ntakao2006-web/RaceCapture/circuit/logger_v2/output/prepared_parts_3D_20260921.png

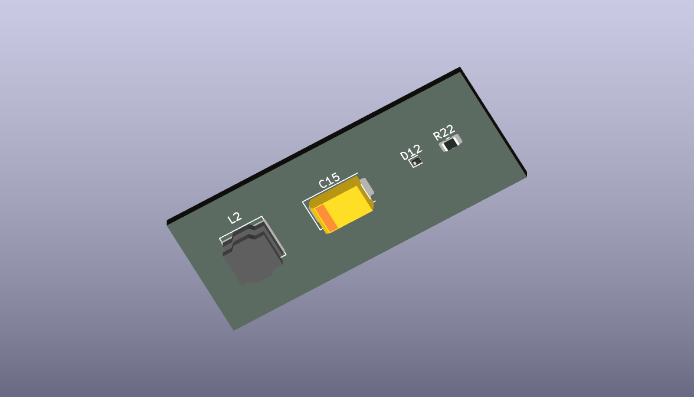
circuit/logger_v2/output/prepared_parts_3D_20260921.png
