ntakao2006-web/RaceCapture/circuit/logger_v2_ups/output/footprint_selection_20261007/footprint_preview.png

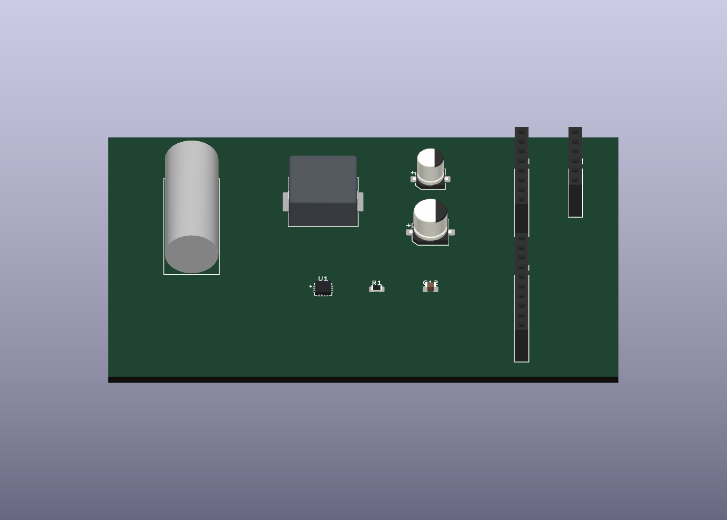
circuit/logger_v2_ups/output/footprint_selection_20261007/footprint_preview.png
