ntakao2006-web/RaceCapture/firmware/ecologger_v2/README.md

# EcoLogger V2 実測ファーム

2026-10-03 実機確認: CAN2の20MHz発振子に合わせたビットタイミング、SDの書込み待ち中のSPI解放、停止中のSD読出し競合を修正。125/250/500/1000kbpsの外部折返しと約100フレーム/秒の継続試験で計14,400フレームが一致。SDファイル切替を含む同時取得でも欠落0。試験送信は一時ファームのみ。通常ファームはCAN1がリッスンオンリー、CAN2がセンサーハブ受信とACKのための通常モードで、アプリケーション用CANフレームは送信しない（CAN2の通常モードを実機へ書き込んだのは2026-10-09。それまでの稼働版はCAN2も受信専用だった）。詳細は `outputs/hardware_check_20261003/RESULT.txt`。

`ecologger_v2.ino` → `logger_impl.h` と `sd_logger.h`。UNO Q STM32U585 / Arduino Zephyr core 0.52.0。

- BNO055: I2C2 0x28/29、400kHz、NDOF 100Hz、A5の高加速度割り込み。
- MAX-M10M: I2C 0x42、4衛星系統/10HzのRAM設定。OTPの再書き込みなし。
- CAN1: FDCAN1、D4/D5、リッスンオンリー。CAN2: MCP25625、D10 CS / A0 reset、センサーハブ受信（ACKあり、データ送信なし）。
- SD: A4 CS、SPI共有。FAT32にCRC付きELB2ブロックを保存。65,536Bの取得待ち行列と専用保存スレッドを使用。
- SDがいっぱいのとき（2026-11-07）：続いた1MiBの空きが無ければ、いちばん古い`EL*.BIN`を消して（ディレクトリの項目→FATの順）その場所に新しいファイルを作る。消すのは自分の`EL*.BIN`だけで、いちばん新しいものは消さない（消した本数は状態に出さない。RAMに収まらないため）。11/7に本体へ書き込み済み。PCの試験は`tests/test_sd_full.cpp`（WSLのg++）と`tests/test_sd_full_fat.py`
- SDの目次が1区画を超えるとき（2026-11-11修正）：ルートディレクトリに空きが無いと1区画足すが、前は先に取っておいた新しいファイルの1MiBの頭（FATにまだ印が無い）を選んでいた。目次と新しいファイルが同じ区画列になり、ファイルのデータが自分の項目を上書きし、以後の項目はそのファイルの中へ書かれていた（SUGOのカードで1022本目、32KB区画で約1021本ごとに必ず起きる）。今は取っておいた区画列を飛ばして空きを探す。PCの試験は`tests/test_sd_full.cpp`の`testRootDirectoryGrowsIntoItsOwnCluster`と、伸びたカードを`tests/test_sd_full_fat.py`の2枚目で読む。2026-11-11に本体へ書き込んだ（`~/ecologger_v2_sdfix_20261111.bin`、59,892B、静的集計130,349B。直す前の像は130,301B、修正で＋48B。起動を確かめた130,365Bより下）。実機でも、目次の空きを1つにしたカードで目次が2区画目へ伸び、どのファイルとも重ならないことを確かめた
- Bridge: 921600bps、取得処理とは別スレッドで登録。LinuxがいなくてもSD取得・記録を開始。
- ループ監視（2026-10-09）：取得メインループが30秒以上止まると、5秒周期の`k_timer`が`NVIC_SystemReset()`でMCUを再起動する（`sys_reboot`はスケッチ側へ公開されておらずリンクできない。スレッド方式はRAM枠を超えた）。SDフォーマット等の明示的な長時間コマンド中は監視を止める。
- ⚠️ Linuxとの通信中にSTM32内部からリセットすると、再起動後もSD記録は続くが、Linuxとの通信路は戻らない（原因未特定）。Linux側の`EcoCapture-Web/mcu-supervisor.py`が30秒以上の切断を検知し、NRSTリセット手順で復帰させる。
- `build.sh`はRouterBridgeの受信スレッドを`$/reset`完了前から動かすよう修正する。2026-10-13に、依頼が続く場合も優先度の低いSD保存スレッドへ実行機会を渡すため、更新ループ末尾を`k_msleep(1)`へ補強した。既知の元コード・前回修正・適用済みの形だけを受け入れ、未知の形ではビルドを止める。補強版の再ビルド・実機測定は未実施。SDが止まった際の正確な待機箇所は、インストール済みライブラリのソースとスレッド状態で確認する。
- 試験用ビルド：`logger_impl.h`の先頭に`#define LOGGER_STALL_TEST`を足すと、`logger.command`の`STALLTEST`（ループ停止）と`RESETNOW`（即リセット）が使える。本番イメージには入れない。
- RAM：静的集計130,365Bまでは起動、130,601Bはエラーを出さずに起動しなかった（ローダー追加領域ぶん、128KiBより手前が実際の限界）。
- LTE: A3/A2は初期状態LOW。UART IRQでRX4096/TX512バイト、GPIO RTS/CTS。LinuxのLTE専用操作が20秒途絶えたら電源OFF。設定とTCP/Podium処理はUNO Q内のEcoCapture-Webが担当。詳細は `EcoCapture-Web/LTE_PODIUM.md`。

LED: CAN=直近の受信、LTE=モデム電源ON（クラウド到達はWebで確認）、UNO Q=Linuxによる受信継続、TRM=OFF、GPS=測位時点灯/未測位受信時点滅、LOG=記録指示、ERR=I2C/SDエラー、SYS=稼働。

`sh build.sh` でビルド。64KiBを超える画像は書き込みません。更新と書き込みは `EcoCapture-Web/build-mcu.sh`、Windows側は `Update-UNOQ.ps1 -Firmware`。

ビルド時に `image-audit.json`（書き込みサイズとELF静的領域）と `source-manifest.json`（ソースのSHA256）を出力します。静的領域の集計にはコード・定数・BSSを含みますが、LLEXTローダーの追加領域や実行時ヒープの増加を含まないため、ロード成功の保証ではありません。更新時の停止・起動順は共通の `EcoCapture-Web/flash-mcu.sh` で管理します。

ソースを置き換える前にUNO Q側のコピーを確保し、`python compare_sources.py <保存したecologger_v2ディレクトリ>` で改行コードを除いた差分を確認します。比較結果だけで正しい版を自動選択しません。

Bridge RPC: `logger.status` / `logger.take` / `logger.command` / `logger.sdread`。`logger.take`は前回からのIMUの行（`rows`、`[seq,MCU時刻ms,"16進"]`）とCANの受信（`can`）を返して空にします。2026-11-09から、GNSSのNAV-PVTも受け取るたびに`rows`へ同じ形で入ります（16進が92バイトなら解、46バイト・0バイトならIMU。並びは届いた順、時刻は受け取った時刻）。10Hzの解を1つ残らず渡すためで、代わりに`logger.status`の`nav`・`gnss_at`はやめました（RAMの残りが足りないため）。IMUの行・CAN・解は`queueRow`で同じ形に足します。**`logger.status`に`nav`が無いファームは、それを読める`EcoCapture-Web/hardware.py`（2026-11-09以降）を先に入れてから書き込みます**（前の`hardware.py`は`status['nav']`で止まります）。コマンドはメイン処理で実行してcompleted番号で確認します。`LOG1/LOG0`、`C500000`等、停止中の`FILES`、`SD`、`R<sector>`、`H<offset>:<hex>`、`W<sector>`。`R<sector>`は読出し位置を設定して`sector ready`を返します。`logger.sdread`は512バイトを16進形式で返し、次のセクタへ進みます。各読出しで停止状態・パーティション境界を検査します。書き込みAPIは記録中に拒否します。外部へRPCを公開しません。

SDファイルは `EcoCapture-Web/sd_decode.py` でCRC・ブロック連番を確認しCSVへ変換できます。保存時刻はMCU経過時刻で、GNSSの元メッセージも保持します。
