ntakao2006-web/RaceCapture/hardware_interface_spec.md

# RaceCapture自作ロガー 入出力インターフェース仕様（電気系相談用）

作成日：2026-08-11
用途：電気・回路系担当の友人との認識合わせ資料

> **製作を依頼したい基板は「ロガー本体」1枚だけではありません。** モータースポーツ用ロガーとして
> 運用する上で必須になる周辺回路（CANハブ、センサーハブ、センサーのアンプ等）も含めて依頼したい
> ため、全体像は6章「製作を依頼したい基板一覧」を参照してください。

---

## 1. 外部インターフェース一覧

| # | インターフェース | 仕様 | 備考 |
|---|---|---|---|
| 1 | SDカードスロット | ロガー本体のデータ保存用 | ✅ **解決済み（2026-08-15）：Molex 47219-2001に決定**（`logger_v1.net`）。金属カバーが基板に押さえ込む構造で、押し込み式(push-push)より振動に強いと判断し採用。2枚差しミラーリング構成も検討したが不採用と判断した（経緯は下記「SDカードの冗長化を検討した経緯」参照） |
| 2 | 車載CAN（OBD2タップ） | 1系統 | 車両のOBD2端子から車速・回転数・水温等を取得。**終端抵抗は付けない**（車両側ECUで既に両端が120Ω×2で終端済みのため、ここに追加するとバスが過終端になる）。⚠️ **訂正（2026-09-21）**：~~終端抵抗の有無は基板上のハンダジャンパーで後から切り替え可能な方式に決定~~ は実回路と食い違っていた。正しくは**リファレンス番号は`R35`**で、**ハンダジャンパー切替は実装されておらず、車載CAN側は未実装（DNP）**。回路担当の確認済み（3章-1参照）。基板ごとの実装状態は区別すること。**配線・部品としては#3と同じ送受信フル対応（トランシーバのTXピンも通常通り結線）とする**。ロガー起動時のファームウェア既定値は**受信専用（listen-only）**運用（純正ECU側への影響を避けるため）だが、これはソフトウェア側のポリシー（TWAIのlisten-onlyモード設定）であってハードウェアの制約ではない。将来ファームウェア更新だけで送信運用へ切り替えられるようにするための意図的な配線方針 |
| 3 | 外部CAN（センサーハブ／アクセサリー用） | 1系統 | 追加センサー（油温・油圧・ブースト等）のハブに加え、シフトインジケーター等のCAN接続アクセサリーもぶら下げる自作CANバス。**ロガー本体が車載CAN（#2）とこのバスの間の「ゲートウェイ」を兼ねる**：#2から受信した値・ロガーが計算したチャンネル（ラップタイム等）をこのバスへ中継送信する（詳細は`ARCHITECTURE.md`のPhase 6参照）。ハブ・アクセサリーは複数台を「幹線1本＋スタブ分岐」でぶら下げる構成。終端抵抗120Ω×2箇所を**幹線の物理両端**に設置（配置ルールは#2と同様）。**電源ラインは5V**（CAN-H/CAN-L/5V/GNDの4線構成、2026-08-15更新：LED・ディスプレイ等のアクセサリー駆動を考慮し、当初予定の3.3Vから変更。専用の3.3V降圧回路新設は不要になったが、+5V系統全体の電流容量見積もりは要確認） |
| 4 | USB電源入力 | Type-C | ✅ **解決済み（2026-08-15）**：ロガー基板側はUSB QC（Quick Charge。PDではない）ネゴシエーション対応（LDR6321搭載）。12V-1.5A（18W）にネゴシエーションし、DCDCコンバータで5V→三端子レギュレータで3.3VへESP32電源として供給する2段降圧構成。外部CANの5V系統もこの経路から分岐するため、後付けアクセサリー類の電力にも余裕あり。**車両側の給電経路も確定**：ロードスターはシガーソケット充電器（100W級、Type-Cケーブル一体型）でモバイルバッテリーを充電し、モバイルバッテリーから毎回着脱で給電（クランキング対策を兼ねる）。エコマイレッジチャレンジ車両はシガーソケット充電器（USB-A+USB-C、100W級）から直接給電（モバイルバッテリー不要）。詳細は3章-11・`ARCHITECTURE.md`4章参照 |
| 5 | USB表示器出力 | Type-C（2026-08-15更新、旧Type-Bから変更） | ESP32-S3のネイティブUSBペリフェラル（TinyUSB CDC、RCP JSONプロトコル通信）をUSB OTG構成（CC線検出・VBUS制御付き）のType-Cコネクタへ変換。Raspberry Piまたはスマートフォンへ接続。電源入力(#4)と同一コネクタ形状に統一された |
| 6 | GNSSアンテナ | 外部アンテナ接続（SMA、`logger_v1.net`のJ7） | ⚠️ **GNSSモジュール変更（2026-08-16）**：Teseo-LIV3FLからu-blox MAX-M10M-00Bへ変更確定（2章・3章-15参照）。`logger_v1.net`時点の回路はTeseo-LIV3FL前提のフットプリント・ピン配置のため、友人による回路図修正が必要（未対応）。アンテナ電源出力ピンはTeseo-LIV3FLの`VCC_RF`(pin14)/`Ant_OFF`(pin13)からM10M-00Bの`VCC_RF`(pin14)/`LNA_EN`(pin13)へ読み替え。**アクティブ／パッシブ切り替え可能な回路にする方針自体は変更なし**（3章-14参照、ピン構成が同型のためほぼそのまま転用可能と判断） |
| 7 | ステータス表示LED | 電源LED×1＋ステータスLED×7の計8個（4個+4個の2列配置） | 純正RaceCapture/Pro MK3のLED構成に準拠する方針。詳細は下記「ステータス表示LEDの仕様検討メモ」参照 |

### SDカードの冗長化（2枚ミラーリング）を検討した経緯（2026-08、不採用と判断）
> 友人へ説明する際の要点整理も兼ねたメモ。

**検討した内容**：SDカードを2枚挿し、同じ内容を同時に書き込むミラーリング構成（片方が壊れてももう片方にデータが残る）を検討した。きっかけは、上記「押し込み式ソケットの振動リスク」への対策として冗長化できないか、というアイデアだった。

**調べて分かったこと**（レーシングロガー業界の実例を確認）：
- MoTeC C125を確認したところ、そもそもSDカードを使わず**基板直付けの内蔵メモリ（120MB）**を主記憶としており、リムーバブルストレージが欲しい場合はUSBメモリをオプション追加する構成だった。つまり「振動でコネクタが壊れる」という同じ悩みに対する業界の答えは、「カードを2枚にして冗長化する」ではなく「**抜き差し可能なコネクタへの依存自体を減らす**」方向だった
- レーシングデータロガー全般を見ても、2枚のSDカードへ同時ミラーリングする構成は主流製品には見当たらなかった（カメラ業界で見かける「2枚差し」も大半は容量合算・別ストリーム記録が目的で、今回想定した「同一内容の冗長化」とは違う）

**不採用と判断した3つの理由**：
1. **ハードウェアコスト増**：GPIOが最低4本（2枚目をSPIモードにした場合）〜6本（SDMMC 4bitのままもう1系統）追加で必要。ソケットも1つ増える
2. **ソフトウェアの複雑化**：スループット自体には余裕があるが、カード単位の故障管理・電源断耐性の検証（1-2フェーズで苦労して詰めた部分）をもう1系統分、しかも実績のないSPI経路でやり直す必要がある
3. **本来のリスクに効かない、むしろ逆効果の面もある**：①冗長化が守れるのは「カード単体の物理故障」だけで、ファームウェアのバグや電源断タイミングという、今まさに対策している種類の失敗には両方のカードが同時にやられるため無力。②振動に弱い押し込み式コネクタの個数がむしろ2つに増えるため、「どちらか一方に接触不良が起きる確率」はかえって上がる

**結論**：SDカードは1枚のまま、**ロック機構付き／固定機構ありのソケットを採用する**方針とした（3章項目7）。本来の懸念（振動によるコネクタ接触不良）に、冗長化ではなく正面から対応する形。

### USBポートに関する補足
- 電源入力(Type-C)とRCP通信出力(Type-B)は**別ポート・別役割**。ネイティブUSB側(Type-B)はこのポート自体からは給電しない構成のため、ESP-IDF側でVBUS検知を「セルフパワード」設定にしておく必要がある（未確認・要対応）。
- 給電経路（改造したシガーソケット充電器）が、SD書き込み・GPS・CANトランシーバ×2系統・IMU等の合計消費電流を安定して賄えるか要確認（目安1A以上）。

### CANコントローラ数の制約（2026-08 新規判明・要対応）
- メインマイコンESP32-S3の内蔵CANコントローラ（TWAI）は**1系統のみ**（ESP-IDF公式ドキュメントで確認）。上表#2（車載CAN）と#3（外部CAN）の2系統を同時に扱うには、**SPI接続の外付けCANコントローラを1つ追加する必要がある**（部品未選定・未調達）。
- 割り当ては「**車載CAN=内蔵TWAI、外部CAN=外付けSPIコントローラ**」を推奨。車載CANは500kbpsで流れる車両バスを全量受信する側なので取りこぼしリスクを最小化したい一方、外部CANは自作バスで通信量を自分たちで制御できるため。特に定番のMCP2515は受信バッファが2段しかなく、混雑したバスの全量受信では取りこぼしが起きやすい。
- 候補：MCP2515（定番・安価。ただし搭載水晶の周波数によって500kbps設定の可否・精度が変わる点に注意）、MCP2518FD（SPI接続・受信FIFOが深い後継。こちら推奨寄り）。いずれもコントローラのみでトランシーバは別途必要（外部CAN側のロガー用トランシーバも要選定。ハブ側と同じSN65HVD230等でよい想定）。
- **配線方針（拡張性）**：2チャンネルとも、コントローラ〜トランシーバ間はTX/RXとも通常通りフル結線しておく（=どちらも将来「送受信自由」にソフトウェアだけで切り替えられる状態にする）。標準的なCANトランシーバ回路はもともと双方向のため、この対応に追加コストは生じない。今回2系統(#2/#3)より多いCANバスが将来必要になった場合（例：ボディ系CAN(MS-CAN)への別アクセス等）は、3系統目以降は新たに物理コントローラ・トランシーバの追加が必要になる（＝ソフトだけでは対応不可）。もし可能なら、基板設計時にSPI CS/割り込み用のGPIOを1本分だけ予備として確保しておくと、将来3系統目を追加する際の手戻りが減る（必須ではなく余裕があれば程度の話）。

### ステータス表示LEDの仕様検討メモ（2026-08-16、MK3参照）
> 友人へ説明する際の要点整理も兼ねたメモ。公式ファームウェア`RaceCapture-Pro_firmware`のソース（本リポジトリ`reference/`配下に取得済み）と、RaceCapture/Pro MK3実機写真を突き合わせて判明した内容。

**結論：電源LED×1（ハードウェア直結・MCU制御なし）＋ステータスLED×7（MCU/GPIOで個別制御）の計8個。実機写真では4個+4個の2列配置。**

**ステータスLED7個の内訳（ファームウェアのenum定義、`include/LED/led.h`より）**：

| # | 論理名 | 用途（推定含む） |
|---|---|---|
| 1 | ERROR | エラー・警告表示 |
| 2 | LOGGER | SDカードへのロギング動作 |
| 3 | GPS | GPS Fix状態（未Fixは低速点滅、Fix後は高速点滅、という説明あり） |
| 4 | TELEMETRY | テレメトリ通信動作 |
| 5 | WIFI | WiFi通信動作 |
| 6 | BLUETOOTH | Bluetooth通信動作 |
| 7 | CAN | CAN(OBD2)バス通信動作 |

**GPIO本数の見積もり**：上記7個は各1本のデジタル出力（GPIO）で個別にON/OFF制御する想定（MK3実機もSTM32のGPIOで1LED=1ピンのシンプルなドライブ方式、PWM調光やマルチプレクスは使っていない）。**電源LEDはMCU制御対象に含めない**（後述）。よって、このステータスLED用に**GPIOを7本**確保してもらえればソフトウェア側は成立する。

**電源LEDについて（要確認）**：MK3のファームウェアソース一式（`reference/RaceCapture-Pro_firmware/platform/mk3/`配下）を検索したが、電源LEDをGPIOで制御しているコードは見当たらなかった。そのため、**電源ラインに抵抗を介して直結し、電源投入で常時点灯する回路（MCU制御不要）**という一般的な構成だと推測している。この想定で問題ないか、回路側で確認をお願いしたい。

**MK3実機の物理配置順（参考、`platform/mk3/hal/LED_stm32/led_device_stm32.c`のGPIO配列順）**：
```
ERROR → TELEMETRY → LOGGER → GPS → CAN → WIFI → BLUETOOTH
```
これは論理定義の並び（上表の#1〜#7）とは順序が異なる。実機写真の4+4のどちらの列に何が入るかまでは、このソースだけでは判別できていない。

**未確認・要相談事項**：
1. **各LEDの色**：ファームウェアのソースにはON/OFFの制御のみで色情報は含まれておらず、公式資料（Wiki・製品ブリーフ）にも色の記載は見つけられなかった。「各LEDは単色固定（RGB等の多色ではない）」という情報のみ確認済み。実機写真から判別できる範囲でよいので、色の割り当て案があれば相談したい
2. **シルクスクリーンの略称表記**：公式PCBでの正式な略称も見つけられなかった。基板独自に決めてよい項目だと考えているので、7〜8文字程度に収まる略称案（例：ERR/LOG/GPS/TEL/WIFI/BT/CAN/PWR）で相談したい
3. **4+4の列分け・実装順**：実機写真を見ながら、どちらの列に何を配置するか（電源LEDがどちらの列に含まれるか含め）相談したい
4. **点灯パターンの詳細ロジック**（パルスコード、Fix状態によるブリンク頻度切替等）はソフトウェア側の話でありMCU非依存の共通コード（`src/`配下）から移植予定。基板側にはON/OFF制御用のGPIOさえあれば影響しない

---

## 2. 内部主要部品（現状の想定・型番）

| 部品 | 現状の想定 | ステータス |
|---|---|---|
| メインマイコン | ESP32-S3-DevKitC-1 N16R8 | 型番確定・未発注 |
| GNSSモジュール | ~~STMicroelectronics Teseo-LIV3FL~~ → **u-blox MAX-M10M-00B**（単一GNSS構成で18〜25Hz対応、UART接続、要外部アクティブ/パッシブ切替回路）に変更確定 | ⚠️ 型番再確定（2026-08-16、Teseo-LIV3FLから変更。3章-15参照）。`logger_v1.net`はTeseo-LIV3FL前提のため回路図修正が未対応 |
| IMU | Bosch BNO055モジュール（9軸統合・センサーフュージョン内蔵、UART(HAL)モード接続） | ✅ 型番確定（2026-08-15、`logger_v1.net`）。従来の秋月AE-LSM6DSV16X（6軸）から変更。磁力計モジュール(AE-BM1422AGMV)の追加調達は不要 |
| 車載CAN用トランシーバ | MCP2562FD-E/P（**VDD=5V系が必要**（定格4.5〜5.5V）。ロジック側VIOピンは3.3Vへ接続する） | 調達済み |
| 外部CAN用SPIコントローラ（ロガー側） | MCP25625T-E/SS（SPIコントローラ+トランシーバ一体型） | ✅ 型番確定（2026-08-15、`logger_v1.net`）。トランシーバ内蔵のため下記「外部CAN用トランシーバ」の別調達は不要になった |
| CANハブ用マイコン | Seeed XIAO ESP32-C3 ×2〜3台 | 方式確定・未調達 |
| SDカードモジュール（本番基板） | Molex 47219-2001（金属カバー固定式） | ✅ 型番確定（2026-08-15、`logger_v1.net`）。秋月DIP化キット(K-5488)は検証用として保有継続 |

---

## 3. 未確定・要相談事項（優先度順）

1. ⚠️ **訂正（2026-09-21、回路担当の回答で確定）：終端抵抗の実装方針**：~~車載CAN側の終端抵抗(R41)は、基板上のハンダジャンパーで有無を後から切り替え可能な方式に決定~~ という2026-08-15時点の記述は**実回路と食い違っていた**。正しくは、**①リファレンス番号はR41ではなく`R35`**（`logger_v1.net`でJ5のCANH-CANL間に置かれている）、**②ハンダジャンパーによる切替方式は実装されていない**（ネットリスト上はジャンパ無しの直付けパターン）、**③回路担当が共有した実装状態では、車載CAN側の終端抵抗は未実装（＝DNP）**。回路担当から「ハンダジャンパー切替という仕様書の表現は、実回路に合わせて訂正する方向でよい。ただし**基板ごとの実装状態は区別すること**」との回答を得たため、本項を訂正する（`docs/share/hardware_ans_20260921.md`1章「前回の7項目」1、`docs/share/hardware_share_20260915.md`4-4）。**外部CAN＝幹線の物理両端のみに120Ω（R27）という方針は変更なし。** 車両バスは両端終端済み（合成60Ω）で、ここにR35が生きていると40Ωまで落ちるため、車載CAN側は未実装が正しい
2. **グラウンド設計（2026-08-16、経路を整理）**：ロガー・ROCK 5B・アクセサリー類はすべてUSB充電器（モバイルバッテリー経由）を起点とする閉じたグラウンド系統になっており、この内部では問題ない。懸念があるのは、この閉じた系統の唯一の外部接点である**車載CAN(OBD2)経由のグラウンド接続**。`logger_v1.net`確認の結果、J6(車載CAN)・J4(外部CAN)ともpin4が基板の共通GNDへ直結されている（＝車載CANのグラウンドは基板に落ちている）。CAN-GND自体を接続すること（GND無しでCAN-H/CAN-Lだけ配線する構成にしないこと）は業界標準の実務であり妥当だが、そのGND線を介して車両側とUSB電源系の間に電位差由来のループ電流が生じる可能性がある。対策の選択肢：①現状のまま直結（シンプルだがノイズ耐性は最低）、②CAN-GND線にフェライトビーズを挟み高周波ノイズだけ減衰させる（費用対効果のバランスが良さそう）、③CANトランシーバをガルバニック絶縁型にして車両側と完全分離（最も堅牢だがコスト・複雑性が上がる）。⏳ **経過観察（2026-08-16、友人確認）**：回路担当からは「（実害となる）問題はおそらく出ない」という見通しが得られており、現状は①直結のまま様子見する方針。正式な方針決定・対策実装は行っていない未解決事項のままだが、現時点では優先度を上げて追いかけるべき懸念とはしていない。実機・実車検証でノイズ起因の不具合（CANエラー頻発等）が見られた場合に②③を再検討する
3. ⚠️ **訂正（2026-08-16）：GNSSモジュールの型番・アンテナ接続規格**：本項目は2026-08-15時点でTeseo-LIV3FLに確定としていたが、その後u-blox MAX-M10M-00Bへ変更確定した。詳細・友人への相談事項は下記15番参照
4. ✅ **解決済み（2026-08-15）：9軸IMUの型番**：BNO055に確定（磁力計統合済み、AE-BM1422AGMVの追加購入は不要になった。2章参照）
5. **ネイティブUSB側のVBUS検知設定**：セルフパワード構成にする必要あり（2026-08-15：表示器出力(#5)はType-CのOTG構成に変更されたため、VBUS検知の扱いも合わせて要確認）
6. ✅ **解決済み（2026-08-15）：電源改造用コネクタの規格選定**：ケーブル一体型の既製品（ロードスター＝UGREEN製シガーソケット充電器＋巻き取り式Type-Cケーブル、エコランマシン＝アドテック製USB-A+USB-C出力カーチャージャー）を採用することで、コネクタ数が最小限になり接触不良リスクも下がるため、追加の改造は不要と判断（4章参照）
7. ✅ **解決済み（2026-08-15）：SDカードスロットの物理保持機構**：Molex 47219-2001（金属カバー固定式）に確定。押し込み式の振動リスクは解消と判断（2章参照）
8. ✅ **解決済み（2026-08-16）：ステータスLEDの参照元をRaceCapture/Pro MK3に決定**：公式`RaceCapture-Pro_firmware`の4世代（MK2/MK3/RCT/RCT MK2）を調査した結果、MK3のみがenum定義（ERROR/LOGGER/GPS/TELEMETRY/WIFI/BLUETOOTH/CANの7種）と物理LED(7個)が完全に1対1対応しており、最も網羅的なテンプレートと判断。点灯パターンのロジック自体（ERRORのパルスコード、GPSのFix状態に応じたブリンク頻度切替、LOGGERのサンプル同期トグル、通信LEDのワンショット点灯等）はMCU非依存の共通コード（`src/`配下）のため、どの世代でも移植コストは同じ。**実機写真では電源LED×1（MCU制御なし・直結と推定）を加えた計8個・4個+4個配置と判明（2026-08-16）**。GPIO所要本数はステータス用7本（詳細は1章「ステータス表示LEDの仕様検討メモ」参照）。色・シルクスクリーン表記・列分けは未確認で友人へ相談予定
9. ✅ **解決済み・方針変更（2026-08-15）：外部CAN（センサーハブ／アクセサリー用）バスの電源ライン**：3.3V専用降圧回路の新設案から、LED・ディスプレイ等のアクセサリー駆動を考慮した5V供給（CAN-H/CAN-L/5V/GND）へ変更。専用降圧回路の新設は不要になったが、+5V系統全体の電流容量見積もりは引き続き要確認
10. ✅ **解決済み（2026-08-15）：2系統目CANコントローラの選定**：MCP25625T-E/SS（SPIコントローラ+トランシーバ一体型）に確定（2章参照）
11. ✅ **解決済み（2026-08-15）：電源取り出し系統とクランキング対策**：**ロードスター**は、シガーソケット充電器（100W級、Type-Cケーブル一体型、UGREEN製想定）でモバイルバッテリー（65W級入力対応、候補：CIO SMARTCOBY TRIO SS／Xiaomi 67W Power Bank 10000）を充電し、モバイルバッテリーからロガー・ROCK5Bへ給電する構成に決定。モバイルバッテリーは**走行のたびに着脱する運用**とする（常設パススルー充電は、バッテリー劣化・車内耐候性の懸念から不採用）。クランキング時の電圧ドロップはモバイルバッテリーが緩衝材となって吸収される。**エコ マイレッジ チャレンジ車両**はエンジン駆動用バッテリーとロギングシステム用バッテリーが分離されているためモバイルバッテリーは不要で、シガーソケット充電器（USB-A+USB-C、100W級、アドテック製想定）から、USB-A→ロガー／USB-C→ROCK5Bで直接給電する構成に決定
12. **IMU・磁力計の実装方法（2026-08-16、論点を整理）**：IMUは車体へ剛結が基本だが、エンジン・路面振動がそのまま乗るため、サンプリングレート（現状10Hz、将来50〜100Hz化予定）に対するエイリアシング対策（チップ内蔵LPF設定と機械的防振の役割分担）を相談したい。
    - **基板実装方式が未決定**：`logger_v1.net`ではBNO055(U11)はメイン基板に直接実装されている。基板直付け（配線短くノイズに強い、コネクタ減で接触不良リスク減、ただし設置位置＝メイン基板の位置に制約される）か、ケーブルで切り離すモジュール化（車体重心付近など振動的に最適な位置を選べる、ただしUART配線が伸びる分ノイズ耐性は下がる）か、メイン基板の車載位置が決まってから判断する
    - **磁力計とアルミシールドの影響を整理**：ケーシングへのアルミテープ（非磁性導体）は地磁気のような静磁場への遮蔽効果はほとんどなく、磁力計の動作への悪影響は小さいと考えられる。むしろ懸念すべきは①ケース内の強磁性体（鉄ネジ等）による地磁気の歪み（BNO055のソフト鉄/ハード鉄キャリブレーションである程度補正可能）、②基板上のDCDCコンバータ・CANトランシーバ等の大電流配線が作る動的な磁気ノイズ（キャリブレーションでは補正しきれない可能性が高く、既存方針の「大電流配線から離す」が対策の本筋）
13. ✅ **解決済み・訂正（2026-08-15）：ロガー基板のネゴシエーション規格はUSB PDではなくQC（Quick Charge）**：12V-1.5A（18W）にネゴシエーションし、DCDCコンバータで5V→三端子レギュレータで3.3VへESP32電源として供給する構成に確定（2章参照）
14. ✅ **方針確定（2026-08-16）：GNSSアンテナはアクティブ／パッシブ切り替え可能な回路を目指す**：`logger_v1.net`時点の回路（Teseo-LIV3FLの`VCC_RF`未接続、バイアスT回路なし）はパッシブアンテナ仕様。友人との協議の結果、将来的にアクティブアンテナも使えるよう、両対応の切り替え可能な回路にする方針で合意。アクティブアンテナ用回路（バイアスT等）は複雑で設計コストが高く、PCB設計を1回で完全動作させる保証はないとのことで、まず両方動く回路を作り、1〜2回の修正を重ねて完成させていく前提。**PCB発注〜到着に1〜2週間かかるため試行回数（イテレーション）が制約される**点は、今後の基板改修スケジュールを見積もる上で踏まえておく必要がある
15. ⏳ **要相談（2026-08-16、新規）：GNSSモジュールをTeseo-LIV3FLからu-blox MAX-M10M-00Bへ変更**：更新レート（Teseo=ハード上限10Hz固定 vs M10M-00B=単一GNSS構成で18〜25Hz）を優先し、こちらの型番へ変更する方向で決定した。友人へ相談・確認したい点：
    - `logger_v1.net`のGNSS部フットプリント・ピン配置はTeseo-LIV3FL前提のため、回路図の修正が必要（アンテナ電源ピンはTeseo`VCC_RF`(pin14)/`Ant_OFF`(pin13) → M10M-00B`VCC_RF`(pin14)/`LNA_EN`(pin13)への読み替えで、アクティブ/パッシブ切替回路のトポロジー自体は上記14番の方針のまま転用できる想定）
    - ✅ **解決済み（2026-08-16）：設定の不揮発性保存機能（バックアップ電源）は非搭載と決定**：Teseo-LIV3FLは内蔵Flash（`$PSTMSAVEPAR`コマンド）でバッテリー不要のまま設定を保持できたが、M10M-00Bは同等のFlashを持たず、設定保持には`V_BCKP`ピンへのバックアップ電源（コイン電池等）が必要になる。検討の結果、**バックアップ電源は追加せず、電源ON/OFF（バッテリー着脱含む）自体を「ログの開始・終了」のトリガーとする運用方針のため不要と判断**した。「ログ開始し忘れ」のリスクを減らす狙い（電源を入れる＝ログを開始する、という単純な操作に統一）。GNSSの設定・ホット/ウォームスタート用データは電源ONのたびに揮発するため、ESP32ファームウェアから毎回コンフィグを再送信する初期化シーケンスを実装する（起動時間はコールドスタート相当になる点は許容）
    - 消費電力・パッケージサイズ等、上記以外の相違点による基板レイアウトへの影響有無

---

## 4. 車載12V電源の保護回路について（参考・確定事項）

✅ **解決済み・方針更新（2026-08-15）**：市販のシガーソケット用12V充電器を使用する方針で合意済み。当初は内部回路を活かして出力コネクタのみ改造する想定だったが、ケーブル一体型の既製品を採用することで、改造なしでコネクタ数を最小限に抑えられると判断した（3章-6・11参照）。
- **ロードスター**：シガーソケット充電器（100W級、Type-Cケーブル一体型）でモバイルバッテリーを充電し、モバイルバッテリーから毎回着脱でロガー・ROCK5Bへ給電。クランキング時の電圧ドロップはモバイルバッテリーが緩衝材として吸収する
- **エコ マイレッジ チャレンジ車両**：エンジン駆動用バッテリーとロギングシステム用バッテリーが分離されているためモバイルバッテリー不要。シガーソケット充電器（USB-A+USB-C出力）から、USB-A→ロガー／USB-C→ROCK5Bで直接給電

---

## 5. 外部CANバスに接続予定のアクセサリー一覧（追加で製作が必要なハードウェア）

外部CAN（センサーハブ／アクセサリー用、1章#3）バスへぶら下げる予定のノードを一覧化。**いずれもCAN-H/CAN-L/5V/GNDの共通4線コネクタ規格で接続する**想定（1章#3参照）。台数・種類がここに増えるほど3章項目9（5V電源の電流容量）の見積もりに直結するため、新しいアクセサリーを追加する際はこの一覧も更新する。

| アクセサリー | 用途 | 想定MCU | 想定トランシーバ | ステータス |
|---|---|---|---|---|
| センサーハブ ×2〜3台 | 油温・油圧・ブースト等のアナログセンサーをADCで受けてCAN化 | Seeed XIAO ESP32-C3 | SN65HVD230等 | 方式確定・未調達。ハブ1台あたりのセンサー割当数・CAN ID採番ルールは未確定（`ARCHITECTURE.md`4章参照） |
| シフトインジケーター | RPM等をタコメーター相当の応答速度で表示 | 未確定（軽量なXIAO ESP32-C3等で足りる見込み） | 未確定（センサーハブと同等でよい見込み） | 構想段階、ハードウェア未着手。**ベストラップリセットボタンをGPIO入力として統合する案が有力**（`task_phase5_breakdown.md`5-8-2参照。ボタン単体で専用ノードは作らず、このMCUに相乗りさせる方針） |
| 高輝度サブディスプレイ（デルタタイム表示等） | 走行中でも視認できる輝度で予測タイム(PredTime)等の計算チャンネルをリアルタイム表示 | 未確定 | 未確定 | 構想段階、ハードウェア未着手（`task_phase6_breakdown.md`背景説明参照）。ロガー本体側の計算チャンネルCANブロードキャスト実装（Phase 6-1〜6-3）が前提。ディスプレイの消費電流次第では5Vラインの配線線径・電流見積もりへの影響が大きい可能性があり、型番選定時に要確認 |

> 上記はいずれも「本Phaseはロガー本体側の実装まで」（`task_phase6_breakdown.md`）の方針通り、アクセサリー側MCUの実装・実機結合試験はハードウェア到着後に別Phaseとして分解する。友人への相談時は、まず台数・電流の当たりをつけるための参考リストとして共有する想定。

---

## 6. 製作を依頼したい基板一覧（全体像）

これまでの章はロガー本体を中心に書いてきたが、**モータースポーツ用ロガーとして実際に運用するには周辺基板が必須**であり、それらも含めて製作を依頼したい。現時点での全体像は以下の通り。

| 基板 | 個数目安 | 主な回路 | ステータス |
|---|---|---|---|
| メインロガー基板 | 1 | ESP32-S3、GPS、IMU、SDカード、車載CAN用トランシーバ(MCP2562FD)、外部CAN用SPIコントローラ+トランシーバ、車載12V電源保護回路、QC→5V→3.3V降圧回路（外部CANバスの5V系統もここから分岐、専用回路の新設は不要） | 設計中（1〜5章が対象） |
| **CANハブ／センサーハブ基板** ×2〜3 | 2〜3 | Seeed XIAO ESP32-C3、CANトランシーバ(SN65HVD230等)、ADC（内蔵または外付け、要検討）、**センサー信号調整回路（アンプ等）** | 方式確定・**未着手**（5章参照） |
| 外部CANアクセサリー基板（シフトインジケーター／サブディスプレイ等） | 台数分 | MCU未確定、CANトランシーバ、表示系（LED/ディスプレイ）、ボタン入力（統合する場合） | 構想段階・**未着手**（5章参照） |

**特に相談したい点**：
- **センサー信号調整回路（アンプ）の要否**：油温・油圧・ブースト圧センサーの型番自体が未確定（`ARCHITECTURE.md`4章）のため、選定候補が抵抗式／0-5V電圧出力式であればADC直結で足りる可能性がある一方、mV級出力のセンサー（歪みゲージ式圧力センサー等）を選ぶ場合は各チャンネルに計装アンプが必要になる。センサー型番の選定とアンプ要否をセットで相談したい
- **既設Defiメーター用センサーを分岐して読みたい（2026-08-23追加）**：ロードスターに既に付いているDefi製水温・油温・油圧センサー（純正メーターへ接続済み、水温・油温が2ピン、油圧が3ピンと推定）を、メーター側の配線・指示動作を変えずにセンサーハブ側でも読み取りたいという要望がある。センサー線を単純にY字分岐すると、RaceCapture側ADCの入力インピーダンスがメーター側の分圧回路に並列に入り込み、メーターの指示値がズレるリスクがある。対策として、**分岐点にボルテージフォロワ（オペアンプによるバッファ回路）を挟み、ハイインピーダンスで電圧を受けてローインピーダンスでセンサーハブのADCへ渡す**方式を想定。クワッドオペアンプ1個で3ch分をまかなえる見込みで、上記「センサー信号調整回路」の枠に含める形でセンサーハブ基板に実装したい。2ピン（サーミスタ抵抗式と推定）はセンサー抵抗の分圧電圧を、3ピン（電源+GND+出力と推定）は出力線をそのままバッファ経由で分岐する想定。Defiセンサー3つの正確な型番・出力特性（抵抗式か電圧式か、レンジ）は未確認のため、型番特定または実測（メーター側励起電圧・電流、センサー抵抗レンジ）とセットで相談したい
- **熱電対（K型）入力への対応（2026-08-30追加）**：エコマイレッジチャレンジ車両向けに、EGT（排気温度）とCHT（シリンダーヘッド温度）の測定要求が出た。熱電対はmV級出力かつ冷接点補償が必要で、上記「抵抗式／0-5V」前提のADC直結でも計装アンプでも受けられない。**MAX31855（K型専用・安価）またはMAX31856（多型式対応・高精度）等のSPI接続ICをセンサーハブ基板に追加する**案で問題ないか相談したい。熱電対線の延長には補償導線が必要な点、エンジン近傍からの引き回しになるためノイズ対策が要る点も併せて確認したい。なお同車両のCHTは、熱電対を避けてNTCサーミスタ型（スパークプラグ座金型）を選定する方針のため、熱電対が必須なのはEGTのみ
- **CANハブ／センサーハブ基板の内容がロガー本体と別基板として独立している点**：配線・実装イメージのすり合わせのため、幹線1本＋スタブ分岐というバス配置（1章#3参照）を踏まえた基板の物理配置（車両のどこに何枚置くか）も併せて相談したい
