ntakao2006-web/RaceCapture/logger_v2_channel_and_sensor_spec.md

# ロガーへの入力・出力チャンネル仕様（こちら側で言語化する宿題）

> **この文書が扱う宿題**：`docs/share/hardware_ans_20260921.md`6章の
> **6（外部CANチャンネルごとの「用途」を定義する）**、
> **7（油温・油圧センサーを選定する）**、
> **8（追加でログしたい車体信号を絞り込む）**。
>
> **3件とも「回路担当が判断するには、まずこちらが要求を言葉にしないと進まない」もの**なので、
> 1つにまとめた。回路設計そのものは引き続き回路担当に委ねる。
>
> ⚠️ **1章・3章には、ユーザー（＝設計方針の決定者）の確認が要る判断が含まれる。**
> 該当箇所に「**要確認**」と明記した。確認が取れたら次回の共有メモへ載せる。

---

## 1. 宿題8：追加でログしたい車体信号を絞り込む

### 1-1. 指摘されたこと

前回の共有で「**車体系はOBD2ポートからは取れない。別バスへのタップか、
専用のデジタル入力を回路側に持つかの方針判断がほしい**」と投げていたが、
回路担当から「**『取れない』と一括りにせず、NCECで実際に取れていない信号だけを挙げてほしい。
ブレーキペダル状態は取得済みのはず**」と指摘された。**その通りなので整理し直す。**

### 1-2. 事実の整理（`ncec_can_spec.md`4章の実測による）

**✅ すでに取れているもの（追加の入力は一切要らない）**

| 信号 | 取得元 | 周期 |
|---|---|---|
| エンジン回転数／車速 | `0x201` | 100 Hz |
| **4輪独立ホイールスピード**（FL/FR/RL/RR） | `0x4B0` | 100 Hz |
| 水温（2経路） | `0x240` / `0x420` | 10 Hz |
| スロットルバルブ開度 | `0x240` | 10 Hz |
| **アクセルペダル開度**（2経路） | `0x200` / `0x215` | 100 Hz |
| 🔴 **ブレーキペダル（踏み込みON/OFF）** | `0x200` byte6 bit0 | 100 Hz |
| クラッチ（踏み込みON/OFF） | `0x231` byte1 bit1 | 40 Hz |
| パーキングブレーキ | `0x39A` byte0 bit3 | 10 Hz |
| A/C要求 | `0x215` byte7 bit6 | 100 Hz |
| 吸気温／燃料レベル | `0x240` / `0x430` | 10 Hz |
| エンジン負荷・点火時期・MAF・O2・バッテリ電圧ほか | OBD2 mode 01（20 PID） | 実効8.6 Hz |
| ECU内部変数 | OBD2 mode 22（`0x09xx`系に12個） | 任意 |

**❌ この車両・この配線では取れないもの**

| 信号 | 理由 | 種類 |
|---|---|---|
| **油温・油圧** | 生CANにも標準OBD2 PIDにも無い（油温PID `5C`は非対応を再確認） | **センサーが存在しない** |
| ウィンカー・ハザード・ドア開・シートベルト・ヘッドライト・ワイパー | 停車中の12種の操作差分で**1ビットも動かなかった**。ボディCAN側にあるとみられる | **別バスにある** |
| 舵角`0x081`／ブレーキ圧`0x085`／車体加速度`0x090` | **DSC搭載車（2007年以降）限定。本車両はDSC非搭載**なので、そもそも車両が出していない | **車両に存在しない** |

> **3つ目の区別が重要**：舵角・ブレーキ圧・車体加速度は「別バスにあって届かない」のではなく、
> **DSC非搭載車なので車両のどこにも流れていない**。**ボディCANをタップしても出てこない。**

### 1-3. 🔴 結論案：**回路側にデジタル入力もボディCANタップも追加しない**

**「取れないもの」を、ロガーの用途（サーキット走行解析／エコマイレッジ）に照らして
欲しさで並べ直すと、追加の入力回路が要るものは残らない。**

| 取れないもの | 本当に欲しいか | どう手当てするか |
|---|---|---|
| **油温・油圧** | 🔴 **欲しい。最優先** | **追加センサー＋センサーハブ**（既定方針。→ 2章） |
| **ブレーキ圧（踏力）** | ⚠️ あると嬉しい（ブレーキング解析） | **ON/OFFは既に取れている。**圧が欲しければ**油圧センサーの追加**で対応でき、**これもセンサーハブの枠**に収まる。候補とつなぎ方は`brake_pressure_sensor_ncec.md`（2026-11-09） |
| **舵角** | ⚠️ あると嬉しい | 🔴 **E-2でESKFを採用したので、ヨーレート（IMU）＋車速で旋回曲率が出る。** 舵角そのものが無くてもコーナリング解析は成立する。専用センサーを足す価値は現時点では低い |
| **車体加速度・ヨーレート** | 🔴 欲しい | **IMU（BNO055）で取る。**もともと車両から取る設計ではない |
| **ギア段** | 🔴 欲しい | **回転数÷車速で算出できる**（`0x231`のクラッチ状態と組み合わせて断/接も判定可）。**追加ハード不要。計算チャンネル／Luaで実装する**（Phase 6の枠） |
| ウィンカー・ハザード・ドア・シートベルト・ヘッドライト | ❌ 要らない | 走行解析に使わない |
| ワイパー | △ 路面ウェット判定に使える程度 | **専用入力を作るほどの価値は無い**と判断 |

**→ 回路担当への回答：「別バスへのタップも、専用のデジタル入力も、どちらも不要」。**
**必要なものは①センサーハブ（油温・油圧・ブレーキ圧）②IMU③計算チャンネル（ギア段）で
すべてまかなえる。**

> **要確認（ユーザー判断）**：この結論でよいか。
> とくに**ワイパー／ヘッドライトを完全に捨てる**点と、**舵角センサーを足さない**点。
> 捨てる判断をすると、Ver.2基板にデジタル入力端子が載らないため、後から欲しくなっても
> 基板改版になる。

---

## 2. 宿題7：油温・油圧センサーの要求仕様

### 2-1. 指摘されたこと

「**測定範囲・取付ねじ・出力形式・供給電源**が決まらないと、入力回路とアンプ要否を決められない。
ここが現状のボトルネック」。

### 2-2. 取りうる道は2つある

`hardware_interface_spec.md`6章に、**既設のDefiメーター用センサーを分岐して読む案**が
既に書かれている。新規購入と合わせて2案ある。

| | **A案：既設Defiセンサーを分岐** | **B案：新規にセンサーを買う** |
|---|---|---|
| センサーの追加工事 | **不要**（既に付いている） | **必要**（オイルブロック等の取り付け） |
| Defiメーターの表示 | **そのまま残る** | 残る（別系統になる） |
| 回路側の追加 | **ボルテージフォロワ（バッファ）**。クワッドオペアンプ1個で3ch | ADC直結またはアンプ |
| 未確定なこと | 🔴 **Defiセンサーの型番・出力特性が未確認**（抵抗式か電圧式か、レンジ） | 型番を選べば確定する |
| リスク | 分岐でメーター指示値がズレる（バッファで回避する前提） | 取り付け位置・油路の加工 |

> **A案を本命としたい**（要確認）。センサーを増やさずに済み、機械加工も発生しないため。
> **ただしA案には「現車でDefiセンサーの型番を確認する」という実車作業が必要**で、
> これは`ncec_next_session_checklist.md`の枠に入れるべき項目。

### 2-3. 測定範囲（要求として確定させたいもの）

| 物理量 | 要求レンジ | 根拠 |
|---|---|---|
| **油温** | **0〜150 ℃** | サーキット走行で**140 ℃超を常用するかどうかが本番オイルの粘度判断の分岐点**になっている（ロードスター側のタスク#3）。**140 ℃を計測範囲の端に置かない**ため150 ℃までを要求する |
| **油圧** | **0〜1.0 MPa（0〜10 bar）** | 警告判定に使うのは低圧側（アイドル時の低下）だが、高回転時の上限を振り切らせないため1.0 MPaを確保する |
| （参考）水温 | 0〜130 ℃ | **CANから2経路で取れているので追加不要。**Defi分岐の対象にはしうる |

### 2-4. 出力形式・供給電源（回路側の負担を減らすための要求）

| 項目 | 要求 |
|---|---|
| **出力形式** | 🔴 **ADCで直接受けられるもの（0〜5 Vの電圧出力、または抵抗式）を優先する。** 歪みゲージ生出力のような**mV級は避けたい**（各チャンネルに計装アンプが必要になり、ハブ基板が重くなるため） |
| **供給電源** | **センサーハブから5Vを供給する前提でよい**（外部CANの4線に+5Vが含まれており、ハブ側で分配できる） |
| **取付ねじ** | 🔴 **未確定。現車確認が要る。** A案なら既設センサーの規格をそのまま引き継ぐので**この項目自体が消える** |
| 応答速度 | **5〜10 Hzで足りる**（油温・油圧とも物理量の変化が遅い。→ 3章のレート設計と整合） |

### 2-5. この宿題の現在地

**要求は言語化できた。残るのは「A案かB案か」の判断と、A案ならDefiセンサーの現車確認。**
**型番の確定＝B案を選んだ場合の作業**なので、**まずA/Bの判断が先**。

> **2026-09-24追記：A案で進めることになり、分岐回路を`sensorhub_defi_tap_design.md`として具体化した。**
> 回路は**Defiセンサーの型番に依存しない**作りにしたため（型番で変わるのはファームの換算係数だけ）、
> 現車確認を待たずに試作・基板化へ進められる。

---

## 3. 宿題6：外部CANチャンネルごとの用途とレート

### 3-1. 指摘されたこと

「**表示用途か異常検出用途かで必要周期が違う**ため、レートを決めるにはこちらが用途を言語化する必要がある」。

### 3-2. 用途の分類（これがレートを決める軸）

| 分類 | 何が要求を決めるか | 必要レートの考え方 |
|---|---|---|
| **① 表示（追従性が命）** | **人間が動きとして見るもの。**遅れると使いものにならない | **50〜100 Hz** |
| **② 表示（数値として読むもの）** | 読み取るのに時間がかかるので速くしても無駄 | **5〜10 Hz** |
| **③ 異常検出** | **閾値を跨いだことに気づければよい。**ただし気づくのは早いほどよい | **5〜10 Hz＋イベント即送** |
| **④ 記録のみ** | 外部CANへ出す必要が無い（ロガー内部で完結） | **送らない** |

### 3-3. ロガー → 外部CAN（アクセサリーへ送る側）

| チャンネル | 用途 | 分類 | **要求レート** |
|---|---|---|---|
| **エンジン回転数** | **シフトインジケーター** | ① | 🔴 **50〜100 Hz**。タコメーター相当の追従が要る。**ここが外部CANで最も速い要求** |
| 車速 | 表示 | ② | 10 Hz |
| **予測タイム（PredTime）／デルタタイム** | **高輝度サブディスプレイ** | ② | **5〜10 Hz**。**速くしても読めないので上げる意味が無い** |
| ラップタイム／ラップ数 | 表示 | ② | **ラップ確定時のイベント送信**（定期送信は不要） |
| 水温 | 表示＋異常検出 | ②③ | 5 Hz |
| **油温・油圧** | 表示＋**異常検出（最重要）** | ②③ | **5〜10 Hz。**加えて**閾値を跨いだ瞬間は即送**したい |
| 燃料レベル | 表示 | ② | 1 Hz |
| 前後G・横G／姿勢角 | 表示（あれば） | ② | 10 Hz |
| **警告フラグ**（油圧低下・水温超過等） | **異常検出** | ③ | **状態変化時に即送＋10 Hzで再送**（取りこぼし対策） |
| 生CANの中継（全チャンネル） | — | ④ | **送らない。**ロガー内部のSD記録で完結する |

### 3-4. センサーハブ → ロガー（受ける側）

| チャンネル | 用途 | **要求レート** |
|---|---|---|
| 油温・油圧・ブースト | 記録＋異常検出 | **10 Hz** |
| AFR（空燃比） | 記録（**過渡の解析に使う**） | **20 Hz**（他より速い。混合気の変化が速いため） |
| EGT（排気温） | 記録 | 5 Hz |
| CHT（ヘッド温） | 記録 | 5 Hz |

### 3-5. バス負荷の当たり（500 kbps前提）

標準フレーム＋8バイトデータで**約130ビット**（スタッフィング込みの概算）として：

| 内訳 | フレーム/秒 |
|---|---:|
| 回転数 100 Hz | 100 |
| その他の表示・異常検出チャンネル（約15ch × 平均8 Hz） | 120 |
| センサーハブ → ロガー（約8ch × 平均10 Hz） | 80 |
| **合計** | **約300** |

**300 fps × 130 bit = 約39 kbps ＝ 500 kbpsの約8%。** **帯域はまったく問題にならない。**
**→ 外部CANのビットレートは車載CANと同じ500 kbpsで揃えてよい**（部品・設定を共通化できる）。

### 3-6. ⚠️ 現行ファームウェアとのギャップ

**`firmware/logger_v1`のCANブロードキャストは、全チャンネルを共通の`broadcast_hz`で
均等に送る実装**になっている（`can.cpp`）。**チャンネルごとにレートを変える仕組みは無い。**

**→ 3-3のレート設計を実現するには、Phase 6-3-1（メッセージID採番・フォーマット設計）の
やり直しではなく、「チャンネル別レート」の実装追加が要る。**
`task_phase6_breakdown.md`へ反映する。

---

## 4. まとめ：3件の現在地

| 宿題 | 状態 | 次に要るもの |
|---|---|---|
| **8（車体信号の絞り込み）** | ✅ **整理完了。結論案は「デジタル入力もボディCANタップも不要」** | **ユーザー確認**（ワイパー等を捨てる判断・舵角センサーを足さない判断） |
| **7（油温・油圧の要求仕様）** | ⏳ **要求は言語化完了**（レンジ・出力形式・電源・応答速度） | **A案（Defi分岐）／B案（新規購入）の判断**。A案なら**現車でDefiセンサーの型番確認** |
| **6（外部CANの用途とレート）** | ✅ **用途分類とレート要求を定義。バス負荷も8%で問題なし** | ファーム側に**チャンネル別レート**の実装追加（Phase 6） |

---

## 5. 回路担当への申し送り（次回の共有に載せる）

1. **車体系のデジタル入力もボディCANタップも要らない**（1-3章）。
   **前回5-2の5は「どちらも不要」で回答とする。**
   舵角・ブレーキ圧・車体加速度は**DSC非搭載車なので車両のどこにも流れておらず、
   ボディCANをタップしても出てこない**点を補足する
2. **油温・油圧は「既設Defiセンサーを分岐する案」を本命にしたい**（2-2章）。
   **クワッドオペアンプによるバッファ方式で問題ないか**を確認したい。
   要求レンジは**油温0〜150 ℃／油圧0〜1.0 MPa**、**出力は0〜5 Vか抵抗式を優先、mV級は避けたい**
3. **外部CANのレート要求を提示できる**（3-3章）。
   **いちばん速いのはシフトインジケーター用の回転数で50〜100 Hz**、
   **油温・油圧は5〜10 Hz＋閾値越えの即送**。**バス負荷は500 kbpsの約8%で余裕がある**

---

## 6. 関連資料

| 資料 | 内容 |
|---|---|
| `docs/share/hardware_ans_20260921.md` | **この宿題の出どころ。**6章の6・7・8 |
| `ncec_can_spec.md` | **1-2章の事実の根拠。**4章＝デコード確定項目、5章＝OBD2 |
| `docs/share/hardware_share_20260915.md` | 2-2章＝取れないものの実測、2-5章＝外部CANの未確定事項 |
| `hardware_interface_spec.md` | 5章＝外部CANアクセサリー一覧、6章＝**Defiセンサー分岐案の原文** |
| `task_phase6_breakdown.md` | 6-3-1＝メッセージID・フォーマット設計（未着手） |
| `ncec_next_session_checklist.md` | **Defiセンサーの現車確認を足すならここ** |
