ntakao2006-web/RaceCapture/logger_v2_gnss_i2c_design.md

# Ver.2：GNSSのI²C（DDC）化と、IMUとのバス共用の設計メモ

> **この文書が扱う宿題**：`docs/share/hardware_ans_20260921.md`6章の
> **1（GNSSドライバをUART前提からI²C前提へ設計し直す）**と
> **2（GNSS＋IMUのI²C共用で必要なレートが出るかを見積もる）**。
> この2件は同じバスの話なので1つにまとめた。
>
> **経緯**：P-3の回答で「SIM7070GはSTM32のハードウェアUARTへ繋ぐ」と決まり、
> **そのUARTを空けるためGNSS（MAX-M10M）はUART→I²Cへ移り、BNO055とI²Cを共用する**ことになった。
> 回路担当も「I²C共用によるGNSS取得遅延は検証対象」としている。
>
> ⚠️ **Ver.2基板は未製作。この文書は着手前の見積もりと設計方針であって、実測ではない。**

---

## 0. 結論（先に）

1. **現行Ver.1と同じ「I²C 100 kHz」のままでは苦しい。**
   Ver.1のIMU読み出しだけで**バス占有率が約49%**あり、そこへGNSSを載せると
   10 Hzで**約58%**、25 Hzで**約73%**になる。
2. **ただしE-2（ESKF採用）の決定が、そのまま効いてくる。**
   ESKFではBNO055を**AMGモード（生の加速度・角速度・地磁気）**で使うため、
   融合済みの値を読む必要がなくなり、**IMUの読み出しが51バイト→約20バイトへ減る**。
   これだけで100 kHzでも**30〜45%**まで下がる。
3. **400 kHz（Fast-mode）にできれば余裕で足りる**（AMG＋GNSS 25 Hzで**約11%**）。
   **したがって焦点は帯域そのものではなく「BNO055を400 kHzで安定に回せるか」**になる。
   Ver.1はあえて100 kHzで動かしているので、ここは確かめる必要がある。
4. 🔴 **帯域より先に効くのはレイテンシ。**
   100 kHzだとGNSSの1回の読み出しが**約9.7 ms**かかり、**IMUの取得周期10 msをほぼ丸ごと食う**。
   帯域に余裕があっても、IMUのサンプル取得が1周期ぶん押し出されうる。
5. **ただしA-2（IMUのINT配線）が入るので、「いつ測ったか」は壊れない。**
   打刻は割り込み時刻で行うため、読み出しが遅れてもタイムスタンプは汚れない。
   壊れるのは**値の鮮度**の方で、ESKFにとってはこちらも効くので対策は要る。
6. **→ 先に卓上でできる検証がある**（3-4章）。**Ver.1の実機でI²Cを400 kHzへ上げ、
   BNO055の100 Hz読み出しが壊れないかを確かめる。** Ver.2の回路図が固まる前に
   答えが出せるので、これを最優先にする。

---

## 1. 宿題2：帯域の見積もり

### 1-1. 計算の前提

I²Cは1バイトあたり**8ビット＋ACK＝9ビット**を消費する。スタート/ストップ条件や
繰り返しスタートの時間はここでは無視する（数µsなので、下の桁には影響しない）。

| SCL周波数 | 1バイトあたりの時間 |
|---|---|
| 100 kHz（Ver.1の現行設定） | **90 µs** |
| 400 kHz（Fast-mode） | **22.5 µs** |

> Ver.1の設定は`firmware/logger_v1/src/sensors.cpp`の`cfg.master.clk_speed = 100000`。

### 1-2. IMU側（BNO055）が使う量

**Ver.1の現行実装**は、レジスタ`0x08`から**0x33＝51バイトを1回のバースト**で読み、
これを**100 Hz**で回している（`sensors.cpp`の`imuRead(0x08, bytes, 0x33)`）。
この51バイトには、生の加速度・地磁気・角速度に加えて、
**オイラー角・クォータニオン・線形加速度・重力ベクトルという「融合済みの値」が含まれている。**

バス上のバイト数は `アドレス(W) 1 + レジスタ 1 + アドレス(R) 1 + データ51 = 54バイト`。

| 読み方 | バス上のバイト数 | 1回の所要 @100 kHz | 1回の所要 @400 kHz | 100 Hz時の占有率 @100 kHz | @400 kHz |
|---|---:|---:|---:|---:|---:|
| **現行（融合値込み・51 B）** | 54 | **4.86 ms** | 1.22 ms | **48.6%** | 12.2% |
| **AMGモード（生値のみ・約20 B）** | 23 | **2.07 ms** | 0.52 ms | **20.7%** | 5.2% |

> **AMGモードの20バイト**＝加速度6＋地磁気6＋角速度6に、較正状態・温度ぶんを少し足した想定。
> **E-2でESKFを本命に決めた結果、融合済みの値は姿勢推定に使わない**ので、
> オイラー角・クォータニオン・線形加速度・重力ベクトルを読む必要がなくなる。
> **設計判断がそのままバス負荷の削減になっている。**

### 1-3. GNSS側（MAX-M10M、DDC）が使う量

u-bloxのI²Cは**DDC**と呼ばれ、次の手順で読む。

1. レジスタ`0xFD`/`0xFE`を読んで**受信バッファに何バイト溜まっているか**を得る（2バイト）
2. レジスタ`0xFF`（データストリーム）から**その分だけ読み出す**

**UBX-NAV-PVTは1フレーム100バイト**（ヘッダ6＋ペイロード92＋チェックサム2）。

| 手順 | バス上のバイト数 | @100 kHz | @400 kHz |
|---|---:|---:|---:|
| 残量の読み取り（`0xFD`） | 5 | 0.45 ms | 0.11 ms |
| NAV-PVT本体の読み出し（`0xFF`） | 103 | 9.27 ms | 2.32 ms |
| **合計（1エポックあたり）** | 108 | **9.72 ms** | **2.43 ms** |

| 更新レート | 占有率 @100 kHz | @400 kHz |
|---|---:|---:|
| 10 Hz（`four_10`＝4系統。現時点の基準候補） | **9.7%** | 2.4% |
| 25 Hz（単一系統・OTP書き込み済み個体） | **24.3%** | 6.1% |

> **NAV-SAT（衛星ごとの詳細）は別枠**で、衛星25〜30機なら約310〜370バイト＝
> **@100 kHzで約3.1〜3.7 ms**。ただしVer.1でも**1 Hz程度の診断用途**でしか読んでいないので、
> 占有率としては0.4%弱。無視できる。

### 1-4. 合算

| 構成 | @100 kHz | @400 kHz |
|---|---:|---:|
| 現行IMU読み（51 B）＋GNSS 10 Hz | **58.3%** | 14.6% |
| 現行IMU読み（51 B）＋GNSS 25 Hz | **72.9%** | 18.3% |
| **AMG（20 B）＋GNSS 10 Hz** | **30.4%** | 7.6% |
| **AMG（20 B）＋GNSS 25 Hz** | **45.0%** | **11.3%** |

**→ 帯域だけを見れば、AMG化すれば100 kHzでも通る。400 kHzなら問題にならない。**

### 1-5. 🔴 ただし本当の問題はレイテンシのほう

**占有率が50%を切っていても「余裕がある」とは言えない。** I²Cは1つの転送が始まると
終わるまで割り込めないため、**長い転送が他方を待たせる**。

| | 1回の転送長 | IMUの取得周期（10 ms）に対して |
|---|---:|---|
| GNSS読み出し @100 kHz | **9.72 ms** | 🔴 **ほぼ1周期まるごと。IMUサンプルが1回ぶん押し出されうる** |
| GNSS読み出し @400 kHz | 2.43 ms | ⚠️ 24%。許容できるが無視はできない |
| IMU読み出し（AMG）@100 kHz | 2.07 ms | GNSS側を最大2 ms待たせる |

**対策の候補（実装側で選べる）**

1. **400 kHzへ上げる**（いちばん効く。ただしBNO055が耐えるかが前提。→ 3-4章）
2. **GNSSの読み出しを分割する**。DDCは`0xFF`から任意長で読めるので、
   **32バイトずつ等に切って、間にIMUの取得を挟む**。1回あたり約2.9 ms（@100 kHz）に下がる
3. **I²Cを2系統に分ける**（GNSSとIMUを別バスへ）。**STM32U585は複数のI²Cを持つ**ので、
   ピンに余裕があれば根本的に解決する。→ **回路担当への申し送り事項**（下記5章）
4. IMUの取得周期を落とす。**ただしESKFはIMU 100 Hzが前提**なので、これは最後の手段

### 1-6. A-2（IMUのINT配線）がここで効く

**読み出しが遅れても、「そのサンプルがいつ測定されたか」は壊れない。**
A-2で引いてもらうINT信号の立ち上がり時刻をMCUのハードウェアタイマで打刻するため、
**I²Cの順番待ちはタイムスタンプに乗らない。**

ただし**値そのものが古くなること（レイテンシ）はESKFに効く**ので、
1-5の対策は必要。**「INTを引けば同期が完成する」わけではない**という
回路担当の指摘（`docs/share/hardware_ans_20260921.md`1章）はここにも当てはまる。

---

## 2. 宿題1：GNSSドライバをI²C（DDC）前提へ設計し直す

### 2-1. Ver.1の実装は何を前提にしているか

`firmware/logger_v1/src/sensors.cpp`のGNSS部は、**UARTであることに強く依存**している。

| # | Ver.1の実装 | I²Cでどうなるか |
|---|---|---|
| 1 | `uart_write_bytes(UART_NUM_1, ...)`でUBXを送信 | **書き換え必要**。DDCはレジスタ`0xFF`への書き込みで送る |
| 2 | `uart_read_bytes()`で受信し、1バイトずつ`UbxParser::feed()`へ流す | **パーサ自体はそのまま流用できる。** 供給元が変わるだけ |
| 3 | **オートボー**：9600〜460800の6通りを順に試して`MON-VER`が返る速度を探す | **丸ごと不要になる。** I²Cに通信速度の自動検出は要らない |
| 4 | `CFG-VALSET`で`0x40520001`（UART1ボーレート）を460800へ変更 | **不要。** 代わりに**DDC側の設定キー**を触る |
| 5 | 起動時に設定を毎回送り直す（V_BCKP非搭載のため） | **変わらない。**この方針は継続 |
| 6 | 受信は「垂れ流しを読む」モデル | 🔴 **「こちらから取りに行く」モデルへ変わる**。ここが最大の差 |

### 2-2. DDCの通信モデル（UARTとの決定的な違い）

**UARTは受信機が勝手に送ってくるが、DDCはマスタが読みに行かないと何も進まない。**
受信機側のバッファに溜まり続け、**読み出しが遅いと古いデータが積み上がる／溢れる。**

したがってドライバ側で必要になるのは：

- **定期ポーリング**：`0xFD`/`0xFE`で残量を見て、あれば`0xFF`から読む
- **溜まりすぎの検出**：残量が1エポックぶん（約100バイト）を大きく超えていたら、
  **読み出しが追いついていない**というサイン。**`gnss_health.h`の健全性指標へ足す**
- **空読みの扱い**：残量0のときに`0xFF`を読むと`0xFF`が返る仕様なので、
  **0xFFの連続はデータではなく「空」として捨てる**
- **上限つきの読み出し**：1回の転送を32〜64バイト程度に切り、IMUを待たせすぎない（1-5の②）

### 2-3. 移植の方針

**UbxParser・デコード（`decodePvt`等）・設定シーケンスはそのまま使える。
差し替えるのはトランスポート層だけ**なので、次の形にする。

```text
[ 変更しない ] UbxParser / decodePvt / decodeSatelliteHealth / decodeRadioHealth
                 ↑ 1バイトずつ供給されるだけ
[ 差し替える ] トランスポート層
                 Ver.1: uart_write_bytes / uart_read_bytes
                 Ver.2: ddcWrite(0xFF, ...) / ddcAvailable() + ddcRead(0xFF, ...)
[ 削除する   ] オートボー探索、UART1ボーレートのCFG-VALSET
[ 追加する   ] DDC残量の監視、空読みの除去、分割読み出し
```

**この形なら、Ver.1で積み上げた設定シーケンス（`gnss_config.h`）と
健全性監視（`gnss_health.h`）の資産をほぼ丸ごと引き継げる。**

### 2-4. 要確認（データシートで裏を取る）

**手元にMAX-M10M-00Bのデータシート／インテグレーションマニュアルが無いため、
以下は確認してから実装する。**

| # | 確認すること | なぜ要るか |
|---|---|---|
| 1 | **DDCのI²Cスレーブアドレス**（u-blox既定は`0x42`と理解しているが未確認） | 通信できるかどうかの前提 |
| 2 | 🔴 **DDCのSCL上限**（400 kHzで回せるか） | 1章の見積もりが400 kHz前提で成立している |
| 3 | **受信バッファの容量**と、溢れたときの挙動 | ポーリング周期の下限が決まる |
| 4 | **DDCを有効化／出力メッセージを割り当てる設定キー**（`CFG-MSGOUT-*_I2C`系） | 起動時シーケンスの書き換えに必要 |
| 5 | **TIMEPULSE（PPS）がI²C運用でもそのまま出るか** | A-1の前提。出ないと時刻規律が崩れる |

---

## 3. 🔴 先に卓上でできる検証（Ver.2基板を待たずに答えが出る）

**1章の結論は「400 kHzにできるかどうか」に集約される。
これはVer.1の実機で今すぐ確かめられる。**

### 3-1. なぜVer.1で確かめられるか

**Ver.1にもBNO055が同じI²Cバスに載っている**（`I2C_NUM_0`、GPIO17/18）。
GNSSは載っていないが、**知りたいのは「BNO055が400 kHzで安定か」**なので、
IMU単体で確認できる。

### 3-2. 手順

1. `firmware/logger_v1/src/sensors.cpp`の`cfg.master.clk_speed`を`100000`→`400000`に変更してビルド
2. 卓上で通電し、**30〜60分連続で100 Hz記録**を回す
3. 判定：`stats.imu_errors` / `imu_invalid` / `imu_recoveries`が**増えないこと**、
   SDのCSVで**IMU行が100 Hzを維持していること**（`VERIFICATION.md`と同じ見方）
4. **AMGモードでの読み出し（20バイト）も併せて試す**と、Ver.2の構成にそのまま近づく

### 3-3. 注意

- **BNO055はクロックストレッチを行う個体差がある**ことが知られており、
  400 kHzで不安定になる例が報告されている。**Ver.1が100 kHzを選んでいるのは
  安全側に倒した結果である可能性が高い**（明示的な理由は記録に残っていない）
- **だめだった場合でも詰みではない。** 1-5の②（分割読み出し）と③（I²C 2系統）が残る
- ⚠️ **この変更を車両接続中に試さないこと。** 卓上の隔離した構成で行う

### 3-4. この検証が回路設計へ返すもの

| 結果 | Ver.2の設計への意味 |
|---|---|
| ✅ 400 kHzで安定 | **I²C共用で問題ない。**回路担当へ「1系統でよい」と返せる |
| ❌ 400 kHzで不安定 | 🔴 **I²Cを2系統に分ける必要が出る。**回路図が固まる前に伝えないと手戻りになる |

**→ だからこそ、Ver.2の回路図作成中である今のうちに確かめる意味がある。**

---

## 4. まとめ：この宿題2件の現在地

| 宿題 | 状態 |
|---|---|
| **2（帯域の見積もり）** | ✅ **机上の見積もりは完了。** 帯域は400 kHzなら余裕、100 kHzでもAMG化すれば通る。**残る論点はレイテンシと、BNO055の400 kHz耐性** |
| **1（ドライバ設計）** | ⏳ **方針は確定**（トランスポート層だけ差し替え、パーサと設定シーケンスは流用）。**実装はVer.2基板の到着後**。先にデータシートで2-4章の5点を確認する |

---

## 5. 回路担当への申し送り（次回の共有に載せる）

1. **I²Cを2系統に分けられるか聞いておきたい。**
   GNSSとIMUを別バスにできれば、レイテンシ問題が根本的に消える。
   STM32U585は複数のI²Cを持つので、**ピンに余裕があるかどうかの話**。
   **A-2（IMUのINT）の接続先として`A5／PC0`が候補に挙がっている**が、
   I²Cを分ける場合はピン配分が変わるため、**併せて検討してほしい**
2. **BNO055を400 kHzで回す前提にしてよいかは、こちらで実測してから返す**（3章）
3. **MAX-M10MのDDC設定（アドレス・SCL上限・バッファ容量）**について、
   データシートの該当箇所を把握していれば教えてほしい（2-4章）

---

## 6. 関連資料

| 資料 | 内容 |
|---|---|
| `docs/share/hardware_ans_20260921.md` | **この宿題の出どころ。**1章＝P-3の回答（GNSSがI²Cへ移った経緯）、6章の1・2 |
| `LOGGER_V2_UNOQ_REPORT.md` | 2.5章＝なぜESKF（＝AMGモード）なのか、5.1章＝A-1/A-2の配線、7.1章＝E-2の決定 |
| `firmware/logger_v1/src/sensors.cpp` | **Ver.1の実装。**I²C設定は`initSensors`付近、GNSSのUART処理は`sendUbx`/`waitUbx`以降 |
| `firmware/logger_v1/GNSS_BALANCE.md` | 衛星系統×更新レートの比較（未決着。GNSS側の負荷を決める前提） |
| `firmware/logger_v1/VERIFICATION.md` | Ver.1の卓上試験の判定の仕方。3-2章の判定はこれに合わせる |
