ntakao2006-web/RaceCapture/sensorhub_defi_tap_design.md

# Defiセンサーハブ基板 設計書（油温＝中継・再現方式／油圧＝分岐方式）

> **この文書の位置づけ**：`logger_v2_channel_and_sensor_spec.md`2章の**A案（既設Defiセンサーを使う）**を、
> **JLCPCBへそのまま発注できる粒度**（ピン単位の接続表・LCSC品番つき部品表）まで具体化したもの。
> センサーハブ1台分（XIAO ESP32-C3＋外部CAN＋Defi入力）を**1枚の基板**として設計している。
>
> **改訂**：2026-10-04 全面改訂（v2）。回路図の入力・基板レイアウト・JLCPCB発注はユーザーが行う。
> 2026-09-24版（v1：1 MΩ分圧＋ゼロドリフトオペアンプで横から覗く方式）は**不採用**。v1の内容はgit履歴を参照。
>
> ⚠️ 方式は回路担当の提案に基づく。**部品・定数の最終判断は回路担当を優先する**（11章にレビュー観点）。

---

## 1. 方式（v1からの変更点）

| | v1（不採用） | **v2（本書）** |
|---|---|---|
| 油温 | Defiの分圧点を1 MΩで横から覗く | **サーミスタをDefiから切り離してハブが直接測り、Defiへはデジタルポテンショメータで「同じ抵抗値」を見せる** |
| 油圧 | 1 MΩ分圧＋オペアンプ | **100 kΩ分圧で横から覗くだけ**（センサーが電圧出力なので、Defiの表示に影響しない） |
| 電源断時 | もともと影響しない | **常時閉リレーでサーミスタをDefiへ直結に戻す**（ハブの電源が無ければDefiは素の状態） |
| オペアンプ・負電源 | OPA4333＋LM7705 | **不要** |
| ロガーへの出力 | 外部CAN | 外部CAN（変更なし。回路担当案の「PWMで電圧出力」は採らない。理由は1-1） |

### 1-1. ロガーへはPWMではなく外部CANで送る

ハブのMCUの中で油温は既に数値になっているので、**外部CANでそのまま送れば誤差が増えない**。
PWM→電圧に変換してロガーのADCで読み直すと、リップルとADC誤差がもう1回乗る。
外部CANでロガーへ送る構成は`hardware_interface_spec.md`1章#3・`docs/share/hardware_ans_20260921.md`5-2の2で既に確定している。

### 1-2. 動作モード

```
【バイパス】ハブ電源OFF・起動直後・異常時（リレー非通電）
  サーミスタ ──────────────────── Defi        ← 純正どおり直結。ハブは何もしない

【再現】通常動作（リレー通電）
  サーミスタ ── ハブが抵抗値を測る（1.2 kΩ基準・16 bit ADC）
                      │ 温度へ換算 → 外部CANでロガーへ（10 Hz）
                      └→ デジタルポテンショメータに同じ抵抗値をセット ── Defi
```

- MCUがリセットされるとGPIOが入力に戻り、ゲートのプルダウンで**リレーが自動的に落ちてバイパスになる**。
  ファームでウォッチドッグを有効にしておけば、フリーズ時も同じ経路でバイパスへ戻る
- 切り替えの瞬間（リレーの動作時間 約3 ms）はDefiから見てセンサーが一瞬「断線」になる。メーターの針はほぼ反応しない見込み

---

## 2. 使うサーミスタの特性

`datasheet/defi_temp_sensor_rt.csv`（−1〜97 ℃の表）。**25 ℃で9.68 kΩ、B定数3271（区間によらず一定）**。
Defi純正の温度センサーPDF00903Sの公称値（R25＝10 kΩ、B＝3380 K）にほぼ一致する。97 ℃より上はB定数モデルで外挿した値。

| 温度 | 抵抗値 | 1 ℃あたり |
|---|---:|---:|
| 0 ℃ | 26.4 kΩ | 1,158 Ω |
| 50 ℃ | 4,141 Ω | 130 Ω |
| 100 ℃ | 1,067 Ω | 25 Ω |
| 130 ℃ | 555 Ω | 11 Ω |
| 150 ℃ | 379 Ω | 6.9 Ω |

---

## 3. ブロック図

```
                    ┌──────────────────────── センサーハブ基板 ────────────────────────┐
 J2 Defi側 6極      │                                                                 │
  1 S+ (センサー側) ─┼─┬─ K1 極1 NC ─┐                                                │
  2 D+ (Defi側)    ─┼─┼─ K1 極1 COM ┘  K1 極1 NO ── U3 デジタルポテンショメータ (W)   │
                    │ └─ K1 極2 COM ── K1 極2 NO ── 測温ノードM ── R(1.2k) ── GPIO2  │
  3 SG (センサーGND)─┼──────────────── U3 (B) ／ ADC1 AIN1                          │
  4 PS (油圧信号)   ─┼── 100k/100k 分圧 ── ADC2 AIN0                                 │
  5 P5V (Defi 5V)   ─┼── 100k/100k 分圧 ── ADC2 AIN1                                 │
  6 シールド        ─┼── GND                                                         │
                    │                                                                 │
 J1 外部CAN 4極     │  U4 SN65HVD230 ── XIAO ESP32-C3 ── I²C ── ADC1/ADC2 (ADS1115×2)│
  1 +5V 2 CANH      │                     │ SPI ── U3 MCP41HV51                       │
  3 CANL 4 GND      │  U5 MT3608 (5V→11.4V) ── U3のV+                                 │
                    └─────────────────────────────────────────────────────────────────┘
```

- **K1はDPDT（2回路）リレー**。極1がDefiの行き先を「サーミスタ／デジタルポテンショメータ」で切り替え、
  極2がサーミスタを「切り離し／測温回路」で切り替える
- **SG（センサーGND線）は切らずに分岐で取る**。サーミスタのGND側とDefiのGND側は常につながったまま

---

## 4. 回路（ピン単位の接続表）

ネット名は回路図にそのまま使える表記にしてある。

### 4-1. 電源

| 部品 | ピン | 接続先 | 備考 |
|---|---|---|---|
| J1（Micro-Fit 4極） | 1 | **+5V_BUS** | ロガーから来る外部CANの5 V |
| J1 | 4 | GND | |
| D1 ショットキー B5819W | A | +5V_BUS | XIAOのUSB（VBUS）とバス5 Vがぶつからないようにする逆流防止 |
| D1 | K | **+5V_XIAO** | → XIAOの5Vピン |
| C1 22 µF＋C2 0.1 µF | | +5V_BUS–GND | J1の近く |
| XIAO | 3V3 | **+3V3** | XIAO内蔵レギュレータの出力をADC・CAN・U3のロジック電源に使う |

**昇圧（U3のアナログ電源用、+11.4 V）**：

| 部品 | ピン | 接続先 |
|---|---|---|
| U5 MT3608（SOT-23-6） | 5 IN | +5V_BUS |
| U5 | 4 EN | +5V_BUS（常時ON） |
| U5 | 2 GND | GND |
| U5 | 1 SW | L1 22 µHの片側、D2 SS14のアノード |
| L1 22 µH | | +5V_BUS – SW |
| D2 SS14 | K | **+11V_RAW** |
| U5 | 3 FB | R1 180 kΩ（+11V_RAW側）とR2 10 kΩ（GND側）の分圧点 → 0.6 V×19＝**11.4 V** |
| C3 10 µF/25 V | | +5V_BUS–GND（U5の入力） |
| C4 10 µF/25 V | | +11V_RAW–GND（U5の出力） |
| R3 10 kΩ | | +11V_RAW–GND（ダミー負荷。U3は数µAしか食わないので、無負荷で電圧が暴れないように1 mA流しておく） |
| R4 100 Ω＋C5 10 µF/25 V | | +11V_RAW →R4→ **+11V** →C5→ GND（スイッチングノイズのフィルタ） |

### 4-2. XIAO ESP32-C3 のピン割り当て

| XIAOピン | GPIO | 用途 | 備考 |
|---|---|---|---|
| D0 | GPIO2 | **EXC**：測温の励起（R5 1.2 kΩの上端） | ストラップピンだが、起動時はリレーが落ちていて負荷がぶら下がらないので問題ない |
| D1 | GPIO3 | **CAN_TX** → U4 D | |
| D2 | GPIO4 | **CAN_RX** ← U4 R | |
| D3 | GPIO5 | **POT_CS** → U3 CS | |
| D4 | GPIO6 | **SDA** | 4.7 kΩで+3V3へプルアップ |
| D5 | GPIO7 | **SCL** | 4.7 kΩで+3V3へプルアップ |
| D6 | GPIO21 | **LED**（1 kΩ経由で緑LED→GND） | 起動ログで一瞬点滅するが無害 |
| D7 | GPIO20 | **RELAY** → Q1ゲート | |
| D8 | GPIO8 | **POT_SCK** → U3 SCK | |
| D9 | GPIO9 | 未使用 | XIAO上のBOOTボタン。何もつながない |
| D10 | GPIO10 | **POT_SDI** → U3 SDI | |
| 5V | | +5V_XIAO | |
| GND | | GND | |
| 3V3 | | +3V3 | |

### 4-3. リレー（K1：HONGFA HFD4/5-SR、DPDT・5 Vコイル・金めっき接点）

| 部品 | ピン | 接続先 | 備考 |
|---|---|---|---|
| K1 コイル＋ | | +5V_BUS | ⚠️ **有極性コイル**。＋/−はデータシートのピン図に合わせる |
| K1 コイル− | | Q1 ドレイン | |
| D3 1N4148W | K→+5V_BUS、A→Q1ドレイン | | フライバックダイオード |
| Q1 AO3400A | G | R6 100 Ω経由でD7(GPIO20) | |
| Q1 | S | GND | |
| R7 100 kΩ | | Q1ゲート–GND | **電源断・リセット時にリレーを確実に落とす**（＝バイパスに戻す） |
| K1 極1 COM | | **D+**（J2-2） | |
| K1 極1 NC | | **S+**（J2-1） | 非通電時：Defi ↔ サーミスタ直結 |
| K1 極1 NO | | **POT_W**（U3 P0W） | 通電時：Defi ↔ デジタルポテンショメータ |
| K1 極2 COM | | **S+**（J2-1） | |
| K1 極2 NC | | 未接続 | 非通電時：サーミスタは測温回路から切り離される |
| K1 極2 NO | | **M**（測温ノード） | 通電時：サーミスタ ↔ 測温回路 |

コイル電流は約28 mA（5 V／178 Ω）。

### 4-4. デジタルポテンショメータ（U3：Microchip MCP41HV51-502E/ST、5 kΩ・256段・TSSOP-14）

| ピン | 名前 | 接続先 | 備考 |
|---|---|---|---|
| 1 | VL | +3V3 | ロジック電源。XIAOと同じ3.3 Vなのでレベル変換不要 |
| 2 | SCK | POT_SCK（GPIO8） | |
| 3 | CS | POT_CS（GPIO5） | 10 kΩで+3V3へプルアップ（起動中に誤って書き込まれないように） |
| 4 | SDI | POT_SDI（GPIO10） | |
| 5 | SDO | 未接続 | 書き込みしかしない |
| 6 | WLAT | GND | 受け取った値を即座に反映 |
| 7 | SHDN | +3V3 | Lでシャットダウンなので常時H |
| 8 | DGND | GND | |
| 9 | NC | GND | データシート推奨 |
| 10 | V− | GND | 単電源で使う（V−＝DGND） |
| 11 | P0B | **SG** | 可変抵抗の「下」をDefiのセンサーGNDへ |
| 12 | P0W | **POT_W**（K1極1 NO） | 可変抵抗の「上」をDefiの信号線へ |
| 13 | P0A | 未接続 | 可変抵抗（レオスタット）として使うので開放 |
| 14 | V+ | +11V | 0.1 µFをV+–GND間に直近で |
| | | | VL–GND間にも0.1 µF |

- **流せる電流は25 mA**（5 kΩ品）。150 ℃でDefi内部のプルアップが仮に0 Ωでも5 V／380 Ω＝13 mAなので、
  **Defi内部の抵抗値によらず壊れない**（Defiのプルアップを実測しなくて済むのはこのため）
- 電源断時はK1が落ちてU3はDefiから切り離されるので、U3の電源が無くても関係ない

### 4-5. 測温回路（サーミスタを直接測る）

| 部品 | 接続 | 備考 |
|---|---|---|
| R5 1.2 kΩ **0.1%・25 ppm 薄膜** | EXC（GPIO2）– M | 基準抵抗。50〜150 ℃の中央付近に感度が来る値 |
| D4 BAT54S | 1(A1)→GND、3(共通)→M、2(K2)→+3V3 | Mの保護。サーミスタ線に12 V等が触れてもGPIOを守る |
| R8 1 kΩ＋C6 10 nF C0G | M →R8→ **ADC1 AIN0**、C6はAIN0–GND | |
| R9 1 kΩ＋C7 10 nF C0G | SG →R9→ **ADC1 AIN1**、C7はAIN1–GND | |
| R10 1 kΩ＋C8 10 nF C0G | EXC →R10→ **ADC1 AIN2**、C8はAIN2–GND | 励起電圧そのものを測る（比で換算するため） |
| R11 1 kΩ | GND →R11→ **ADC1 AIN3** | 差動測定の0 V基準 |

**ADC1（U1：TI ADS1115IDGSR、VSSOP-10、I²Cアドレス0x48）**

| ピン | 名前 | 接続先 |
|---|---|---|
| 1 | ADDR | GND（→0x48） |
| 2 | ALERT/RDY | 未接続 |
| 3 | GND | GND |
| 4〜7 | AIN0〜3 | 上表のとおり |
| 8 | VDD | +3V3（0.1 µFを直近で） |
| 9 | SDA | SDA |
| 10 | SCL | SCL |

### 4-6. 油圧（横から覗くだけ）

| 部品 | 接続 | 備考 |
|---|---|---|
| R12 100 kΩ 0.1% | PS（J2-4）→ **PS_DIV** | |
| R13 100 kΩ 0.1% | PS_DIV → GND | |
| C9 0.1 µF | PS_DIV – GND | ADCの入力を安定させる |
| R14 100 kΩ 0.1% | P5V（J2-5）→ **P5_DIV** | |
| R15 100 kΩ 0.1% | P5_DIV → GND | |
| C10 0.1 µF | P5_DIV – GND | |

Defiから見た負荷は200 kΩ（約25 µA）。センサー出力・5 V供給とも能動回路なので、Defiの表示は変わらない。

**ADC2（U2：ADS1115IDGSR、I²Cアドレス0x49）**：ADDR→**+3V3**、AIN0←PS_DIV、AIN1←P5_DIV、
**AIN2・AIN3は予備としてJ3へ出す**（将来のブレーキ圧等）。その他のピンはADC1と同じ。

| J3（予備アナログ、2.54 mm 1×4） | 接続 |
|---|---|
| 1 | +3V3 |
| 2 | ADC2 AIN2（1 kΩ経由） |
| 3 | ADC2 AIN3（1 kΩ経由） |
| 4 | GND |

入力は0〜3.3 V。5 V系のセンサーをつなぐときは分圧を足す。

### 4-7. 外部CAN

| 部品 | ピン | 接続先 | 備考 |
|---|---|---|---|
| U4 SN65HVD230DR（SOIC-8） | 1 D | CAN_TX（GPIO3） | |
| U4 | 2 GND | GND | |
| U4 | 3 VCC | +3V3（0.1 µFを直近で） | 3.3 V動作品なのでXIAOと直結できる |
| U4 | 4 R | CAN_RX（GPIO4） | |
| U4 | 5 Vref | 未接続 | |
| U4 | 6 CANL | J1-3 | |
| U4 | 7 CANH | J1-2 | |
| U4 | 8 Rs | GND | 高速モード |
| D5 PEC3824C2A-AU | LINE1→CANH、LINE2→CANL、GND→GND | | ロガー本体（logger_v1 D2/D3）と同じTVS |
| R16 120 Ω＋JP1 はんだジャンパ | CANH –R16– JP1 – CANL | | **終端。既定は開放**。このハブが幹線の端に来るときだけJP1をはんだで閉じる |

J1のピン配置は**ロガー本体のJ4と同じ**（1＝+5V、2＝CANH、3＝CANL、4＝GND）。ケーブルはストレートで結べる。

### 4-8. コネクタ

| 記号 | 品名 | ピン |
|---|---|---|
| J1 | Molex Micro-Fit 3.0 **43045-0400**（2×2） | 1 +5V_BUS／2 CANH／3 CANL／4 GND |
| J2 | Molex Micro-Fit 3.0 **43045-0600**（2×3） | 1 S+／2 D+／3 SG／4 PS／5 P5V／6 シールド（GND） |
| J3 | ピンヘッダ 1×4 2.54 mm | 4-6章 |
| XIAO | 1×7ピンソケット×2（または表面実装で直付け） | XIAOは**JLCPCBでは実装されない**ので手はんだ |

J1とJ2は極数を変えて**挿し間違いを防いでいる**。

---

## 5. 部品表（JLCPCB実装用）

LCSC品番は2026-10-04にLCSCで在庫を確認したもの。「基本部品」はJLCPCBの基本部品ライブラリから同等品を選べばよい。

| 記号 | 品名 | 型番 | LCSC | 数 | 単価目安 |
|---|---|---|---|---:|---|
| U1, U2 | 16 bit ADC 4ch I²C | TI **ADS1115IDGSR** | **C37593** | 2 | $1.23 |
| U3 | デジタルポテンショメータ 5 kΩ 256段 | Microchip **MCP41HV51-502E/ST** | **C637063** | 1 | $3.33 ⚠️在庫23個 |
| U4 | CANトランシーバ 3.3 V | TI **SN65HVD230DR** | **C12084** | 1 | $0.64 |
| U5 | 昇圧DC/DC | XI'AN Aerosemi **MT3608** | **C84817** | 1 | $0.10 |
| K1 | 信号用リレー DPDT 5 V | HONGFA **HFD4/5-SR** | **C64399** | 1 | $1.46 |
| R5 | 抵抗 1.2 kΩ **0.1% 25 ppm 薄膜** 0603 | Panasonic **ERA3AEB122V** | **C445629** | 1 | $0.09 |
| R12〜R15 | 抵抗 100 kΩ **0.1% 25 ppm 薄膜** 0603 | YAGEO **RT0603BRD07100KL** | **C122538** | 4 | $0.03 |
| D1 | ショットキー 1 A | B5819W（SOD-123） | 基本部品 | 1 | |
| D2 | ショットキー 1 A 40 V | SS14（SMA） | 基本部品 | 1 | |
| D3 | 小信号ダイオード | 1N4148W（SOD-123） | 基本部品 | 1 | |
| D4 | ショットキー2連 | BAT54S（SOT-23） | 基本部品 | 1 | |
| D5 | CAN用TVS | PEC3824C2A-AU（SOT-23） | ロガー本体と同じ | 1 | |
| Q1 | Nch MOSFET | AO3400A（SOT-23） | 基本部品 | 1 | |
| L1 | インダクタ 22 µH（飽和電流0.5 A以上） | 4×4 mm級 | 基本部品から | 1 | |
| LED | 緑LED 0603 | | 基本部品 | 1 | |
| R1 | 180 kΩ 1% 0603 | | 基本部品 | 1 | |
| R2, R3, CSプルアップ | 10 kΩ 1% 0603 | | 基本部品 | 3 | |
| R4 | 100 Ω 0603 | | 基本部品 | 1 | |
| R6 | 100 Ω 0603 | | 基本部品 | 1 | |
| R7 | 100 kΩ 1% 0603 | | 基本部品 | 1 | |
| R8〜R11, J3直列×2, LED用 | 1 kΩ 1% 0603 | | 基本部品 | 7 | |
| I²Cプルアップ | 4.7 kΩ 1% 0603 | | 基本部品 | 2 | |
| R16 | 120 Ω 1% 0603 | | 基本部品 | 1 | |
| C6〜C8 | 10 nF **C0G** 0603 | | 基本部品 | 3 | |
| パスコン, C9, C10 | 0.1 µF X7R 0603 | | 基本部品 | 8前後 | |
| C1 | 22 µF 10 V 0805/1206 | | 基本部品 | 1 | |
| C3〜C5 | 10 µF **25 V** 0805/1206 | | 基本部品 | 3 | |
| J1 | Micro-Fit 3.0 4極 | Molex 43045-0400 | ロガー本体と同じ | 1 | |
| J2 | Micro-Fit 3.0 6極 | Molex 43045-0600 | 要確認 | 1 | |
| — | XIAO ESP32-C3 | Seeed | 手持ち | 1 | |

**ICとリレーの合計は1枚あたり約$9（1,300円程度）**。基板・実装費は別。

⚠️ **MCP41HV51-502E/STはLCSCに23個しか在庫が無い。** 発注を決めたら早めにJLCPCBの部品を確保するか、
RSで買う分（RS品番649-491、2個¥829）を手はんだで載せる。

---

## 6. 設計の根拠（数字）

### 6-1. ハブが測る油温（ロガーへ送る値）

1.2 kΩ基準・励起3.3 V・ADS1115（±4.096 Vレンジ、1 LSB＝125 µV）での見積もり：

| 温度 | サーミスタに流れる電流 | 感度 | 1 LSBあたり | 自己発熱（連続励起時） |
|---|---:|---:|---:|---:|
| 50 ℃ | 0.62 mA | 18.0 mV/℃ | 0.007 ℃ | 1.6 mW |
| 100 ℃ | 1.46 mA | 19.3 mV/℃ | 0.006 ℃ | 2.3 mW |
| 150 ℃ | 2.09 mA | 11.0 mV/℃ | 0.011 ℃ | 1.7 mW |

- v1で最悪1 mV/℃だった高温側の感度が**11 mV/℃に上がった**。基準抵抗をこちらで選べるようになったため
- 基準抵抗の誤差0.1%は150 ℃で約0.05 ℃。リレー接点・配線の抵抗（合わせて0.2 Ω程度）は約0.03 ℃
- **センサーGND（SG）とハブGNDの電位差は結果に入らない**（サーミスタの両端をAIN0−AIN1の差動で測るため）
- 自己発熱は、励起（GPIO2）を測定中だけHにすれば実質半分以下になる

### 6-2. Defiメーターに見せる油温

| 温度 | 1段（19.6 Ω）あたり |
|---|---:|
| 50 ℃ | 0.15 ℃ |
| 100 ℃ | 0.8 ℃ |
| 150 ℃ | 2.8 ℃ |

- MCP41HV51は**全抵抗の誤差±20%・ワイパー抵抗75〜170 Ω**。そのままだと高温側で10 ℃近くずれるので、
  **1個ごとに2点校正する**（9章）。校正後の誤差は、ワイパー抵抗の温度・電圧変化分で**高温側で数 ℃程度**の見込み
- 5 kΩ品の全抵抗は最小4.0 kΩなので、**およそ50 ℃より低い温度はDefi側では「50 ℃付近で頭打ち」**になる。
  ロガーへ送る値（6-1）は0 ℃でも正しく測れる

### 6-3. 油圧

- ADS1115の入力（分圧後0.29〜2.21 V）で**1 LSB＝約0.06 kPa**
- 油圧はDefi 5 Vとの比で換算するので、Defi 5 Vのばらつきは消える
- GND電位差は、ADC1で測ったSGの電位を差し引いて補正する（8-2章）

---

## 7. 車両側の配線

| 線 | 処理 | J2 |
|---|---|---|
| 油温センサーの信号線（GNDでない方） | **切断**して、センサー側をS+、Defi側をD+へ | 1, 2 |
| 油温センサーのGND線 | **切らずに分岐**（はんだ＋熱収縮） | 3 |
| 油圧センサーの信号線（白） | 分岐 | 4 |
| 油圧センサーの電源線（赤＝Defiの5 V） | 分岐 | 5 |
| シールド | ハブ側だけでGNDへ | 6 |

- ⚠️ **油温の信号線を切るので、ハブを外すときは信号線を元どおりつなぎ直す必要がある。**
  Defiの中継コネクタでY字ハーネスを作れれば、元に戻すのが楽になる（コネクタは現車確認後）
- ⚠️ **油温センサーのGND線と油圧センサーの黒が導通しているか**をテスターで確かめる（`ncec_next_session_checklist.md`項目G）。
  別系統だった場合、本書の「SGを1本で共用」が成り立たないので回路担当に相談する
- 色は現車で必ずテスターで確かめる。エレクトロタップは使わない（振動で接触不良になる）
- 分岐は車室内のDefiコントロールユニットの近くで行う

---

## 8. ファームウェア（センサーハブ）

### 8-1. 起動シーケンス

1. 起動直後は**リレーOFF（バイパス）のまま**。U3（MCP41HV51）の初期値は中点
2. U3へ校正値から計算した「暫定値」（前回終了時の温度、無ければ80 ℃相当）を書く
3. リレーON → 測温 → U3を実測値に合わせて更新（ここまで100 ms以内）
4. 以後、25 msごとに測温、100 msごとにU3更新と外部CAN送信（10 Hz）
5. **異常を検出したらリレーOFF（バイパス）に戻す**：サーミスタの断線・短縮、I²C／SPIの通信失敗
6. ウォッチドッグを有効にする（フリーズ→リセット→GPIOが入力に戻ってリレーOFF）

### 8-2. 換算式

**油温（ハブが測る値）**：

```
Vth = ADC1(AIN0 − AIN1)             … サーミスタ両端の電圧（差動）
Vr  = ADC1(AIN2 − AIN3) − ADC1(AIN0 − AIN3)   … 基準抵抗R5の両端の電圧
Rth = 1200 × Vth / Vr               [Ω]
1/T = 1/298.15 + ln(Rth / 9676) / 3271     … T[K]。datasheet/defi_temp_sensor_rt.csv のB定数モデル
```

実車でDefi表示と突き合わせて、ずれがあれば`9676`と`3271`を調整する。

**Defiへ見せる値**：

```
code = round( (Rth − RW_cal) / (RAB_cal / 255) )    … 0〜255に制限
```

`RW_cal`（ワイパー抵抗）と`RAB_cal`（全抵抗）は9章の校正値。

**油圧**：

```
Vsg = ADC1(AIN1 − AIN3)                  … SGの電位（ハブGND基準、負もあり得る）
r_P = (2 × ADC2(AIN0) − Vsg) / (2 × ADC2(AIN1) − Vsg)
P [kPa] = (5.0 × r_P − 0.58) × 251.4     … 0.58と251.4は初期値。ゼロ点はIG ON・エンジン停止で校正
```

### 8-3. 異常検出（外部CANで「無効」フラグを立てる）

| 条件 | 意味 | 動作 |
|---|---|---|
| Rth > 100 kΩ | 油温センサー断線 | リレーOFF（Defiも断線表示になるが、純正と同じ状態） |
| Rth < 100 Ω | 油温センサー短絡 | リレーOFF |
| 2 × ADC2(AIN1) が 4.6〜5.4 V の外 | Defi未通電、または5 V線が外れた | 油圧のみ無効 |

---

## 9. 校正（基板1枚ごとに1回、卓上で）

**デジタルポテンショメータの2点校正**：

1. J2にDefiをつながない状態で、ファームの校正モードからリレーON・U3をcode 0にする
2. **テスターでJ2の2番（D+）と3番（SG）の間の抵抗を測る** → `RW_cal`
3. code 255にして同じく測る → `RAB_cal = 測定値 − RW_cal`
4. 2つの値をファーム（NVS）へ書き込む

**卓上での動作確認**：

| 試験 | やり方 | 合格の目安 |
|---|---|---|
| 測温 | S+–SG間に**精密抵抗**（1 kΩ・4.7 kΩ等）をつなぐ | 測定値が0.2%以内 |
| 再現 | S+–SGに精密抵抗、D+–SGの抵抗をテスターで測る | 抵抗値が±1段（20 Ω）以内で一致 |
| バイパス | ハブの電源を切る | S+–D+が導通（数Ω以下）、D+–SGが精密抵抗の値 |
| 油圧 | PS・P5Vに可変電源 | 比が0.2%以内で一致 |

---

## 10. 基板レイアウトの注意

- **MT3608（昇圧）とL1はADS1115・測温回路から離す。** 昇圧のGNDループ（U5–C3–C4–D2）は小さく
- **R5（基準抵抗）〜M〜ADC1 AIN0／AIN1の配線は短く、GNDベタの上に**
- SG・PS・P5VのJ2からADCまでの配線は、昇圧回路の下を通さない
- K1のコイル側（+5V_BUS–Q1）と接点側（S+／D+／POT_W／M）は離す
- XIAOのアンテナ（基板端のチップアンテナ）の下にGNDベタを置かない（無線は使わないので優先度は低い）

---

## 11. 回路担当に見てほしいこと

1. **MCP41HV51の端子P0BをSG（DefiのGND）につないでいる。** U3のV−はハブのGNDなので、
   SGがハブGNDより低い（負）と端子電圧範囲（V−〜V+）を外れる。絶対最大は−0.3 Vなので数十mVなら壊れないが、
   **V−を少し負にする（例：チャージポンプで−1 V程度）べきか**
2. **昇圧（MT3608）を入れずに済む方法**があればそのほうが良い（MCP41HV51はV+−V−≧10 Vが必要）
3. **リレーの選定**（HFD4/5-SR、有極性コイル）。接点の微小負荷（数mA）での信頼性に問題が無いか
4. CANトランシーバを**SN65HVD230**にした（ロガー本体のATA6561はLCSCで在庫が無く、3.3 V品でXIAOと直結できるため）。
   ロガー本体と揃えるべきか
5. MCP41HV51の在庫が少ない件の代替（同等の5 kΩ・高電流品があれば）

---

## 12. 関連資料・出典

| 資料 | 内容 |
|---|---|
| `datasheet/defi_temp_sensor_rt.csv` | 使用するサーミスタの温度—抵抗表（−1〜97 ℃） |
| `logger_v2_channel_and_sensor_spec.md` | 2章＝A案/B案の比較と要求レンジ（油温0〜150 ℃、油圧0〜1.0 MPa、10 Hz） |
| `hardware_interface_spec.md` | 1章#3＝外部CAN（CANH/CANL/5V/GNDの4線）、6章＝Defi分岐の要望の原文 |
| `ncec_next_session_checklist.md` | 項目G＝Defiセンサーの現車確認 |
| `circuit/logger_v1/logger_v1.net` | ロガー本体側の外部CANコネクタ（J4）のピン配置・TVS |
| [MCP41HVX1 データシート（DS20005207B）](https://ww1.microchip.com/downloads/en/DeviceDoc/20005207B.pdf) | 端子電流25 mA（5 kΩ品）、ワイパー抵抗75〜170 Ω、RAB±20%、V+は10〜36 V |
| [市販メータセンサーの解析](https://kaele.com/~kashima/car/sensor/) | Defi温度センサーPDF00903S＝NTC、R25＝10 kΩ、B＝3380 K |
| [Defi Sensor Calibration Curves（Type-RA forum）](https://www.type-ra.com/subaru-forum/threads/defi-sensor-calibration-curves.48225/) | Defi油圧センサーの電圧—圧力表（0 psi＝0.580 V〜140 psi＝4.420 V） |
