ntakao2006-web/RaceCapture/ncec_can_spec.md

# NCロードスター（NCEC）CAN通信仕様

> **この文書の位置づけ**：NCECのCANバス上に実際に流れているものを、**仕様としてだけ**まとめたもの。
> 測定手順・回路の話・プロジェクトの経緯は含まない（それらは`ncec_field_procedure.md`・
> `vehicle_can_survey_summary.md`・`ARCHITECTURE.md`）。実装者がこの1枚だけ見れば
> デコーダを書ける状態を目指している。
>
> **確度は3段階で明示する**。推測を確定として書かない。
> **確定**＝実測で式まで検証済み／**示唆**＝相関はあるが式が確定しない／**未解明**＝意味不明
>
> **最終更新**：2026-09-06

---

## 0. 適用範囲と測定条件

| 項目 | 内容 |
|---|---|
| 対象車両 | マツダ ロードスター **NCEC 前期型（2005年式）**、MT、**DSC非搭載** |
| **重要：改造内容** | **後期型エンジンへ載せ替え済み＋ECUチューン（NOPRO MZ-TUNE+）**。レブリミット8,000rpm、スピードリミッター解除、メカフィーリングスロットルマップ、電動ファン作動温度変更などを含む |
| 測定日 | 2026-09-06 |
| 測定系 | XIAO ESP32C3（TWAI）＋ MCP2562FD-E/P、OBD2ポート直結 |
| 測定量 | 走行55分／**2,611,844フレーム**／791.5 frame/s。**取りこぼし0・バスエラー0** |
| 欠落ゼロの検証 | `0x211` byte7 のローリングカウンタ246,009件を全数照合し、増分が**100.0000%が+1（例外ゼロ）** |
| 解析範囲 | 本書の統計値・回帰は原則**走行フェーズ41分（1,966,217フレーム）**に基づく |

> **⚠️ ノーマルのNCECとは異なる可能性がある項目**には本文中で明記する。
> コミュニティのNC用CANデータベースはノーマルのNC1が前提のため、食い違う箇所がある。

---

## 1. バス諸元

| 項目 | 値 |
|---|---|
| プロトコル | **ISO 15765-4 CAN**、11bit標準ID |
| ビットレート | **500 kbps**（HS-CAN） |
| OBD2コネクタ | **6番＝CAN_H／14番＝CAN_L／5番＝Signal Ground** |
| 終端 | **車両バスは両端終端済み**。外部機器側に120Ωを付けない |
| 準拠 | JOBD（Japan OBD） |
| バス負荷 | **走行中 約692 frame/s**（外部機器が何も送信しない状態での実測） |
| 非診断ID数 | **16種**（下記） |

> **3番・11番ピンには触らないこと。** マツダ車ではここにMS-CAN(125kbps)が来ている場合があり、
> 6番/14番と導通させると2系統直結になって双方でエラーフレームが連発し、
> ノードがバスオフに陥る（車両側の警告灯・DTC・フェイルセーフを誘発する）。

---

## 2. 非診断ID 一覧

| CAN ID | 周期 | 件数(41分) | 内容 | 確度 |
|---|---|---|---|---|
| `0x200` | 100 Hz | 246,069 | **アクセルペダル開度**＋**ブレーキ**＋未解明の16bit×3 | **確定**＋一部未解明 |
| `0x201` | 100 Hz | 246,069 | **エンジン回転数・車速**・スロットル系 | **確定** |
| `0x215` | 100 Hz | 246,069 | **アクセルペダル開度**＋**A/C要求**＋未解明の16bit×2 | **確定**＋一部未解明 |
| `0x4B0` | 100 Hz | 246,009 | **4輪独立ホイールスピード** | **確定** |
| `0x211` | 100 Hz | 246,009 | **ローリングカウンタ**（byte7のみ可変） | **確定** |
| `0x21A` | 50 Hz | 123,005 | **全8バイトが常時ゼロ** | **未解明** |
| `0x231` | 40 Hz | 98,427 | **クラッチスイッチ**（byte1） | **確定** |
| `0x4EC` | 40 Hz | 98,427 | 未解明の16bit×2 | **未解明** |
| `0x240` | 10 Hz | 24,607 | **水温・スロットル・吸気温**＋負荷/点火時期 | **確定**＋一部示唆 |
| `0x420` | 10 Hz | 24,607 | **水温**（byte0）＋未解明 | **確定**＋一部未解明 |
| `0x4FF` | 10 Hz | 24,607 | **ASCII文字列の分割送信** | **確定** |
| `0x212` | 10 Hz | 24,601 | **全8バイトが常時固定値** | **未解明** |
| `0x430` | 10 Hz | 24,599 | **燃料レベル**（byte0） | **確定** |
| `0x39A` | 10 Hz | 24,599 | **パーキングブレーキ**（byte0 bit3） | **確定** |
| `0x4F0` | 1 Hz | 2,461 | 全8バイトが固定値 | **未解明** |
| `0x4F1` | 1 Hz | 2,461 | 全8バイトが固定値 | **未解明** |

診断用の `0x7E0`（要求）・`0x7E8`（応答）は5章。

---

## 3. ID別バイトマップ

**2バイト値はすべてビッグエンディアン**（上位バイトが先）。

### `0x201` — 回転数・車速（100 Hz）★最重要

| byte | 内容 | 式 | 実測 | 確度 |
|---|---|---|---|---|
| 0-1 | **エンジン回転数** | `raw / 4` [rpm] | slope=0.250041, intercept=-0.417, **R²=0.99978** | **確定** |
| 2-3 | 未解明 | — | 9,706〜59,217、値種9,380 | 未解明 |
| 4-5 | **車速** | `raw / 100 - 100` [km/h] | slope=0.0100005, intercept=-100.004, **R²=0.99991** | **確定** |
| 6 | スロットル／ペダル系 | 未確定 | 0x00〜0x39、OBD `0x11`に対しR²=0.79 | 示唆 |
| 7 | 固定 `0xFF` | — | — | — |

> **車速の`-100`オフセット**：停車時の生値は `0x2710`（=10000）。`10000/100-100 = 0 km/h`。

### `0x4B0` — 4輪独立ホイールスピード（100 Hz）

| byte | 車輪 | 式 | 確度 |
|---|---|---|---|
| 0-1 | **左前（FL）** | `raw / 100 - 100` [km/h] | **確定**（R²=0.99988） |
| 2-3 | **右前（FR）** | 同上 | **確定**（R²=0.99988） |
| 4-5 | **左後（RL）**（駆動輪） | 同上 | **確定**（R²=0.99989） |
| 6-7 | **右後（RR）**（駆動輪） | 同上 | **確定**（R²=0.99990） |

**＝ コミュニティ資料と同じ `[FL, FR, RL, RR]` の順**（2026-09-12に実測で確定）。

**前後軸の判定根拠**：NCECはFR（後輪駆動）。加速時は駆動輪が路面に対して先行し、4輪平均より
速く回る。各バイトペアの偏差と縦加速度の相関は byte0-1: **-0.320**／byte2-3: **-0.259**／
byte4-5: **+0.291**／byte6-7: **+0.325** と、符号が2対2で割れた。正の側が駆動輪＝後軸。

**左右の組み分けの根拠**：旋回時の左右差（ヨーレート×トレッド）は前軸と後軸に共通して現れる。
{byte0-1, byte2-3}と{byte4-5, byte6-7}を車軸とみなしたときの左右差どうしの相関は **+0.567**、
対角に切ると **+0.109** で消える。相関が**正**であることから、
**`byte0-1` と `byte4-5` が同じ側**、**`byte2-3` と `byte6-7` が同じ側**。

**左右の確定（2026-09-12、`ncec_lr2`）**：駐車場で**一定舵角のまま左旋回40秒・右旋回40秒**を
実施した（間に10秒の切り返しフェーズを挟み、解析時に破棄）。旋回では外輪が速く回る。

| フェーズ | byte0-1 | byte2-3 | byte4-5 | byte6-7 | 外輪は |
|---|---|---|---|---|---|
| `lr_left`（左旋回） | 8.071 | **10.938** | 6.335 | **9.673** | 右側 |
| `lr_right`（右旋回） | **13.291** | 9.842 | **11.800** | 7.885 | 左側 |

単位 km/h、各33秒・3,304サンプルの平均。**左右の旋回で大小がきれいに反転**しており
（前軸・後軸とも）、差は2.9〜3.9 km/h と明確。

→ `lr_right`（外輪＝左）で大きい **byte0-1・byte4-5 が左**、
　 `lr_left`（外輪＝右）で大きい **byte2-3・byte6-7 が右**。

これで `0x4B0` は**全4輪が確定**した。走行データからは原理的に決まらなかった最後の1項目。

### `0x240` — エンジン状態（10 Hz）

| byte | 内容 | 式 | 実測 | 確度 |
|---|---|---|---|---|
| 0 | エンジン負荷？ | 未確定 | 値種206、OBD `0x0B`吸気管圧にR²=0.64／`0x04`負荷にR²=0.62 | 示唆 |
| 1 | **水温** | `byte - 40` [℃] | slope=0.996848, intercept=-39.6194, **R²=0.99608** | **確定** |
| 2 | 点火時期？ | 未確定 | 値種118、OBD `0x0E`点火時期にR²=0.80 | 示唆 |
| 3 | **スロットル開度** | `byte × 100 / 255` [%] | slope=0.388674（≒0.3922）, intercept=0.137, **R²=0.98241** | **確定** |
| 4 | **吸気温** | `byte - 40` [℃] | slope=0.9406, intercept=-35.77, **R²=0.97610** | **確定** |
| 5-7 | 固定 `0x00` | — | — | — |

### `0x420` — 水温（冗長経路）（10 Hz）

| byte | 内容 | 式 | 実測 | 確度 |
|---|---|---|---|---|
| 0 | **水温** | `byte - 40` [℃] | slope=0.996824, intercept=-39.6149, **R²=0.99336** | **確定** |
| 1 | 未解明 | — | 値種255（0x00〜0xFE）。OBD全20PIDに対し最良R²=0.15＝該当なし | 未解明 |
| 2 | 固定 `0x00` | — | — | — |
| 3 | 未解明 | — | 値種203（0x00〜0xD6）。最良は`0x47`絶対スロットルBのR²=0.68 | 未解明 |
| 4 | 固定 `0x00` | — | — | — |
| 5 | フラグ？ | — | 41分中**3フレームだけ**`0x40`、残りは`0x00`（bit6） | 未解明 |
| 6 | フラグ？ | — | 同上 | 未解明 |
| 7 | 固定 `0x00` | — | — | — |

> **水温は `0x240` byte1 と `0x420` byte0 の2経路で取得できる**（両者は常に同値）。
> 文献では`0x420`を「カウンタ」とする説と「温度」とする説が矛盾していたが、**温度で決着**。
> 過去に観測された「byte0が緩やかに単調増加」は、暖機による水温上昇そのものだった。

### `0x231` — クラッチスイッチ（40 Hz）

| byte | 内容 | 確度 |
|---|---|---|
| 0 | 固定 `0xFF` | — |
| 1 | **bit1（`0x02`）＝クラッチ断（ペダル踏み込み）** | **確定** |
| 1 | bit2（`0x04`）＝未解明。**単独では一度も出現せず、必ずbit1と同時**に立つ | 未解明 |
| 2-3 | 固定 `0xFF` | — |
| 4-7 | 固定 `0x00` | — |

byte1が取った値は `0x00`（69.5%）・`0x02`（27.4%）・`0x06`（3.1%）の3種のみ。

**クラッチである根拠**：「回転数÷車速（＝ギア比）の集中度」で検証した。クラッチが繋がっていれば
ギア比は各段の値に強く集中し、切れていれば分散する。20 km/h以上のサンプルで集計すると、
**bit1=0 では上位3ビンが94%**（各ギア段に集中）、**bit1=1 では60%**（分散）。
**bit1が立っている間だけエンジン回転と車輪速の結びつきが失われる。**

**bit2の性質**：`0x06` のとき平均車速16.2 km/h、1秒後の速度変化 **-2.34 km/s**、70%が減速中。
低速で強く減速している場面に集中するが、ブレーキ単独踏みでも立つはずのブレーキスイッチとは
挙動が合わない（単独出現がゼロのため）。

### `0x430` — 燃料レベル（10 Hz）

| byte | 内容 | 式 | 確度 |
|---|---|---|---|
| 0 | **燃料レベル** | `byte / 2.55` [%] | **確定** |
| 1 | byte0と逆向きに動く別表現 | — | 未解明 |
| 2-7 | 固定 `0x00` | — | — |

**根拠（給油をまたいだ実測）**：IG OFFで375秒間バスが停止した前後で、byte0の中央値が
**35（13.7%）→ 237（92.9%）**へ +202 跳ね上がった。

> **満タンでも byte0 は 237（92.9%）で頭打ち**になり255には届かない。実用上の上限は約93%。
>
> **byte1 は byte0 の補数ではない**（低燃料時 `byte0+byte1`=187、満タン時=256で和が一定でない）。
> 走行中だけ見ると和が一定に見えるが、それは燃料レベルが狭い範囲にしか無かったための見かけ。
>
> **走行中は油面がGで揺れるため値が大きくばらつく**（標準偏差は低速域で24.4、停車時7.2）。
> ECU側の平滑化前の生センサー値に近いとみられる。ロガー側で移動平均をかけること。

### `0x211` — ローリングカウンタ（100 Hz）

| byte | 値 | 内容 |
|---|---|---|
| 0-1 | 固定 `0xFF FF` | — |
| 2 | 固定 `0x80` | — |
| 3 | 固定 `0x00` | — |
| 4 | 固定 `0x40` | — |
| 5-6 | 固定 `0x00 00` | — |
| 7 | **ローリングカウンタ** | 1フレームごとに+1、255で一周 |

**用途**：受信側が取りこぼし・送信元のフリーズを検出するための連番。値そのものに意味はない。
**キャプチャ品質の検証に使える**（増分が+1以外になったらフレームを落としている）。

### `0x4FF` — ASCII文字列の分割送信（10 Hz）

先頭バイトがインデックス、残り7バイトがASCII。5種類を巡回送信する。

| ペイロード | ASCII |
|---|---|
| `30 44 49 53 41 42 00 00` | `'0'` + `DISAB` |
| `31 4C 45 56 49 4E 43 00` | `'1'` + `LEVINC` |
| `32 4F 4D 50 41 52 45 00` | `'2'` + `OMPARE` |
| `11 00 00 00 00 00 00 00` | （非ASCII） |
| `10 14 24 12 FF 00 00 00` | （非ASCII） |

インデックス順に連結すると **`DISABLE VIN COMPARE`**。

> **走行データとしての価値は無い。ロガーでは無視してよい。**
> なお本車両はエンジン・ECU載せ替え車のため、**この設定が改造に伴うものである可能性がある**
> （ノーマル車で同IDが流れるかは未検証）。固定の文字列リテラルであり車台番号ではない。

### `0x200` / `0x215` — スロットル系＋未解明フィールド（100 Hz）

| ID | byte | 内容 | 実測 | 確度 |
|---|---|---|---|---|
| `0x200` | 0-1 | 未解明 | 9,958〜10,142（値種182）。82%は前フレームと同値、変化は±1 | 未解明 |
| `0x200` | 2-3 | 未解明 | 9,957〜10,165（値種180）。同上 | 未解明 |
| `0x200` | 4-5 | 未解明 | 9,965〜10,165（値種194）。同上 | 未解明 |
| `0x200` | **6** | **ブレーキペダル**（bit0） | `0x01`＝踏み込み。停車操作差分で確定（2026-09-12） | **確定** |
| `0x200` | **7** | **アクセルペダル開度** | `%` ＝ `raw × 0.2144 + 30.68`。**`0x215` byte6 と完全に同一値** | **確定** |
| `0x215` | 0-1 | 未解明 | 500〜681（値種182）。`0x200`と同じ挙動 | 未解明 |
| `0x215` | 2-3 | 未解明 | 500〜681（値種182）。0-1と同一分布 | 未解明 |
| `0x215` | 4 | 固定 `0x02` | — | — |
| `0x215` | 5 | 未解明 | `0x15`〜`0x2C`（値種20） | 未解明 |
| `0x215` | **6** | **アクセルペダル開度** | `0x200` byte7 と同一値・同一式 | **確定** |
| `0x215` | **7** | **A/C要求**（bit6＝`0x40`） | A/C ONで`0x40`、OFFで`0x00`。3往復で確定（2026-09-12） | **確定** |

**`0x200` byte7 / `0x215` byte6 は「スロットル」ではなく「アクセルペダル」だった**（2026-09-12に決着）。

以前は比較相手によって傾きが変わり決着しなかった。原因は刺激不足ではなく、
**走行中はペダルとバルブが一体で動くため経路を区別できなかったこと**にある
（OBD基準値どうしの相関は `0x11`と`0x49` で0.975）。

**エンジンを切りIG ONのままペダルだけを全域掃引**することで決着した。この状態では
`rpm=0`・`load=0`・`maf=0` となり、エンジン由来の交絡が消える。ペダル側基準（`0x49`）と
バルブ側基準（`0x11`）の両方で回帰し、**R²の大小関係で経路を判定**した。

| CANバイト | vs `0x49`（ペダル） | vs `0x11`（バルブ） | 判定 |
|---|---|---|---|
| `0x240` byte3 | 0.9598 | **0.9990** | **スロットルバルブ開度** |
| `0x200` byte7 | **0.9895** | 0.9856 | **アクセルペダル開度** |
| `0x215` byte6 | **0.9895** | 0.9856 | **アクセルペダル開度** |
| `0x201` byte6 | **0.9894** | 0.9857 | ペダル系（`0x200`とほぼ同一の傾き） |

**確定式**

- アクセルペダル開度［%］＝ `0x200` byte7 × **0.2144** ＋ **30.68**
- スロットルバルブ開度［%］＝ `0x240` byte3 × **0.3938** − **0.342**

> **⚠️ この車両はメカフィーリングスロットルマップでペダル開度とスロットル開度が意図的に
> ズラしてある。** 全域スイープ（`ncec_sweep`）で同定した結果は下記。
> 導出は `ncec_throttle_map.py`、経緯は `OBD2_SURVEY.md` の訂正節。
>
> | 項目 | 値 |
> |---|---|
> | ペダル `0x49` の実効レンジ | **31.37 〜 78.04 %** |
> | 実スロットル `0x11` の実効レンジ | **20.00 〜 89.80 %** |
> | 正規化後の伝達特性 | **`throttle = 1.3541 × pedal − 0.55`**（R² = 0.99912） |
> | 全開到達 | **ペダル 74.3 %**。以降は頭打ち |
> | ヒステリシス | 1.5 pt 以下（無視可） |
>
> **カーブではなく「ゲイン約1.35倍の直線＋上側の頭打ち」。** 全域で一律に鋭い。
> **ただしエンジン停止・IG ON での測定**であり、回転数・負荷依存は未確認。
> 2026-11-06（Ver.2の`Throttle`＝`0x240` byte3）：IG ONで足を離すと20%・踏み切って約90%（上の表と同じ）。
> **エンジンをかけたアイドリング（857rpm、水温77℃）では11.8%**（raw 30）で、IG ONの20%より閉じている。
> 20%はエンジン停止中の弁の待機位置で、全閉の目安はアイドリングの約12%と見る。
> | 65% | 87.5% | 96.7% |
> | 70%以上 | **89.8%（飽和）** | **100%（飽和）** |
>
> **ゲイン約1.93倍**（ペダル35ポイントに対しスロットル67.5ポイント）。
> `0x49` の実ストロークは31.4〜78.0%なので、**ペダルストロークの約8割で全開に達する**。
> 詳細は `OBD2_SURVEY.md`「NCEC 追補2」。**エンジン停止時の実測**であり、走行時も
> 同じ曲線かは未検証。

### `0x4EC` — 未解明（40 Hz）

| byte | 内容 |
|---|---|
| 0-3 | 固定 `0x00` |
| 4-5 | 4,047〜9,500（値種906）。OBD全20PIDに対し最良R²=0.60＝該当なし |
| 6-7 | 3,150〜30,125（値種16,992）。値の散らばりが大きく**CRC／チェックサム疑い** |

### `0x21A` / `0x212` — 常時固定（未解明）／ `0x39A` — パーキングブレーキ

| ID | 周期 | 41分間の走行での値 | 停車操作差分（2026-09-12）の結果 |
|---|---|---|---|
| `0x21A` | 50 Hz | 全8バイトが `0x00` | **12種すべての操作で不変**。依然として未解明 |
| `0x39A` | 10 Hz | 全8バイトが `0x00` | **byte0 bit3＝パーキングブレーキと確定** |
| `0x212` | 10 Hz | `80 00 20 40 00 00 00 00` で固定 | **12種すべての操作で不変**。依然として未解明 |

`0x39A` が走行中ずっとゼロだったのは、**走行中はサイドブレーキを下ろしているため**だった。
停車してサイドを引いた状態では byte0 が `0x08` になり、下ろすと `0x00` に落ちる。

**一方、ウィンカー左右・ハザード・ドア開・シートベルト・ヘッドライト・ワイパーは、
12種の操作差分で1ビットも動かなかった。** これらはOBD2ポートに来ているこのバス
（パワートレイン系CAN）には流れておらず、**別バス（ボディCAN）にあるとみられる。
この配線では原理的に取得できない。**
`0x212` は文献でABS/DSC off/トラクションコントロール/ブレーキ警告関連とされ、
上記の値が「異常なし」時のデフォルトとみられる（未確定）。

### `0x4F0` / `0x4F1` — 未解明（1 Hz）

| ID | 41分間の値 |
|---|---|
| `0x4F0` | `14 40 12 30 01 00 00 00` で固定 |
| `0x4F1` | `81 01 9A FF FF 00 59 59` で固定 |

**コミュニティ資料に記載が無いID。** 本車両が後期型エンジン＋チューンドECUであることに
由来する可能性がある（未確認）。

### 本車両で観測されなかったID

| CAN ID | 内容 | 理由 |
|---|---|---|
| `0x081` | ステアリング舵角 | **DSC搭載車（2007年以降）限定**。本車両はDSC非搭載 |
| `0x085` | ブレーキ圧 | 同上 |
| `0x090` | 加速度 | 同上 |

---

## 4. 実装向けサマリ（デコーダに入れてよい確定項目のみ）

| 物理量 | CAN ID | offset | 幅 | 式 | 周期 |
|---|---|---|---|---|---|
| エンジン回転数 [rpm] | `0x201` | 0 | 2 (BE) | `raw / 4` | 100 Hz |
| 車速 [km/h] | `0x201` | 4 | 2 (BE) | `raw / 100 - 100` | 100 Hz |
| ホイールスピード **左前** [km/h] | `0x4B0` | 0 | 2 (BE) | `raw / 100 - 100` | 100 Hz |
| ホイールスピード **右前** [km/h] | `0x4B0` | 2 | 2 (BE) | `raw / 100 - 100` | 100 Hz |
| ホイールスピード **左後** [km/h] | `0x4B0` | 4 | 2 (BE) | `raw / 100 - 100` | 100 Hz |
| ホイールスピード **右後** [km/h] | `0x4B0` | 6 | 2 (BE) | `raw / 100 - 100` | 100 Hz |
| 水温 [℃] | `0x240` | 1 | 1 | `raw - 40` | 10 Hz |
| 水温（冗長）[℃] | `0x420` | 0 | 1 | `raw - 40` | 10 Hz |
| スロットル開度 [%] | `0x240` | 3 | 1 | `raw × 0.3938 - 0.342`（≒`raw × 100/255`） | 10 Hz |
| 吸気温 [℃] | `0x240` | 4 | 1 | `raw - 40` | 10 Hz |
| 燃料レベル [%] | `0x430` | 0 | 1 | `raw / 2.55`（要平滑化） | 10 Hz |
| クラッチ断 | `0x231` | 1 | bit1 | `1`＝踏み込み | 40 Hz |
| **アクセルペダル開度 [%]** | `0x200` | 7 | 1 | `raw × 0.2144 + 30.68` | 100 Hz |
| **アクセルペダル開度（冗長）[%]** | `0x215` | 6 | 1 | 同上（`0x200` byte7 と同一値） | 100 Hz |
| **ブレーキペダル** | `0x200` | 6 | bit0 | `1`＝踏み込み | 100 Hz |
| **パーキングブレーキ** | `0x39A` | 0 | bit3 | `1`＝引いている | 10 Hz |
| **A/C要求** | `0x215` | 7 | bit6 | `1`＝A/C ON | 100 Hz |

**取得できないもの（実測で確認済み）**：**油温・油圧**。生CANにも標準OBD2 PIDにも存在しない。
追加センサーが必要。

---

## 5. OBD2（診断）仕様

| 項目 | 内容 |
|---|---|
| 要求ID | **`0x7E0`（物理アドレス）でそのまま応答する。`0x7DF`フォールバックは不要** |
| 応答ID | **`0x7E8` 単独**（レクサスUXのような複数ECU分担は無い） |
| 要求フォーマット | `02 01 <PID> 55 55 55 55 55`（パディング`0x55`で受理される） |
| 実測品質 | 55分で sent=165,543／resp=165,490／**timeout=53（0.032%）** |
| 実効レート | 20PIDを巡回して**1PIDあたり8.6 Hz**（`0C`/`0D`/`11`/`49`） |
| バス負荷 | 要求＋応答で**約107 frame/s** |

### 応答が確認できた mode 01 PID（20項目）

`04` 負荷 ／ `05` 水温 ／ `0B` 吸気管圧 ／ `0C` 回転数 ／ `0D` 車速 ／ `0E` 点火時期 ／
`0F` 吸気温 ／ `10` MAF ／ `11` スロットル ／ `1F` 始動後経過時間 ／ `33` 大気圧 ／
`34` O2広域AFR ／ `42` バッテリー電圧 ／ `43` 絶対負荷 ／ `44` 燃空比指令 ／
`45` 相対スロットル ／ `47` 絶対スロットルB ／ `49` アクセルペダルD ／
`4A` アクセルペダルE ／ `4C` 指令スロットル

**非対応**：**`5C`（エンジン油温）**。※レクサスUX（2022年式）では対応していたので車両差。

### 実測レンジ（55分）

車速 0〜110 km/h ／ 回転数 249〜3,439 rpm ／ 水温 77〜85℃ ／ 吸気温 22〜40℃ ／
バッテリー電圧 12.83〜13.93 V ／ 点火時期 -13.5〜48° ／ MAF 2.5〜39.5 g/s

> **`0x49` アクセルペダルDは、足を離した状態でも31.4%を下回らない**（ゼロ点にオフセットがある）。
> 走行41分で使われた範囲は 31.5〜40.0% の8.5ポイント分のみ。
> **2026-09-12のエンジン停止スイープで 31.4〜78.0%（46.6ポイント）まで拡張済み**。
> 床まで踏んでも78.0%で頭打ちになるため、`0x49` の実ストロークは 31.4〜78.0% と考えてよい。

---

### mode 22（ReadDataByIdentifier）— ECU内部変数（2026-09-12に到達）

**このECUは mode 22 に対応している。DID は mode 01 のPID番号そのもの**（`0x00xx`）。
`0xF4xx`（ISO 15031-5のミラー領域）は `7F 22 31`（requestOutOfRange）で拒否される。

| 項目 | 内容 |
|---|---|
| 要求フォーマット | `03 22 <DID_H> <DID_L> 55 55 55 55` |
| 肯定応答 | `62 <DID_H> <DID_L> <値…>` |
| 否定応答 | `7F 22 31`（DIDが存在しない） |
| 走査済み範囲 | `0x0000`-`0x0FFF`（4,096個）。**未走査：`0x1000`-`0xFFFF`** |
| 肯定応答したDID | **51個**（うち `0x0000`-`0x004C` は mode 01 PIDのミラー） |

**標準PIDに無い内部変数（`0x09xx`系）**

| DID | 内容 | 確度 |
|---|---|---|
| `0x096E` | **回転数**（`0x000C`とほぼ同値） | 確定 |
| `0x0967` | **A/C連動の離散フラグ**（bit2＝`0x0004`）。ON時4／OFF時0の2値 | 確定（ただし「ファン」か「A/C要求」かは未確定） |
| `0x0900`・`0x0914`・`0x0915`・`0x0917`・`0x0918`・`0x091A`・`0x097C` | 連続量。**回転数の交絡を受ける**ため単独では判定不可 | 未解明 |
| `0x093C`・`0x0968`・`0x098E`・`0x0200`・`0x0202` | 停車・A/C OFF時はゼロ | 未解明 |

> **⚠️ 運用上の注意**：mode 22 のポーリングはバス負荷とECU負荷を増やす。実用時は必要なDIDだけに絞る。
> **未知DIDの総当たりは停車時のみ**とし、走行中は行わない。
> 使うのは読み出し専用サービス（`0x22`）だけで、**書き込み系サービスは一切叩かないこと**。

ファーム`can_obd_logger`のランタイムキー：`d`＝DIDプローブ／`s`＝DIDスキャン／`w`＝DIDウォッチ。
`can_capture_logger.py`のフェーズアクション `probe`／`scan`／`watch` から送れる。

---

## 6. 未解明項目の一覧

| # | 対象 | 現状 | 解くために必要なこと |
|---|---|---|---|
| ~~1~~ | ~~`0x4B0` の左右~~ | **解決（2026-09-12）**：`[左前, 右前, 左後, 右後]` と確定 | — |
| ~~2~~ | ~~`0x200` byte7 ／ `0x215` byte6 の式~~ | **解決（2026-09-12）**：アクセルペダル開度＝`raw×0.2144+30.68` | — |
| 3 | `0x240` byte0（負荷?）・byte2（点火時期?） | **エンジン停止スイープでは固定値**（byte0=`0x00`／byte2=`0x94`）。`load=0`・`timing=10°固定`と整合し仮説は補強されたが未確定 | **エンジンをかけた状態**でのゆっくりスイープ（B-2） |
| ~~3b~~ | ~~`0x201` byte6~~ | **解決（2026-09-12）**：ペダル系（`0x200` byte7とほぼ同一） | — |
| 4 | `0x21A`・`0x212` | **停車12種の操作でも完全に不変**（2026-09-12） | このバスには無い可能性が高い。別バス（ボディCAN）の探索が必要 |
| ~~4b~~ | ~~`0x39A`~~ | **解決（2026-09-12）**：byte0 bit3＝パーキングブレーキ | — |
| 5 | `0x231` byte1 bit2 | **停車ニュートラルで単独ONを確認**（2026-09-12）。「駆動力遮断」フラグと解釈すると走行データとも整合 | クラッチに一切触れずブレーキのみを踏む区間を取り、bit1との独立性を確定させる |
| 6 | `0x420` byte1/byte3/byte5/byte6 ／ mode22 `0x0967` が「ファン」か「A/C要求」か | A/C ON/OFF 3往復では**WEAKどまり**（2026-09-12）。A/C要求自体は`0x215` byte7で確定したが、**電動ファン駆動のビットは未確定** | エアコンOFFで水温を上げ、**ファンが回り出す瞬間**を捉える |
| 7 | `0x4EC` byte4-5 | OBDの20PIDに該当なし | 外部基準（社外メーター等）との突合 |
| 8 | `0x200`/`0x215` の16bitフィールド群 | 10,050付近／590付近で微小変動 | 未着手 |
| 9 | `0x4F0`／`0x4F1` | 固定値 | ノーマル車との比較 |
| 10 | `0x201` の高回転域 | 実測は3,439 rpmまで | 8,000 rpmまで回した走行 |

---

## 7. 参考

- コミュニティ資料：[timurrrr/RaceChronoDiyBleDevice `can_db/mazda_mx5_nc.md`](https://github.com/timurrrr/RaceChronoDiyBleDevice/blob/master/can_db/mazda_mx5_nc.md)（`081`/`085`/`090`/`200`/`201`/`215`/`231`/`240`/`4B0` の9IDを収録）
- [Mazda CAN Bus – Madox.NET](http://www.madox.net/blog/projects/mazda-can-bus/)
- 本プロジェクト内：測定手順は`ncec_field_procedure.md`、解析の詳細と経緯は`OBD2_SURVEY.md`「NCEC 追補」、
  車両横断の対照は`vehicle_can_survey_summary.md`
