ntakao2006-web/RaceCapture/LOGGER_V2_UNOQ_REPORT.md

# Ver.2ロガー（Arduino UNO Q）：GNSS選定とセンサーフュージョン構想レポート

> 回路設計担当への共有用レポート。Ver.2ロガー（Arduino UNO Q + シールド構成）に向けた
> ①GNSSモジュール選定の結論と根拠、②GNSS+IMUセンサーフュージョンという新しい構想、
> ③その構想が成立するために回路側へお願いしたい配線、④UNO Q実機で確認してほしい事項、
> の4点をまとめている。
>
> Ver.1の構成・経緯は`ARCHITECTURE.md`、ダッシュカム側（ROCK 5B）の経緯は
> `DASHCAM_ROCK5B_REPORT.md`および`DASHCAM_ROCK5B_SOFTWARE_HURDLES.md`を参照。

作成日：2026-09-06

---

## 0. このレポートの要点（先に結論）

1. **GNSSは`u-blox NEO-M9N-00B`を推奨**。候補として挙げてもらったQuectel LC79H・
   現行のMAX-M10Mと比較した結果、「20Hz以上 × 4衛星系同時受信」という要求を
   満たすのはNEO-M9Nだけだった（価格は約$14.69でLC79Hとほぼ同額）。
   → 🔴 **2026-09-21 再訂正：NEO-M9Nは入手困難のため、当面はVer.1と同じ
   `MAX-M10M-00B`を継続使用する**（7.3章）。**この結果、5.2章のGNSS変更対応
   （フットプリント変更等）はすべて不要になり、Ver.2のGNSS部はVer.1のまま据え置きでよい。**
2. **新たに判明した問題：BNO055単体では、コーナリング中のロール角・ピッチ角、および
   前後G/横Gが構造的に誤る**（加速度センサーは重力と遠心加速度を原理的に区別できないため）。
   これは較正の問題ではなく、Bosch自身が認めているNDOFフュージョンの限界。詳細は2.5章。
3. **その解法は3通りあり、どれを選んでも回路側への依頼内容は同じ**（2.5章）。
   必要なのは**2本の追加配線だけ**（GNSSのPPS信号、BNO055の割り込み信号。詳細は5章）。
   アルゴリズムの選択は後処理で決められるため、いま決める必要はない。
   → 🔴 **2026-09-21追記：C方式（ESKF）を本命とすることに決定した**（7.1章）。
   **配線2本という依頼内容は変わらない**が、確定した前提として扱ってほしい。
4. **UNO Q実機で確認してほしいことがある**（6章）。これが通らない場合、
   UNO Qという選択自体を再検討する必要があるため、最優先で確認したい。

---

## 1. GNSS選定：3候補の比較と結論

> 🔴 **2026-09-21 再訂正：本章の結論（NEO-M9N推奨）は保留となった。**
> **NEO-M9Nが入手困難なため、当面はVer.1と同じMAX-M10M-00Bを継続使用する**（7.3章）。
> **比較そのものは有効**なので、将来入手性が回復した場合の判断材料として残す。
> 以下の1.4章・1.5章（NEO-M9Nの利点と弱点）も、その前提で読んでほしい。

候補として挙げてもらった2つ（Quectel LC79H、u-blox NEO-M9N）を、現行のMAX-M10Mと
並べて比較した。判断軸は「サンプリングレート20Hz以上」「4衛星系（GPS/GLONASS/
Galileo/BeiDou）の同時受信」という要求仕様。

| 項目 | MAX-M10M-00B（Ver.1現行） | Quectel LC79H (AL) | **NEO-M9N-00B（推奨）** |
|---|---|---|---|
| **4系統同時での更新レート** | 10 Hz | 10 Hz | **25 Hz** |
| 単一GNSSでの更新レート | 25 Hz（要OTP書き込み） | 10 Hz | 25 Hz |
| 受信バンド | L1 | **L1 + L5** | L1のみ |
| 消費電力（4系統・連続追尾） | **41 mW** | 59.4 mW | 108 mW（36mA@3.0V） |
| 電源電圧 | 1.8V / 3.0V | **1.75〜1.98Vのみ** | 2.7〜3.0〜3.6V |
| 追尾感度 | 約 -165 dBm | -166 dBm | **-167 dBm** |
| 水平精度(CEP) | 約 1.5 m | **1.0 m** | 2.0 m |
| プロトコル | UBX | NMEA + PQTM独自 | UBX |
| 外形 | 10.1×9.7 mm | 10.1×9.7 mm | 12.2×16.0 mm |
| 単価 | ¥1,480（秋月） | 約¥2,400 | 約¥2,200（$14.69） |

### 1.1 Quectel LC79Hを見送る理由

技術的には良いモジュールで、**L1+L5デュアルバンドを¥2,400で買えるのはu-bloxには無い
価格性能**（u-blox最安のL1+L5はNEO-F10Nで、それより安い）。L5は変調レートがL1の10倍
あるため、建物やガードレールの反射波を切り分ける能力が高く、マルチパス耐性に優れる。

ただし**データシートのPVT Update Rateが「GNSS: 1〜10 Hz」**（RTK版のELは1/2/5 Hz）で、
20Hz以上という要求を設定変更では満たせない。加えて、

- 電源が1.75〜1.98V専用でI/OもVCC追従 → UNO Q（3.3V系）と繋ぐには1.8V LDOと
  レベルシフタが必要
- プロトコルがNMEA+Quectel独自のPQTM系 → Ver.1で作ったUBXベースの実装が使えない
- L5を活かすにはL1/L5両対応アンテナが必須。L1専用アンテナだと利点が消える

以上3つの代償が同時に発生するため、今回は見送りたい。

### 1.2 「なぜ第9世代（古い方）なのか」

u-blox型番は「接頭辞＝パッケージ形状」「英字＝系統（M:標準精度L1 / F:高精度マルチバンド）」
「数字＝世代」の組み合わせ。念のため他の世代・系統も全部確認した。

| 世代 | 単一GNSS | 同時受信時 |
|---|---|---|
| M7（NEO-7） | 10 Hz | 同時受信不可（GPSかGLONASSの切替） |
| M8（NEO-M8N） | 18 Hz | 10 Hz |
| **M9（NEO-M9N）** | **25 Hz** | **25 Hz（構成による低下なし）** |
| M10（MAX-M10N） | 25 Hz | 2系統20Hz / **3系統以上10Hz** |
| F10（NEO-F10N） | – | 10 Hz |
| F11（2026年最新） | 25 Hz | **3系統以上10Hz** |

**M9だけが例外的に「4系統同時×25Hz」を出せる。** M9（2019年）を境にu-bloxは
マスマーケット向けを全部「超低消費電力」に振っており、M10もF10もF11もその延長線上に
ある（F11はLEAPモードで7mWを謳う）。**新しい世代を探すほど要求から遠ざかる**構造。

なお「F8」は存在しない。F系は2018年のF9から始まった別ラインで、英字は世代ではなく
系統を表すため。

### 1.3 予算を上げた場合の選択肢（参考）

| 型番 | 内容 | 単価 |
|---|---|---|
| Unicore UM980 | L1/L2/L5三帯・全系統・RTK・**50 Hz** | $130〜150 |
| u-blox ZED-F9P | L1/L2・RTK・25 Hz | $124〜127 |
| u-blox ZED-F9R | 上記＋**IMU内蔵センサフュージョンで30 Hz出力** | $200前後 |

用途だけで言えばZED-F9Rが「本来の正解」だが、価格が約15倍・消費電力も一桁違う。
**後述するセンサーフュージョンは、このZED-F9Rがやっていることを
NEO-M9N（¥2,200）＋BNO055＋UNO Qの計算資源で近似する試み**にあたる。

### 1.4 NEO-M9Nの実務上の利点（Ver.1からの改善点）

- **不可逆OTP書き込みが不要になる**。現行MAX-M10Mで25Hzを出すには高性能クロックOTPの
  焼き込みが必要だった（2026-08-31に1回実施済み）。M9Nは25Hzが標準スペックなので
  この工程が消える。**基板を複数枚作る場合、1枚ごとにOTPを焼く必要がなくなるのは大きい**
- **25Hzを保ったまま可視衛星数が増える**。現行は25Hzを取るためGPS+QZSSの単一系統に
  絞っている（可視10〜12機程度）。M9Nなら25HzのままGPS+GLONASS+Galileo+BeiDou+QZSS+SBAS
  で開空25〜30機規模になる
  - ⚠️ **2026-09-21訂正：この「現行は単一系統」という記述は、本レポート作成時点で既に古かった。**
    高性能クロックOTP書き込み後のMAX-M10Mは**衛星系統と更新レートのトレードオフを選べる**
    （`firmware/logger_v1/GNSS_BALANCE.md`）。実機の暫定設定は**4系統10 Hz（`four_10`）**で、
    3系統約15 Hz・2系統20 Hz・単一25 Hzも候補として定義済み。**どの組み合わせが最適かの
    実測比較は中断したまま未決着**である（7.3章で再浮上させた）
- **UBXプロトコルなのでVer.1のファームウェア資産がそのまま使える**
- **VCC 2.7〜3.6V（typ 3.0V）でUNO Qの3.3V系に直結できる**

### 1.5 NEO-M9Nの弱点（正直に）

- **消費電力が現行の約2.6倍**（41mW → 108mW）。しかもこの108mWはデータシート脚注で
  「1Hz時の測定値」とされているので、25Hz運用ではさらに増える。M9は2019年世代で、
  低消費電力に振ったのは次のM10世代のため、ここは世代差がそのまま出ている。
  ただしUNO Qが1.5〜4.5Wのボードなので、67mWの増分はシステム全体の数%に埋もれる想定
- **L5非対応**。LC79Hの利点は得られない。代わりに「衛星数を増やす」方向でマルチパスに
  対抗する
- 外形が12.2×16.0mm（MAX形状の約2倍の面積）。**フットプリント変更が必要**

---

## 2. 新構想：GNSS + IMU センサーフュージョン

### 2.1 なぜこれをやりたいか

GNSSは「25Hzで出力」していても、**25個の独立した測位をしているわけではない**。

受信機の内部では、擬似距離（＝位置の素）が帯域0.5〜2HzのDLL（Delay Lock Loop）を
通っている。帯域1Hzのフィルタ出力は1秒スケールでしか変化できないため、40ms後の値は
95%以上が同じもの。加えて電離層・対流圏遅延は数分間ほぼ一定のバイアスとして乗る。

つまり**位置の実質的な情報レートは1〜2Hz程度**しかない。
（速度はドップラ＝帯域10〜18HzのPLL由来なので、10〜18Hz分の実体がある）

一方でIMUは、低周波でドリフトするが高周波は実測できる。**両者は周波数帯で綺麗に
相補的**なので、カルマンフィルタでクロスオーバーさせると全帯域が埋まる。

| 周波数帯 | 情報源 |
|---|---|
| 0〜1 Hz（絶対位置） | GNSSのみ（IMUは無力） |
| 1〜10 Hz | GNSS速度 + IMU |
| 10〜50 Hz | **IMUのみ**（GNSSには情報が無い） |

### 2.2 得られるもの・得られないもの（過度な期待を避けるため明記）

**得られる**

1. 100Hz出力が「補間」ではなく実測に基づく推定になる
2. レイテンシ低減（GNSSは解が出るまで数十〜100msの遅延がある。IMUは即時）
3. **ロール角・ピッチ角が取れる**。GNSS単体では車両姿勢は原理的に分からない
   （進行方向しか出ない）。バンク角・ブレーキング時のピッチングはここで初めて手に入る
4. トンネル・橋の下など数秒のGNSS途絶に耐える
5. **マルチパスによる位置の飛びを物理的に棄却できる**（「その移動には2Gの横加速度が
   必要だが、IMUは0.3Gしか観測していない → この解は棄却」という判定ができる）

**得られない**

- **絶対位置精度の改善**。2.0m CEPは2.0mのまま。長時間ではGNSSに収束する
- 100Hzの独立した絶対位置（存在しない情報は作れない）

市販ロガー（VBOX等）が謳う「100Hz」も同じ仕組み。GNSSが100Hzで測位しているのではなく、
GNSS+IMUの融合出力を100Hzで出している。

### 2.3 実装方式と計算負荷

**疎結合ESKF（誤差状態カルマンフィルタ）／状態量15次元**
（位置誤差3・速度誤差3・姿勢誤差3・加速度計バイアス3・ジャイロバイアス3）

```
100 Hz（IMUごと）: ストラップダウン積分で伝搬、P = F·P·Fᵀ + Q
 25 Hz（GNSSごと）: z = [GNSS位置−予測 ; GNSS速度−予測]（6次元）で更新
```

計算量を実数で見積もると：

| 処理 | 演算量 | レート | 負荷 |
|---|---|---|---|
| 伝搬（15×15行列積×2） | 約15,000 flop | 100 Hz | 1.5 MFLOP/s |
| 更新 | 約10,000 flop | 25 Hz | 0.25 MFLOP/s |
| **合計** | | | **約2 MFLOP/s** |

- Cortex-A53 @2.0GHz（UNO QのLinux側）：スカラ倍精度でも500 MFLOP/s以上 → **1コアの0.4%**
- **Cortex-M33 @160MHz（STM32U585）：単精度FPU付きで約160 MFLOP/s → 約1%**

**つまりMCU側でも十分に回る。** そして後述の通り、MCU側で回すべき理由がある。

### 2.4 提案する処理の分担

```
┌─ STM32U585（MCU / ハードリアルタイム）──────────────┐
│  GNSS UART受信 / PPS割り込み / IMU / CAN            │
│  µs精度のタイムスタンプ付与                           │
│  ESKFフュージョン（負荷 約1%）                        │
│  → 融合済みPVTを100 HzでLinux側へ                   │
└────────────────────────────────────────────────┘
                      ↓ ブリッジ
┌─ QRB2210（Linux / ベストエフォート）─────────────────┐
│  ダッシュGUI描画（Adreno 702）                        │
│  映像キャプチャ・ハードウェアエンコード・保存           │
│  センサーキャリブレーションGUI / ネットワーク           │
└────────────────────────────────────────────────┘
```

MCU側で回す理由は計算量ではなく**時刻同期**。100km/h = 27.8m/sなので、
**タイムスタンプが10msずれると0.28mの位置誤差**になる。Linuxのシステムクロックで
打刻するとスケジューリング遅延で数ms〜数十ms揺れるため、MCUのハードウェアタイマで
打刻する必要がある。

### 2.5 【重要】車両姿勢の問題と、3つの解法

この節が本レポートで最も重要。**Ver.1の現状（GNSSとIMUを別々に記録）には、
構造的な誤りが含まれている**ことが分かったため。

#### 問題：加速度センサーは重力を測れない

加速度センサーが測るのは **specific force（比力）= 加速度 − 重力** であり、重力そのもの
ではない。両者を区別する情報は加速度センサーの中に原理的に存在しない。

静止時は「下向き1G＝重力」と決めつけられる。BNO055の内蔵フュージョン（BSX3.0）も
この仮定で動作している。**しかしコーナリング中はこの仮定が崩れる。**

```
        ↑ BNO055が「下」だと判断する方向（合成ベクトル）
         ＼
真の重力  │  ＼      横G 1.0G →
   1.0G   ↓    ＼
                 ＼  合成ベクトルは真下から45°傾く
```

横1.0Gのコーナーでは合成ベクトルが真下から45°傾き、BNO055は**車が傾いていると誤認する
方向へ引っ張られる**。ジャイロが抵抗するため即座に45°にはならないが、ロングコーナーや
高速スイーパーでは10〜30°規模の誤差になり得る。

**ロードスターの実際の車体ロールは3〜6°程度**なので、**誤差が信号より大きい**。

さらに、BNO055が出力する `linear acceleration`（重力除去済み加速度）も、誤った重力
ベクトルを引き算しているため同様に汚染される。**前後G・横Gの値そのものが影響を受ける。**

これは較正不良ではなく、Boschのデータシートにも記載のあるNDOFフュージョンの原理的限界
（「高速コーナリング中や長い制動中、デバイスはその大きな加速度を重力ベクトルと誤認する
ことがある」）。

#### 解法は3通りある

| | **A: GNSS微分方式** | **B: 固定較正方式** | **C: GNSS/IMU融合(ESKF)** |
|---|---|---|---|
| 横G・前後Gの算出 | GNSS速度から<br>`横G = v×方位変化率`<br>`前後G = dv/dt` | 生の比力を、較正で求めた<br>固定回転行列で車両座標へ変換 | ESKFで姿勢を推定し変換 |
| 横G・前後Gの精度 | ○ | **◎** | ◎ |
| 帯域 | 〜10 Hz | **〜30 Hz** | 〜30 Hz |
| **ロール角・ピッチ角** | ✗ 取得不可 | ✗ 取得不可 | **◎ 取得可能** |
| バンク・カント路面 | ○（真の水平加速度） | ✗ 重力が漏れ込む | ◎ |
| 較正の必要 | 不要 | **必要（GUI）** | 必要 |
| 実装コスト | 小 | 小 | 大 |
| 採用例 | **RaceChrono** | Harry's LapTimer等 | VBOX 3i、ZED-F9R |

**A方式**：スマホアプリのRaceChronoが採用している方式。開発者が公式フォーラムで
「Longitudinal/Lateral accelerationチャンネルはGPSデータから計算しており、"real"な
加速度センサー値ではない」と明言している。GNSS速度は地球固定座標系の量なので**重力が
最初から入らない**。較正不要でバイクにも使える代わりに、帯域がGNSS速度に制限され、
微分によりノイズが増幅する。

**B方式**：①静止状態で水平を取り重力方向を確定 → ②直線加速でGNSS進行方向と突き合わせ
前後軸を確定 → ③センサー座標系から車両座標系への回転行列を固定。以降フィルタが介在
しないので**コーナリング中も誤らない**。BNO055の問題は「毎瞬間どちらが下かを推定し
続けている」ことに起因するため、**推定をやめて固定すれば問題自体が消える**。
ただし「車は常に路面と平行」という仮定を置くので、車体ロール5°で `sin(5°)×1G = 0.087G`
（1Gに対し約9%）の誤差が乗り、バンク10°では `sin(10°)×1G = 0.17G` の偽の横Gが出る。

**C方式**：GNSS速度が「今どれだけ加速しているか」を外部から供給するため、比力から
加速度を引いて真の重力方向が求まる。学術的にはvelocity-aided attitude（速度支援姿勢推定）
として確立しており、「位置と速度の支援データがあればロール・ピッチ誤差はIMUのダイナミクス
に関わらず速やかに収束する」ことが知られている。**ロール角・ピッチ角を実際に測れるのは
この方式だけ。**

#### 回路設計上の結論

**A・B・Cの3方式は、すべて同じ生ログから後処理で選択・比較できる。**

必要なのは以下2つを**共通の正確な時刻基準で記録すること**のみ。

- GNSSの位置・速度（NEO-M9NからUBXで取得）
- IMUの**生の**加速度・角速度（BNO055をAMGモードで取得。融合済み値ではない）

> **したがって、どの方式を選んでも回路側への依頼内容は変わらない（5.1章の配線2本のみ）。
> アルゴリズムの選択は実走データを見てから決められるので、いま決定する必要はない。**

なお**B方式に必要な較正手順（静止水平取り＋直線加速）は、UNO Q側で作りたいと考えている
「センサーキャリブレーションGUI」の仕様そのもの**になる。GUIの目的がこれで明確になった。

---

## 3. IMU（BNO055）についての確認事項

Ver.1でBNO055に確定済みだが、フュージョンをやる場合に効いてくる性質が2つある。
**型番変更を提案するものではなく、ファームウェア側の方針に関わる情報共有**。

1. **BNO055は内部で既にセンサーフュージョンを済ませているセンサー**
   （Bosch BSX3.0が内蔵MCU上で動作）。ESKFに入力したいのは生の加速度・角速度なので、
   このままだとフュージョンが二重にかかる。**AMGモード（非融合モード）で生値を取る**
   運用が必要になる見込み。その場合、BNO055を選んだ理由だった「磁力計統合による
   絶対方位」は自前で処理することになる
2. **融合モード中は加速度計のLPF等の設定自由度が制限される**。これは
   `ARCHITECTURE.md`に残っている「エイリアシング対策」の宿題と直接ぶつかる

3. **上記2.5章の通り、内蔵フュージョンの姿勢出力はコーナリング中に誤る。**
   A/B/Cどの方式を採る場合でも、**BNO055からは生値（AMGモード, `OPR_MODE = 0x07`）を
   取得して記録する**のが前提になる

**エイリアシングについて（実測に基づく要対応事項）**

BNO055の出力は100Hzが上限なので、表現できるのは50Hzまで（ナイキスト）。しかし路面からの
振動は数百Hzまで実在するため、アンチエイリアス対策が要る。データシートのレジスタを
確認したところ、**デフォルト設定のままだと折り返しが起きる**ことが判明した。

| レジスタ | 選択肢 | デフォルト | 推奨 |
|---|---|---|---|
| `ACC_CONFIG` (0x08) 加速度計帯域 | 7.81 / 15.63 / 31.25 / **62.5** / 125 Hz | **62.5 Hz** | **31.25 Hz** |
| `GYR_CONFIG_0` (0x0A) ジャイロ帯域 | 12 / 23 / 32 / 47 / 64 / 116 / 230 / 523 Hz | – | **32 Hz** |

**加速度計のデフォルト62.5Hzは、100Hzサンプリングのナイキスト（50Hz）を超えている。**
このまま使うと62.5Hz付近の成分が `100 − 62.5 = 37.5Hz` の偽信号として折り返して混入し、
**後段では本物の37.5Hz信号と区別がつかないため絶対に除去できない**。
サスペンションのバネ下共振（10〜15Hz）や接地荷重変動（10〜20Hz）を見たい帯域に
直接かぶるため、実害がある。

上記の推奨値に設定した場合の**実効帯域は約30Hz**。車両運動（ステアリング入力0〜5Hz、
車体のロール・ピッチ0.5〜3Hz、バネ下共振10〜15Hz、接地荷重変動10〜20Hz）は
すべて20Hz以下に収まるため、30Hzあれば十分カバーできる。

なお**融合モード中はこの帯域設定ができない**ため、AMGモードで使う理由がここでも1つ増える。

電気的なLPF（上記レジスタ設定）と機械的な防振の役割分担は、筐体設計
（`case_shock_design.md`）と合わせて詰める必要がある。

---

## 4. 参考：UNO QとROCK 5Bの比較

Ver.2で「ROCK 5B相当のことを、より少ない消費電力で」を狙う場合の現実的な見積もり。

| | ROCK 5B（現行ダッシュカム） | **UNO Q** | 参考: rc-dash-4B |
|---|---|---|---|
| CPU | RK3588: 4×A76@2.4G + 4×A55@1.8G | **4×A53 @2.0GHz** | 4×A72@1.5GHz |
| GPU | Mali-G610 | Adreno 702 @845MHz | VideoCore VI |
| ハードエンコード | 8K | **1080p30 H.264/H.265** | 1080p |
| 同時処理上限 | 余裕大 | **1080p30デコード + 720p30エンコード** | – |
| 消費電力 | 5〜15 W | **0.6W idle / 1.5〜4.5W 負荷** | 3〜6 W |
| 電源入力 | USB PD | **VIN 7〜24V 直結可** | 5V |

**CPU性能はROCK 5Bの1/5〜1/8**（A76とA53でIPCが2.5〜3倍違う）。体感はPi 4Bと同等か
やや下。消費電力は**3〜4倍の改善**が見込める（10倍にはならない）。

**VIN 7〜24V直結**は車載では大きな利点で、ROCK 5BのUSB PD電源まわりの苦労が消える。

懸念は映像パイプライン側にある。エンコーダ上限が1080p30なので、
「カメラ1080p30 → ダッシュ合成 → 1080p30保存」でちょうど上限。
**保存と同時のRTMP配信や、2カメラ構成は成立しない見込み。**
Ver.2でどこまでの機能を残すかは別途相談したい。

---

## 5. 【依頼A】回路設計へのお願い

### 5.1 追加でお願いしたい配線（新規・重要）

センサーフュージョンの成否を決めるのは計算量ではなく時刻同期のため、
**割り込み信号を2本、MCUへ引いてほしい。**

| # | 信号 | 出力元 | 接続先 | 目的 |
|---|---|---|---|---|
| A-1 | **TIMEPULSE (1PPS)** | **MAX-M10M pin 4**（🔴 2026-09-21訂正。当初「NEO-M9N pin 3」と書いていたが、GNSSはMAX-M10M継続に変更） | STM32U585の外部割り込み対応ピン | GNSS時刻でMCUタイマを規律する |
| A-2 | **INT** | **BNO055モジュール pin 6** | STM32U585の外部割り込み対応ピン | IMUサンプル取得時刻を同一タイマで打刻する |

> 🔴 **2026-09-21追記：`logger_v1.net`を確認したところ、この2本のうち1本はVer.1に既にあった。**
> **本当に新規なのはA-2の1本だけである。**
>
> - **A-1（GNSS PPS）は`ecologger_v1`に配線済み**。U13(MAX-M10M) pin 4 TIMEPULSE →
>   ネット`/GNSS_PPS`として既に引かれている。**Ver.2では同じ配線を踏襲してほしい**という依頼になる
> - **A-2（IMU INT）はVer.1では未接続**（ネットリスト上`unconnected-(U12-INT-Pad6)`）。
>   **ここだけが新規の追加配線**
>
> **つまり回路担当への「新規配線の依頼」は実質1本**。依頼の重さが当初の説明より小さいので、
> そのつもりで見てほしい。

Ver.1にはなかった配線。UART/I2Cの読み出しタイミングだけでは、そのサンプルが
**いつ測定されたのか**が分からず、数ms〜数十msの不定遅延が乗る。100km/h走行時、
**タイムスタンプの10msのずれは0.28mの位置誤差**に相当し、「コーナー入口のどこで
何Gが出たか」を誤った位置に貼り付けてしまう。

**重要：この配線は2.5章のA・B・Cどの方式を選んでも必要になる。**
姿勢の算出方式が未定でも、GNSSとIMUを共通の時刻基準で記録するという要件は共通のため。
逆に言えば、**この2本さえ通しておけば、アルゴリズムの選択は実走データを見てから
後処理で自由に決められる**。

> 🔴 **2026-09-21追記：方式はC（ESKF）に決定した**（7.1章）。
> **この2本は「念のため」ではなく確定要求**として扱ってほしい。依頼内容自体は上表のまま変わらない。

### 5.2 GNSS変更に伴う対応

> 🔴 **2026-09-21：本節（B-1〜B-5）はすべて不要になった。**
> **NEO-M9Nが入手困難でMAX-M10M-00Bを継続使用するため、GNSS部はVer.1のまま据え置きでよい**
> （7.3章）。フットプリント変更・アンテナ給電回路の再確認・消費電力増の検討はいずれも発生しない。
> **回路担当にとってはVer.2の作業が1つ減る。** 以下は将来NEO-M9Nへ移る場合の備忘として残す。

| # | 内容 |
|---|---|
| B-1 | **フットプリント変更**：MAX形状(10.1×9.7mm) → NEO形状(12.2×16.0mm)。ピン配置も別物 |
| B-2 | **電源**：VCC 2.7〜3.0〜3.6V。3.3V系でそのまま動作（LC79Hのような1.8V専用ではない） |
| B-3 | **アンテナ給電**：`VCC_RF`はpin 9。Ver.1で合意したアクティブ／パッシブ切り替え回路の トポロジーがそのまま転用できるか確認をお願いしたい |
| B-4 | **V_BCKP**：Ver.1の方針（電源ON/OFF自体をログ開始/終了トリガーとする）を継続し、 バックアップ電源は非搭載のままとしたい |
| B-5 | **消費電力**：現行比+67mW（41→108mW、25Hz運用ではさらに増）。 UNO Qの電源設計に影響があるか確認したい |

### 5.3 確認をお願いしたい技術的な点

| # | 内容 |
|---|---|
| ~~C-1~~ ⚠️ **2026-09-21：不要**（MAX-M10M継続のため） | ~~NEO-M9Nで`CFG-VALSET`のflashレイヤー書き込みが使えるか（データシートに Flash搭載の記載はあるが設定永続化の明記はない）。**使えれば、Ver.1で失った 「バックアップ電池なしの設定永続化」が復活し、起動シーケンスが簡素化できる** |
| C-2 ⚠️ **2026-09-21：前提が変わった**。MAX-M10Mでは4系統同時は10 Hzが上限のため、確認すべきは「どの系統数・更新レートの組み合わせを採るか」（7.3章）へ置き換わる | ~~4系統同時25Hzが実機で本当に出るか（UART上限921,600bpsとの兼ね合い。 UBX-NAV-PVTのみなら25Hzで約25kbpsなので余裕はあるはず） |

---

## 6. 【依頼B】UNO Q実機で確認してほしいこと（最優先）

UNO Q（4GBモデル）をお持ちとのことなので、**以下を実機で確認していただきたい。**

### 6.1 なぜ最優先なのか

Ver.1のダッシュカムでROCK 5Bを使った際、公式`video-streamer`がIntel/AMDのVAAPI専用
だったため、Rockchip独自のRKMPPで同等機能を自作する方針になった経緯がある
（`DASHCAM_ROCK5B_REPORT.md` 3章）。

UNO Q（Qualcomm）では`venus`というV4L2 M2Mドライバを使う。APIがRaspberry Piと同じ
v4l2m2m系なのでRKMPP独自APIよりは移植性が高いが、**Arduinoが配布しているDebian
イメージでvenusが有効化されて出荷されているかが不明。**

**もしハードウェアエンコードが使えずCPUエンコードしかできない場合、
A53×4コアでは1080p30は絶対に回らない。** その時点でUNO Qという選択自体が破綻し、
GNSSを含む周辺部品の議論も前提から崩れるため、他のどの検討よりも先に潰しておきたい。

### 6.2 確認事項と、結果の記入欄

**すでに確認済みの項目があれば、コマンドを実行し直す必要はありません。**
分かっている範囲の結果だけ教えてください。別の方法で確認済みの場合も、
「何がどこまで動いたか」が分かれば十分です。

---

**D-1. ハードウェアエンコーダのデバイスが見えているか**

```bash
ls -l /dev/video* && v4l2-ctl --list-devices
```

- [ ] 未実施
- [ ] 実施済み → 結果：

---

**D-2. ffmpegがハードウェアエンコーダを認識しているか**

```bash
ffmpeg -hide_banner -encoders | grep -i v4l2
```

`h264_v4l2m2m` が一覧に出てくるかどうかを見たい。

- [ ] 未実施
- [ ] 実施済み → 結果：

---

**D-3. 1080p30のハードウェアエンコードが実時間で回るか（最重要）**

```bash
ffmpeg -f lavfi -i testsrc=size=1920x1080:rate=30 -t 30 -c:v h264_v4l2m2m -b:v 12M /tmp/enc_test.mp4
```

- **判定基準**：30秒の素材が**実時間（30秒前後）で完走**し、その間の**CPU使用率が低い**
  ならハードウェアエンコードが効いている
- CPUが張り付いて30秒より大幅に遅い場合はソフトエンコードに落ちている＝赤信号
- 別ターミナルで `top` か `htop` を併走させてCPU使用率も見ていただけると確実

- [ ] 未実施
- [ ] 実施済み → 所要時間：　　　秒 ／ CPU使用率：　　　%

---

**D-4. GPUのOpenGL ESが有効か（ダッシュGUI描画用）**

```bash
glxinfo -B 2>/dev/null | grep -Ei "renderer|opengl es"
```

`freedreno` および `Adreno 702` 相当の表示が出るかを見たい。
（ROCK 5BのMali-G610と違い、Adreno系はMesa/freedrenoの成熟度が高いため、
ここは通る見込みが高いと考えている）

- [ ] 未実施
- [ ] 実施済み → 結果：

---

**D-5. 参考情報として教えてほしいこと**

- [ ] UNO Qで映像まわりを既に何か試している場合、その内容と結果
- [ ] カメラ入力の予定（UNO Media CarrierのMIPI CSI／USB UVCカメラのどちらを想定しているか）
- [ ] 表示出力の予定（USB-C DisplayPort／MIPI DSIのどちらか）
- [ ] 実測の消費電力（測っていれば。アイドル時・負荷時）

---

## 7. 判断が必要な点（🔴 2026-09-21：3件とも決着した）

> **この章は「相談したいこと」から「決定事項」へ変わった。**
> E-1〜E-3はこちら側で判断を終えている。**回路側への依頼内容（5章）は3件とも変わらない**が、
> 「後で決める」ではなく確定した前提として設計を進めてほしい。

| # | 論点 | 結論 |
|---|---|---|
| **E-1** | GNSSをNEO-M9Nで確定してよいか | 🔴 **2026-09-21 再訂正。NEO-M9Nは入手困難のため見送り、Ver.1と同じMAX-M10M-00Bを継続使用する**。→ 7.3章。**5.2章・5.3章C-1の対応はすべて不要になった** |
| ~~E-2~~ | ~~姿勢・G算出をA/B/Cのどの方式にするか~~ | ✅ **決着。C方式（GNSS/IMU融合・ESKF）を本命に据える**。→ 7.1章 |
| ~~E-3~~ | ~~Ver.2ダッシュカムの機能範囲~~ | ✅ **決着。保存のみ・1080p30・1カメラ**。RTMP配信も2カメラも狙わない。→ 7.2章 |

### 7.1 E-2の決定：C方式（ESKF）を本命とする

**決定理由**：`ARCHITECTURE.md`3章のIMU要件は「車両の前後左右G、ロー・ピッチ・ローリング
角速度の取得」である。**角速度だけならBNO055の生ジャイロ＋B方式で満たせる**が、
荷重移動の解析まで視野に入れるとロール角・ピッチ角そのものが要る。
加えてバンク・カント路面で偽の横Gが出ないのもC方式だけである（2.5章の比較表）。

**回路側への影響：無い。** 依頼は5.1章の配線2本（A-1 PPS／A-2 IMU INT）のみで、
A・B・Cのどれを選んでも同じ。**ただし「方式未定だから念のため」ではなく、
ESKFを回す前提の確定要求として扱ってほしい。** この2本は基板を作り直さないと追加できない。

**こちら側（ファーム）の前提**：

- **BNO055はAMGモード（生の加速度・角速度）で使う。** 内蔵NDOFフュージョンの姿勢出力は
  2.5章の理由により姿勢推定には使わない
- **ESKFはSTM32U585側で回す**（2.4章の分担。負荷見積もりは約1%）。Linux側へは
  融合済みPVTを100 Hzで渡す
- **較正GUI（UNO Q側）は無駄にならない。** B方式のために設計していた較正手順
  （静止水平取り＋直線加速）は、C方式でも初期姿勢とセンサー取付角の拘束に使う

**段階導入は可**：3方式は同じ生ログから選べるため、実装順序はA→B→Cで構わない。
走り始めた初期はA/Bの値を見ながらCを仕上げればよい。**到達目標をCに置く**という意味の決定である。

### 7.2 E-3の決定：保存のみ・1080p30・1カメラ

**画質を最優先し、記録に専念する構成とする。** UNO Qのエンコーダ上限をそのまま使い切る。

**RTMP配信は狙わない。** 理由は2つある。

1. エンコーダが1本しかないため、保存と配信を両立させるには保存側を720p30へ落とす必要がある
2. **そもそもVer.2の内蔵LTEはCat-M1で、映像配信に使える帯域がない**
   （`LOGGER_V2_LTE_MODEM_REPORT.md`1.2章：テレメトリ10Hzで上り約22kbps、
   電波が悪くCE状態に入れば数kbpsまで落ちる）。
   **→ 内蔵LTEモデムはテレメトリ専用と確定してよい。映像は要求に含めない。**

**2カメラ構成も狙わない**（4章のとおり成立しない見込みのため）。

映像配信が必要になった場合は、別途USBのLTEドングル（未購入）を足して再検討する。
**基板設計の前提には入れない。**

**この決定により6章D-3の重要度が上がった**：Ver.2では
「カメラ1080p30 → ダッシュ合成 → 1080p30保存」がダッシュカムの全機能そのものになる。
**D-3（1080p30のハードウェアエンコードが実時間で回るか）が通らなければ、
ROCK 5Bを降ろせない＝車載機材が2箱のまま残る。** 引き続き最優先で確認をお願いしたい。

### 7.3 🔴 E-1の再訂正（2026-09-21）：MAX-M10M-00Bを継続使用する

**NEO-M9N-00Bが入手困難なため、当面はVer.1と同じ`u-blox MAX-M10M-00B`を使い続ける。**

#### 回路担当への影響：**作業が1つ減る**

**Ver.2のGNSS部はVer.1のまま据え置きでよい。** 具体的には以下がすべて不要になる。

- **5.2章 B-1〜B-5がまるごと不要**。フットプリント変更（MAX形状10.1×9.7mm → NEO形状12.2×16.0mm）、
  アンテナ給電回路（`VCC_RF`のピン番号違い）の再確認、消費電力+67mWの検討、いずれも発生しない
- **5.3章 C-1が不要**（NEO-M9NでのFlash設定永続化の可否）

**アートワークに入る前に伝わるべき情報なので、P-3と併せて最優先で共有したい。**

#### 代わりに諦めるもの（正直に）

1. **「4系統同時 × 20Hz以上」は得られない。** MAX-M10Mは高性能クロックOTP書き込み後でも
   **系統数と更新レートのトレードオフ**になる（`firmware/logger_v1/GNSS_BALANCE.md`）。
   4系統なら10 Hz、3系統で約15 Hz、2系統で20 Hz、単一系統で25 Hzが上限。
2. **25Hzを出すには個体ごとに不可逆のOTP書き込みが必要**。Ver.1の実機では2026-08-31に実施済みだが、
   **基板を複数枚作る場合は1枚ごとに焼く工程が残る**（1.4章でNEO-M9Nの利点として挙げていた
   「OTP工程が消える」は得られない）。
3. L5非対応・追尾感度・CEPの差は、もともとNEO-M9Nでも改善しない／わずかな項目なので実害は小さい。

#### E-2（C方式・ESKF）との関係：**更新レートの優先度は下がった**

**姿勢・G算出をC方式（GNSS/IMU融合・ESKF）に決めたことで、判断軸が変わった。**
ESKFではIMUが100 Hzで間を埋めるため、**GNSSに求めるのは高い更新レートよりも
測位の継続性・衛星数・速度解の素直さ**になる。この観点では
**4系統10 Hz（`four_10`）を基準に置くのが理にかなう**。

ただし`GNSS_BALANCE.md`の比較（`four_10` / `b1c_15` / `glo_15` / `dual_20` / `gps_25`）は
**途中で中断したまま未決着**である。**ESKF採用という新しい判断軸が加わったので、
ここを実測で決め直す**（こちら側の宿題。回路担当への依頼ではない）。

#### 他文書への波及

`LOGGER_V2_LTE_MODEM_REPORT.md`／`LOGGER_V2_LTE_MODEM_QUESTIONS.md`のP-5（GNSSとLTEの干渉）は
NEO-M9N前提で書かれている。**L1 = 1575.42 MHzは同じなので干渉の結論自体は変わらない**が、
**「内蔵SAWがあるのでマージンはある」という根拠は型番依存**のため、
MAX-M10M-00B側のフロントエンド構成（SAW/LNAの有無）は改めて確認が要る。

---

## 出典

- [NEO-M9N-00B Data sheet (u-blox, UBX-19014285 R08)](https://content.u-blox.com/sites/default/files/documents/NEO-M9N-00B_DataSheet_UBX-19014285.pdf)
- [NEO-M9N-00B 単価 $14.69 (DigiKey)](https://www.digikey.com/en/products/detail/u-blox/NEO-M9N-00B/12149174)
- [MAX-M10M Data sheet (u-blox)](https://www.mouser.com/datasheet/2/1025/MAX_M10M_DataSheet_UBX_22028884-3367762.pdf)
- [MAX-M10N-10B Data sheet (u-blox, 20Hz/10Hz の根拠)](https://content.u-blox.com/sites/default/files/documents/MAX-M10N-10B_DataSheet_UBXDOC-304424225-18248.pdf)
- [NEO-M8 series Data sheet (u-blox, 18Hz/10Hz の根拠)](https://content.u-blox.com/sites/default/files/NEO-M8-FW3_DataSheet_UBX-15031086.pdf)
- [u-blox F11 platform (25Hz単一 / 3系統以上10Hz)](https://www.cnx-software.com/2026/07/06/u-blox-f11-low-power-dual-band-gnss-chips-and-modules-consume-just-7mw-in-leap-mode/)
- [ZED-F9P-04B Data sheet / 単価 $127.42 (DigiKey)](https://www.digikey.com/en/products/detail/u-blox/ZED-F9P-04B/15761778)
- [ZED-F9R-03B Data sheet (IMU融合で30Hz出力)](https://content.u-blox.com/sites/default/files/documents/ZED-F9R-03B_DataSheet_UBX-22024085.pdf)
- [Unicore UM980 (50Hz・L1/L2/L5全系統)](https://en.unicore.com/products/um980/)
- [Quectel LC79H Series GNSS Module Specification V1.4](https://www.quectel.com/product/gnss-lc79h/)
- [BNO055 Data sheet (Bosch Sensortec 公式)](https://www.bosch-sensortec.com/media/boschsensortec/downloads/datasheets/bst-bno055-ds000.pdf)
- [BNO055 Data sheet (ACC_CONFIG / GYR_CONFIG_0 / OPR_MODE のレジスタ詳細)](https://cdn-shop.adafruit.com/datasheets/BST_BNO055_DS000_12.pdf)
- [RaceChrono forum: G force data（横G/前後GはGPSから算出との開発者説明）](https://racechrono.com/forum/discussion/1651/g-force-data)
- [RaceChrono forum: Accelerometer calibration（内蔵センサーは無較正・無回転の生値）](https://racechrono.com/forum/d/1924-1924)
- [RaceChrono forum: バイクでの横G算出はGPSベースが必須という議論](http://racechrono.com/forum/discussion/2404/lateral-acceleration-on-a-motorcycle-with-racebox-mini-fix)
- [timurrrr/arduino-RaceChrono（RaceChrono公式BLE APIのオープンソース実装）](https://github.com/timurrrr/arduino-RaceChrono)
- [IMU attitude errors during acceleration（比力と重力の分離問題）](https://industrialmonitordirect.com/blogs/knowledgebase/imu-attitude-errors-during-acceleration-compensation-methods)
- [Low-Cost Inertial Aiding for Tightly-Coupled GNSS（速度支援によるロール・ピッチ誤差の収束）](https://arxiv.org/pdf/2201.11776)
- [UNO Q | Arduino Documentation](https://docs.arduino.cc/hardware/uno-q)
- [UNO Q Power Specifications | Arduino Documentation](https://docs.arduino.cc/tutorials/uno-q/power-specification/)
- [UNO Media Carrier | Arduino Documentation](https://docs.arduino.cc/hardware/uno-media-carrier/)
- [Qualcomm QCS2290/QCM2290 Product Brief (1080p30 encode, Adreno 702)](https://www.qualcomm.com/content/dam/qcomm-martech/dm-assets/documents/qcs-qcm2290-soc-product-brief_87-28731-1.pdf)
- [Qualcomm Dragonwing QRB2210 Processor Product Brief](https://docs.qualcomm.com/doc/87-61720-1/87-61720-1_REV_C_Qualcomm_Dragonwing_QRB2210_Processor_Product_Brief.pdf)
