ntakao2006-web/RaceCapture/EcoCapture-Web/ncec_can_spec.md

# NCロードスター（NCEC）CAN通信仕様

> **この文書の位置づけ**：NCECのCANバス上に実際に流れているものを、**仕様としてだけ**まとめたもの。
> 測定手順・回路の話・プロジェクトの経緯は含まない（それらは`docs/manual/ncec_field_procedure.md`・
> `docs/research/vehicle_can_survey_summary.md`・`ARCHITECTURE.md`）。実装者がこの1枚だけ見れば
> デコーダを書ける状態を目指している。
>
> **確度は3段階で明示する**。推測を確定として書かない。
> **確定**＝実測で式まで検証済み／**示唆**＝相関はあるが式が確定しない／**未解明**＝意味不明
>
> **最終更新**：2026-09-06

---

## 0. 適用範囲と測定条件

| 項目 | 内容 |
|---|---|
| 対象車両 | マツダ ロードスター **NCEC 前期型（2005年式）**、MT、**DSC非搭載** |
| **重要：改造内容** | **後期型エンジンへ載せ替え済み＋ECUチューン（NOPRO MZ-TUNE+）**。レブリミット8,000rpm、スピードリミッター解除、メカフィーリングスロットルマップ、電動ファン作動温度変更などを含む |
| 測定日 | 2026-09-06 |
| 測定系 | XIAO ESP32C3（TWAI）＋ MCP2562FD-E/P、OBD2ポート直結 |
| 測定量 | 走行55分／**2,611,844フレーム**／791.5 frame/s。**取りこぼし0・バスエラー0** |
| 欠落ゼロの検証 | `0x211` byte7 のローリングカウンタ246,009件を全数照合し、増分が**100.0000%が+1（例外ゼロ）** |
| 解析範囲 | 本書の統計値・回帰は原則**走行フェーズ41分（1,966,217フレーム）**に基づく |

> **⚠️ ノーマルのNCECとは異なる可能性がある項目**には本文中で明記する。
> コミュニティのNC用CANデータベースはノーマルのNC1が前提のため、食い違う箇所がある。

---

## 1. バス諸元

| 項目 | 値 |
|---|---|
| プロトコル | **ISO 15765-4 CAN**、11bit標準ID |
| ビットレート | **500 kbps**（HS-CAN） |
| OBD2コネクタ | **6番＝CAN_H／14番＝CAN_L／5番＝Signal Ground** |
| 終端 | **車両バスは両端終端済み**。外部機器側に120Ωを付けない |
| 準拠 | JOBD（Japan OBD） |
| バス負荷 | **走行中 約692 frame/s**（外部機器が何も送信しない状態での実測） |
| 非診断ID数 | **16種**（下記） |

> **3番・11番ピンには触らないこと。** マツダ車ではここにMS-CAN(125kbps)が来ている場合があり、
> 6番/14番と導通させると2系統直結になって双方でエラーフレームが連発し、
> ノードがバスオフに陥る（車両側の警告灯・DTC・フェイルセーフを誘発する）。

---

## 2. 非診断ID 一覧

| CAN ID | 周期 | 件数(41分) | 内容 | 確度 |
|---|---|---|---|---|
| `0x200` | 100 Hz | 246,069 | スロットル系1バイト＋未解明の16bit×3 | 一部**示唆** |
| `0x201` | 100 Hz | 246,069 | **エンジン回転数・車速**・スロットル系 | **確定** |
| `0x215` | 100 Hz | 246,069 | スロットル系1バイト＋未解明の16bit×2 | 一部**示唆** |
| `0x4B0` | 100 Hz | 246,009 | **4輪独立ホイールスピード** | **確定** |
| `0x211` | 100 Hz | 246,009 | **ローリングカウンタ**（byte7のみ可変） | **確定** |
| `0x21A` | 50 Hz | 123,005 | **全8バイトが常時ゼロ** | **未解明** |
| `0x231` | 40 Hz | 98,427 | **クラッチスイッチ**（byte1） | **確定** |
| `0x4EC` | 40 Hz | 98,427 | 未解明の16bit×2 | **未解明** |
| `0x240` | 10 Hz | 24,607 | **水温・スロットル・吸気温**＋負荷/点火時期 | **確定**＋一部示唆 |
| `0x420` | 10 Hz | 24,607 | **水温**（byte0）＋未解明 | **確定**＋一部未解明 |
| `0x4FF` | 10 Hz | 24,607 | **ASCII文字列の分割送信** | **確定** |
| `0x212` | 10 Hz | 24,601 | **全8バイトが常時固定値** | **未解明** |
| `0x430` | 10 Hz | 24,599 | **燃料レベル**（byte0） | **確定** |
| `0x39A` | 10 Hz | 24,599 | **全8バイトが常時ゼロ** | **未解明** |
| `0x4F0` | 1 Hz | 2,461 | 全8バイトが固定値 | **未解明** |
| `0x4F1` | 1 Hz | 2,461 | 全8バイトが固定値 | **未解明** |

診断用の `0x7E0`（要求）・`0x7E8`（応答）は5章。

---

## 3. ID別バイトマップ

**2バイト値はすべてビッグエンディアン**（上位バイトが先）。

### `0x201` — 回転数・車速（100 Hz）★最重要

| byte | 内容 | 式 | 実測 | 確度 |
|---|---|---|---|---|
| 0-1 | **エンジン回転数** | `raw / 4` [rpm] | slope=0.250041, intercept=-0.417, **R²=0.99978** | **確定** |
| 2-3 | 未解明 | — | 9,706〜59,217、値種9,380 | 未解明 |
| 4-5 | **車速** | `raw / 100 - 100` [km/h] | slope=0.0100005, intercept=-100.004, **R²=0.99991** | **確定** |
| 6 | スロットル／ペダル系 | 未確定 | 0x00〜0x39、OBD `0x11`に対しR²=0.79 | 示唆 |
| 7 | 固定 `0xFF` | — | — | — |

> **車速の`-100`オフセット**：停車時の生値は `0x2710`（=10000）。`10000/100-100 = 0 km/h`。

### `0x4B0` — 4輪独立ホイールスピード（100 Hz）

| byte | 車輪 | 式 | 確度 |
|---|---|---|---|
| 0-1 | **前軸・A側** | `raw / 100 - 100` [km/h] | **確定**（R²=0.99988） |
| 2-3 | **前軸・B側** | 同上 | **確定**（R²=0.99988） |
| 4-5 | **後軸・A側**（駆動輪） | 同上 | **確定**（R²=0.99989） |
| 6-7 | **後軸・B側**（駆動輪） | 同上 | **確定**（R²=0.99990） |

**前後軸の判定根拠**：NCECはFR（後輪駆動）。加速時は駆動輪が路面に対して先行し、4輪平均より
速く回る。各バイトペアの偏差と縦加速度の相関は byte0-1: **-0.320**／byte2-3: **-0.259**／
byte4-5: **+0.291**／byte6-7: **+0.325** と、符号が2対2で割れた。正の側が駆動輪＝後軸。

**左右の組み分けの根拠**：旋回時の左右差（ヨーレート×トレッド）は前軸と後軸に共通して現れる。
{byte0-1, byte2-3}と{byte4-5, byte6-7}を車軸とみなしたときの左右差どうしの相関は **+0.567**、
対角に切ると **+0.109** で消える。相関が**正**であることから、
**`byte0-1` と `byte4-5` が同じ側**、**`byte2-3` と `byte6-7` が同じ側**。

> **⚠️ 「A側が左か右か」は未確定。** 横方向の基準が無いため走行データからは原理的に決まらない。
> コミュニティ資料は FL/FR/RL/RR の順としており、**構造はそれと一致している**。
> 確定させるには、一定舵角のまま左に1周する（左旋回では右側2輪が外輪＝速い）。

### `0x240` — エンジン状態（10 Hz）

| byte | 内容 | 式 | 実測 | 確度 |
|---|---|---|---|---|
| 0 | エンジン負荷？ | 未確定 | 値種206、OBD `0x0B`吸気管圧にR²=0.64／`0x04`負荷にR²=0.62 | 示唆 |
| 1 | **水温** | `byte - 40` [℃] | slope=0.996848, intercept=-39.6194, **R²=0.99608** | **確定** |
| 2 | 点火時期？ | 未確定 | 値種118、OBD `0x0E`点火時期にR²=0.80 | 示唆 |
| 3 | **スロットル開度** | `byte × 100 / 255` [%] | slope=0.388674（≒0.3922）, intercept=0.137, **R²=0.98241** | **確定** |
| 4 | **吸気温** | `byte - 40` [℃] | slope=0.9406, intercept=-35.77, **R²=0.97610** | **確定** |
| 5-7 | 固定 `0x00` | — | — | — |

### `0x420` — 水温（冗長経路）（10 Hz）

| byte | 内容 | 式 | 実測 | 確度 |
|---|---|---|---|---|
| 0 | **水温** | `byte - 40` [℃] | slope=0.996824, intercept=-39.6149, **R²=0.99336** | **確定** |
| 1 | 未解明 | — | 値種255（0x00〜0xFE）。OBD全20PIDに対し最良R²=0.15＝該当なし | 未解明 |
| 2 | 固定 `0x00` | — | — | — |
| 3 | 未解明 | — | 値種203（0x00〜0xD6）。最良は`0x47`絶対スロットルBのR²=0.68 | 未解明 |
| 4 | 固定 `0x00` | — | — | — |
| 5 | フラグ？ | — | 41分中**3フレームだけ**`0x40`、残りは`0x00`（bit6） | 未解明 |
| 6 | フラグ？ | — | 同上 | 未解明 |
| 7 | 固定 `0x00` | — | — | — |

> **水温は `0x240` byte1 と `0x420` byte0 の2経路で取得できる**（両者は常に同値）。
> 文献では`0x420`を「カウンタ」とする説と「温度」とする説が矛盾していたが、**温度で決着**。
> 過去に観測された「byte0が緩やかに単調増加」は、暖機による水温上昇そのものだった。

### `0x231` — クラッチスイッチ（40 Hz）

| byte | 内容 | 確度 |
|---|---|---|
| 0 | 固定 `0xFF` | — |
| 1 | **bit1（`0x02`）＝クラッチ断（ペダル踏み込み）** | **確定** |
| 1 | bit2（`0x04`）＝未解明。**単独では一度も出現せず、必ずbit1と同時**に立つ | 未解明 |
| 2-3 | 固定 `0xFF` | — |
| 4-7 | 固定 `0x00` | — |

byte1が取った値は `0x00`（69.5%）・`0x02`（27.4%）・`0x06`（3.1%）の3種のみ。

**クラッチである根拠**：「回転数÷車速（＝ギア比）の集中度」で検証した。クラッチが繋がっていれば
ギア比は各段の値に強く集中し、切れていれば分散する。20 km/h以上のサンプルで集計すると、
**bit1=0 では上位3ビンが94%**（各ギア段に集中）、**bit1=1 では60%**（分散）。
**bit1が立っている間だけエンジン回転と車輪速の結びつきが失われる。**

**bit2の性質**：`0x06` のとき平均車速16.2 km/h、1秒後の速度変化 **-2.34 km/s**、70%が減速中。
低速で強く減速している場面に集中するが、ブレーキ単独踏みでも立つはずのブレーキスイッチとは
挙動が合わない（単独出現がゼロのため）。

### `0x430` — 燃料レベル（10 Hz）

| byte | 内容 | 式 | 確度 |
|---|---|---|---|
| 0 | **燃料レベル** | `byte / 2.55` [%] | **確定** |
| 1 | byte0と逆向きに動く別表現 | — | 未解明 |
| 2-7 | 固定 `0x00` | — | — |

**根拠（給油をまたいだ実測）**：IG OFFで375秒間バスが停止した前後で、byte0の中央値が
**35（13.7%）→ 237（92.9%）**へ +202 跳ね上がった。

> **満タンでも byte0 は 237（92.9%）で頭打ち**になり255には届かない。実用上の上限は約93%。
>
> **byte1 は byte0 の補数ではない**（低燃料時 `byte0+byte1`=187、満タン時=256で和が一定でない）。
> 走行中だけ見ると和が一定に見えるが、それは燃料レベルが狭い範囲にしか無かったための見かけ。
>
> **走行中は油面がGで揺れるため値が大きくばらつく**（標準偏差は低速域で24.4、停車時7.2）。
> ECU側の平滑化前の生センサー値に近いとみられる。ロガー側で移動平均をかけること。

### `0x211` — ローリングカウンタ（100 Hz）

| byte | 値 | 内容 |
|---|---|---|
| 0-1 | 固定 `0xFF FF` | — |
| 2 | 固定 `0x80` | — |
| 3 | 固定 `0x00` | — |
| 4 | 固定 `0x40` | — |
| 5-6 | 固定 `0x00 00` | — |
| 7 | **ローリングカウンタ** | 1フレームごとに+1、255で一周 |

**用途**：受信側が取りこぼし・送信元のフリーズを検出するための連番。値そのものに意味はない。
**キャプチャ品質の検証に使える**（増分が+1以外になったらフレームを落としている）。

### `0x4FF` — ASCII文字列の分割送信（10 Hz）

先頭バイトがインデックス、残り7バイトがASCII。5種類を巡回送信する。

| ペイロード | ASCII |
|---|---|
| `30 44 49 53 41 42 00 00` | `'0'` + `DISAB` |
| `31 4C 45 56 49 4E 43 00` | `'1'` + `LEVINC` |
| `32 4F 4D 50 41 52 45 00` | `'2'` + `OMPARE` |
| `11 00 00 00 00 00 00 00` | （非ASCII） |
| `10 14 24 12 FF 00 00 00` | （非ASCII） |

インデックス順に連結すると **`DISABLE VIN COMPARE`**。

> **走行データとしての価値は無い。ロガーでは無視してよい。**
> なお本車両はエンジン・ECU載せ替え車のため、**この設定が改造に伴うものである可能性がある**
> （ノーマル車で同IDが流れるかは未検証）。固定の文字列リテラルであり車台番号ではない。

### `0x200` / `0x215` — スロットル系＋未解明フィールド（100 Hz）

| ID | byte | 内容 | 実測 | 確度 |
|---|---|---|---|---|
| `0x200` | 0-1 | 未解明 | 9,958〜10,142（値種182）。82%は前フレームと同値、変化は±1 | 未解明 |
| `0x200` | 2-3 | 未解明 | 9,957〜10,165（値種180）。同上 | 未解明 |
| `0x200` | 4-5 | 未解明 | 9,965〜10,165（値種194）。同上 | 未解明 |
| `0x200` | 6 | 未解明 | `0x00`／`0x01` の2値 | 未解明 |
| `0x200` | **7** | **スロットル系** | `0x00`〜`0x30`。**`0x215` byte6 と完全に同一値** | 示唆 |
| `0x215` | 0-1 | 未解明 | 500〜681（値種182）。`0x200`と同じ挙動 | 未解明 |
| `0x215` | 2-3 | 未解明 | 500〜681（値種182）。0-1と同一分布 | 未解明 |
| `0x215` | 4 | 固定 `0x02` | — | — |
| `0x215` | 5 | 未解明 | `0x15`〜`0x2C`（値種20） | 未解明 |
| `0x215` | **6** | **スロットル系** | `0x00`〜`0x30`。`0x200` byte7 と同一 | 示唆 |
| `0x215` | 7 | 未解明 | 値種6。文献では故障コード関連とされる | 未解明 |

**`0x200` byte7 / `0x215` byte6 の式が確定しない理由**：比較相手によって傾きが変わる。

| 比較相手（OBD） | slope | intercept | R² |
|---|---|---|---|
| `0x47` 絶対スロットルB | **0.3929**（≒`100/255`＝0.3922） | 11.62 | 0.804 |
| `0x45` 相対スロットル | 0.3999 | 2.51 | 0.799 |
| `0x11` スロットル | 0.4307 | 11.13 | **0.976** |

コミュニティ資料の式 `byte × 100/255` は `0x47` に対しては小数3桁まで一致するが、
`0x47` は1Hzでサンプルが少ない。8.6Hzの `0x11` に対しては 0.4307 になる。**現時点では決着しない。**

> **⚠️ この車両はメカフィーリングスロットルマップでペダル開度とスロットル開度が意図的に
> ズラしてある。** 実測では**ペダル8.5ポイントの変化に対しスロットルが16.1ポイント動く
> （ゲイン約1.9倍）**。ノーマル車とは異なる可能性が高い。

### `0x4EC` — 未解明（40 Hz）

| byte | 内容 |
|---|---|
| 0-3 | 固定 `0x00` |
| 4-5 | 4,047〜9,500（値種906）。OBD全20PIDに対し最良R²=0.60＝該当なし |
| 6-7 | 3,150〜30,125（値種16,992）。値の散らばりが大きく**CRC／チェックサム疑い** |

### `0x21A` / `0x39A` / `0x212` — 常時固定（未解明）

| ID | 周期 | 41分間の値 |
|---|---|---|
| `0x21A` | 50 Hz | **全8バイトが `0x00` のまま1ビットも変化せず** |
| `0x39A` | 10 Hz | **全8バイトが `0x00` のまま1ビットも変化せず** |
| `0x212` | 10 Hz | **`80 00 20 40 00 00 00 00` のまま変化せず** |

走行・加減速・停車のいずれでも動かない。**走行では原理的に変化しない量**
（ドア開閉・シートベルト・パーキングブレーキ・警告灯など）を運んでいる可能性が高い。
`0x212` は文献でABS/DSC off/トラクションコントロール/ブレーキ警告関連とされ、
上記の値が「異常なし」時のデフォルトとみられる（未確定）。

### `0x4F0` / `0x4F1` — 未解明（1 Hz）

| ID | 41分間の値 |
|---|---|
| `0x4F0` | `14 40 12 30 01 00 00 00` で固定 |
| `0x4F1` | `81 01 9A FF FF 00 59 59` で固定 |

**コミュニティ資料に記載が無いID。** 本車両が後期型エンジン＋チューンドECUであることに
由来する可能性がある（未確認）。

### 本車両で観測されなかったID

| CAN ID | 内容 | 理由 |
|---|---|---|
| `0x081` | ステアリング舵角 | **DSC搭載車（2007年以降）限定**。本車両はDSC非搭載 |
| `0x085` | ブレーキ圧 | 同上 |
| `0x090` | 加速度 | 同上 |

---

## 4. 実装向けサマリ（デコーダに入れてよい確定項目のみ）

| 物理量 | CAN ID | offset | 幅 | 式 | 周期 |
|---|---|---|---|---|---|
| エンジン回転数 [rpm] | `0x201` | 0 | 2 (BE) | `raw / 4` | 100 Hz |
| 車速 [km/h] | `0x201` | 4 | 2 (BE) | `raw / 100 - 100` | 100 Hz |
| ホイールスピード 前A [km/h] | `0x4B0` | 0 | 2 (BE) | `raw / 100 - 100` | 100 Hz |
| ホイールスピード 前B [km/h] | `0x4B0` | 2 | 2 (BE) | `raw / 100 - 100` | 100 Hz |
| ホイールスピード 後A [km/h] | `0x4B0` | 4 | 2 (BE) | `raw / 100 - 100` | 100 Hz |
| ホイールスピード 後B [km/h] | `0x4B0` | 6 | 2 (BE) | `raw / 100 - 100` | 100 Hz |
| 水温 [℃] | `0x240` | 1 | 1 | `raw - 40` | 10 Hz |
| 水温（冗長）[℃] | `0x420` | 0 | 1 | `raw - 40` | 10 Hz |
| スロットル開度 [%] | `0x240` | 3 | 1 | `raw × 100 / 255` | 10 Hz |
| 吸気温 [℃] | `0x240` | 4 | 1 | `raw - 40` | 10 Hz |
| 燃料レベル [%] | `0x430` | 0 | 1 | `raw / 2.55`（要平滑化） | 10 Hz |
| クラッチ断 | `0x231` | 1 | bit1 | `1`＝踏み込み | 40 Hz |

**取得できないもの（実測で確認済み）**：**油温・油圧**。生CANにも標準OBD2 PIDにも存在しない。
追加センサーが必要。

---

## 5. OBD2（診断）仕様

| 項目 | 内容 |
|---|---|
| 要求ID | **`0x7E0`（物理アドレス）でそのまま応答する。`0x7DF`フォールバックは不要** |
| 応答ID | **`0x7E8` 単独**（レクサスUXのような複数ECU分担は無い） |
| 要求フォーマット | `02 01 <PID> 55 55 55 55 55`（パディング`0x55`で受理される） |
| 実測品質 | 55分で sent=165,543／resp=165,490／**timeout=53（0.032%）** |
| 実効レート | 20PIDを巡回して**1PIDあたり8.6 Hz**（`0C`/`0D`/`11`/`49`） |
| バス負荷 | 要求＋応答で**約107 frame/s** |

### 応答が確認できた mode 01 PID（20項目）

`04` 負荷 ／ `05` 水温 ／ `0B` 吸気管圧 ／ `0C` 回転数 ／ `0D` 車速 ／ `0E` 点火時期 ／
`0F` 吸気温 ／ `10` MAF ／ `11` スロットル ／ `1F` 始動後経過時間 ／ `33` 大気圧 ／
`34` O2広域AFR ／ `42` バッテリー電圧 ／ `43` 絶対負荷 ／ `44` 燃空比指令 ／
`45` 相対スロットル ／ `47` 絶対スロットルB ／ `49` アクセルペダルD ／
`4A` アクセルペダルE ／ `4C` 指令スロットル

**非対応**：**`5C`（エンジン油温）**。※レクサスUX（2022年式）では対応していたので車両差。

### 実測レンジ（55分）

車速 0〜110 km/h ／ 回転数 249〜3,439 rpm ／ 水温 77〜85℃ ／ 吸気温 22〜40℃ ／
バッテリー電圧 12.83〜13.93 V ／ 点火時期 -13.5〜48° ／ MAF 2.5〜39.5 g/s

> **`0x49` アクセルペダルDは、足を離した状態でも31.4%を下回らない**（ゼロ点にオフセットがある）。
> 走行41分で使われた範囲は 31.5〜40.0% の8.5ポイント分のみ。

---

## 6. 未解明項目の一覧

| # | 対象 | 現状 | 解くために必要なこと |
|---|---|---|---|
| 1 | `0x4B0` の左右 | 構造は確定、A側が左か右かのみ不明 | 一定舵角のまま左に1周 |
| 2 | `0x200` byte7 ／ `0x215` byte6 の式 | 比較相手で傾きが変わる | IG ONでペダルのみを全域掃引し、ペダル系とバルブ系を分離する |
| 3 | `0x240` byte0（負荷?）・byte2（点火時期?）・`0x201` byte6 | R²=0.6〜0.8で頭打ち | 同上 |
| 4 | `0x21A`・`0x39A`・`0x212` | 走行中は完全に不変 | 停車して単一操作（ドア・シートベルト・サイドブレーキ・灯火類）をON/OFF |
| 5 | `0x231` byte1 bit2 | bit1と必ず同時、低速の強い減速時 | 同上（特にブレーキ単独踏み） |
| 6 | `0x420` byte1/byte3/byte5/byte6 | OBDの20PIDに該当なし | 停車操作差分、または電動ファン作動の瞬間 |
| 7 | `0x4EC` byte4-5 | OBDの20PIDに該当なし | 外部基準（社外メーター等）との突合 |
| 8 | `0x200`/`0x215` の16bitフィールド群 | 10,050付近／590付近で微小変動 | 未着手 |
| 9 | `0x4F0`／`0x4F1` | 固定値 | ノーマル車との比較 |
| 10 | `0x201` の高回転域 | 実測は3,439 rpmまで | 8,000 rpmまで回した走行 |

---

## 7. 参考

- コミュニティ資料：[timurrrr/RaceChronoDiyBleDevice `can_db/mazda_mx5_nc.md`](https://github.com/timurrrr/RaceChronoDiyBleDevice/blob/master/can_db/mazda_mx5_nc.md)（`081`/`085`/`090`/`200`/`201`/`215`/`231`/`240`/`4B0` の9IDを収録）
- [Mazda CAN Bus – Madox.NET](http://www.madox.net/blog/projects/mazda-can-bus/)
- 本プロジェクト内：測定手順は`docs/manual/ncec_field_procedure.md`、解析の詳細と経緯は`docs/research/OBD2_SURVEY.md`「NCEC 追補」、
  車両横断の対照は`docs/research/vehicle_can_survey_summary.md`
