ntakao2006-web/RaceCapture/docs/design/brake_pressure_sensor_ncec.md

# NCEC のブレーキ圧センサー（候補とロガー側のつなぎ方）

作成日: 2026-11-09

NCEC（本番車両）は DSC が無いので、**ブレーキ圧は CAN のどこにも流れていない**（`docs/design/ncec_can_spec.md`・
`docs/design/logger_v2_channel_and_sensor_spec.md` 1-3。ON/OFF だけは取れている）。圧が欲しければセンサーを足すしかない。

オーナーは、ブレーキホースをエンドレスのステンメッシュに替えるとき（整備計画の段階1）に、**同じ日に付けたい**としている。

> **担当の切り分け**
> - **このファイル**：センサーの選び方、電源と信号、ロガー・センサーハブへのつなぎ方
> - **車両リポジトリ（ncec-roadster）の `maintenance/reliability-plan.md` 2-2**：ブレーキの油圧のどこに付けるか、継手、締付トルク、エア抜き・漏れの確認
>
> ブレーキの油圧に継ぎ目を1つ増やす改造なので、**付ける場所と継手の話はこちらに書かない**。

---

## 1. 候補：AiM Brake Pressure Sensor（M10）

> **2026-11-10 更新：付ける場所がマスターの出口（Mazda Motorsports の NC 用アダプター、センサーの口は 1/8″ NPT）に決まったので、センサーは下の M10 版ではなく NPT 版の `X05PSA02000P18FW` になる。**仕様は 3-1。M10 版の表は比べた記録として残す。

AiMShop（英国）の製品ページで確認した（2026-11-09）。

| 項目 | 値 | 出典 |
|---|---|---|
| 品揃え | **0-100 bar** と **0-160 bar**（ほかに PSI 表記の版もある） | [0-100](https://www.aimshop.com/ja/products/aim-brake-pressure-sensor-m10-0-100-bar)・[0-160](https://www.aimshop.com/ja/products/aim-brake-pressure-sensor-m10-0-160-bar) |
| 価格 | どちらも **£190.00**（英国の VAT を抜いた額。英国内は VAT 込み £228.00）。送料は £100 以上で無料と書かれている。**日本への送料・関税・輸入消費税は未確認** | 同上 |
| ねじ | **M10** か **-3 JIC（3/8-24 UNF）** を選ぶ | 同上 |
| 接続 | **Terminated**（AiM の 4ピン 719 binder オス）か **Unterminated**（線だけ）。パッチリード（719-719／712-719）は +£40 | 同上 |
| 電源 | **8〜16 V** | 0-160 の Technical Specs |
| 出力 | **0.5〜4.5 V** | 同上 |
| 変換 | ページの記載は「500 mV／0 bar、4500 mV／100 bar」。**0-160 bar のページにも 100 bar と書かれている**ので、160 bar 版の正しい変換式は**データシートで要確認** | 同上 |
| 精度 | ±0.5% FS 未満（非直線性とヒステリシスの合計） | 同上 |
| 消費電流 | 10 mA 未満 | 同上 |
| **使用温度** | **−20〜135 ℃** | 同上 |
| その他 | IP66、316 ステンレス、30 g、ケーブル 400 mm。0-160 の型番 `X05PSA00160B10K` | 同上 |

**日本の代理店の円の価格は見つからなかった**（2026-11-09 の検索）。

### 1-1. 選ぶときに決めること（未決定）

- **0-100 bar か 0-160 bar か**：NC の純正マスターで、強いブレーキのときに何 bar まで上がるかは**測った値が無い**。
  - 100 bar を超えると振り切れる
  - 160 bar にすると、同じ電圧の幅で分解能が 100/160 に落ちる
  - **NC の最大の圧の目安を調べてから決める**
- **Unterminated（線だけ）にするのが扱いやすい**：自作のロガー・センサーハブにつなぐので、AiM の 719 コネクターは要らない。センサーハブ側のコネクター（JST PA 3ピン）に付け替える。

---

## 2. ロガー側のつなぎ方 — **電源が 5 V では足りない**

AiM のセンサーは**電源が 8〜16 V** で、5 V では動かない。こちらの基板が出すセンサー用電源と合わないので、ここが一番の注意点。

| つなぎ先 | 信号（0.5〜4.5 V） | 電源（8〜16 V） |
|---|---|---|
| **汎用センサーハブ**（`sensorhub_generic_spec.md` 3-3） | アナログ入力は **0〜5 V** なので、そのまま測れる | 各ポートの1番ピンは**センサー用 5 V**なので**使えない**。**別に 12 V（キーオンで入る系統）を引く**。GND はハブと共通にする |
| **Defi 傍受基板の予備 J3**（`docs/design/sensorhub_defi_tap_design.md`、ADC2 の AIN2・AIN3） | ADS1115 は **+3V3 で動いていて**、J3 の1番ピンも +3V3。**4.5 V をそのまま入れると電源電圧を超える** → **分圧して 3.3 V 未満に落とす**必要がある | J3 には +3V3 しか無いので、**同じく別に 12 V を引く** |

- どちらにつなぐにしても、**12 V の引き回しとヒューズ**が要る。回路・電源は Lintarohさんの担当なので、つなぎ先が決まったら共有メモに載せる。
- 出力は 0.5 V が 0 bar なので、**0.5 V を下回ったら断線・電源切れと判定できる**（ロガー側の判定に使える）。

---

## 3. 取り付けの部品（参考。決めるのは車両リポジトリ側）

- [AiM のダブルバンジョーのアダプター（M10×1.0）](https://www.aimshop.com/ja/products/brake-pressure-sensor-adaptor-with-double-banjo-bolt-m10)：**£45**。キャリパー側のバンジョーボルトを置き換える形。
  **NC のバンジョーボルトのねじが M10×1.0 かは要確認**。
- **センサーの使用温度の上限は 135 ℃**。キャリパーのすぐそばに付けると、サーキットでその熱を受けて上限を超えるおそれがある（一般論。キャリパー温度は未測定）。ばね下で振動も大きい。
  → 車両リポジトリでは「**車体側（マスターの出口か、鉄パイプとホースの継ぎ目）のほうが無難**」と記録している。
- エンドレスのブレーキラインに「センサー用のブロックが付く製品がある」というオーナーの記憶は、**製品ページ・適合表でも、2026-10-01 改定後の全品番表でも確認できなかった**（単品にも無い）。ブロックを別に用意するなら、PLOT「スウェッジライン」の 3WAY ブロック・AN3 アダプターが候補で、**AiM センサーは -3 JIC（AN3）ねじの版を選べば AN3 のポートに付く**。詳細は車両リポジトリ側。

---

### 3-1. センサーのねじ先と、マスター用の既製アダプター（2026-11-10 の調べ）

- **AiM の M10 版の先は平ら**で、六角（対辺 19 mm）の下の座面のつば＋銅ワッシャーで止める形（[データシート](https://www.aimtechnologies.com/aim-support/sensors/Datasheet_Pressure0-160Bar_M10_102_eng.pdf)、ねじ部 8.2 mm）。ブレーキ配管のフレアの座（PLOT の「メス凸」など）にはそのまま付かない
- **Mazda Motorsports が NC のマスターの出口用のアダプター（DSC なし `0000-03-5302`）を出していて、センサーの口は 1/8″ NPT**。これを使うなら M10 版ではなく **NPT 版のセンサー**になる。同社の指定は 0-2000 psi のセンサー `0000-10-9314`（AiM 向けのパッチハーネス `0000-10-9315`）。中身がどこのセンサーかは同社の資料に書かれていない
- **付ける場所はマスターの出口に決定（2026-11-10、オーナー）**。付け方は車両リポジトリ（ncec-roadster）の `maintenance/reliability-plan.md` 2-2 が正

**使うセンサー：AiM `X05PSA02000P18FW`（0-2000 psi、1/8″ NPT、線だけの版）**。AiM の 1/8″ NPT で 2000 psi はこれだけで、Mazda の `0000-10-9314` もおそらくこれ（推測）。AiM 719 コネクター付きは `X05PSA02000P18K`。

| 項目 | 値 | 出典 |
|---|---|---|
| 範囲 | **0〜2000 psi（＝0〜137.9 bar）** | [AiM データシート（Release 1.02）](https://aim-sportline.com/download/doc/eng/sensors/pressure/Datasheet_CarBike_PressureSensors_eng.pdf) |
| 電源 | **8〜16 V**（M10 版と同じ。2章のとおり 12 V を別に引く）、10 mA 未満 | 同上 |
| 出力 | 0 psi で 0.5 V、2000 psi で 4.5 V。直線とみなすと **P[psi] = (V − 0.5) × 500**、P[bar] ≒ (V − 0.5) × 34.47（式はこちらで出したもの。データシートには両端の値だけ。比例出力かは書かれていない） | 同上 |
| 精度・耐圧 | ±0.5% FS 未満、定格の3倍 | 同上 |
| 使用温度 | −20〜135 ℃（マスターの出口なので、キャリパーの熱の心配は無い） | 同上 |
| 配線 | 1＝信号（白）、2＝GND（黒）、3＝+Vb（赤）、4＝空き（719 の4ピン。線だけの版も色は同じとみられる） | 同上 |
| 価格 | $159.99〜165.99（米国の販売店、P18K） | [BimmerWorld](https://www.bimmerworld.com/Gauges-Data-Acquisition/Data_Gauge_Sensors/AiM-Data-Ka-0-2000Psi-Brake-Pressure-Sensor-1-8-Npt.html) ほか |

- **範囲の悩み（1-1）はこれで片付く**：AiM に 0-160 bar の NPT 版は無く、0-2000 psi（約138 bar）を使う。100 bar で振り切れる心配は減り、分解能は 0-160 bar 版より少し良い
- 古い型 `X05SNP13520`（0-2000 psi、M10、電源 10〜30 V・出力 1〜5 V）は別物なので取り違えない

---

## 4. 未確定・要確認

| # | 項目 | 状態 |
|---|---|---|
| 1 | 0-100 bar と 0-160 bar のどちらにするか（NC の最大の圧の目安） | 未調査 |
| 2 | 0-160 bar 版の正しい変換式（データシート） | 未確認 |
| 3 | 日本への送料・関税・輸入消費税、国内の代理店 | 未確認 |
| 4 | つなぎ先（汎用センサーハブか、Defi 傍受基板の J3 か）と、12 V の引き回し | 未決定。回路担当と相談 |
| 5 | 付ける場所と継手（車両リポジトリ側） | **場所は決定（2026-11-10）：フロントのホースと鉄パイプの継ぎ目（車体側）にブロックを挟む**。ばね上なのでキャリパーの熱・振動を避けられ、センサーの線もハンドル・サスペンションと一緒に動かない。継手の細部は車両リポジトリ側で要確認。**→ 同日に変更：継ぎ目に入れると継ぎ目が約5か所増え、M10 版のセンサーの口の変換も決まらないため、マスターの出口（NC 用アダプター、3-1）に決定** |
| 6 | NPT 版センサーの電源・出力・変換式 | **確認（2026-11-10）**：8〜16 V、0.5〜4.5 V＝0〜2000 psi（3-1）。1・2の行は NPT 版では「0-2000 psi に決まり」「両端の値は確認済み」 |
