ntakao2006-web/RaceCapture/docs/design/enclosure_ecorun_20261024.md

# エコラン大会（2026-10-24・25）用 筐体の設計メモ

> 2026-10-17起票（ER-9-7）。3Dプリントでちゃんと作る（ユーザー判断）。Ver.2（本命）と、できればVer.1（保険）も。
> 設計はユーザーが行う。このファイルは設計に入るための材料（寸法・入れる物・要件・未確定事項）を集めたもの。
> 耐衝撃の考え方は`docs/design/case_shock_design.md`（スポンジテープ＋基板側突起の位置決め方式、2026-08-18決定）を引き継ぐ。

## 1. 日程

| 日 | 内容 |
|---|---|
| 10/18 | LTE試験（ER-7-5）。筐体無しで行う。**この日にVer.2一式の実物を測る**（3章の要実測） |
| 10/19〜20 | 設計・1回目の印刷 |
| 10/21 | 組み込みと通しリハーサル（ER-4-1）。合わなければ直して再印刷 |
| 10/22 | 機能追加の締め切り（ソフト）。筐体もここで確定 |

印刷時間が長い場合は、Ver.2を先にして、Ver.1は間に合わなければ仮固定にする。

## 2. 入れる物

### Ver.2（本命）

| 物 | 寸法・ファイル | 備考 |
|---|---|---|
| UNO Q | `circuit/logger_v2/UNO Q simplified.stp` | 下段。USB-C 1口にドックがつながる |
| シールド（logger_v2） | 外形 70.5×53.4mm、板厚1.6mm。`circuit/logger_v2/logger_v2.step` | UNO Qの上に重ねる。**このSTEP（9/24）が実物と同じ版かは要確認**（Lintarohさん製） |
| USB-Cドック | 型番未記録 | PD給電パススルーで、UNO Qの電源もここから入る。USB-AにUSBオーディオ |
| USBオーディオ | 「USB Lavalier Mic Pro」 | ドライバーのイヤホン・マイクの線が出る |
| LTEアンテナ | FXUB63（貼り付け、SMA） | 箱の外に貼る。ケーブルの出口が要る |
| GNSSアンテナ | 型番未記録（SMA） | 空が見える位置。箱の上面か外 |
| SIM・microSD | シールド上（SIM：nanoSIMヒンジ式J8、SD：Molex 47219-2001 J12） | 大会中にSDを抜くので、**SDは蓋を開けずに抜けるのが望ましい** |

シールドの主な縁の部品（シールドの左上を原点、mm）：

| 部品 | 位置 | 向き・要る穴 |
|---|---|---|
| SMA×2（J7・J10） | 左端 y=35.4・44.4 | 横向き。左面に穴2つ |
| Micro-Fit 3.0×2（J6・J9） | 左端 y=15.3・27.3 | 横向き。外部CAN・車載CAN。大会で使う方だけ穴でもよい |
| microSD（J12） | 右端寄り x=62.8, y=22.2 | 差し込み口の向きはSTEPで確認 |
| LED×7 | 上端 y=2.0（x=3.1〜18.5） | 0805。見えるように窓かライトパイプ |
| BNO055（IMU） | x=42.8, y=7.6 | **箱の中で動かない・傾かないこと**（加速度の向きが変わる） |
| GNSSモジュール（MAX-M10M） | x=18.5, y=47.6 | アンテナは外付けなので、上を金属で覆わなければよい |

### Ver.1（保険）

| 物 | 寸法・ファイル | 備考 |
|---|---|---|
| logger_v1基板 | 外形 70.6×100.0mm、板厚1.6mm。`circuit/logger_v1/logger_v1.step`（8/19版） | 取付穴：M3×4（(5.6,5.0)・(65.6,5.0)・(5.6,82.5)・(65.6,95.0)）、M2×2（(13.1,5.0)・(13.1,82.5)）。**STEPが実物と同じ版かは要確認** |

縁の部品（左上原点、mm）：USB-C×2（J2電源・J6、左端 y=14.1・32.9）、Micro-Fit×2（J5車載・J4ハブ、左端 y=46.5・58.0）、SMA（J7 GNSS、左端 y=72.2）、
microSD（J3、x=49.5, y=17.3）、LED×8（下端 y=97.5、3mm砲弾型、x=4.6〜57.1）、BNO055（x=68.3, y=14.9）。

**大会での注意**：Ver.1は記録を終えるのにPCから`SD_Eject.cmd`が要る（ER-6-1で電源断だけで終われるか確認中）。SDの抜き差しが要るので、Ver.2と同じくSDに手が届く作りがよい。

## 3. 要件

1. **振動でコネクタが抜けない**：エコランの車両はサスペンションが無く、衝撃がそのまま来る（`docs/design/case_shock_design.md` 1章）。特に**UNO QのUSB-C（ドック）**、SMA、USBオーディオのプラグ。ケーブルは箱の出口で固定（結束バンドを掛ける爪など）して、コネクタに力が掛からないようにする
2. **熱**：UNO Q（Linux側）は動かしているとかなり温まる。日なたの車内はさらに熱くなる。**PLAは60℃前後から柔らかくなる**ので、手元にあれば**PETGかASA**の方が安心。通気穴を設け、ドックもUNO Qに密着させない
3. **アンテナ**：GNSSは空が見えること。LTEは貼り付け型なので箱の外。どちらも金属（車体・フレーム）で上を覆わない
4. **操作**：SDの抜き差し、電源の抜き差し、LEDの確認が、チームメンバーでも迷わずできる（ER-5-2の手順書と合わせる）
5. **IMUの向き**：BNO055が載った基板は箱の中でガタつかず、箱は車体に対して決まった向きで固定する。向きは記録して設定と合わせる
6. **車への固定**：どこにどう付けるか（4章の未確定）

## 4. 未確定（設計に入る前に決める・測る）

- [ ] **車のどこに付けるか**（置き場所の寸法、固定方法：ボルト・結束バンド・面ファスナー等）
- [ ] Ver.1とVer.2を**1つの箱に入れるか、別々にするか**
- [ ] 手元の3Dプリンターで使える材料（PLAだけか、PETG・ASAもあるか）と、印刷できる最大の大きさ
- [ ] **ドックの型番と実寸**、ドックとUNO Qのつなぎ方（ケーブル付きか、直挿しか）
- [ ] GNSSアンテナの型番と、箱に載せるか外に出すか
- [ ] シールドとVer.1基板が、リポジトリのSTEPと同じ版か（実物を測って確かめる）
- [ ] UNO Qとシールドを重ねた全体の高さ（ピンヘッダーの長さで変わるので実物を測る）
- [ ] 電源の入り方（シガーソケット充電器→ドック、Ver.1はUSB-A。`ARCHITECTURE.md`の車両側の給電構成を参照）と、ケーブルの取り回し
