ntakao2006-web/RaceCapture/docs/share/hardware_share_20260915.md

# 回路担当への共有（2026-09-15）— 前回共有以降に確定したこと

> **この文書の位置づけ**：回路担当と話した論点のうち、**その後の実測で仕様として決まった／明らかに
> なったこと**を1枚にまとめ、**根拠となる資料の場所**まで案内するためのもの。
>
> **基準点**：回路担当向けサマリ `docs/research/vehicle_can_survey_summary.md` の最終更新は **2026-09-06** で、
> そこには**NCEC 55分走行キャプチャまで**が反映されている。本書はそれ以降
> （**2026-09-10 の Ver.1基板まわり**、**2026-09-12 の NCEC 2回目実車**）に確定した内容の差分＋
> 「バス負荷」「どのCANに何が何Hzで載るか」の論点を、判断材料として1か所に集めたもの。
>
> **確度の書き分け**：**確定**＝実測で式・値まで検証済み／**示唆**＝相関はあるが確定していない／
> **未解明**＝意味不明。推測を確定として書かない。
>
> 回路の入出力仕様そのもの（コネクタ・電源・基板一覧）は `docs/design/hardware_interface_spec.md` が本体。
> 本書はそこへ**追記・訂正が必要な点**を4章に挙げている。

---

## 0. 先に3行

1. **車両バスの帯域は余っている。** NCECのHS-CANは走行中 **692 frame/s**、自作ロガーのOBD2
   ポーリングを足して **799 frame/s**。**500 kbps に対する占有は約18〜20%** で、残り約8割が空き。
   → 追加センサーのCANハブを同じバスへ載せる判断材料として、これが実測の出発点になる。
   （※前回サマリに書いた「実効約450 kbit/s相当の占有」は**過大で、訂正が必要**。4-5参照）
2. **どのIDに何が何Hzで載っているかは、16ID全部が実測で確定した。** 周期から逆算した合計が
   実測の692 frame/sと**ぴたり一致**する（1-2の内訳表）。ロガーが取り出せる確定チャンネルは17項目。
3. **`0x4B0` の4輪は定常円旋回で全て確定した**（`[左前, 右前, 左後, 右後]`）。走行データからは
   原理的に解けなかった最後の項目で、**駐車場で左右40秒ずつ回るだけ**で片付いた。

---

## 1. バス負荷（論点①）

### 1-1. 実測値

| 条件 | レート | 備考 |
|---|---|---|
| 走行中・外部機器が何も送信しない受動区間 | **692 frame/s** | 車両が出している分だけ |
| 走行中・自作ロガーがOBD2をポーリング中 | **799 frame/s** | 上に自分の往復が乗った状態 |
| 差分（＝自分で足した分） | **約107 frame/s** | `0x7E0`要求と`0x7E8`応答で各約53/s |
| IG ON・**エンジン停止**（2026-09-12） | **747 frame/s** | エンジンを切ってもCANは通常どおり流れる |

**全フレームがDLC=8**（キャプチャCSVの`dlc`列を全数集計して確認）。

**この条件で 55分・2,611,844フレームを取りこぼし0・buserr=0 で記録できている。**
さらに `0x211` byte7 のローリングカウンタ246,009件を全数照合し、増分が**100.0000%が+1**＝
**車両側ECUが発行した連番による外部検証**で欠落ゼロを裏付けてある（ロガーの自己申告ではない）。

### 1-2. 692 frame/s の内訳（周期から逆算したものと実測が一致する）

| 周期 | ID | 本数 | frame/s |
|---|---|---|---|
| 100 Hz | `0x200` `0x201` `0x215` `0x4B0` `0x211` | 5 | 500 |
| 50 Hz | `0x21A` | 1 | 50 |
| 40 Hz | `0x231` `0x4EC` | 2 | 80 |
| 10 Hz | `0x240` `0x420` `0x4FF` `0x212` `0x430` `0x39A` | 6 | 60 |
| 1 Hz | `0x4F0` `0x4F1` | 2 | 2 |
| | **合計** | **16** | **692** |

→ **観測できていない隠れIDは無い**と言い切ってよい。

### 1-3. ビット占有率（回路側の判断に必要なのはこちら）

クラシックCAN・11bit標準ID・8データバイトのフレームは**公称111ビット**（SOF〜IFS込み）。
ビットスタッフィングで最大+19ビット程度。

| 状態 | 計算 | 占有率（500 kbps） |
|---|---|---|
| 車両だけ（692 f/s） | 692 × 111 ≒ **76.8 kbit/s** | **約15%**（スタッフィング込みで約18%） |
| ＋自作ロガーのOBD（799 f/s） | 799 × 111 ≒ **88.7 kbit/s** | **約18%**（同 約20%） |

**空きは概算で 400 kbit/s 前後**。ただし実務上は、CANの調停特性から**占有率が上がるほど
低優先度IDの遅延ジッタが悪化する**ため、「空いている＝全部使ってよい」ではない。
**どこまで足すかの線引きは回路担当の判断を仰ぎたい**（5章）。

> **重要**：追加センサーのCANハブを**車載バス（OBD2側）へ載せる**のか、**外部CAN（自作バス）側へ
> 載せてロガーが中継する**のかで話がまったく変わる。現在の設計方針は後者（ロガーが車載CAN⇔
> 外部CANのゲートウェイを兼ねる）で、その場合**車両バスへ足すのはロガーのOBD要求だけ**になる。
> 上の余裕の話は「もし前者にするなら」という条件つきの数字。

### 1-4. 帯域を食う追加要素（2026-09-12に判明）

**このECUは mode 22（ReadDataByIdentifier）にも応答する。** 標準PIDに無いECU内部変数へ
到達できる経路が1つ増えた一方、**ポーリングはバス負荷とECU負荷を増やす**。
実用時は必要なDIDだけに絞る運用とする（詳細は2-4）。

> 参照：`docs/design/ncec_can_spec.md` 1章・5章 ／ `docs/research/vehicle_can_survey_summary.md` 5章 ／
> `docs/research/OBD2_SURVEY.md`「NCEC 追補」

---

## 2. どのCANに・どの情報が・何Hzで載るか（論点②）

論点が3層に分かれるので、層ごとに分けて書く。

### 2-1. 【車両側 HS-CAN】受信できる確定チャンネルと更新レート

**バス諸元**：ISO 15765-4 CAN、11bit標準ID、**500 kbps**、OBD2の**6番=CAN_H／14番=CAN_L／
5番=Signal Ground**。**車両バスは両端終端済みなので外部機器側に120Ωを付けない**。
**2バイト値はすべてビッグエンディアン。**

| 物理量 | CAN ID | offset | 幅 | 式 | **更新レート** |
|---|---|---|---|---|---|
| エンジン回転数 [rpm] | `0x201` | 0 | 2 (BE) | `raw / 4` | **100 Hz** |
| 車速 [km/h] | `0x201` | 4 | 2 (BE) | `raw / 100 - 100` | **100 Hz** |
| ホイールスピード **左前** [km/h] | `0x4B0` | 0 | 2 (BE) | `raw / 100 - 100` | **100 Hz** |
| ホイールスピード **右前** [km/h] | `0x4B0` | 2 | 2 (BE) | 同上 | **100 Hz** |
| ホイールスピード **左後**（駆動輪） | `0x4B0` | 4 | 2 (BE) | 同上 | **100 Hz** |
| ホイールスピード **右後**（駆動輪） | `0x4B0` | 6 | 2 (BE) | 同上 | **100 Hz** |
| アクセルペダル開度 [%] | `0x200` | 7 | 1 | `raw × 0.2144 + 30.68` | **100 Hz** |
| アクセルペダル開度（冗長） | `0x215` | 6 | 1 | 同上（`0x200` byte7と同一値） | **100 Hz** |
| ブレーキペダル | `0x200` | 6 | bit0 | `1`＝踏み込み | **100 Hz** |
| A/C要求 | `0x215` | 7 | bit6 | `1`＝A/C ON | **100 Hz** |
| クラッチ断 | `0x231` | 1 | bit1 | `1`＝踏み込み | **40 Hz** |
| 水温 [℃] | `0x240` | 1 | 1 | `raw - 40` | **10 Hz** |
| 水温（冗長経路）[℃] | `0x420` | 0 | 1 | `raw - 40` | **10 Hz** |
| スロットルバルブ開度 [%] | `0x240` | 3 | 1 | `raw × 0.3938 - 0.342` | **10 Hz** |
| 吸気温 [℃] | `0x240` | 4 | 1 | `raw - 40` | **10 Hz** |
| 燃料レベル [%] | `0x430` | 0 | 1 | `raw / 2.55`（要平滑化） | **10 Hz** |
| パーキングブレーキ | `0x39A` | 0 | bit3 | `1`＝引いている | **10 Hz** |

**読み方のポイント**

- **速度・回転数・ペダル系は100 Hz で来る**。ロガー側のログレートを100 Hzにしても、車両側が
  律速にならない（現行ファームのSD書き込みも100 Hz CSV）。
- **温度系は10 Hz**。ここを上げる手段は車両側には無い。
- **燃料レベルは走行中にGで油面が揺れて大きくばらつく**（標準偏差：低速域24.4 / 停車時7.2）。
  ECUの平滑化前の生値に近いとみられるので、**ロガー側で移動平均をかける前提**。
- **アクセルペダルとスロットルバルブは別物**（この車両はメカフィーリングスロットルマップで
  意図的にズラしてある。ゲイン約1.93倍、ペダルストロークの約8割で全開に達する）。

### 2-2. 【車両側 HS-CAN】この配線では**取れない**もの（設計判断に直結）

| 項目 | 状況 |
|---|---|
| **油温・油圧** | **生CANにも標準OBD2 PIDにも存在しない**（油温PID `5C` は非対応を再確認）。→ **追加センサー＋CANハブという既存方針の根拠が実測で固まった** |
| **ウィンカー・ハザード・ドア開・シートベルト・ヘッドライト・ワイパー** | 停車中に**12種の操作差分**を取ったが**1ビットも動かなかった**（2026-09-12）。OBD2ポートに来ているのはパワートレイン系CANで、車体系は**別バス（ボディCAN）**にあるとみられる。**この配線では原理的に取得できない** |
| 舵角 `0x081` ／ ブレーキ圧 `0x085` ／ 加速度 `0x090` | **DSC搭載車（2007年以降）限定**。本車両はDSC非搭載のため観測されず |

> ⚠️ **3番・11番ピンには触らないこと。** マツダ車ではここにMS-CAN(125 kbps)が来ている場合があり、
> 6番/14番と導通させると2系統直結になって双方でエラーフレームが連発し、ノードがバスオフに陥る
> （車両側の警告灯・DTC・フェイルセーフを誘発する）。別バスを見たい場合は**コネクタ内の圧着端子の
> 移設**で行う。

### 2-3. 【OBD2 診断】こちらから要求するレート（自分で決められる部分）

| 項目 | 内容 |
|---|---|
| 要求ID / 応答ID | **`0x7E0` でそのまま応答／`0x7E8` 単独**（`0x7DF`フォールバック不要） |
| 要求フォーマット | `02 01 <PID> 55 55 55 55 55`（パディング`0x55`で受理される） |
| 実測品質 | 55分で sent=165,543／resp=165,490／**timeout=53（0.032%）**／txerr=0 |
| バス負荷 | 要求＋応答で**約107 frame/s** |

**現行ファームの要求レート設計**（`firmware/can_obd_logger/src/main.cpp` の `PID_TABLE`）：

| 群 | PID | 要求周期 | 実効レート（実測） |
|---|---|---|---|
| 高レート | `0C`回転数 / `0D`車速 / `11`スロットル / `49`アクセルペダルD | 100 ms（10 Hz要求） | **各 8.6 Hz** |
| 〃 | `04` 負荷 | 200 ms | — |
| 低レート | `05`水温 / `0E`点火時期 / `0F`吸気温 / `0B`吸気管圧 / `10`MAF / `45`相対スロットル / `4A`ペダルE / `5C`油温 / `47`絶対スロットルB / `4C`指令スロットル / `43`絶対負荷 | 1000 ms | 約1 Hz |
| 〃 | `42`バッテリー電圧 / `44`燃空比指令 / `34`O2広域AFR | 2000 ms | 約0.5 Hz |
| 〃 | `33`大気圧 / `1F`始動後経過時間 | 5000 ms | 約0.2 Hz |

- **要求10 Hz に対して実効8.6 Hz**＝要求が詰まっているわけではなく、20 PIDを巡回する分の間引き。
- **応答しないPIDは自動バックオフ**（最大64倍まで間隔が伸びる）ので、非対応車で回しても
  高レート群のレートをほとんど食わない。
- **OBDで取れるものは、ほぼ生CANでも取れて、しかも生CANの方が速い**（回転数・車速は100 Hz）。
  **OBD2は基準値照合用**という位置づけでよい。

### 2-4. 【OBD2 mode 22】ECU内部変数（2026-09-12に到達、新規）

| 項目 | 内容 |
|---|---|
| 要求 / 応答 | `03 22 <DID_H> <DID_L> 55 55 55 55` → `62 <DID_H> <DID_L> <値…>` |
| DIDの体系 | **mode 01 のPID番号そのもの**（`0x00xx`）。`0xF4xx`は`7F 22 31`で拒否 |
| 走査済み | `0x0000`-`0x0FFF`（4,096個）→ **51個が肯定応答**。うち`0x0000`-`0x004C`は標準PIDのミラー |
| 収穫 | **標準PIDに無い内部変数が12個**（`0x09xx`系）。`0x096E`＝回転数の別表現、**`0x0967`＝A/C ON/OFFに完全連動する離散フラグ** |

> ⚠️ **運用ルール（安全側）**：ポーリングはバス負荷・ECU負荷を増やすので**実用時は必要なDIDだけ**。
> **未知DIDの総当たりは停車時のみ**、走行中は行わない。**読み出し専用サービス（`0x22`）だけを使い、
> 書き込み系サービスは一切叩かない。**

### 2-5. 【外部CAN（自作バス）】ここが**まだ決まっていない**

現在の方針は「**ロガー本体が車載CAN⇔外部CANのゲートウェイを兼ねる**」＝車載CANから受けた値と
ロガーが計算したチャンネル（ラップタイム等）を外部CANへ中継送信する構成。
バス構成は **CAN-H / CAN-L / 5V / GND の4線**、幹線1本＋スタブ分岐、終端120Ω×2は**幹線の物理両端**。

**未確定（＝今回いちばん相談したいところ）**

- **メッセージID の採番ルール**（ロガー送信分・センサーハブ分・アクセサリー分の割り当て）
- **1フレームに詰める値の数とスケーリング**
- **チャンネルごとの送信レート**（例：シフトインジケーター用の回転数はタコメーター相当の
  応答速度が要る＝50〜100 Hz級、油温・油圧は1〜10 Hzで足りる、など）
- **外部CANのビットレート**（車載CANと同じ500 kbpsにするか）

これはロガー側ではPhase 6-3-1（`task_phase6_breakdown.md`）として**未着手**のまま。
**センサーハブの台数・載せる量が決まらないとレート設計ができない**ので、5章の相談事項とセットで
決めたい。

> 参照：`docs/design/ncec_can_spec.md` 2章・4章・5章 ／ `docs/design/hardware_interface_spec.md` 1章#3・5章 ／
> `task_phase6_breakdown.md` 6-3

---

## 3. 定常円旋回による4輪ホイールスピードの特定（論点③）

### 3-1. 結論

**`0x4B0` ＝ `[左前(FL), 右前(FR), 左後(RL), 右後(RR)]`**（各2バイト・ビッグエンディアン、
式はいずれも `raw / 100 - 100` [km/h]、100 Hz）。**コミュニティ資料と同じ順序**だった。
2026-09-12に**実測で確定**。走行データからは原理的に決まらなかった最後の1項目。

### 3-2. どうやって決めたか（3段階）

**① 前後軸の判定（走行データから／2026-09-06）**
NCECはFR（後輪駆動）。加速時は駆動輪が路面に対して先行し、4輪平均より速く回る。
各バイトペアの偏差と縦加速度の相関は
byte0-1: **-0.320** ／ byte2-3: **-0.259** ／ byte4-5: **+0.291** ／ byte6-7: **+0.325**。
符号が2対2で割れ、**正の側が駆動輪＝後軸**。

**② 左右の「組」分け（走行データから）**
旋回時の左右差（ヨーレート×トレッド）は前軸と後軸に共通して現れる。
{byte0-1, byte2-3}と{byte4-5, byte6-7}を車軸とみなしたときの左右差どうしの相関は **+0.567**、
対角に切ると **+0.109** で消える。相関が正 ＝ **`byte0-1`と`byte4-5`が同じ側**、
**`byte2-3`と`byte6-7`が同じ側**。ただし**どちらが左でどちらが右かは、これでは決まらない**。

**③ 左右の確定（定常円旋回／2026-09-12、キャプチャ`ncec_lr2`）**
駐車場で**一定舵角のまま左旋回40秒 → 切り返し10秒 → 右旋回40秒**を実施。
切り返し区間は独立フェーズとして**解析時に破棄**した。旋回では外輪が速く回る。

| フェーズ | byte0-1 | byte2-3 | byte4-5 | byte6-7 | 外輪は |
|---|---|---|---|---|---|
| 左旋回 | 8.071 | **10.938** | 6.335 | **9.673** | 右側 |
| 右旋回 | **13.291** | 9.842 | **11.800** | 7.885 | 左側 |

単位km/h、各33秒・3,304サンプルの平均。**左右の旋回で大小がきれいに反転**し（前軸・後軸とも）、
差は **2.9〜3.9 km/h** と明確。→ **byte0-1・byte4-5が左、byte2-3・byte6-7が右**。

**所要時間は実質4分**（左右40秒ずつ＋切り返し）。**広い場所さえあれば安いテスト**なので、
別車両でも同じ手が使える。

### 3-3. 副産物：走行キャプチャで初めてUSB瞬断を経験した（回路・機構への申し送り）

- 1回目の試行は開始11秒で `serial lost`（`PermissionError(13)`）となり、**旋回区間が丸ごと欠落**した。
- **CAN側は正常**で、**振動によるUSB接続の瞬断**が原因とみられる。
- **再接続後も基板が無応答のまま**で、**USBとDC電源を両方落として再起動するまで復旧しなかった**。
- **`serial reconnected` と表示されてもデータが流れているとは限らない**（`status.log`が0バイトに
  なる状態がある）。

**以後の運用**：走行を伴うキャプチャでは①USBケーブルを確実に固定、②本番前に短い疎通確認を1本、
③`serial lost` が出たら即中断して基板を再起動する。
**→ 本番機の筐体・コネクタ設計では、USBコネクタの機械的固定（ストレインリリーフ）を
   要件として見てほしい。**

> 参照：`docs/design/ncec_can_spec.md` 3章「`0x4B0`」 ／ `ARCHITECTURE.md` 4章の2026-09-12追記 ／
> 生データ `ncec_lr2_p2_lr_left_nx.csv` / `ncec_lr2_p4_lr_right_nx.csv`

---

## 4. 回路側に直接効く確定事項・訂正（前回共有以降）

### 4-1. Ver.1基板 `ecologger_v1` が完成し、実車へ持ち込める状態になった（2026-09-10）

**PCB第1版がそのまま動作確認まで到達し、版の切り直しは発生していない。**
搭載構成：ESP32-S3-WROOM-1-N16R8 ／ GNSS=MAX-M10M-00B（高性能クロックOTP実施済み、**25 Hz実測**）／
IMU=BNO055（I2C GPIO17/18、100 Hz）／**車載CAN=ATA6561＋内蔵TWAI** ／
**外部CAN=MCP25625（SPI）** ／ microSD。

### 4-2. 部品の正は **ネットリスト `logger_v1.net`**（BOM csvは古い）

`circuit/logger_v1/logger_v1_bom.csv` は**基板製造前の古い版**で、リファレンス番号も部品も現物と
食い違っている。**以後、部品の正は `logger_v1.net` と `logger_v1.kicad_pcb`**（JLCPCBへ出した
`JLCPCB_20260819` と同じ設計）とする。
→ PPTCヒューズ(LVR200S)・1N5819・LM2940T-3.3・DF2S23P2CTC は**現物に載っていない**。
　 正しくは USB-C(J2)のVBUS → `TCKE800NL`(U5, eFuse) → `NJM2845DL1-05`(U1) / `BP5293-33`(U4)、
　 +5Vは `OKL-T/6-W12N-C`(U6)、CANラインのESDは `PEC3824C2A-AU`(D2/D3)、整流 `PMEG4010CEGWJ`(D1)。

### 4-3. CANコネクタは **Molex Micro-Fit 3.0（43045-0400、4回路）** ／ pin1は**+5V出力**

| コネクタ | 用途 | トランシーバ | 終端 |
|---|---|---|---|
| **J5** | **車載CAN（OBD2タップ）** | `ATA6561-GAQW-N`（U8、TWAI直結） | **R35** |
| **J4** | 外部CAN（センサーハブ用） | `MCP25625T-E/SS`（U7、SPI一体型） | R27 |

ピン配置は両者共通で **pin1=+5V ／ pin2=CANH ／ pin3=CANL ／ pin4=GND**。

> ⚠️ **pin1の+5Vは基板からの「出力」**（U6のVOUTがJ4.1・J5.1と両トランシーバのVCCへ供給）。
> **車両側ハーネスでpin1をOBD2の16番（常時12V）へ絶対に結線しない。** 車載CANで使うのは
> pin2/3/4の3本だけ。**挿し間違えると車両バスがMCP25625側へ行くので必ずJ5**。

### 4-4. ⚠️ **終端R35：仕様書と実回路が食い違っている（要判断）**

`docs/design/hardware_interface_spec.md` 3章-1 は「車載CAN側の終端抵抗(R41)は**ハンダジャンパーで切替可能**」
と書いてあるが、**ネットリスト上のR35はJ5のCANH-CANL間へジャンパ無しで直付け**されている
（実際は**未実装＝DNPで切り替える方式**とみられる）。リファレンス番号も R41→**R35** が正しい。

**効いてくる理由**：車両バスは両端終端済みで合成60Ω。R35が生きていると**40Ω**まで落ち、
CANの規格（最低45Ω程度）を外れる。

**現場での確認手順**（実車接続前に必ず実施する運用にした）：基板の電源を切り、テスタで
**J5の2番-3番間**を測る。**開放＝未実装＝そのまま接続可**／**約120Ω＝実装済み＝車両バスへ繋がない**。
（車両側はIG OFFでOBD2の6番-14番が約60Ωなら正常。）

→ **回路担当への確認事項**：R35はDNP前提で出図されているか、それとも実装されているか。
　 仕様書側の記述（ハンダジャンパー方式）は実回路に合わせて訂正してよいか。
　 なお **4-2（終端抵抗・ノイズフィルタの最適化）はロードマップ上も未完了のまま**にしてある。

### 4-5. ⚠️ 前回サマリの**バス占有率の記述が過大**（訂正提案）

`docs/research/vehicle_can_survey_summary.md` 5章・6-2章に「799 frame/s（8バイトフレームで**実効約450 kbit/s
相当のバス占有**）」とあるが、**公称111ビット/フレームで計算すると約88.7 kbit/s＝占有率約18%**
（スタッフィング込みでも約20%）。**450 kbit/s は過大**で、帯域の判断を誤らせる。
本書1-3の数字で差し替えたい。

### 4-6. 2台を同じCANバスへ並列にぶら下げるときの注意（解析基板＋`ecologger_v1`）

- **スタブは短く**：Y字に割る位置はOBDコネクタのすぐ近くにし、そこから**各30cm以内**で2台へ分ける。
- **終端は両方とも無効**（車両バスが既に両端終端済み。4-4の確認を両基板について行う）。
- **2台が同時にOBD要求を送らない**設定にする（`ecologger_v1`側は `obdEnabled=false`、
  送信するのは解析基板だけ）。**送信の衝突は再送・エラーフレームの原因になる。**

### 4-7. 現行ファームの制約（実装側の話だが、期待値のすり合わせとして）

`firmware/logger_v1` の NCEC専用プロファイル（`ncProfile`）は
**`!obd_enabled && !toyota_steering` のときだけ動く排他条件**になっており、
**生CANデコードとOBDポーリングを同時に使う運用は現行実装ではできない**
（機上で基準値照合をしたい場合は解析用の `firmware/can_obd_logger` を使う）。

> 参照：`ARCHITECTURE.md` 4章の2026-09-10追記・訂正 ／ `ncec_next_session_checklist.md` ／
> `docs/design/hardware_interface_spec.md` 3章

---

## 5. 判断・確認をお願いしたいこと

| # | 内容 | 判断材料 |
|---|---|---|
| 1 | **R35（車載CAN終端）はDNPか実装済みか。** 仕様書の「ハンダジャンパー方式」を実回路に合わせて訂正してよいか | 4-4 |
| 2 | **追加センサーのCANハブをどちらのバスへ載せるか**（車載CANへ直接 or 外部CANでロガー中継）。車載側へ載せる場合、占有率どこまでを上限とするか | 1-3、2-5 |
| 3 | **外部CANのID採番・フレームフォーマット・チャンネル別送信レート**。とくにシフトインジケーター用の回転数に必要な応答速度 | 2-5 |
| 4 | **油温・油圧センサーの型番選定とアンプ要否**（センサー側がmV級なら計装アンプが要る）。**取れないことは実測で確定済み**なので、ここがボトルネック | 2-2、`docs/design/hardware_interface_spec.md` 6章 |
| 5 | **車体系（ウィンカー・ブレーキランプ等）はOBD2ポートからは取れない**と確定した。これらをログしたい場合、**別バスへのタップか、専用のデジタル入力を回路側に持つか**の方針判断 | 2-2 |
| 6 | **USBコネクタの機械的固定（ストレインリリーフ）**を筐体・基板側の要件に入れたい | 3-3 |
| 7 | **本番機のマイコン**：実車実証はESP32-C3（解析基板）とESP32-S3（`ecologger_v1`）で実施済みだが、**S3での長時間走行キャプチャはまだ**。次回実車で並行記録して確認する予定 | — |

**前提として共有しておくこと**：本番車両NCECは**ノーマル車ではない**。前期型車体に後期型エンジンを
載せ替え、ECUは NOPRO MZ-TUNE+ 仕様（レブリミット8,000rpm、スピードリミッター解除、メカフィーリング
スロットルマップ、電動ファン作動温度変更など）。**CANの中身がコミュニティ資料と食い違う箇所があるのは
このため**で、回路側の設計に影響する話ではないが、データを見るときの前提として。

---

## 6. 資料の場所

### 6-1. 回路担当に直接渡せるもの（この順で読むのが早い）

| ファイル | 内容 | 最終更新 |
|---|---|---|
| **本書** `docs/share/hardware_share_20260915.md` | 前回共有以降の差分＋今回の3論点 | 2026-09-15 |
| [docs/design/hardware_interface_spec.md](../design/hardware_interface_spec.md) | **回路の入出力仕様の本体**（コネクタ・電源・基板一覧・相談事項）。**認識合わせはここが正** | 2026-08-30 ※4-4の訂正が未反映 |
| [docs/research/vehicle_can_survey_summary.md](../research/vehicle_can_survey_summary.md) | 3車両（NCEC / MAZDA2 / レクサスUX）の実車CAN調査サマリ。**前回共有した版** | 2026-09-06 ※4-5の訂正が未反映 |
| [docs/design/ncec_can_spec.md](../design/ncec_can_spec.md) | **NCECのCAN通信仕様だけを抜いた1枚**。ID一覧・周期・バイトマップ・デコード式・OBD2/mode22。**実装者はこれ1枚でデコーダが書ける** | 2026-09-12 |
| [docs/share/hardware_meeting_agenda.md](hardware_meeting_agenda.md) | ミーティングの進行順（`docs/design/hardware_interface_spec.md`各章への案内役） | — |

### 6-2. 根拠・一次資料

| ファイル | 内容 |
|---|---|
| [docs/research/OBD2_SURVEY.md](../research/OBD2_SURVEY.md) | ELM327調査〜実車解析の一次資料。「NCEC 追補」＝55分走行、「NCEC 追補2」＝停車・スイープ・mode22 |
| [ARCHITECTURE.md](../../ARCHITECTURE.md) | プロジェクト全体のマスター。4章「現状ステータス」に日付つきで確定事項が積んである |
| [docs/manual/ncec_field_procedure.md](../manual/ncec_field_procedure.md) | NCEC実車の現地手順 |
| [ncec_next_session_checklist.md](../../ncec_next_session_checklist.md) | **実車に繋ぐ前に必ず開く**チェックリスト（終端確認・スタブ・並列接続の注意を含む） |
| [docs/manual/lexus_ux_field_procedure.md](../manual/lexus_ux_field_procedure.md) / [docs/manual/mazda2_field_procedure.md](../manual/mazda2_field_procedure.md) | 他2車両の現地手順・切り分け記録 |
| [task_phase2_breakdown.md](../../task_phase2_breakdown.md) | Phase 2（CAN）のサブタスクと結果。2-4-8-x が今回の実車回 |
| [task_phase6_breakdown.md](../../task_phase6_breakdown.md) | 外部CANブロードキャスト（6-3）の設計タスク。**未着手** |

### 6-3. 回路・ファームウェアの実体

| 場所 | 内容 |
|---|---|
| `circuit/logger_v1/logger_v1.net` / `logger_v1.kicad_pcb` | **部品・結線の正**（BOM csvは古いので使わない） |
| `firmware/logger_v1/` | 本番ロガーのファームウェア。`HANDOFF.md` に残作業一覧 |
| `firmware/can_obd_logger/` | 解析用（生CAN受信＋OBD2ポーリング＋mode22）。`src/main.cpp` の `PID_TABLE` が2-3の要求レート |
| `firmware/can_logger/` | 受動キャプチャ専用（LISTEN_ONLY＋TXピン未配線＋GPIO固定の3重の安全策） |
| `firmware/can_selftest/` | **卓上専用。NO_ACKモードなので実車バスへ繋がない** |

### 6-4. 生キャプチャ（リポジトリには含めない方針。手元のみ）

`ncec_lr2_*.csv`（定常円旋回）／`ncec_sweep_*.csv`（ペダル全域スイープ）／
`ncec_ops_*.csv`（停車12種の操作差分）／`ncec_didscan.csv`・`ncec_didwatch.csv`（mode22）／
`ncec_run1*.csv`（55分走行）。解析スクリプトは `can_capture_logger.py` / `can_split_phases.py` /
`can_obd_extract.py` / `can_correlate.py`。

---

## 7. 共有時の注意

- **VIN（車台番号）は記録しない方針**。mode 09 PID 02 で取得可能だが値は残さない。
  `0x4FF` が流している `DISABLE VIN COMPARE` は**固定の文字列リテラルで車台番号ではない**。
- OBD2は**読み取りのみ**（mode 01 / mode 22）。DTC消去・アクチュエータ制御・書き込み系サービスは
  行わない。
