ntakao2006-web/RaceCapture/unoq_video_to_shield_sd_study.md

# 焼き込み映像をシールド側SDへ保存できるか（E-6の調査）

2026-10-09調査。UNO Q実機（USB/adb経由）・公式回路図ABX00162・Zephyrのボード定義・データシート・リポジトリ内のファーム／回路資料から分かることをまとめた。
**実際にLinux→STM32へ映像を流す試験はまだしていない**（理由は5章）。

---

## 1. 結論

- **焼き込み（GPU合成・HWエンコード）はLinux側（QRB2210）でしかできない。** STM32が担えるのは「Linuxが作ったH.264をシールドのSDへ書く」保存係だけ。
- **Linux→STM32の経路はある。** 未使用の内部SPI（Linux `spidev0.0` → STM32 SPI3）で、上限は約24Mbps。固定ビットレート（CBR）8Mbpsなら上限の約3分の1で収まる。
- **ボトルネックはSTM32→SDの側に移った。** シールドのSDはSDMMCではなく**SPIモード**で、**CAN2・LEDシフトレジスタとSPI2を共用**しており、しかも現行ファームは**GPIOを1ビットずつ叩くソフトウェアSPI**で書いている。映像（約1MB/s）を書くにはファームの作り直しが前提。
- **回路の変更は要らない見込み**（SPI2のピンはハードウェアSPI2として使える）。必要なのはファーム側の作業と実測。

---

## 2. Linux→STM32の経路

| 経路 | 速度 | 映像（CBR 8Mbps≒1MB/s）に対して |
|---|---|---|
| Bridge（arduino-router、UART `/dev/ttyHS1`） | 921600bps＝実効最大約90KB/s | **約11分の1で不可**。走行データの受け渡しにも使用中 |
| **内部SPI（未使用）** | **上限約24Mbps**（TXS0101で律速） | **計算上は通る（余裕約3倍）** |

内部SPIの配線（3つの資料で照合済み）：

| 信号 | Linux側（QRB2210） | STM32U585側 | 備考 |
|---|---|---|---|
| SCK | GPIO16 | PG9（SPI3_SCK） | |
| MISO | GPIO14 | PG10（SPI3_MISO） | |
| MOSI | GPIO15 | PB5（SPI3_MOSI） | **途中にTXS0101（1.8V→3.3V変換、プッシュプル最大24Mbps）** |
| CS | GPIO17 | PG12（SPI3_NSS） | |
| RDY | GPIO70 | PG13 | STM32 SPIの「RDY」機能（スレーブが受け取れる時だけ送らせる）用 |

- Linux側は`spidev0.0`（QUP5、GPI DMA対応）として既に見えている。ただし**root権限でしか開けない**。
- STM32側はArduinoのZephyrコアで`zephyr,spi-slave`として定義済み。**現行ファーム（`firmware/ecologger_v2`）は使っていない**。
- ポートGのピン（PG9/10/12/13）はSTM32の1.8V電源系（VDDIO2）なのでLinuxと直結、PB5（MOSI）だけが3.3V系なので変換ICが入っている、と読める（回路図の配置と整合）。
- STM32U585のSPI3は**機能限定版**：FIFOは8バイト、データ幅は8/16bit、**1回の転送は1024データまで**（DMAで区切って連続させる）。スレーブ時の最高クロックは手元の資料（製品概要版）に記載がなく未確認。
- **RDY線があるのが大きい**：STM32の受け取りが詰まったらLinux側が待つ設計にできる。Linux側はRAM・eMMCが潤沢なので、**SDの一時的な書き込み遅延を吸収するバッファはLinux側に持たせられる**。

## 3. エンコーダのビットレートと画質（実測）

UNO QのHWエンコーダで5秒（150フレーム）をエンコードし、元映像との一致度を測った。

| 素材 | 方式 | 設定 | 実測平均 | **1秒間の最大** | SSIM | PSNR |
|---|---|---|---|---|---|---|
| 実カメラ（スマホ動画・屋内） | CBR | 4M | 3.3M | 3.6M | 0.970 | 38.7dB |
| 〃 | CBR | 6M | 4.9M | 5.4M | 0.979 | 40.9dB |
| 〃 | CBR | **8M** | 6.6M | **7.5M** | **0.982** | **42.1dB** |
| 〃 | CBR | 12M | 9.9M | 11.0M | 0.987 | 43.7dB |
| 最悪条件（毎フレーム変わるノイズ） | VBR | 12M | 10.0M | **23.8M** | — | — |
| 〃 | CBR | 12M | 9.8M | 13.0M | — | — |
| 〃 | **CBR** | **8M** | 6.5M | **8.3M** | — | — |

- **SPIで運ぶなら固定ビットレート（CBR）が必須**。VBRは最悪条件で瞬間的に23.8Mbpsまで跳ね、SPIの上限（24Mbps）に並ぶ。CBRは設定値の約1.1〜1.35倍に収まる。
- 実カメラ素材は8Mbpsで十分な画質（SSIM 0.98以上）。ただし素材は屋内のスマホ動画で、**走行映像（路面・木々で情報量が多い）では同じビットレートでも画質が落ちる**。走行映像での確認が要る。
- 8Mbpsなら保存量は約3.6GB/時。
- 補足：エンコーダの初期値は1Mbps（VBR）。`unoq_video_check_procedure.md`5-4の`v4l2-ctl`直接試験は初期値のまま測っていた（速度の結論は焼き込み試験の12Mbpsで再確認済み）。

## 4. STM32→SDの側（ここが本当のボトルネック）

| 項目 | 現状 | 映像保存に必要なこと |
|---|---|---|
| SDの接続方式 | **SPIモード**（Molex 47219-2001、`circuit/logger_v2/実装方針.md`） | SDMMC（4bit）用のピン（PC8〜12・PD2）はシールド端子に出ていないので、SPIモードのまま進めるしかない |
| SPIバス | **SPI2（D11〜D13）をCAN2（MCP25625）・LEDシフトレジスタと共用** | 映像約1MB/s＋走行ログを、CAN2の受信処理と時分割で通す |
| 書き込み方式 | **GPIOを1ビットずつ叩くソフトウェアSPI**（`logger_impl.h`の`sp()`）、1セクタずつ書き込み | **ハードウェアSPI2＋DMA＋複数セクタ連続書き込み（CMD25）へ作り直し**が前提 |
| SPIクロック | ソフトウェアのため実測値なし | SDはSPIモード最大25MHz、MCP25625は最大10MHz。CSごとにクロックを切り替える |
| 計算上の余裕 | — | SD側20MHzで理論2.5MB/s、連続書き込みの実効を7割として約1.8MB/s → 映像約1MB/sに対し**余裕は2倍弱**（CAN2の処理時間を差し引く前） |

## 5. 今の環境でできなかったこと・その理由

| 試験 | できなかった理由 |
|---|---|
| Linux→STM32のSPI転送速度の実測 | ~~Linux側`/dev/spidev0.0`はroot専用~~ → **Linux側の送信は5-2章で実測済み（約2MB/s）**。STM32側が実際に受け取れるかは、受信用の試験ファームが要るので未実施 |
| ~~SDのハードウェアSPI書き込み速度の実測~~ → **5-3章で実測済み（2,221KB/s）** | STM32に試験用ファームを書く必要があり、**動いているロガーのファームを一時的に置き換える**。SDへ書き込む試験は**走行ログを壊す恐れ**があるので、空のSDカードで行う |
| STM32のRAM・Flashの余裕 | 調べられた範囲：ファームの書き込み領域は64KiB（現行ファームはコード約36.7KB）。RAMはファーム用に128KB程度の枠で、現行ファームが約93KBを使用（うち64KBが取得待ち行列）。**STM32側に大きなバッファは置けない**が、RDY線でLinux側に待たせれば小さくて済む |

## 5-2. Linux側の送信速度（2026-10-09実測）

ユーザーがsudoで`/dev/spidev0.0`を`gpiod`グループに開放し、spidevを`bufsiz=262144`で読み込み直した（どちらも再起動で元に戻る一時設定）。
試験プログラムは`tools/unoq_overlay_enc/spi_tx_test.c`。**STM32側は受け取っていない空送信**なので、Linux側が送り出せる速度だけを見ている。

| 1メッセージ | クロック | 速度 | CPU |
|---|---|---|---|
| 4096B（spidevの既定上限） | 20MHz | 0.64MB/s | 8% |
| 4096B | 50MHz（最高） | 4.5MB/s | 13% |
| **64KB** | **20MHz** | **2.0MB/s（16Mbps）** | 2% |
| 128〜256KB | 16MHz | 1.9MB/s（15Mbps） | 1% |
| 128〜256KB | 20MHz | 1.4MB/s（原因不明の低下、再現あり） | 1% |

- **50MHz未満では、メッセージ1回ごとに約5msの待ちが入る**（クロック値・語長・転送の分け方を変えても消えない。カーネルのSPIドライバ側の挙動と見られ、50MHz＝最高クロックの時だけ起きない）。spidevの既定上限4096Bではこの待ちが支配的になり、1MB/sに届かない。
- **50MHzはTXS0101（24Mbps）を超えるので使えない。** 実用は「64KB×20MHz」か「128KB×16MHz」で**約2MB/s＝必要量（CBR 8Mbps≒1MB/s）の約2倍**。
- **焼き込み（30fps）とSPI全速送信を同時に60秒**：焼き込みは1800/1800フレーム・30.0fps、SPIは2.06MB/s、システムCPU 32%（試験なし21%）。**互いに影響なし**。
- 本番では、spidevの開放と`bufsiz`をudevルール・modprobe設定で恒久化するか、spidevを使わない専用の送信処理にする必要がある（どちらもroot作業）。

## 5-3. STM32側の受信とSD書き込み（2026-10-09実測・試験ファーム）

ロガーのファームを一時的に試験ファーム（`tools/dev/unoq_spi_sd_test/`）へ置き換えて測った。試験後は書き込み前に読み出したロガーのファームへ戻し、ビット単位で一致・記録再開を確認済み。
SDは記録中のカードのまま使い、**FATで空きと確認したパーティション中央の512MBだけ**に生セクタで書いた（既存ファイル・FAT・ディレクトリには書いていない）。

**① Linux→STM32のSPI受信（SPI3スレーブ＋GPDMA、64KBリング、32bit連番で検査）**

| クロック | 送信 | 結果 |
|---|---|---|
| 20MHz | 32MB・1.97MB/s | **全33,554,432バイト受信、誤り0・受信溢れ0** |
| 24 / 30 / 40 / 50MHz | 各16MB・2.3〜5.8MB/s | 誤り0・溢れ0（50MHzはTXS0101の定格24Mbps超だが、短い1対1配線で通った。設計は定格内の20〜24MHzで考える） |

**② SDへの連続書き込み（ハードウェアSPI2・20MHz・CMD25）**：64MBを30.2秒＝**2,221KB/s**（理論2.5MB/sの約9割）、エラー0。
カードはSDHC・パーティション約31GB・クラスタ32KB。

**③ 通し（Linux→SPI→STM32→SD）**

| 目標レート | 時間 | 書き込み | 欠落 | SDの停止 |
|---|---|---|---|---|
| 1.0MB/s（8Mbps相当） | 60秒 | 1,003KB/s | 0（バッファ最大63KB/64KB＝紙一重） | 50ms以上12回 |
| 1.0MB/s | **5分** | 1,002KB/s | **3回・144KB（0.05%）** | 20〜50ms 75回、50ms以上36回（最長60ms） |
| 0.75MB/s（6Mbps相当） | 60秒 | 753KB/s | 0 | 停止なし（最長3ms） |
| 0.75MB/s | **5分** | 752KB/s | **2回・114KB** | 20〜50ms 49回、50ms以上25回 |

- **SDは数秒〜十数秒おきに50〜60ms止まる**（カード内部の処理）。STM32のバッファが64KBしかないため、停止が重なると送り手に追い越されて欠落する。**ビットレートを下げるだけでは防げない**。
- STM32側のRAMは約128KBの枠（`CONFIG_LLEXT_HEAP_SIZE`。このArduino環境ではコードもRAMに載る）。128KBのバッファを取るとファーム自体が読み込まれなかった。ロガー本体（RAM約93KB）と同居させるなら、STM32側に大きなバッファは置けない。
- **対策の候補**：
  1. **フロー制御**（本命）：STM32の空き容量をLinuxへ返し、Linuxは空きがある時だけ送る。Linux側はRAMもeMMCも潤沢なので、SDの停止中はLinuxが溜めておけばよい。返し方は、SPIのMISO（全二重なのでSTM32が空き容量を送り返せる）か、Bridge経由。回路図上の`MCU_SPI3_RDY`の線は、Arduinoのルーターが起動時にLinux側から`gpioset 70=1`で使っているので、そのままでは流用できない
  2. 書き込み単位をSDの消去単位（AU）にそろえる・事前消去（ACMD23）で停止を減らす
  3. 連続書き込み性能の高いカード（A2・V30等）に替える
- **結論：シールドSDへの映像保存は「フロー制御を入れれば成立する見込み」**。経路の速度（SPI 2MB/s・SD 2.2MB/s）は8Mbps映像に対して約2倍の余裕がある。残る課題はSDの不定期な停止の吸収だけ。

**③' フロー制御を入れた通し（2026-10-09）**

STM32が「SDへ書き終えたバイト数」をBridge（`spitest.rd`）で返し、Linuxは「送った量−書き終えた量＋次の塊 ≦ 64KB」のときだけ送るクレジット方式（`tools/dev/unoq_spi_sd_test/spi_fc.py`）。
Linux側は「エンコーダが一定レートで出す」状況を模擬し、送れない間に溜まった量を記録した。

| 目標レート | 時間 | 結果 | 欠落 | Linux側に溜まった最大量 | SDの停止（50ms以上） |
|---|---|---|---|---|---|
| **1.0MB/s（8Mbps相当）** | **5分** | **1,003KB/s・307,200KB全ブロック** | **0** | **409KB** | 35回（すべて吸収） |
| 1.5MB/s（12Mbps相当） | 2分半 | 1,197KB/sしか出ず（溜まる量が増え続けた） | 0 | 36MB（増加中） | 26回 |

- **8Mbpsの映像なら、欠落なくシールドSDへ保存できることを実測で確認した。** Linux側に必要な一時バッファは0.5MB未満。
- 今の作りの上限は約1.2MB/s（9.6Mbps）。受け皿64KBに対して塊2つしか送れず、塊ごとに問い合わせ（中央値3.5ms）とSPIの固定待ち（約5ms）が入るため。上げるなら、受け皿を広げる・送り側をC化する・空き容量をMISOで返して問い合わせを無くす。
- Bridgeの問い合わせは中央値3〜4ms・最大約15ms（STM32側のメイン処理とBridgeは同じ優先度5・20msの時分割なので、SD待ちの間に`k_yield()`で譲った）。

**④ 試験で分かった運用上の注意（ファーム更新の手順）**

- ルーター（arduino-router）が動いたままSTM32を止めて書き込むと、Linux側のUART（ttyHS1、RTS/CTS付き）が固まることがある。ルーターの停止が時間切れになり、以後どのファームでもBridgeがつながらなくなる。**復旧にはLinuxの再起動が要った**。
- 「Web停止 → ルーター停止 → 書き込み → ルーター起動 → STM32リセット → Web起動」の順にすると起きなかった（`tools/dev/unoq_spi_sd_test/flash.sh`）。BridgeはSTM32起動時の`$/reset`に返事が来ないと永久に待つため、最後のリセットが要る。
- `EcoCapture-Web/build-mcu.sh`は「ルーター再起動 → 書き込み」の順で、最後のリセットが無い。本番のファーム更新でも同じことが起き得る（Lintarohさんへ共有）。
- → 2026-10-09 Lintarohさんが対応：本番・試験とも共通の`EcoCapture-Web/flash-mcu.sh`（上の順番＋失敗時はその場で中断、ルーター停止を確認できなければSTM32に触らない）へ統一。PC上の模擬試験のみで、実機での書き込み・Bridge復帰の確認は次回接続時（`docs/share/lintaroh_answer_20261009.md`）。
- OpenOCDでの読み出し（`dump_image`）は、STM32を止めなくてもできる。止める（`halt`）と長時間になり、ロガーとの通信が切れる。

## 6. 次にやること（順番）

> 2026-10-09更新：下の1・2は5-3章の実測でおおむね済んだ。~~残りは「フロー制御を入れた通し試験（5分以上・欠落0）」~~ → **5-3章③'で達成（8Mbps相当×5分・欠落0）**。**残りはロガー本体（走行ログ・CAN2）との同居**。
> 同居の論点：SPI2をCAN2・LEDと共用する中で映像を書くこと、ロガーのRAM（約93KB）＋映像用バッファが約128KBの枠に収まるか、64KiBのファーム領域に映像処理を足せるか。
> 2026-10-09 Lintarohさんの集計で**RAMは「93KB＋64KB」より厳しい**と判明：10月3日の保存イメージは、RAMへ載る静的セクション（コード・定数・BSS）だけで124,597B、128KiB枠との差は6,475B。**現状のままでは8KBのリングすら入らない**ので、取得待ち行列（64KB）の一部を映像用へ回す再配分（例：取得32KiB・映像32KiB）が前提になる。ファーム領域の余りは7,448B。統合の段階（SPI2ハード化→SDを短い単位で譲る→バッファ再配分＋SPI3→フロー制御の本番化→FAT管理の一本化）と本番採用の判定条件は`docs/share/lintaroh_answer_20261009.md`。

1. **回路担当へ確認**：
   - TXS0101を挟んだMOSIで実際に何MHzまで通るか
   - STM32U585のSPI3スレーブの最高クロック
   - SPI2の共用（SD・CAN2・LED）を映像書き込みで長時間占有しても配線・信号品質上問題ないか
2. **実測（要準備）**：
   - UNO Qのsudoパスワード（spidevに触るため）
   - 空のmicroSD
   - STM32の試験ファーム（SPI3スレーブ受信のみ → SD書き込みの順に段階的に）
   
   ロガーのファームは試験後に`EcoCapture-Web/build-mcu.sh`で戻す。**ファームはLintarohさんの担当範囲なので事前に調整する**
3. 実測で「SPI3受信1MB/s」と「SD書き込み1MB/s＋走行ログ」が両立すれば、E-6を採用に進める。届かなければeMMC保存（E-5）で確定し、SDは走行データ専用のままにする

## 7. 出典

- [UNO Q 公式回路図 ABX00162](https://docs.arduino.cc/resources/schematics/ABX00162-schematics.pdf)（9ページ「SPI To MCU」、7ページ U1102 TXS0101、19ページ STM32側）
- [Zephyr ボード定義 arduino_uno_q-common.dtsi](https://github.com/zephyrproject-rtos/zephyr/blob/main/boards/arduino/uno_q/arduino_uno_q-common.dtsi)（SPI3 = PG9/PG10/PB5/PG12）
- [ArduinoCore-zephyr UNO Q overlay](https://github.com/arduino/ArduinoCore-zephyr/blob/main/variants/arduino_uno_q_stm32u585xx/arduino_uno_q_stm32u585xx.overlay)（SPI3 = spi-slave、PG13 = Internal SPI RDY）
- UNO Q実機のデバイスツリー：`spi@4a94000`の`pinctrl-0` → `qup-spi5-default-state` → `gpio14〜17`
- STM32U585 製品概要 DB3734 Table 23（SPI3は機能限定版）、[ST Community：SPI3の転送数上限](https://community.st.com/stm32-mcus-products-25/limitation-of-spi3-of-stm32u5-133589)
- [TI TXS0101](https://www.ti.com/product/TXS0101)（プッシュプル最大24Mbps）
