ntakao2006-web/RaceCapture/lintaroh_share_20261109_gnss10hz.md

# Lintarohさんへの共有メモ：GNSSの解を10Hzのまま記録へ入れるようにSTM32のファームを変えた（2026-11-09、未送）

Ver.2の記録（EcoCaptureの`LOG_….csv`）では、GNSSは10Hzで受けているのに、位置が変わるのは1秒に約6回だけでした。
原因はLinux側の読み方で、直すためにSTM32のファーム（`firmware/ecologger_v2/logger_impl.h`）とEcoCaptureの`hardware.py`を変え、**11/9に本体へ入れました**。
Lintarohさんの担当のところを触ったので、何を変えたか・どう確かめたか・戻し方をまとめます。**確認してほしいことは6章**です。

コミットは`6d6800d`（最初の形）→`9d125fd`（RAMに収めた今の形）→`6ee4d14`（本体へ入れた記録）です。経緯の詳細は`task_sugo_20261108_breakdown.md`のSG-5-3にあります。

---

## 1. 何が起きていたか

- 受信機→STM32は10Hzで全部届いています。シールドのSDにもNAV-PVTが全部残っています（10/25のSDで走っている間に1秒に10.01個）。
- STM32は最新の解を1つだけ`logger.status`の`nav`に入れていました。EcoCaptureの`collect`（`server.py`）は、状態を**前に読んでから0.1秒以上たったときだけ**読みます（10/4の`913f99f`から）。実際には0.13〜0.2秒ごとになるので、間の解が捨てられていました。
- 録画の有無に関係なく、10月から同じでした（繰り返しが1秒に20回だった10/21〜10/24でも、新しい解は1秒に6.4〜6.6回）。

## 2. 変えたこと

### STM32（`logger_impl.h`）

- `gnssPoll`が正しいNAV-PVTを受け取るたびに、**IMUの行と同じ形`[seq,受け取った時刻ms,"16進"]`で`rows`へ足します**。
  - 16進が92バイトなら解、46バイトか0バイトならIMUです。
  - IMUと同じループで足すので、`rows`の並びがそのまま届いた順になります。
  - `seq`はその時点のIMUの番号をそのまま入れているだけで、意味はありません。
- IMUの行・CAN・解を足す処理を`queueRow()`1つにまとめました（`imuPoll`・`frame`・`gnssPoll`から呼びます）。
- **`logger.status`から`nav`と`gnss_at`をなくしました**。`take`の解で足りるうえ、RAMの残りが足りなかったためです（3章）。
  - LED（GPS）と、SDへの記録（`sdRecord(2,…)`）は前と同じです。

### EcoCapture（`EcoCapture-Web/hardware.py`）

- `rows`の中の92バイトの行を解として読み、そのあとに続くIMUの行へ入れます。解の行は記録の行にはしません。
- 解が1秒より古くなった行は、測位なしにします。
- 状態に`nav`があれば（前のファーム）、前と同じ読み方をします。**新しい`hardware.py`は前のファームでも動きます。**
- **前の`hardware.py`は、新しいファームでは`status['nav']`が無くて止まります。** 入れる順番は「`hardware.py`が先、ファームが後」です。

## 3. RAM

本体で組み上げて、`image-audit.json`の静的領域を見ました。

| 版 | 静的領域 | |
|---|---|---|
| 11/7の版（変える前） | 130,337B | |
| 最初の形（解を`take`の別の列`nav`で渡す） | 130,417B | 起動を確かめてある130,365Bを超えたので使わなかった |
| 状態から`nav`を抜く | 130,381B | |
| 状態から`gnss_at`も抜く | 130,361B | 余裕が4Bしかない |
| **解を`rows`に混ぜる（今の版）** | **130,301B** | 11/7の版より36B少ない。像は59,844B |

組み上げ方は次のとおりです。
- 本体で動いている`~/ecologger_v2`には触らず、`~/navtest_20261109/`に写してから組み上げました（`build.sh`の後半と同じ手順で、ライブラリの手直しはもう入っているので飛ばしています）。
- 先に**変える前のソースを同じ手順で組み上げ、11/7の像と1バイトも違わない**ことを確かめてから、変えた版を組み上げました。

## 4. 確かめたこと

- 試験：`test_hardware.py`に4件足しました（解がその後の行へ入る・最後の行より後の解は次の回へ持ち越す・1秒で切れる・測位していない解は「測位待ち」）。
  - 本体のDockerで`deploy.sh`の試験を全部流し、変える前・変えた後とも全部通りました（`test_hardware`は17→21件）。
- 10/25のシールドのSDの解を、新しい読み方で流し直しました。記録に入る解は1秒に8.60個で、SDにある解の数（8.60個）と同じ＝全部入りました（前の読み方では5.65個）。
- 本体へ入れたあと（11/9 10:10〜10:20、屋内で未測位なので、GNSSの時刻`itow`が変わる回数で数えています）：

| | 変える前 | 変えた後 |
|---|---|---|
| 記録の中のGNSSの更新 | 1秒に6.58回 | **1秒に10.02回** |
| 記録の行 | 100.0行/秒 | 100.0行/秒 |
| 受信・bridgeのエラー | 100Hz・0 | 99〜100Hz・0 |
| `dropped` | （起動時の360のまま） | 書き込み直後の202から、1分たっても増えない（IMUの読み取り5,990回に対して行5,998行） |

- 屋外で測位した状態（できれば走行）での確認はまだです。

## 5. 本体に残した控えと戻し方

- 前の像：`~/ecologger_v2_sdfull_20261107.bin`（`a604767a…`、変える前に動いていたものと同じ）
- 前のソース：`~/ecologger_v2.before-gnss10hz-20261109-101007/`
- 前のEcoCapture：`~/EcoCapture-Web/.bak-gnss10hz-20261109-101007/`（`hardware.py`・`test_hardware.py`）と、イメージ`ecocapture-web:pre-gnss10hz-20261109-101007`
- 今の像：`~/ecologger_v2_gnss10hz_20261109.bin`（`e3501ec7…`）。`~/ecologger_v2/logger_impl.h`はこれを組み上げたソースに置き換えてあります。

戻すときは、前の像を`flash-mcu.sh`で書き込むだけで足ります。新しい`hardware.py`は前のファームでも動きます。

## 6. 確認してほしいこと

1. **`logger.status`から`nav`・`gnss_at`をなくしたこと**
   リポジトリの中で読んでいたのは`hardware.py`だけでした。ほかに、Lintarohさんの手元の道具や本体だけにあるスクリプトで読んでいるものがあれば教えてください。
2. **解を`rows`に混ぜる形でよいか**
   `take`の形を変えずに済み、RAMも減りますが、「`rows`の中身は16進の長さで見分ける」という決まりが1つ増えます。別の形がよければ相談させてください（別の列にするとRAMが上限を超えます）。
3. **`rows`の上限（5,500文字）を解と分け合うこと**
   1行の長さから計算すると、EcoCaptureが`take`を読みに来ない時間に耐えられる長さが、IMUだけのとき約0.48秒、解も入ると約0.41秒に縮みます。上限を上げるべきか、このままでよいか、意見をください（上げるのは実行時のヒープで、静的領域は増えません）。
4. **`flash-mcu.sh`のあと`arduino-router-serial`が止まったままになる件**
   このサービスは`Requires=arduino-router.service`なので、routerを止めると一緒に止まり、routerを起動し直しても戻りません。今回は手で起動し直しました（11/9の朝に本体を起動した直後にも、同じ止まり方をしてから約30秒後に何かが起動し直していました。本体の時計は合っておらず、ログ上は11/8 04:05です）。
   `flash-mcu.sh`のrouterを起動する所で一緒に起動するように直してよいですか？
