ntakao2006-web/RaceCapture/defi_sensor_curves_research.md

# Defiセンサーの特性（ネットで集めた情報と照合、2026-11-04）

SensorHubのPIC v8（0x580）でDefiの油温・水温・油圧を横から測るための、センサーの電圧特性の調べもの。
**Defiはセンサーの電気的な特性を公式には公開していない**（公式サイトのセンサー仕様ページ・取扱説明書7冊を確認）。
数値は、海外フォーラムの実測と日本の個人サイトの解析から取り、私たちの実測（2026-11-03〜04、NCEC）と突き合わせた。

## 1. 公式に分かること

| 項目 | 内容 | 出どころ |
|---|---|---|
| 温度センサー | PDF00903S（1/8PT）。油温・水温で共通の部品、違うのはハーネスだけ | [Defi センサー仕様](https://defi.nippon-seiki.co.jp/installation/sensor) |
| 圧力センサー | PDF00703S（1/8PT）。油圧・燃圧で共通。ADVANCE・Racer Gauge・DIN-Gauge・Defi-Linkで共通 | 同上 |
| DIN-Gaugeのコネクター | **温度1＝赤の2ピン（表示30〜150℃、水温）**、**温度2＝ピンクの2ピン（表示50〜150℃、油温）**、圧力＝黒の3ピン。故障診断の表に「TEMP1は水温、TEMP2は油温」 | [DIN-Gauge取扱説明書（英語）](https://www.defi-shop.com/wp-content/uploads/2025/04/din-manual_1307-1_e.pdf) |
| 油圧の目安 | 表示0〜1000 kPa。アイドリング100〜200 kPa、ワーニングの目安120 kPa。油温・水温100℃以上のアイドリングで100 kPa以下は危険。デモカー（10W-40、900 rpm、油温88℃）で80 kPa | [Defi 油圧編](https://defi.nippon-seiki.co.jp/defi/installation/knowledge/oilpress/) |
| 油圧センサーの範囲 | 瞬間的に3000 kPaに達すると「センサーセンシング範囲の3倍」とあるので、測定範囲は約1000 kPa（読み取り） | 同上 |

SensorHubの割り当て（2026-11-03に値の動きで決めたもの）は、この公式の割り当てと一致する：
TEMP1（赤黒っぽいカプラー）＝水温、TEMP2（ピンクのカプラー）＝油温。

## 2. 油圧センサー（PDF00703S、本体の刻印は DFS007001）

3本線：赤＝5 V（Defiから供給）、白＝出力、黒（灰）＝GND（kaele.com）。センサーは電源をもらって初めて出力するので、
**Defi側のハーネスがつながっていないと出力は0 V**（2026-11-04に基板だけ挿した状態でPRESSのADCがずっと0だったのと合う）。

### 2-1. 実測の表（Type-RA、rac、2007-02-04、手元のDFS007001、約140 psiまで）

[Defi Sensor Calibration Curves](https://www.type-ra.com/subaru-forum/threads/defi-sensor-calibration-curves.48225/)

| psi | V | psi | V | psi | V |
|---|---|---|---|---|---|
| 0 | 0.580 | 50 | 1.954 | 100 | 3.326 |
| 5 | 0.753 | 55 | 2.095 | 105 | 3.454 |
| 10 | 0.837 | 60 | 2.239 | 110 | 3.596 |
| 15 | 0.978 | 65 | 2.372 | 115 | 3.739 |
| 20 | 1.112 | 70 | 2.504 | 120 | 3.882 |
| 25 | 1.250 | 75 | 2.647 | 125 | 4.000 |
| 30 | 1.392 | 80 | 2.780 | 130 | 4.150 |
| 35 | 1.525 | 85 | 2.926 | 135 | 4.280 |
| 40 | 1.670 | 90 | 3.063 | 140 | 4.420 |
| 45 | 1.811 | 95 | 3.200 | | |

当てはめ（こちらで計算）：10 psi以上は **P[kPa] = 250.2 × (V − 0.570)** で、ずれは最大3.8 kPa（ほぼ完全な直線）。
0 psi・5 psiの2点だけ直線から外れる（5 psiは−11 kPa。転記の誤りか低圧側のくせかは不明）。

### 2-2. メーターの換算（kaele.com「市販メータセンサーの解析」、2015/05/28更新）

[市販メータセンサーの解析](https://kaele.com/~kashima/car/sensor/)：Defiのメーターへ既知の入力を与えて表示を読み、式に当てはめたもの。
**P[kPa] = 250 × (V − 0.48)**（メーター読み）。

### 2-3. 照合と使い方

- 傾きは2つの出どころで一致（250 kPa/V＝100 kPaあたり0.4 V）。**傾きは信用してよい**
- 0点（0 kPaの電圧）は0.57 Vと0.48 Vで食い違う（約22 kPa分）。センサーの個体差か、メーター側の扱いの違いかは分からない
- → **換算は P[kPa] = 250 × (V − V0)、V0はエンジン停止・Defi通電で読んだ電圧**にする（実車チェックリスト項目Gでも「白≒0.58 V」）。
  あとはアイドリングでDefiの油圧計と見比べて傾きを確かめる
- センサーの出力はDefiの5 Vに比例する。PICは自分の電源（約5 V）を基準に測るので、2つの5 Vが1%ずれると高圧側で約10 kPaずれる

## 3. 温度センサー（PDF00903S）

### 3-1. 出どころごとの特性

| 出どころ | 内容 | β |
|---|---|---|
| リポジトリの表（`datasheet/defi_temp_sensor_rt.csv`） | -1℃ 27.6 kΩ・97℃ 1.145 kΩの2点のβ式そのもの | 3271 K |
| kaele.com（メーターの換算） | NTC、R25＝10 kΩ、B＝3380 K | 3380 K |
| Type-RA（Dan Lewis、2007-09-09、油を200℃まで温めて25℃まで冷ます測定を2回して平均。ECU入力の電圧で、プルアップは不明） | 25〜200℃の36点 | 25〜150℃で当てはめ3388 K |

Type-RAの表（℃：V）：25:4.548 30:4.481 35:4.402 40:4.3115 45:4.212 50:4.1045 55:3.986 60:3.858 65:3.726 70:3.583
75:3.429 80:3.2785 85:3.119 90:2.9625 95:2.8105 100:2.6595 105:2.509 110:2.342 115:2.2025 120:2.0575 125:1.9205 130:1.775
135:1.657 140:1.542 145:1.435 150:1.329 155:1.2355 160:1.1565 165:1.0755 170:1.0045 175:0.942 180:0.8855 185:0.8515
190:0.814 195:0.795 200:0.776（5 V電源と仮定すると、R25＝10 kΩのとき相手側のプルアップは約0.9 kΩ相当）

Type-RAの表から出る局所的なβ：25〜50℃ 3030 K、50〜75℃ 3339 K、75〜100℃ 3392 K、100〜125℃ 3565 K、125〜150℃ 3665 K。
**温度が高いほどβが大きい**。25〜100℃だけで当てはめると3271 K（リポジトリの表と同じ）になる。

### 3-2. 私たちの実測との照合（2026-11-03〜04、Defiのメーターと並べて読んだ点）

点ごとにDefi内部の抵抗を逆算し、その値が温度によらず一定かで曲線の形が合っているかを見た（一定ほど良い）。

| 曲線 | 油温（72・85・86℃） | 水温（70.75・88℃） |
|---|---|---|
| リポジトリの表（β3271） | 1920〜2067 Ω、ばらつき7.3% | 1959〜2079 Ω、6.0% |
| kaele（R25 10 kΩ・B3380） | 1888〜2009 Ω、6.2% | 1928〜2017 Ω、4.5% |
| Type-RAの曲線の形 | ばらつき5.6% | 3.5% |

どの出どころも、**70〜130℃では今の設定のβ（3271 K）より大きい**ことを示す。今の換算（85〜90℃で合わせたβ3271）は、
110〜130℃でメーターより数℃**高め**に出る見込み（たとえば局所βが3565 Kなら、実際120℃で約+3.5℃）。警告は早めに鳴る側。
ただしメーターの読みの誤差（針で±1℃）と点の少なさから、どの曲線が正しいかはまだ決められない。
→ 3-3のとおり、このβのずれは見かけのものだった。

### 3-3. 冷えた点を足して分かったこと（2026-11-04 05:35、水温計36℃）

水温計36℃のときのTemp1は4.017 V（油温計は下限の50℃以下で、Temp2は4.070 V）。この点を足すと、どの曲線でも
「5 Vを内部の抵抗1本越しにかける」形では合わない：36℃と88℃の抵抗の比は、曲線では4.6〜4.8倍なのに、
電圧から逆算すると5.95倍になる。

かける電圧も自由にすると（PICの公称5 V換算で）6点がそろう：

| 曲線 | かける電圧 | 内部の抵抗 | 6点のずれ |
|---|---|---|---|
| リポジトリの表（β3271） | 5.612 V | 2492 Ω | 1.3℃以内（36℃で+1.3、ほか±1.1） |
| kaele（R25 10 kΩ・B3380） | 5.462 V | 2319 Ω | 1.0℃以内 |
| 前の設定（5 V・2060 Ω、表β3271） | 5.000 V | 2060 Ω | 36℃で−7.2、70.75℃で−1.8 |

PICのADCはPIC自身の電源が基準なので、PICの電源がDefiの5 Vより低い（たとえば約4.45 V）か、入力までの回路に倍率があれば、
5 Vより高い電圧に見える。3-2の「βが大きい」は、この電圧の違いをβで吸った見かけのもので、曲線はリポジトリの表のままでよい。
採ったのはリポジトリの表で合わせた値（5.612 V・2492 Ω）。高温側は旧設定より110℃で約1℃、130℃で約2℃低く出る。

反映後の確かめ（05:51）：水温計32.5℃のときTemp1 4.132 V、換算は34.2℃（+1.7℃）。この点を足した7点で合わせると5.544 V・2441 Ωで、
低温側は1℃以内になるが、110〜130℃での違いは0.3℃以下なので設定はそのままにした。

## 4. 読めなかった出どころ

- [Link ECU フォーラム](https://forums.linkecu.com/topic/17725-defi-sensors-to-link-ecu/)：403（検索の要約では「150 psiのDefiで0 psi 0.58 V、50 psi 1.954 V」とあり、Type-RAの表と同じ値）
- [Haltech フォーラム](https://forums.haltech.com/viewtopic.php?f=31&t=34091)：名前が引けず。検索の要約では「ECU側のプルアップをOFFにしないとDefiの圧力が142 psiと誤表示」
- [Syvecs フォーラム](https://www.syvecs.com/forum/viewtopic.php?t=621)：ログインが要る
- [iwsti](https://www.iwsti.com/threads/defi-oil-pressure-gauge-problem.74613/)：AI向けの課金サービスへ転送されるので読んでいない
- [YouTube：Defi Red Racer 圧力計のセンサー試験](https://www.youtube.com/watch?v=CVZGY2hqVl4)：動画は見られない
- Defi公式の取扱説明書（日本語版）は、PDFの文字の割り当てが崩れていて文字として読めなかった（英語版で確認）
