ntakao2006-web/RaceCapture/task_phase1_breakdown.md

# Phase 1 サブタスク分解（卓上動作検証）

> **2026-10-28 整理（ユーザー了承）**：もう進めない項目を閉じた。`[x]`でも完了ではなく、**【廃止】＝今後やらない**、**【凍結】＝止めておき、書いた条件がそろえば再開**。理由は各項目の印の中に書いた。

> ARCHITECTURE.md「5. 開発ロードマップ」のPhase 1（1-1〜1-5）は粒度が粗いため、
> 実作業はこのファイルの単位（1チャット=1タスク）で進める。
> 完了したタスクはこのファイル内でチェックし、Phase全体が終わったらARCHITECTURE.mdへ
> 結論だけ転記してarchive/へ移動する運用（8章のルールに準拠）。

---

## 買い物（最優先・すぐ発注可能）
- [x] P-1: 3.3V専用・SD信号8ピン全出し（DAT0-3/CMD/CLK/VDD/VSS）のmicroSDブレイクアウトモジュールを購入する（SPI/SDMMC両対応。C3試験用・S3本番用として同一型番を2台）※到着済み（秋月K-5488、`datasheet/K-5488_AE-MICRO-SD-DIP.pdf`）
- [x] P-2: 高耐久microSDカード（SanDisk High Endurance等、32GB程度）を購入する ※到着済み

---

## 1-1: タスク分離基盤（FreeRTOS雛形）※追加ハードウェア不要、今すぐ着手可
- [x] 1-1-1: `xTaskCreate()`で最小のタスクを1つ起動し、一定間隔でシリアルにログを出す（Hello Taskレベルの疎通確認）※実機（Seeed XIAO ESP32C3, COM5）書き込み・動作確認済み。シリアルログに`[helloTask] alive`が一定間隔で出力されることを確認
- [x] 1-1-2: タスク間通信用のキュー（`QueueHandle_t`）を1本作り、別タスクからPush/Popできることを確認する ※実機書き込み・動作確認済み。`[queuePushTask] pushed: N`→`[queuePopTask] popped: N`の対応を確認
- [x] 1-1-3: タスクA（受信役）の雛形を作る。中身はダミーのカウンタ値を生成し、一定間隔でキューにPushするだけ ※実機書き込み・動作確認済み。`[taskA] pushed dummy value: N`が継続出力されることを確認
- [x] 1-1-4: タスクC（USB/シリアル送信役）の雛形を作る。キューからPopした値をSerialへ出力するだけ ※実機書き込み・動作確認済み。`[taskC] sent to serial: N`が継続出力されることを確認
- [x] 1-1-5: タスクAとタスクCを同時起動し、A→キュー→Cの流れが途切れず動くことを確認する（タスク分離の最小形が完成） ※1-1-3/1-1-4の時点でapp_main内に両タスクが統合済みのためコード変更なし。実機書き込み・動作確認済み。taskA/taskCの値が一致し途切れず流れることを確認（"queue full, dropped"のようなキュー溢れログは未観測）
- [x] 1-1-6: ARCHITECTURE.md記載のタスク優先度（タスクB=最優先／タスクA=高優先／タスクC=低優先）を実コードに反映し、狙い通りの優先度で動いているか確認する ※タスクBはSDモジュール未調達のため優先度検証用のダミー処理（ビジーループ）で雛形実装。実機書き込み・動作確認済み。taskB/taskA/taskCが破綻なく並行動作することを確認。ただし意図的な高負荷時のプリエンプション厳密検証までは未実施

---

## 1-3: RCPプロトコルのESP32移植 ※追加ハードウェア不要、今すぐ着手可
- [x] 1-3-1: USB CDCシリアル経由で1行分のJSONを受信し、`\r`区切りで1メッセージとして切り出す受信パーサを実装する ※実機（Seeed XIAO ESP32C3, COM5）書き込み・動作確認済み。`firmware/src/main.cpp`に`rcpReceiveTask`として追加。1バイトずつ受信し`\r`区切りで切り出したメッセージを`printf`でログ出力する雛形（タスクA/B/Cとは独立。1-3-7でタスクCへ統合予定）。PCから直接`{"getVer":null}\r`を送信し、`[rcpReceiveTask] message: {"getVer":null}`が返ることを確認。なお手動テストがしやすいよう1-1の常時ログ出力タスク（helloTask/queuePushTask/queuePopTask/taskA/taskB/taskC）の起動は一時的にコメントアウト中（1-3-7で復活予定）。また`platformio.ini`に`monitor_eol = CR`/`monitor_echo = yes`を追加し、シリアルモニターでEnterを押した際に`\r`のみ送信・入力文字をエコー表示するようにした
- [x] 1-3-2: `getVer`受信時に`{"ver":{...}}`を返す最小実装を作り、PCのシリアルターミナルから手動送信して応答を確認する ※実機（Seeed XIAO ESP32C3, COM5）書き込み・動作確認済み。`rcpReceiveTask`にJSONパース(`rcpHandleMessage`)と応答送信(`rcpSendJsonLine`/`rcpSendVer`)を追加（`firmware/usb_otg_test/src/main.cpp`の実装を参考に、行末は`\r\n`で送信）。PCから`{"getVer":null}\r`を送信し、`{"ver":{"name":"RCPMK3","fname":"RaceCapture/Pro MK3 (esp32-c3 proto fw)","major":2,"minor":16,"bugfix":1,"serial":"C3PROTO01","git_info":"esp32-c3-proto-build","release_type":"release"}}`が返ることを確認
- [x] 1-3-3: 残り6つの接続必須コマンド（`getCapabilities`/`getLapCfg`/`getTrackCfg`/`getCanCfg`/`getObd2Cfg`/`getConnCfg`）に空応答を実装する ※実機（Seeed XIAO ESP32C3, COM5）書き込み・動作確認済み。`firmware/src/main.cpp`に`rcpSendCapabilities()`（HANDOFF.md記載の通り`flags`を空リスト、`channels.*`と`db.tracks/sectors`を全て0にして条件付き追加コマンドを回避）と`rcpSendEmptyObjectResponse()`（`lapCfg`/`trackCfg`/`canCfg`/`obd2Cfg`/`connCfg`共通の空オブジェクト応答）を追加し、`rcpHandleMessage`にディスパッチを追加。PCから6コマンドを順に送信し、`{"capabilities":{...}}`および各`{"xxxCfg":{}}`が期待通り返ることを確認
- [x] 1-3-4: 実機（XIAO ESP32C3）をPCに接続し、公式RaceCaptureアプリが実機を認識・接続完了するか確認する（Phase1-3の最重要マイルストーン）※`firmware/src/main.cpp`（1-3-1〜1-3-3実装済みのRCP受信タスク）をビルドし実機（COM5）へ書き込み・動作確認済み。PCの公式RaceCaptureアプリ(Windows版)を起動したところ、`Searching COM5`表示後に自動接続し、タイトルバーに実機の`getVer`応答由来のバージョン文字列（`RaceCapture/Pr...32-c3-proto-build`）が表示され、接続状態インジケーターが点灯。セットアップウィザードをスキップしてメイン画面（Dashboard/Analysis/Setup）まで到達し、SetupのFirmwareタブでReboot/Update Firmware/Factory Reset（いずれも実機接続時のみ有効化される操作）が有効表示されていることを確認し、実機との接続完了を確認した
- [x] 1-3-5: `getMeta`応答（ダミーチャンネル定義）を実装する ※実機（Seeed XIAO ESP32C3, COM5）書き込み・動作確認済み。`firmware/src/main.cpp`に`rcpSendMeta()`を追加し、`rcp_mock_device.py`のCHANNELSと同内容のダミーチャンネル定義(RPM/Speed/WaterTemp/OilPress/Lat/Lon)を`{"meta":[...]}`として返す実装（1-3-6でも同じ定義を流用予定）。PCから`{"getMeta":null}\r`を直接送信し、`{"meta":[{"nm":"RPM",...},...,{"nm":"Lon",...}]}`が正しく返ることを確認。**副産物として重要なバグを1件修正**：`usb_serial_jtag_write_bytes`は内部のTXリングバッファ(デフォルト256バイト)を超えるサイズを一度に渡すと、`portMAX_DELAY`で待っても入る余地がないため即座に失敗する(`getVer`/`getCapabilities`等256バイト未満の既存応答では顕在化していなかった)。`rcpSendJsonLine`を128バイトチャンク分割送信に修正して解消。既存コマンド(`getVer`/`getCapabilities`/`getLapCfg`/`getConnCfg`)への影響がないことも回帰確認済み。
- [x] 1-3-6: `s`コマンドへダミーテレメトリ値を返す実装をし、公式アプリのダッシュボードに数値が表示・変動することを確認する（Phase0のモックで確認できた内容を実機で再現） ※実機（Seeed XIAO ESP32C3, COM5）書き込み・動作確認済み。`firmware/src/main.cpp`に`rcpSendSample()`を追加し、`rcp_mock_device.py`の`sample_values()`と同じ考え方（sin波ベースの緩やかな変動）でkDummyChannels（RPM/Speed/WaterTemp/OilPress/Lat/Lon）6ch分のダミー値を`{"s":{"t":<tick>,"d":[...],}}`形式で生成し、`s`コマンド受信の都度返す実装（HANDOFF.md記載の通り、接続後アプリが`{"s":0}`を約1Hzでポーリングしてくる仕様に合わせ、自発的なストリーミング送信ではなく応答ベースで実装）。公式アプリ(Windows版)でダッシュボードに数値が表示され、変動することを確認した。
- [x] 1-3-7: 1-1で作ったタスク構成に、1-3のRCP応答処理をタスクC側へ統合する ※実機（Seeed XIAO ESP32C3, COM5）書き込み・動作確認済み。それまで独立タスク`rcpReceiveTask`として動いていたUSB CDC受信・RCP応答処理（`firmware/src/main.cpp`）を、1-1で作ったタスクC本体へ統合（`rcpReceiveTask`は削除）。統合後のタスクCは1ループ内で(1)タスクAのダミー値キューを非ブロッキングでPopしてログ出力、(2)USB CDC経由のRCPメッセージ受信・応答、の両方を行う。あわせてapp_mainで1-3-1時点でコメントアウトしていたhelloTask/queuePushTask/queuePopTask/taskA/taskB/taskCの起動を復活（1-1-6の優先度設計：タスクB=最優先／タスクA=高優先／タスクC=低優先のまま）。PCから直接`{"getVer":null}\r`を送信し、他タスクのデバッグログ（`[helloTask] alive`等）が混在する中でも`[taskC] rcp message: {"getVer":null}`のログと共に正しい`{"ver":{...}}`応答が返ることを確認。公式アプリでの見た目確認はユーザー側で実施し、他タスクのデバッグログ混在下でも正常に接続・動作することを確認済み。

---

## 1-2: SD保存の信頼性検証 ※P-1/P-2到着済み、配線着手可
> ユーザー判断により、C3のSPI暫定配線を経由せず、S3向けSDMMC配線を先行して進める方針に変更（ARCHITECTURE.md「SDカードインターフェースの設計方針」参照）。ピン割り当て案：CLK=GPIO12/CMD=GPIO11/D0=GPIO13/D1=GPIO14/D2=GPIO9/D3=GPIO10、CLK/CMD/D0-D3全ラインに10kΩプルアップ必須。
- [x] 1-2-1: SDモジュールを配線し、ESP-IDFのFATFSサンプルでマウント・簡単な書き込みテストができることを確認する ※実機（ESP32-S3-DevKitC-1 N16R8, COM7）で動作確認済み。`firmware/src/main.cpp`/`platformio.ini`が別チャットの1-4作業(S3 USB OTG移行)と競合するため、`firmware/usb_otg_test`と同じ考え方で`firmware/sd_card_test/`を独立したPlatformIOプロジェクトとして新規作成（ESP-IDF公式sdmmcサンプルを土台に、上記ピン割り当てをハードコードしたマウント→書き込み→読み込み→アンマウントの検証コード）。当初4bitモードで`sdmmc_read_sectors_dma: sdmmc_send_cmd returned 0x109`（ESP_ERR_INVALID_CRC）でマウント失敗したが、1bitモード(CLK/CMD/D0のみ)では成功したためD1/D2/D3のいずれかを疑い切り分け。ESP-IDF公式のピン診断ロジック(`sd_test_io`相当、C++に簡略移植)で全6本のプルアップ応答は正常と判明（断線ではない）。**最終的にGND配線を2本追加（4bit同時スイッチング時のリターン電流経路強化）したことでCRCエラーが解消**し、4bitモード・デフォルトクロック(20MHz)でマウント・ファイル書き込み・読み込み・アンマウントが正常動作することを確認した（`SSR: bus_width=4`、`Speed: 20.00 MHz`）。ブレッドボード配線でSDMMC 4bitを使う際はGNDのリターン電流経路（複数本での強化）が重要という知見を得た。プルアップ抵抗は10kΩ×3・4.7kΩ×3の混在構成で問題なし。検証用コードは`firmware/sd_card_test/`に残置（本開発`firmware/`側への統合は1-2-3以降で実施）
- [x] 1-2-2: リングバッファ（タスクA→タスクB間）のデータ型・サイズを設計する ※`firmware/src/main.cpp`に`SensorLogRecord`構造体（timestampMs／GPS: lat・lon・speedKph／IMU 6軸: accelX-Z・gyroX-Z／CAN・OBD2由来: rpm・waterTempC・oilPressKpa）を追加。SD保存CSVの1行に対応する想定で、GPS/IMU/CANいずれも実センサー未調達のため現時点は全フィールドをダミー値（sin波ベースの緩やかな変動）で埋める実装とした。リングバッファ本体は既存キュー(1-1-2/1-1-3)と実装方式を揃えFreeRTOSキュー(`taskAToTaskBQueueHandle`)とし、要素数は64（ログレート50Hz=20ms/レコード想定・SDカード書き込みのレイテンシスパイク(数百ms級)を吸収できるよう約1.28秒分を確保、1レコード約64バイト×64個で数KB程度とRAMに対して十分小さい）とした。taskA内で既存のダミーカウンタ生成に加えて`SensorLogRecord`のダミー値を生成しこのキューへPushする処理を追加（Pop側のタスクBは1-2-3で実装予定のため、それまではキューが満杯になり"dropped"ログが出続けるのは想定内）。C3/S3両環境でビルド成功を確認済み（実機書き込み・動作確認は1-2-3のタスクB実装と合わせて実施予定）。
- [x] 1-2-3: タスクB（SD書き込み役）の雛形を作り、ダミーデータをCSV形式でSDに書き込む ※実機（ESP32-S3-DevKitC-1 N16R8、COM7/COM8）書き込み・動作確認済み。`firmware/src/main.cpp`のtaskBを、1-2-1で確認済みのピン配置(CLK=GPIO12/CMD=GPIO11/D0=GPIO13/D1=GPIO14/D2=GPIO9/D3=GPIO10、SDMMC 4bit)でSDカードをマウントし、`taskAToTaskBQueueHandle`(1-2-2)からPopした`SensorLogRecord`をCSV形式(ヘッダー行`timestampMs,lat,lon,speedKph,accelX,accelY,accelZ,gyroX,gyroY,gyroZ,rpm,waterTempC,oilPressKpa`)で`/sdcard/log.csv`へ追記(都度flush)する実装に置き換えた。C3はSDMMCホストペリフェラル非搭載のためSD保存機能自体をスコープ外とし、`#if CONFIG_IDF_TARGET_ESP32S3`で分岐して1-1-6のダミー処理をそのまま残した(C3向けビルドへの影響なし、Flash 20.5%/RAM 3.4%で変更前と同等)。あわせて`firmware/src/CMakeLists.txt`のS3向けREQUIRESに`esp_driver_sdmmc`/`sdmmc`/`fatfs`/`driver`を追加(`firmware/sd_card_test/`の実装に倣う)、taskBのスタックサイズをS3限定で2048→4096へ拡大(FATFS処理のスタック消費を考慮)。実機（MAC e4:b0:63:b3:69:44）書き込み後、起動ログで`I (856) sd_log: SD mounted at /sdcard`(Type: SDHC, Size: 29820MB, SSR: bus_width=4, Speed: 20.00 MHz、1-2-1と同条件)を確認し、以降taskBが継続的に`[taskB] wrote record t=... to SD`を出力し続けクラッシュ・リブートなく安定動作することを確認した。flush頻度の最適化(何行毎/何ms毎か)は1-2-4で対応予定のため、1-2-3時点では都度flushの暫定実装とした。
  - ⚠️ **未検証事項**：上記の「書き込み成功」はあくまでシリアルログ（`[taskB] wrote record ...`というアプリ側の自己申告ログ）による間接確認であり、SDカードを実機から取り出してPC側で`/log.csv`を直接開き、CSVの中身（行数・列の値・文字化けの有無等）を目視確認したわけではない。1-2フェーズ完了時の申し送り事項として下記に記載。
- [x] 1-2-4: `flush()`のタイミング（何行毎/何ms毎）を決めて実装する ※実機（ESP32-S3-DevKitC-1 N16R8、COM7）書き込み・動作確認済み。1-2-3時点の「都度flush」は行数ベースでキューの詰まり具合に左右されるため、経過時間ベース（`esp_timer_get_time()`で計測、500ms間隔）に変更。500msという値は、taskAの生成間隔(100ms)基準で最大5レコード分をまとめて書き込みSDカードへの書き込み頻度を下げつつ、電源断時に失われうるデータを最大500ms分に収めるバランスで選定。`xQueueReceive`がタイムアウトした場合でも間隔の上限を守れるよう、Pop成否に関わらず毎ループで経過時間をチェックする実装にした。**実機検証で重要な問題を発見・修正**：`fflush()`のみの実装でSDカードを実機の通電中に抜いたところ、`log.csv`が0バイトのままだった。原因はESP-IDFの`vfs_fat_write()`実装（`components/fatfs/vfs/vfs_fat.c`）にあり、`fflush()`はCライブラリのバッファをFATFSの`f_write()`まで渡すだけで、ディレクトリエントリ（ファイルサイズ含む）の実ディスクへのコミットは`CONFIG_FATFS_IMMEDIATE_FSYNC`（既定無効）が有効でない限り行われない仕様と判明。`fflush()`に加えて`fsync(fileno(logFile))`（内部で`f_sync()`を呼ぶ）を明示的に呼ぶよう修正し、ボードの電源を正しく切った状態でSDカードを取り出してPC上で`log.csv`を直接確認したところ、32768バイト・346行のCSVデータ（ヘッダー行含む）が正しく記録されていることを確認した。**重要な知見**：ESP-IDFのFATFSで電源断保護を狙う場合、`fflush()`だけでは不十分で`fsync()`が必須。
- [x] 1-2-5: 通電中にUSBケーブルを強制的に抜く（擬似電源断）テストを複数回行い、直前まで書いたデータが壊れずファイルに残っているか確認する ※実機（ESP32-S3-DevKitC-1 N16R8、COM7/COM8）で電源断テストを複数回実施し、SDカードを取り出してPC上で`log.csv`の中身を直接確認した（行数・末尾内容の確認に加え、全行の列数チェックスクリプトで異常行を検出する方式で検証）。1-2-4までの実装（`fflush()`+`fsync()`、500ms間隔）により、どのタイミングで電源を切っても直前までのデータは一貫して保全されることを確認した（最悪でも電源断の瞬間に書き込み中だった最後の1行が途中で切れる程度で、それより前のデータが失われることはなかった）。
  - **実機テストで新たに2件の不具合を発見・修正**：
    1. 末尾行が改行(`\n`)なしのまま電源断した状態で再起動すると、単純な追記(`fopen(path,"a")`)では新しいレコードがその壊れた行の続きとして連結され、CSVの列数が合わない壊れた行になってしまう不具合を発見。
    2. 対策として、追記用ハンドル自体を`"a+"`(読み書き両対応)にして起動時に末尾1バイトを`fgetc()`で確認する実装を最初に試したが、ESP-IDFのFATFS VFS層はO_APPENDフラグが立ったハンドルの読み込み位置も常に末尾へ強制してしまうらしく、`fgetc()`が常にEOFを返し「改行で終わっていない」と誤判定、既に改行済みの正常な行の後にも毎回余計な空行を挿入してしまう二次的な不具合を実機テストで発見。
    3. 最終的に、末尾確認は読み込み専用(`"r"`)の別ハンドルで行い、書き込み用の追記ハンドル(`"a"`)とは完全に分離する実装(`firmware/src/main.cpp`のtaskB起動処理)に変更して解消。修正後、複数回の実機電源断テスト（意図的に書き込み中(`[taskB] wrote record ...`出力中)にケーブルを引き抜くケースを含む）で、余計な空行の挿入・行の連結のいずれも発生しないことを確認した。
  - これにより**1-2フェーズ（SD保存の信頼性検証）が全体完了**。

> **1-2フェーズ完了時の申し送り事項（解消済み）**：1-2-3時点でのSD書き込み動作確認はシリアルログ（ESP32側の自己申告）による間接確認のみだったが、1-2-4・1-2-5でSDカードを実機から取り外しPC上で`log.csv`の中身を直接確認する検証まで実施済み。1-2-5では複数回の電源断テストいずれも、SDカードを取り出してPC上で内容を目視・スクリプトで確認する直接検証を行った（詳細は上記1-2-5参照）。

> **2026-08レビューで新たにタスク化（未着手、実車運用前に要対応。ARCHITECTURE.md 7章参照）**：
- [x] 【廃止 2026-10-28：旧プロトタイプ`firmware/src/main.cpp`が前提。`firmware/logger_v1`の`storage.cpp`でセッションごとのファイル・推定UTC・満杯時の退避まで実装済みで、実機の確認はToDoボードのt050（SD異常系の試験）で行う】1-2-6: セッション区切りと絶対時刻（UTC）の設計・実装 ※現状は固定ファイル名`/sdcard/log.csv`への追記のみで、電源再投入のたびに同一ファイルへ連結され、タイムスタンプ（`timestampMs`＝起動からの経過ms）も0付近へ巻き戻る。①起動（または記録開始）ごとに新しいログファイルを作成するセッション分割、②GPSのUTC時刻取得後にログへ絶対時刻を記録する仕組み（GoPro動画同期のための必須要件）、③UTC取得前に書かれたレコードの扱い（後から補正するか、相対時刻のまま残すか）を設計・実装する。GPS UTC部分はGPSモジュール調達（1-5のGPS側）待ちだが、①のセッション分割は現時点で着手可能
- [x] 【廃止 2026-10-28：旧プロトタイプ`firmware/src/main.cpp`が前提。`firmware/logger_v1`の`storage.cpp`でセッションごとのファイル・推定UTC・満杯時の退避まで実装済みで、実機の確認はToDoボードのt050（SD異常系の試験）で行う】1-2-7: SDカード満杯・書き込み失敗時の挙動設計・実装 ※現状は`fprintf`等の戻り値を確認しておらず、満杯・カード異常で記録が止まっても検知・通知されない。①書き込み失敗の検知とリトライ／再マウント方針、②空き容量の監視と満杯時の方針（古いセッションファイルの自動削除か、記録停止＋警告か）、③異常をステータスLED・RCPステータス（`getStatus`応答）へ反映する仕組みを設計・実装する

---

## 1-4: ESP32-S3への切り替え ※ESP32-S3実機を調達済みのため分解。配線不要（1-4-1〜1-4-4はUSB接続のみ）
> 背景：1-6でESP32-C3のネイティブUSB(USB Serial/JTAG)がスマホ版公式アプリに拒否されることが判明し、S3移行が必須と結論済み（[1-6-5](#1-6-スマホ版racecaptureアプリとのusb-otg通信検証-追加ハードウェア不要--完了結論esp32-s3移行が必須)参照）。S3は本物のUSB OTGペリフェラルを持ち、TinyUSBでCDC専用ディスクリプタを構成できる見込み。
- [x] 1-4-1: `firmware/platformio.ini`にS3用環境（`env:esp32-s3`）を追加する ※PC上でのビルド確認のみ完了（実機書き込みは未実施）。公式ボード定義は`esp32-s3-devkitc-1`（N8/PSRAMなし版）が最も近く、手持ちのN16R8（16MB Flash/8MB Octal PSRAM）との差分は`board_build.esp-idf.custom_sdkconfig`（`CONFIG_ESPTOOLPY_FLASHSIZE_16MB`/`CONFIG_SPIRAM`/`CONFIG_SPIRAM_MODE_OCT`/`CONFIG_SPIRAM_SPEED_80M`）で上書きする方式にした。実機のFlash/PSRAM構成に対してこの設定が正しいかは1-4-3（実機書き込み）で要検証。既存`main.cpp`（1-1〜1-3・1-7実装済み）は無変更のままS3向けにビルド成功（Flash 22.0%/RAM 4.9%）。既存のC3環境(`esp32-c3-proto`)も回帰確認し、引き続きビルド成功することを確認済み。なお現状の`main.cpp`は`driver/usb_serial_jtag.h`（USB Serial/JTAGペリフェラル）をそのまま使っており、これはC3で問題になった「スマホ版公式アプリが接続を拒否する」件を解消しない実装のまま。ネイティブUSB OTG経由のTinyUSB CDCへの置き換えは1-4-2以降で対応する。 ※【1-4-2で判明した訂正】ここで使った`board_build.esp-idf.custom_sdkconfig`は、実際には使用中のespressif32プラットフォーム(7.0.1)で実装されておらず静かに無視されていたため、Flash 16MB/PSRAM設定はこの時点では実機に反映されていなかった。1-4-2で`firmware/sdkconfig.esp32-s3`を直接編集する方式に切り替えて解消済み（詳細は1-4-2参照）。
- [x] 1-4-2: 1-1〜1-3で実装済みの`main.cpp`がS3向けにビルドが通ることを確認する（C3固有のUSB Serial/JTAG API呼び出し箇所があればTinyUSB CDC APIへの差し替えが必要） ※PC上でのビルド確認のみ完了（実機書き込みは1-4-3で実施）。1-4-1時点でC3固有のUSB Serial/JTAG API呼び出し箇所（`usb_serial_jtag_read/write_bytes`等）が残っていたため、`firmware/src/main.cpp`のUSB送受信部分を`rcpUsbInit`/`rcpUsbWriteBytes`/`rcpUsbReadBytes`という共通インタフェースに抽象化し、`#if CONFIG_IDF_TARGET_ESP32S3`でC3(USB Serial/JTAGのまま)とS3(TinyUSB CDC ACM)に実装を分岐した。RCPメッセージ処理本体（`rcpHandleMessage`等）は無変更。TinyUSB本体(`espressif/tinyusb`)はESP-IDF Component Manager経由（`firmware/src/idf_component.yml`）で導入。TinyUSB本体のtargets制約（S2/S3/P4/H4のみ対応、C3非対応）により、依存に`rules: - if: "target in [esp32s3, esp32s2, esp32p4]"`を付けてC3ビルドで依存解決エラーにならないようにした。あわせて`firmware/src/CMakeLists.txt`もS3の時だけ`espressif__esp_tinyusb`を`REQUIRES`する条件分岐に変更。**副産物として重要な不具合を発見**：使用中のespressif32プラットフォーム(7.0.1)では`board_build.esp-idf.custom_sdkconfig`オプションが実装されておらず、`platformio.ini`に書いても静かに無視されていた（1-4-1で設定したFlash 16MB/PSRAM設定も実際には反映されていなかった）。対応として、自動生成される`firmware/sdkconfig.esp32-s3`ファイルを直接編集（Flash 16MB・Octal PSRAM・`CONFIG_TINYUSB_CDC_ENABLED=y`を有効化）し、リポジトリにコミットして管理する方式に変更した。また、TinyUSB CDCの送信API`tinyusb_cdcacm_write_queue()`はTX FIFOの空き容量を超える分を黙って切り捨てる仕様と判明したため、C3の`usb_serial_jtag_write_bytes`と同様に、キューできたバイト数を見ながらflushを挟んで全バイト書き切るまでループする実装にした。最終的に`esp32-s3`環境（Flash 25.1%/RAM 6.0%、TinyUSB CDC込み）・`esp32-c3-proto`環境（Flash 20.4%/RAM 3.4%、変更前とほぼ同サイズで影響なし）の両方でクリーンビルド成功を確認した。
- [x] 1-4-3: S3実機をPCへ接続し、公式RaceCaptureアプリ(Windows版)で接続できることを確認する（C3で確認済みの内容の回帰確認） ※実機（ESP32-S3-DevKitC-1 N16R8、MAC e4:b0:63:b3:69:44）書き込み・動作確認済み。ボードはUSBコネクタ1本でUART(CH343ブリッジ、書き込み用)とネイティブUSB(TinyUSB CDC、RCP通信用)の両方が別々のCOMポートとして列挙されるタイプで、`pio run -e esp32-s3 -t upload --upload-port <UARTポート>`でのシリアルブートローダー書き込みに成功。公式アプリ(Windows版)を起動したところ、ネイティブUSB側のCOMポートへ自動接続し、Setup画面のFirmwareタブでReboot/Update Firmware/Factory Reset（実機接続時のみ有効化される操作）が有効表示されることを確認。**副産物として重要な不具合を発見・修正**：`rcpSendVer()`の`fname`/`serial`/`git_info`がC3向け固定文字列（`esp32-c3 proto fw`/`C3PROTO01`/`esp32-c3-proto-build`）のままS3ビルドでもそのまま使われており、公式アプリのタイトルバーに実機はS3にも関わらず「ESP32-C3」の表示が出てC3実機との区別がつかない状態だった（ユーザー指摘により発覚）。1-4-2と同じ`#if CONFIG_IDF_TARGET_ESP32S3`分岐でS3用の文字列（`esp32-s3 proto fw`/`S3PROTO01`/`esp32-s3-proto-build`）を追加し、再書き込み・再接続してタイトルバーに`...32-s3-proto-build`が表示されることを確認した。
- [x] 1-4-4: S3実機をスマホへUSB OTG接続し、スマホ版公式RaceCaptureアプリで接続できるか確認する（1-6で断念した最重要ゴール。配線不要）※実機（ESP32-S3-DevKitC-1 N16R8、COM7=CH343書き込み/COM8=TinyUSB CDC RCP通信）＋スマホ（Pixel 9a）で達成。最初はEspressifデフォルトVID/PID(`0x303A`/`0x4001`)のまま試したが、公式RaceCaptureアプリは完全に無反応（エラー表示すらなし）だった。一方Android汎用の「Serial USB Terminal」アプリ（VID/PID非依存でCDC ACMとして汎用的に接続する実装と推定）では`{"getVer":null}`を送信するとJSON応答が返り、TinyUSB CDC側の実装自体は正常であることを確認できた。この差から、公式RaceCaptureアプリ(Android版)がUSBデバイスをVID/PIDでフィルタしている可能性を疑い、`reference/RaceCapture-Pro_firmware/platform/mk3/hal/usb_stm32/usbd_desc.c`で公式MK3ファームウェアのVID/PID(`0x16D0`/`0x07F1`)を確認。`firmware/sdkconfig.esp32-s3`の`CONFIG_TINYUSB_DESC_CUSTOM_VID`/`CONFIG_TINYUSB_DESC_CUSTOM_PID`をこの値に変更し再書き込みしたところ、公式RaceCaptureアプリが自動的にデバイスを認識・接続し、Podium Connect設定・LiveTelemetry表示まで動作することを確認した。**副産物として新たな不具合を発見**：1回目の接続後、USBケーブルを一度引き抜き（ESP32側は再起動された）、アプリも一度終了してから再接続したところ、2回目はLiveTelemetry画面がフリーズしたような挙動になった。Podium Connect設定自体は消えておらず、LiveTelemetry表示は接続中のみ更新される様子だったため、データ自体は更新されている可能性がある（表示側の問題の可能性）。原因未特定・再現条件の切り分けは未実施のため、7章「未解決事項」に記録して保留とする。**倫理面の注記**：VID/PID `0x16D0`/`0x07F1`は公式RaceCapture(Autosportlabs)がMK3ファームウェアで使用している値であり、個人のプライベートリポジトリでの検証目的として一時的に借用している。将来リポジトリを公開・配布する場合は`pid.codes`(VID `0x1209`)等で自分専用のPIDを取得することを検討する（GPLライセンスの扱いと同様、7章に記録）。
- [x] 1-4-5: SD接続をSPIからネイティブSDMMC（4bit）へ切り替える（要プルアップ抵抗の確認、ARCHITECTURE.md「7. 未解決事項」参照）※1-2のSPI実装完了後に着手 ※着手時点で、実際には1-2-1〜1-2-5がSPI実装を経由せず最初からSDMMC 4bitモードで実装・実機検証（電源断テスト含む）まで完了済みであったことが判明（`firmware/src/main.cpp`のtaskB実装はSPIコードを一度も持たず、`sdmmc_host.h`/`sdmmc_cmd.h`のみ使用）。念のため現行`main.cpp`を実機（ESP32-S3-DevKitC-1 N16R8、MAC e4:b0:63:b3:69:44、COM7）へ再書き込みし、RTSリセットパルスで起動ログから再確認したところ、`SD_HOST`初期化後`I (857) sd_log: SD mounted at /sdcard`・`SSR: bus_width=4`・`Speed: 20.00 MHz (limit: 20.00 MHz)`・`Type: SDHC`でSDMMC 4bitモードのマウント成功を確認し、以降`[taskB] wrote record t=... to SD`が継続的に出力され続けクラッシュなく安定動作することを確認した。プルアップ抵抗（10kΩ×3・4.7kΩ×3混在、1-2-1参照）も含め配線・実装とも追加対応不要、1-4-5は実質的に1-2-1〜1-2-5をもって完了済みだったことの確認のみで完結。
- [x] 1-4-6: スマホ版公式RaceCaptureアプリの2回目接続時の不安定動作（LiveTelemetry画面のフリーズ）の原因を調査する ※1-4-4で発見した不具合の追加調査。実機（ESP32-S3、COM7/COM8＋スマホPixel 9a）でユーザーに再現手順を実施してもらい、Wi-Fi経由のadb logcat（`adb pair`/`adb connect`でワイヤレスデバッグ接続）でアプリ側ログを採取・解析して原因を特定した。
  > **結論：原因は公式アプリ(Android/Kivy版、パッケージ`com.autosportlabs.racecapture`)側の実装バグと特定、自作ロガー側では対策不可**。logcatをスレッドID別に解析したところ、`{"s":null}`（サンプルデータ要求、10Hz相当）を送り続けていたワーカースレッドが、USBケーブルを引き抜いた瞬間（ESP32再起動）を最後に二度と書き込みを再開しないことを確認した。一方、USB接続自体（`getVer`等の初期化コマンド）は再接続後も正常に再確立されており（`CdcAcmSerialDriver`ログでインターフェースのclaim成功、RCPAPI層のエラーも再接続後は解消）、アプリの「クラウドへアップロード中」インジケーターも点灯し続ける。つまり**「USB接続」自体は復活しているのに、サンプルデータをポーリングする内部ワーカーだけが再起動されず死んだままになる**というアプリ内部の状態管理バグであり、ESP32ファームウェア側は再接続後も応答自体は正常に返せている。Windows版アプリの「COMポートハンドルリーク」バグ（4章既出）と同様、サードパーティ製アプリ（ソース非保有）側の問題のため対策不可と判断し、ARCHITECTURE.md「7. 未解決事項」の該当行に記録して完了とする。
  > **副産物1：ストリーミングキー毎回入力問題の原因を特定**。ユーザーが「Podium Connectのストリーミングキーが接続のたびに必要になる」と報告した件について、logcatで`[TelemetryManager] Got new streaming key`が手動入力のたびに発火していることを確認した。ファームウェア側の`getConnCfg`/`setConnCfg`(`main.cpp`1224-1235行目)が現状ダミー応答（空オブジェクト）のみで、Podium接続設定（ストリーミングキー等）を保存・返却する実装になっていないことが原因と判明。1-4-7として追加分解し対応する。
  > **副産物2：`getStatus`コマンド未実装を発見**。ファームウェアのコマンドディスパッチャ(`main.cpp`1212-1248行目)に`getStatus`の分岐が存在せず無視されており、アプリの`StatusPump`が接続直後（1回目・2回目を問わず恒常的）から6秒おきに「timed out waiting for status response」を出し続けていたことをlogcatで確認した。1-4-8として追加分解し対応する。
- [x] 1-4-7: `setConnCfg`/`getConnCfg`を実データ化する（Podium接続設定・ストリーミングキー等をNVSへ永続化） ※1-4-6副産物1への対応。公式ファームウェア(`reference/RaceCapture-Pro_firmware/src/logger/loggerApi.c`のapi_getConnectivityConfig/api_setConnectivityConfig)を確認し、応答はbtCfg/cellCfg/telCfgの3ブロック構成、ストリーミングキーは`telCfg.deviceId`に対応することを確認した。本プロジェクトはUSB接続のみでBluetooth/Cellularハードウェアを持たないため、bt/cellは常に無効固定とし、`telCfg.deviceId`のみを1-7-2(AnalogCfg)・5-2-2(TrackCfg)と同じ`nvs_set_blob`/`nvs_get_blob`パターンでNVS永続化する`ConnCfg`構造体・`connCfgLoadFromNvs`/`connCfgSaveToNvs`を`firmware/src/main.cpp`に実装した。`setConnCfg`受信時は、setTrackCfg(5-1-3)と同様に公式アプリが"connCfg"キーで一段ラップして送ってくる可能性を考慮し、ラップの有無どちらでも受理できるようにした。`esp32-c3-proto`/`esp32-s3`両環境でクリーンビルド成功を確認（実機での再接続後のストリーミングキー保持確認は未実施、次回実機検証時の課題として残す）。
- [x] 1-4-8: `getStatus`コマンドを実装する ※1-4-6副産物2への対応。公式ファームウェア(`reference/RaceCapture-Pro_firmware/src/logger/loggerApi.c`のapi_getStatus)の応答仕様（`status.system`/`GPS`/`cell`/`bt`/`logging`/`track`のブロック構成）を確認し、本プロジェクトにハードウェアが無いcell/bt/imu/wifiブロックは省略、system/GPS/logging/trackのみを応答する`rcpSendStatus()`を実装した。GPS位置は`rcpSendSample`と同じ`simTrackGetPosition()`のシミュレーション軌跡を使用、loggingは"記録を絶対に止めない"方針上常時稼働の前提で固定値、trackは`g_trackCfg`/`g_lapDetector`の実データを反映した。`esp32-c3-proto`/`esp32-s3`両環境でクリーンビルド成功を確認（実機での`StatusPump`タイムアウト解消確認は未実施、次回実機検証時の課題として残す）。

## 1-5: GPS・IMUモジュール調達後の実センサ値検証
GPSは未調達のため、GPS関連サブタスクは現時点では分解しない。IMU基板（秋月AE-LSM6DSV16X、LSM6DSV16Xチップ）は調達済み・チップも確定したため、IMU部分のみ配線前後で分解する。参考資料：`other/check_AE-LSM6DSV16X_extracted/check_AE-LSM6DSV16X/check_AE-LSM6DSV16X.ino`（秋月電子の動作確認用Arduinoサンプル。I2Cアドレス0x6A(GND)/0x6B(VCC)、レジスタマップ(WHO_AM_I=0x0F・CTRL1=0x10・CTRL2=0x11・CTRL6=0x15・CTRL8=0x17・OUTX_L_G=0x22)、初期化ビットパターン、スケール係数(ジャイロ0.07dps/LSB・加速度0.000244g/LSB)がすべて確認済みのため、データシート参照なしでもESP-IDF移植に必要な情報は揃っている）。

> **方針追記（1-5-2完了直後、ユーザー確認により1-5-4以降を追加分解）**：ユーザーはオーバーステア/アンダーステア検出のため姿勢推定（Roll/Pitch/Yaw角度算出、斜め取り付け時の重力方向補正込み）を望んでいる。`reference/RaceCapture-Pro_firmware`を確認したところ、公式ファームウェアにも姿勢推定ロジックは無く（`getMeta`の「Yaw/Pitch/Roll」はジャイロ角速度の生値、`imu_calibrate_zero()`も各軸独立のゼロ点補正のみ）、自作で設計する必要があると判明。方針確認の結果：①姿勢推定はソフトウェア相補フィルタ（加速度でRoll/Pitchのドリフト補正＋ジャイロ角速度積分）から着手し精度向上は後回し、②Yawはジャイロ積分のみだと長期ドリフトするため磁力計を追加予定（既存IMU用I2Cバスへの相乗りを想定。GPSのCOGでの補正はスリップアングル検出という目的自体を潰すため不採用）、③斜め取り付け補正は起動時自動キャリブレーション（静止区間からセンサー座標系→車体座標系への変換を算出）、④GPSのCOGとヨーの差分によるスリップアングル算出はGPS調達後の別タスクへ先送り、の4点で合意（詳細はARCHITECTURE.md「Phase1-5：IMU(LSM6DSV16X)ドライバ実装の進捗」の訂正項目参照）。

- [x] 1-5-1: LSM6DSV16XのI2Cドライバ(ESP-IDFネイティブ、`driver/i2c_master.h`等)を実装する ※配線不要・実機不要、ビルド確認のみで完結（実機確認は1-5-3）。`firmware/src/main.cpp`にArduinoサンプル(`other/check_AE-LSM6DSV16X_extracted/`)のレジスタマップ・初期化シーケンス(CTRL1=0b00001001/CTRL2=0b00001001/CTRL6=0b00000100/CTRL8=0b10000010)・スケール係数(ジャイロ0.07dps/LSB・加速度0.000244g/LSB)をそのまま踏襲し、ESP-IDF新I2Cマスタードライバ(`driver/i2c_master.h`)で`imuInit()`/`imuReadSensor()`を実装した。`imuInit()`はI2Cバス初期化→0x6A/0x6Bへの順次プローブ(`i2c_master_probe`)→WHO_AM_I読み取り(期待値0x70)確認→初期化レジスタ書き込みの順で行い、いずれかの段階で失敗すれば`false`を返す(配線が無い現状は必ずここで失敗する想定)。`imuReadSensor()`はOUTX_L_G(0x22)から12バイト一括読み取りし、ジャイロ3軸+加速度3軸(リトルエンディアン16bit)をスケール変換して返す。I2Cピン(SDA/SCL)は配線未確定のため、SDMMC使用中のGPIOと衝突しない値を暫定選定(S3: GPIO2/GPIO1、C3: GPIO6/GPIO7=XIAOのQwiicコネクタ標準ピン)しコメントで明記、1-5-3で必要なら変更する前提とした。`driver/i2c_master.h`はC3/S3共通(SDMMCと異なりC3でもI2Cは使えるため)でincludeし、`CMakeLists.txt`のREQUIRES変更なしでも`esp32-c3-proto`/`esp32-s3`両環境でクリーンビルド成功を確認した(C3でも既存の`driver/usb_serial_jtag.h`と同様、明示REQUIRESなしでdriverコンポーネントが解決されることを確認)。
- [x] 1-5-2: IMUデータをtaskAのSensorLogRecord・CSVログ・RCPプロトコル(getMeta/sコマンド)へ統合する ※配線不要・実機不要、ビルド確認のみで完結（実機確認は1-5-3）。`SensorLogRecord`のaccelX/Y/Z・gyroX/Y/Zフィールドは1-2-2で既に追加済みだったため、taskA内でこれらをsin波ダミー値から1-5-1の`imuReadSensor()`実読み取りへ置き換えた。taskC(RCPストリーム)からも同じ値を参照できるよう、最新IMU値をファイルスコープの`g_imuAccelX`等6変数へ保持する方式(既存の`g_trackCfg`等と同様、排他制御なし)にした。配線が無い/通信失敗の間は`g_imuAvailable`(`app_main`で`imuInit()`の戻り値を保持)がfalseのままとなり、taskAは実読み取りをスキップして直近値(未接続時の初期値はZ軸1Gのみの静止姿勢相当)を送り続けるフォールバックとした。CSV列は1-2-2時点で既にaccelX〜gyroZが定義済みのため変更不要。`kDummyChannels`/`kLapChannels`と同様の`kImuChannels`配列(AccelX/Y/Z・GyroX/Y/Zの6ch)を追加し、`rcpSendMeta()`/`rcpSendSample()`に統合した(ビットマスクを15ch→21ch分に拡大)。AccelXのnm/ut/min/max/prec/srは`reference/RaceCapture-Pro_firmware`の実機応答例(`getMeta_response.json`)に合わせたが、同ファームウェアはジャイロ生値ではなくYaw/Pitch/Roll(要姿勢推定)を送る仕様と判明。**（訂正：完了直後に「本プロジェクトは姿勢推定を実装しない方針」と記載していたが誤り。実際には姿勢推定を実装する方針であり、1-5-4以降で対応する。）** ここではまず生の角速度をGyroX/Y/Zとして送るチャンネル(min/max=±2000dpsはCTRL2設定のフルスケールに整合)を追加した。姿勢推定チャンネル(Roll/Pitch/Yaw、単位: 度)は1-5-4/1-5-8で別途追加する。`esp32-c3-proto`/`esp32-s3`両環境でクリーンビルド成功を確認した。
- [x] 1-5-3: IMUを実機へ配線し、動作確認する → 完了。実機（ESP32-S3-DevKitC-1 N16R8、COM7=CH343書き込み/COM9=TinyUSB CDC）で`LSM6DSV16X initialized (addr=0x6A, SDA=2, SCL=1)`の応答、静止水平置きでの起動時キャリブレーション`gravity=(-0.007,0.022,0.996)G`（Z軸≈1G、期待通り）を確認した。

  **配線・原因切り分けの経緯**：当初、配線・電源・プルアップ・アドレス選択(6A)は全て正常に見えるにも関わらず、IMUがI2Cバス上で一切応答しない（`WHO_AM_I`読み取り不可、0x08〜0x77全アドレススキャンでも無応答）事象が発生し、テスターでの電圧・導通確認と一時的な全アドレススキャンコードで切り分けを行った。最終的に2つの原因が判明した。
  1. **CSピンの向きの誤り**：基板上の「CS」ジャンパ（6A/6B/I2Cと同じ並び）は、当初「CSをGNDへはんだ付けするのがI2Cモード」と誤って案内していたが、データシート(`datasheet/lsm6dsv16x.pdf`11ページ目「Table 2. Pin description」)に「CS=1(High/VDD側)でI2C/I3C通信有効、CS=0(Low/GND)でSPI通信モードとなりI2C/I3C無効」と明記されており**逆だった**。最終的にIMU基板の12本の外部ピンヘッダーのうち「CS」ピン（PINOUTS_R、SDA/SCLの並び）から3.3Vレールへ直接ワイヤーを追加し、Highへ固定して解消した。基板上の小さい「CS」ジャンパ（J4）はGNDへ接続する用途（あえてSPIモードへ切り替えたい場合用）なので、I2C運用では**はんだ付けしない**のが正解。
  2. **I2Cプローブのタイムアウトが短すぎた**：ブレッドボード配線の浮遊容量の影響とみられ、30〜50msのタイムアウトだとACKを取りこぼしていた。`imuInit()`のプローブタイムアウトを200msへ延長し、あわせてESP32内部プルアップを無効化（外部10kΩプルアップのみに一本化）、バス生成直後に50ms待機を追加したことで安定して応答するようになった（`firmware/src/main.cpp`に反映済み）。
  - 診断用に追加していた0x08-0x77全アドレススキャンの一時コードは、原因判明後に削除済み。
  - 上記以外に確認済みだった内容（誤りではなかったもの）：6A/6Bのアドレス選択、SDX/SCXのGND固定、SDA/SCLの配線・電源・プルアップ電圧は全て問題なし。
  - **後片付けの注意**：診断のため`firmware/src/main.cpp`の`imuInit()`内に「TEMP DEBUG (1-5-3配線確認用、後で削除)」というコメント付きの0x08-0x77全スキャンコードを一時的に追加済み（`i2c.master`ログに大量の`probe device timeout`が出るのはこのため）。原因解消を確認できたら、このデバッグコードは削除してから1-5-3を完了とすること。
  - 上記以外の確認済み事項（誤りではなかったもの）：6A/6Bのアドレス選択、SDX/SCXのGND固定、SDA/SCLの配線・電源・プルアップは全て問題なし。
- [x] 1-5-4: 相補フィルタによるRoll/Pitch姿勢推定ロジックを実装する ※配線不要・実機不要、ロジック実装とビルド確認のみで完結（実機での妥当性確認は1-5-6で実施予定）。`firmware/src/main.cpp`に、加速度3軸(車体座標系)から`atan2f`で重力方向のRoll/Pitch角度(度)を求める`imuAccelToRollPitchDeg()`と、ジャイロ角速度の積分値をこの角度で緩やかに補正する相補フィルタ`attitudeComplementaryFilterUpdate()`(`angle = alpha*(angle+gyro*dt) + (1-alpha)*accelAngle`、alpha=0.96の仮値、実機チューニングは1-5-6/1-5-8の申し送り事項で対応)を実装した。taskA内で1-5-5のキャリブレーション完了後・毎周期(実測dt、esp_timer_get_time()の差分)呼び出す。結果は`g_attitudeRollDeg`/`g_attitudePitchDeg`に保持し、`kAttitudeChannels`(Roll/Pitch各deg)としてRCPストリーム(`getMeta`/`s`応答)へも追加した(ビットマスクを21ch→23chに拡張)。Yawはこの段階では対象外(1-5-8で磁力計統合)。Pythonでの再実装検算(`verify_attitude.py`、使い捨てスクリプト)で、静止水平置きでRoll/Pitchが0度付近に収束すること、90dps/2秒の回転に加速度基準値へ1度未満の誤差で追従できること、ジャイロバイアス誤差(+2dps)を60秒間与えてもピュア積分(120度ドリフト)に対し相補フィルタは4.8度程度に抑えられることを確認した。`esp32-c3-proto`(Flash 24.5%/RAM 14.1%)・`esp32-s3`(Flash 36.7%/RAM 16.7%)両環境でクリーンビルド成功。
- [x] 1-5-5: 起動時自動キャリブレーション（取り付け角度補正）を実装する ※配線不要・実機不要、ロジック実装とビルド確認のみで完結（実機での妥当性確認は1-5-6で実施予定）。`firmware/src/main.cpp`のtaskA内で、開始後30サンプル(100ms周期・約3秒)分の加速度を`imuCalibrationUpdate()`で収集して分散を判定し、静止とみなせる区間の平均加速度ベクトル(センサー座標系の重力方向)から、車体座標系の上方向(0,0,1)へ合わせる3x3回転行列をロドリゲスの回転公式(`mat3RotationBetweenVectors()`)で算出する実装にした(分散閾値0.01G²は仮値、規定サンプル数に達すれば分散超過でも警告ログを出しつつ確定させ、姿勢推定が永久に始まらない状態を避ける)。以降のIMU値は`g_bodyAccelX/Y/Z`・`g_bodyGyroX/Y/Z`(車体座標系、1-5-4の相補フィルタ入力用)として保持し、既存の`g_imuAccelX/Y/Z`・`g_imuGyroX/Y/Z`(センサー座標系の生値、SD/RCPログ用)とは分離したためログ出力の意味は変えていない。取り付け角度を変えた場合は再起動するだけで再キャリブレーションされる設計（ユーザー方針通り）。Pythonでの再実装検算(`verify_attitude.py`)で、恒等変換(水平置き)・90度/180度(反平行)/45度傾斜のいずれのケースでも、静止時の重力ベクトルが正しく車体座標系のZ軸(0,0,1)へ回転されることを確認した。両ビルド環境でクリーンビルド成功(詳細は1-5-4参照、同一コミットでの変更)。実機での妥当性確認(分散閾値の現物合わせ含む)は1-5-3完了後、1-5-6で対応する。
  - ✅ **追加対応：ジャイロ3軸のゼロ点オフセット除去を実装（1-5-3完了後、実機確認済み）**。1-5-8の申し送り事項として実測した「静止90分でgyroZが約8.22度/分ドリフトする（gyroZ平均バイアス0.137dps）」という結果を受け、`imuCalibrationUpdate()`の加速度と同じ静止ウィンドウ(30サンプル・約3秒)でジャイロ3軸の平均値も同時に集計し、`g_imuGyroBiasX/Y/Z`として保持、車体座標系への変換直前(`g_bodyGyro*`算出時)に差し引くよう変更した。ジャイロの生値(`g_imuGyroX/Y/Z`、SD/RCPログ用)はこれまで通りバイアス除去前の値のまま(ログの意味を変えない)。実機（ESP32-S3-DevKitC-1 N16R8、COM7）で再起動して確認したところ`gyro bias(dps): (-0.296,0.044,0.135)`と表示され、90分測定時の値(-0.293,0.058,0.137)とほぼ一致し、バイアスが電源投入のたびに安定して再現することを確認した。Yaw方向への統合(1-5-8、磁力計待ち)はまだ実装していないが、Roll/Pitch側の相補フィルタにも僅かながら精度改善効果があると見込まれる。
- [x] 【廃止 2026-10-28：LSM6DSV16X＋自作の相補フィルタが前提。IMUはBNO055（姿勢推定・磁力計・校正状態を内蔵）に替わり、`firmware/logger_v1`は水平の0点合わせと校正値の保存（ボードt060）で代わりにしている】1-5-6: 実機でRoll/Pitch姿勢推定・起動時キャリブレーションの妥当性を確認する ※実機・配線が必要(1-5-3完了後)。複数の取り付け角度(水平、傾けた状態)でボードを固定し、起動直後の自動キャリブレーション後にRoll/Pitch推定値が概ね0度付近に収束すること、意図的に傾けた際に推定値が追従することをシリアルログで確認する。
- [x] 【廃止 2026-10-28：LSM6DSV16X＋自作の相補フィルタが前提。IMUはBNO055（姿勢推定・磁力計・校正状態を内蔵）に替わり、`firmware/logger_v1`は水平の0点合わせと校正値の保存（ボードt060）で代わりにしている】1-5-7: 磁力計モジュールを選定・調達する ※型番候補の調査・取り付け位置検討まで完了、**購入操作はユーザー実施待ち**（決済を伴うため代行不可）。秋月電子のカテゴリページ・商品検索を確認したところ、候補に挙げていたLIS3MDL搭載モジュールは秋月では現在単体販売されておらず（スイッチサイエンス等サードパーティのみ）、秋月で調達可能なI2C接続の単体地磁気センサモジュールは**AE-BM1422AGMV**（ROHM製BM1422AGMVチップ、通販コードg129354、¥980税込、在庫あり）のみと判明したため、これを採用候補とする。スペック：I2C接続（レベルコンバーター・レギュレーター搭載で3.3V/5V両対応）、測定範囲±1200μT（地磁気は数十μT程度のため十分な余裕）、I2Cスレーブアドレスは`ADDR`ピンで0x0E(L)/0x0F(H)を選択可能（Web調査、データシート要最終確認）で既存IMU(LSM6DSV16X、0x6A/0x6B)と衝突しない。ピンヘッダーに加えSTEMMA/Qwiic互換JST SHコネクタも搭載。ROHM製評価ボード(BM1422AGMV-EVK-001)用のArduinoサンプルコード・ライブラリが流用可能（[メーカーサンプルソース](https://www.rohm.co.jp/sensor-shield-support/bm1422agmv)）で、1-5-1のLSM6DSV16X移植と同じ進め方（サンプルのレジスタマップ・初期化シーケンスをESP-IDFへ移植）が取れる見込み。商品ページ：https://akizukidenshi.com/catalog/g/g129354/ 。取り付け位置は、Phase4の筐体化がまだ未着手のため確定不要だが、方針として①IMU基板（既存I2Cバス共有のため同じ筐体内に置く想定）をバッテリー・オルタネーター本体・スターターケーブル等の大電流配線から30cm以上離す、②車体の金属パネルに密着させず絶縁体（ダッシュボード上のプラスチック部等）越しに設置する、③動的な磁気干渉（オルタネーター電流変動等）は1-5-8で適応ゲイン方式により別途緩和する設計のため、静的な位置決めは「明らかに悪い場所（大電流配線の真上等）を避ける」程度で十分、の3点を確認した。**次のアクション：ユーザーが上記商品ページから購入操作（決済）を実施** → 到着後、1-5-8着手時に実配線・アドレス確定を行う。
- [x] 【廃止 2026-10-28：LSM6DSV16X＋自作の相補フィルタが前提。IMUはBNO055（姿勢推定・磁力計・校正状態を内蔵）に替わり、`firmware/logger_v1`は水平の0点合わせと校正値の保存（ボードt060）で代わりにしている】1-5-8: 磁力計を使ったYaw(ヨー)ドリフト補正を実装する ※1-5-7調達後に着手。地磁気ベクトルから絶対方位を算出し、1-5-4の相補フィルタにYaw成分を追加する（ジャイロYaw積分を主、磁力計を弱め・緩やかな重みで長期ドリフトのみ補正する設計とし、車載環境での瞬間的な磁気干渉の影響を抑える）。`kImuChannels`または新規チャンネルとしてRoll/Pitch/Yaw(度)をRCPストリームへ追加する。
  - **動的磁気ノイズ対策**：オルタネーター・モーター電流等による時間変化する磁気干渉はハード/ソフトアイアン補正（静的な歪みの事前補正）では取り除けないため、磁場ベクトルの大きさ(ノルム)を毎サンプル監視し、キャリブレーション済みの期待値(その地点の地磁気の強さ)から一定以上ズレたサンプルは「汚染されている」とみなしてYaw補正への寄与を弱める適応ゲイン方式を実装する(Mahonyフィルタ等で使われる手法)。
  - **磁力計補正の時定数チューニング手順（現物合わせが必要な部分）**：`datasheet/lsm6dsv16x.pdf`のジャイロ仕様(`G_OffDr`: 温度ドリフト±0.006 dps/°C)から、走行中の温度変化を踏まえると数十秒スケールでの蓄積誤差が無視できなくなると推定されるが、恒温下での長期バイアス安定性(Allan varianceのbias instability相当)の直接スペックはデータシートに記載が無く実測が必要。手順：①IMUを静止させジャイロのみの積分でYawを計算し、時間経過に対するドリフト量(度/分)を実測する、②許容誤差(目安1〜2度)に達するまでの時間を求める、③その時間より十分短く、かつ実際の操舵(0.1〜2秒スケールの急峻な変化)を鈍らせない範囲でなるべく長い時定数(出発点の目安: 10〜30秒程度)を選ぶ。1-5-6の実機確認時に測定データを取得し、この手順で決定した時定数を記録する。
  - ✅ **①のジャイロ単体ドリフト実測完了（1-5-3後、実機ESP32-S3・水平静置90分間、`log.csv`解析）**：`gyroZ`（Yaw方向角速度）の平均値が0.137dps（本来静止中は0のはず）というバイアスを持っており、90.05分間の台形積分で合計739.92度、**ドリフト率換算で約8.22度/分**という結果になった。ノイズの蓄積というよりバイアスによるほぼ直線的なドリフトが支配的。許容誤差1〜2度への到達時間は約7〜15秒しかなく、想定（数十秒スケール）よりかなり速い。②③の時定数決定は磁力計調達(1-5-7)後に対応する。**バイアス除去自体は磁力計を待たずに1-5-5へ追加実装・実機確認済み**（`gyro bias(dps): (-0.296,0.044,0.135)`、90分測定値とほぼ一致し再現性を確認。詳細は1-5-5の追記部分参照）。時定数チューニングはこのバイアス除去後の残差ドリフトを踏まえて改めて検討する。参考：同じセッションでaccelX/Y/Zの標準偏差はいずれも0.004G以下、accelZ平均0.995G(≈1G)で、90分間ほぼ静止・水平を維持できていたことも確認できた（ただしRoll/Pitch自体は`log.csv`に未記録のため、この加速度の安定性を代理指標として使った。1-5-6でRoll/Pitchそのものの収束を確認する場合はCSVへの列追加または長時間シリアルキャプチャが別途必要）。
- [x] 【廃止 2026-10-28：LSM6DSV16X＋自作の相補フィルタが前提。IMUはBNO055（姿勢推定・磁力計・校正状態を内蔵）に替わり、`firmware/logger_v1`は水平の0点合わせと校正値の保存（ボードt060）で代わりにしている】1-5-9: IMU/磁力計キャリブレーション手順をマニュアル化する ※1-5-4〜1-5-8の実装完了後に着手。将来IMUチップの交換・車両やロガー本体の載せ替え（改良版製作）を行う際に同じ手順を再現できるよう、以下を1つのドキュメント(例: `IMU_CALIBRATION.md`)にまとめる：①起動時自動キャリブレーション(1-5-5、取り付け角度補正)の仕組みと必要な操作(車両を水平な場所に静止させて電源投入するだけ)、②磁力計のハード/ソフトアイアン補正(8の字キャリブレーション等)の実施手順、③1-5-8の時定数チューニング手順(ジャイロ単体でのYawドリフト実測→時定数決定)とその時点での実測値・決定値の記録、④「取り付け角度を変えたら再起動するだけでよい／磁力計を積み直したらハード・ソフトアイアン補正からやり直す」等、どのタイミングでどの手順の再実施が必要かのチェックリスト。
- [x] 【廃止 2026-10-28：LSM6DSV16X＋自作の相補フィルタが前提。IMUはBNO055（姿勢推定・磁力計・校正状態を内蔵）に替わり、`firmware/logger_v1`は水平の0点合わせと校正値の保存（ボードt060）で代わりにしている】1-5-10: 起動時キャリブレーションの品質フラグ化・非静止起動対策 ※2026-08レビューで発見（ARCHITECTURE.md 7章「起動時IMUキャリブレーションが『静止していない』場合も強行される」参照）。①分散閾値超過のまま確定した場合、その事実をシリアル警告だけでなくチャンネル値またはSDログへ出力し、走行後の解析時に「このセッションの姿勢推定・車体座標系G値は信頼できない」と判別できるようにする。②走行中の電源再投入（クランキング時のブラウンアウト・コネクタ瞬断等）で、加速中・旋回中のデータから重力方向・ジャイロバイアスを誤確定してセッション中ずっと狂ったままになるのを防ぐ対策（静止を検出できるまで確定を遅らせて再試行する等。「姿勢推定が永久に始まらない状態を避ける」という現行設計意図とのバランスを再検討）を実装する
- [ ] （保留）GPSのCOGとYawの差分によるスリップアングル算出 ※GPS未調達のため現時点では分解しない。GPS調達後、Phase1-5の追加タスクまたはPhase5関連タスクとして着手する。GPSのCOG(進行方向)をYaw推定の補正には使わない（オーバー/アンダーステア検出の対象であるスリップアングル自体を消してしまうため）方針を維持する。

---

## 1-6: スマホ版RaceCaptureアプリとのUSB OTG通信検証 ※追加ハードウェア不要 → 完了（結論：ESP32-S3移行が必須）
- [x] 1-6-1: RCPプロトコル応答ロジックを検証用ファームウェア(`firmware/usb_otg_test/`。Phase1本開発とは別のPlatformIOプロジェクトとして分離)としてESP32-C3のネイティブUSBへ移植する
- [x] 1-6-2: PCの公式RaceCaptureアプリ(Windows版)を実機ESP32C3へ接続し、プロトコル応答が正しいことを確認する
- [x] 1-6-3: 同じ書き込み済み実機をスマホ(Pixel 9a)へUSB OTG接続し、スマホ版RaceCaptureアプリで接続できるか検証する
- [x] 1-6-4: RaceCaptureアプリで接続できなかったため、Android汎用USBシリアルターミナルアプリ(Serial USB Terminal)で代替検証し、プロトコル応答自体はAndroid経由でも正しく動作することを確認する（Android OS自体はデバイスを正しく認識・列挙できていることも確認）
- [x] 1-6-5: RaceCaptureアプリが接続できない根本原因を特定する
  → 結論：ESP32-C3のネイティブUSB(USB Serial/JTAGコントローラ)は、シリアル通信とJTAGデバッグを1つの複合USBデバイスとして同居させる**固定機能ハードウェアペリフェラル**であり、ソフトウェア(TinyUSB等)でJTAGを持たないシンプルなCDC専用ディスクリプタに作り変えることができない。RaceCaptureアプリはこの想定と異なる複合ディスクリプタ構成のデバイスを「利用可能なUSBデバイスがない」として拒否する。
  → Bluetooth接続も代替案として検討したが、ESP32-C3はBLEのみ対応でClassic Bluetooth(SPP)非対応。RaceCaptureアプリのBluetooth実装はClassic Bluetooth(SPP)方式とみられ、C3では同様に実現困難と判断。
  → **結論：ESP32-S3への移行(Phase1-4)が必須。以後はS3実機での再検証に進む。**

※検証過程で、テスト用スマホ本体のAndroid OSレベルの不具合（無関係な第三者アプリの`device_filter.xml`不正記述によるUSBデバイス解決処理のクラッシュ）にも遭遇し、これが原因でRaceCapture以外のアプリも含めてUSBデバイスの権限付与が機能しない状態になっていた。該当アプリを無効化し端末を再起動することで解消したが、プロジェクトのコードとは無関係な当該スマホ固有の環境要因のため詳細は割愛する。

---

## 1-8: RCP接続信頼性の調査（Piダッシュボード実運用で発覚、2026-08-15）
> 背景：4-4-2（Piダッシュボード画面表示バグ）調査の途中で、ユーザーが実機画面のRaw Dataモードで
> 「チャンネルの枠は表示されるが数値が一切表示されない」ことに気づいたことがきっかけで着手。
> 表示バグとは無関係な、RCP接続・データフロー自体の問題と判明した。

- [x] 1-8-1: `getCanCfg`等の接続シーケンスコマンドがタイムアウトする現象を確認し、ファームウェア側の
  実装漏れ（`getCanCfg`未実装）を疑ったが、`firmware/src/main.cpp`のソース自体は正しく実装済みと判明。
  実機へ再書き込みしても症状は変わらず、この仮説は否定された。
- [x] 1-8-2: **不具合1（修正済み）：`taskB`（1-1-6優先度検証用プレースホルダー、C3では未使用のダミー
  busy-loop）が最優先(+3)でCPUを占有し続け、RCP処理タスク`taskC`(+1、全タスク中最低優先度)を
  飢餓状態にしていた可能性を発見・修正。** ビジーループを`vTaskDelay`のみに変更（実機書き込み確認済み）。
- [x] 1-8-3: **不具合2（修正済み・予防的措置）：`CONFIG_ESP_CONSOLE_SECONDARY_USB_SERIAL_JTAG`が有効な
  ままだったため、`printf`/`ESP_LOG`によるデバッグ出力がRCPプロトコルと同じUSB
  Serial/JTAGチャンネルへ混入しうる状態だった。** `sdkconfig.esp32-c3-proto`で
  `CONFIG_ESP_CONSOLE_SECONDARY_NONE=y`に変更し、コンソール出力をUART0のみに分離（実機書き込み確認済み）。
  ただし単独では後述の本質的な原因を解消しなかった。
- [x] 1-8-4: **本質的な原因を特定：ESP32の物理的な再起動直後（USBケーブル抜き差し等）は接続シーケンスが
  頻繁にタイムアウトするが、一度確立された接続に対する`_restart_comms()`によるウォーム再接続では
  `getVer`〜`getConnCfg`まで一貫して数十ms〜300ms程度で完全に成功することを、稼働中プロセスへの
  ライブパッチ（`SerialConnection.read_line`/`write`をラップし生バイト＋タイムスタンプをログする手法）で
  実証した。** つまりRCP通信自体・ファームウェアの応答ロジックは正常であり、初期の失敗は
  ESP32のファームウェア起動シーケンス（I2C IMUスキャン等を含む）とアプリ側の接続試行タイミングが
  競合する、電源投入直後特有のレースコンディションだったと判明した。1-8-2/1-8-3の修正はこの
  競合ウィンドウを狭める効果はあるが、根本的な解消策ではない（起動直後は本質的にファームウェアが
  即座に応答できる保証がないため）。
- [x] 1-8-5: **より深刻な別バグを発見：接続シーケンスが成功してもRaw Dataの数値が表示されない件を追跡し、
  公式RaceCaptureアプリ自身（`racecapture/databus/databus.pyc`）の`DataBusPump._start_polling_telemetry()`に
  `if self._sample_thread: return`という、Threadオブジェクトの生存確認ではなく単なる存在チェックに
  なっているバグを発見した。** `sample_worker`スレッドが（起動直後のレースコンディション等で）一度でも
  終了すると、`_sample_thread`は死んだThreadオブジェクトを保持し続けるため、このガード文が永久に
  `True`のままとなり、以後アプリのプロセス生涯を通じて二度とサンプル要求(`{"s":0}`)が送信されなくなる。
  稼働中プロセスへ`pump._sample_thread = None`してから`_start_polling_telemetry()`を再実行したところ、
  即座に`{"s":0}`の送受信が再開し、`DataBus.getData('RPM')`等が実際の数値（RPM=3505.0等）を返すことを
  確認した。**これが「Raw Dataの枠は出るが数値が出ない」というユーザー報告の直接の原因であり、
  当プロジェクトのファームウェアではなく公式アプリ自体のバグと確定した。**
- [x] 1-8-6: 恒久対応として、`Clock.schedule_interval`で5秒おきに`pump._sample_thread.is_alive()`を
  監視し、死んでいれば`_sample_thread = None`＋`_start_polling_telemetry()`を呼び直すウォッチドッグを
  稼働中プロセスへライブ注入し、動作確認した（GPU描画バグの"救済"とは異なりGL/canvasに一切触れない
  純粋なPythonスレッド監視のため、4-4-2で判明した「アプリ生涯で一度きり」という制約は適用されず、
  繰り返し安定して機能する）。**この注入は現在のプロセスにのみ有効で、再起動すると失われる。**
  次回セッションで`run_racecapture_rpi.sh`への`LD_PRELOAD`常駐化（4-4-2で検討中の恒久適用経路と
  同じ仕組み）によりこのウォッチドッグを永続化するか、ユーザーと相談の上で決定する。

## 1-7: センサーキャリブレーション設定コマンドのESP32実装 ※追加ハードウェア不要（ダミー値で検証）、Phase0の0-8完了後に着手推奨
> 背景：`HANDOFF_claudeai_chat_gap.md`由来の議論より、公式アプリでの較正操作にはロガー側での`getAnalogCfg`/`setAnalogCfg`（5点マップ`map.raw`/`map.scal`＋線形式`scaling`/`offset`/`cal`等）の実データ読み書きが必要と判明。現状（1-3-3時点）は接続確立に必要な範囲のみ空応答で済ませており、この系統のコマンドは未実装。仕様は`reference/RaceCapture-Pro_firmware`（`test/json_api_files/setAnalogCfg*.json`等）を参照し、実際の確定はPCでの実機観測（Wireshark／シリアルログ）を優先する（`reference/RaceCapture_App_fork_ryandoherty`はバージョン不一致の可能性がある参考情報として扱う）。

- [x] 1-7-1: 0-8で確定したJSON形式に基づき、`setAnalogCfg`受信時にチャンネル定義・較正値をESP32側のメモリ上（まずはRAM、永続化は1-7-2）に保存する実装を追加する ※実機（Seeed XIAO ESP32C3, COM5）書き込み・動作確認済み。`firmware/src/main.cpp`に`AnalogChannelCfg`構造体（0-8の`rcp_mock_device.py`と同じフィールド構成：nm/ut/min/max/sr/prec/scalMod/scaling/offset/alpha/cal/map.raw[5]/map.scal[5]）とRAM上のグローバル配列`g_analogCfg[kAnalogChannelCount]`（`kAnalogChannelCount=1`、疎通確認用ダミー1ch）を追加。`rcpSendCapabilities()`の`channels.analog`を0-8と同様に`kAnalogChannelCount`へ変更し、公式アプリから`getAnalogCfg`/`setAnalogCfg`が要求されるようにした。`setAnalogCfg`受信時は送られてきたフィールドのみ既存設定へ部分マージする（`analogCfgApplyFields`）。あわせて`flashCfg`応答（`API_SUCCESS=1`固定、0-8で確認済みの通りこれがないと公式アプリがWriteをタイムアウトエラー扱いにする）も実装。PCからシリアル経由で`setAnalogCfg`→`flashCfg`→`getAnalogCfg`を送信し、変更した値（`scaling:2.5, scalMod:1`）が正しく読み返されることを確認した。
- [x] 1-7-2: 保存した較正値をNVS（不揮発領域）へ書き込み、再起動後も保持されることを確認する ※実機（Seeed XIAO ESP32C3, COM5）書き込み・動作確認済み。`firmware/src/main.cpp`に`analogCfgSaveToNvs()`/`analogCfgLoadFromNvs()`を追加し、`nvs_set_blob`/`nvs_get_blob`で`AnalogChannelCfg`構造体（POD、ポインタなし）をそのままblobとして`analogcfg`namespaceの`ch<index>`キーへ保存・復元する方式にした。保存タイミングは`flashCfg`受信時（Writeボタン相当、1-7-1のコメント通りNVSコミット相当のタイミング）。`app_main`冒頭で`nvs_flash_init()`（`ESP_ERR_NVS_NO_FREE_PAGES`/`ESP_ERR_NVS_NEW_VERSION_FOUND`時は`nvs_flash_erase()`して再初期化するESP-IDF定型パターン）を追加し、`analogCfgInitAll()`はデフォルト値セット後にNVSがあれば上書きするよう変更。PCから`setAnalogCfg`(`scaling:3.75, offset:0.5, scalMod:1`)→`flashCfg`で書き込み後、pyserialでDTR/RTSリセットパルスを送り実機を再起動、`getAnalogCfg`で同じ値が正しく読み返されることを確認した。
- [x] 1-7-3: `getAnalogCfg`受信時に保存済みの値を正しく返す実装を追加する ※1-7-1と同時に実装・実機確認済み（`rcpSendGetAnalogCfg()`。`getAnalogCfg:null`で全ch、整数指定で単一chに対応）。詳細は1-7-1参照。
- [x] 1-7-4: 実機（ESP32）でダミーチャンネルに対し、公式アプリの較正UIから値を設定→保存→再読み込みという一連の流れが正しく動作することを確認する ※実機（Seeed XIAO ESP32C3, COM5）・公式RaceCaptureアプリ(Windows版)で確認済み。**副産物として重要な不具合を1件修正**：Analog SensorsタブのWrite操作は、開いているタブに関わらず`setLapCfg`等の他カテゴリのset系コマンドも一括で送信するため、未実装のままだと`Timeout waiting for 'setLapCfg'`でWrite全体がエラーになった。既に空応答を返している`getLapCfg`/`getTrackCfg`/`getCanCfg`/`getObd2Cfg`/`getConnCfg`と対になる`setLapCfg`/`setTrackCfg`/`setCanCfg`/`setObd2Cfg`/`setConnCfg`を`{"<cmd>":{"rc":1}}`を返すだけのスタブとして追加し解消（`rcpSendSetCfgAck()`）。修正後、公式アプリでAnalog0の較正値（`scaling:3.5, offset:0.3, scalMod:2`、5点マップも変更）をUIから設定・Write・画面遷移後の再読み込みで正しく表示されることをユーザー確認。念のためPCから直接`getAnalogCfg`を送信し、同じ値がNVS経由で正しく保持されていることも確認した。
