ntakao2006-web/RaceCapture/lintaroh_answer_20261013_2.md

# UNO Qの内部リセットと監視役についての回答

2026年10月13日。`lintaroh_share_20261009_2.md`への返答です。

**監視役はWebの外のsystemdサービスとして維持するのがよいです。** 更新と復旧を共通の排他制御・停止確認付き手順へ揃え、Bridgeの更新ループも低い優先度の処理へ実行時間を渡す形に補強しました。今回の作業はPC上の変更とテストまでで、機器への配置、ファームの再ビルド・書き込みは行っていません。

内部リセット後のUART停止は、GENIの受信DMAとRTS/CTSの両方を疑う材料がありますが、原因は未確定です。下記の診断情報と信号の観測で切り分ける必要があります。

## 前回回答の更新

ソース再ビルドで稼働イメージとバイト一致したこと、共通の書き込み手順を実機で通せたことを確認報告として受け取りました。CAN2のACKと`k_timer`による監視への変更も、今回のリポジトリに反映されています。

前回の6,475Bは、手元にあった10月3日14時03分版の保存イメージを集計した値でした。稼働していた19時13分版は1,191B、その後の本番版は967Bという今回の報告に更新します。**967Bは128KiBとの差で、使用可能な余裕の保証ではありません。** 最新本番版のバイナリは今回の手元にはなく、この値の再集計は行っていません。

## 内部リセット後にUARTが戻らない理由

最も具体的な候補は、Linux側の受信DMAが再設定されない状態です。参考に確認したLinux v6.12のGENIドライバでは、受信DMAを解除して`rx_dma_addr`を0にした後、受信長が0なら関数を終了し、次のDMA準備へ進まない分岐があります。報告された「RXカウンタが増えなくなる」症状と整合します。ただし、**実機のカーネルが同じ実装か、その分岐を通ったかは未確認**です。[Linux v6.12のGENIドライバ](https://github.com/torvalds/linux/blob/v6.12/drivers/tty/serial/qcom_geni_serial.c#L796)

RTS/CTSも候補です。STM32の起動中、UARTのピン設定とRTS/CTS有効化の前後にLinuxから送信が続くと、フロー制御による待ちとDMAの状態が重なる可能性があります。反対方向では、Linux側のRTS状態によりSTM32の送信が止まっている可能性もあります。TX/RXカウンタだけでは、送信していないのか、信号は来ているがLinuxが取り込めないのかを区別できません。

NRSTだけが成功した結果は重要ですが、内部リセット方式と断定する前に、リセット幅・タイミング・Linux側の送信状況を揃えた反復試験が必要です。NRSTとSYSRESETREQの差を、リセット方式だけで説明したことにはしません。`loggerBridgeSerialInit()`のピン設定やフロー制御を推測で変更することも避けました。

次回は以下を順に確認するのがよいです。

1. 通常状態と失敗直後に、カーネル版、TTYカウンタ、GENI関連のカーネルログ、ルーターの状態とjournalを保存する。`serial engine reports 0 RX bytes in!`の有無を特に確認する。
2. オシロスコープまたはロジックアナライザで、リセット前後のSTM32 TX/RXとRTS/CTSを観測する。`gpioget`で線の方向を変える方法は使わない。
3. Web通信あり・なしについて、NRST、SYSRESETREQ、`NVIC_SystemReset()`、IWDGを同条件で反復し、Bridge復帰だけでなくSDの増加量と欠落カウンタを確認する。各条件をまず10回、問題がない条件を20回以上へ増やす。
4. UART信号が届いているのにRXカウンタが止まる場合は、実機カーネルの受信DMA処理を優先して調べる。STM32から送信自体が出ない場合はCTSと起動時のUART設定を優先する。

採取用に `EcoCapture-Web/mcu_diagnostics.py` を追加しました。機器上で、例えば以下のように失敗前後を別ファイルへ保存できます。この道具はttyHS1を開かず、GPIO変更、MCU停止、リセット、ドライバの再接続を行いません。

```sh
python3 /home/arduino/EcoCapture-Web/mcu_diagnostics.py --output /home/arduino/mcu-before.json
python3 /home/arduino/EcoCapture-Web/mcu_diagnostics.py --output /home/arduino/mcu-failed.json
```

今回、カーネル変更、UARTドライバのunbind/rebind、GPIO70の流用は実施していません。

## RouterBridgeの修正

`$/reset`完了前から更新処理を動かす方向は、起動中に残った問い合わせを処理し、応答を先へ進めるために合理的です。公式0.3.0では、受信スレッドを作る前にclientとserverが構築されています。起動中に未登録メソッドのエラーを返すことも、呼び出し側で再接続・再試行できるなら許容できます。[RouterBridge 0.3.0の実装](https://github.com/arduino-libraries/Arduino_RouterBridge/blob/0.3.0/src/bridge.h)

ただし停止箇所の説明には補足があります。公式0.3.0の`begin()`は`bridge_mutex`を保持して返事を待ち、`if (Bridge)`の`is_started()`も同じmutexを取ります。したがって、インストール済み版によっては`k_yield()`の空回りだけでなく、このmutex待ちも確認対象です。SD停止の改善という実測結果は受け入れますが、正確な待機箇所は機器側ソースとスレッド状態を照合してください。

現行の無条件`Bridge.update()`は、依頼がない場合には内部で休みますが、依頼が続く場合は末尾の`k_yield()`だけになります。Zephyrのyieldは同じか高い優先度のスレッドへ譲る処理で、低い優先度のSD保存処理への実行機会を作るにはsleepが必要です。そこで更新ループ末尾を`k_msleep(1)`に変更しました。[Zephyrのスケジューリング仕様](https://docs.zephyrproject.org/latest/kernel/services/scheduling/index.html)

適用処理は `bridge_patch.py` へ切り出し、既知の元コード、前回の修正、補強済みの3形態を扱います。更新ループ以外は置き換えず、未知の形ではビルドを止めます。公式0.3.0の実ファイルでも適用・再適用を確認しました。**補強版の通信速度、100Hz取得、SD記録、イメージサイズ、起動は実機未検証**です。

## 監視役の置き場所と修正

systemdサービスを維持します。監視役はWeb自身を停止・再開し、ルーターとNRSTを操作するため、Webのプロセス内へ置くとWeb停止時に復旧処理も止まってしまいます。ハードを操作する権限も、Webアプリへ持たせる必要はありません。

今回、以下を修正しました。

- **共通ロック**：更新と復旧は同じ`/run/lock/ecocapture-mcu.lock`を`flock`で取得する。プロセス名の確認直後に書き込みが始まる競合も防ぐ。競合時は終了コード75で何も操作せず延期する。
- **復旧手順の共通化**：監視役は`flash-mcu.sh --recover`を呼ぶ。Web停止→ルーター停止とMainPID 0の確認→ルーター起動・ソケット待ち→NRSTリセット→Web起動の順序に揃える。復旧モードではファームを書き込まない。
- **監視不能と切断を区別**：`connected`が明示的な真偽値でない応答は監視不能として扱い、リセットしない。Webが届かない場合や書き込み中に触らない方針は維持する。
- **延期と失敗を区別**：ロック競合は復旧失敗回数に加えない。手順の終了後は「生データの受信待ち」とし、コマンド成功だけで通信復帰と判断しない。受信が戻らないまま3回復旧を試みた場合の10分間隔への移行も維持する。
- **古い監視プロセスを残さない**：Windows更新では、既に動いている監視サービスをファイル転送後に再起動してから更新する。停止中のサービスは勝手に起動・有効化しない。

Webを止めた後に復旧手順が失敗した場合は、自動でWebを再開しません。APIも届かなくなるため、journalを確認して手動復旧する必要があります。UART停止を検知しただけでLinux全体を自動再起動する変更は入れていません。48秒の復帰は10月9日の旧版の実測として残し、今回の補強版でも同じ時間で戻るとは保証しません。

## E-6とメモリの再配分

10月12日の最新方針は、映像をeMMCへ保存して走行ごとにPCへ吸い出す運用です。**今回、E-6を本番へ組み込むための待ち行列削減はしません。** 当面はSDの走行ログを維持し、E-6は将来の検討とします。

将来再開するなら、前回の「取得32KiB＋映像32KiB」では合計が同じ64KiBで、追加コード、DMA管理、スタックの余裕が生まれません。最初の比較案は **取得32KiB＋映像16KiB** のように合計48KiBとし、16KiBを追加処理に残す形が考えられます。これは検討案で、採用・実装済みではありません。

取得待ち行列を32KiBにした場合、IMU 100Hz、GNSS 10Hz、CAN合計100フレーム/秒を仮定すると、今の記録形式では約8.3KB/秒で約4秒分です。これは平均的な例で、CANが3,000フレーム/秒なら約0.47秒まで減ります。高負荷やSDの管理領域更新時の停止を含む実測で決める必要があります。

映像16KiBリングは、1MB/秒の約16ms分しかありません。SDの50〜60ms停止はLinux側の一時保持とフロー制御で吸収します。転送の塊も小さくなるので、SPIの固定待ちやBridge問い合わせによる速度低下を再測定し、8Mbpsを保証する前提にはしません。

さらに、試験の`pollWr()`はDMAの書き込み位置を周期的に読む方式です。小さなリングではSD待ち中に一周して同じ位置へ戻ると、進みを見落とす可能性があります。再配分する際はDMA完了の割り込み等で通算受信量を数える方式、起動セッションの識別、32bitカウンタの周回処理まで合わせて設計します。リング定数を変えるだけで済むとは考えません。

現在の本番版の静的領域130,105Bと、起動成功が報告された130,365Bとの差は260Bです。この差も安全な追加容量の保証ではなく、967Bへそのまま新しい処理を足す方針は取りません。

## 今回の確認と次回の実機確認

PCのテスト25件が成功しました。更新・復旧の順序、共通ロックの競合、失敗時の中断、監視判断と再試行間隔、診断採取の非破壊性、Bridge修正の適用・再適用、ソース比較と容量集計を確認しています。シェル4ファイルとWindows更新スクリプトの構文、Windows PowerShell 5.1向けのUTF-8 BOMも確認しました。

次回は、更新済みの監視役と共通手順を先に配置して監視サービスを再起動し、バックアップを保持してから補強版をビルドします。サイズ・静的領域を確認し、NRST復旧、内部リセット、100Hz取得、SDのCRCと連番、CAN1/2の欠落を再検証してください。今回は機器を操作していないため、UART停止の解消、本番ファームの起動、復旧時間は未確認です。

今回の検証記録は `outputs/unoq_share_response_20261013/`。回路図とPCBは変更していません。
