ntakao2006-web/RaceCapture/lintaroh_share_20261013_oiltemp.md

# Lintarohさんへの共有メモ：ユニバーサル基板版センサーハブで大会の油温を読む（2026-10-13）

エコラン大会（**10/24・25**）に、ユニバーサル基板でセンサーハブを作ってもらえると聞きました。ありがとうございます。
ロガー（UNO Q）側は、**仕様書（`sensorhub_generic_spec.md`）4-2のフレーム案のとおりに届けば、そのまま油温を記録し、ピットのPodiumにも出せる状態**にしてあります。
そのため、下の表の内容だけ確認させてください。**案と違う作り方にした場合は、ロガー側を合わせるので教えてもらえれば大丈夫です**（設定画面で変えられます）。

## 1. ロガー側が想定している内容

| 項目 | 想定（仕様書の案） | 確認したいこと |
|---|---|---|
| つなぐ先 | UNO QシールドのCAN2（外部CAN、Micro-Fit 1=+5V／2=CANH／3=CANL／4=GND）、500 kbps、標準ID | ハブ側の終端120 Ωを入れてもらえるか（ハブがバスの末端になるため） |
| ID | ハブ番号0・アナログch1 → **0x500** | 違うIDにした場合はそのIDを教えてほしい |
| データ | 6バイト：0–1＝電圧mV、**2–3＝センサー用5Vに対する比率（0〜65535）**、4＝カウンタ、5＝フラグ | **バイト順（リトル／ビッグエンディアン）**。ロガーは今リトルエンディアンで読む設定 |
| 換算に使う値 | **2–3バイト目の比率**（5Vの変動に影響されないため） | 比率の基準が、プルアップをつないでいる5Vと同じ電源か |
| プルアップ | ユニバーサル基板版は**常時ON（固定）でよい**。設定の書き込み（0xE）は無くてよい | **プルアップ抵抗の値**（案は2.2 kΩ）。換算式に入れるので実際の値を教えてほしい |
| 周期 | 10 Hz | 変えた場合は教えてほしい |
| 状態フレーム（0x50C） | 無くてもよい（大会版では使わない） | ― |

## 2. 温度への換算はロガー側で行う

ハブは換算せず、比率を送るだけで大丈夫です。ロガー側で次のように換算します。

- 抵抗値 R ＝ プルアップ抵抗 × 比率 ÷ (1 − 比率)
- R と温度の対応は、**こちらで熱湯と温度計を使って実測した校正値**を入れる。純正油温センサーは型番不明のNTCサーミスタ

比率が0（短絡）または最大（断線）のときは、温度ではなく「値なし」として扱います。

## 3. 大会に間に合わせるための段取り

1. ハブが出来たら、UNO QのCAN2につないで**0x500が届くか**を確かめる（ロガーの設定画面「センサーハブの油温」ボタンで受信設定が入る）
2. 室温と熱湯で読みが動くことを確かめる
3. 校正値を入れて、Podiumに油温が出ることを確かめる
