ntakao2006-web/RaceCapture/lintaroh_share_20261009.md

# Lintarohさんへの共有メモ（2026-10-09）

UNO Q（LoggerV2）で映像まわりの確認と、シールドSDへの映像保存（E-6）の試験をしました。
その過程で **UNO Q本体とSTM32のファームに一時的に手を入れた**ので、何をしたか・何が分かったか・お願いしたいことをまとめます。
詳細はリポジトリの各資料にあります（末尾の「資料」）。

---

## 1. 🔴 先に見てほしいこと：ファーム書き込み手順でLinux側のシリアルが固まる

**ルーター（arduino-router）が動いたままSTM32を止めて書き込むと、Linux側のUART（`/dev/ttyHS1`、RTS/CTS付き）が固まることがありました。**

- 症状：ルーターの停止が時間切れになり、SIGKILLでもプロセスが残る。以後、どのファームを書いてもBridgeがつながらない（`method ... not available`）。STM32を何度リセットしても戻らない
- 復旧：**Linuxの再起動が必要でした**
- 推定原因：STM32を止めた（書き込み・`halt`）瞬間にLinux側の送りかけのデータが残り、フロー制御で送れないままドライバが固まる。`build.sh`のコメントにあるGENI UARTの不具合と同系統かもしれません
- **回避できた順番**：Web停止 → **ルーター停止** → 書き込み → ルーター起動 → **STM32をリセット** → Web起動
  - 最後のリセットが要る理由：Bridgeは起動時の`$/reset`に返事が来ないと**時間切れ無しで永久に待つ**（`bridge.h`の`RpcResult::result()`）。ルーターが待ち受けてから送り直させる必要がある
  - この順番で7回書き込んで（試験ファーム5回・元に戻す2回）、7回とも問題なし。スクリプトは`tools/unoq_spi_sd_test/flash.sh`

**`EcoCapture-Web/build-mcu.sh`は「ルーター再起動 → 書き込み」の順で、最後のリセットがありません。** 本番のファーム更新でも同じことが起き得るので、手順の見直しを検討してほしいです。

## 2. UNO Q上でしたこと（驚かせないために）

| やったこと | 今の状態 |
|---|---|
| STM32のファームを試験ファームへ一時的に置き換え（数回） | **元のロガーのファームへ戻し済み**。書き換え前に読み出したものとビット単位で一致、記録再開を確認 |
| 書き換え前にSTM32のフラッシュを読み出して保存 | UNO Q `~/fw_backup/`（スケッチ領域64KBと全体2MB）、PC側にも退避 |
| Linuxを1回再起動、ルーターを数回再起動 | 正常稼働中（100Hz受信・SD記録中） |
| spidevを一般ユーザーへ開放・`bufsiz=262144`で読み込み直し | **再起動で元に戻る一時設定**のまま |
| シールドのSDへ試験データを書き込み | **FAT上で空きと確認したパーティション中央の領域だけ**に生セクタで約0.9GB。既存ファイル・FAT・ディレクトリには書いていない |
| ffmpegを`~/ffmpeg-local`に展開（システムには入れていない） | `apt-get download`＋`dpkg -x`。不要なら消してOK |
| 置いたファイル | `~/enc_test`・`~/ffmpeg-local`・`~/unoq_spi_sd_test`・`~/spi_sd_test_build`・`~/fw_backup`・`~/spi_stream`。どれも消して構いません（`~/fw_backup`は念のため残しておくと安心） |
| 作業経路 | 学校のWi-Fiで`uno-q.local`が引けなかったので、USBのadb経由。root作業は`build-mcu.sh`と同じDocker経由 |

再起動・リセットのたびにSDのログファイルが新しく切り替わったので、`EL000334`〜`EL000355`あたりは机上の短いログです。

## 3. 確認してほしいこと（食い違い）

1. **ファームのソースがリポジトリとUNO Q上で違います。** `firmware/ecologger_v2/`の`logger_impl.h`・`lte_uart.h`・`sd_logger.h`の3つが、UNO Qの`~/ecologger_v2/`と一致しません（改行コードを揃えて比較）。動いているファームはUNO Q上の10/3ビルド（`logger_compact.elf-zsk.bin`）と一致しました。**どちらが正か**教えてください
2. **Bridgeの速度の記述**：`firmware/ecologger_v2/README.md`と`EcoCapture-Web/README.md`は460800bpsですが、コード（`Bridge.begin(921600)`）とルーターの設定は921600bpsでした

## 4. 分かったこと（ファーム・Linux側の参考情報）

- **STM32スケッチのRAMは約128KBの枠**（`CONFIG_LLEXT_HEAP_SIZE`）。このArduino環境ではコードもRAMに載ります。128KBのバッファを取ったらスケッチ自体が読み込まれませんでした（`arduino-cli`が表示する「最大512KB」は実際の上限ではない）
- **回路図の`MCU_SPI3_RDY`（Linux GPIO70 ↔ STM32 PG13）は、ルーターの起動設定が`gpioset 70=1`で使っています**。SPIのRDY（フロー制御）用途には流用できません。なお`gpioget`でchip1の37/38/70を読むと出力線を入力に切り替えてしまうので注意
- OpenOCDの`dump_image`はSTM32を止めずに読めます。`halt`で長く止めるとロガーとの通信が切れます
- 映像：HWエンコーダは1080p30を実時間で回せる。**ffmpeg（Debian 7.1.5）の`h264_v4l2m2m`は落ちる**ので、EGL＋V4L2の自前実装（GPU→エンコーダをdmabufで直結）で焼き込みが30fps・5分完走（`unoq_video_check_procedure.md` 5章）

## 5. E-6（シールドSDへの映像保存）：結果と相談

**フロー制御つきで、8Mbps相当の映像データを5分間・欠落0でシールドSDへ書けました。** 経路は次のとおりです。

`Linux spidev0.0（GPIO14〜17）→ 内部SPI（20MHz）→ STM32 SPI3スレーブ＋GPDMA（64KBリング）→ ハードウェアSPI2（20MHz・CMD25連続書き込み）→ シールドSD`

| 項目 | 実測 |
|---|---|
| SPI受信 | 20MHzで32MB誤り0（50MHzまで誤り0） |
| SD連続書き込み | 2,221KB/s |
| 通し・フロー制御なし | 5分で0.05%欠落（SDが数秒おきに50〜60ms止まり、64KBリングを追い越される） |
| **通し・フロー制御あり** | **1MB/s×5分で欠落0**。STM32が「書き終えたバイト数」をBridgeで返し、Linuxは空きがある時だけ送る。Linux側の一時バッファは最大409KB |
| 今の作りの上限 | 約1.2MB/s（9.6Mbps） |

**ロガー本体に入れるには、ファームの変更が要ります。** ここが相談したいところです。

1. **SDの書き込みをハードウェアSPI2へ**：今はGPIOを1ビットずつ叩くソフトウェアSPI・1セクタずつ書き込み。映像を書くには、ハードウェアSPI2＋DMA＋複数セクタ連続書き込み（CMD25）が前提。SPI2はCAN2・LEDと共用なので、CSごとにクロックを切り替える（SDは20MHz、MCP25625は10MHz以下）
2. **SPI3スレーブ受信（GPDMA）とBridgeでの書き込み量の報告**：試験ファームの`spi3Start()`・`pollWr()`・`spitest.rd`がそのまま使える
3. **RAM**：ロガー本体が約93KB使っているので、64KBのリングを足すと約128KBの枠を超える。リングを小さくすると速度が落ちる。取得待ち行列（64KB）との共用や、リングの縮小で収まるかの検討が必要
4. **ファーム領域64KiB**：試験ファームは約43KB（Bridge込み）。ロガー本体（約59KB）に足して収まるかは要確認
5. 走行ログ（ELB2）と映像を同じSDにどう置くか（ファイル形式・FATの扱い）

**進めてよいか、進めるならどこを担当してもらえるか**、意見をください。
ファームの書き込み手順（1章）は、この話と関係なく見直したほうがよいと思います。

## 6. 資料

| 内容 | 場所 |
|---|---|
| E-6の調査と実測の全体 | `unoq_video_to_shield_sd_study.md`（5-3章が試験結果） |
| 映像確認V-1〜V-3・焼き込み試験 | `unoq_video_check_procedure.md`（5-4〜5-6章） |
| 試験ファームと手順一式 | `tools/unoq_spi_sd_test/`（`flash.sh`・`build_test.sh`・`spi_fc.py`・`spitest.py`ほか） |
| 焼き込み・SPI送信の試験プログラム | `tools/unoq_overlay_enc/` |
| 経緯の要約 | `ARCHITECTURE.md` 4章 2026-10-09追記 |
