ntakao2006-web/RaceCapture/vehicle_can_survey_summary.md

# 実車CAN/OBD2 調査サマリ（回路担当への共有用）

> **この文書の位置づけ**：これまでに実車で測った事実だけを1枚にまとめたもの。
> 「どの車で・どこに繋いで・何が取れたか」「電気的に何が確認済みか」を回路設計の判断材料として渡す。
> 推測と実測を分けて書き、推測には必ず「未確定」と明記している。
>
> 詳細な生データ・解析過程は各車両の節末尾の参照先にある。回路の入出力仕様そのものは
> `hardware_interface_spec.md`（こちらが回路担当との認識合わせの本体）を参照。
>
> **最終更新**：2026-09-06（**NCEC本番車両の55分直結キャプチャの結果を反映**）

---

## 1. 結論（先に3行）

1. **自作CAN基板は実車で完動する**。MAZDA2（74秒）・レクサスUX（61分）に続き、**NCECで55分・
   791.5 frame/s・2,611,844フレームを取りこぼしゼロ／buserr=0で記録**（2026-09-06）。
   UXの5.7倍のレートでも1フレームも落ちない。回路・ハーネス・USB経路は実車で完全に通用する。
2. **本番車両のNCロードスター（NCEC）は、OBD2ポートから生CANが読める**。標準OBD2で32PID、
   さらに車両独自ID 15種以上を観測済みで、うち6IDはデコード式まで判明・実測検証済み。
3. **油温・油圧はOBD2標準PIDでは取れない**（NCECは油温PID非対応）。
   **追加センサー＋CANハブという既存方針は、実測に基づいて正しい**。
4. **新しい車ではOBD2ポートから生CANが取れない**。2022年式レクサスUXを61分キャプチャした結果、
   非診断フレームは2種類・**いずれも完全な固定値**だった（セキュリティゲートウェイによる隔離とみられる）。
   一方2005年式のNCECには生CANが流れている。**年式によって設計の前提が変わる**という実測知見。

---

## 2. 計測系（3車両で共通）

| 項目 | 内容 |
|---|---|
| マイコン | Seeed Studio XIAO ESP32C3（TWAIコントローラ内蔵。外付CANコントローラ不要） |
| トランシーバ | MCP2562FD-E/P（8pin DIP。CAN-FD対応品をクラシックCANで使用） |
| 結線 | TWAI TX=GPIO21(D6)→TXD(1)、RX=GPIO20(D7)→RXD(4)、VDD(3)=5V、**VIO(5)=3.3V**、VSS(2)/STBY(8)=GND |
| バス側 | CANH(7)→OBD 6番、CANL(6)→OBD 14番、GND→OBD 4/5番 |
| ビットレート | 500 kbps（3車両とも共通。ISO 15765-4） |
| 比較用の既製品 | ELM327ミニ（Bluetooth SPP、38400bps）。自作側の答え合わせに使用 |

> **VIO を 5V にすると 3.3V 非トレラントの ESP32-C3 が壊れる**。ここは要注意点として明記しておく。

### ファームウェア（用途別に3種）

| プロジェクト | 送信 | 用途 |
|---|---|---|
| `firmware/can_selftest/` | する（卓上専用） | TWAI自己受信テスト。**実車バスへ繋がない**（NO_ACKのため他ノードを妨害しうる） |
| `firmware/can_logger/` | **物理的にしない** | 受動キャプチャ専用。LISTEN_ONLY＋TXピン未配線＋GPIO固定の3重の安全策 |
| `firmware/can_obd_logger/` | する | 生CAN受信＋OBD2 mode 01（読み取りのみ）のポーリング。実車調査の主力 |

---

## 3. 車両別サマリ

| | **NCロードスター（NCEC）** | **MAZDA2（DJ型）** | **レクサスUX** |
|---|---|---|---|
| 年式・位置づけ | 2005年式・**本番投入車両** | 2019年〜・レンタカー（検証用） | 2022年式・参考／生CAN逆解析用 |
| プロトコル | ISO 15765-4 CAN 11bit 500k | 同左 | 同左 |
| OBD準拠 | JOBD (Japan) | — | OBD/OBD-II・EOBD両方を観測 |
| 標準PID対応数 | 32項目 | 応答あり（詳細は`obd2_survey_mazda2.json`） | 31項目 |
| **油温(PID 5C)** | **非対応** | 非対応 | **対応**（実測81℃） |
| 油圧 | OBD2標準PIDに存在しない（全車共通） | 同左 | 同左 |
| DLCへの生CAN | **流れる**（独自ID 15種以上） | **流れない**（診断応答のみのスタブ構成） | **実質流れない**（2種のみ・完全固定値。ゲートウェイ隔離とみられる） |
| 自作基板での直結 | **実施・完動**（55分、791.5 frame/s、取りこぼし0・buserr=0） | **実施・完動**（74秒） | **実施・完動**（61分、取りこぼし0・buserr=0） |
| OBD応答ECU | `7E8` 単独（`0x7E0`で応答、フォールバック不要） | `7E8` | `7E8`/`7EA`/`7EE` の3系統（`0x7DF`が必要） |

---

## 4. 車両別の詳細

### 4-1. NCロードスター（NCEC、2005年式）— 本番車両

調査日 2026-08-01（ELM327経由）、**2026-09-06に自作基板で55分の直結キャプチャを実施**。

**2026-09-06の直結キャプチャ（回路担当への一番の報告）**

| 指標 | 実測 |
|---|---|
| 総フレーム数 | **2,611,844**（55分、**791.5 frame/s**） |
| 取りこぼし | drop_rb=0 / rx_missed=0 / rx_overrun=0 |
| バスエラー | **buserr=0**、TEC=REC=0 |
| USB切断・ESP32リセット | 0回 |
| OBD要求／応答 | sent=165,543 / resp=165,490 / timeout=53（**0.032%**）/ txerr=0 |

→ **UX（140 frame/s）の5.7倍のレートで1フレームも落としていない。** ケーブルの細さやUSB経路の
懸念に対する実測回答として、これが現時点で最も厳しい条件でのデータになる。
**受動フェーズ692 frame/s に対しポーリング中799 frame/s**で、差の107 frame/sは自分のOBD往復そのもの
＝ポーリングによる帯域圧迫は無い。

**さらに、この「欠落ゼロ」は車両側のデータで独立に裏付けられた。**
`0x211` の byte7 は**ローリングカウンタ**（1フレームごとに必ず+1され255で一周する連番）で、
1件でも取りこぼせば増分が+2以上になる。走行41分の246,009フレームを全数集計した結果：

| 増分 | 件数 | 割合 |
|---|---|---|
| **+1** | 246,008 | **100.0000%（例外ゼロ）** |

`drop_rb=0` はロガー自身の自己申告だが、**こちらは車両ECUが発行した連番による外部検証**である。
**「41分間1フレームも欠落していない」は主張ではなく実証。**

**デコード式が実測で確定**（走行41分・約197万フレームの回帰）：車速＝`0x201`offset4/2byte/big
（R²=0.99991）と`0x4B0`の4バイトペア、回転数＝`0x201`offset0/2byte/big（R²=0.99978、slope=0.25）、
水温＝`0x240`byte1（R²=0.996）**および`0x420`byte0**（R²=0.993、文献間の矛盾を決着）、
スロットル＝`0x240`byte3、吸気温＝`0x240`byte4。
`0x4FF`はASCII文字列`DISABLE VIN COMPARE`の分割送信と判明、`0x231`byte1 bit1＝クラッチスイッチを
「ギア比の集中度」で物理的に裏付け。**油温`5C`は非対応を再確認**（追加センサー方針の根拠が固まった）。

以下は2026-08-01のELM327調査時点の記録。

- 標準OBD2で取れるもの：回転数・車速・水温・スロットル開度・エンジン負荷・吸気圧・吸気温度・
  MAF・点火時期・バッテリー電圧など実質32項目。**全項目で実際に数値取得を確認済み**。
- **取れないもの：油温・油圧**。油温PID(`5C`)は非対応、油圧はそもそもOBD2標準PIDに無い。
  → 追加センサー＋CANハブ方式が必要という設計判断の根拠はここ。
- 生CANとして車両独自ID 15種以上を観測。コミュニティ資料（RaceChrono DIY用のNC専用CAN DB）と
  突合し、**実測で検証できたもの**：

  | CAN ID | 内容 | 検証状況 |
  |---|---|---|
  | `0x201` | 回転数・車速・アクセルペダル位置 | 車速62.0km/hを`0x4B0`の4輪速度と相互検証、一致 |
  | `0x4B0` | 4輪独立ホイールスピード（各2バイト） | 停止時`0x2710`=0km/h（100km/hオフセット）を確認 |
  | `0x240` | エンジン負荷・水温・点火時期・スロットル・吸気温 | スロットル13.3% vs 同時刻のOBD2実測12.9%で一致 |
  | `0x200`/`0x215` | スロットル開度 | 式どおり |
  | `0x231` | クラッチスイッチ（MT） | 式どおり |

- **未解明のまま**：`21A`、`39A`、`420`、`4EC`、`4FF`。`211`/`212`は警告灯関連との情報があるが未確定。
- DSC搭載車（2007年以降）にある`081`(舵角)/`085`(ブレーキ圧)/`090`(加速度)は**本車両では観測されず**。
  DSC非搭載という車両仕様と整合する（未確定、断定はしない）。
- ELM327の限界（UART 38400bpsがCAN 500kbpsに追いつかず`BUFFER FULL`頻発、タイムスタンプ無し）から、
  **本格的な逆解析には自作基板での直結が必要**というのが当時の結論。この結論は今も有効。

> 詳細：`OBD2_SURVEY.md`（対応PID一覧・実測値・生CAN解析・コミュニティ資料との突合）

### 4-2. MAZDA2（DJ型、レンタカー）— 自作基板の実車実証

実車1回目 2026-09-01、2回目 2026-09-02。

- **1回目**：受動キャプチャで frames=0（完全無音）。当初は自作側を疑ったが、
  自己受信テスト20/20 PASS・ハーネス3本のΩ実測0Ω・IG ON確認済みで、自作側は全て白と切り分け。
- **2回目**：ELM327で `0100` に肯定応答・`ATDPN=A6` を確認しつつ、`ATMA` 20秒での自発フレームは
  `3FF`/`7FF` 各1件（中身は否定応答 7F 01 78）のみ。続けて自作基板を直結して74秒連続で回した結果：

  | 指標 | 実測 |
  |---|---|
  | OBD2要求／応答 | sent=3514 / resp=3514（**欠落ゼロ**） |
  | バスエラー | buserr=0 |
  | エラーカウンタ | TEC=0 / REC=0 |
  | 取りこぼし | drop_rb=0 / rx_missed=0 / rx_overrun=0 |
  | 取得値 | rpm≈750、水温88℃、スロットル10〜13%、車速0 |

- キャプチャした全5794フレームが `0x7E0`（自分の要求）と `0x7E8`（応答）のみ。
  → **MAZDA2のDLCは診断要求にしか応答しないスタブ構成**と確定。この車両で生CANの逆解析はできない。
- **回路担当への含意**：この74秒は「自作回路が実車バス上で1件も落とさず、エラーも出さずに動いた」
  という実測データそのもの。**回路・ハーネス・終端の扱いは実車で通用する**と考えてよい。

> 詳細：`mazda2_field_procedure.md`、生ログ `mazda2_b1_obd_idle.csv` / `.status.log`

### 4-3. レクサスUX（2022年式）— 61分の直結キャプチャ実施済み

ELM327による予備調査（2026-08-06）に続き、**2026-09-05に自作基板で61分連続キャプチャを実施**。

**キャプチャ品質（回路担当への一番の報告）**：

| 指標 | 実測 |
|---|---|
| 総フレーム数 | 511,256（61分、139.7 frame/s） |
| 取りこぼし | drop_rb=0 / rx_missed=0 / rx_overrun=0 |
| バスエラー | **buserr=0**、TEC=REC=0 |
| USB切断・ESP32リセット | 0回 |

→ **61分間、1フレームも落とさず、エラーも1件も出していない。**
MAZDA2の74秒に続き、**自作回路・ハーネス・USB経路が長時間の実車運用に耐えることが実証された**。
ケーブルの細さを気にしていた件についても、この61分が「現状の構成で問題ない」という実測回答になる。

**生CANは実質流れていない**：61分で観測できた非診断IDは`45A`・`4E0`の2種のみ、
しかも**両方とも61分間ずっと同じ値**（`45A`=`5A 04 00...`、`4E0`=`24 00 00...`）。
IG ON・エンジン始動・走行（最高119km/h）・停車のどのフェーズでも変化しない。
→ **この車両で生CANの逆解析はできない。** 2022年式トヨタ/レクサスのセキュリティゲートウェイに
よる隔離とみるのが自然。

**OBD2ポーリングは良好**：`0x7DF`（機能アドレス）で3ECU（`7E8`/`7EA`/`7EE`）が応答し、
**1ECUあたり実効9.1Hz**でrpm・車速・スロットル・アクセル開度を取得できた（油温は1.0Hz）。
注目すべきは**ECUごとに担当PIDが違う**点で、アクセルペダル位置Dは`7EA`だけ、油温は`7E8`だけが返す。
`0x7E0`固定では油温しか取れなかった可能性があり、**ブロードキャスト要求へのフォールバックが
結果的に効いた**。

**ハイブリッド確定**：`rpm=0`かつ`speed>0`（エンジン停止のまま走行）が走行サンプルの42.8%。

> 詳細：`OBD2_SURVEY.md`の「レクサスUX 追補」、現地手順は `lexus_ux_field_procedure.md`

---

## 5. 電気・回路面で確定している事実

| 項目 | 実測・確定内容 |
|---|---|
| 信号レベル | レセッシブでCANH/CANL両線 ≈2.5V、ドミナントでCANH ≈4.1V / CANL ≈1.2V（Arduino Nanoでライブ観測） |
| 終端 | **車両バスは両端終端済み。実車では卓上の120Ωを必ず外す**（付けたままだと三重終端） |
| 卓上での挙動 | CAN相手がいない卓上ではACKが返らず、送信するファームでは`txerr`が増え続ける（2026-09-05実測で約20〜30/秒）。**これは正常**で、実車では0になる |
| ハーネス | OBD 6↔CANH / 14↔CANL / 4・5↔GND の導通と、6↔14非導通をテスタで確認済み |
| GND | **5番(Signal Ground)単独で正しい**（4番はChassis Ground） |
| 電源 | 車載Raspberry Pi側は室内ヒューズボックスからのタップ方式を採用（OBD2直結にしない） |
| USB | ESP32-C3はUSB Serial/JTAG直結。ホスト→デバイスの1バイトコマンドを使う場合、ファーム側で`usb_serial_jtag_driver_install()`が必要（無いとホストの書き込みが永久にブロックする。2026-09-05に実測・修正済み） |
| **実測バス負荷** | **NCECのHS-CANは走行中 約692 frame/s**（自分の送信を止めた受動区間での実測）。自作ロガーのOBD2ポーリングは**約107 frame/s**（`0x7E0`要求と`0x7E8`応答で各約53/s）を上乗せする。合計799 frame/sで**取りこぼし0・buserr=0**。CANハブ側の設計はこの帯域を前提にしてよい |
| **処理系の余裕** | 799 frame/s（8バイトフレームで実効約450kbit/s相当のバス占有）でも、ESP32-C3のTWAI受信→48KBリングバッファ→USB出力の経路は`drop_rb=0`。**現状の構成に処理能力の余裕がある** |

### 絶対にやってはいけないこと

- **OBD 3番と6番、11番と14番を導通させない**。MS-CAN(125k)とHS-CAN(500k)の直結になり、
  双方でエラーフレームが連続発生してノードがバスオフに陥る。車両側の警告灯・DTC・
  フェイルセーフを引き起こす。別バスを見たい場合は**コネクタ内の圧着端子の移設**で行う。
- `can_selftest`（NO_ACKモード）のビルドを実車バスへ繋がない。ACKを返さないため他ノードの通信を妨害しうる。
- OBD2はmode 01（読み取り）のみを使う。DTC消去・アクチュエータ制御は行わない。
- VIN（mode 09 PID 02）は取得可能だが**値を記録しない方針**（個人特定情報のため）。

---

## 6. 回路担当への報告と、判断してほしいこと

### 6-1. 報告：ハードウェア側の懸念は現時点で全て解消している

**3車両・累計約2時間の実車運用で、回路・ハーネス・USB経路に起因する不具合は1件も出ていない。**

| 車両 | 時間 | レート | 結果 |
|---|---|---|---|
| MAZDA2 | 74秒 | 診断のみ | 要求3,514件に対し欠落ゼロ、buserr=0、TEC=REC=0 |
| レクサスUX | 61分 | 140 frame/s | 511,256フレーム、drop=0、buserr=0、USB切断0回 |
| **NCEC** | **55分** | **791 frame/s** | **2,611,844フレーム、drop=0、buserr=0、USB切断0回。さらに車両側の連番で欠落ゼロを独立検証** |

**とくにケーブルの細さについて懸念をいただいていた件**は、NCECの791 frame/s・55分・欠落ゼロが
実測の回答になる。UXの5.7倍のレートでも取りこぼしが1件も無く、**現状の構成のままでよい**と考えている。

### 6-2. 判断してほしいこと

1. **油温・油圧の追加センサー**：NCECでも**油温PID(`5C`)が非対応であることを再確認**した
   （レクサスUXは対応していたので、車両差であることも確定）。油圧はそもそもOBD2標準PIDに存在しない。
   **追加センサー＋CANハブという既存方針の根拠が実測で固まった**。センサー選定・CANハブ側の設計は
   引き続き回路担当の判断を優先する。
2. **CANハブ側の帯域設計**：NCECの車両バスは**走行中 約692 frame/s** が既に流れている（5章参照）。
   自作ロガーのポーリングが約107 frame/s を上乗せして合計799 frame/s。
   **追加センサーのCANハブが同じバスへ載る場合、この上にどれだけ足せるかの判断をお願いしたい**
   （現状は500kbpsで実効約450kbit/s相当の占有）。
3. **本番機のマイコン**：現在の実車実証はすべて ESP32-C3（XIAO）。本番想定の ESP32-S3 では
   TWAIペリフェラル・ESP-IDF APIは共通だが、**実車での再確認は未実施**。
4. **参考情報（解析側の前提）**：本番車両NCECは**ノーマル車ではない**。前期型車体に後期型エンジンを
   載せ替え、ECUは NOPRO MZ-TUNE+ 仕様（レブリミット8,000rpm、スピードリミッター解除、
   メカフィーリングスロットルマップ、電動ファン作動温度変更など）。**CANの中身がコミュニティ資料と
   食い違う箇所があるのはこのため**で、回路側の設計に影響する話ではないが、
   データを見るときの前提として共有しておく。

---

## 7. 参照先

| ファイル | 内容 |
|---|---|
| `hardware_interface_spec.md` | 回路の入出力インターフェース仕様（認識合わせの本体） |
| `OBD2_SURVEY.md` | NCEC・レクサスUXのELM327調査の一次資料 |
| `mazda2_field_procedure.md` | MAZDA2実車の現地手順と切り分け記録 |
| `lexus_ux_field_procedure.md` | レクサスUXの現地手順（60分・無人運用） |
| `ncec_field_procedure.md` | NCEC（本番車両）の現地手順（60分。OBD疎通確認＋走行中の相関検証） |
| **`ncec_can_spec.md`** | **NCECのCAN通信仕様だけを抜き出したもの**（ID一覧・バイトマップ・デコード式・OBD2仕様・未解明項目）。実装者はこの1枚でデコーダが書ける |
| `ARCHITECTURE.md` | プロジェクト全体のマスタードキュメント |
| `mazda2_b1_obd_idle.csv` / `.status.log` | MAZDA2実車の生ログ（自作基板が完動した74秒） |
