ntakao2006-web/RaceCapture/firmware/logger_v1/HANDOFF.md

# logger_v1 ファームウェア引継ぎ

更新日: 2026-09-10（JST）

## 2026-09-10: NCEC実車回に向けた書込み・設定投入・卓上検証（実施済み）

**実機イメージの出所が確定した。** クリーンな作業ツリーからビルドしたイメージを書き込み、
以後この個体はリポジトリの版と対応が取れている。

- **書込み済みイメージ**：`firmware.bin` SHA-256 `cdcb4dba5b38410927180c67484906768c27f1f20e5589a7bc7081a029795ce8`
  （623,216バイト）。アプリ記述子は git `0d95e7c`／ビルド `Sep 10 2026 04:59:45`。
  ブートローダーのコンパイル時刻 `Sep 10 2026 05:02:29` を再起動ログで確認済み。
  `0d95e7c`以降のコミットは文書のみで、`src/`・`components/`・`platformio.ini`・`partitions.csv`・
  `sdkconfig.defaults`は無変更（`git diff 0d95e7c..HEAD`で確認）。
- **経路**：`ecologger_v1`にはUSB-シリアル変換が載っていないため、書込みも診断も外付けの書込み機を使う。
  J1（5ピン、`pin1=RxD／pin2=TxD／pin3=EN／pin4=IO0／pin5=GND`）がESP32の**UART0**に繋がっており、
  **RCPはこのUART経由でも喋れる**（今回はCH9102＝COM15で全作業を実施）。ネイティブUSB（J6）は不要だった。
  なお基板の電源はJ2のUSB-Cからのみ入る（J6側のVBUSは`TPS2041B`による出力）。

### 実施順と結果

1. `sd_control.py stop` でSDセッションを安全にクローズ（6,301行／drops 0／errors 0）。
2. `platformio run -t upload --upload-port COM15` で書込み（`Hash of data verified.`、45.75秒）。
3. `provision_ncec.py --port COM15` → **PASS**。
   ⚠️ **書込み前の設定はレクサスUX試験のまま残っていた**（`obdEnabled=true`／`toyotaSteering=true`／
   `ncProfile=false`）。この状態でNCECへ繋いでも`ncProfile`の排他条件によりデコードは1つも動かない。
   投入後は `ncProfile=true`／`obdEnabled=false`／`toyotaSteering=false`。
4. RTSによるハードリセット（`rst:0x1 (POWERON)`をログで確認）後に再読出しし、**設定がNVSへ永続化されて
   いることを確認**（`ncProfile=true`のまま）。
5. `verify_board.py --seconds 20` → **12項目中10項目PASS**。
   PASS：`sd_100hz`／`no_drops`／`imu_100hz`／`imu_data_valid`／`sd_imu_no_false_missing`／`gps_updates`／
   `gnss_max_normal_cadence`／`no_sd_errors`／`vehicle_listen_only`／`no_dummy_rpm`。
   IMU 4,989サンプル・エラー0・recoveries 0。SDの閉じたログの読戻しも成功。
   **NG 2件は`gnss_fix`と`gps_utc_fraction_preserved`で、いずれも屋内で測位できないことが原因**
   （`init=3`＝モジュールは正常初期化、`sats=0`／`qual=0`／`utcValid=false`）。**屋外で再確認すること。**

### この時点で分かっている制限

- **GNSSは`four_10`（GPS+Galileo+BeiDou B1C+GLONASS、10 Hz）で起動する**。実測`hz≒9.9`。
  25 Hzではない（9月1日のi版以降、4系統10 Hzが既定）。ラップ・予測タイムを使わない用途では影響しない。
- `mappings`は0件。NCECは`ncProfile`のハードコード経路で読むため、汎用マッピングは未使用。
- 屋外でのGNSS測位確認、実車CANの受信、実走でのSD記録は未実施。

## 2026-09-10: 実装基板`ecologger_v1`が完成し、現物がユーザーの手元にある

PCB第1版がそのまま動作確認まで到達し、版の切り直しは発生していません。本書の対象基板はこれです。
以降のファームウェア作業は実機で試験できます。**センサーハブ基板は未完成**のため、
下記残作業3のうちアナログ系（油温・油圧・AFR・熱電対）は着手できませんが、
**車載CAN側は本番車両NCECのデコード式が実測で確定しているため先行して進められます**
（`docs/design/ncec_can_spec.md`／`docs/research/OBD2_SURVEY.md`「NCEC 追補」参照）。
NCEC実車へは数日以内に接続できる見込みで、残作業1（IMUの車体方向）・5（ラップ／実走）は
その機会に合わせます。`ncec_next_session_checklist.md`も併せて開いてください。

## 最新：i版・4系統10 Hz、RaceCaptureの定期配信に対応（9月1日03時台）

現在の実機は `logger-v1-gnss-stream-20260901i`、609,200 bytesです。
`artifacts/release_20260901_gnss_stream_i/firmware.bin`、SHA-256
`3feb8af0c4383d2b8f6c7e3c1384d1b3ecc637a97ceb2c5fc1d1d224c1cb077a`。
GNSSは暫定のfour_10を電源投入時に設定します。約15 Hzとの比較は未完了です。

h版のGNSS/SDは正常でしたが、Windowsアプリが50 Hzでサンプルを要求すると設定応答が遅れ、lapCfg/canCfgのタイムアウトと取得停止を再現しました。
i版は `telemstream` と `setTelemetry` に対応し、PCへの定期配信を最大10 Hzへ制限します。
50 Hz要求時も適用値10 Hzを応答します。これはPC表示の制限であり、SD・IMUの100 Hz記録は維持します。
アプリの設定読込み完了と、31秒間のSQLiteサンプルID連続増加（1,524,904→1,525,194）を確認しました。
その区間ではGNSS 3D・17〜20衛星、SDエラー/欠落・USB欠落0、IMUエラー0でした。
通常のRaceCaptureを起動したまま、自動復帰ヘルパーを接続済みです。i版のUSB物理抜挿・長時間運転は未検証です。
詳細と保存先は [GNSS_CHECK_20260901.md](GNSS_CHECK_20260901.md) を参照してください。

## 履歴：h版を書込み、4系統・10 Hzを検証

現在は `logger-v1-gnss-compare-20260901h`、608,000 bytesです。
`artifacts/release_20260901_gnss_compare_h/firmware.bin`、SHA-256
`53fc843799e09c6abfb5482707e49a40c231a1c6c78dffe6ff671b9d36ccb70f`。
比較用g版は実機のgetStatusで通信タスクのスタック不足・再起動が発生したため使用禁止です。
h版でUSB/UARTのスタックを12→24 KiBに増やし、最小空き容量をgetStatusに追加しました。
USB/UART合計50回の状態・サンプル・GNSS診断試験で再起動なし、両経路とも空き約12 KiBを確認しています。
g版の不具合中に作成した一部ログは異常終了です。書込み前の既存94ファイルはサイズ一致で保全確認しました。
OTP再設定・NVS消去・SD削除はしていません。four_10/b1c_15/glo_15の比較は、最初のfour_10測定中にユーザーによるツール待機中断でPCプロセスが終了しました。
基板のSD記録は継続しています。現在four_10で3D測位・13衛星、GNSS/SDエラー増加なしを確認しました。
最初の測定中のSDセグメントを閉じて `recovered_four_10/` に回収しました。別プロファイルとの比較完了とは扱いません。
222.04秒のSD原本で新鮮な位置100%、2,221測位、使用衛星中央値12、IMU/SD100 Hzを確認しました。
GNSS間隔は100 msが2,218回、99/101 msが各1回で平均100 ms、測位間隔の欠落はありません。
当初の厳密な100 ms一致チェックはfalseでしたが、既存の時刻整列許容±1 msによる確認は通過しています。
取得座標は位置情報保護のためリポジトリへ記載しません。既知地点との整合確認は未完了です。
起動初期のIMU通信エラー1件を除き、検証区間でIMUエラー増加はありません。最終設定はまだ未確定です。

## 最新：固定10 Hzではなく、衛星構成と周期を比較するg版を準備（未書込み）

ユーザーの希望により、10 Hzを採用済みとはせず、3系統・約15 Hzと4系統・10 Hzを中心に比較します。
g版 `logger-v1-gnss-compare-20260901g` はRAMだけで候補を選択でき、設定読戻しとSDメタデータで識別します。
ビルドとC++/PC試験は成功しましたが、A105/ロガーUSBが未接続で実機への書込み・比較は未実施です。
最後に確認した書込みはe版25 Hzのままです。g版の起動時four_10は暫定値で、最適値ではありません。
手順・候補・判断基準は [GNSS_BALANCE.md](GNSS_BALANCE.md) を参照してください。
OTP再設定・SD消去・NVS消去は行いません。下記f版の10 Hz案は比較候補の履歴です。

## 最新：10 Hz・複数GNSS対応のf版を準備（実機への書込みは未実施）

ソースは `logger-v1-multignss10-20260831f` です。最後に確認できた実機書込みは下記のe版です。
9月1日00:55にビルド成功を確認し、`artifacts/release_20260831_multignss10_f/` にイメージを凍結しました。
PCがA105とロガーUSBを認識していないため、f版の実機試験・書込みは未実施です。
高性能クロック設定済みの個体ではGPS＋Galileo＋BeiDou B1C＋GLONASSを10 Hzで利用します。
クロックを確認できない場合はGPS＋Galileo・10 Hzへ切り替えます。QZSS/SBASも有効です。
OTPは読取りだけで、周期と信号設定はRAMへ書き、読戻し一致を検証します。
IMUとSDは100 Hzを維持し、既存SDログ・NVSは削除しません。
不可逆なのは内部クロックのOTP設定であって、25 Hzという測位周期ではありません。
詳細と再開手順は [MULTIGNSS_10HZ.md](MULTIGNSS_10HZ.md) を参照してください。

## 最新：GNSS監視・RF診断を追加して書込み済み（8月31日22時、e版）

現在の書込み版は `logger-v1-gnss-health-20260831e`、603,280 bytesです。
イメージは `artifacts/release_20260831_gnss_health_e/firmware.bin`、SHA-256は
`469cf96826fbf68fe1a38034aece56ec458e0c4d9d8ab89cdfeb2aaa9235d47f`。
GNSSの時刻が3秒進まない場合に再設定し、未測位でも時刻が進む間は探索を継続します。
受信強度・RF指標・再試行回数をCSVへ追加し、GNSS UARTを460800へ変更しました。
SD読戻し9,121行で100Hz、GNSS 2,281測位はすべて40ms間隔、全行3D測位・UTC有効・IMU100Hz。
試験中のGNSS/IMU/SDエラー・欠落0、書込み前の56ファイルはサイズも維持しました。
今回SD消去やOTP設定は行っていません。詳細と制約は [GNSS_HEALTH.md](GNSS_HEALTH.md) を参照してください。
以下のd/c/b版の「現在」や未測位・UTC未確定の記述は、それぞれの時点の履歴です。

## 最新追記：屋外GNSS再確認（8月31日21:47、書込みなし）

屋外の未測位報告に対し、設定変更なしで衛星0から3D測位へ移行することを確認しました。
最終観測は衛星6～7・約25Hz、RaceCaptureにも位置を表示し、IMU・SD記録も継続しています。
UTC絶対時刻は未確定です。詳細は [GNSS_OUTDOOR_CHECK.md](GNSS_OUTDOOR_CHECK.md) を参照してください。
書込み済み版は引き続きd版です。追加RF診断やSD消去は行っていません。

## 最新追記：IMU内部異常からの復旧（8月31日21時台、d版）

現在の書込み版は `logger-v1-imu-recovery-20260831d`、600,064 bytesです。
イメージは `artifacts/release_20260831_imu_recovery_d/firmware.bin`、SHA-256は
`2bb155b13dccb8b1e701757c65dc4d27e3e1b4f0ea979d01af41b041b26ad6c0`。
SD原本で、起動後約1.5～640秒にIMU内部エラー5が継続したことを確認しました。
I2C読取り成功時の内部異常も検出してIMUだけを再初期化し、IMUHzは有効サンプルの頻度に修正しました。
実機で融合停止からの復旧を3回確認。SD記録・GNSS受信処理は継続し、既存ログを維持しています。
詳細は [IMU_RECOVERY.md](IMU_RECOVERY.md) を参照してください。
RaceCaptureのIMU表示も確認しました。最終観測時のGPSは未測位です。
以下のc版・b版の記述は履歴です。今回、SD全消去は実行していません。

## 最新追記：散歩前のSD全消去（8月31日夜、c版）

ユーザーの明示指示「SDカードの中身はぜんぶけして」により、既存SD内容を削除しました。
記録停止・クローズ後にSDルートを検査して消去し、再記録試験でできたファイルも再消去しました。
最後は空の `logs` ディレクトリーだけにしてアンマウントします。次の電源投入で自動記録が始まります。
PC上の既存検証データ、NVS設定、GNSS OTP、回路は変更していません。

現在の書込み版は `logger-v1-sd-session-20260831c`、598,144 bytesです。
イメージは `artifacts/release_20260831_sd_session_c/firmware.bin`、SHA-256は
`a551b65ad799f2db89ab95759e7a454b7843d3042dc51bd6b6107b0b9e4e6a27`。
直下の `clear_verification.json` に全消去・再記録・最終空状態の実機結果を保存しています。
削除は通常起動や満杯時には実行しません。停止・正常クローズ済みのSDに対するUART保守操作のみです。
以下のb版・既存ログ維持の記述は、今回の消去指示より前の履歴です。

## 最新追記：SD単体運用と屋外GNSS・USB復帰（8月31日夜）

現在の版は `logger-v1-sd-session-20260831b` です。以前の25 Hz版から更新・書込み済みです。
SDを正式な記録、RaceCaptureを表示用として扱う方針です。
推定起動日時のJSTファイル名、列・単位・版・再起動理由の説明ファイル、正常終了記録、
待機データを保存してからのSD取り外し準備、PC用CSV閲覧HTML、Windowsアプリの自動復帰補助を追加しました。
起動時のGNSSメタデータ更新だけで待機中のSD行を捨てる処理も修正しました。
操作は [SD_LOGGING.md](SD_LOGGING.md)、試験は [VERIFICATION.md](VERIFICATION.md) の夜の追記を参照してください。

屋外のJCA002アクティブアンテナで3D測位し、取得位置を既知地点と照合しました。
RaceCapture内のデータ保存とGPS/IMUダッシュボードの数値表示も確認しています。
USB単独切断後にアプリの取得が止まる症状を再現し、正常終了・再起動による復帰補助を用意しました。
ケーブルや電源の瞬断を直すものではありません。試験中の意図しない本体再起動1件の原因は未確定です。

この追記に対応する変更はまだGitコミット・pushしていません。以下の `f328834` は夜の変更前の保存点です。
既存の回路・配線・GNSS OTP・NVS設定・SDログは削除/変更せず維持しました。

## 今回の到達点と完了範囲

ユーザーの合意により、**実装基板用ファームウェアの作成・書込み、GNSS 25 Hz化、
卓上での基本機能確認、残作業の引継ぎまでを今回の目標達成**とします。
以下の残作業は次回以降の対象です。実走・全負荷・全設定機能まで完成したという意味ではありません。
本書を作成した区切りでは、追加の書込み・設定変更・破壊試験はしていません。

既存のルート [HANDOFF.md](../../HANDOFF.md) は過去のRCP解析資料です。
本書は現在書込み済みの実装基板用ファームウェアの再開入口です。
全体方針は [ARCHITECTURE.md](../../ARCHITECTURE.md)、現在の実装仕様は
[README.md](README.md)、試験範囲・証拠は [VERIFICATION.md](VERIFICATION.md) を参照してください。
全体資料には追記方式で古い構成・未完了記述も残るため、日付と対象ファームウェアを区別してください。

## 対象・書込み済み版

- 作業ルート: `C:\Users\lintaroh\Documents\RaceCapture`
- 本番用ソース: `firmware/logger_v1/`。対象回路: `circuit/logger_v1/`。
- 基準要求のGit: `cf1c71155542d447cccf9c22a6d30a1baac117cf`。
  これは要求取得時の基準であり、今回の新規ファームウェアを収録したコミットではありません。
- ESP32-S3-WROOM-1-N16R8、BNO055、MAX-M10M-00B、ATA6561、MCP25625。
- 現行イメージ: `artifacts/release_20260831_sd_session_b/firmware.bin`（本フォルダ基準）、595,392 bytes。
- SHA-256: `b57b49c391bbf0f076315a5c4bcd98f75f9519b21a6723c6b17239e7531c6dd0`。
- RCP上の表示名: `logger_v1 real-sensor SD logger`、互換バージョン2.16.1。
  `git_info` は `logger-v1-sd-session-20260831b`。
  この表示だけではビルドを特定できないため、上記ハッシュも使ってください。
- 旧DevKit/旧IMU用 `firmware/src/main.cpp` と診断用 `v1_test/` は別物です。
  旧IMU対応を今回の未完了項目として復活させないでください。

## 現在の動作・確定方針

- 電源投入でSD記録開始。全チャンネルCSVは100 Hz、生CANは別CSVに保存。
  PCやアプリを切り離しても記録継続。500 msごとに同期しますが、電源断時の最大損失保証ではありません。
  既存ログの自動削除・自動フォーマット・満杯時の上書きは行いません。
- GNSSはGPS+QZSS+SBAS、UART 115200、UBX-NAV-PVT、40 ms周期（25 Hz）。
- BNO055はI2C GPIO17/18、100 Hz。重力込み加速度と推定重力、重力除去後のG値を別々に記録。
  X/Yの約−0.3 m/s²は静止時の推定重力と整合し、傾きの影響と考えられました。
  根拠なく一律+0.3を足す補正は実装していません。
- 車載CANはATA6561（CAN1/J5）、500 kbps、通常はlisten-onlyで送信もACKもしません。
- センサーハブはMCP25625（CAN2/J4）、500 kbps。
  GPIO・パルス・外部アナログ入力はCANハブ経由です。ロガー直結GPIOの追加実装は不要です。
- 汎用CAN変換設定は空、NC車種プロファイル無効、ハブ向け定期送信無効。
  CAN受信・生ログ保存と、RPM/温度等への変換設定の完了は別です。
  OBD応答の受信デコードはありますが、ロガー自身からのOBD要求送信は未実装です。
- LEDはナイトライダーではなく状態表示です。SYS/ERR/LOG/GPS/TLM/WIFI/BT/CANの意味はREADME参照。
  現物の光学的確認は未完了です。

## 最終確認済みの内容

25 Hz版の60秒卓上試験で、全13項目に合格しました。

- SD読戻し6,063行、平均100.000325 Hz、間隔中央値9.999 ms、最大16.270 ms。
- GNSS 1,517更新、1,516間隔すべて40 ms。3D測位・UTC有効、試験区間内の測位抜けなし。
- IMU 100 Hz・全行有効、SD/CANキュー欠落0、SD/IMU/GNSS通信エラー0、採取遅延カウンター0。
- MCP内部ループとCAN2→CAN1物理ループに合格。生CAN 4行を保存し、CAN1はlisten-onlyへ復帰。
- Windows RaceCaptureアプリがCOM10へ再接続し、設定読込み・受信・セッション記録を開始。
  アプリ接続中にもSD記録が継続していました。
- 統合版では別途、Luaの追加チャンネル・期限超過停止、設定保存・再起動復元などを確認済み。

最終試験時にはアプリ接続・SD記録を継続した状態で引き渡しました。
次回再開時の電源・接続状態は改めて確認してください。

## 残作業（優先順）

### 1. IMUの車体方向と校正

- [ ] 実際の取付け方向を確認し、車体の前後・左右・上下に対応する軸と符号を確定する。
- [ ] 任意の取付け方向に対応する軸変換・設定保存機能を実装する。現行版に変更用設定はありません。
- [ ] 完全校正状態255で補正値を保存し、再起動後の復元・値の妥当性を実機確認する。
  保存/復元コードは実装済みですが、完全校正済み個体での確認は残っています。
- [ ] 実走振動・車体周辺の磁気・温度変化で姿勢/G値が妥当か確認し、必要ならフィルタを調整する。

完了条件: 既知方向に傾けたときの軸・符号が一致し、再起動後も校正値を復元できること。

### 2. SD記録・通信の異常系と長時間試験

- [ ] 実運用時間をカバーする連続記録を行い、欠落・エラー・メモリ・ファイル切替を確認する。
- [ ] 両CANの想定最大負荷とUSB受信を同時に与え、25 Hz GNSS/100 Hz IMU・SDへの影響を測る。
- [ ] SD満杯・抜去・再挿入、電源断・再投入、USB切断・再接続を個別に試験する。
- [ ] SD未挿入のまま起動し、後からカードを挿すだけで新しいログの記録が自動的に始まることを確認する。
  起動時未挿入と、記録中の抜去後に再挿入する場合を分けて試験し、いずれもファイル作成・行数増加まで確認する。
- [ ] SD未挿入、正常記録中、満杯、記録中の抜去、再挿入後の各状態で、PCを接続せずLOG LEDだけから
  「現在実際に記録中か」を判別できることを確認する。LED表示と実ファイルの増加を同時に照合する。
- [ ] 異常時の通知、既存ログ保全、再開条件を確認し、不足する処理を修正する。

完了条件: 許容するデータ損失と復旧動作を定義し、未挿入起動後および抜去後の再挿入で記録が再開し、
LOG LEDが実際の記録状態と一致することを、閉じたログの全体読戻しとPCなしの目視で確認すること。
電源断・満杯等の試験は、既存データを退避した試験用SDと隔離した卓上構成で行ってください。
今回の合格結果を長期・全負荷・断電耐性の合格として扱わないでください。

### 3. 車載CAN／センサーハブの実データ統合

- [ ] 対象車両とハブのCAN ID、ビット位置、符号、単位、換算式、更新周期を確定する。
- [ ] `setLoggerCfg` の `mappings` 等へ設定し、実センサーの基準値と照合する。
- [ ] RPM・油温・油圧・AFR等の必要チャンネルと、CAN経由GPIO/パルス入力の欠測・期限切れを確認する。
- [ ] ハブ向け定期送信を使う場合は、ID衝突と帯域を確認してから有効化し、相手側受信まで検証する。
- [ ] OBD要求送信が必要な車両については、受信専用運用と分けて仕様・送信許可・実装を検討する。

完了条件: 実値とSD・アプリ表示が一致し、断線や更新停止を正常値として保持し続けないこと。
CAN IDや車種固有の換算は推測で埋めないでください。ハブ側ファームウェアは別の成果物です。

### 4. アプリからの設定操作

- [ ] IMU軸設定・フィルタ・センサー校正を、どの画面/APIから操作するか決めて実装する。
- [ ] 設定変更→保存→再起動→再読出しを公式アプリで通して確認する。
- [ ] 必要な場合、Android側のUSB検出と再接続を現行版で対応・検証する。
- [ ] LuaとCAN送信を利用する場合、アプリのScript画面から相手側受信までの一連の操作を確認する。

Windowsでの受信確認は、純正の全設定API互換やAndroid対応の完了を意味しません。
Wi-Fi/Bluetooth/携帯回線は現行版では未使用です。必要性が確定した場合に別途扱ってください。

### 5. ラップ・予測タイム・動画同期

- [ ] 実コースを設定し、ラップ境界・方向・最小時間・コース変更時のベスト管理を実走確認する。
- [ ] 予測タイムを実走記録と照合する。現行版のコースは未設定です。
- [ ] SDのUTCとGoPro動画を照合し、同期精度・起動直後のUTC未確定区間の扱いを確認する。
- [ ] セクター計測は未実装。実走検証後に必要性と区間定義を決める。
- [x] 状態LEDの物理的な対応・異常時表示を目視確認する。LOG LEDについては残作業2の各SD状態で
  実際の記録状態と照合し、現場でPCなしでも点灯状態を判別できることを確認する。
  → 2026-10-06：回路担当が全項目の正常動作を確認済み（ユーザー経由の伝聞。確認記録は未受領）。

### 6. 確定版のGit保存・共有

- [x] 新規 `firmware/logger_v1/` のソース・文書をレビューしてコミットし、チームへ共有する。
- [x] 現行イメージのハッシュとソース保存コミットを紐付ける（下記）。
- [x] 8月31日夜のSDセッションb版の変更をレビュー・コミットし、新しいハッシュと対応付ける（未push）。
      → **解消済み（2026-09-10確認）**。b版のソース変更は後続版（c〜i版、および9月のEcoCapture対応・UX250h対応）へ吸収され、
      `f328834`以降の`c646bfc`／`c1472a8`／`d70bae2`／`b5c2aaa`／`ea1a5c9`で`firmware/logger_v1/`ごとコミット・push済み。
      作業ツリーはクリーンで`origin/master`との差分もない。ソース上の現行版は`src/log_format.h`の
      `logger-v1-ux250h-obd-20260905a`で、b版よりはるかに先へ進んでいる。本チェックボックスは更新漏れだった。
      ただし**「実機に書き込まれているイメージ」と現行ソースの対応付けは未確認**であり、これは下の残課題として残す。
- [x] 実機の書込み済みイメージが現行ソース（`logger-v1-ux250h-obd-20260905a`）と一致しているかを確認し、
      一致しない場合は再ビルド・再書込みして版を揃える。本書冒頭の「現在の実機」表記は9月1日のi版のままである。
      → **2026-09-10に解消**。クリーンツリー（git `0d95e7c`）からのビルドを書き込み、SHA-256とブートローダーの
      コンパイル時刻で同一性を確認した。詳細は冒頭の「2026-09-10」節を参照。
- [x] 別PC・クリーンな取得先でも再ビルド手順を確認する。ビルド環境を含むバイナリ完全再現は未検証。
      → **2026-09-10、作業PC（Windows）で`python -m platformio run`が成功**（274秒、RAM 16.7%、Flash 7.4%、
      `.pio/build/logger-v1/firmware.bin` 623,216バイト）。リポジトリのソースだけから再ビルドできる。
      **バイナリ完全再現は不成立**：既存の`artifacts/logger-v1-ux250h-20260905a.zip`内の`firmware.bin`は
      623,168バイトで、48バイト小さくSHA-256も異なる。
- [ ] ⚠️ **ビルドタグが版の識別子として機能していない問題への対処**（2026-09-10発見）。
      上記2つのバイナリは**どちらも`LOGGER_BUILD`が`logger-v1-ux250h-obd-20260905a`で同一**だが、
      ESP-IDFのアプリ記述子を読むと出所が違う。
      - リリース同梱物：git `647098e-dirty`／`Sep  4 2026 23:23:22`ビルド
      - 現行ソースからの再ビルド：git `0d95e7c`（クリーン）／`Sep 10 2026`ビルド
      `647098e`は本リポジトリに存在するコミットだが、**作業ツリーが汚れた状態でビルドされている**ため、
      同梱バイナリと一致するソースはリポジトリのどこにも保存されていない。その後`ea1a5c9`等で
      UX250h対応が入っており、48バイトの差はこの差分と考えるのが自然。
      **したがって`getVer`の`git_info`（＝`LOGGER_BUILD`）だけでは実機イメージの出所を判定できない。**
      同一性の判定にはSHA-256、または`getVer`へアプリ記述子のgitハッシュ・ビルド日時を含める改修が要る。
      当面の運用：**実車へ持ち込む版は、クリーンなツリーからの再ビルドを書き込んだものに統一する**。

初版作成時はGit未登録でしたが、2026-08-31のユーザー指示によりWSLのGitから登録・push済みです。
ソース保存コミットは `f328834c5024b5118a32c8f9bb288567c9fa4a60`（`origin/master` 到達確認済み）。
このコミットは夜のSDセッション改良前の25 Hz版の保存点です。
冒頭の現行SHA-256はその後に書き込んだSDセッションb版を識別しますが、夜のソース変更は未コミットです。
**（2026-09-10訂正）この「未コミット」は解消済みです。**上記のとおり後続コミットで`firmware/logger_v1/`は
すべてpush済みで、以降のソースはこのリポジトリの`master`が正となります。
当時の登録前のホスト単体テストは全件合格。そのGit登録作業では改行規則・文書のみ整え、実機への再書込みはしていません。
後続の夜の改良・再書込み・試験は冒頭の追記が最新です。
既存の3Dモデル等の無関係な変更を巻き込まず、位置情報・個体ID・Flashバックアップ等を公開しないでください。

リポジトリはGit LFSを使用するため、WSLからのpushにも `git-lfs` が必要です。
今回はUbuntu配布パッケージをGit除外の `artifacts/tools/git-lfs-wsl/runtime/` に展開し、
その `usr/bin` を実行時のPATHへ追加して使用しました。システム全体へのインストールや
既存LFSフックの削除・無効化はしていません。別環境では通常の方法でGit LFSを用意してください。

## 再開時の注意・手順

1. 本書、README、VERIFICATIONと `ARCHITECTURE.md` の新しい追記を読む。
2. Git差分と接続先を確認する。COM番号は現在のPCでCOM8=書込み/診断UART、COM10=ネイティブUSB。
   ポート番号は環境により変わります。アプリが使用中のCOM10を別ツールで同時に開かないでください。
3. 診断は既存の `tools/rcp_client.py` を使用する。COM8のDTR/RTSはリセット線です。
   書込みが必要な場合はRaceCaptureを閉じ、正しい対象とイメージを確認してから行ってください。
4. GNSS 25 Hz、IMU 100 Hz、SD行数増加、欠落/エラー、設定状態を読取り確認する。
   完全な電源再投入後は、3D測位成立よりUTC確定が遅れる場合があります。
5. 次の対象を残作業から選び、確認済みの動作を回帰試験で維持する。

**GNSS高性能クロックのOTPは、この個体には既に一度書込み済みです。再実行しないでください。**
メーカー指定値のリセット後読戻しまで確認済みで、通常ファームウェアは読取り・自動検出のみ行います。
`tools/provision_gnss25.py` と `tools/gnss_maintenance_main.cpp` は記録として残した保守用です。
高性能クロックは不可逆ですが、通常の測位周期設定とは別です。

**車両接続中に `testCanLoop` または `verify_board.py --desk-can-loop` を実行しないでください。**
卓上試験はCAN1/CAN2を物理ループ接続し、車両から切り離した場合だけ使用します。

SD書込みタスクは優先度4、IMU/GNSS/採取は5です。SDを6にしていた版では
採取が遅れてGNSSの1更新をCSVへ残せない区間があり、変更後の試験で解消しました。
負荷対策で優先度を変更する際には、この回帰を再確認してください。

## ビルドと証拠ファイル

作業ルートからのビルドは `python -m platformio run -d firmware/logger_v1`。
このPCでは `v1_test/.tools` にPlatformIO/PySerialがあります。環境の詳細はREADME参照。
依存版はPlatformIO 6.1.19、espressif32 7.0.1、ESP-IDF 6.0.1で確認しています。
単体テストは `tests/core_test.cpp`（C++17、ASan/UBSan）、実機試験は `tools/verify_board.py` です。

以下は `firmware/logger_v1/` 基準のローカル保存先です。`artifacts/` はGit除外です。
別PCへ引き継ぐ場合は、必要な証拠・バックアップを非公開の方法で別途受け渡してください。

- 書込み済み版: `artifacts/release_20260831_gnss25/`
- 25 Hz版合格結果とSD読戻し: `artifacts/gnss25/acceptance_final/`
- アプリ接続証拠: `artifacts/gnss25/racecapture_app.log`、`with_racecapture_app.json`
- OTP実施・読戻し証拠: `artifacts/gnss25/provision_result.json`、`readback_independent.json`
- 元の16 MiB Flash: `artifacts/before_logger_v1_full_16MB.bin`（ハッシュはREADME参照）

元のFlashへ戻しても、GNSSモジュール内の恒久OTP設定は元に戻りません。
既存SDログ・既存NVS・回路/配線・他の作業者の変更は保護してください。
