ntakao2006-web/RaceCapture/circuit/logger_v2/AP63301置換_20260922.md

# LTE電源ICの置換（2026-09-22）

TPS62130RGTRを **AP63301WU-7** に交換した。対象は `logger_v2_lte_sd.kicad_sch` の旧TPS62130シンボル。配置座標・既存配線・他系統・メイン回路図・PCBは維持。

## 選定と調達

- [DigiKey購入先](https://www.digikey.jp/ja/products/detail/diodes-incorporated/AP63301WU-7/10491607)：確認時37,215個、カットテープ1個160円（税別）。注文時に再確認する。
- TSOT26、外部リード6本、0.95mmピッチ、露出放熱パッドなし。旧0.5mmピッチQFNより手はんだの接合部を確認しやすい。小型SMDである点は変わらない。
- 秋月優先は継続するが、今回の5V入力・3A級・裸SMD・実装容易性を満たす秋月品を確認できなかったため、このICはDigiKey調達とする。
- 入力3.8～32V、出力3A定格、500kHz固定PWM。出力設定は0.8×(1+374k/100k)=3.792V。軽負荷時にもPWMを続けるため、PFM品に比べ待機時効率は不利。

## ピンと周辺部品

|ピン|名称|今後の接続先|
|---|---|---|
|1|FB|R21/R22分圧点|
|2|EN|MCU電源制御、R23 100kΩでGNDへプルダウン|
|3|VIN|5V、C16/C17/C21の入力バイパス|
|4|GND|GND。FB下側は静かな帰路へ|
|5|SW|L2入力、C29の片側|
|6|BST|C29のもう片側|

- **C29：10nF → 100nF**、秋月114559／GRM188R72A104KA35Dへ交換。BST–SW間用。旧SS/TR–GND接続は使用しない。AP63301は約4msのソフトスタートを内蔵。
- C21はAVIN用からVIN–GNDの100nFバイパスへ用途を更新。L2、C16/C17、R23は用途名、R22はGND名だけ更新。
- L2は2.2µH（SRN6045TA-2R2Y）のまま。5V→3.792V、500kHzで電流リップル約0.83App。5.25V・450kHz・L許容差−30%を仮定しても約1.52App、3A負荷時ピーク約3.76AでIC最小ピーク制限4.1A未満。12V入力用の4.7～6.8µH推奨例をそのまま当てはめず、この基板は5V入力に限定する。
- R21/R22と既存出力容量は維持。データシートのFB上側フィードフォワード容量10～220pFは任意であり、今回は追加しない。330µFバルクを含む実装で起動・負荷ステップ・安定性を確認し、必要なら容量を調整する。
- この作業では配線していない。3A定格はUNO Qの5V供給能力や実基板の連続出力保証ではない。送信ピーク時の電圧降下と温度上昇は実装後に確認する。

## ライブラリと検証

- 専用シンボル `logger_v2_expansion:AP63301WU-7`：メーカー資料の1～6番を照合。
- フットプリント `logger_v2_expansion:Diodes_TSOT26`：メーカー推奨ランド1.0×0.7mm、ピッチ0.95mm、両列外端3.199mm。露出パッドなし。
- 3DはKiCadの公称TSOT-23-6 STEPをプロジェクト内に保存して相対参照。メーカー固有モデルではないが、公称本体1.6×2.9mmのパッケージ形状を表す。
- 全97部品の座標、既存配線、メイン回路図・PCB・プロジェクト設定の保持を比較確認。シンボル交換前は `logger_v2-backups/before_AP63301_20260922` に保存。
- 現在の部品一覧：`output/現在部品一覧_20260922.csv`。20260921の部品表は変更前の履歴。
- KiCadで再描画し、シンボル表示・6ランドの番号一致・3Dのリード位置を確認。確認画像：`output/AP63301_symbol.png`、`output/AP63301_3D.png`。
- メインERCは従来のSTATUS_LATCH未接続ラベル1件のまま。追加回路図は未配線のため171件の未接続ピンが残る。追加ファイルを単独でCLI検査するとプロジェクトのライブラリ表が読まれず、シンボル38件・フットプリント38件のライブラリ未登録警告も出る。ERC合格・回路完成とはしていない。

根拠：[Diodes DS42002 Rev.3-2](https://www.diodes.com/assets/Datasheets/AP63300-AP63301.pdf)、同PDFの配布コピー `output/AP63300_AP63301.pdf`（LCSC配布）。ピンp3、定格p5–6、周辺部品p17–18、パッケージp21を確認。
