ntakao2006-web/RaceCapture/circuit/logger_v2/実装方針.md

# logger_v2 実装方針 — UNO Qシールド、GNSS・LTE・SD

2026-09-22 受動部品の最新指定：[受動部品フットプリント更新](受動部品フットプリント_20260922.md)をC/Lの型番・フットプリントについて優先する。現物は再採番されているため以下の旧番号表と異なる。330uはPanasonic 6SVPC330M（DigiKey）のSMD導電性高分子アルミ電解、10uはMLCC、今後100uを使う場合もDigiKeyのSMD導電性高分子アルミ電解とする。現在のV2に100uはない。L1（現在番号）はユーザー指定によりDFE252012P-2R2M=P2、専用2520フットプリントへ更新済み。回路図・PCBの位置と配線は保持し、大型化したL1周辺はPCB配置調整が必要。

更新日：2026-09-22（現行ファイル照合・端子接続仕様を追記）

採番反映：2026-09-22に第10節の指定番号をメイン回路図と別配置ファイルへ反映済み。U6=SIM7070G、U7=TXU0204、U8=AP63301、U9=SIM保護、U10=SD保護、J8～J11・Q1も指定どおり。以下の「未採番」「現状番号」と第16節は文書作成時の履歴で、現在の番号は第10節の完成形番号に一致する。この採番作業では部品番号のみ変更し、配線・配置・定数・PCBを変更していない。

## 1. 採用する構成と今回の到達点

UNO Qの標準シールド端子を使用し、CAN×2、MAX-M10M GNSS、BNO055 IMU、SIM7070G LTE、microSD、既存LED表示を共存させる。既存のピン割り当ては変更可能とする。

**LTEをハードウェアUARTへ直結し、GNSSをIMUと共通のI²Cへ移す。SPI–UART変換は採用しない。V1と同じSDスロットには独立した挿入検出接点がないため、標準ヘッダーの信号21本を使用し、A5の1本が予備となる。**

本書の目的は、採用品・端子番号・定数・接続ネット・未使用端子処理を固定し、データシートと合わせて同じ電気的回路を再作成できるようにすること。**完成形は第10～15節を規範とする。現在の画面そのものを再現する場合は第16節の現状記録を使う。** 配線の折れ曲がりや文字位置まで一致させるための原図は `.kicad_sch` であり、本書はピン単位の電気的同一性を規定する。

2026-09-22の実ファイルは、メイン回路図69部品（従来59部品＋LTE/SD主要10部品）、別ファイル `logger_v2_lte_sd.kicad_sch` に主要10部品の別配置が残る。メインから別ファイルへの階層シート接続はない。**完成形ではメイン側の10部品を使用し、別ファイルの10部品を二重実装しない。** C15～C29・R21～R31・L2・D12の28部品は現在配置されておらず、第12節に従い追加する。完成形の物理部品数は97（うちDNP 3個）、実装数94。

主要10部品は未採番で、配線途中である。最終照合時にU6相当のSIM7070Gの全GND端子接続を確認した。第10節の番号は今後の採番指定で、現在のファイルに付与した番号ではない。本更新では文書のみ変更し、回路図・配置・配線・PCBには変更を加えない。完成形への変更点を第11節に限定して示す。

過去の部品選定・部品配置更新・AP63301置換記録と20260921/22の旧CSVは、その時点の作業記録。現在配置されているかどうかは本書第16節と現物を優先する。ユーザー指定はUNO Qシールド、秋月優先、裸SMD優先（IMU例外）、MAX-M10M、JCA002、TE 2452796-1、V1同一SDスロット。具体的な追加採番・ネット名・OE固定接続・サービス端子順序は本書で定める設計上の選択であり、メーカーの唯一の指定回路という意味ではない。

## 2. UNO Qのピン割り当て

方向はUNO QのSTM32側を基準とする。D20/D21は専用SDA/SCL端子で、UNO QではA4/A5と別の信号として利用する。全信号は3.3V系を基本とする。

|UNO Q端子|STM32端子|機能・接続先|
|---|---|---|
|D0|PB7|USART1_RX ← LTE UART1_TXD（9番）|
|D1|PB6|USART1_TX → LTE UART1_RXD（10番）|
|D2|PB3|USART1_RTS → LTE UART1_RTS（8番、モジュール入力）|
|D8|PB4|USART1_CTS ← LTE UART1_CTS（7番、モジュール出力）|
|D4|PA12|FDCAN1_TX → CAN1トランシーバーTXD|
|D5|PA11|FDCAN1_RX ← CAN1トランシーバーRXD|
|D11|PB15|SPI2_MOSI：CAN2・SD・LEDシフトレジスター共用|
|D12|PB14|SPI2_MISO：CAN2・SD共用|
|D13|PB13|SPI2_SCK：CAN2・SD・LEDシフトレジスター共用|
|D10|PB9|CAN2_CS_N|
|D9|PB8|CAN2_INT_N|
|A0|PA4|CAN2_RESET_N（従来D8から移動）|
|D20/SDA|PB11|I2C2_SDA：MAX-M10M・BNO055共用|
|D21/SCL|PB10|I2C2_SCL：MAX-M10M・BNO055共用|
|D6|PB1|GNSS_PPS入力|
|D3|PB0|GNSS_RESET_N|
|D7|PB2|LED STATUS_LATCH|
|A1|PA5|IMU_RESET_N（従来D2から移動）|
|A2|PA6|LTE_PWRKEY制御、2N7002でオープンドレイン駆動|
|A3|PA7|LTE_PWR_EN、LTE降圧電源のEN制御|
|A4|PC1|SD_CS_N|
|A5|PC0|予備GPIO（SDスロットに独立した検出接点なし）|

必要信号数は、LTE 6本、CAN1 2本、共用SPI 3本、CAN2個別制御3本、共用I²C 2本、GNSS個別制御2本、LEDラッチ1本、IMUリセット1本、SD個別制御1本の合計21本。22本中1本が予備となる。

LTEのRI・STATUS・DTR、SIMカード検出入力のうち1機能は予備A5へ追加できるが、すべてを接続する余裕はない。必要になれば低速制御用I²C GPIOエキスパンダーを追加する。UNO Q内部のLPUART1/RouterBridgeは維持する。

## 3. LTE：SIM7070G、UART直結

- USART1を2,000,000 baud、8N1、RTS/CTSフロー制御で使用する。SIM7070G側も対応設定を行い、電源投入直後の通信速度から確実に移行できる起動手順を用意する。
- TXU0204PWRでMCUの3.3VとモジュールUARTの1.8Vを変換する。3.3VをSIM7070Gの信号端子へ直結しない。
- VCCA=3.3V、VCCB=SIM7070G VDD_EXT（1.8V）。A1→B1YをMCU TX→LTE RX、A2→B2YをMCU RTS→LTE RTS、B3→A3YをLTE TX→MCU RX、B4→A4YをLTE CTS→MCU CTSに使用する。SIMComのRTS/CTS名称は入出力方向も併記して照合する。
- OE（U7.8）はVCCBと同じLTE_VDD_EXTへ接続する。VDD_EXTはU6.15からの出力で、外部電源を接続しない。TXU0204の電源断時出力遮断機能を使用する。
- UART受信はDMAまたは割り込み＋十分なリングバッファで連続受信する。SD書き込み中も受信を継続し、バッファの空きに応じてフロー制御する。
- ArduinoCore-zephyrのUNO Q設定はUSART1をコンソールにも使用しているため、起動ログを含むコンソール出力を無効化または別出力先へ移す。PB3/PB4のUSART1 RTS/CTSをpinctrlとドライバーで有効にする。通常のSerial初期化だけで実現済みとは扱わない。
- PWRKEYは規定の時間だけLowにする。通常の電源断はATコマンド等で終了処理してからVBATを切る。電源ENは異常復帰にも使用する。
- 基本構成ではDTRによるスリープ制御を使用せず、AT+CSCLK=0を前提にする。未使用端子はハードウェア設計書に従って処理し、必要に応じてテストパッドを設ける。

2 Mbps/8N1では理論上200 kB/s、データビット換算1.6 Mbpsを搬送できる。約1 Mbpsの上り目標に対してUARTには余裕があるが、ATコマンド・ネットワーク処理・バッファリングの余裕は実測する。SIM7070GのCat-M公称値は上り1119 kbps、下り589 kbpsであり、**上下とも1 Mbps、または常時1 Mbpsを保証する要求には適合しない**。下り1 Mbpsが必須ならモジュール選定を変更する。

## 4. GNSS・IMU：共用I²C

- MAX-M10M-00Bを維持し、SDA/SCLをBNO055と同じI2C2へ接続する。GNSSのUART配線を外し、D0/D1をLTEへ割り当てる。
- GNSSの7ビットアドレスは0x42、BNO055はADR設定により0x28/0x29で、アドレスは競合しない。
- 400 kHzを設計目標とする。MAX-M10Mは最大20 msのクロックストレッチを行うため、MCU側タイムアウトとIMU取得周期への影響を確認する。PPSは独立GPIOで時刻を取得する。
- GNSS出力メッセージを必要分に制限し、FIFO取りこぼしとIMU取得の遅延を評価する。必要な周期を満たせない場合は別I²Cバスへ分離し、増える制御線をGPIOエキスパンダーで補う案を再評価する。
- IMU用プルアップは実装部品とする。DNPに戻さない。GNSS側に重複したプルアップを漫然と追加せず、合成抵抗と配線容量で立ち上がり時間を確認する。
- GNSS PPS、GNSSリセット、IMUリセットを維持する。JCA002アンテナは外部3.3V→27Ω/1W→27nH→SMAから給電し、抵抗後に10nFをGNDへ接続する。LNA_ENの10kΩは必須ではなく、R10は従来どおりDNP。VCC_RFは未接続。短絡・開放の検出機能やアンテナ電源の自動遮断は持たない。具体的な定格・RF部品・V1比較は部品選定文書を参照する。

## 5. CAN・SD・LED

- CAN1はSTM32内蔵FDCAN＋既存トランシーバー。将来の配線変更時に、現在のTXD固定Highを解除してD4へ接続する。車両での初期運用は受信専用設定とする。
- CAN2とmicroSDはSPI2を共有し、個別CSを設ける。CSは起動中も非選択となるようプルアップし、非選択時のMISO解放を確認する。
- microSDはLoggerV1と同じMolex 47219-2001を使用し、3.3V電源、デカップリング、ESD対策を用意する。1～8番はSD接点、9番はシールド共通端子。DAT3/CDの名称は独立した機械式カード検出端子を意味せず、SPIではCSとして使用する。A5は予備とし、カード有無は初期化・通信結果で判定する。安全な取り外し処理を実装するまで通電中の抜き差しに対応済みとは扱わない。
- 74HC595系LEDはSPIのMOSI/SCKを共用する。CAN/SD通信中も内部シフト内容は変わるため、LED更新時だけ全ビットを書き直してからラッチする。全デバイスの転送を同じバス排他制御下で行う。
- SD書き込みを分割・バッファリングし、CAN2割り込みから読み出しまでの最悪遅延とCAN受信FIFOの余裕を測定する。

## 6. SIMカードスロットとライブラリ

ユーザー指定の **TE Connectivity 2452796-1**（RS品番286-8822）、ヒンジ式nanoSIMスロットを使用する。旧NSIM-2-Cから置き換えた。TE図面C-2452796 Rev Cの端子番号を採用し、SIM接点番号C1～C7とは区別する。

|項目|配置・ファイル|
|---|---|
|回路図|メイン `logger_v2.kicad_sch` に配置済み、未採番・未配線。別ファイルにも複製あり|
|シンボル|`logger_v2_expansion:TE_2452796-1`|
|フットプリント|`logger_v2_expansion:nanoSIM_TE_2452796-1_Hinge`|
|シンボルライブラリ|`logger_v2_expansion.kicad_sym`|
|フットプリントファイル|`logger_v2_expansion.pretty/nanoSIM_TE_2452796-1_Hinge.kicad_mod`|
|3Dモデル|`${KIPRJMOD}/3dmodels/TE_2452796-1.step`、メーカーSTEPを基板座標へ変換|

|部品端子番号|名称／SIM接点|将来の接続|
|---|---|---|
|1|VCC／C1|SIM7070G SIM_VDD（30番）|
|2|RST／C2|SIM_RST（33番）から22Ω直列|
|3|CLK／C3|SIM_CLK（32番）から22Ω直列|
|6|I/O／C7|SIM_DATA（31番）と22Ω直列で接続|
|4|GND／C5|GND、カード検出接点の共通側|
|5|VPP/NC／C6|未接続|
|7|SW|挿入時に4番（C5/GND）へ閉じる。基本構成ではMCU接続なし|
|8、9、10|SHIELD|各固定パッドをGNDへ接続|

SIM7070GのUART/VDD_EXT、SIMインターフェースはいずれも1.8V系。SIM_VDDはモジュールの専用出力で、VDD_EXTとは別ネットにする。Hardware Design V1.03 §3.6に従い1.8V対応SIMを使用し、3V専用SIMと活線挿抜は対象外。SIM_VDDを外部の3.3VやVDD_EXTへ接続しない。スロット近傍に100 nFと適切な低容量ESD保護を設ける。DATAにはモジュール内蔵プルアップがあるため外付けプルアップを追加しない。VDD、RST、CLK、DATAを保護し、配線は短くする。検出接点の共通側はC5/GND（部品4番）。

シンボル・フットプリントはともに1～10番を使用する。信号パッド0.8×1.0 mm、固定・検出パッド1.3×1.8 mmとし、メーカー指定の6か所の配線・ビア禁止領域を設ける。3Dはメーカー提供モデル（CVM Rev A、外形約12.2×14.1×1.4 mm）を使用する。部品の発注・基板化前には開閉スペースと周辺部品との干渉を再確認する。

## 7. 電源・実装規則

- シールドの基本電源は5Vと3.3V。LTEのVBATだけ5Vから約3.8Vへ降圧する。3.3V端子やVDD_EXTからLTE本体を給電しない。
- LTE降圧電源はAP63301WU-7（TSOT26、3A、DigiKey調達）を使用する。入手性と手実装性を優先し、2026-09-22にTPS62130から交換した。C29は100nFのBST–SW用へ変更。詳細は[置換記録](AP63301置換_20260922.md)。2G動作を含む最悪条件では約2Aのピークを見込み、5V供給源・コネクター・配線抵抗・インダクター・バルク容量を含めて設計する。UNO Qの5V端子から必要な余剰電力を得られるかは別途確認し、未確認のまま給電能力を保証しない。
- GNSS、IMU、SD、CAN、LEDを含む3.3V電源の合計負荷を集計する。SD書き込みとLTE送信が重なった条件で電源降下・リセット・GNSS受信への影響を確認する。
- 基本はローカルラベルで配線し、文字サイズは1.27 mmの標準値。別シート間はローカルラベルだけでは接続されないため、階層ラベルとシートピンを使用する。
- 将来の配線変更も必要箇所に限定し、既存の必要部品を削除・移動しない。不要な旧案部品は配線実装時に明示して整理する。
- 今後追加する部品にもフットプリントと3Dモデルを割り当てる。最終部品表確定後は、基板上で全体の配置・向き・干渉を確認する。
- SIM7070G・SIM/SDスロット以外は可能な限り秋月で調達し、裸SMD部品を優先する。DIP化基板は採用せず、IMUのみ例外とする。シールド端子・既存ケーブル用コネクターは機械的理由でスルーホールを維持する。RF保護・UARTレベル変換・LTE電源等の例外と品番は部品選定文書に明示する。
- 完成形97部品の型番・フットプリント・3D参照は第14節に固定する。現在のメインには69部品がある。3Dにはメーカー品のほか、公称形状モデル・汎用モデルを含み、厳密なメーカー形状や実装実績を意味しない。

## 8. 実装・検証の順序

1. 上表に従って回路図を変更し、LTE電源・SIM・SDの周辺部品を確定する。採番、未使用端子処理、電源ネット、階層接続を確認しERCを実施する。
2. UNO QのUSART1をLTE専用にし、2 Mbps・RTS/CTS・連続受信を確認する。起動ログの混入、相手電源断、受信バッファ飽和からの復帰も確認する。
3. GNSS＋IMUを共用I²Cで動かし、クロックストレッチ時のIMU取得遅延、GNSS欠落、PPS時刻精度を測定する。
4. CAN×2受信、GNSS、IMU、LTE送信、SD保存、LED更新を同時に実行し、欠落数・最大バッファ使用量・SD最大停止時間・実効LTE速度を記録する。
5. 回路図確定後にPCBへ反映し、フットプリント・3D・電源/RF配置を確認してDRCを実施する。製造データはその時点で再生成する。

UARTの理論容量やGPIO数の成立と、同時動作の実機検証完了を混同しない。現時点では配線変更・ファームウェア変更・実機同時動作試験は未実施。

## 9. 根拠資料

- [Arduino UNO Q 公式ピンアウト](https://docs.arduino.cc/resources/pinouts/ABX00162-full-pinout.pdf)
- [ArduinoCore-zephyr UNO Q設定](https://github.com/arduino/ArduinoCore-zephyr/blob/main/variants/arduino_uno_q_stm32u585xx/arduino_uno_q_stm32u585xx.overlay)
- [STM32U585 データシート](https://www.st.com/resource/en/datasheet/stm32u585ri.pdf)／[Zephyr STM32U585ピン定義](https://github.com/zephyrproject-rtos/hal_stm32/blob/main/dts/st/u5/stm32u585zitx-pinctrl.dtsi)
- [MAX-M10M-00B データシート](https://content.u-blox.com/sites/default/files/documents/MAX-M10M-00B_DataSheet_UBX-22028884.pdf)
- [SIM7070G公式仕様](https://en.simcom.com/product/SIM7070G.html)、SIMCom Hardware Design（ローカル保存：`refs/SIM7070_hardware.pdf`）
- [TE 2452796-1メーカー資料・3Dモデル](https://www.te.com/en/product-2452796-1.html)（図面：`refs/TE_2452796_RevC.pdf`、メーカーSTEP原本：`refs/TE_2452796-1_original.step`）
- [ユーザー指定のRS商品ページ](https://jp.rs-online.com/web/p/memory-card-connectors/2868822)
- [TXU0204 データシート](https://www.ti.com/lit/ds/symlink/txu0204.pdf)

ローカルの参照PDFと取得済みUNO Q定義は `refs/` に保存。SIMスロットの置換・端子整合・3D確認は2026-09-20時点の作業ファイルを対象とする。

## 10. 再作成時の採番・作図規則

メインシート1枚に完成形を描く。既存U1～U5、J1～J7、C1～C14、R1～R20、D1～D11、L1、Y1は番号・定数・必要な配置を維持する。未採番10部品は次表に従って採番する。別ファイルの複製は完成品BOMに加算しない。既存に番号が付いている場合はUUID・型番・用途で対応を照合し、既存番号との衝突を避ける。

|完成形番号|現状番号|部品|識別用途|メイン座標x,y,角度(mm,°)|
|---|---|---|---|---|
|J8|J?|2452796-1|1.8V nanoSIM; hinged socket with detect|191.77, 193.04, 0|
|J10|J?|LTE service 1x06|USB VBUS/DP/DM/GND + BOOT_CFG/VDD_EXT service header|137.16, 218.44, 0|
|J11|J?|U.FL-R-SMT-1(10)|LTE antenna, 50 ohm RF path|157.48, 219.71, 0|
|U8|U?|AP63301WU-7|5V to 3.8V LTE buck; MCU-controlled EN|142.24, 246.38, 0|
|U6|U?|SIM7070G|LTE Cat-M/NB; VBAT 3.8V, UART/SIM 1.8V|77.47, 217.17, 0|
|Q1|Q?|2N7002|Open-drain PWRKEY; do not drive PWRKEY high|262.89, 185.42, 0|
|J9|J?|47219-2001|3.3V microSD SPI; card detect|320.04, 195.58, 0|
|U7|U?|TXU0204PWR|TX/RX/RTS/CTS 3.3V to 1.8V|143.51, 194.31, 0|
|U10|U?|USBLC6-4SC6|microSD ESD: CLK/CS/MOSI/MISO|278.13, 219.71, 0|
|U9|U?|USBLC6-4SC6|SIM ESD: VDD/CLK/RST/DATA|181.61, 245.11, 0|

- 同一名のローカルラベルは**この1枚のシート内**で接続する。`+5V`・`+3V3`・`GND`は電源シンボルを使用可。他の電源名はローカルラベルとして扱う。別シート化するときは明示した階層ピンが別途必要。
- ラベル・参照番号・値の標準文字サイズは1.27mm。信号名は第13節の綴りで固定。`U6.9`はU6の物理9番ピンを表す。
- 点のある交差だけを接続し、意図したT字接続には接続点を付ける。ラベルはピンまたは配線端点へスナップする。ラベルを近くに置くだけでは接続にならない。
- 未配線作業中のピンに一律No Connectを付けない。完成後、第13節のNC表の端子だけにNo Connectを付ける。
- R10、R13、R14はシンボルと配線を残してDNP。R15、R16は実装する。DNP抵抗の両端を短絡してはならない。
- 追加部品28個は用途ブロックの空き領域に置き、必要な既存部品を動かして場所を作らない。電気的再現は第13節、現在の配置再現は第16節を使用する。

## 11. 現状から完成形へ変更する箇所

|対象|現在|完成形|
|---|---|---|
|D0/D1：J5.8/J5.7|GNSS UART|U7経由でLTE UARTへ。U2.2/U2.3はNC|
|D2：J5.6|IMU_RESET_N|LTE_RTS_3V3。IMUリセットはA1/J4.2へ|
|D8：J2.10|CAN2_RESET_N|LTE_CTS_3V3。CAN2リセットはA0/J4.1へ|
|D4：J5.4、U4.1|D4未接続、CAN1 TXDは+3V3固定|両端をCAN1_TXDで接続。U4.1の+3V3固定を外す|
|U2.16/U2.17|未接続|I2C_SDA/I2C_SCL。既存IMUバスもこの名前へ統一|
|STATUS_LATCH|J5.1側ラベルとU1.12側が未接続|J5.1/U1.12/R20.1を同じネットへ|
|A2/A3/A4|未接続|LTE_PWRKEY_CTL/LTE_PWR_EN/SD_CS_N|
|A5|未接続|予備。現時点ではNCのまま|
|LTE/SIM/SD主要10個|未採番・配線途中（SIM7070GのGND接続あり）|第10節で採番、第12～13節で接続|
|周辺28個|現在のファイルにはない|第12・14節の部品を追加|

他の既存ネットは第13節の表どおり保持する。GND・電源にまとめられた端子を信号へ付け替える際は、元の電源線も確実に切り離す。特にU4.1に+3V3とMCU出力を同時接続しない。

## 12. ブロックごとの確定接続

### 12.1 UNO Qヘッダー

|コネクター|物理ピンとUNO Q端子の対応|
|---|---|
|J2 1×10|1=SCL/D21、2=SDA/D20、3=AREF（NC）、4=GND、5=D13、6=D12、7=D11、8=D10、9=D9、10=D8|
|J5 1×8|1=D7、2=D6、3=D5、4=D4、5=D3、6=D2、7=D1、8=D0|
|J4 1×6|1=A0、2=A1、3=A2、4=A3、5=A4、6=A5（NC）|
|J3 1×8|1=予約（NC）、2=IOREF（NC）、3=RESET（NC）、4=3.3V、5=5V、6/7=GND、8=VIN（NC）|

ヘッダーの物理的向きはプロジェクトの既存フットプリントとUNO Q公式ピンアウトを合わせる。上表の番号はArduinoのD番号そのものではない。基板を裏返した視点で番号を逆転させない。

### 12.2 LTE電源：AP63301WU-7

U8.3(VIN)=+5V、U8.4=GND、U8.2(EN)=LTE_PWR_EN。ENにはR23=100kΩをGNDへ接続。MCU起動時はENをLowとする。

|部品|値|端子1|端子2|配置上の役割|
|---|---|---|---|---|
|L2|2.2µH、SRN6045TA-2R2Y|LTE_SW|LTE_VBAT|U8.5と出力の間|
|C16/C17|各10µF|+5V|GND|U8入力、並列20µF公称|
|C21|100nF|+5V|GND|U8.3直近|
|C18/C19/C20|各10µF|LTE_VBAT|GND|出力、並列30µF公称|
|C15|330µF/6.3V低ESRポリマー|LTE_VBAT（＋）|GND（−）|SIM7070G近傍|
|C22/C23|100nF/1µF|LTE_VBAT|GND|SIM7070GのVBAT直近|
|D12|PESDHC2FD4V5B、双方向TVS|LTE_VBAT|GND|VBAT過渡保護|
|R21|374kΩ 1%|LTE_VBAT|LTE_FB|分圧上側|
|R22|100kΩ 0.1%|LTE_FB|GND|分圧下側|
|R23|100kΩ|LTE_PWR_EN|GND|電源起動時OFF|
|C29|100nF|LTE_BST|LTE_SW|U8.6(BST)–U8.5(SW)間|

U8.1=LTE_FB。Vout公称3.792V。C29はGNDへつながない。AP63301はソフトスタート内蔵であり、TPS62130用SS/TR配線・旧10nFは引き継がない。L2の値は5V入力用。12Vをこの電源入力へ供給する設計には変更しない。出力コンデンサーの実効容量、330µFを含む起動・負荷変動応答、熱設計は実装後評価項目。基本構成に任意のFB補償コンデンサーは追加しない。

### 12.3 LTE本体・UART・電源操作

U6.55/56/57をすべてLTE_VBATへ、GND端子2/17/18/29/39/45/46/54/58/59/61/62/63/64/65をすべてGNDへ接続。U6.15のLTE_VDD_EXTはモジュールが出す1.8V、最大50mA。UART変換用として使い、他電源と合流させない。

|経路|3.3V側|TXU0204 U7|1.8V側|
|---|---|---|---|
|MCU→LTE送信|D1/J5.7|2(A1)→13(B1Y)|U6.10 RXD|
|MCU→LTE RTS|D2/J5.6|3(A2)→12(B2Y)|U6.8 RTS（入力）|
|LTE→MCU受信|D0/J5.8|4(A3Y)←11(B3)|U6.9 TXD|
|LTE→MCU CTS|D8/J2.10|5(A4Y)←10(B4)|U6.7 CTS（出力）|

U7.1(VCCA)=+3V3、U7.14(VCCB)=LTE_VDD_EXT、U7.7=GND、U7.8(OE)=LTE_VDD_EXT、U7.6/9=NC。C27=100nFをU7.1–GND、C28=100nFをU7.14–GNDへ配置。OEは空中配線や未接続にしない。両電源成立時に有効化し、電源断時はICのIoff/VCC isolation機能を利用する。

Q1=2N7002は1=G、2=S、3=D。A2/J4.3→R25 1kΩ→Q1.1、Q1.1→R24 100kΩ→GND、Q1.2=GND、Q1.3=U6.1(PWRKEY)。A2 HighでPWRKEYをLowにする反転動作。PWRKEYへ3.3Vを直接印加しない。VBAT安定後、起動パルスは1秒以上かつ12.6秒未満（実装目標1.5秒）として解放する。通常停止はAT+CPOWD=1完了後に電源ENを落とす。MCU起動時はA2/A3をLowに保つ。

### 12.4 nanoSIM・USBLC6-4SC6

R28=22ΩはU6.32→J8.3、R29=22ΩはU6.33→J8.2、R30=22ΩはU6.31↔J8.6の直列部品。各抵抗の1番をモジュール側、2番をスロット側に統一。C24=100nFはSIM_VDD–GND。SIM_DATAに外付けプルアップは加えない。

U9=USBLC6-4SC6の接続を以下に固定する。これは保護部品の端子を信号へ枝接続する構成で、信号経路にICを直列挿入する構成ではない。

|U9端子|名称|接続|
|---|---|---|
|1|I/O1|SIM_VDD（J8.1）|
|2|GND|GND|
|3|I/O2|SIM_CLK、R28のスロット側|
|4|I/O3|SIM_RST、R29のスロット側|
|5|VBUS|SIM_VDD。+5Vではない|
|6|I/O4|SIM_DATA、R30のスロット側|

J8.4/8/9/10=GND、J8.5=NC、J8.7=NC。検出スイッチは搭載されるが、今回のGPIO構成では使用しない。保護IC・C24はスロット近傍へ置き、GNDへの帰路と枝線を短くする。USBLC6の電源名VBUSを理由に5Vへ接続しない。内蔵TVSは1.8Vの精密クランプではないため、SIMComの保護容量条件だけでシステムのESD耐性が保証されるとは扱わず、完成基板で確認する。

### 12.5 microSD・USBLC6-4SC6

|J9端子|接続|
|---|---|
|1 DAT2|NC|
|2 DAT3/CD|SD_CS_N、R26 47kΩで+3V3へプルアップ|
|3 CMD|SPI2_MOSI|
|4 VDD|+3V3|
|5 CLK|SPI2_SCK|
|6 VSS|GND|
|7 DAT0|SPI2_MISO、R27 47kΩで+3V3へプルアップ|
|8 DAT1|NC|
|9 SHIELD|GND（同番号の固定パッドすべて）|

C25=10µF、C26=100nFを+3V3–GND、スロット近傍へ置く。U10=USBLC6-4SC6は1=SPI2_SCK、3=SD_CS_N、4=SPI2_MOSI、6=SPI2_MISO、5=+3V3、2=GND。C26を保護ICのVBUSバイパスとしても近接配置する。独立CDスイッチは存在しない。DAT3/CDを機械式検出入力として別GPIOへ配線しない。

### 12.6 LTEアンテナ・サービス端子

U6.60→R31 0Ω→J11.1、J11.2=GND。R31の1番がモジュール側。経路は50Ω伝送線として配置設計する。LTE_RF/LTE_RF_MODEMのラベルは接続識別用で、基板上に長い枝線を設けない。SIM7070G内蔵GNSSは使用せずU6.53はNC。

J10は次の順序に固定：1=LTE_USB_VBUS(U6.24)、2=LTE_USB_DP(U6.27)、3=LTE_USB_DM(U6.28)、4=GND、5=LTE_BOOT_CFG(U6.6)、6=LTE_VDD_EXT(U6.15)。USB_VBUSは外部USBホストの検出電圧入力であり、基板+5Vと常時短絡しない。BOOT_CFGは通常開放し、通常起動時にはプルアップしない。VDD_EXT端子は出力参照で、電源入力ではない。USBは保守用ヘッダーの予約であり、筐体外の常用USBポートとしての保護・信号品質保証は含めない。

U6の未使用UART補助、GPIO、PCM、ADC、I²C、NETLIGHT、STATUS、NC端子は第13節NC表どおり開放。GPIO1を起動前にプルアップしない。DTR開放・AT+CSCLK=0を基本とする。

### 12.7 GNSS・IMU・アンテナ給電

U2の6/7/8=+3V3、1/10/12=GND、16=I2C_SDA、17=I2C_SCL、4=GNSS_PPS、9=GNSS_RESET_N。R5=10kΩはRESET_Nの+3V3プルアップ。2/3/5/14/15/18はNC。特に15(VIO_SEL)は3.3V動作では開放し、GNDへ落とさない。SAFEBOOT_Nは開放し、TIMEPULSEを起動時にLow固定しない。

アンテナ経路は +3V3→R7 27Ω/1W→GNSS_ANT_BIAS→L1 27nH→GNSS_RF。C1 10nFをGNSS_ANT_BIAS–GNDへ。GNSS_RFはU2.11/J1.1/D11.2/L1.1が共通、J1.2/D11.1=GND。RF用D11は選定済みPESD5V0F1BL-Q。外部アンテナは秋月112223のJCA002。U2.14(VCC_RF)からは給電しない。LNA_EN(U2.13)→R10 10kΩ→GNDは回路上に残すがR10はDNP。この構成は常時アンテナ給電で、LNA_ENによる電源制御を行わない。

R7は短絡時3.3²/27≒0.40Wを抵抗で受ける設計なので1W品。これはV1の抵抗が必ず誤りだったという意味ではなく、電源経路・短絡保護の設計条件が異なる。アンテナ正常時の消費電流による電圧降下も確認する。

U3はAE-BNO055-BOモジュール。1=+3V3、2/7=GND、3=I2C_SDA、4=I2C_SCL、5=IMU_RESET_N、6/8=NC。出荷時I²C・アドレス0x28のジャンパ設定を使用する（モジュール上J4/J5接続、J1開放。これらはシールドのJ番号とは別）。R15=4.7kΩでSCLを、R16=4.7kΩでSDAを+3V3へプルアップし、両方実装する。GNSS専用の同じプルアップを追加しない。

### 12.8 CAN・LED・既存電源部品

U4 ATA6561は1=CAN1_TXD、4=CAN1_RXD、3=+5V、5=+3V3、2/8=GND、7=CAN1_H、6=CAN1_L。J7.2=CAN1_H、J7.3=CAN1_L、J7.4=GND、J7.1=NC。D10の1/2をCAN1_H/L、3をGNDへ。R14=120ΩはCAN1_H–CAN1_L間、DNPを維持。

U5 MCP25625は1/19=+3V3、27=+5V、5/10/26=GND、14=SPI2_SCK、15=SPI2_MOSI、16=SPI2_MISO、17=CAN2_CS_N、13=CAN2_INT_N、18=CAN2_RESET_N。R12=10kΩはCS、R17=10kΩはRESETの+3V3プルアップ。U5.20↔24、U5.21↔28をそれぞれ結ぶ。U5.9/Y1.3/C2.1、U5.8/Y1.1/C3.1を接続。Y1=20MHz CL10pF、C2/C3=15pF、Y1.2/4とC2.2/C3.2=GND。

U5.4=CAN2_H、U5.3=CAN2_L。J6.1=+5V、2=CAN2_H、3=CAN2_L、4=GND。D9の1/2をCAN2_H/L、3をGNDへ。R13=120ΩはCAN2_H–CAN2_L間、DNP。CAN終端は外部バスの既存終端を前提にする。RTS/BF等未使用端子はNC表を適用し、MCP25625初期化時に未使用RTSの送信要求機能を有効にしない。

U1は16/10=+3V3、8/13=GND、14=SPI2_MOSI、11=SPI2_SCK、12=STATUS_LATCH、9=NC。R18/R19/R20は47kΩでMOSI/SCK/LATCHをGNDへ。QA～QHは順にR1/R2/R3/R4/R6/R8/R9/R11（各1kΩ）→D1～D8アノードへ。全LEDカソード=GND。LEDの出力対応は第13節で固定する。

C4/C6/C7/C8/C10/C12（各100nF）、C11（1µF）、C13/C14（各10µF）は+3V3–GND。C5/C9（各100nF）は+5V–GND。この既存並列接続を維持する。回路図で電源部品をまとめて表示していても、基板では各IC電源ピンとGNDのバイパス経路を短くする。最終配置のパスコン割当・電源インピーダンスはPCBレビューで確認する。

## 13. 完成形の全ネットと未使用端子

**この節が接続の規範表。表中の同一行に記載した端子はすべて同一ネットへ接続し、別の行同士は接続しない。** 抵抗・コイル・コンデンサーの両端も個別に記載している。`Net-(...)`は既存の無名ネットを区別するための名称で、そのままローカルラベルにしても、列挙端子を直接配線してもよい。電源フラグ等は物理部品97個に含めず、ERCで実際の給電元を表すため必要なネットだけに設定する。

|ネット名|同一ネットに接続する全端子（部品番号.物理ピン番号）|
|---|---|
|+3V3|C4.1, C6.1, C7.1, C8.1, C10.1, C11.1, C12.1, C13.1, C14.1, C25.1, C26.1, C27.1, J3.4, J9.4, R5.1, R7.1, R12.1, R15.2, R16.2, R17.1, R26.2, R27.2, U1.10, U1.16, U2.6, U2.7, U2.8, U3.1, U4.5, U5.1, U5.19, U7.1, U10.5|
|+5V|C5.1, C9.1, C16.1, C17.1, C21.1, J3.5, J6.1, U4.3, U5.27, U8.3|
|CAN1_H|D10.1, J7.2, R14.2, U4.7|
|CAN1_L|D10.2, J7.3, R14.1, U4.6|
|CAN1_RXD|J5.3, U4.4|
|CAN1_TXD|J5.4, U4.1|
|CAN2_CS_N|J2.8, R12.2, U5.17|
|CAN2_H|D9.1, J6.2, R13.2, U5.4|
|CAN2_INT_N|J2.9, U5.13|
|CAN2_L|D9.2, J6.3, R13.1, U5.3|
|CAN2_OSC1|C2.1, U5.9, Y1.3|
|CAN2_OSC2|C3.1, U5.8, Y1.1|
|CAN2_RESET_N|J4.1, R17.2, U5.18|
|CAN2_RX_LOOP|U5.21, U5.28|
|CAN2_TX_LOOP|U5.20, U5.24|
|GND|C1.2, C2.2, C3.2, C4.2, C5.2, C6.2, C7.2, C8.2, C9.2, C10.2, C11.2, C12.2, C13.2, C14.2, C15.2, C16.2, C17.2, C18.2, C19.2, C20.2, C21.2, C22.2, C23.2, C24.2, C25.2, C26.2, C27.2, C28.2, D1.1, D2.1, D3.1, D4.1, D5.1, D6.1, D7.1, D8.1, D9.3, D10.3, D11.1, D12.2, J1.2, J2.4, J3.6, J3.7, J6.4, J7.4, J8.4, J8.8, J8.9, J8.10, J9.6, J9.9, J10.4, J11.2, Q1.2, R10.2, R18.2, R19.2, R20.2, R22.2, R23.2, R24.2, U1.8, U1.13, U2.1, U2.10, U2.12, U3.2, U3.7, U4.2, U4.8, U5.5, U5.10, U5.26, U6.2, U6.17, U6.18, U6.29, U6.39, U6.45, U6.46, U6.54, U6.58, U6.59, U6.61, U6.62, U6.63, U6.64, U6.65, U7.7, U8.4, U9.2, U10.2, Y1.2, Y1.4|
|GNSS_ANT_BIAS|C1.1, L1.2, R7.2|
|GNSS_LNA_EN|R10.1, U2.13|
|GNSS_PPS|J5.2, U2.4|
|GNSS_RESET_N|J5.5, R5.2, U2.9|
|GNSS_RF|D11.2, J1.1, L1.1, U2.11|
|I2C_SCL|J2.1, R15.1, U2.17, U3.4|
|I2C_SDA|J2.2, R16.1, U2.16, U3.3|
|IMU_RESET_N|J4.2, U3.5|
|LTE_BOOT_CFG|J10.5, U6.6|
|LTE_BST|C29.1, U8.6|
|LTE_CTS_1V8|U6.7, U7.10|
|LTE_CTS_3V3|J2.10, U7.5|
|LTE_FB|R21.2, R22.1, U8.1|
|LTE_PWRKEY_CTL|J4.3, R25.1|
|LTE_PWRKEY_GATE|Q1.1, R24.1, R25.2|
|LTE_PWRKEY_N|Q1.3, U6.1|
|LTE_PWR_EN|J4.4, R23.1, U8.2|
|LTE_RF|J11.1, R31.2|
|LTE_RF_MODEM|R31.1, U6.60|
|LTE_RTS_1V8|U6.8, U7.12|
|LTE_RTS_3V3|J5.6, U7.3|
|LTE_RX_1V8|U6.10, U7.13|
|LTE_RX_3V3|J5.8, U7.4|
|LTE_SW|C29.2, L2.1, U8.5|
|LTE_TX_1V8|U6.9, U7.11|
|LTE_TX_3V3|J5.7, U7.2|
|LTE_USB_DM|J10.3, U6.28|
|LTE_USB_DP|J10.2, U6.27|
|LTE_USB_VBUS|J10.1, U6.24|
|LTE_VBAT|C15.1, C18.1, C19.1, C20.1, C22.1, C23.1, D12.1, L2.2, R21.1, U6.55, U6.56, U6.57|
|LTE_VDD_EXT|C28.1, J10.6, U6.15, U7.8, U7.14|
|Net-(D1-A)|D1.2, R1.2|
|Net-(D2-A)|D2.2, R2.2|
|Net-(D3-A)|D3.2, R3.2|
|Net-(D4-A)|D4.2, R4.2|
|Net-(D5-A)|D5.2, R6.2|
|Net-(D6-A)|D6.2, R8.2|
|Net-(D7-A)|D7.2, R9.2|
|Net-(D8-A)|D8.2, R11.2|
|Net-(U1-QA)|R1.1, U1.15|
|Net-(U1-QB)|R2.1, U1.1|
|Net-(U1-QC)|R3.1, U1.2|
|Net-(U1-QD)|R4.1, U1.3|
|Net-(U1-QE)|R6.1, U1.4|
|Net-(U1-QF)|R8.1, U1.5|
|Net-(U1-QG)|R9.1, U1.6|
|Net-(U1-QH)|R11.1, U1.7|
|SD_CS_N|J4.5, J9.2, R26.1, U10.3|
|SIM_CLK|J8.3, R28.2, U9.3|
|SIM_CLK_MODEM|R28.1, U6.32|
|SIM_DATA|J8.6, R30.2, U9.6|
|SIM_DATA_MODEM|R30.1, U6.31|
|SIM_RST|J8.2, R29.2, U9.4|
|SIM_RST_MODEM|R29.1, U6.33|
|SIM_VDD|C24.1, J8.1, U6.30, U9.1, U9.5|
|SPI2_MISO|J2.6, J9.7, R27.1, U5.16, U10.6|
|SPI2_MOSI|J2.7, J9.3, R18.1, U1.14, U5.15, U10.4|
|SPI2_SCK|J2.5, J9.5, R19.1, U1.11, U5.14, U10.1|
|STATUS_LATCH|J5.1, R20.1, U1.12|

次の端子だけを未使用とし、完成図でNo Connectを付ける。DNPはこの表とは別概念で、R10/R13/R14の配線を消さない。SAFEBOOT_NやVIO_SELなどメーカー指定の開放端子に抵抗や電源を推測で追加しない。

|部品|配線しない端子（番号と名称）|
|---|---|
|J2|3 (Pin_3)|
|J3|1 (Pin_1), 2 (Pin_2), 3 (Pin_3), 8 (Pin_8)|
|J4|6 (Pin_6)|
|J7|1 (Pin_1)|
|J8|5 (VPP/NC), 7 (SW)|
|J9|1 (DAT2), 8 (DAT1)|
|U1|9 (QH')|
|U2|2 (TXD), 3 (RXD), 5 (EXTINT), 14 (VCC_RF), 15 (VIO_SEL), 18 (SAFEBOOT_N)|
|U3|6 (INT), 8 (V_{OUT})|
|U5|2 (NC), 6 (~{Tx1RTS}), 7 (~{Tx2RTS}), 11 (~{Rx1BF}), 12 (~{Rx0BF}), 22 (CLKOUT), 23 (~{Tx0RTS}), 25 (NC)|
|U6|3 (UART1_DTR), 4 (UART1_RI), 5 (UART1_DCD), 11 (PCM_CLK), 12 (PCM_SYNC), 13 (PCM_DIN), 14 (PCM_DOUT), 16 (NC), 19 (GPIO1), 20 (GPIO2), 21 (GPIO3), 22 (DEBUG_RXD), 23 (DEBUG_TXD), 25 (ADC), 26 (NC), 34 (GPIO4), 35 (NC), 36 (NC), 37 (I2C_SDA), 38 (I2C_SCL), 40 (NC), 41 (NC), 42 (NC), 43 (NC), 44 (NC), 47 (NC), 48 (GPIO5), 49 (UART3_RXD), 50 (UART3_TXD), 51 (NC), 52 (NETLIGHT), 53 (GNSS_ANT), 66 (STATUS), 67 (GPIO6), 68 (GPIO7)|
|U7|6 (NC), 9 (NC)|

全97部品の全端子をネットまたはNCに一度ずつ割り当てた検査用CSVも保存する：`output/完成形ピン接続仕様_20260922.csv`。これは完成形仕様であり、現在の回路図からそのまま抽出したネットリストではない。

## 14. 完成形BOM・フットプリント・3D

型番を変更するときはピン配置・電圧・許容差・定格・パッケージまで再照合する。MPN空欄を別品へ自由置換する意味にしない。購入先は選定履歴であり、今回すべての販売在庫を再確認した表ではない。

|番号|値|MPN|現在の状態|実装区分|調達先・商品番号|資料|
|---|---|---|---|---|---|---|
|C1|10nF|GRM188B11H103KA01|配置済み|実装|秋月電子通商 113387|[資料/購入先](https://akizukidenshi.com/catalog/g/g113387/)|
|C2|15pF|CC0603N150J500|配置済み|実装|秋月電子通商 113312|[資料/購入先](https://akizukidenshi.com/catalog/g/g113312/)|
|C3|15pF|CC0603N150J500|配置済み|実装|秋月電子通商 113312|[資料/購入先](https://akizukidenshi.com/catalog/g/g113312/)|
|C4|100nF|GRM188R72A104KA35D|配置済み|実装|秋月電子通商 114559|[資料/購入先](https://akizukidenshi.com/catalog/g/g114559/)|
|C5|100nF|GRM188R72A104KA35D|配置済み|実装|秋月電子通商 114559|[資料/購入先](https://akizukidenshi.com/catalog/g/g114559/)|
|C6|100nF|GRM188R72A104KA35D|配置済み|実装|秋月電子通商 114559|[資料/購入先](https://akizukidenshi.com/catalog/g/g114559/)|
|C7|100nF|GRM188R72A104KA35D|配置済み|実装|秋月電子通商 114559|[資料/購入先](https://akizukidenshi.com/catalog/g/g114559/)|
|C8|100nF|GRM188R72A104KA35D|配置済み|実装|秋月電子通商 114559|[資料/購入先](https://akizukidenshi.com/catalog/g/g114559/)|
|C9|100nF|GRM188R72A104KA35D|配置済み|実装|秋月電子通商 114559|[資料/購入先](https://akizukidenshi.com/catalog/g/g114559/)|
|C10|100nF|GRM188R72A104KA35D|配置済み|実装|秋月電子通商 114559|[資料/購入先](https://akizukidenshi.com/catalog/g/g114559/)|
|C11|1uF|GRM188B31H105KAAL|配置済み|実装|秋月電子通商 116994|[資料/購入先](https://akizukidenshi.com/catalog/g/g116994/)|
|C12|100nF|GRM188R72A104KA35D|配置済み|実装|秋月電子通商 114559|[資料/購入先](https://akizukidenshi.com/catalog/g/g114559/)|
|C13|10uF|GRM21BR71A106KE51|配置済み|実装|秋月電子通商 117593|[資料/購入先](https://akizukidenshi.com/catalog/g/g117593/)|
|C14|10uF|GRM21BR71A106KE51|配置済み|実装|秋月電子通商 117593|[資料/購入先](https://akizukidenshi.com/catalog/g/g117593/)|
|C15|330uF 6.3V|T520D337M006ATE015|要追加|実装|他社調達 |[資料/購入先](https://docs.rs-online.com/d8c4/0900766b81710abb.pdf)|
|C16|10uF|GRM21BR71A106KE51|要追加|実装|秋月電子通商 117593|[資料/購入先](https://akizukidenshi.com/catalog/g/g117593/)|
|C17|10uF|GRM21BR71A106KE51|要追加|実装|秋月電子通商 117593|[資料/購入先](https://akizukidenshi.com/catalog/g/g117593/)|
|C18|10uF|GRM21BR71A106KE51|要追加|実装|秋月電子通商 117593|[資料/購入先](https://akizukidenshi.com/catalog/g/g117593/)|
|C19|10uF|GRM21BR71A106KE51|要追加|実装|秋月電子通商 117593|[資料/購入先](https://akizukidenshi.com/catalog/g/g117593/)|
|C20|10uF|GRM21BR71A106KE51|要追加|実装|秋月電子通商 117593|[資料/購入先](https://akizukidenshi.com/catalog/g/g117593/)|
|C21|100nF|GRM188R72A104KA35D|要追加|実装|秋月電子通商 114559|[資料/購入先](https://akizukidenshi.com/catalog/g/g114559/)|
|C22|100nF|GRM188R72A104KA35D|要追加|実装|秋月電子通商 114559|[資料/購入先](https://akizukidenshi.com/catalog/g/g114559/)|
|C23|1uF|GRM188B31H105KAAL|要追加|実装|秋月電子通商 116994|[資料/購入先](https://akizukidenshi.com/catalog/g/g116994/)|
|C24|100nF|GRM188R72A104KA35D|要追加|実装|秋月電子通商 114559|[資料/購入先](https://akizukidenshi.com/catalog/g/g114559/)|
|C25|10uF|GRM21BR71A106KE51|要追加|実装|秋月電子通商 117593|[資料/購入先](https://akizukidenshi.com/catalog/g/g117593/)|
|C26|100nF|GRM188R72A104KA35D|要追加|実装|秋月電子通商 114559|[資料/購入先](https://akizukidenshi.com/catalog/g/g114559/)|
|C27|100nF|GRM188R72A104KA35D|要追加|実装|秋月電子通商 114559|[資料/購入先](https://akizukidenshi.com/catalog/g/g114559/)|
|C28|100nF|GRM188R72A104KA35D|要追加|実装|秋月電子通商 114559|[資料/購入先](https://akizukidenshi.com/catalog/g/g114559/)|
|C29|100nF|GRM188R72A104KA35D|要追加|実装|秋月電子通商 114559|[資料/購入先](https://akizukidenshi.com/catalog/g/g114559/)|
|D1|GREEN 0805|OSG80805C1C|配置済み|実装|秋月電子通商 106421|[資料/購入先](https://akizukidenshi.com/catalog/g/g106421/)|
|D2|GREEN 0805|OSG80805C1C|配置済み|実装|秋月電子通商 106421|[資料/購入先](https://akizukidenshi.com/catalog/g/g106421/)|
|D3|GREEN 0805|OSG80805C1C|配置済み|実装|秋月電子通商 106421|[資料/購入先](https://akizukidenshi.com/catalog/g/g106421/)|
|D4|GREEN 0805|OSG80805C1C|配置済み|実装|秋月電子通商 106421|[資料/購入先](https://akizukidenshi.com/catalog/g/g106421/)|
|D5|GREEN 0805|OSG80805C1C|配置済み|実装|秋月電子通商 106421|[資料/購入先](https://akizukidenshi.com/catalog/g/g106421/)|
|D6|GREEN 0805|OSG80805C1C|配置済み|実装|秋月電子通商 106421|[資料/購入先](https://akizukidenshi.com/catalog/g/g106421/)|
|D7|GREEN 0805|OSG80805C1C|配置済み|実装|秋月電子通商 106421|[資料/購入先](https://akizukidenshi.com/catalog/g/g106421/)|
|D8|GREEN 0805|OSG80805C1C|配置済み|実装|秋月電子通商 106421|[資料/購入先](https://akizukidenshi.com/catalog/g/g106421/)|
|D9|PEC3824C2A-AU|PEC3824C2A-AU_R1_000A1|配置済み|実装|秋月電子通商 129497|[資料/購入先](https://akizukidenshi.com/catalog/g/g129497/)|
|D10|PEC3824C2A-AU|PEC3824C2A-AU_R1_000A1|配置済み|実装|秋月電子通商 129497|[資料/購入先](https://akizukidenshi.com/catalog/g/g129497/)|
|D11|RF ESD|PESD5V0F1BL-Q|配置済み|実装|他社調達 |[資料/購入先](https://www.nexperia.com/product/PESD5V0F1BL-Q)|
|D12|4.5V TVS|PESDHC2FD4V5B|要追加|実装|他社調達 |[資料/購入先](https://cdn.semikey.com/upload/pdfs/59/58/5958b6a05c58e8fad55bac421952aaf3.pdf)|
|J1|S-037-TGG|S-037-TGG|配置済み|実装|秋月電子通商 102569|[資料/購入先](https://akizukidenshi.com/catalog/g/g102569/)|
|J2|Digital/PWM|FH105-1x10SG|配置済み|実装|秋月電子通商 107199|[資料/購入先](https://akizukidenshi.com/catalog/g/g107199/)|
|J3|Power|FH105-1x8SG/RH|配置済み|実装|秋月電子通商 104046|[資料/購入先](https://akizukidenshi.com/catalog/g/g104046/)|
|J4|Analog|FH105-1x6SG/RH|配置済み|実装|秋月電子通商 104045|[資料/購入先](https://akizukidenshi.com/catalog/g/g104045/)|
|J5|Digital/PWM|FH105-1x8SG/RH|配置済み|実装|秋月電子通商 104046|[資料/購入先](https://akizukidenshi.com/catalog/g/g104046/)|
|J6|43045-0400|43045-0400|配置済み|実装|他社調達 |[資料/購入先](https://www.molex.com/en-us/products/part-detail/430450400)|
|J7|43045-0400|43045-0400|配置済み|実装|他社調達 |[資料/購入先](https://www.molex.com/en-us/products/part-detail/430450400)|
|J8|2452796-1|2452796-1|配置済み|実装|他社調達 |[資料/購入先](https://jp.rs-online.com/web/p/memory-card-connectors/2868822)|
|J9|47219-2001|47219-2001|配置済み|実装|他社調達 |[資料/購入先](https://www.molex.com/en-us/products/part-detail/472192001)|
|J10|LTE service 1x06|PH-1x6SG/RH|配置済み|実装|秋月電子通商 101669|[資料/購入先](https://akizukidenshi.com/catalog/g/g101669/)|
|J11|U.FL-R-SMT-1(10)|U.FL-R-SMT-1(10)|配置済み|実装|秋月電子通商 115417|[資料/購入先](https://akizukidenshi.com/catalog/g/g115417/)|
|L1|27nH|LQG15HS27NJ02D|配置済み|実装|他社調達 |[資料/購入先](https://www.murata.com/en-global/products/productdetail?partno=LQG15HS27NJ02%23)|
|L2|2.2uH|SRN6045TA-2R2Y|要追加|実装|他社調達 |[資料/購入先](https://www.bourns.com/docs/product-datasheets/srn6045ta.pdf)|
|Q1|2N7002|2N7002|配置済み|実装|秋月電子通商 103919|[資料/購入先](https://akizukidenshi.com/catalog/g/g103919/)|
|R1|1k|RK73B1JTTD102J|配置済み|実装|秋月電子通商 130351|[資料/購入先](https://akizukidenshi.com/catalog/g/g130351/)|
|R2|1k|RK73B1JTTD102J|配置済み|実装|秋月電子通商 130351|[資料/購入先](https://akizukidenshi.com/catalog/g/g130351/)|
|R3|1k|RK73B1JTTD102J|配置済み|実装|秋月電子通商 130351|[資料/購入先](https://akizukidenshi.com/catalog/g/g130351/)|
|R4|1k|RK73B1JTTD102J|配置済み|実装|秋月電子通商 130351|[資料/購入先](https://akizukidenshi.com/catalog/g/g130351/)|
|R5|10k|RK73B1JTTD103J|配置済み|実装|秋月電子通商 130355|[資料/購入先](https://akizukidenshi.com/catalog/g/g130355/)|
|R6|1k|RK73B1JTTD102J|配置済み|実装|秋月電子通商 130351|[資料/購入先](https://akizukidenshi.com/catalog/g/g130351/)|
|R7|27R 1W|CRCW251227R0JNEG|配置済み|実装|他社調達 |[資料/購入先](https://www.vishay.com/docs/20035/dcrcwe3.pdf)|
|R8|1k|RK73B1JTTD102J|配置済み|実装|秋月電子通商 130351|[資料/購入先](https://akizukidenshi.com/catalog/g/g130351/)|
|R9|1k|RK73B1JTTD102J|配置済み|実装|秋月電子通商 130351|[資料/購入先](https://akizukidenshi.com/catalog/g/g130351/)|
|R10|10k|RK73B1JTTD103J|配置済み|DNP|秋月電子通商 130355|[資料/購入先](https://akizukidenshi.com/catalog/g/g130355/)|
|R11|1k|RK73B1JTTD102J|配置済み|実装|秋月電子通商 130351|[資料/購入先](https://akizukidenshi.com/catalog/g/g130351/)|
|R12|10k|RK73B1JTTD103J|配置済み|実装|秋月電子通商 130355|[資料/購入先](https://akizukidenshi.com/catalog/g/g130355/)|
|R13|120|RC0603J120R|配置済み|DNP|秋月電子通商 130332|[資料/購入先](https://akizukidenshi.com/catalog/g/g130332/)|
|R14|120|RC0603J120R|配置済み|DNP|秋月電子通商 130332|[資料/購入先](https://akizukidenshi.com/catalog/g/g130332/)|
|R15|4.7k|RK73B1JTTD472J|配置済み|実装|秋月電子通商 130353|[資料/購入先](https://akizukidenshi.com/catalog/g/g130353/)|
|R16|4.7k|RK73B1JTTD472J|配置済み|実装|秋月電子通商 130353|[資料/購入先](https://akizukidenshi.com/catalog/g/g130353/)|
|R17|10k|RK73B1JTTD103J|配置済み|実装|秋月電子通商 130355|[資料/購入先](https://akizukidenshi.com/catalog/g/g130355/)|
|R18|47k|RC0603J47K|配置済み|実装|秋月電子通商 129458|[資料/購入先](https://akizukidenshi.com/catalog/g/g129458/)|
|R19|47k|RC0603J47K|配置済み|実装|秋月電子通商 129458|[資料/購入先](https://akizukidenshi.com/catalog/g/g129458/)|
|R20|47k|RC0603J47K|配置済み|実装|秋月電子通商 129458|[資料/購入先](https://akizukidenshi.com/catalog/g/g129458/)|
|R21|374k 1%|RC0603FR-07374KL|要追加|実装|他社調達 |[資料/購入先](https://www.yageo.com/upload/media/product/productsearch/datasheet/rchip/pyu-rc-group_51_rohs_l.pdf)|
|R22|100k 0.1%|RG2012N-104-B-T5|要追加|実装|秋月電子通商 111798|[資料/購入先](https://akizukidenshi.com/catalog/g/g111798/)|
|R23|100k|RK73B1JTTD104J|要追加|実装|秋月電子通商 130357|[資料/購入先](https://akizukidenshi.com/catalog/g/g130357/)|
|R24|100k|RK73B1JTTD104J|要追加|実装|秋月電子通商 130357|[資料/購入先](https://akizukidenshi.com/catalog/g/g130357/)|
|R25|1k|RK73B1JTTD102J|要追加|実装|秋月電子通商 130351|[資料/購入先](https://akizukidenshi.com/catalog/g/g130351/)|
|R26|47k|RC0603J47K|要追加|実装|秋月電子通商 129458|[資料/購入先](https://akizukidenshi.com/catalog/g/g129458/)|
|R27|47k|RC0603J47K|要追加|実装|秋月電子通商 129458|[資料/購入先](https://akizukidenshi.com/catalog/g/g129458/)|
|R28|22R|RK73B1JTTD220J|要追加|実装|秋月電子通商 130343|[資料/購入先](https://akizukidenshi.com/catalog/g/g130343/)|
|R29|22R|RK73B1JTTD220J|要追加|実装|秋月電子通商 130343|[資料/購入先](https://akizukidenshi.com/catalog/g/g130343/)|
|R30|22R|RK73B1JTTD220J|要追加|実装|秋月電子通商 130343|[資料/購入先](https://akizukidenshi.com/catalog/g/g130343/)|
|R31|0R|RK73Z1JTTD|要追加|実装|秋月電子通商 111619|[資料/購入先](https://akizukidenshi.com/catalog/g/g111619/)|
|U1|TC74HC595AF|TC74HC595AF|配置済み|実装|秋月電子通商 110077|[資料/購入先](https://akizukidenshi.com/catalog/g/g110077/)|
|U2|MAX-M10M-00B|MAX-M10M-00B|配置済み|実装|秋月電子通商 131778|[資料/購入先](https://akizukidenshi.com/catalog/g/g131778/)|
|U3|BNO055_module|AE-BNO055-BO|配置済み|実装|秋月電子通商 116996|[資料/購入先](https://akizukidenshi.com/catalog/g/g116996/)|
|U4|ATA6561-GAQW|ATA6561-GAQW-N|配置済み|実装|秋月電子通商 130008|[資料/購入先](https://akizukidenshi.com/catalog/g/g130008/)|
|U5|MCP25625-E/SS|MCP25625T-E/SS|配置済み|実装|秋月電子通商 112663|[資料/購入先](https://akizukidenshi.com/catalog/g/g112663/)|
|U6|SIM7070G|SIM7070G|配置済み|実装|他社調達 |[資料/購入先](https://en.simcom.com/product/SIM7070G.html)|
|U7|TXU0204PWR|TXU0204PWR|配置済み|実装|他社調達 |[資料/購入先](https://www.ti.com/product/TXU0204)|
|U8|AP63301WU-7|AP63301WU-7|配置済み|実装|DigiKey 31-AP63301WU-7CT-ND|[資料/購入先](https://www.digikey.jp/ja/products/detail/diodes-incorporated/AP63301WU-7/10491607)|
|U9|USBLC6-4SC6|USBLC6-4SC6|配置済み|実装|他社調達 |[資料/購入先](https://www.st.com/en/protection-devices/usblc6-4.html)|
|U10|USBLC6-4SC6|USBLC6-4SC6|配置済み|実装|他社調達 |[資料/購入先](https://www.st.com/en/protection-devices/usblc6-4.html)|
|Y1|20MHz CL10pF|20M10PB/XT324-10/80|配置済み|実装|秋月電子通商 130244|[資料/購入先](https://akizukidenshi.com/catalog/g/g130244/)|

以下はプロジェクト同梱ライブラリを使う指定。`${KIPRJMOD}`は `logger_v2` フォルダー。`sym-lib-table`・`fp-lib-table`と各 `.kicad_sym`・`.pretty`・`3dmodels`をセットで引き継ぐ。部品型番だけから汎用フットプリントを再選択すると、ピン番号・ランド・3Dが同じになる保証はない。TEスロットはメーカーSTEP、AP63301は汎用TSOT公称モデルなど、モデルの精度区分は既存選定記録に従う。

|番号|シンボルID|フットプリントID|3Dモデル|
|---|---|---|---|
|C1|Device:C_Small|logger_v2_custom:C_0603_1608Metric|${KIPRJMOD}/3dmodels/C_0603_1608Metric.step|
|C2|Device:C_Small|logger_v2_custom:C_0603_1608Metric|${KIPRJMOD}/3dmodels/C_0603_1608Metric.step|
|C3|Device:C_Small|logger_v2_custom:C_0603_1608Metric|${KIPRJMOD}/3dmodels/C_0603_1608Metric.step|
|C4|Device:C_Small|logger_v2_custom:C_0603_1608Metric|${KIPRJMOD}/3dmodels/C_0603_1608Metric.step|
|C5|Device:C_Small|logger_v2_custom:C_0603_1608Metric|${KIPRJMOD}/3dmodels/C_0603_1608Metric.step|
|C6|Device:C_Small|logger_v2_custom:C_0603_1608Metric|${KIPRJMOD}/3dmodels/C_0603_1608Metric.step|
|C7|Device:C_Small|logger_v2_custom:C_0603_1608Metric|${KIPRJMOD}/3dmodels/C_0603_1608Metric.step|
|C8|Device:C_Small|logger_v2_custom:C_0603_1608Metric|${KIPRJMOD}/3dmodels/C_0603_1608Metric.step|
|C9|Device:C_Small|logger_v2_custom:C_0603_1608Metric|${KIPRJMOD}/3dmodels/C_0603_1608Metric.step|
|C10|Device:C_Small|logger_v2_custom:C_0603_1608Metric|${KIPRJMOD}/3dmodels/C_0603_1608Metric.step|
|C11|Device:C_Small|logger_v2_custom:C_0603_1608Metric|${KIPRJMOD}/3dmodels/C_0603_1608Metric.step|
|C12|Device:C_Small|logger_v2_custom:C_0603_1608Metric|${KIPRJMOD}/3dmodels/C_0603_1608Metric.step|
|C13|Device:C_Small|logger_v2_custom:C_0805_2012Metric|${KIPRJMOD}/3dmodels/C_0805_2012Metric.step|
|C14|Device:C_Small|logger_v2_custom:C_0805_2012Metric|${KIPRJMOD}/3dmodels/C_0805_2012Metric.step|
|C15|logger_v2_expansion:T520D337M006ATE015|logger_v2_expansion:CP_EIA-7343-31_Kemet-D|${KIPRJMOD}/3dmodels/CP_EIA-7343-31_Kemet-D.step|
|C16|logger_v2_expansion:GRM21BR71A106KE51|logger_v2_expansion:C_0805_2012Metric|${KIPRJMOD}/3dmodels/C_0805_2012Metric.step|
|C17|logger_v2_expansion:GRM21BR71A106KE51|logger_v2_expansion:C_0805_2012Metric|${KIPRJMOD}/3dmodels/C_0805_2012Metric.step|
|C18|logger_v2_expansion:GRM21BR71A106KE51|logger_v2_expansion:C_0805_2012Metric|${KIPRJMOD}/3dmodels/C_0805_2012Metric.step|
|C19|logger_v2_expansion:GRM21BR71A106KE51|logger_v2_expansion:C_0805_2012Metric|${KIPRJMOD}/3dmodels/C_0805_2012Metric.step|
|C20|logger_v2_expansion:GRM21BR71A106KE51|logger_v2_expansion:C_0805_2012Metric|${KIPRJMOD}/3dmodels/C_0805_2012Metric.step|
|C21|logger_v2_expansion:GRM188R72A104KA35D|logger_v2_expansion:C_0603_1608Metric|${KIPRJMOD}/3dmodels/C_0603_1608Metric.step|
|C22|logger_v2_expansion:GRM188R72A104KA35D|logger_v2_expansion:C_0603_1608Metric|${KIPRJMOD}/3dmodels/C_0603_1608Metric.step|
|C23|logger_v2_expansion:GRM188B31H105KAAL|logger_v2_expansion:C_0603_1608Metric|${KIPRJMOD}/3dmodels/C_0603_1608Metric.step|
|C24|logger_v2_expansion:GRM188R72A104KA35D|logger_v2_expansion:C_0603_1608Metric|${KIPRJMOD}/3dmodels/C_0603_1608Metric.step|
|C25|logger_v2_expansion:GRM21BR71A106KE51|logger_v2_expansion:C_0805_2012Metric|${KIPRJMOD}/3dmodels/C_0805_2012Metric.step|
|C26|logger_v2_expansion:GRM188R72A104KA35D|logger_v2_expansion:C_0603_1608Metric|${KIPRJMOD}/3dmodels/C_0603_1608Metric.step|
|C27|logger_v2_expansion:GRM188R72A104KA35D|logger_v2_expansion:C_0603_1608Metric|${KIPRJMOD}/3dmodels/C_0603_1608Metric.step|
|C28|logger_v2_expansion:GRM188R72A104KA35D|logger_v2_expansion:C_0603_1608Metric|${KIPRJMOD}/3dmodels/C_0603_1608Metric.step|
|C29|logger_v2_expansion:GRM188R72A104KA35D|logger_v2_expansion:C_0603_1608Metric|${KIPRJMOD}/3dmodels/C_0603_1608Metric.step|
|D1|Device:LED_Small_Filled|logger_v2_custom:LED_0805_2012Metric_ShieldSilk|${KIPRJMOD}/3dmodels/LED_0805_2012Metric.step|
|D2|Device:LED_Small_Filled|logger_v2_custom:LED_0805_2012Metric_ShieldSilk|${KIPRJMOD}/3dmodels/LED_0805_2012Metric.step|
|D3|Device:LED_Small_Filled|logger_v2_custom:LED_0805_2012Metric_ShieldSilk|${KIPRJMOD}/3dmodels/LED_0805_2012Metric.step|
|D4|Device:LED_Small_Filled|logger_v2_custom:LED_0805_2012Metric_ShieldSilk|${KIPRJMOD}/3dmodels/LED_0805_2012Metric.step|
|D5|Device:LED_Small_Filled|logger_v2_custom:LED_0805_2012Metric_ShieldSilk|${KIPRJMOD}/3dmodels/LED_0805_2012Metric.step|
|D6|Device:LED_Small_Filled|logger_v2_custom:LED_0805_2012Metric_ShieldSilk|${KIPRJMOD}/3dmodels/LED_0805_2012Metric.step|
|D7|Device:LED_Small_Filled|logger_v2_custom:LED_0805_2012Metric_ShieldSilk|${KIPRJMOD}/3dmodels/LED_0805_2012Metric.step|
|D8|Device:LED_Small_Filled|logger_v2_custom:LED_0805_2012Metric_ShieldSilk|${KIPRJMOD}/3dmodels/LED_0805_2012Metric.step|
|D9|logger_v1_custom:PEC3824C2A-AU|logger_v2_custom:SOT-23|${KIPRJMOD}/3dmodels/SOT-23.step|
|D10|logger_v1_custom:PEC3824C2A-AU|logger_v2_custom:SOT-23|${KIPRJMOD}/3dmodels/SOT-23.step|
|D11|Device:D_TVS_Small|logger_v2_custom:D_SOD-882|${KIPRJMOD}/3dmodels/D_SOD-882.step|
|D12|logger_v2_expansion:PESDHC2FD4V5B|logger_v2_expansion:Prisemi_DFN1006_2L|${KIPRJMOD}/3dmodels/D_SOD-882.step|
|J1|Connector:Conn_Coaxial|logger_v2_custom:SMA_S-037-TGG_Horizontal|${KIPRJMOD}/3dmodels/COSMTEC_S-037-TGG_mechanical.step|
|J2|Connector_Generic:Conn_01x10|logger_v2_custom:PinSocket_1x10_P2.54mm_Vertical|${KIPRJMOD}/3dmodels/PinSocket_1x10_P2.54mm_Vertical.step|
|J3|Connector_Generic:Conn_01x08|logger_v2_custom:PinSocket_1x08_P2.54mm_Vertical|${KIPRJMOD}/3dmodels/PinSocket_1x08_P2.54mm_Vertical.step|
|J4|Connector_Generic:Conn_01x06|logger_v2_custom:PinSocket_1x06_P2.54mm_Vertical|${KIPRJMOD}/3dmodels/PinSocket_1x06_P2.54mm_Vertical.step|
|J5|Connector_Generic:Conn_01x08|logger_v2_custom:PinSocket_1x08_P2.54mm_Vertical_ShieldSilk|${KIPRJMOD}/3dmodels/PinSocket_1x08_P2.54mm_Vertical.step|
|J6|Connector_Generic:Conn_01x04|logger_v2_custom:Molex_Micro-Fit_3.0_43045-0400_2x02_P3.00mm_Horizontal|${KIPRJMOD}/3dmodels/Molex_43045-0402_same_geometry_as_0400.step|
|J7|Connector_Generic:Conn_01x04|logger_v2_custom:Molex_Micro-Fit_3.0_43045-0400_2x02_P3.00mm_Horizontal|${KIPRJMOD}/3dmodels/Molex_43045-0402_same_geometry_as_0400.step|
|J8|logger_v2_expansion:TE_2452796-1|logger_v2_expansion:nanoSIM_TE_2452796-1_Hinge|${KIPRJMOD}/3dmodels/TE_2452796-1.step|
|J9|logger_v2_expansion:Micro_SD_Card_Molex_47219-2001|logger_v2_expansion:Molex_47219-2001|${KIPRJMOD}/3dmodels/Molex_47219-2001.step|
|J10|logger_v2_expansion:Conn_01x06|logger_v2_expansion:PinHeader_1x06_P2.54mm_Vertical|${KIPRJMOD}/3dmodels/PinHeader_1x06_P2.54mm_Vertical.step|
|J11|logger_v2_expansion:Conn_Coaxial|logger_v2_expansion:U.FL_Hirose_U.FL-R-SMT-1_Vertical|${KIPRJMOD}/3dmodels/U.FL_Hirose_U.FL-R-SMT-1_Vertical.step|
|L1|Device:L_Small|logger_v2_custom:L_0402_1005Metric|${KIPRJMOD}/3dmodels/L_0402_1005Metric.step|
|L2|logger_v2_expansion:SRN6045TA-2R2Y|logger_v2_expansion:L_Bourns_SRN6045TA|${KIPRJMOD}/3dmodels/L_Bourns_SRN6045TA.step|
|Q1|logger_v2_expansion:2N7002|logger_v2_expansion:SOT-23|${KIPRJMOD}/3dmodels/SOT-23.step|
|R1|Device:R_Small_US|logger_v2_custom:R_0603_1608Metric|${KIPRJMOD}/3dmodels/R_0603_1608Metric.step|
|R2|Device:R_Small_US|logger_v2_custom:R_0603_1608Metric|${KIPRJMOD}/3dmodels/R_0603_1608Metric.step|
|R3|Device:R_Small_US|logger_v2_custom:R_0603_1608Metric|${KIPRJMOD}/3dmodels/R_0603_1608Metric.step|
|R4|Device:R_Small_US|logger_v2_custom:R_0603_1608Metric|${KIPRJMOD}/3dmodels/R_0603_1608Metric.step|
|R5|Device:R_Small_US|logger_v2_custom:R_0603_1608Metric|${KIPRJMOD}/3dmodels/R_0603_1608Metric.step|
|R6|Device:R_Small_US|logger_v2_custom:R_0603_1608Metric|${KIPRJMOD}/3dmodels/R_0603_1608Metric.step|
|R7|Device:R_Small_US|logger_v2_custom:R_2512_6332Metric|${KIPRJMOD}/3dmodels/R_2512_6332Metric.step|
|R8|Device:R_Small_US|logger_v2_custom:R_0603_1608Metric|${KIPRJMOD}/3dmodels/R_0603_1608Metric.step|
|R9|Device:R_Small_US|logger_v2_custom:R_0603_1608Metric|${KIPRJMOD}/3dmodels/R_0603_1608Metric.step|
|R10|Device:R_Small_US|logger_v2_custom:R_0603_1608Metric|${KIPRJMOD}/3dmodels/R_0603_1608Metric.step|
|R11|Device:R_Small_US|logger_v2_custom:R_0603_1608Metric|${KIPRJMOD}/3dmodels/R_0603_1608Metric.step|
|R12|Device:R_Small_US|logger_v2_custom:R_0603_1608Metric|${KIPRJMOD}/3dmodels/R_0603_1608Metric.step|
|R13|Device:R_Small_US|logger_v2_custom:R_0603_1608Metric|${KIPRJMOD}/3dmodels/R_0603_1608Metric.step|
|R14|Device:R_Small_US|logger_v2_custom:R_0603_1608Metric|${KIPRJMOD}/3dmodels/R_0603_1608Metric.step|
|R15|Device:R_Small_US|logger_v2_custom:R_0603_1608Metric|${KIPRJMOD}/3dmodels/R_0603_1608Metric.step|
|R16|Device:R_Small_US|logger_v2_custom:R_0603_1608Metric|${KIPRJMOD}/3dmodels/R_0603_1608Metric.step|
|R17|Device:R_Small_US|logger_v2_custom:R_0603_1608Metric|${KIPRJMOD}/3dmodels/R_0603_1608Metric.step|
|R18|Device:R_Small_US|logger_v2_custom:R_0603_1608Metric|${KIPRJMOD}/3dmodels/R_0603_1608Metric.step|
|R19|Device:R_Small_US|logger_v2_custom:R_0603_1608Metric|${KIPRJMOD}/3dmodels/R_0603_1608Metric.step|
|R20|Device:R_Small_US|logger_v2_custom:R_0603_1608Metric|${KIPRJMOD}/3dmodels/R_0603_1608Metric.step|
|R21|logger_v2_expansion:RC0603FR-07374KL|logger_v2_expansion:R_0603_1608Metric|${KIPRJMOD}/3dmodels/R_0603_1608Metric.step|
|R22|logger_v2_expansion:RG2012N-104-B-T5|logger_v2_expansion:R_0805_2012Metric|${KIPRJMOD}/3dmodels/R_0805_2012Metric.step|
|R23|logger_v2_expansion:RK73B1JTTD104J|logger_v2_expansion:R_0603_1608Metric|${KIPRJMOD}/3dmodels/R_0603_1608Metric.step|
|R24|logger_v2_expansion:RK73B1JTTD104J|logger_v2_expansion:R_0603_1608Metric|${KIPRJMOD}/3dmodels/R_0603_1608Metric.step|
|R25|logger_v2_expansion:RK73B1JTTD102J|logger_v2_expansion:R_0603_1608Metric|${KIPRJMOD}/3dmodels/R_0603_1608Metric.step|
|R26|logger_v2_expansion:RC0603J47K|logger_v2_expansion:R_0603_1608Metric|${KIPRJMOD}/3dmodels/R_0603_1608Metric.step|
|R27|logger_v2_expansion:RC0603J47K|logger_v2_expansion:R_0603_1608Metric|${KIPRJMOD}/3dmodels/R_0603_1608Metric.step|
|R28|logger_v2_expansion:RK73B1JTTD220J|logger_v2_expansion:R_0603_1608Metric|${KIPRJMOD}/3dmodels/R_0603_1608Metric.step|
|R29|logger_v2_expansion:RK73B1JTTD220J|logger_v2_expansion:R_0603_1608Metric|${KIPRJMOD}/3dmodels/R_0603_1608Metric.step|
|R30|logger_v2_expansion:RK73B1JTTD220J|logger_v2_expansion:R_0603_1608Metric|${KIPRJMOD}/3dmodels/R_0603_1608Metric.step|
|R31|logger_v2_expansion:RK73Z1JTTD|logger_v2_expansion:R_0603_1608Metric|${KIPRJMOD}/3dmodels/R_0603_1608Metric.step|
|U1|logger_v2_custom:TC74HC595AF|logger_v2_custom:Toshiba_SOP16_P300_1.27A|${KIPRJMOD}/3dmodels/TC74HC595AF_nominal.step|
|U2|logger_v2_custom:MAX-M10M-00B|logger_v2_custom:MAX_M10M_00B_LCC18|${KIPRJMOD}/3dmodels/u-blox_MAX-M10M-00B.step|
|U3|mimi88_symbols:BNO055_module|logger_v2_custom:AE_BNO055_BO_ShieldSilk|${KIPRJMOD}/3dmodels/Akizuki_AE-BNO055-BO_mechanical.step|
|U4|logger_v1_custom:ATA6561-GAQW-N|logger_v2_custom:SOIC-8_3.9x4.9mm_P1.27mm|${KIPRJMOD}/3dmodels/SOIC-8_3.9x4.9mm_P1.27mm.step|
|U5|Interface_CAN_LIN:MCP25625x-x-SS|logger_v2_custom:SSOP-28_5.3x10.2mm_P0.65mm|${KIPRJMOD}/3dmodels/SSOP-28_5.3x10.2mm_P0.65mm.step|
|U6|logger_v2_expansion:SIM7070G|logger_v2_expansion:SIMCom_SIM7070G_LCC68_24x24mm_P1mm|${KIPRJMOD}/3dmodels/SIMCom_SIM7070G_mechanical.step|
|U7|logger_v2_expansion:TXU0204PWR|logger_v2_expansion:TSSOP-14_4.4x5mm_P0.65mm|${KIPRJMOD}/3dmodels/TSSOP-14_4.4x5mm_P0.65mm.step|
|U8|logger_v2_expansion:AP63301WU-7|logger_v2_expansion:Diodes_TSOT26|${KIPRJMOD}/3dmodels/TSOT-23-6.step|
|U9|logger_v2_expansion:USBLC6-4SC6|logger_v2_expansion:SOT-23-6|${KIPRJMOD}/3dmodels/SOT-23-6.step|
|U10|logger_v2_expansion:USBLC6-4SC6|logger_v2_expansion:SOT-23-6|${KIPRJMOD}/3dmodels/SOT-23-6.step|
|Y1|Device:Crystal_GND24|logger_v2_custom:Crystal_SMD_3225-4Pin_3.2x2.5mm|${KIPRJMOD}/3dmodels/Crystal_SMD_3225-4Pin_3.2x2.5mm.step|

## 15. 再作成時の照合手順と一次資料

1. 第14節の97個を配置し、既存59個と主要10個は現在のメインから維持する。追加28個を補い、U?/J?/Q?を第10節で採番する。R10/R13/R14の3個のみDNPとする。
2. 第11節の旧接続を外し、第13節の全ネットを接続。別ファイルの主要10個は実装対象へ二重に持ち込まない。
3. 各部品について全ピンが第13節の1ネットまたはNCに一致すること、シンボル番号とフットプリント番号が一致することを確認する。3D表示で向き・ピン1・モデル欠落を確認する。
4. ERCでは重複番号、未配線、STATUS_LATCH切断、未登録ライブラリを解消する。電源フラグやNo Connectで誤配線を隠さない。電源出力への逆給電、UART両方向、SPI共有時のCSとMISOを確認する。
5. PCB更新・配線・電源応答測定・通信同時動作は別工程。現在のPCBはこの完成形を反映したものではない。

|資料|参照箇所・本書との関係|
|---|---|
|[AP63300/AP63301 DS42002 Rev3-2](https://www.diodes.com/assets/Datasheets/AP63300-AP63301.pdf)、保存 `output/AP63300_AP63301.pdf`|p3ピン、p6定格、p17–18外付け部品、p21パッケージ。U8/C29/L2/R21/R22|
|`refs/SIM7070_hardware.pdf`、SIM7070 Series Hardware Design V1.03|p12–17端子、p21–25電源・起動停止、p26 UART、p30–32 SIM。U6・SIM信号・未使用端子|
|[TXU0204](https://www.ti.com/lit/ds/symlink/txu0204.pdf)、保存 `refs/TXU0204.pdf` SCES936A|p4 PW14ピン、p20–21 OEと電源断機能。U7はPW/TSSOP14であり12ピン品の番号を使わない|
|[USBLC6-4](https://www.st.com/resource/en/datasheet/usblc6-4.pdf)、DocID11068 Rev7|p1内部結線・ピン、p2定格、p4–7レール接続とバイパス・ESD帰路。U9/U10|
|`refs/MAX-M10M-00B.pdf` UBX-22028884 R04、`refs/MAX-M10M_IntegrationManual.pdf`|データシートp9端子・p10状態・p11–12電源。Integration Manualのアンテナ給電例。U2、R7/L1/C1/D11|
|`refs/JCA002.pdf`、[秋月112223](https://akizukidenshi.com/catalog/g/g112223/)|指定アンテナの電圧・電流条件|
|`refs/AE-BNO055-BO.pdf` Ver.2022-4-13|p1端子・回路、p2ジャンパ。裸BNO055のピン番号ではなく8ピンモジュール側番号を使用|
|`refs/TE_2452796_RevC.pdf`、[TE 2452796-1](https://www.te.com/en/product-2452796-1.html)|接点番号とカード検出・固定ランド。接点C番号と部品ピン番号を混同しない|
|[Molex 47219-2001](https://www.molex.com/en-us/products/part-detail/472192001)|V1から移植済みの8接点＋シールド。独立した検出接点を仮定しない|
|`refs/UNO_Q_pinout.pdf`、`refs/UNO_Q_overlay.txt`、`refs/UNO_Q_pinmux.dtsi`|シールド物理端子とSTM32機能の対応。第2・12節|
|[MCP25625](https://www.microchip.com/en-us/product/MCP25625)、[ATA6561](https://www.microchip.com/en-us/product/ATA6561)|U5のSSOP28、U4のSOIC8端子、電源、スタンバイ、未使用RTS設定|
|`refs/TC74HC595AP_datasheet_ja_20140301.pdf`|U1はAFパッケージの寸法図と同じ論理ピン表を使用。LEDは8出力|

SIMCom資料p15の汎用ピン説明にはカード種別による電圧との記載があるが、具体的なSIM仕様である§3.6/p31は1.8V SIMのみ・3V SIM非対応と明記している。本設計は後者に従い1.8V対応SIMを使用する。SIM_VDDとVDD_EXTは同じ公称電圧でも別出力なので短絡しない。

## 16. 更新時点の現状記録（完成形と混同しない）

この節は2026-09-22にディスク上のファイルを読んだ記録。メイン69部品、別ファイル10部品。未採番部品はネットリスト出力で省略されるため、配置・用途をUUIDで記録した。28周辺部品は現在存在しないので、この節の配置表には含めない。現在の状態を再現する場合、未採番主要部品はSIM7070GのGND端子（2/17/18/29/39/45/46/54/58/59/61/62/63/64/65）のGND接続のみ反映し、GNSS UARTなど次表の旧接続を保持する。完成形を描く場合は第13節を使う。

### 16.1 メインシートの現在位置と識別

座標はKiCadのmm、角度は度。完成形番号は文書上の対応で、元ファイルの採番を変更していない。

|現状番号|完成形番号|値|現在座標x,y,角度|UUID|
|---|---|---|---|---|
|J3|J3|Power|39.37, 39.37, 0|00000000-0000-0000-0000-000056d71773|
|J2|J2|Digital/PWM|57.15, 36.83, 0|00000000-0000-0000-0000-000056d72368|
|J4|J4|Analog|39.37, 64.77, 0|00000000-0000-0000-0000-000056d72f1c|
|J5|J5|Digital/PWM|57.15, 67.31, 0|00000000-0000-0000-0000-000056d734d0|
|C5|C5|100nF|373.38, 41.91, 0|08946aef-bfd4-4942-9913-12158968a225|
|R1|R1|1k|248.92, 27.94, 90|0a0c1fc8-031a-4ce1-b767-9bb91542d41d|
|R20|R20|47k|218.44, 45.72, 0|0cdedeb4-35a5-4b0c-a354-90530e6da296|
|D3|D3|GREEN 0805|254, 33.02, 0|1422c59e-5c24-4877-8a70-361c29ed9010|
|U5|U5|MCP25625-E/SS|114.3, 127, 0|142b6551-1f8d-42ac-af89-2b8e3e594b4d|
|J7|J7|43045-0400|196.85, 69.85, 0|1dfdcb4f-36c3-41f6-abed-6b0b360da062|
|R10|R10|10k|142.24, 45.72, 0|1fdb5414-cb36-4969-8c4a-df3e2c60f952|
|R9|R9|1k|248.92, 43.18, 90|204544c5-fe3c-4357-9b7a-ee44c5c4a852|
|L1|L1|27nH|156.21, 35.56, 0|2354b397-0633-437e-976d-984f50a20650|
|U3|U3|BNO055_module|35.56, 101.6, 0|23a3722c-f554-4e89-8e95-ac824bf55857|
|D1|D1|GREEN 0805|254, 27.94, 0|276f0ae8-89dc-4c97-a155-3c8ecc7d7a2c|
|D2|D2|GREEN 0805|254, 30.48, 0|2c7ee370-6a8f-4b0c-bca0-d3eb89e1bc00|
|R11|R11|1k|248.92, 45.72, 90|2cc477df-8d60-435a-8edf-c7b006f94738|
|J?|J8|2452796-1|191.77, 193.04, 0|2fc22c57-8968-4772-879d-3f5c1a758ce8|
|J1|J1|S-037-TGG|177.8, 33.02, 0|305a4727-c3a1-44f0-bd1b-20b98ee32d69|
|U2|U2|MAX-M10M-00B|121.92, 38.1, 0|333ae50b-b2b7-43c8-8956-5a75da24889b|
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
|C13|C13|10uF|300.99, 41.91, 0|f3afdbb8-6581-4874-be6e-77af6da6f756|
|C9|C9|100nF|382.27, 41.91, 0|f76b56bc-d5f0-4e5e-9358-2b7b207f3ebc|

### 16.2 現在の配線済み部分のネット

`unconnected-...`は現状の未接続を表す。第13節のNC指定とは異なる。STATUS_LATCHはヘッダーだけで、U1.12へは現在つながっていない。電源シンボル自体の参照番号は省略。

|現在のネット名（未接続も含む）|現在の端子|
|---|---|
|+3V3|C10.1, C11.1, C12.1, C13.1, C14.1, C4.1, C6.1, C7.1, C8.1, J3.4, R12.1, R15.2, R16.2, R17.1, R5.1, R7.1, U1.10, U1.16, U2.6, U2.7, U2.8, U3.1, U4.1, U4.5, U5.1, U5.19|
|+5V|C5.1, C9.1, J3.5, J6.1, U4.3, U5.27|
|/CAN1_RXD|J5.3, U4.4|
|/CAN2_CS_N|J2.8, R12.2, U5.17|
|/CAN2_INT_N|J2.9, U5.13|
|/CAN2_RESET_N|J2.10, R17.2, U5.18|
|/GNSS_PPS|J5.2, U2.4|
|/GNSS_RESET_N|J5.5, R5.2, U2.9|
|/GNSS_RXD|J5.7, U2.3|
|/GNSS_TXD|J5.8, U2.2|
|/IMU_RESET_N|J5.6, U3.5|
|/IMU_SCL|J2.1, R15.1, U3.4|
|/IMU_SDA|J2.2, R16.1, U3.3|
|/SPI2_MISO|J2.6, U5.16|
|/SPI2_MOSI|J2.7, R18.1, U1.14, U5.15|
|/SPI2_SCK|J2.5, R19.1, U1.11, U5.14|
|/STATUS_LATCH|J5.1|
|GND|C1.2, C10.2, C11.2, C12.2, C13.2, C14.2, C2.2, C3.2, C4.2, C5.2, C6.2, C7.2, C8.2, C9.2, D1.1, D10.3, D11.1, D2.1, D3.1, D4.1, D5.1, D6.1, D7.1, D8.1, D9.3, J1.2, J2.4, J3.6, J3.7, J6.4, J7.4, R10.2, R18.2, R19.2, R20.2, U1.13, U1.8, U2.1, U2.10, U2.12, U3.2, U3.7, U4.2, U4.8, U5.10, U5.26, U5.5, Y1.2, Y1.4|
|Net-(C1-Pad1)|C1.1, L1.2, R7.2|
|Net-(D1-A)|D1.2, R1.2|
|Net-(D2-A)|D2.2, R2.2|
|Net-(D3-A)|D3.2, R3.2|
|Net-(D4-A)|D4.2, R4.2|
|Net-(D5-A)|D5.2, R6.2|
|Net-(D6-A)|D6.2, R8.2|
|Net-(D7-A)|D7.2, R9.2|
|Net-(D8-A)|D8.2, R11.2|
|Net-(D9-LINE1)|D9.1, J6.2, R13.2, U5.4|
|Net-(D9-LINE2)|D9.2, J6.3, R13.1, U5.3|
|Net-(D10-LINE1)|D10.1, J7.2, R14.2, U4.7|
|Net-(D10-LINE2)|D10.2, J7.3, R14.1, U4.6|
|Net-(D11-A2)|D11.2, J1.1, L1.1, U2.11|
|Net-(U1-QA)|R1.1, U1.15|
|Net-(U1-QB)|R2.1, U1.1|
|Net-(U1-QC)|R3.1, U1.2|
|Net-(U1-QD)|R4.1, U1.3|
|Net-(U1-QE)|R6.1, U1.4|
|Net-(U1-QF)|R8.1, U1.5|
|Net-(U1-QG)|R9.1, U1.6|
|Net-(U1-QH)|R11.1, U1.7|
|Net-(U1-RCLK)|R20.1, U1.12|
|Net-(U2-LNA_EN)|R10.1, U2.13|
|Net-(U5-OSC1)|C2.1, U5.9, Y1.3|
|Net-(U5-OSC2)|C3.1, U5.8, Y1.1|
|Net-(U5-R_{XD})|U5.21, U5.28|
|Net-(U5-T_{XD})|U5.20, U5.24|
|unconnected-(J2-Pin_3-Pad3)|J2.3|
|unconnected-(J3-Pin_1-Pad1)|J3.1|
|unconnected-(J3-Pin_2-Pad2)|J3.2|
|unconnected-(J3-Pin_3-Pad3)|J3.3|
|unconnected-(J3-Pin_8-Pad8)|J3.8|
|unconnected-(J4-Pin_1-Pad1)|J4.1|
|unconnected-(J4-Pin_2-Pad2)|J4.2|
|unconnected-(J4-Pin_3-Pad3)|J4.3|
|unconnected-(J4-Pin_4-Pad4)|J4.4|
|unconnected-(J4-Pin_5-Pad5)|J4.5|
|unconnected-(J4-Pin_6-Pad6)|J4.6|
|unconnected-(J5-Pin_4-Pad4)|J5.4|
|unconnected-(J7-Pin_1-Pad1)|J7.1|
|unconnected-(U1-QH'-Pad9)|U1.9|
|unconnected-(U2-EXTINT-Pad5)|U2.5|
|unconnected-(U2-SAFEBOOT_N-Pad18)|U2.18|
|unconnected-(U2-SCL-Pad17)|U2.17|
|unconnected-(U2-SDA-Pad16)|U2.16|
|unconnected-(U2-VCC_RF-Pad14)|U2.14|
|unconnected-(U2-VIO_SEL-Pad15)|U2.15|
|unconnected-(U3-INT-Pad6)|U3.6|
|unconnected-(U3-V_{OUT}-Pad8)|U3.8|
|unconnected-(U5-CLKOUT-Pad22)|U5.22|
|unconnected-(U5-NC-Pad2)|U5.2|
|unconnected-(U5-NC-Pad25)|U5.25|
|unconnected-(U5-~{Rx0BF}-Pad12)|U5.12|
|unconnected-(U5-~{Rx1BF}-Pad11)|U5.11|
|unconnected-(U5-~{Tx0RTS}-Pad23)|U5.23|
|unconnected-(U5-~{Tx1RTS}-Pad6)|U5.6|
|unconnected-(U5-~{Tx2RTS}-Pad7)|U5.7|

### 16.3 別ファイルに残る主要部品の別配置

これらはすべて未配線。メインにある同用途部品の代わりに重複配置しない。元ファイルは今回削除していない。

|現状番号|値|用途|座標x,y,角度|UUID|
|---|---|---|---|---|
|J?|47219-2001|3.3V microSD SPI; card detect|355.6, 130.81, 0|0e35c2d6-d10f-434f-92cd-72474bfda1cd|
|J?|2452796-1|1.8V nanoSIM; hinged socket with detect|176.53, 55.88, 0|2fc22c57-8968-4772-879d-3f5c1a758ce8|
|J?|LTE service 1x06|USB VBUS/DP/DM/GND + BOOT_CFG/VDD_EXT service header|121.92, 81.28, 0|3fd075d4-3a45-48fe-a58f-76f2e2a3a0dd|
|J?|U.FL-R-SMT-1(10)|LTE antenna, 50 ohm RF path|142.24, 82.55, 0|525e23fb-25ed-4df9-b946-1a68aa56f007|
|U?|AP63301WU-7|5V to 3.8V LTE buck; MCU-controlled EN|127, 109.22, 0|60947d0b-8f2b-426b-abcb-976d6c3b6b9c|
|U?|SIM7070G|LTE Cat-M/NB; VBAT 3.8V, UART/SIM 1.8V|62.23, 80.01, 0|7bb0d9e1-0077-47fd-b2c0-8724033dbbb1|
|Q?|2N7002|Open-drain PWRKEY; do not drive PWRKEY high|274.32, 125.73, 0|9e7a35ca-3c06-4e3f-8b41-4190369bb614|
|U?|TXU0204PWR|TX/RX/RTS/CTS 3.3V to 1.8V|128.27, 57.15, 0|c726da66-9276-46d7-9ead-4a35f1f5c53c|
|U?|USBLC6-4SC6|SIM ESD: VDD/CLK/RST/DATA|166.37, 107.95, 0|e5e0e810-868d-4a54-8284-4d45649aff0b|
|U?|USBLC6-4SC6|microSD ESD: CLK/CS/MOSI/MISO|381, 175.26, 0|f8b41319-4526-4d88-9d0f-eb4ed101c4ca|

文書検証結果は `output/実装方針_検証_20260922.json`。本作業からCADファイルへの書き込みは行っていない。作業中にメイン回路図が外部で保存され、SIM7070Gの全GND接続が加わったため、この節へ反映した。PCB・別回路図・ライブラリは開始時ハッシュと一致。現状記録の基準は最終照合時点（2026-09-22 02:42のメイン保存分）とする。
