ntakao2006-web/RaceCapture/firmware/logger_v1/GNSS_CHECK_20260901.md

# 9月1日のGNSS設定変更・実機確認

## 現在の設定

ESP32-S3へ `logger-v1-gnss-stream-20260901i` を書き込みました。
GPS中心の25 Hzから、GPS＋Galileo＋BeiDou B1C＋GLONASSを有効にした10 Hzへ変更しています。
QZSS/SBASも有効です。モジュールRAMの設定読戻し一致を確認しました。
高性能クロックのOTP設定は読取りだけで、新たなOTP書込みはしていません。

この10 Hz設定は暫定です。約15 Hzなどとの比較は、最初の10 Hz区間の測定中にPC側の処理が中断されたため未完了です。
「最適値が10 Hzと分かった」という結果ではありません。

## 回収したSDログの結果（同じGNSS設定のh版）

| 項目 | 結果 |
|---|---:|
| 対象時間 | 222.04秒 |
| 新鮮な有効位置を記録できた割合 | 100% |
| 測位数 | 2,221 |
| 測位間隔 | 平均100 ms |
| 間隔の内訳 | 100 ms ×2,218、99 ms ×1、101 ms ×1 |
| 使用衛星数の中央値 | 12機 |
| 使用衛星数の下位10% | 11機 |
| SD採取 | 約100.00005 Hz、最大行間隔11.134 ms |
| IMU | 全区間有効、約100 Hz |
| ファイル終了 | 正常終了確認済み |
| 書込み前の既存94ファイル | 全ファイルのサイズ一致で維持確認 |

99/101 msは対になっており、既存検証と同じ時刻整列の±1 ms許容で測位周期を確認しました。
厳密な「全間隔が100 ms」だけの最初のチェックはfalseなので、その結果もJSONに残しています。
200 ms以上の測位間隔はありません。

衛星を4系統有効にしたことと、4系統すべてを測位に使えたことは異なります。
観測途中ではGPS 5機、Galileo 3機、GLONASS 5機、BeiDou 0機でした。継続中の観測で使用総数は15機にも増えています。
この条件では、GLONASSを残して約15 Hzにする設定が次の比較候補です。まだ優位性は実測していません。

取得座標は位置情報保護のためリポジトリへ記載しません。既知地点との整合確認は別途行います。
`GPSHAcc` の95%値は0.87 mですが、受信機の内部推定であり、真の絶対位置誤差を測った値ではありません。
アンテナの固定状態も未確認のため、この区間から静止位置精度の結論は出しません。

## 比較用ファームの不具合修正

準備していたg版では、実機で `getStatus` を受けると通信タスクのスタック不足で再起動しました。
原因をUARTログで確認し、h版でUSB/UART双方のスタックを12 KiBから24 KiBへ増やしました。
最小空き容量を状態応答へ追加し、両経路で50回の状態・サンプル・診断問い合わせを実施しました。
再起動なし、空き約12 KiB、SD/IMUの記録継続を確認しました。g版は使用しないでください。
この不具合の再起動で作られた一部の試験ログは正常終了していません。既存94ファイルは影響を受けていません。

h版起動初期にIMU通信エラーが1回あり、その後の検証中は増加していません。
GNSSの通信エラー・再設定回数、SDエラー・欠落は検証中0です。
電源瞬断耐性や実走時の最適設定を確認した試験ではありません。

## RaceCaptureの取得停止への対策（i版）

h版では基板へのUSB単独問い合わせと設定45回の連続読取りは通りましたが、RaceCapture起動時に
設定読込みのlapCfg/canCfgタイムアウトとPC取得停止を再現しました。アプリは定期配信非対応と判断して50 Hzでサンプルを要求し、応答の遅延が蓄積していました。
i版で既存の定期配信を標準の `telemstream` / `setTelemetry` に対応させ、PC配信を最大10 Hzに制限しました。
SD・IMUの100 Hz、GNSSの10 Hzとは独立した制限です。PC記録はSDより低い頻度になります。
50 Hz要求→10 Hz適用、1 Hz、0 Hz停止、不正な負値拒否を実機で確認しました。
最大10 Hzは上限であり、実測のPC配信は約9.4〜9.7 Hzです。

通常起動したRaceCaptureで設定の読込み完了を確認しました。03:44:27〜03:44:58の連続監視では
SQLiteサンプルIDが1,524,904→1,525,194と全観測点で増え、GNSS 3D・17〜20衛星、
SDの欠落/エラー0、USB欠落0、IMUエラー0でした。GNSS通信エラーは起動時1件から増えていません。
起動直後にcapabilitiesの読込み待ちが1回ありますが、その後設定読込みは完了しました。
通常のアプリを開き、自動復帰ヘルパーを接続した状態で返しています。
USB物理抜挿後の復帰、長時間運転、約15 Hzとの比較は今回のi版では未検証です。

## 保存先

最終版 `artifacts/release_20260901_gnss_stream_i/`:

- `firmware.bin`: 609,200 bytes、SHA-256 `3feb8af0c4383d2b8f6c7e3c1384d1b3ecc637a97ceb2c5fc1d1d224c1cb077a`。
- `upload.log`: 0x10000のアプリ領域のみ書込み・照合成功。
- `stream_verification.json`: 配信開始・頻度上限・停止・GNSS/SD/IMU状態。
- `racecapture_acquisition.json`、`racecapture.png`: 通常起動アプリの継続取得と表示。
- `manifest.json`: 最終版と既存ログ保全の確認。

`artifacts/release_20260901_gnss_compare_h/`:

- `firmware.bin`: 608,000 bytes、SHA-256 `53fc843799e09c6abfb5482707e49a40c231a1c6c78dffe6ff671b9d36ccb70f`。
- `upload.log`: 0x10000のアプリ領域だけを書込み、照合成功。
- `communication_stress.json`: USB/UART繰返し試験。
- `recovered_four_10/`: CSV原本、列・設定メタデータ、正常終了記録、集計結果。
- `interrupted_status.json`: PC測定処理が中断した後も基板の記録が続いていたことの確認。
- `racecapture_acquisition.json`、`racecapture.png`: h版で取得停止を再現した記録。成功証拠ではありません。

SD削除・全Flash消去・NVS消去・OTP書込み・CAN送信・回路変更は実施していません。
