ntakao2006-web/RaceCapture/circuit/logger_v2/output/実装方針_詳細化前_20260922.md

# logger_v2 実装方針 — UNO Qシールド、GNSS・LTE・SD

更新日：2026-09-21

## 1. 採用する構成と今回の到達点

UNO Qの標準シールド端子を使用し、CAN×2、MAX-M10M GNSS、BNO055 IMU、SIM7070G LTE、microSD、既存LED表示を共存させる。既存のピン割り当ては変更可能とする。

**LTEをハードウェアUARTへ直結し、GNSSをIMUと共通のI²Cへ移す。SPI–UART変換は採用しない。V1と同じSDスロットには独立した挿入検出接点がないため、標準ヘッダーの信号21本を使用し、A5の1本が予備となる。**

この文書は今後の配線・ファームウェア実装方針であり、配線済みの証明ではない。2026-09-20にユーザー指定のTE 2452796-1へSIMスロットのシンボル・フットプリント・3Dモデルを変更した。2026-09-21にはSC16IS750・その水晶・補助信号用TXU0204を削除し、必要な周辺部品28個を未配線で追加した。必要な既存部品の位置と配線は維持。PCB・製造データは更新していない。詳細は [部品配置更新](部品配置更新_20260921.md) を参照。

以前の `LTE_SD_GNSS_UPDATE_20260919.md` は作業当時の記録。将来の設計方針は本書を優先する。ユーザー指定事項と以下の設計提案・検証条件を区別し、以前に受領した実装方針の未採用部分を自動的に追加しない。

2026-09-20追記：秋月の裸SMD部品を優先して品番を選定し、回路図の部品属性・一部定数を更新した。SDスロットをV1と同一のMolex 47219-2001へ変更し、フットプリントと実体のあるSTEPを移植した。GNSSは指定アンテナJCA002を前提に外部3.3V給電を維持する。詳細と調達先は [部品選定・GNSS回路検証](部品選定_GNSS検証_20260920.md)。今回も配線・部品位置・PCBは変更していない。

## 2. UNO Qのピン割り当て

方向はUNO QのSTM32側を基準とする。D20/D21は専用SDA/SCL端子で、UNO QではA4/A5と別の信号として利用する。全信号は3.3V系を基本とする。

|UNO Q端子|STM32端子|機能・接続先|
|---|---|---|
|D0|PB7|USART1_RX ← LTE UART1_TXD（9番）|
|D1|PB6|USART1_TX → LTE UART1_RXD（10番）|
|D2|PB3|USART1_RTS → LTE UART1_RTS（8番、モジュール入力）|
|D8|PB4|USART1_CTS ← LTE UART1_CTS（7番、モジュール出力）|
|D4|PA12|FDCAN1_TX → CAN1トランシーバーTXD|
|D5|PA11|FDCAN1_RX ← CAN1トランシーバーRXD|
|D11|PB15|SPI2_MOSI：CAN2・SD・LEDシフトレジスター共用|
|D12|PB14|SPI2_MISO：CAN2・SD共用|
|D13|PB13|SPI2_SCK：CAN2・SD・LEDシフトレジスター共用|
|D10|PB9|CAN2_CS_N|
|D9|PB8|CAN2_INT_N|
|A0|PA4|CAN2_RESET_N（従来D8から移動）|
|D20/SDA|PB11|I2C2_SDA：MAX-M10M・BNO055共用|
|D21/SCL|PB10|I2C2_SCL：MAX-M10M・BNO055共用|
|D6|PB1|GNSS_PPS入力|
|D3|PB0|GNSS_RESET_N|
|D7|PB2|LED STATUS_LATCH|
|A1|PA5|IMU_RESET_N（従来D2から移動）|
|A2|PA6|LTE_PWRKEY制御、2N7002でオープンドレイン駆動|
|A3|PA7|LTE_PWR_EN、LTE降圧電源のEN制御|
|A4|PC1|SD_CS_N|
|A5|PC0|予備GPIO（SDスロットに独立した検出接点なし）|

必要信号数は、LTE 6本、CAN1 2本、共用SPI 3本、CAN2個別制御3本、共用I²C 2本、GNSS個別制御2本、LEDラッチ1本、IMUリセット1本、SD個別制御1本の合計21本。22本中1本が予備となる。

LTEのRI・STATUS・DTR、SIMカード検出入力のうち1機能は予備A5へ追加できるが、すべてを接続する余裕はない。必要になれば低速制御用I²C GPIOエキスパンダーを追加する。UNO Q内部のLPUART1/RouterBridgeは維持する。

## 3. LTE：SIM7070G、UART直結

- USART1を2,000,000 baud、8N1、RTS/CTSフロー制御で使用する。SIM7070G側も対応設定を行い、電源投入直後の通信速度から確実に移行できる起動手順を用意する。
- TXU0204PWRでMCUの3.3VとモジュールUARTの1.8Vを変換する。3.3VをSIM7070Gの信号端子へ直結しない。
- VCCA=3.3V、VCCB=SIM7070G VDD_EXT（1.8V）。A1→B1YをMCU TX→LTE RX、A2→B2YをMCU RTS→LTE RTS、B3→A3YをLTE TX→MCU RX、B4→A4YをLTE CTS→MCU CTSに使用する。SIMComのRTS/CTS名称は入出力方向も併記して照合する。
- OEは両側電源の立ち上がりを考慮して制御・固定する。電源断時の逆給電を防ぎ、VDD_EXTを外部から駆動しない。
- UART受信はDMAまたは割り込み＋十分なリングバッファで連続受信する。SD書き込み中も受信を継続し、バッファの空きに応じてフロー制御する。
- ArduinoCore-zephyrのUNO Q設定はUSART1をコンソールにも使用しているため、起動ログを含むコンソール出力を無効化または別出力先へ移す。PB3/PB4のUSART1 RTS/CTSをpinctrlとドライバーで有効にする。通常のSerial初期化だけで実現済みとは扱わない。
- PWRKEYは規定の時間だけLowにする。通常の電源断はATコマンド等で終了処理してからVBATを切る。電源ENは異常復帰にも使用する。
- 基本構成ではDTRによるスリープ制御を使用せず、AT+CSCLK=0を前提にする。未使用端子はハードウェア設計書に従って処理し、必要に応じてテストパッドを設ける。

2 Mbps/8N1では理論上200 kB/s、データビット換算1.6 Mbpsを搬送できる。約1 Mbpsの上り目標に対してUARTには余裕があるが、ATコマンド・ネットワーク処理・バッファリングの余裕は実測する。SIM7070GのCat-M公称値は上り1119 kbps、下り589 kbpsであり、**上下とも1 Mbps、または常時1 Mbpsを保証する要求には適合しない**。下り1 Mbpsが必須ならモジュール選定を変更する。

## 4. GNSS・IMU：共用I²C

- MAX-M10M-00Bを維持し、SDA/SCLをBNO055と同じI2C2へ接続する。GNSSのUART配線を外し、D0/D1をLTEへ割り当てる。
- GNSSの7ビットアドレスは0x42、BNO055はADR設定により0x28/0x29で、アドレスは競合しない。
- 400 kHzを設計目標とする。MAX-M10Mは最大20 msのクロックストレッチを行うため、MCU側タイムアウトとIMU取得周期への影響を確認する。PPSは独立GPIOで時刻を取得する。
- GNSS出力メッセージを必要分に制限し、FIFO取りこぼしとIMU取得の遅延を評価する。必要な周期を満たせない場合は別I²Cバスへ分離し、増える制御線をGPIOエキスパンダーで補う案を再評価する。
- IMU用プルアップは実装部品とする。DNPに戻さない。GNSS側に重複したプルアップを漫然と追加せず、合成抵抗と配線容量で立ち上がり時間を確認する。
- GNSS PPS、GNSSリセット、IMUリセットを維持する。JCA002アンテナは外部3.3V→27Ω/1W→27nH→SMAから給電し、抵抗後に10nFをGNDへ接続する。LNA_ENの10kΩは必須ではなく、R10は従来どおりDNP。VCC_RFは未接続。短絡・開放の検出機能やアンテナ電源の自動遮断は持たない。具体的な定格・RF部品・V1比較は部品選定文書を参照する。

## 5. CAN・SD・LED

- CAN1はSTM32内蔵FDCAN＋既存トランシーバー。将来の配線変更時に、現在のTXD固定Highを解除してD4へ接続する。車両での初期運用は受信専用設定とする。
- CAN2とmicroSDはSPI2を共有し、個別CSを設ける。CSは起動中も非選択となるようプルアップし、非選択時のMISO解放を確認する。
- microSDはLoggerV1と同じMolex 47219-2001を使用し、3.3V電源、デカップリング、ESD対策を用意する。1～8番はSD接点、9番はシールド共通端子。DAT3/CDの名称は独立した機械式カード検出端子を意味せず、SPIではCSとして使用する。A5は予備とし、カード有無は初期化・通信結果で判定する。安全な取り外し処理を実装するまで通電中の抜き差しに対応済みとは扱わない。
- 74HC595系LEDはSPIのMOSI/SCKを共用する。CAN/SD通信中も内部シフト内容は変わるため、LED更新時だけ全ビットを書き直してからラッチする。全デバイスの転送を同じバス排他制御下で行う。
- SD書き込みを分割・バッファリングし、CAN2割り込みから読み出しまでの最悪遅延とCAN受信FIFOの余裕を測定する。

## 6. SIMカードスロットとライブラリ

ユーザー指定の **TE Connectivity 2452796-1**（RS品番286-8822）、ヒンジ式nanoSIMスロットを使用する。旧NSIM-2-Cから置き換えた。TE図面C-2452796 Rev Cの端子番号を採用し、SIM接点番号C1～C7とは区別する。

|項目|配置・ファイル|
|---|---|
|回路図|`logger_v2_lte_sd.kicad_sch` に配置済み、現在は未採番・未配線|
|シンボル|`logger_v2_expansion:TE_2452796-1`|
|フットプリント|`logger_v2_expansion:nanoSIM_TE_2452796-1_Hinge`|
|シンボルライブラリ|`logger_v2_expansion.kicad_sym`|
|フットプリントファイル|`logger_v2_expansion.pretty/nanoSIM_TE_2452796-1_Hinge.kicad_mod`|
|3Dモデル|`${KIPRJMOD}/3dmodels/TE_2452796-1.step`、メーカーSTEPを基板座標へ変換|

|部品端子番号|名称／SIM接点|将来の接続|
|---|---|---|
|1|VCC／C1|SIM7070G SIM_VDD（30番）|
|2|RST／C2|SIM_RST（33番）から22Ω直列|
|3|CLK／C3|SIM_CLK（32番）から22Ω直列|
|6|I/O／C7|SIM_DATA（31番）と22Ω直列で接続|
|4|GND／C5|GND、カード検出接点の共通側|
|5|VPP/NC／C6|未接続|
|7|SW|挿入時に4番（C5/GND）へ閉じる。基本構成ではMCU接続なし|
|8、9、10|SHIELD|各固定パッドをGNDへ接続|

SIM7070GのSIMインターフェースは1.8V系で使用する。SIM_VDDはモジュールから供給し、3.3Vへ接続しない。スロット近傍に100 nFと適切な低容量ESD保護を設ける。DATAにはモジュール内蔵プルアップがあるため外付けプルアップを追加しない。VDD、RST、CLK、DATAを保護し、配線は短くする。検出接点の共通側はC5/GND（部品4番）。

シンボル・フットプリントはともに1～10番を使用する。信号パッド0.8×1.0 mm、固定・検出パッド1.3×1.8 mmとし、メーカー指定の6か所の配線・ビア禁止領域を設ける。3Dはメーカー提供モデル（CVM Rev A、外形約12.2×14.1×1.4 mm）を使用する。部品の発注・基板化前には開閉スペースと周辺部品との干渉を再確認する。

## 7. 電源・実装規則

- シールドの基本電源は5Vと3.3V。LTEのVBATだけ5Vから約3.8Vへ降圧する。3.3V端子やVDD_EXTからLTE本体を給電しない。
- LTE降圧電源はAP63301WU-7（TSOT26、3A、DigiKey調達）を使用する。入手性と手実装性を優先し、2026-09-22にTPS62130から交換した。C29は100nFのBST–SW用へ変更。詳細は[置換記録](AP63301置換_20260922.md)。2G動作を含む最悪条件では約2Aのピークを見込み、5V供給源・コネクター・配線抵抗・インダクター・バルク容量を含めて設計する。UNO Qの5V端子から必要な余剰電力を得られるかは別途確認し、未確認のまま給電能力を保証しない。
- GNSS、IMU、SD、CAN、LEDを含む3.3V電源の合計負荷を集計する。SD書き込みとLTE送信が重なった条件で電源降下・リセット・GNSS受信への影響を確認する。
- 基本はローカルラベルで配線し、文字サイズは1.27 mmの標準値。別シート間はローカルラベルだけでは接続されないため、階層ラベルとシートピンを使用する。
- 将来の配線変更も必要箇所に限定し、既存の必要部品を削除・移動しない。不要な旧案部品は配線実装時に明示して整理する。
- 今後追加する部品にもフットプリントと3Dモデルを割り当てる。最終部品表確定後は、基板上で全体の配置・向き・干渉を確認する。
- SIM7070G・SIM/SDスロット以外は可能な限り秋月で調達し、裸SMD部品を優先する。DIP化基板は採用せず、IMUのみ例外とする。シールド端子・既存ケーブル用コネクターは機械的理由でスルーホールを維持する。RF保護・UARTレベル変換・LTE電源等の例外と品番は部品選定文書に明示する。
- 現在配置されている97個の部品はフットプリントと実体STEPの参照を確認済み。全モデルがメーカー厳密形状という意味ではなく、TC74HC595AFはデータシート公称寸法による簡易モデル、ヘッダー等は既存汎用モデルを含む。2026-09-21にLTE電源のL/C、SIM/SD/UARTの必要な周辺部品を追加した。追加28個中24個は秋月品。電源応答・実効容量・RF定数は配線と実装の段階で評価する。

## 8. 実装・検証の順序

1. 上表に従って回路図を変更し、LTE電源・SIM・SDの周辺部品を確定する。採番、未使用端子処理、電源ネット、階層接続を確認しERCを実施する。
2. UNO QのUSART1をLTE専用にし、2 Mbps・RTS/CTS・連続受信を確認する。起動ログの混入、相手電源断、受信バッファ飽和からの復帰も確認する。
3. GNSS＋IMUを共用I²Cで動かし、クロックストレッチ時のIMU取得遅延、GNSS欠落、PPS時刻精度を測定する。
4. CAN×2受信、GNSS、IMU、LTE送信、SD保存、LED更新を同時に実行し、欠落数・最大バッファ使用量・SD最大停止時間・実効LTE速度を記録する。
5. 回路図確定後にPCBへ反映し、フットプリント・3D・電源/RF配置を確認してDRCを実施する。製造データはその時点で再生成する。

UARTの理論容量やGPIO数の成立と、同時動作の実機検証完了を混同しない。現時点では配線変更・ファームウェア変更・実機同時動作試験は未実施。

## 9. 根拠資料

- [Arduino UNO Q 公式ピンアウト](https://docs.arduino.cc/resources/pinouts/ABX00162-full-pinout.pdf)
- [ArduinoCore-zephyr UNO Q設定](https://github.com/arduino/ArduinoCore-zephyr/blob/main/variants/arduino_uno_q_stm32u585xx/arduino_uno_q_stm32u585xx.overlay)
- [STM32U585 データシート](https://www.st.com/resource/en/datasheet/stm32u585ri.pdf)／[Zephyr STM32U585ピン定義](https://github.com/zephyrproject-rtos/hal_stm32/blob/main/dts/st/u5/stm32u585zitx-pinctrl.dtsi)
- [MAX-M10M-00B データシート](https://content.u-blox.com/sites/default/files/documents/MAX-M10M-00B_DataSheet_UBX-22028884.pdf)
- [SIM7070G公式仕様](https://en.simcom.com/product/SIM7070G.html)、SIMCom Hardware Design（ローカル保存：`refs/SIM7070_hardware.pdf`）
- [TE 2452796-1メーカー資料・3Dモデル](https://www.te.com/en/product-2452796-1.html)（図面：`refs/TE_2452796_RevC.pdf`、メーカーSTEP原本：`refs/TE_2452796-1_original.step`）
- [ユーザー指定のRS商品ページ](https://jp.rs-online.com/web/p/memory-card-connectors/2868822)
- [TXU0204 データシート](https://www.ti.com/lit/ds/symlink/txu0204.pdf)

ローカルの参照PDFと取得済みUNO Q定義は `refs/` に保存。SIMスロットの置換・端子整合・3D確認は2026-09-20時点の作業ファイルを対象とする。
