ntakao2006-web/RaceCapture/v2_hardware_overview.html

ロードスター（NCEC）・SUGO 120分耐久（2026-11-08）を走った形

# EcoLogger Ver.2 構成図

Ver.2ロガーが、車のどこから電気と信号をもらい、何を記録して、どうやってピットの画面まで届けているかをまとめた図です。図の上下は実物の積み重ねの順に合わせています。後半は、それを動かしているソフトウェアの図です。

## 車の中のつながり

ロガー本体は3枚の基板の積み重ねです。一番下がArduino UNO Q、その上にUPSモジュール、一番上にシールド（logger_v2）が載ります。アンテナ2本はシールドにつながります。

- UNO Qの電気は、充電器のC1 → ドックのPD給電口 → Type-C延長 → UNO QのUSB-C、の順に来ます。UPSモジュールはUNO QのUSB-Cから入った電気を受け、ためておきます。
- ドック1本で、UNO Qへの給電・HDMIの映像と音・カメラのUSBをまとめています。モニターの電源だけは充電器のC2からPDトリガーで9Vにして別にもらいます。
- 車両CANはOBD2のタップから受信だけで読みます（ロガーから車へは送りません）。Defiの油圧・油温・水温は、既設のセンサーの電圧をPICのセンサーハブが分けて読み、CAN2で送ります（ID 0x580）。ハブの電源も同じ4本の線（+5V・CAN-H・CAN-L・GND）でシールドからもらいます。
- 記録は2か所に残ります。UNO Qの本体（eMMC）と、シールドのmicroSD（控え。いっぱいになると古い順に消して続けます）です。

## LTEでピットの画面に出るまで

ピットの画面に出る値は、シールドのLTEモジュールから携帯の回線とインターネットを通って自宅のサーバーに届き、そこでグラフと地図になります。ピットではスマホやPCのブラウザでそのページを開いて見ます。

- LinuxとLTEモジュールは直接はつながっていません。Linuxがまとめた値をSTM32へ渡し、STM32がシールドのUART（2Mbps）でSIM7070Gへ送ります。
- 回線はSORACOMのSIM（planX3）で、その場で一番よい携帯会社の基地局につながります。SUGOではドコモのLTEにつながっていました。
- 自宅のサーバーの入口は1つで、ロガーの受け口・Grafana・地図をまとめて出しています（アドレスはここには書きません）。

## 外から本体へつなぐ3つの道

PCやスマホから本体へは、USBのadb・テザリング・LTEの3つの道でつなぎます。いちばん大きな違いは、USBとテザリングはLinuxの中まで入れるので何でもできるのに対して、LTEは値を受け取るのと、決まった5つの命令を送ることしかできないところです。そのかわりLTEだけは走っている最中もつながります。

したいこと | ① USBのadb | ② テザリング | ③ LTE
走っている最中につながる | × 車を止めてケーブルをつなぐ | △ 電波の届く間だけ | ○ どこでも
画面・録画を動かしたまま | × ドックを外すので止まる。戻すには電源を入れ直す | ○ | ○
ネットの無い所で使う | ○ | ○ テザリングの電波だけでよい | × 回線と自宅のサーバーが要る
走行中の値を見る | ○ 設定・ログの画面 | ○ 予備の車載画面・コースウォーク画面 | ○ Grafana・地図・周回表
本体の状態を見る（記録・測位・SD・録画） | ○ 操作メニュー | ○ 操作メニュー | △ 「状態」の命令で要点だけ
ラップのリセット・周回数の直し・ラップや記録の開始 | ○ | ○ | ○ 署名付きの命令で
コースのラインを登録する | △ 車をラインに置けば | ○ スマホのコースウォーク画面 | ×
走行記録（CSV）の回収 | ○ | ○ 小さいので間に合う | ×
走行映像の回収（10分で約770MB） | ○ 10分ぶん約20秒 | △ 10分ぶん約9分。短い所だけ | ×
焼き込みの設定（HUD・レンズ・露出）を送る | ○ | ○ | ×
車載画面のDASH⇔RaceCaptureの切り替え | ○ | ○ | ×
設定の変更（CANの信号・LTE・Wi-Fi） | ○ 設定・ログの画面 | △ 画面はUSB用。sshで手で | ×
ソフトの更新・STM32の書き込み | ○ 更新の道具がある | △ 同じ手順をsshで手で | ×

- 走っている間は③LTEだけ。ピットで値を見て、困ったときは周回数の直しや記録の開始を命令で送ります。LTEの命令は「状態・ラップのリセット・周回数・ラップの開始・記録の開始」の5つだけで、設定を変えたりファイルを取ったりはできません（なりすまし対策で署名も要ります）。
- 走行の合間・ピットでは②テザリング。画面と録画を止めずに、状態の確認・ラップのリセット・焼き込みの設定・小さい記録の回収ができます。
- 大会の後・家では①USBのadb。動画の回収とソフトの更新はこれで行います。ドックを外すので、終わったらドックをつなぎ直してから電源を入れ直します（動いたまま差し替えるとドックを認識しない）。
- どの道でつなぐかは、PCの側が自分で探します（2026-11-13から。USB → テザリングの順。つながらないときは、道ごとの理由と直し方を出す）。スマホからの操作は、ピットの表紙から③LTEで送ります（合言葉は、PCのアプリが出すQRで渡す）。
- シールドのmicroSD（控えの記録）はどの道でも取らず、本体の電源を切ってカードを抜き、PCのカードリーダーで回収します。

## ロガー本体の中のソフト

UNO Qの中には頭脳が2つあります。STM32（マイコン）が測定と記録の土台で、Linuxがその値を使って記録・画面・録画・LTE送信をします。STM32はLinuxが止まっても測定とmicroSDへの記録を続けます。

- 値の流れ：STM32が100Hzで取った値は、microSDへ書くのと同時にArduino Routerを通ってLinuxのEcoCaptureへ渡ります。EcoCaptureが本体への記録・ラップ・LTE送信をまとめ、車載画面（DASH）と焼き込み録画はEcoCaptureから値を読みます（録画は約25Hzで読み、映像の時刻に合わせて補間）。
- LTEで送る道：送るデータを作るのはLinuxのEcoCaptureですが、モデムをつないでいるのはSTM32です。なので、Linux → Router → STM32 → UART → SIM7070G の順に出ていきます。
- 止まっても続ける仕組み：STM32はLinuxがいなくても記録を始め、ループが30秒止まると自分で再起動します。STM32が再起動したあとLinuxとの通信が戻らないことがあるので、Linuxの「通信の見張り」が30秒以上の切断を見つけて元に戻します。「障害の記録」は、突然電源が切れたときの直前の様子を残します。
- EcoCaptureはDockerのコンテナの中で動き、PCからはUSBのadbでその設定・ログの画面を開きます。コースウォーク画面だけは車の中のWi-Fiに出していて、スマホから合言葉付きで開きます（ライン登録と、予備の車載画面への値だけ）。
- 公式のRaceCaptureアプリは入ったままです。SUGOからは車載画面をDASHに切り替えていて、切り替えで戻せます。
- PICセンサーハブのファームは回路担当が作ったもの、それ以外の本体のソフトは基本こちらで作っています。

## 本体の外のソフト

ロガーから出た値は自宅のサーバーでグラフと地図になります。PCの道具は、本体の操作・回収・設定と、大会後の解析に使います。

- 受け口のecorun-logger-serverはチーム（Maruo.Sさん）が作ったサーバーで、Dockerで動かしています。届いた値を部屋（車）ごとのファイルに書き、live_bridge.pyがそれを追いかけて、保存（VictoriaMetrics）と、地図・周回表へのなめらかな配信をします。
- PCからの命令（周回数の直し・記録の開始など）は、自宅のサーバーを通って同じLTEの道でロガーへ届きます。命令には合言葉の署名を付け、ロガーは決まった命令しか受け付けません。
- 回収・設定の道具はデスクトップの「EcoLogger Ver.2」（操作メニュー）からボタンで開けます。本体へはUSBのadbか、スマホのテザリング経由のsshでつなぎます。

## ソフトの一覧

動く場所 | ソフト | すること | リポジトリの置き場所
PICセンサーハブ | PICのファーム v8 | Defiの油圧・油温・水温のセンサーの電圧を読み、CAN2で送る（ID 0x580） | 回路担当が管理（仕様はlintaroh_answer_20261101_defi_volt.md）
UNO QのSTM32 | ecologger_v2 | CAN1・CAN2・GNSS・IMUを100Hzで取り、microSDへ記録。値をLinuxへ渡し、LTEモデムを動かす | firmware/ecologger_v2/
UNO QのLinux | Arduino Router | STM32とLinuxの間の通り道（UNO Qにもとから入っているもの） | —
UNO QのLinux | EcoCapture | 本体へのCSV記録・ラップ計測・LTE送信・ピットからの命令・設定とログの画面・コースウォーク画面 | EcoCapture-Web/
UNO QのLinux | EcoCapture DASH | 車載画面（今の周・ベスト比・警告）と警告音をHDMIへ | RaceCapture-UNOQ/ecocapture_dash.py
UNO QのLinux | 焼き込み録画 | カメラの映像にメーター・コース図・Gを描いて、音と一緒に保存。10分ごとに区切り、空きが減ると古い順に消す | tools/unoq_overlay_enc/
UNO QのLinux | 見守り役3つ | STM32との通信を戻す・突然の電源断の記録・Wi-Fiなどの設定をする小さな係 | EcoCapture-Web/・RaceCapture-UNOQ/
UNO QのLinux | RaceCapture公式アプリ（控え。外す予定） | もとのRaceCaptureの画面。値はrcp_bridge.pyが渡す。2026-11-13に外すと決めた（本体から取り除くのは、展示のあと） | RaceCapture-UNOQ/
自宅のサーバー | ecorun-logger-server | ロガーからの値を受けて保存する（チームのサーバー） | チームのリポジトリ
自宅のサーバー | ブリッジ・VictoriaMetrics・Grafana | 値の保存と、ピット用の表紙（スマホで開く入口。いまの要点・行き先・LTEの命令）・グラフ・地図・周回表・時計 | tools/home_telemetry/
PC | EcoLoggerアプリ（新しい入口。2026-11-13から、作りかけ） | 「いまの様子」（記録・測位・SD・録画・LTEを○×と直し方で出す。ロガーが無くても開き、つなぐと自分で切り替わる）・操作（ラップのリセット、LTEの命令、合言葉の準備とスマホへ渡すQR）・回収 | tools/video_collect/EcoLogger-App.cmd
PC | 操作メニューと道具（今までの入口。新しいアプリへ順に移す） | 本体の状態を見る・回収・焼き込みの設定・大会の準備・LTEで命令。車とコースの設定のファイルはtools/setups/ | tools/の下
PC | 解析・1周の動画 | 周・セクター・油温油圧・タイヤの滑りなどのレポート、風切りを下げた1周の動画 | tools/race_analysis/・tools/lap_video/
スマホ | EcoLoggerアプリ | 予備の車載画面（DASHが映らないとき用） | android-logger/

## 部品の一覧

部品 | 型番など | 役目 | つなぎ先
Arduino UNO Q | — | Linux（EcoCapture・車載画面DASH・焼き込み録画）とSTM32（センサーとLTEを動かす）の2つの頭。本体の記録はeMMC | 積み重ねの一番下。USB-Cでドックへ
UPSモジュール | 回路担当の自作 | 入力が一瞬切れても、UNO Qとシールドを動かし続ける | 積み重ねの真ん中。UNO QのUSB-Cの電気を受ける
シールド | logger_v2 | CAN×2・GNSS・IMU・LTE・microSDをまとめた自作の基板 | 積み重ねの一番上
GNSS | MAX-M10M | 位置・速度・時刻 | I²C（IMUと共用）・アンテナ JCA002
IMU | BNO055 | 前後・左右のG、角速度、姿勢 | I²C
LTE | SIM7070G | ピットへ値を送る（LTE-M）。SIMはSORACOM planX3 | UART 2Mbps・アンテナ FXUB63
CAN1 | STM32内蔵 ＋ ATA6561 | 車のCANを受信だけで読む | OBD2タップ
CAN2 | MCP25625 | 外部のセンサーハブとのCAN | PICセンサーハブ（+5V・H・L・GNDの4本）
microSD | — | 控えの記録（いっぱいになると古い順に消す） | シールドのスロット
PICセンサーハブ | ファーム v8 | Defiの油圧・油温・水温の電圧を読み、ID 0x580で送る | CAN2・既設のDefiのセンサー
USB-Cドック | — | UNO Qへの給電、HDMI（映像と音）、カメラのUSB | Type-C延長 2mでUNO Qへ。給電は充電器のC1
モニター | HD7H | 車載画面DASH、油温・油圧の警告音 | ドックのHDMI。電源はPDトリガーの9V
カメラ | ELP（USB） | 値を焼き込んだ走行映像と音 | ドックのUSB
PDトリガー | WITRN | 充電器のUSB-Cから9Vを取り出す | 充電器のC2 → モニターの電源
充電器 | USB-C 2口の車用 | 12Vから各機器の電気を作る | 増設シガーソケット
電源の元 | ヒューズ電源・手元スイッチ | 室内ヒューズボックスの常時電源。スイッチを入れると記録が始まり、切ると終わる | 増設シガーソケット

## 部品代

いま車に載っている1台分で、約6.6〜7.4万円です。買ったときの値段（税込）で、幅があるのはシールドの細かい部品とGNSSアンテナの値段が記録に無く、目安で入れているためです。

部品 | 値段 | 出どころ
Arduino UNO Q | ¥13,400 | 買った値段
モニター（HD7H） | ¥12,640 | 買った値段
カメラ一式（ELPの基板・ケース・レンズ） | ¥12,000 | 買った値段
シールドの主な部品（GNSS・IMU・CANの部品・降圧IC） | ¥4,900 | 秋月の値段
シールドの残り（LTEモジュール・スロット・抵抗やコンデンサ・4層基板の製作） | ¥8,000〜15,000 | 目安
USB-C 2口の充電器 | ¥3,000 | 買った値段
SORACOMのSIM（月額は別） | 約¥2,300 | 14.90 USD
UPSモジュール | ¥2,000 | 部品代
Type-C延長 2m | ¥1,760 | 買った値段
PDトリガー（WITRN 9V） | ¥1,680 | 買った値段
LTEアンテナ（FXUB63） | ¥1,276 | 買った値段
ヒューズ電源＋増設ソケット | 約¥1,150 | 候補の値段
GNSSアンテナ（JCA002） | ¥1,000〜2,000 | 目安
手元スイッチ（カバー付き） | ¥699 | 買った値段
PICセンサーハブ | ¥200〜500 | 部品代
USB-Cドック | ¥0 | 手持ち
合計 | 約¥66,000〜74,000

実際に出ていったお金は、これより約1.6万円多くなっています。UNO Qを一度買い替えていること（もう1枚分）と、Type-C延長を比べるために2本買ったこと（使っていない方が¥2,780）の分です。Defiのセンサーはもとから車に付いていたので入れていません。

## 分かっている弱点・これから

- 電源が一瞬切れると、UPSの外にあるドックだけがリセットされ、モニターとカメラが次にLinuxを起動し直すまで戻りません。記録とLTEの送信は止まりません。ドックをUPSの内側に入れる案を相談中です。
- ブレーキ圧センサー（AiM、0.5〜4.5V出力）を足す予定です。電源が8〜16Vなので、シールドの5Vではなく12Vを別に引きます。

2026-11-10時点の形。設計の詳しい資料はリポジトリの ARCHITECTURE.md と circuit/logger_v2/実装方針.md。
