ntakao2006-web/RaceCapture/ARCHITECTURE.md

# RaceCapture互換 車載データロガー & リアルタイムダッシュボード — 統合ロードマップ

> **ひとことで言うと**：RaceCaptureのロギングシステムのうち、**ロガー端末部分だけを自作ハードウェアに置き換える**プロジェクト。表示アプリ・通信プロトコル・エコシステムは無料で公開されている純正RaceCaptureのものをそのまま活用し、自作するのはロガー本体のみに絞る。中身としては、オープンソースで公開されている（過去の）ロガーのロジックを自作基板（ESP32）へ移植する作業に相当する。**ソフトウェア（ファームウェアのロジック）は9割方完成しておりハードルは低い。一方でハードウェア・回路側（センサー値のCAN化、センサーアンプの自作等）にはほとんど手を付けておらず、ここが最大の残作業。プロジェクト全体の進捗としてはまだ2〜3割程度という認識。**
>
> このファイルはプロジェクト全体の「地図」です。詳細な試行錯誤ログは載せず、確定事項と現在地・次の1手だけを追跡します。
> 運用ルールは末尾「8. Claude運用ガイド」を参照。
>
> **2026-11-13追記**：下の1〜3章はVer.1（ESP32-S3＋純正RaceCaptureアプリ）を考えたときの構想。いまの本番機（Ver.2）が「誰に・どの場面で・何をできるようにするか」は [`SPEC.md`](SPEC.md)（下書き）が正。このファイルは現在地（4章）とロードマップ（5章）を持つ。

> **この文書の読み方（2026-11-13）**
>
> | 章 | 中身 | いまの扱い |
> |---|---|---|
> | 1〜3 | 目的・全体の構成・部品の選び方 | **Ver.1の構想**。いまの本番機（Ver.2）の姿は4章の頭「いまの姿」と`SPEC.md`・`v2_hardware_overview.html` |
> | 4 | 現状ステータス | 頭に「いまの姿」の要約。その下は確定した事実の追記で、**追記だけ・書き換えない**（古いファイルの場所の書き方もそのまま。読み替えは「いまの姿」の表） |
> | 5 | ロードマップ | 冒頭「タスクの置き場所」が、系統と分解ファイルの一覧 |
> | 6・7 | 回路の相談ポイント・未解決事項 | Ver.1の頃の一覧。いまの依頼と回答は`docs/share/` |
> | 8 | Claude運用ガイド | 更新の決まり。ファイルの置き場所の決まりもここ |

---

## 1. プロジェクトの目的とコンセプト（Ver.1の構想）

市販のモータースポーツ用データロガー「RaceCapture」の表示・解析系エコシステム（純正アプリのUI・ライブテレメトリ機能）を活用しつつ、「高信頼性・低ノイズ・拡張性」を兼ね備えた自作ハードウェアロガーを構築する。

**メインゴール**
- 走行中の車載液晶（Raspberry Pi / Android）へのリアルタイムデータ表示
- GoPro等の走行動画とミリ秒単位で完全自動同期できる高精度なGPS・車載データの記録

**基本方針**
「画面表示が落ちても、ログ保存は絶対に止めない」信頼性優先の設計。

### 市販品を採用しない理由
- **コスト**：国内で同等構成の市販システムを揃えると約30万〜100万円かかる。比較的安価な「RaceCapture」本体のみでも約10万円（海外直輸入のため技適未対応・購入時の不安あり）し、周辺センサー類は別途自前で用意する必要がある。自作なら10万円を切る予算で構築でき、費用対効果が極めて高いと判断。
- **技術的資産の内製化**：RaceCaptureは日本国内でのユーザーが少なく、導入しても実質的に自分たちが人柱になるリスクがある。同等以下のコストで内製すれば、そのノウハウを自チーム（後述「省エネカー研究部」）の技術資産として蓄積できる。
- **RaceCaptureフレームワークの活用**：RaceCapture自体のフレームワークや、ライブテレメトリー配信による車両状態のリアルタイム監視機能は魅力的。記録側のデータ形式をRaceCaptureに合わせることで、この優れたアプリ・エコシステムをそのまま活かしつつ安価に同等機能を実現することを狙う。
- ※ノイズ耐性については市販品の方が圧倒的に優れているため、上記「市販品を採用しない理由」には含めない（ノイズ対策自体は次項「アーキテクチャ発案の経緯」で、過去の自作機との比較として扱う）。

### アーキテクチャ発案の経緯
これまで自作してきたロガーは、記録・表示・センサー入力といったほぼ全ての処理を1枚の基板に詰め込んでいたためノイズに弱いという課題があった。そこで実際のモータースポーツ用レーシングロガー（RaceCapture等）に近い構成として、「記録を取る部分（ロガー本体）」「表示する部分」「センサーの入力を受ける部分（センサーハブ）」を物理的に別ユニットへ分割し、ユニット間をCAN通信で結ぶことでノイズ耐性を高める設計とした（2章の全体アーキテクチャ図に対応）。過去の自作ロガーが抱えていた問題を全面的に解決するプロダクトを目指している。

### 実戦投入ターゲットと開発体制
最初の実戦投入ターゲットは**Honda エコ マイレッジ チャレンジ参戦車両**。これまでの自作ロガーの経験（ノイズが原因でSDカードへの書き込みができない等の問題が過去に多発）から、ゼロベースでいきなりチーム開発を始めるのはハードルが高いと判断し、以下の2段階で進める方針とする。
1. 発案者個人の自己資金による先行開発・検証（自身のロードスターでのサーキット走行解析用途を兼ねる）
2. 個人開発の段階で「確実に動作し、実現可能である」という明確な見通し（実証データ）が立った段階で、エコ マイレッジ チャレンジ参戦チーム「省エネカー研究部」へ合流し、部としての開発リソースを借りる

### 解析対象車両（NCEC）の仕様 — **CAN解析の結果を読むときの前提**

先行開発に使っているロードスターは**ノーマル車ではない**。CANの中身がコミュニティ資料と
食い違う箇所があるため、解析結果を解釈する際の前提としてここに明記する。

> **車両仕様のマスターは別リポジトリにある**：[ntakao2006-web/ncec-roadster](https://github.com/ntakao2006-web/ncec-roadster)
> （`VEHICLE.md`）。整備履歴・熱管理・サーキット走行記録もそちら。
> ここに残すのは **CAN解析を読むための最小限の前提**だけ（意図的な重複）。
> **車両仕様が変わったら、まず向こうを更新してからこの表を追随させる。**

| 項目 | 内容 |
|---|---|
| 車体 | NCロードスター **NCEC 前期型（2005年式）**、MT、**DSC非搭載** |
| エンジン | **後期型の新品エンジンへ載せ替え済み**（ノガミプロジェクトにて施工） |
| ECU | **NOPRO MZ-TUNE+ 仕様のチューン**（同社施工） |

**NOPRO MZ-TUNE+ の内容（ユーザー申告）**
- 低中回転＋中高回転域の点火・燃調の最適化、燃費改善
- **レブリミット 8,000rpm**、スピードリミッター解除
- 全体的なトルクアップ・パワーアップ
- イグニッションブーストマップ
- **メカフィーリングスロットルマップ**
- **電動ファンの作動温度変更**

**CAN解析への影響（実測で確認済み・推定を含む）**
- **`0x200`/`0x215`/`0x201`byte6 のスロットル系がコミュニティ資料の `byte×100/255` に乗らない**
  （実測 `slope=0.4307, intercept=11.13`）。**メカフィーリングスロットルマップにより
  ペダル開度とスロットル開度が意図的にズラしてある**ため（**2026-09-21 に実測で確定**）。
  全域スイープで同定した伝達特性は、実効ストロークで正規化すると
  **`throttle = 1.3541 × pedal − 0.55`（R² = 0.99912）、ペダル 74.3% で全開到達**。
  カーブではなく**ゲイン約1.35倍の直線＋頭打ち**。導出は `ncec_throttle_map.py`、
  詳細と経緯は `docs/design/ncec_can_spec.md` / `docs/research/OBD2_SURVEY.md`。
  なお従来記していた「ゲイン約1.9倍」は**正規化していない生%ポイント比で、過大評価だった**。
- **`0x4FF` がASCII文字列 `DISABLE VIN COMPARE` を分割送信している**。エンジン・ECU載せ替えでは
  PCMと車体側（イモビライザ／メーター）が持つ車台番号が一致しなくなるため、
  **VIN照合を無効化した設定である可能性が高い**（推定、未確認）。ノーマル車で同IDが流れるかは未検証。
- **今回初観測の `0x4F0`/`0x4F1`** は、NC1（前期）向けのコミュニティ資料に記載が無い。
  後期型PCM由来の可能性がある（推定）。
- レブリミット8,000rpmに対し、`0x201` の回転数は `raw/4` で16,383rpmまで表現できるため
  エンコード上の問題は無い。ただし**実測は3,439rpmまでしか確認していない**（高回転域の線形性は未検証）。
- 電動ファンの作動温度変更は、`0x420` byte1/byte3 や `0x212` の未解明ビットを特定する
  **手がかりとして使える**（アイドリングでファンが回り出す瞬間の差分を採る）。

> **運用方針**：コミュニティのNC用CANデータベースは**ノーマルのNC1**が前提のため、今後も食い違いが出る。
> 我々が作るのはこの車のためのロガーなので、**実測を一次情報とし、資料は参考の位置づけとする**。

---

## 2. システム全体アーキテクチャ（Ver.1の構想）

車載ノイズに弱いアナログ入力を排し、車内通信をCANバスに一本化。さらにロガー（マイコン）と表示部（Linux PC）を物理分離する。

```
【センサ・車両側】               【ロガー本体 (堅牢・即時起動)】             【車載ディスプレイ】

 [車両CAN / OBD2] ──┐
                    ├──(CAN-H/L)──> [ ESP32-S3 ] ───(USB/Serial)───> [ Raspberry Pi ]
 [追加センサー] ────┘               │ (ロガー処理/0.1秒起動)             (RaceCapture App)
 (油温/油圧/ブースト)               │
                                    ├──(I2C)───> [ 6軸IMU ]               ※画面がフリーズ・
 [10Hz+ GPS] ───(UART)──────────────┤            (Gフォース/角速度)        熱落ちしてもロガー
 (UTCタイムスタンプ)                │                                      処理は100%継続
                                    └──(SPI)───> [ SDカードモジュール ]
                                                 (スタンドアロン保存)
```

### 詳細データフロー

```
 +-----------------------------------------------------------------------+
 |                            車両・各部センサー                         |
 +-----------------------+-----------------------+-----------------------+
                         |                       |
                 (CAN-H / CAN-L)             (GPS / IMU)
                         |                       |
                         v                       v
 +-----------------------------------------------------------------------+
 |                    【ESP32-S3 メインロガーユニット】                  |
 |                                                                       |
 |   [ FreeRTOS タスク分離 ]                                             |
 |    ├─ タスクA (高優先): CAN/GPS/IMUデータ受信 & リングバッファ書き込み |
 |    ├─ タスクB (最優先): SDカードへの定期 flush() 書き込み (CSV保存)   |
 |    └─ タスクC (低優先): USB/シリアル経由のデータストリーミング出力    |
 +-----------------------------------+-----------------------------------+
                                     |
                          (USB OTG シリアル有線接続)
                                     |
                                     v
 +-----------------------------------------------------------------------+
 |                  【Raspberry Pi 車載ダッシュボード】                  |
 |                                                                       |
 |   ・Linux版 RaceCapture App 起動 (7インチ等のタッチパネル表示)       |
 |   ・ゲージ表示 / RCPストリームで受信した値の表示のみ                  |
 |     （ラップタイム・予測タイムもロガー側で計算された値を受信・表示。 |
 |      アプリ自体がラップ判定/予測計算を行う機能は持たない）            |
 +-----------------------------------------------------------------------+
```

> **訂正（エコシステム調査、`HANDOFF_ecosystem_research_gap.md`より反映）**：公式RaceCaptureエコシステムでは、ラップタイム・予測タイム・シフトライト制御はすべて**ロガー本体（ファームウェア）側で計算・実行**され、RaceCaptureアプリ（Raspberry Pi側含む）はその結果をJSON API経由で受信して表示するだけの「表示・設定クライアント」である。以前の図の「ラップタイマー計算」がRaspberry Pi側の機能であるという記載は誤りだったため、上記の通り訂正した。

---

## 3. 構成要素と技術選定（Ver.1の構想）

| 構成要素 | 採用・選定技術 | 選定理由・技術的メリット |
|---|---|---|
| メインマイコン（本番基板） | ESP32-S3-WROOM-1-N16R8モジュールを基板へ直接実装するフルカスタム設計（logger_v1.net、4章参照）。開発・検証はESP32-S3-DevKitC-1ボードを継続使用 | ピン数に余裕があり、TWAI(CAN)、SPI、UART、USB Serialの同時処理が可能。**USB OTGネイティブ対応が必須要件。** |
| 車両データ入力 | 車両CAN / OBD2 (SN65HVD230等) | エンジン回転数・車速・水温等をデジタル取得。ノイズの影響を受けにくい。 |
| 追加センサー | CANモジュール経由 | 油圧・油温などのアナログ入力を直接ESP32に入れず、CAN化して集約（ESP32のADCノイズ問題回避）。 |
| 挙動計測 | 9軸IMU Bosch BNO055モジュール（UART接続、型番確定。4章参照） | 車両の前後左右G、ロー・ピッチ・ローリング角速度の取得。センサーフュージョン内蔵で磁力計統合済み。 |
| 位置・時刻 | 10Hz以上 GPS (u-blox等) | ラップタイム計測、およびUTCタイムスタンプによるGoPro動画との完全自動同期。 |
| データ保存 | microSD（本番ESP32-S3はネイティブSDMMC 4bitモード、C3試験段階はSPIモード） | 電源ONで即時ロギング。通信状態に関わらずログを確実に残す。SDMMCはSPIより数倍高速で、「記録を絶対に止めない」方針上の最優先事項と判断。C3はSDMMCホスト非搭載のためSPIのみ対応。 |
| 表示ユニット | Raspberry Pi + タッチパネル、またはスマートフォン（両対応の設計とする） | RaceCapture App (Linux版／Android版) を動かし、グラフィカルな車載ダッシュボードとして利用。Raspberry Pi専用機構成は公式RaceCaptureでもサポート済みで、全員がイコールコンディションの専用機として使えるため再現性・信頼性が高い（ライブテレメトリー配信にはセルラー回線契約が別途必要）。スマートフォン活用構成はライブテレメトリー配信時も追加ドングルが不要でコスト面で有利だが、個人端末依存となり環境の統一・信頼性は一歩劣る。いずれの構成でもUSB接続の物理的な固定（ネジ止め式端子等）が接触不良対策として必須。 |
| アプリ間通信プロトコル | RCP JSON API（RaceCapture純正） | 純正アプリをそのまま流用するため、独自プロトコルではなく既存エコシステムに準拠。 |

---

## 4. 現状ステータス（進捗サマリ）
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
