ntakao2006-web/RaceCapture/SPEC.md

# EcoLogger Ver.2 仕様書（2026-11-13）

> 既存の資料と、2026-11-08にSUGOを走った形から起こし、2026-11-13にユーザーが決めたこと（9章）を入れました。
> 4章の「いま」の列は、同じ日にソースと本体の控え（11/10）で確かめ直しました（SP-1）。**実機と画面を動かしては見ていません。** 「ソースからの判断」「疑い」と書いた所は、作り直すときに実物で確かめます。

## 0. この文書の役目

- **書いてあること**：このロガーが「誰に・どの場面で・何をできるようにするか」（要求）。
- **書いていないこと**：いまの進み具合と作業の順番（`ARCHITECTURE.md` 4章・5章）、回路やソフトの中身（`v2_hardware_overview.html`、各フォルダーの`README.md`）。
- **使い方**：道具や画面を足す・直す・やめるときは、まずここの要求に当てはめる。当てはまる要求が無ければ、道具より先に要求を足すかどうかを決める。
- `ARCHITECTURE.md` の1〜3章は Ver.1（ESP32-S3＋純正RaceCaptureアプリ）を考えたときの構想で、いまの本番機（Ver.2）の要求はこの文書が正。

## 1. 目的と範囲

**目的**：走っている車の様子を、止めずに記録し、ドライバーとピットへその場で見せ、走り終えたら誰でも持ち帰って見返せるようにする。

**対象**

| もの | 中身 |
|---|---|
| ロガー本体 | Ver.2（Arduino UNO Q＋UPS＋シールド logger_v2） |
| 車 | ロードスター NCEC（サーキット）、エコランの車両。車を替えるのは「設定を選ぶ」で済ませる |
| 車の中（サーキット） | 車載画面（DASH）、カメラ（計器を焼き込んだ録画）、予備の車載画面（スマホ） |
| 車の中（エコラン） | スマホの画面だけ（モニターとカメラは載せない。10/24と同じ形） |
| ピット | LTEで届いた値のグラフ・地図・周回表（自宅のサーバー） |
| PC | 本体の状態を見る・回収・設定・解析・動画の切り出し |

**範囲外**（10章）：Ver.1、カート用ロガー、ダッシュカム、ピットとの通話。
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
