ntakao2006-web/RaceCapture/circuit/logger_v1K/verification/mcu_pinout.png

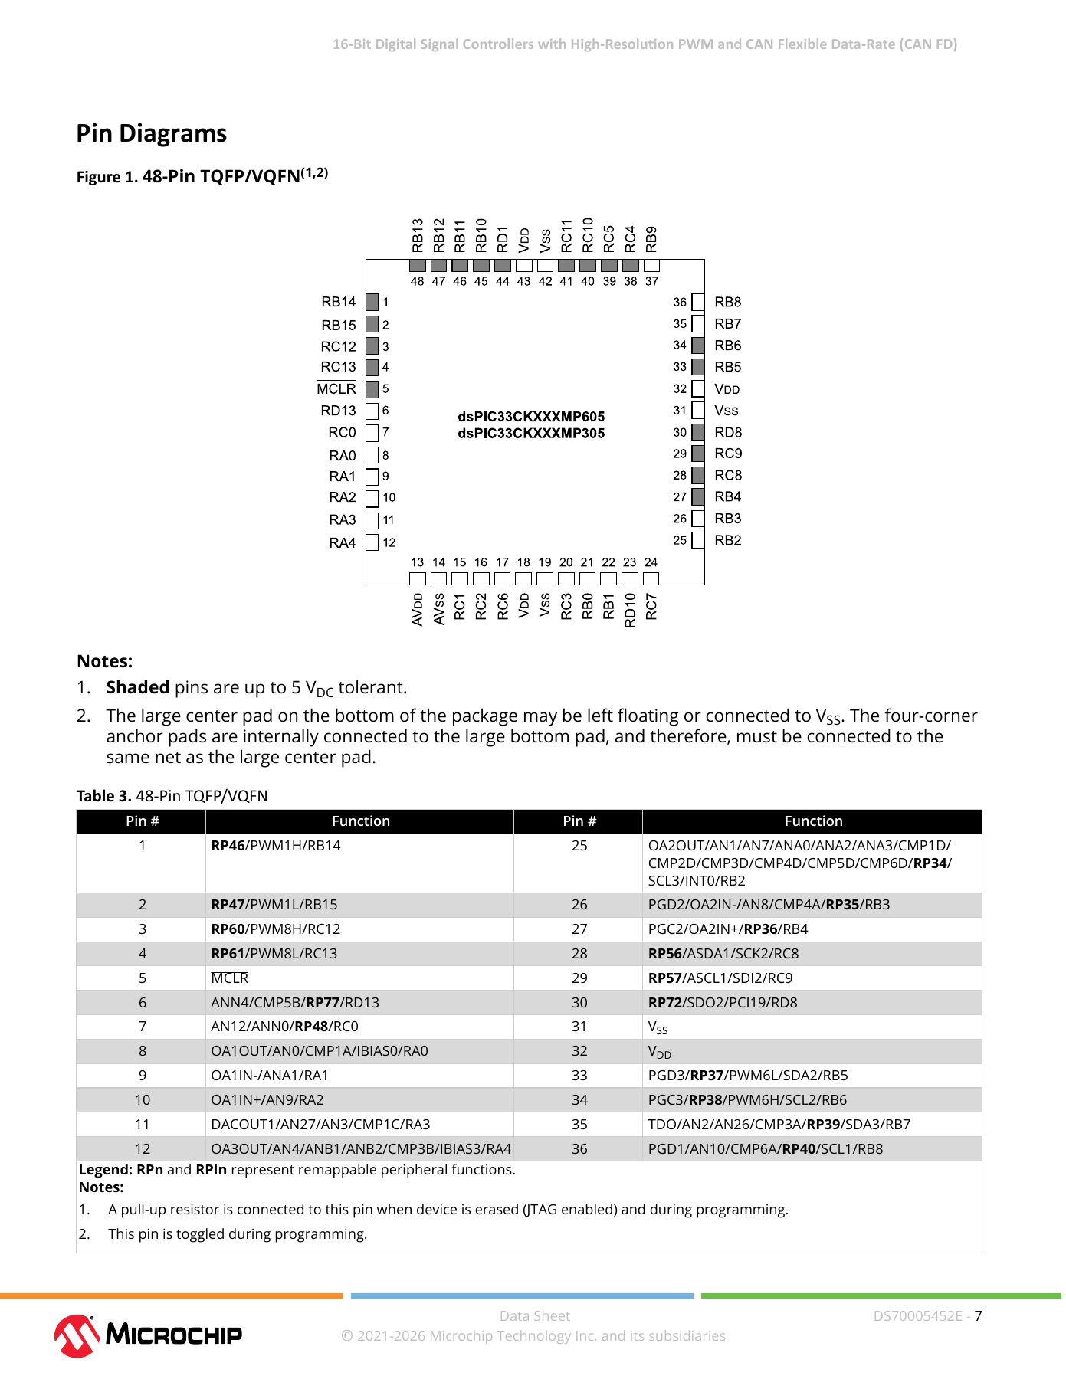
circuit/logger_v1K/verification/mcu_pinout.png
