ntakao2006-web/RaceCapture/circuit/logger_v2/output/aluminum_polymer_review.png

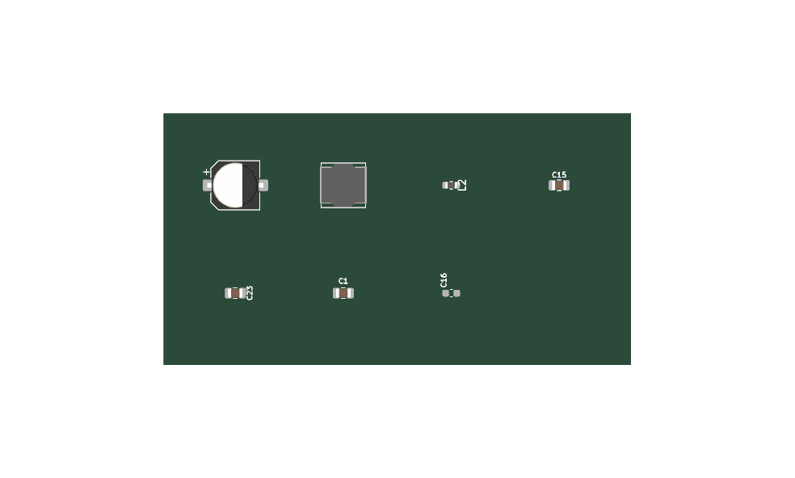
circuit/logger_v2/output/aluminum_polymer_review.png
