ntakao2006-web/RaceCapture/circuit/logger_v2/output/AP63301_3D.png

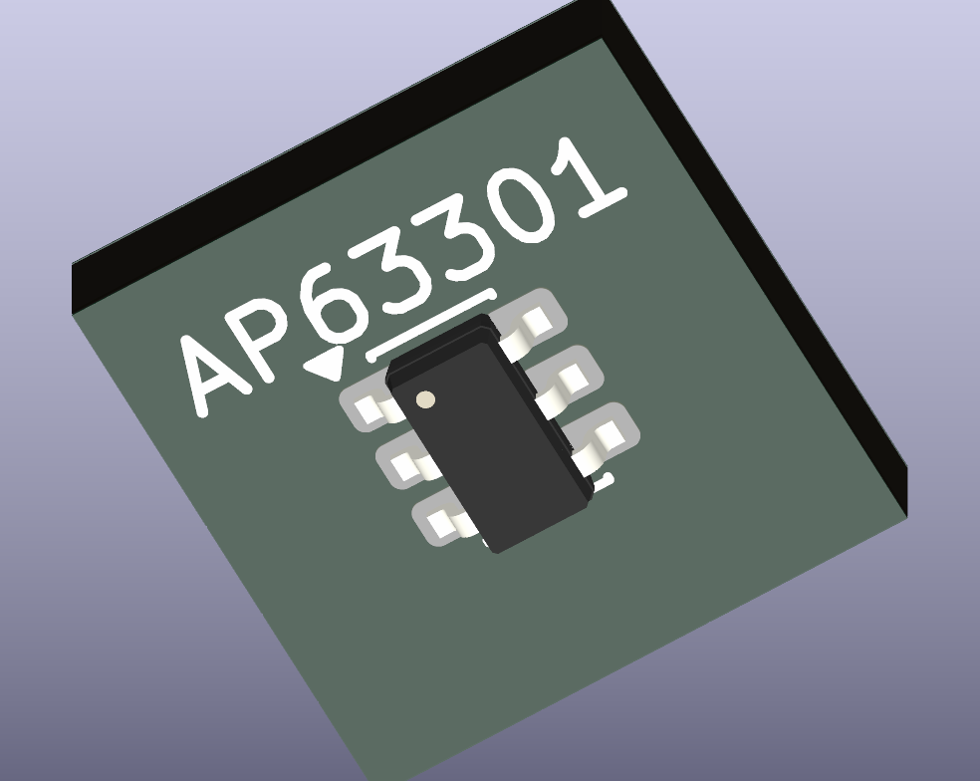
circuit/logger_v2/output/AP63301_3D.png
