ntakao2006-web/RaceCapture/circuit/logger_v2/output/AP63301_symbol.png

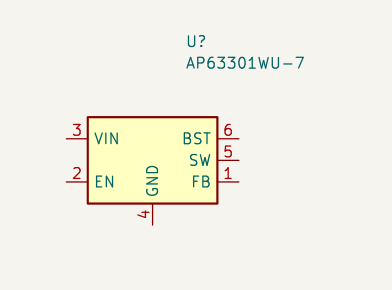
circuit/logger_v2/output/AP63301_symbol.png
