ntakao2006-web/RaceCapture/circuit/logger_v2/output/before_lte_sd_20260919.png

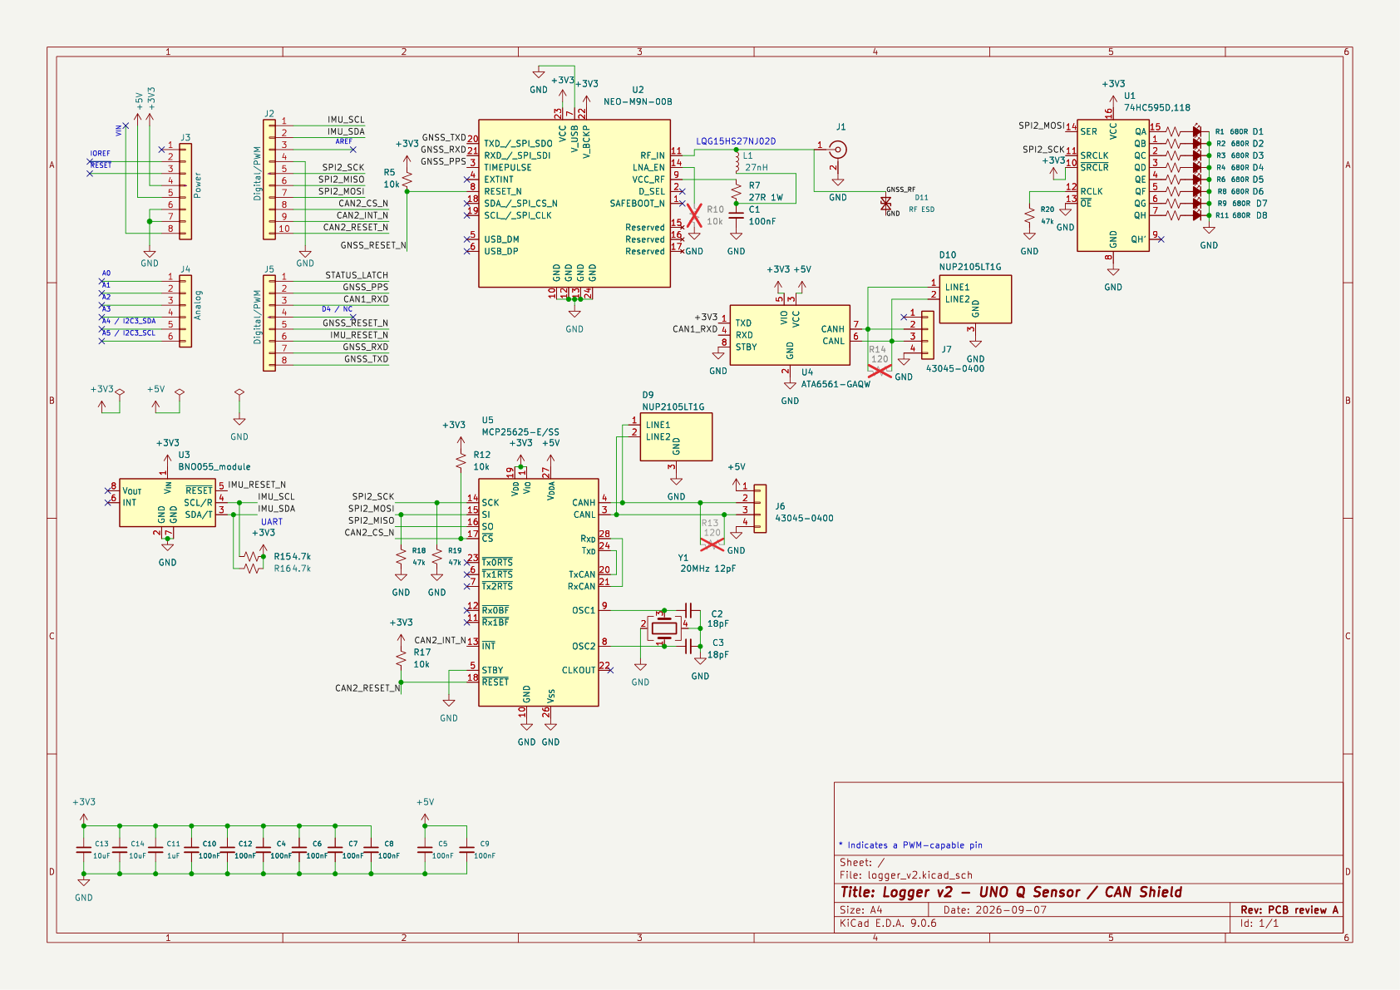
circuit/logger_v2/output/before_lte_sd_20260919.png
