ntakao2006-web/RaceCapture/circuit/logger_v2/output/can.png

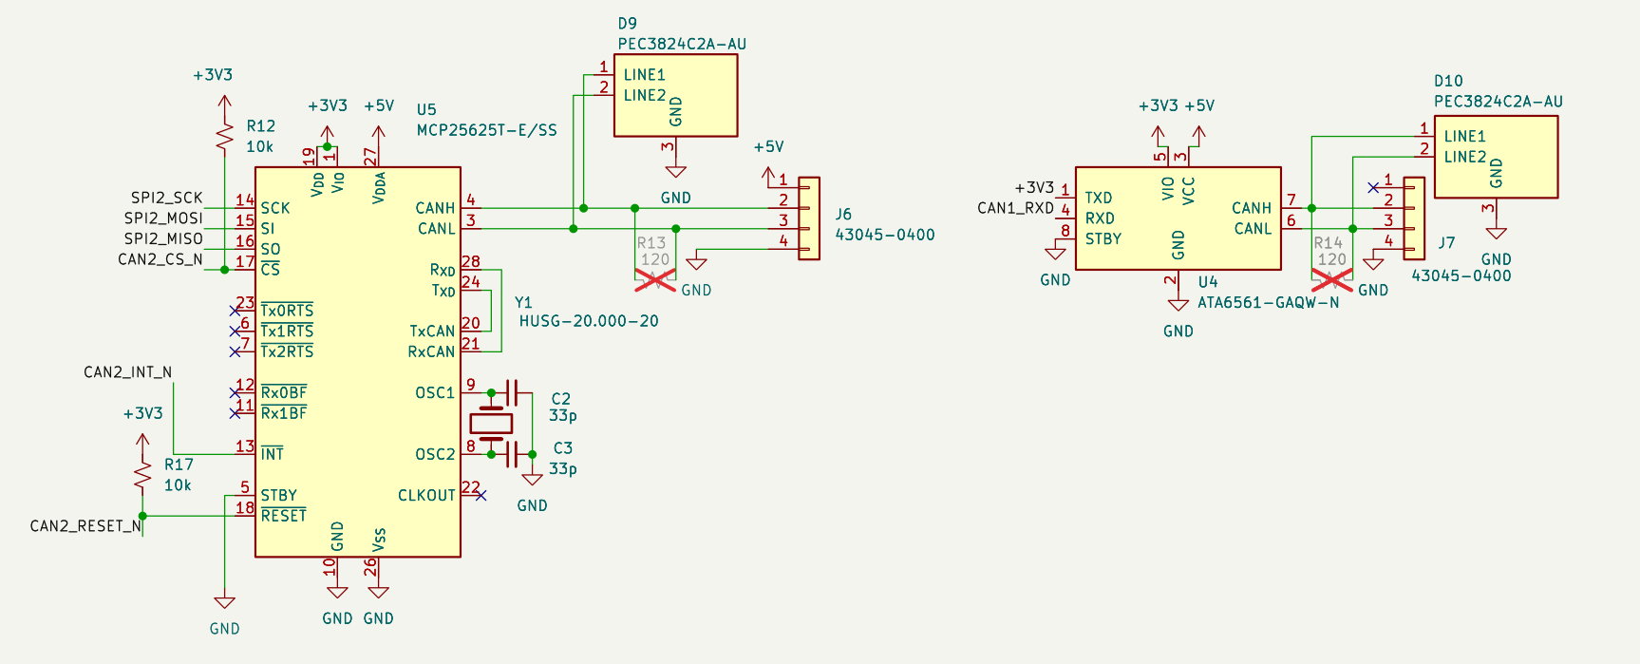
circuit/logger_v2/output/can.png
