ntakao2006-web/RaceCapture/circuit/logger_v2/output/design_review_20260907/BNO055_i2c_reference.png

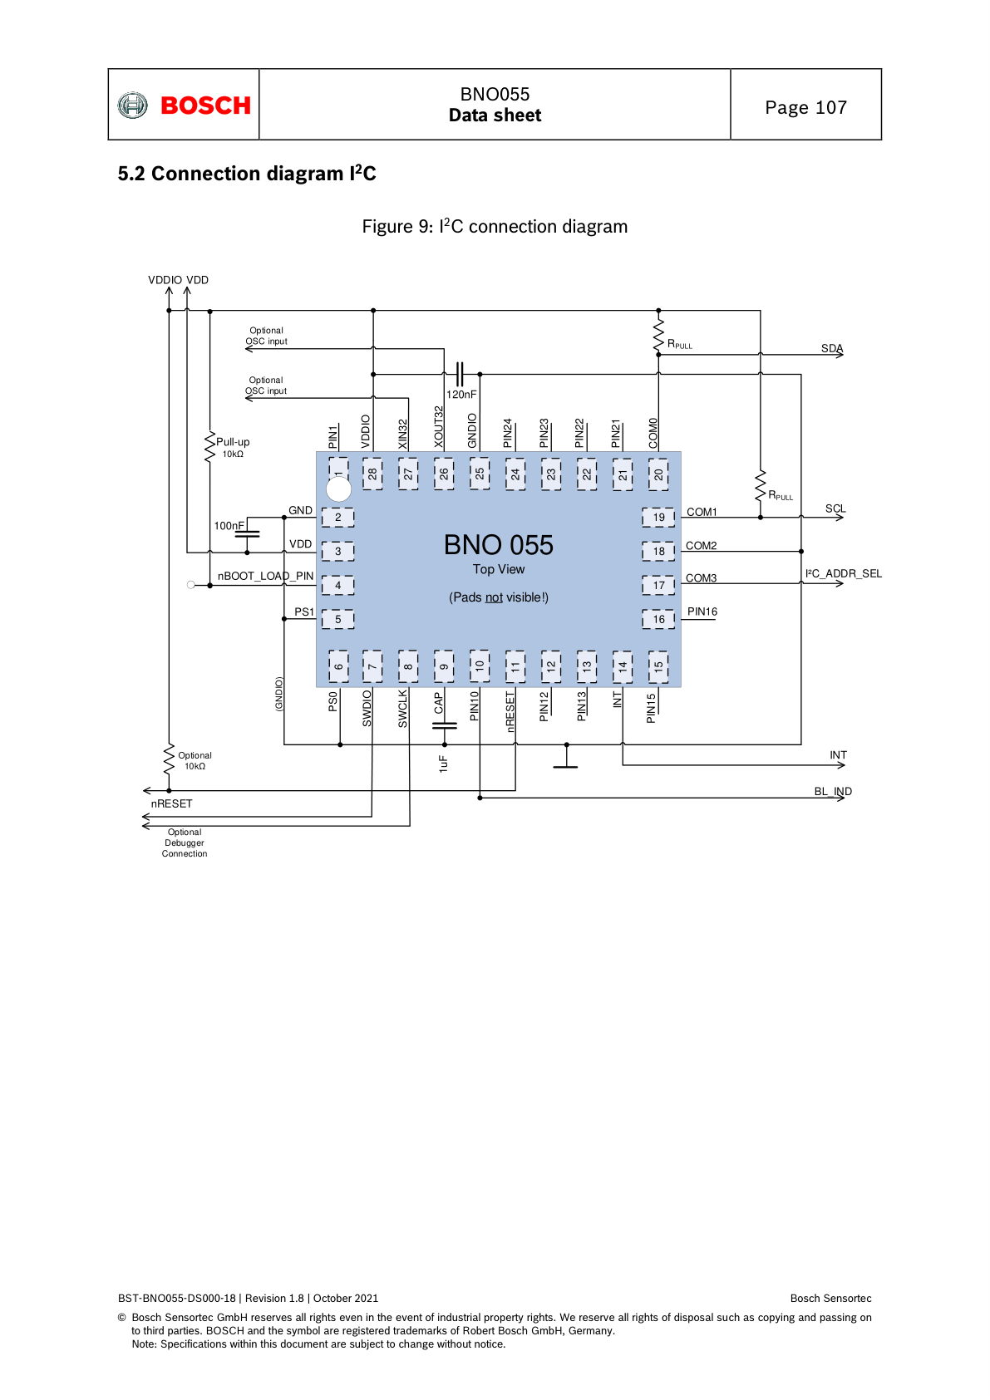
circuit/logger_v2/output/design_review_20260907/BNO055_i2c_reference.png
