ntakao2006-web/RaceCapture/circuit/logger_v2/output/design_review_20260907/placement_top.png

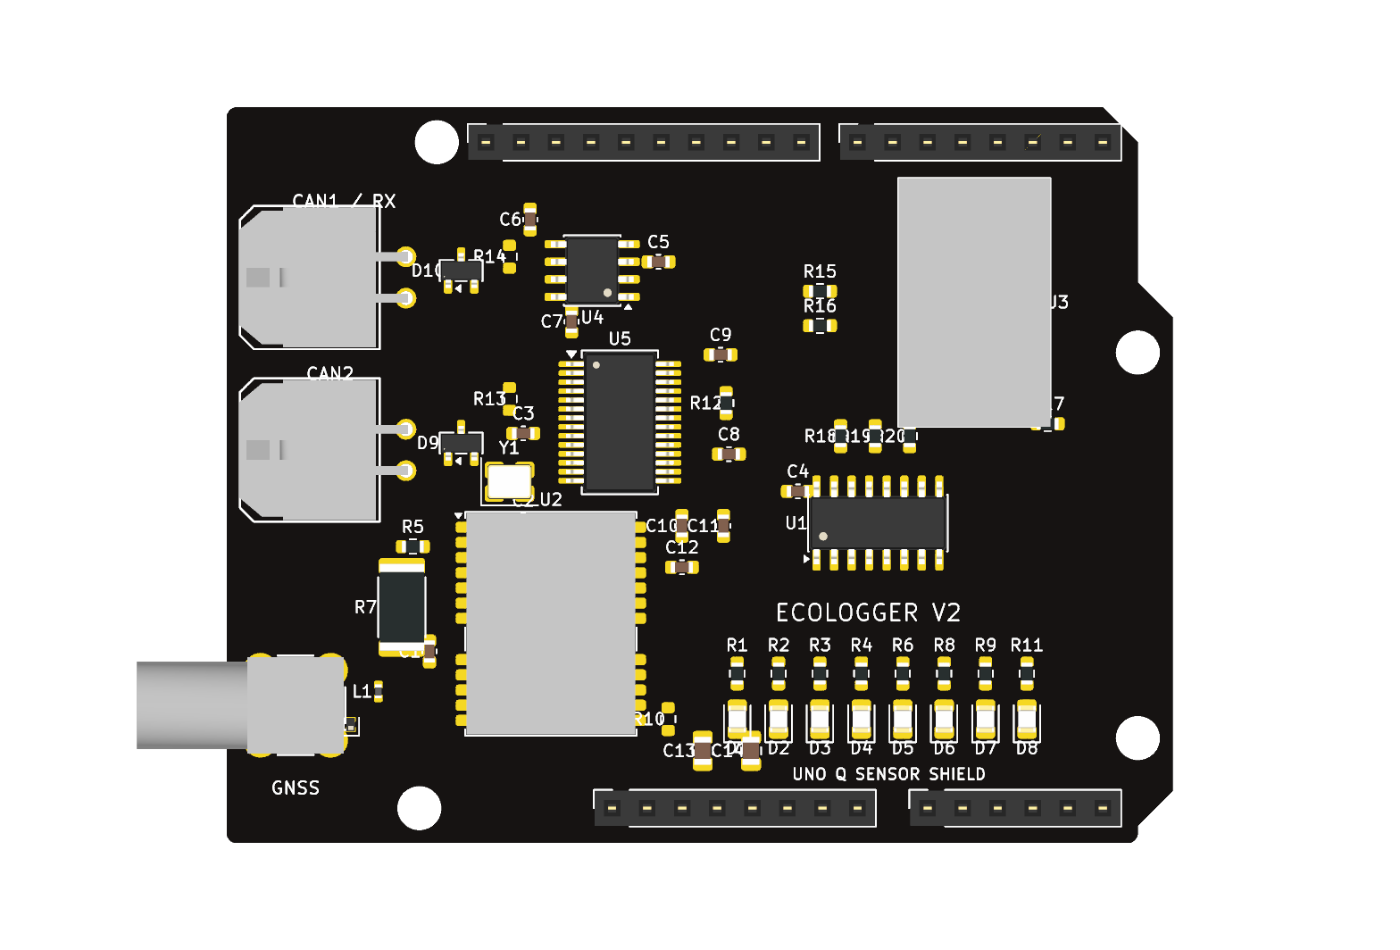
circuit/logger_v2/output/design_review_20260907/placement_top.png
