ntakao2006-web/RaceCapture/circuit/logger_v2/output/design_review_20260907/Y1_XC2EL89COO_datasheet.png

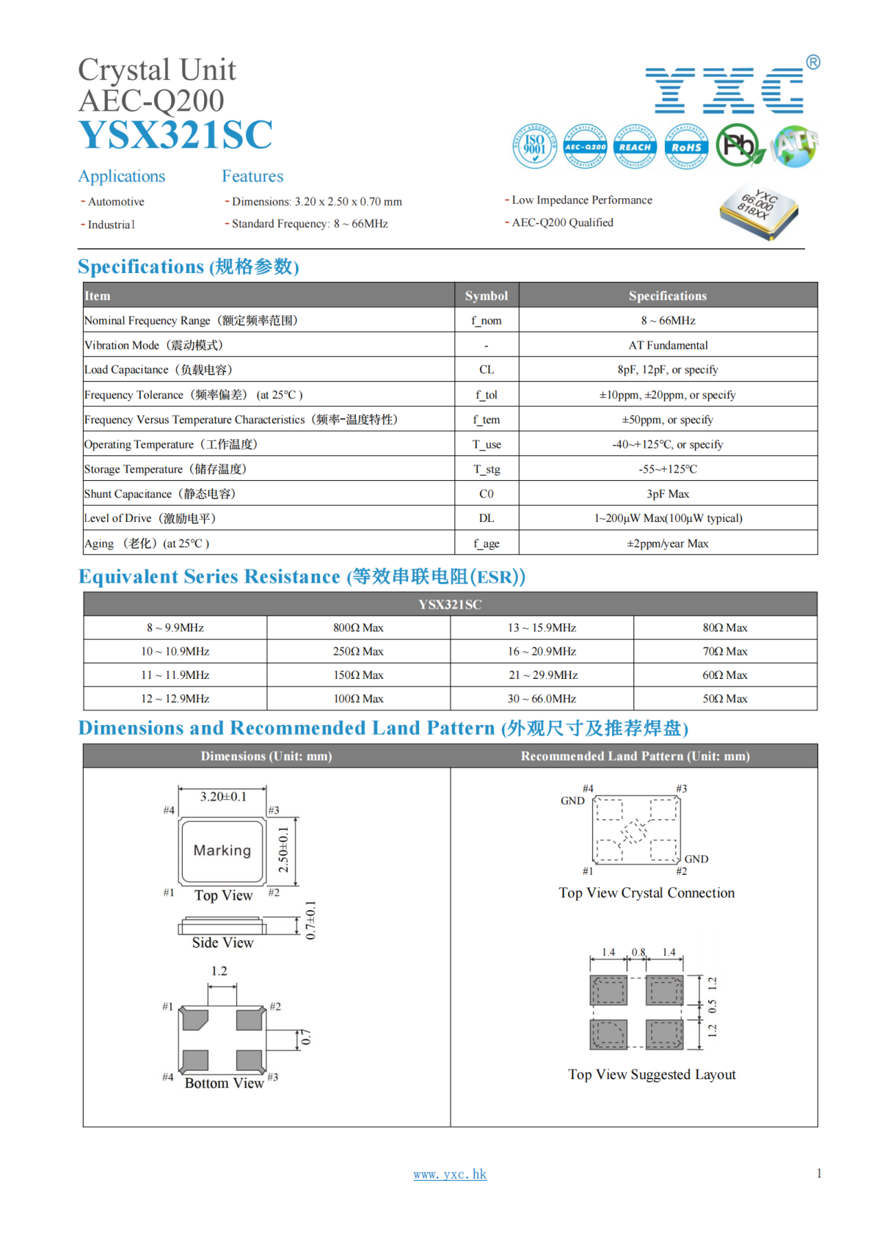
circuit/logger_v2/output/design_review_20260907/Y1_XC2EL89COO_datasheet.png
