ntakao2006-web/RaceCapture/circuit/logger_v2/output/DFE252012P_datasheet.png

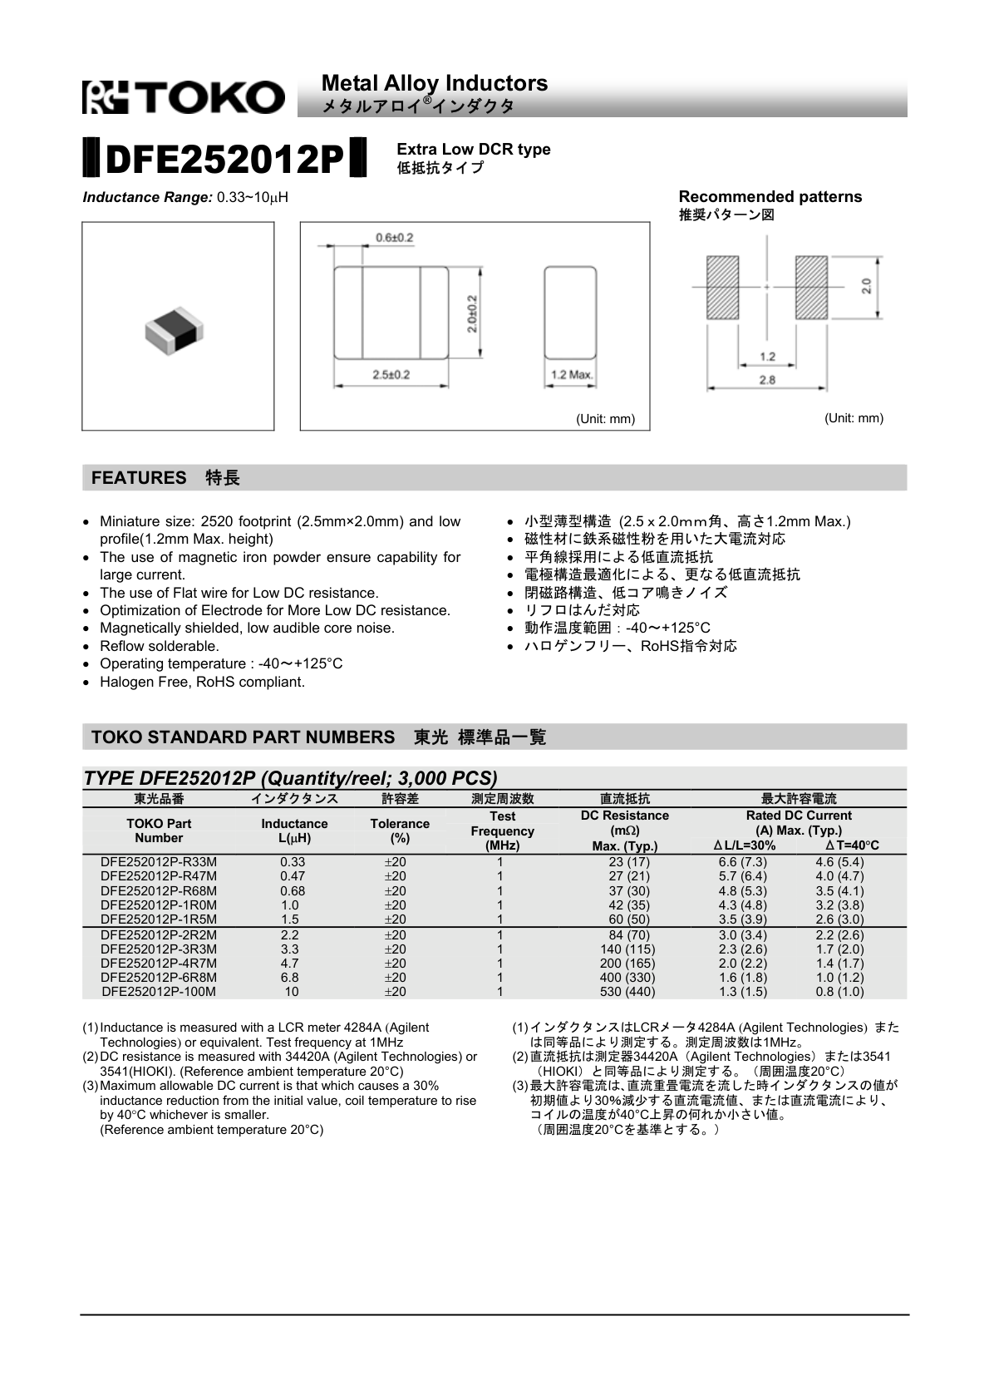
circuit/logger_v2/output/DFE252012P_datasheet.png
