ntakao2006-web/RaceCapture/circuit/logger_v2/output/gnss.png

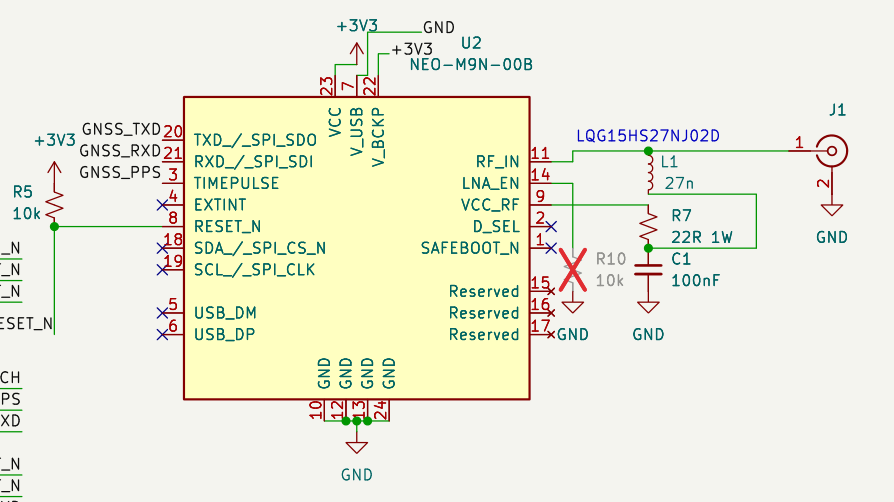
circuit/logger_v2/output/gnss.png
