ntakao2006-web/RaceCapture/circuit/logger_v2/output/headers.png

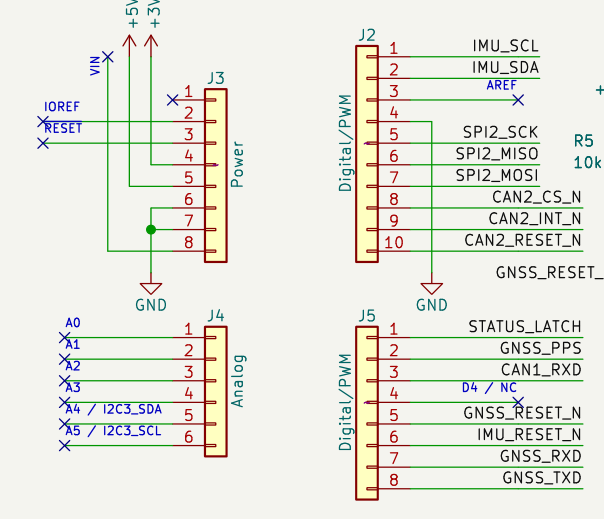
circuit/logger_v2/output/headers.png
