ntakao2006-web/RaceCapture/circuit/logger_v2/output/logger_v2.png

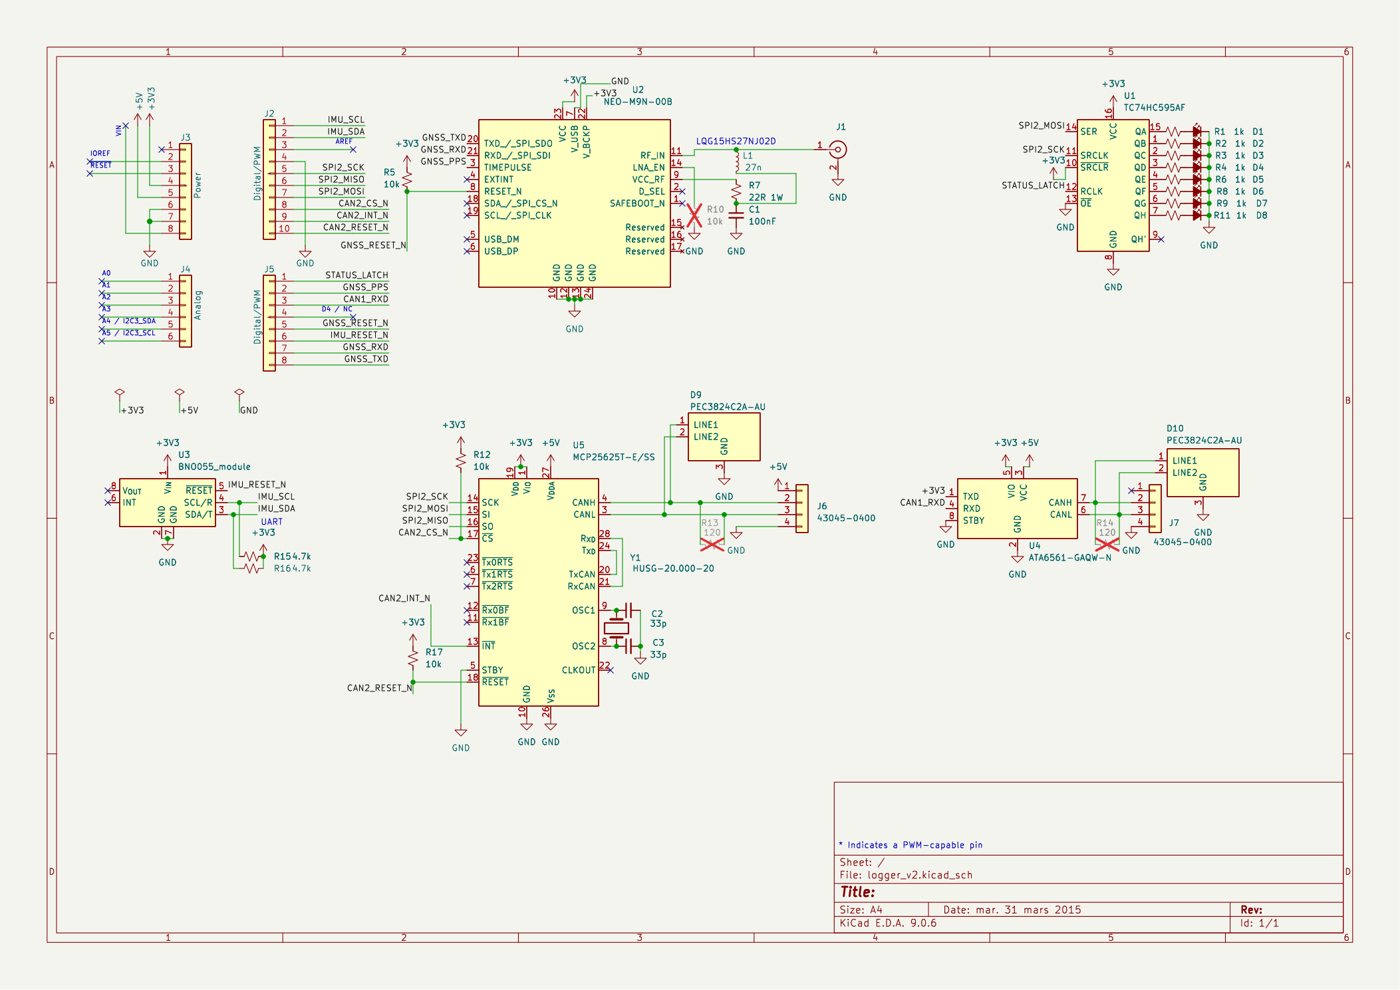
circuit/logger_v2/output/logger_v2.png
