ntakao2006-web/RaceCapture/circuit/logger_v2/output/logger_v2_lte_sd_selection.png

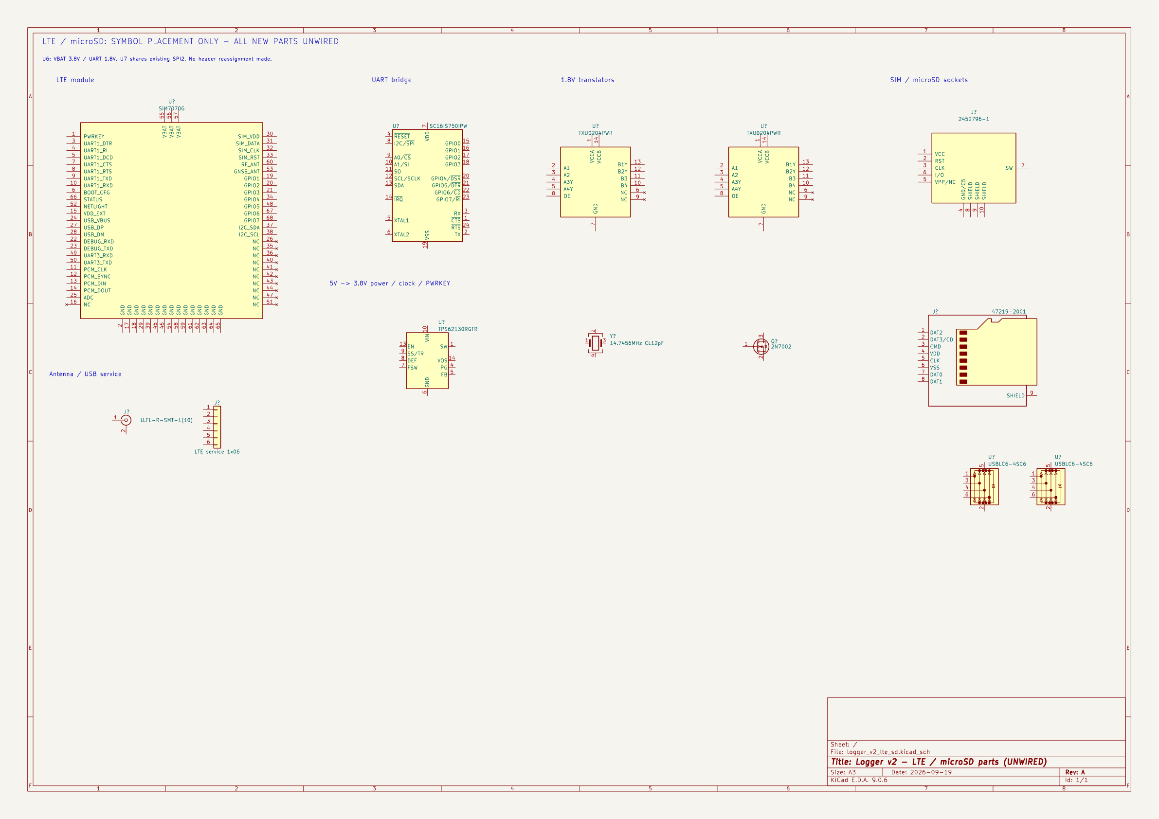
circuit/logger_v2/output/logger_v2_lte_sd_selection.png
