ntakao2006-web/RaceCapture/circuit/logger_v2/output/lte_sd_models.png

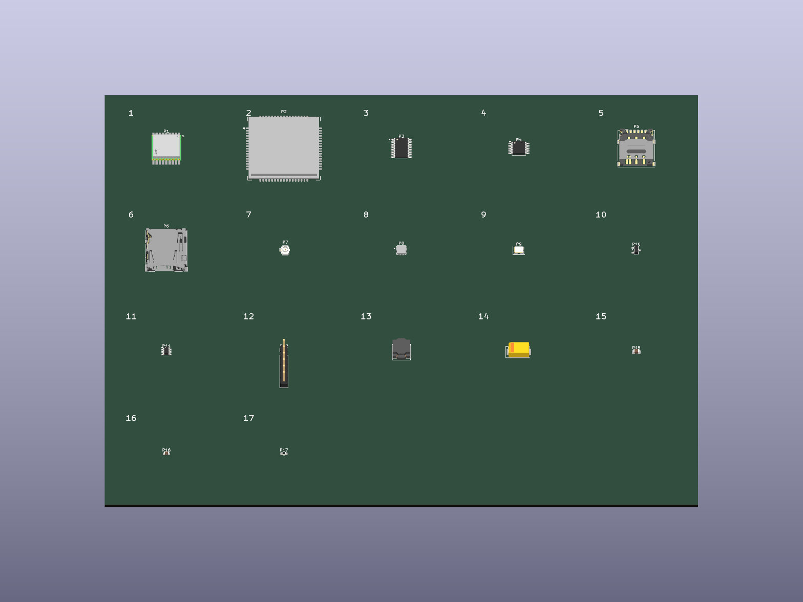
circuit/logger_v2/output/lte_sd_models.png
