ntakao2006-web/RaceCapture/circuit/logger_v2/output/lte_sd_sheet_2.png

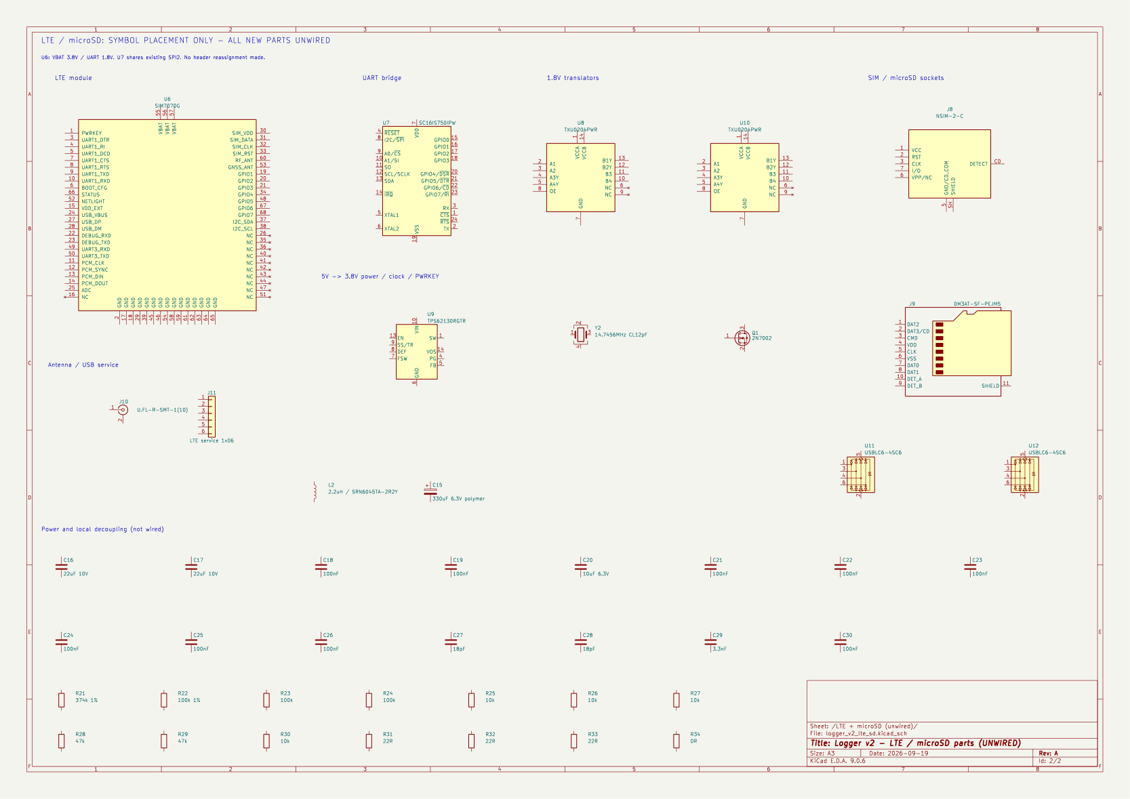
circuit/logger_v2/output/lte_sd_sheet_2.png
