ntakao2006-web/RaceCapture/circuit/logger_v2/output/model_catalog.png

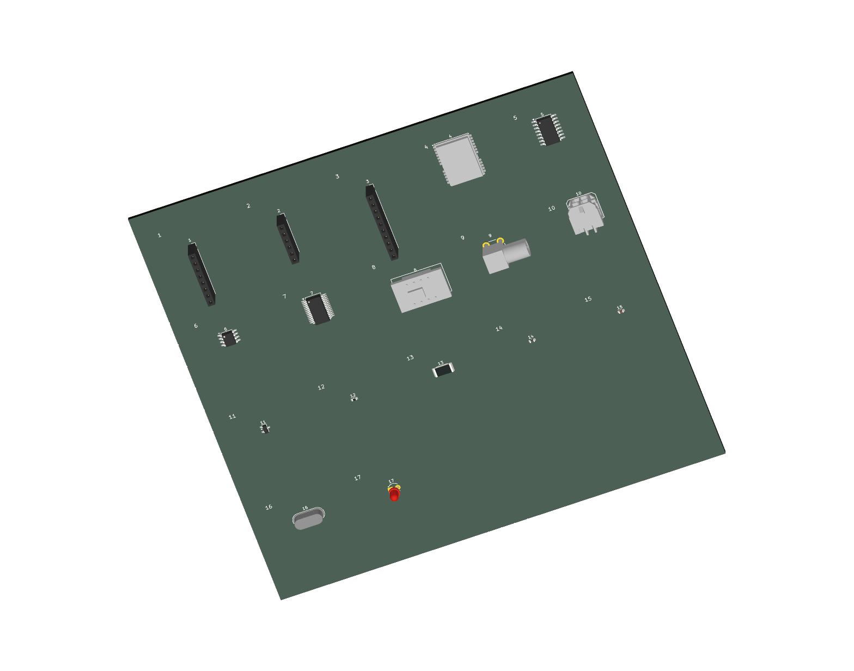
circuit/logger_v2/output/model_catalog.png
