ntakao2006-web/RaceCapture/circuit/logger_v2/output/model_colors_board_20260922.png

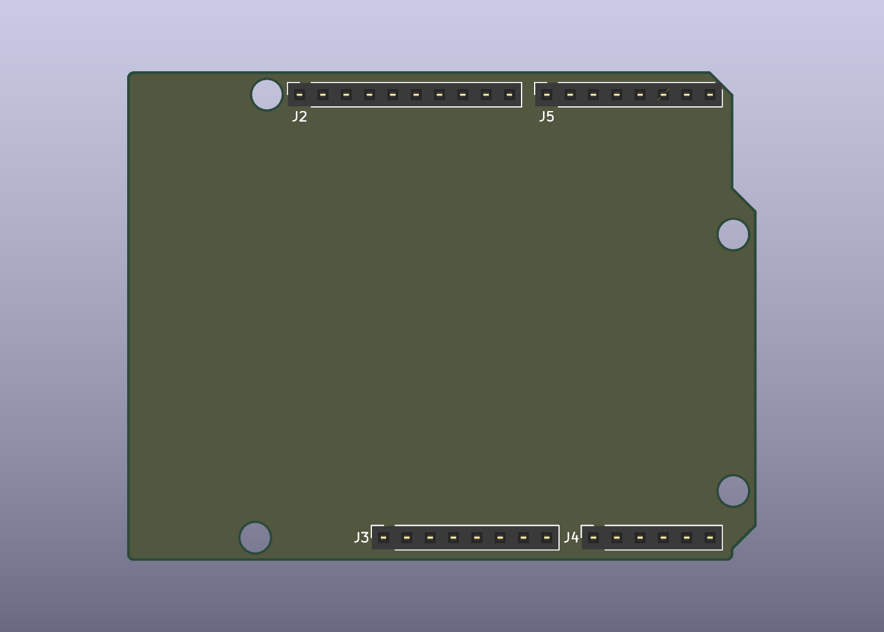
circuit/logger_v2/output/model_colors_board_20260922.png
