ntakao2006-web/RaceCapture/circuit/logger_v2/output/original_layout.png

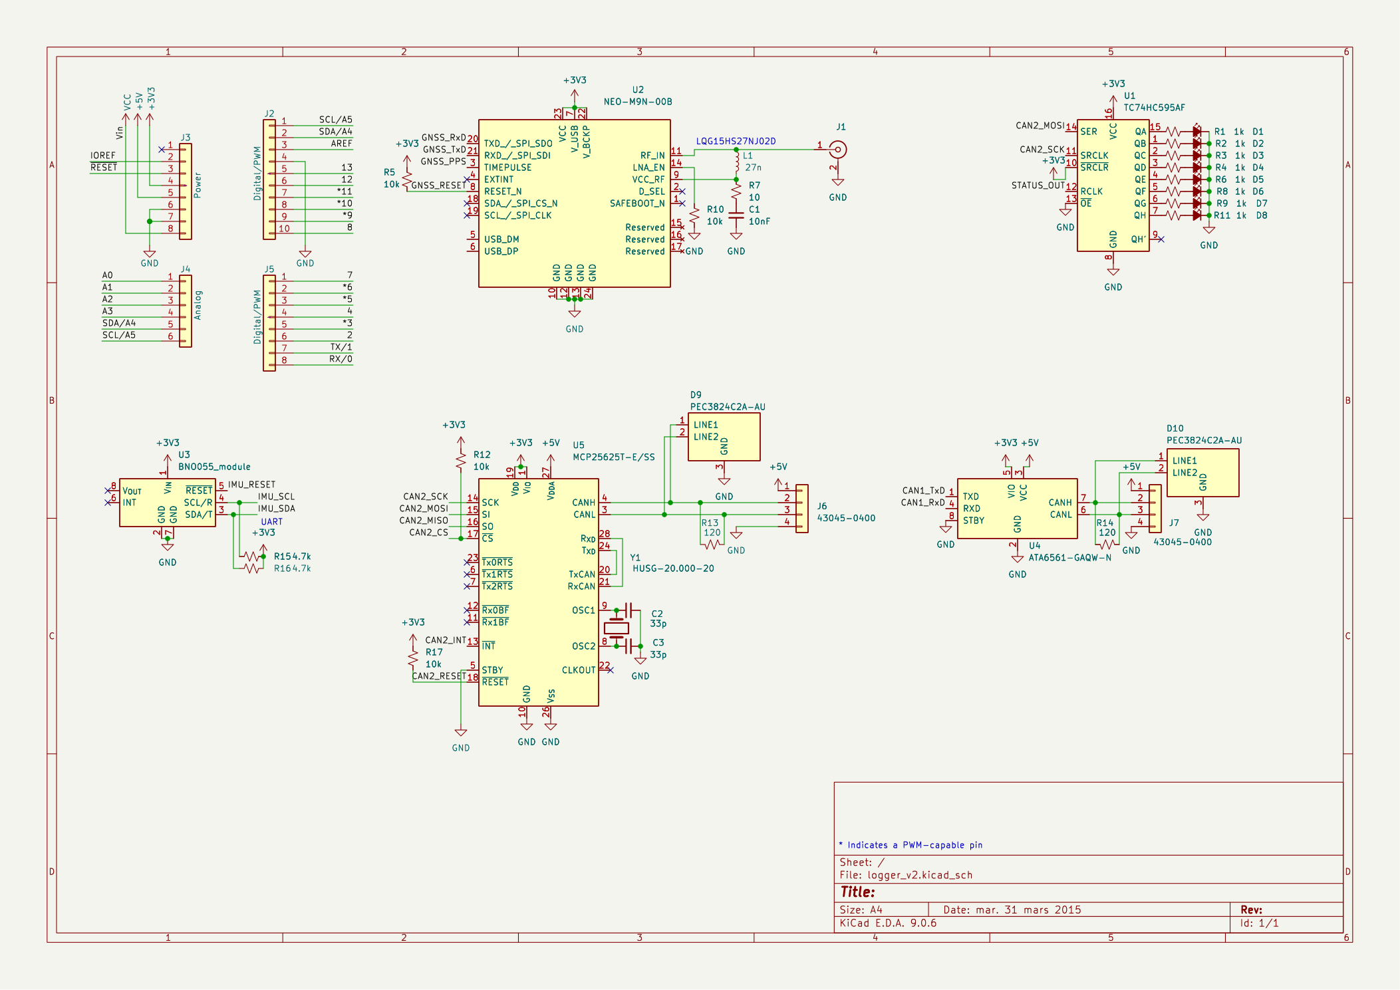
circuit/logger_v2/output/original_layout.png
