ntakao2006-web/RaceCapture/circuit/logger_v2/output/selected_footprints_3D.png

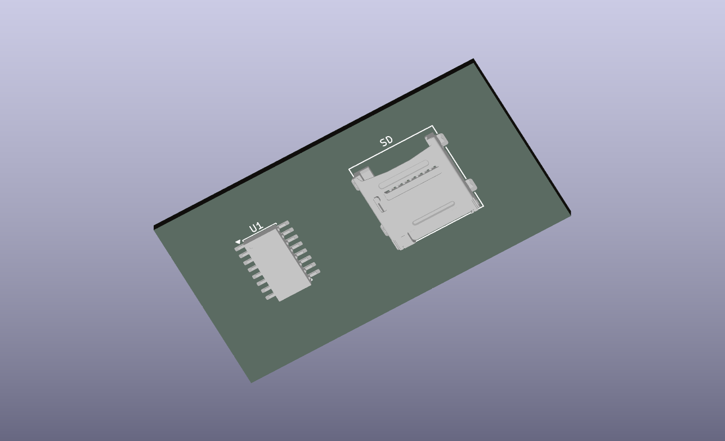
circuit/logger_v2/output/selected_footprints_3D.png
