ntakao2006-web/RaceCapture/circuit/logger_v2/output/selection_led.png

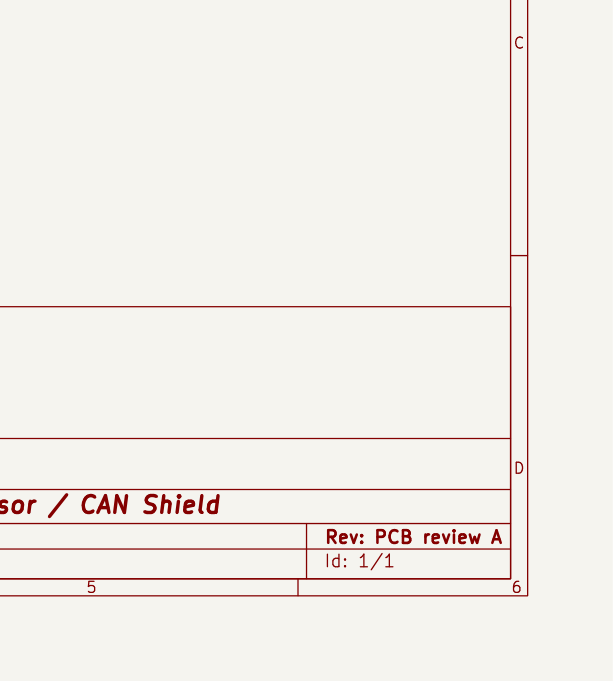
circuit/logger_v2/output/selection_led.png
