ntakao2006-web/RaceCapture/circuit/logger_v2/output/sim_supply_review.png

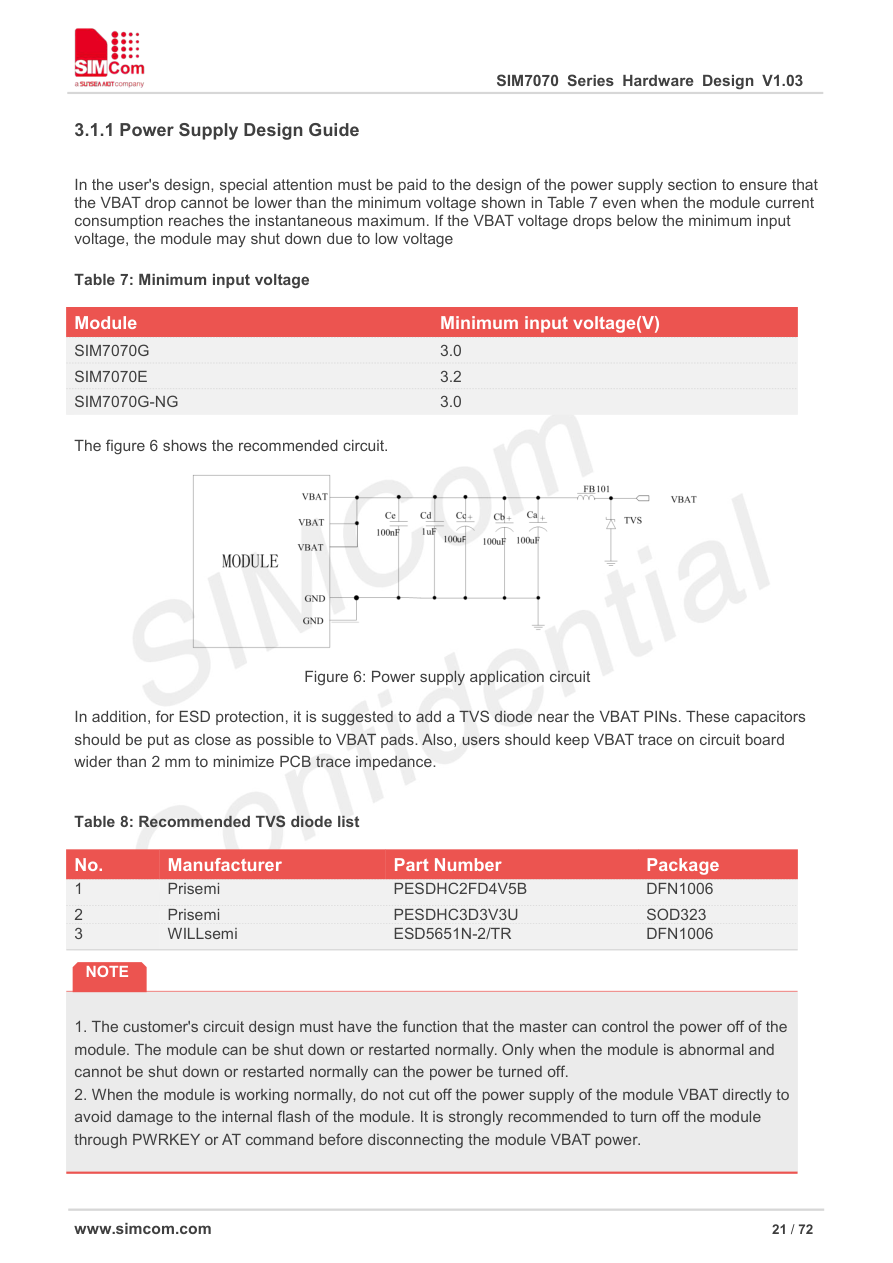
circuit/logger_v2/output/sim_supply_review.png
