ntakao2006-web/RaceCapture/circuit/logger_v2/output/status.png

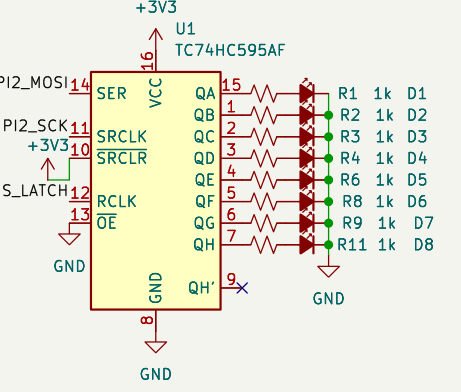
circuit/logger_v2/output/status.png
