ntakao2006-web/RaceCapture/circuit/logger_v2/output/TE_2452796-1_symbol.png

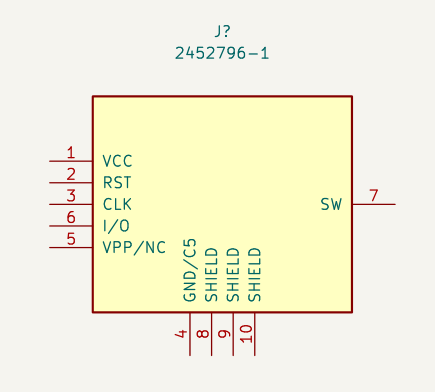
circuit/logger_v2/output/TE_2452796-1_symbol.png
