ntakao2006-web/RaceCapture/circuit/logger_v2/output/TE_land_detail2.png

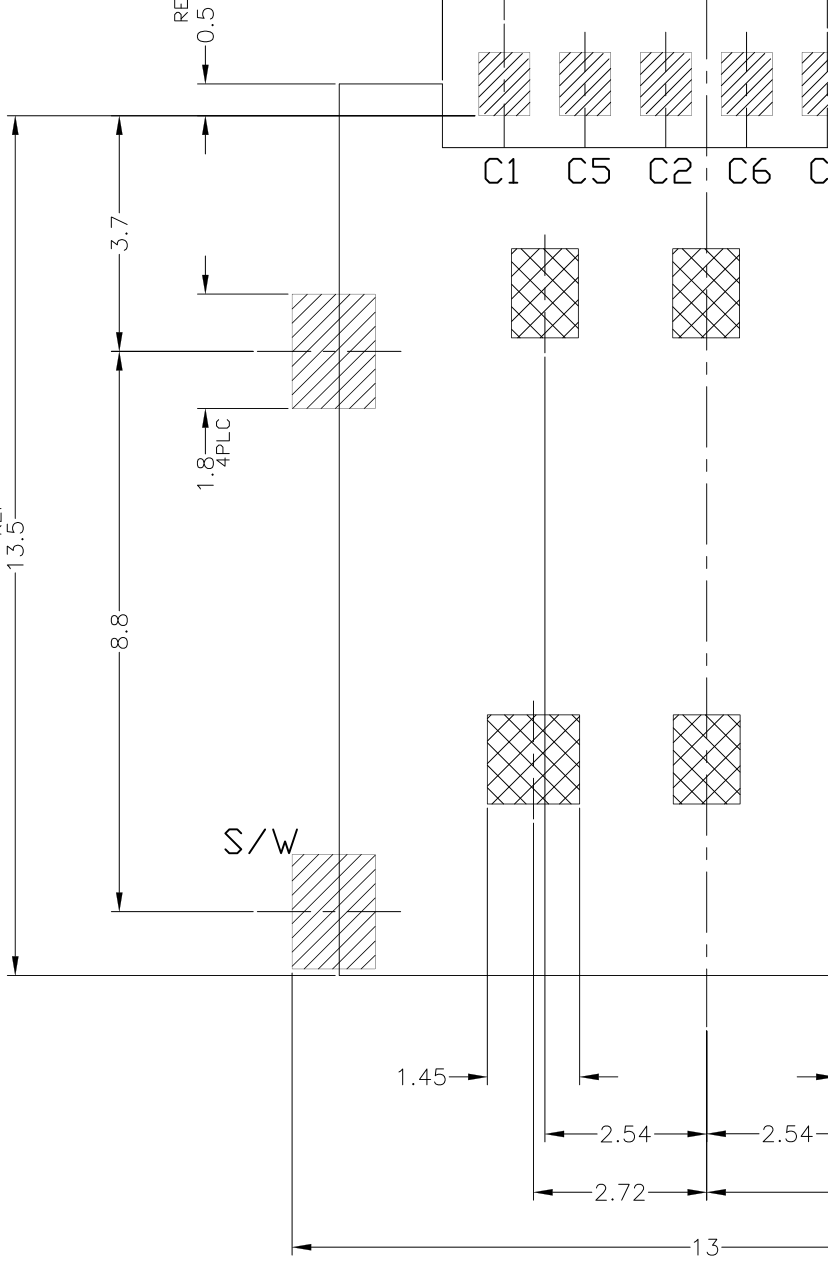
circuit/logger_v2/output/TE_land_detail2.png
