ntakao2006-web/RaceCapture/circuit/logger_v2/output/text_normalized_20260922/logger_v2.png

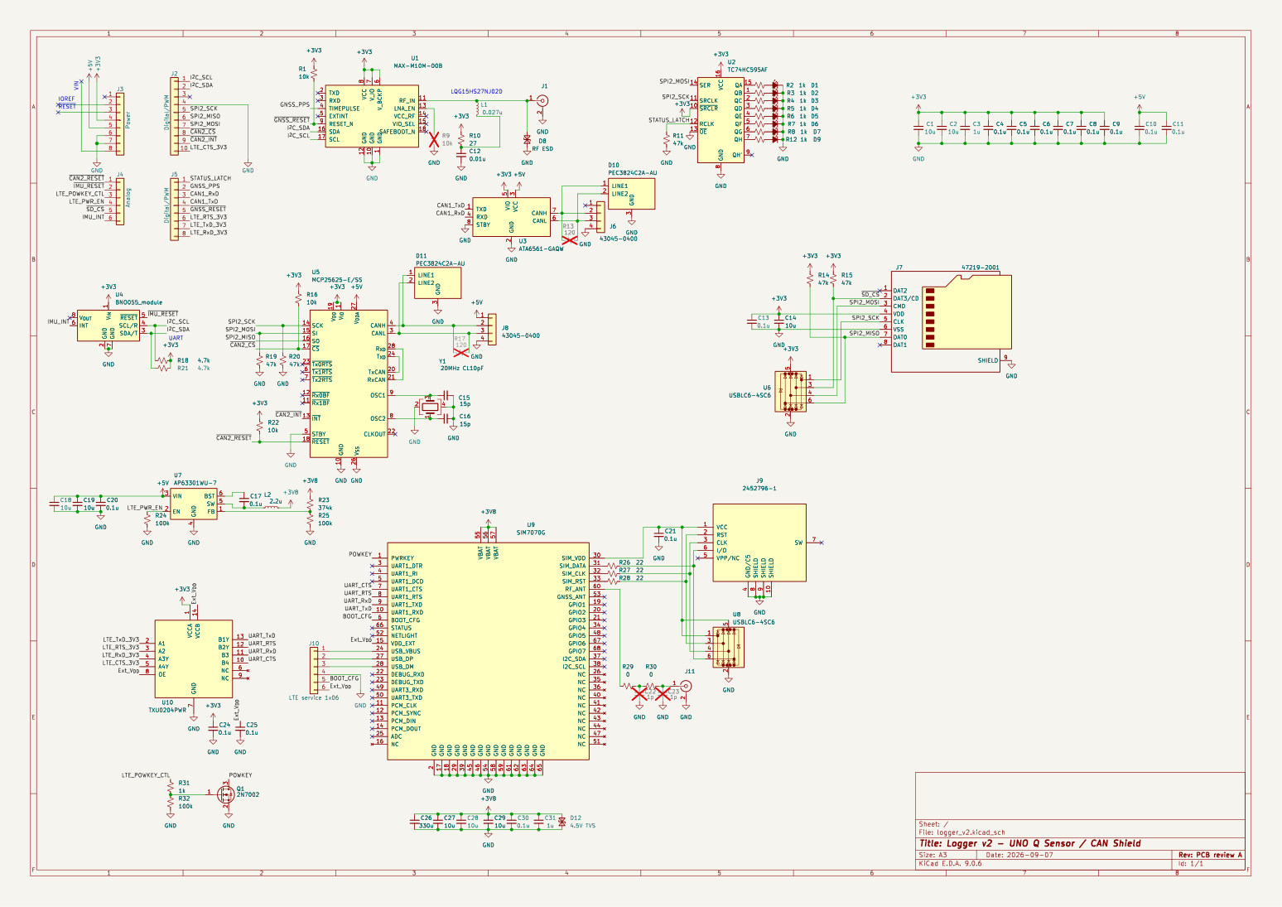
circuit/logger_v2/output/text_normalized_20260922/logger_v2.png
