ntakao2006-web/RaceCapture/circuit/logger_v2/refs/AE-BNO055-BO.png

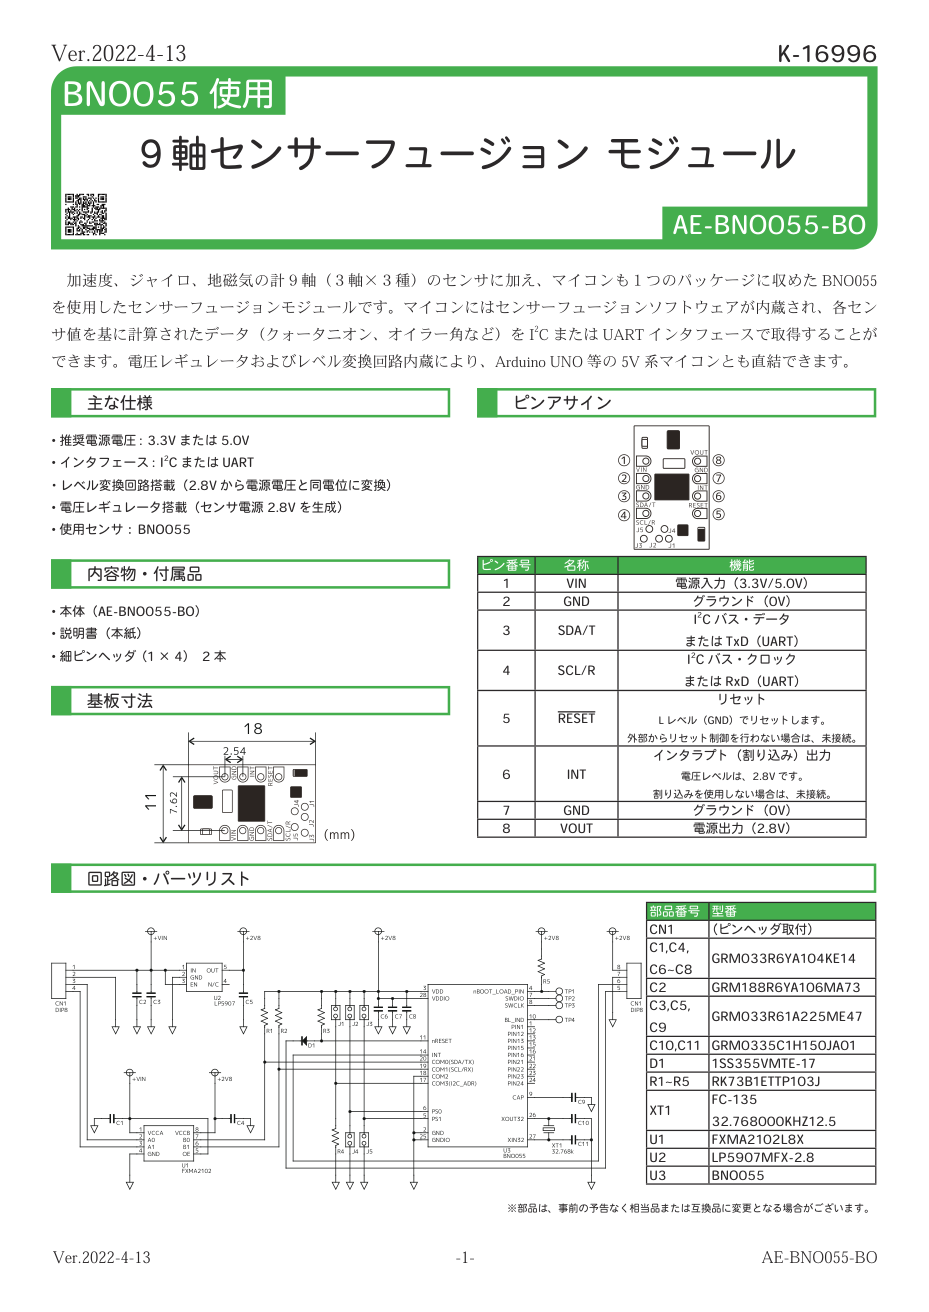
circuit/logger_v2/refs/AE-BNO055-BO.png
