ntakao2006-web/RaceCapture/circuit/logger_v2/refs/MAX_M10_typical85.png

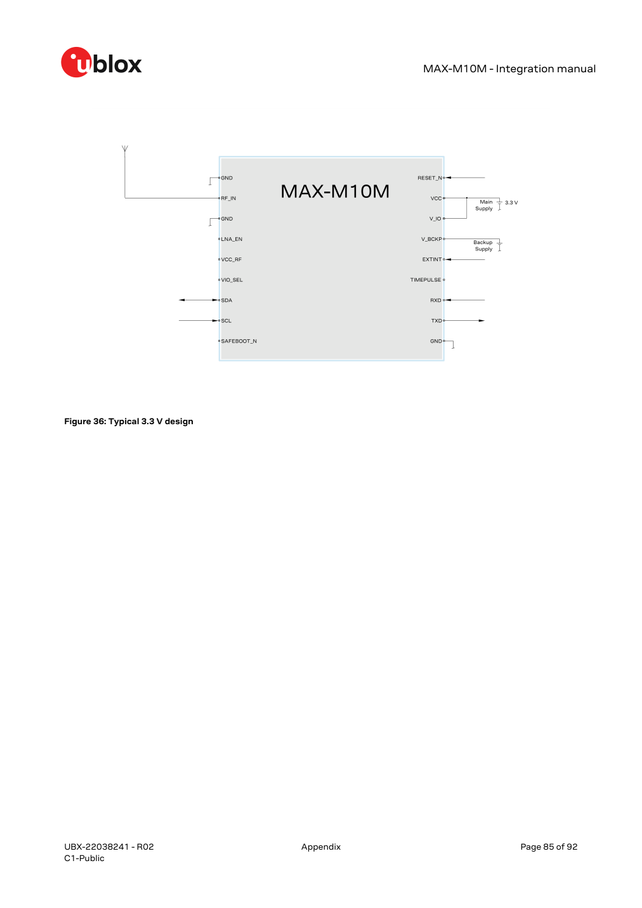
circuit/logger_v2/refs/MAX_M10_typical85.png
