ntakao2006-web/RaceCapture/circuit/logger_v2/refs/NEO-M9N.png

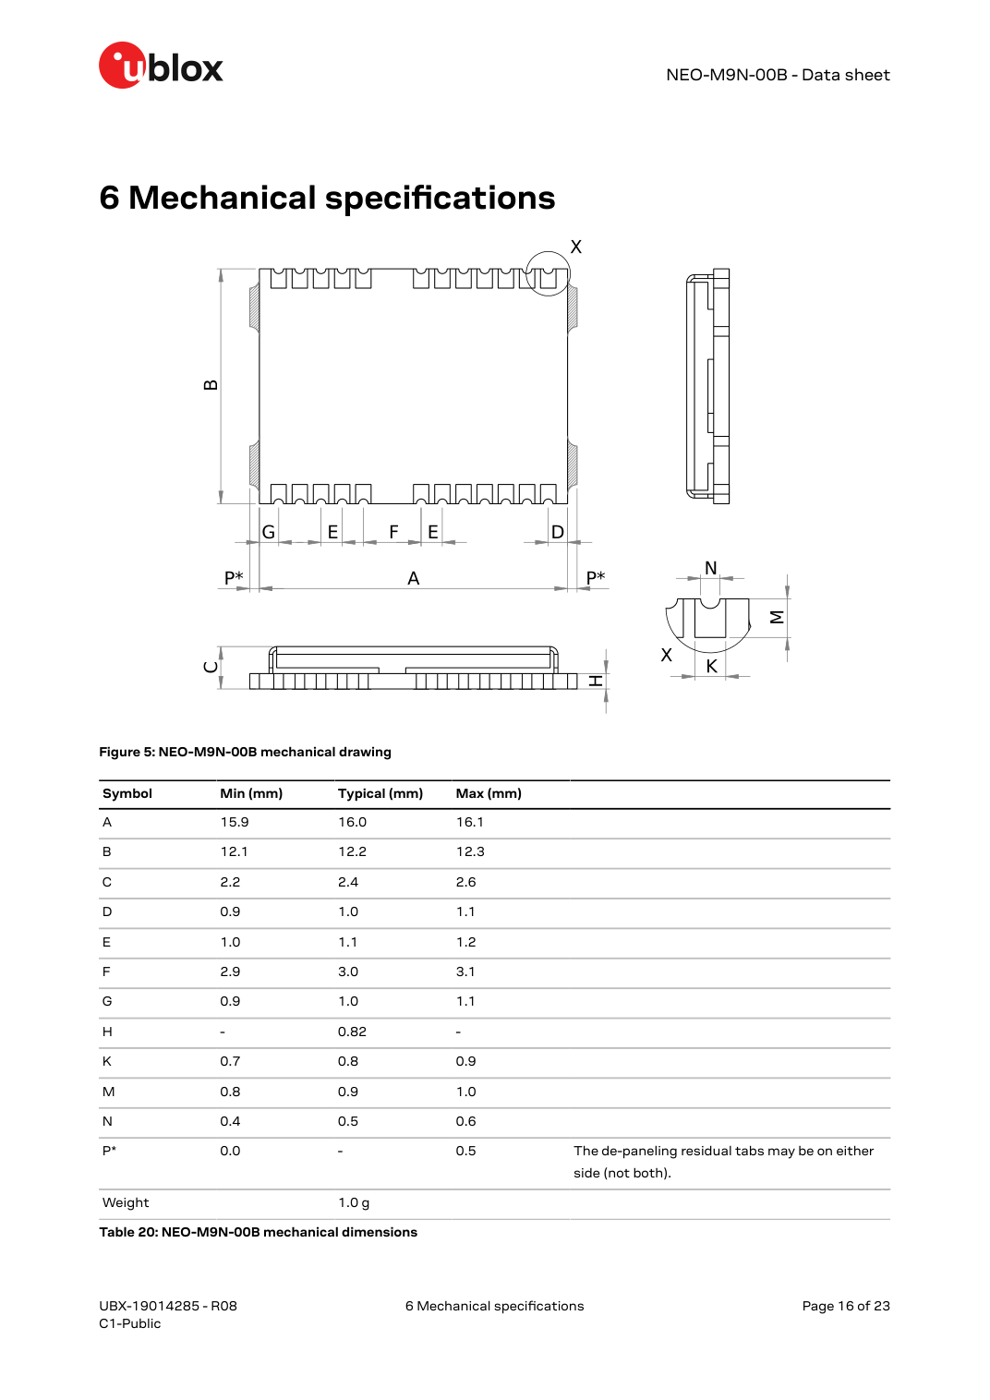
circuit/logger_v2/refs/NEO-M9N.png
