ntakao2006-web/RaceCapture/circuit/logger_v2/refs/NSIM_2.png

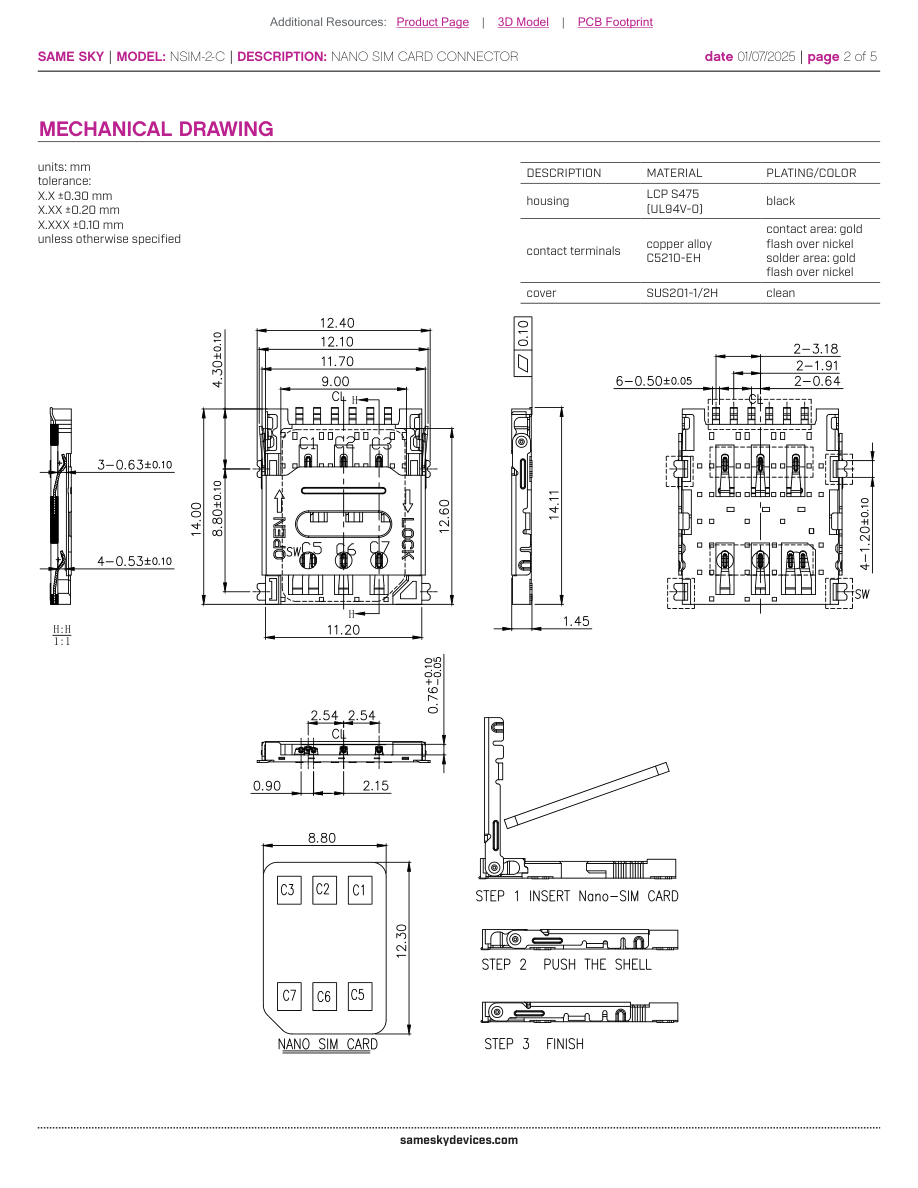
circuit/logger_v2/refs/NSIM_2.png
