ntakao2006-web/RaceCapture/circuit/logger_v2/refs/PEC3824_p1.png

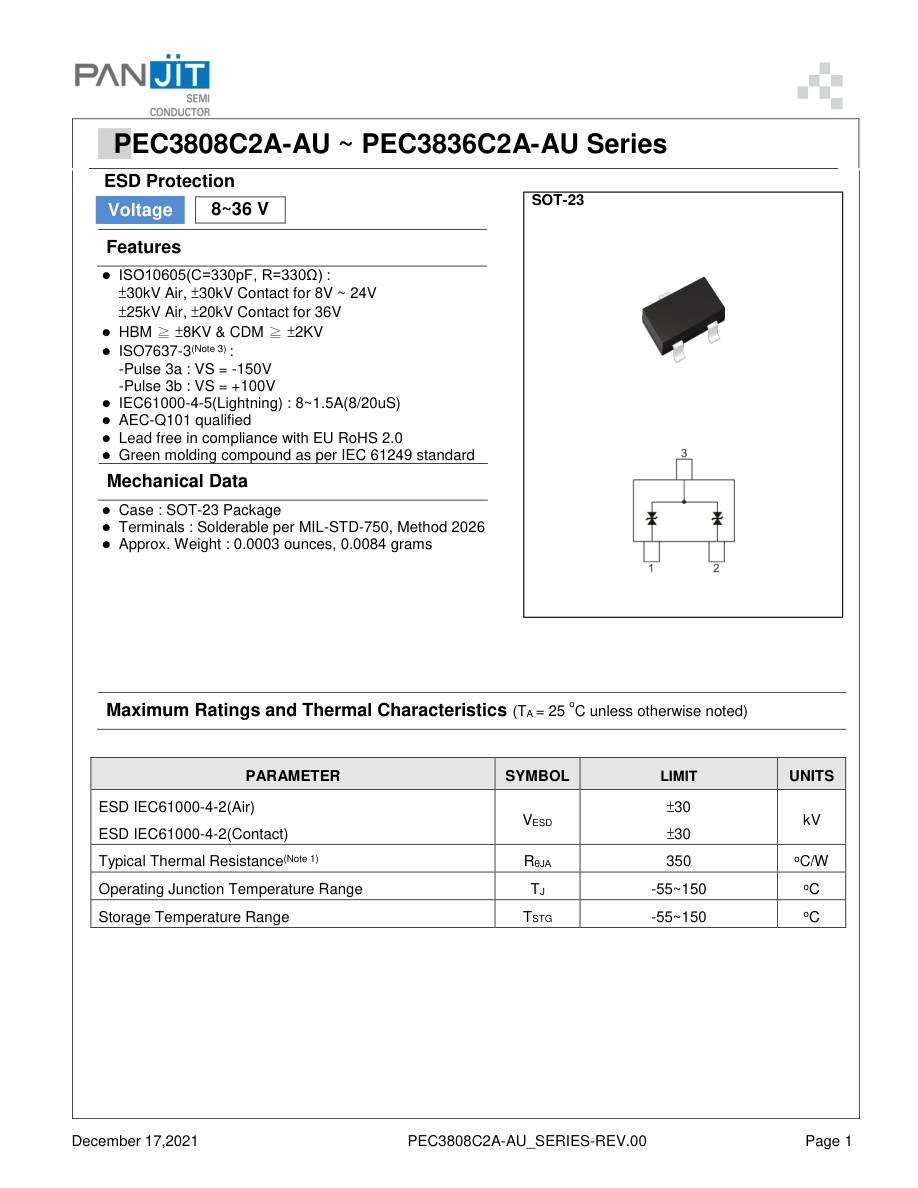
circuit/logger_v2/refs/PEC3824_p1.png
