ntakao2006-web/RaceCapture/circuit/logger_v2/refs/PESDHC2FD4V5B_land.png

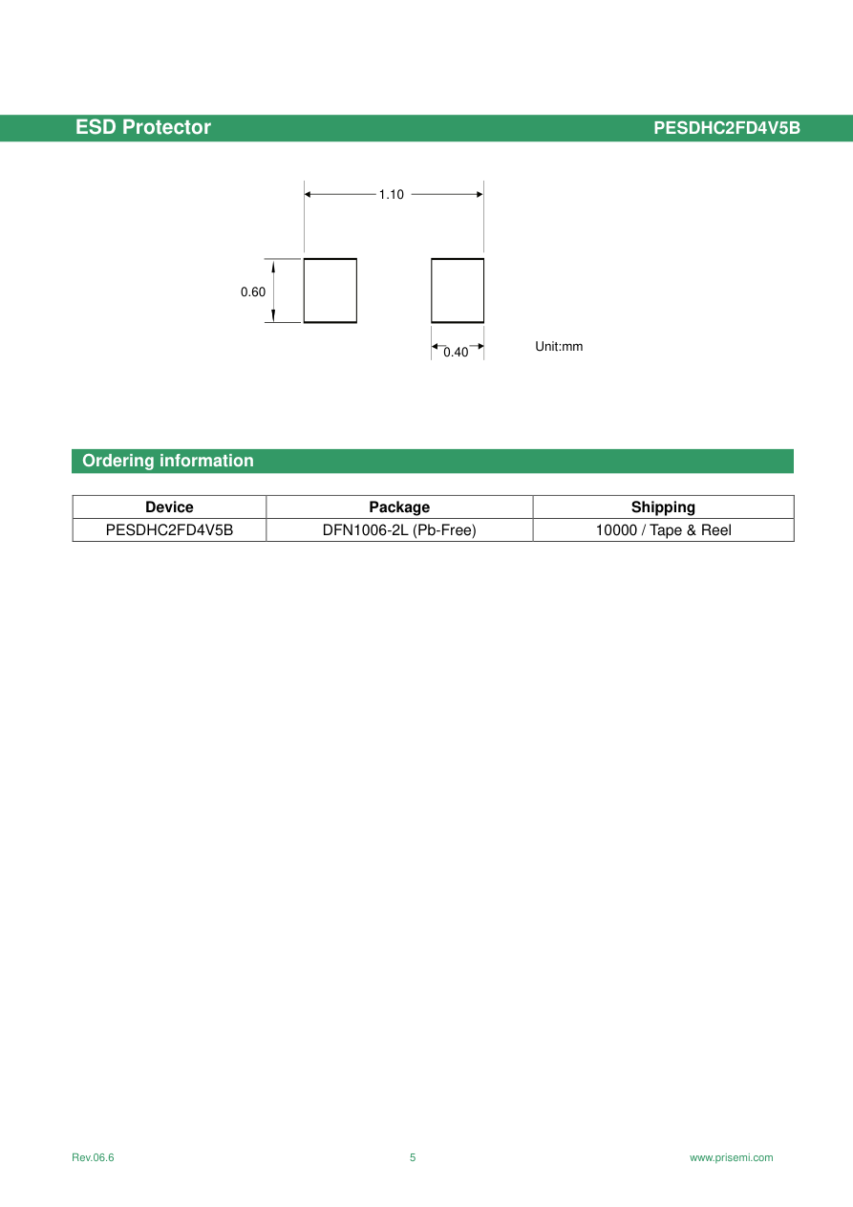
circuit/logger_v2/refs/PESDHC2FD4V5B_land.png
