ntakao2006-web/RaceCapture/circuit/logger_v2/refs/PESDHC2FD4V5B_package.png

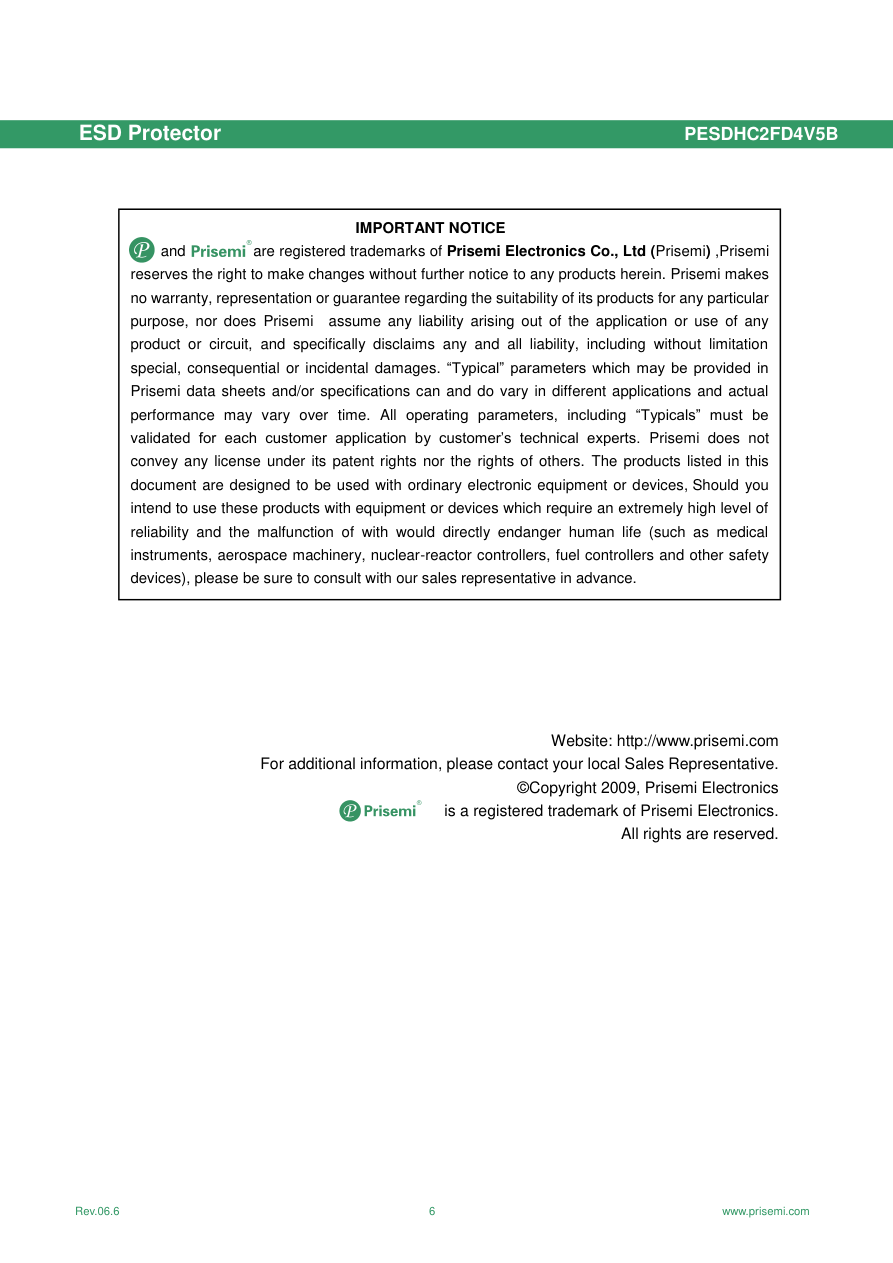
circuit/logger_v2/refs/PESDHC2FD4V5B_package.png
