ntakao2006-web/RaceCapture/circuit/logger_v2/refs/S-037-TGG.png

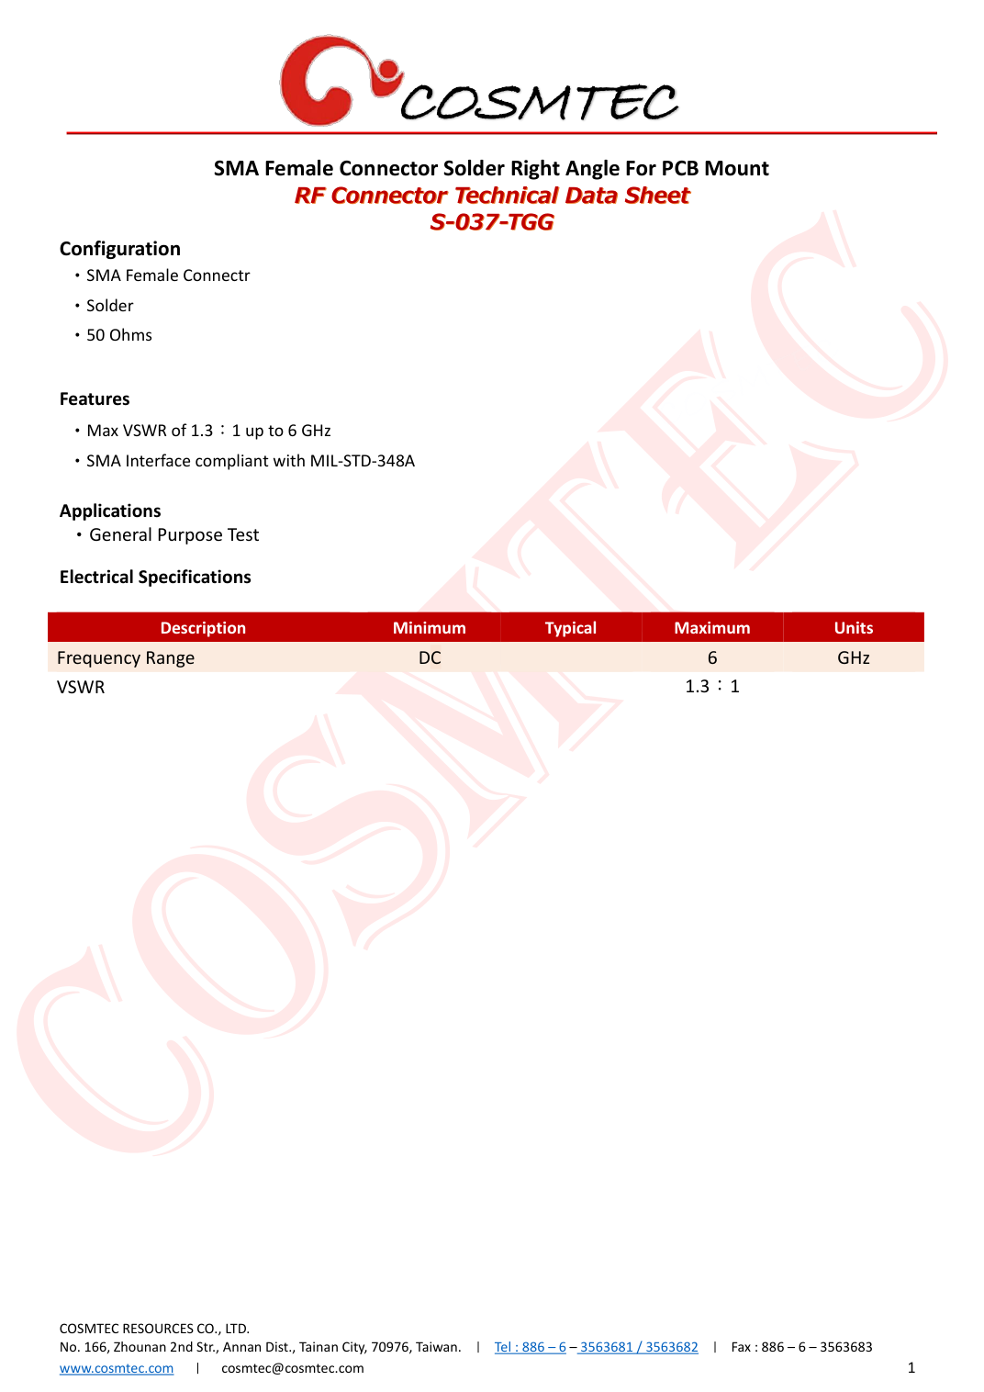
circuit/logger_v2/refs/S-037-TGG.png
