ntakao2006-web/RaceCapture/circuit/logger_v2/refs/SIM7070_15.png

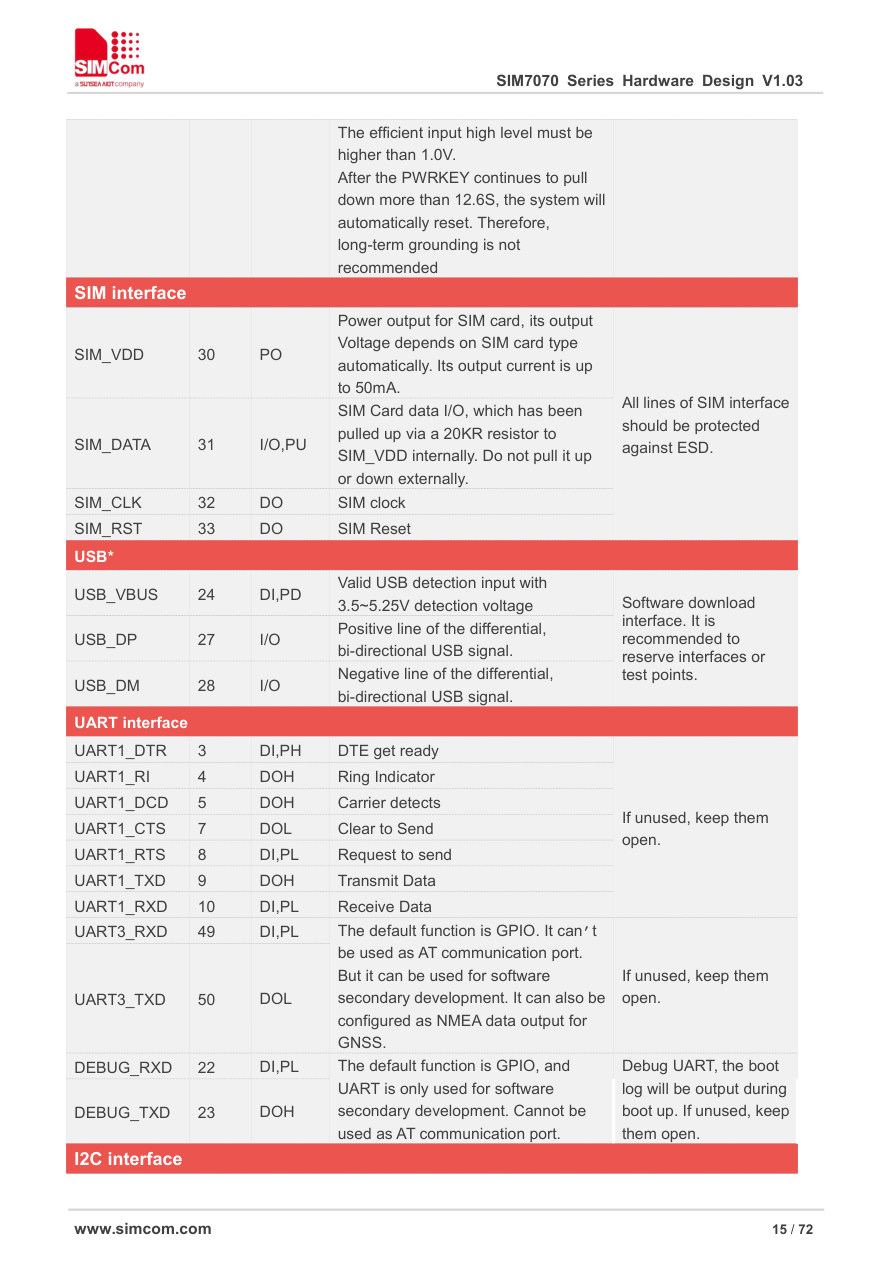
circuit/logger_v2/refs/SIM7070_15.png
