ntakao2006-web/RaceCapture/circuit/logger_v2/refs/SIM7070_19.png

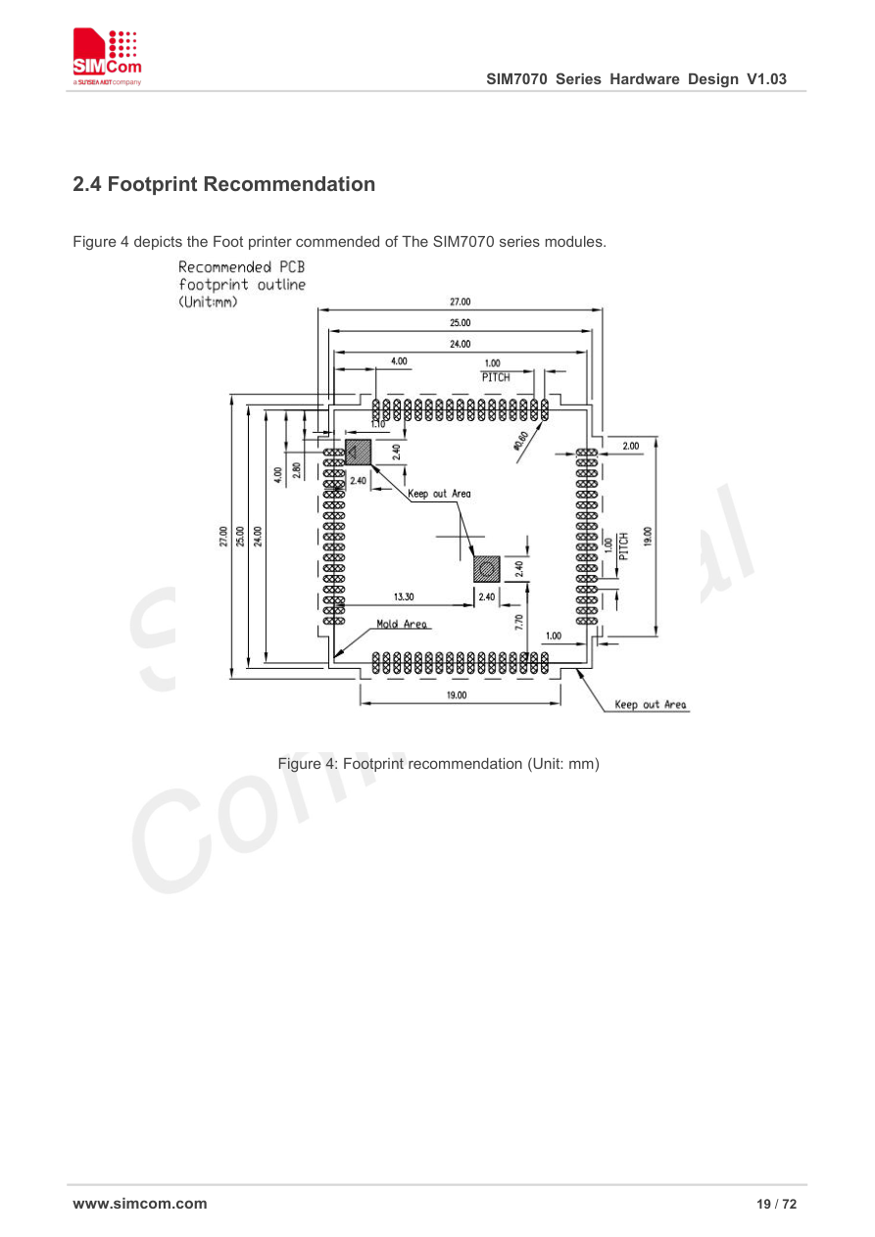
circuit/logger_v2/refs/SIM7070_19.png
