ntakao2006-web/RaceCapture/circuit/logger_v2/refs/SIM7070_land_detail.png

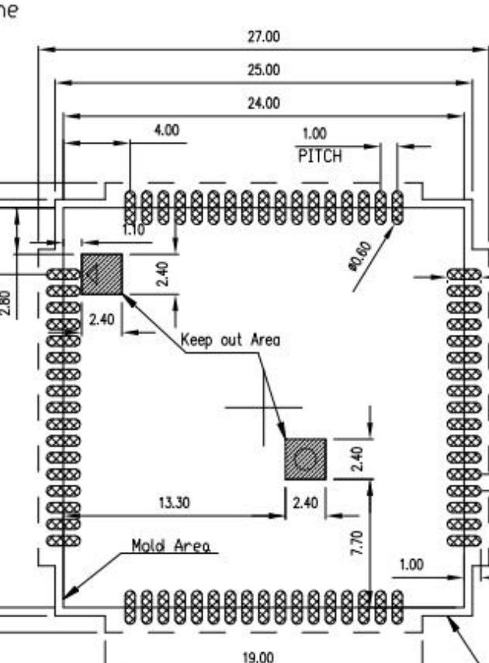
circuit/logger_v2/refs/SIM7070_land_detail.png
