ntakao2006-web/RaceCapture/circuit/logger_v2/refs/SIMcompat_4.png

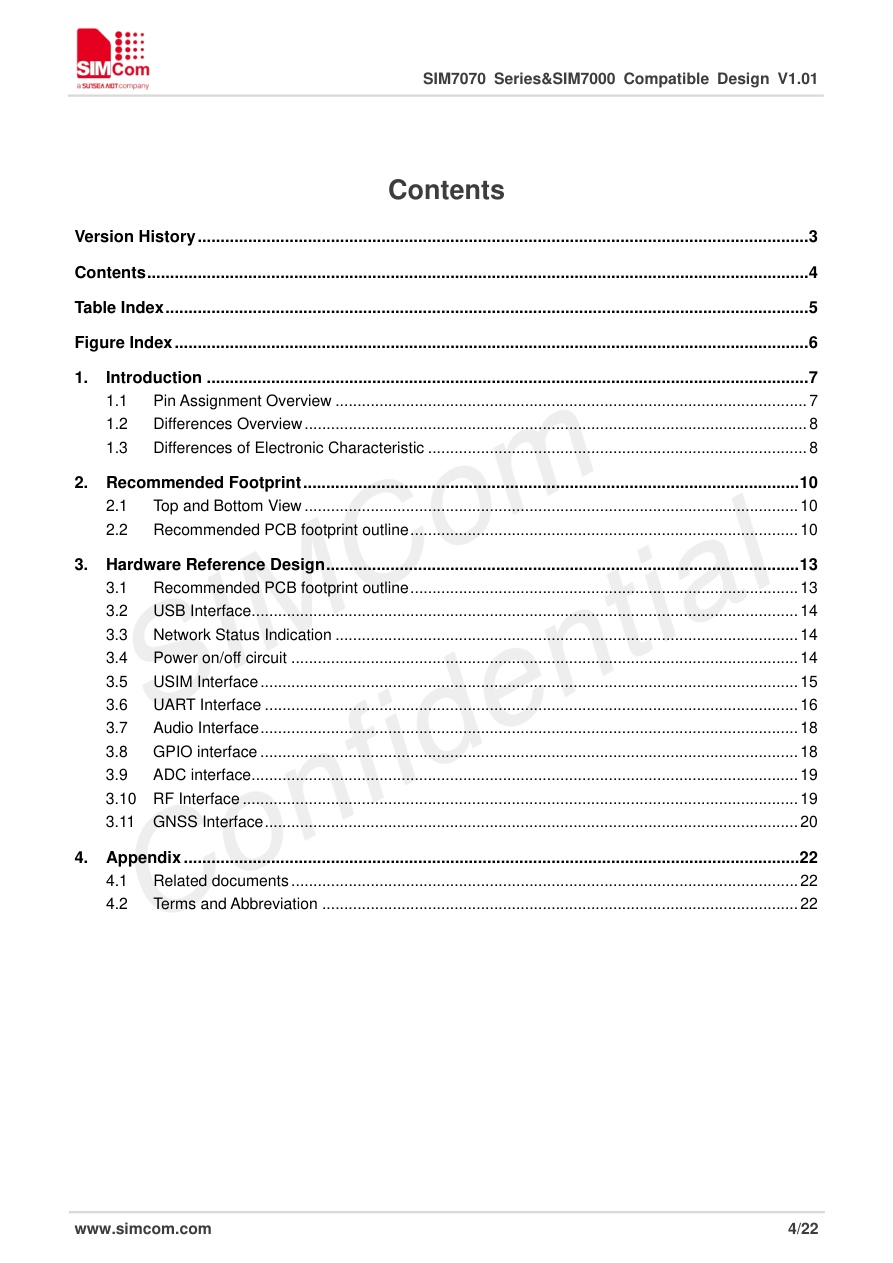
circuit/logger_v2/refs/SIMcompat_4.png
