ntakao2006-web/RaceCapture/circuit/logger_v2/refs/SIMcompat_7.png

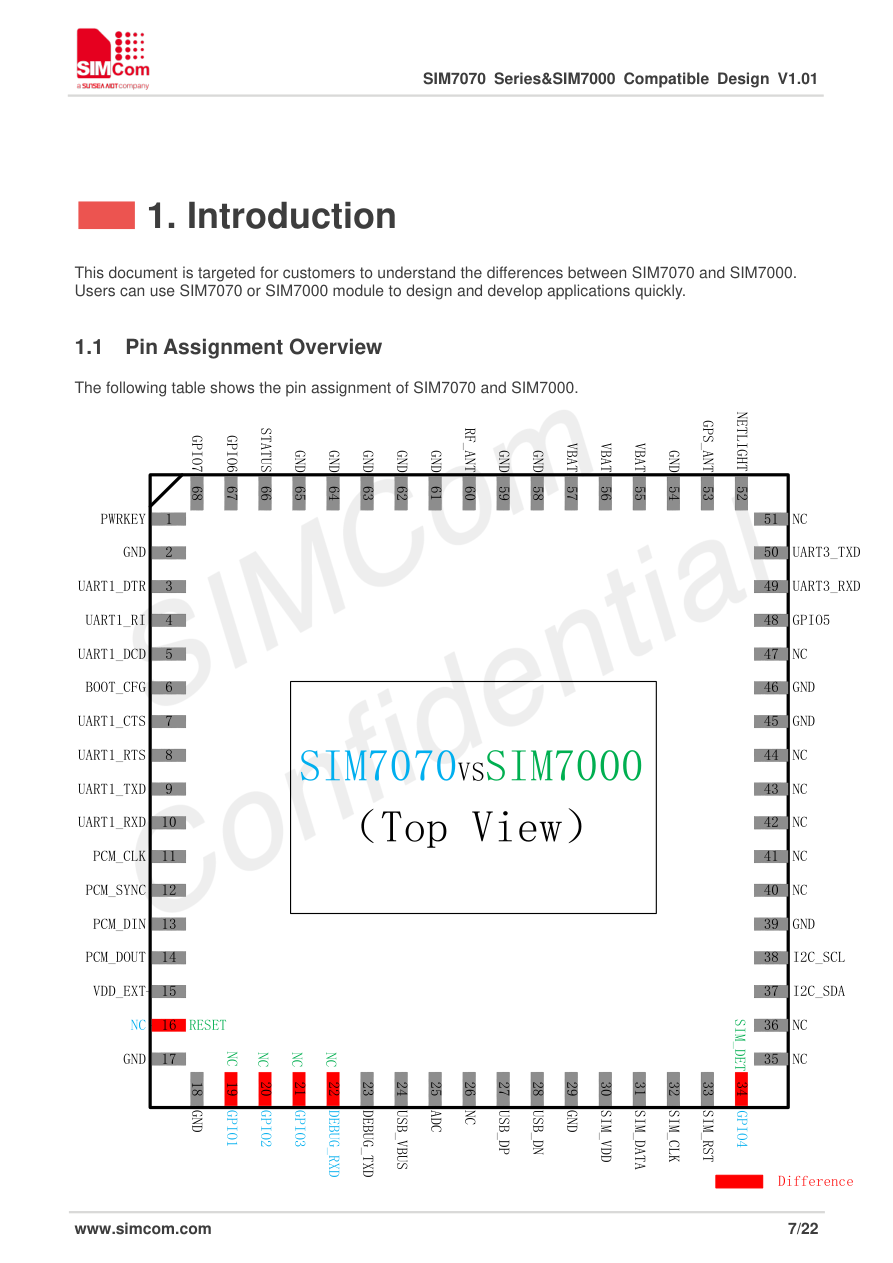
circuit/logger_v2/refs/SIMcompat_7.png
