ntakao2006-web/RaceCapture/circuit/logger_v2/refs/SIMcompat_10.png

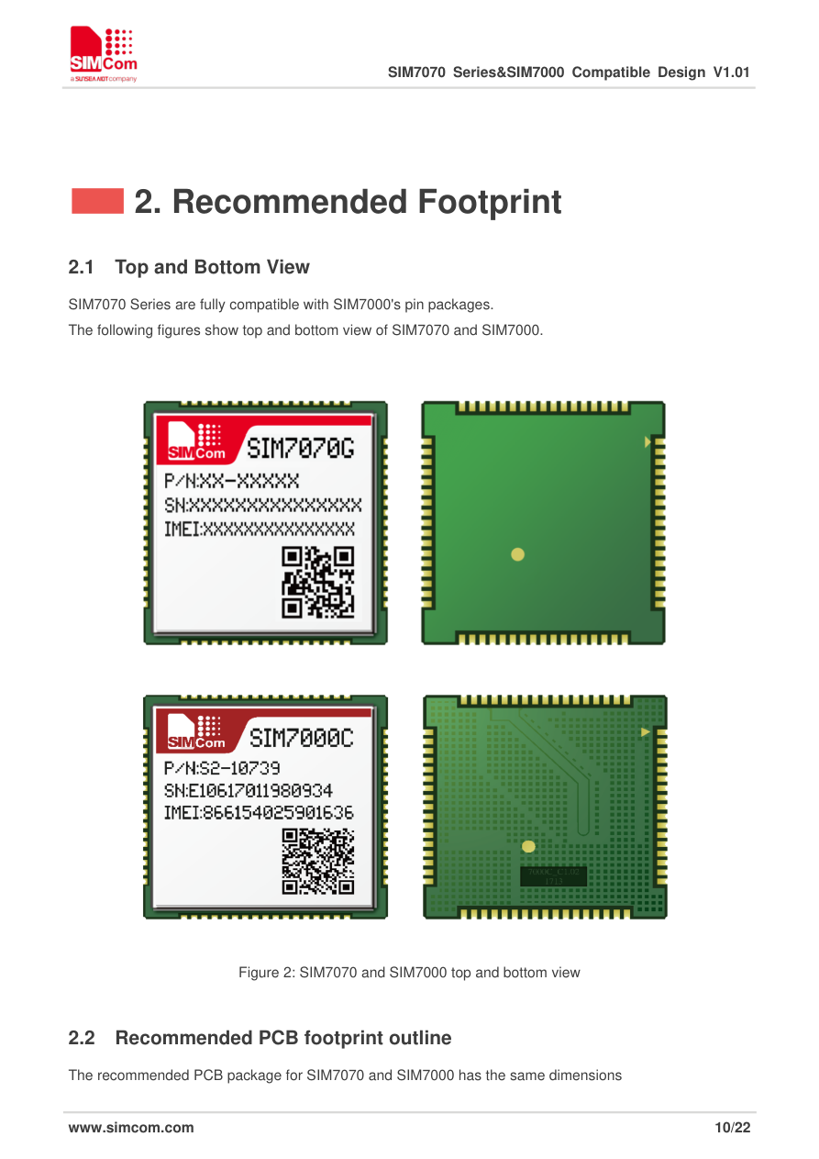
circuit/logger_v2/refs/SIMcompat_10.png
