ntakao2006-web/RaceCapture/circuit/logger_v2/refs/SIMcompat_12full.png

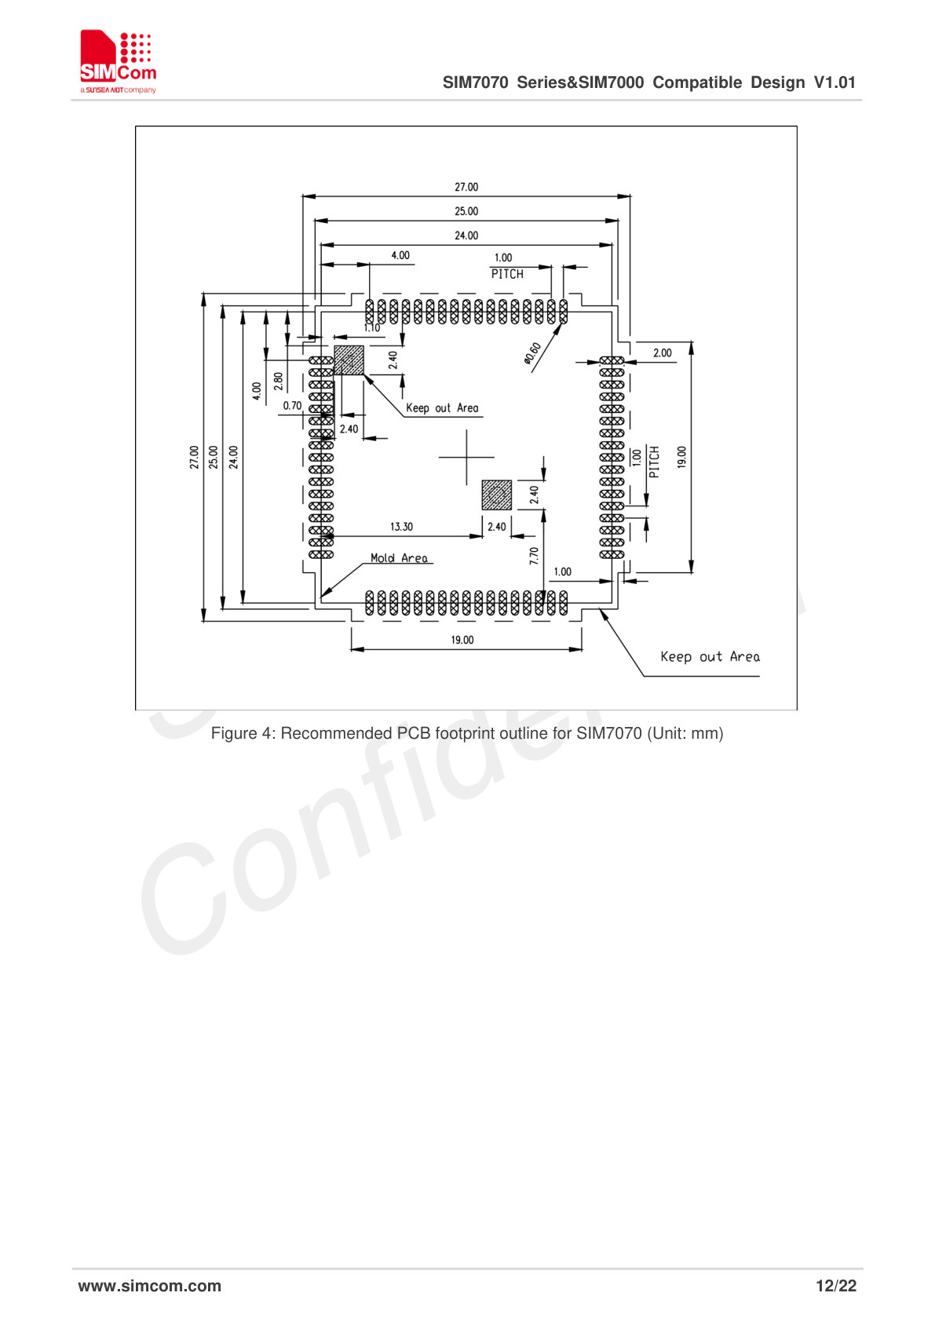
circuit/logger_v2/refs/SIMcompat_12full.png
