ntakao2006-web/RaceCapture/circuit/logger_v2/refs/SMA_dimensions.png

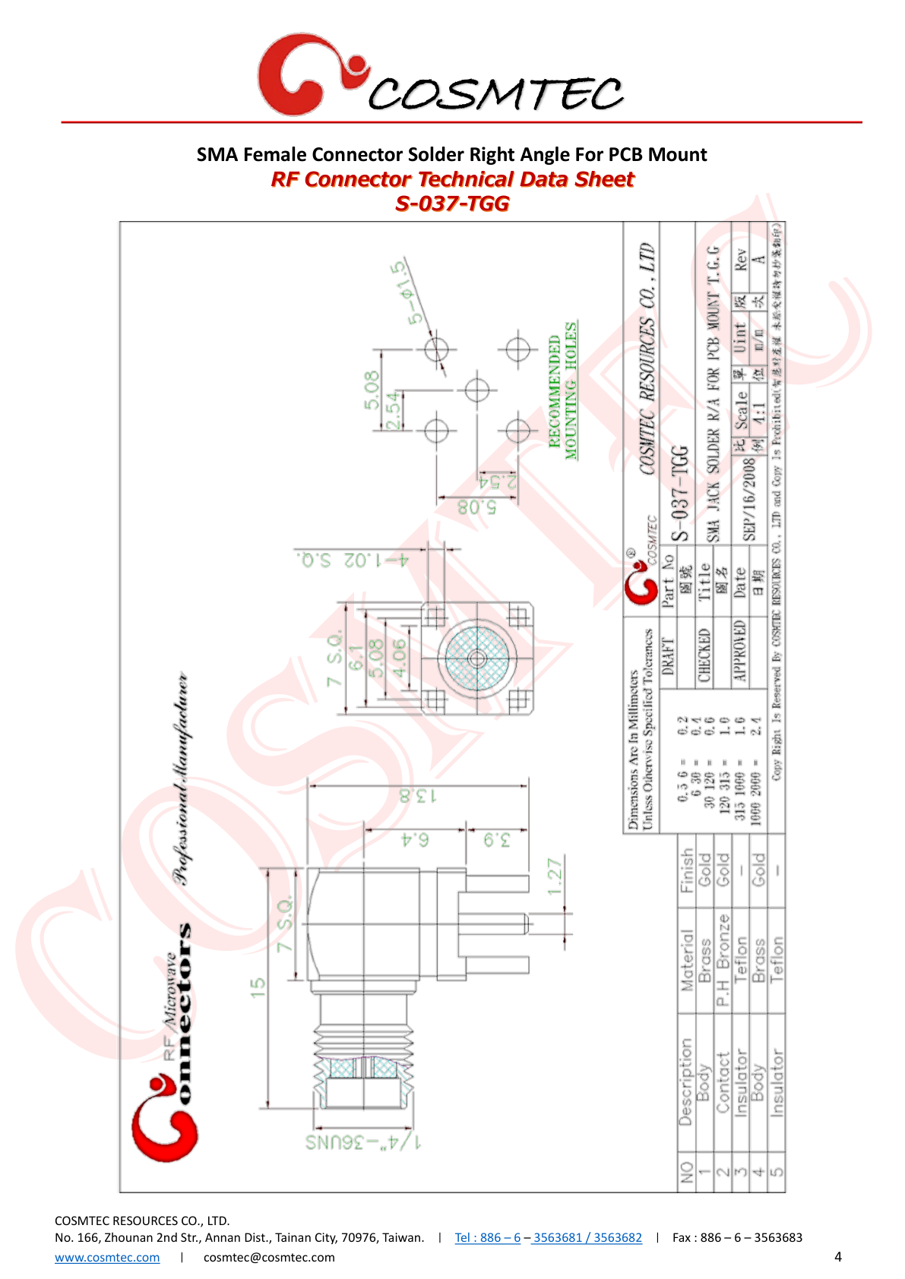
circuit/logger_v2/refs/SMA_dimensions.png
