ntakao2006-web/RaceCapture/circuit/logger_v2/refs/SMA_drawing.png

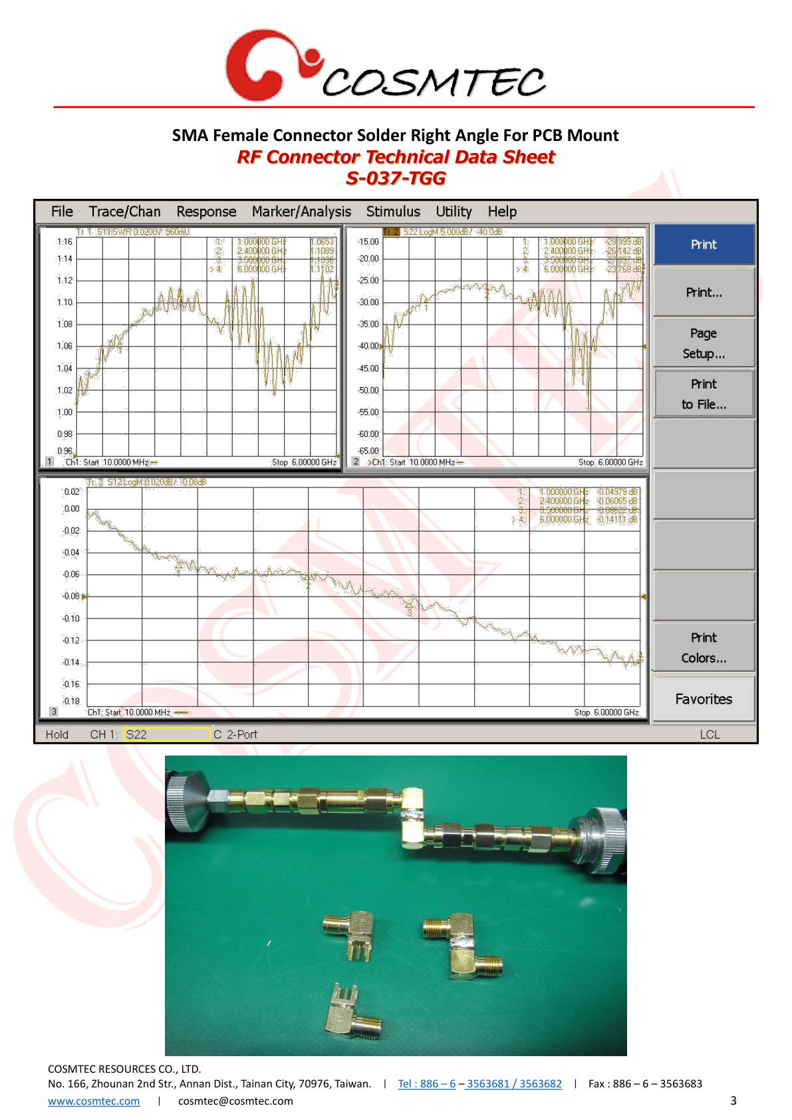
circuit/logger_v2/refs/SMA_drawing.png
