ntakao2006-web/RaceCapture/circuit/logger_v2/refs/TC595_1.png

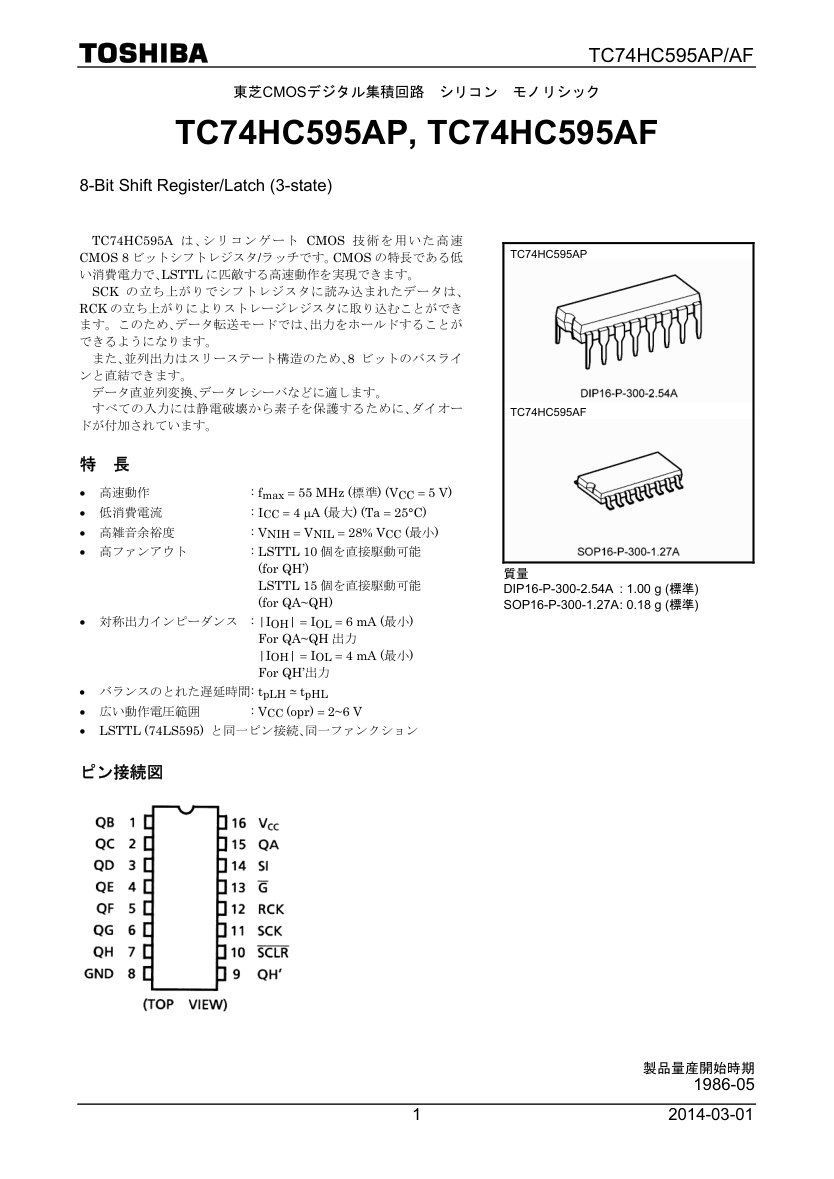
circuit/logger_v2/refs/TC595_1.png
