ntakao2006-web/RaceCapture/circuit/logger_v2/refs/TC595_package.png

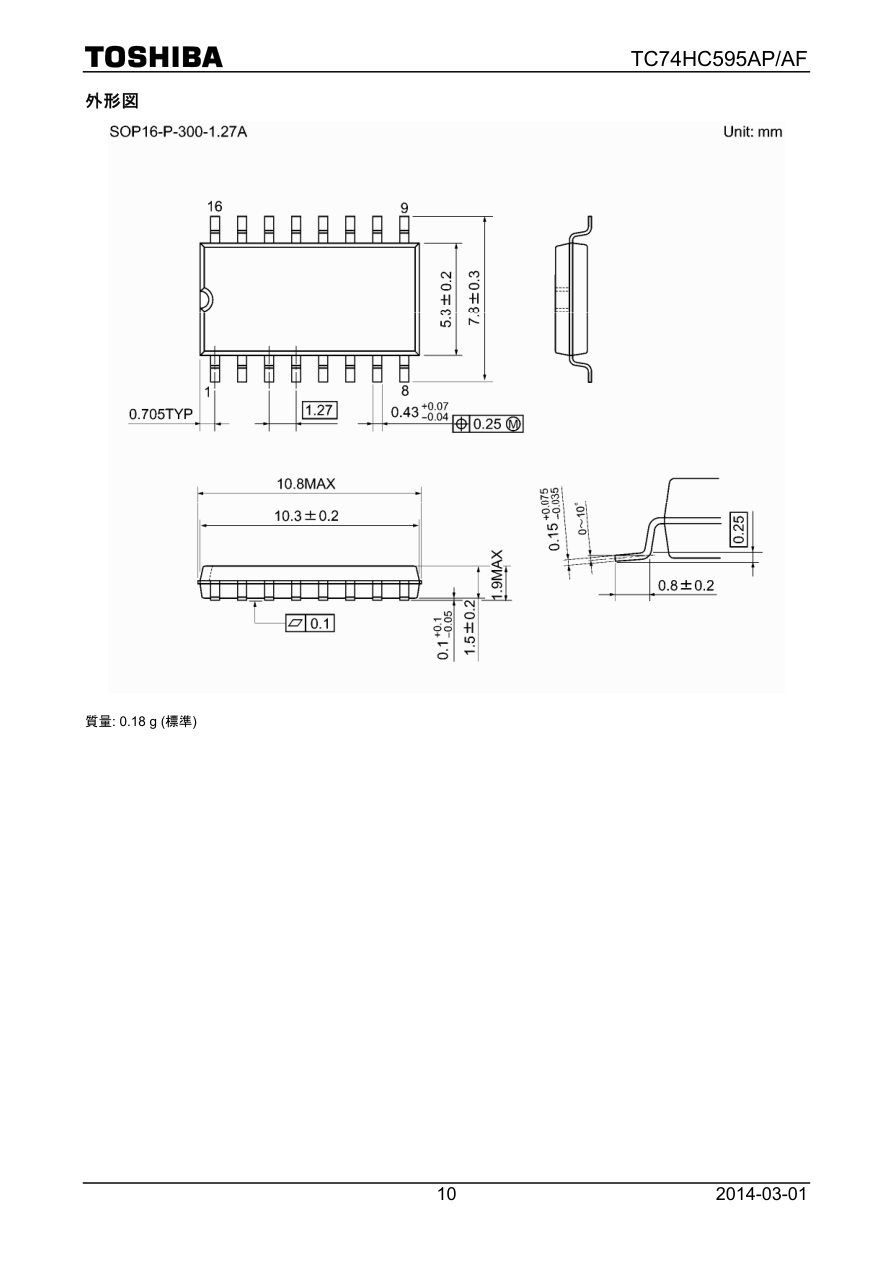
circuit/logger_v2/refs/TC595_package.png
