ntakao2006-web/RaceCapture/circuit/logger_v2/refs/TE_2452796_page2.png

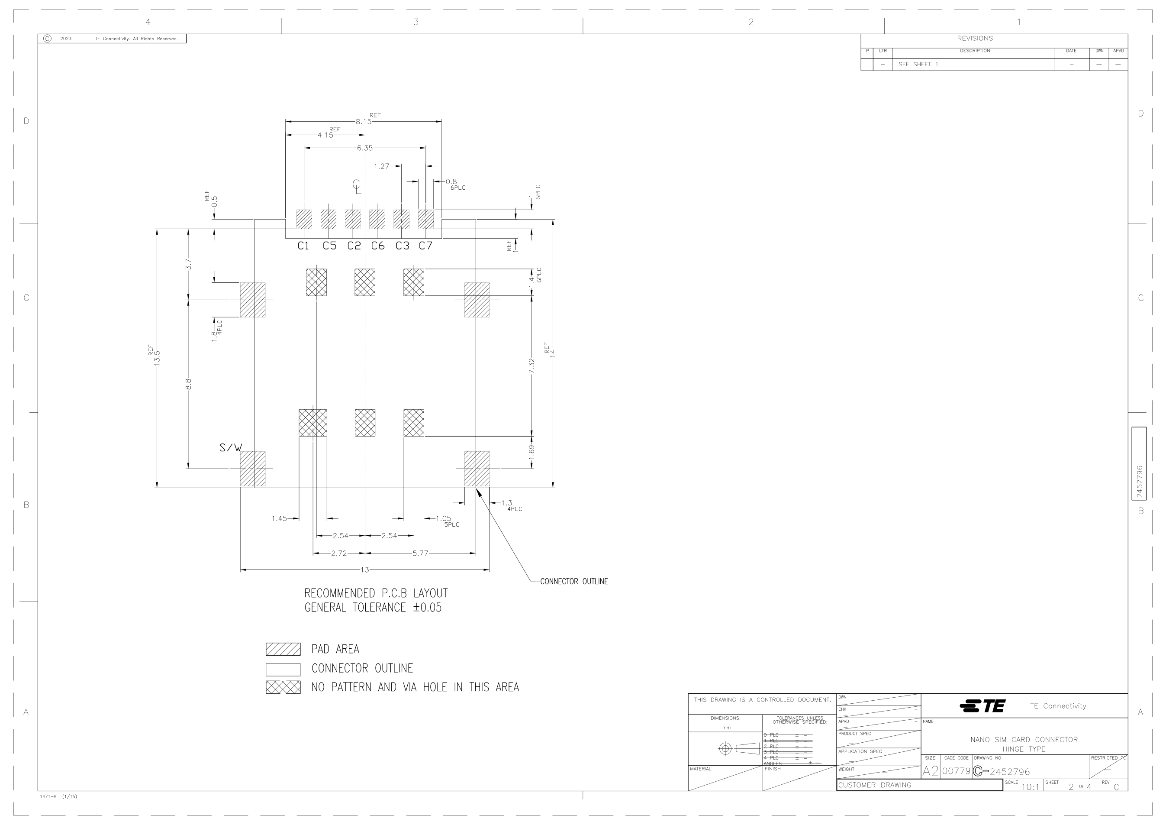
circuit/logger_v2/refs/TE_2452796_page2.png
