ntakao2006-web/RaceCapture/circuit/logger_v2/refs/UNO_Q_pinout.png

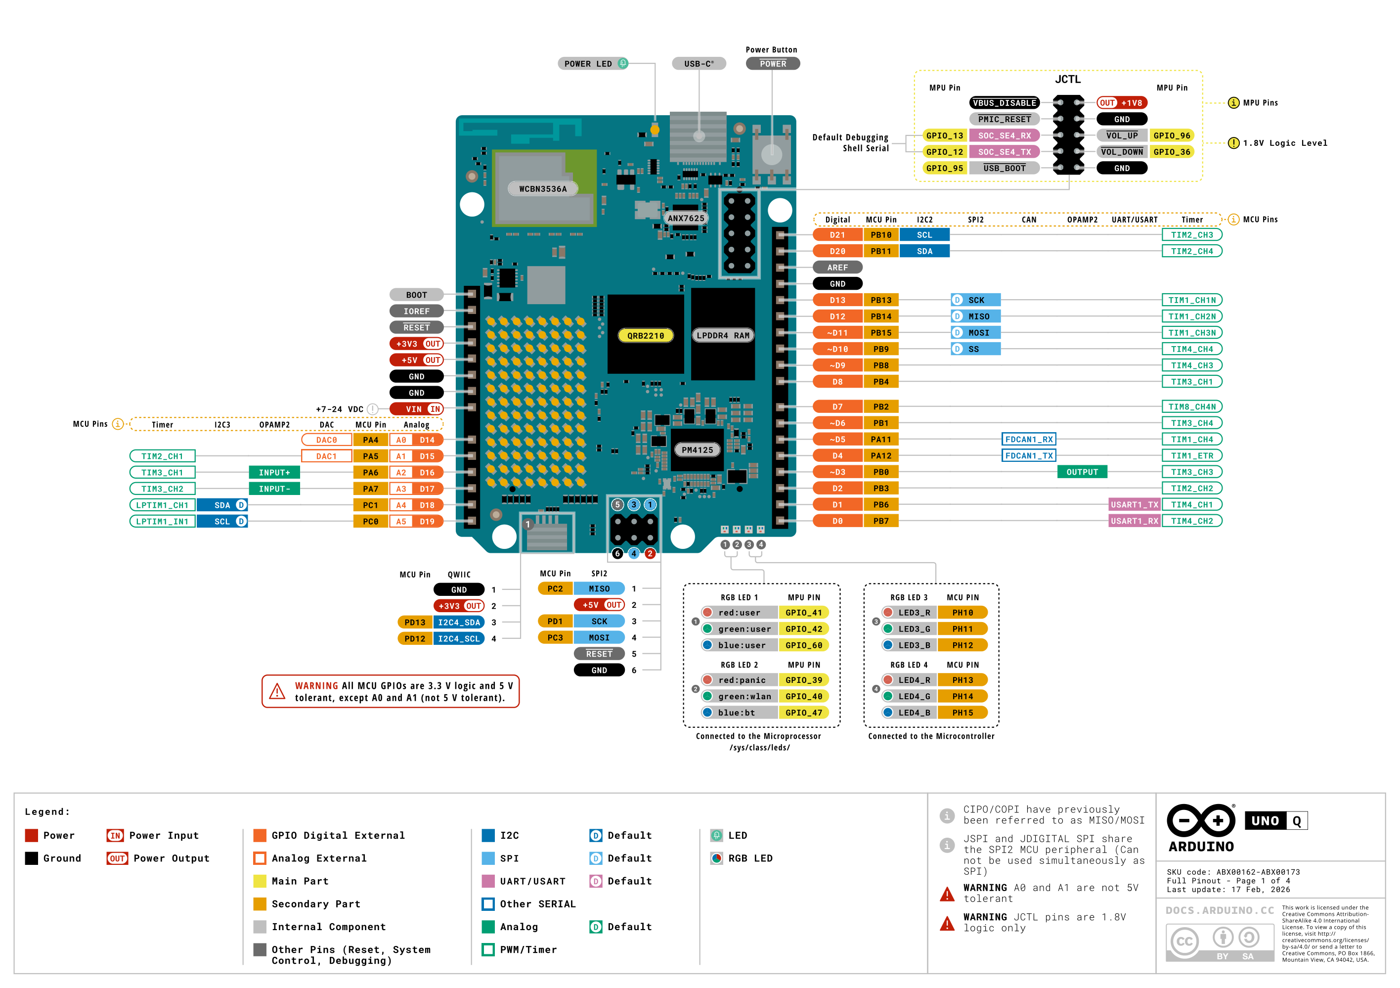
circuit/logger_v2/refs/UNO_Q_pinout.png
