ntakao2006-web/RaceCapture/outputs/circuit_check_20261104/idle.png

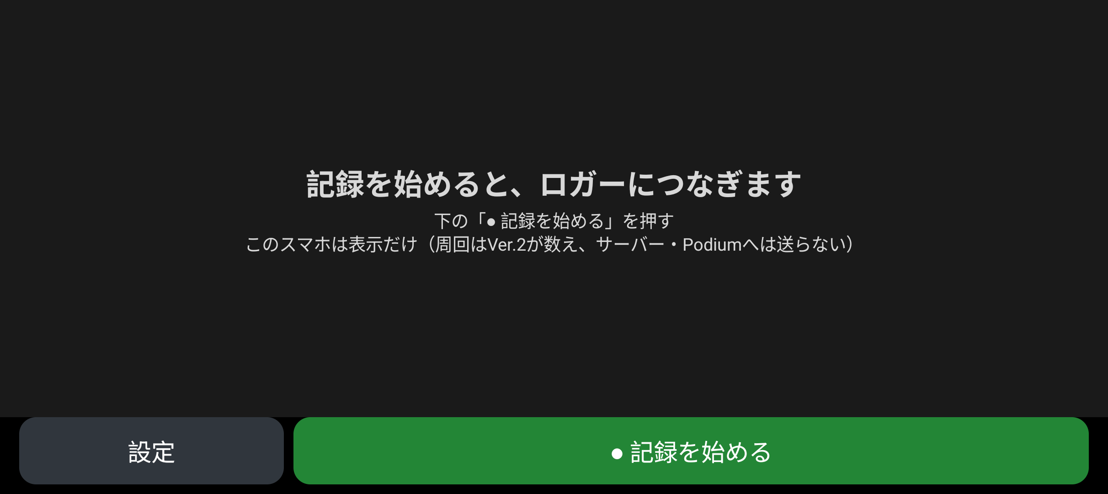
outputs/circuit_check_20261104/idle.png
