ntakao2006-web/RaceCapture/outputs/circuit_check_20261104/logger_lost.png

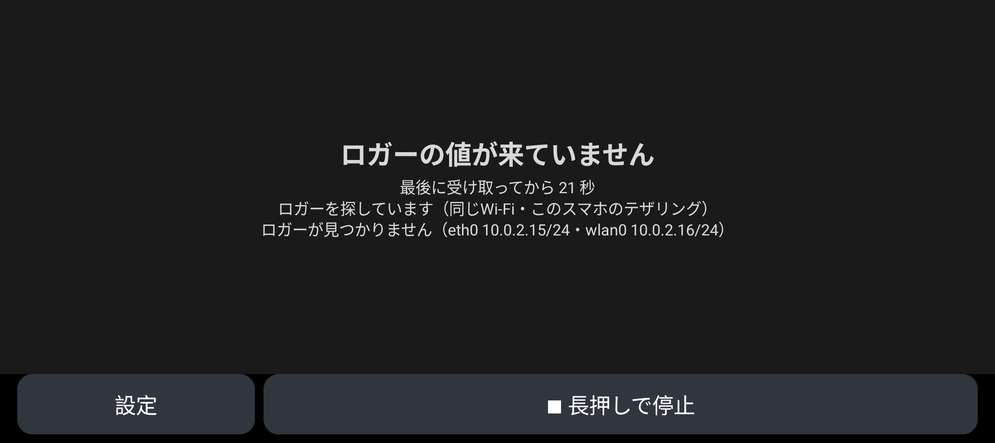
outputs/circuit_check_20261104/logger_lost.png
