ntakao2006-web/RaceCapture/outputs/circuit_check_20261104/press_cleared.png

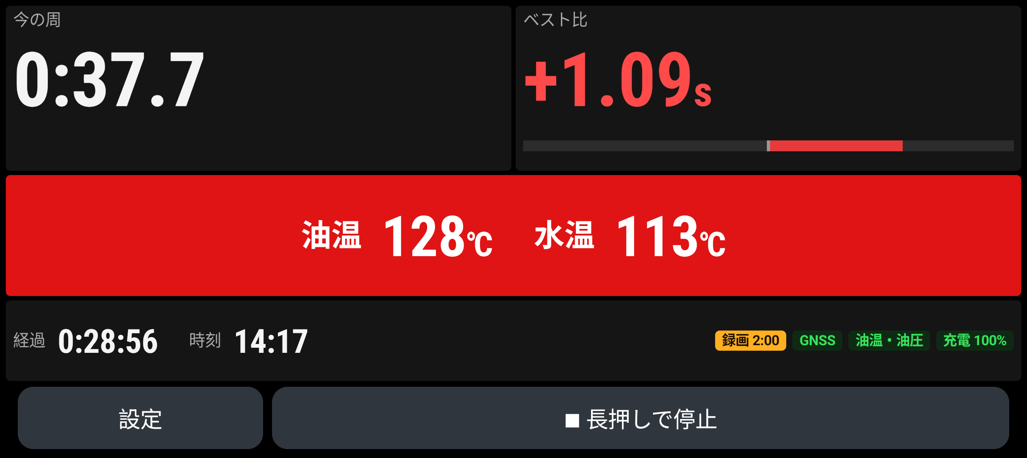
outputs/circuit_check_20261104/press_cleared.png
