ntakao2006-web/RaceCapture/outputs/circuit_check_20261104/press_sensor_lost.png

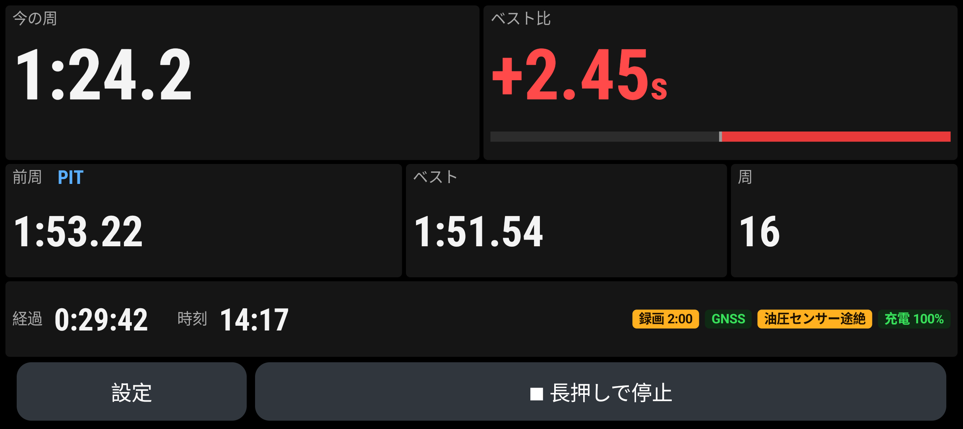
outputs/circuit_check_20261104/press_sensor_lost.png
