ntakao2006-web/RaceCapture/outputs/circuit_check_20261104/settings_reset.png

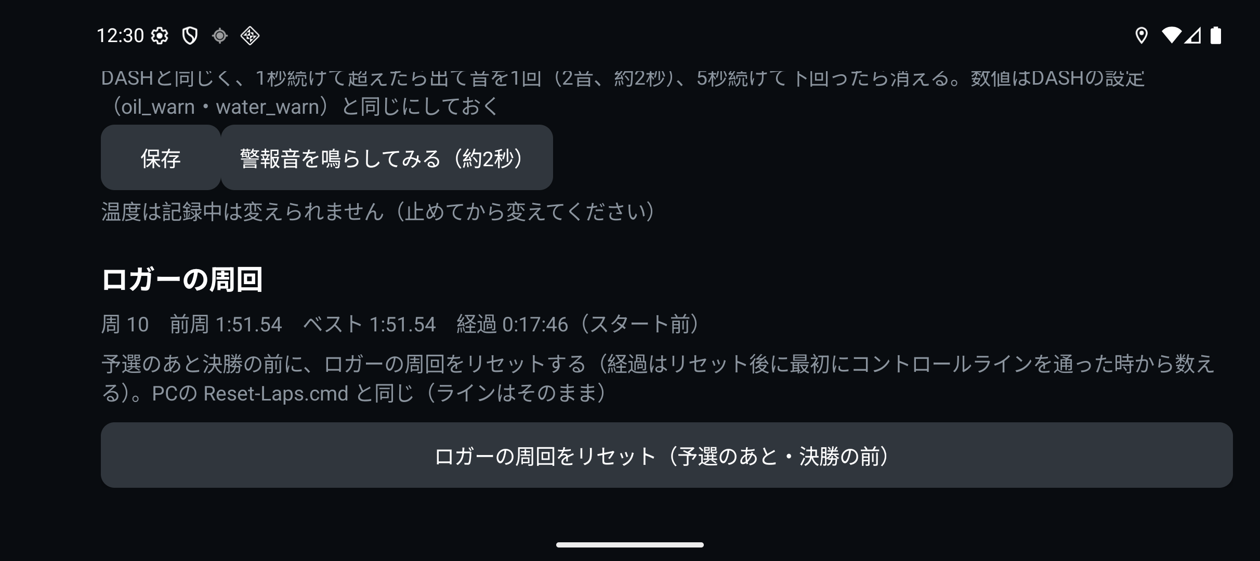
outputs/circuit_check_20261104/settings_reset.png
