ntakao2006-web/RaceCapture/outputs/circuit_check_20261104/warn3.png

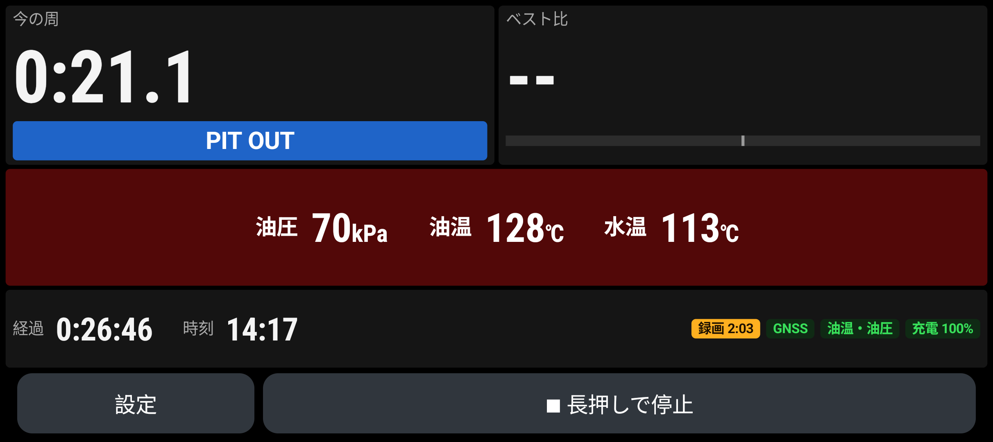
outputs/circuit_check_20261104/warn3.png
