ntakao2006-web/RaceCapture/outputs/dash_check_20261104_0551/warn130.png

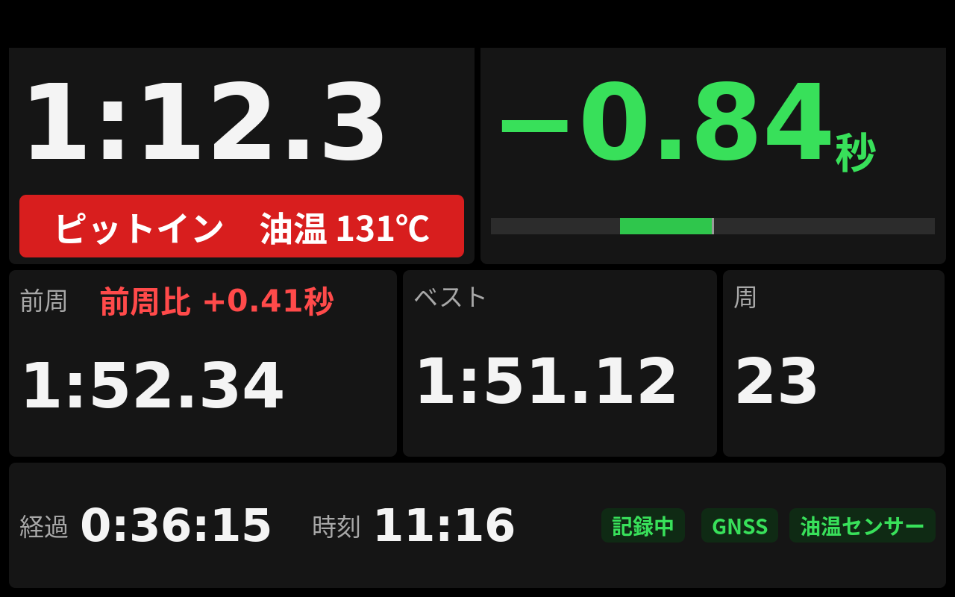
outputs/dash_check_20261104_0551/warn130.png
