ntakao2006-web/RaceCapture/outputs/dash_check_20261105_1815/lost.png

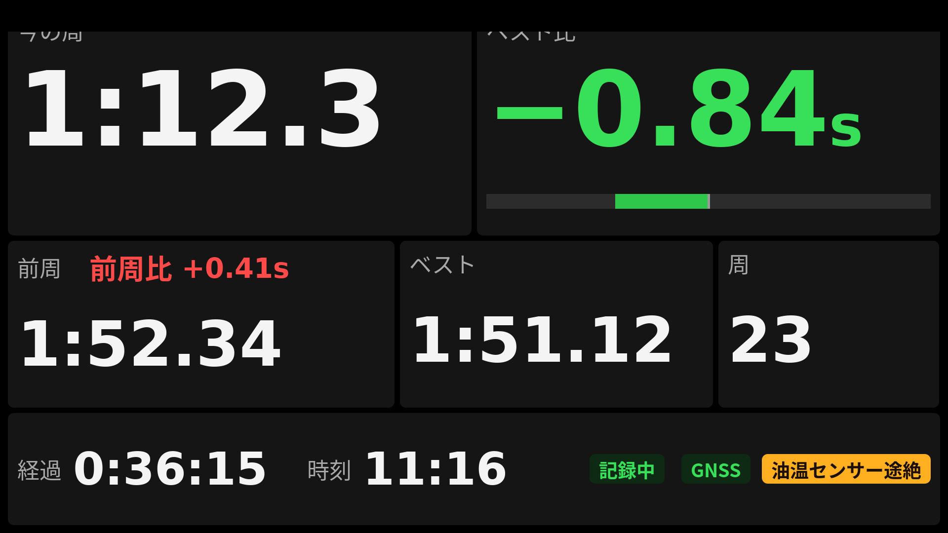
outputs/dash_check_20261105_1815/lost.png
