ntakao2006-web/RaceCapture/outputs/dash_check_20261105_1815/pit.png

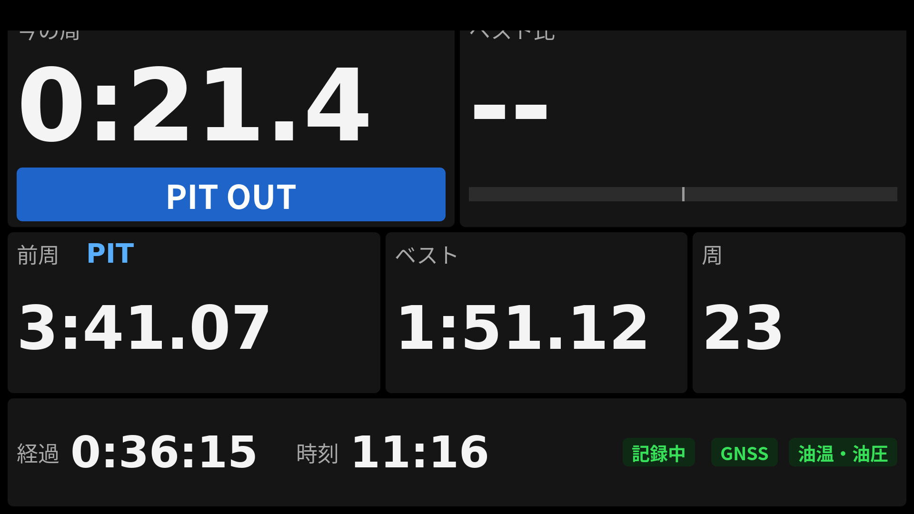
outputs/dash_check_20261105_1815/pit.png
