ntakao2006-web/RaceCapture/outputs/dash_check_20261105_1815/warn2.png

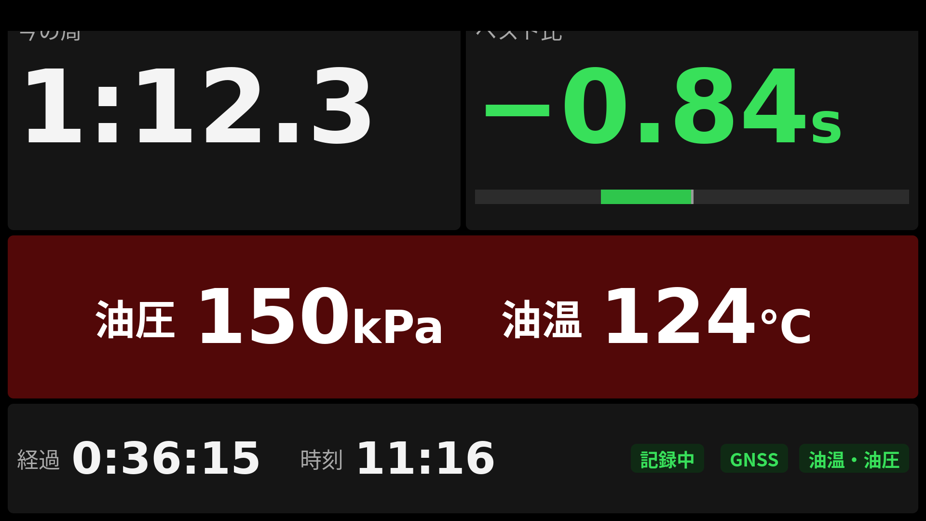
outputs/dash_check_20261105_1815/warn2.png
