ntakao2006-web/RaceCapture/outputs/dash_check_20261106_1413/warn2.png

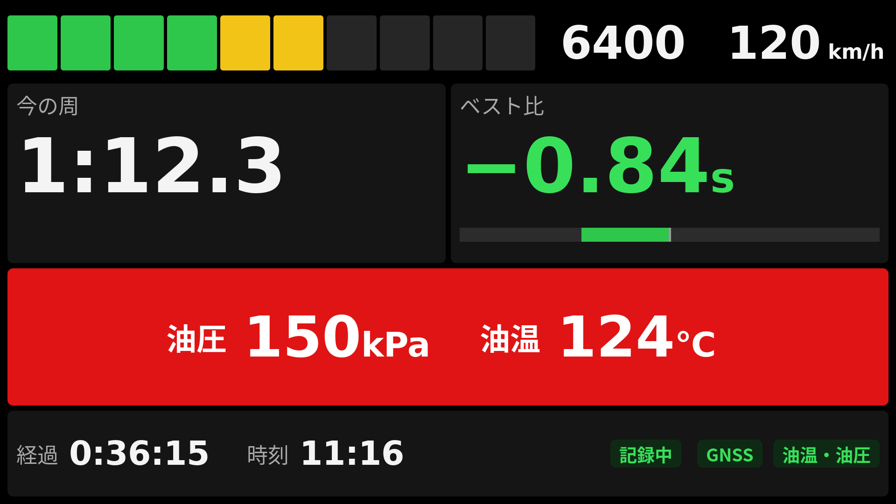
outputs/dash_check_20261106_1413/warn2.png
