ntakao2006-web/RaceCapture/outputs/dash_check_20261106_2350/dash_now.png

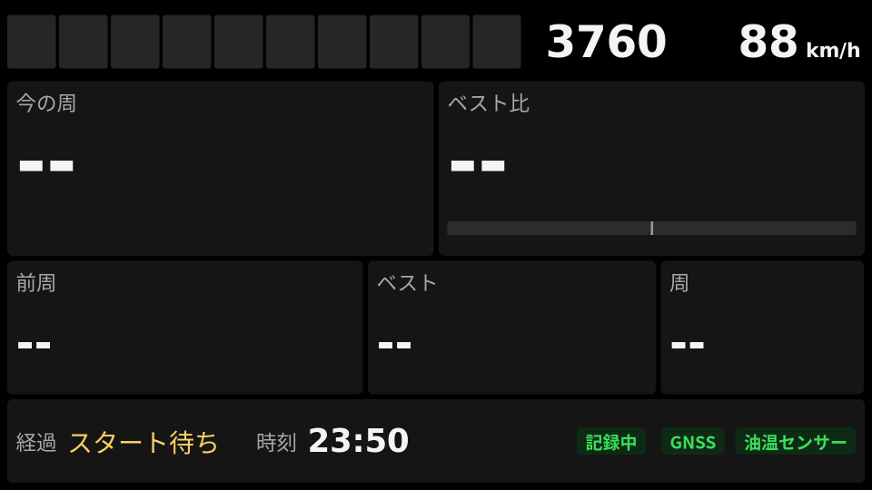
outputs/dash_check_20261106_2350/dash_now.png
