ntakao2006-web/RaceCapture/outputs/dash_check_20261108_0647/limit.png

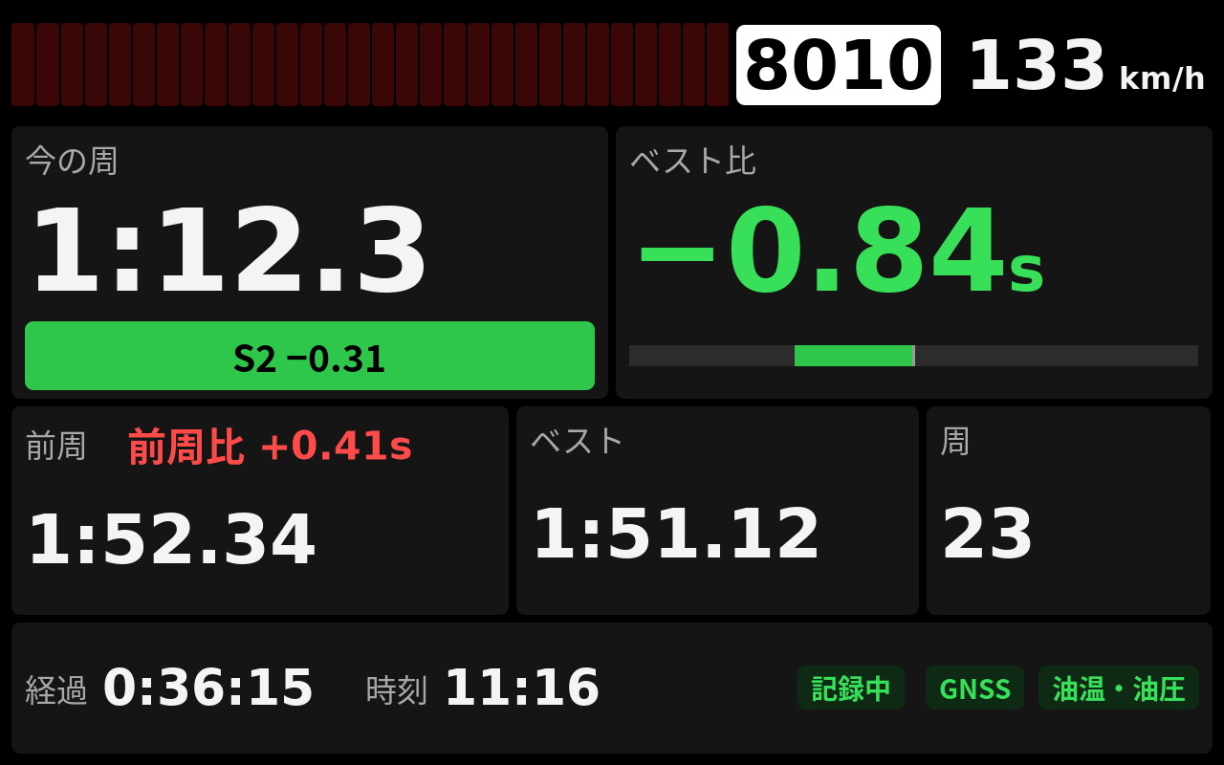
outputs/dash_check_20261108_0647/limit.png
