ntakao2006-web/RaceCapture/outputs/dash_check_20261108_0647/lost.png

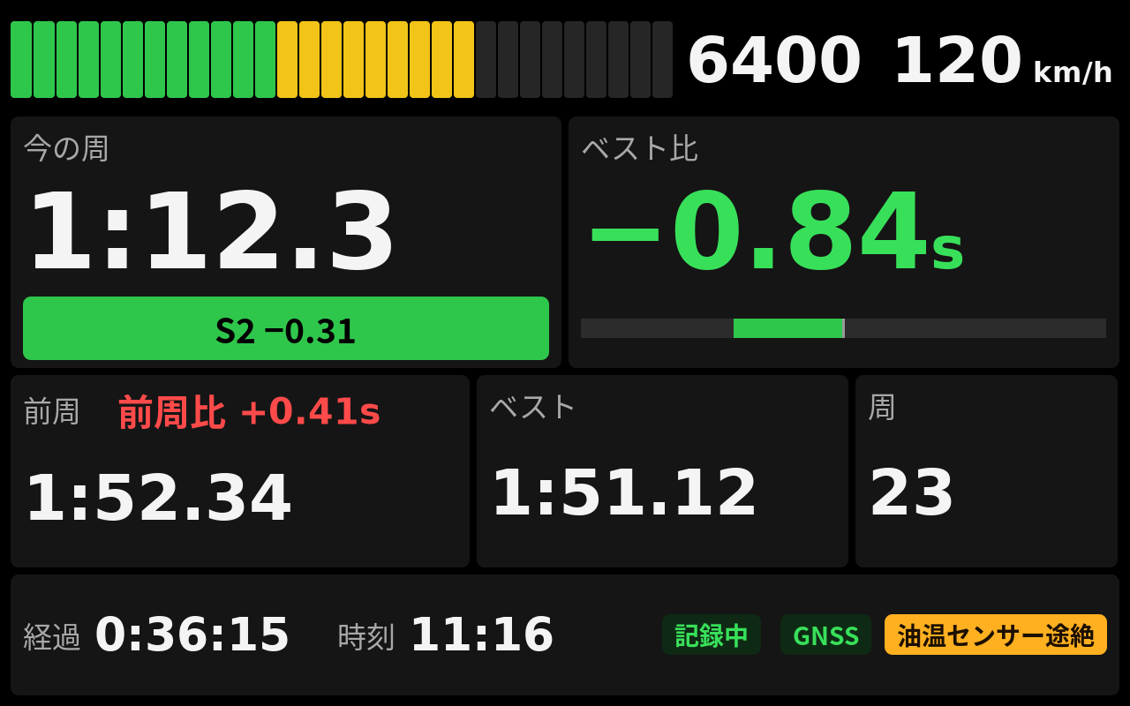
outputs/dash_check_20261108_0647/lost.png
