ntakao2006-web/RaceCapture/outputs/dash_check_20261108_0647/warn2.png

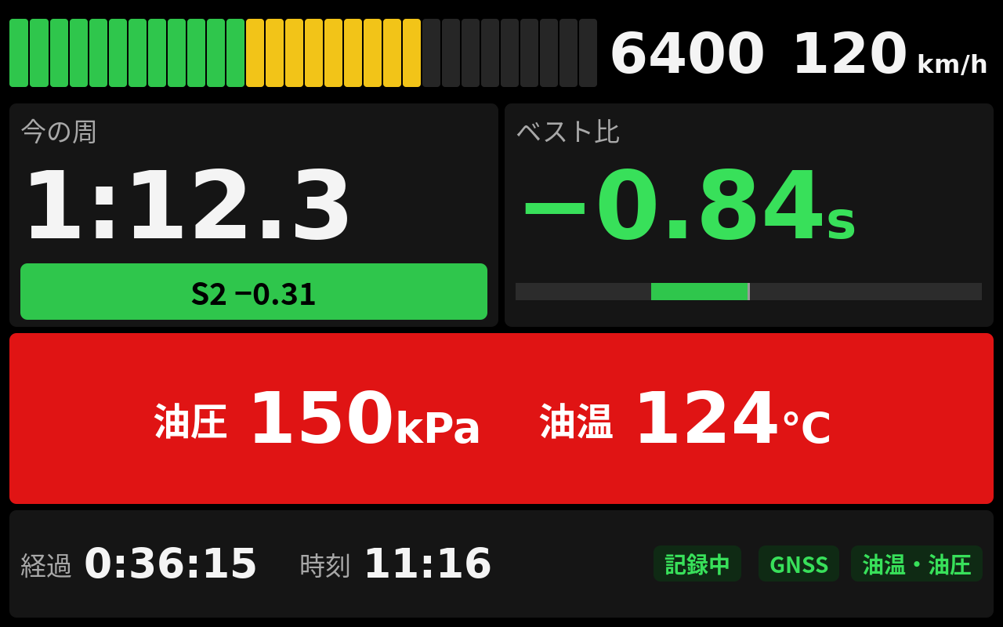
outputs/dash_check_20261108_0647/warn2.png
