ntakao2006-web/RaceCapture/outputs/dash_segments_20261107/compare_10_20_30.png

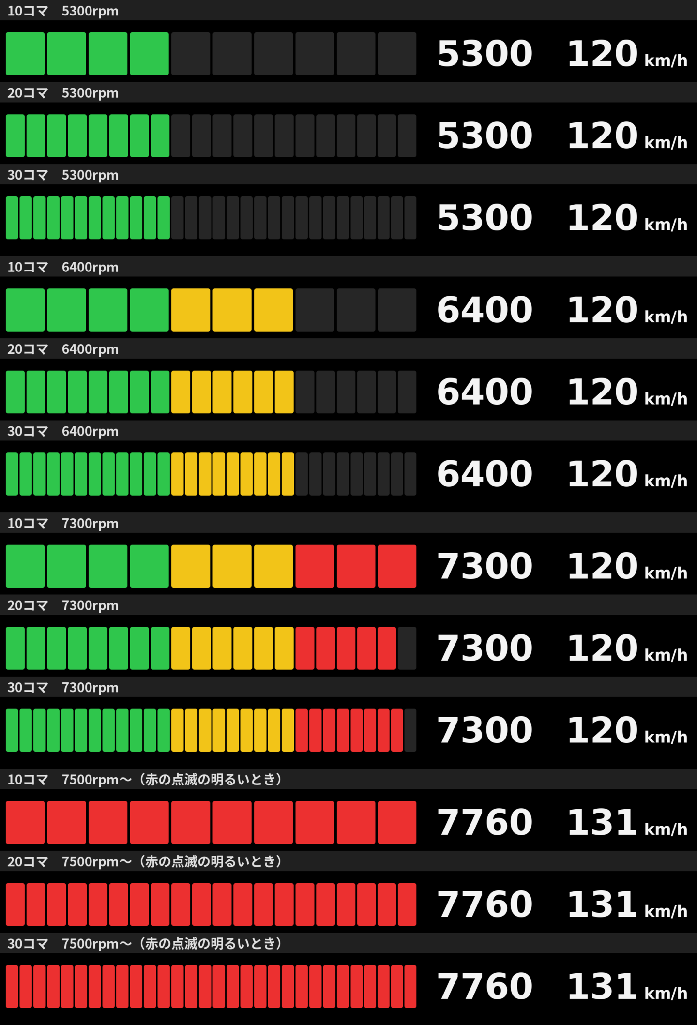
outputs/dash_segments_20261107/compare_10_20_30.png
