ntakao2006-web/RaceCapture/outputs/dash_segments_20261107/seg10_6400.png

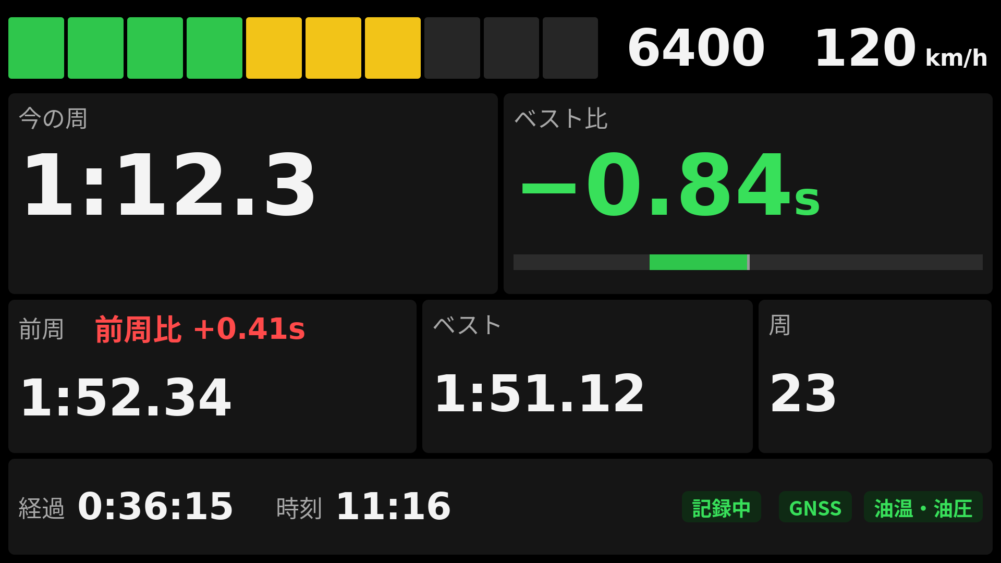
outputs/dash_segments_20261107/seg10_6400.png
