ntakao2006-web/RaceCapture/outputs/dash_segments_20261107/seg20_5300.png

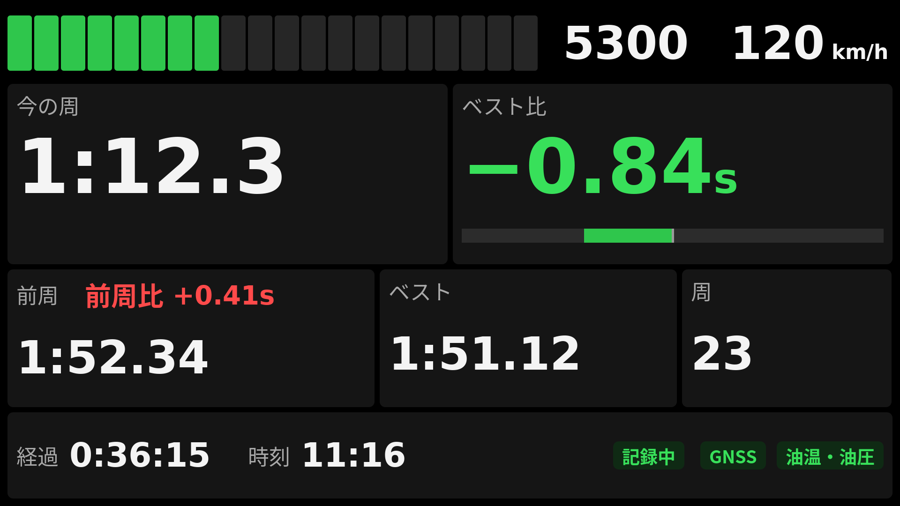
outputs/dash_segments_20261107/seg20_5300.png
