ntakao2006-web/RaceCapture/outputs/g_filter_20261106/g_filter_before_after.png

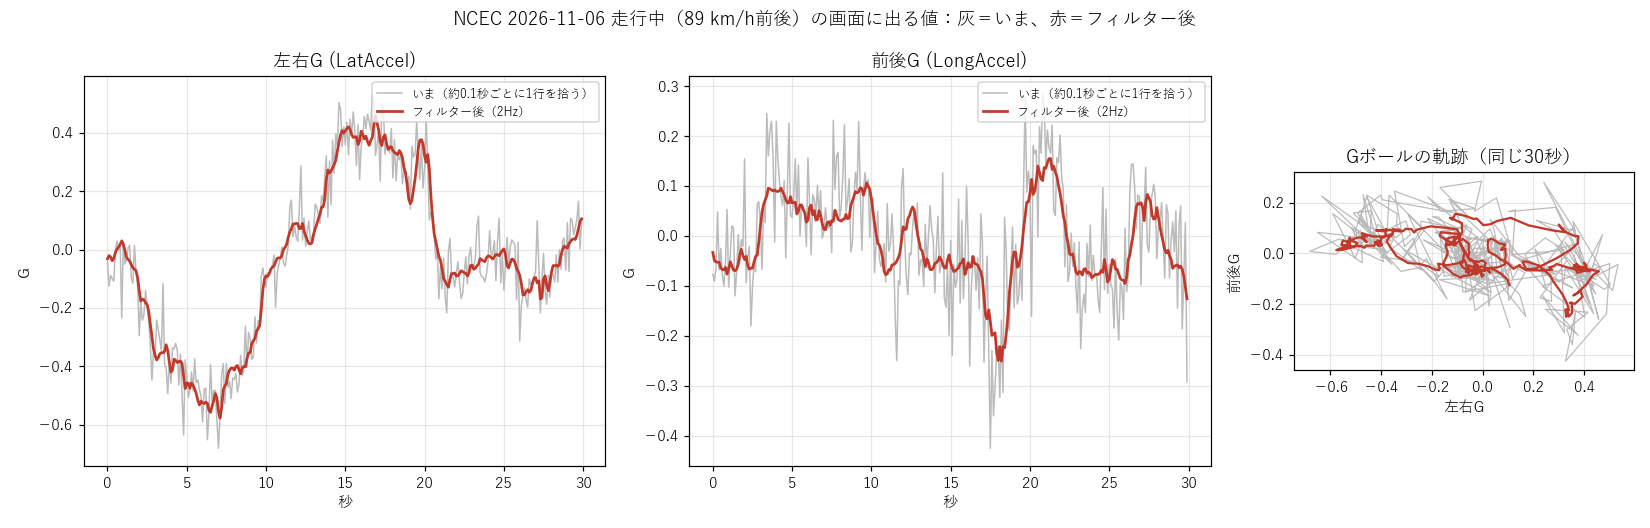
outputs/g_filter_20261106/g_filter_before_after.png
