ntakao2006-web/RaceCapture/outputs/hud_rpm_20261107/compare_rpm.png

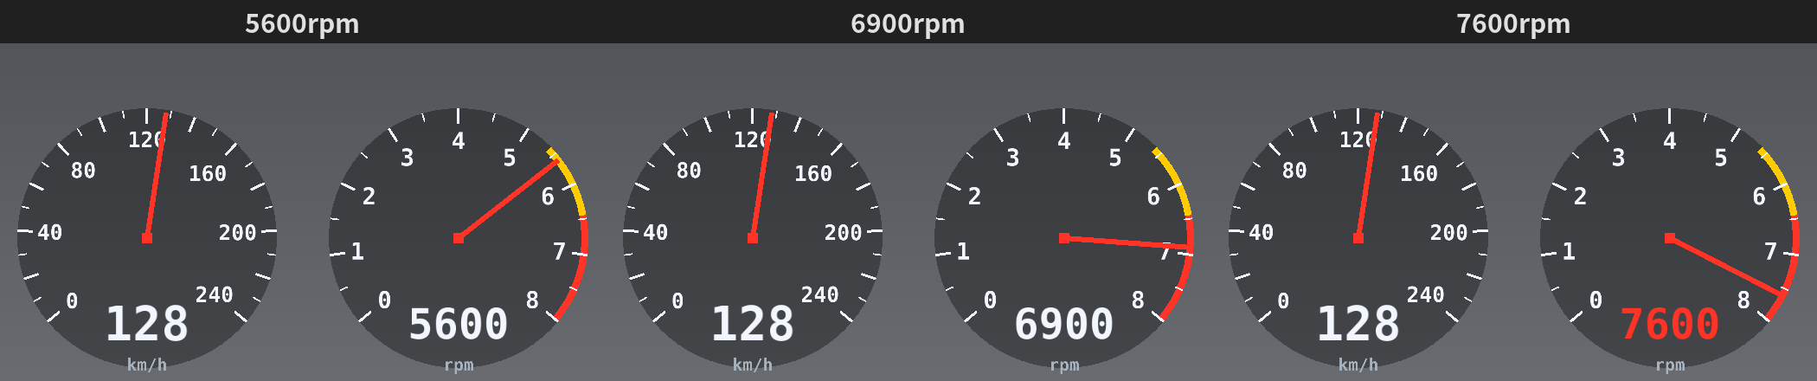
outputs/hud_rpm_20261107/compare_rpm.png
