ntakao2006-web/RaceCapture/outputs/hud_rpm_20261107/hud_5600.png

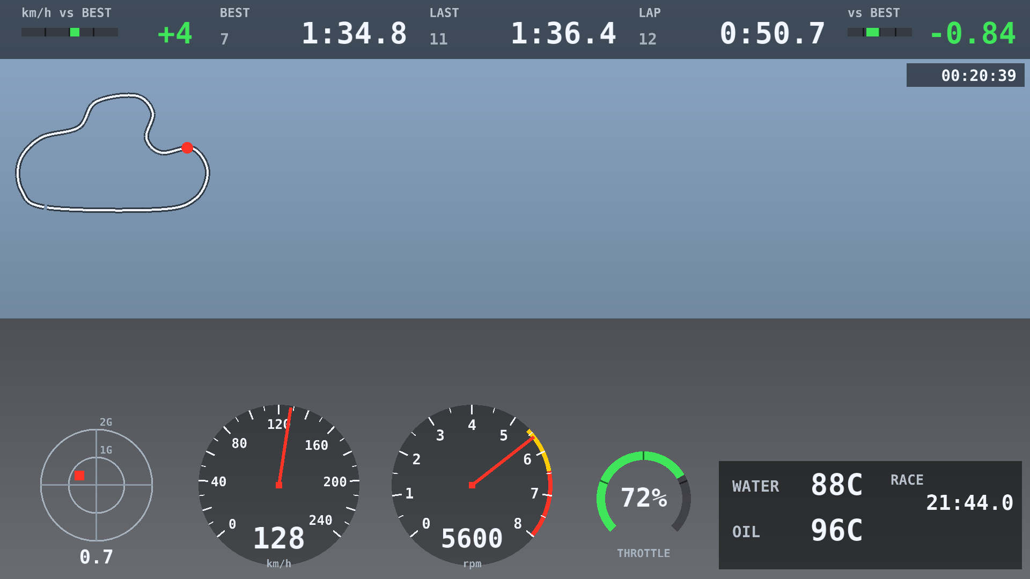
outputs/hud_rpm_20261107/hud_5600.png
