ntakao2006-web/RaceCapture/outputs/imu_gravity_review_20261104/v2_longaccel_drift.png

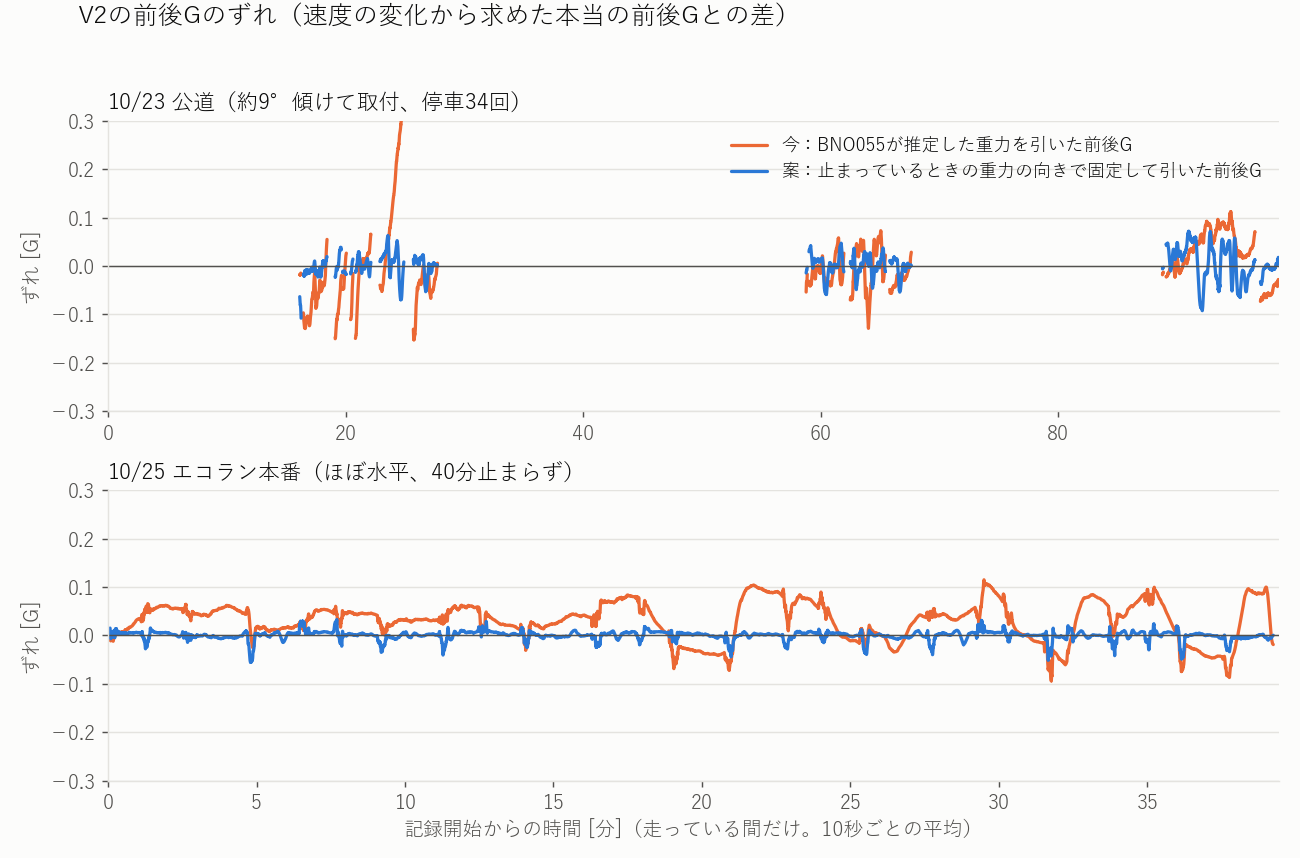
outputs/imu_gravity_review_20261104/v2_longaccel_drift.png
