ntakao2006-web/RaceCapture/outputs/logger_v2_bench_20261001/production/web_final_dashboard.png

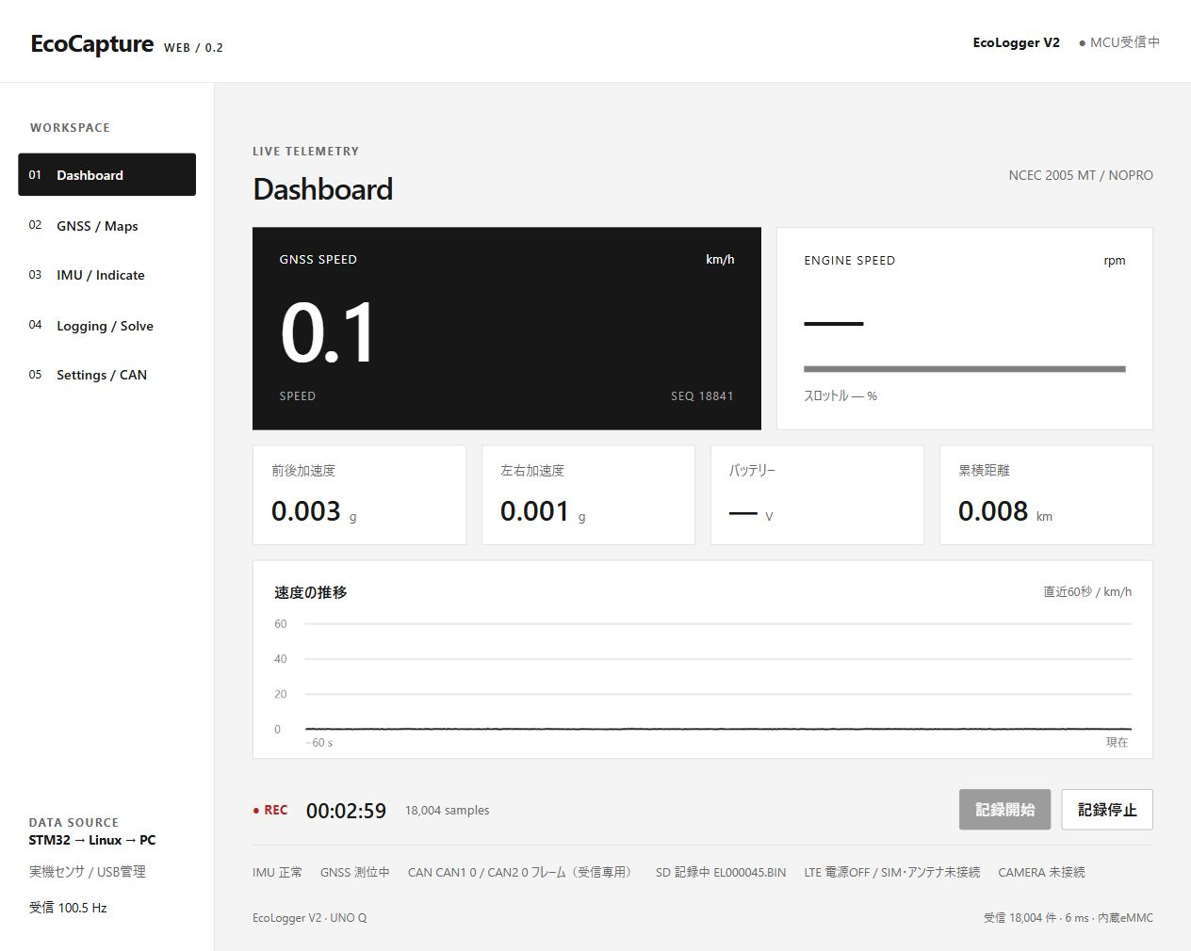
outputs/logger_v2_bench_20261001/production/web_final_dashboard.png
