ntakao2006-web/RaceCapture/outputs/lte_podium_20261002/web_lte_settings.png

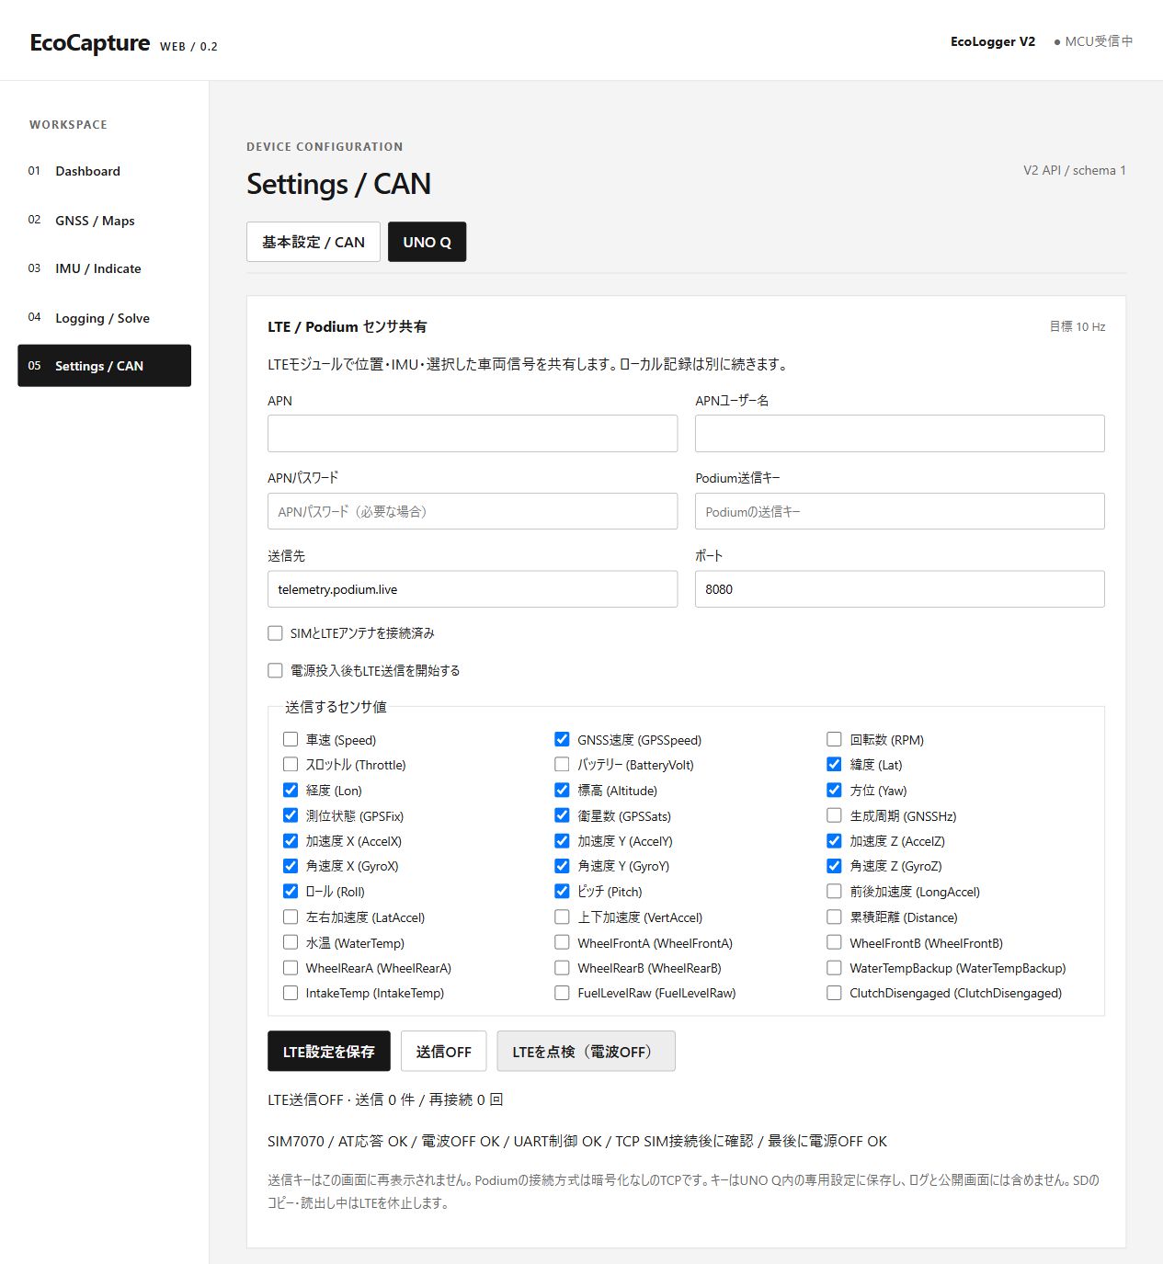
outputs/lte_podium_20261002/web_lte_settings.png
