ntakao2006-web/RaceCapture/outputs/needle_smooth_20261107/needle_rpm_compare.png

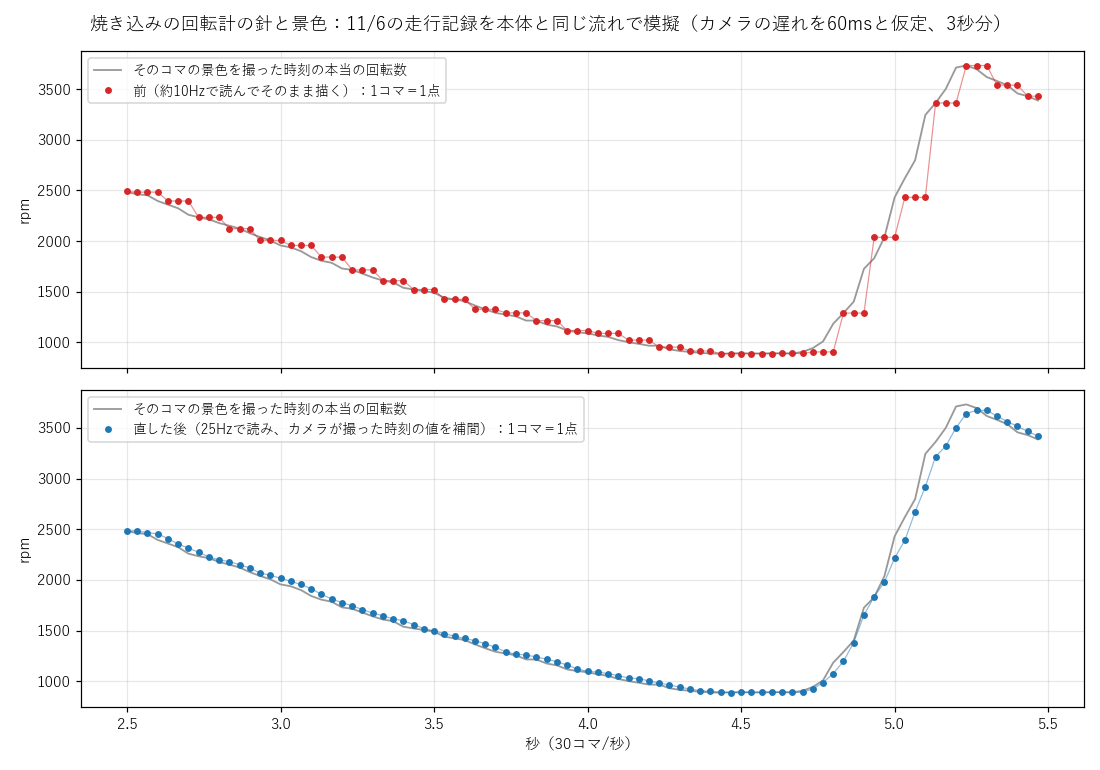
outputs/needle_smooth_20261107/needle_rpm_compare.png
