ntakao2006-web/RaceCapture/outputs/sensorhub_20261019/oiltemp_status/ecocapture-oiltemp-open.png

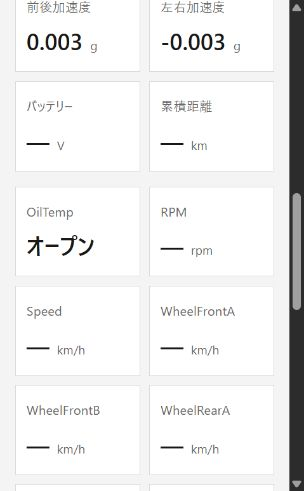
outputs/sensorhub_20261019/oiltemp_status/ecocapture-oiltemp-open.png
