ntakao2006-web/RaceCapture/outputs/sensorhub_20261019/oiltemp_status/pps-360.png

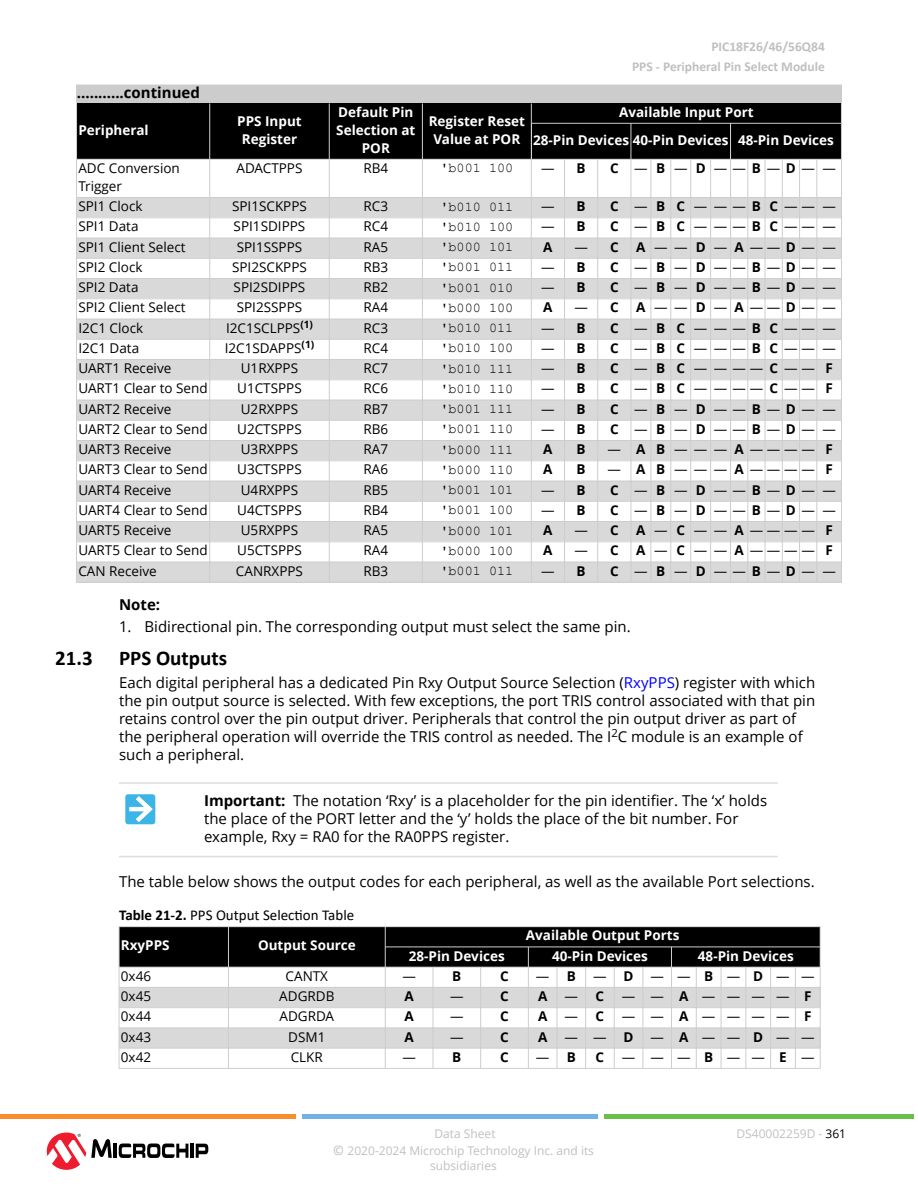
outputs/sensorhub_20261019/oiltemp_status/pps-360.png
