ntakao2006-web/RaceCapture/outputs/sensorhub_20261019/oiltemp_status/pps-366.png

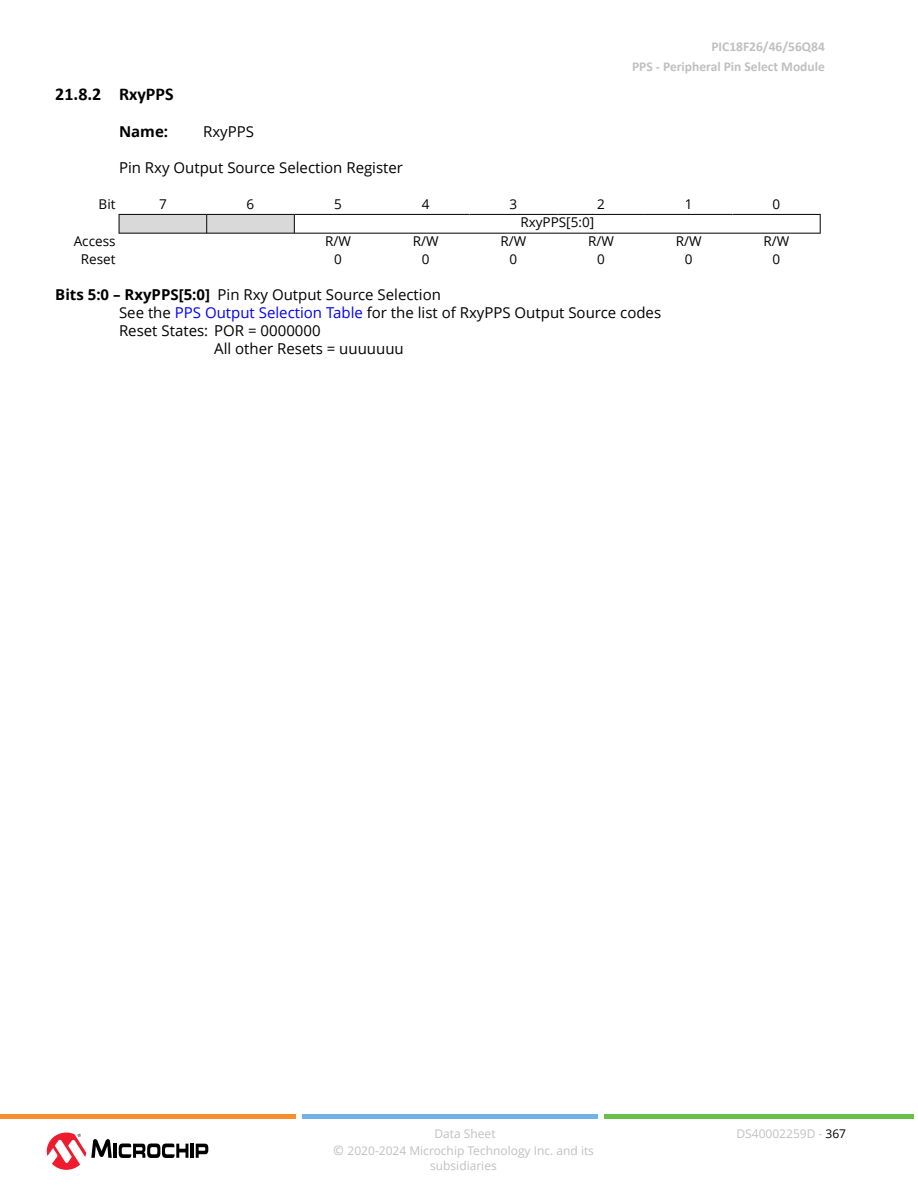
outputs/sensorhub_20261019/oiltemp_status/pps-366.png
