ntakao2006-web/RaceCapture/outputs/sensorhub_20261019/oiltemp_status/racecapture-oiltemp.png

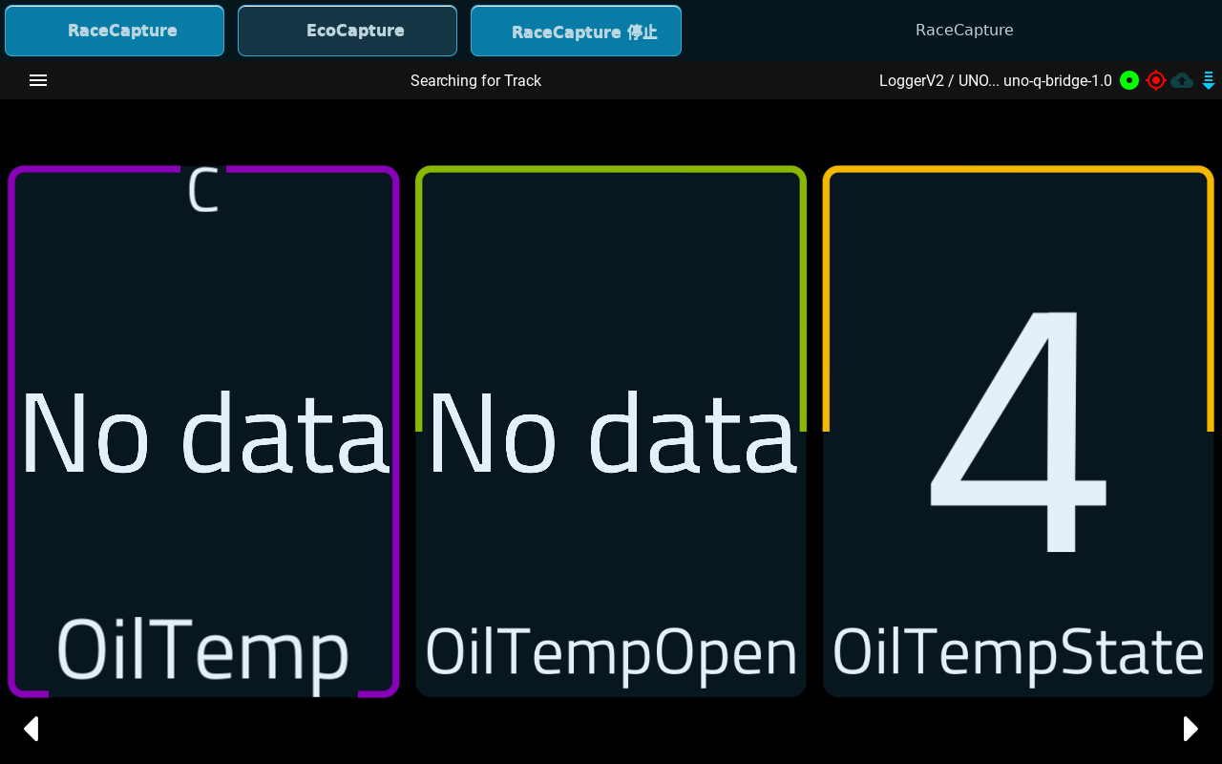
outputs/sensorhub_20261019/oiltemp_status/racecapture-oiltemp.png
