ntakao2006-web/RaceCapture/outputs/sensorhub_schematic_20261020/after.png

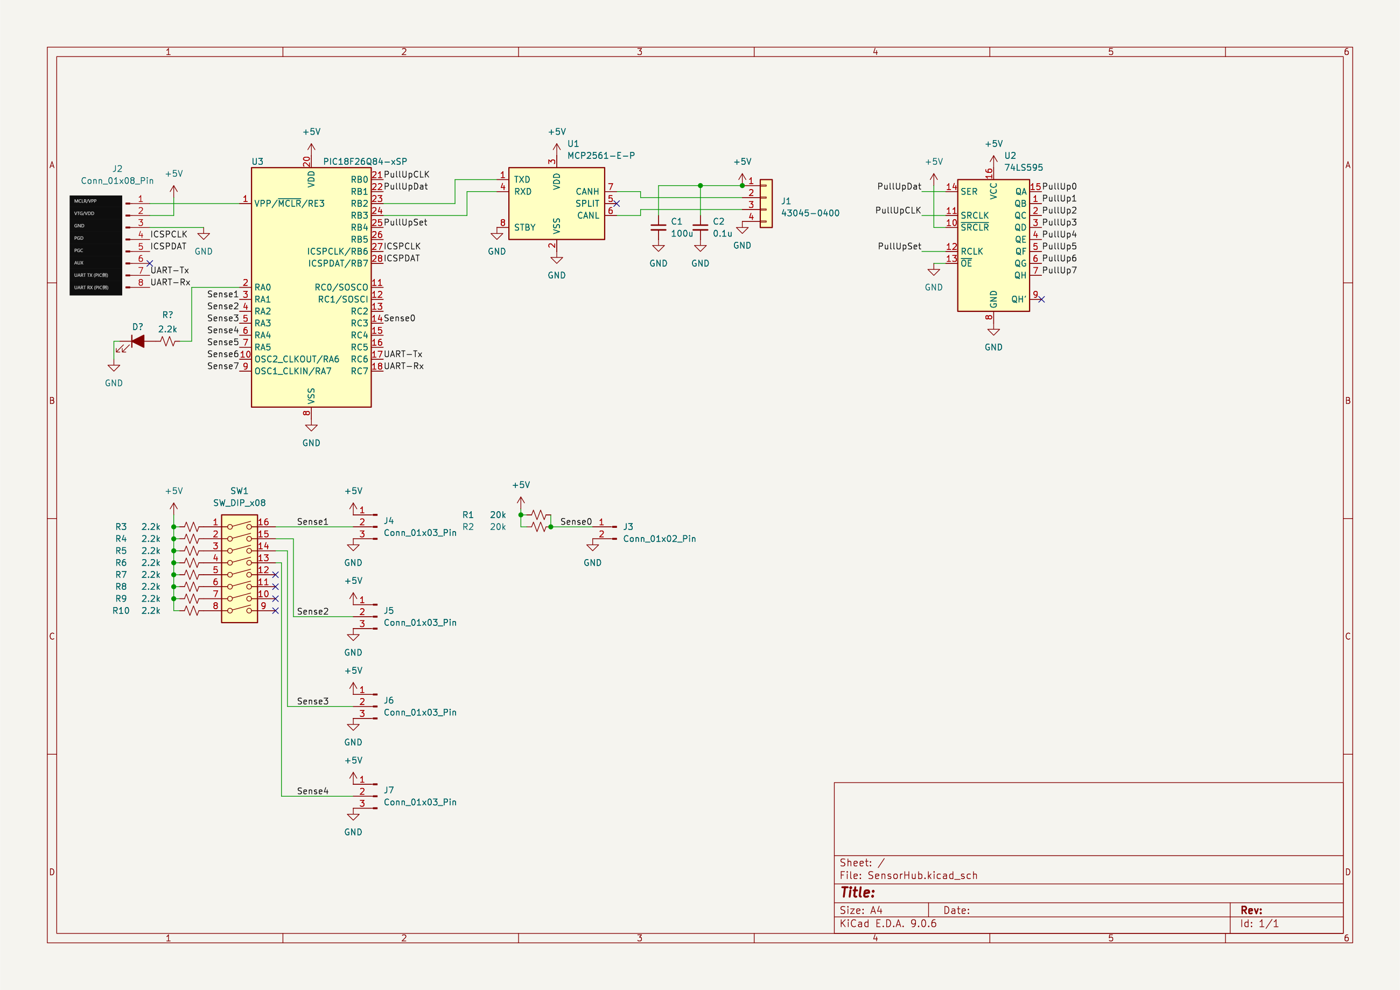
outputs/sensorhub_schematic_20261020/after.png
