ntakao2006-web/RaceCapture/outputs/ups_1set_6000_20261017/ak_substitutions.png

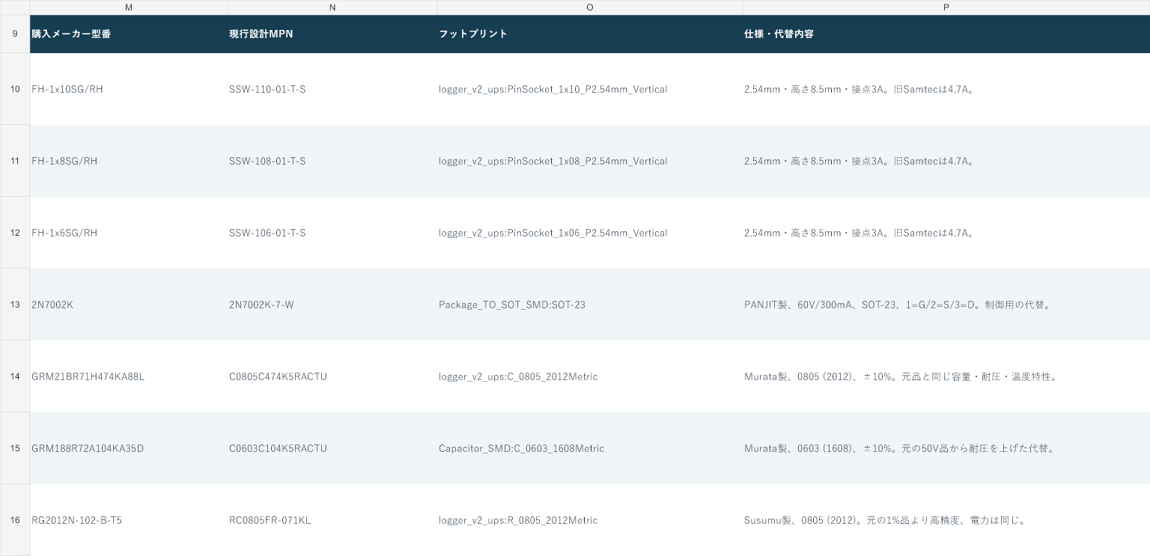
outputs/ups_1set_6000_20261017/ak_substitutions.png
