ntakao2006-web/RaceCapture/outputs/ups_1set_6000_20261017/akizuki.png

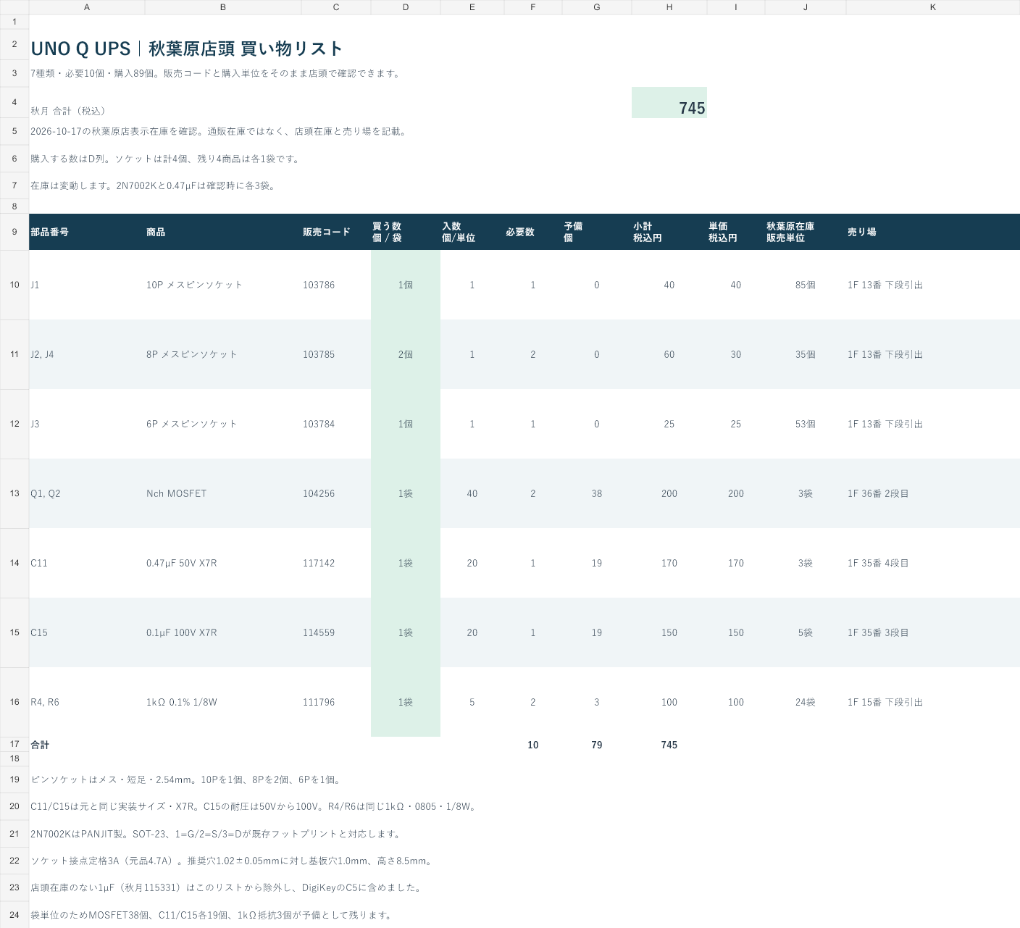
outputs/ups_1set_6000_20261017/akizuki.png
