ntakao2006-web/RaceCapture/outputs/ups_1set_6000_20261017/digikey_bottom.png

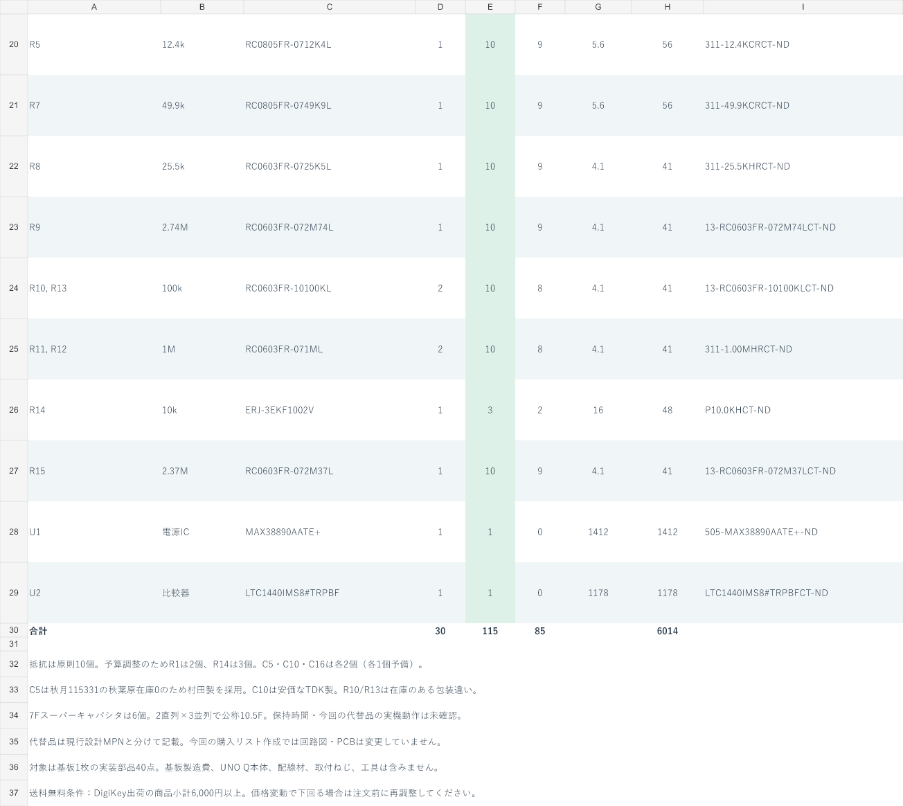
outputs/ups_1set_6000_20261017/digikey_bottom.png
