ntakao2006-web/RaceCapture/outputs/ups_1set_6000_20261017/dk_substitutions.png

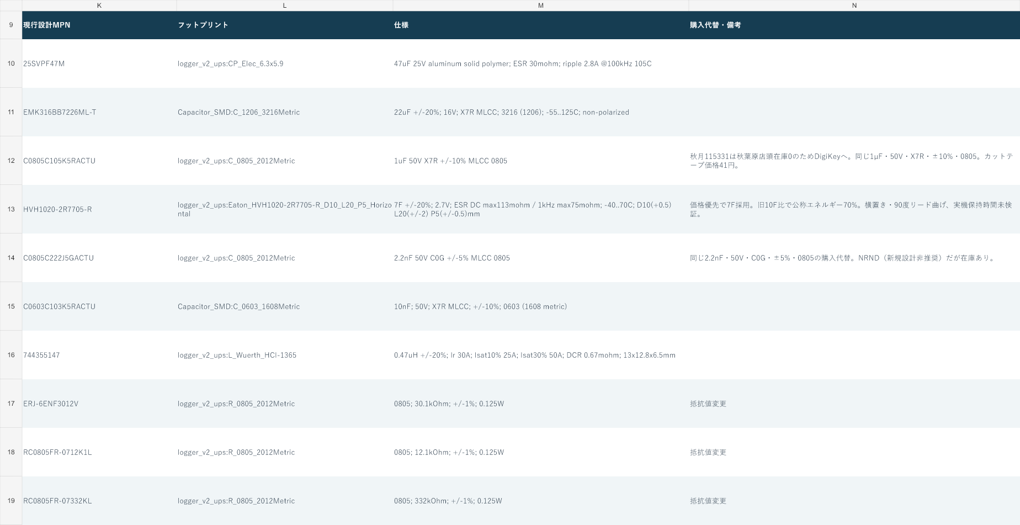
outputs/ups_1set_6000_20261017/dk_substitutions.png
