ntakao2006-web/RaceCapture/outputs/ups_bench_20261022/investigation/uno-q-22.png

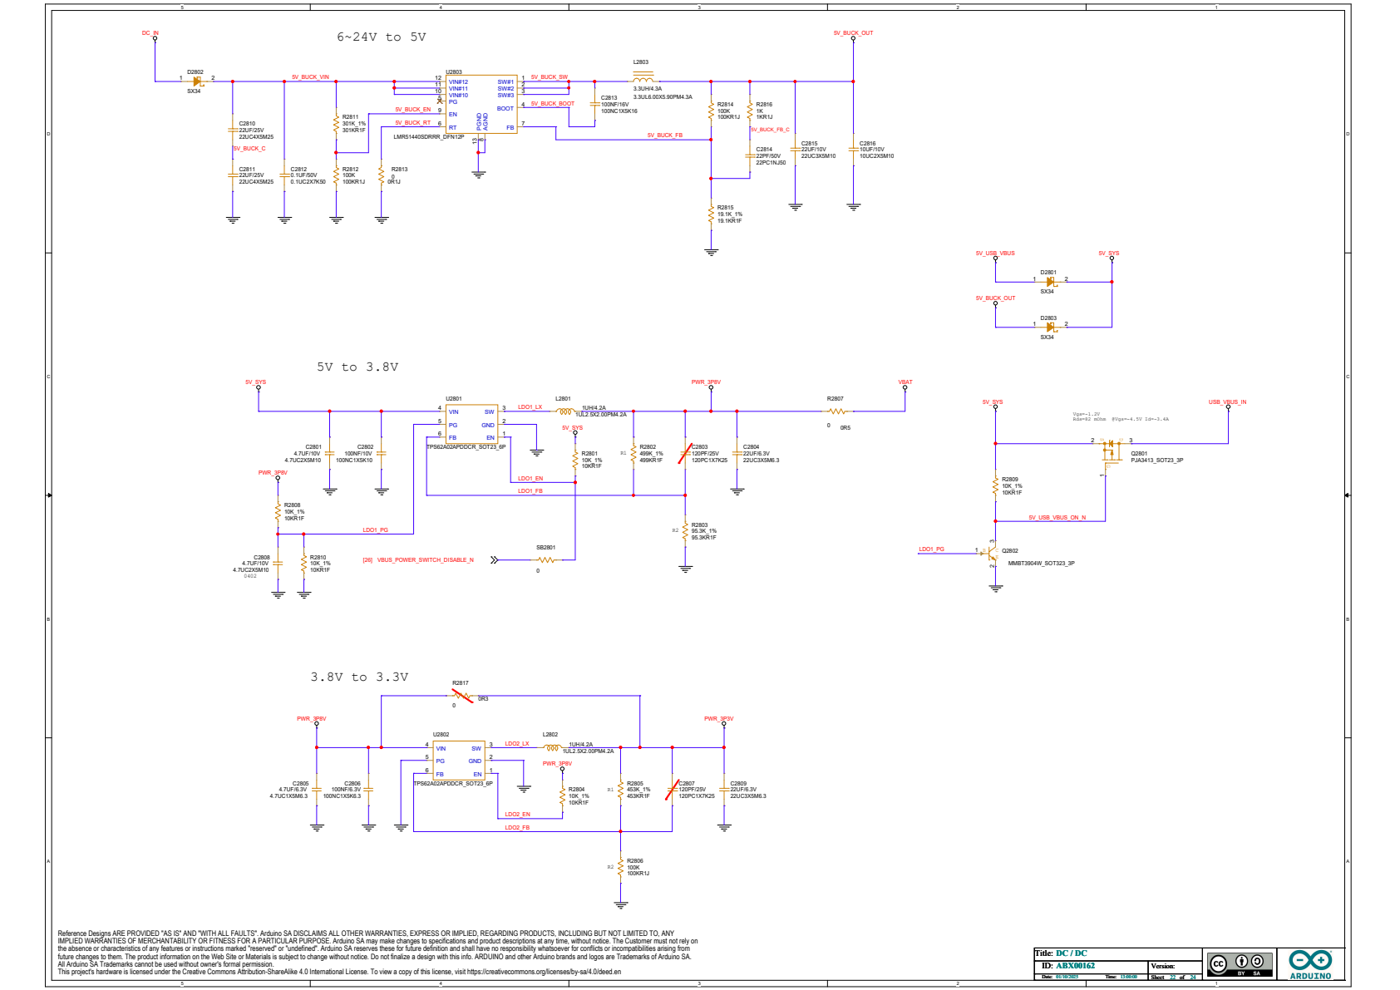
outputs/ups_bench_20261022/investigation/uno-q-22.png
