ntakao2006-web/RaceCapture/outputs/ups_digikey_2sets_20261016/10pcs_top.png

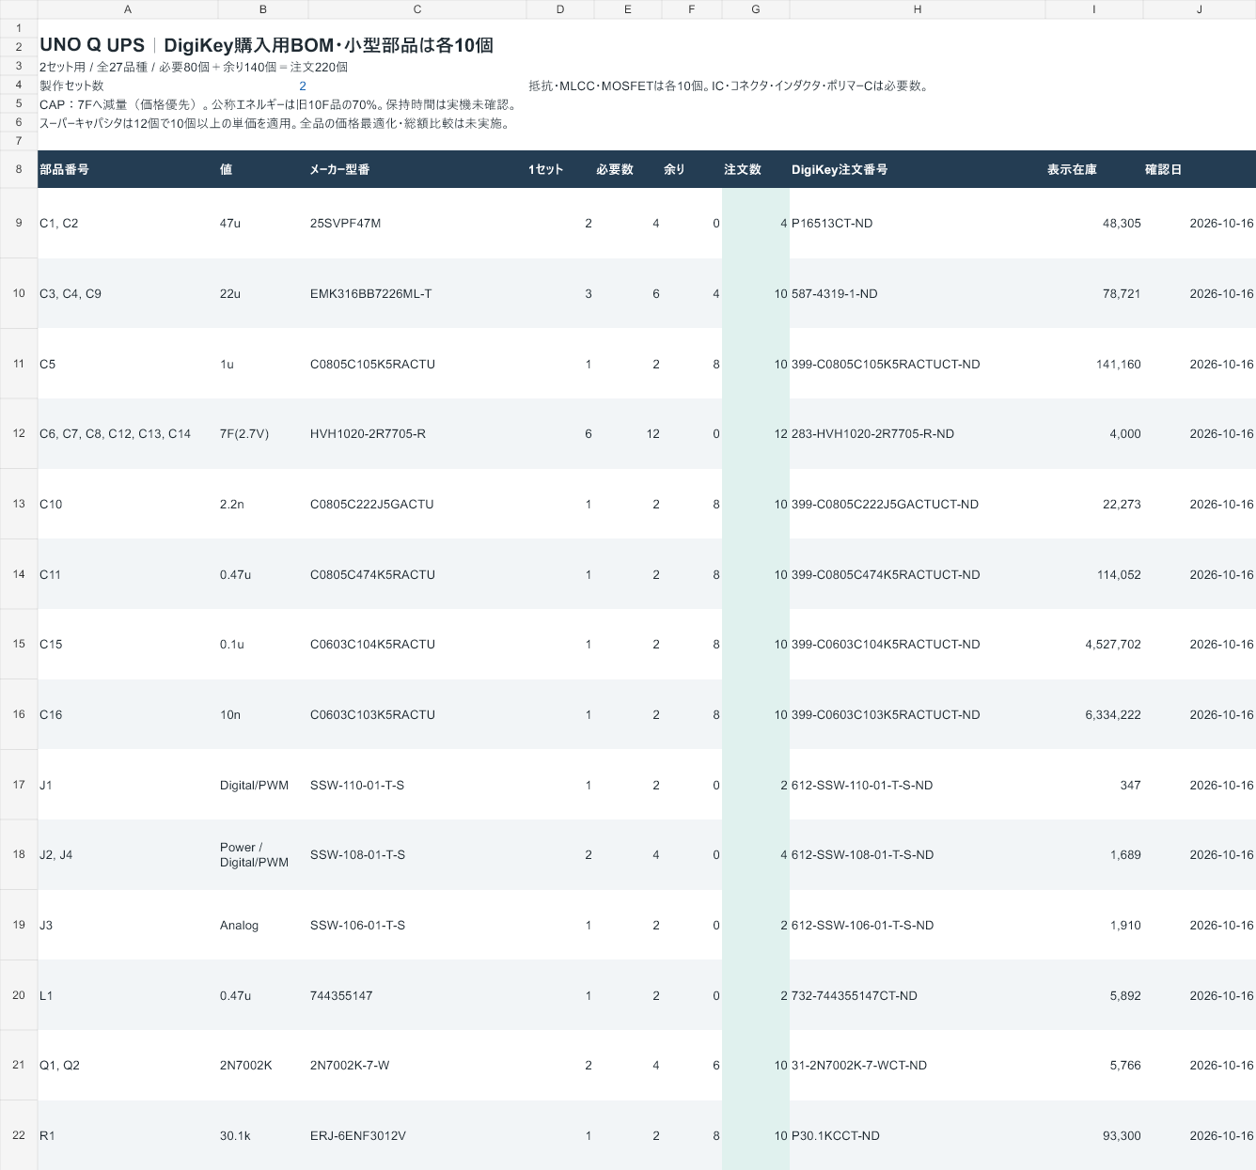
outputs/ups_digikey_2sets_20261016/10pcs_top.png
