ntakao2006-web/RaceCapture/outputs/ups_digikey_2sets_20261016/details_bottom.png

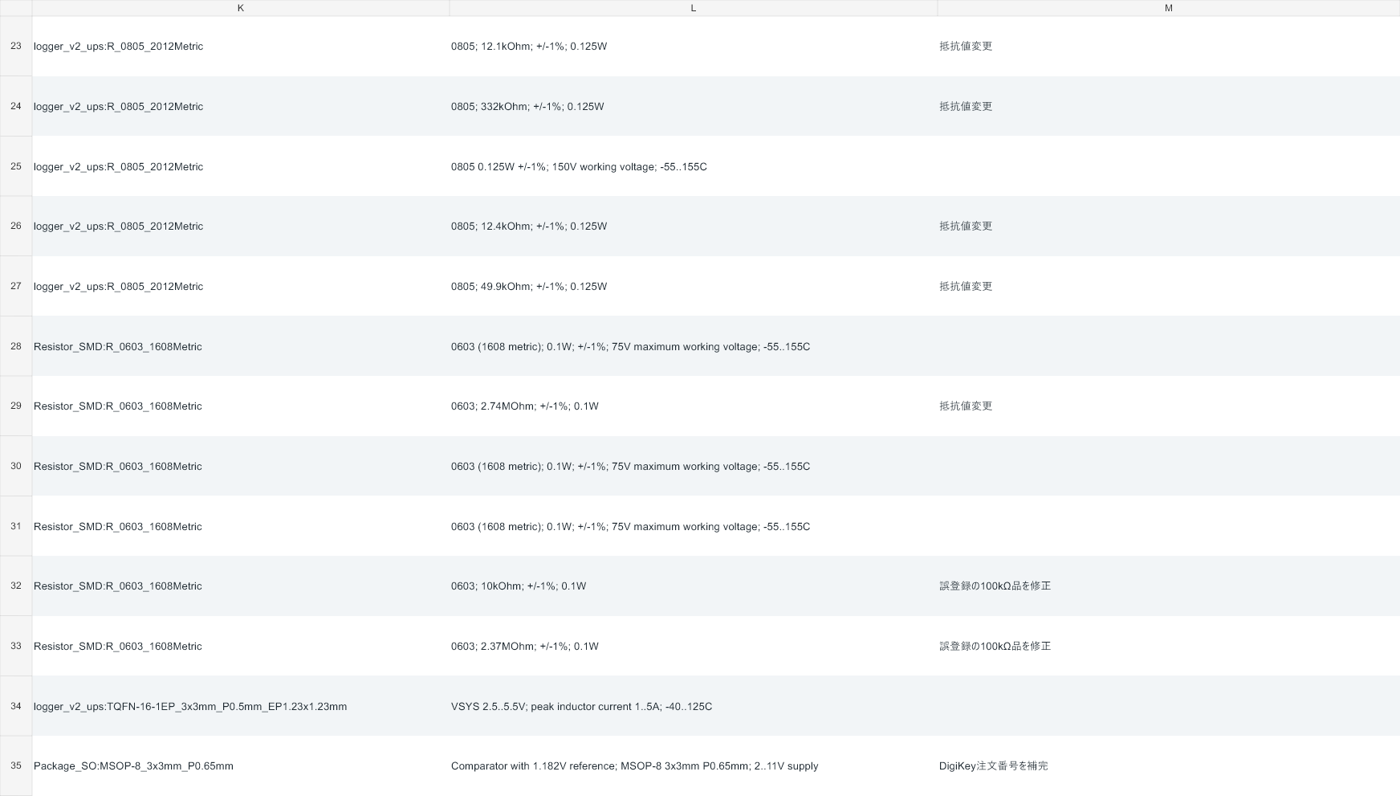
outputs/ups_digikey_2sets_20261016/details_bottom.png
