ntakao2006-web/RaceCapture/outputs/ups_digikey_2sets_20261016/schematic.png

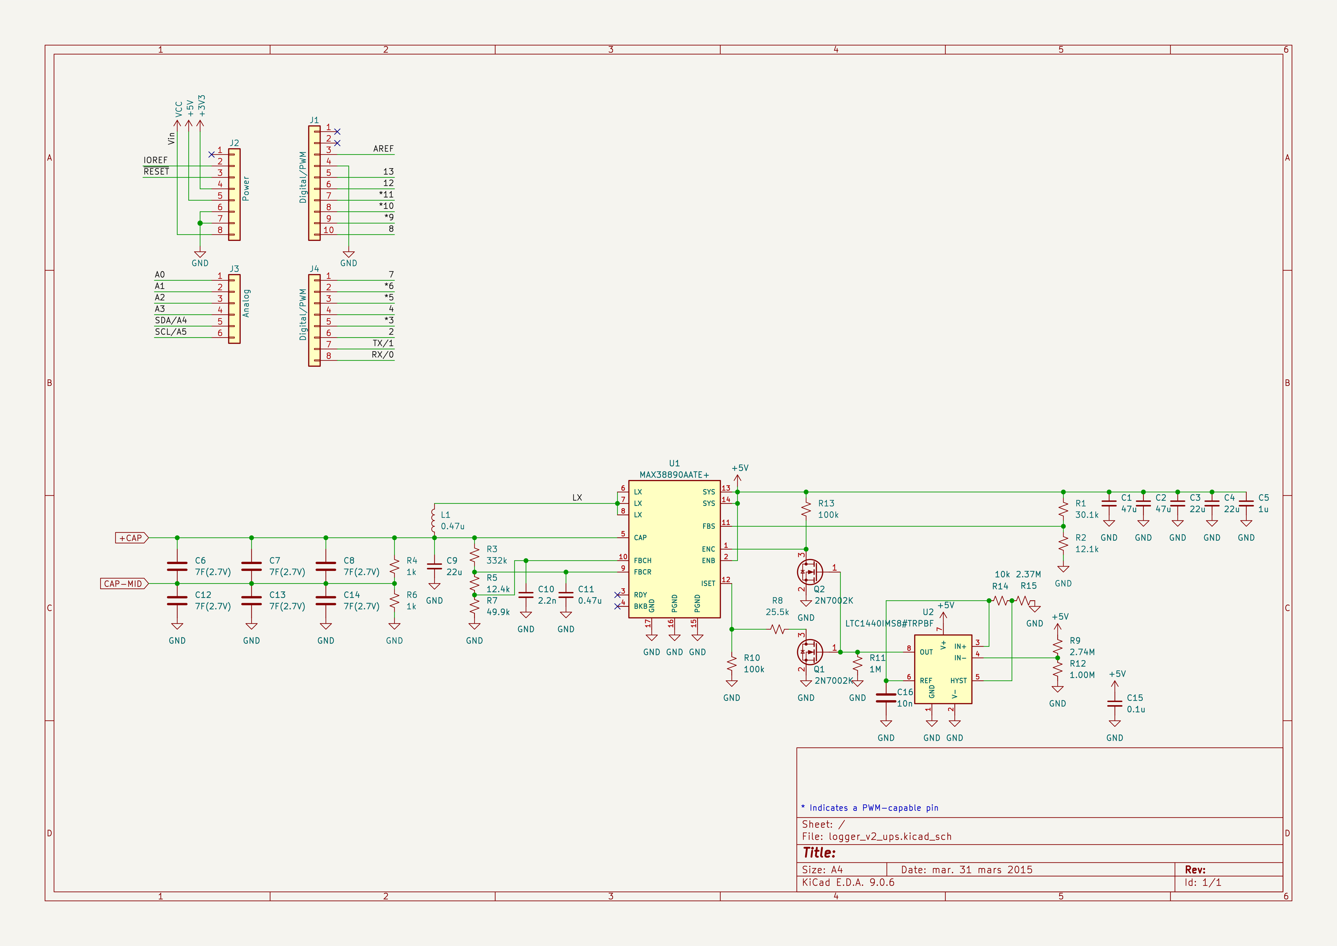
outputs/ups_digikey_2sets_20261016/schematic.png
