ntakao2006-web/RaceCapture/outputs/ups_revision_20261016/two_sets_bottom.png

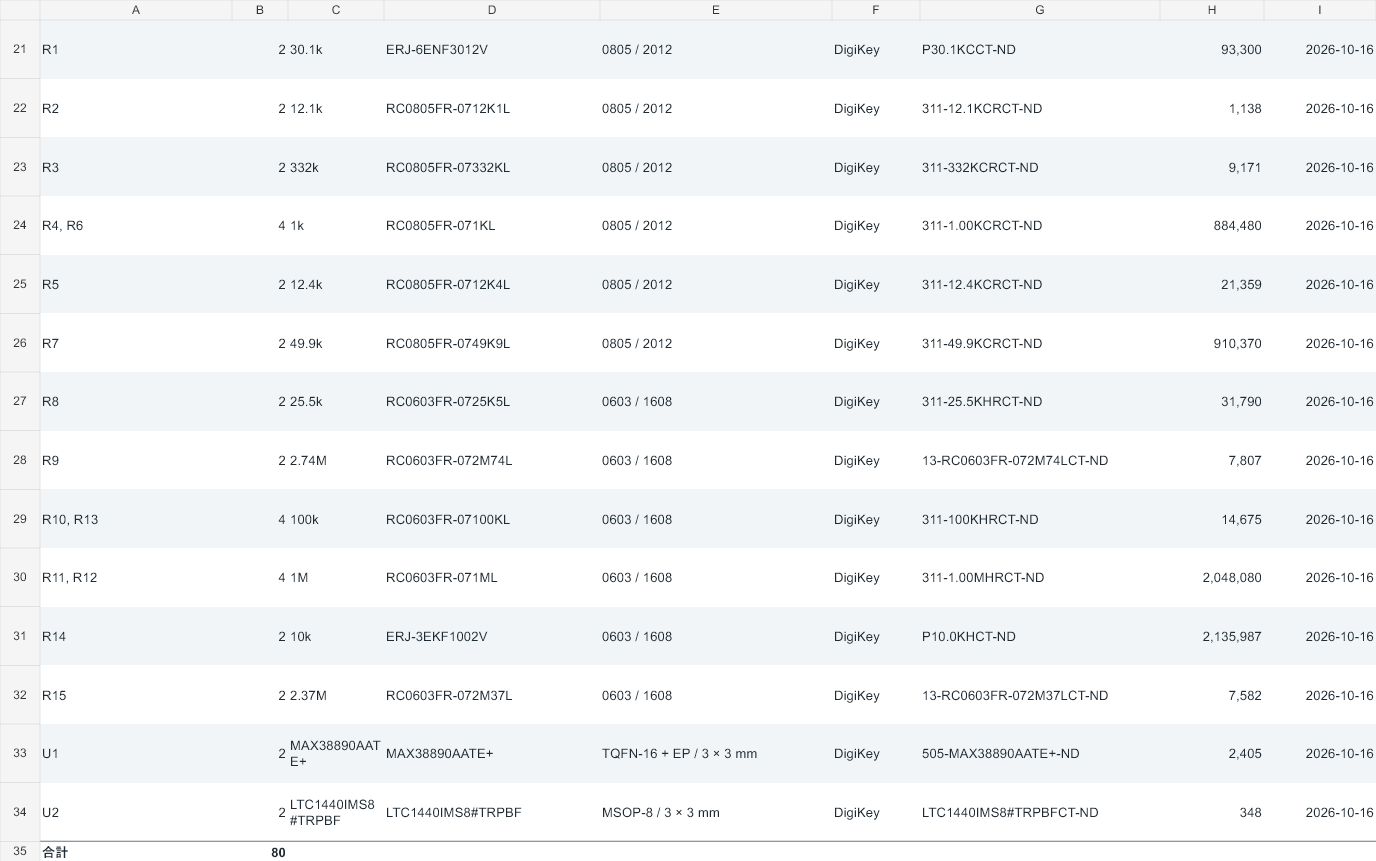
outputs/ups_revision_20261016/two_sets_bottom.png
