ntakao2006-web/RaceCapture/outputs/ups_split_2sets_20261016/akizuki.png

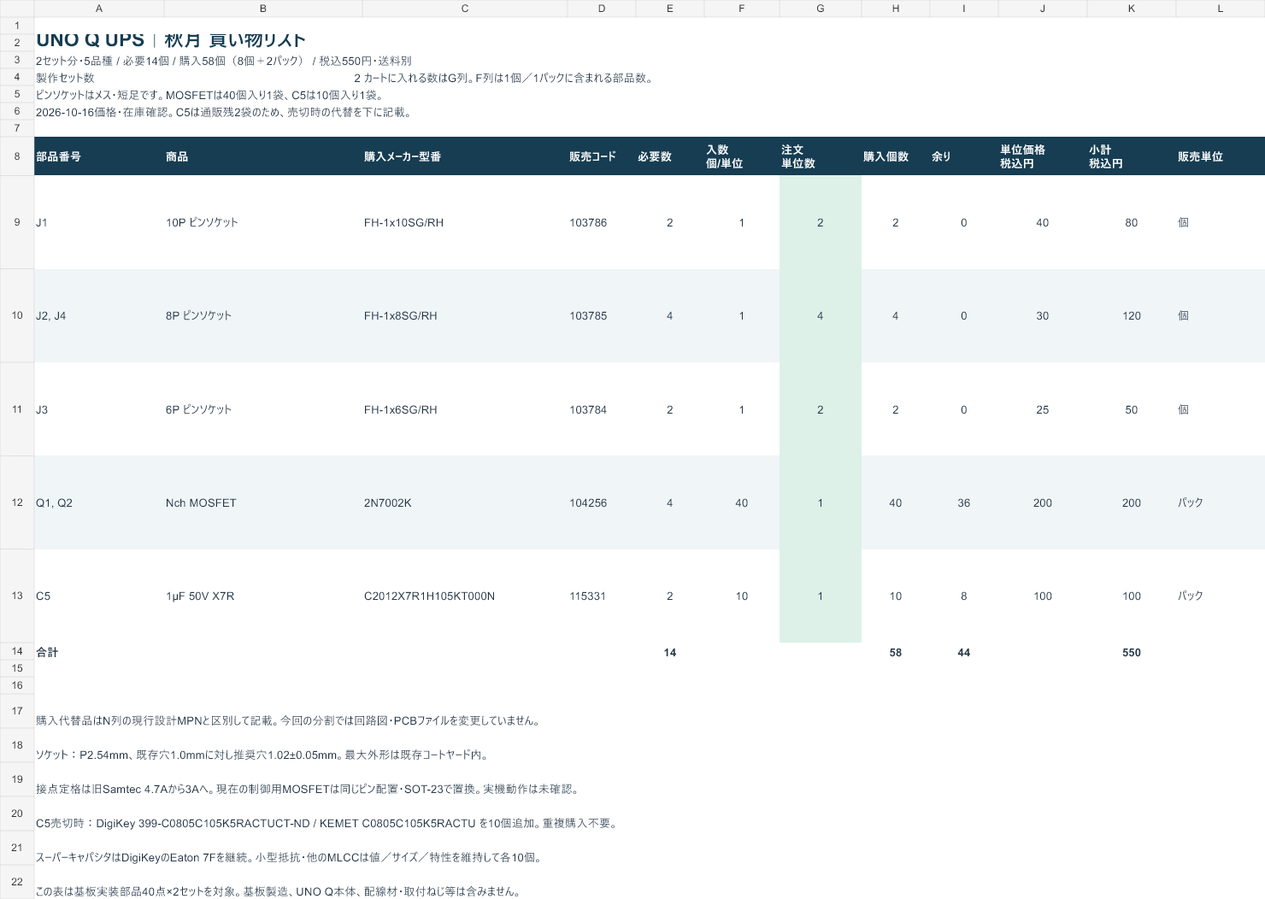
outputs/ups_split_2sets_20261016/akizuki.png
