ntakao2006-web/RaceCapture/er12_mpp_soc_harness_bom.md

# ER-12 MPP充電器→CAN解析基板 測定用ハーネス 部品表（2026-10-19）

`task_ecorun_20261024_breakdown.md` ER-12-2 で作るハーネスの部品表。秋月版と千石版を並べる。
価格は税込・2026-10-19に各社の通販ページで確認した値（送料別）。

## 構成

```
MPP充電器 背面 CAN計測コネクタ（DIN 41524 5ピン メス）
   └ DINプラグ（オス 5P 180°）
       └ 120Ω CANケーブル（手持ち、1m以内）
           └ Micro-Fit 3.0 レセプタクルハウジング 43025-0400 ＋ メス端子 43030（手持ち）
               ＝ Micro-Fit 3.0 プラグハウジング 43020-0400 ＋ オス端子 43031（基板側の短い引き出し線）
                   └ CAN解析基板（XIAO ESP32-C3＋MCP2562FD）、ファームは can_logger の env esp32-c3-mpp-soc
```

- 受信機は**CAN解析基板**（2026-10-19ユーザー判断）。Ver.1（ecologger_v1）の J4/J5 は終端120Ω（R27/R35、0603）が直付けで外せないので**つながない**。
- Micro-Fit側のピン割り当ては Ver.1 の J4/J5 と同じにする（1=+5V／2=CANH／3=CANL／4=GND）。
  **ハーネスの1番は端子を入れず空けておく**（Ver.1 の1番は+5V出力。挿し間違えても充電器へ電圧が行かないように）。

## 結線表

| DIN（充電器側） | 信号 | Micro-Fit（43025、ハーネス側） | 基板側（43020→MCP2562FD） |
|---|---|---|---|
| 1 | CAN Hi | 2 | CANH（pin7） |
| 2 | CAN Low | 3 | CANL（pin6） |
| 3 | GND | 4 | GND |
| 4・5 | 未使用 | — | — |
| — | （Ver.1では+5V） | 1：**空き（端子を入れない）** | 空き |

- DINのピン番号は並び順どおりではない（外周の並びは 1-4-2-5-3）。プラグの刻印と主催者資料5ページの写真で確認してからはんだ付けする。
- CAN Hi/Low はケーブルのより対線に割り当てる。GNDには3本目の芯線（無ければドレイン線）を使う。
- **基板の卓上終端120Ωを外す**（資料の指定。充電器側のバスはすでに終端されている）。

## 秋月電子版

| # | 品名 | 型番 | 販売コード | 単価 | 数量 | 小計 | 用途 |
|---|---|---|---|---|---|---|---|
| 1 | DINプラグ(オス) 5P 180° | DIN-PA-5A | 109386 | ¥150 | 2 | ¥300 | 充電器側。1個は予備（はんだ付けで樹脂を溶かしたとき用） |
| 2 | 熱収縮チューブ スミチューブC 黒 Φ1.5×1m | SUMITUBE-C-1.5x0.2x1m-BLK | 106788 | ¥40 | 1 | ¥40 | DINのはんだカップを1本ずつ絶縁 |
| 3 | 熱収縮チューブ スミチューブC 黒 Φ6×1m | SUMITUBE-C-6x0.25x1m-BLK | 106790 | ¥60 | 1 | ¥60 | ケーブル両端の外被の割れ目・引っ張り対策 |
| | | | | | | **¥400** | |

- **秋月は Micro-Fit 3.0 を扱っていない**。基板側のプラグハウジング 43020-0400・オス端子 43031-0007 が手持ちに無ければ、そこだけ千石版の#4・#5を買う（¥405）。

## 千石電商版

| # | 品名 | 型番 | 管理コード | 単価 | 数量 | 小計 | 用途 |
|---|---|---|---|---|---|---|---|
| 1 | DINプラグ ストレート 5P(180°) | マル信無線電機 MP-132-1 | 3AJT-NJLK | ¥210 | 2 | ¥420 | 充電器側。1個は予備。**240°の MP-133-1 と取り違えない** |
| 2 | スミチューブA 1.5 黒 Φ1.5×1m | — | 76MI-4GFV | ¥200 | 1 | ¥200 | DINのはんだカップの絶縁 |
| 3 | スミチューブA 6.0 黒 Φ6×1m | — | 76SI-5GFD | ¥200 | 1 | ¥200 | ケーブル両端の外被 |
| 4 | 3.0mmピッチ プラグハウジング4P | Molex 43020-0400 | EEHD-6HAC | ¥105 | 1 | ¥105 | 基板側の引き出し線（手持ちに無ければ） |
| 5 | プラグハウジング用コンタクトピン（10個入） | Molex 43031-0007 | EEHD-6NFH | ¥300 | 1 | ¥300 | 同上 |
| | | | | | | **¥820**（#4・#5込みで¥1,225） | |

- 在庫は、DINプラグが秋葉原2号店2階・大阪、Micro-Fitが秋葉原本店地下1階・大阪、熱収縮チューブが秋葉原本店2階・大阪（2026-10-19時点）。
- L型のDINプラグ（MP-132L-1、¥263）なら、充電器の背面でケーブルを横へ逃がせる。

## 手持ちで使うもの（買わない）

- 120Ω CANケーブル（1m以内に切る）
- Micro-Fit 3.0 レセプタクルハウジング 43025-0400、メス端子 43030-0007
- Micro-Fit 3.0 プラグハウジング 43020-0400、オス端子 43031-0007（基板側。2026-10-19に手持ちと確認したので、上の表の「手持ちに無ければ」の分は買わない）
- テスター（導通・短絡の確認）、はんだごて、Micro-Fit用の圧着工具、結束バンド

## 買う前に確認すること

- **Micro-Fitの端子に適合する電線は AWG20〜24・被覆外径1.85mm以下**（千石の商品ページに記載の仕様）。→ 手持ちのCANケーブルは太さに問題なし（2026-10-19ユーザー確認）。
- 手持ちのCANケーブルが2芯（より対線1組）だけの場合、GNDはドレイン線かシールドを使う（資料ではGNDは「推奨」）。
