ntakao2006-web/RaceCapture/outputs/logger_v2_order_20260923/手元部品チェックリスト.md

# logger_v2・基板1台分 手元部品チェックリスト

照合元：最新の `bom_data.json` / `DigiKey_upload.csv` と、ユーザーの `2026-09-23T081630.csv`。
数量は予備を含まない実装必要数です。チェック欄は、実物の数量・型番・サイズを確認してから記入してください。CSVから消えたこと自体は、実物の在庫確認を意味しません。

## 今回のCSVから削除された部品

- [ ] **100nF（0.1µF）コンデンサ：14個** — 0603インチ／1608メートル、X7R、±10%。BOM選定品は100VのGRM188R72A104KA35D。手持ちの耐圧・温度特性が異なる場合は別途適合を確認。実装位置：C3、C4、C5、C6、C14、C17、C19、C21、C22、C23、C24、C25、C26、C27。
- [ ] **PEC3824C2A-AU：2個** — SOT-23、24V双方向2線TVS。実装位置：D1、D4。ユーザー指定の手持ち品で、購入BOMのESDCAN24-2BLYを置き換える。手持ち申告済み、数量を確認。
- [ ] **MCP25625T-E/SS または同一デバイスの/SS品：1個** — SSOP-28、ボディ幅5.3mm、ピッチ0.65mm。実装位置：U4。末尾Tはリール梱包。別パッケージやMCP2515とは異なる。
- [ ] **TC74HC595AF：1個** — SOP-16、ボディ幅5.3mm、ピッチ1.27mm。実装位置：U8。購入BOMはTC74HC595AF(EL,F)。一般的な幅3.9mm SOIC-16の74HC595は、そのままの代替として扱わない。

| 削除されたDigiKey品番 | 元の購入数（予備込み） | 手元に必要な実装数 |
|---|---:|---:|
| 490-3285-1-ND | 25 | 14 |
| 497-13262-1-ND | 4 | 2（PEC3824C2A-AUを使用） |
| MCP25625T-E/SSCT-ND | 1 | 1 |
| 264-TC74HC595AF(EL,F)CT-ND | 2 | 1 |

## 最初からBOMの購入対象外にしていた手持ち品

- [ ] **4.7kΩ抵抗：2個** — 0603インチ／1608メートル、0.1W以上。R2、R3。
- [ ] **10kΩ抵抗：3個** — 0603インチ／1608メートル、0.1W以上。R7、R9、R12。R13は未実装なので含めない。
- [ ] **BNO055モジュール：1個** — 基板フットプリントは秋月AE-BNO055-BO用。U1。BNO055単体ICではない。
- [ ] **GNSS MAX-M10M-00B：1個** — LCC-18のモジュール本体。U5。別の変換基板ではない。
- [ ] **microSDスロット 47219-2001：1個** — 現在の専用フットプリントに合うもの。J12。nanoSIMソケットJ11とは別。
- [ ] **SMAコネクタ S-037-TGG：2個** — 横向き、現行フットプリントと同じ取付形状。J7、J10。
- [ ] **2.54mmピッチ・1×8ピンヘッダ：2本** — J1、J4。
- [ ] **2.54mmピッチ・1×6ピンヘッダ：1本** — J2。
- [ ] **2.54mmピッチ・1×10ピンヘッダ：1本** — J3。
- [ ] **2.54mmピッチ・1×2ピンヘッダ：2本** — J5、J8。

ピンヘッダは基板上の割り当てを記載しています。相手基板との嵌合に合うピン長も実物で確認してください。

## 数量だけ減った部品（手持ちでの補充は不要）

| 実装位置 | 部品 | 元の購入数 → CSV数量 | 実装必要数 | CSV数量から残る予備 |
|---|---|---:|---:|---:|
| C7 | 6SVPC330M、330µF・6.3Vポリマー | 2 → 1 | 1 | 0 |
| J11 | 2452796-1、nanoSIMソケット | 2 → 1 | 1 | 0 |
| R15 | RMCF2512JT27R0、27Ω・1W・2512 | 3 → 2 | 1 | 1 |
| U9、U10 | USBLC6-4SC6Y | 4 → 3 | 2 | 1 |

## 照合結果

- 元の購入BOM：31品目、189個（予備込み）。
- 今回のCSV：27品目、153個（予備込み）。新規追加・未照合の品番はなし。
- 完全削除：4品目、購入予定32個分。基板上の実装数では18個分。
- 数量削減：4品目、合計4個。すべて実装必要数以上。
- 手元で用意するもの：今回18個分＋従来16個分＝**34個分**。
- 部品数の照合：CSVで購入する実装61個＋手持ち34個＋未実装3個＝基板上98部品。
- **C16、C18、R13はDNP（未実装）なので準備不要。**

元のBOM・KiCadファイルは、この照合作業では変更していません。D1・D4の手持ちPEC品との対応は、このチェックリストに記録しています。
