ntakao2006-web/RaceCapture/circuit/logger_v2/受動部品フットプリント_20260922.md

# 受動部品フットプリント更新（2026-09-22）

対象は現在の logger_v2.kicad_sch / logger_v2.kicad_pcb。参照番号は旧実装方針の表ではなく現物に従う。比較元はLoggerV1の本回路図とPCB。

|部品|表示値|採用品・フットプリント|対応|
|---|---|---|---|
|C15,C23|1u|TDK C2012X7R1H105KT000N、logger_v2_custom:C_0805_2012Metric|V1と同じ2012。秋月115331。V1に型番指定はないため同一型番とは断定しない|
|L2|0.027u|Murata LQW18AN27NJ00D、logger_v2_custom:L_0603_1608Metric|V1 L1と同じ型番・1608サイズ|
|L1|2.2u|Murata DFE252012P-2R2M=P2、logger_v2_expansion:L_Murata_DFE252012P|V1に対応品なし。電源用部品へ修正|
|C7|330u|Panasonic 6SVPC330M、logger_v2_expansion:CP_Elec_6.3x5.9|DigiKey P16611CT-ND。6.3V、ESR17mΩ、SMD導電性高分子アルミ固体電解（OS-CON）|
|C1,C2,C8,C12,C13,C20,C21,C22|10u|GRM21BR71A106KE51、logger_v2_custom:C_0805_2012Metric|秋月117593の積層セラミックを維持（8個）|
|C16,C18|1p|YAGEO CC0603CRNPO9BN1R0、logger_v2_custom:C_0603_1608Metric|定数とフットプリントを維持。コピー元の100nF購入情報を1pF C0Gへ訂正|
|その他の小容量C|0.1u,0.01u,15p|logger_v2_custom:C_0603_1608Metric|V1と同じ1608系を維持|

100uは現在のV2には存在せず、追加していない。今後使う場合はV1のスルーホール品を踏襲せず、使用電圧・ESR・リップル電流に適合するDigiKey取扱いの導電性高分子アルミ電解SMDを選定する。

## 根拠・購入先

- [1uF 50V X7R 2012／秋月115331](https://akizukidenshi.com/catalog/g/g115331/)
- [10uF MLCC／秋月117593](https://akizukidenshi.com/catalog/g/g117593/)
- [330uF DigiKey購入先](https://www.digikey.jp/ja/products/detail/panasonic-industry/6SVPC330M/4204943)、[メーカー仕様](https://industrial.panasonic.com/jp/products/pt/os-con/models/6SVPC330M)：直径6.3mm、高さ公称5.9mm（最大6.0mm）。確認時DigiKeyの在庫表示あり。
- [Bourns仕様](https://www.bourns.com/docs/product-datasheets/srn6045ta.pdf)、[DigiKey購入先](https://www.digikey.com/en/products/detail/bourns-inc/SRN6045TA-2R2Y/6155102)
- [Murata仕様](https://pim.murata.com/asset/pim4/inductor/JELF243A-0024_PDF_INDUCTOR)
- [1pFメーカー仕様](https://www.yageogroup.com/download/specsheet/CC0603CRNPO9BN1R0)、[DigiKey購入先](https://www.digikey.jp/ja/products/detail/yageo/CC0603CRNPO9BN1R0/302783)

## 反映・検証範囲

- 回路図とPCBで5部品のフットプリントを変更し、上記7部品の購入情報を同期。既存のローカルライブラリと3Dモデルを使用。
- 値、配線、ネット、部品位置・角度、PCB配線2本とゾーン、その他の部品は変更前後の構造比較で保持。IMUのランド・穴とIMU/GNSSのシルク変更も保持。
- C7はパッド1=+3V8、パッド2=GND。シンボル形状は変更していない。実装時はフットプリントの正極表示に従う。
- KiCadによる回路図ネットリスト出力、PCB読込、対象部品の3Dプレビューを確認。
- **PCBは配置調整が必要**：大型化したL1は現在位置でU2・D4・C6・R11等と重なり、パッド短絡7件をDRCで検出。L2とD2も外形領域が重なる。部品位置を保持したため未修正。未配線も残っており製造可能状態ではない。
- 記録：output/passive_footprints_20260922.json、表示：output/passive_review_20260922.png、DRC：output/passive_drc_after.json。
- 他の部品の古いFunctionや購入補助フィールドは今回の全体BOM監査対象外。旧参照番号表を現在のBOMとして扱わない。

追記：330uはユーザー指定により高分子アルミ電解へ変更済み。3Dは寸法対応のKiCad汎用円筒モデル。変更記録はoutput/aluminum_polymer_20260922.json。位置・配線・極性は保持。

## L1の2520化（ユーザー指定）

L1はDFE252012P-2R2M=P2に更新。2.5×2.0×1.2mm、2.2uH、温度上昇40℃基準2.2A、L低下30%基準3.0A、DCR最大84mΩ。フットプリントはメーカー推奨ランド0.8×2.0mmを中心±1.0mmに配置（内側間隔1.2mm、外側幅2.8mm）。3Dは同寸法APV ANR252012のKiCadモデルを寸法参考モデルとして使用し、メーカー正式モデルではない。起動・過負荷・温度条件は未実測、電源ICの3A全出力には対応保証しない。

[メーカー仕様](https://www.murata.com/~/media/webrenewal/products/inductor/chip/tokoproducts/wirewoundmetalalloychiptype/m_dfe252012p.ashx)、[DigiKey](https://www.digikey.com/en/products/detail/murata-electronics/DFE252012P-2R2M-P2/5272072)。配線・配置・値を保持し、L1以外の部品も保持。旧大型L1の重なり記述は変更前の履歴。最新DRCはoutput/L1_2520_drc.json。
