ntakao2006-web/RaceCapture/circuit/logger_v2/部品選定_GNSS検証_20260920.md

# logger_v2 部品選定・GNSSアンテナ回路の確認

更新：2026-09-20。対象は現時点の `logger_v2.kicad_sch` と `logger_v2_lte_sd.kicad_sch`。

2026-09-21追記：本書の旧案部品を残す方針は、ユーザーの整理指示により更新した。旧案3個を削除し、必要な28個を未配線で追加済み。最新の配置・調達一覧は [部品配置更新_20260921.md](部品配置更新_20260921.md) を参照。本書の72個という集計とCSVは9月20日時点の記録。

## 採用内容

ユーザー指定のアンテナは **JCA002（秋月112223）**。GNSSはMAX-M10M-00Bを維持し、V2の外部3.3Vから抵抗・RFチョークを通す給電方式を採用する。V1のVCC_RF給電も通常動作としては成立するが、V1の10Ω抵抗はアンテナ給電に直列ではなく、短絡電流を制限する抵抗にはなっていない。

SDはV1と同じ **Molex 47219-2001** へ置換。シンボル、フットプリント、STEPをプロジェクト内に用意した。TE 2452796-1 SIMスロットは維持する。独立したSD挿入検出端子がなくなるため、将来のUNO Qピン割り当ては **21本使用・A5の1本が予備**。DAT3/CDはSPIのCSであり、機械式カード検出端子ではない。

ユーザー指定の「可能な限り秋月」「裸SMD優先」「DIP化基板を使わない、IMUのみ例外」を適用した。現在配置された72部品すべてに選定品番・調達先・備考を付与し、そのうち57部品の調達先を秋月とした。この数はDNPと旧案の未配線部品を含む配置数で、購入数ではない。LTE電源のL/Cなど今後設計する未配置部品を含む完成BOMではない。

個別属性は回路図の非表示フィールド `MPN / Supplier / SupplierCode / SupplierURL / SelectionNote` に保存。機械処理・照合用の一覧は [部品選定CSV](output/部品選定_20260920.csv)。未採番の追加部品はシート名とUUIDで識別する。

## 1. 秋月で調達する主要部品

商品ページは2026-09-20に確認。販売単位・在庫は購入時に再確認する。抵抗・LED・コンデンサーも変換基板を介さず直接実装する。

|対象|選定品番|秋月|実装・変更点|
|---|---|---|---|
|U2 GNSS|MAX-M10M-00B|[131778](https://akizukidenshi.com/catalog/g/g131778/)|LCC18、維持|
|U3 IMU|AE-BNO055-BO|[116996](https://akizukidenshi.com/catalog/g/g116996/)|既存IMUモジュール、ユーザー指定の例外|
|U4 CAN1|ATA6561-GAQW-N|[130008](https://akizukidenshi.com/catalog/g/g130008/)|SOIC8、末尾Nは調達品番に記録|
|U5 CAN2|MCP25625T-E/SS|[112663](https://akizukidenshi.com/catalog/g/g112663/)|SSOP28、Tは包装指定|
|U1 LED出力|TC74HC595AF|[110077](https://akizukidenshi.com/catalog/g/g110077/)|SOP16、旧3.9mm幅SOICから5.3mm幅用へ変更|
|D9/D10 CAN保護|PEC3824C2A-AU_R1_000A1|[129497](https://akizukidenshi.com/catalog/g/g129497/)|SOT23、24V双方向、1/2=信号・3=GND|
|Y1 CAN2水晶|20M10PB/XT324-10/80|[130244](https://akizukidenshi.com/catalog/g/g130244/)|3225、20MHz、CL=10pF|
|D1～D8 LED|OSG80805C1C|[106421](https://akizukidenshi.com/catalog/g/g106421/)|2012、黄緑570nm|
|Q? LTE PWRKEY|2N7002（Diodes）|[103919](https://akizukidenshi.com/catalog/g/g103919/)|SOT23、維持|
|J1 GNSS SMA|S-037-TGG|[102569](https://akizukidenshi.com/catalog/g/g102569/)|既存の機械形状を維持|
|J? LTEアンテナ端子|U.FL-R-SMT-1(10)|[115417](https://akizukidenshi.com/catalog/g/g115417/)|基板直付けSMD、維持|
|J2/J3/J4/J5 シールド端子|FH105-1x10SG / FH105-1x8SG/RH / FH105-1x6SG/RH|[10極](https://akizukidenshi.com/catalog/g/g107199/)・[8極](https://akizukidenshi.com/catalog/g/g104046/)・[6極](https://akizukidenshi.com/catalog/g/g104045/)|10mm長ピン。既存2.54mmピッチを維持|
|J? サービス端子|PH-1x6SG/RH|[101669](https://akizukidenshi.com/catalog/g/g101669/)|スルーホール、維持|
|外付けGNSSアンテナ|JCA002|[112223](https://akizukidenshi.com/catalog/g/g112223/)|ユーザー指定、2.2～5V・5～15mA・SMA-P|

SMA・UNOヘッダー・既存ケーブル端子は、嵌合・機械保持を優先してスルーホールを維持する。IMU以外のDIP化基板は採用していない。

## 2. 抵抗・コンデンサー

|対象|値・品番|秋月|反映・条件|
|---|---|---|---|
|R1～R4、R6、R8、R9、R11|1kΩ RK73B1JTTD102J|[130351](https://akizukidenshi.com/catalog/g/g130351/)|LED用680Ω→1kΩ。VF=2Vなら約1.3mA、8灯合計約10.4mA。明るさは実物確認|
|R5/R10/R12/R17|10kΩ RK73B1JTTD103J|[130355](https://akizukidenshi.com/catalog/g/g130355/)|1608。R10のDNPは維持|
|R15/R16|4.7kΩ RK73B1JTTD472J|[130353](https://akizukidenshi.com/catalog/g/g130353/)|IMUプルアップ。必須実装、DNPではない|
|R18～R20|47kΩ RC0603J47K|[129458](https://akizukidenshi.com/catalog/g/g129458/)|1608、リール販売|
|R13/R14|120Ω RC0603J120R|[130332](https://akizukidenshi.com/catalog/g/g130332/)|1608、リール販売、既存DNP維持。終端を実装する場合は信号電圧・異常時の電力も確認|
|C2/C3|15pF CC0603N150J500|[113312](https://akizukidenshi.com/catalog/g/g113312/)|1608、NP0、50V、5%。18pFから変更|
|C4～C10/C12|100nF GRM188R72A104KA35D|[114559](https://akizukidenshi.com/catalog/g/g114559/)|1608、X7R、100V、10%|
|C11|1µF GRM188B31H105KAAL|[116994](https://akizukidenshi.com/catalog/g/g116994/)|1608、B特性、50V、10%、−25～85℃|
|C13/C14|10µF GRM21BR71A106KE51|[117593](https://akizukidenshi.com/catalog/g/g117593/)|2012、X7R、10V、10%、DCバイアスによる実効容量に注意|
|C1 RF給電|10nF GRM188B11H103KA01|[113387](https://akizukidenshi.com/catalog/g/g113387/)|1608、B特性、50V、10%、−25～85℃。100nFから変更|

水晶の負荷は `CL ≈ C2×C3/(C2+C3)+Cstray`。C2=C3=15pF、基板・ピン等の寄生容量Cstray=2.5pFを仮定して10pFとなる。寄生容量の実測・発振開始・周波数・ドライブレベルの確認前なので、C2/C3は初期設計値。水晶のESR上限50Ω、ドライブ10µW標準/100µW最大に照らして実機で確認する。

u-blox推奨C14は10nF/10%/16V/X7R。今回のC1は同容量・同許容差で耐圧を満たす秋月品だが、温度特性はB、使用範囲は−25～85℃で、X7Rと同じ温度保証ではない。C11も同じ制約がある。−40℃を含む使用条件が必要なときは両品をX7Rの適合品へ変更する。今回の選定を車載温度・信頼性の認定済みとは扱わない。

## 3. 秋月以外を許容する部品

秋月の適合する裸SMD品を確認できなかったものは、仕様を落とす変換基板や代用品へ変更せず、以下を維持・指定する。

|対象|品番|理由・一次資料|
|---|---|---|
|LTE|SIM7070G|ユーザー指定の除外対象。[SIMCom](https://en.simcom.com/product/SIM7070G.html)|
|SIMスロット|TE 2452796-1|ユーザー指定。[TEメーカー図面・モデル](https://www.te.com/en/product-2452796-1.html)、[RS 2868822](https://jp.rs-online.com/web/p/memory-card-connectors/2868822)|
|SDスロット|Molex 47219-2001|V1と同品。[Molex](https://www.molex.com/en-us/products/part-detail/472192001)|
|LTE電源|TPS62130RGTR|5V→3.8V、送信ピークに備えた3A級。小電流の秋月ICへ単純置換しない。[TI](https://www.ti.com/product/TPS62130)|
|LTE UART変換|TXU0204PWR|1.8V↔3.3V、2Mbpsの方向固定プッシュプルUART用。[TIデータシート](https://www.ti.com/lit/ds/symlink/txu0204.pdf)|
|SIM/SD ESD|USBLC6-4SC6|4信号用の低容量保護。[ST](https://www.st.com/en/protection-devices/usblc6-4.html)|
|L1 RFチョーク|LQG15HS27NJ02D|u-blox推奨のLQG15H系、27nH/5%、1005。[Murata](https://www.murata.com/en-global/products/productdetail?partno=LQG15HS27NJ02%23)、保存資料 `refs/LQG15HS_02.pdf`|
|D11 RF ESD|PESD5V0F1BL-Q|5.5V双方向、SOD882、接合容量0.4pF標準/0.55pF最大。[Nexperia](https://www.nexperia.com/product/PESD5V0F1BL-Q)|
|R7 アンテナ給電|CRCW251227R0JNEG|27Ω/5%/1W、2512。短絡時の電力から選定。[Vishay](https://www.vishay.com/docs/20035/dcrcwe3.pdf)|
|J6/J7 CANコネクター|Molex 43045-0400|既存ケーブルとの嵌合を維持。[Molex](https://www.molex.com/en-us/products/part-detail/430450400)|

秋月のFXMA2102L8XはI²C向け400kHzの変換器であり、2Mbps UARTのTXU0204代替には採用しない。L1も「同じ27nH」だけでは代替せず、GNSS帯域のインピーダンス・自己共振・定格電流を確認する。購入時は表のメーカー品番を指定する。R7など他社調達品の即納在庫を保証するものではない。

追加シートに残るSC16IS750、水晶14.7456MHz、2個目のTXU0204は旧SPI–UART案の部品。現在の直結UART案では購入対象から除くが、今回シンボルを削除・移動せずDNP設定も変更していない。CSVをそのまま発注数量に使用しない。

## 4. GNSS：V1とV2の違いと採用根拠

比較は実回路図から出力したネットリスト `output/v1_compare_20260920.xml` と `output/v2_compare_20260920.xml` に基づく。見た目ではなく端子の接続を確認した。

|項目|V1|今回のV2|
|---|---|---|
|アンテナ電源|MAX-M10MのVCC_RF、14番|外部3.3V。VCC_RFは未接続|
|DC経路|VCC_RF→27nH→SMA/RF_IN|3.3V→R7 27Ω→L1 27nH→SMA/RF_IN|
|容量・抵抗|VCC_RFからR47 10Ω→C34 10nF→GND|R7後の給電ノードからC1 10nF→GND|
|短絡電流|R47はバイパス枝なのでアンテナ電流を制限しない|R7がアンテナ給電に直列で電流を制限|
|LNA_EN|R49 10kΩでGNDへ|R10 10kΩをDNP、実質未接続|
|RF保護|該当RFネットに外付けTVSなし|D11低容量双方向TVSをSMA/RF_INからGNDへ|

**V1が通常受信できる構成であることと、短絡時まで適切に保護されることは別。今回はV2の外部給電＋直列抵抗を採用する。** u-bloxはVCC_RFまたは外部の低雑音電源からのアンテナ給電を認めている。VCC_RFの動作時最大供給電流は50mAで、JCA002の15mAは範囲内。データシートの絶対最大250mAを通常動作の設計値として使わない。

### 採用回路と計算

```
+3V3 ─ R7 27Ω/1W ─┬─ L1 27nH ─┬─ SMA中心端子 → JCA002
                   │            ├─ MAX-M10M RF_IN（11）
                 C1 10nF      D11 低容量TVS
                   │            │
                  GND          GND
```

- JCA002仕様：2.2～5V、5～15mA。根拠は [アンテナのメーカー仕様書](https://akizukidenshi.com/goodsaffix/JCA002_a.pdf)。
- L1はMurataの保存カタログで27nH、定格300mA、DCR最大0.46Ω、自己共振周波数最小1.7GHzを確認。ここでは300mAを保守的な検討値に使う。推奨シリーズ採用であり、異なるシリーズに対する「GNSS帯域で500Ω超」の条件を27nHの理想リアクタンスだけで判定したものではない。
- 最大負荷15mA時：`3.3 − 0.015×(27+0.46) ≈ 2.888V`。3.3V電源−5%、抵抗+5%を仮定しても約2.703Vで、2.2V下限を満たす。電源公差±5%は設計上の仮定で、UNO Qの実測値ではない。
- SMA短絡時：公称約122mA。電源+5%・抵抗−5%では `3.465/25.65 ≈ 135mA`、抵抗損失約0.468W。L1の300mA検討値を下回る。R7は70℃定格1W品とし、高温時のディレーティングとPCBの放熱を確認する。
- 通常15mA時のR7損失は約6mW。短絡時の連続約0.47Wは無視できないため、周囲部品・基板温度も確認する。これは受動的な電流制限で、短絡検出・自動遮断・故障通知ではない。
- RF_INには内部DCブロックがある。許容RF_IN DC電圧の範囲内でこの給電方式を用いるため、外付けの直列DCカットコンデンサーは必須ではない。RF_INの許容範囲は−5.5～+5.5V。ESD保護はDC耐圧の代わりではない。
- LNA_ENは出力。外部LNAや電源スイッチを制御しないこの回路では未接続でよく、10kΩのプルダウンは必須ではない。V1のR49があることを理由にV2のR10を実装しない。アンテナ本体をLNA_ENから直接給電しない。
- 外部3.3Vは低雑音であることが条件。LTE送信・SD書込み時の3.3V変動とGNSS受信感度を確認する。現構成ではGNSSの省電力状態でもアンテナは給電されたままで、開放/短絡を判別するアンテナスーパーバイザー機能も未実装。

一次資料は [MAX-M10M Integration Manual UBX-22038241 R02](refs/MAX-M10M_IntegrationManual.pdf) の3.3節、Appendix B/C（pp.28–30、84–89）、[MAX-M10M-00B Data Sheet UBX-22028884 R04](refs/MAX-M10M-00B.pdf) の端子・電気仕様（pp.9–12）。RF推奨値に従う回路検討であり、実基板での受信性能・ESD耐性を測定済みという意味ではない。

## 5. フットプリント・3D・検証

- SD：`logger_v2_expansion:Micro_SD_Card_Molex_47219-2001` と `logger_v2_expansion:Molex_47219-2001`。V1のフットプリントをそのまま移植。1～8番は信号接点、4か所の保持パッドは共通9番。
- V1のSDモデルはGit LFSの参照ファイルだったため、保存済みオブジェクトのSHA-256を照合して実体STEPを取り出した。V1自体は変更していない。V2に約2.8MBの `3dmodels/Molex_47219-2001.step` を収め、V1のオフセット・回転設定を維持して3D表示を確認した。
- U1：`logger_v2_custom:TC74HC595AF`、`Toshiba_SOP16_P300_1.27A`。本体5.3×10.3mm、端子外幅7.8mm、ピッチ1.27mmを東芝資料と照合。端子位置が同じシンボルへ差し替え、実装ランドはKiCadの幅広SOIC16の形状を基にした。3Dは公称寸法の簡易STEPで、メーカー提供品やリード曲面の厳密再現ではない。
- TC74HC595AFとSDを確認用基板に配置し、[3D表示](output/selected_footprints_3D.png) を確認。実プロジェクトのPCBへは転送していない。
- 全72配置部品について、シンボルの端子番号とフットプリントのパッド番号の一致、モデルの参照解決・STEP実体を確認。使用するSTEP 28種類はFreeCADで全て読込み・形状有効性を確認した（`output/selection_step_geometry.json`）。汎用モデルを含み、特にシールドヘッダーの長ピンとスタック高さは実物との照合が必要。
- 元回路図と比較し、配線・ラベル・接続点・未接続マーク・部品位置・UUID・DNP・採番状態が不変であることを確認。ルート回路図のネット接続も全件不変。IMUプルアップは実装、LNA_ENプルダウンはDNPを維持。
- ERCは変更前後ともルートの既存 `STATUS_LATCH` ラベル未接続1件。今回追加したERC違反はない。LTE/SDファイルは現在のルートに接続されていない独立した未配線回路図で、全機能の電気接続確認は未完了。
- [ルート図面](output/logger_v2_selection.png) と [LTE/SD図面](output/logger_v2_lte_sd_selection.png) を新規出力して確認した。[構造検証結果](output/selection_final_verification.json) に検証範囲を記録。

今回変更したのは品番・定数・対象シンボル/ライブラリと文書。PCB配線・製造データの更新、LTE/SD周辺回路の完成、実機同時動作試験は実施していない。バックアップは `logger_v2-backups/before_akizuki_selection_20260920/`。
