ntakao2006-web/RaceCapture/circuit/logger_v2/部品配置更新_20260921.md

# 実装方針に合わせた部品整理・追加

2026-09-21。ユーザー指示に基づき、`実装方針.md` と `部品選定_GNSS検証_20260920.md` の採用案を部品構成へ反映した。今回はシンボルの削除・作成・配置まで。回路の配線は行っていない。

## 削除した部品

`logger_v2_lte_sd.kicad_sch` から次の3個を削除した。

|部品|元の用途|削除理由|
|---|---|---|
|SC16IS750IPW|SPI–UART変換|UNO QのハードウェアUARTへ直結する方針のため不要|
|14.7456MHz CL12pF水晶|上記変換ICの発振子|変換ICとともに不要|
|TXU0204PWRの補助信号用1個（元の右側）|DTR/RI/STATUS|基本構成では使用しない|

TX/RX/RTS/CTS用のTXU0204PWRは残した。GNSSのR10は実装方針に記載されたDNP、CAN終端R13/R14も既存DNPとして維持。IMUのR15/R16は必須実装のまま維持した。DNPであることだけを理由に既存部品を削除していない。

## 追加した28個

全て未配線。表の「用途」は将来の接続先を示す。回路図の非表示フィールド `Role` にも同じ用途を保存した。

|部品|値|用途|
|---|---|---|
|L2|2.2µH|TPS62130のSWからLTE電源へ接続する電源用コイル|
|C15|330µF / 6.3V、低ESRポリマー|SIM7070GのVBAT近傍のバルク容量|
|D12|4.5V TVS|SIMCom推奨のVBAT過渡保護、GNDへ接続|
|C16/C17|各10µF|降圧回路の入力で並列、合計20µF|
|C18/C19/C20|各10µF|降圧回路の出力で並列、合計30µF|
|C21|100nF|TPS62130 AVINの局所バイパス|
|C22/C23|100nF / 1µF|SIM7070G VBATの局所バイパス|
|C24|100nF|SIM_VDD、SIMスロット近傍|
|C25/C26|10µF / 100nF|SDの3.3V電源|
|C27/C28|各100nF|TXU0204 VCCA=3.3V / VCCB=1.8V|
|C29|10nF|TPS62130 SS/TRのソフトスタート、GNDへ接続|
|R21/R22|374kΩ 1% / 100kΩ 0.1%|降圧回路の帰還分圧、上側/下側|
|R23|100kΩ|降圧回路ENのプルダウン|
|R24|100kΩ|PWRKEY制御用2N7002ゲートのプルダウン|
|R25|1kΩ|MCUから2N7002ゲートへの直列抵抗|
|R26/R27|各47kΩ|SDのCS / MISOを3.3Vへプルアップ|
|R28/R29/R30|各22Ω|SIM CLK / RST / DATAの直列抵抗|
|R31|0Ω|LTEアンテナの直列調整用。初期値0Ω、50Ω配線を前提|

## 秋月調達を優先した選定

**追加28個のうち24個は秋月の商品を指定した。** IMU以外のDIP化基板は追加していない。電源用MLCCは既に選定済みの秋月10µF品を並列で使用し、特殊な22µF品を増やさない構成とした。MLCCの実効容量はDCバイアスで減るため、これは公称容量の合計である。

|用途・対象|品番|秋月商品|
|---|---|---|
|10µF：C16～C20/C25|GRM21BR71A106KE51、2012、10V X7R|[117593](https://akizukidenshi.com/catalog/g/g117593/)|
|100nF：C21/C22/C24/C26～C28|GRM188R72A104KA35D、1608、100V X7R|[114559](https://akizukidenshi.com/catalog/g/g114559/)|
|1µF：C23|GRM188B31H105KAAL、1608、50V B|[116994](https://akizukidenshi.com/catalog/g/g116994/)|
|10nF：C29|GRM188B11H103KA01、1608、50V B|[113387](https://akizukidenshi.com/catalog/g/g113387/)|
|100kΩ 0.1%：R22|RG2012N-104-B-T5、2012|[111798](https://akizukidenshi.com/catalog/g/g111798/)|
|100kΩ：R23/R24|RK73B1JTTD104J、1608|[130357](https://akizukidenshi.com/catalog/g/g130357/)|
|1kΩ：R25|RK73B1JTTD102J、1608|[130351](https://akizukidenshi.com/catalog/g/g130351/)|
|47kΩ：R26/R27|RC0603J47K、1608|[129458](https://akizukidenshi.com/catalog/g/g129458/)、リール販売|
|22Ω：R28～R30|RK73B1JTTD220J、1608|[130343](https://akizukidenshi.com/catalog/g/g130343/)|
|0Ω：R31|RK73Z1JTTD、1608|[111619](https://akizukidenshi.com/catalog/g/g111619/)|

B特性コンデンサーC23/C29は−25～85℃の制約を引き継ぐ。車載温度保証を意味しない。商品確認日は2026-09-20～21、在庫や販売単位は発注時に確認する。

他社調達とした追加部品は次の4個。秋月の該当する裸SMD品を確認できなかったため、必要な定格を優先した。

|部品|選定品|理由|
|---|---|---|
|L2|Bourns SRN6045TA-2R2Y|2.2µH、Irms 6A、Isat 9.5A標準の電源用。既存の専用フットプリントとSTEPを使用|
|C15|KEMET T520D337M006ATE015|330µF/6.3V、ESR 15mΩ、SMDポリマー。秋月16SVP82Mは商品ページで販売終了を確認し、採用しなかった|
|R21|Yageo RC0603FR-07374KL|374kΩ、1%、1608。約3.8Vを設定するための精度を確保|
|D12|Prisemi PESDHC2FD4V5B|SIMCom Hardware Design Table 8の推奨電源保護品、DFN1006-2L|

帰還抵抗による設定値は `0.8×(1+374/100)=3.792V`。R22は秋月の0.1%品を使うため、1608ではなく2012用のフットプリントを割り当てた。D12は過渡保護で、電源の持続的な過電圧を遮断する回路ではない。

## ライブラリと確認範囲

- 新たな品番のシンボルを `logger_v2_expansion.kicad_sym` に作成し、追加部品全てにフットプリント・3Dモデルを割り当てた。標準のR/C/L記号を基にし、品番・定数・パッケージ・用途を保持する。
- D12はメーカー図面に合わせて `Prisemi_DFN1006_2L` を作成。ランド0.4×0.6mm、外端間1.1mm。3Dは寸法の近い既存SOD882汎用モデルを使用する。C15等も汎用パッケージモデルで、メーカー刻印・厳密な外観の再現ではない。
- 残した既存シンボルは属性も含めて維持。既存配線・ラベル・接続点・未接続マークは不変。ルート回路図・PCB・プロジェクト設定はバイト単位で不変。
- 現在の部品数はルート59個、LTE/SDファイル38個、合計97個。全てのシンボル端子とフットプリントのパッド番号を照合した。
- 回路図を新規描画して部品・文字の重なりを確認。[図面プレビュー](output/parts_preparation_20260921.png)。追加パッケージを確認用基板で[3D表示](output/prepared_parts_3D_20260921.png)した。使用するSTEP全30種類は形状読込みを確認した。
- ルートERCは既存STATUS_LATCH未接続1件のまま。追加ファイルは独立した未配線の回路図であり、ERC合格した完成回路ではない。

今回のバックアップ：`logger_v2-backups/before_direct_uart_parts_20260921/`。
最新の [全97部品一覧](output/現在部品一覧_20260921.csv) と [追加28部品一覧](output/追加部品_20260921.csv) を出力した。旧20260920のCSVには今回削除した旧案部品が含まれるため、現在の配置確認には最新一覧を用いる。

## 次の配線時に守る事項

- TPS62130のDEFは通常出力設定、FSWは採用インダクターに合わせて設定し、PG未使用なら開放する。ENにはR23を接続し、MCU起動中はLTE電源OFFとする。SS/TRのC29はソフトスタートを長くする初期値。330µFの充電を含む起動・電源応答を実測する。
- C15を含む出力容量と2.2µHの組合せについて、帰還ループの安定性と2A負荷変動時のVBAT最低電圧を確認する。今回のシンボル配置は電源の実機動作を保証するものではない。
- TXU0204のOEを浮かせず、基本案ではVCCA側のHighに固定する。電源断時の分離機能を利用し、VDD_EXTへ逆給電しない。補助信号RI/STATUS/DTRは基本構成では接続しない。
- SIM DATAの内蔵プルアップを利用し、外付けプルアップを重複追加しない。カード検出用抵抗やSPI–UART用の発振・リセット部品は追加しない。
- R31の0ΩはRF配線の調整箇所であり、接続するアンテナを含めたRF評価後に定数を確定する。GNSSの27Ω/1W給電抵抗は今回変更していない。

根拠： [TI TPS62130](https://www.ti.com/lit/ds/symlink/tps62130.pdf) §9、[TXU0204](https://www.ti.com/lit/ds/symlink/txu0204.pdf)、[SIMCom Hardware Design](refs/SIM7070_hardware.pdf) pp.20–21/31–32、[Bourns SRN6045TA](https://www.bourns.com/docs/product-datasheets/srn6045ta.pdf)、[KEMET個別仕様](https://docs.rs-online.com/d8c4/0900766b81710abb.pdf)、[Prisemiメーカー仕様書](refs/PESDHC2FD4V5B.pdf)。
