ntakao2006-web/RaceCapture/outputs/logger_v2_order_20260923/BOM_full.csv

状態 | 実装位置 | 品目 | サイズ | メーカー品番 | 販売店 | 販売店品番 | 必要数 | 予備候補数 | 購入推奨数 | 選定根拠 | 製品URL
在庫表示あり | C1 C2 C8 C12 C13 C20 C28 | 10µF ±10% X7R 10V | 0805 / 2012 | CL21B106KPQNFNE | DigiKey | 1276-2934-1-ND | 7 | 3 | 10 | 旧445-6857-1-NDが注文画面で入荷待ちのため差替え。Samsung製10µF±10%・10V・X7R、2.00×1.25mm、高さ最大1.40mm。同じ0805ランドに実装可能。DigiKey製品ページの直販在庫65,218個、CT10個284円（税別）表示を2026-09-23確認。実装7＋予備3。C20は現行Value=10u。 | https://www.digikey.jp/en/products/detail/samsung-electro-mechanics/CL21B106KPQNFNE/3891020
在庫表示あり | C3 C4 C5 C6 C14 C17 C19 C21 C22 C23 C24 C25 C26 C27 | 100nF ±10% X7R 100V | 0603 / 1608 | GRM188R72A104KA35D | DigiKey | 490-3285-1-ND | 14 | 11 | 25 | 現行MPNを維持。C21～C27も現行Value=0.1u。 | https://www.digikey.jp/en/products/detail/murata-electronics/GRM188R72A104KA35D/702826
在庫表示あり | C7 | 330µF 6.3V ポリマー | φ6.3 × H5.9mm | 6SVPC330M | DigiKey | P16611CT-ND | 1 | 1 | 2 | 指定品維持。ESR17mΩ、極性あり。 | https://www.digikey.jp/en/products/detail/panasonic-industry/6SVPC330M/4204943
在庫表示あり | C9 C10 | 15pF ±5% C0G 50V | 0603 / 1608 | CC0603JRNPO9BN150 | DigiKey | 311-1060-1-ND | 2 | 8 | 10 | Value=15pを採用。古いSpecificationの18pF/CL12pFは不採用。 少量価格の段差も考慮して10個。 | https://www.digikey.jp/en/products/detail/yageo/CC0603JRNPO9BN150/302794
在庫表示あり | C11 | 10nF ±10% X7R 100V | 0603 / 1608 | GRM188R72A103KA01D | DigiKey | 490-GRM188R72A103KA01DCT-ND | 1 | 9 | 10 | 現行Value=0.01u。耐圧は元の50V以上。 少量価格の段差も考慮して10個。 | https://www.digikey.jp/en/products/detail/murata-electronics/GRM188R72A103KA01D/3845635
在庫表示あり | C15 | 1µF ±10% X7R 50V | 0805 / 2012 | C2012X7R1H105K085AC | DigiKey | 445-14539-1-ND | 1 | 2 | 3 | 同サイズ・同容量・同耐圧。高さ最大1.0mm。新規設計非推奨品だが在庫表示あり。 | https://www.digikey.jp/en/products/detail/tdk-corporation/C2012X7R1H105K085AC/3951775
在庫表示あり | D1 D4 | CAN用 双方向2線 TVS 24V | SOT-23-3 | ESDCAN24-2BLY | DigiKey | 497-13262-1-ND | 2 | 2 | 4 | PEC3824C2A-AUの代替。1/2=CAN、3=GND。24V、Vbr最低27V、容量最大30pF。クランプ特性は元品と完全同一ではない。 | https://www.digikey.jp/en/products/detail/stmicroelectronics/ESDCAN24-2BLY/3661760
在庫表示あり | D5 D6 D7 D8 D9 D10 D11 D12 | 緑LED 571nm / Vf約2V | 0805 / 2012 | LTST-C170KGKT | DigiKey | 160-1414-1-ND | 8 | 4 | 12 | 同0805、1=カソード、2=アノード。元品と発光色・明るさに差あり。 | https://www.digikey.jp/en/products/detail/liteon/LTST-C170KGKT/386776
在庫表示あり | J6 J9 | Micro-Fit 3.0 基板側4極 | 2×2 / 3.0mm 横向きTHT | 43045-0400 | DigiKey | WM1814-ND | 2 | 0 | 2 | 43045-0400と同じ品番の表記違い。指定どおり2個だけ。ケーブル側・圧着端子は含めない。 | https://www.digikey.jp/en/products/detail/molex/0430450400/252527
在庫表示あり | J11 | nanoSIM ヒンジ式ソケット | TE専用フットプリント | 2452796-1 | DigiKey | 343-2452796-1CT-ND | 1 | 1 | 2 | SDとは別部品。現行指定品維持。マーケットプレイス品ではなくDigiKey直販CTを指定。 | https://www.digikey.jp/en/products/detail/te-connectivity-linx/2452796-1/21284797
在庫表示あり | L1 | 2.2µH ±20% 電源インダクタ | 2.5×2.0×1.2mm | DFE252012F-2R2M=P2 | DigiKey | 490-13055-1-ND | 1 | 2 | 3 | 旧490-10649-1-NDがユーザーのカートで規制表示のためFシリーズへ差替え。2.2µH±20%、外形・高さ・推奨ランド（内側1.2/外側2.8/幅2.0mm）は元品と一致。Irms2.3A / Isat3.3A / DCR82mΩ最大（元2.2A/3.0A/84mΩ）。DigiKey直販190,191個、1個税別42円の表示を2026-09-23確認。3個＝実装1＋予備2。ユーザーカートでの規制解除は未確認。 | https://www.digikey.jp/en/products/detail/murata-electronics/DFE252012F-2R2M-P2/5812591
在庫表示あり | L2 | 27nH RF巻線インダクタ | 0603 / 1608 | LQW18AN27NJ00D | DigiKey | 490-1174-1-ND | 1 | 2 | 3 | 指定品維持。440mA、SRF3.7GHz以上。一般電源用インダクタには置換しない。 | https://www.digikey.jp/en/products/detail/murata-electronics/LQW18AN27NJ00D/584382
在庫表示あり | Q1 | Nch MOSFET 60V | SOT-23 | 2N7002ET1G | DigiKey | 2N7002ET1GOSCT-ND | 1 | 2 | 3 | 2N7002相当。1=G、2=S、3=Dで基板と一致。 | https://www.digikey.jp/en/products/detail/onsemi/2N7002ET1G/1792136
在庫表示あり | R1 R5 R11 | 100kΩ ±0.1% 0.1W | 0603 / 1608 | CRT0603-BY-1003ELF | DigiKey | CRT0603-BY-1003ELFCT-ND | 3 | 7 | 10 | 0603・100kΩ・0.1%・0.1W。R11の帰還精度を優先し同一品へ統一。 | https://www.digikey.jp/en/products/detail/bourns-inc/CRT0603-BY-1003ELF/1775045
在庫表示あり | R4 R23 R24 R25 R26 R27 R28 R29 R30 | 1kΩ ±1% 0.1W | 0603 / 1608 | RC0603FR-071KL | DigiKey | 311-1.00KHRCT-ND | 9 | 6 | 15 | Value基準。古いMPNに10kΩ表記が残る箇所あり。 | https://www.digikey.jp/en/products/detail/yageo/RC0603FR-071KL/729790
在庫表示あり | R6 R8 R22 R31 R32 | 47kΩ ±1% 0.1W | 0603 / 1608 | RC0603FR-0747KL | DigiKey | 311-47.0KHRCT-ND | 5 | 5 | 10 | 同サイズの1%品。 | https://www.digikey.jp/en/products/detail/yageo/RC0603FR-0747KL/727253
在庫表示あり | R10 | 374kΩ ±1% 0.1W | 0603 / 1608 | RC0603FR-07374KL | DigiKey | 311-374KHRCT-ND | 1 | 9 | 10 | 電源帰還上側。Value=374kを採用。 少量価格の段差も考慮して10個。 | https://www.digikey.jp/en/products/detail/yageo/RC0603FR-07374KL/727189
在庫表示あり | R14 R16 | 120Ω ±1% 0.1W | 0603 / 1608 | RC0603FR-07120RL | DigiKey | 311-120HRCT-ND | 2 | 8 | 10 | 現行DNP=noのため含む。接続するCANバスの終端配置に従って実装する。 少量価格の段差も考慮して10個。 | https://www.digikey.jp/en/products/detail/yageo/RC0603FR-07120RL/726920
在庫表示あり | R17 R18 R19 | 22Ω ±1% 0.1W | 0603 / 1608 | CRCW060322R0FKEA | DigiKey | 541-22.0HCT-ND | 3 | 7 | 10 | 0603・22Ω・1%・0.1Wを維持。在庫表示のあるVishay品。 | https://www.digikey.jp/en/products/detail/vishay-dale/CRCW060322R0FKEA/1179617
在庫表示あり | R20 R21 | 0Ω ジャンパ 0.1W | 0603 / 1608 | RC0603JR-070RL | DigiKey | 311-0.0GRCT-ND | 2 | 8 | 10 | 現行Value=0Ω。 少量価格の段差も考慮して10個。 | https://www.digikey.jp/en/products/detail/yageo/RC0603JR-070RL/726675
在庫表示あり | R15 | 27Ω ±5% 1W | 2512 / 6332 | RMCF2512JT27R0 | DigiKey | RMCF2512JT27R0CT-ND | 1 | 2 | 3 | 2512・27Ω・5%・1Wを維持。同サイズのStackpole品へ置換。 | https://www.digikey.jp/en/products/detail/stackpole-electronics-inc/RMCF2512JT27R0/4425469
在庫表示あり | U2 | 3A 降圧DC/DC | TSOT26 | AP63301WU-7 | DigiKey | 31-AP63301WU-7CT-ND | 1 | 1 | 2 | 指定品維持。AP63300/固定電圧版と混同しない。 | https://www.digikey.jp/en/products/detail/diodes-incorporated/AP63301WU-7/10491607
在庫表示あり | U3 | 4bit レベル変換 | TSSOP-14 / P0.65 | TXU0204PWR | DigiKey | 296-TXU0204PWRCT-ND | 1 | 1 | 2 | 指定品維持。PWパッケージ。 | https://www.digikey.jp/en/products/detail/texas-instruments/TXU0204PWR/14641512
在庫表示あり | U4 | CANコントローラ＋トランシーバ | SSOP-28 / 幅5.3mm | MCP25625T-E/SS | DigiKey | MCP25625T-E/SSCT-ND | 1 | 0 | 1 | 指定品維持。/SSパッケージ。高価なため予備なし。 | https://www.digikey.jp/en/products/detail/microchip-technology/MCP25625T-E-SS/4860100
在庫表示あり | U6 | LTE Cat-M/NB-IoTモジュール | LCC-68 / 24×24mm | SIM7070G | DigiKey | 3781-SIM7070G-ND | 1 | 0 | 1 | 指定の裸モジュール。開発ボードではない。高価なため予備なし。 | https://www.digikey.jp/en/products/detail/simcom-wireless-solutions-limited/SIM7070G/15841451
在庫表示あり | U7 | CANトランシーバ | SOIC-8 / 幅3.9mm | ATA6561-GAQW-N | DigiKey | ATA6561-GAQW-NCT-ND | 1 | 1 | 2 | 指定品維持。VDFN版を選ばない。 | https://www.digikey.jp/en/products/detail/microchip-technology/ATA6561-GAQW-N/9453105
在庫表示あり | U8 | 8bit シフトレジスタ | SOP-16 / 幅5.3mm | TC74HC595AF(EL,F) | DigiKey | 264-TC74HC595AF(EL,F)CT-ND | 1 | 1 | 2 | 指定AFのSOP16を維持。一般的な幅3.9mm SOICの74HC595は合わない。 | https://www.digikey.jp/en/products/detail/toshiba-semiconductor-and-storage/TC74HC595AF-EL-F/6679568
在庫表示あり | U9 U10 | 4線ESD保護 | SOT-23-6 | USBLC6-4SC6Y | DigiKey | 497-11883-1-ND | 2 | 2 | 4 | USBLC6-4SC6の車載グレード品。同じ4線・SOT23-6・ピン配置。2=GND、5=VBUS、1/3/4/6=I/O。 | https://www.digikey.jp/en/products/detail/stmicroelectronics/USBLC6-4SC6Y/2756524
在庫表示あり | Y1 | 水晶 20MHz / CL10pF | 3225 / 4端子 | ABM8-20.000MHZ-10-B1U-T | DigiKey | 535-14973-1-ND | 1 | 1 | 2 | 同寸法3.2×2.5mm、CL10pF。1/3=水晶、2/4=GND。発振余裕は実機で確認。 | https://www.digikey.jp/en/products/detail/abracon-llc/ABM8-20-000MHZ-10-B1U-T/9997881
在庫表示あり：機能代替 | D2 | RF用 双方向TVS 5.3V / 0.35pF | SOD882 / 1.0×0.6mm | AQ3045-01ETG | DigiKey | F9321CT-ND | 1 | 2 | 3 | GNSSアンテナESD用の機能代替。SOD882・端子ピッチ0.65mm、現PCBの0.4×0.7mmパッドに端子が重なる。容量typ0.35/max0.5pF（元0.4/0.55）、双方向。VRWM5.3V（元5.5）、Vc最大12V@1A（元11V@1A）で全特性同一ではない。3A・ESD±30kV。DigiKey直販82,168個表示。RF/ESD実機試験未実施。 | https://www.digikey.jp/en/products/detail/littelfuse-inc/AQ3045-01ETG/6347831
在庫表示あり：機能代替 | D3 | LTE電源 双方向TVS 4.5V | CSP1006-2 / 1.0×0.6mm | CSPSBHC4V5LB-TP | DigiKey | 353-CSPSBHC4V5LB-TPCT-ND | 1 | 2 | 3 | 3.8V電源ESD用の機能代替。4.5V双方向、端子ピッチ0.65mm・長さ0.20～0.30/幅0.45～0.55mmで現PCBの0.4×0.6mmパッドに実装可能。Vc最大8.5V@50A/10.5V@100A（元12V@25A）、100A/900W。容量最大300pF、Tj上限125℃。元品のVhold最低4.6Vに対し本品は保証値記載なし、1Aクランプも保証値なし。全特性同一ではなく、実機サージ後復帰は未検証。DigiKey地域ページに10,002個表示。 | https://www.digikey.jp/en/products/detail/mcc-micro-commercial-components/CSPSBHC4V5LB-TP/22557216
