ntakao2006-web/RaceCapture/outputs/logger_v2_order_20260923/logger_v2_DigiKey_BOM.xlsx

Sheet: 発注BOM
logger_v2 | DigiKey 発注BOM | 基板1台分 | logger_v2 | DigiKey 発注BOM | 基板1台分 | logger_v2 | DigiKey 発注BOM | 基板1台分 | logger_v2 | DigiKey 発注BOM | 基板1台分 | logger_v2 | DigiKey 発注BOM | 基板1台分 | logger_v2 | DigiKey 発注BOM | 基板1台分 | logger_v2 | DigiKey 発注BOM | 基板1台分 | logger_v2 | DigiKey 発注BOM | 基板1台分
2026-09-23調査 ／ 31品目・実装79個＋予備110個＝189個。D2・D3も同じ基板に実装可能な機能代替品を割り当て、全品DigiKeyに統一。 | 2026-09-23調査 ／ 31品目・実装79個＋予備110個＝189個。D2・D3も同じ基板に実装可能な機能代替品を割り当て、全品DigiKeyに統一。 | 2026-09-23調査 ／ 31品目・実装79個＋予備110個＝189個。D2・D3も同じ基板に実装可能な機能代替品を割り当て、全品DigiKeyに統一。 | 2026-09-23調査 ／ 31品目・実装79個＋予備110個＝189個。D2・D3も同じ基板に実装可能な機能代替品を割り当て、全品DigiKeyに統一。 | 2026-09-23調査 ／ 31品目・実装79個＋予備110個＝189個。D2・D3も同じ基板に実装可能な機能代替品を割り当て、全品DigiKeyに統一。 | 2026-09-23調査 ／ 31品目・実装79個＋予備110個＝189個。D2・D3も同じ基板に実装可能な機能代替品を割り当て、全品DigiKeyに統一。 | 2026-09-23調査 ／ 31品目・実装79個＋予備110個＝189個。D2・D3も同じ基板に実装可能な機能代替品を割り当て、全品DigiKeyに統一。 | 2026-09-23調査 ／ 31品目・実装79個＋予備110個＝189個。D2・D3も同じ基板に実装可能な機能代替品を割り当て、全品DigiKeyに統一。
手持ち：SD、IMU、GNSS、SMA、ピンヘッダ、4.7kΩ・10kΩ抵抗。Molexは基板側を合計2個だけ。 | 手持ち：SD、IMU、GNSS、SMA、ピンヘッダ、4.7kΩ・10kΩ抵抗。Molexは基板側を合計2個だけ。 | 手持ち：SD、IMU、GNSS、SMA、ピンヘッダ、4.7kΩ・10kΩ抵抗。Molexは基板側を合計2個だけ。 | 手持ち：SD、IMU、GNSS、SMA、ピンヘッダ、4.7kΩ・10kΩ抵抗。Molexは基板側を合計2個だけ。 | 手持ち：SD、IMU、GNSS、SMA、ピンヘッダ、4.7kΩ・10kΩ抵抗。Molexは基板側を合計2個だけ。 | 手持ち：SD、IMU、GNSS、SMA、ピンヘッダ、4.7kΩ・10kΩ抵抗。Molexは基板側を合計2個だけ。 | 手持ち：SD、IMU、GNSS、SMA、ピンヘッダ、4.7kΩ・10kΩ抵抗。Molexは基板側を合計2個だけ。 | 手持ち：SD、IMU、GNSS、SMA、ピンヘッダ、4.7kΩ・10kΩ抵抗。Molexは基板側を合計2個だけ。
DigiKey直販の少量梱包を選択。在庫は取得ページの表示であり、確保済みではありません。注文時に在庫・単価を確認。 | DigiKey直販の少量梱包を選択。在庫は取得ページの表示であり、確保済みではありません。注文時に在庫・単価を確認。 | DigiKey直販の少量梱包を選択。在庫は取得ページの表示であり、確保済みではありません。注文時に在庫・単価を確認。 | DigiKey直販の少量梱包を選択。在庫は取得ページの表示であり、確保済みではありません。注文時に在庫・単価を確認。 | DigiKey直販の少量梱包を選択。在庫は取得ページの表示であり、確保済みではありません。注文時に在庫・単価を確認。 | DigiKey直販の少量梱包を選択。在庫は取得ページの表示であり、確保済みではありません。注文時に在庫・単価を確認。 | DigiKey直販の少量梱包を選択。在庫は取得ページの表示であり、確保済みではありません。注文時に在庫・単価を確認。 | DigiKey直販の少量梱包を選択。在庫は取得ページの表示であり、確保済みではありません。注文時に在庫・単価を確認。
実装位置 | 品目・定格 | サイズ | メーカー品番 | DigiKey品番 | 実装数 | 予備数 | 発注数
C1, C2, C8, C12, C13, C20, C28 | 10µF ±10% X7R 10V | 0805 / 2012 | CL21B106KPQNFNE | 1276-2934-1-ND | 7 | 3 | 10
C3, C4, C5, C6, C14, C17, C19, C21, C22, C23, C24, C25, C26, C27 | 100nF ±10% X7R 100V | 0603 / 1608 | GRM188R72A104KA35D | 490-3285-1-ND | 14 | 11 | 25
C7 | 330µF 6.3V ポリマー | φ6.3 × H5.9mm | 6SVPC330M | P16611CT-ND | 1 | 1 | 2
C9, C10 | 15pF ±5% C0G 50V | 0603 / 1608 | CC0603JRNPO9BN150 | 311-1060-1-ND | 2 | 8 | 10
C11 | 10nF ±10% X7R 100V | 0603 / 1608 | GRM188R72A103KA01D | 490-GRM188R72A103KA01DCT-ND | 1 | 9 | 10
C15 | 1µF ±10% X7R 50V | 0805 / 2012 | C2012X7R1H105K085AC | 445-14539-1-ND | 1 | 2 | 3
D1, D4 | CAN用 双方向2線 TVS 24V | SOT-23-3 | ESDCAN24-2BLY | 497-13262-1-ND | 2 | 2 | 4
D5, D6, D7, D8, D9, D10, D11, D12 | 緑LED 571nm / Vf約2V | 0805 / 2012 | LTST-C170KGKT | 160-1414-1-ND | 8 | 4 | 12
J6, J9 | Micro-Fit 3.0 基板側4極 | 2×2 / 3.0mm 横向きTHT | 43045-0400 | WM1814-ND | 2 | 0 | 2
J11 | nanoSIM ヒンジ式ソケット | TE専用フットプリント | 2452796-1 | 343-2452796-1CT-ND | 1 | 1 | 2
L1 | 2.2µH ±20% 電源インダクタ | 2.5×2.0×1.2mm | DFE252012F-2R2M=P2 | 490-13055-1-ND | 1 | 2 | 3
L2 | 27nH RF巻線インダクタ | 0603 / 1608 | LQW18AN27NJ00D | 490-1174-1-ND | 1 | 2 | 3
Q1 | Nch MOSFET 60V | SOT-23 | 2N7002ET1G | 2N7002ET1GOSCT-ND | 1 | 2 | 3
R1, R5, R11 | 100kΩ ±0.1% 0.1W | 0603 / 1608 | CRT0603-BY-1003ELF | CRT0603-BY-1003ELFCT-ND | 3 | 7 | 10
R4, R23, R24, R25, R26, R27, R28, R29, R30 | 1kΩ ±1% 0.1W | 0603 / 1608 | RC0603FR-071KL | 311-1.00KHRCT-ND | 9 | 6 | 15
R6, R8, R22, R31, R32 | 47kΩ ±1% 0.1W | 0603 / 1608 | RC0603FR-0747KL | 311-47.0KHRCT-ND | 5 | 5 | 10
R10 | 374kΩ ±1% 0.1W | 0603 / 1608 | RC0603FR-07374KL | 311-374KHRCT-ND | 1 | 9 | 10
R14, R16 | 120Ω ±1% 0.1W | 0603 / 1608 | RC0603FR-07120RL | 311-120HRCT-ND | 2 | 8 | 10
R17, R18, R19 | 22Ω ±1% 0.1W | 0603 / 1608 | CRCW060322R0FKEA | 541-22.0HCT-ND | 3 | 7 | 10
R20, R21 | 0Ω ジャンパ 0.1W | 0603 / 1608 | RC0603JR-070RL | 311-0.0GRCT-ND | 2 | 8 | 10
R15 | 27Ω ±5% 1W | 2512 / 6332 | RMCF2512JT27R0 | RMCF2512JT27R0CT-ND | 1 | 2 | 3
U2 | 3A 降圧DC/DC | TSOT26 | AP63301WU-7 | 31-AP63301WU-7CT-ND | 1 | 1 | 2
U3 | 4bit レベル変換 | TSSOP-14 / P0.65 | TXU0204PWR | 296-TXU0204PWRCT-ND | 1 | 1 | 2
U4 | CANコントローラ＋トランシーバ | SSOP-28 / 幅5.3mm | MCP25625T-E/SS | MCP25625T-E/SSCT-ND | 1 | 0 | 1
U6 | LTE Cat-M/NB-IoTモジュール | LCC-68 / 24×24mm | SIM7070G | 3781-SIM7070G-ND | 1 | 0 | 1
U7 | CANトランシーバ | SOIC-8 / 幅3.9mm | ATA6561-GAQW-N | ATA6561-GAQW-NCT-ND | 1 | 1 | 2
U8 | 8bit シフトレジスタ | SOP-16 / 幅5.3mm | TC74HC595AF(EL,F) | 264-TC74HC595AF(EL,F)CT-ND | 1 | 1 | 2
U9, U10 | 4線ESD保護 | SOT-23-6 | USBLC6-4SC6Y | 497-11883-1-ND | 2 | 2 | 4
Y1 | 水晶 20MHz / CL10pF | 3225 / 4端子 | ABM8-20.000MHZ-10-B1U-T | 535-14973-1-ND | 1 | 1 | 2
D2 | RF用 双方向TVS 5.3V / 0.35pF | SOD882 / 1.0×0.6mm | AQ3045-01ETG | F9321CT-ND | 1 | 2 | 3
D3 | LTE電源 双方向TVS 4.5V | CSP1006-2 / 1.0×0.6mm | CSPSBHC4V5LB-TP | 353-CSPSBHC4V5LB-TPCT-ND | 1 | 2 | 3
合計（保留品を除く） |  |  |  |  | 79 | 110 | 189
予備数は変更可能です。CSVは作成時点の固定値なので、Excelで数量を変えた場合はCSV側も変更してください。 | 予備数は変更可能です。CSVは作成時点の固定値なので、Excelで数量を変えた場合はCSV側も変更してください。 | 予備数は変更可能です。CSVは作成時点の固定値なので、Excelで数量を変えた場合はCSV側も変更してください。 | 予備数は変更可能です。CSVは作成時点の固定値なので、Excelで数量を変えた場合はCSV側も変更してください。 | 予備数は変更可能です。CSVは作成時点の固定値なので、Excelで数量を変えた場合はCSV側も変更してください。 | 予備数は変更可能です。CSVは作成時点の固定値なので、Excelで数量を変えた場合はCSV側も変更してください。 | 予備数は変更可能です。CSVは作成時点の固定値なので、Excelで数量を変えた場合はCSV側も変更してください。 | 予備数は変更可能です。CSVは作成時点の固定値なので、Excelで数量を変えた場合はCSV側も変更してください。

Sheet: 代替・手持ち・DNP
保護ダイオードの代替と購入対象外 | 保護ダイオードの代替と購入対象外 | 保護ダイオードの代替と購入対象外 | 保護ダイオードの代替と購入対象外 | 保護ダイオードの代替と購入対象外
98部品 ＝ DigiKey79個 ＋ 手持ち16個 ＋ 未実装3個。全リファレンスを重複なく照合。別調達・発注保留はありません。 | 98部品 ＝ DigiKey79個 ＋ 手持ち16個 ＋ 未実装3個。全リファレンスを重複なく照合。別調達・発注保留はありません。 | 98部品 ＝ DigiKey79個 ＋ 手持ち16個 ＋ 未実装3個。全リファレンスを重複なく照合。別調達・発注保留はありません。 | 98部品 ＝ DigiKey79個 ＋ 手持ち16個 ＋ 未実装3個。全リファレンスを重複なく照合。別調達・発注保留はありません。 | 98部品 ＝ DigiKey79個 ＋ 手持ち16個 ＋ 未実装3個。全リファレンスを重複なく照合。別調達・発注保留はありません。
D2・D3は機能代替として採用。全定格が同一の品ではありません。下記の差分を明記し、発注BOMに各3個を含めています。 | D2・D3は機能代替として採用。全定格が同一の品ではありません。下記の差分を明記し、発注BOMに各3個を含めています。 | D2・D3は機能代替として採用。全定格が同一の品ではありません。下記の差分を明記し、発注BOMに各3個を含めています。 | D2・D3は機能代替として採用。全定格が同一の品ではありません。下記の差分を明記し、発注BOMに各3個を含めています。 | D2・D3は機能代替として採用。全定格が同一の品ではありません。下記の差分を明記し、発注BOMに各3個を含めています。
位置 | 必要部品 | 実装数 | 購入先・品番 | 適合根拠・仕様差分
D2 | RF用 双方向TVS 5.3V / 0.35pF | 1 | DigiKey / AQ3045-01ETG F9321CT-ND | GNSSアンテナESD用の機能代替。SOD882・端子ピッチ0.65mm、現PCBの0.4×0.7mmパッドに端子が重なる。容量typ0.35/max0.5pF（元0.4/0.55）、双方向。VRWM5.3V（元5.5）、Vc最大12V@1A（元11V@1A）で全特性同一ではない。3A・ESD±30kV。DigiKey直販82,168個表示。RF/ESD実機試験未実施。
D3 | LTE電源 双方向TVS 4.5V | 1 | DigiKey / CSPSBHC4V5LB-TP 353-CSPSBHC4V5LB-TPCT-ND | 3.8V電源ESD用の機能代替。4.5V双方向、端子ピッチ0.65mm・長さ0.20～0.30/幅0.45～0.55mmで現PCBの0.4×0.6mmパッドに実装可能。Vc最大8.5V@50A/10.5V@100A（元12V@25A）、100A/900W。容量最大300pF、Tj上限125℃。元品のVhold最低4.6Vに対し本品は保証値記載なし、1Aクランプも保証値なし。全特性同一ではなく、実機サージ後復帰は未検証。DigiKey地域ページに10,002個表示。
購入不要 ／ 手持ち品は基板上の対応部品を示しています。実物の型番・サイズは未確認です。 | 購入不要 ／ 手持ち品は基板上の対応部品を示しています。実物の型番・サイズは未確認です。 | 購入不要 ／ 手持ち品は基板上の対応部品を示しています。実物の型番・サイズは未確認です。 | 購入不要 ／ 手持ち品は基板上の対応部品を示しています。実物の型番・サイズは未確認です。 | 購入不要 ／ 手持ち品は基板上の対応部品を示しています。実物の型番・サイズは未確認です。
位置 | 値・部品 | 数量 | 扱い | サイズ・注意
C16 | 1p | 1 | 未実装（DNP） | logger_v2_custom:C_0603_1608Metric
C18 | 1p | 1 | 未実装（DNP） | logger_v2_custom:C_0603_1608Metric
J1 | Power | 1 | 手持ち品 | Connector_PinHeader_2.54mm:PinHeader_1x08_P2.54mm_Vertical
J2 | Analog | 1 | 手持ち品 | Connector_PinHeader_2.54mm:PinHeader_1x06_P2.54mm_Vertical
J3 | Digital/PWM | 1 | 手持ち品 | Connector_PinHeader_2.54mm:PinHeader_1x10_P2.54mm_Vertical
J4 | Digital/PWM | 1 | 手持ち品 | Connector_PinHeader_2.54mm:PinHeader_1x08_P2.54mm_Vertical
J5 | Conn_01x02_Pin | 1 | 手持ち品 | Connector_PinHeader_2.54mm:PinHeader_1x02_P2.54mm_Vertical
J7 | S-037-TGG | 1 | 手持ち品 | logger_v2_custom:SMA_S-037-TGG_Horizontal
J8 | Conn_01x02_Pin | 1 | 手持ち品 | Connector_PinHeader_2.54mm:PinHeader_1x02_P2.54mm_Vertical
J10 | S-037-TGG | 1 | 手持ち品 | logger_v2_custom:SMA_S-037-TGG_Horizontal
J12 | 47219-2001 | 1 | 手持ち品 | logger_v2_expansion:Molex_47219-2001
R2 | 4.7k | 1 | 手持ち品 | logger_v2_custom:R_0603_1608Metric 0603（1608）・0.1W以上。抵抗値だけでなく実物サイズを確認。
R3 | 4.7k | 1 | 手持ち品 | logger_v2_custom:R_0603_1608Metric 0603（1608）・0.1W以上。抵抗値だけでなく実物サイズを確認。
R7 | 10k | 1 | 手持ち品 | logger_v2_custom:R_0603_1608Metric 0603（1608）・0.1W以上。抵抗値だけでなく実物サイズを確認。
R9 | 10k | 1 | 手持ち品 | logger_v2_custom:R_0603_1608Metric 0603（1608）・0.1W以上。抵抗値だけでなく実物サイズを確認。
R12 | 10k | 1 | 手持ち品 | logger_v2_custom:R_0603_1608Metric 0603（1608）・0.1W以上。抵抗値だけでなく実物サイズを確認。
R13 | 10k | 1 | 未実装（DNP） | logger_v2_custom:R_0603_1608Metric
U1 | BNO055_module | 1 | 手持ち品 | logger_v2_custom:AE_BNO055_BO_ShieldSilk
U5 | MAX-M10M-00B | 1 | 手持ち品 | logger_v2_custom:MAX_M10M_00B_LCC18

Sheet: 選定根拠
選定根拠・購入リンク | 選定根拠・購入リンク | 選定根拠・購入リンク | 選定根拠・購入リンク | 選定根拠・購入リンク
基板に載るサイズとピン配置を優先。現行回路図とPCBの98部品について、値・フットプリントの一致を照合。 | 基板に載るサイズとピン配置を優先。現行回路図とPCBの98部品について、値・フットプリントの一致を照合。 | 基板に載るサイズとピン配置を優先。現行回路図とPCBの98部品について、値・フットプリントの一致を照合。 | 基板に載るサイズとピン配置を優先。現行回路図とPCBの98部品について、値・フットプリントの一致を照合。 | 基板に載るサイズとピン配置を優先。現行回路図とPCBの98部品について、値・フットプリントの一致を照合。
旧BOMは集計に使用せず、現行ValueとDNPを採用。抵抗やC20などで古いMPN/Specificationと不一致があるため、元品番も併記。 | 旧BOMは集計に使用せず、現行ValueとDNPを採用。抵抗やC20などで古いMPN/Specificationと不一致があるため、元品番も併記。 | 旧BOMは集計に使用せず、現行ValueとDNPを採用。抵抗やC20などで古いMPN/Specificationと不一致があるため、元品番も併記。 | 旧BOMは集計に使用せず、現行ValueとDNPを採用。抵抗やC20などで古いMPN/Specificationと不一致があるため、元品番も併記。 | 旧BOMは集計に使用せず、現行ValueとDNPを採用。抵抗やC20などで古いMPN/Specificationと不一致があるため、元品番も併記。
在庫表示にはキャッシュや地域ページ差があります。価格・納期の確約は含みません。実機動作・製造適合試験は未実施。 | 在庫表示にはキャッシュや地域ページ差があります。価格・納期の確約は含みません。実機動作・製造適合試験は未実施。 | 在庫表示にはキャッシュや地域ページ差があります。価格・納期の確約は含みません。実機動作・製造適合試験は未実施。 | 在庫表示にはキャッシュや地域ページ差があります。価格・納期の確約は含みません。実機動作・製造適合試験は未実施。 | 在庫表示にはキャッシュや地域ページ差があります。価格・納期の確約は含みません。実機動作・製造適合試験は未実施。
位置 | 選定メーカー品番 | 基板フットプリント／元MPN | 選定理由・注意 | 販売店製品ページ
C1, C2, C8, C12, C13, C20, C28 | CL21B106KPQNFNE | logger_v2_custom:C_0805_2012Metric 元MPN: C2012X7R1H105KT000N; GRM21BR71A106KE51 | 旧445-6857-1-NDが注文画面で入荷待ちのため差替え。Samsung製10µF±10%・10V・X7R、2.00×1.25mm、高さ最大1.40mm。同じ0805ランドに実装可能。DigiKey製品ページの直販在庫65,218個、CT10個284円（税別）表示を2026-09-23確認。実装7＋予備3。C20は現行Value=10u。 | https://www.digikey.jp/en/products/detail/samsung-electro-mechanics/CL21B106KPQNFNE/3891020
C3, C4, C5, C6, C14, C17, C19, C21, C22, C23, C24, C25, C26, C27 | GRM188R72A104KA35D | logger_v2_custom:C_0603_1608Metric 元MPN: GRM188R72A104KA35D | 現行MPNを維持。C21～C27も現行Value=0.1u。 | https://www.digikey.jp/en/products/detail/murata-electronics/GRM188R72A104KA35D/702826
C7 | 6SVPC330M | logger_v2_expansion:CP_Elec_6.3x5.9 元MPN: 6SVPC330M | 指定品維持。ESR17mΩ、極性あり。 | https://www.digikey.jp/en/products/detail/panasonic-industry/6SVPC330M/4204943
C9, C10 | CC0603JRNPO9BN150 | logger_v2_custom:C_0603_1608Metric 元MPN: CC0603N150J500 | Value=15pを採用。古いSpecificationの18pF/CL12pFは不採用。 少量価格の段差も考慮して10個。 | https://www.digikey.jp/en/products/detail/yageo/CC0603JRNPO9BN150/302794
C11 | GRM188R72A103KA01D | logger_v2_custom:C_0603_1608Metric 元MPN: GRM188B11H103KA01 | 現行Value=0.01u。耐圧は元の50V以上。 少量価格の段差も考慮して10個。 | https://www.digikey.jp/en/products/detail/murata-electronics/GRM188R72A103KA01D/3845635
C15 | C2012X7R1H105K085AC | logger_v2_custom:C_0805_2012Metric 元MPN: C2012X7R1H105KT000N | 同サイズ・同容量・同耐圧。高さ最大1.0mm。新規設計非推奨品だが在庫表示あり。 | https://www.digikey.jp/en/products/detail/tdk-corporation/C2012X7R1H105K085AC/3951775
D1, D4 | ESDCAN24-2BLY | logger_v2_custom:SOT-23 元MPN: PEC3824C2A-AU_R1_000A1 | PEC3824C2A-AUの代替。1/2=CAN、3=GND。24V、Vbr最低27V、容量最大30pF。クランプ特性は元品と完全同一ではない。 | https://www.digikey.jp/en/products/detail/stmicroelectronics/ESDCAN24-2BLY/3661760
D5, D6, D7, D8, D9, D10, D11, D12 | LTST-C170KGKT | logger_v2_custom:LED_0805_2012Metric_ShieldSilk 元MPN: OSG80805C1C | 同0805、1=カソード、2=アノード。元品と発光色・明るさに差あり。 | https://www.digikey.jp/en/products/detail/liteon/LTST-C170KGKT/386776
J6, J9 | 43045-0400 | logger_v2_custom:Molex_Micro-Fit_3.0_43045-0400_2x02_P3.00mm_Horizontal 元MPN: 43045-0400 | 43045-0400と同じ品番の表記違い。指定どおり2個だけ。ケーブル側・圧着端子は含めない。 | https://www.digikey.jp/en/products/detail/molex/0430450400/252527
J11 | 2452796-1 | logger_v2_expansion:nanoSIM_TE_2452796-1_Hinge 元MPN: 2452796-1 | SDとは別部品。現行指定品維持。マーケットプレイス品ではなくDigiKey直販CTを指定。 | https://www.digikey.jp/en/products/detail/te-connectivity-linx/2452796-1/21284797
L1 | DFE252012F-2R2M=P2 | logger_v2_expansion:L_Murata_DFE252012P 元MPN: DFE252012P-2R2M=P2 | 旧490-10649-1-NDがユーザーのカートで規制表示のためFシリーズへ差替え。2.2µH±20%、外形・高さ・推奨ランド（内側1.2/外側2.8/幅2.0mm）は元品と一致。Irms2.3A / Isat3.3A / DCR82mΩ最大（元2.2A/3.0A/84mΩ）。DigiKey直販190,191個、1個税別42円の表示を2026-09-23確認。3個＝実装1＋予備2。ユーザーカートでの規制解除は未確認。 | https://www.digikey.jp/en/products/detail/murata-electronics/DFE252012F-2R2M-P2/5812591
L2 | LQW18AN27NJ00D | logger_v2_custom:L_0603_1608Metric 元MPN: LQW18AN27NJ00D | 指定品維持。440mA、SRF3.7GHz以上。一般電源用インダクタには置換しない。 | https://www.digikey.jp/en/products/detail/murata-electronics/LQW18AN27NJ00D/584382
Q1 | 2N7002ET1G | logger_v2_expansion:SOT-23 元MPN: 2N7002 | 2N7002相当。1=G、2=S、3=Dで基板と一致。 | https://www.digikey.jp/en/products/detail/onsemi/2N7002ET1G/1792136
R1, R5, R11 | CRT0603-BY-1003ELF | logger_v2_custom:R_0603_1608Metric 元MPN: RK73B1JTTD103J | 0603・100kΩ・0.1%・0.1W。R11の帰還精度を優先し同一品へ統一。 | https://www.digikey.jp/en/products/detail/bourns-inc/CRT0603-BY-1003ELF/1775045
R4, R23, R24, R25, R26, R27, R28, R29, R30 | RC0603FR-071KL | logger_v2_custom:R_0603_1608Metric 元MPN: RK73B1JTTD102J; RK73B1JTTD103J | Value基準。古いMPNに10kΩ表記が残る箇所あり。 | https://www.digikey.jp/en/products/detail/yageo/RC0603FR-071KL/729790
R6, R8, R22, R31, R32 | RC0603FR-0747KL | logger_v2_custom:R_0603_1608Metric 元MPN: RC0603J47K; RK73B1JTTD103J | 同サイズの1%品。 | https://www.digikey.jp/en/products/detail/yageo/RC0603FR-0747KL/727253
R10 | RC0603FR-07374KL | logger_v2_custom:R_0603_1608Metric 元MPN: RK73B1JTTD103J | 電源帰還上側。Value=374kを採用。 少量価格の段差も考慮して10個。 | https://www.digikey.jp/en/products/detail/yageo/RC0603FR-07374KL/727189
R14, R16 | RC0603FR-07120RL | logger_v2_custom:R_0603_1608Metric 元MPN: RC0603J120R | 現行DNP=noのため含む。接続するCANバスの終端配置に従って実装する。 少量価格の段差も考慮して10個。 | https://www.digikey.jp/en/products/detail/yageo/RC0603FR-07120RL/726920
R17, R18, R19 | CRCW060322R0FKEA | logger_v2_custom:R_0603_1608Metric 元MPN: RK73B1JTTD103J | 0603・22Ω・1%・0.1Wを維持。在庫表示のあるVishay品。 | https://www.digikey.jp/en/products/detail/vishay-dale/CRCW060322R0FKEA/1179617
R20, R21 | RC0603JR-070RL | logger_v2_custom:R_0603_1608Metric 元MPN: RK73B1JTTD103J | 現行Value=0Ω。 少量価格の段差も考慮して10個。 | https://www.digikey.jp/en/products/detail/yageo/RC0603JR-070RL/726675
R15 | RMCF2512JT27R0 | logger_v2_custom:R_2512_6332Metric 元MPN: CRCW251227R0JNEG | 2512・27Ω・5%・1Wを維持。同サイズのStackpole品へ置換。 | https://www.digikey.jp/en/products/detail/stackpole-electronics-inc/RMCF2512JT27R0/4425469
U2 | AP63301WU-7 | logger_v2_expansion:Diodes_TSOT26 元MPN: AP63301WU-7 | 指定品維持。AP63300/固定電圧版と混同しない。 | https://www.digikey.jp/en/products/detail/diodes-incorporated/AP63301WU-7/10491607
U3 | TXU0204PWR | logger_v2_expansion:TSSOP-14_4.4x5mm_P0.65mm 元MPN: TXU0204PWR | 指定品維持。PWパッケージ。 | https://www.digikey.jp/en/products/detail/texas-instruments/TXU0204PWR/14641512
U4 | MCP25625T-E/SS | logger_v2_custom:SSOP-28_5.3x10.2mm_P0.65mm 元MPN: MCP25625T-E/SS | 指定品維持。/SSパッケージ。高価なため予備なし。 | https://www.digikey.jp/en/products/detail/microchip-technology/MCP25625T-E-SS/4860100
U6 | SIM7070G | logger_v2_expansion:SIMCom_SIM7070G_LCC68_24x24mm_P1mm 元MPN: SIM7070G | 指定の裸モジュール。開発ボードではない。高価なため予備なし。 | https://www.digikey.jp/en/products/detail/simcom-wireless-solutions-limited/SIM7070G/15841451
U7 | ATA6561-GAQW-N | logger_v2_custom:SOIC-8_3.9x4.9mm_P1.27mm 元MPN: ATA6561-GAQW-N | 指定品維持。VDFN版を選ばない。 | https://www.digikey.jp/en/products/detail/microchip-technology/ATA6561-GAQW-N/9453105
U8 | TC74HC595AF(EL,F) | logger_v2_custom:Toshiba_SOP16_P300_1.27A 元MPN: TC74HC595AF | 指定AFのSOP16を維持。一般的な幅3.9mm SOICの74HC595は合わない。 | https://www.digikey.jp/en/products/detail/toshiba-semiconductor-and-storage/TC74HC595AF-EL-F/6679568
U9, U10 | USBLC6-4SC6Y | logger_v2_expansion:SOT-23-6 元MPN: USBLC6-4SC6 | USBLC6-4SC6の車載グレード品。同じ4線・SOT23-6・ピン配置。2=GND、5=VBUS、1/3/4/6=I/O。 | https://www.digikey.jp/en/products/detail/stmicroelectronics/USBLC6-4SC6Y/2756524
Y1 | ABM8-20.000MHZ-10-B1U-T | logger_v2_custom:Crystal_SMD_3225-4Pin_3.2x2.5mm 元MPN: 20M10PB/XT324-10/80 | 同寸法3.2×2.5mm、CL10pF。1/3=水晶、2/4=GND。発振余裕は実機で確認。 | https://www.digikey.jp/en/products/detail/abracon-llc/ABM8-20-000MHZ-10-B1U-T/9997881
D2 | AQ3045-01ETG | logger_v2_custom:D_SOD-882 元MPN: PESD5V0F1BL-Q | GNSSアンテナESD用の機能代替。SOD882・端子ピッチ0.65mm、現PCBの0.4×0.7mmパッドに端子が重なる。容量typ0.35/max0.5pF（元0.4/0.55）、双方向。VRWM5.3V（元5.5）、Vc最大12V@1A（元11V@1A）で全特性同一ではない。3A・ESD±30kV。DigiKey直販82,168個表示。RF/ESD実機試験未実施。 | https://www.digikey.jp/en/products/detail/littelfuse-inc/AQ3045-01ETG/6347831
D3 | CSPSBHC4V5LB-TP | logger_v2_expansion:Prisemi_DFN1006_2L 元MPN: (空欄) | 3.8V電源ESD用の機能代替。4.5V双方向、端子ピッチ0.65mm・長さ0.20～0.30/幅0.45～0.55mmで現PCBの0.4×0.6mmパッドに実装可能。Vc最大8.5V@50A/10.5V@100A（元12V@25A）、100A/900W。容量最大300pF、Tj上限125℃。元品のVhold最低4.6Vに対し本品は保証値記載なし、1Aクランプも保証値なし。全特性同一ではなく、実機サージ後復帰は未検証。DigiKey地域ページに10,002個表示。 | https://www.digikey.jp/en/products/detail/mcc-micro-commercial-components/CSPSBHC4V5LB-TP/22557216
