ntakao2006-web/RaceCapture/outputs/ups_digikey_2sets_20261016/BOM_full_2sets_10pcs.csv

References | Quantity | Value | Manufacturer | MPN | Footprint | Supplier | Supplier_Part_Number | Rating | Stock | Stock_Checked | URL | Stock_Source | Notes | Required_2sets | Spare | Order_Quantity
C1, C2 | 2 | 47u | Panasonic Industry | 25SVPF47M | logger_v2_ups:CP_Elec_6.3x5.9 | DigiKey | P16513CT-ND | 47uF 25V aluminum solid polymer; ESR 30mohm; ripple 2.8A @100kHz 105C | 48305 | 2026-10-16 | https://www.digikey.jp/en/products/detail/panasonic-industry/25SVPF47M/4204320 | https://www.digikey.jp/en/products/detail/panasonic-industry/25SVPF47M/4204320 |  | 4 | 0 | 4
C3, C4, C9 | 3 | 22u | Taiyo Yuden | EMK316BB7226ML-T | Capacitor_SMD:C_1206_3216Metric | DigiKey | 587-4319-1-ND | 22uF +/-20%; 16V; X7R MLCC; 3216 (1206); -55..125C; non-polarized | 78721 | 2026-10-16 | https://www.digikey.jp/en/products/detail/taiyo-yuden/EMK316BB7226ML-T/5361263 | https://www.digikey.jp/en/products/detail/taiyo-yuden/EMK316BB7226ML-T/5361263 |  | 6 | 4 | 10
C5 | 1 | 1u | KEMET | C0805C105K5RACTU | logger_v2_ups:C_0805_2012Metric | DigiKey | 399-C0805C105K5RACTUCT-ND | 1uF 50V X7R +/-10% MLCC 0805 | 141160 | 2026-10-16 | https://www.digikey.jp/en/products/detail/kemet/C0805C105K5RACTU/3317443 | https://www.digikey.jp/en/products/detail/kemet/C0805C105K5RACTU/3317443 |  | 2 | 8 | 10
C6, C7, C8, C12, C13, C14 | 6 | 7F(2.7V) | Eaton - Electronics Division | HVH1020-2R7705-R | logger_v2_ups:Eaton_HVH1020-2R7705-R_D10_L20_P5_Horizontal | DigiKey | 283-HVH1020-2R7705-R-ND | 7F +/-20%; 2.7V; ESR DC max113mohm / 1kHz max75mohm; -40..70C; D10(+0.5) L20(+/-2) P5(+/-0.5)mm | 4000 | 2026-10-16 | https://www.digikey.jp/ja/products/detail/eaton-electronics-division/HVH1020-2R7705-R/28140394 | https://www.digikey.jp/ja/products/detail/eaton-electronics-division/HVH1020-2R7705-R/28140394 | 価格優先で7F採用。旧10F比で公称エネルギー70%。横置き・90度リード曲げ、実機保持時間未検証。 | 12 | 0 | 12
C10 | 1 | 2.2n | KEMET | C0805C222J5GACTU | logger_v2_ups:C_0805_2012Metric | DigiKey | 399-C0805C222J5GACTUCT-ND | 2.2nF 50V C0G +/-5% MLCC 0805 | 22273 | 2026-10-16 | https://www.digikey.jp/en/products/detail/kemet/C0805C222J5GACTU/2212256 | https://www.digikey.com/en/products/detail/kemet/C0805C222J5GACTU/2212256 |  | 2 | 8 | 10
C11 | 1 | 0.47u | KEMET | C0805C474K5RACTU | logger_v2_ups:C_0805_2012Metric | DigiKey | 399-C0805C474K5RACTUCT-ND | 0.47uF 50V X7R +/-10% MLCC 0805 | 114052 | 2026-10-16 | https://www.digikey.jp/en/products/detail/kemet/C0805C474K5RACTU/2212887 | https://www.digikey.com/en/products/detail/kemet/C0805C474K5RACTU/2212887 |  | 2 | 8 | 10
C15 | 1 | 0.1u | KEMET | C0603C104K5RACTU | Capacitor_SMD:C_0603_1608Metric | DigiKey | 399-C0603C104K5RACTUCT-ND | 0.1uF; 50V; X7R MLCC; +/-10%; 0603 (1608 metric) | 4527702 | 2026-10-16 | https://www.digikey.jp/en/products/detail/kemet/C0603C104K5RACTU/1465623 | https://www.digikey.jp/en/products/detail/kemet/C0603C104K5RACTU/1465623 |  | 2 | 8 | 10
C16 | 1 | 10n | KEMET | C0603C103K5RACTU | Capacitor_SMD:C_0603_1608Metric | DigiKey | 399-C0603C103K5RACTUCT-ND | 10nF; 50V; X7R MLCC; +/-10%; 0603 (1608 metric) | 6334222 | 2026-10-16 | https://www.digikey.jp/en/products/detail/kemet/C0603C103K5RACTU/411090 | https://www.digikey.jp/en/products/detail/kemet/C0603C103K5RACTU/411090 |  | 2 | 8 | 10
J1 | 1 | Digital/PWM | Samtec | SSW-110-01-T-S | logger_v2_ups:PinSocket_1x10_P2.54mm_Vertical | DigiKey | 612-SSW-110-01-T-S-ND | 2.54mm THT female socket; 4.7A per contact; -55..105C | 347 | 2026-10-16 | https://www.digikey.jp/en/products/detail/samtec-inc/SSW-110-01-T-S/1112295 | https://www.digikey.com/en/products/detail/samtec-inc/SSW-110-01-T-S/1112295 |  | 2 | 0 | 2
J2, J4 | 2 | Power / Digital/PWM | Samtec | SSW-108-01-T-S | logger_v2_ups:PinSocket_1x08_P2.54mm_Vertical | DigiKey | 612-SSW-108-01-T-S-ND | 2.54mm THT female socket; 4.7A per contact; -55..105C | 1689 | 2026-10-16 | https://www.digikey.jp/en/products/detail/samtec-inc/SSW-108-01-T-S/1112297 | https://www.digikey.jp/en/products/detail/samtec-inc/SSW-108-01-T-S/1112297 |  | 4 | 0 | 4
J3 | 1 | Analog | Samtec | SSW-106-01-T-S | logger_v2_ups:PinSocket_1x06_P2.54mm_Vertical | DigiKey | 612-SSW-106-01-T-S-ND | 2.54mm THT female socket; 4.7A per contact; -55..105C | 1910 | 2026-10-16 | https://www.digikey.jp/en/products/detail/samtec-inc/SSW-106-01-T-S/1112299 | https://www.digikey.com/en/products/detail/samtec-inc/SSW-106-01-T-S/1112299 |  | 2 | 0 | 2
L1 | 1 | 0.47u | Wurth Elektronik | 744355147 | logger_v2_ups:L_Wuerth_HCI-1365 | DigiKey | 732-744355147CT-ND | 0.47uH +/-20%; Ir 30A; Isat10% 25A; Isat30% 50A; DCR 0.67mohm; 13x12.8x6.5mm | 5892 | 2026-10-16 | https://www.digikey.jp/en/products/detail/w%C3%BCrth-elektronik/744355147/1638527 | https://www.digikey.jp/en/products/detail/w%C3%BCrth-elektronik/744355147/1638527 |  | 2 | 0 | 2
Q1, Q2 | 2 | 2N7002K | Diodes Incorporated | 2N7002K-7-W | Package_TO_SOT_SMD:SOT-23 | DigiKey | 31-2N7002K-7-WCT-ND | N-channel MOSFET; 60V VDS; 380mA at VGS=10V; SOT-23 | 5766 | 2026-10-16 | https://www.digikey.jp/en/products/detail/diodes-incorporated/2N7002K-7-W/27803631 | https://www.digikey.jp/en/products/detail/diodes-incorporated/2N7002K-7-W/27803631 |  | 4 | 6 | 10
R1 | 1 | 30.1k | Panasonic Industry | ERJ-6ENF3012V | logger_v2_ups:R_0805_2012Metric | DigiKey | P30.1KCCT-ND | 0805; 30.1kOhm; +/-1%; 0.125W | 93300 | 2026-10-16 | https://www.digikey.jp/en/products/detail/panasonic-industry/ERJ-6ENF3012V/111568 | https://www.digikey.com/en/products/detail/panasonic-industry/ERJ-6ENF3012V/111568 | 抵抗値変更 | 2 | 8 | 10
R2 | 1 | 12.1k | YAGEO | RC0805FR-0712K1L | logger_v2_ups:R_0805_2012Metric | DigiKey | 311-12.1KCRCT-ND | 0805; 12.1kOhm; +/-1%; 0.125W | 1138 | 2026-10-16 | https://www.digikey.jp/en/products/detail/yageo/RC0805FR-0712K1L/730517 | https://www.digikey.jp/en/products/detail/yageo/RC0805FR-0712K1L/730517 | 抵抗値変更 | 2 | 8 | 10
R3 | 1 | 332k | YAGEO | RC0805FR-07332KL | logger_v2_ups:R_0805_2012Metric | DigiKey | 311-332KCRCT-ND | 0805; 332kOhm; +/-1%; 0.125W | 9171 | 2026-10-16 | https://www.digikey.jp/en/products/detail/yageo/RC0805FR-07332KL/727869 | https://www.digikey.jp/en/products/detail/yageo/RC0805FR-07332KL/727869 | 抵抗値変更 | 2 | 8 | 10
R4, R6 | 2 | 1k | YAGEO | RC0805FR-071KL | logger_v2_ups:R_0805_2012Metric | DigiKey | 311-1.00KCRCT-ND | 0805 0.125W +/-1%; 150V working voltage; -55..155C | 884480 | 2026-10-16 | https://www.digikey.jp/en/products/detail/yageo/RC0805FR-071KL/727444 | https://www.digikey.jp/en/products/detail/yageo/RC0805FR-071KL/727444 |  | 4 | 6 | 10
R5 | 1 | 12.4k | YAGEO | RC0805FR-0712K4L | logger_v2_ups:R_0805_2012Metric | DigiKey | 311-12.4KCRCT-ND | 0805; 12.4kOhm; +/-1%; 0.125W | 21359 | 2026-10-16 | https://www.digikey.jp/en/products/detail/yageo/RC0805FR-0712K4L/727572 | https://www.digikey.com/en/products/detail/yageo/RC0805FR-0712K4L/727572 | 抵抗値変更 | 2 | 8 | 10
R7 | 1 | 49.9k | YAGEO | RC0805FR-0749K9L | logger_v2_ups:R_0805_2012Metric | DigiKey | 311-49.9KCRCT-ND | 0805; 49.9kOhm; +/-1%; 0.125W | 910370 | 2026-10-16 | https://www.digikey.jp/en/products/detail/yageo/RC0805FR-0749K9L/730932 | https://www.digikey.com/en/products/detail/yageo/RC0805FR-0749K9L/730932 | 抵抗値変更 | 2 | 8 | 10
R8 | 1 | 25.5k | YAGEO | RC0603FR-0725K5L | Resistor_SMD:R_0603_1608Metric | DigiKey | 311-25.5KHRCT-ND | 0603 (1608 metric); 0.1W; +/-1%; 75V maximum working voltage; -55..155C | 31790 | 2026-10-16 | https://www.digikey.jp/en/products/detail/yageo/RC0603FR-0725K5L/727088 | https://www.digikey.jp/en/products/detail/yageo/RC0603FR-0725K5L/727088 |  | 2 | 8 | 10
R9 | 1 | 2.74M | YAGEO | RC0603FR-072M74L | Resistor_SMD:R_0603_1608Metric | DigiKey | 13-RC0603FR-072M74LCT-ND | 0603; 2.74MOhm; +/-1%; 0.1W | 7807 | 2026-10-16 | https://www.digikey.jp/en/products/detail/yageo/RC0603FR-072M74L/12707882 | https://www.digikey.com/en/products/detail/yageo/RC0603FR-072M74L/12707882 | 抵抗値変更 | 2 | 8 | 10
R10, R13 | 2 | 100k | YAGEO | RC0603FR-07100KL | Resistor_SMD:R_0603_1608Metric | DigiKey | 311-100KHRCT-ND | 0603 (1608 metric); 0.1W; +/-1%; 75V maximum working voltage; -55..155C | 14675 | 2026-10-16 | https://www.digikey.jp/en/products/detail/yageo/RC0603FR-07100KL/726889 | https://www.digikey.jp/en/products/detail/yageo/RC0603FR-07100KL/726889 |  | 4 | 6 | 10
R11, R12 | 2 | 1M | YAGEO | RC0603FR-071ML | Resistor_SMD:R_0603_1608Metric | DigiKey | 311-1.00MHRCT-ND | 0603 (1608 metric); 0.1W; +/-1%; 75V maximum working voltage; -55..155C | 2048080 | 2026-10-16 | https://www.digikey.jp/en/products/detail/yageo/RC0603FR-071ML/726844 | https://www.digikey.jp/en/products/detail/yageo/RC0603FR-071ML/726844 |  | 4 | 6 | 10
R14 | 1 | 10k | Panasonic Industry | ERJ-3EKF1002V | Resistor_SMD:R_0603_1608Metric | DigiKey | P10.0KHCT-ND | 0603; 10kOhm; +/-1%; 0.1W | 2135987 | 2026-10-16 | https://www.digikey.jp/en/products/detail/panasonic-industry/ERJ-3EKF1002V/198102 | https://www.digikey.jp/en/products/detail/panasonic-industry/ERJ-3EKF1002V/198102 | 誤登録の100kΩ品を修正 | 2 | 8 | 10
R15 | 1 | 2.37M | YAGEO | RC0603FR-072M37L | Resistor_SMD:R_0603_1608Metric | DigiKey | 13-RC0603FR-072M37LCT-ND | 0603; 2.37MOhm; +/-1%; 0.1W | 7582 | 2026-10-16 | https://www.digikey.jp/en/products/detail/yageo/RC0603FR-072M37L/5918308 | https://www.digikey.com/en/products/detail/yageo/RC0603FR-072M37L/5918308 | 誤登録の100kΩ品を修正 | 2 | 8 | 10
U1 | 1 | MAX38890AATE+ | Analog Devices / Maxim Integrated | MAX38890AATE+ | logger_v2_ups:TQFN-16-1EP_3x3mm_P0.5mm_EP1.23x1.23mm | DigiKey | 505-MAX38890AATE+-ND | VSYS 2.5..5.5V; peak inductor current 1..5A; -40..125C | 2405 | 2026-10-16 | https://www.digikey.jp/ja/products/detail/analog-devices-inc-maxim-integrated/MAX38890AATE/18693138 | https://www.digikey.jp/ja/products/detail/analog-devices-inc-maxim-integrated/MAX38890AATE/18693138 |  | 2 | 0 | 2
U2 | 1 | LTC1440IMS8#TRPBF | Analog Devices | LTC1440IMS8#TRPBF | Package_SO:MSOP-8_3x3mm_P0.65mm | DigiKey | LTC1440IMS8#TRPBFCT-ND | Comparator with 1.182V reference; MSOP-8 3x3mm P0.65mm; 2..11V supply | 348 | 2026-10-16 | https://www.digikey.jp/en/products/detail/analog-devices-inc/LTC1440IMS8-TRPBF/1621572 | https://www.digikey.com/en/products/detail/analog-devices-inc/LTC1440IMS8-TRPBF/1621572 | DigiKey注文番号を補完 | 2 | 0 | 2
