ntakao2006-web/RaceCapture/outputs/ups_revision_20261016/UNO_Q_UPS_BOM.xlsx

UNO Q UPS 部品表
1基板分・予備なし / 2026-10-16 / 40個・27品種
DigiKey 34個、秋月 6個。数量は必要実装数。在庫は参照ページの表示値で、予約ではありません。
試作設定：SYS 約4.19V、CAP 約3.95V。UNO Qの5V接続先・瞬停保持は実機未検証。
部品番号 | 数量 | 値 | メーカー型番 | パッケージ | 購入先 | 注文番号 | 表示在庫 | 確認日 | 定格・仕様 | フットプリント | 購入ページ | 在庫確認元 | 備考
C1, C2 | 2 | 47u | 25SVPF47M | CP_Elec_6.3x5.9 | DigiKey | P16513CT-ND | 48305 | 2026-10-16T00:00:00.000Z | 47uF 25V aluminum solid polymer; ESR 30mohm; ripple 2.8A @100kHz 105C | logger_v2_ups:CP_Elec_6.3x5.9 | https://www.digikey.jp/en/products/detail/panasonic-industry/25SVPF47M/4204320 | https://www.digikey.jp/en/products/detail/panasonic-industry/25SVPF47M/4204320
C3, C4, C9 | 3 | 22u | EMK316BB7226ML-T | 1206 / 3216 | DigiKey | 587-4319-1-ND | 78721 | 2026-10-16T00:00:00.000Z | 22uF +/-20%; 16V; X7R MLCC; 3216 (1206); -55..125C; non-polarized | Capacitor_SMD:C_1206_3216Metric | https://www.digikey.jp/en/products/detail/taiyo-yuden/EMK316BB7226ML-T/5361263 | https://www.digikey.jp/en/products/detail/taiyo-yuden/EMK316BB7226ML-T/5361263
C5 | 1 | 1u | C0805C105K5RACTU | 0805 / 2012 | DigiKey | 399-C0805C105K5RACTUCT-ND | 141160 | 2026-10-16T00:00:00.000Z | 1uF 50V X7R +/-10% MLCC 0805 | logger_v2_ups:C_0805_2012Metric | https://www.digikey.jp/en/products/detail/kemet/C0805C105K5RACTU/3317443 | https://www.digikey.jp/en/products/detail/kemet/C0805C105K5RACTU/3317443
C6, C7, C8, C12, C13, C14 | 6 | 10F(2.7V) | HP-2R7-J106UY LR | D10 × L25 mm / P5 mm 横置き | Akizuki | 104251 | 未確認 | 未確認 | 10F 2.7V; horizontal D10xL25mm P5mm; pin1 positive | logger_v2_ups:HP-2R7-J106UY_LR_D10_L25_P5_Horizontal | https://akizukidenshi.com/catalog/g/g104251/ | https://akizukidenshi.com/catalog/g/g104251/ | 引継ぎ指定品を維持。秋月で別途調達。在庫未確認。リードを90度曲げて実装。
C10 | 1 | 2.2n | C0805C222J5GACTU | 0805 / 2012 | DigiKey | 399-C0805C222J5GACTUCT-ND | 22273 | 2026-10-16T00:00:00.000Z | 2.2nF 50V C0G +/-5% MLCC 0805 | logger_v2_ups:C_0805_2012Metric | https://www.digikey.jp/en/products/detail/kemet/C0805C222J5GACTU/2212256 | https://www.digikey.com/en/products/detail/kemet/C0805C222J5GACTU/2212256
C11 | 1 | 0.47u | C0805C474K5RACTU | 0805 / 2012 | DigiKey | 399-C0805C474K5RACTUCT-ND | 114052 | 2026-10-16T00:00:00.000Z | 0.47uF 50V X7R +/-10% MLCC 0805 | logger_v2_ups:C_0805_2012Metric | https://www.digikey.jp/en/products/detail/kemet/C0805C474K5RACTU/2212887 | https://www.digikey.com/en/products/detail/kemet/C0805C474K5RACTU/2212887
C15 | 1 | 0.1u | C0603C104K5RACTU | 0603 / 1608 | DigiKey | 399-C0603C104K5RACTUCT-ND | 4527702 | 2026-10-16T00:00:00.000Z | 0.1uF; 50V; X7R MLCC; +/-10%; 0603 (1608 metric) | Capacitor_SMD:C_0603_1608Metric | https://www.digikey.jp/en/products/detail/kemet/C0603C104K5RACTU/1465623 | https://www.digikey.jp/en/products/detail/kemet/C0603C104K5RACTU/1465623
C16 | 1 | 10n | C0603C103K5RACTU | 0603 / 1608 | DigiKey | 399-C0603C103K5RACTUCT-ND | 6334222 | 2026-10-16T00:00:00.000Z | 10nF; 50V; X7R MLCC; +/-10%; 0603 (1608 metric) | Capacitor_SMD:C_0603_1608Metric | https://www.digikey.jp/en/products/detail/kemet/C0603C103K5RACTU/411090 | https://www.digikey.jp/en/products/detail/kemet/C0603C103K5RACTU/411090
J1 | 1 | Digital/PWM | SSW-110-01-T-S | 1x10 / P2.54 mm ソケット | DigiKey | 612-SSW-110-01-T-S-ND | 347 | 2026-10-16T00:00:00.000Z | 2.54mm THT female socket; 4.7A per contact; -55..105C | logger_v2_ups:PinSocket_1x10_P2.54mm_Vertical | https://www.digikey.jp/en/products/detail/samtec-inc/SSW-110-01-T-S/1112295 | https://www.digikey.com/en/products/detail/samtec-inc/SSW-110-01-T-S/1112295
J2, J4 | 2 | Power / Digital/PWM | SSW-108-01-T-S | 1x08 / P2.54 mm ソケット | DigiKey | 612-SSW-108-01-T-S-ND | 1689 | 2026-10-16T00:00:00.000Z | 2.54mm THT female socket; 4.7A per contact; -55..105C | logger_v2_ups:PinSocket_1x08_P2.54mm_Vertical | https://www.digikey.jp/en/products/detail/samtec-inc/SSW-108-01-T-S/1112297 | https://www.digikey.jp/en/products/detail/samtec-inc/SSW-108-01-T-S/1112297
J3 | 1 | Analog | SSW-106-01-T-S | 1x06 / P2.54 mm ソケット | DigiKey | 612-SSW-106-01-T-S-ND | 1910 | 2026-10-16T00:00:00.000Z | 2.54mm THT female socket; 4.7A per contact; -55..105C | logger_v2_ups:PinSocket_1x06_P2.54mm_Vertical | https://www.digikey.jp/en/products/detail/samtec-inc/SSW-106-01-T-S/1112299 | https://www.digikey.com/en/products/detail/samtec-inc/SSW-106-01-T-S/1112299
L1 | 1 | 0.47u | 744355147 | L_Wuerth_HCI-1365 | DigiKey | 732-744355147CT-ND | 5892 | 2026-10-16T00:00:00.000Z | 0.47uH +/-20%; Ir 30A; Isat10% 25A; Isat30% 50A; DCR 0.67mohm; 13x12.8x6.5mm | logger_v2_ups:L_Wuerth_HCI-1365 | https://www.digikey.jp/en/products/detail/w%C3%BCrth-elektronik/744355147/1638527 | https://www.digikey.jp/en/products/detail/w%C3%BCrth-elektronik/744355147/1638527
Q1, Q2 | 2 | 2N7002K | 2N7002K-7-W | SOT-23 | DigiKey | 31-2N7002K-7-WCT-ND | 5766 | 2026-10-16T00:00:00.000Z | N-channel MOSFET; 60V VDS; 380mA at VGS=10V; SOT-23 | Package_TO_SOT_SMD:SOT-23 | https://www.digikey.jp/en/products/detail/diodes-incorporated/2N7002K-7-W/27803631 | https://www.digikey.jp/en/products/detail/diodes-incorporated/2N7002K-7-W/27803631
R1 | 1 | 30.1k | ERJ-6ENF3012V | 0805 / 2012 | DigiKey | P30.1KCCT-ND | 93300 | 2026-10-16T00:00:00.000Z | 0805; 30.1kOhm; +/-1%; 0.125W | logger_v2_ups:R_0805_2012Metric | https://www.digikey.jp/en/products/detail/panasonic-industry/ERJ-6ENF3012V/111568 | https://www.digikey.com/en/products/detail/panasonic-industry/ERJ-6ENF3012V/111568 | 抵抗値変更
R2 | 1 | 12.1k | RC0805FR-0712K1L | 0805 / 2012 | DigiKey | 311-12.1KCRCT-ND | 1138 | 2026-10-16T00:00:00.000Z | 0805; 12.1kOhm; +/-1%; 0.125W | logger_v2_ups:R_0805_2012Metric | https://www.digikey.jp/en/products/detail/yageo/RC0805FR-0712K1L/730517 | https://www.digikey.jp/en/products/detail/yageo/RC0805FR-0712K1L/730517 | 抵抗値変更
R3 | 1 | 332k | RC0805FR-07332KL | 0805 / 2012 | DigiKey | 311-332KCRCT-ND | 9171 | 2026-10-16T00:00:00.000Z | 0805; 332kOhm; +/-1%; 0.125W | logger_v2_ups:R_0805_2012Metric | https://www.digikey.jp/en/products/detail/yageo/RC0805FR-07332KL/727869 | https://www.digikey.jp/en/products/detail/yageo/RC0805FR-07332KL/727869 | 抵抗値変更
R4, R6 | 2 | 1k | RC0805FR-071KL | 0805 / 2012 | DigiKey | 311-1.00KCRCT-ND | 884480 | 2026-10-16T00:00:00.000Z | 0805 0.125W +/-1%; 150V working voltage; -55..155C | logger_v2_ups:R_0805_2012Metric | https://www.digikey.jp/en/products/detail/yageo/RC0805FR-071KL/727444 | https://www.digikey.jp/en/products/detail/yageo/RC0805FR-071KL/727444
R5 | 1 | 12.4k | RC0805FR-0712K4L | 0805 / 2012 | DigiKey | 311-12.4KCRCT-ND | 21359 | 2026-10-16T00:00:00.000Z | 0805; 12.4kOhm; +/-1%; 0.125W | logger_v2_ups:R_0805_2012Metric | https://www.digikey.jp/en/products/detail/yageo/RC0805FR-0712K4L/727572 | https://www.digikey.com/en/products/detail/yageo/RC0805FR-0712K4L/727572 | 抵抗値変更
R7 | 1 | 49.9k | RC0805FR-0749K9L | 0805 / 2012 | DigiKey | 311-49.9KCRCT-ND | 910370 | 2026-10-16T00:00:00.000Z | 0805; 49.9kOhm; +/-1%; 0.125W | logger_v2_ups:R_0805_2012Metric | https://www.digikey.jp/en/products/detail/yageo/RC0805FR-0749K9L/730932 | https://www.digikey.com/en/products/detail/yageo/RC0805FR-0749K9L/730932 | 抵抗値変更
R8 | 1 | 25.5k | RC0603FR-0725K5L | 0603 / 1608 | DigiKey | 311-25.5KHRCT-ND | 31790 | 2026-10-16T00:00:00.000Z | 0603 (1608 metric); 0.1W; +/-1%; 75V maximum working voltage; -55..155C | Resistor_SMD:R_0603_1608Metric | https://www.digikey.jp/en/products/detail/yageo/RC0603FR-0725K5L/727088 | https://www.digikey.jp/en/products/detail/yageo/RC0603FR-0725K5L/727088
R9 | 1 | 2.74M | RC0603FR-072M74L | 0603 / 1608 | DigiKey | 13-RC0603FR-072M74LCT-ND | 7807 | 2026-10-16T00:00:00.000Z | 0603; 2.74MOhm; +/-1%; 0.1W | Resistor_SMD:R_0603_1608Metric | https://www.digikey.jp/en/products/detail/yageo/RC0603FR-072M74L/12707882 | https://www.digikey.com/en/products/detail/yageo/RC0603FR-072M74L/12707882 | 抵抗値変更
R10, R13 | 2 | 100k | RC0603FR-07100KL | 0603 / 1608 | DigiKey | 311-100KHRCT-ND | 14675 | 2026-10-16T00:00:00.000Z | 0603 (1608 metric); 0.1W; +/-1%; 75V maximum working voltage; -55..155C | Resistor_SMD:R_0603_1608Metric | https://www.digikey.jp/en/products/detail/yageo/RC0603FR-07100KL/726889 | https://www.digikey.jp/en/products/detail/yageo/RC0603FR-07100KL/726889
R11, R12 | 2 | 1M | RC0603FR-071ML | 0603 / 1608 | DigiKey | 311-1.00MHRCT-ND | 2048080 | 2026-10-16T00:00:00.000Z | 0603 (1608 metric); 0.1W; +/-1%; 75V maximum working voltage; -55..155C | Resistor_SMD:R_0603_1608Metric | https://www.digikey.jp/en/products/detail/yageo/RC0603FR-071ML/726844 | https://www.digikey.jp/en/products/detail/yageo/RC0603FR-071ML/726844
R14 | 1 | 10k | ERJ-3EKF1002V | 0603 / 1608 | DigiKey | P10.0KHCT-ND | 2135987 | 2026-10-16T00:00:00.000Z | 0603; 10kOhm; +/-1%; 0.1W | Resistor_SMD:R_0603_1608Metric | https://www.digikey.jp/en/products/detail/panasonic-industry/ERJ-3EKF1002V/198102 | https://www.digikey.jp/en/products/detail/panasonic-industry/ERJ-3EKF1002V/198102 | 誤登録の100kΩ品を修正
R15 | 1 | 2.37M | RC0603FR-072M37L | 0603 / 1608 | DigiKey | 13-RC0603FR-072M37LCT-ND | 7582 | 2026-10-16T00:00:00.000Z | 0603; 2.37MOhm; +/-1%; 0.1W | Resistor_SMD:R_0603_1608Metric | https://www.digikey.jp/en/products/detail/yageo/RC0603FR-072M37L/5918308 | https://www.digikey.com/en/products/detail/yageo/RC0603FR-072M37L/5918308 | 誤登録の100kΩ品を修正
U1 | 1 | MAX38890AATE+ | MAX38890AATE+ | TQFN-16 + EP / 3 × 3 mm | DigiKey | 505-MAX38890AATE+-ND | 2405 | 2026-10-16T00:00:00.000Z | VSYS 2.5..5.5V; peak inductor current 1..5A; -40..125C | logger_v2_ups:TQFN-16-1EP_3x3mm_P0.5mm_EP1.23x1.23mm | https://www.digikey.jp/ja/products/detail/analog-devices-inc-maxim-integrated/MAX38890AATE/18693138 | https://www.digikey.jp/ja/products/detail/analog-devices-inc-maxim-integrated/MAX38890AATE/18693138
U2 | 1 | LTC1440IMS8#TRPBF | LTC1440IMS8#TRPBF | MSOP-8 / 3 × 3 mm | DigiKey | LTC1440IMS8#TRPBFCT-ND | 348 | 2026-10-16T00:00:00.000Z | Comparator with 1.182V reference; MSOP-8 3x3mm P0.65mm; 2..11V supply | Package_SO:MSOP-8_3x3mm_P0.65mm | https://www.digikey.jp/en/products/detail/analog-devices-inc/LTC1440IMS8-TRPBF/1621572 | https://www.digikey.com/en/products/detail/analog-devices-inc/LTC1440IMS8-TRPBF/1621572 | DigiKey注文番号を補完
合計 | 40
