ntakao2006-web/RaceCapture/outputs/ups_split_2sets_20261016/Akizuki_shopping_2sets.csv

販売コード | 商品 | 購入型番 | 注文数量 | 注文単位 | 入数 | 購入個数 | 2セット必要数 | 余り | 税込単価円 | 税込小計円 | 部品番号 | URL | 備考
103786 | 10P ピンソケット | FH-1x10SG/RH | 2 | 個 | 1 | 2 | 2 | 0 | 40 | 80 | J1 | https://akizukidenshi.com/catalog/g/g103786 | 2.54mm、メス、短足。3A/接点。高さ8.5mm。
103785 | 8P ピンソケット | FH-1x8SG/RH | 4 | 個 | 1 | 4 | 4 | 0 | 30 | 120 | J2, J4 | https://akizukidenshi.com/catalog/g/g103785 | 2.54mm、メス、短足。3A/接点。高さ8.5mm。
103784 | 6P ピンソケット | FH-1x6SG/RH | 2 | 個 | 1 | 2 | 2 | 0 | 25 | 50 | J3 | https://akizukidenshi.com/catalog/g/g103784 | 2.54mm、メス、短足。3A/接点。高さ8.5mm。
104256 | Nch MOSFET | 2N7002K | 1 | パック | 40 | 40 | 4 | 36 | 200 | 200 | Q1, Q2 | https://akizukidenshi.com/catalog/g/g104256 | SOT-23、1=G/2=S/3=D。60V/300mA。制御用の置換品。
115331 | 1µF 50V X7R | C2012X7R1H105KT000N | 1 | パック | 10 | 10 | 2 | 8 | 100 | 100 | C5 | https://akizukidenshi.com/catalog/g/g115331 | 0805(2012)、±10%。在庫限り・通販残2パック（確認時）。
