ntakao2006-web/RaceCapture/circuit/logger_v2/output/parts_and_models.csv

Reference | Value | DNP | Footprint | Model | Pin_count | Pad_numbers
C1 | 100nF | no | logger_v2_custom:C_0603_1608Metric | C_0603_1608Metric.step | 2 | 1,2
C2 | 33p | no | logger_v2_custom:C_0603_1608Metric | C_0603_1608Metric.step | 2 | 1,2
C3 | 33p | no | logger_v2_custom:C_0603_1608Metric | C_0603_1608Metric.step | 2 | 1,2
D1 | LED_Small_Filled | no | logger_v2_custom:LED_D3.0mm_JLCPCB | LED_D3.0mm.step | 2 | 1,2
D2 | LED_Small_Filled | no | logger_v2_custom:LED_D3.0mm_JLCPCB | LED_D3.0mm.step | 2 | 1,2
D3 | LED_Small_Filled | no | logger_v2_custom:LED_D3.0mm_JLCPCB | LED_D3.0mm.step | 2 | 1,2
D4 | LED_Small_Filled | no | logger_v2_custom:LED_D3.0mm_JLCPCB | LED_D3.0mm.step | 2 | 1,2
D5 | LED_Small_Filled | no | logger_v2_custom:LED_D3.0mm_JLCPCB | LED_D3.0mm.step | 2 | 1,2
D6 | LED_Small_Filled | no | logger_v2_custom:LED_D3.0mm_JLCPCB | LED_D3.0mm.step | 2 | 1,2
D7 | LED_Small_Filled | no | logger_v2_custom:LED_D3.0mm_JLCPCB | LED_D3.0mm.step | 2 | 1,2
D8 | LED_Small_Filled | no | logger_v2_custom:LED_D3.0mm_JLCPCB | LED_D3.0mm.step | 2 | 1,2
D9 | PEC3824C2A-AU | no | logger_v2_custom:SOT-23 | SOT-23.step | 3 | 1,2,3
D10 | PEC3824C2A-AU | no | logger_v2_custom:SOT-23 | SOT-23.step | 3 | 1,2,3
J1 | S-037-TGG | no | logger_v2_custom:SMA_S-037-TGG_Horizontal | COSMTEC_S-037-TGG_mechanical.step | 2 | 1,2
J2 | Digital/PWM | no | logger_v2_custom:PinSocket_1x10_P2.54mm_Vertical | PinSocket_1x10_P2.54mm_Vertical.step | 10 | 1,2,3,4,5,6,7,8,9,10
J3 | Power | no | logger_v2_custom:PinSocket_1x08_P2.54mm_Vertical | PinSocket_1x08_P2.54mm_Vertical.step | 8 | 1,2,3,4,5,6,7,8
J4 | Analog | no | logger_v2_custom:PinSocket_1x06_P2.54mm_Vertical | PinSocket_1x06_P2.54mm_Vertical.step | 6 | 1,2,3,4,5,6
J5 | Digital/PWM | no | logger_v2_custom:PinSocket_1x08_P2.54mm_Vertical | PinSocket_1x08_P2.54mm_Vertical.step | 8 | 1,2,3,4,5,6,7,8
J6 | 43045-0400 | no | logger_v2_custom:Molex_Micro-Fit_3.0_43045-0400_2x02_P3.00mm_Horizontal | Molex_43045-0402_same_geometry_as_0400.step | 4 | 1,2,3,4
J7 | 43045-0400 | no | logger_v2_custom:Molex_Micro-Fit_3.0_43045-0400_2x02_P3.00mm_Horizontal | Molex_43045-0402_same_geometry_as_0400.step | 4 | 1,2,3,4
L1 | 27n | no | logger_v2_custom:L_0603_1608Metric | L_0603_1608Metric.step | 2 | 1,2
R1 | 1k | no | logger_v2_custom:R_0603_1608Metric | R_0603_1608Metric.step | 2 | 1,2
R2 | 1k | no | logger_v2_custom:R_0603_1608Metric | R_0603_1608Metric.step | 2 | 1,2
R3 | 1k | no | logger_v2_custom:R_0603_1608Metric | R_0603_1608Metric.step | 2 | 1,2
R4 | 1k | no | logger_v2_custom:R_0603_1608Metric | R_0603_1608Metric.step | 2 | 1,2
R5 | 10k | no | logger_v2_custom:R_0603_1608Metric | R_0603_1608Metric.step | 2 | 1,2
R6 | 1k | no | logger_v2_custom:R_0603_1608Metric | R_0603_1608Metric.step | 2 | 1,2
R7 | 22R 1W | no | logger_v2_custom:R_2512_6332Metric | R_2512_6332Metric.step | 2 | 1,2
R8 | 1k | no | logger_v2_custom:R_0603_1608Metric | R_0603_1608Metric.step | 2 | 1,2
R9 | 1k | no | logger_v2_custom:R_0603_1608Metric | R_0603_1608Metric.step | 2 | 1,2
R10 | 10k | yes | logger_v2_custom:R_0603_1608Metric | R_0603_1608Metric.step | 2 | 1,2
R11 | 1k | no | logger_v2_custom:R_0603_1608Metric | R_0603_1608Metric.step | 2 | 1,2
R12 | 10k | no | logger_v2_custom:R_0603_1608Metric | R_0603_1608Metric.step | 2 | 1,2
R13 | 120 | yes | logger_v2_custom:R_0603_1608Metric | R_0603_1608Metric.step | 2 | 1,2
R14 | 120 | yes | logger_v2_custom:R_0603_1608Metric | R_0603_1608Metric.step | 2 | 1,2
R15 | 4.7k | no | logger_v2_custom:R_0603_1608Metric | R_0603_1608Metric.step | 2 | 1,2
R16 | 4.7k | no | logger_v2_custom:R_0603_1608Metric | R_0603_1608Metric.step | 2 | 1,2
R17 | 10k | no | logger_v2_custom:R_0603_1608Metric | R_0603_1608Metric.step | 2 | 1,2
U1 | TC74HC595AF | no | logger_v2_custom:SOIC-16W_5.3x10.2mm_P1.27mm | SOIC-16W_5.3x10.2mm_P1.27mm.step | 16 | 1,2,3,4,5,6,7,8,9,10,11,12,13,14,15,16
U2 | NEO-M9N-00B | no | logger_v2_custom:ublox_NEO | u-blox_NEO-M9N-00B_mechanical.step | 24 | 1,2,3,4,5,6,7,8,9,10,11,12,13,14,15,16,17,18,19,20,21,22,23,24
U3 | BNO055_module | no | logger_v2_custom:AE_BNO055_BO | Akizuki_AE-BNO055-BO_mechanical.step | 8 | 1,2,3,4,5,6,7,8
U4 | ATA6561-GAQW-N | no | logger_v2_custom:SOIC-8_3.9x4.9mm_P1.27mm | SOIC-8_3.9x4.9mm_P1.27mm.step | 8 | 1,2,3,4,5,6,7,8
U5 | MCP25625T-E/SS | no | logger_v2_custom:SSOP-28_5.3x10.2mm_P0.65mm | SSOP-28_5.3x10.2mm_P0.65mm.step | 28 | 1,2,3,4,5,6,7,8,9,10,11,12,13,14,15,16,17,18,19,20,21,22,23,24,25,26,27,28
Y1 | HUSG-20.000-20 | no | logger_v2_custom:Crystal_HC49-4H_Vertical | Crystal_HC49-4H_Vertical.step | 2 | 1,2
