ntakao2006-web/RaceCapture/circuit/logger_v2/output/design_review_20260907/parts_sourcing.csv

Reference | Existing_part | Proposed_part | Manufacturer | LCSC | JLC_library | JLC_assembly | Package | Stock_reported | Stock_evidence | Checked_JST | Status | URL | Notes
U1 | TC74HC595AF | 74HC595D,118 | Nexperia | C5947 | Basic | Economic and Standard | SOIC-16 3.9mm | 302263 | JLC indexed page snapshot | 2026-09-07 | Selected final design | https://jlcpcb.com/partdetail/Nexperia-74HC595D118/C5947 | Change footprint from 5.3mm SOP; same logic pinout
U2 | NEO-M9N-00B | NEO-M9N-00B | u-blox | C5119087 | Extended | Standard Only | SMD-24P | 500 | JLC indexed page snapshot; current page confirms Standard Only | 2026-09-07 | Selected final design | https://jlcpcb.com/partdetail/UBLOX-NEO_M9N00B/C5119087 | LCSC separately showed 322; do not confuse supplier stock with allocated PCBA stock
U3 | AE-BNO055-BO | AE-BNO055-BO | Akizuki |  | Unconfirmed | Excluded from SMT BOM/CPL; post-assembly | 18x11mm module | TBD | No exact JLC registration verified | 2026-09-07 | Selected post-assembly | https://akizukidenshi.com/catalog/g/g116996/ | Use module-specific BOM; never assign bare BNO055 C93216 to this footprint
U3 alternative | AE-BNO055-BO | BNO055 | Bosch Sensortec | C93216 | Extended | Standard Only | LGA-28 5.2x3.8mm | 8957 | JLC category indexed stock snapshot | 2026-09-07 | Alternative only | https://jlcpcb.com/partdetail/BoschSensortec-BNO055/C93216 | Requires full circuit redesign around same sensor IC and axis validation
U4 | ATA6561-GAQW-N | ATA6561-GAQW | Microchip | C2929602 | Extended | SMT listed; service class not displayed | SOIC-8 | 1117 | LCSC stock only; JLC quantity not displayed | 2026-09-07 | Selected final design | https://jlcpcb.com/partdetail/MicrochipTech-ATA6561GAQW/C2929602 | AEC-Q100 version instead of industrial -N; confirm ordering allocation
U5 | MCP25625T-E/SS | MCP25625-E/SS | Microchip | C184944 | Extended | Economic and Standard | SSOP-28 5.3mm | 86 | JLC indexed page snapshot; indexed 10 months ago | 2026-09-07 | Selected final design | https://jlcpcb.com/partdetail/MicrochipTech-MCP25625_ESS/C184944 | T suffix changes reel packaging; same IC and SSOP; stock must be refreshed at order
D1-D8 | 3mm THT LED | KT-0805G | Hubei KENTO | C2297 | Basic | Economic and Standard | 0805 | 1845064 | JLC category page indexed today | 2026-09-07 | Selected final design | https://jlcpcb.com/partdetail/KT-0805G/C2297 | Green Vf2.6-3.1V at5mA; selected680ohm resistors; verify actual low-current brightness
D9-D10 | PEC3824C2A-AU | NUP2105LT1G | onsemi | C14486 | Extended | SMT listed | SOT-23 | 190745 | JLC indexed page snapshot | 2026-09-07 | Selected final design | https://jlcpcb.com/partdetail/NUP2105LT1G/C14486 | Pin1/2 line pin3 common; 24V 30pF max; standard part is not SZ automotive-qualified variant
D11 | new RF ESD | PESD5V0F1BL,315 | Nexperia | C45961 | Extended | Economic and Standard | SOD882 DFN1006-2 | 18223 | JLC indexed page snapshot | 2026-09-07 | Selected final design | https://jlcpcb.com/partdetail/Nexperia-PESD5V0F1BL315/C45961 | 0.4pF typ bidirectional RF ESD; mount at SMA
L1 | 27nH unspecified | LQG15HS27NJ02D | Murata | C12669 | Extended | Economic and Standard | 0402 | InStock quantity unverified | Current JLC structured availability; no quantity displayed | 2026-09-07 | Selected final design | https://jlcpcb.com/partdetail/LQG15HS27NJ02D/C12669 | 27nH 350mA DCR0.46ohm SRF1.7GHz; footprint changes from0603
L1 alternate | 27nH unspecified | LQG15HZ27NH02D | Murata | C237452 | Extended | Economic and Standard | 0402 | 1096 | JLC indexed page snapshot | 2026-09-07 | Alternative if allocation unavailable | https://jlcpcb.com/partdetail/MurataElectronics-LQG15HZ27NH02D/C237452 | 27nH 3percent AEC-Q200; confirm RF curve for final selected choke
Y1 | HUSG-20.000-20 | XC2EL89COO-114YLC-20M | YXC | C18213008 | Extended | Economic and Standard | SMD3225-4P | 4098 | JLC indexed page snapshot | 2026-09-07 | Selected final design | https://jlcpcb.com/partdetail/19387115-XC2EL89COO_114YLC20M/C18213008 | 20MHz CL12pF ESR70ohm -40to125C; C2/C3 must match12pF load
Y1 alternate | HUSG-20.000-20 | ABM8G-20.000MHZ-18-D2Y-T | Abracon | C1985763 | Extended | Economic and Standard | SMD3225-4P | 13 | JLC indexed page snapshot; available order qty10 | 2026-09-07 | CL18pF alternative limited stock | https://jlcpcb.com/partdetail/AbraconLLC-ABM8G_20_000MHZ_18_D2YT/C1985763 | 20MHz CL18pF ESR80ohm -40to85C
J1 | S-037-TGG | S-037-TGG | COSMTEC |  | Unconfirmed | Excluded from SMT BOM/CPL; post-assembly | Horizontal THT SMA | TBD | No exact JLC registration verified | 2026-09-07 | Selected post-assembly; orientation fixed | https://akizukidenshi.com/goodsaffix/S-037-TGG_20220729.pdf | Do not substitute generic SMA without comparing manufacturer dimensions and RF launch
J2-J5 | UNO shield headers | UNO shield stacking headers | TBD |  | Unconfirmed | Excluded from SMT BOM/CPL; post-assembly | 2.54mm long-tail stacking headers | TBD | Exact manufacturer and part not specified | 2026-09-07 | Selected post-assembly; orientation fixed | https://docs.arduino.cc/hardware/uno-q/ | Sockets alone may not provide required male shield tails; verify stand-off and UNO Q clearance
J6-J7 | 43045-0400 | 43045-0400 | Molex |  | Unconfirmed | Excluded from SMT BOM/CPL; post-assembly | Micro-Fit3.0 2x2 horizontal | TBD | No exact JLC registration verified | 2026-09-07 | Selected post-assembly; orientation fixed | https://www.molex.com/en-us/products/part-detail/430450400 | Check exact suffix and board retention features before matching procurement alternates
R7 rejected original value | 22R 1W | 25121WJ0220T4E | UNI-ROYAL | C27258 | Extended | Unconfirmed | 2512 | InStock quantity hidden | Current JLC HTML structured availability; separate LCSC indexed stock86200 | 2026-09-07 | Not selected; insufficient tolerance margin | https://jlcpcb.com/partdetail/28007-25121WJ0220T4E/C27258 | 22ohm5%1W; 22R nominal does not prove below150mA including tolerances
R7 | 22R 1W | 25121WJ0270T4E | UNI-ROYAL | C25478 | Extended | Unconfirmed | 2512 | InStock quantity hidden | Current JLC HTML structured availability | 2026-09-07 | Selected final design | https://jlcpcb.com/partdetail/C25478 | 27ohm5%1W; below141mA at3.6V ignoring other resistance but antenna voltage lower by0.10V at20mA
C1/C4/C5/C6/C7/C8/C9/C10/C12 | 100nF or new | CC0603KRX7R9BB104 | YAGEO | C14663 | Basic | Economic and Standard | 0603 | 65537578 | JLC indexed today; available order51319038 | 2026-09-07 | Selected final design | https://jlcpcb.com/partdetail/Yageo-CC0603KRX7R9BB104/C14663 | 100nF X7R50V10%; C1 RF bias capacitor may share this part
C11 | new1uF | CL10A105KB8NNNC | Samsung Electro-Mechanics | C15849 | Basic | Economic and Standard | 0603 | 9147549 | JLC indexed today; available order6454019 | 2026-09-07 | Selected final design | https://jlcpcb.com/partdetail/C15849 | 1uF X5R50V10%; maximum rated temperature85C
C13/C14 | new10uF | CL21A106KAYNNNE | Samsung Electro-Mechanics | C15850 | Basic | Economic and Standard | 0805 | 7852178 | JLC indexed today; available order6491601 | 2026-09-07 | Selected final design | https://jlcpcb.com/partdetail/CL21A106KAYNNNE/C15850 | 10uF X5R25V10%; account for DC bias; maximum rated temperature85C
R18/R19/R20 | new47k | 0603WAF4702T5E | UNI-ROYAL | C25819 | Basic | Economic and Standard | 0603 | InStock quantity hidden | Current JLC HTML structured availability | 2026-09-07 | Selected final design | https://jlcpcb.com/partdetail/C25819 | 47k1%100mW
R1/R2/R3/R4/R6/R8/R9/R11 | 1k | 0603WAF6800T5E | UNI-ROYAL | C23228 | Basic | Economic and Standard | 0603 | InStock quantity hidden | Current JLC HTML structured availability | 2026-09-07 | Selected final design | https://jlcpcb.com/partdetail/0603WAF6800T5E/C23228 | 680ohm1%100mW; verify actual LED brightness
C2/C3 | 33pF | CL10C180JB8NNNC | Samsung Electro-Mechanics | C1647 | Basic | Unconfirmed | 0603 | InStock quantity hidden | Current JLC HTML structured availability | 2026-09-07 | Selected final design | https://jlcpcb.com/partdetail/1999-CL10C180JB8NNNC/C1647 | 18pF C0G50V5%; for CL12pF crystal and estimated3pF stray
