ntakao2006-web/RaceCapture/circuit/logger_v2/output/parts_preparation_detail_20260921.png

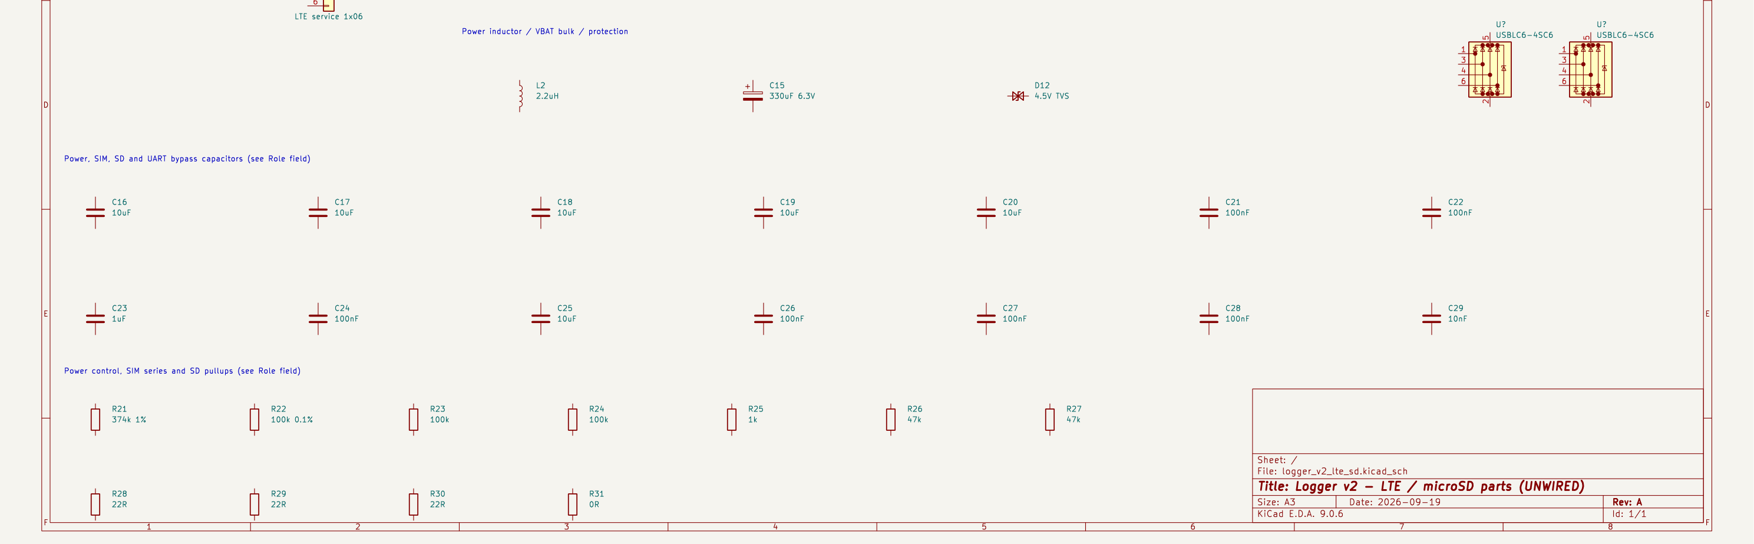
circuit/logger_v2/output/parts_preparation_detail_20260921.png
