ntakao2006-web/RaceCapture/outputs/logger_v2_order_20260923/basis_top.png

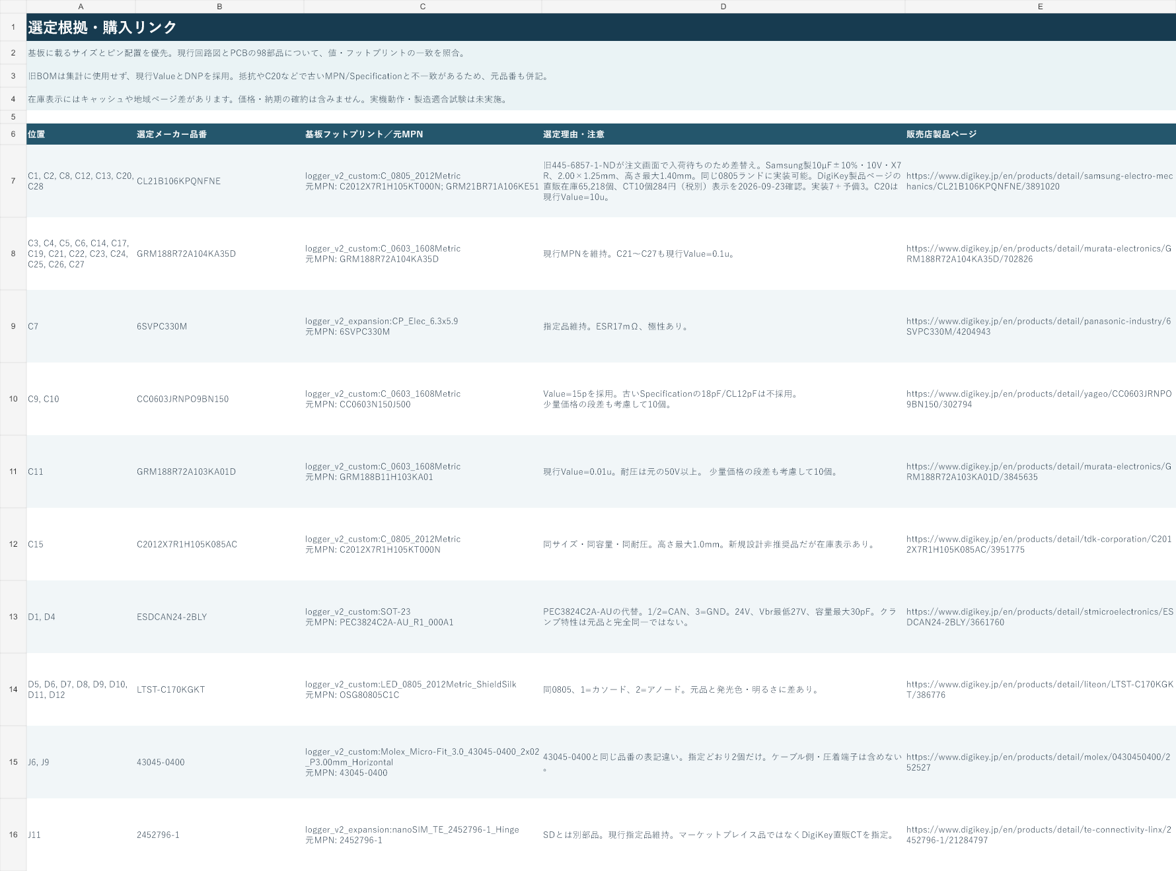
outputs/logger_v2_order_20260923/basis_top.png
