ntakao2006-web/RaceCapture/outputs/logger_v2_order_20260923/DFE252012F.png

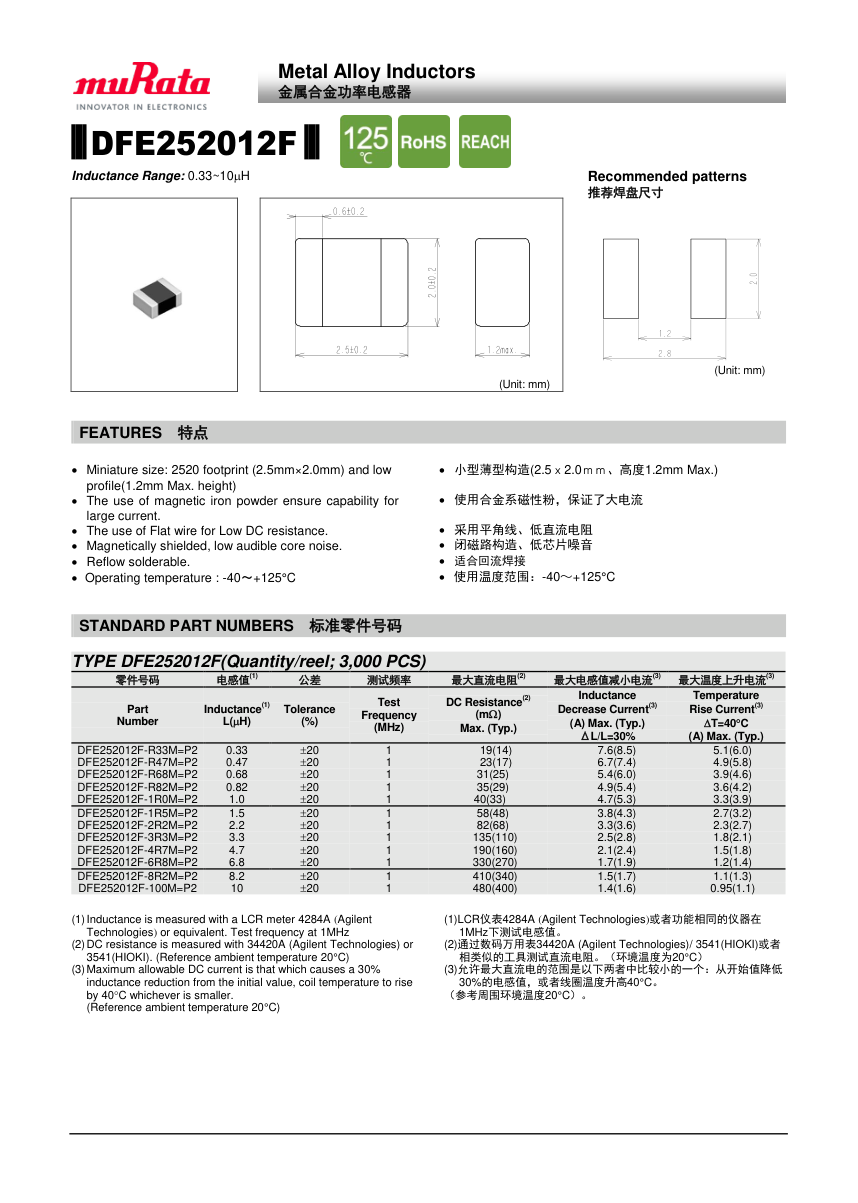
outputs/logger_v2_order_20260923/DFE252012F.png
