ntakao2006-web/RaceCapture/outputs/logger_v2_order_20260923/excluded_bottom.png

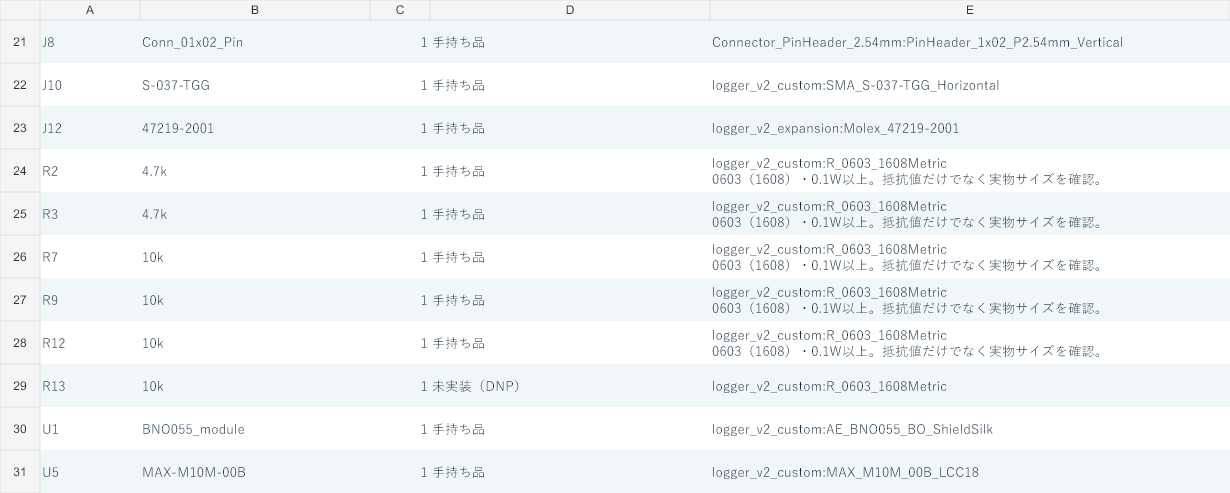
outputs/logger_v2_order_20260923/excluded_bottom.png
