ntakao2006-web/RaceCapture/outputs/logger_v2_order_20260923/mcc_outline.png

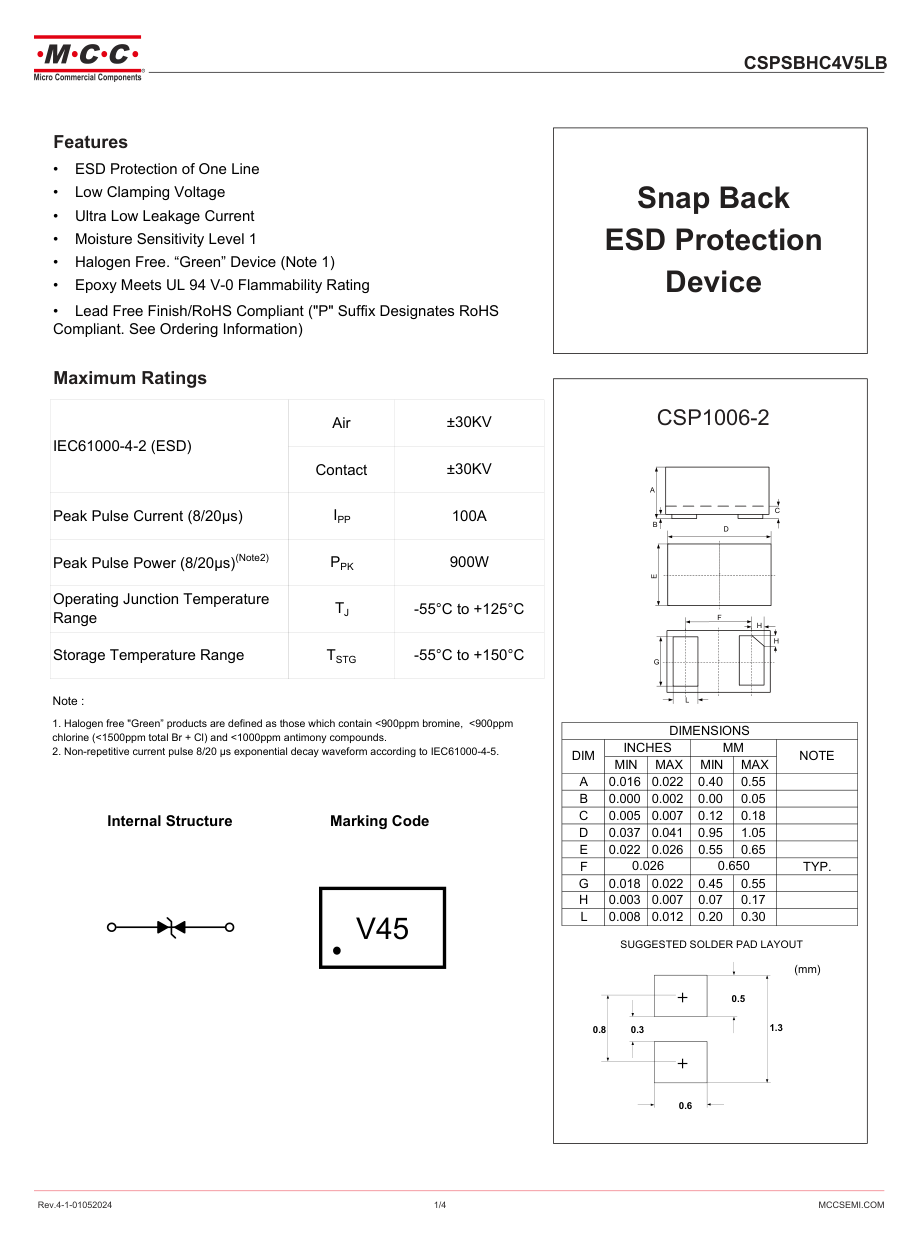
outputs/logger_v2_order_20260923/mcc_outline.png
