ntakao2006-web/RaceCapture/(list of files, cad)

Other CAD files:
circuit/logger_v2/3dmodels/TE_2452796-1.step
circuit/logger_v2/refs/TE_2452796-1_original.step
circuit/logger_v2/UNO Q simplified.stp
circuit/logger_v2_ups/logger_v2_ups.step
circuit/logger_v2/3dmodels/L_DFE252012P_nominal.step
circuit/logger_v2/logger_v2.step
circuit/logger_v2/3dmodels/PinHeader_1x06_P2.54mm_Vertical.step
circuit/logger_v2/3dmodels/L_Bourns_SRN6045TA.step
circuit/logger_v2/3dmodels/COSMTEC_S-037-TGG_mechanical.step
circuit/logger_v2/3dmodels/D_SOD-882.step
circuit/logger_v2/3dmodels/U.FL_Hirose_U.FL-R-SMT-1_Vertical.step
circuit/logger_v2/3dmodels/Crystal_HC49-4H_Vertical.step
circuit/logger_v2/3dmodels/u-blox_MAX-M10M-00B.step
circuit/logger_v2/3dmodels/SIMCom_SIM7070G_mechanical.step
circuit/logger_v2/3dmodels/u-blox_NEO-M9N-00B_mechanical.step
circuit/logger_v2/3dmodels/LED_D3.0mm.step
circuit/logger_v2/3dmodels/TSOT-23-6.step
circuit/logger_v2/3dmodels/Molex_43045-0402_same_geometry_as_0400.step
circuit/logger_v2/3dmodels/Molex_47219-2001.step
circuit/logger_v2/3dmodels/TI_TPS62130_RGT16_mechanical.step
circuit/logger_v2/3dmodels/L_0402_1005Metric.step
circuit/logger_v2/3dmodels/SOIC-16_3.9x9.9mm_P1.27mm.step
circuit/logger_v2/3dmodels/nanoSIM_Hinged_CUI_NSIM-2-C.step
circuit/logger_v2/3dmodels/TSSOP-24_4.4x7.8mm_P0.65mm.step
circuit/logger_v2/3dmodels/CP_EIA-7343-31_Kemet-D.step
circuit/logger_v2/3dmodels/microSD_HC_Hirose_DM3AT-SF-PEJM5.step
circuit/logger_v2/3dmodels/SOIC-16W_5.3x10.2mm_P1.27mm.step
circuit/logger_v2/3dmodels/PinSocket_1x10_P2.54mm_Vertical.step
circuit/logger_v2/3dmodels/SSOP-28_5.3x10.2mm_P0.65mm.step
circuit/logger_v2/3dmodels/Akizuki_AE-BNO055-BO_mechanical.step
circuit/logger_v2/3dmodels/R_2512_6332Metric.step
circuit/logger_v2/3dmodels/SOIC-8_3.9x4.9mm_P1.27mm.step
circuit/logger_v2/3dmodels/TC74HC595AF_nominal.step
circuit/logger_v1/3dmodels/Molex_43045-0402.step
circuit/logger_v1/3dmodels/Molex_47219-2001.step
circuit/logger_v1/3dmodels/Murata_OKL-T6-W12.step
circuit/logger_v1/3dmodels/S-037-TGG_mechanical_proxy_WE60311002114501.step
circuit/logger_v1/3dmodels/TI_TUSB320IRWBR.step
circuit/logger_v1/3dmodels/Toshiba_WSON10B.step
circuit/logger_v1/3dmodels/d36v50fx.step
circuit/logger_v1/3dmodels/u-blox_MAX-M10M-00B.step
circuit/logger_v1/logger_v1.step
circuit/logger_v1/output/3d/logger_v1_20260819.step
circuit/logger_v2/UNO Q simplified.3dm
circuit/logger_v2/logger_v2.3dm
