ntakao2006-web/RaceCapture/task_spec_rebuild_breakdown.md

# 仕様書に合わせた作り直し（誰でも使える形にする）の分解

> 2026-11-13起票。要求は`SPEC.md`が正で、ここでは作業と順番だけを扱う（SP-x）。
> 各項目の末尾の（P-1）などは、満たす`SPEC.md` 4章の要求の番号。

## 前提（2026-11-13 ユーザー決定、`SPEC.md` 9-1）

- 「誰でも」は、取付・確認・回収に加えて解析（レポート・1周の動画）まで
- 車・コースの切り替えは現地で係もする。USB・テザリングに加えてLTEでもできるようにする（見本を見て改めた）
- 入口は手元の機器に置き、ロガーとつながっていなくても開く。スマホは自宅のサーバーのページ（LTE）、PCはEcoLoggerアプリ（ブラウザ）。本体が出すページは入口にしない
- LTEで送れる命令は今の5つに「車・コースを選ぶ」を1つ足す（本体に入れてある設定の名前を選ぶだけ。中身は送らない）
- 動画は走行ごとに1か所へそろえる
- 車載画面の隅に「記録・測位・送信」の印を常に出す
- 公式のRaceCaptureアプリ・RCP・公式のPodiumへの送信は外す。RaceCaptureの名前も順に外す。系譜は記録として残す
- エコランはVer.2＋スマホの画面

## 線引き

| 区分 | 中身 | いつ |
|---|---|---|
| **PC・リポジトリだけで進むもの** | SP-1〜SP-5、SP-8 | すぐ始められる |
| **自宅のサーバーに入れるもの** | SP-6 | PCで作って確かめ、ユーザーの了承を取ってから入れる |
| **本体（UNO Q）に入れるもの** | SP-7、SP-4-3 | **展示用のファームから元へ戻したあと**（`v2_firmware_backup_20261110.md`）。それまではPCで作って試験まで |

- カート（`KT-x`、11/29）の作業と重なるときはカートを先にする。
- 動きを変える前に、いまの道具がしていることを試験で押さえる（道具ごとの`test_*.py`を通したまま移す）。
- 1つの項目が終わるたびに、古い入口を残したまま新しい入口を足し、ユーザーが新しい方で1回使ってから古い方を外す。

## 作業

- [x] SP-0 仕様書と分解
  - [x] SP-0-1 仕様書の下書き`SPEC.md`（2026-11-13）
  - [x] SP-0-2 この分解（2026-11-13）

- [x] SP-1 **いまを確かめる**（読むだけ。何も変えない）（2026-11-13済み。ソースと本体の控えで確かめた。実機と画面は動かしていない）
  - [x] SP-1-1 `SPEC.md` 4章の「いま」を、PCの道具のソースで確かめ直して列を直した。×になったもの：P-3（いまの車・コースを見る所が無い）、C-3（動画と走行記録に共通の名前が無く、フォルダーの日付が回収した日）、S-6（入れるものの一覧も手順も無い）。見つけた不具合の疑い2つはSP-3-2・SP-3-4に書いた
  - [x] SP-1-2 ピットのページ：周回表と時計は10秒で「N秒前のまま」と出すが、地図とG-Gは最後の値が残る。入口の1枚は無い。LTEの命令をブラウザから送る仕組みは無い
  - [x] SP-1-3 スマホのアプリ：エコランの画面はロガーの記録もLTEも出さず、温度の警告と音が無い。ロガーへは「記録を始める」を押すまでつなぎに行かない。設定は手入力で、入れ方はadb
  - [x] SP-1-4 本体で有効なサービスの一覧を控えの目録から作った（`docs/design/unoq_software_inventory.md` 4章）。公式アプリ用の3つと古い試作1つが有効のまま
  - [x] SP-1-5 `SPEC.md`の「下書き」を外し、確かめた範囲を冒頭に書いた

- [ ] SP-2 **片付け**（動きは変えない。置き場所と案内だけ）
  - [x] SP-2-1 リポジトリの表紙`README.md`を、いまの姿（Ver.2）と、使う人・チーム・開発者それぞれの資料への案内に直す（2026-11-13済み）
  - [x] SP-2-2 開発・調べもの用の道具（`race_replay`・`podium_replay`・`unoq_spi_sd_test`・`can1_loss`・`lte_antenna`）を`tools/dev/`へ移す。参照している資料・操作メニュー・`CLAUDE.md`のパスも直す（2026-11-13済み。5つを`tools/dev/`へ`git mv`、操作メニューの電波の2つのボタンと`radio_walk_pc.py`のリポジトリの位置を合わせ、操作メニューの試験10件は通った）
  - [x] SP-2-3 通話の道具（`voice_gate`・`discord_bridge`）と、エコランの記録表（`record_sheet`）の置き場所を分ける（`archive/`か別フォルダーかはこの項目で決める）（2026-11-13済み。通話は`archive/voice/`（`voice_gate`・`discord_bridge`・`handoff_20261020_voice_field_test.md`）、記録表は`ecorun/record_sheet/`（`build_sheet.py`と`ecorun_record_sheet_20261024.xlsx`）。録音を外す`.gitignore`の行も新しい場所に合わせた）
  - [x] SP-2-4 `RaceCapture-UNOQ/`の中身を「いま動いているもの／公式アプリ用／試験／古い候補」に仕分けた一覧を作る（動かすのはSP-7-3のあと）（2026-11-13済み。`docs/design/unoq_software_inventory.md`。`EcoCapture-Web/`の分も入れた。リポジトリの中だけを根拠にしたので、本体で有効かどうかの「要確認」はSP-1-4で見る）
  - [ ] SP-2-5 録画のソフト`tools/unoq_overlay_enc/`を本体のソフトの並びへ移すかを決める（本体への入れ方のスクリプトがパスを見ているので、移すなら本体に触れるときに合わせる）　→ 2026-11-13：今回の片付けでは動かさない（ユーザー指定）。移すかどうかは本体に触れるSP-7で決める
  - [x] SP-2-6 直下の資料を種類ごとのフォルダーへ移す（2026-11-13済み、ユーザー依頼）。人に渡したメモと回答は`docs/share/`、仕様・設計は`docs/design/`、手順書は`docs/manual/`、調査は`docs/research/`、閉じたダッシュカムの資料は`archive/dashcam/`。分解ファイルと、ソフトのコメントから名指しされている資料は直下のまま。直下のスクリプト・`.json`・`.log`（Ver.1のCAN調査など）は範囲の外で触っていない

- [ ] SP-3 **PCのアプリを1つにする**（母体は回収アプリ`tools/video_collect/`）
  - [ ] SP-3-1 画面の案を作ってユーザーに見せる：段は「いまの様子・回収・走行を見る・設定」、上の段に「ロガーを待っています → つながりました」。動かない見本でよい　→ 2026-11-13：見本を作って見せた（`docs/design/ecologger_app_mock.html`。Claudeのページにも載せてある。同じファイルを出し直すと更新）。場面を5つ切り替えられる（まだ無い・USB・テザリング・LTEだけ・直す所がある）。数字と走行は例。感想を2回もらって直した（LTEでの車・コース選び、周の動画を見る、解析ソフトへの書き出し、消すボタンとバー、ラインの図と引き直しの画面、走行中の拒否、周の表から温度を外す）。**まだ感想を受け付け中**（落ち着いたらチェックを付ける）
  - [x] SP-3-2 つなぎ方の部品を1つにする（2026-11-13済み。下に結果）：USB → テザリング → LTE を自分で探し、つながらない理由と直し方を返す（6章）。土台は`video_collect.find_link`（操作メニューも使っている）。別々に残っているもの：`--adb`の有無で決めるだけの`runner`が4つ（`sugo_setup`・`hud_apply`・`dash_check`・`lens_preview_remote`）、古い`collect_logs.reach_uno_q`、メニューの`usb_appeared`。まとめて試験を付ける。`dash_check.Device.get`がscpに接続先の指定を付けていない疑いもここで見る
    - **2026-11-13 作った**：`tools/collect_logs/unoq_link.py`。USB → テザリングの順に自分で探し（速いほうでつながったら遅いほうは試さない）、つながらなければ道ごとの理由と直し方を返す（adbが無い／機器が見えない／許可されていない／つながっているのはロガーでない（スマホ）／sshが返事をしない／鍵が合わない／鍵が違う機械）。LTEは本体でコマンドを動かす道ではないので、「決まった命令だけ送れる」と案内し、実際に答えるかは`lte_answers()`（状態を聞く）で確かめる形にした（画面で使うのはSP-3-3）。回収アプリの中にあった`Link`・`find_link`はここへ移し、回収アプリからは同じ名前で使える
    - 切り替えた道具：`sugo_setup`（`defi_*`・`podium_channels_setup`も同じ`runner`）・`hud_apply`（`exposure_apply`・`lens_apply`も）・`dash_check`（`install_sectors`も）・`lens_preview_remote`・操作メニューのUSBの見張り。**`--adb`を付けなくてもUSBがあればUSBでつなぐ**ようになった（`--adb`は「USBだけ」の意味で残した。操作メニューは今までどおり付ける）。`dash_check`がテザリングでファイルを取るとき、見つけたつなぎ先（IP）を付けていなかったのは本当で、部品に寄せて直った。操作メニューで、道具が理由つきで止まる（`SystemExit`）と画面に何も出ない件（SP-3-4に書いた疑い）は、受ける所を直した（動かしては未確認）
    - 確かめ：部品の試験12件を足した（順番・理由の文・`--adb`はUSBだけ・取る／送るの両方につなぎ先が付く・LTEの5通り・道具が部品を使うこと）。変える前から通っていた試験（回収19・SUGO 27・計器30・露出4・メニュー10・命令12）は変えたあとも通る。このPCで実際に探させ、本体が無いとき（スマホだけadbに見えている）に理由と直し方が出ることを見た。**本体をつないでの確かめはまだ**（USB・テザリングそれぞれで、道具を1つずつ開く）
    - 残したもの：`collect_logs.reach_uno_q`は古いコマンドの口（`collect_logs.py`を直接動かすとき）だけが使う。回収アプリは部品を使っているので、古い口をしまうとき（SP-3-9）に一緒に外す
  - [x] SP-3-3 「いまの様子」の段（2026-11-13済み。下に結果）：記録・測位・SD・録画・LTEを合否で出す（P-4・T-4）。ロガーが無くても開き、来たら自分で切り替わる。操作の決まり（`SPEC.md` 7-5：バー・読み直し・押せない理由）は、この段を作るときに共通の部品にする
    - **2026-11-13 作った**：回収アプリ（`tools/video_collect/`）を母体に、上に「つながり」の帯と段の切り替え（いまの様子・回収）を足した。題は「EcoLogger」。新しい入口は`tools/video_collect/EcoLogger-App.cmd`（操作メニューの「設定・調べもの」→「EcoLoggerアプリを開く」）。今までの`Collect-Video.cmd`は「回収」の段で開く（古い入口は残してある）
    - 動き：アプリは本体を探す前にすぐ開く（前は探し終わるまで開かなかった）。裏の見張り（`now_status.py`の`Watcher`）がUSB → テザリングを探し続け、つながると自分で読み始める。つながらない間は道ごとの理由と直し方を出し、「LTEで状態を聞く」を押せばLTEで聞いた値を同じ形で出す（自動では送らない）。つながっている間は8秒ごとに読み、記録・測位・SDカード・録画・LTEを○／×／？で出し、×には直し方を付ける。30秒読めないと薄くして「○秒前のまま」。回収などの作業の間は読まない。テザリングの間にUSBが見えたらUSBへ替える。ドックをつないだまま起動してUSBでつなげない本体は、その案内を出す
    - 合否の決め方（`now_status.checks`）：記録＝基板から届いている・記録中・80 Hz以上／測位＝「測位中」／SD＝本体の警告が無い／録画＝録画中で残り30分以上／LTE＝送信ONで送信中か測位待ち。本体が答えないときは「？」にして良いとは言わない
    - 確かめ：試験10件（合否9通り・答えないとき・LTEの返事・読み取り・見張りの切り替え4通り・LTEで聞く3通り）。回収アプリの前からの試験19件も通る（2つ目を開いたときに開くアドレスに段が付くので、その1件の期待だけ合わせた）。ブラウザでは、本体なしで見る道具`tools/video_collect/dev_app.py`（場面はフォルダーに`usb`・`tether`・`bad`・`hang`を置いて変える）で、待っています → USBでつながった（すべて良好）→ テザリングで直す所が3つ → 読めなくなって44秒前のまま、と自分で切り替わること、段の切り替え、LTEのボタンを見た。本物のアプリも別の口で起動し、本体なしで0.5秒で開いて理由が出ることを見た。**本体をつないでの確かめはまだ**
    - 残り：操作の決まりの共通の部品（`SPEC.md` 7-5のバー・読み直し・押せない理由）は、操作を載せるSP-3-4で作る（この段は読むだけで、LTEで聞くときのバーだけ入れた）。いまの車・コースの表示はSP-4-4。つながりの名前に「遅いので短い区間だけ」と回収向けの言い回しが出る
  - [x] SP-3-4（2026-11-13済み。下に結果）「いまの様子」へラップのリセットと、LTEの命令のふだんの2つを載せる（T-3）。最初の合言葉の準備（いまは`remote_command_pc.py setup`をコマンドで）も画面からできるようにする。合言葉が無いと操作メニューに何も出ない不具合の疑い（`send()`が`SystemExit`を投げ、メニューの`except Exception`をすり抜ける。動かしては確かめていない）もここで直す
    - **2026-11-13 作った**：`tools/video_collect/app_ops.py`と、「いまの様子」の段の「操作」の欄。ラップを0周に戻す（つながっていれば本体へ直接、いなければLTE）、LTEで状態を聞く。「ほかの操作・合言葉」の中に、周回数を直す・いまから計測を始める・記録を始める（LTE）、合言葉の準備・作り直し（本体がつながっているときだけ。いまつながっている道をそのまま使う）、スマホへ合言葉を渡すQR（SP-6-3の残りだった分。QRの絵だけを画面へ渡し、合言葉とアドレスは渡さない。2分で消える）
    - 操作の決まりの共通の部品（`SPEC.md` 7-5）をここで作った：どの操作も同じバー（何を・どの道で・何秒／最大何秒）、変えたあとは本体から読み直した値を結果に出す（直接なら周回数を読み直す、LTEなら返事の状態を「LTEで聞いた様子」にも出す）、使えないボタンは押せなくせず、押すと理由と「どうすれば使えるか」を出す（合言葉が無い → 準備をする／準備は本体をつないでから／ほかの操作の返事待ち／回収の途中）。送る前の確認は画面の中に出し、**LTEで変える操作は4桁を入れてから送る**（PCからはロガーが走っているか分からないので、LTEのときは必ず入れる。本体へ直接のときは確認だけ）
    - 不具合の疑い（合言葉が無いと操作メニューに何も出ない）：操作メニューの側はSP-3-2で受ける所を直してあり、新しいアプリでは「合言葉がありません → 準備を」と出る。合言葉の準備が理由つきで止まったとき（本体に中継のURLが無いなど）も結果に出る
    - 確かめ：試験8件（直接とLTEの出し分け・読み直し・返事なし・断る理由5通り・1つずつ・準備がつながっている道を使う・理由つきで止まったとき・QRの絵に合言葉とアドレスが入らないことと期限）。ブラウザでは作りものの本体（`dev_app.py`。操作も作りもので、LTEへは送らない）で、合言葉なしの3通りの理由 → USBでつないで準備 → ラップのリセット（読み直した0周が合否の下の札にも出る）→ QR → ロガーなしでLTEの周回数直し（数字なし・4桁違い・正しい4桁・読み直し）を見た。回収アプリの前からの試験も通る。**本体をつないで・本物のLTEでの確かめはまだ**
    - 残り：QRの窓（`phone_key.py`）と操作メニューのLTEのボタンは、古い入口として残してある（SP-3-9でしまう）
  - [x] SP-3-5（2026-11-13済み。下に結果）回収の段：回収のあと本体の動画は消さない前提にする（回収済みから本体が自動で入れ替えることを、結果のそばに分かる言葉で出す。まだ回収していないものが入れ替わりで消えそうなときは知らせる）。「回収済みを本体から消す」のボタンは残す。終わったあとに「取れたもの・取れなかったもの・次にすること」を結果に合わせて出す（C-2。いまは次にすることが決まった文だけで、0本でも緑の「回収しました」、記録中で取らなかった分は畳んだ記録にしか出ない）。USBへ差し替える手順の案内（C-5。ドックをつないだまま起動したときの確認`/sys/class/udc`は操作メニューにしか無いので回収にも入れる）
    - **2026-11-13 作った**：「回収する」の結果を、取れたもの・取れなかったもの（何が・なぜ）・次にすること、に分けて出す（`video_collect.summarize_result`）。何も取るものが無かったときは緑の「回収しました」ではなく「新しく取るものはありませんでした」。取れなかったものに入るのは、本体がつながっていない／テザリングなので動画は取っていない（残っている本数つき）／録画・記録の途中の1本／失敗した段。次にすることは結果に合わせて変わる（USBへ差し替える手順、電源を入れ直すと途中の分が取れる、SDカードの控え、失敗したものは取り直さずにもう一度）
    - 入れ替わりの知らせ（`evict_risk`）：本体は回収済みを先に入れ替え、尽きると回収していない古いものを消す。回収していないものが残っていて、あと120分録るまでに消え始める見積もりのとき、回収の段の上と結果に「あと約○分で古い順に消え始めます」と出す（30分を切ると赤）。録画中・保護したものは数えない
    - USBの案内（C-5）：テザリングでつないだ本体がUSBでつなげない状態（ドックをつないだまま起動。`/sys/class/udc`が空）かを回収の段でも確かめ、つながりの行と「次にすること」に出す
    - 言い回し：「回収しても、本体からは消しません。本体は空きが要るときに、回収済みから自分で入れ替えます（ドライブレコーダーと同じ）」。「回収済みを本体から消す」のボタンは残してある
    - 確かめ：試験4件を足し、前からの2件に結果の中身の確かめを足した（回収アプリの試験は41件とも通る）。結果の見え方は作りものの値でブラウザで見た。**本体をつないでの確かめはまだ**
  - [x] SP-3-6（2026-11-13済み。**ファイルは動かさず、索引で結ぶ形にした**。下に結果）動画を走行ごとのフォルダーへそろえる（C-3）：新しい置き方を決め、回収・`lap_video`・`race_analysis`・SDの索引を合わせる。いまは走行記録のフォルダーの日付が**回収した日**で、動画と走行記録に共通の名前・索引が無い（時刻での照らし合わせは`lap_video`の中だけ）。走った日でまとめ、走行ごとの索引を1つ持つ
    - **2026-11-13 決めたことと作ったもの**：`tools/video_collect/run_index.py`。走行記録1本（本体の電源ONから切るまで）を「走行」とし、**走った日（日本時間）**・始まりと終わりの時刻・この走行で増えた周回数・コース（最後に測位した場所がコースの設定の線から3 km以内）・同じ時刻に重なる動画の章・動画が「あり（9割以上）／一部／なし」と無い区間、を1つの索引（`drive_logs/runs_index.json`）にまとめる。**回収したファイルの場所は変えない**（走行記録は今までどおり回収した日のフォルダー、動画は録画の回のフォルダー）。理由：置き場を変えると、回収・1周の動画・解析・SDの索引・NASの控えの全部の参照先が変わり、移す途中で壊れたときの戻しが重い。索引なら、今ある76本がそのまま走った日で並ぶ。走行記録は大きい（1本で1 GBを超えるものがある）ので頭と末尾だけを読み、2回目からは変わったファイルだけ読む
    - 確かめ：試験7件（走った日と回収した日の違い・動画の結び方・一部と無い区間・同じ記録を2回回収・コースが分からない・変わった所だけ読む・値の中にカンマのある列）。実物の保存先を読むだけで動かし（索引は書かせていない）、76本・9日ぶんが0.7秒で並び、SUGO決勝は161分・38周・動画ありと出た。周回数は本体が電源を切っても覚えているので、走り始めの値を引いている
    - **2026-11-13 同日に直した不具合：本体の時計のずれ**。本体は時計用の電池が無く、測位や回線で合うまで時計がずれている。実物で数えると、測位のある52本のうち19本でずれていた（数分〜十数時間）。はじめの版は本体の時計をそのまま使っていたので、走った日が違う日になる・動画と結ばれない・時計が途中で合った走行が長く見える（SUGO決勝が161分。正しくは147分）、が起きていた。直し方：終わりの時刻は末尾の行の「本体の時計と測位の時計の差」で直し、始まりは基板の時計で測った長さを引いて出す（`lap_video.py`と同じ考え方）。周の表の周ごとの時刻も同じに直した。測位していない走行は直せないので、画面に「時刻は本体の時計」と出す。試験5件を足した
    - 残り：回収の道具・`lap_video`・`race_analysis`がこの索引を読む形にするのは、それぞれを直すときに。SDカードの控え（`EL*.BIN`）は時刻で結んでいない（中を読まないと時刻が分からないため）。動画が「一部／なし」の理由（録画していない・まだ回収していない・本体で消えた）の見分けは出していない
  - [ ] SP-3-7 （2026-11-13：SP-3-6を「索引で結ぶ」形にしたので、ファイルを移す道具は当面いらない。フォルダーを走行ごとに作り直したくなったら、この項目で）回収済みのものを新しい置き方へ移す道具（確かめるだけ→移す。移す前後でSHA-256を比べる。NASの控えは別に扱う）
  - [ ] SP-3-8 （**2026-11-14：PCで作って試験まで済み。本体をつないでは未確認**。アプリに「設定」の段。**見る**：計器の配置・レンズ・露出・音・針の補間の、本体のいまの中身を1画面に出す（読むのは段を開いたときと「読み直す」。つながっていなければPCの`hud.ini`・`lens.json`を見られる）。**変える**：今の道具の関数（`hud_apply`・`lens_apply`・`exposure_apply`）をアプリから呼ぶ。重すぎる・誤りのある配置は送らない。音（`audio.ini`）と針の補間（`smooth_ms`・`telemetry_hz`）は新しく作った（値の範囲を確かめ、変えた項目だけ書く。**効くのは次に録画が始まったとき＝電源を入れ直したときから**、と画面に出す）。**前へ戻す（1世代）**：送る前の値を本体の`/home/arduino/ecologger-video/prev/`に控え、「前の値へ戻す」で入れ替える（今までの道具は控えを取っていなかった）。PCで絵を見る道具・本体のモニターでレンズを決める道具は「開く」ボタン（Pillow・opencvが無ければ理由と入れ方を出す）。`settings_ops.py`・`settings.js`、試験33件（アプリ全体129件）。作りものの本体でブラウザで操作して確かめた。作らなかったもの：録画の入れ直し（rootの作業で、アプリから確かにできる道が分からない）、「まだ効いていない」の判定、音を録らない設定を変えるボタン。音・針の補間の値の上限（低い音を切る周波数1000 Hz・音量+20 dB・補間300ミリ秒）は置いた値。本体で見る所：読めるか・テザリングで何秒か、控えの持ち主、送って約1秒で絵が変わるか、音が電源を入れ直したあと効くか）「設定」の段：焼き込み（計器・レンズ・露出・音）を1画面で見る・変える・前へ戻す（S-1）。いまの`.cmd` 6本の中身を呼ぶ形から始める。足りないもの：本体のいまの中身を読む、送る前の値を1世代残して戻す、音（`audio.ini`）と針の補間（`smooth_ms`・`telemetry_hz`）の道具（いまは本体のファイルを手で書く）
  - [ ] SP-3-9 操作メニューの窓をやめる：デスクトップのショートカットを新しいアプリへ差し替え、`tools/ecologger_menu/`をしまう
  - [ ] SP-3-10 （**2026-11-13：一覧と入れ方の案まで済み**。`docs/design/pc_app_requirements.md`・`tools/requirements.txt`。外のパッケージが要るのは解析・1周の動画・計器とレンズをPCで見る道具の4か所だけ（numpy・pandas・scipy・opencv・Pillow）で、**新しいアプリ（いまの様子・回収）は標準の部品だけで動く**。Python以外はadb（USB）・ssh（テザリング）・ffmpeg（1周の動画だけ）。Pythonは3.9以上（書き方から読んだ下限。動かして確かめたのはこのPCの版だけ）。入れ方は3案を比べ、案は「フォルダー1つ＋初回に決まった版のPythonとadbを公式の配布元から取ってくる`Setup.cmd`」。**入れ方・渡す範囲・データの置き場・配るPythonの版はユーザーが決める**。まっさらなPCでの確かめはSP-3-11）ほかの人のPCへ1回の操作で入る形にする（S-6）：Python・adb・ffmpegを手で入れさせない。入れ方はこの項目で比べて決める（インストーラー1つ／フォルダーごと持ち運ぶ）。いま前提にしているもの：Python 3.9以上（tkinter）、numpy・pandas・scipy・opencv・Pillow、adb、sshの`Host unoq`の設定と鍵、ffmpeg。一覧（requirements）も無いので、まず一覧を作る
  - [ ] SP-3-11 ユーザー以外の人に、手順書だけで回収までしてもらって確かめる

- [ ] SP-4 **車・コースを選ぶ**（P-1〜P-3）
  - [x] SP-4-1（2026-11-13済み。下に結果）`tools/sugo_setup/`の道具がしていることを棚卸しし、「車の設定（読む信号・換算・警告の値）」と「コースの設定（ライン・セクター・画面のページ）」のファイルの形を決める
  - [x] SP-4-2（2026-11-13済み。下に結果）NCECとSUGOを新しい形のファイルへ書き出し、いまの本体の設定（控え）と同じになることを試験で確かめる
    - **2026-11-13 形を決めて書き出した**：置き場は`tools/setups/`。`vehicles/<名前>.json`（車で決まるもの）と`courses/<名前>.json`（コースで決まるもの）の2種類で、名前は英小文字・数字の短いもの（LTEで「名前だけ」送るため）
      - 車：`logger`（本体が読む信号と換算。本体の`config.json`と同じ形）・`send`（LTEでピットへ送る項目と、中継の部屋の名前）・`dash`（車載画面の警告としきい値：油温・水温・油圧・シフトの回転数）・`analysis`（トレッド）
      - コース：`line`（コントロールライン・スタート・ゴール・セクター。本体の`lap.json`の`line`と同じ形）・`dash`（ピットレーンの制限速度）・`confirm.racing_speed_kmh`（線を変えるときに確認を増やす速さ。SUGOは100）
      - 棚卸し：`sugo_setup.py`＝線（コース）／`defi_volt_setup.py`・`defi_temp_setup.py`＝信号（車）／`podium_channels_setup.py`＝送る項目と部屋（車）／`install_sectors.py`・`dash_check.py`＝ソフトそのものを入れる道具（設定ではないので対象外）。車載画面のしきい値は`dash_model.py`の`DEFAULTS`に車の分とコースの分が混ざっていたので、設定では分けた
    - 道具`tools/setups/setups.py`：`list`、`check`（ファイルの形を確かめる。控えの`config.json`・`lap.json`、またはつないだ本体のいまの設定（読むだけ）と比べる）。おかしい所は「どの信号の何が」まで言う
    - 確かめ：NCEC（信号17個）とSUGO（線とセクター3本）を書き出し、**11/10の本体の控えの`config.json`・`lap.json`と比べて違いなし**。試験16件：設定ファイルが、いまの道具とコードの値（`ncec.py`の12信号・Defiの5信号・`SUGO_LINE`・送る9項目・`DEFAULTS`・解析の設定）と同じであること（道具をしまうまでの食い違いの見張り）、形のおかしさ14通りの言い当て、違いの出し方。**本体のいまの設定（展示用にしたあと）とは比べていない**。LTEで送る項目が本体でこの9項目になっているかも未確認（控えに入れていない所にあるため）
    - 残り：本体へ入れる道具（SP-4-3、展示のあと）。車載画面・ピットのページがしきい値をここから読む形にする（SP-7-1の後半）。`tools/sugo_setup/`の道具は、SP-4-3ができるまでそのまま使う
  - [ ] SP-4-3 （**2026-11-13：道具はPCで作って試験まで済み。本体では未実行（展示のあと）。本体に「いまの車・コースの名前」を持たせる所はまだ**。`tools/setups/setups_apply.py --vehicle ncec --course sugo`（既定は確かめるだけ、`--apply`で違う所だけ入れる）。コース（記録を止めない）：PCのコースの設定を本体の`<データ>/setups/courses/`へ置く（LTEで名前だけ送って選ぶための元）、線が違えば`lap.json.bak-<日時>`へ控えてから入れて読み直す。ラップの記録は消さない。車：信号が違えば、本体とPC（`%USERPROFILE%\.ecologger\config-backups\`）へ控え、記録中なら止めて入れて再開する（走行記録のファイルが分かれる）。LTEで送る項目と中継の部屋も合わせる（送り先のサーバーの名前は表示しない。送信のON/OFFは変えない）。車載画面のしきい値は入れない。同じなら何もしない（記録も止めない）。試験7件（作りものの本体で、確かめるだけ・コース・車・部屋・断る場面）。名前を持たせる所：いまは中身を比べて「どの設定と同じか」を出している（PCのアプリ・LTEの返事）ので、当面はそれで足りる）選んだ設定を本体へ入れる道具（既定は確かめるだけ）。本体に「いまの車・コースの名前」を持たせ、状態で返す（P-3）。**本体に入れるのは展示のあと**
  - [ ] SP-4-4 （**2026-11-13：表示まで済み。車の切り替えはまだ**。PCのアプリの「コースと線」の段の上に、いまの車（本体が読んでいる信号が車の設定と同じか。違えば違う所）と、いまのコース（本体の線がどのコースの設定と同じか・設定に無い線・線が無い）を出す。コースは、設定の線をそのまま本体へ入れられる（SP-4-10）。本体は車・コースの名前を持っていないので、中身を比べて出している）PCのアプリ「いまの様子」に、いまの車・コースの表示と「選ぶ」を載せる
  - [ ] SP-4-8 （**2026-11-13：コースを選ぶ・線を入れるの2つを、PCで作って試験まで済み。本体へは未導入（展示のあと）。車を選ぶ命令は作っていない（SP-4-11）**。`course_select {"name": "sugo"}`＝本体の`<データ>/setups/courses/<名前>.json`の線を丸ごと入れる（名前は英小文字・数字だけ。無い名前は断って、入っている名前の一覧を返す）／`line_set {線}`＝送られた線を入れる。どちらも署名・使い回し防止・時刻の確かめは今の命令と同じ道。走っていても断らず、記録は止めない。線が実際に変わるときだけ、変える前の`lap.json`を`lap.json.bak-remote`に1世代控え、入れたあと**本体から読み直した線**（設定の名前・場所・向き・幅・セクターの本数）を返事に入れる。**走っている途中で線を変えたとき**：今までの作り（本体の画面から変えたとき）は、走っていた周をそのまま続けるので、古い線から新しい線までが1周として数えられベストにもなりえた。LTEの2つの命令では、走っていた周を捨て、新しい線を次に通った所から数え直す（`lap.py`の`restart_lap`。周回数・記録済みの周・ベストは残る。捨てた周の分、周回数は1つ少なくなる。本体の画面・USBから変えたときは元の動きのままで、同じ食い違いが残っている）。1通の大きさはSUGOの線まるごとで631バイト、返事453バイト。PC側は`remote_command_pc.py course-select <名前>`・`line-set <名前かファイル>`。試験は本体側35件（もと13）・PC側18件（もと12）。**PCのアプリの画面とスマホの表紙からは、まだ送れない**（4桁の確認の手順＝SP-4-11と一緒に載せる）。本体へ入れるときは、コースの設定のファイルを本体へ置く道具（SP-4-3）が先に要る。実物の本体・LTEでは未確認）LTEで車・コースを選ぶ命令を足す（`remote_command.py`の6つ目。本体に入れてある設定の名前だけを受け、走っている間・記録の途中で信号が変わる場面は断る。署名とやり直し防止は今の命令と同じ）。PCで作って試験まで、本体へ入れるのは展示のあと。**線を入れる命令も足す**（7つ目。2026-11-13：LTEだから断るのではなく、送る前に変わる所を見せて4桁を入れてもらう確認の手順で通す。走っている間も断らない。本体は入れる前の線を控え、返事で読み直した値を返す）
  - [ ] SP-4-9 コントロールラインを見せる・そろえる（T-5）：本体がいまのラインとセクターの位置をピットへ知らせ（LTEで送る値に、変わったときと定期に載せる）、ピットの地図に線を描く。PCのアプリ「いまの様子」にも同じ線を出す。ラインを持つ所を本体の1か所にし、画面の側に写しを持たない。自宅のサーバーに入れる分は了承のあと、本体に入れる分は展示のあと
  - [ ] SP-4-10 （**2026-11-13：PCのアプリに実物を作った（PCで試験まで。本体をつないでは未確認）**。「コースと線」の段。国土地理院の航空写真（出典を表示）の上に、本体の線かPCのコースの設定の線を、本当の幅と向きで重ねる（全体と線ごとの拡大、表）。エディターは見本のJSをそのまま移した（足す・消す、役目、つまむ、北南東西へ1 cm・10 cm・1 m、数字、寄り引き、写真の移動、線に合わせる、車のいまの位置と向きを使う）。入れる道：USB・テザリングは本体の線のAPIへ（入れる前に本体の中で`lap.json.bak-<日時>`へ控え、入れたあと読み直して送った線と比べる）、つながっていなければLTEの`line_set`（下書きがPCの設定と同じ線なら、名前だけ送る`course_select`も選べる）。形のおかしい線は、どの線の何がおかしいかを出して送らない。**両方向で数える仕組みは本体に無い**と確かめたので、「数える向き」の欄は画面から外した（要るなら本体に足す所から）。見本と変えた所：止まっていて直接のときも確認（変わる所）を1回はさむ、幅・向きは数字の欄を正にした（見本は300と打っても黙って200になっていた）。`course_lines.py`・`course_lines.js`、試験27件。作りものの本体でブラウザで操作して確かめた（航空写真の上の図、つまむ・寄り引き・足す・役目、入れて読み直す、走行中の4桁、LTEだけの場面）。未確認：写真が読めないときの方眼、2本指、スマホの幅、実物の本体・LTE。残り：引き直した線をPCのコースの設定として保存する（いまは本体にしか残らない。公開リポジトリなので位置の置き場を決めてから）、スマホの表紙からの線の引き直し、ピットの地図に線を出す（SP-4-9））ラインを引き直す画面（T-5）：場所（線の真ん中の座標）・幅・進む向きを、地図の上で置く／数字で入れる／車のいまの位置と向きを使う、の3通りで決める。図に線（長さ＝幅）と数える向きの矢印を出す。RaceChronoのラインの編集を実物で見てから作る。入れる前のラインは本体に1つ控え、入れたあと本体から読み直して画面に出す。セクターの線も同じ画面で扱う。**表示は航空写真の上に、コントロールラインとセクターの線を全部、本当の幅と向きで重ねる**（全体と、線ごとの拡大）。写真は既存の画面と同じ出どころを使う（ピットの地図はEsri、本体の設定の画面は国土地理院。どちらにそろえるかはここで決め、出典を表示する）。ネットの無い所では写真なしで同じ縮尺の図にする。**エディターの機能（2026-11-13追加、見本にあり）**：線を足す・消す（1本目を引ける）、役目（コントロールライン＝周を数える線／スタート／ゴール／セクターの終わり）、数える向き（一方向／両方向）、つまんで動かす（真ん中＝場所、端＝向きと幅）、北南東西へ1 cm・10 cm・1 mずつ動かす。線のそろい方（コントロールラインが1本。スタートとゴールは、あれば1本ずつ）を入れる前に確かめる。本体はコントロールラインに加えてスタートとゴールの線を別に持つ形（`lap.py`の`control`・`start`・`goal`）。**両方向で数える仕組みが本体にあるかは未確認**で、無ければ本体側に足す（展示のあと）。**写真の寄り引きと移動**（2026-11-13追加、見本にあり）：＋・−（PCはホイールも）で寄り引き、何も無い所をつまむと写真が動く、「線に合わせる」で線の幅に合った寄り方へ戻す。写真の横幅が何mかを出す。写真は18までしか無いので、それより寄るときは引き伸ばす。2本指でつまむ寄り引きも入れた（見本にあり。実物の指では未確認）
  - [ ] SP-4-12 地図の写真の位置の正しさを測る：国土地理院とEsri（ほか使えるもの）の写真に、SUGO 11/8の走った跡（SDの10Hz、62周）を重ね、舗装とのずれを周の平均で見る。使ってよい条件（出典の表示・売るときの扱い）も調べ、どれを使うかを決める。東北は地震のあとの地面の動きで、地図の座標とGNSSの今の位置が1 m前後ずれることがある点も確かめる
    - 2026-11-13 1回目（SUGOだけ）：道具は`tools/dev/imagery_check/imagery_check.py`。決勝の走った跡（60 km/h以上の4.4万点）を国土地理院とEsriの写真（ズーム18、1画素0.47 m）に重ね、跡をずらして「舗装の色の上に乗る割合」が最大になるずらし方を見た。国土地理院は東西に約2 m、Esriは東西に約4〜5 m。ホームストレートを目で見ても、国土地理院は跡が舗装の中に収まり、Esriは北側の芝へ2〜3 mはみ出す。**SUGOでは国土地理院のほうが合っている**。ただし舗装を色で見分ける粗い方法で、南北のずれは数え方で0〜2 mとばらつき、1か所・1日だけの結果。結果の画像と表は`drive_logs/20261108/analysis_sd/imagery/`（位置を含むのでリポジトリの外）
    - 残り：ほかのコースでも見る、使ってよい条件（出典の表示・売るときの扱い）を調べる、地面の動きの分を確かめる
  - [ ] SP-4-13 よく使うコースの線をはじめから入れておけるか調べる（ユーザーの案、2026-11-13）：ほかのアプリや公開の一覧にあるコントロールラインの座標を探し、こちらのSUGOの線との差を見る。公式のRaceCaptureアプリが昔使っていたコースの一覧の取り寄せ先（`podium.live/api/v1/venues`）は、いまは無くなっていた（2026-11-13に確かめた）。ほかの出どころ（RaceChrono・OpenStreetMapなど）と、写して配ってよいかの条件はこれから調べる
    - 2026-11-13 調べた結果：SUGOのコントロールラインの座標が見つかったのは1系統だけ（AiMのRace Studio 3のコースのデータを有志が変換してGitHubに置いたもの、2つのリポジトリで同じ数字）。車用は北緯38.1423573・東経140.7777002で、こちらの線（38.1423181, 140.7779443、向き97.5°）と比べると**進む向きに21.8 m手前、横に1.5 m**。150 km/hで約0.5秒ぶんの位置の差（ラップタイムは変わらず、周の区切りとセクター1・最後のセクターのタイムがその分ずれる）。どちらが公式の計測の線に近いかは未確認
    - 出どころの条件：線の座標を、配ってよいと読める形で公開している所は見つからなかった。OpenStreetMap（ODbL）は配れるがSUGOにはスタート／フィニッシュの印が無くコースの形だけ。AiM由来のデータは国内の主要コースがほぼそろうが、元はAiMの独自のデータで条件は未確認。RaceChronoは規約で写して配ることを禁じている。RaceCapture（Podium）のコースの一覧は、いまは外から取れない。どの出どころも線は中心の1点だけで、幅・向き・セクターは持たない
    - **方針（2026-11-13 ユーザー決定）**：はじめから入れておく線は、自分たちで引いたもの（写真と走った跡で決めたもの）にする。ほかの一覧は照合と場所の目安にとどめ、写して入れない。残り：入れておくコースの順番を決める（走ったことのあるコースから）
  - [ ] SP-4-11 （**2026-11-13：線の分は済み（PCのアプリ）。車の切り替えはまだ**。4桁の確認：LTEで送るときは必ず。USB・テザリングのときは、送る直前に本体から読み直した車速（車の信号の速度とGNSSの速度の大きいほう）が、コースの設定のレーシングスピード以上のとき。車速が分からないときは止まっているものとして扱い、その旨を出す。画面を通さずに送っても、アプリの側が理由つきで断る。**食い違いが1つ残っている**：USB・テザリングで線を変えたとき、いまの本体は走っている周を捨てない（LTEの命令だけが捨てて数え直す）。確認の画面には事実のとおり「この1周だけ、古い線から新しい線までのタイムになります」と出している。本体に触れるときに、本体の線のAPIでも走っている周を捨てるようにし、文を仕様書どおりに戻す）線の変更と車・コースの切り替えの確認の手順（`SPEC.md` 7-5）：どれも断らない。LTEのときと車が動いているとき（線はコースの設定に持つレーシングスピード以上、車・コースは5 km/h以上）は、変わる所を見せて4桁を入れてもらう。コースの切り替えは記録を止めずに行う。車の切り替え（読む信号の入れ替え）は走行記録のファイルが分かれるので、途切れを短くする作り（いまは記録を止めて入れ直している）と、SDカードの控えが止まらないことの確かめをここで行う。PCで作って試験まで、本体へ入れるのは展示のあと
    - 2026-11-14 上の食い違いを本体の側で直した（**PCで試験まで。本体へは未導入（展示のあと）**）：線を変えたら走っている周を捨てる動きを、LTEの命令の中から、線を入れる所そのもの（`EcoCapture-Web/lap.py`の`LapTimer.configure`）へ移した。USB・テザリング（PCのアプリ）・スマホ・本体の設定の画面・LTEのどこから線（コントロールライン・スタート・ゴール・セクター）を動かしても同じになる。周回数・これまでのラップ・レースの時計は残り、規定周回数などレースの決めごとだけを変えたときは走っている周を続ける。本体は`/api/lap`の返事に`line_change_restarts`の印を付け、PCのアプリはそれを見て確認の文を出し分ける（印があれば「走っている周は数えず、次に通った所から数え直します」、無ければ今までどおり「本体のソフトが古く…この1周だけ古い線から新しい線までのタイム」）。試験：本体の側1件・アプリの側は既存の1件を広げた
  - [x] SP-4-5（2026-11-13済み。解析の設定に`"course": "sugo"`・`"vehicle": "ncec"`と書けば、線とトレッドを`tools/setups/`から読む（`setups.fill_analysis`、`race_analysis.py`と`lap_survey.py`）。じかに書いてある今の設定はそのまま動く。今の2つの設定がコース・車の設定と同じ値であることは試験で見張っている。走行データを使った解析の通しの実行はしていない）解析の設定（`tools/race_analysis/*.json`）がコースの設定から同じ値を読むようにする
  - [ ] SP-4-6 エコランの車の設定を用意する（次のエコランの分解を起こすときに`ER-`の持ち越しと合わせる）
  - [ ] SP-4-7 本体の設定をまるごと控えて別の本体へ同じに入れる（S-4）。予備の本体を用意するときに着手

- [ ] SP-5 **走行を見る**（A-1〜A-3）
  - [x] SP-5-1 （**2026-11-13：済み（一覧と周の表）**。周の表：走行の「周を見る」を押すと、周・タイム・ベストとの差・セクター・最高速・警告の印（油温・水温が車の設定のしきい値以上を5秒続けた周。温度の数字は出さない）・動画（あり／一部／なし）が出る（`run_laps.py`。走行記録を全部読むので初めては数十秒、結果は`drive_logs/runs_cache/`に覚える）。試験7件。実物のSUGO決勝の記録は14秒で読め、38周・ベストは31周目の1分50秒095と、前に作った1周の動画の名前と合った。タイムはロガーが数えたもので、公式の計測ではない。以下は一覧の分：アプリに「走行を見る」の段を足した。走った日ごとに、時刻・長さ・コース・周回・動画（あり／一部／なし。一部のときは無い時間帯）と、走行記録・動画のフォルダーを開くボタン。3分より短いものは隠せる。作りものの走行でブラウザで見た。周ごとの表（タイム・ベストとの差・セクター・最高速・警告の印）は、走行記録を全部読む所から作るので次に）回収した走行の一覧（日付・コース・長さ・周の数・動画の有無）をPCのアプリに出す。周の表はタイム・ベストとの差・セクター・最高速・警告の印・動画の有無（油温・水温の数字は出さない。`SPEC.md` 7-5）
  - [ ] SP-5-2 走行を選んでレポートを出す：大会ごとに手で書いている決めごと（決勝の周・スティント・ピット）のうち、自動で出せるものと人が入れるものを分け、人が入れる分は画面で入れられるようにする
    - 2026-11-14 仕分けと、自動で出す分の下書きまで（**PCで試験まで。アプリの画面にはまだ載せていない**）。解析の設定（例`tools/race_analysis/sugo_20261108.json`）の項目を分けた：
      - **もう1か所から読めるもの**：線・トレッド（`"course"`・`"vehicle"`、SP-4-5）。走行記録の場所・走った日・出力の置き場（走行の索引で選べば決まる）
      - **走行記録から案を出せるもの**（`tools/video_collect/report_draft.py`の`draft`）：決勝の周の範囲、ピットに入った周・出た周、スティントの区切り、遅い周の候補、時刻の範囲。ピットの周は「その周のうち5 km/h未満だった秒が10秒以上」で見分ける（周の表に`stop_s`を足した。`run_laps.py`、覚えた表は作り直しになる）。走行の最初の周で止まっていたら、スタート前の待ちとみて決勝から外す
      - **人が入れるもの**：大会の名前、決勝の周の範囲の直し（フォーメーションラップ・チェッカーのあと）、どの走行が予選か、スティントごとのドライバー、遅い周の理由（黄旗・コースアウト・渋滞・ピット前のペースダウン）、覚え書き
    - 実物での確かめ（SUGO 11/8 決勝の記録、読むだけ）：案は 決勝9〜45周・ピット25と38・出た周26と39・スティント[9–25][26–38][39–45]・時刻10:18〜12:34 で、人が書いた設定（9〜45、25・38、26・39、同じスティント、10:20〜12:35）と合った。遅い周の候補は22〜24・35〜37・41・45で、人が書いた出来事の周（22・35・41）と全体に遅い周（23–24・36–37）を全部含み、45周目（最後の周）だけ多い。止まっていた秒は、ピットの2周が約1400秒、ほかの周は最大9秒。1大会だけの結果
    - 2026-11-14 案を見て直して保存する画面を作った（**PCで試験と見本の画面まで。実物の走行では画面を開いていない**）。「走行を見る」の走行の行に「レポートの下書き」のボタン。押すと、走行記録から出した案が欄に入って出る（大会の名前・決勝の周・ピットに入った周・スティントとドライバー・時刻の範囲・予選の走行・遅い周と理由・覚え書き）。スティントは決勝の周とピットの周から決まるので入れさせず、直すとその場で変わる。遅い周は1周ずつ理由を選ぶ（一か所で遅れた／全体に遅い／ピットの前にペースを落とした／遅い周に入れない）。候補に無い周も足せる。保存の前に形を確かめ、おかしい所は全部並べて出して保存しない。保存したものは次に開くと欄に戻り、「走行記録の案に戻す」もできる
      - 保存先は`drive_logs/reports/<走行のid>.json`（人の名前・覚え書きが入るのでリポジトリの外）。項目の名前は解析の設定と同じ（`race_laps`・`stints`・`pit_laps`・`pit_out_laps`・`incident_laps`・`slow_all_laps`・`pre_pit_slow`・`window`・`notes`）にそろえ、ドライバー・遅い周の覚え書き・予選の走行を足してある
      - 部品：`tools/video_collect/report_ops.py`（見せる・確かめて保存する）、`report.js`（画面）、口は`/api/report?id=`と`/api/report_save`。試験5件（アプリ全体141件）。確かめは、作りものの走行2本を置いた見本のアプリで、案が出る → 理由を選ばずに保存すると止める → 周を足す → 決勝の外のピットは断る → 保存 → 開き直すと戻る、を通した
      - （この残りは、下の「解析を流す所まで作った」で済み）
    - 2026-11-14 保存した決めごとで解析を流す所まで作った（**PCで試験まで。アプリのボタンから実物の走行で流すのは未確認**）：
      - 解析（`tools/race_analysis/race_analysis.py`）を、予選の走行（`quali_csv`・`quali_laps`）とLTEの記録（`lte_dir`）が無くても流せるように直した。無いときは、予選の周・予選のベスト・LTEの届き方の項目が出ないだけ。直す前後で、元の設定（`sugo_20261108.json`）の出力11個がバイト単位で同じことを確かめた
      - アプリ：下書きの下に「保存した決めごとで解析を流す」。裏で流し、進み具合と結果（表の数・置き場を開く）を出す。流せない理由（保存していない・コースが分からない走行・部品が無い）は、流す前に出す。途中で止まったら、解析が出した最後の文を出す。設定は`drive_logs/reports/<走行のid>.analysis.json`、出力は`drive_logs/reports/<走行のid>/`。線とトレッドは車・コースの設定から読む（`"course"`・`"vehicle"`）。人の名前は解析の設定へ写さない
      - 遅い周の「ピットの前にペースを落とした」は、理由とは別の印（チェック）に直した。人が書いたSUGOの設定で、同じ周（22〜24・35〜37）が理由とピット前の両方に入っていたため
      - 実物での確かめ（SUGO 11/8 決勝。作業用フォルダーの中で、部品を直接呼んで）：下書き → 理由を選んで保存 → 解析、が通り、表11個・数字178個が19秒でできた（走行記録を読んだ控えがあるとき。初めては走行記録を読むぶん長い）。予選なし・LTEなしで人の設定を流した結果と比べ、違ったのはピット前のペースダウンの6個だけ（そのときは印を付けずに流したため）。ベスト（31周目 1:50.095）・周の数は同じ
      - 残り：できるのは表（CSV）まで。グラフ付きのレポートのページ（`report_page.html`）はClaudeのダッシュボードで、PCのアプリの中では開けない（アプリの中で見られる形にするか、チームへ渡す形＝SP-5-4と合わせて決める）。解析はNCEC・SUGOの記録で作ったもので、信号やセクターの数（4つ決め打ち）が違う車・コースでは途中で止まる見込み
    - 2026-11-14 解析の結果を、アプリの中で数字とグラフで見られるようにした（**PCで試験と見本の画面まで**）：下書きの下の「結果を見る」（解析ができた直後の結果にも同じボタン）。出すのは、主な数字（決勝のベスト・予選のベスト・セクターのベストの和・走った周・油温の最高）、周ごとのタイムの図（種類で色分け。枠より遅い周は上に三角とタイム）、周の一覧（セクターのベストは緑）、油温と水温、コースと速度（ベストの周。色が速度、コーナーの名前）、ベストの周との差と速度（道のりごと）、解析が出した数字すべての一覧（言葉で絞り込める）
      - 大会ごとの文章つきのページ（`tools/race_analysis/report_page.html`）は、文がSUGO 11/8 の出来事で書いてあり（22・35・41周目、スティント3つ、C7など）、ほかの走行には使えないので、アプリには載せなかった。アプリの画面は数字とグラフだけで、読み解きの文は無い
      - 外のライブラリは使わず、グラフは自前のSVG（`tools/video_collect/analysis_view.js`）。ネットにつながっていなくても見られる。表は`/api/report_data?id=`で読む（`report_ops.results`。画面が出す6つの表だけ送る）。表の形が違って出せない部分は、その部分だけ「出せませんでした」と出す
      - 確かめ：SUGO 11/8 の解析結果の写しを見本のアプリに置き、全部の図と表が出ること、数字の絞り込みが効くことを画面で見た。試験2件追加（アプリ全体147件）。実物のアプリ（実物の`drive_logs`）では開いていない
      - 残り：油圧・G-G・タイヤの滑り・ロガーの採点の図は載せていない（数字は一覧に出る）。チームへ渡す形（SP-5-4）は未定
    - 残り：アプリの「走行を見る」に、案を見て直す画面と、解析（`race_analysis.py`。pandas・scipyが要る）を流すボタンを載せる。遅い周を「一か所だけ遅い／全体に遅い」に分けるのは、位置を使う`lap_survey.py`の仕事で、下書きには入れていない。レポートのページを誰がどこで開くか（SP-5-4）は未定
  - [x] SP-5-3 （**2026-11-13：済み（見る・残す・公開用）**。残す：動画の下の「この周の動画を残す」で、`drive_logs/v2_video/laps/`へ`<走った日>_<周>周目_<タイム>.mp4`の名前で置く（`lap_video.py clip`と同じ名前）。「公開用も作る」で、風切りを下げた音の`_公開用.mp4`も作る（走行記録の回転数を読むので3〜4分。裏で作り、進み具合と結果を出す。numpy・scipyが要る）。実物の31周目で、残す（アプリの画面から）と公開用（部品を直接呼んで198秒）を確かめた。出来たものは作業用のフォルダーへ出し、実物の置き場には書かせていない。残り：見るための写し（`runs_cache/clips/`、1周約150 MB）がたまったときの片付け。以下は「見る」の分：先に確かめたこと：録画の`.ts`（映像H.264・音MP2）はブラウザではそのまま再生できない。そこで、周の表の「見る」を押すと、その周のぶん（始まりの3秒前〜終わりの2秒後）だけを録画から抜き出し、映像は作り直さず音だけAACに直したMP4を作って、アプリの中で再生する（`tools/video_collect/lap_clip.py`。切り出しの部品は`tools/lap_video/lap_video.py`のものを使う。置き場は`drive_logs/runs_cache/clips/`＝見るための一時の写しで、消してよい。元の録画は変えない）。動画が周の一部しか無いときは、ある所だけを出して知らせる。無い周は理由を出す。ffmpegが無いときはその旨を出す。早送り・巻き戻しに応える出口（`/media/`、Range）も作った。試験7件（動画なし・一部・作りかけを残さない・ffmpegなし・流す出口が周の動画以外を出さない）。**実物で確かめた**：SUGO決勝の31周目（ベスト）が約8秒で用意でき（147 MB、1920×1080）、アプリの画面で再生された。確かめは、作業用のフォルダーに同じファイルを指す入口を作って行い、実物の保存先には何も書かせていない。残り：切り出して残す（名前・置き場`v2_video/laps/`）と公開用（風切り下げ）をアプリから呼ぶ、見るための写しがたまったときの片付け）周を選んで、その周の動画をその場で見る・1周だけ切り出す（A-2）。見るだけのときは切り出さず、その周の頭から再生する。録画の`.ts`（映像H.264・音MP2）をブラウザでそのまま再生できるかを最初に確かめ、だめならPCのアプリが再生用に変えて流す。動画が途中で無い周は、周の表に「あり／一部／なし」を出し、無い区間と理由（録画していない・まだ回収していない・本体で入れ替わって消えた）を出す
    - 2026-11-14 見るための写しの片付けを足した：`lap_clip.prune`。写しを作るたびに合計を見て、5 GB（約30周ぶん。置いた値）を超えていたら、長く見ていないものから消す（もう一度見ると「見た時刻」が新しくなる）。いま作ったもの・作っている途中のものは消さない。残した動画（`v2_video/laps/`）と元の録画には触れない。試験1件追加
  - [ ] SP-5-5 （**2026-11-13：調査まで済み**。`docs/research/analysis_export_formats_20261113.md`。`.ld`は仕様が非公開だが有志の実装があり自前で書けそう（ラップは隣の`.ldx`、GPSは64ビットで書く所を自前で足す）。i2のCSV取り込みは有料。`.vbo`は仕様が公式に公開のテキストで、無料のCircuit Toolsほか開けるソフトが多い。案は「先に`.vbo`、次に`.ld`」。i2の使用条件（自作ロガーのデータを見てよいか）は未確認。実際にソフトで開く確かめはしていない。**形式と順番はユーザーが決める**（資料の8章））解析ソフトへの書き出し（A-5）：先に調べる（MoTeC i2 が読む`.ld`を自前で書けるか・i2のどの版で開けるか、ほかに`.vbo`など開けるソフトの多い形式）。調べた結果をユーザーに見せて形式を決めてから作る
    - 2026-11-14 調べ直しと試しの結果（**形式の案は取り下げ。解析はSP-10の自前のアプリへ**）：MoTeC i2は、MoTeCの機器か許諾された第三者ソフトのデータでしか使えない（自作の`.ld`は使用条件に触れる。正規の道は有料）。RacelogicのCircuit Tools 3（無料）をこのPCに入れ、動画の位置を埋めた`.vbo`とMP4を作って開いた：1周なら動画が合う（焼き込みの数字と3か所で一致、急ブレーキの所で0.05秒以内）が、**2周目を比べに足すと「not a genuine Racelogic VBOX file」で止まり、アプリが閉じる**。比べはRacelogicの機器のファイルだけ。そのほかの癖：行を20Hzにすると距離を約1.5倍に数える（10Hzなら正しい）。最大速度で切るセクターの区切りが壊れることがある。試しのファイルは`drive_logs/ct_test_20261108/`。ほかの候補の比べは調査の報告（リポジトリ未収録の下書き）
    - 書き出しで分かったこと（SP-10-2へ引き継ぐ）：測位の点は、記録に届いた時刻（`host_utc`）でなく測位そのものの時刻（`gnss_itow_ms`からUTCへ直す）に置き、点のあいだを補うと、コース図の線がなめらかになる。届く時刻は測位の時刻に対して±50ms揺れる
    - 2026-11-14 夜の追試（2つ上の「調べ直しと試しの結果」の行を直す）：Circuit Tools 3は`.vbo`の衛星数が32の行を使わない。31までに抑えて書くと、自作の`.vbo`でもDelta-T・セクター・コース図が正しく出る（32のままだと同じ周どうしのDelta-Tがノコギリ形、セクターが数秒ずれ、コーナーが直線になる。「セクターの区切りが壊れる」はこれ）。止まってアプリが閉じるのは2周目以降の**動画**を開くときだけで、動画の無い`.vbo`なら3周を重ねて比べられる。RaceChrono Pro 10.3.0の書き出し（`[laptiming]`の線は「経度・緯度」の順）にも32が出て、同じ崩れが少し出る。結論は`ARCHITECTURE.md` 4章の2026-11-14の行
  - [ ] SP-5-4 レポートと動画をチームへ渡す形を決める（位置を含むので公開リポジトリには入れない）

- [ ] SP-6 **スマホの入口**（自宅のサーバーのページ。作るのはPC、入れるのは了承のあと）
  - [ ] SP-6-1 入口のページを1つにまとめる案：値・地図・周回表への行き先と、「ロガーを待っています／最後に届いてから○秒」（T-1・T-2）。いまは入口が無く（ブリッジの`/`は404）、Grafanaの上の帯のリンクだけ　→ 2026-11-13：見本を作って見せた（`docs/design/ecologger_phone_mock.html`。Claudeのページにも載せてある）。上から、つながり（待っています／届いています／○秒前のまま）→ この周・周回・前の周・ベスト・速度・油温・水温 → ロガーの様子の印 → 地図・周回表・G-G・グラフへの行き先 → 操作（合言葉を入れた人だけ）。値が届かなくなると数字が薄くなる。操作はラップを0周に戻す・状態を聞く・周回数を直す・計測を始める・記録を始める・車とコースを選ぶ。車が動いているときと、車・コースの切り替えは4桁の確認つき。**線の引き直しもスマホに載せた**（ユーザー決定。指でつまむ、北南東西へ1 cm・10 cm・1 m、向き±0.5°・±5°、幅±1・±5 m、足す・消す・役目・両方向。送る前に変わる所と4桁の確認）。**合言葉の画面も作り込んだ**（QRを読む／手で入れる、見せる・隠す、短すぎ・違う・確かめられないときの出し方、確かめてから覚える、消す。`SPEC.md` 7-5）。PCのアプリの見本には「スマホへ合言葉を渡す（QR）」「合言葉を作り直す」を足した。感想待ち。**棲み分け（`SPEC.md` 7-6）**：表紙は「いま」と操作と入口、周回表は周ごとの記録、グラフ（Grafana）は時間の流れと大きい画面用。いまのGrafanaの画面が周回表と地図を埋め込んでいる形は、大きい画面用としてそのまま残す。表紙を作るときに、周回表の上の段（今の周・油温など）と重なる所を表紙へ寄せるかを決める
    - **2026-11-13 実物を作った（PCの中で確かめるところまで。自宅のサーバーには入れていない）**：`tools/home_telemetry/home.html`（表紙）、`live_bridge.py`に表紙用の出口（`/ws?kind=home`＝時計の値から周の通過を除き、速度と衛星の数を足したもの。ページは`/home`と`/`）。つながり（待っています／届いています／○秒前のまま）、この周・周回・レース経過・前の周・ベスト・速度・油温・水温、ロガーの様子の印、地図・周回表・G-Gへの行き先。値が10秒届かないと数字を薄くして時計を止める。試験4件を足し、ブリッジの試験は18件とも通った
    - PCの中で確かめる道具：`tools/home_telemetry/dev_home.py`（作りものの車がサーバーと同じ形のファイルを書き、作りものの中継が本体と同じ確かめ方`RemoteCommands`で命令に返事をする。場面はフォルダーに`pause`・`stop`・`hot`・`deaf`を置いて変える）。ブラウザで、値の表示・油温の警告の色・止まっているとき・値が届かないとき・返事が来ないとき（30秒）を確かめた
    - **2026-11-13 16:27 自宅のサーバーへ入れた（ユーザー了承「サーバーへ入れて」）**：入れる前に、サーバーの`live_bridge.py`がリポジトリの前の版と同じであること（食い違い無し）を確かめ、今のページに触れない別の口（:3012）で新しい版を試した。前の版は`~/home_telemetry/live_bridge.py.20261113-before-home`に控え、`live_bridge.py`と`home.html`を置いて`ecorun-vm-bridge`を立ち上げ直した。地図・周回表・時計・G-Gは変わらず200で、時計と周回表の値もこれまでどおり届く。公開のアドレスで`/live/home?room=<ルーム>`（`/live/`でも同じ）を開き、学園祭デモの部屋の値で表紙が動くことを見た。中継の行き先は同じホストの`/ws/audio/<ルーム>`で合っている。公開の道（tailscale serve）には触っていない
    - 残り：**本物のロガーとLTEで、合言葉と命令を試す**（ロガーが動いているときに、ユーザーのスマホで）。周回表の上の段との重なりの整理
    - **2026-11-13 ラップを0周に戻したあとも「前の周」が残る件を直した（PCで試験まで。同日21:44に自宅のサーバーへ入れた。SP-6-2の記録を参照）**：ブリッジが、ロガーのリセットのあとの行（周回数が0で、その前が1周以上、ラップタイム・ベスト・レース経過がどれも無い）を見たら、前の周・ベスト・通過の記録・スタートの時刻を捨てる（本体の`lap.py`のリセットがベストも消すのに合わせた）。行の欠け・再起動で値が無い間・周回数を手で直したとき・1周目の前では消さないことを試験で押さえた（6件）。スマホのアプリ（エコラン）がリセットのあとに送る行の形は未確認
  - [ ] SP-6-2 （**2026-11-13：PCで作って試験まで済み**。**2026-11-13 21:44 自宅のサーバーへ入れた（ユーザー了承「サーバーへ入れて」）**：入れる前に、サーバーの4つのファイル（`live_bridge.py`・`map.html`・`gg.html`・`laps.html`）がリポジトリの前の版と同じ中身であることを確かめ（`laps.html`は改行の形だけ違った）、値の保存先へ書かせない形で別の口（:3012）で試した。前の版は`~/home_telemetry/*.20261113-before-feed`。ブリッジを立ち上げ直し、表紙・周回表・地図・G-G・時計は200。公開のアドレスで、デモの部屋の地図・G-G・周回表は今までどおり動き、値の無いNCECの部屋の地図に「ロガーを待っています」が出るのを見た。公開の道には触っていない。**本物のロガーが止まったとき・リセットしたときの見え方は未確認**。中身：ブリッジが地図とG-Gへ、1秒ごとに「最新の値が届いた時刻」と「いまの時刻」を配る（`feed`）。地図・G-Gは10秒届かないと「値が届いていません（○秒前のまま）」の札を出して車の印・点を薄くし、届き直すと自分で戻る。1回も届いていないときは「ロガーを待っています」。周回表の上の段の温度は、値がまったく届かないと古い値が「いまの値」のように残ることを確かめ、ページの側で薄くして「（○秒前の値）」と付け、古い値での赤い枠と警告音を止めるようにした。試験4件、ブラウザで地図・G-Gの札を見た。入れるときはブリッジの立ち上げ直しが要る（ページは置くだけ。順番はどちらが先でも壊れない）。グラフ（Grafana）の側は手を付けていない）値が届かなくなったときの見え方を、地図・G-G・グラフにも入れる（T-2）。周回表と時計にはもうある（10秒）。地図とG-Gへは、ブリッジが「最後に届いた時刻」を配っていないので配る所から。周回表の温度が全く届かないと残る件も確かめて直す
  - [ ] SP-6-3 ページからLTEの命令を送る（T-3）：合言葉を入れた人だけ、命令は今の5つ。いまは合言葉がPCと本体にだけあり、中継は中身を見ずに渡すだけ。ブラウザで署名する形（合言葉はそのスマホの中にだけ持つ）にできるかをこの項目で決める。サーバーには置かない。**2026-11-13追加**：合言葉の入れ方・確かめ方・消し方は`SPEC.md` 7-5のとおり（見本あり）。PCからスマホへ渡すQRの中身と期限、合言葉を作り直す手順（本体・PC・渡したスマホの入れ直し）をここで決める。線の引き直し・車とコースの切り替えもスマホから送る
    - **2026-11-13 今ある5つの命令まで作った（`home.html`の中。PCの中で確かめた）**：合言葉を入れる→ロガーに「状態を聞く」を送って確かめてから機器に覚える（違う合言葉は「合言葉が違います」、形が違うものは送る前に断る、返事が無ければ確かめずに覚えることを選べる）、消す。命令は状態を聞く・ラップを0周に戻す・周回数を直す・いまから計測を始める・記録を始める。署名はブラウザの中で作り（本体の`remote_command.py`と同じHMAC-SHA256）、作りものの中継の側で本体と同じコードが確かめて通った。車が5 km/h以上で走っているときは4桁の確認を足す。返事はPCの道具と同じ言い回しで出し、返事が来なければ「届いたか分かりません」。合言葉はURLの`#k=`でも渡せる（サーバーへは送られない。読んだら消す）
    - **2026-11-13 PCからスマホへ合言葉を渡すQRを作った**（`tools/remote_command/phone_key.py`・`Phone-Key.cmd`、操作メニューの「設定・調べもの」→「スマホへ合言葉を渡す（QR）」）。決めたこと：QRの中身は「表紙のアドレス＋`#k=<合言葉>`」（`#`のあとはサーバーへ送られない。表紙が読んですぐアドレスから消し、確かめてから覚える）。表紙のアドレスはPCが覚えている中継のURLから作る（違う場所は`remote_command.json`の`home_url`）。**期限は無い**（合言葉そのものなので付けられない）ので、窓は2分で閉じ、合言葉・アドレスは文字で出さない。**作り直す手順**：本体をつないで`remote_command_pc.py setup --new`（PCと本体が入れ替わる）→ 渡したスマホはQRを読み直す（表紙は、前に覚えたものと違う合言葉が来たら確かめてから入れ替え、合わなければ前のものを消さない）。QRは自前の`qr.py`で描く（合言葉を外の部品・サービスへ渡さない、PCへ入れるものを増やさない）。確かめ：`qr.py`の絵は別の作り手（qrcode）と全マスクで同じ、読み手（pyzbar）で読み戻せた（試験9件）。表紙の受け取りは、PCの中の作りものの車・中継を相手にブラウザで5通り（初めて・同じ・違って合わない・開き直し・違って合う）。**まだ：実物のスマホのカメラで読むこと、本物のロガーとLTE。**。表紙の「違う合言葉への入れ替え」は同日に自宅のサーバーへ入れた（ユーザー了承。`home.html`だけ、前の版は`~/home_telemetry/home.html.20261113-before-qr`。ブリッジはページを開くたびに読むので止めていない。公開のアドレスで新しい版が出ることを見た）
    - 残り：（QRをPCの新しいアプリへ載せるのは、SP-3-4で済んだ。）車とコースを選ぶ・線を入れる（本体に命令を足してから。表紙には押すと理由が出るボタンを置いてある）。httpsでないと署名の仕組みが使えないので、公開のURL（https）で開く
    - 2026-11-14 表紙からコースを選べるようにした（**PCで作って試験まで。自宅のサーバー・本体へは未導入**）：「ほかの操作」の「コースを選ぶ…」を押すと、LTEでロガーに入っているコースの一覧といまの線を聞き（新しい命令`course_list`。何も変えない）、選ぶと確かめの画面（変わること・走っている周は数えないこと・控えること）が出て、**走っていなくても4桁を入れてから**送る（`SPEC.md` 7-5）。返事には、ロガーから読み直した線（コースの名前・セクターの本数・線の番号）を出す。いまの線と同じコースは押せない。ロガーにコースの設定が無いとき・ロガーのソフトが古いとき（`unknown op`）は、その理由を読める言葉で出す。「線を引き直す・足す」は、スマホでは地図の画面が要るのでPCのアプリへ案内する文に直した（車を選ぶ命令はまだ無いので、ボタンの名前から「車」を外した）
    - 同じ日に見つけて直した食い違い：線を変えて走っている周を捨てると、ロガーは「レース経過だけ進み、いまの周の時計は無い」値を送る。ブリッジ（`live_bridge.py`）はこれを「ゴールした」と読んでいた（表紙に「ゴールしました」と出て、レース経過が止まる）。レース経過が止まっているとき（同じ値が続く）だけをゴールとし、進んでいるときは「次に線を通った所から数え始めます」と出すようにした。本物のゴールは1行ぶん（1秒以内）遅れて「ゴール」になる。試験1件（ブリッジ全体29件、もてぎの実記録の再生も通る）
    - 確かめ：`dev_home.py`を、本体と同じ線の部品（`lap.py`）で作りもののコース2つを切り替えられるようにし、ブラウザ（スマホの幅）で、一覧 → 選ぶ → 4桁（違う数字は断る）→ 届く → 読み直した線 → もう一度聞くと「いまの線」、を通した。本物のLTE・実物のスマホでは未確認
    - 入れる順番：表紙とブリッジは自宅のサーバーへ（了承のあと）、`course_list`は本体へ（展示のあと）。表紙だけ先に入れても、本体が古い間は「ロガーのソフトがまだ対応していません」と出るだけで害は無い
  - [x] SP-6-4（2026-11-13済み。`docs/manual/pit_cover_phone.md`：開く・ホーム画面に置く（Android・iPhone）・合言葉をQRで入れる・操作を送る・うまくいかないとき。アドレスは書いていない。実物のスマホでは未確認。iPhoneでホーム画面のアイコンから開くと、Safariで覚えた合言葉が見えないことがありうる点を注意に書いた）スマホのホーム画面に置く手順を手順書へ入れる

- [ ] SP-7 **車載画面と本体**（PCで作って試験まで。本体に入れるのは展示のあと）
  - [ ] SP-7-1 （**2026-11-13：印を足す所はPCで作って試験まで済み。本体へは未導入（展示のあと）。しきい値を1か所から読む所はまだ**。`dash_model.send_light`：送信中で最後に送ってから5秒以内＝緑「送信中」／送信ONだが送れていない（つなぎ中・測位待ち・5秒より古い）＝黄「未送信」／送信OFF＝灰「送信OFF」／読めない＝灰「送信 --」。赤にはせず音も出さない（記録は本体に残るため）。5秒は設定`send_stale_s`で変えられる。印は「記録・GNSS・送信・油温油圧」の4つ。試験4件を足し33件、WSLで全部の状態を描いて見た。**下の段は印が4つになり、不具合が3つ重なると右端の文字が省略される**（経過・時刻は欠けない）。本体の画面・本物のLTEの切れ方では未確認。しきい値のずれの調べ：120℃／110℃の線はどこも同じだが、注意（110／100）とピットイン（130／120）の段はピットの側にしか無く、数字が6か所（DASH・スマホ・周回表・表紙・Grafana・動画の計器）に別々に書いてある）DASHに「送信」の印を足す（M-2）。記録・GNSSの印はもうあるので、足すのはLTEだけ（本体のAPIの`podium.state`・`last_sent_age_ms`を読む）。`dash_model.py`の試験とPCの見本で確かめる。あわせて、DASHとピットのページで油温・水温のしきい値がずれているのを、車の設定（SP-4-1）の1か所から読む形にそろえる
    - 2026-11-14 しきい値を突き合わせる試験を足した（`tools/setups/test_thresholds.py`、4件）：車の設定（`vehicles/ncec.json`の油温120℃・水温110℃）と、数字を別々に持っている6か所（車載画面`dash_model.py`・スマホ`Circuit.kt`・周回表`laps.html`・表紙`home.html`・Grafana`build_sugo_dashboard.py`・動画の計器`hud_default.ini`）が同じか、ピットの側の注意・ピットインの段が警告の10℃下・10℃上かを見る。いまは全部そろっている。**1か所から読む形にはまだしていない**（本体・スマホ・サーバーと動く場所が別々で、同じファイルを読みに行けないため）。当面は「車の設定を変えたらこの試験が落ち、落ちた所をそろえる」で食い違いを防ぐ
  - [ ] SP-7-2 （**2026-11-13：PCで作って試験まで済み。本体・スマホへは未導入。画面の見た目は一度も見ていない**。本体がスマホへ出す値（`field.py`の`live_frame`）に`send`を1語足した（`ok`・`warn`・`off`・分からないときは無し。1通が約15バイト増える。決め方としきい値5秒は車載画面DASHと同じで、同じ結果になることを試験で総当たりして見張っている）。スマホは、上の札の段のすぐ下に細い1段「ロガー本体：記録中／測位OK／送信中」を出す（スマホ自身の札と読み違えないよう、頭に「ロガー本体」と書き、塗りではなく枠だけの箱にした）。つないでいない・値が2秒届かない・本体が古い、のときは「--」にして、良いとは見せない。記録停止・測位なしは赤、未送信は黄、送信OFFは灰。ロガーの設定が無いスマホには段を出さない。本体とスマホはどちらを先に入れても壊れない。試験：本体側3件を足し10件、スマホの単体試験6件を足し82件。**代償：下の数字の場所が画面の高さの約7%ぶん減る。走行中に読めるかは実機で見る**。「記録を始める」を押すまではロガーにつながないので、それまでは「--」のまま（つなぐ前から見せるのはSP-7-6））スマホのアプリのエコランの画面に、ロガーの「記録・測位・送信」の印を出す。記録（`rec`）はもう届いているが使っていない。送信は本体がスマホへ出す値（`field.py`の`live_frame`）に項目を足す所から（本体に入れるのは展示のあと）。スマホ自身の「記録」「送信」の札と読み違えない見せ方にする
  - [ ] SP-7-5 エコランの画面に温度の警告と音を出すかを決める（いまはサーキットの画面にしか無い）。次のエコランの分解を起こすときにユーザーへ聞く
  - [ ] SP-7-6 （**2026-11-13：設定の書き出し・読み込みと、説明の古い所は済み（PCで試験まで。実機では未確認）。「記録を始める」を押す前からつなぐ所はまだ（決めることがある）**。設定の画面に「設定を別のスマホへ写す」の段（書き出す＝共有・コピー／読み込む＝貼り付け・QR）。入れるもの：使い方・車の名前・サーバーのURL（主・予備）・ロガーへのつなぎ方・クラスと余裕・規定周回など・最短ラップ・警告のしきい値と音量・画面のスイッチ。入れないもの：線（専用のQRがある）、スマホごとの校正、周回の記録。**秘密（ロガーのWi-Fiのパスワード・コースウォークの合言葉）は既定では入れない**（選んだときだけ入れ、注意を出す）。読み込む前に「何が変わるか」の一覧を見せ、押すまで何も書かない。記録中は読み込めない。形は`ELCFG1|キー=値|…|id=`（線のQRと同じ流儀。終わりの`id`で切れ・書き換わりを断る）、300文字ほどでQRに入る。**アプリはQRを読めるが、描けない**（描く部品が無く、ライブラリを足していない）ので、書き出しは文字列の共有・コピー。PCでQRにするなら`tools/remote_command/qr.py`が使える。試験19件を足し、スマホの単体試験は101件。説明（README）：警報音の長さ（1.5秒を6回、約10秒）・油圧の警告を、コードと突き合わせて直した。**決めること**：サーバーのURL（部屋の名前入り）を秘密の側へ移すか／押す前からつなぐとき、Wi-Fiへ直接つなぐ方式ではOSの確認のダイアログが繰り返し出うるのを許すか・記録の前は読むだけにするか）スマホのアプリの入れ方と設定を楽にする：合言葉・Wi-Fiの設定をQRで読む、設定の書き出し・読み込み、「記録を始める」を押す前からロガーにつなぐ。READMEの古い所（警報音の長さ・油圧の警告）も直す
  - [ ] SP-7-3 公式のRaceCaptureアプリと切り替えの仕組み、RCPに変える部品を本体から外す。先に控えを取り、戻し方を書いてから。**RCPは残さない**（2026-11-13 ユーザー決定）
  - [ ] SP-7-4 つなぐ順番の間違い（M-3）：ドックを後からつないだときに直せるか調べる。直せなければ、車載画面かPCのアプリに直し方を出す
  - [ ] SP-7-7 スマホ（測位1Hz）の周のタイムを正しくする（2026-11-14 ユーザー了承）：スマホのアプリ（`android-logger`の`LapTimer.kt`）もロガーと同じく線の手前と先の2点で線を越えた瞬間を補っている。1Hzでは補う計算の誤差は約10ms（150km/hで0.3Gの加速中）と小さいが、スマホの位置の誤差（進む向きに数m）がエコランの30km/hでは0.25〜0.6秒になる。手当ての案：線の前後数秒の測位をまとめて直線に当てはめてから線の位置を出す、止まった所からのスタートは線を補わず動き出した瞬間（加速度センサー）を使う。まず手元の記録で、いまの数え方と案のずれを測ってから決める

- [ ] SP-8 **資料**
  - [x] SP-8-1（2026-11-13済み。`docs/manual/day_manual_template.html`。SUGO版の章立てを下敷きに、新しい入口（PCのEcoLoggerアプリ・ピットの表紙）と今の動き（録画はドラレコ式、回収の結果の読み方）に合わせた。大会ごとに書き換えるのは【 】の所だけ。次の大会の手順書をここから作って、足りない所を直す）当日手順書のひな形を1つ作る（大会ごとに変えるのは時刻・しきい値・コースだけ）。SUGO版・エコラン版から共通の所を抜く（P-5）
  - [x] SP-8-2（2026-11-13済み。冒頭に「まず見る所」＝PCのEcoLoggerアプリの「いまの様子」とスマホのピットの表紙、を足し、回収で取れないときの行を、アプリの結果の「取れなかったもの・次にすること」に合わせた。本体の中へ入って調べる手順はそのまま）困ったときの表を、新しい入口の名前に合わせる（`docs/manual/ecologger_troubleshooting.html`）
  - [x] SP-8-3（2026-11-13済み。ソフトの一覧にPCのEcoLoggerアプリとピットの表紙を足し、公式アプリは「外す予定」と書き、つなぐ3つの道に「PCの側が自分で探す・スマホの操作は表紙からLTE」を足した。図（SVG）は変えていない。公式アプリを本体から外したら、もう一度直す）構成図`v2_hardware_overview.html`の「つなぐ3つの道」「ソフトの一覧」を新しい入口に合わせる

- [ ] SP-9 **RaceCaptureから離れる**（2026-11-13 ユーザー決定。`SPEC.md` 9-1の9）
  - [x] SP-9-1（2026-11-13済み。`docs/design/lineage_racecapture.md` 1章）系譜の記録を1本書く：RaceCaptureの何を使って始め（純正アプリ・RCP・Podium・公式ファームを参考にしたVer.1）、いつ何を自前に置き換えたか。`ARCHITECTURE.md` 1〜3章はその記録として残す
  - [x] SP-9-2（2026-11-13済み。同じ資料の2章。**Ver.2のソフトの中に、公式ファーム・公式アプリ・Ver.1のファームからの写しは見つからなかった**（行の突き合わせで、公式ファームと一致0行、公式アプリと1行＝決まり文句、Ver.1と35行＝一般的な書き方）。残っているつながりは、通信の形を合わせた部分と公式アプリを動かす部品で、どちらもSP-9-4〜9-6で外す所。写しがあったのはVer.1の側（公式ファームのフォルダーから持ってきたLua 56本。Lua自体はMIT）と確かめの記録（`outputs/`の公式アプリの設定ファイルの控え）。法的な結論は書いていない）Ver.2のソフト（`EcoCapture-Web/`・`RaceCapture-UNOQ/`のDASH・`firmware/ecologger_v2/`・`tools/`・`android-logger/`）に、公式ファーム（GPL v3）やVer.1のファームから持ってきたコードが無いかを突き合わせる。結果を系譜の記録に書く
  - [ ] SP-9-3 （2026-11-13：案と根拠は`docs/design/lineage_racecapture.md` 3章に書いた。案A＝同じリポジトリに置きフォルダーごとに扱いを書く／案B＝Ver.1と`reference/`を別のリポジトリへ分ける。**決めるのはユーザー**）Ver.1のファーム（`firmware/`、コメントに公式ファームの参照が多い）と`reference/`のサブモジュールの扱いを決める：GPL v3として置く／別のリポジトリへ分ける。あわせて、このリポジトリにライセンスのファイルを置く（いまは無い）。**決めるのはユーザー**。案と根拠を出す
  - [ ] SP-9-4 （**2026-11-13：PCで作って試験まで済み。本体・スマホへは未導入（本体は展示のあと）**。外したもの：本体のソフト（`podium.py`）の直接の道（送り先の初期値`telemetry.podium.live`・送信キー・公式アプリを名乗る値・認証・「中継がだめなら直接へ」）、設定の画面のその欄、スマホのアプリの`PodiumDirect`と設定の欄。残したもの：中継サーバーへ送る道（行の形・チャンネルの名前・中継とのやり取りは変えていない）、LTEのモデム、音声、ピットからの命令。**古い設定ファイルの読み方**（試験6件）：中継の設定だったファイルは、直接の項目が入っていてもそのまま読めて送信が続く。直接へ送る設定だったファイルは、落ちずに読めて送信OFFになり、理由が状態の文言に出る（黙って公式へも中継へも送らない）。保存し直すと直接の項目とキーがファイルから消える。前の版のソフトでも、新しい版が保存したファイルを読める。試験：`test_podium` 55件（失敗1件は変更前からで、Windowsでファイルの権限が付かないため）、本体のほかの試験106件、スマホの単体試験76件（`gradlew testDebugUnitTest`）。**入れる前に、本体の設定の送り先が中継（`destination: server`）であることを見る**。スマホは更新後、サーバーが答えないときの保険（直接へ）が無くなり、保存してあったPodiumのキーは初回起動で消える（**2026-11-13 ユーザー了承：自動で消す作りのままでよい**）。残り：`RaceCapture-UNOQ/ecocapture_native.cpp`（公式アプリの頃の本体の設定画面。SP-7-3で外す側）にキーの欄が残る、直下の`podium_test_sender.py`（Ver.1の頃の道具）、資料の古くなった所（`EcoCapture-Web/LTE_PODIUM.md`・`EcoCapture-Web/README.md`・`android-logger/README.md`・`docs/design/lineage_racecapture.md`の行番号）は、本体へ入れるときに合わせて直す。設定の画面はブラウザで開いて見ていない）公式のPodiumへ直接送る道を外す：`EcoCapture-Web/podium.py`の直接の道と送り先の初期値（`telemetry.podium.live`）、設定の画面、スマホのアプリの`PodiumDirect`。PCで作って試験まで。本体へ入れるのは展示のあと
  - [ ] SP-9-5 ロガーから自宅のサーバーへ送る値の形（いまはPodiumの行の形）を自前の形にするかを決める。受け側はチームの`ecorun-logger-server`なので、Maruo.Sさんへの相談が要る。先に、自宅のサーバーが受けた値を公式のPodiumへ転送する設定になっていないかを確かめる（読むだけ）
  - [ ] SP-9-6 公式アプリとRCPを本体から外す＝SP-7-3（RCPは残さないと決まった。止める・取り除くものは`docs/design/unoq_software_inventory.md` 4章の6つ）
  - [ ] SP-9-7 名前を外す（リポジトリの中）：`RaceCapture-UNOQ/`のフォルダー名、`racecapture-display`などのサービス名、`rcp_mock_device.py`など直下のVer.1の道具、資料の題。本体のサービス名は本体に触れるときに合わせる。4章の過去の記述は書き換えない
  - [x] SP-9-8 GitHubのリポジトリ名を変える（2026-11-13済み、ユーザー決定）：`ntakao2006-web/RaceCapture` → `ntakao2006-web/EcoLogger`。古いURLは新しい方へ転送される（同じ名前のリポジトリを作り直さない限り）。このPCのリモートのURLと、引き継ぎ資料`server_deploy_grafana_x86.md`の取り寄せ方を直した。過去のメモ・`ARCHITECTURE.md` 4章にある古いURLは記録なのでそのまま。リポジトリを渡してある人への連絡はユーザーから
  - [x] SP-9-9 このPCのフォルダー名を`ClaudeCode/RaceCapture`から`ClaudeCode/EcoLogger`へ変えた（2026-11-13済み、実行はユーザー）。手順と結果は`docs/manual/rename_local_folder.md`。古い名前は通り道として残してある。記憶46件は新しい置き場へ写し、ショートカットは新しいパス、作業用の写しの登録も直した。**残り：通り道を外す（数週間使って困らなければ。手順書7章）**、`emc-engine-crankcase/ARCHITECTURE.md`の記述を直す（そのリポジトリの会話で）
  - [ ] SP-9-10 Lintarohさんへの連絡：`docs/share/lintaroh_share_20261113_repo.md`（リモートのURL、移した資料の場所、Codex向けの`AGENTS.md`、RaceCaptureから離れる方針、返事がほしい3点）。2026-11-13作成、未送。回路図・基板のデータの公開とライセンスの希望はSP-9-3の材料にする

- [x] SP-10 **解析アプリ**（2026-11-14 ユーザー決定。別のリポジトリ・MITライセンス・pywebviewの専用アプリ。A-1〜A-3・A-5の先）
  - 2026-11-15：SP-10-1〜10-8 がすべて済んだ（どれもPCで試験と画面まで。実際の走行のあとにユーザーが使って直す所は、新しい項目として起こす）
  - 決めたこと：
    - 解析アプリはロガーと別のリポジトリに分け、MITライセンスで公開する。まずpywebview（Windowsに入っているWebView2で自分の窓を出す。画面はHTML/JS、裏はPython）で作る。画面とPythonのあいだはローカルのHTTPのまま保ち、あとでElectronやTauriへ移せる形にする
    - **ロガー側（本体のソフト・ファーム・PCの道具）にGPLのコードを持ち込まない**。将来ロガーを閉じた製品にする可能性があるため。解析アプリにも当面GPLのコードを入れない（依存はMIT・BSD・Apacheだけ）。GPLのソフトのソースが特に優れていてGPL-3.0にする大きな利点が見つかったら、そのとき改めて決める
    - ロガーと解析アプリの境目はファイルの形式1つにする。解析アプリが知るのは「列・単位・時刻・周・動画の秒と時刻の対応表・コースの線」まで。車ごとのCANの読み方・周の計測の作り方・LTEのやり方はロガー側に置き、解析アプリには物理量だけを渡す
    - 機能の考え方は既製品（Circuit Tools・MoTeC i2・AiM）と同じでよいが、コード・画面のデザインや文言・Racelogicのコースのデータ（`.cir`）は写さない。逆コンパイルはしない
    - 欲しい機能（ユーザー、2026-11-14）：距離でそろえた周の重ね合わせ（動画も距離でそろえて重ねる）、計算チャンネル、時間と距離の両方での比べ（動画も同じ）、グラフのカーソルに動画が合う。動画の合わせの手間をなくすのが一番
  - [x] SP-10-1 リポジトリの土台（手元）：`LICENSE`（MIT）、`README.md`、フォルダーの形、pywebviewで窓を出して閉じるまで、試験の土台、依存とライセンスの一覧。**GitHubへ公開するのは、名前と著作権の表記をユーザーが決めてから**
    - 2026-11-14：手元までできた（`Documents\ClaudeCode\EcoLogger-Analysis`、ローカルにコミット1件）。pywebview 6.2.1で窓が開き「準備できました」が出て、閉じるとプロセスも終わる。試験7件、依存8個はすべてMIT・BSD・PSF。窓の作業場所は`~/.ecologger-analysis/webview`に固定（一時フォルダーだと消しそこねて溜まる）。同日、ユーザーの了承で公開リポジトリ `ntakao2006-web/ecologger-analysis` として公開（著作権の表記は`ntakao2006-web`、既定のブランチは`main`）
  - [x] SP-10-2 境目のファイル形式を決めて書く（解析アプリのリポジトリに置く）と、EcoLogger側の書き出し（走行1回ぶん：物理量の表・周・動画の対応表・コースの線）。測位の点は測位の時刻で置いて補う（SP-5-5の記録）
    - 2026-11-14：形式「ecorun」版1を決め、解析アプリのリポジトリの`docs/format.md`に書いた（走行1回ぶんを`.ecorun`のフォルダー1つに：`session.json`・`channels.csv.gz`・`gnss.csv.gz`・`video/*.mp4`。時刻は全部 `t0_utc` からの秒）。EcoLogger側の書き出しは`tools/analysis_export/export_session.py`（試験9件）、解析アプリ側の読み込みと確かめは`ecoanalysis/session.py`（試験7件）。SUGO 11/8 決勝で確かめた：31〜33周（SDの測位・動画つき）は17,353行×28チャンネル・測位3,471点（0.1秒ごとに抜けなし）・動画1本（映像H.264・音AAC、映像は0秒から）で、セクターを足すと周のタイムに一致。決勝の全部（動画なし）は443,495行・測位88,470点・周38で8.6MB、書き出し59秒。ある周の`end`と次の周の`start`は数十msずれることがある（`end`は本体が周を数えた時刻、タイムは本体が線の所を補った値のため。形式の文書に書いた）。**解析アプリで全部を開くのに10.4秒かかる**（CSVを1つずつ数に直している）ので、SP-10-3で速くする
    - 2026-11-14 周の境目の直し（ユーザーの指摘）：書き出しの周の始まり・終わりは「LapCountが増えた行の時刻」だったため、線を越えた時刻より周ごとに −16〜+185ms（平均66ms）遅れ、隣の周と食い違っていた。本体（`EcoCapture-Web/lap.py`）は線を越えた瞬間を補って出し、前の周の終わりと次の周の始まりを同じ時刻にしているので、正しいのは本体の側。書き出しで、測位の点からコースの線を越えた時刻を`lap.py`と同じ計算で出し直して境目に置くようにした（`line_crossings`・`snap_laps`）。出し直したタイムが本体のタイムと20ms以上違う周は元のまま残し、`notes`に書く。本体が使った線は記録に残らないので、コースの設定（`tools/setups/courses/`）の線で出し直し、タイムが合うことで同じ線だと確かめる形。SUGO 11/8 決勝の38周は、出し直したタイムが本体と最大1.4ms・平均0.4msで合った。形式の文書の5章を「続いた周は境目が同じ時刻」に書き換えた。試験2件追加（11件）
  - [x] SP-10-3 読み込みと周の一覧：走行を開く、周の表（タイム・ベストとの差・セクター）、別の日の走行も並べて開ける。**周をアプリの側で切り直せるようにする**（2026-11-14 ユーザー了承）：コントロールラインがロガーと解析の側で違うことがあり、別の日・別の機器の周を比べるには同じ線で切る必要があるため。書き出しの`laps`は「ロガーの数え」として横に並べ、ふだんはコースの資料の線で測位から周を切る（本体と同じ計算。SUGOで本体のタイムと最大1.4msで合うことは確かめ済み）。**コースの資料の正はEcoLoggerの`tools/setups/courses/`（SP-4。はじめから入れておく線は自分たちで引いたもの、SP-4-13）で、解析アプリに別の一覧を作らない**。アプリの地図で動かした線は、その場限りにせず名前つきの別の版として残す（置き場はそのとき決める）。ほかの機器（スマホ等）の記録を開くときにコースをどう引き当てるかも、そのとき決める
    - 2026-11-14 できた（PCで試験と画面まで。専用の窓でのフォルダー選びは手で試していない）：解析アプリに、走行を開く（フォルダーを選ぶ・最近開いたもの）・閉じる・別の日の走行を並べて開く、を足した。周の表は、周・タイム・ベストとの差・セクター・印（測位の抜け、ロガーに無い周、ロガーと5ms以上違う周）で、ベストの周とセクターのベストに色を付け、選んだ周を覚える（重ね合わせはSP-10-4）。ベストとの差は、同じコースの開いている走行どうしで比べ、測位の抜けた周は除く。**周はふだん、コースの線で測位から切り直したもの**（`ecoanalysis/laps.py`。線を越えた時刻＝線の手前と先の2点から補った値、向きと幅を見る、1秒より離れた点のあいだでは見ない、越えたあと幅より離れるまで次を数えない）。ロガーの数えに切り替えられ、ロガーの周と終わりが0.5秒以内なら同じ周として番号をそろえる。SUGO 11/8 決勝の38周（SDの10Hz・本体の記録の約6Hzの両方）で、切り直した周とセクターがロガーと全部1ms以内で合った。読み込みはnumpyの`loadtxt`に変え、読んだ表を`~/.ecologger-analysis/cache/`に覚える：決勝の全部が初回6〜8秒（前は10.4秒）、2回目から0.2秒。初回をこれより縮めるにはnumpyの読み取りが1本ずつしか動かず、スレッドに分けても速くならなかった（縮めるなら形式に表の別の書き方を足すか、pandasを入れる）。ほかのWebページから裏の処理を呼べないよう、`/api/`は決まった見出しと宛先（127.0.0.1・localhost）の呼び出しだけを受ける。試験：アプリ全体24件（周の切り直し7件・サーバー9件を含む）。**線を地図で動かして名前つきの版として残すのは、コース図（SP-10-5）で作る**
  - [x] SP-10-4 重ね合わせ：横軸を時間・距離で切り替え、選んだ周を重ねる、基準の周とのタイムの差（位置で合わせる）
    - 2026-11-14 できた（PCで試験と画面まで）：周の表で選んだ周（8周まで。線の色の数）を、グラフに重ねて出す。上から「基準の周とのタイムの差」（2周以上のとき）と、選んだチャンネル（ふだん車速・アクセル・回転数。選び直しは覚える）を1段ずつ。横軸は距離と時間を切り替えられ、全段で共通。基準はふだん一番速い周で、選び直せる。**距離は基準の周の走った線に沿った距離で、ほかの周は測位の点を基準の線へ投影して合わせる**（`ecoanalysis/overlay.py`。走る線が少し違っても同じ場所どうしが並ぶ）。タイムの差は2m刻みで「同じ場所に何秒遅れて着いたか」。周の始まりは0m、終わりは基準の周の長さにそろえる。別の日・別の書き出しの周も混ぜて重ねられる。グラフは自前のcanvas（`web/chart.js`）で、ホイールで拡大・ドラッグで移動・ダブルクリックで全体、マウスの位置の値を各段の見出しに出す。SUGO 11/8 決勝の4周（31・42・44・21周）で、タイムの差の最後の値が周のタイムの差と1ms以内で合った（SUGOの1周は基準の周で3,549m、計算0.5秒）。試験：アプリ全体29件（重ね合わせ4件・サーバー1件を含む）。明るい画面の色は見ていない（暗い画面で確かめた）
  - [x] SP-10-5 コース図：周の線とカーソル、図を押すとグラフ・動画もその位置へ
    - 2026-11-14 できた（PCで試験と画面まで。動画の側はSP-10-6）：コース図（自前のcanvas、`web/map.js`）に、選んだ周の走った線（色はグラフと同じ）と、コントロールライン・セクターの線（進む向きの矢印つき）を描く。グラフのカーソルの位置に各周の点が出て、図を押すと基準の周のいちばん近い所へグラフのカーソルが動いて留まる（グラフを押しても留まる）。ホイールで拡大・ドラッグで移動・ダブルクリックで全体。背景の地図の写真は無い（ネットが要るため。要るならSP-4-10の国土地理院の写真を使う）。**線の版**：「線を直す」で、コントロールライン・セクターの線を図の上で置き直し（向きは基準の周の走る向き、幅は数で）、セクターの線を足す・消すもでき、名前をつけて残す。置き場は`~/.ecologger-analysis/lines.json`で、コースごとにどの版を使うかも覚える（`ecoanalysis/lines.py`）。版を使うと、同じコースの開いている走行は全部その線で周を切り直し、書き出しの線（ロガーと同じ。正はEcoLoggerのコースの設定）へはいつでも戻せる。版を使っている間は、ロガーと線が違うのでロガーのタイムとは比べない。周の番号は、終わりが周のタイムの半分以内のロガーの周から取るように直した（線を動かしても番号が変わらない。ロガーと比べるのは今までどおり0.5秒以内で合う周だけ）。SUGO 11/8 決勝で、コントロールラインを100m手前へ動かした版を残すと38周が切り直され（31周は1:50.094→1:50.151）、番号は8〜45周のまま、版を消すと元に戻ることを画面で確かめた。試験：アプリ全体34件（線の版5件を含む）
  - [x] SP-10-6 動画：カーソルに合わせて動画が動く、2周の動画を同じ距離（または同じ時間）で並べる。動画の位置は対応表から出し、手で合わせない
    - 2026-11-14 できた（PCで試験と画面まで）：動画の欄に、選んだ周のうち動画のある周を2つ上下に並べる（上はふだん基準の周、下はほかの周。欄の頭で選び直せる。音は上だけ）。各周の動画の秒は、書き出しの`videos[].sync`（動画の秒と時刻の組）を周の頭からの秒に直して補う（裏の`lap_videos`が周に重なる動画と、その周の範囲の組だけを返す）。**止まっているとき**はグラフ・コース図のカーソルに合わせて2本ともその所へ動き、**再生すると**上の動画の秒からカーソルを動かし、下の動画は同じ所（距離の横軸なら同じ地点、時間なら同じ秒）を、ずれが0.3秒より大きければ飛ばし、小さければ速さを少し変えて追う。周の終わりで止まる。速さは1・0.5・0.25倍。動画は裏の`/media/<走行>/<番号>`から、開いている走行の動画だけを途中から読める形（Range）で渡す。**終わりを書かない頼み（`bytes=N-`）に残り全部を流し続けると、Chromiumがつながりを握ったまま読まなくなり、早送り・巻き戻しが止まった**ので、一度に返すのは8MBまでにした。SUGO 11/8 31〜33周の動画で、31周と32周を1,407m地点に合わせると、2本の焼き込みの速さ（125・113km/h）がグラフ（126・114km/h）と、焼き込みのタイムの差（+0.27）がグラフ（+0.291）と合い、同じ場所が映ることを画面で確かめた。再生中、下の動画は約1.06倍で上に付いていった（32周がこの区間で遅いため）。試験：アプリ全体36件（動画の対応・Range・閉じた走行の動画を出さない、を含む）
  - [x] SP-10-7 計算チャンネル：式を入れて新しいチャンネルを作る（四則・比較・If・関数・積分・変化率など）。式はPythonの`eval`に渡さず、自前の小さな読み取りで安全に計算する
    - 2026-11-14 できた（PCで試験と画面まで）：グラフの「チャンネル」の一覧から「＋ 計算チャンネルを作る」で、名前・単位・式を入れて残す（`~/.ecologger-analysis/channels.json`。走行に関係なく使える）。式は四則（`+ - * / % ^`）・比較（成り立てば1）・`and or not`・`if`・`abs sqrt min max clamp round sin cos atan2 deg rad`など・`integ`（時間で積分）・`deriv`（1秒あたりの変化率）・`smooth`（前後の平均）・定数`pi g0 time`。記号や空白のある名前は`[名前]`。計算チャンネルどうしも使える（ぐるりと互いを使う式は断る。使われているものは名前を変えられず、消せない）。**式は`ecoanalysis/formula.py`が自前で字句に分けて決まった文法の木にし、木を自前で計算する。Pythonの`eval`は使わず、名前はチャンネルか表の関数・定数だけ。長さ500文字・木300・深さ40まで**。入れている間に、読めるか（読めなければ何文字目か）と、開いている走行の全体で試しに計算した値の幅を出す。重ね合わせでは周の行だけで計算するので、`integ`は周の頭で0から始まる。値の無い所・0で割った所は値無しにする。その走行に無いチャンネルを使う式は、その周だけ出さず凡例に理由を出す。SUGO 11/8 決勝で`integ(Speed / 3.6)`（周の距離）を作ると、31周で3,596m・32周で3,605mになり、測位の線の長さ（3,549m）より1.3%長かった（車速の値がやや高めに出ている）。計算チャンネルを使う式（`周の距離 / 1000`）、無いチャンネルを使う式、元のチャンネルと同じ名前を断ることも画面で確かめた。試験：アプリ全体47件（式の計算・文法の外を断る・残す決まり・窓口を含む）
  - [x] SP-10-8 配る形：PyInstallerで`.exe`、WebView2が無い機器への備え、EcoLoggerアプリの走行の行から開く入口
    - 2026-11-15 できた（PCで試験と画面まで）：**exe**は`tools/build_exe.py`（PyInstaller 6.22、フォルダーの形を zip で配る。exe のフォルダー63MB・zip 27MB、作るのに約1分、起動まで1〜2秒）。PyInstallerは exe を作るときだけの`.venv-build`に入れ、ふだんの部品の決まり（MIT・BSD・Apache など）は変えない（PyInstallerはGPLだが、exe に入る起動の部分には「どんなライセンスで配ってもよい」例外が付き、自身のコードは入らない。`THIRD_PARTY.md`に exe に入るものを並べた）。**WebView2が無い機器**：pywebviewは無いと黙って古いIEの表示に落ちるので、同じ調べ方（レジストリ）で先に見て、無ければいつものブラウザで開く（画面の上に理由を出し、タブを閉じて45秒たつと終わる）。**1つだけ開く**：開いている間は`~/.ecologger-analysis/running.json`に番号を置き、2つ目の起動は走行を開いている窓へ渡して（`/api/handover`）前に出し、自分は終わる。画面は3秒ごとに様子を聞き、走行が増えたら一覧を読み直す。書き出し直された走行は同じ番号のまま読み直す。**入口**：EcoLoggerアプリの「走行を見る」の行に「解析で開く」と、動画がある走行には「＋動画（約○GB）」（`tools/video_collect/analysis_open.py`）。`drive_logs/sessions/<走行のid>[_video].ecorun/`へ書き出し（走行記録より新しい書き出しがあれば飛ばす）、解析アプリを起こして渡す。解析アプリは、環境変数→`~/.ecologger/analysis_app.txt`→`~/.ecologger/EcoLogger-Analysis/`（配る zip を広げた所）→リポジトリの隣の開発の手元、の順に探し、無ければ置き場所を案内する。測位のSDは、その走行のフォルダーのもの・その日以後に回収したものを順に書き出しの道具へ渡し、道具が時間の合うSD（本体の記録の半分以上の点）を選ぶ（`export_session.py --sd`を何度でも書けるようにした）。動画つきは1GBを超えると先に聞き、PCの空きが足りなければ断る。SUGO 11/8 決勝（2時間27分・38周）を画面から開くと、11/11 に回収したSDの10Hz（88,470点）で書き出して61秒で開き、38周がロガーの数えと全部1ms以内で合った。2回目は書き出さずに0.0秒で開いている窓へ渡り、別の走行を続けて開くと2本並んだ。exe を2つ目に起こしたときに開いている窓へ渡ること、窓を閉じたら印が消えることも確かめた。試験：解析アプリ54件、EcoLoggerアプリ側155件、書き出し12件

## 順番の目安

1. SP-1（確かめる）と SP-2-1（表紙）
2. SP-3-1（画面の案）→ ユーザーに見せて直す
3. SP-3-2〜3-5（つなぎ方・いまの様子・回収の案内）→ SP-3-9（窓をやめる）
4. SP-4-1・4-2（車・コースの設定の形）→ SP-4-4
5. SP-3-6・3-7（動画の置き方）→ SP-5（走行を見る）
6. SP-6（スマホの入口）、SP-3-10（ほかのPCへ入れる）。**2026-11-13：ちょっとした操作はLTE経由（スマホ）が主な道になる見込みなので、SP-6-1・SP-6-3は前倒しを考える**（自宅のサーバーに入れるのは了承のあと、本体に命令を足す分は展示のあと）
7. 展示のあと：SP-7、SP-4-3
8. SP-8（資料）は、対応する入口ができるたびに
9. SP-9（RaceCaptureから離れる）：SP-9-1・9-2・9-3（記録・突き合わせ・ライセンス）は早めに。SP-9-8（リポジトリ名）は名前が決まりしだい。本体に入れる分は展示のあと
10. SP-10（解析アプリ）：SP-10-1・10-2を先に。そのあと10-3〜10-6（比べと動画）、10-7（計算チャンネル）、10-8（配る形）。カートの作業（`KT-x`）と重なるときはカートを先にする
