ntakao2006-web/RaceCapture/docs/share/maruo_share_20261022_server_setup.md

# Maruo.Sさんへの返信：大会用サーバーの設定の確認（2026-10-22、下書き）

先輩（ChatGPTのPM）からの確認事項（10/22受領）への返信。【要記入】は送る前に埋める。

---

お疲れ様です！まとめていただきありがとうございます。分かるところから答えます。

## ① 車両・ロガー

3台の内訳は次のとおりです。

| 車両 | 積むもの | room名（案） |
|---|---|---|
| 新車（今年新しく作った車両） | Ver.2ロガー（UNO Q）＋LTE | お任せ |
| スーパーカブ | Androidスマホのロガーアプリ | お任せ |
| EM1 e:（ホンダのEV） | Androidスマホのロガーアプリ | お任せ |

- **roomは車ごとに分けてください**（Podiumキー・地図・ロガー向けの音声ミックスが車ごとになるため）
- room名はお任せします。決まったら教えてください。ロガー・アプリ側の設定に入れます（英小文字・数字だけだと助かります）
- どれも`/ws/audio/<room>`へ`role:"logger"`で`podium.meta`・`podium.samples`を送る、同じ形式です（Androidアプリも Ver.2に合わせてあります）

## ② Podium

- キーはまだ発行していないので、**今日（10/22）の18時ごろ**にDMで送ります
- 対応表もDMに一緒に書きます（車名 ⇔ キー）
- **3台同時に配信する想定で合っています。** キーは車ごとに別なので、重なりはありません
- 注意点が1つあります：Ver.2ロガーは、サーバーが主・予備とも全部つながらないときだけ**Podiumへ直接送る保険**を持っていて、同じキーをロガー側にも入れています。サーバーにつながっている間は直接送りません

## ③ Discord音声連携

大会でもBotを使います。

- **Botを使うのは新車（Ver.2）の1台だけです。** スーパーカブとEM1 e:はスマホなので、ドライバーがふつうにDiscordへ入ります。なのでBotは1体で、新車のroomにだけつなぎます
- Botは**こちらの自宅サーバー（ROCK 5B）で動かします**。先輩のサーバーで動かす必要はありません
- Botは`/ws/audio/<room>`に「ミックスを受ける参加者」としてつなぐだけなので、**サーバー本体の変更は要りません**。先輩のサーバーのroomのURL（`wss://…/ws/audio/<room>`）さえ分かればつなげます
- 1つ気になっている点：主サーバーが落ちてロガーが予備（自宅）へ移ったとき、Botは主サーバーのroomにつながったままなので声が届かなくなります。分散構成で自動で切り替わる仕組みに、Botのような参加者も乗れるか教えてください
- チームのDiscordサーバーへBotを招待してよいかも確認させてください
- ソースはこちらのリポジトリ（`archive/voice/discord_bridge/`、Node 22）にあります。見たい場合はチームの`ecorun-logger-server`に別ブランチでpushします

## ④ 3台同時の接続テスト

- できれば**明日（10/23）**に、3台（Ver.2＋スマホ2台）を同時に先輩のサーバーへつなぐテストをさせてください。屋内のWi-Fiで十分です
- 予備（自宅のサーバー）へ切り替わるかも、そのとき一緒に見たいです

## そのほか（こちらから）

- 主サーバーは先輩のラックサーバー、予備はこちらの自宅（ROCK 5B）でお願いします（10/18に決めたとおり）。主サーバーのURLが決まったら教えてください。ロガーの主URLに入れます
- **PR#5を出しました。明日のテストの前に、先輩のサーバーへ入れてもらえると助かります。**
  https://github.com/TMCIT-Ecorun/ecorun-logger-server/pull/5
  LTEのロガーは声を0.5秒分まとめて送るのですが、サーバーの送り待ちの列が3パケットしかなく、あふれた分が捨てられて、**ドライバーの声がピットに約3割しか届いていませんでした**（10/19の屋外テスト）。60msに1つずつ流し直すように直したもので、自宅のサーバーでは10/19から動かしていて、ピット側に全部届くことを確認済みです。通信の形式は変わりません

よろしくお願いします！
