ntakao2006-web/RaceCapture/docs/manual/ncec_field_procedure.md

# NCロードスター（NCEC）実車CAN/OBD解析 現地手順書（1時間・走行のみ）

> # ⚠️ このファイルを開く前に `ncec_next_session_checklist.md` を読むこと
> 実車が無いと**絶対に解けない**未解決項目が5つ残っている（4輪速の左右確定、
> ペダルのゆっくり全開スイープ、停車スイッチ操作12種、電動ファン作動の瞬間、高回転走行）。
> **1回逃すと次にNCECへ繋げるまで丸ごと持ち越し**になる（前回は5週間空いた）。
> 走行キャプチャだけして帰らないこと。

> **目的**：自作CANトランシーバ回路（XIAO ESP32C3 + MCP2562FD）をNCECのOBD2ポートへ直結し、
> **①OBD2の疎通を先に確定させ、②走行中の生CANとOBD2応答を同一タイムスタンプで取り切る**。
> 帰宅後に `can_correlate.py` へかけて「どのCAN IDのどのバイトが車速・回転数か」を特定する。
>
> **対象車両**：NCロードスター（NCEC、2005年式初期型、MT、DSC非搭載）＝**本プロジェクトの本番投入車両**。
>
> **運用方針（2026-09-06にユーザー確定）**：**停車しての操作（ウィンカー等を1つずつ入れる差分採取）は行わない。**
> 走行のみを前提とし、運転者は運転に専念する。画面を見るのは**発進前の1回だけ**。
>
> **なぜこの車が本命か**：MAZDA2はDLCがスタブ構成（診断応答のみ）、レクサスUXはゲートウェイ隔離で
> 非診断IDが固定値2種のみ。**3車両のうち生CANが実際に流れているのはNCECだけ**であることが
> 実測で確定している（`docs/research/vehicle_can_survey_summary.md`）。生CAN逆解析ができる唯一の車両。
>
> **記録先**：`ncec_` プレフィックスの新規ファイルに限定する。既存の
> `obd2_survey_nc_roadster*`・`mazda2_*`・`lexus_ux_*` は**一切上書きしない**。

---

## 0. この1時間で何を取りに行くのか

| 優先度 | 目的 | 対応するタスク | 判定 |
|---|---|---|---|
| **1（必達）** | **OBD2の疎通**：自作基板がNCECのECUから応答を得られること、`0x7E0`で通るか`0x7DF`が要るか | 2-2-1の「保留（実車必須）」 | 発進前の**プリチェック60秒**で確定する |
| **2（本命）** | **走行中の生CANとOBD2の同時取得**、`0x201`/`0x4B0`/`0x240`のデコード式の実測裏取り | 2-4-5 | 帰宅後の`can_correlate.py`でR²>0.95 |
| 3（副産物） | 停車↔走行の差分で動くバイトの洗い出し（未解明ID `21A`/`39A`/`420`/`4EC`/`4FF`） | 2-4-3／2-4-4の一部 | `can_diff.py`（操作差分ではなく**状態差分**として使う） |

**自作側の未検証項目はもう無い**。MAZDA2（74秒、欠落0）とレクサスUX（61分、drop=0・buserr=0）で
回路・ハーネス・ファーム・USB経路・`--phase-plan`の自動進行はすべて実車実証済み。
今回は**繋いで回すだけ**であり、切り分け作業は残っていない。

> **今回できないこと（明示）**：`211`/`212`（警告灯系）や`21A`/`39A`（低頻度イベント系フラグの疑い）の
> ビット割当特定は、停車中の単一操作差分が前提なので**今回は対象外**。走行ログからでも
> 「ウィンカーの点滅周期（約0.7〜0.8秒）でトグルするビット」を探す余地はあるが、確度は落ちる（4-5参照）。

---

## 1. 家でやっておくこと（15分）

### 1-1. いま書き込まれているファームを起動メッセージで確かめる（5分）

この基板は用途ごとに別のファームを書き込んで使っている。**前回どれを書いたかの記憶や記録に頼らず、毎回実機の起動メッセージで確かめる**。
（例：2026-10-19にEV二輪のMPP充電器向けのSOC表示版をビルドしており、書き込んだならNCECでは使えない状態になっている）

**手順**

1. 基板をPCへUSBでつなぐ（CANはつながなくてよい）
2. シリアルモニタを開く
   ```bash
   python -m platformio device monitor -p COM5 -b 115200
   ```
3. XIAOの **Rボタン（リセット）を1回押す**。起動メッセージは電源投入から約0.3秒で1回しか出ないので、モニタを開いただけでは見逃す
4. 最初に出る `#` 行（または `=====` の行）を下の表と照らし合わせる
5. Ctrl+C でモニタを閉じる（閉じないと次の書き込みや`can_capture_logger.py`がCOM5を開けない）

**各ファームの起動メッセージ**

| 起動メッセージの1行目 | 見分けるための次の行 | ファーム（ビルドのenv） | NCECで使えるか |
|---|---|---|---|
| `# ===== CAN raw logger + OBD2 poller (TWAI_MODE_NORMAL) =====` | `# *** WARNING: THIS FIRMWARE TRANSMITS ON THE CAN BUS ***`、`# polling 21 PIDs: ...` | `can_obd_logger`（`esp32-c3-can-obd-logger`） | **○ これを使う**（ただし下の注意を参照） |
| 同上 | `# polling 4 PIDs: ...` | `can_obd_logger` のPIDを4項目に絞った特別ビルド（チェックリストのB専用） | B以外では× 通常のPIDテーブルに戻して書き直す |
| `# ===== CAN read-only logger (LISTEN_ONLY / no bus injection) =====` | `# line format: t_us,...`、`# bitrate=500k` | `can_logger`（`esp32-c3-can-logger`） | × 送信しないのでOBD2の応答が取れない |
| 同上 | `# bitrate=250k` または `# bitrate=125k` | `can_logger`（`-250k` / `-125k`） | × 速度も違う |
| 同上 | `# MPP SOC mode: shows CAN ID 0x402 ...` | `can_logger` のSOC表示版（`esp32-c3-mpp-soc`、ER-12） | × 0x402以外は何も表示・記録しない |
| `==================================================` に続けて ` MCP2562FD wiring self-test (TWAI self-reception)` | `[OK]`/`[NG]` の行や `---- batch result: PASS=...` | `can_selftest`（卓上の配線テスト） | × **実車禁止** |
| 何も出ない | — | 不明（`logger_v1`等の別プロジェクト、またはポート違い） | × 書き込む |

起動メッセージを見逃しても、毎秒のステータス行で区別できる。

- `# obd req=0x7E0 poll=on sent=...` が出る → `can_obd_logger`
- `# stat t=... total=... rate=.../s` だけが出る → `can_logger`（通常版）
- `# stat frames=... soc=... buserr=...` が5秒ごとに出る → `can_logger` のSOC表示版

**判定**

- `can_obd_logger`（`polling 21 PIDs`）以外なら、次で書き込む。
- `can_obd_logger` と出ても、**卓上専用の`-bench`ビルドは起動メッセージが通常版と同じで見分けられない**。また、mode 22（`d`/`s`/`w`キー）が入ったのは2026-09-12で、それより前の版も起動メッセージは同じ。**少しでも迷ったら書き込む**（1分で終わり、何度書いても害はない）。

```bash
cd firmware/can_obd_logger && python -m platformio run -e esp32-c3-can-obd-logger -t upload --upload-port COM5
```

書き込んだあとは、もう一度手順2〜4で `# ===== CAN raw logger + OBD2 poller` と `# polling 21 PIDs` が出ることを確かめる。

> **`-e esp32-c3-can-obd-logger-bench` を焼かないこと**（`TWAI_MODE_NO_ACK`の卓上専用ビルド。実車禁止）。
> 送信するのは **OBD2 mode 01（読み取り）とACKだけ**。DTC消去・アクチュエータ制御は含まない。
>
> PIDテーブルはUX調査時に拡張済みで、NCECが対応しない `5C`（油温）等は
> 自動バックオフで間隔が最大64倍まで伸びるため、対応PIDのレートを食わない。**NCEC向けの改造は不要**。

### 1-2. 卓上リハーサル（CAN未接続でよい・2分）

> **2026-09-06に実施済み・合格**。基板はCOM5（Espressif USB Serial/JTAG、`VID_303A`/`PID_1001`）で認識され、
> ファームは`can_obd_logger`のまま（`# obd req=...`行が出ることで確認）。
> 実測：`r`→`RESUMED`が約209ms、`p`→`PAUSED`が約213ms、`drop_rb`/`rx_missed`/`rx_overrun`はすべて0。
> **ポーリング停止中は`txerr`が7712で固定され、再開で再び増加**＝キーがバス動作へ実際に反映されている。
> **基板を触っていなければ、このステップはもう不要。** ただし1-1で書き込み直した場合はやり直す。

```bash
python can_capture_logger.py --port COM5 --out rehearsal --limit-seconds 25 --phase-plan "0:poll:t_poll,10:passive:t_passive,20:poll:t_resume"
```

`rehearsal.status.log` を開いて次の3つを確認する。

1. `# obd req=0x7E0 poll=on sent=... resp=0 ...` の行が毎秒出ている
   → **現地のプリチェック（2-1）はこの行を読む**ので、出ることをここで確かめておく
2. `# host: phase ... action=passive key=p label=t_passive` の直後に
   `# obd polling PAUSED (passive; ACK is still sent)`
3. 20秒後に `# obd polling RESUMED`

通らない場合はまず `--port` を疑う（ポート番号違いでも「接続待ち」で静かに待つだけなので気づきにくい）。

> 卓上では `txerr`・`buserr` が増え続けるが**これは正常**（ACKを返す相手がいないだけ）。実車では0になる。
> 卓上の `resp=0` も正常（応答する相手がいない）。`tec=128`・`alerts=0x200`（エラーパッシブ）も
> 相手がいない卓上では想定どおりで、`state=RUNNING` が保たれていれば問題ない。
>
> **卓上では `sent=6` から増えない**のも正常。ACKが返らないフレームがTXキューに居座り、以降の
> `twai_transmit()` が失敗して `txerr` だけが増えるため。実車ではACKが返るので流れる
> （MAZDA2実車で `sent=3514`／`resp=3514`、欠落ゼロを実証済み）。
> なお `0x7E0`→`0x7DF` の自動フォールバックは「連続30回の応答失敗」で発動するが、卓上では
> そもそも6回しか送信できていないため発動しない。実車では毎秒10回前後投げるので数秒で判定が付く。

### 1-3. 持ち物・設定チェックリスト

- [ ] ESP32-C3基板 + OBD2ハーネス（6=CANH / 14=CANL / 5=GND）
- [ ] **卓上検証用の120Ω終端を外したこと**（車両バスは両端終端済み。付けたままだと三重終端）
- [ ] ノートPC（残量50%以上）＋ USBケーブル（**運転中に抜けないよう養生テープで固定**）
- [ ] **PCのスリープ無効化**（「電源とスリープ」を「なし」、蓋を閉じる動作も「何もしない」）
- [ ] **空き容量2GB以上**。NCECは生CANが本当に流れるため、レクサスUX（61分で37MB）より**大きくなる**。
      300〜600 frame/s なら1時間で**100〜200MB**程度の見込み
- [ ] 基板・ケーブルを**ペダル周り／ステアリング下に垂らさない**
- [ ] この手順書の2章（打つコマンド2つ）をスマホで開けるようにしておく

---

## 2. 現地手順（合計約60分）

### 2-1. プリチェック：OBD疎通確認（停車のまま、約2分）

**乗車 → OBDへ接続 → IG ON → エンジン始動**まで済ませたら、停車したまま次を実行する。

```bash
python can_capture_logger.py --port COM5 --out ncec_precheck --limit-seconds 60
```

60秒で自動停止する。終わったらこれを打つ。

```bash
grep "# obd" ncec_precheck.status.log | tail -3
```

**判定表**

| 出力 | 意味 | 次の行動 |
|---|---|---|
| `req=0x7E0 ... resp=` が伸びていて `rpm=` `coolant=` に**それらしい数値** | **合格。OBD疎通OK** | 2-2へ進む |
| `req=0x7DF` になっている（自動切替が働いた） | `0x7E0`では応答せず、機能アドレスで通った。**これも合格** | 2-2へ進む（記録として覚えておく） |
| `resp=0` のまま／`# obd no response on ...` が繰り返される | 疎通していない | **配線を確認**：6=CANH / 14=CANL / 5=GND、**120Ωを外したか**、USBが挿さっているか。直したらもう一度2-1 |
| そもそもコマンドが「接続待ち」から進まない | COMポート番号が違う | デバイスマネージャでポート番号を確認して`--port`を直す |

同時に、60秒キャプチャの**終了時サマリ**（画面に出る）で**生CANが流れているかも分かる**。

| サマリのID一覧 | 意味 |
|---|---|
| `0x201` `0x4B0` `0x240` 等が並んでいる | **期待どおり。生CANが流れている**（本命の解析が成立する） |
| `0x7E0` と `0x7E8` しか無い | NCECもスタブ構成だった（MAZDA2と同じ）。この場合でも2-2はそのまま実施し、**OBDログとして完結させる** |

### 2-2. 本番キャプチャ（55分・走行のみ・完全放置）

プリチェックが通ったら、**発進する直前**にこの1行を実行して、**あとは画面を見ない**。

```bash
python can_capture_logger.py --port COM5 --out ncec_run1 --limit-seconds 3300 --phase-plan "0:poll:idle_start,60:poll:drive,2520:passive:drive_passive,2760:poll:drive2,3180:poll:stop_idle"
```

| 経過 | ラベル | ロガー | 運転者の行動 | 得るもの |
|---|---|---|---|---|
| 0:00 – 1:00 | `idle_start` | OBDポーリング | **停車・アイドルのまま待つ**（60秒） | 車速0の基準状態。走行との状態差分に使う |
| 1:00 – 42:00 | `drive` | OBDポーリング | **走行**（PCに一切触らない） | **本命**。車速・回転数の変化と生CANの相関 |
| 42:00 – 46:00 | `drive_passive` | 受動 | 走行を続ける | 自分の送信を止めた**純粋な生CANレート**と取りこぼし量の実測 |
| 46:00 – 53:00 | `drive2` | OBDポーリング | 走行を続ける | 受動区間の前後で条件を揃えた比較用 |
| 53:00 – 55:00 | `stop_idle` | OBDポーリング | 停車・アイドル | 終端の基準状態（`idle_start`との比較で時間変動を切り分ける） |
| 55:00 | 自動停止 | — | **Ctrl+Cは押さなくてよい** | — |

走行の中身は普段どおりでよいが、**発進・停止・高めの速度域が一度ずつ入る**と相関の精度が上がる。
渋滞だけ・信号待ちだけ、という55分にならなければ十分。回転数も、低回転で流すだけでなく
**普通に上まで回す場面が何度かある**と`0x201`の回転数バイトの当たりが良くなる。

**走行中にやってはいけないこと**：キーボード操作、コネクタの抜き差し、Ctrl+Cでの停止。

**USBが抜けた場合**：`[!] シリアルが切断されました` が繰り返し出るが、**安全な場所に停車するまで放置**でよい。
挿し直せばキャプチャは自動再開し、受動フェーズ中なら `p` を送り直して状態も復旧する。

### 2-3. 時間が足りない場合

`--limit-seconds` と最後の2フェーズの秒数を縮めるより、**そのまま回して途中でCtrl+Cする方が安全で確実**
（それまでのデータは全て保存済み。`--phase-plan`の途中までのフェーズ区切りも残る）。
停車してから落ち着いてCtrl+Cすること。

---

## 3. 帰宅後の解析手順

### 3-1. フェーズごとに切り分ける（まずこれ）

```bash
python can_split_phases.py --capture ncec_run1
```

フェーズ別のフレーム数・ID数・レートが一覧で出る。**この一覧が今回の一次成果**。
出力は `ncec_run1_p1_idle_start.csv` / `p2_drive` / `p3_drive_passive` / `p4_drive2` / `p5_stop_idle`。

| `p2_drive` のID一覧 | 意味 | 次にやること |
|---|---|---|
| `201`/`4B0`/`240`等の非診断IDが多数 | **生CANが取れている（期待どおり）** | 3-2以降へ |
| `7E0`/`7E8` のみ | NCECもスタブ構成だった | 生CAN逆解析は断念し、OBDログとして評価（3-2までで完結） |

### 3-2. OBD2応答を基準値の時系列へ変換する

```bash
python can_obd_extract.py --can ncec_run1.csv --list
```

```bash
python can_obd_extract.py --can ncec_run1.csv --out ncec_run1_ref
```

`ncec_run1_ref_0D_speed.csv` / `..._0C_rpm.csv` / `..._11_throttle.csv` / `..._05_coolant.csv` などが出る。
NCECは油温PID `5C` 非対応なので、`5C` のファイルは出ない（想定どおり）。

### 3-3. 生CANと基準値の相関（本命・2-4-5）

同一基板・同一 `esp_timer` のタイムスタンプなので **`--time-offset` / `--auto-lag` は不要**。

```bash
python can_correlate.py --can ncec_run1_p2_drive.csv --ref ncec_run1_ref_0D_speed.csv --ref-name speed_kmh --ref-time-unit us --top 20
```

```bash
python can_correlate.py --can ncec_run1_p2_drive.csv --ref ncec_run1_ref_0C_rpm.csv --ref-name rpm --ref-time-unit us --top 20
```

```bash
python can_correlate.py --can ncec_run1_p2_drive.csv --ref ncec_run1_ref_11_throttle.csv --ref-name throttle --ref-time-unit us --top 20
```

```bash
python can_correlate.py --can ncec_run1_p2_drive.csv --ref ncec_run1_ref_05_coolant.csv --ref-name coolant --ref-time-unit us --top 20
```

**期待する答え**（ここまでは既知。合っていれば手法とデータの妥当性が確認できる）

| 基準値 | 出るはずの候補 | 期待する式 |
|---|---|---|
| 車速 | `0x201` offset4/width2/big、`0x4B0` の4つの2バイト | `slope≈0.01, intercept≈-100`（100km/hオフセット） |
| 回転数 | `0x201` offset0/width2/big | `slope≈0.25`（`raw/4`） |
| スロットル | `0x200` offset7 / `0x215` offset6 / `0x240` offset3 | `slope≈100/255≈0.392` |
| 水温 | `0x240` offset1 | `slope≈1, intercept≈-40` |

R²が0.95を超えれば特定できたと見てよい。**既知の6IDが期待どおり出たあと、
上位に残った未知IDのバイト**（`21A`/`39A`/`420`/`4EC`/`4FF`）が今回の新規成果になる。

`0x7E8` 自身も上位に並ぶが基準値の出所なので自明な自己一致。無視するか `--candidate-id` で絞る。

### 3-4. 停車↔走行の状態差分（操作差分の代わり）

単一操作の差分は採れないが、**「停車・アイドル」と「走行」という2つの状態の差分**は採れる。
`can_diff.py` はこの用途にもそのまま使える。

```bash
python can_split_phases.py --capture ncec_run1 --exclude-ids 7E0,7E8 --skip-head 5 --suffix _nx
```

```bash
python can_diff.py --base ncec_run1_p1_idle_start_nx.csv --test ncec_run1_p2_drive_nx.csv
```

走行では多くのバイトが動くので所見は大量に出る。**読み方は「走行で動いたバイト」を見るのではなく、
逆に「走行しても一切動かなかったID」を見る**方が有益（`21A`/`39A`が今回もゼロ固定なら、
やはり低頻度イベント系＝走行では出ないフラグ、という消去法の裏取りになる）。

時間変動の切り分けとして、停車状態同士も比較しておく。ここに出る所見は
「走行と無関係に時間で変わるもの（水温上昇・カウンタ等）」なので、上の結果から差し引いて読む。

```bash
python can_diff.py --base ncec_run1_p1_idle_start_nx.csv --test ncec_run1_p5_stop_idle_nx.csv
```

### 3-5. 取りこぼしと生CANレートの評価

```bash
grep "drop_rb" ncec_run1.status.log | tail -5
```

`p3_drive_passive`（自分の送信を止めた4分間）のレートが `p2_drive` / `p4_drive2` より明確に高ければ、
**OBDポーリングがUSB帯域を圧迫していた**ということ。次回は受動主体の構成に変える判断材料になる。

### 3-6. 余力があれば：ウィンカー周期でのビット探索（確度低）

停車中の操作差分が採れないぶんの代替案。ウィンカーは**約0.7〜0.8秒周期で点滅**するので、
走行ログの中に「その周期で0/1をトグルしているビット」があれば`211`/`212`等の候補になる。
専用ツールは無く、その場しのぎのスクリプトを書く必要がある。**本命の3-3が終わってからにする。**

---

## 4. 安全・禁止事項

- **走行中にPCを操作しない。** そのために `--phase-plan` を使っている。
- **OBDの3番・11番ピンには触らない。** NCECはHS-CANが6/14。
  **6番と3番、14番と11番を導通させない**（MS-CANとの2系統直結はバスオフを招き、車両側の警告灯・DTC・
  フェイルセーフを引き起こす）。
- **卓上の120Ω終端を外したことを、繋ぐ前にもう一度確認する。**
- `can_selftest`（NO_ACKモード）と `-bench` ビルドを実車バスへ繋がない。
- OBD2は **mode 01（読み取り）のみ**。DTC消去・アクチュエータ制御は行わない。
- **VIN（mode 09 PID 02）は取得しない**（PIDテーブルにも入れていない）。
- ログをコミットする前に、車台番号等の個人特定情報が含まれていないことを確認する。

> **補足：受動フェーズでもACKは返る。** `passive`（`p`キー）はOBD2ポーリングを止めるだけで、
> ハードウェアとしてはACKを返し続ける（`TWAI_MODE_NORMAL`のため）。
> 「バスに一切影響しない」わけではない点は明記しておく（MAZDA2・レクサスUXで実車実証済みの構成）。

---

## 5. 記録するファイル

| ファイル | 内容 |
|---|---|
| `ncec_precheck.csv` / `.status.log` | 発進前の疎通確認60秒。**`# obd` 行が今回の必達成果の証跡** |
| `ncec_run1.csv` | 生CAN＋OBD応答の全フレーム（`host_iso,t_us,can_id,ext,rtr,dlc,data_hex`） |
| `ncec_run1.status.log` | ステータス行とフェーズ区切り（`# host: phase ...`） |
| `ncec_run1_p*_*.csv` | フェーズ別に切り分けたもの |
| `ncec_run1_ref_*.csv` | OBD2応答から起こした基準値の時系列 |

> 生ログ本体（`.csv`／`.jsonl`）は**リポジトリに含めない**方針（`.gitignore`済み）。
> リポジトリへ入れるのは解析結果とサマリ、および `status.log` まで。
