ntakao2006-web/RaceCapture/docs/manual/ecorun_flow_20261024.html

# エコラン全国大会 全体の流れ（出発前〜帰宅後）

2026-10-24（土）・25（日） ／ ロガーの操作は「当日手順書」、困ったら「困ったときの手順集」

迷ったときの優先順位（下のものが上のものを危うくするなら、下を切る）

① 記録が残る② ピットで見える③ ラップが正しい④ 音声⑤ 油温

ソフトは出発前に固める。土日に変えてよいのは設定だけ（ラインの登録・周回数・音声のON/OFF）。現地でソフトは直さない。

## 役割（当日までに名前を入れる）

役割 | やること | 担当
ロガー担当 | Ver.2の起動・設定・コースウォークでのライン登録・電波の記録・回収
ピット画面 | 走行中にピットの画面（地図・Grafana）を見る。止まったら予備の画面へ
周回のリセット | グリッドで、Ver.2とスマホ2台の周回数をリセットする
回収 | 走行ごとにCollect-Logs.cmdでログを集め、USBメモリにも保存
記録表 | 紙の記録表に周回・時間を書く（ロガーの周回がおかしいときの正）

## 出発前（10/23）

1. 試験：本番の設定・電源・機材で、電源ON→記録（3回）、SD無しで起動、記録中の電源断→回収、3台同時にサーバーへ、予備サーバーへの切替、音声、ラインのQR、振動、長時間運転。通らなかったものは、決めておいた代わり（下の表）で行く。
2. 本番の設定を入れる：送信は「LTEだけ」、送信先は中継サーバー（主・予備）＋保険のPodium、規定周回数、最短ラップ10秒、もてぎのおおよその3本のライン。設定の控えをPCへ。
3. 手順書を印刷：当日手順書を3部（ピット・車両担当・予備）、この紙、記録表。
4. 持ち物：Ver.2一式（UNO Q・ドック・アンテナ・ケース・バッテリー2個）、予備のSD・ケーブル、PC（回収用）・カードリーダー・USBメモリ、スマホ組2台、テザリング用スマホ、固定具（面ファスナー・結束バンド・テープ）。
5. 自宅サーバーが動いていることを確かめ、留守中は触らない。全バッテリーを満充電。

試験が通らなかったら | 当日の扱い
音声 | 「受ける」「送る」の両方をOFF（記録・ピット画面は変わらない）
予備サーバーへの切替 | 予備を外し、主だけにする
油温（センサーハブ） | 今回は使わない
スマホの画面オフ送信 | 画面を点けたままにする

## 10/24（土）前日

時刻 | やること | 確かめること
5:45 | Ver.2を手持ちの電源で起動し、テザリングにつなぐ（測位まで数分） | コースウォーク画面で「測位OK」
6:00〜7:45 | コースウォーク（会場に入れるのはここだけ）：スタート・コントロール・ゴールの真上で止まって登録、規定周回数を押す。電波の記録も同時に取る | 3本とも登録され、事前のおおよその位置から数十mもずれていない
直後 | スマホ2台にラインのQRを読ませる（二輪は規定周回数3） | 3台の「基準」の番号がそろう。番号を書く：
走行があれば | 本番と同じ取り付け・操作で1回通す（電源ON→REC→ピット画面→走行→止める→回収） | 周回数が実際と合う。ピット画面が止まらない。回収したCSVが開ける
走行が無ければ | パドックで車に付け、止まったまま同じことを通す | 同上（周回以外）
夕方 | ログを2か所に保存（PCとUSBメモリ）。全バッテリーを充電。役割の確認 | —
夜 | 日曜の「行く／切る」を決める（音声・Ver.1・スマホの画面オフ）。以後は設定を変えない | —

ラインを登録し直したら、スマホにもQRを読ませ直す（基準の番号が変わる）。

## 10/25（日）本番

いつ | やること | 確かめること
出走30分前 | 満充電のバッテリーでVer.2・スマホ組を起動 | 「● REC」、3D測位、ピット画面に3台
グリッド | 周回数をリセット（Ver.2のコースウォーク画面・スマホのアプリ） | 周回0、規定周回数（7／3）、基準の番号が土曜と同じ
走行中 | ピットは画面を見るだけ。ロガーには触らない | 止まったら予備の画面へ。記録は本体に残っている
ゴール後 | 触ってよくなってから「記録停止」→電源OFF（Ver.1はSD_Eject.cmd） | —
すぐ | 回収（Collect-Logs.cmd）→USBメモリにも保存 | 「新しいログ○件を回収しました」。周回数・時間を公式結果と照らしてメモ
片付け前 | SDを戻す（消去・フォーマットしない）。本体の記録も帰るまで消さない | —

## 現地で困ったら（線引き）

- 記録が始まらない：電源を入れ直す（1回）→ SDを抜いて起動（本体だけに記録）→ それでもだめならVer.1とスマホ組に任せる。
- ピット画面に出ない：予備の画面を見る。出なくても記録は残るので走行を優先。
- 音声が聞こえない・雑音：「受ける」「送る」をOFF。テレメトリには影響しない。
- 周回がおかしい：その場で直さない。紙の記録表を正にし、走行後にCSVの軌跡から数え直す。

## 帰ってから

1. ログをdrive_logs\とUSBメモリの2か所に残したまま、SD・本体の記録はしばらく消さない。
2. コースウォークの電波の記録（drive_logs\日付\radio_walk\）を地図で見て、コース上の弱い場所を確かめる。
3. うまくいかなかったこと・その場で決めたことを、ロガー担当へ伝える（次の大会の手順に入れる）。
