ntakao2006-web/RaceCapture/circuit/logger_v2/manufacturing_20260907/PCB_bottom.png

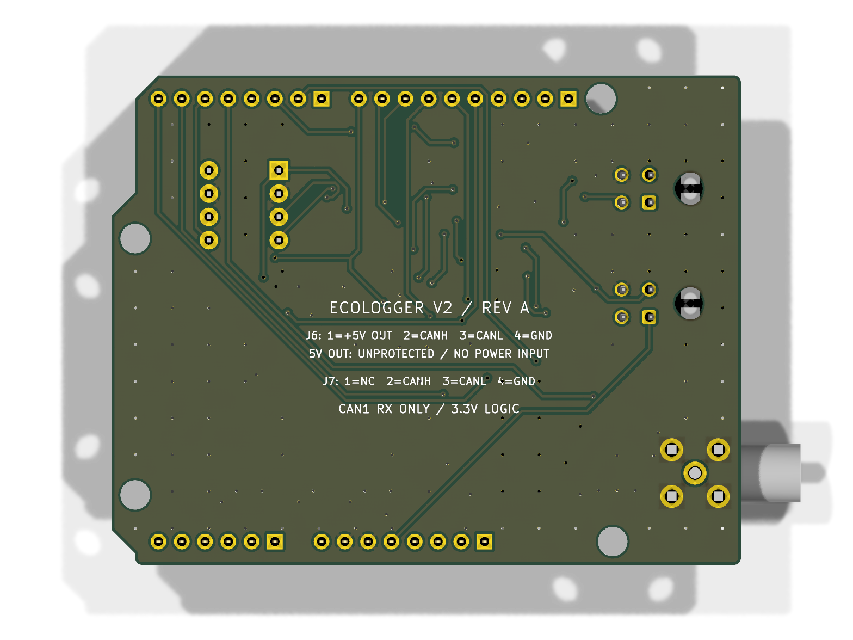
circuit/logger_v2/manufacturing_20260907/PCB_bottom.png
