ntakao2006-web/RaceCapture/circuit/logger_v2/output/gnss_wiring_detail.png

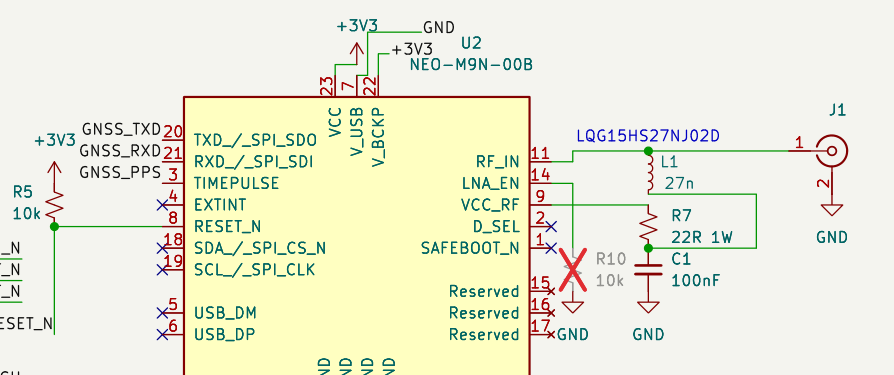
circuit/logger_v2/output/gnss_wiring_detail.png
