ntakao2006-web/RaceCapture/circuit/logger_v2/refs/MAX-M10M_IntegrationManual_84.png

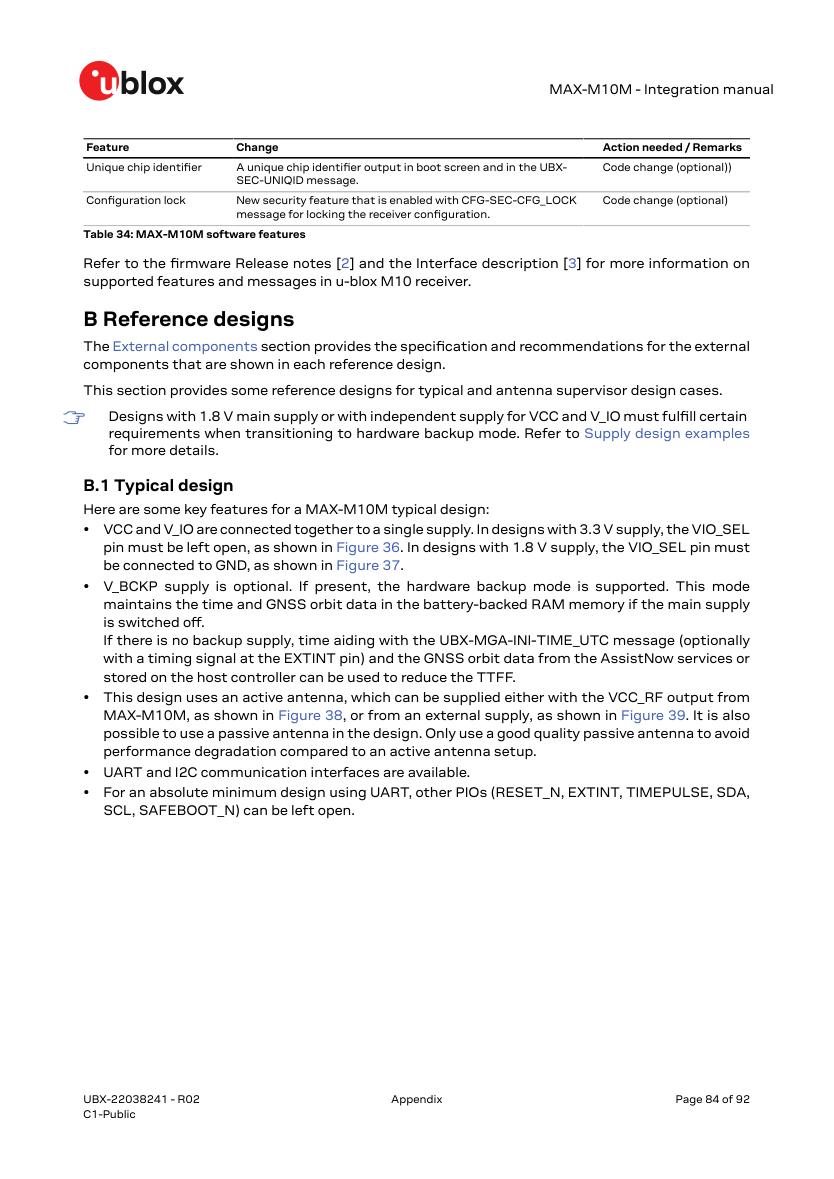
circuit/logger_v2/refs/MAX-M10M_IntegrationManual_84.png
