ntakao2006-web/RaceCapture/firmware/logger_v1/VERIFICATION.md

# 実機検証記録（2026-08-31）

## 2026-09-04 UX250h向けソフトウェア検証（未書込み）

- `logger-v1-ux250h-obd-20260904a` / ESP-IDF 6.0.1のビルド成功。
- C++17 + ASan/UBSanのcore / log_format / gnss_config / gnss_health / vehicle_obd、計5本合格。
- OBD模擬ECUでPID対応ビット、11-bit物理/機能アドレス、ECU固定、250 ms応答待ち、最大10要求/秒、無応答間引き、NRC、遅延応答拒否、0 rpm、Toyota舵角の符号・fraction・不正値を検証。
- Python 17試験合格。firmwareとデモの82チャンネルの名前/順序の一致を検証。既存ログviewer回帰も合格。
- 並列16ビルド時にESP-IDFのesp_lcdでコンパイラ内部エラーが一度発生。並列2で再構築・再リンクに成功。ソースを回避変更せず、最終ビルド成功を確認。
- 新規NVSではOBD要求OFF。開始は明示操作、本体保存、再起動後は保存値へ従う。既存Config blobとIMU校正の形式は変更なし。
- **基板不在のため、書込み、実機応答、バス異常時の実機停止、SD耐久は未検証。** 過去のループバック合格とは別。
- 配布/手順：`artifacts/logger-v1-ux250h-20260904a.zip` / [UX250H_TEST.md](../../EcoCapture/UX250H_TEST.md)。以下は旧実機検証履歴。

最新追記：21時台にIMU内部異常からの復旧を実装し、d版を書込みました。
停止時CSVの全行集計、実機復旧3回、SD記録の継続、RaceCapture表示、約46秒の復帰後観測の
結果と制限は [IMU_RECOVERY.md](IMU_RECOVERY.md) を参照してください。以下は以前の検証履歴です。

## SYS LED常時点灯（2026-09-02）

- SYS LEDを500 ms周期の点滅から、起動後のsampling task動作中は常時点灯へ変更。
- ERR、LOG、GPS、TLM、CANの表示条件は変更していない。
- ビルド表示は `logger-v1-ecocapture-20260902a`。通常ファームをA105のCOM8から書込み、bootloader・partition・applicationのFlashハッシュ照合に成功。
- 書込み前にSDを同期・安全クローズ。再起動後は自動的に記録を再開し、32秒時点で3,233行、SD欠落・SDエラー・IMUエラー0、CANはlisten-onlyを維持。
- 保存先は `artifacts/release_20260902_sys_solid/firmware.bin`。615,056 bytes、SHA-256 `2252311e266c0f97b74a72b3675d4a7ca9314939ae7d8f3176a09132554dea4d`。
- C++17のASan/UBSan付きホスト試験4本とPlatformIO実機ビルドに合格。SYS LEDが点滅せず点灯を維持することの最終確認は基板の目視による。

対象: `circuit/logger_v1` 実装基板、要求基準Git `cf1c711`。
この記録は卓上試験の範囲を示します。実車・全機能の量産品質保証ではありません。

## 書込み（通常ファームウェア）

現在の25 Hz用イメージは末尾の「現行イメージ」を参照してください。以下は最初の統合版です。

- ESP32-S3 revision 0.2、16 MiB Flash、内蔵8 MiB PSRAM。
- COM8、115200 bps。bootloader/partition/applicationを書込み、各領域のハッシュ照合成功。
- 最終application: 580,960 bytes、SHA-256
  `a161974bc0c1a137a1c4311e3ad84bd0a8c798b7c2d66d3be151c3e914d194ab`。
- 保存先: `artifacts/release_20260831/`。既存全FlashのバックアップはREADME参照。
- 既存NVS、回路、配線、`v1_test`、旧DevKit版は変更なし。
- 初回統合作業ではGNSSのOTPを変更していません。その後に承認された25 Hz化は末尾参照。
  SDフォーマット、既存SDログ削除は実施していません。

## 確認済みの内容

- C++17ホスト試験（ASan/UBSan）: CAN抽出、UBX、時刻、IMUデコード、AFRマスク、ラップ計算。
- COM10 USBとCOM8 UARTの改行JSON応答、64チャンネルの有効ビット。
- Windows RaceCaptureアプリを再起動してCOM10へ再接続。
  Config 2.16.1読込み、sample_worker開始、SessionRecorder開始、記録/commit backlog 0を確認。
  アプリを接続したままCOM8からSD記録継続（16,552行、欠落/SDエラー0）を確認。
  アプリは起動・接続した状態で引き渡します。
- BNO055初期化・100 Hz読出し。通信エラー0。
  X/Y生加速度約−0.3 m/s²に対し推定重力も約−0.3 m/s²、線形加速度X/Yはほぼ0 G。
  約2度の傾きの影響と整合し、根拠のない一律+0.3補正は不採用です。
- MAX-M10M: 3D fix、PPS、UTC、NAV-PVTの56 ms周期（17.857 Hz）。
  メーカー通常クロック上限の18 Hz相当。高性能OTPは未設定・未書込み。
- MCP内部ループとMCP→ATA6561の物理ループで各1フレームを受信。
  raw CSVに2 TX_REQ + 2 RXを記録、試験後に車載CAN listen-only復帰を確認。
- 100 Hz CSVと生CANのSD保存、区切り、USB経由の閉じたファイル全体読戻し。
- PCポートを閉じてもSD行数が約100行/秒で増加。
  記録停止/再開、停止後のファイル読出しを確認。
- Luaページ転送、65番目の追加チャンネル、onTick実行、無限ループの期限停止。
  異常スクリプトでもSD/IMUは継続し、空スクリプトへ戻すと正常復帰。
  試験スクリプトは復元済みで、再起動後は空・基本64チャンネルです。
- 専用NVSへの設定保存と再起動後の読出し。

生の検証結果は位置情報を含むためGit除外の `artifacts/` に置いています。
`board_v2_controls.json` が操作/異常Lua試験、`final_closed_read.json` が停止後読出しです。
`racecapture_app_acceptance.log` と `with_racecapture_app.json` がアプリ接続後の証拠です。
最終合格試験は `board_acceptance/verification.json` と対応するCSVを参照してください。
30秒区間で3,057行、平均99.780 Hz、間隔中央値10.000 ms・最大45.348 ms、
SD/CANキュー欠落0、SD/IMU/GNSS通信エラー0、IMUの欠測誤判定0でした。
ソフトウェア周期にはジッタがあり、全行が厳密に10 ms間隔であることは保証しません。
GNSSのiTOW評価は56 msを中心とする±1 msを許容し、平均周期も確認します。
先行40秒区間では725間隔中723が56 ms、55/57 ms各1件で、平均は56.000 msでした。
これは時刻の小さな揺れを許容する判定で、112 msなどの測位抜けは合格にしません。
先行試験の失敗記録も削除せず残しています。

## 未検証・保留

- 最大25 Hzへの恒久OTP設定は、この後のユーザー承認を受け実施済み（末尾参照）。
- BNO055完全校正（校正状態255の保存/復元）、車体軸の取付け方向、実走振動/温度特性。
- LEDの光学的確認（状態ビットは実装、現物の見え方はユーザー確認待ち）。特にPCなしで、
  SD未挿入・正常記録・満杯・抜去・再挿入後をLOG LEDだけで判別できるかは未確認です。
- 車両/センサーハブの確定CAN ID・スケール、全負荷時のCAN欠落、実車OBD。
  初期マッピングは空、NC車種プロファイルとハブ送信は無効です。
- 実コース走行のラップ/予測精度、セクター（未実装）。
- 電源瞬断/SD抜去/満杯での耐障害試験、およびSD未挿入起動後の挿入で自動的に記録開始するかの試験。
  500 ms同期は最大損失の保証ではありません。
- RaceCapture純正の全設定変更API、Android固有USB検出、Wi-Fi/BT/携帯回線。

卓上CAN試験を車両接続中に実行しないでください。

## GNSS 25 Hz化（2026-08-31 追加作業）

- ユーザーの「25Hzにしても安全なら書き込んでほしい」を受け、メーカー規定モードとして実施。
  絶対に故障しないことや断電耐性を保証したものではありません。
- 根拠: MAX-M10M-00B Integration Manual UBX-22038241 R03、2.1.7節・表8。
  通常電源で実施する公式手順で、消費電力が少し増え、クロック設定は元に戻せません。
  実回路のVCC/V_IO=3.3 V、VIO_SEL開放は規定範囲内です。電源電圧のDMM実測はしていません。
- 実機MON-VER: MAX-M10M、ROM SPG 5.10 (7b202e)、PROTVER 34.10。
  個体ID・既存ROMパッチ情報を取得し、書込み前の読取り結果を保存しました。
- 表8の2フレームを各一度だけ送信し、対応するACKを2件確認。
  CFG-RSTによるGNSSハードウェアリセット後、4つの設定値がメーカー指定の
  192/192/192/96 MHzと完全一致しました。独立した再読出しでも同じ値を確認しました。
- 書込み開始前に排他的に作成・同期した `artifacts/gnss25/otp_attempt_once.jsonl` に経過を記録。
  不明な結果に対する自動再試行は行いません。OTP消費量はメーカー記載で18 bytesです。
- 保守用イメージは外し、上記SHA-256の通常ファームウェアへ復帰・書込み照合済み。
  通常ソース/CMakeも元の構成です。OTP書込み機能は通常イメージに含まれません。
  その後の25 Hz読戻し試験で、採取間隔46 msの区間にGPS 1点の抜けが見つかったため、
  SD書込みタスクを採取タスクより低優先度に変更しました。下記の最終イメージが現行版です。
- 証拠: `artifacts/gnss25/provision_result.json`、`readback_independent.json`、
  `normal_firmware_boot.json`。生記録には個体ID・位置情報があるためGit除外です。
- リセット直後は測位とUTC確定を別々に評価しました。位置は3D測位へ復帰。
  UTCは衛星の時刻補正情報を得るまで無効として扱い、未確定時刻を正しい値として記録しません。
  メーカー資料3.7.2〜3.7.5節では、GPSのUTC変換情報は12.5分周期で、
  fullyResolvedが立つまで数分かかる場合があるとされています。
  今回は通常版起動から約6分後、3D測位・UTC有効・GNSS約25 Hzへ復帰しました。
  その時点でSD 36,735行、SD/CANキュー欠落0、SD/IMU/GNSS通信エラー0を確認しました。

保守用 `tools/gnss_maintenance_main.cpp` と `tools/provision_gnss25.py` は再実行を促すものではありません。
この個体へのOTP再書込みは不要です。通常の測位周期は今後もRAM設定で変更できますが、
高性能クロック自体を以前の設定へ戻すことはできません。

### 現行イメージ

保存先: `artifacts/release_20260831_gnss25/firmware.bin`、580,960 bytes。
SHA-256: `08fc4138112d2d6ff77085b2ff22817dd4883ec2630e9df2ee0ed41efd7d6bcb`。
ビルド、COM8経由の書込み、フラッシュ照合を確認しています。
コード変更はSD書込み処理の優先度を6から4へ下げた点です。IMU/GNSS/100 Hz採取は優先度5です。
常用イメージにOTP書込み処理は含めず、起動時には高性能設定の読取りだけを行います。
回路・配線・SD上の既存記録・既存NVSは維持しています。

### 最終実機試験（25 Hz版）

- 60秒の採取と卓上CAN試験を実施し、SDから閉じたCSV全体をCOM10経由で読戻しました。
  全13項目に合格。記録6,063行、平均100.000325 Hz、間隔中央値9.999 ms、最大16.270 ms。
- GNSSは1,517更新、隣接する1,516間隔すべて40 ms（25.000 Hz）。測位の抜けはありませんでした。
  3D測位・UTC有効、IMU 100 Hz・全行有効、SD/CANキュー欠落0、SD/IMU/GNSS通信エラー0、
  sampleLate=0でした。この試験区間の結果であり、実走や全負荷・長期動作の保証ではありません。
- CAN内部/物理ループに合格、生CAN 4行をSDに保存。終了後は車載CAN listen-onlyへ復帰済みです。
- RaceCaptureアプリを再起動し、COM10自動接続、設定2.16.1読込み、サンプル受信・セッション記録開始、
  待ち行列0をアプリログで確認しました。接続したまま引き渡します。
  同時にCOM8から確認した起動172秒時点でGNSS 25 Hz・3D・UTC有効、SD 17,208行、各欠落/エラー0でした。
- 証拠: `artifacts/gnss25/acceptance_final/verification.json`、同フォルダの
  `LEC62AD91_0002.csv` / `LEC62AD91_0002_can.csv`、
  `artifacts/gnss25/racecapture_app.log`、`artifacts/gnss25/with_racecapture_app.json`。
   GNSS取得・UTC待機・優先度調整前の失敗記録も比較用に保存しています。

## 2026-08-31夜：屋外GNSS・SDセッション・USB復帰

この節が現行版です。版は `logger-v1-sd-session-20260831b`、
`artifacts/release_20260831_sd_session_b/firmware.bin`、595,392 bytes。
SHA-256: `b57b49c391bbf0f076315a5c4bcd98f75f9519b21a6723c6b17239e7531c6dd0`。
アプリケーション領域0x10000のみCOM8から書込み・ハッシュ照合しました。
書込み前に記録停止・ファイルクローズ・既存ファイルの読み戻しを確認しました。
ブートローダー・パーティション・NVS・GNSS OTP・回路は書き換えていません。

### 位置と表示

- 屋外に置いたJCA002アクティブアンテナから3D測位。試験中は衛星数5～9、UTCも確定。
- 実測座標を既知地点と照合。具体的な座標や地名は位置情報保護のためリポジトリへ記載しません。
  実座標・位置を含むCSV・アプリDBの抜粋・画像はGit除外の `artifacts/outdoor_20260831/` 内です。
- Windows RaceCaptureのデータベースに緯度・経度が保存され、追加した `Logger GPS / IMU`
  ダッシュボード上にも数値表示されることをウィンドウ画像で確認しました。
  `Searching for Track` はコース未設定/検索であり、測位そのものの失敗ではありません。
- IMU取付軸は未確定、完全校正と実走精度は未検証です。静止アンテナの位置変動を走行軌跡の精度証明には使いません。

### 最終版のSD・採取試験

- `final_b_acquisition/verification.json`: 3,087行、平均100.001996 Hz、最大行間隔14.088 ms。
  GPSは772更新・771間隔すべて40 ms。測位・UTC有効、IMU約100 Hz。
  12判定すべて合格。起動からSD欠落0・SD/IMU/GNSSエラー0、採取遅延カウンター0。
- `final_b_sd/verification.json`: 12判定すべて合格。
  3,371行のCSVと説明ファイルの列順・単位の対応、終了記録の行数一致、JST名と推定起動日時の一致、
  保存終了・同期・論理アンマウント、終了操作の再送、新規ファイルでの再開、既存ファイルの保全を確認。
- SD取り外し待機中もGPS/IMU取得は継続し、SD行数は増えないことを確認。
  SDカードは実際には抜かず、論理アンマウント/再マウントを検証しました。
- USB COMポートを5回閉じて開き直しても、SD記録継続・測位・IMU取得・欠落/エラー増加なし。
- ファイル終了前の切替は固定の待ち時間で推定せず、実際のパス変更を待つよう試験ツールも修正。
  初回の旧版UART読戻し試験は、切替前の大きいファイルを選んだため中断し、native USBで取り直しました。

### USB障害と対策の範囲

- 既存アプリログに、USB通信例外、`cannot join current thread`、再接続後にサンプル取得処理が
  起動しない順序を確認。実行ファイルの改変ではなく、正常終了・再起動を行う外部補助にしました。
- `racecapture_guard.py` はシリアルポートを占有せず、アプリの実記録の進行をSQLiteの読取りだけで確認します。
  25秒停止・USB復帰確認後に正常終了を要求。強制終了せず、10分に3回までです。
- 初回の改良版採取中（20:46ごろ）に本体再起動を伴うUSB切断が1件ありました。原因は未確定です。
  再試験では再現せず、未確定の原因をUSBケーブルだけやソフト不具合と断定していません。
  最終版では再起動理由をSD説明ファイルと状態APIに追加しました。
- UART限定のUSB単独切断診断は、実際にホスト側のUSB接続を外して戻します。
  MCUを再起動せず、SD/GPS/IMUを継続する試験です。機械的な接触不良や電源瞬断の試験ではありません。
  実施結果は `app_reconnect_verification.json` と `artifacts/racecapture_guard.jsonl` に記録しました。
- 最終版でUSBだけを1秒切断し、アプリの取得停止を再現。20:54:59に補助が停止を検出し、
  正常終了後の20:55:02に自動再起動。GPS値の受信・アプリ内記録が再開しました。7判定すべて合格。
  MCUは再起動せず同じSDファイルへ記録を継続し、SD欠落・エラーは0のままでした。
  ユーザーへの引渡し時も補助とRaceCaptureを起動したままにしています。

### PCツールと残る確認

- C++17のASan/UBSan付きcore試験とJST名・日付境界・起動IDの試験、Pythonの復帰判定5試験が合格。
- オフラインHTMLは旧版実CSV6,063行、欠測・不正行、9万行の間引き、描画座標の有限性を自動試験。
  Browserスキルのfile URL制約により実ブラウザーの画面操作による確認は未実施。制約の迂回はしていません。
- アプリ設定は事前バックアップを作り、既存ダッシュボードを残してGPS/IMU用を追加。
  PCツール・アプリとも位置のクラウド送信は追加していません。
- 長時間/全CAN負荷、SD満杯、実際のSD抜去/再挿入、電源断耐性、PCなしの保存終了ボタン、
  IMU完全校正/車体軸、実走の位置精度は残作業です。

## 2026-08-31 22時：GNSS監視・診断のe版

`logger-v1-gnss-health-20260831e`（603,280 bytes）をA105/COM8でアプリ領域だけ書込み、ハッシュ照合済みです。
GNSS UART460800、測位時刻停止の検出、NAV-SAT/MON-RF診断を追加しました。
不可逆なOTP、NVS、SD既存ログ、回路は変更していません。

- ホスト：GNSS監視・メッセージ解析試験、既存core/IMU回帰試験をASan/UBSan付きで合格。
- 実機：90秒の連続観測と前後の区切りを含むCSV9,121行を読戻し。100.00009Hz、最大採取間隔16.711ms。
- 測位：2,281時刻、全て40ms間隔、25Hz。全CSV行で3D位置・UTC有効、問合せ衛星7～10。
- IMU：全行有効100Hz。GNSS/IMU/SDエラー・欠落0。診断11列を全行に保存。
- 保持：書込み前に正常クローズしたSDの56ファイルを、書込み後も同名・同サイズで確認。
- RaceCapture：自動復帰付きで再起動し、e版・更新する緯度経度・GNSS25Hz・UTCValid1・IMU100Hzを実画面で確認。
- 最終確認：起動後252秒、SD累計25,190行、GNSS再設定・破損フレーム・IMU異常・SD欠落/エラー0、記録継続中。

証拠は `artifacts/release_20260831_gnss_health_e/` 内の `upload.log`、`acceptance/verification.json`、
読戻しCSV、`final.json`、`racecapture.png`、`racecapture_after.png`。
受信機の通信停止を実機へ故意に発生させる復旧試験と長時間試験は未実施です。
RF環境の問題を解消したと断定せず、制約は [GNSS_HEALTH.md](GNSS_HEALTH.md) に記録しました。

## 2026-09-05 Lexus UX250h MZAH10 OBD実車

- 実機版 `logger-v1-ux250h-obd-20260905a`。A105/COM8書込み成功、起動後の版読戻し成功。
- 機能アドレス `0x7DF` を維持してECU `0x7E8` からMode 01の8対象PIDすべてを取得。
- 最終統計は要求1935、応答1932、タイムアウト3、TXエラー0、faultなし。CAN/SD drop 0、SD error 0。
- RPMは0 rpmから作動時976～1329 rpm、停止時258→114→0 rpmまで連続取得。水温、油温、車速、スロットル、負荷、吸気温、ECU電圧も実値取得。
- SMA接続後は3D測位・最大24衛星。位置情報はリポジトリへ記載しない。
- OBD側で舵角 `0x025` は未観測。USB-OTG COM10の実データ経路は確認済みだが、この環境ではネイティブ画面画像の自動取得は未実施。

## 2026-09-15 NCEC 17項目対応（書き込み前検証）

- 9月12日の提供実測定義を受信専用デコーダへ反映。既存82chを維持し13ch追加、全95ch。
- `tests/test_ncec.cpp`：ASan/UBSanで換算、左右順、スイッチbit、短いDLC、燃料平均、時刻巻戻り・受信復帰を検証。今回のSD抜粋1,641フレームの再生も合格。
- 既存C++ core / log_format / gnss_config / gnss_health / vehicle_obdの5試験、Python 17試験に合格。
- EcoCapture 0.3.8：102チェック、Windows/ARM64配布、Windows配布版16画面の目視検査に合格。
- 旧実機版では約71秒のCAN受信約694fps、SD約100Hz、GPS約10Hz、IMU約100Hzを確認。エラー・dropは0、sampleLateは4増加。これは新ファームの実機検証ではない。
- 証拠：`artifacts/roadster_20260915/`、`EcoCapture/artifacts/smoke-038-final/`、`EcoCapture/artifacts/package-audit.json`。
- 新版の書き込み、再接続後の追加17項目・SD内容照合、ペダルの操作照合、長時間耐久は未確認。

### 2026-09-15 実機書き込み後

- 車載CAN切り離し・SD安全停止後に書き込み、フラッシュハッシュ照合と版読戻し成功。
- 保存設定（NC/OBD/外部CAN/水平補正）一致、schema97 / 95ch確認。
- CAN再接続後61秒：692.02fps、SD99.97Hz。SD欠落・CANエラー・USB欠落の増加0。
- 起動時SD欠落213、再接続前後CANエラー30は累計に残る。原因未確定であり、起動から完全無欠落と扱わない。
- Windows配布版COM10：17項目＋燃料平均を受信、試験中56追加サンプル、不正フレーム0。画面を目視確認。
- SD読戻し：97列、末尾55行の全18項目値を確認。水温/ペダル冗長値一致、未確定EngineLoad空欄、正常クローズ。
- ブレーキ・クラッチはユーザーの踏み込み/解放と対応する0→1→0を確認。サイドブレーキ1を保持。
- 通常のEcoCaptureを0.3.8へ切替済み。スタートメニュー起動先も更新。
- 証拠：roadster_20260915/{upload.log,after_flash.json,settings_readback.json,live_new_firmware.json,new_sd_verification.json,switch_check.json}、EcoCapture/artifacts/ncec-live-20260915/。
