ntakao2006-web/RaceCapture/test_drive_20261024_night.md

# 10/24夜の試験走行（ピット画面の修正の確認）

> 2026-10-24夜。もてぎで起きた「ピットのラップが約30秒遅れる」「二輪の残り周回が1つ多い」「余裕が見えない」の修正（ER-8-10、5Bへ反映済み）を、実際に走って確かめる。
> 後でドライバーのアプリを変えたとき（ER-11-21）も、同じ手順で試す（4章）。

## 0. 準備

| もの | 使い方 |
|---|---|
| **Pixel 9a**（試験用。部屋`android-test`、送り先は5B） | 走る側。**10/25 0時に最新のAPK（二輪の2台と同じもの、規定時間・余裕を送る版）を入れた**。設定・ラップ・IMU校正は入れる前とバイト単位で同じ。主の送り先は5Bの`android-test`（5Bが受け付けることも確認）、予備はわざと不通のアドレス |
| ピット役のスマホ（**ドコモ回線**。手元にソフトバンク本体の回線は無い） | Grafanaで部屋`android-test`を開く。もてぎではY!mobileがとても弱く、ソフトバンクの人は大丈夫だった（Y!mobileは混雑時に後回しにされやすい）。明日の朝、もてぎでドコモとY!mobileの両方で「この画面のデータ」を見て、速い方をピットに使う |
| ストップウォッチ | ラインを通った瞬間に押す（ピット画面に出るまでの遅れを測る） |

- **本番の3台（A54・S10・Pixel 9 Pro XL）は使わない**。ラインはもてぎの基準0115のまま、明日まで触らない
- **試験中はmajestaのVer.2の電源を切っておく**。Pixel 9aにはVer.2のWi-Fi名（EcoLogger-majesta）が入ったままで、近くでVer.2が動いているとアプリがつながり、「ラップをリセット」でVer.2の周回もリセットし、試験用の規定周回数・規定時間をVer.2に書き込んでしまう
- **Ver.2（majesta）も今夜はつながない**。今夜変えたのはサーバー側だけで、Ver.2の周回の数え方は変えていない（今日の練習走行の7周を正しく数え、その実データを新しいピット画面に流して確認済み）。Ver.2で試すにはラインを変える必要があり、戻し忘れると本番で周回を数えられない
- コースは自宅の近くで、1周1〜3分で回れる道（ブロックを回るなど）。ラインは停車してから登録する
- **Pixel 9aには道の駅もてぎ周辺の3本がすでに入っている**（10/25 0時に端末から読んで確認）：Ver.2から読み込んだ基準**75CB**（10/24 2:14、前夜の試走でVer.2が3周を数えたもの）、ロック済み、クラスCN二輪（3周・16:27.36・余裕30秒）、周回0・スタート前。3本とも道の駅もてぎから約250m以内（スタートは「道の駅もてぎ」の信号の近く、コントロールは道の駅の約240m西、ゴールは道の駅の敷地の南端）。間隔はスタート→コントロール約120m、コントロール→ゴール約190m。**その周辺で走るなら、ラインを登録し直さず、このまま試験B（3本）から始めてよい**（合格の目安の規定時間は「規定 16:27.4　余裕 30秒」になる）

## 1. 試験A：コントロールラインだけ（最初の簡易試験）

1. 停車中にアプリの設定を開く
   - クラス「手入力」、規定周回数**3**、規定時間**10:00**、余裕**30秒**にして、大会の設定をロックする
   - ラインは**コントロールラインだけ**を、その位置で「現在地にする」。スタート・ゴールは入れない（最初のコントロール通過でスタートし、3周後のコントロールでゴールになる）
2. 「ラップをリセット」→ 記録開始 → ピット役のスマホでGrafanaの部屋`android-test`を開く
3. 3周走る。ラインを通るたびにストップウォッチを押す

| 見るところ（ピット画面の「周回・時間」） | 合格 |
|---|---|
| 周回 | 1周目に「**1 / 3**」、通過ごとに「2 / 3」「3 / 3」 |
| 規定・余裕 | 「**規定 10:00.0　余裕 30秒**」が出る（オレンジの「まだ届いていません」が出ない） |
| 通過の表・前の周 | 通過から**5秒以内**に行が増え、ラップがアプリの表示と0.1秒単位で合う |
| この周・経過 | 秒が止まらずに進む。アプリの表示との差が2秒以内 |
| 平均 | この周・スタートからの平均が、実際の速さと大きく違わない（0や極端な値が出ない） |
| この画面のデータ | 10秒以内 |
| ゴール | 3周目の通過で「ゴール」「3 / 3」になり、経過が止まる。アプリの競技時間と合う |

4. 1周の途中で、ピット役のスマホを**30秒だけ機内モード**にして戻す
   - 合格：その間も経過・この周が進み続ける。戻ると「この画面のデータ」が10秒以内に戻る。通過の表に抜けが無い

## 2. 試験B：3本のライン（本番と同じ形）

試験Aが通ったら、ラインを3本にする（ラップをリセットしてから）。

- スタート：コントロールの50〜100m手前。コントロール：毎周通る位置。ゴール：コントロールの50〜100m先
- 規定周回数3・規定時間10:00・余裕30秒のまま、同じように3周
- 合格：試験Aの表と同じ。加えて、通過の表に「スタート」「コントロール」×2「ゴール」が並び、ゴールで止まる

## 2a. 結果（10/25 0:48〜0:53、Pixel 9a・道の駅もてぎの3本・CN二輪）

- 周回の表示（1 / 3）・規定時間と余裕の表示：問題なし（ユーザー）
- 通過からピットの表に出るまで：だいたい5秒以内（ユーザーの体感）。5Bのブリッジが通過を出したのは、通過時刻からスタート6.0秒・コントロール2.3秒・0.6秒・ゴール3.5秒後（これに毎秒の配信とピットの回線の分が足される）
- ラップ：1周目86.8秒、2周目134.6秒、3周目14.5秒。3周目が短いのは、このコースではゴールラインがコントロールの約190m先にあり、2回目のコントロールの直後にゴールを通ったため（ゴールは規定周回数−1回のコントロールの後に有効になる。もてぎのゴールはピットレーン側なので、本番では1周分走ってから通る）。不具合ではない
- 5Bに届いたデータ：0.1秒ごとの行に抜けなし、2秒以上同じ位置で止まった区間もなし。スマホ→サーバーの遅れは中央値0.35秒・最大3.2秒
- **地図の位置が十数秒止まってから飛んだ**：サーバーにはデータが途切れずに届いていたので、詰まったのは**サーバー→ピットのスマホ**の間か、**ピットのスマホのブラウザが画面を止めた**（画面が暗くなる・別のアプリやタブに切り替えると止まる）のどちらか。地図は届いた時刻に合わせて動かす作りなので、まとめて届くと一気に飛ぶ。次は止まったときに「周回・時間」の一番下の「回線」を見る：赤なら回線、0〜1秒のままなら地図のページの問題
- 機内モードの試験はまだ

## 2a-2. 通話をつなぎ、離れて試した結果（10/25 1:10〜1:14、Pixel 9a）

- 概ねうまくいった（ユーザー）。サーバーには、スタート1:10:22、1周目1:45.8、2周目1:40.0、ゴールまで抜けなく残っていた
- **機内モード**：Grafanaが「オフライン」になり、「周回・時間」の枠もオフラインの表示になって数字が全部消えた。通信を戻すと、タイムは正確に出た
- 仕組み（Claudeが確認）：
  - 正しい状態はサーバー（5Bのブリッジ）が持っている。スタート時刻・各通過・規定時間は、ロガーのGNSS時刻から作ったもの。ピットのページは表示するだけで、自分では数えていない
  - ページは、サーバーとの接続が切れると2秒ごとにつなぎ直す。つながった瞬間にサーバーが状態を丸ごと送り、ページは「スタート時刻から今まで」を自分の時計（サーバーの時刻で補正）で計算し直す。切れていた間の分が溜まってずれることはない
  - Grafanaの5秒ごとの更新では、ページは読み込み直されない（20秒以上、同じページのままだった）
  - 5Bのブリッジを11秒止めて試したところ、ページは開いたまま、止まった間も数字は残り、戻ると自動でつなぎ直した（「回線 0.0秒」に戻る）
  - 「オフライン」で数字が消えたのは、このページの動きではない（このページは切れても数字を消さない）。ブラウザかGrafanaが、枠の中をブラウザの「オフライン」の画面に差し替えたと考えられる。ブラウザは通信が戻るとその画面を自動で読み込み直すので、ページが新しく開き、サーバーから状態を丸ごと受け取って正しいタイムに戻った。どちらが差し替えたのかは確かめていない
- **弱点**：5Bのブリッジ自体が走行中に再起動すると、再起動より前の通過の行が消え、平均も「—」になる（周回・経過・規定までは、次のデータが届けば戻る）

## 2b. Ver.2での試験（ラインを入れ替えて、走った後に元へ戻す）

Ver.2のラップの設定（3本のライン・向き・規定周回数・規定時間・余裕）は、UNO Qの`lap.json`1つにまとまっている。

1. **スマホをVer.2につながせない**：Pixel 9aとA54はWi-Fiを切るか車から離す（A54は走行前ならロガーのラインに自動で追従してしまう。Pixel 9aはロガーに試験の設定を書き込んでしまう）
2. Ver.2を起動し、PCとつなぐ（USBのadbかテザリングのssh）。**Claudeが`/api/lap`を読んで控えを取り**（PCの`drive_logs/`に保存。位置を含むのでリポジトリには入れない）、今の基準番号が**0115**であることを確かめる
3. Claudeが`/api/lap`へ道の駅もてぎの3本（Pixel 9aの基準75CBと同じ座標、幅30m、向きは走って覚えさせる）と、規定周回数3・規定時間16:27.36・余裕30秒を書き込み、周回をリセットする
4. PCから外して走る（3周）。ピット画面は部屋`majesta`（Ver.2の送り先のまま。試験の周回は明日グリッドでリセットすれば消える）
   - 見るところは試験Aの表と同じ。加えて、地図が止まったら「回線」の値を見る
5. 戻ったら再びPCとつなぎ、**送り先も主＝先輩のサーバー・予備＝5Bへ戻し**、**Claudeが控えの設定をそのまま`/api/lap`へ書き戻し、周回をリセットする**。**基準番号が0115に戻ったこと**と、規定周回数7・規定時間39:20.11・余裕30秒・3本の固定の向きが控えと同じことを確かめる
6. 明日の朝、A54をVer.2につないで「ラインがロガーと違います」が出ないことを確かめる（出たら手順書のとおりQRを読み直す）

- **10/25 1:42、2〜3まで実施**（USBのadb）：
  - 入れ替える前のVer.2：もてぎの3本（基準**0115**、向きはスタート151.5°・コントロール154.2°・ゴール151.0°）、7周・39:20.11・余裕30秒、練習走行の7周が残った状態
  - 控えは3か所（中身は同じ`64704b81…`）：UNO Qの`/home/arduino/lap-motegi-backup-20261025.json`、PCの`drive_logs/lap_backup_20261025/lap.json`（`/api/lap`の答えは`api_lap.json`）、Claudeの作業フォルダ
  - 書き戻し用：UNO Qの`/home/arduino/lap-motegi-restore-20261025.json`（PCは`drive_logs/lap_backup_20261025/lap_restore_motegi.json`）
  - 書き込んだもの：道の駅もてぎの3本（向きなし）・3周・16:27.36・余裕30秒、周回をリセット → **基準75CB**（Pixel 9aと同じ）、0 / 3・スタート前
  - 書き戻すときのコマンド（UNO Qの中で。`X-EcoCapture: 1`は管理画面の操作に必要な目印）：
    `curl -X POST -H 'Content-Type: application/json' -H 'X-EcoCapture: 1' --data @/home/arduino/lap-motegi-restore-20261025.json http://127.0.0.1:8080/api/lap` → `curl -X POST -H 'X-EcoCapture: 1' http://127.0.0.1:8080/api/lap/reset` → `/api/lap/code`の`id`が**0115**であることを確かめる
- **10/25 2:53、Ver.2の送り先も入れ替えた**（ユーザー判断、今夜の試験だけ）：先輩のサーバー→5Bの複製が流れず、Ver.2がLTEの瞬断で主の先輩のサーバーへ戻るとピットに出なくなるため。主＝5B（`wss://rock-5b.tail5a9705.ts.net/ws/audio/majesta`）、予備＝先輩のサーバー（`wss://ecorun.marusoftware.net/ws/audio/majesta`）。`/api/podium`へ送り先の2項目だけを保存し、ほかの設定（送信ON・LTE・Podiumへ直接はOFF）は変えていない。約20秒で5Bへ送信を始め、5Bの地図に位置が出ることを確認（約2.4秒遅れ）
  - 入れ替える前の設定の控え：PCの`drive_logs/lap_backup_20261025/podium_before_5b.json`
  - 戻すとき（UNO Qの中で）：`curl -X POST -H 'Content-Type: application/json' -H 'X-EcoCapture: 1' --data @/home/arduino/podium-restore-senpai-20261025.json http://127.0.0.1:8080/api/podium` → `/api/podium`の`server_url`が先輩のサーバー、`backup_server_urls`が5Bであることを確かめる
- **10/25 3:31、本番の設定へ戻した**（ユーザー依頼、USBのadb）：控え3つの中身が取ったときと同じことを確かめてから、①ラインを`lap-motegi-restore-20261025.json`で書き戻し → **基準0115**、3本の座標・向き（154.2°・151.5°・151.0°）・幅30m・7周・39:20.11・余裕30秒が1:42の控えと同じ（違うのは「ラインを変えた時刻」`set_at`だけで、10/24 7:42→10/25 3:31。A54は基準番号だけを見比べるので警告は出ない）②送り先を主＝先輩のサーバー・予備＝5Bへ（設定の全項目が2:53の控えと同じ）③周回をリセット（0 / 7・スタート前）。戻した直後に先輩のサーバーへ送信中（1番目）。戻す前は、試験中に5Bとの通信が途切れたらしく予備の先輩のサーバーへ送っていた。戻す前後の状態はPCの`drive_logs/lap_backup_20261025/`
- **10/25 8:59、大会2日目はVer.2の主の送り先を5Bにした**（ユーザー判断、USBのadb）：ピットの画面（Grafana・地図・ブリッジ）が5Bにあり、先輩のサーバー→5Bの複製に頼らないため。主＝5B、予備＝先輩のサーバー（`/home/arduino/podium-5b-primary-20261025.json`を`/api/podium`へ。送り先の2項目だけで、ほかの設定は変えていない）。書き込む直前は先輩のサーバーへ送信中（1番目）。8:59:25に5Bへ直接つながり、9:00:22の行が約1秒後に5Bのファイルにあることを確認。変える前の状態の控え：PCの`drive_logs/lap_backup_20261025/podium_before_5b_0859.json`。戻すときは3:31と同じく`podium-restore-senpai-20261025.json`を`/api/podium`へ。複製が届いているかは`tools/home_telemetry/compare_replication.py`で数えられる（8:43時点では両方向とも100%、昨夜2:20〜3:30は大きく欠けたまま）
- **10/25 10:27、5Bのサーバーを先輩のPR#13のイメージへ入れ替えた**（ユーザー依頼、試し。`ghcr.io/tmcit-ecorun/ecorun-logger-server:sha-72ed244d85400584e887465b9dd203cf90edf0ec`、`397facf`＋`cluster.rs`の無通信監視だけ）。戻すときは5Bで`cd /opt/ecorun-logger && sudo cp compose.yaml.bak-20261025-latest compose.yaml && sudo docker compose up -d`（元は`:latest`＝`sha256:cdb1a391…`、`397facf`）。起動直後の3分で複製の接続が4回切られた（昨夜の再起動と同じ形、`peer websocket closed`）。Ver.2は30秒後（10:27:49）に5Bへ戻り、約1秒遅れで届いている
  - **つなぎ直しで、先輩のサーバーの履歴（昨夜の試験走行の行）が今のmajestaのファイルへ混ざって書かれ、5Bのブリッジがそれを今の走行として周回を数えた**（10:29、7周・3周の偽の通過）。ブリッジに「その部屋で取り込んだ最新の行より古い行は捨てる」処理（`Bridge.only_new`）を足して10:33に再起動し、majestaは0周（ロガーの`LapCount` 0・残り7と一致）に戻った。元のブリッジは5Bの`/home/ntakao/home_telemetry/live_bridge.py.bak-20261025-1035`。偽の通過はVictoriaMetricsの`ecorun_lap_at`（Grafanaの「通過記録（24時間分）」）に、レース欄が01:02・03:13・03:20の行として残っている（消していない）
- 注意：USBを抜き差ししたときにVer.2が丸ごと再起動したことがある（10/24 11:45）。試験では構わないが、つなぐのは電源を入れてから1回、外すのも1回にする

## 3. 走った後

- 走り始め・ゴールの時刻と、気になったこと（何周目の何が変だったか）をClaudeに伝える。5Bの記録とアプリのCSVを突き合わせて確かめる
- 試験用の部屋`android-test`のデータは残しておいてよい（本番の部屋には混ざらない）

## 4. ドライバーのアプリを変えたときの試験（ER-11-21、内容が決まってから）

アプリを変えたら、**本番の3台に入れる前に**Pixel 9aで次を通す。

1. 試験A（コントロールだけ）を**四輪のクラス**で通す：新しい画面の表示に加え、周回・通過・ゴールの判定が変わっていないこと
2. 試験B（3本）を**二輪のクラス**で通す：二輪の画面が今と同じであること（同じAPKで画面だけが変わる作りのため）
3. 通ったら本番の3台へ同じAPKを入れ、**入れる前後で設定とラップの保存が同じ**ことを確かめてから、ラインを基準0115のまま使う
