ntakao2006-web/RaceCapture/android-logger/app/src/test/resources/supercub_20261025_speed.csv

t_s | speed_kmh
0 | 14.98
1 | 16.49
2 | 13.14
3 | 16.45
4 | 19.69
5 | 22.72
6 | 25.24
7 | 27.32
8 | 32.22
9 | 34.96
10 | 36.11
11 | 37.76
12 | 39.28
13 | 40.82
14 | 40.57
15 | 42.37
16 | 43.02
17 | 41.08
18 | 38.02
19 | 39.35
20 | 37.22
21 | 34.42
22 | 33.95
23 | 32.18
24 | 30.31
25 | 29.59
26 | 28.19
27 | 27.61
28 | 27.58
29 | 26.5
30 | 25.96
31 | 26.21
32 | 26.39
33 | 26.53
34 | 26.82
35 | 26.78
36 | 26.1
37 | 25.45
38 | 24.8
39 | 23.98
40 | 23.18
41 | 24.01
42 | 23.62
43 | 24.88
44 | 26.06
45 | 26.68
46 | 27
47 | 27.11
48 | 26.78
49 | 26.64
50 | 27.18
51 | 27.72
52 | 27.76
53 | 28.15
54 | 28.37
55 | 28.26
56 | 28.44
57 | 28.26
58 | 27.76
59 | 27.76
60 | 25.88
61 | 25.06
62 | 24.7
63 | 23.08
64 | 22.46
65 | 20.63
66 | 21.24
67 | 22.46
68 | 22.79
69 | 23.83
70 | 23.83
71 | 26.42
72 | 30.46
73 | 29.38
74 | 26.03
75 | 27.47
76 | 29.45
77 | 29.34
78 | 29.23
79 | 28.58
80 | 28.73
81 | 27.86
82 | 26.93
83 | 27
84 | 25.24
85 | 22.97
86 | 22.03
87 | 20.95
88 | 22.1
89 | 22.18
90 | 21.28
91 | 19.98
92 | 19.51
93 | 18.29
94 | 17.46
95 | 17.71
96 | 17.42
97 | 17.24
98 | 16.52
99 | 17.68
100 | 18.22
101 | 18.58
102 | 18.22
103 | 18.4
104 | 18.18
105 | 18.11
106 | 18.22
107 | 19.04
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
