ntakao2006-web/RaceCapture/outputs/racecapture_unoq_20261002/gpu_display_verified.png

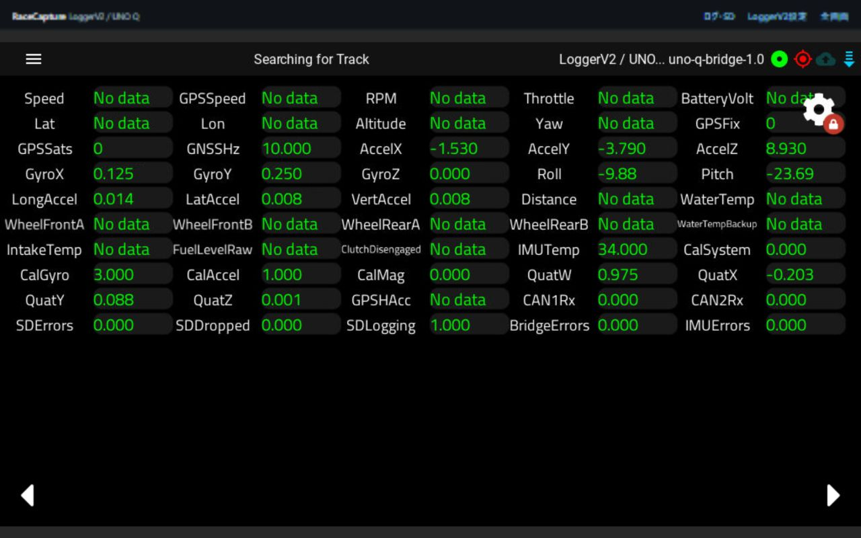
outputs/racecapture_unoq_20261002/gpu_display_verified.png
