ntakao2006-web/RaceCapture/ogata_share_20261024_issues_reply.md

# 「既存の不具合と注意点」への返信（2026-10-25 0時）

緒方さんへ。`existing-issues.md`（RaceCapture `c5fb064`・サーバー `397facf` 時点）を、こちらのコードと記録で確かめました。大筋はすべて合っていて、明らかな間違いはありませんでした。
そのあと、同じ夜にこちらで直したものがあるので、今の状態（RaceCapture `15ef880` 以降、5Bへ反映済み）と合わせて返します。

## まとめ

| 項目 | 結論 | 今の状態 |
|---|---|---|
| A1 行の形の食い違い | **実際に起きている**（推測ではない） | 未対応（先輩のサーバー側の話） |
| A2 ピットの経過が約30秒遅れ | 合っている | **対応済み**（5Bへ反映） |
| A3・A4 | 矛盾なし | ― |
| A5 時計ページの見かけの遅れ | **分析は正しい** | **対応済み**（5Bへ反映） |
| B1・B4・B6 | 合っている | B4はG-Gを画面から外したので解消 |
| B2 | 中身は合っている（見出しと本文が食い違い） | ― |
| B3 前半（予備への切り替え） | 合っている | 未確認のまま |
| B3 後半（同期分がファイルに書かれるか） | **確認済み**だった | こちらの資料の「未確認」を直した |
| B5 後半（numpy・音声サービス） | ― | **対応済み** |
| C | 矛盾なし | 「決勝」のフォルダ名の件、こちらの記録も練習走行に直した |

## A. 今回の調査で見つけたもの

**A1**：正しく、しかも実際に起きています。
- 先輩のサーバーのログに「skipping Podium sample …」がほぼ1行ごと（約5件/秒）に出ています。33項目に対して、1行が30要素しかありません。
- 原因は`TimeLimit`・`Margin`の間引きだけではありません。GNSSが無い行・周回の項目・油温などで、もともと欠けていました。
- 影響は先輩のサーバーの地図とテレメトリ表示だけです。ピットのGrafana・地図はブリッジ経由なので影響しません。
- ツールの読み口を「生の行とメタ情報を自分で読む」か「ブリッジ経由」にする方針は、そのとおりでよいと思います。

**A2**：対応済みです（5Bへ反映済み）。
- 時計に加えて、**周回・ラインの通過・ラップ・規定時間・余裕・平均速度**も、ブリッジから毎秒押し出す形にしました。
  - 経過時間だけでなく、ラップの欄も問い合わせ方式で約30秒遅れていました。その遅れたラップを信じた指示で、規定時間ぎりぎりのゴールになっています。
- 周回の表示は「1 / 3」の形に変えました。ロガー・アプリとも`LapsLeft`を「規定周回数−完了周回数」で送っていて、1周目に「残り3」と出ていたためです。

**A5**：分析どおりでした。直して5Bへ反映済みです（`15ef880`）。
- 時計のずれを測る時間幅を、60秒から10分に広げました。
- 端末の時計が設定し直されたときや、スリープから戻ったときは測り直します。
- 一番下に「回線 n秒」（サーバー→この画面の今の遅れ）を出し、5秒を超えたら赤にしました。
- **残る弱点**：ページを開いた時からずっと遅い回線だと、時計のずれと見分けられず、遅れは小さく出ます。直すには、ブリッジとの往復時間を測る仕組みが要ります。

## B. チームの資料に記録されているもの

- **B2**：見出しは「Podiumに値は届くが画面に出ない」ですが、本文は「Podiumをやめた」ことだけです。中身はこちらの判断と同じです。
- **B3 前半**：合っています。10/24までに試せたのは、送り先を存在しないアドレスにして、Podiumへ直接送るほうへ移るところまでです。
- **B3 後半**：**確認済み**でした。10/24 10:29に送り先を先輩のサーバーへ切り替えたあとも、5Bは複製されたデータを新しいファイルに書き続け、5BのGrafanaもそのまま更新されました。サーバーのコードでも、複製は`telemetry.append`を通ります。資料に「未確認」が残っていたのはこちらの直し忘れで、`server_deploy_grafana_x86.md`・`maruo_share_20261024_grafana.md`を直しました。
- **B4**：ピット画面からG-Gを外したので解消しました（エコランでは要らないという判断）。
- **B5 後半**：numpyと音声の常駐サービスは、そのあと入れてあります。

## C. データの注意

- 矛盾はありません。
- ラインのずれの向きは、こちらは「登録した位置が既定値より手前（北）」と書いていて、同じことを逆の向きから書いています。
- majestaの「決勝」フォルダが練習走行である件は、こちらの記録で「決勝」と書いていた箇所を直しました。

## 走行戦略ツールの読み口に使えるもの（今夜追加）

ブリッジ（5B）のWebSocketから、次の2つが取れます。どちらもログイン不要で、ピット画面と同じ経路です。

**1. 時計とラップ（毎秒1回、約0.8KB）**
- 接続先：`wss://rock-5b.tail5a9705.ts.net/live/ws?room=majesta&kind=clock`
- `{"clock": {...}, "now": <サーバー時刻ms>}`の形で届きます。`clock`の中身は次のとおりです。

| 項目 | 中身 |
|---|---|
| `start`・`end` | スタート・ゴールの時刻（ms、GNSS時刻から） |
| `limit`・`margin` | 規定時間・余裕（秒） |
| `lap` | 走行中の周 |
| `count` | 完了周回数 |
| `total` | 規定周回数 |
| `lap_start` | この周の始まり（ms） |
| `last_lap` | 前の周（秒） |
| `passes` | 各ラインの通過`[{n: 周, k: start/control/goal, t: 時刻ms, s: ラップ秒, v: 周の平均km/h}]` |
| `lap_avg`・`race_avg` | この周の平均・スタートからの平均（km/h） |
| `data_t` | 最新データの時刻（ms） |

**2. 10Hzの値**
- 接続先：`wss://rock-5b.tail5a9705.ts.net/live/ws?room=majesta&fields=Speed,Latitude,Longitude`
- `fields=`に要る項目だけを書けば、その項目だけが届きます。

**注意**
- **平均速度**：ブリッジが速度を時間で積算しています（ロガーは距離を送らないため）。
  - データが途切れた区間は、5秒超〜15分まで、前後の速度の平均でつなぎます。今夜までは数えていなかったので、カブの走行で19.9km/h（実際25.6）と低く出ていました。
  - 周の途中から数え始めた平均（ブリッジの再起動など）は出しません。
  - 今日のmajestaの7周の平均は24.1・22.9・22.9・27.8・28.8・28.3・22.5km/hです。全体は25.1km/hで、規定距離÷競技時間の25.07と合います。
- **遅れ**：ブリッジは表示を滑らかにするため、10Hzの値を少し待ってから流し直します（A1の「ブリッジの待ち時間」のとおり）。時計とラップ（`kind=clock`）は待たずに毎秒送ります。
- **「ゴール」の判定**：`RaceTime`だけが届き、`ElapsedTime`が来なくなったときに「ゴール」とみなします。
