ntakao2006-web/RaceCapture/queuelogs/debugtool.txt

1 1788032965014 GEN4_CONNECT_DIAGNOSTICS:MPLABCommTool is NOT null
1 1788032965015 GEN4_CONNECT_DIAGNOSTICS:AttachedToolPID = 9018, AttachedToolVID = 4d8
1 1788032965015 GEN4_CONNECT_DIAGNOSTICS:transport type = USB
1 1788032965015 GEN4_CONNECT_DIAGNOSTICS:AttachedToolPID = 9018, AttachedToolVID = 4d8
1 1788032965096 com.microchip.mplab.mdbcore.RealICETool.RIDbgToolCom
1 1788032965096 GEN4_CONNECT_DIAGNOSTICS:Before MPLABCommTool.Connect()
1 1788032965098 GEN4_CONNECT_DIAGNOSTICS:After MPLABCommTool.Connect()
1 1788032965117 GEN4_CONNECT_DIAGNOSTICS:Adding new plug and play observer com.microchip.mplab.mdbcore.RI4Tool.RI4ToolBase$RI4PlugNPlayObserver@13579834
1 1788032965117 GEN4_CONNECT_DIAGNOSTICS:Begin PlugNPlayObservers list dump:
1 1788032965117 GEN4_CONNECT_DIAGNOSTICS:com.microchip.mplab.mdbcore.RI4Tool.RI4ToolBase$RI4PlugNPlayObserver@13579834
1 1788032965117 GEN4_CONNECT_DIAGNOSTICS:End PlugNPlayObservers list dump:
1 1788032965118 GEN4_CONNECT_DIAGNOSTICS:Registering for alternate PNP notifications. CommPnPCriteria.cPIDList = [9019, 901c, 2180], CommPnPCriteria.cSerialNumber = 021038102ryn014624

1 1788032965667 GEN4_TO_CONTROLLER_LOG:GEN4_INIT_INT_LOG_PIC18F26Q84 Pre:init
1 1788032965667 GEN4_TO_CONTROLLER_LOG:GEN4_INIT_INT_LOG_PIC18F26Q84 Payload
1 1788032965668 GEN4_TO_CONTROLLER_LOG:GEN4_INIT_INT_LOG_PIC18F26Q84 DeviceInfo: Values:
1 1788032965669 GEN4_TO_CONTROLLER_LOG:GEN4_INIT_INT_LOG_PIC18F26Q84 DeviceInfo: pcAddress = 000004f9, Vpp = 9.00, useRowEraseIfVoltageIsLow = true, voltageBelowWhichUseRowErase = 2.10, deviceName = PIC18F26Q84, programmerType = PIC18ENH_V2
1 1788032965669 GEN4_TO_CONTROLLER_LOG:GEN4_INIT_INT_LOG_PIC18F26Q84 DeviceInfo: MemInfo values:
1 1788032965669 GEN4_TO_CONTROLLER_LOG:GEN4_INIT_INT_LOG_PIC18F26Q84 DeviceInfo: mask = ffff, exists = true, startAddr = 00000000, endAddr = 0000ffff, rowSize = 0080, rowEraseSize = 0080, addrInc = 0002, widthProgram = 0002
1 1788032965669 GEN4_TO_CONTROLLER_LOG:GEN4_INIT_INT_LOG_PIC18F26Q84 DeviceInfo: mask = 00ff, exists = true, startAddr = 00300000, endAddr = 00300023, rowSize = 0001, rowEraseSize = 0000, addrInc = 0001, widthProgram = 0001
1 1788032965669 GEN4_TO_CONTROLLER_LOG:GEN4_INIT_INT_LOG_PIC18F26Q84 DeviceInfo: mask = 0000, exists = false, startAddr = 00000000, endAddr = 00000000, rowSize = 0000, rowEraseSize = 0080, addrInc = 0000, widthProgram = 0000
1 1788032965669 GEN4_TO_CONTROLLER_LOG:GEN4_INIT_INT_LOG_PIC18F26Q84 DeviceInfo: mask = 00ff, exists = true, startAddr = 00380000, endAddr = 003803ff, rowSize = 0001, rowEraseSize = 0000, addrInc = 0001, widthProgram = 0001
1 1788032965669 GEN4_TO_CONTROLLER_LOG:GEN4_INIT_INT_LOG_PIC18F26Q84 DeviceInfo: mask = ffff, exists = true, startAddr = 00200000, endAddr = 0020003f, rowSize = 0001, rowEraseSize = 0000, addrInc = 0002, widthProgram = 0002
1 1788032965669 GEN4_TO_CONTROLLER_LOG:GEN4_INIT_INT_LOG_PIC18F26Q84 DeviceInfo: mask = ffff, exists = true, startAddr = 00200000, endAddr = 002403ff, rowSize = 0080, rowEraseSize = 0080, addrInc = 0002, widthProgram = 0002
1 1788032965669 GEN4_TO_CONTROLLER_LOG:GEN4_INIT_INT_LOG_PIC18F26Q84 DeviceInfo: mask = 0000, exists = false, startAddr = 00000000, endAddr = 00000000, rowSize = 0000, rowEraseSize = 0000, addrInc = 0001, widthProgram = 0001
1 1788032965669 GEN4_TO_CONTROLLER_LOG:GEN4_INIT_INT_LOG_PIC18F26Q84 DeviceInfo: mask = 0000, exists = false, startAddr = 00000000, endAddr = 00000000, rowSize = 0000, rowEraseSize = 0000, addrInc = 0000, widthProgram = 0000
1 1788032965669 GEN4_TO_CONTROLLER_LOG:GEN4_INIT_INT_LOG_PIC18F26Q84 DeviceInfo: mask = 0000, exists = false, startAddr = 00000000, endAddr = 00000000, rowSize = 0000, rowEraseSize = 0000, addrInc = 0000, widthProgram = 0000
1 1788032965669 GEN4_TO_CONTROLLER_LOG:GEN4_INIT_INT_LOG_PIC18F26Q84 DeviceInfo: mask = 0000, exists = false, startAddr = 00000000, endAddr = 00000000, rowSize = 0000, rowEraseSize = 0000, addrInc = 0000, widthProgram = 0000
1 1788032965669 GEN4_TO_CONTROLLER_LOG:GEN4_INIT_INT_LOG_PIC18F26Q84 DeviceInfo: mask = 0000, exists = false, startAddr = 00000000, endAddr = 00000000, rowSize = 0000, rowEraseSize = 0000, addrInc = 0001, widthProgram = 0001
1 1788032965669 GEN4_TO_CONTROLLER_LOG:GEN4_INIT_INT_LOG_PIC18F26Q84 DeviceInfo: mask = 0000, exists = false, startAddr = 00000000, endAddr = 00000000, rowSize = 0000, rowEraseSize = 0000, addrInc = 0001, widthProgram = 0001
1 1788032965669 GEN4_TO_CONTROLLER_LOG:GEN4_INIT_INT_LOG_PIC18F26Q84 DeviceInfo: mask = 0000, exists = false, startAddr = 00000000, endAddr = 00000000, rowSize = 0000, rowEraseSize = 0000, addrInc = 0000, widthProgram = 0000
1 1788032965669 GEN4_TO_CONTROLLER_LOG:GEN4_INIT_INT_LOG_PIC18F26Q84 DeviceInfo: mask = 0000, exists = false, startAddr = 00000000, endAddr = 00000000, rowSize = 0000, rowEraseSize = 0000, addrInc = 0000, widthProgram = 0000
1 1788032965669 GEN4_TO_CONTROLLER_LOG:GEN4_INIT_INT_LOG_PIC18F26Q84 DeviceInfo: mask = 0000, exists = false, startAddr = 00000000, endAddr = 00000000, rowSize = 0000, rowEraseSize = 0000, addrInc = 0000, widthProgram = 0000
1 1788032965670 GEN4_TO_CONTROLLER_LOG:GEN4_INIT_INT_LOG_PIC18F26Q84 DeviceInfo: mask = 0000, exists = false, startAddr = 00000000, endAddr = 00000000, rowSize = 0000, rowEraseSize = 0000, addrInc = 0000, widthProgram = 0000
1 1788032965670 GEN4_TO_CONTROLLER_LOG:GEN4_INIT_INT_LOG_PIC18F26Q84 DeviceInfo: mask = 7fffffff, exists = true, startAddr = 003ffffe, endAddr = 003fffff, rowSize = 0001, rowEraseSize = 0000, addrInc = 0001, widthProgram = 0001
1 1788032965670 GEN4_TO_CONTROLLER_LOG:GEN4_INIT_INT_LOG_PIC18F26Q84 DeviceInfo: mask = 0000, exists = false, startAddr = 00000000, endAddr = 00000000, rowSize = 0000, rowEraseSize = 0000, addrInc = 0000, widthProgram = 0000
1 1788032965670 GEN4_TO_CONTROLLER_LOG:GEN4_INIT_INT_LOG_PIC18F26Q84 DeviceInfo: mask = ffff, exists = true, startAddr = 003c0000, endAddr = 003c000f, rowSize = 0080, rowEraseSize = 0000, addrInc = 0002, widthProgram = 0002
1 1788032965670 GEN4_TO_CONTROLLER_LOG:GEN4_INIT_INT_LOG_PIC18F26Q84 DeviceInfo: mask = ffff, exists = true, startAddr = 002c0000, endAddr = 002c003f, rowSize = 0080, rowEraseSize = 0000, addrInc = 0002, widthProgram = 0002
1 1788032965670 GEN4_TO_CONTROLLER_LOG:GEN4_INIT_INT_LOG_PIC18F26Q84 DeviceInfo: mask = 0000, exists = false, startAddr = 00000000, endAddr = 00000000, rowSize = 0000, rowEraseSize = 0000, addrInc = 0000, widthProgram = 0000
1 1788032965670 GEN4_TO_CONTROLLER_LOG:GEN4_INIT_INT_LOG_PIC18F26Q84 DeviceInfo: mask = 0000, exists = false, startAddr = 00000000, endAddr = 00000000, rowSize = 0000, rowEraseSize = 0000, addrInc = 0000, widthProgram = 0000
1 1788032965670 GEN4_TO_CONTROLLER_LOG:GEN4_INIT_INT_LOG_PIC18F26Q84 DeviceInfo: mask = 0000, exists = false, startAddr = 00000000, endAddr = 00000000, rowSize = 0000, rowEraseSize = 0000, addrInc = 0000, widthProgram = 0000
1 1788032965670 GEN4_TO_CONTROLLER_LOG:GEN4_INIT_INT_LOG_PIC18F26Q84 DeviceInfo: mask = 0000, exists = false, startAddr = 00000000, endAddr = 00000000, rowSize = 0000, rowEraseSize = 0000, addrInc = 0000, widthProgram = 0000
1 1788032965670 GEN4_TO_CONTROLLER_LOG:GEN4_INIT_INT_LOG_PIC18F26Q84 CfgRequiredBitsMask Values:
1 1788032965670 GEN4_TO_CONTROLLER_LOG:GEN4_INIT_INT_LOG_PIC18F26Q84 Address = 00300000, Mask = 00000077
1 1788032965670 GEN4_TO_CONTROLLER_LOG:GEN4_INIT_INT_LOG_PIC18F26Q84 Address = 00300001, Mask = 0000002b
1 1788032965670 GEN4_TO_CONTROLLER_LOG:GEN4_INIT_INT_LOG_PIC18F26Q84 Address = 00300002, Mask = 000000ff
1 1788032965670 GEN4_TO_CONTROLLER_LOG:GEN4_INIT_INT_LOG_PIC18F26Q84 Address = 00300003, Mask = 000000bf
1 1788032965670 GEN4_TO_CONTROLLER_LOG:GEN4_INIT_INT_LOG_PIC18F26Q84 Address = 00300004, Mask = 0000007f
1 1788032965670 GEN4_TO_CONTROLLER_LOG:GEN4_INIT_INT_LOG_PIC18F26Q84 Address = 00300005, Mask = 0000003f
1 1788032965670 GEN4_TO_CONTROLLER_LOG:GEN4_INIT_INT_LOG_PIC18F26Q84 Address = 00300006, Mask = 0000001f
1 1788032965670 GEN4_TO_CONTROLLER_LOG:GEN4_INIT_INT_LOG_PIC18F26Q84 Address = 00300007, Mask = 0000008f
1 1788032965670 GEN4_TO_CONTROLLER_LOG:GEN4_INIT_INT_LOG_PIC18F26Q84 Address = 00300008, Mask = 00000033
1 1788032965670 GEN4_TO_CONTROLLER_LOG:GEN4_INIT_INT_LOG_PIC18F26Q84 Address = 00300009, Mask = 00000001
1 1788032965670 GEN4_TO_CONTROLLER_LOG:GEN4_INIT_INT_LOG_PIC18F26Q84 Address = 0030000a, Mask = 000000ff
1 1788032965670 GEN4_TO_CONTROLLER_LOG:GEN4_INIT_INT_LOG_PIC18F26Q84 Address = 0030000b, Mask = 000000ff
1 1788032965670 GEN4_TO_CONTROLLER_LOG:GEN4_INIT_INT_LOG_PIC18F26Q84 Address = 0030000c, Mask = 000000ff
1 1788032965670 GEN4_TO_CONTROLLER_LOG:GEN4_INIT_INT_LOG_PIC18F26Q84 Address = 0030000d, Mask = 000000ff
1 1788032965670 GEN4_TO_CONTROLLER_LOG:GEN4_INIT_INT_LOG_PIC18F26Q84 Address = 0030000e, Mask = 000000ff
1 1788032965670 GEN4_TO_CONTROLLER_LOG:GEN4_INIT_INT_LOG_PIC18F26Q84 Address = 0030000f, Mask = 000000ff
1 1788032965670 GEN4_TO_CONTROLLER_LOG:GEN4_INIT_INT_LOG_PIC18F26Q84 Address = 00300010, Mask = 000000ff
1 1788032965670 GEN4_TO_CONTROLLER_LOG:GEN4_INIT_INT_LOG_PIC18F26Q84 Address = 00300011, Mask = 000000ff
1 1788032965670 GEN4_TO_CONTROLLER_LOG:GEN4_INIT_INT_LOG_PIC18F26Q84 Address = 00300012, Mask = 000000ff
1 1788032965671 GEN4_TO_CONTROLLER_LOG:GEN4_INIT_INT_LOG_PIC18F26Q84 Address = 00300013, Mask = 000000ff
1 1788032965671 GEN4_TO_CONTROLLER_LOG:GEN4_INIT_INT_LOG_PIC18F26Q84 Address = 00300014, Mask = 000000ff
1 1788032965671 GEN4_TO_CONTROLLER_LOG:GEN4_INIT_INT_LOG_PIC18F26Q84 Address = 00300015, Mask = 000000ff
1 1788032965671 GEN4_TO_CONTROLLER_LOG:GEN4_INIT_INT_LOG_PIC18F26Q84 Address = 00300016, Mask = 000000ff
1 1788032965671 GEN4_TO_CONTROLLER_LOG:GEN4_INIT_INT_LOG_PIC18F26Q84 Address = 00300017, Mask = 000000ff
1 1788032965671 GEN4_TO_CONTROLLER_LOG:GEN4_INIT_INT_LOG_PIC18F26Q84 Address = 00300018, Mask = 000000ff
1 1788032965671 GEN4_TO_CONTROLLER_LOG:GEN4_INIT_INT_LOG_PIC18F26Q84 Address = 00300019, Mask = 000000ff
1 1788032965671 GEN4_TO_CONTROLLER_LOG:GEN4_INIT_INT_LOG_PIC18F26Q84 Address = 0030001a, Mask = 000000ff
1 1788032965671 GEN4_TO_CONTROLLER_LOG:GEN4_INIT_INT_LOG_PIC18F26Q84 Address = 0030001b, Mask = 000000ff
1 1788032965671 GEN4_TO_CONTROLLER_LOG:GEN4_INIT_INT_LOG_PIC18F26Q84 Address = 0030001c, Mask = 000000ff
1 1788032965671 GEN4_TO_CONTROLLER_LOG:GEN4_INIT_INT_LOG_PIC18F26Q84 Address = 0030001d, Mask = 000000ff
1 1788032965671 GEN4_TO_CONTROLLER_LOG:GEN4_INIT_INT_LOG_PIC18F26Q84 Address = 0030001e, Mask = 000000ff
1 1788032965671 GEN4_TO_CONTROLLER_LOG:GEN4_INIT_INT_LOG_PIC18F26Q84 Address = 0030001f, Mask = 000000ff
1 1788032965671 GEN4_TO_CONTROLLER_LOG:GEN4_INIT_INT_LOG_PIC18F26Q84 Address = 00300020, Mask = 000000ff
1 1788032965671 GEN4_TO_CONTROLLER_LOG:GEN4_INIT_INT_LOG_PIC18F26Q84 Address = 00300021, Mask = 000000ff
1 1788032965671 GEN4_TO_CONTROLLER_LOG:GEN4_INIT_INT_LOG_PIC18F26Q84 Address = 00300022, Mask = 000000ff
1 1788032965671 GEN4_TO_CONTROLLER_LOG:GEN4_INIT_INT_LOG_PIC18F26Q84 BasicInfo: Values:
1 1788032965671 GEN4_TO_CONTROLLER_LOG:GEN4_INIT_INT_LOG_PIC18F26Q84 Payload End
1 1788032966225 GEN4_TO_CONTROLLER_LOG:GEN4_INIT_INT_LOG_PIC18F26Q84 Post:init
1 1788032966225 GEN4_TO_CONTROLLER_LOG:GEN4_INIT_INT_LOG_PIC18F26Q84 Return Value
1 1788032966225 GEN4_TO_CONTROLLER_LOG:GEN4_INIT_INT_LOG_PIC18F26Q84 none
1 1788032966225 GEN4_TO_CONTROLLER_LOG:GEN4_INIT_INT_LOG_PIC18F26Q84 Return End

1 1788032966225 GEN4_TO_CONTROLLER_LOG:GEN4_INIT_INT_LOG_PIC18F26Q84 Pre:GetInterfaceProvider
1 1788032966225 GEN4_TO_CONTROLLER_LOG:GEN4_INIT_INT_LOG_PIC18F26Q84 Payload
1 1788032966225 GEN4_TO_CONTROLLER_LOG:GEN4_INIT_INT_LOG_PIC18F26Q84 RI4DebugInterface
1 1788032966225 GEN4_TO_CONTROLLER_LOG:GEN4_INIT_INT_LOG_PIC18F26Q84 Payload End
1 1788032966225 GEN4_TO_CONTROLLER_LOG:GEN4_INIT_INT_LOG_PIC18F26Q84 Post:GetInterfaceProvider
1 1788032966225 GEN4_TO_CONTROLLER_LOG:GEN4_INIT_INT_LOG_PIC18F26Q84 Return Value
1 1788032966225 GEN4_TO_CONTROLLER_LOG:GEN4_INIT_INT_LOG_PIC18F26Q84 com.microchip.mplab.libs.RI4ToolsController.implementations.RI4DebugInterfaceImpl@18e8473e
1 1788032966225 GEN4_TO_CONTROLLER_LOG:GEN4_INIT_INT_LOG_PIC18F26Q84 Return End

1 1788032967182 GEN4_TO_CONTROLLER_LOG:GEN4_INIT_INT_LOG_PIC18F26Q84 Pre:GetInterfaceProvider
1 1788032967182 GEN4_TO_CONTROLLER_LOG:GEN4_INIT_INT_LOG_PIC18F26Q84 Payload
1 1788032967182 GEN4_TO_CONTROLLER_LOG:GEN4_INIT_INT_LOG_PIC18F26Q84 RI4ProgramInterface
1 1788032967182 GEN4_TO_CONTROLLER_LOG:GEN4_INIT_INT_LOG_PIC18F26Q84 Payload End
1 1788032967182 GEN4_TO_CONTROLLER_LOG:GEN4_INIT_INT_LOG_PIC18F26Q84 Post:GetInterfaceProvider
1 1788032967182 GEN4_TO_CONTROLLER_LOG:GEN4_INIT_INT_LOG_PIC18F26Q84 Return Value
1 1788032967182 GEN4_TO_CONTROLLER_LOG:GEN4_INIT_INT_LOG_PIC18F26Q84 com.microchip.mplab.libs.RI4ToolsController.implementations.RI4ProgramInterfaceImpl@64711bf2
1 1788032967182 GEN4_TO_CONTROLLER_LOG:GEN4_INIT_INT_LOG_PIC18F26Q84 Return End

1 1788032967222 GEN4_TO_CONTROLLER_LOG:GEN4_INIT_INT_LOG_PIC18F26Q84 Pre:GetInterfaceProvider
1 1788032967222 GEN4_TO_CONTROLLER_LOG:GEN4_INIT_INT_LOG_PIC18F26Q84 Payload
1 1788032967222 GEN4_TO_CONTROLLER_LOG:GEN4_INIT_INT_LOG_PIC18F26Q84 RI4ConnectInterface
1 1788032967222 GEN4_TO_CONTROLLER_LOG:GEN4_INIT_INT_LOG_PIC18F26Q84 Payload End
1 1788032967224 GEN4_TO_CONTROLLER_LOG:GEN4_INIT_INT_LOG_PIC18F26Q84 Post:GetInterfaceProvider
1 1788032967224 GEN4_TO_CONTROLLER_LOG:GEN4_INIT_INT_LOG_PIC18F26Q84 Return Value
1 1788032967224 GEN4_TO_CONTROLLER_LOG:GEN4_INIT_INT_LOG_PIC18F26Q84 com.microchip.mplab.libs.PK4ToolsController.PK4ConnectInterfaceImpl@4a951911
1 1788032967224 GEN4_TO_CONTROLLER_LOG:GEN4_INIT_INT_LOG_PIC18F26Q84 Return End
1 1788032967238 GEN4_CONNECT_DIAGNOSTICS:acceptablePIDs = [9018, 9019, 901c]
1 1788032967239 GEN4_CONNECT_DIAGNOSTICS:otherPIDs = [2180]
1 1788032967239 GEN4_CONNECT_DIAGNOSTICS:Setting selected tool type to pk4
1 1788032967240 GEN4_CONNECT_DIAGNOSTICS:otherPIDs = [2180]
1 1788032967240 GEN4_CONNECT_DIAGNOSTICS:acceptablePIDs = [9018, 9019, 901c]

1 1788032967246 GEN4_TO_CONTROLLER_LOG:GEN4_CONNECT_INT_LOG_PIC18F26Q84 Pre:selectCore
1 1788032967246 GEN4_TO_CONTROLLER_LOG:GEN4_CONNECT_INT_LOG_PIC18F26Q84 Payload
1 1788032967246 GEN4_TO_CONTROLLER_LOG:GEN4_CONNECT_INT_LOG_PIC18F26Q84 PIC18F26Q84
1 1788032967246 GEN4_TO_CONTROLLER_LOG:GEN4_CONNECT_INT_LOG_PIC18F26Q84 Payload End
1 1788032967246 GEN4_TO_CONTROLLER_LOG:GEN4_CONNECT_INT_LOG_PIC18F26Q84 Post:selectCore
1 1788032967246 GEN4_TO_CONTROLLER_LOG:GEN4_CONNECT_INT_LOG_PIC18F26Q84 Return Value
1 1788032967246 GEN4_TO_CONTROLLER_LOG:GEN4_CONNECT_INT_LOG_PIC18F26Q84 none
1 1788032967246 GEN4_TO_CONTROLLER_LOG:GEN4_CONNECT_INT_LOG_PIC18F26Q84 Return End

1 1788032967246 GEN4_TO_CONTROLLER_LOG:GEN4_INIT_INT_LOG_PIC18F26Q84 Pre:GetInterfaceProvider
1 1788032967246 GEN4_TO_CONTROLLER_LOG:GEN4_INIT_INT_LOG_PIC18F26Q84 Payload
1 1788032967246 GEN4_TO_CONTROLLER_LOG:GEN4_INIT_INT_LOG_PIC18F26Q84 RI4ControllerDiagnosticsInterface
1 1788032967246 GEN4_TO_CONTROLLER_LOG:GEN4_INIT_INT_LOG_PIC18F26Q84 Payload End
1 1788032967246 GEN4_TO_CONTROLLER_LOG:GEN4_INIT_INT_LOG_PIC18F26Q84 Post:GetInterfaceProvider
1 1788032967246 GEN4_TO_CONTROLLER_LOG:GEN4_INIT_INT_LOG_PIC18F26Q84 Return Value
1 1788032967246 GEN4_TO_CONTROLLER_LOG:GEN4_INIT_INT_LOG_PIC18F26Q84 com.microchip.mplab.libs.RI4ToolsController.implementations.RI4ControllerDiagnosticsInterfaceImpl@31be6b49
1 1788032967246 GEN4_TO_CONTROLLER_LOG:GEN4_INIT_INT_LOG_PIC18F26Q84 Return End

1 1788032967246 GEN4_TO_CONTROLLER_LOG:GEN4_INIT_INT_LOG_PIC18F26Q84 Pre:GetInterfaceProvider
1 1788032967246 GEN4_TO_CONTROLLER_LOG:GEN4_INIT_INT_LOG_PIC18F26Q84 Payload
1 1788032967246 GEN4_TO_CONTROLLER_LOG:GEN4_INIT_INT_LOG_PIC18F26Q84 ProgrammerToGo
1 1788032967246 GEN4_TO_CONTROLLER_LOG:GEN4_INIT_INT_LOG_PIC18F26Q84 Payload End
1 1788032967246 GEN4_TO_CONTROLLER_LOG:GEN4_INIT_INT_LOG_PIC18F26Q84 Post:GetInterfaceProvider
1 1788032967246 GEN4_TO_CONTROLLER_LOG:GEN4_INIT_INT_LOG_PIC18F26Q84 Return Value
1 1788032967246 GEN4_TO_CONTROLLER_LOG:GEN4_INIT_INT_LOG_PIC18F26Q84 com.microchip.mplab.libs.RI4ToolsController.implementations.ProgrammerToGoImpl@2e16b08d
1 1788032967246 GEN4_TO_CONTROLLER_LOG:GEN4_INIT_INT_LOG_PIC18F26Q84 Return End

1 1788032967251 GEN4_TO_CONTROLLER_LOG:GEN4_INIT_INT_LOG_PIC18F26Q84 Pre:GetInterfaceProvider
1 1788032967251 GEN4_TO_CONTROLLER_LOG:GEN4_INIT_INT_LOG_PIC18F26Q84 Payload
1 1788032967251 GEN4_TO_CONTROLLER_LOG:GEN4_INIT_INT_LOG_PIC18F26Q84 Status
1 1788032967251 GEN4_TO_CONTROLLER_LOG:GEN4_INIT_INT_LOG_PIC18F26Q84 Payload End
1 1788032967251 GEN4_TO_CONTROLLER_LOG:GEN4_INIT_INT_LOG_PIC18F26Q84 Post:GetInterfaceProvider
1 1788032967251 GEN4_TO_CONTROLLER_LOG:GEN4_INIT_INT_LOG_PIC18F26Q84 Return Value
1 1788032967251 GEN4_TO_CONTROLLER_LOG:GEN4_INIT_INT_LOG_PIC18F26Q84 null
1 1788032967251 GEN4_TO_CONTROLLER_LOG:GEN4_INIT_INT_LOG_PIC18F26Q84 Return End

1 1788032967291 GEN4_TO_CONTROLLER_LOG:GEN4_PROGRAM_INT_LOG_PIC18F26Q84 Pre:SetDebugExec
1 1788032967291 GEN4_TO_CONTROLLER_LOG:GEN4_PROGRAM_INT_LOG_PIC18F26Q84 Payload
1 1788032967293 GEN4_TO_CONTROLLER_LOG:GEN4_PROGRAM_INT_LOG_PIC18F26Q84 Test
1 1788032967293 GEN4_TO_CONTROLLER_LOG:GEN4_PROGRAM_INT_LOG_PIC18F26Q84 240000
1 1788032967293 GEN4_TO_CONTROLLER_LOG:GEN4_PROGRAM_INT_LOG_PIC18F26Q84 Length = 924
1 1788032967293 GEN4_TO_CONTROLLER_LOG:GEN4_PROGRAM_INT_LOG_PIC18F26Q84 Payload End
1 1788032967296 GEN4_TO_CONTROLLER_LOG:GEN4_PROGRAM_INT_LOG_PIC18F26Q84 Post:SetDebugExec
1 1788032967296 GEN4_TO_CONTROLLER_LOG:GEN4_PROGRAM_INT_LOG_PIC18F26Q84 Return Value
1 1788032967296 GEN4_TO_CONTROLLER_LOG:GEN4_PROGRAM_INT_LOG_PIC18F26Q84 true
1 1788032967296 GEN4_TO_CONTROLLER_LOG:GEN4_PROGRAM_INT_LOG_PIC18F26Q84 Return End
1 1788032967296 GEN4_CONNECT_DIAGNOSTICS:ENTERING: com.microchip.mplab.mdbcore.RI4Tool.ConnectionHandler.CheckForFWUpdates()
1 1788032967299 GEN4_CONNECT_DIAGNOSTICS:Created FirmwareUpdateHandler com.microchip.mplab.mdbcore.pk4hybrid.pk4hybridFirmwareUpdateHandler@71154f21
1 1788032967299 GEN4_CONNECT_DIAGNOSTICS:ENTERING: com.microchip.mplab.mdbcore.pk4hybrid.pk4hybridFirmwareUpdateHandler.UpdateFirmware(FirmwareInfo, UpdateMessage)
1 1788032967302 GEN4_CONNECT_DIAGNOSTICS:areWeInBoot returned false
1 1788032967302 GEN4_CONNECT_DIAGNOSTICS:inBoot = false
1 1788032967302 GEN4_CONNECT_DIAGNOSTICS:uMode = checkingVersions
1 1788032967302 GEN4_CONNECT_DIAGNOSTICS:selectedTool = pk4
1 1788032967302 GEN4_CONNECT_DIAGNOSTICS:current toolType = pk4
1 1788032967302 GEN4_CONNECT_DIAGNOSTICS:current tool mode = pk4
1 1788032967302 GEN4_CONNECT_DIAGNOSTICS:ENTERING: com.microchip.mplab.mdbcore.pk4hybrid.pk4hybridFirmwareUpdateHandler.GetUpdateInfo()
1 1788032967304 GEN4_CONNECT_DIAGNOSTICS:Parsing file  for firmware updates
1 1788032967304 GEN4_CONNECT_DIAGNOSTICS:ENTERING: com.microchip.mplab.mdbcore.pk4hybrid.pk4hybridFirmwareUpdateHandler.ParseSelectedVersionsFromJamFile()
1 1788032967304 GEN4_CONNECT_DIAGNOSTICS:Jame file line = snap_boot.hex,010155
1 1788032967304 GEN4_CONNECT_DIAGNOSTICS:Jame file line = scripts.xml,001090
1 1788032967304 GEN4_CONNECT_DIAGNOSTICS:Jame file line = snap_app1 020456, 0040C000
1 1788032967304 GEN4_CONNECT_DIAGNOSTICS:Jame file line = snap_app2 1.11.20, 00500000
1 1788032967304 GEN4_CONNECT_DIAGNOSTICS:Jame file line = snap_app3 000000, FFFFFFFF
1 1788032967304 GEN4_CONNECT_DIAGNOSTICS:Jame file line = snap_app4 000000, FFFFFFFF
1 1788032967304 GEN4_CONNECT_DIAGNOSTICS:Jame file line = snap_app5 000000, FFFFFFFF
1 1788032967304 GEN4_CONNECT_DIAGNOSTICS:Jame file line = snap_app6 000000, FFFFFFFF
1 1788032967304 GEN4_CONNECT_DIAGNOSTICS:Jame file line = snap_app7 000000, FFFFFFFF
1 1788032967304 GEN4_CONNECT_DIAGNOSTICS:Jame file line = snap_app8 000000, FFFFFFFF
1 1788032967304 GEN4_CONNECT_DIAGNOSTICS:EXITING: com.microchip.mplab.mdbcore.pk4hybrid.pk4hybridFirmwareUpdateHandler.ri4ParseSelectedVersionsFromJamFile()
1 1788032967304 GEN4_CONNECT_DIAGNOSTICS:EXITING: com.microchip.mplab.mdbcore.pk4hybrid.pk4hybridFirmwareUpdateHandler.GetUpdateInfo()
1 1788032967304 GEN4_CONNECT_DIAGNOSTICS:current toolType = pk4

1 1788032967304 GEN4_TO_CONTROLLER_LOG:GEN4_CONNECT_INT_LOG_PIC18F26Q84 Pre:EstablishCommunincations
1 1788032967304 GEN4_TO_CONTROLLER_LOG:GEN4_CONNECT_INT_LOG_PIC18F26Q84 Payload
1 1788032967304 GEN4_TO_CONTROLLER_LOG:GEN4_CONNECT_INT_LOG_PIC18F26Q84 com.microchip.mplab.mdbcore.PK4Tool.PK4Com@b93aad
1 1788032967304 GEN4_TO_CONTROLLER_LOG:GEN4_CONNECT_INT_LOG_PIC18F26Q84 Payload End
1 1788032967312 GEN4_TO_CONTROLLER_LOG:GEN4_CONNECT_INT_LOG_PIC18F26Q84 Post:EstablishCommunincations
1 1788032967312 GEN4_TO_CONTROLLER_LOG:GEN4_CONNECT_INT_LOG_PIC18F26Q84 Return Value
1 1788032967312 GEN4_TO_CONTROLLER_LOG:GEN4_CONNECT_INT_LOG_PIC18F26Q84 true
1 1788032967312 GEN4_TO_CONTROLLER_LOG:GEN4_CONNECT_INT_LOG_PIC18F26Q84 Return End

1 1788032967312 GEN4_TO_CONTROLLER_LOG:GEN4_CONNECT_INT_LOG_PIC18F26Q84 Pre:GetFirmwareInfo
1 1788032967312 GEN4_TO_CONTROLLER_LOG:GEN4_CONNECT_INT_LOG_PIC18F26Q84 Payload
1 1788032967312 GEN4_TO_CONTROLLER_LOG:GEN4_CONNECT_INT_LOG_PIC18F26Q84 null
1 1788032967312 GEN4_TO_CONTROLLER_LOG:GEN4_CONNECT_INT_LOG_PIC18F26Q84 Payload End
1 1788032967317 XXXX 1788032967317, Thread 1: com.Send returned false 
1 1788032967319 XXXX 1788032967319, Thread 1: execCommand: exception after writeSideChanel null
