ntakao2006-web/RaceCapture/circuit/logger_v2/output/design_review_20260907/reviewed_schematic.pdf

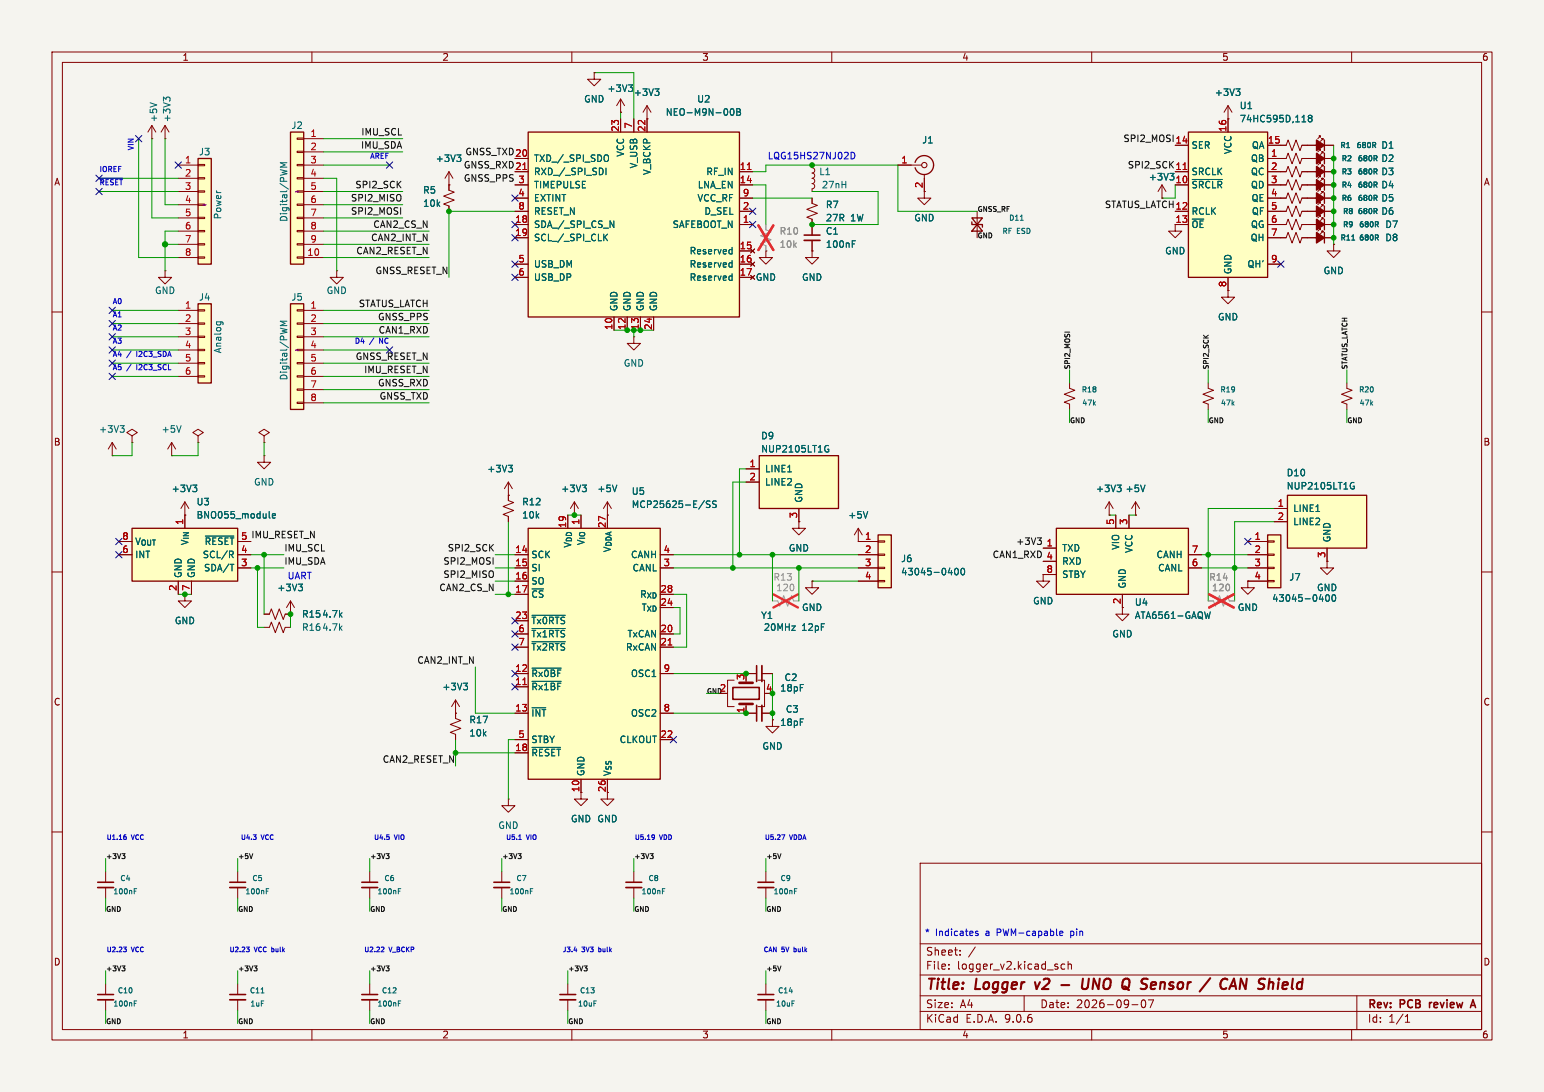
[picture p162: page 1]

LNA_EN 14 VCC_RF 9 D_SEL 2 SAFEBOOT_N 1 Reserved 15 Reserved 16 Reserved 17 +3V3 +3V3 GND

8 QA 15 QB 1 QC 2 QD 3 QE 4 QF 5 QG 6 QH 7 QH' 9 +3V3 GND

7 ~{RESET}5 SCL/R 4 SDA/T 3 U3BNO055_module SCK 14 SI 15 SO 16 ~{CS} 17 ~{Tx0RTS} 23 ~{Tx1RTS} 6 ~{Tx2RTS} 7 ~{Rx0BF} 12 ~{Rx1BF} 11 ~{INT} 13 STBY 5 ~{RESET} 18 V_{DD} 19 V_{IO}1 GND 10 V_{DDA} 27 V_{SS} 26 CANH 4 CANL 3 R_{XD} 28 T_{XD} 24 TxCAN 20 RxCAN 21 OSC1 9 OSC2 8 CLKOUT 22 U5 MCP25625-E/SS R17
U2.22 V_BCKP UART

7 ~{RESET}5 SCL/R 4 SDA/T 3 +3V3 R15 4.7k GND GND GND

File: logger_v2.kicad_sch Sheet: /
Id: 1/1 Title: Logger v2 - UNO Q Sensor / CAN Shield
