ntakao2006-web/RaceCapture/circuit/logger_v2/logger_v2.pdf

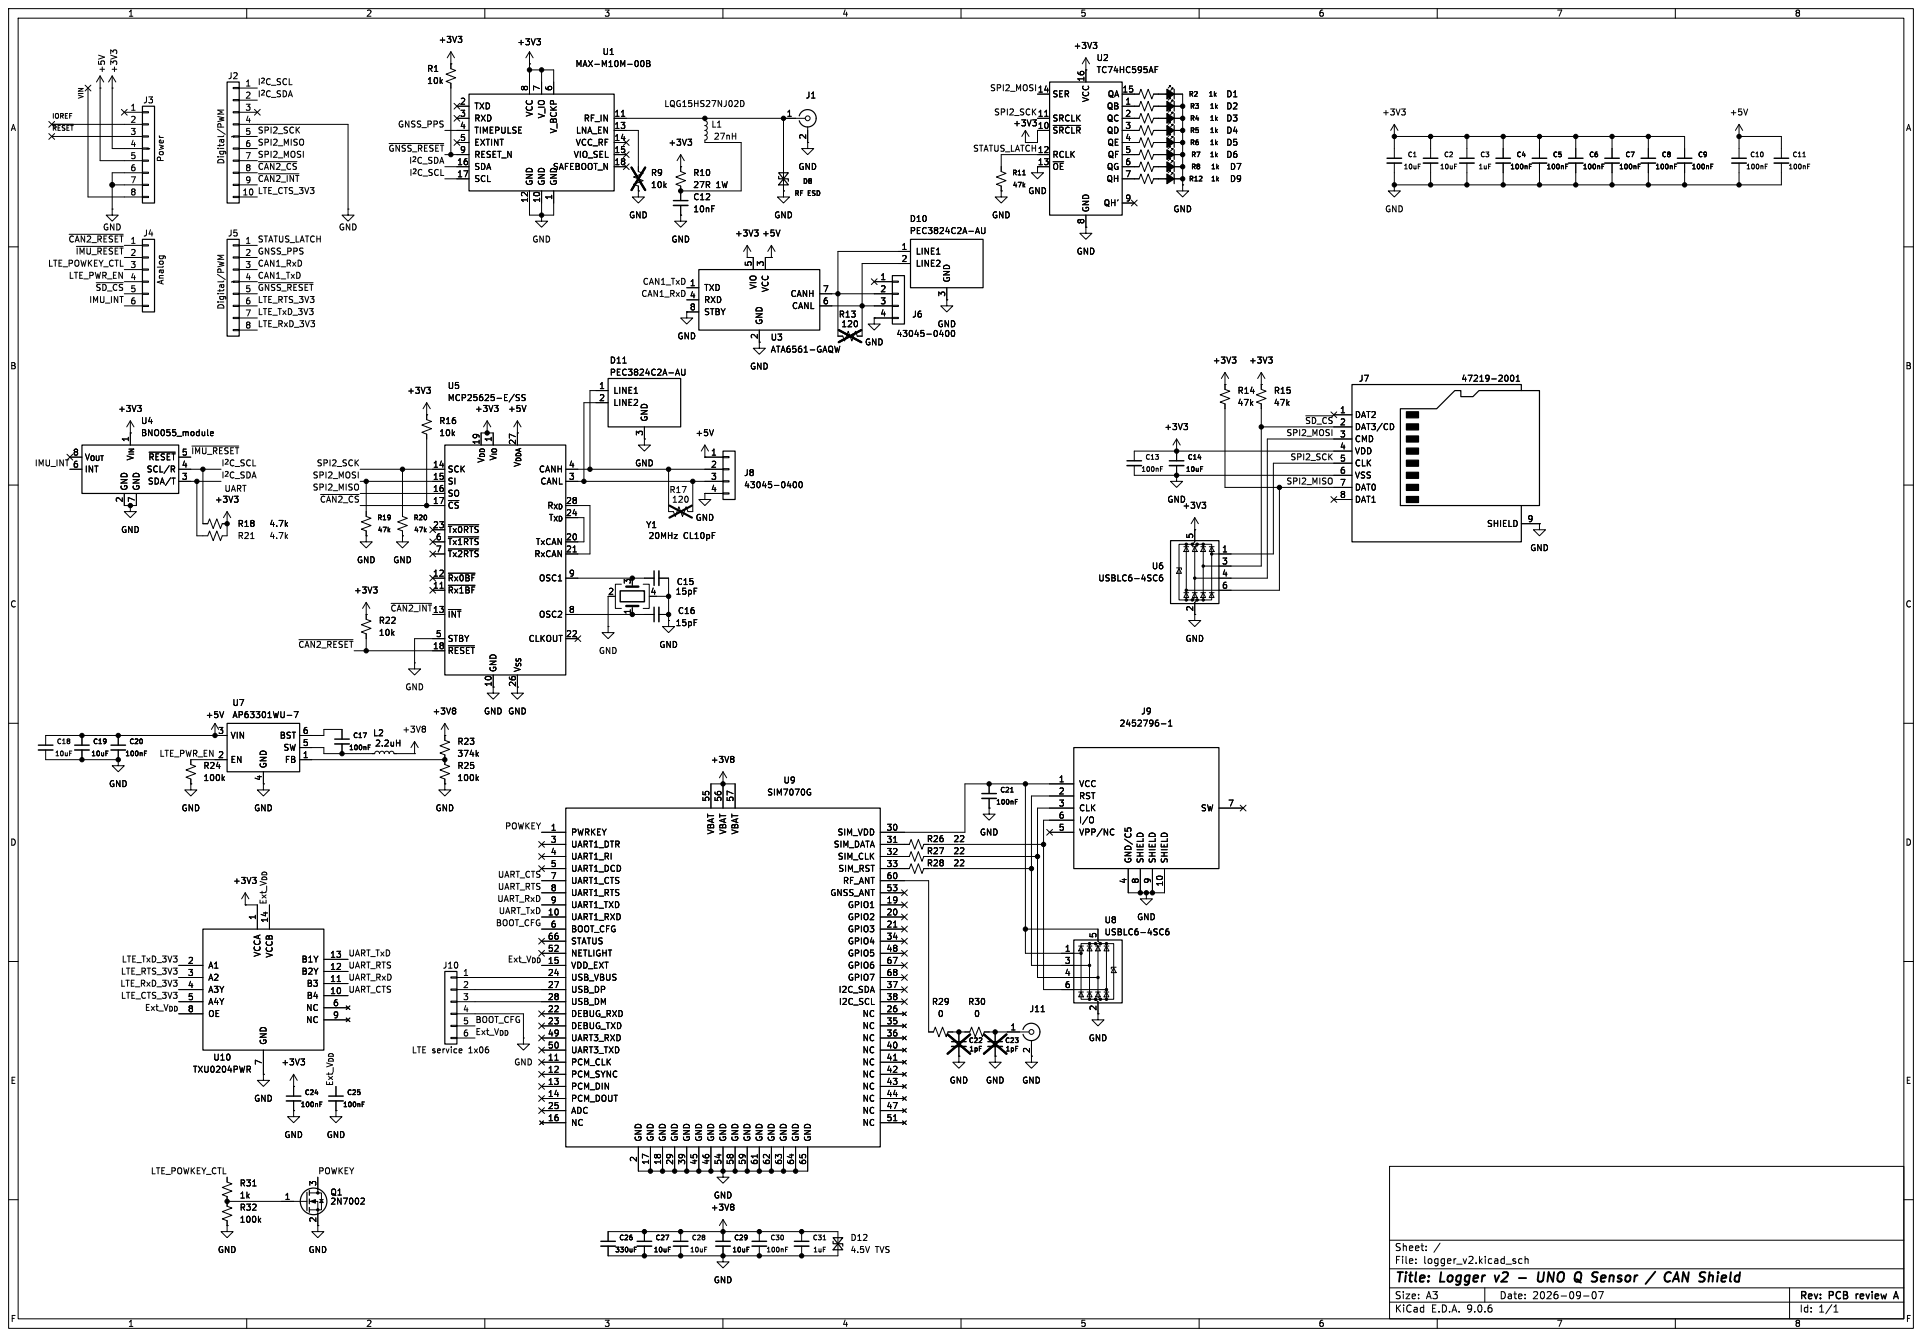
[picture p163: page 1]

8 QA 15 QB 1 QC 2 QD 3 QE 4 QF 5 QG 6 QH 7 QH' 9 R6 1k D5D7 R7 1k D6 R8 1k R12 1k D9 D3 D2 D1 D4 D10 PEC3824C2A-AU

7 ~{RESET}5 SCL/R 4 SDA/T 3 U4BNO055_module +3V3 DAT2 1 DAT3/CD 2 CMD 3 VDD 4 CLK 5 VSS 6 DAT0 7 DAT1 8 SHIELD 9

4 BST 6 SW 5 FB 1 U7AP63301WU-7+3V3 +3V3 A1 2 A2 3 A3Y 4 A4Y 5 OE 8 VCCA

2 GND 17 GND 18 GND 29 GND 39 GND 45 VBAT 55 GND 46 VBAT 56 GND 54 VBAT 57 GND 58 GND 59 GND 61 GND 62 GND 63 GND 64 GND 65 SIM_VDD 30 SIM_DATA 31 SIM_CLK 32 SIM_RST 33 RF_ANT 60 GNSS_ANT 53 GPIO1 19 GPIO2 20 GPIO3 21 GPIO4 34 GPIO5 48 GPIO6 67 GPIO7 68

9 SHIELD 10 SW 7 GND GND

File: logger_v2.kicad_sch Sheet: /
Id: 1/1 Title: Logger v2 - UNO Q Sensor / CAN Shield
