ntakao2006-web/RaceCapture/circuit/logger_v2/output/before_lte_sd_20260919.pdf

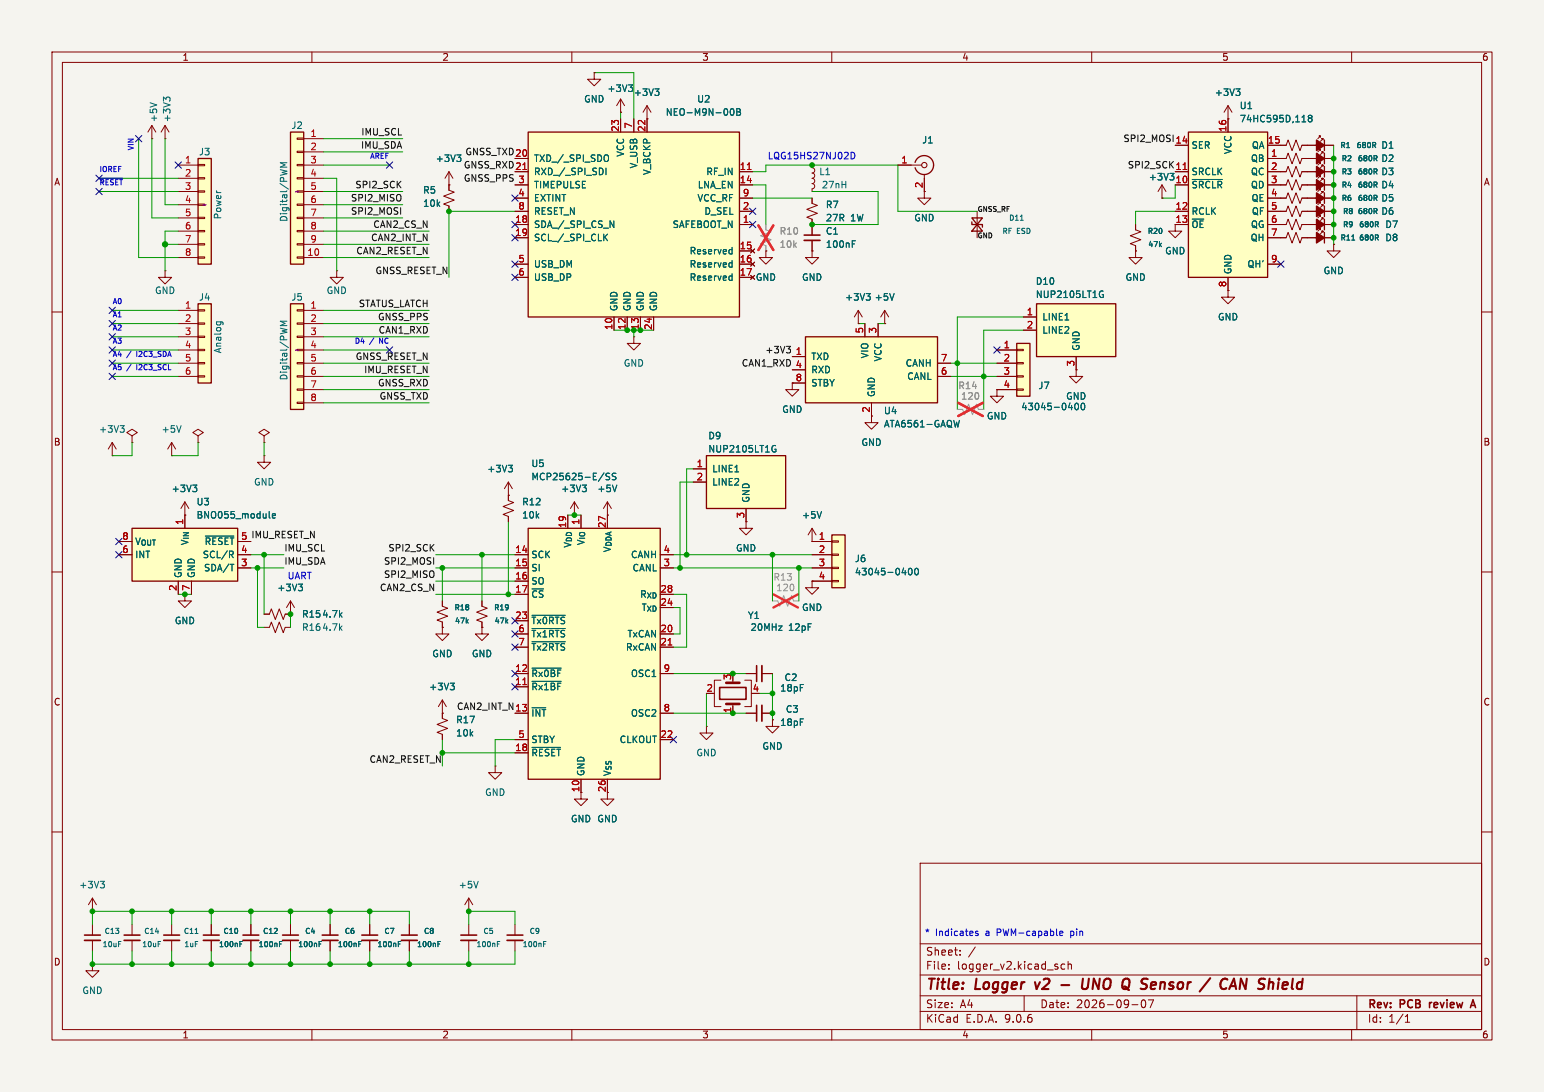
[picture p164: page 1]

+3V3 GND
LNA_EN 14 VCC_RF 9 D_SEL 2 SAFEBOOT_N 1 Reserved 15 Reserved 16 Reserved 17 U2 NEO-M9N-00B

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

7 ~{RESET}5 SCL/R 4 SDA/T 3 U3BNO055_module GND

7 ~{RESET}5 SCL/R 4 SDA/T 3 GND

Id: 1/1 Title: Logger v2 - UNO Q Sensor / CAN Shield
