ntakao2006-web/RaceCapture/circuit/logger_v2/output/logger_v2.pdf

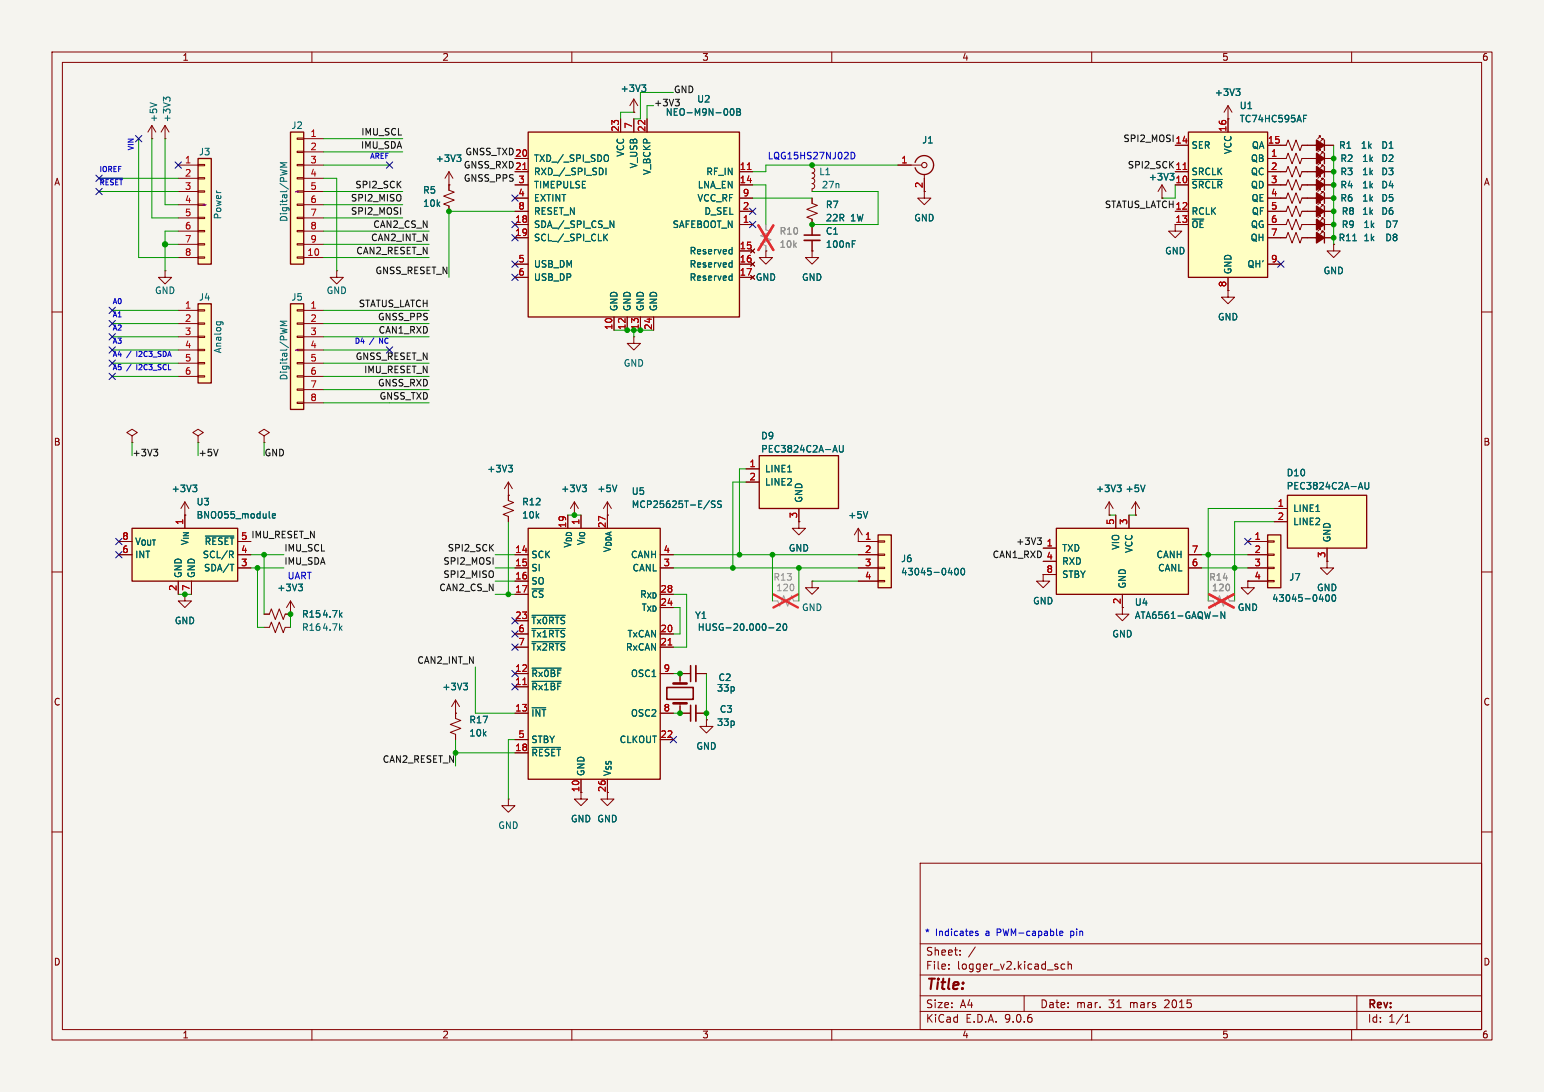
[picture p165: page 1]

8 QA 15 QB 1 QC 2 QD 3 QE 4 QF 5 QG 6 QH 7 QH' 9 U1 TC74HC595AF GND

8 QA 15 QB 1 QC 2 QD 3 QE 4 QF 5 QG 6 QH 7 QH' 9 D5D8 D7 D6 GND GND

7 ~{RESET}5 SCL/R 4 SDA/T 3 U3BNO055_module GND

3 CANH 7 CANL 6 U4ATA6561-GAQW-N GND

7 ~{RESET}5 SCL/R 4 SDA/T 3 GND
