ntakao2006-web/RaceCapture/circuit/logger_v2/output/logger_v2_lte_sd_20260919.pdf

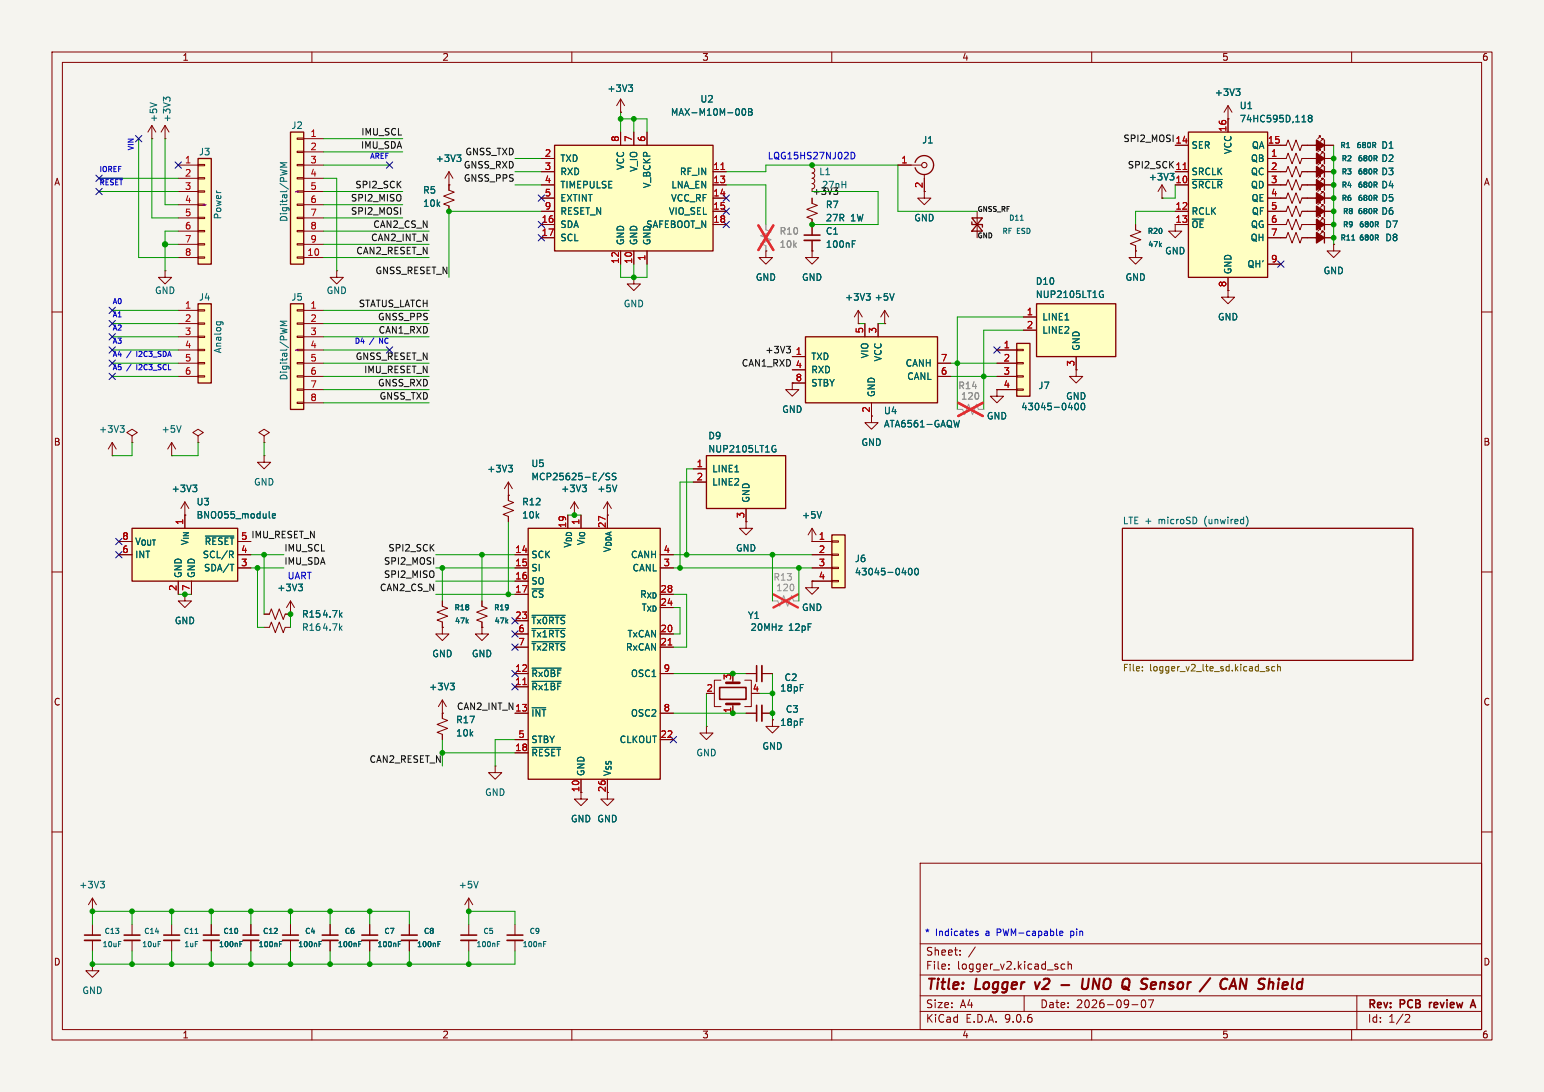
[picture p166: page 1]

3 CANH 7 CANL 6 GND GND

7 ~{RESET}5 SCL/R 4 SDA/T 3 U3BNO055_module +3V3 GND GND

File: logger_v2.kicad_sch Sheet: /
Id: 1/2 Title: Logger v2 - UNO Q Sensor / CAN Shield

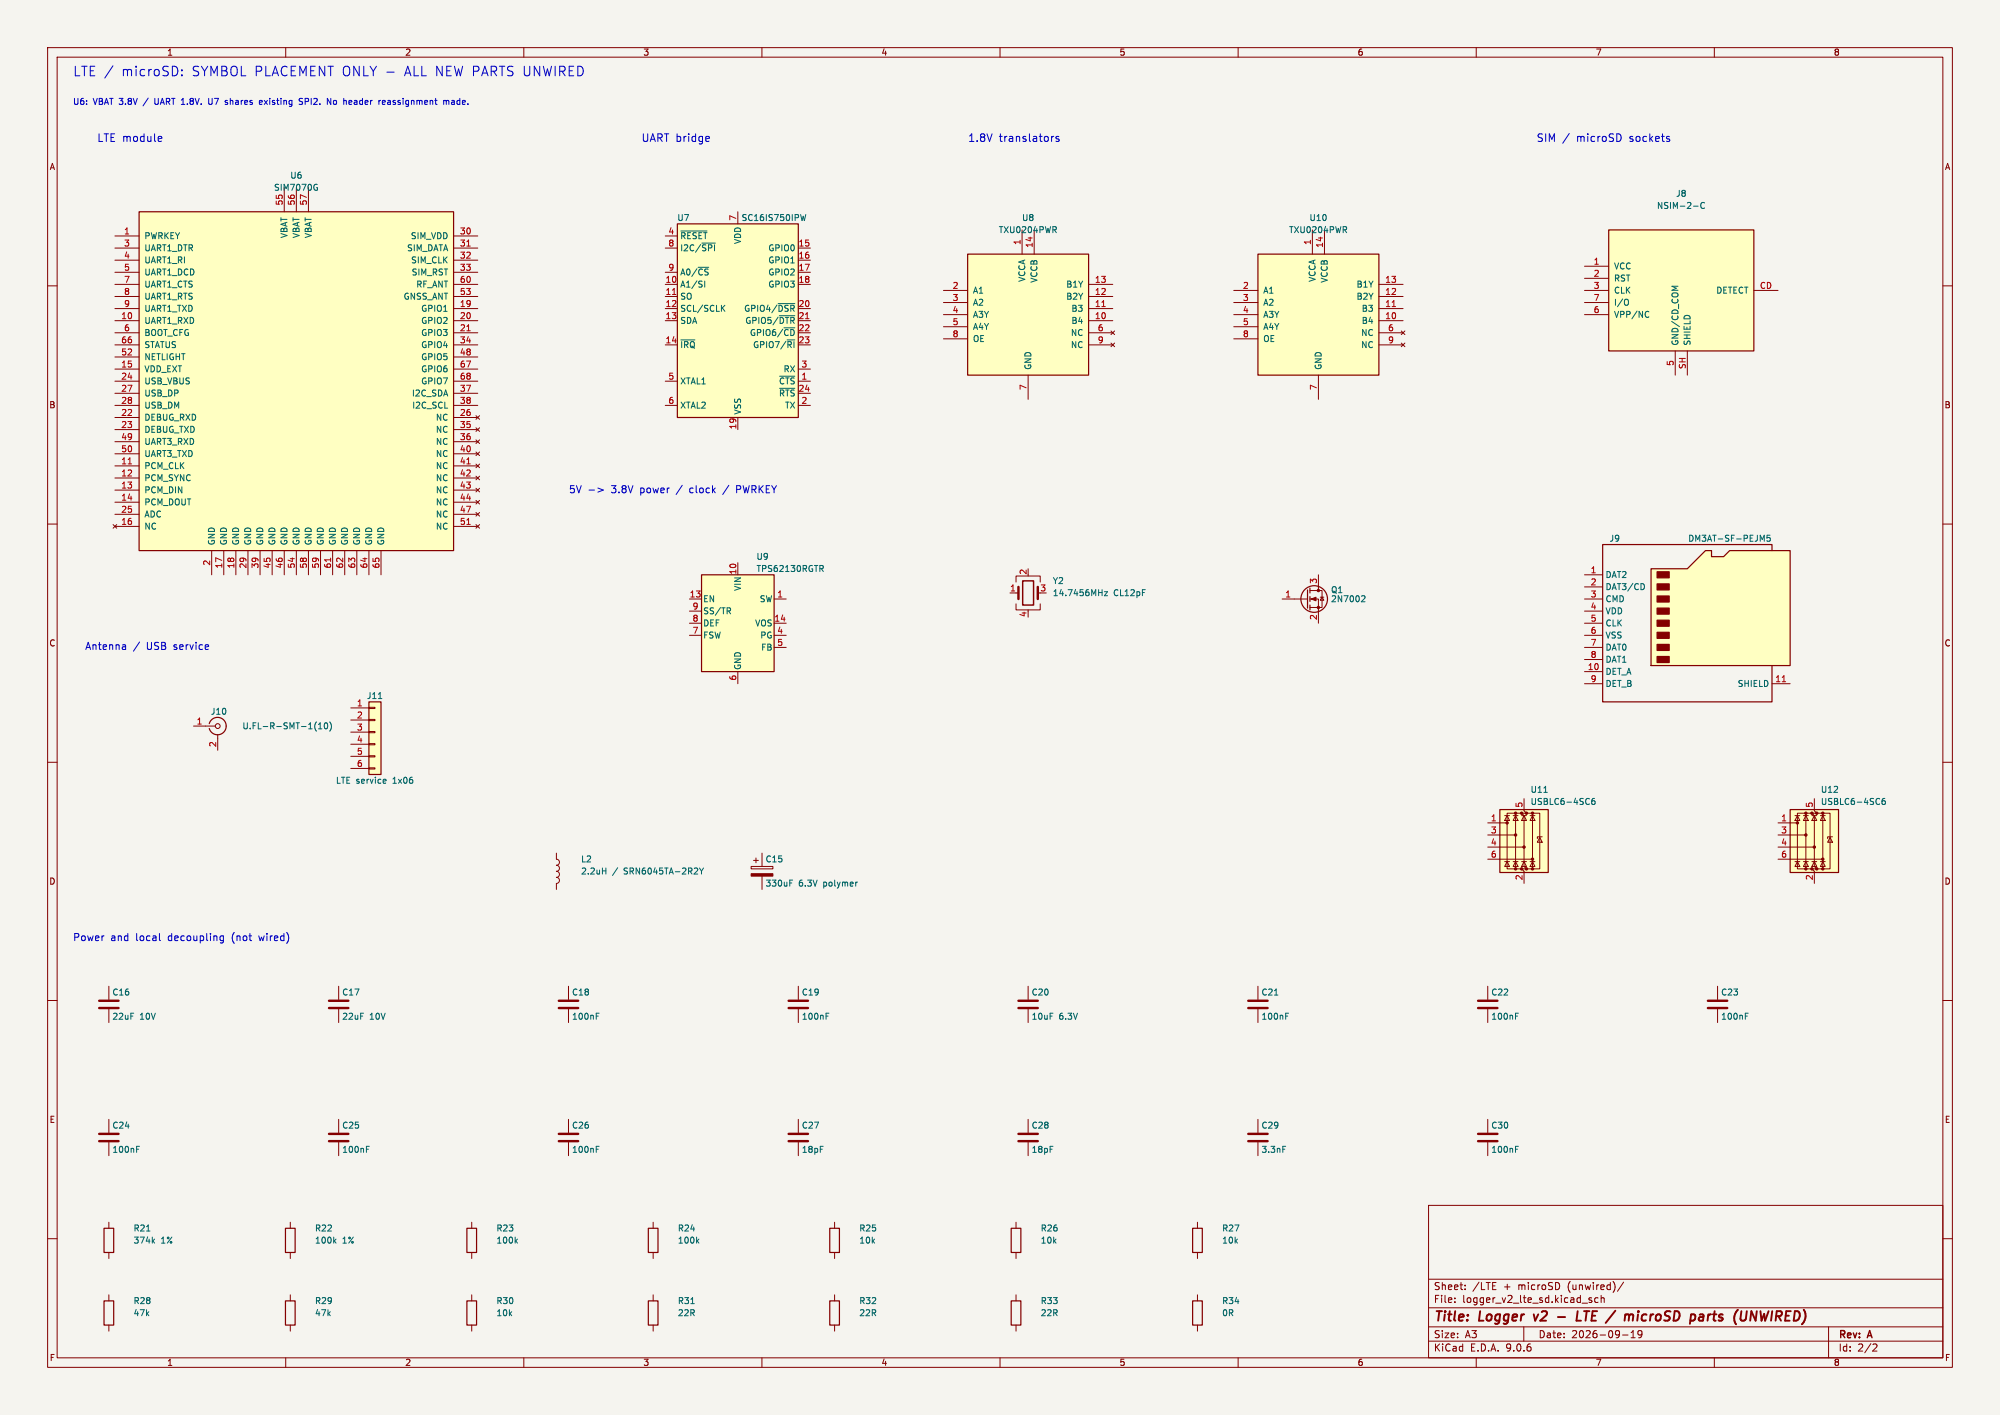
[picture p167: page 2]

LTE / microSD: SYMBOL PLACEMENT ONLY - ALL NEW PARTS UNWIRED

2 GND 17 GND 18 GND 29 GND 39 GND 45 VBAT 55 GND 46 VBAT 56 GND 54 VBAT 57 GND 58 GND 59 GND 61 GND 62 GND 63 GND 64 GND 65 SIM_VDD 30 SIM_DATA 31 SIM_CLK 32 SIM_RST 33 RF_ANT 60 GNSS_ANT 53 GPIO1 19 GPIO2 20 GPIO3 21 GPIO4 34 GPIO5 48 GPIO6 67 GPIO7 68

7 VSS 19 GPIO0 15 GPIO1 16 GPIO2 17 GPIO3 18 GPIO4/~{DSR}20 GPIO5/~{DTR}21 GPIO6/~{CD}22 GPIO7/~{RI}23 RX 3 ~{CTS}1 ~{RTS} 24 TX 2 U7 SC16IS750IPW
~{RESET} 4

6 SW 1 VOS 14 PG 4 FB 5 U9 TPS62130RGTR
