ntakao2006-web/RaceCapture/circuit/logger_v2/output/original_layout.pdf

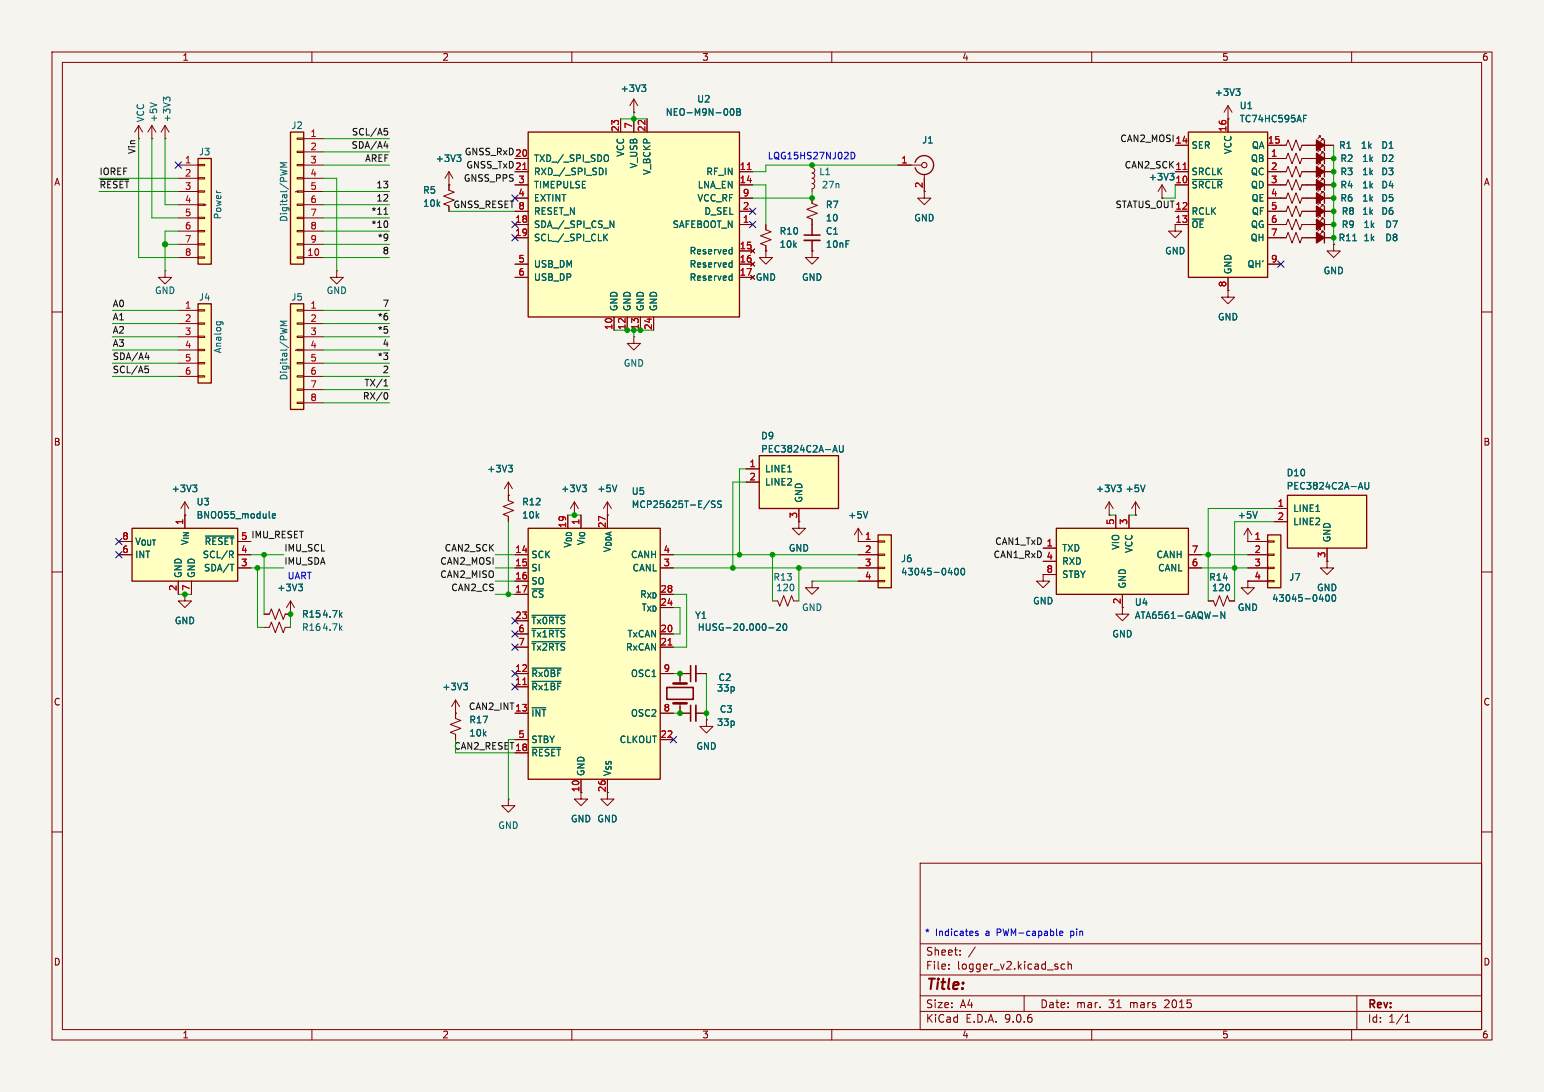
[picture p168: page 1]
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

8 QA 15 QB 1 QC 2 QD 3 QE 4 QF 5 QG 6 QH 7 QH' 9 GND GND

3 CANH 7 CANL 6 U4ATA6561-GAQW-N GND GND

7 ~{RESET}5 SCL/R 4 SDA/T 3 U3BNO055_module TXD 1 RXD 4 STBY 8 VIO

3 CANH 7 CANL 6 GND GND

7 ~{RESET}5 SCL/R 4 SDA/T 3 GND
