ntakao2006-web/RaceCapture/circuit/logger_v2/manufacturing_20260907/gerbers/logger_v2.pdf

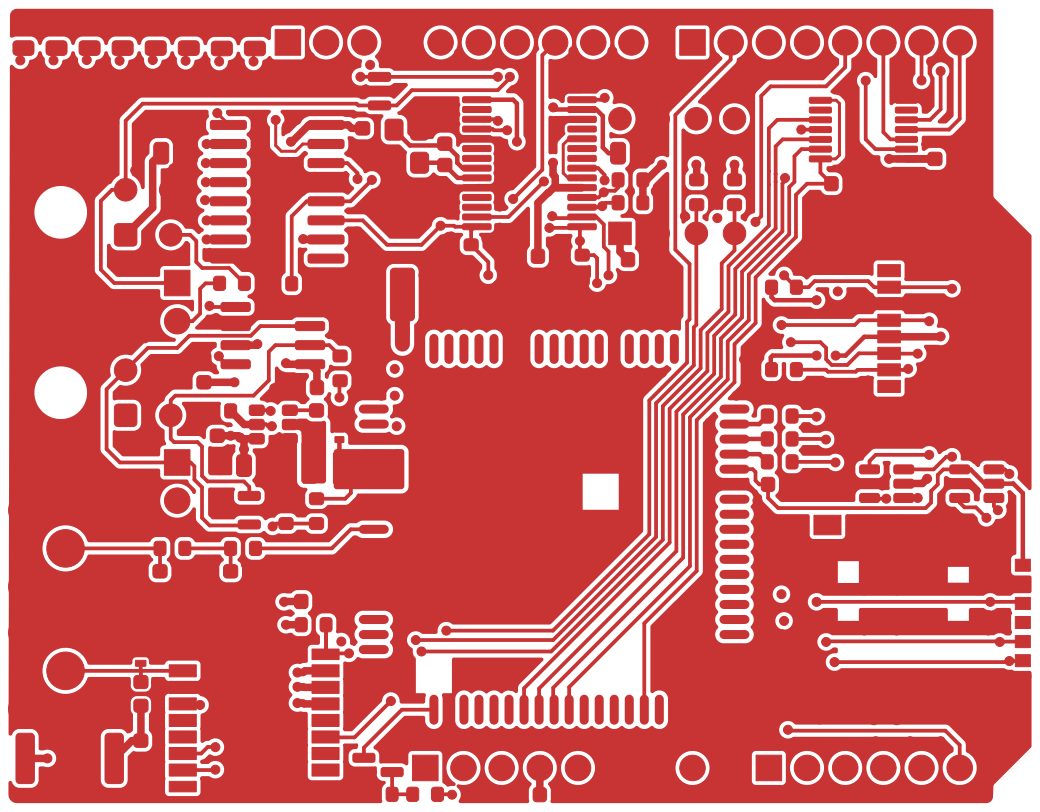
[picture p169: page 1]

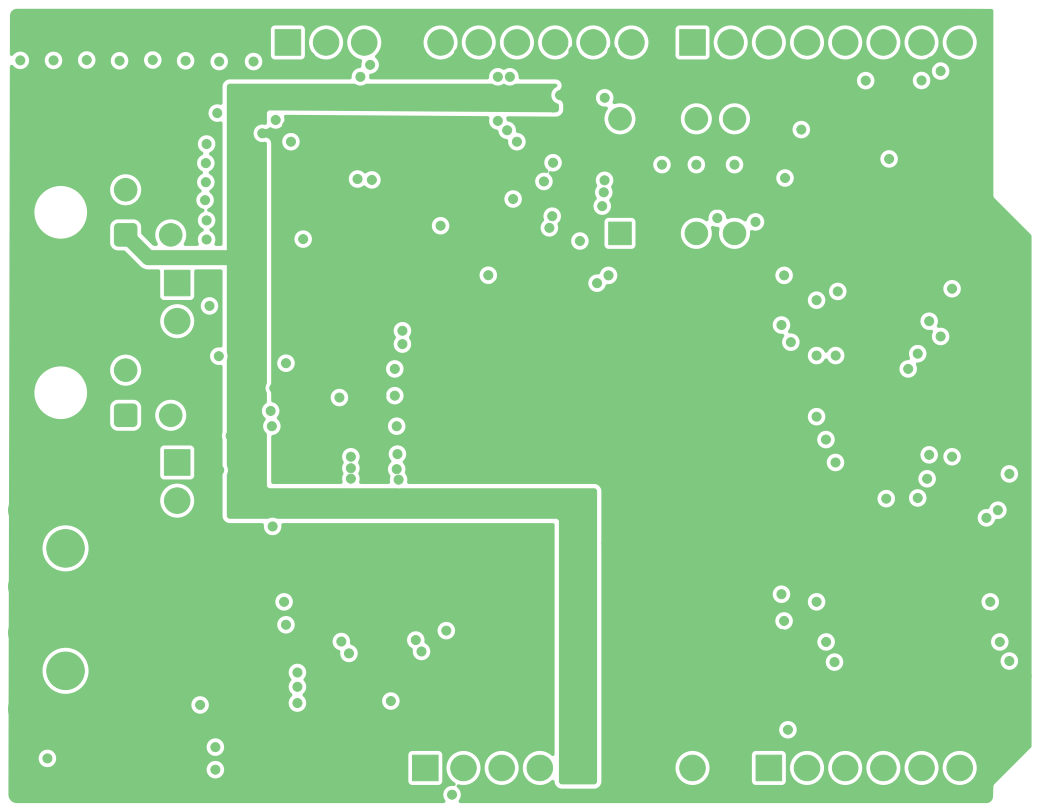
[picture p170: page 2]

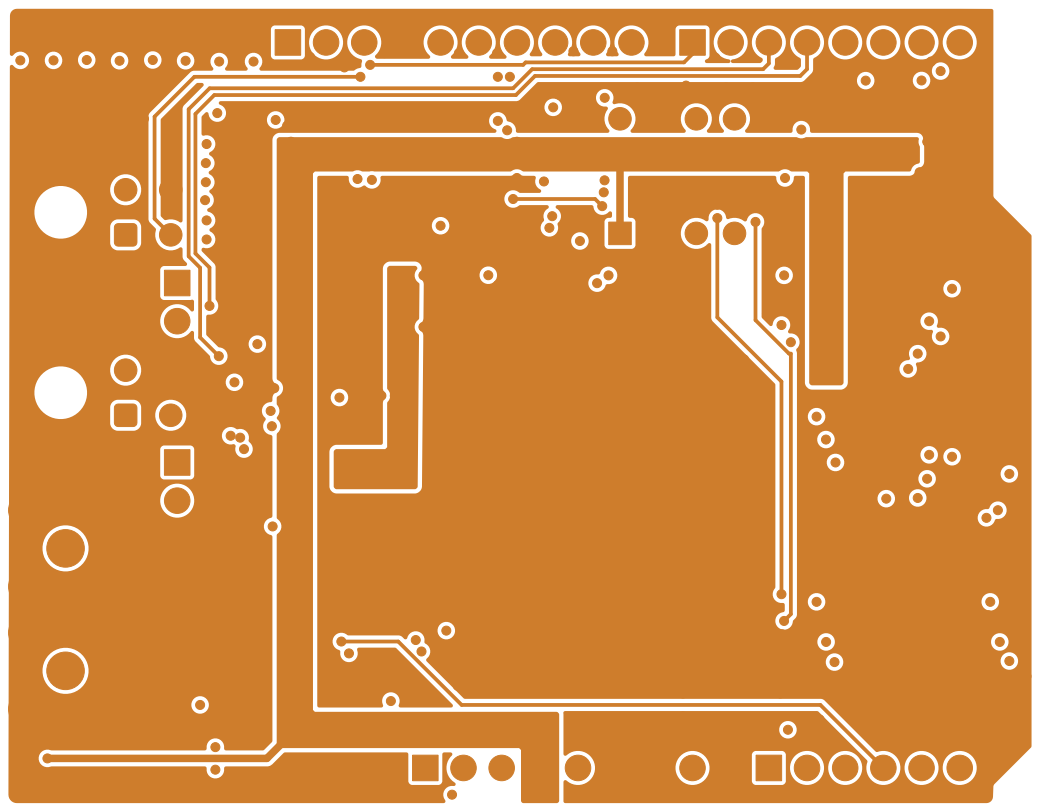
[picture p171: page 3]

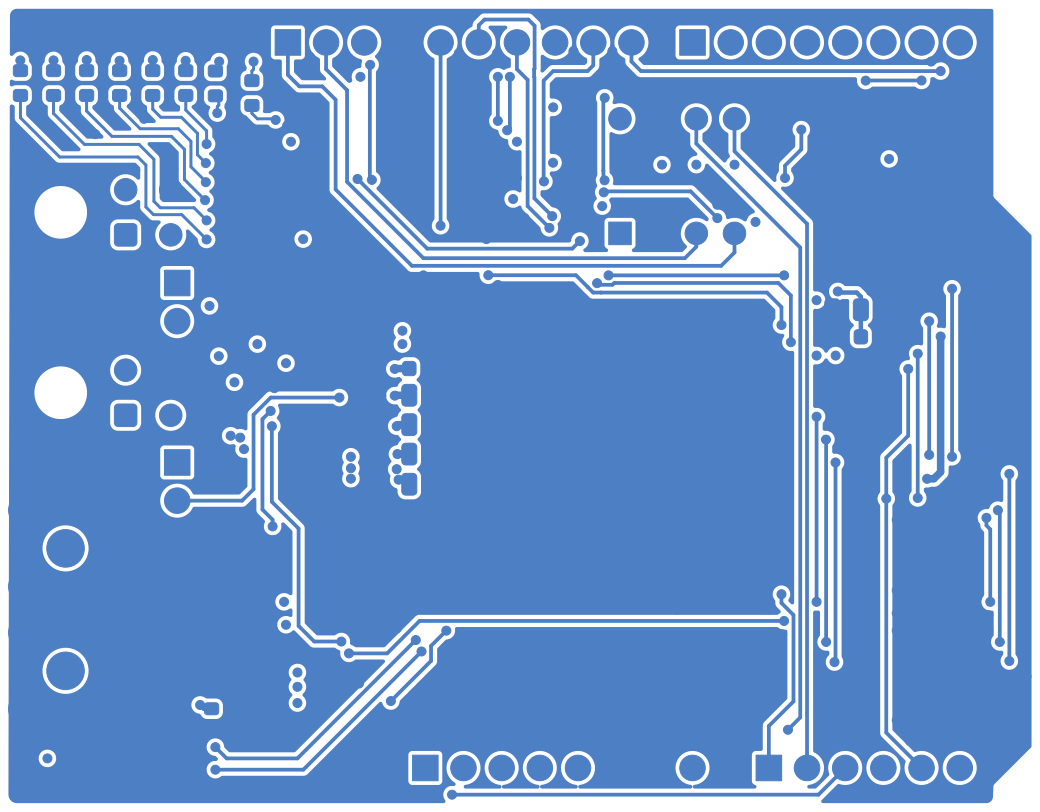
[picture p172: page 4]

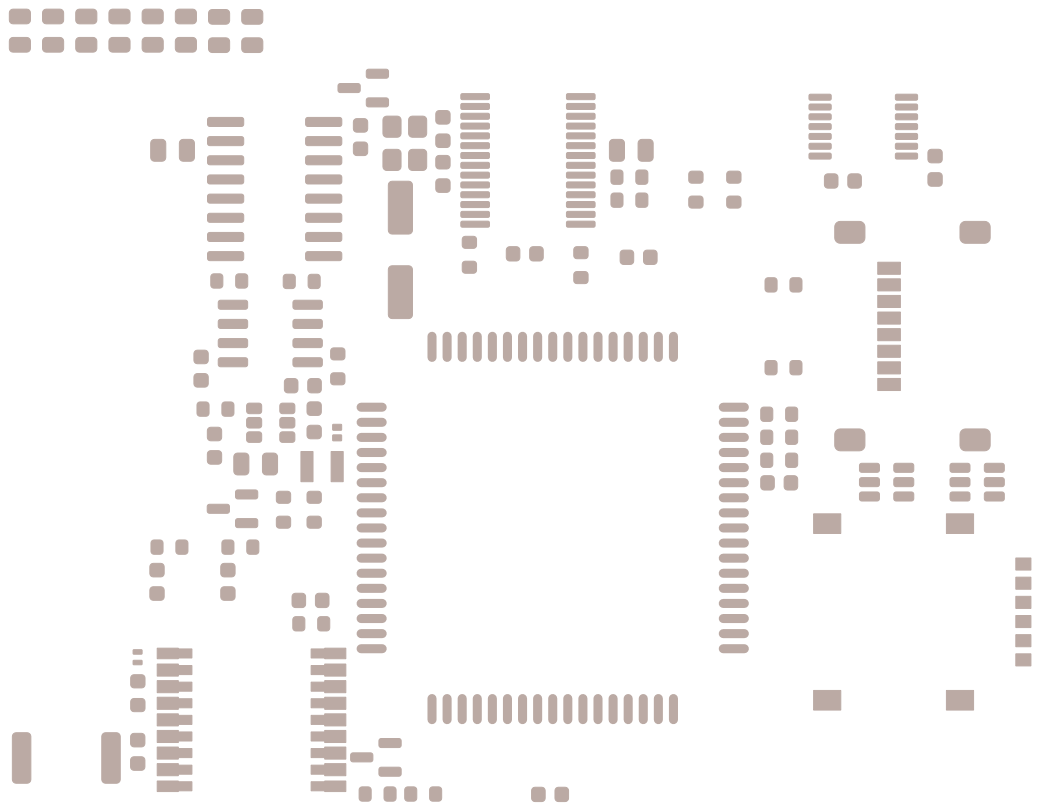
[picture p173: page 7]

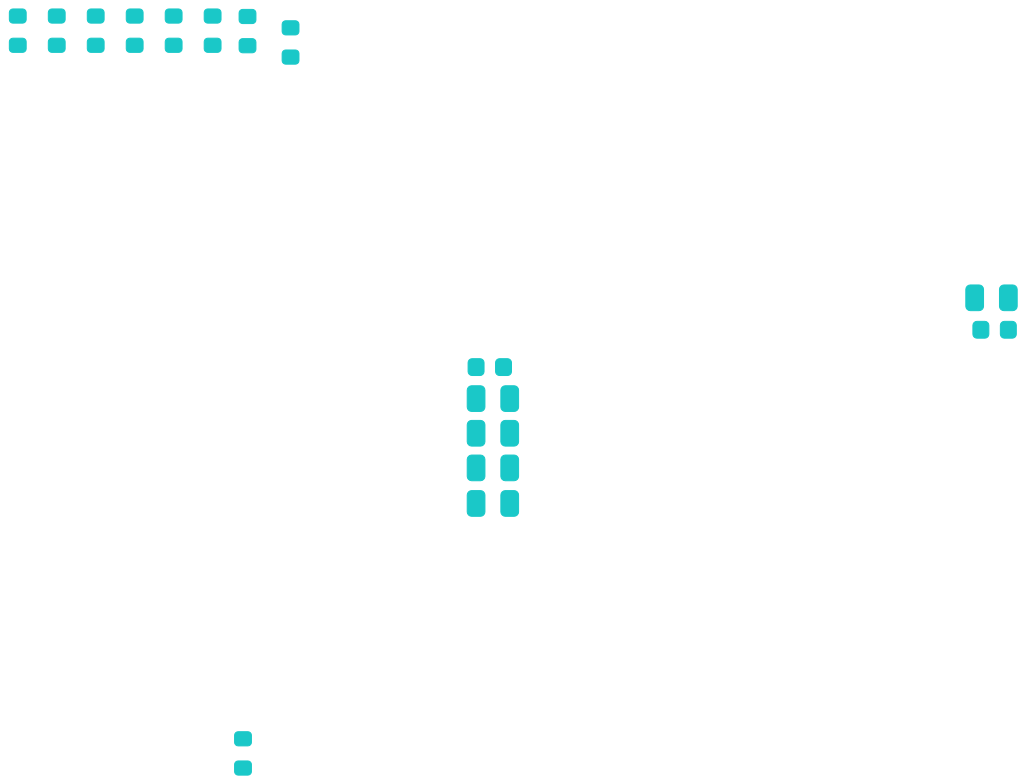
[picture p174: page 8]

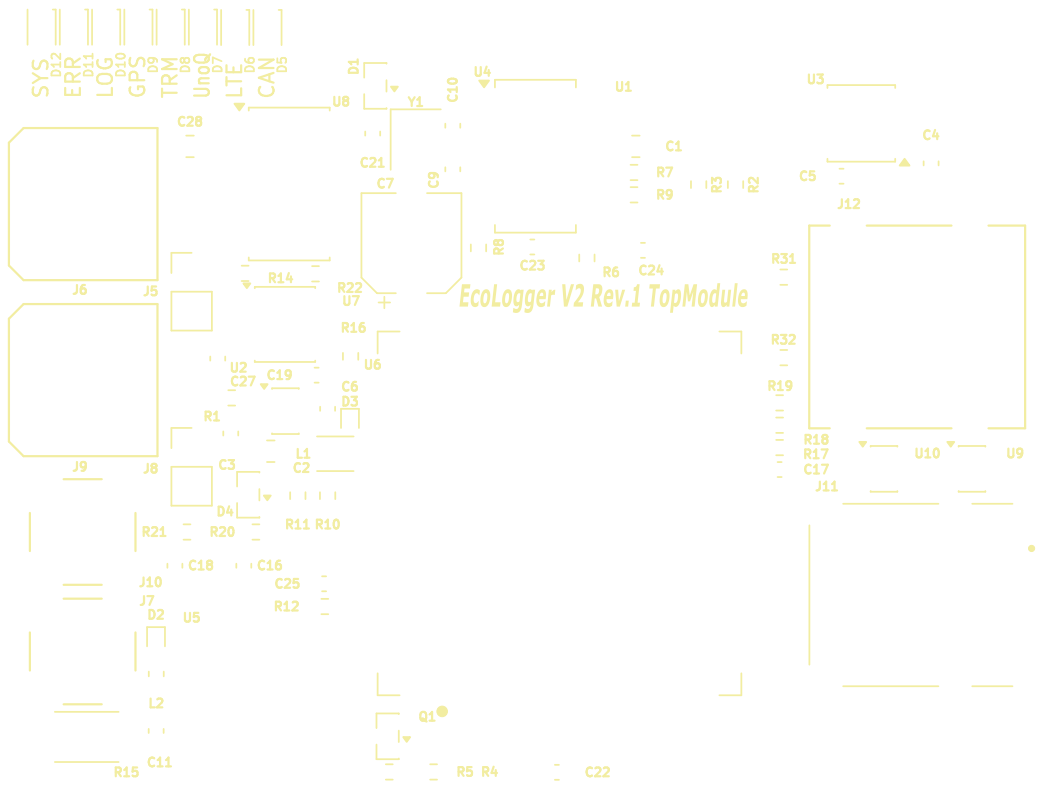
[picture p175: page 9]

SYS ERR LOG GPS TRM UnoQ LTE CAN

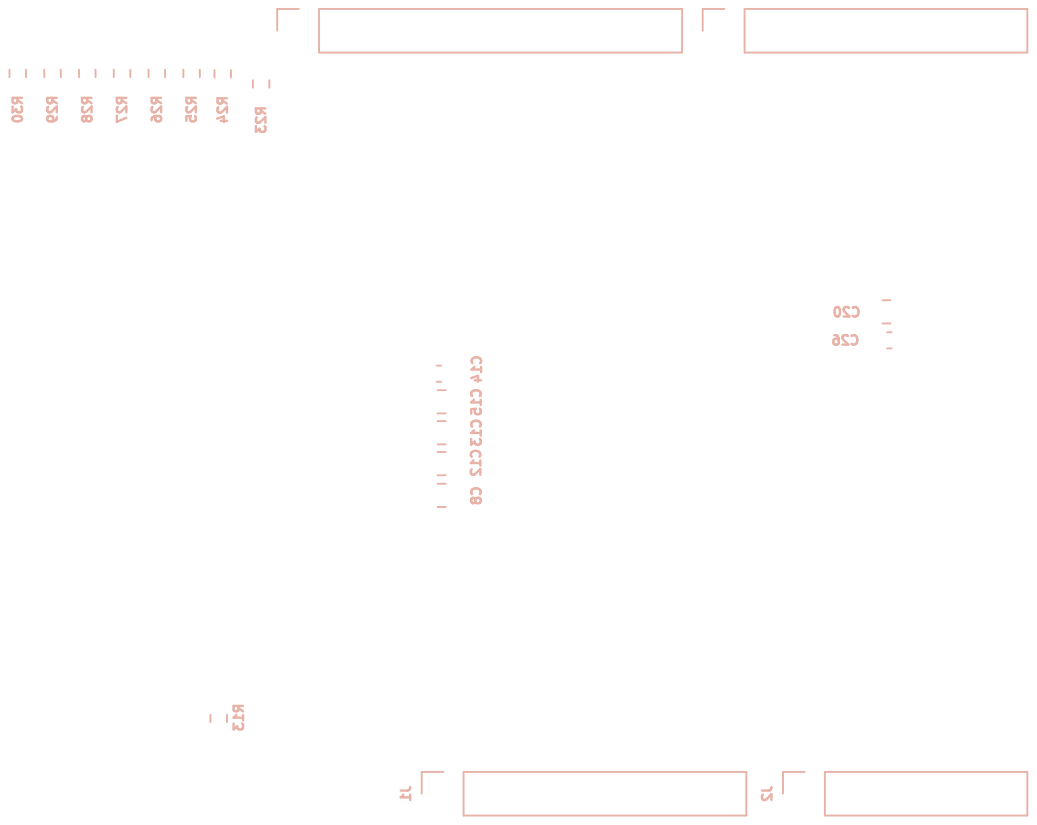
[picture p176: page 10]

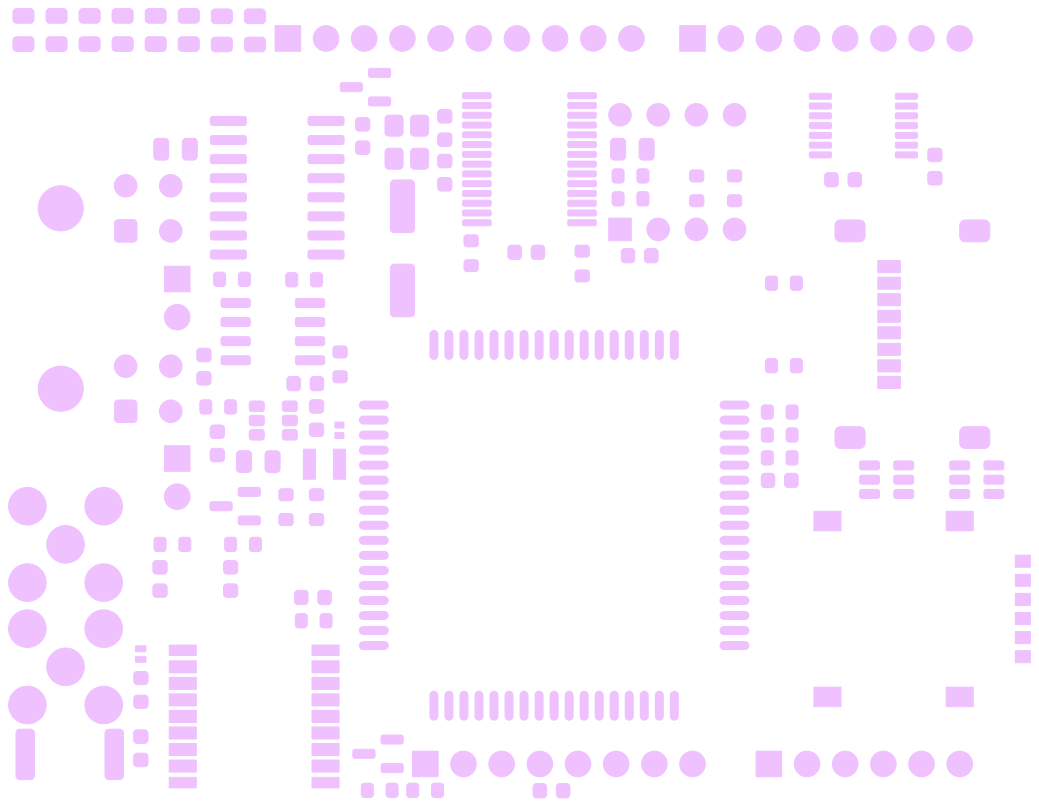
[picture p177: page 11]

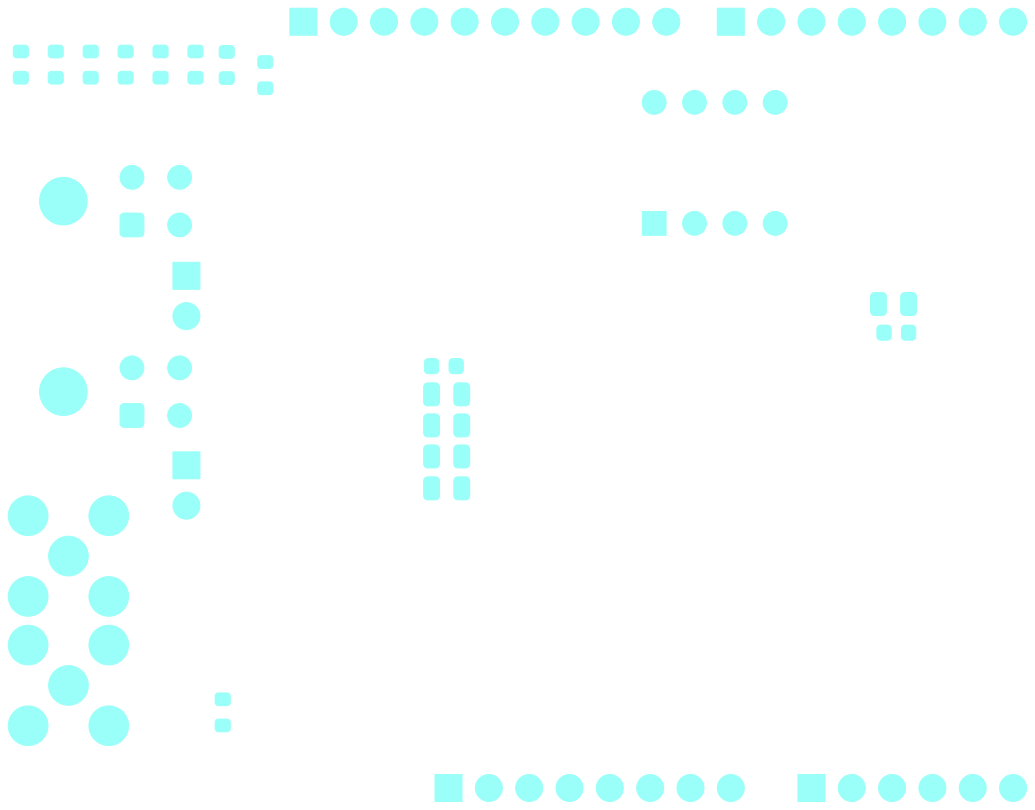
[picture p178: page 12]

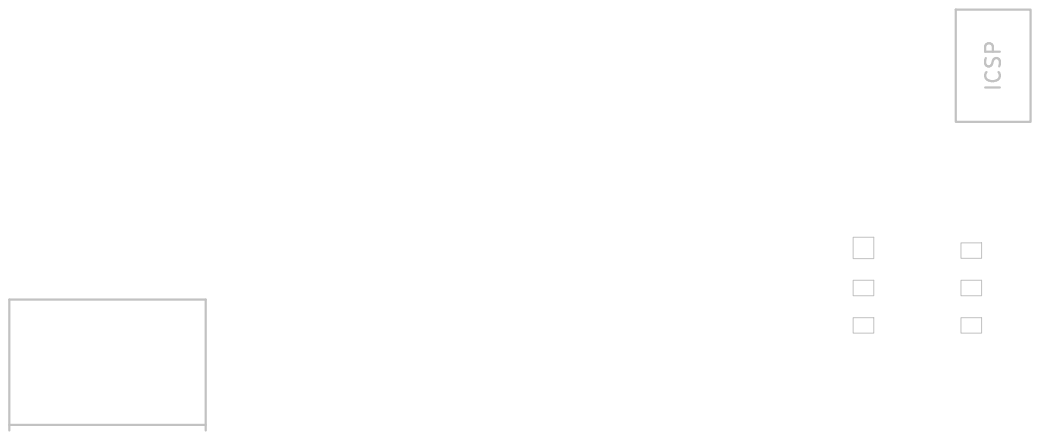
[picture p179: page 13]

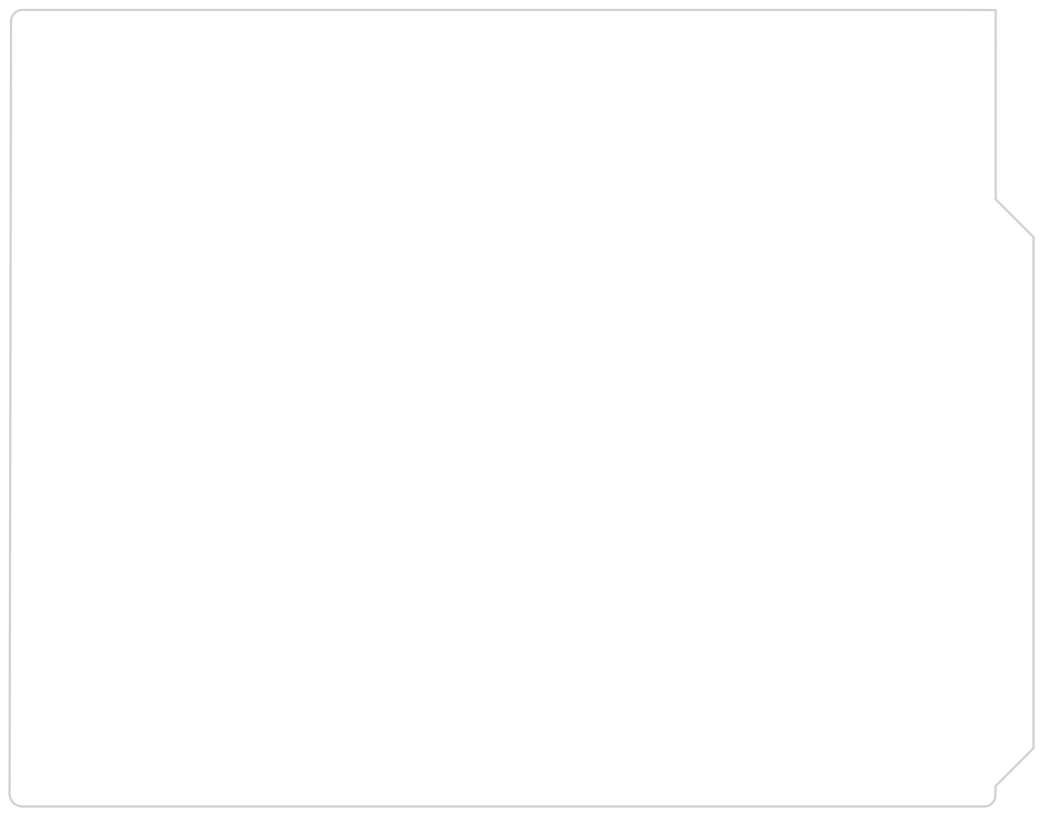
[picture p180: page 17]

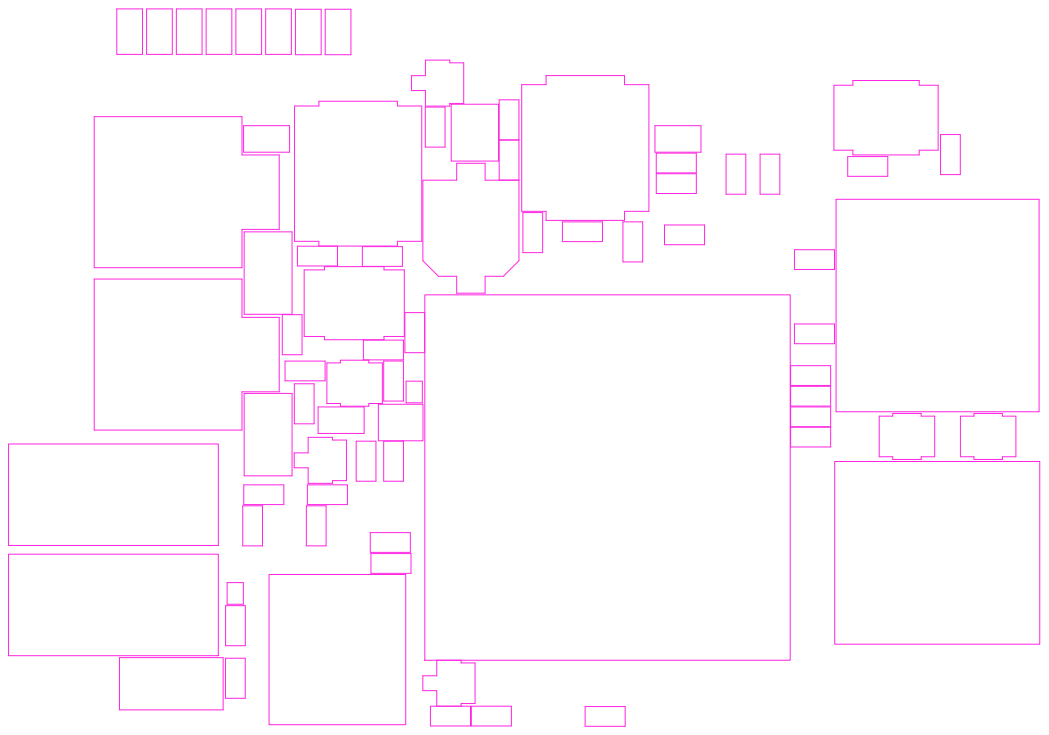
[picture p181: page 19]

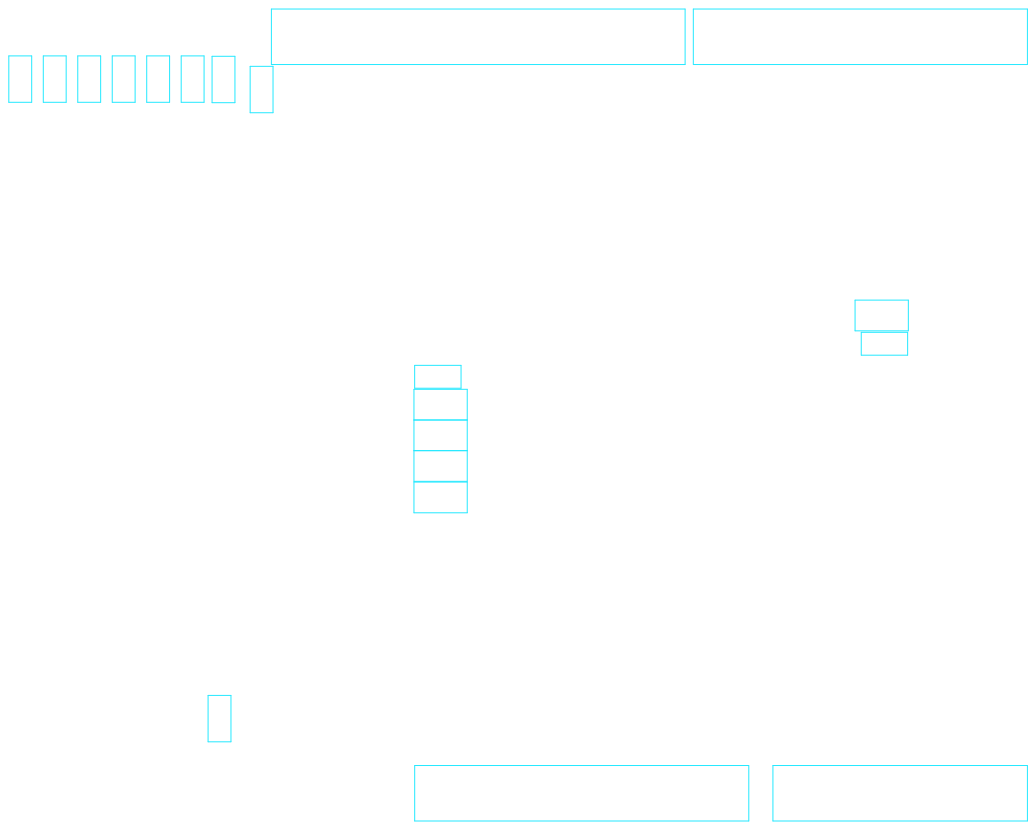
[picture p182: page 20]

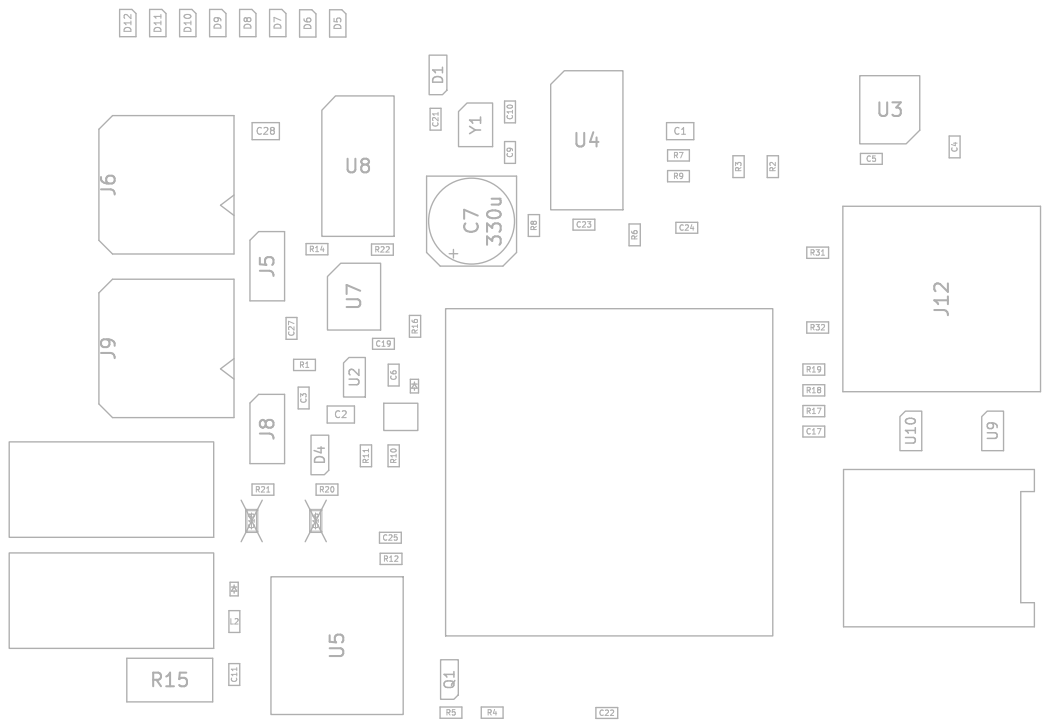
[picture p183: page 21]

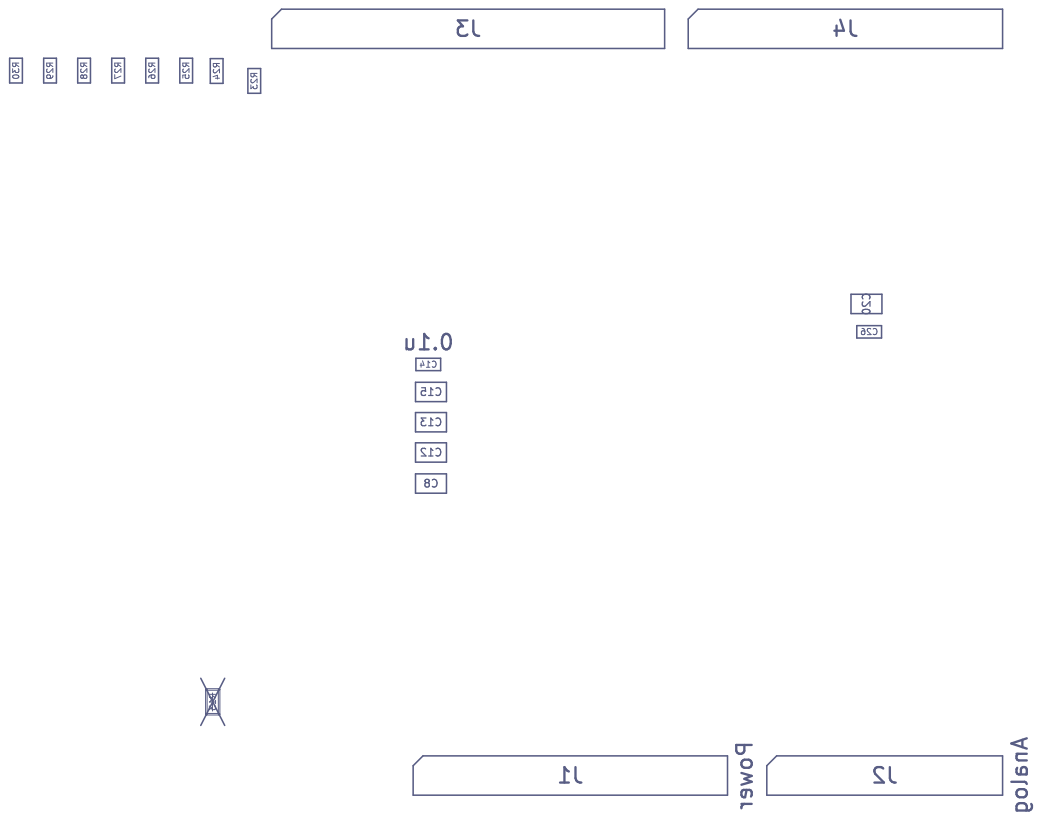
[picture p184: page 22]
