ntakao2006-web/RaceCapture/circuit/logger_v2/refs/TE_2452796_RevC.pdf

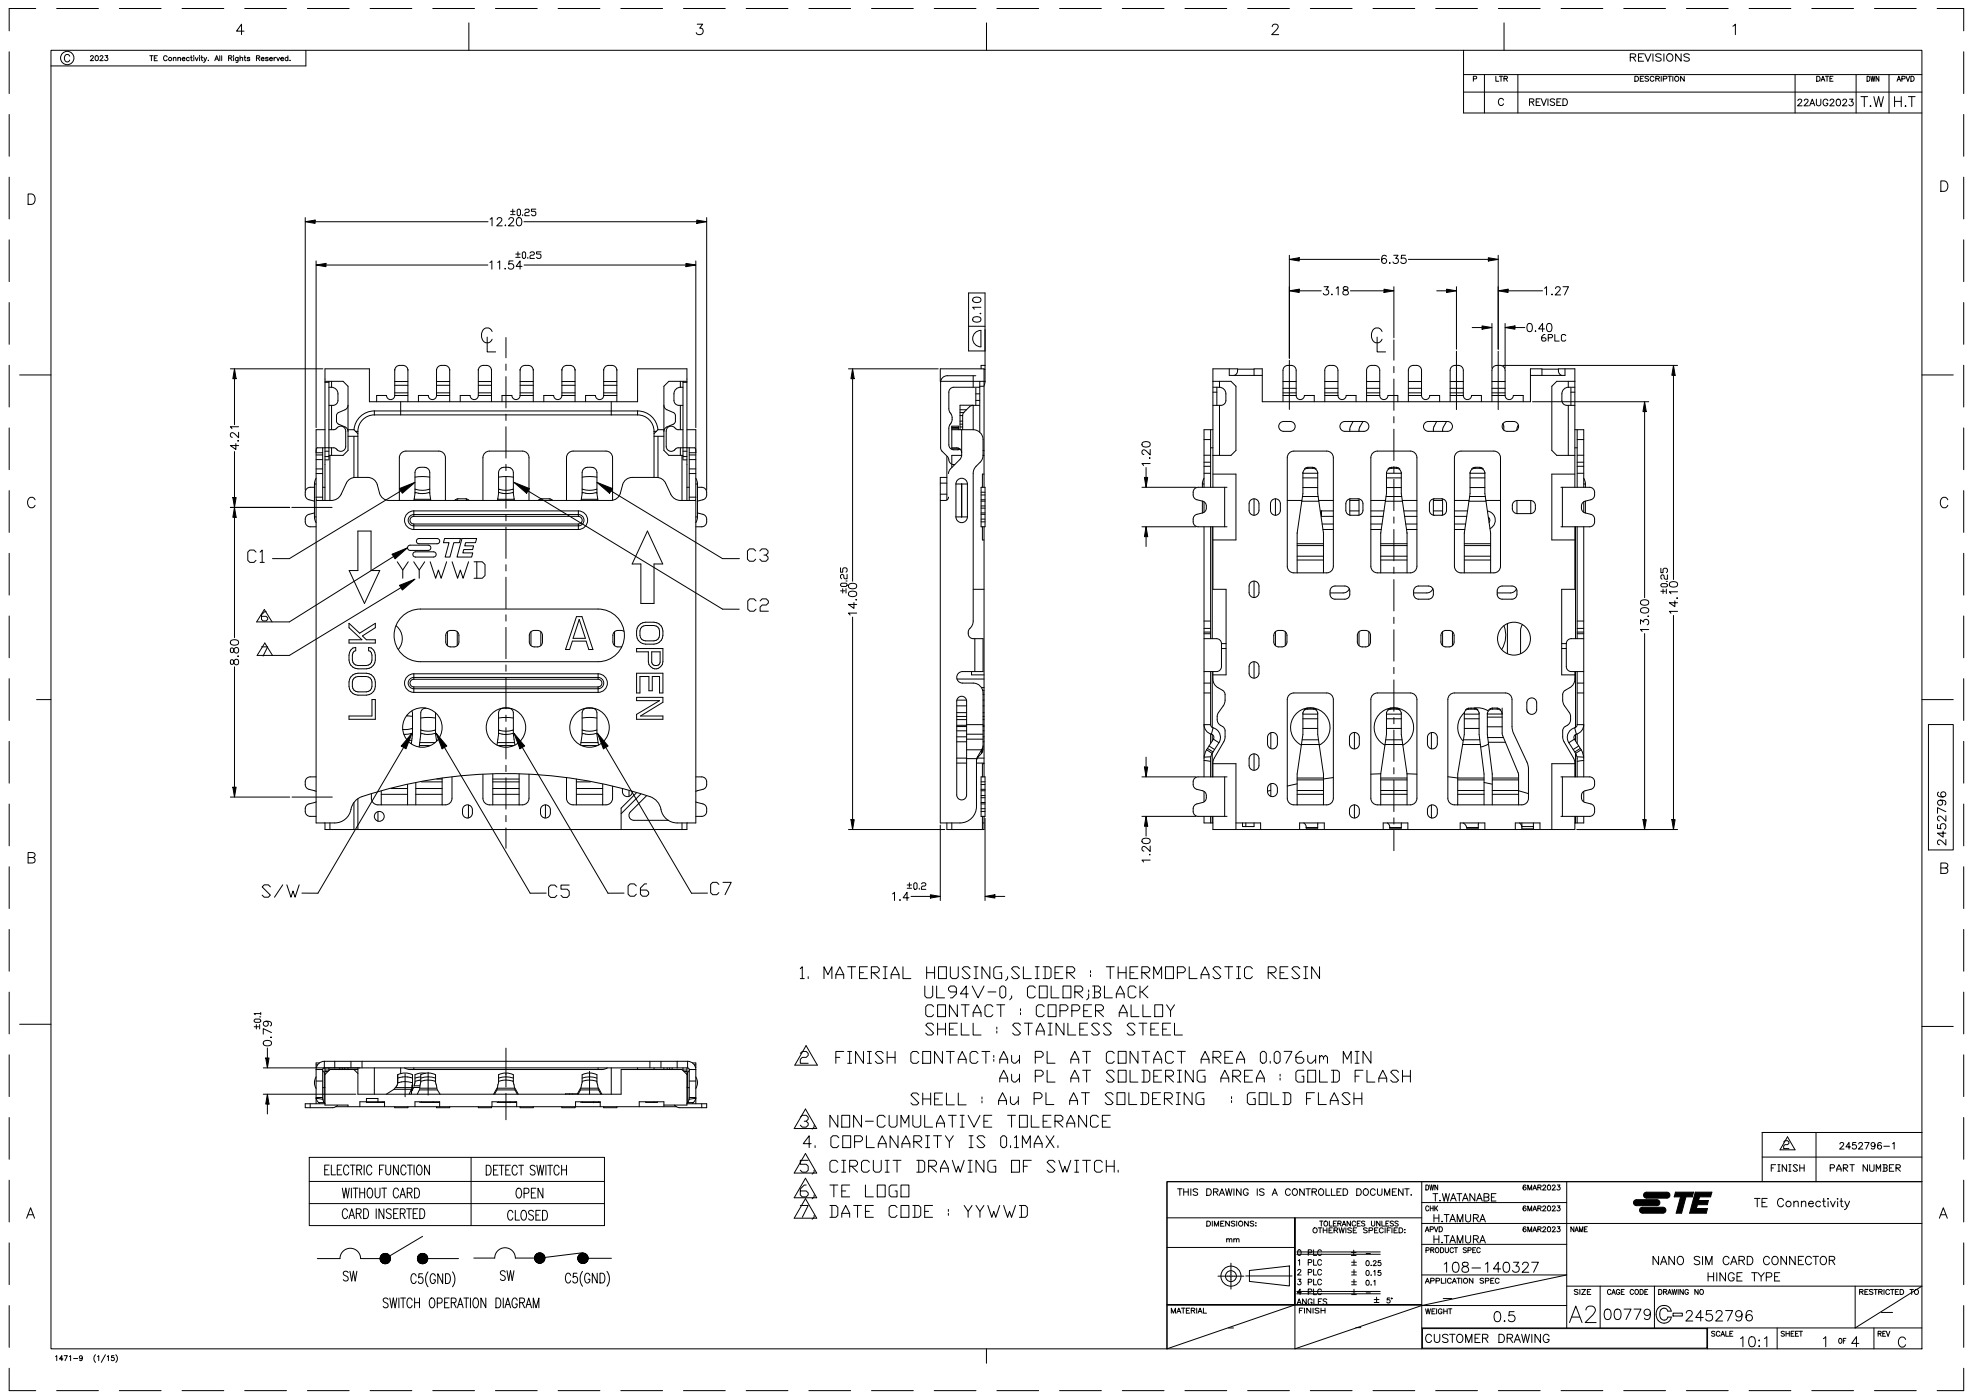
[picture p185: page 1]

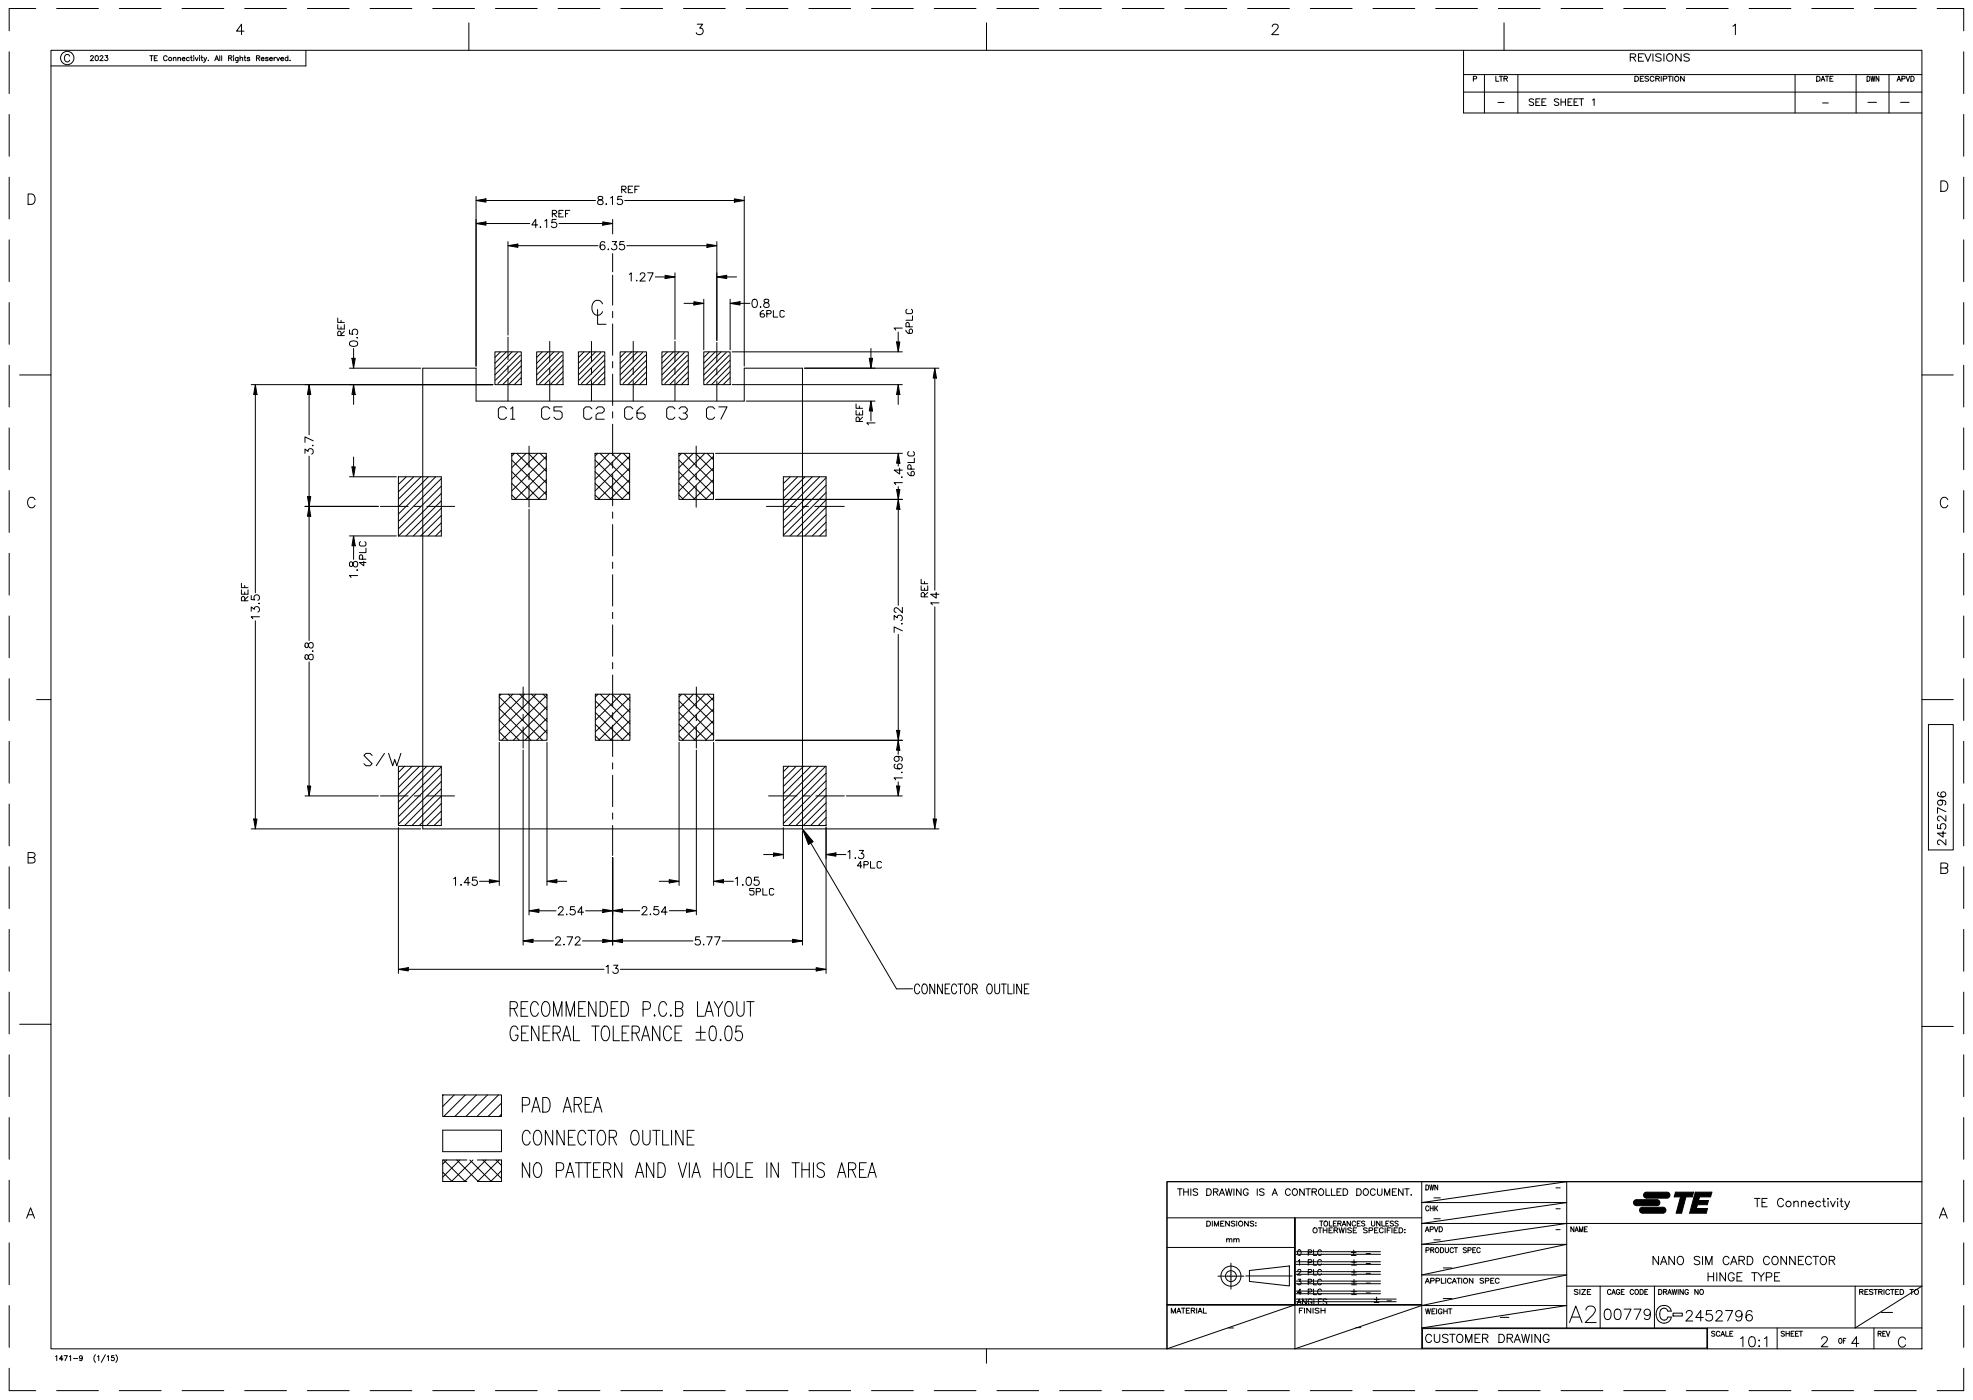
[picture p186: page 2]

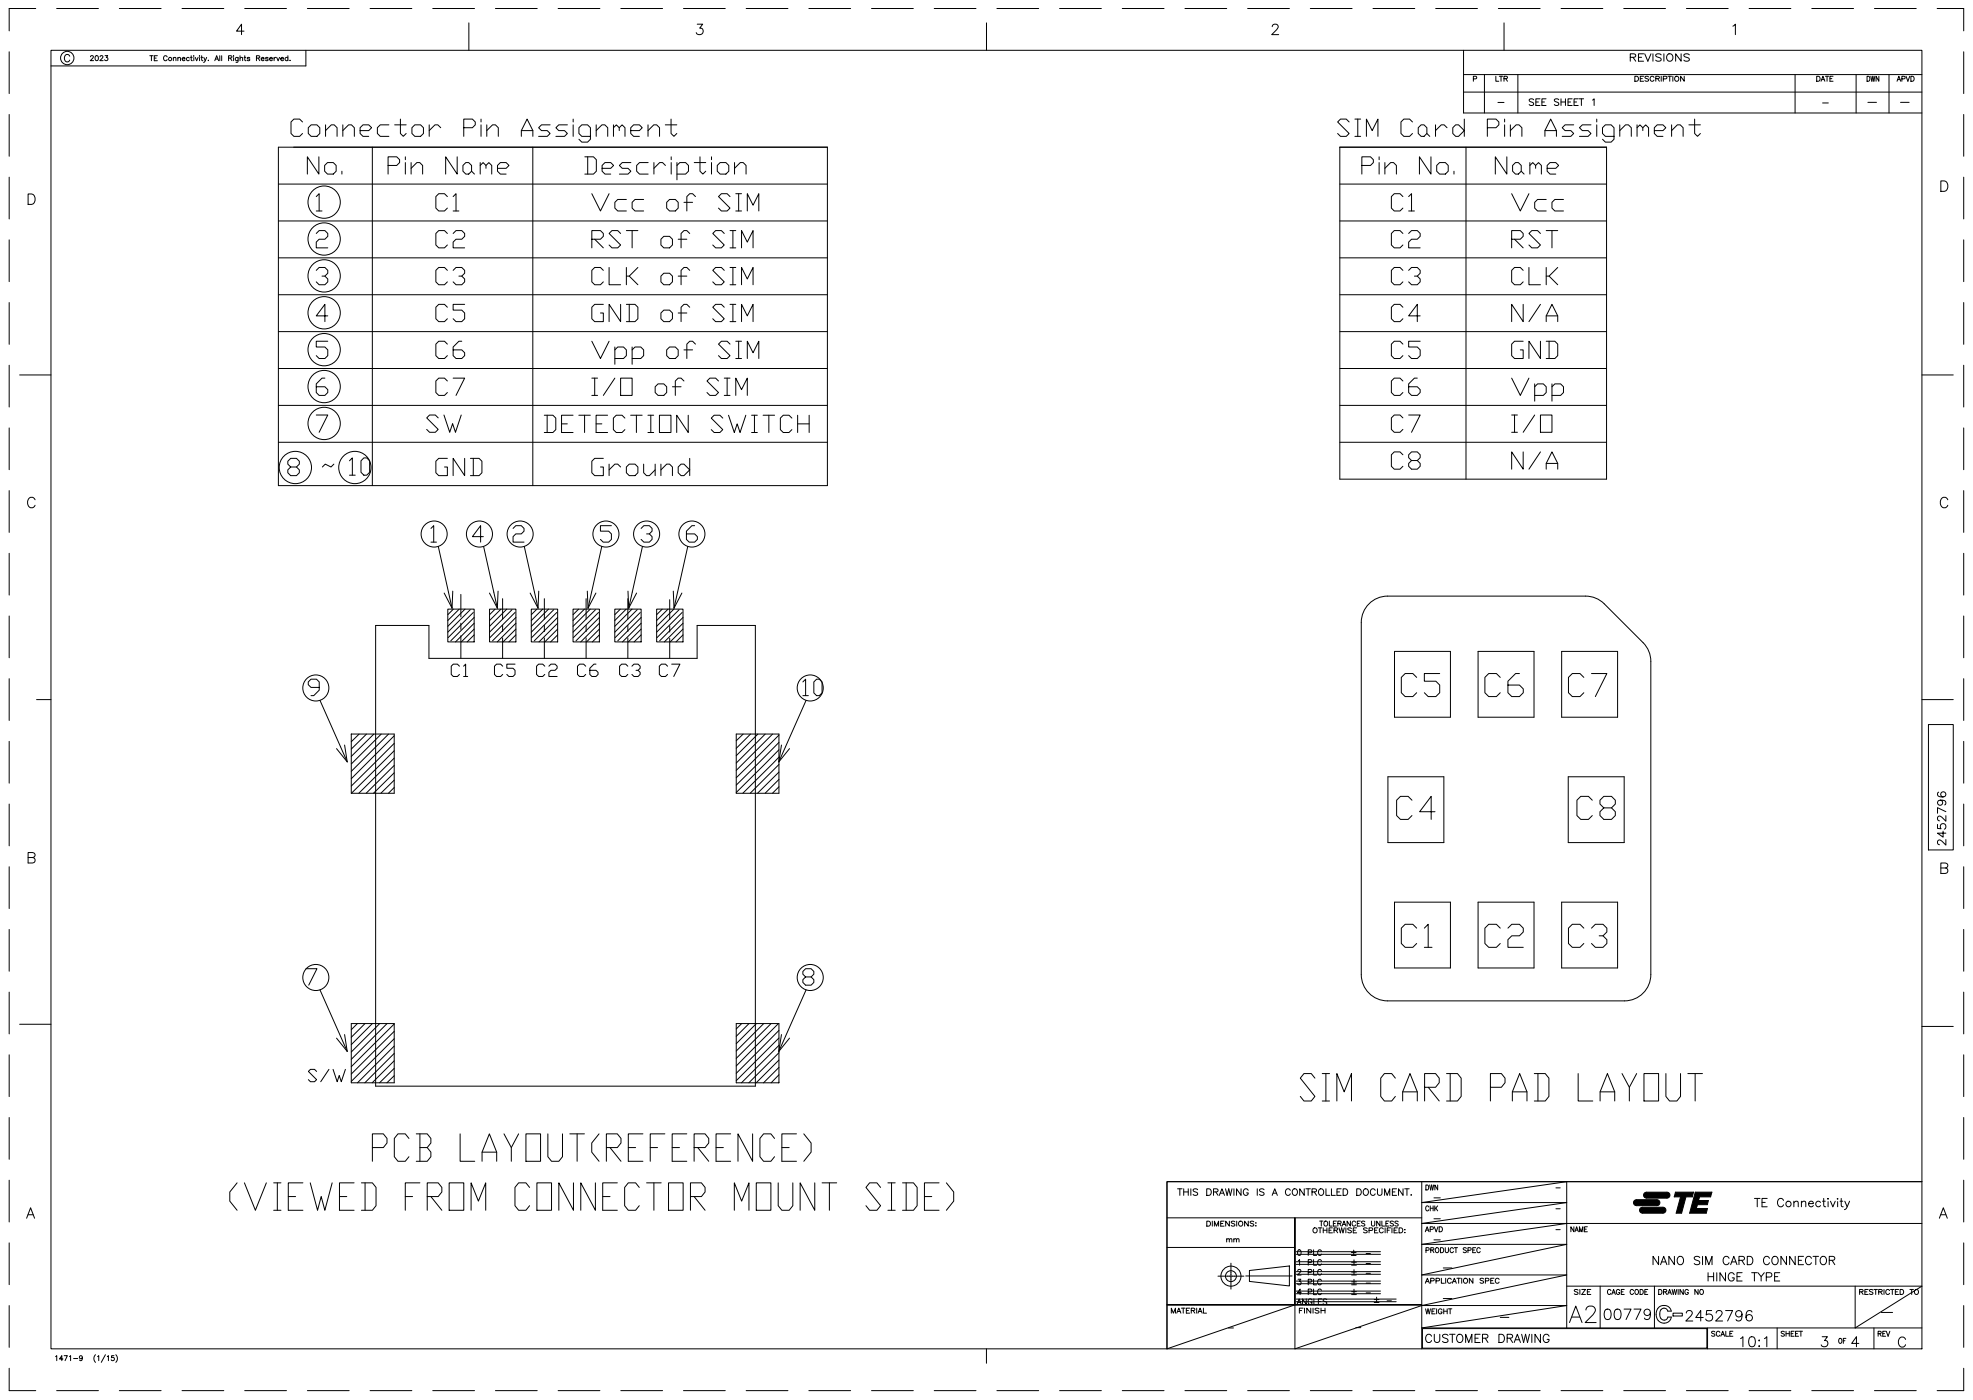
[picture p187: page 3]

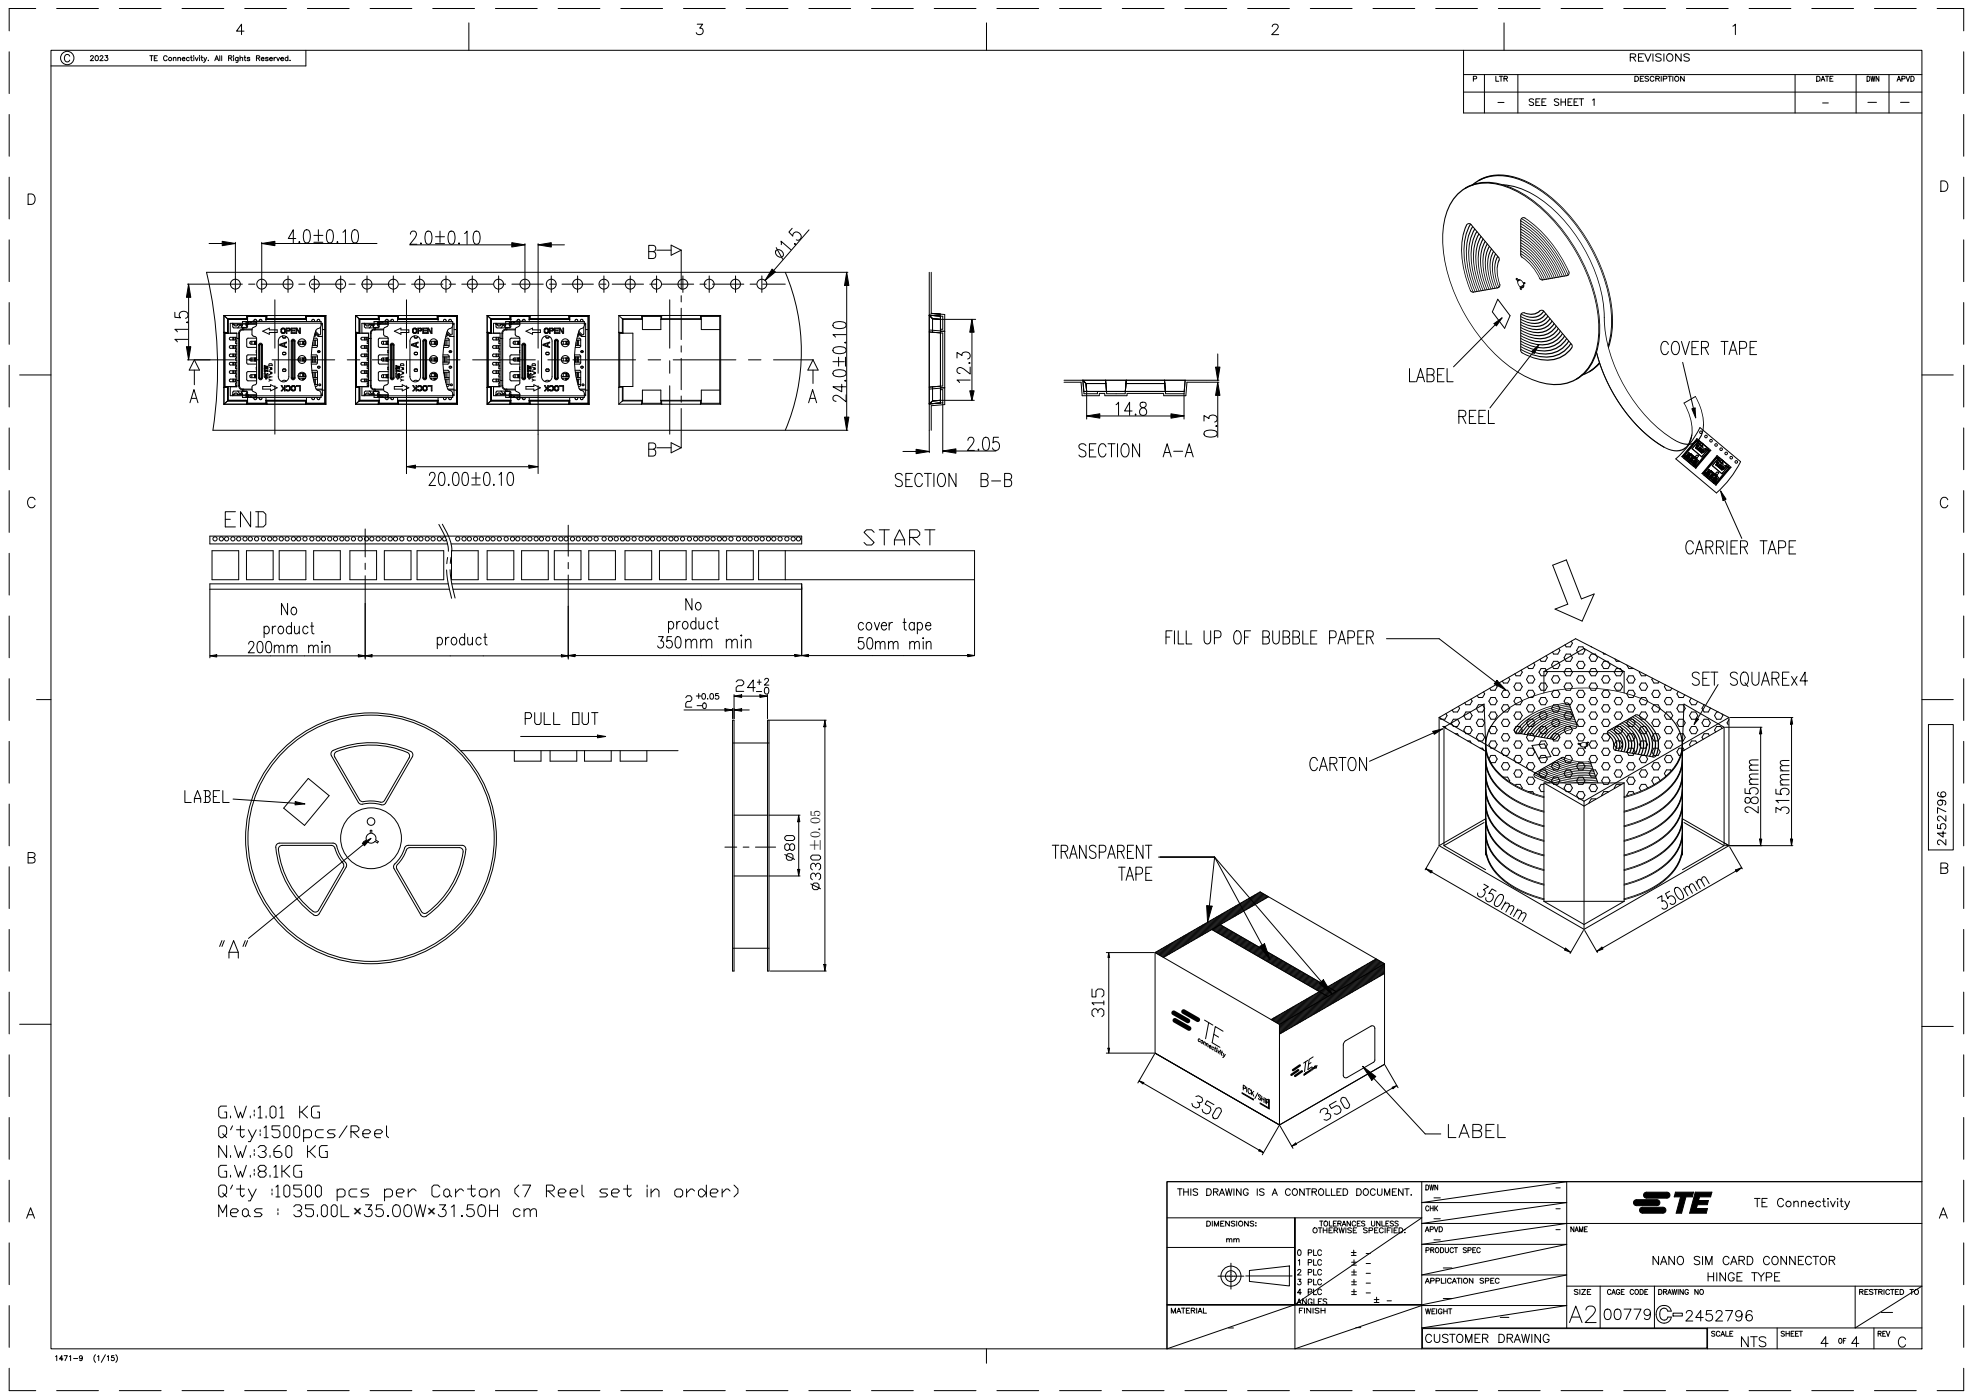
[picture p188: page 4]
