ntakao2006-web/RaceCapture/circuit/logger_v1/logger_v1_review.pdf

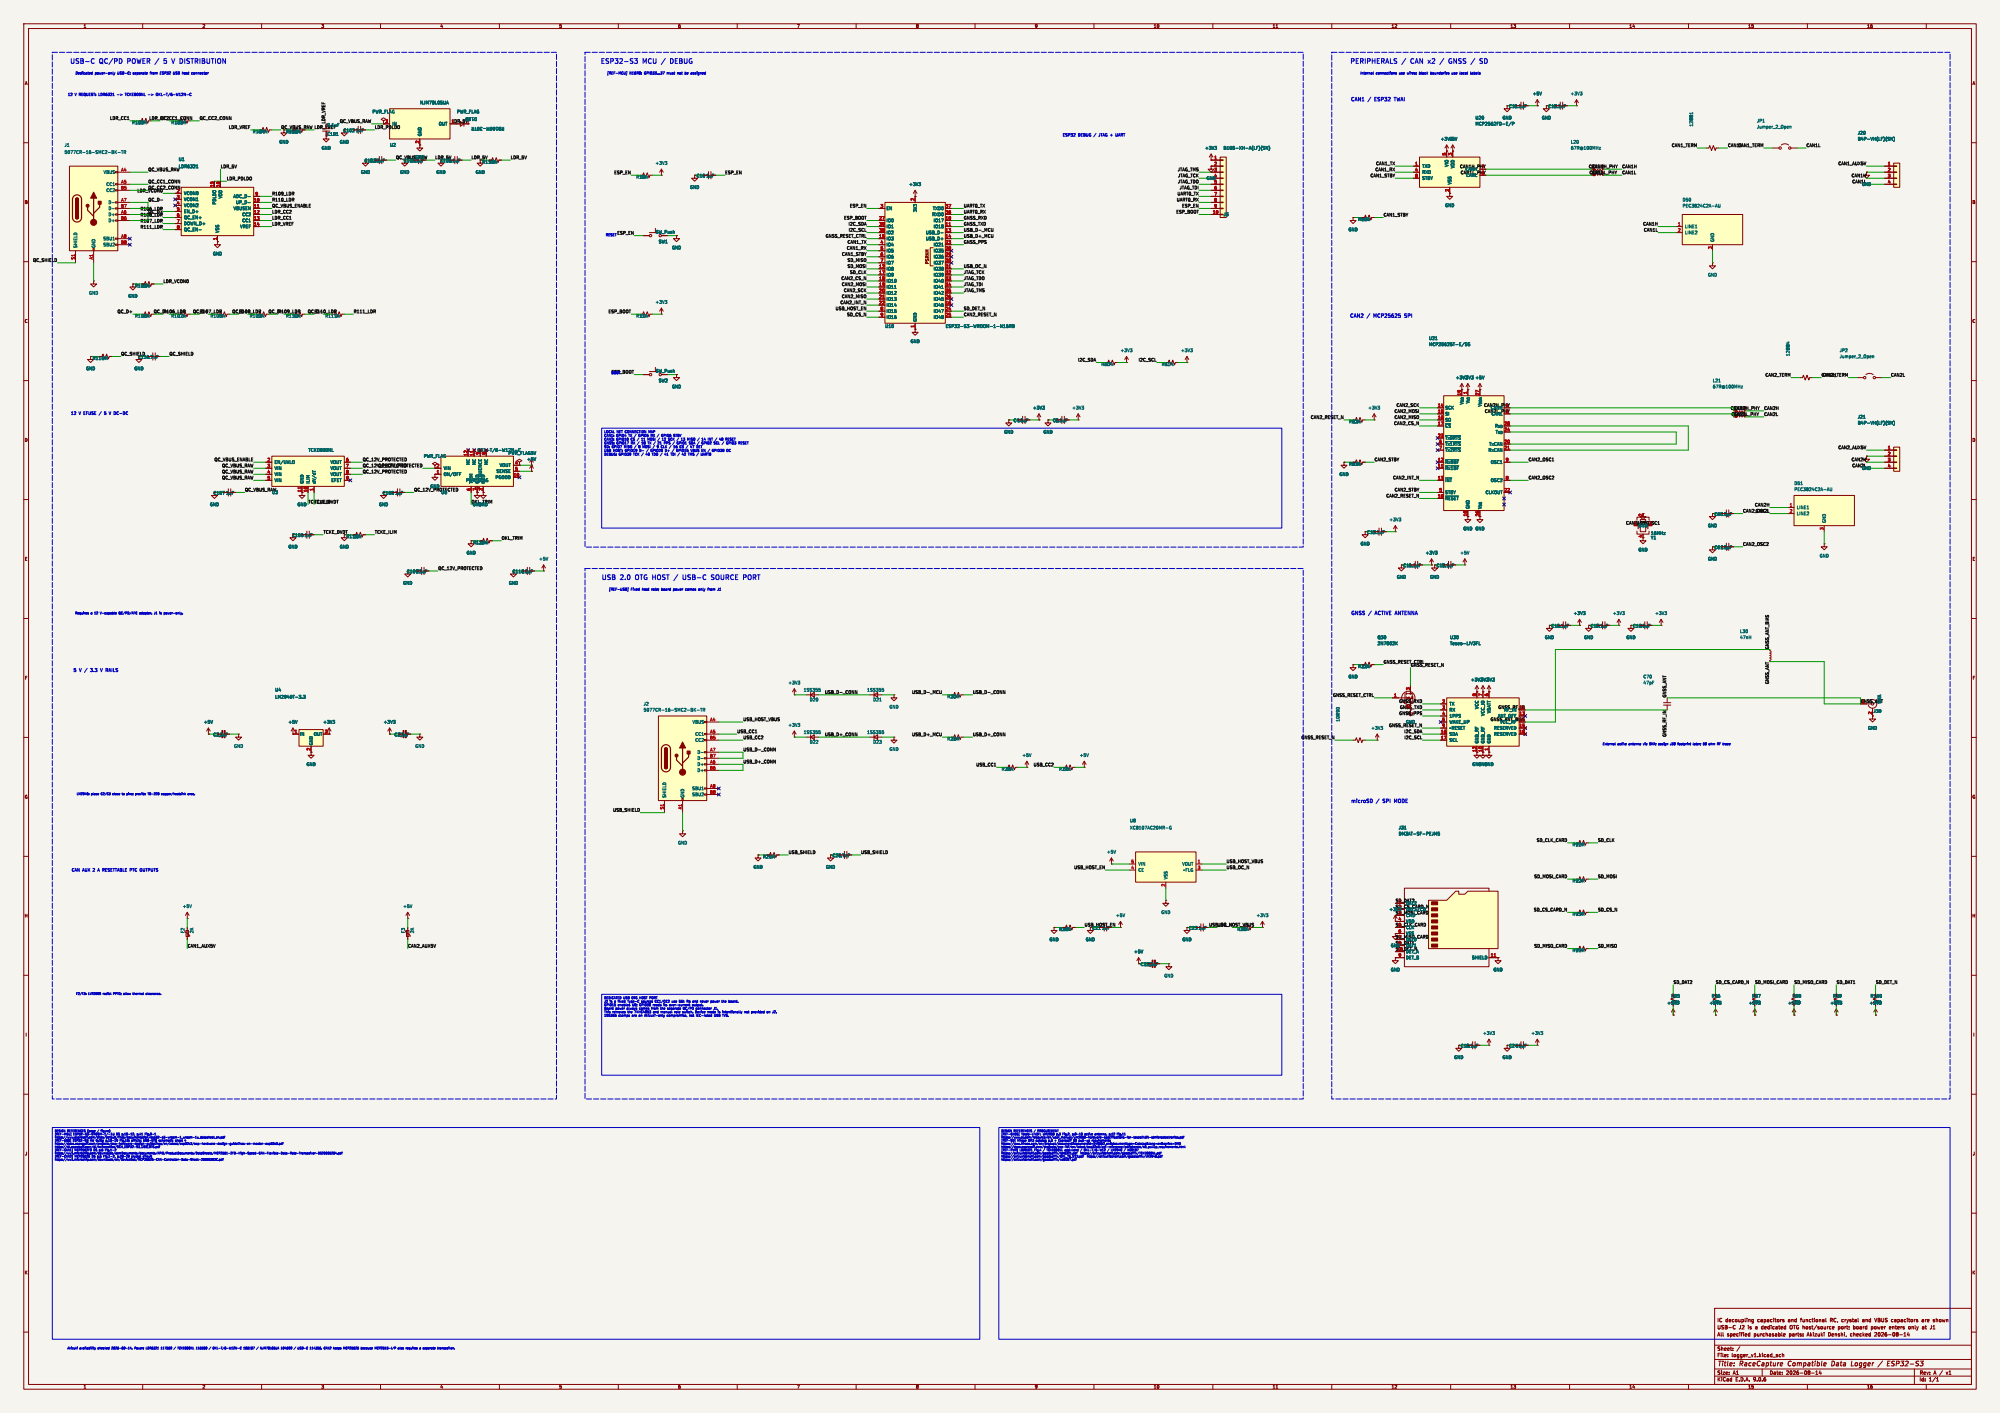
[picture p189: page 1]

PERIPHERALS / CAN x2 / GNSS / SD

J3B10B-XH-A(LF)(SN) C10 1uF GND GND

J21 B4P-VH(LF)(SN) GND

LOCAL NET CONNECTION MAP CAN1: GPIO4 TX / GPIO5 RX / GPIO6 STBY CAN2: GPIO10 CS / 11 MOSI / 12 SCK / 13 MISO / 14 INT / 48 RESET GNSS: GPIO17 RX / 18 TX / 21 PPS / GPIO1 SDA / GPIO2 SCL / GPIO3 RESET SD: GPIO7 MISO / 8 MOSI / 9 CLK / 16 CS / 47 DET USB HOST: GPIO19 D- / GPIO20 D+ / GPIO15 VBUS EN / GPIO38 OC

8 VOUT 4 SENSE 5 PGOOD 10 U3 TCKE800NL EN/UVLO 2 VIN 3 VIN 4 VIN 5 GND 11 ILIM 10 dV/dT

1 VOUT 6 VOUT 7 VOUT 8 EFET 9 U3 TCKE800NL VIN 2 ON/OFF 1 NC 12 TRIM

8 VOUT 4 SENSE 5 PGOOD 10 U5 OKL-T/6-W12N-C
C11010uF PWR_FLAG+5V

1 VOUT 6 VOUT 7 VOUT 8 EFET 9 GND

DEBUG: GPIO39 TCK / 40 TDO / 41 TDI / 42 TMS / UART0

3 D51 PEC3824C2A-AU GND GNDGND GND

GNSS / ACTIVE ANTENNA microSD / SPI MODE

CAN AUX 2 A RESETTABLE PTC OUTPUTS

DEDICATED USB OTG HOST PORT

https://www.espressif.com/sites/default/files/documentation/esp32-s3-wroom-1_wroom-1u_datasheet_en.pdf
https://docs.espressif.com/projects/esp-hardware-design-guidelines/en/latest/esp32s3/esp-hardware-design-guidelines-en-master-esp32s3.pdf https://dl.espressif.com/dl/schematics/SCH_ESP32-S3_USB_OTG.pdf
https://ww1.microchip.com/downloads/aemDocuments/documents/APID/ProductDocuments/DataSheets/MCP2561-2FD-High-Speed-CAN-Flexible-Data-Rate-Transceiver-DS20005284.pdf

DESIGN REFERENCES / PROCUREMENT
https://www.st.com/resource/en/user_manual/um2980-hardware-specifications-for-teseoliv3fl-stmicroelectronics.pdf

Id: 1/1 Title: RaceCapture Compatible Data Logger / ESP32-S3
