ntakao2006-web/RaceCapture/circuit/logger_v1/logger_v1.pdf

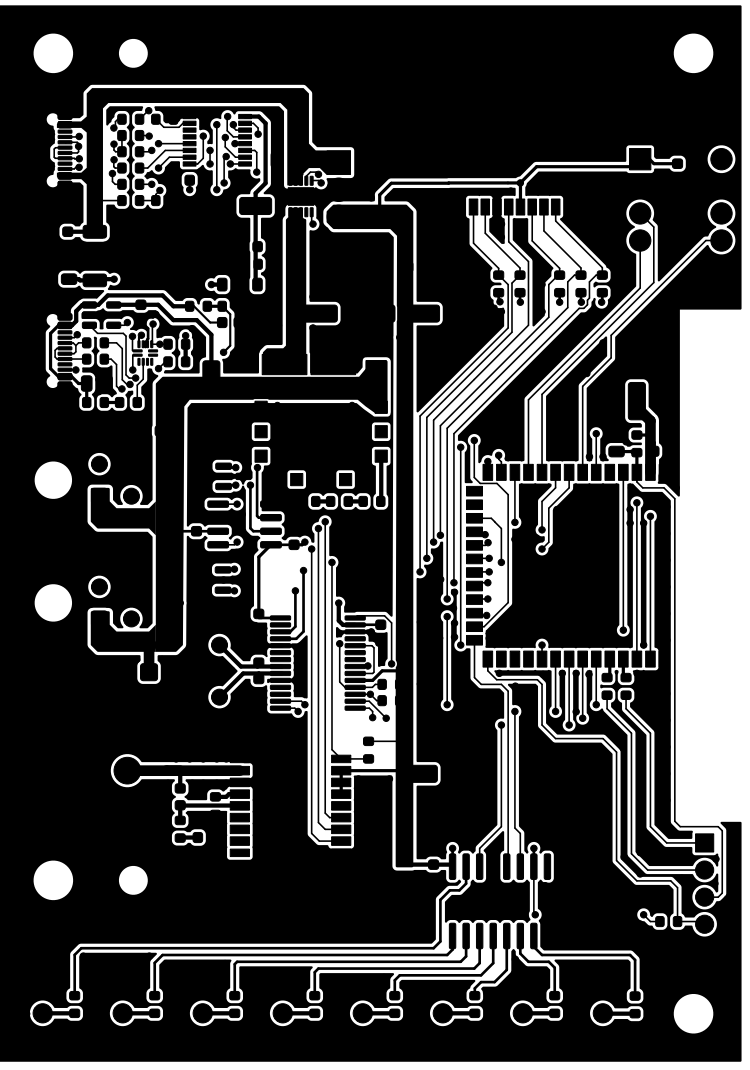
[picture p190: page 1]

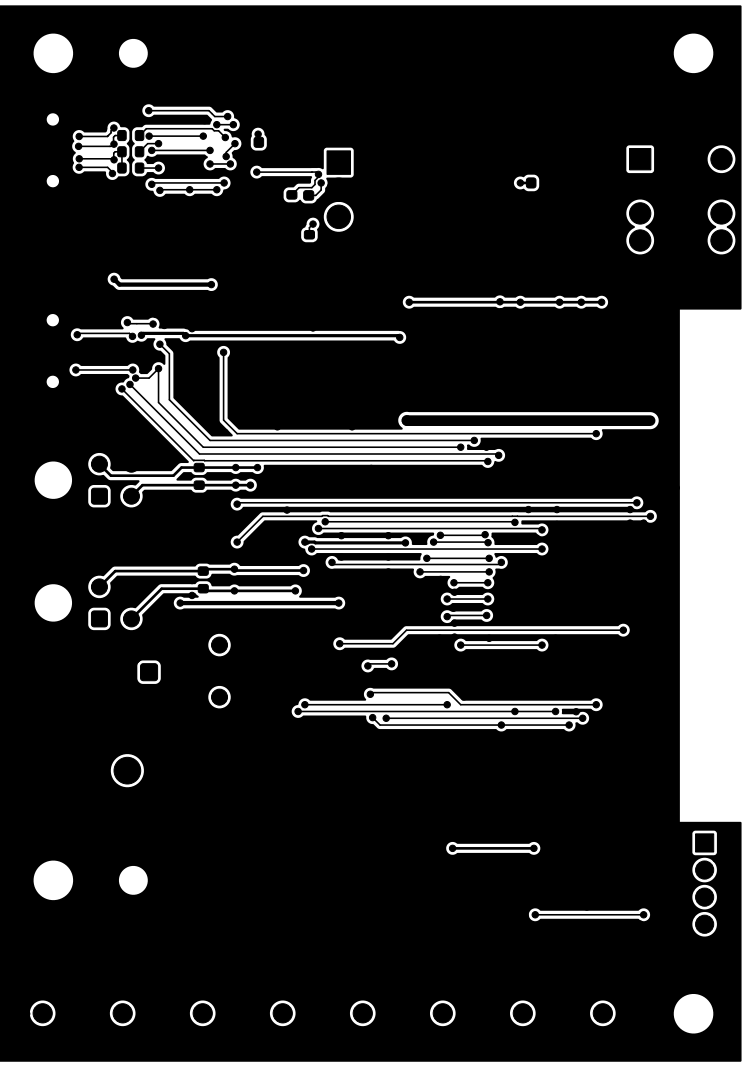
[picture p191: page 2]

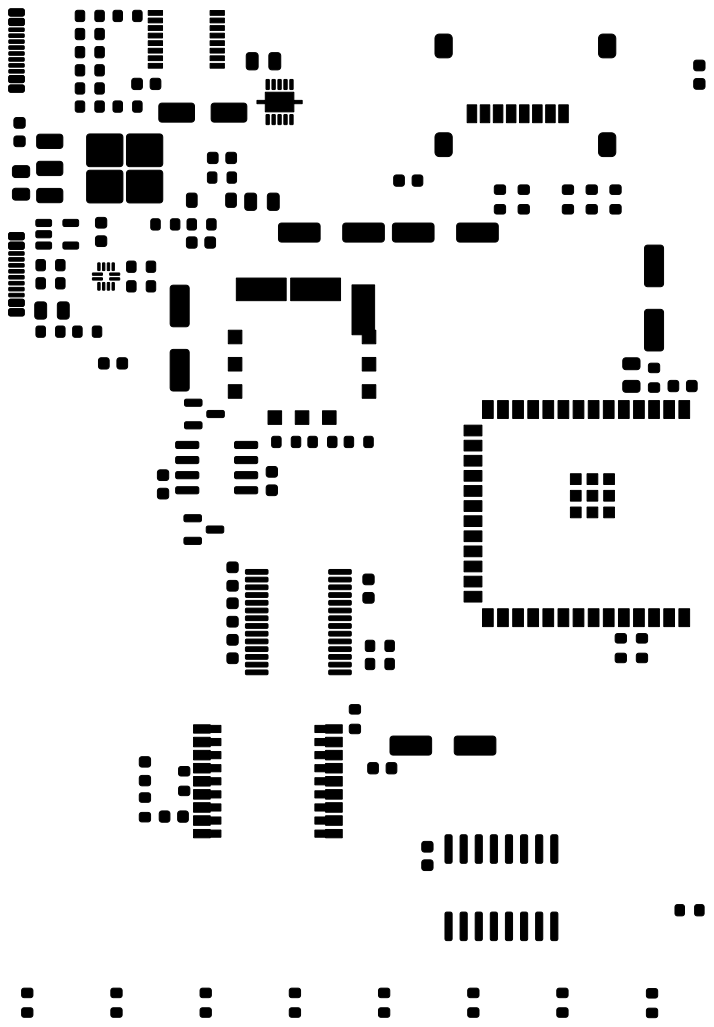
[picture p192: page 3]

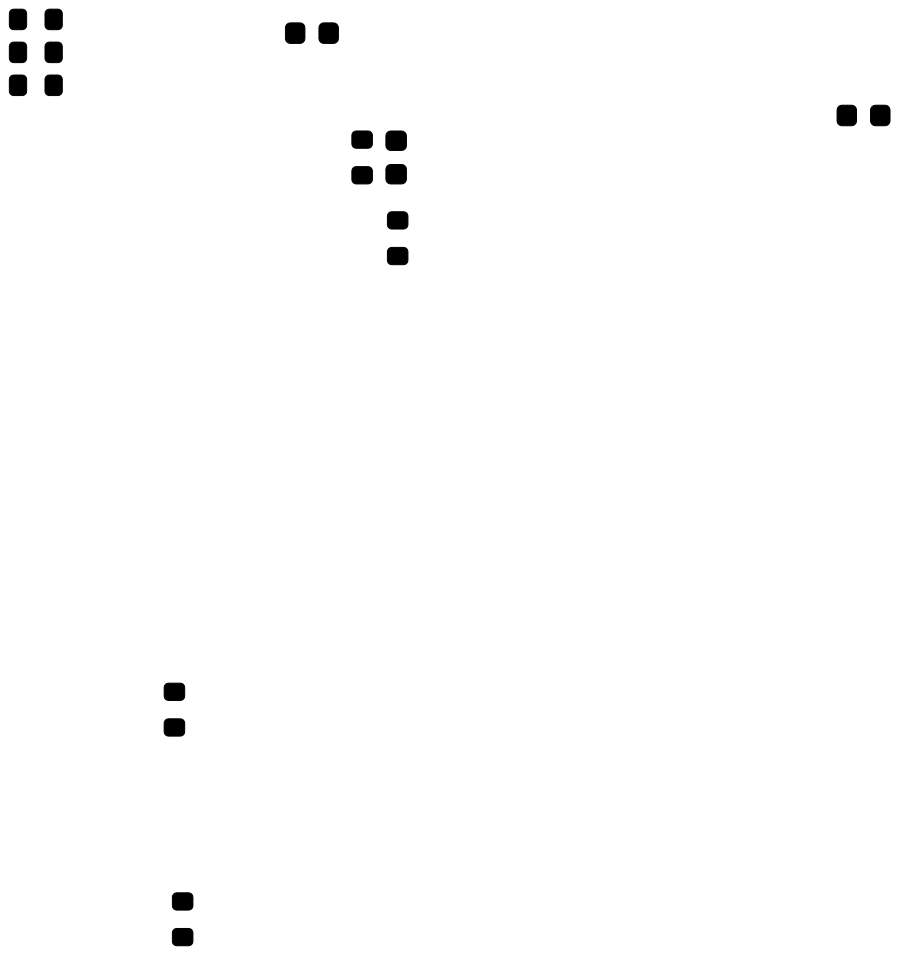
[picture p193: page 4]

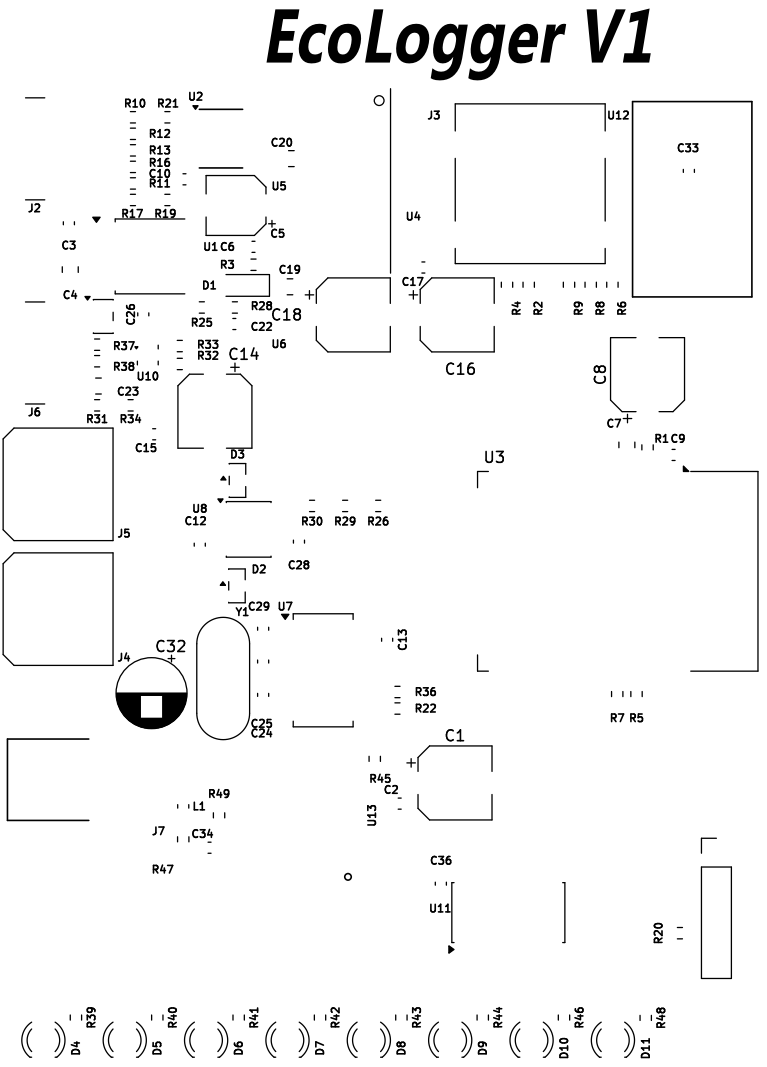
[picture p194: page 5]

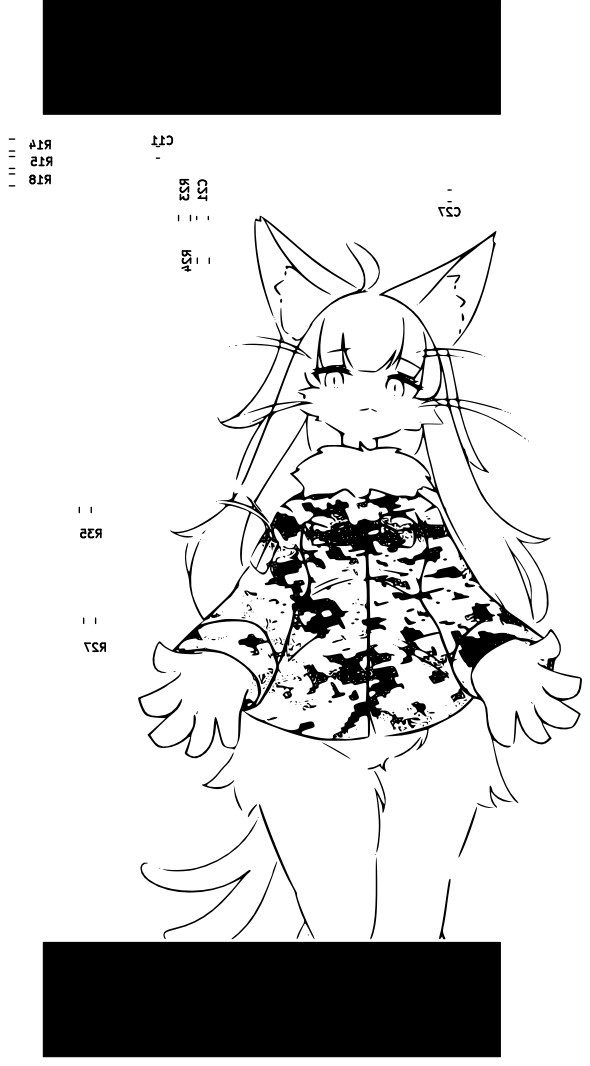
[picture p195: page 6]

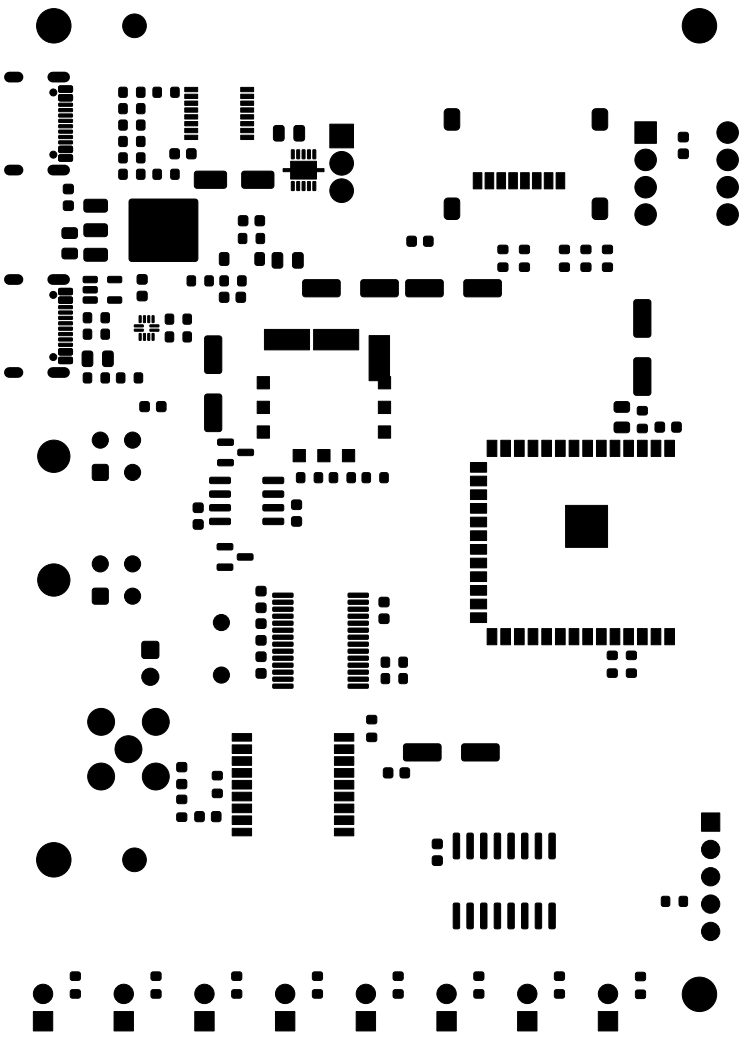
[picture p196: page 7]

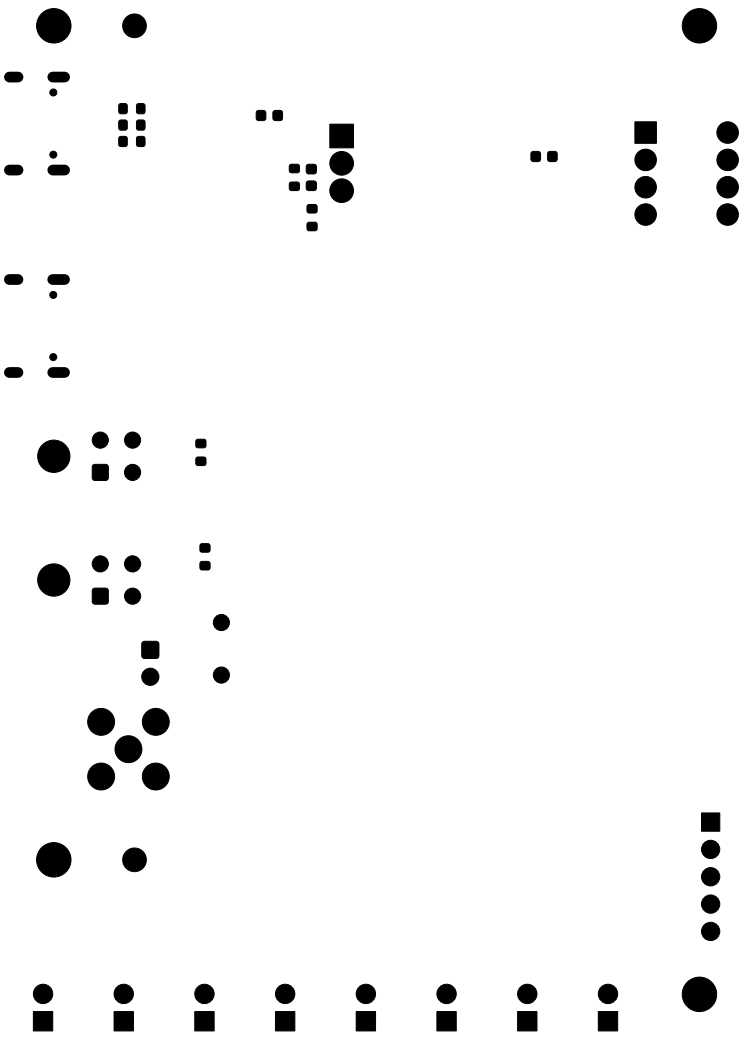
[picture p197: page 8]
