ntakao2006-web/RaceCapture/circuit/logger_v1/tmp/3557-15.pdf

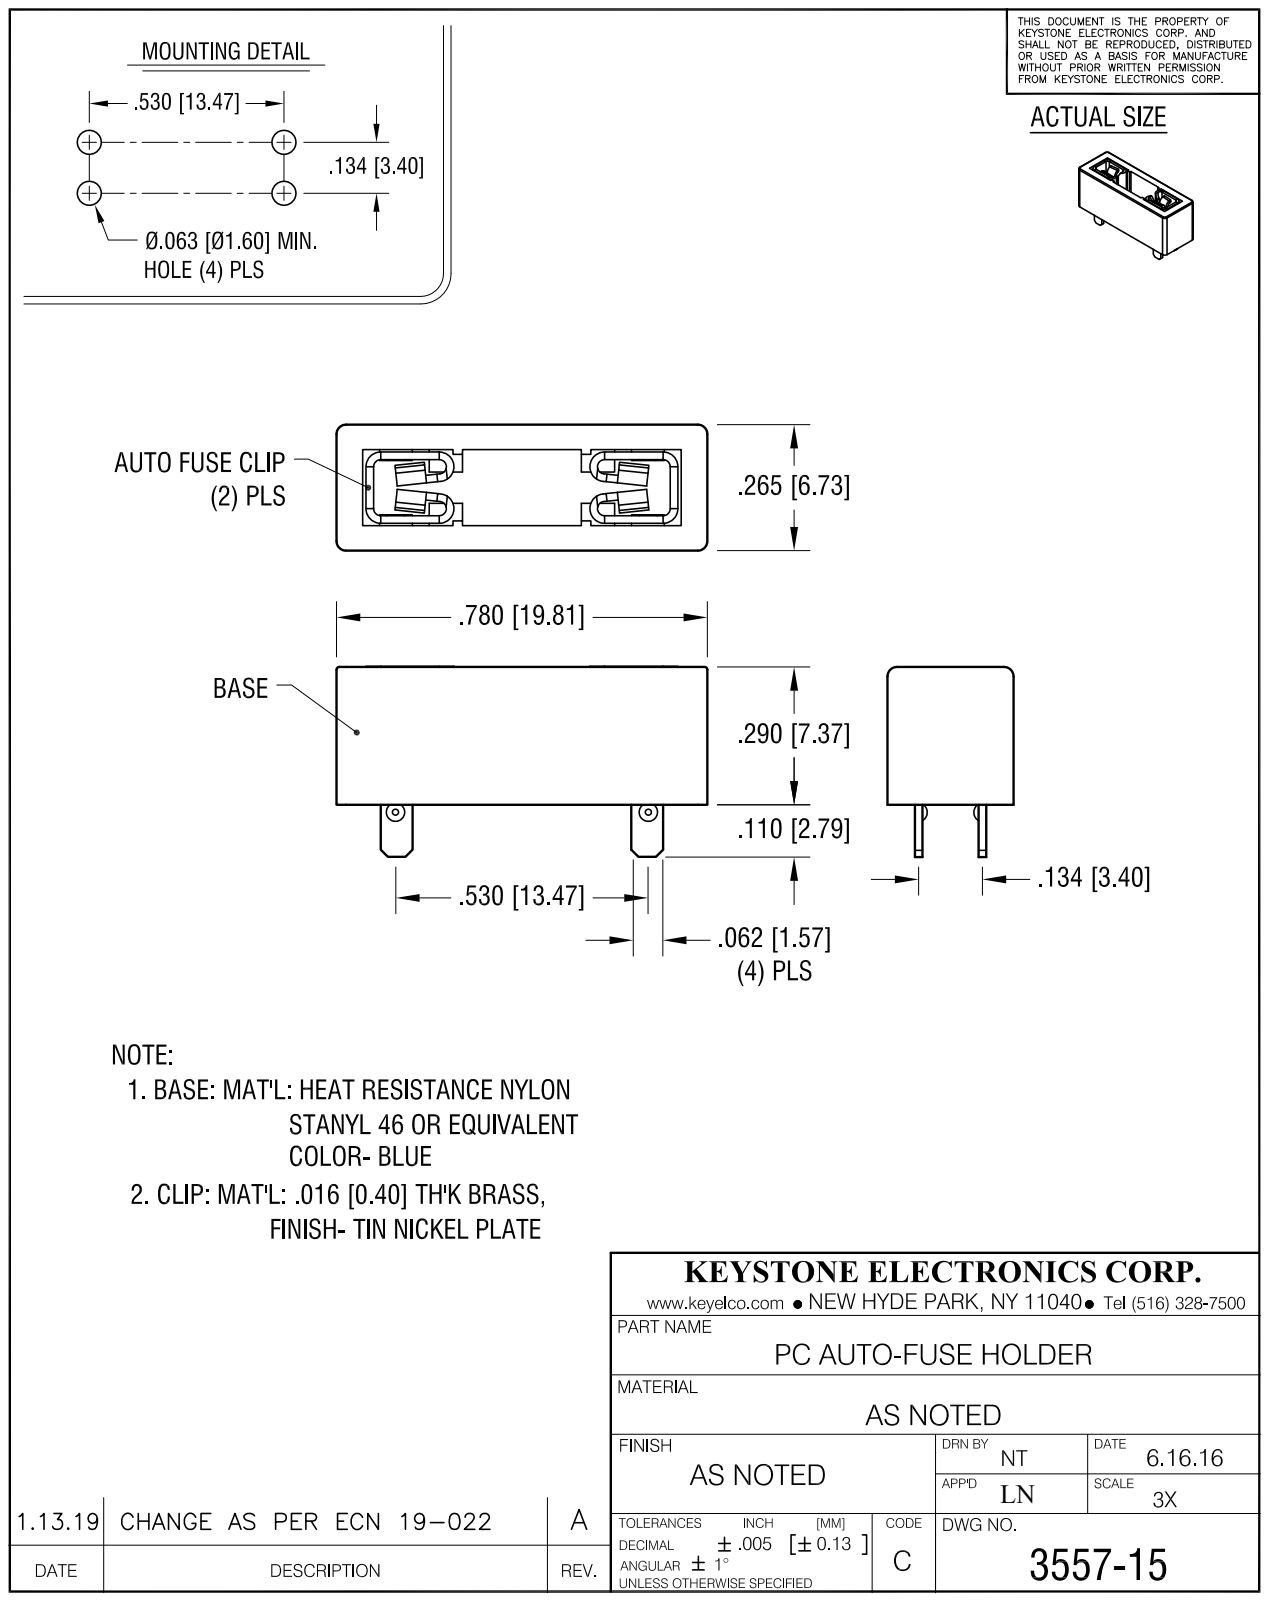
[picture p198: page 1]
