ntakao2006-web/RaceCapture/(list of files, drawings)

Other design files:
circuit/logger_v2/output/design_review_20260907/schematic_connectivity_validation.json
circuit/logger_v2_ups/output/mlcc_22u_20261009/pcb_fix_verification.json
