ntakao2006-web/RaceCapture/outputs/logger_v2_order_20260923/kicad_metadata_backup_20260923_215408/logger_v2.kicad_pcb

## KiCad design outputs/logger_v2_order_20260923/kicad_metadata_backup_20260923_215408/logger_v2.kicad_pcb (2026-10-22)

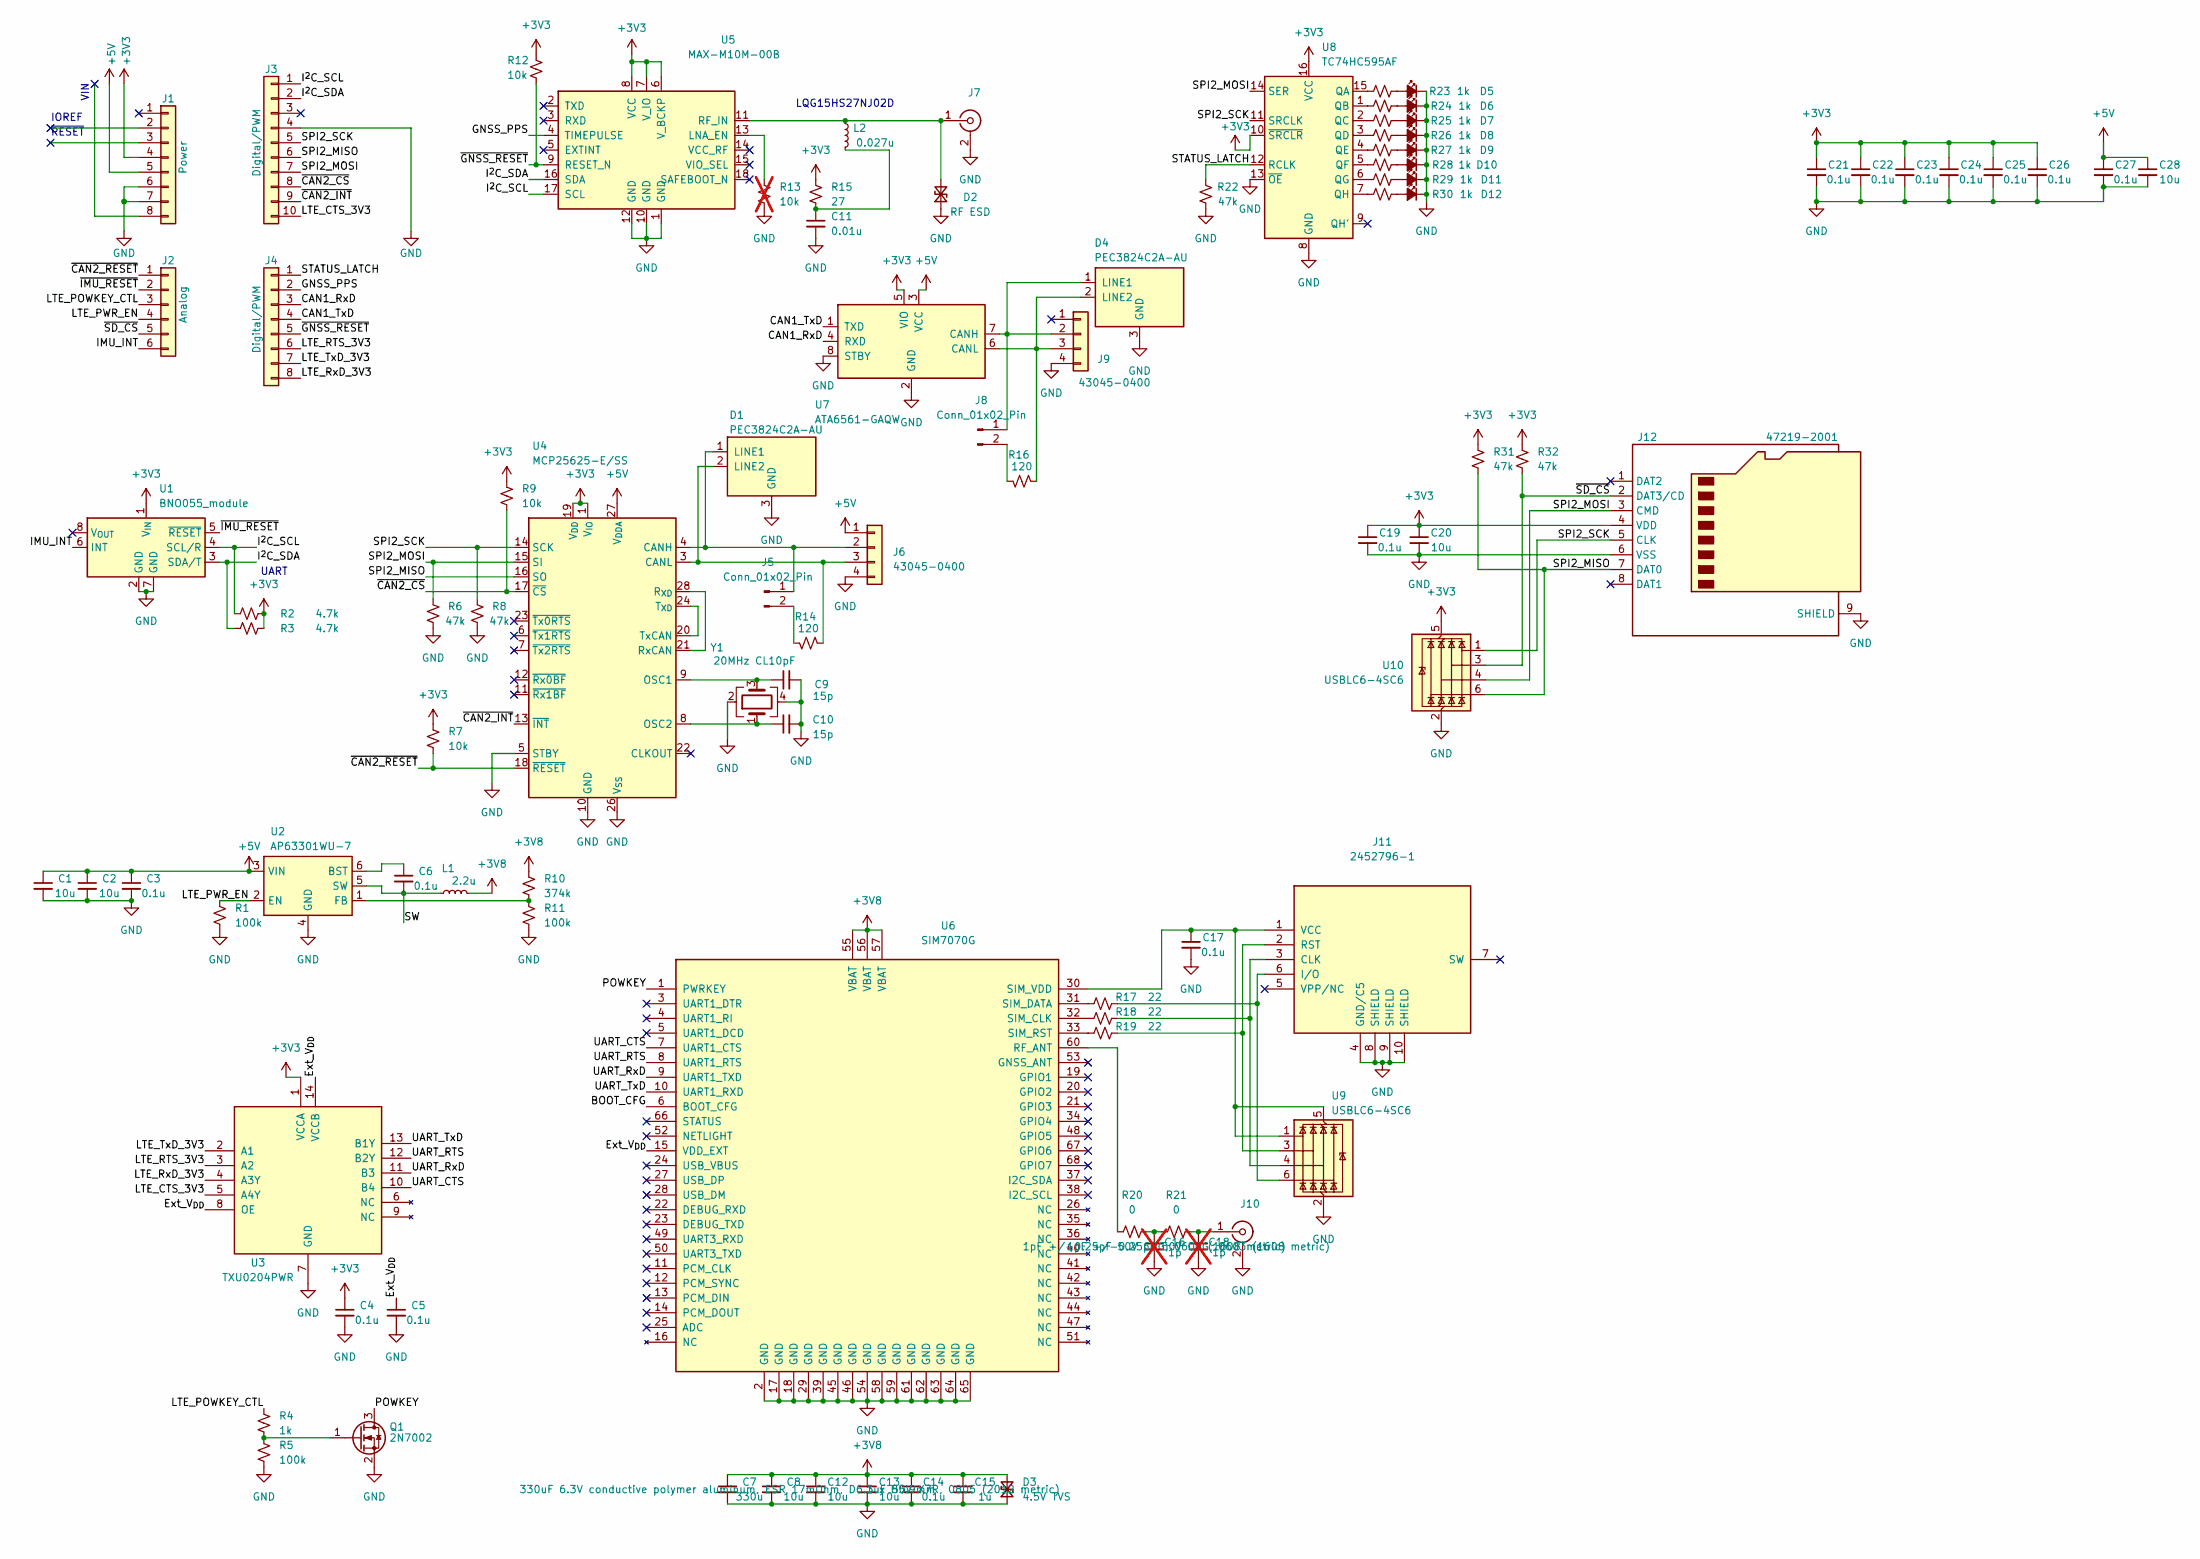
[picture p199: schematic logger_v2.kicad_sch, Logger v2 - UNO Q Sensor / CAN Shield]

Parts:
C1, C2, C8, C12, C13, C28: 10u; C_0805_2012Metric; MPN GRM21BR71A106KE51; LCSC C15850
C3, C4, C5, C6, C14, C17, C19, C21, C22, C23, C24, C25, C26, C27: 0.1u; C_0603_1608Metric; MPN GRM188R72A104KA35D; LCSC C14663
C7: 330u; CP_Elec_6.3x5.9; MPN 6SVPC330M
C9, C10: 15p; C_0603_1608Metric; MPN CC0603N150J500; LCSC C1647
C11: 0.01u; C_0603_1608Metric; MPN GRM188B11H103KA01; LCSC C14663
C15: 1u; C_0805_2012Metric; MPN C2012X7R1H105KT000N
C16, C18: 1p; C_0603_1608Metric; MPN CC0603CRNPO9BN1R0; not fitted
C20: 10u; C_0805_2012Metric; MPN C2012X7R1H105KT000N
D1, D4: PEC3824C2A-AU; SOT-23; MPN PEC3824C2A-AU_R1_000A1; LCSC C14486
D2: RF ESD; D_SOD-882; MPN PESD5V0F1BL-Q; LCSC C45961
D3: 4.5V TVS; Prisemi_DFN1006_2L
D5, D6, D7, D8, D9, D10, D11, D12: GREEN 0805; LED_0805_2012Metric_ShieldSilk; MPN OSG80805C1C; LCSC C2297
J1: Power; PinHeader_1x08_P2.54mm_Vertical; MPN FH105-1x8SG/RH
J2: Analog; PinHeader_1x06_P2.54mm_Vertical; MPN FH105-1x6SG/RH
J3: Digital/PWM; PinHeader_1x10_P2.54mm_Vertical; MPN FH105-1x10SG
J4: Digital/PWM; PinHeader_1x08_P2.54mm_Vertical; MPN FH105-1x8SG/RH
J5, J8: Conn_01x02_Pin; PinHeader_1x02_P2.54mm_Vertical
J6, J9: 43045-0400; Molex_Micro-Fit_3.0_43045-0400_2x02_P3.00mm_Horizontal; MPN 43045-0400
J7, J10: S-037-TGG; SMA_S-037-TGG_Horizontal; MPN S-037-TGG
J11: 2452796-1; nanoSIM_TE_2452796-1_Hinge; MPN 2452796-1
J12: 47219-2001; Molex_47219-2001; MPN 47219-2001
L1: 2.2u; L_Murata_DFE252012P; MPN DFE252012P-2R2M=P2
L2: 0.027u; L_0603_1608Metric; MPN LQW18AN27NJ00D
Q1: 2N7002; SOT-23; MPN 2N7002
R1, R5, R11: 100k; R_0603_1608Metric; MPN RK73B1JTTD103J; LCSC C25804
R2, R3: 4.7k; R_0603_1608Metric; MPN RK73B1JTTD472J; LCSC C23162
R4: 1k; R_0603_1608Metric; MPN RK73B1JTTD103J; LCSC C25804
R6, R8, R22: 47k; R_0603_1608Metric; MPN RC0603J47K; LCSC C25819
R7, R9, R12: 10k; R_0603_1608Metric; MPN RK73B1JTTD103J; LCSC C25804
R10: 374k; R_0603_1608Metric; MPN RK73B1JTTD103J; LCSC C25804
R13: 10k; R_0603_1608Metric; MPN RK73B1JTTD103J; LCSC C25804; not fitted
R14, R16: 120; R_0603_1608Metric; MPN RC0603J120R; LCSC C22787
R15: 27; R_2512_6332Metric; MPN CRCW251227R0JNEG; LCSC C25478
R17, R18, R19: 22; R_0603_1608Metric; MPN RK73B1JTTD103J; LCSC C25804
R20, R21: 0; R_0603_1608Metric; MPN RK73B1JTTD103J; LCSC C25804
R23, R24, R25, R26, R27, R28, R29, R30: 1k; R_0603_1608Metric; MPN RK73B1JTTD102J; LCSC C23228
R31, R32: 47k; R_0603_1608Metric; MPN RK73B1JTTD103J; LCSC C25804
U1: BNO055_module; AE_BNO055_BO_ShieldSilk; MPN AE-BNO055-BO
U2: AP63301WU-7; Diodes_TSOT26; MPN AP63301WU-7
U3: TXU0204PWR; TSSOP-14_4.4x5mm_P0.65mm; MPN TXU0204PWR
U4: MCP25625-E/SS; SSOP-28_5.3x10.2mm_P0.65mm; MPN MCP25625T-E/SS; LCSC C184944
U5: MAX-M10M-00B; MAX_M10M_00B_LCC18; MPN MAX-M10M-00B; LCSC C5119087
U6: SIM7070G; SIMCom_SIM7070G_LCC68_24x24mm_P1mm; MPN SIM7070G
U7: ATA6561-GAQW; SOIC-8_3.9x4.9mm_P1.27mm; MPN ATA6561-GAQW-N; LCSC C2929602
U8: TC74HC595AF; Toshiba_SOP16_P300_1.27A; MPN TC74HC595AF; LCSC C5947
U9, U10: USBLC6-4SC6; SOT-23-6; MPN USBLC6-4SC6
Y1: 20MHz CL10pF; Crystal_SMD_3225-4Pin_3.2x2.5mm; MPN 20M10PB/XT324-10/80; LCSC C18213008

Connections:
+3V3: C4.1, C19.1, C20.1, C21.1, C22.1, C23.1, C24.1, C25.1, C26.1, J1.4, J12.4 (VDD), R2.2, R3.2, R7.1, R9.1, R12.1, R15.1, R31.1, R32.1, U1.1 (V_{IN}), U3.1 (VCCA), U4.1 (V_{IO}), U4.19 (V_{DD}), U5.6 (V_BCKP), U5.7 (V_IO), U5.8 (VCC), U7.5 (VIO), U8.10 (~SRCLR), U8.16 (VCC), U10.5 (VBUS)
+3V8: C7.1, C8.1, C12.1, C13.1, C14.1, C15.1, D3.2 (A2), L1.2, R10.1, U6.55 (VBAT), U6.56 (VBAT), U6.57 (VBAT)
+5V: C1.1, C2.1, C3.1, C27.1, C28.1, J1.5, J6.1, U2.3 (VIN), U4.27 (V_{DDA}), U7.3 (VCC)
/BOOT_CFG: U6.6 (BOOT_CFG)
/CAN1_RxD: J4.3, U7.4 (RXD)
/CAN1_TxD: J4.4, U7.1 (TXD)
/Ext_V_{DD}: C5.1, U3.8 (OE), U3.14 (VCCB), U6.15 (VDD_EXT)
/GNSS_PPS: J4.2, U5.4 (TIMEPULSE)
/IMU_INT: J2.6, U1.6 (INT)
/I^{2}C_SCL: J3.1, R2.1, U1.4 (SCL/R), U5.17 (SCL)
/I^{2}C_SDA: J3.2, R3.1, U1.3 (SDA/T), U5.16 (SDA)
/LTE_CTS_3V3: J3.10, U3.5 (A4Y)
/LTE_POWKEY_CTL: J2.3, R4.1
/LTE_PWR_EN: J2.4, R1.1, U2.2 (EN)
/LTE_RTS_3V3: J4.6, U3.3 (A2)
/LTE_RxD_3V3: J4.8, U3.4 (A3Y)
/LTE_TxD_3V3: J4.7, U3.2 (A1)
/POWKEY: Q1.3 (D), U6.1 (PWRKEY)
/SPI2_MISO: J3.6, J12.7 (DAT0), R31.2, U4.16 (SO), U10.6 (I/O4)
/SPI2_MOSI: J3.7, J12.3 (CMD), R6.1, U4.15 (SI), U8.14 (SER), U10.4 (I/O3)
/SPI2_SCK: J3.5, J12.5 (CLK), R8.1, U4.14 (SCK), U8.11 (SRCLK), U10.1 (I/O1)
/STATUS_LATCH: J4.1, R22.1, U8.12 (RCLK)
/SW: C6.2, L1.1, U2.5 (SW)
/UART_CTS: U3.10 (B4), U6.7 (UART1_CTS)
/UART_RTS: U3.12 (B2Y), U6.8 (UART1_RTS)
/UART_RxD: U3.11 (B3), U6.9 (UART1_TXD)
/UART_TxD: U3.13 (B1Y), U6.10 (UART1_RXD)
/~CAN2_CS: J3.8, R9.2, U4.17 (~CS)
/~CAN2_INT: J3.9, U4.13 (~INT)
/~CAN2_RESET: J2.1, R7.2, U4.18 (~RESET)
/~GNSS_RESET: J4.5, R12.2, U5.9 (RESET_N)
/~IMU_RESET: J2.2, U1.5 (~RESET)
/~SD_CS: J2.5, J12.2 (DAT3/CD), R32.2, U10.3 (I/O2)
GND: C1.2, C2.2, C3.2, C4.2, C5.2, C7.2, C8.2, C9.2, C10.2, C11.2, C12.2, C13.2, C14.2, C15.2, C16.2, C17.2, C18.2, C19.2, C20.2, C21.2, C22.2, C23.2, C24.2, C25.2, C26.2, C27.2, C28.2, D1.3 (GND), D2.1 (A1), D3.1 (A1), D4.3 (GND), D5.1 (K), D6.1 (K), D7.1 (K), D8.1 (K), D9.1 (K), D10.1 (K), D11.1 (K), D12.1 (K), J1.6, J1.7, J3.4, J6.4, J7.2 (Ext), J9.4, J10.2 (Ext), J11.4 (GND/C5), J11.8 (SHIELD), J11.9 (SHIELD), J11.10 (SHIELD), J12.6 (VSS), J12.9 (SHIELD), Q1.2 (S), R1.2, R5.2, R6.2, R8.2, R11.2, R13.2, R22.2, U1.2 (GND), U1.7 (GND), U2.4 (GND), U3.7 (GND), U4.5 (STBY), U4.10 (GND), U4.26 (V_{SS}), U5.1 (GND), U5.10 (GND), U5.12 (GND), U6.2 (GND), U6.17 (GND), U6.18 (GND), U6.29 (GND), U6.39 (GND), U6.45 (GND), U6.46 (GND), U6.54 (GND), U6.58 (GND), U6.59 (GND), U6.61 (GND), U6.62 (GND), U6.63 (GND), U6.64 (GND), U6.65 (GND), U7.2 (GND), U7.8 (STBY), U8.8 (GND), U8.13 (~OE), U9.2 (GND), U10.2 (GND), Y1.2, Y1.4
unnamed: C11.1, L2.2, R15.2
unnamed: C16.1, R20.2, R21.1
unnamed: D1.1 (LINE1), J5.1, J6.2, U4.4 (CANH)
unnamed: D1.2 (LINE2), J6.3, R14.1, U4.3 (CANL)
unnamed: D2.2 (A2), J7.1 (In), L2.1, U5.11 (RF_IN)
unnamed: D4.1 (LINE1), J8.1, J9.2, U7.7 (CANH)
unnamed: D4.2 (LINE2), J9.3, R16.1, U7.6 (CANL)
unnamed: D5.2 (A), R23.2
unnamed: D6.2 (A), R24.2
unnamed: D7.2 (A), R25.2
unnamed: D8.2 (A), R26.2
unnamed: D9.2 (A), R27.2
unnamed: D10.2 (A), R28.2
unnamed: D11.2 (A), R29.2
unnamed: D12.2 (A), R30.2
unnamed: J5.2, R14.2
unnamed: J8.2, R16.2
unnamed: C18.1, J10.1 (In), R21.2
unnamed: J11.3 (CLK), R18.2, U9.4 (I/O3)
unnamed: J11.6 (I/O), R17.2, U9.6 (I/O4)
unnamed: J11.2 (RST), R19.2, U9.3 (I/O2)
unnamed: C17.1, J11.1 (VCC), U6.30 (SIM_VDD), U9.1 (I/O1), U9.5 (VBUS)
unnamed: Q1.1 (G), R4.2, R5.1
unnamed: C6.1, U2.6 (BST)
unnamed: R10.2, R11.1, U2.1 (FB)
unnamed: C9.1, U4.9 (OSC1), Y1.3
unnamed: C10.1, U4.8 (OSC2), Y1.1
unnamed: U4.21 (RxCAN), U4.28 (R_{XD})
unnamed: U4.20 (TxCAN), U4.24 (T_{XD})
unnamed: R13.1, U5.13 (LNA_EN)
unnamed: R20.1, U6.60 (RF_ANT)
unnamed: R18.1, U6.32 (SIM_CLK)
unnamed: R17.1, U6.31 (SIM_DATA)
unnamed: R19.1, U6.33 (SIM_RST)
unnamed: R23.1, U8.15 (QA)
unnamed: R24.1, U8.1 (QB)
unnamed: R25.1, U8.2 (QC)
unnamed: R26.1, U8.3 (QD)
unnamed: R27.1, U8.4 (QE)
unnamed: R28.1, U8.5 (QF)
unnamed: R29.1, U8.6 (QG)
unnamed: R30.1, U8.7 (QH)

Notes on the sheet:
UART
~{RESET}
LQG15HS27NJ02D
VIN
IOREF

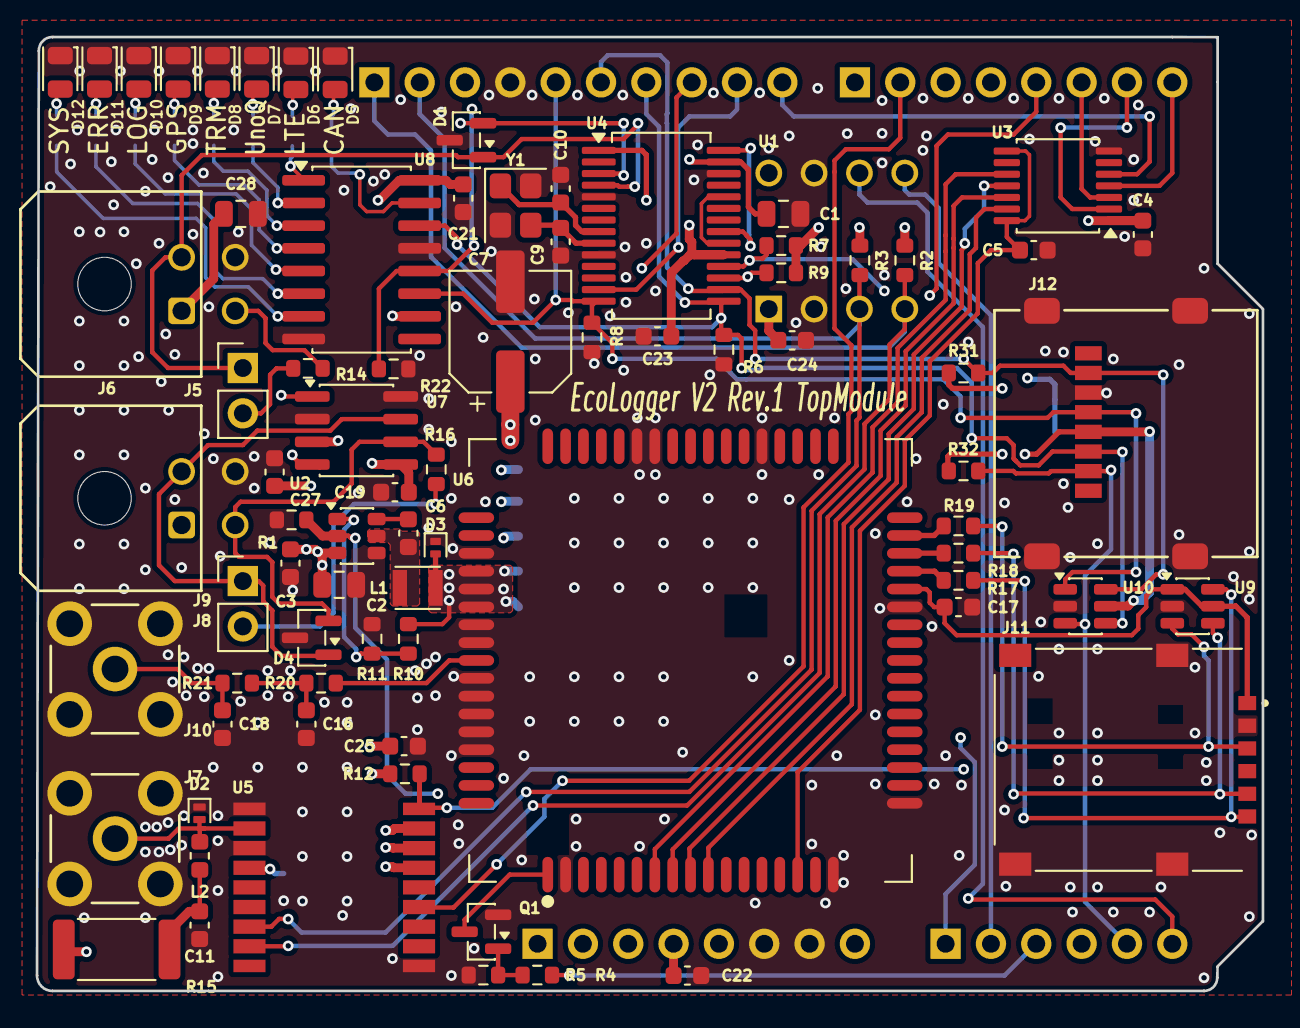
[picture p200: board logger_v2.kicad_pcb from above]

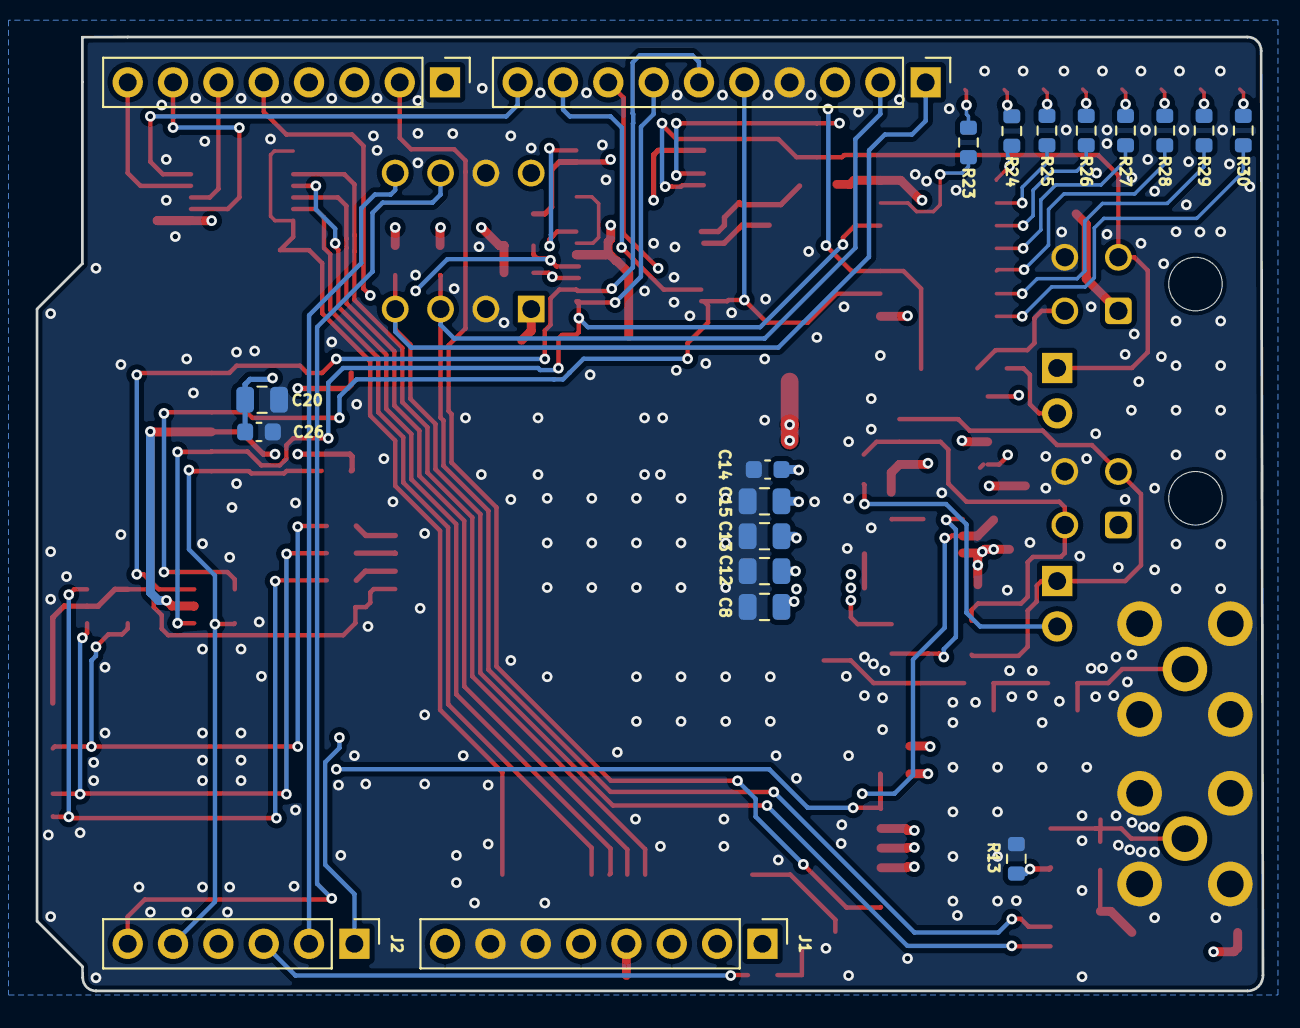
[picture p201: board logger_v2.kicad_pcb from below]

Board: 4 copper layers, 68.7 x 53.4 mm, 98 parts (20 on the bottom side), 75 nets.
