ntakao2006-web/RaceCapture/circuit/logger_v2_ups/logger_v2_ups.kicad_pcb

## KiCad design circuit/logger_v2_ups/logger_v2_ups.kicad_pcb (2026-10-22)

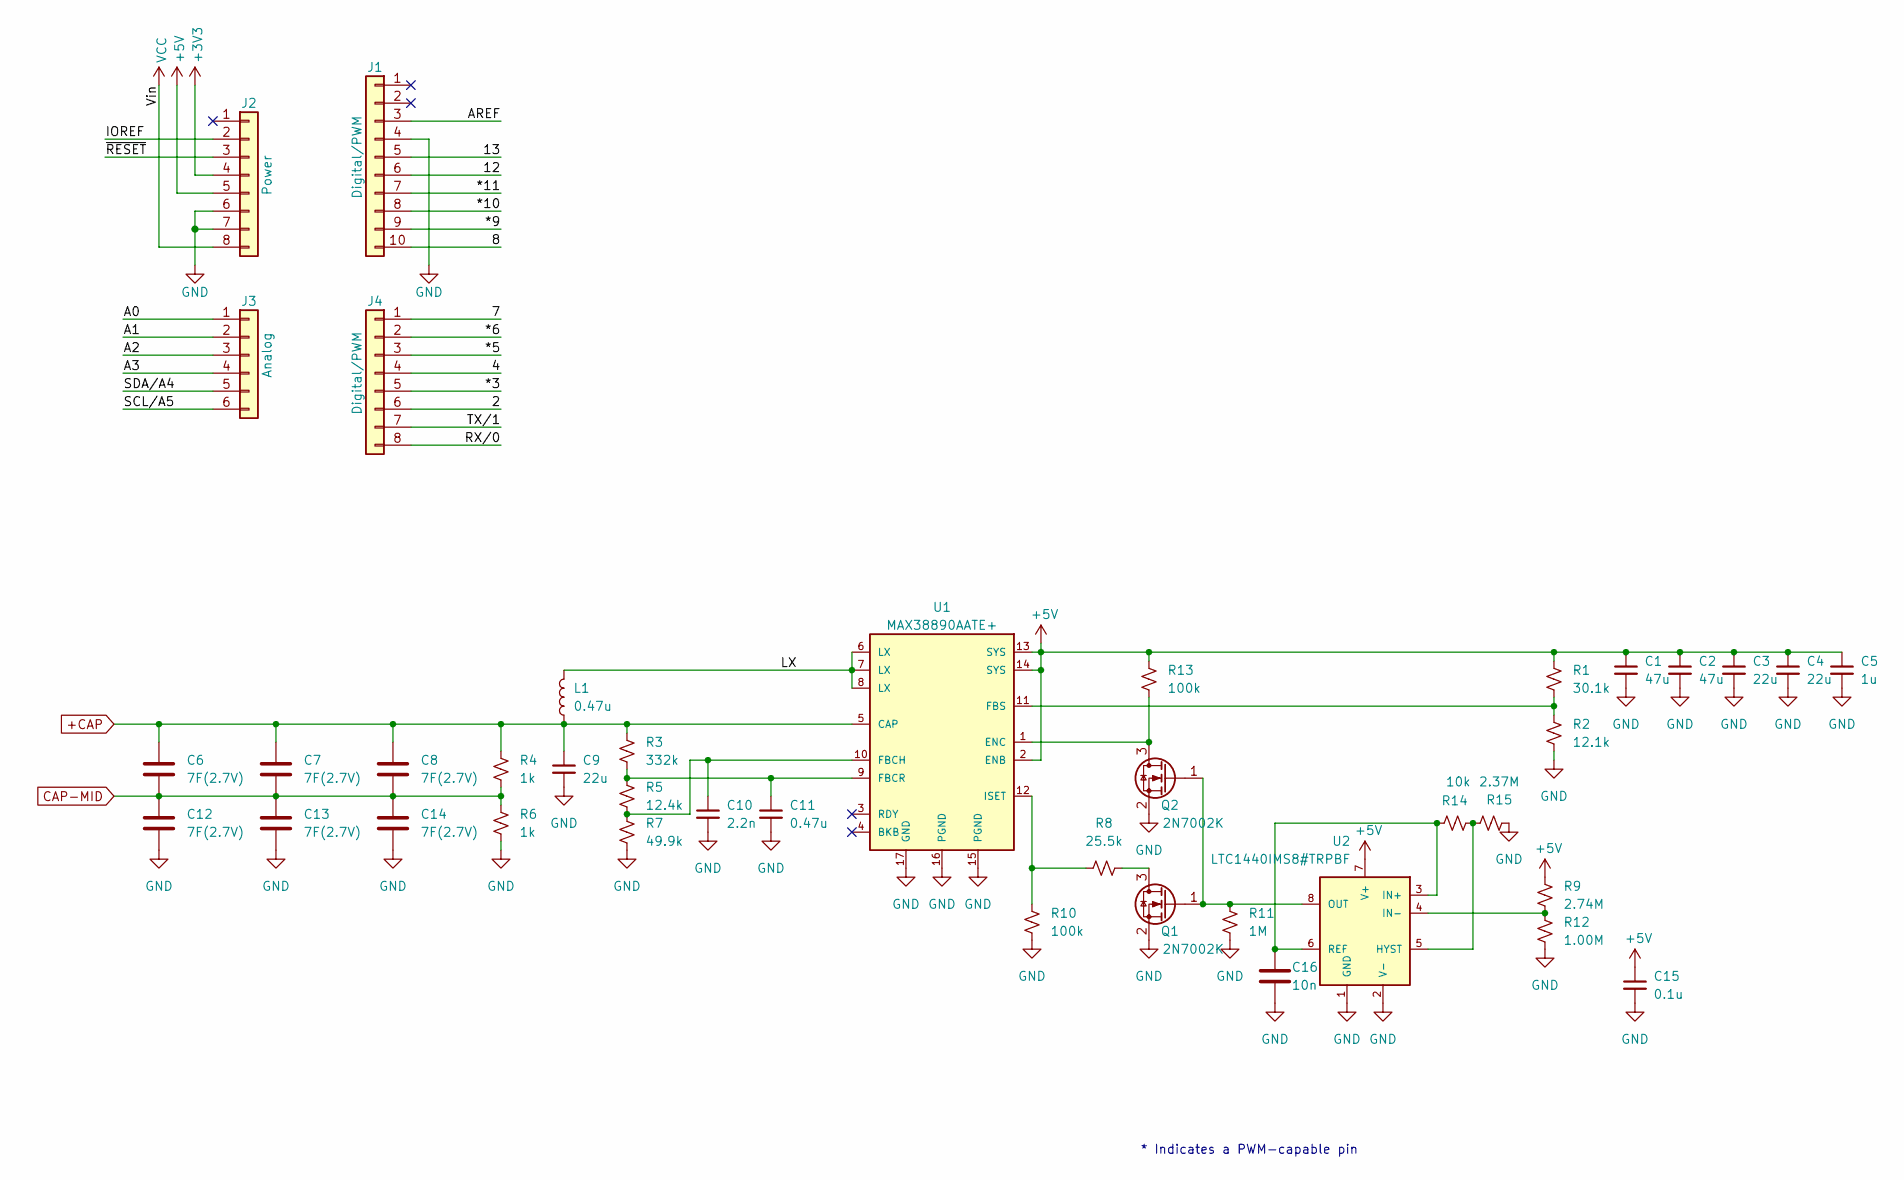
[picture p202: schematic logger_v2_ups.kicad_sch]

Parts:
C1, C2: 47u; CP_Elec_6.3x5.9; Rating 47uF 25V aluminum solid polymer; ESR 30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; MPN 25SVPF47M; DigiKey P16513CT-ND
C3, C4, C9: 22u; C_1206_3216Metric; Rating 22uF +/-20%; 16V; X7R MLCC; 3216 (1206)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; MPN EMK316BB7226ML-T; DigiKey 587-4319-1-ND
C5: 1u; C_0805_2012Metric; Rating 1uF 50V X7R +/-10% MLCC 0805; MPN C0805C105K5RACTU; DigiKey 399-C0805C105K5RACTUCT-ND
C6, C7, C8, C12, C13, C14: 7F(2.7V); Eaton_HVH1020-2R7705-R_D10_L20_P5_Horizontal; Rating 7F +/-20%; 2.7V; ESR DC max113mohm / 1k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; MPN HVH1020-2R7705-R; DigiKey 283-HVH1020-2R7705-R-ND
C10: 2.2n; C_0805_2012Metric; Rating 2.2nF 50V C0G +/-5% MLCC 0805; MPN C0805C222J5GACTU; DigiKey 399-C0805C222J5GACTUCT-ND
C11: 0.47u; C_0805_2012Metric; Rating 0.47uF 50V X7R +/-10% MLCC 0805; MPN C0805C474K5RACTU; DigiKey 399-C0805C474K5RACTUCT-ND
C15: 0.1u; C_0603_1608Metric; Rating 0.1uF; 50V; X7R MLCC; +/-10%; 0603 (160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; MPN C0603C104K5RACTU; DigiKey 399-C0603C104K5RACTUCT-ND
C16: 10n; C_0603_1608Metric; Rating 10nF; 50V; X7R MLCC; +/-10%; 0603 (1608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; MPN C0603C103K5RACTU; DigiKey 399-C0603C103K5RACTUCT-ND
J1: Digital/PWM; PinSocket_1x10_P2.54mm_Vertical; Rating 2.54mm THT female socket; 4.7A per cont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; MPN SSW-110-01-T-S; DigiKey 612-SSW-110-01-T-S-ND
J2: Power; PinSocket_1x08_P2.54mm_Vertical; Rating 2.54mm THT female socket; 4.7A per cont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; MPN SSW-108-01-T-S; DigiKey 612-SSW-108-01-T-S-ND
J3: Analog; PinSocket_1x06_P2.54mm_Vertical; Rating 2.54mm THT female socket; 4.7A per cont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; MPN SSW-106-01-T-S; DigiKey 612-SSW-106-01-T-S-ND
J4: Digital/PWM; PinSocket_1x08_P2.54mm_Vertical; Rating 2.54mm THT female socket; 4.7A per cont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; MPN SSW-108-01-T-S; DigiKey 612-SSW-108-01-T-S-ND
L1: 0.47u; L_Wuerth_HCI-1365; Rating 0.47uH +/-20%; Ir 30A; Isat10% 25A; Isa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; MPN 744355147; DigiKey 732-744355147CT-ND
Q1, Q2: 2N7002K; SOT-23; Rating N-channel MOSFET; 60V VDS; 380mA at VGS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; MPN 2N7002K-7-W; DigiKey 31-2N7002K-7-WCT-ND
R1: 30.1k; R_0805_2012Metric; Rating 0805; 30.1kOhm; +/-1%; 0.125W; MPN ERJ-6ENF3012V; DigiKey P30.1KCCT-ND
R2: 12.1k; R_0805_2012Metric; Rating 0805; 12.1kOhm; +/-1%; 0.125W; MPN RC0805FR-0712K1L; DigiKey 311-12.1KCRCT-ND
R3: 332k; R_0805_2012Metric; Rating 0805; 332kOhm; +/-1%; 0.125W; MPN RC0805FR-07332KL; DigiKey 311-332KCRCT-ND
R4, R6: 1k; R_0805_2012Metric; Rating 0805 0.125W +/-1%; 150V working voltage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; MPN RC0805FR-071KL; DigiKey 311-1.00KCRCT-ND
R5: 12.4k; R_0805_2012Metric; Rating 0805; 12.4kOhm; +/-1%; 0.125W; MPN RC0805FR-0712K4L; DigiKey 311-12.4KCRCT-ND
R7: 49.9k; R_0805_2012Metric; Rating 0805; 49.9kOhm; +/-1%; 0.125W; MPN RC0805FR-0749K9L; DigiKey 311-49.9KCRCT-ND
R8: 25.5k; R_0603_1608Metric; Rating 0603 (1608 metric); 0.1W; +/-1%; 75V ma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; MPN RC0603FR-0725K5L; DigiKey 311-25.5KHRCT-ND
R9: 2.74M; R_0603_1608Metric; Rating 0603; 2.74MOhm; +/-1%; 0.1W; MPN RC0603FR-072M74L; DigiKey 13-RC0603FR-072M74LCT-ND
R10, R13: 100k; R_0603_1608Metric; Rating 0603 (1608 metric); 0.1W; +/-1%; 75V ma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; MPN RC0603FR-07100KL; DigiKey 311-100KHRCT-ND
R11: 1M; R_0603_1608Metric; Rating 0603 (1608 metric); 0.1W; +/-1%; 75V ma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; MPN RC0603FR-071ML; DigiKey 311-1.00MHRCT-ND
R12: 1.00M; R_0603_1608Metric; Rating 0603 (1608 metric); 0.1W; +/-1%; 75V ma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; MPN RC0603FR-071ML; DigiKey 311-1.00MHRCT-ND
R14: 10k; R_0603_1608Metric; Rating 0603; 10kOhm; +/-1%; 0.1W; MPN ERJ-3EKF1002V; DigiKey P10.0KHCT-ND
R15: 2.37M; R_0603_1608Metric; Rating 0603; 2.37MOhm; +/-1%; 0.1W; MPN RC0603FR-072M37L; DigiKey 13-RC0603FR-072M37LCT-ND
U1: MAX38890AATE+; TQFN-16-1EP_3x3mm_P0.5mm_EP1.23x1.23mm; Rating VSYS 2.5..5.5V; peak inductor current 1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; MPN MAX38890AATE+; DigiKey 505-MAX38890AATE+-ND
U2: LTC1440IMS8#TRPBF; MSOP-8_3x3mm_P0.65mm; Rating Comparator with 1.182V reference; MSOP-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; MPN LTC1440IMS8#TRPBF; DigiKey LTC1440IMS8#TRPBFCT-ND

Connections:
+3V3: J2.4
+5V: C1.1, C2.1, C3.1, C4.1, C5.1, C15.1, J2.5, R1.1, R9.1, R13.1, U1.2 (ENB), U1.13 (SYS), U1.14 (SYS), U2.7 (V+)
+CAP: C6.1, C7.1, C8.1, C9.1, L1.2, R3.1, R4.1, U1.5 (CAP)
/2: J4.6
/4: J4.4
/7: J4.1
/8: J1.10
/12: J1.6
/13: J1.5
/*3: J4.5
/*5: J4.3
/*6: J4.2
/*9: J1.9
/*10: J1.8
/*11: J1.7
/A0: J3.1
/A1: J3.2
/A2: J3.3
/A3: J3.4
/AREF: J1.3
/IOREF: J2.2
/LX: L1.1, U1.6 (LX), U1.7 (LX), U1.8 (LX)
/RX/0: J4.8
/SCL/A5: J3.6
/SDA/A4: J3.5
/TX/1: J4.7
/~RESET: J2.3
CAP-MID: C6.2, C7.2, C8.2, C12.1, C13.1, C14.1, R4.2, R6.1
GND: C1.2, C2.2, C3.2, C4.2, C5.2, C9.2, C10.2, C11.2, C12.2, C13.2, C14.2, C15.2, C16.2, J1.4, J2.6, J2.7, Q1.2 (S), Q2.2 (S), R2.2, R6.2, R7.2, R10.2, R11.2, R12.2, R15.2, U1.15 (PGND), U1.16 (PGND), U1.17 (GND), U2.1 (GND), U2.2 (V-)
unnamed: Q1.3 (D), R8.2
unnamed: Q1.1 (G), Q2.1 (G), R11.1, U2.8 (OUT)
unnamed: Q2.3 (D), R13.2, U1.1 (ENC)
unnamed: C10.1, R5.2, R7.1, U1.10 (FBCH)
unnamed: C11.1, R3.2, R5.1, U1.9 (FBCR)
unnamed: R1.2, R2.1, U1.11 (FBS)
unnamed: R8.1, R10.1, U1.12 (ISET)
unnamed: R14.2, R15.1, U2.5 (HYST)
unnamed: C16.1, R14.1, U2.3 (IN+), U2.6 (REF)
unnamed: R9.2, R12.1, U2.4 (IN-)
VCC: J2.8

Notes on the sheet:
* Indicates a PWM-capable pin

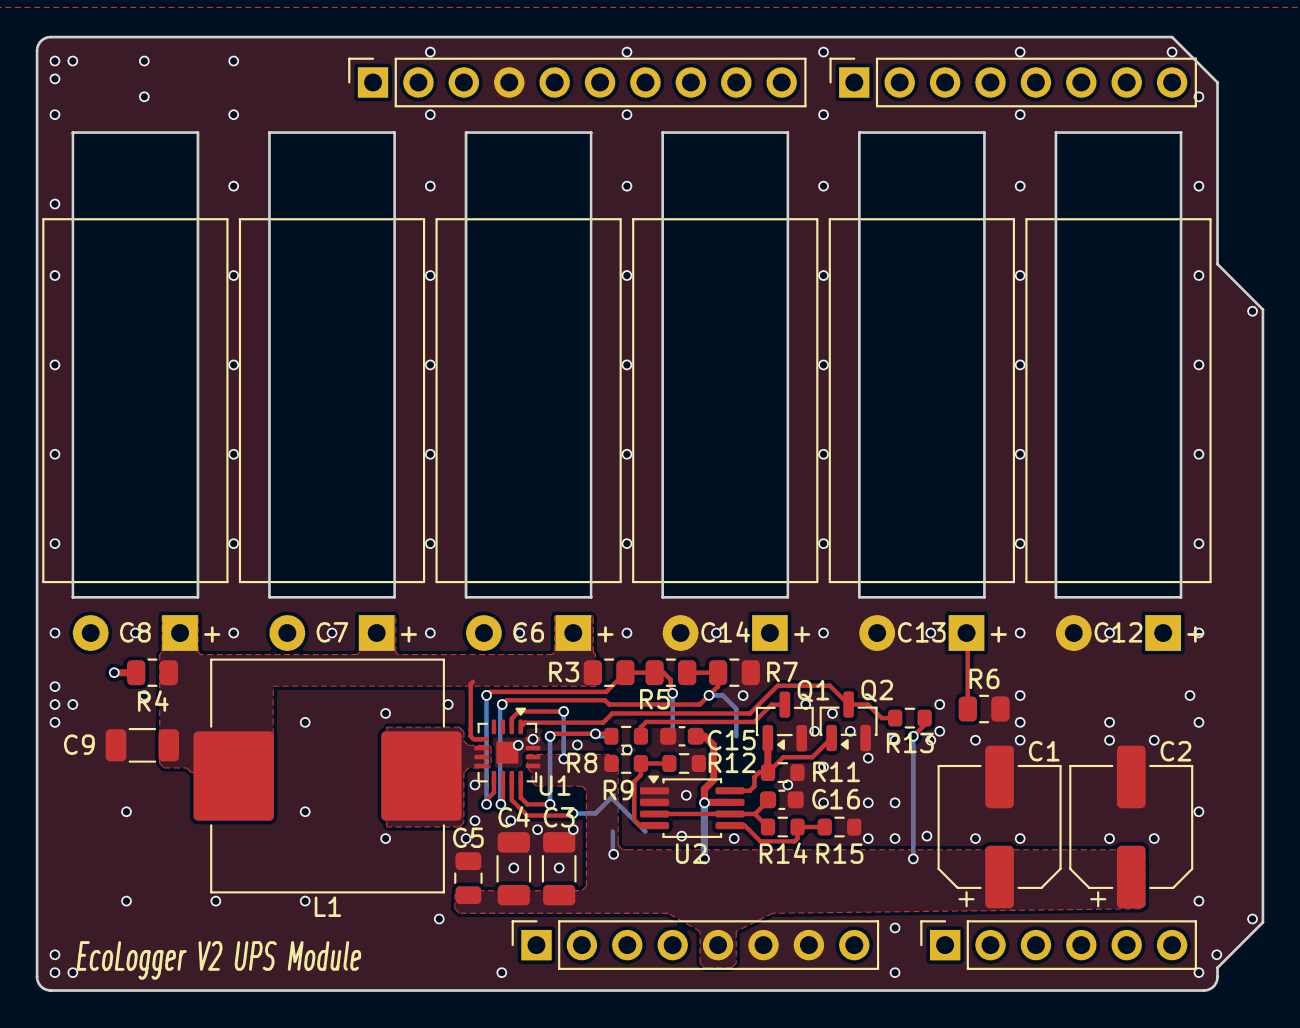
[picture p203: board logger_v2_ups.kicad_pcb from above]

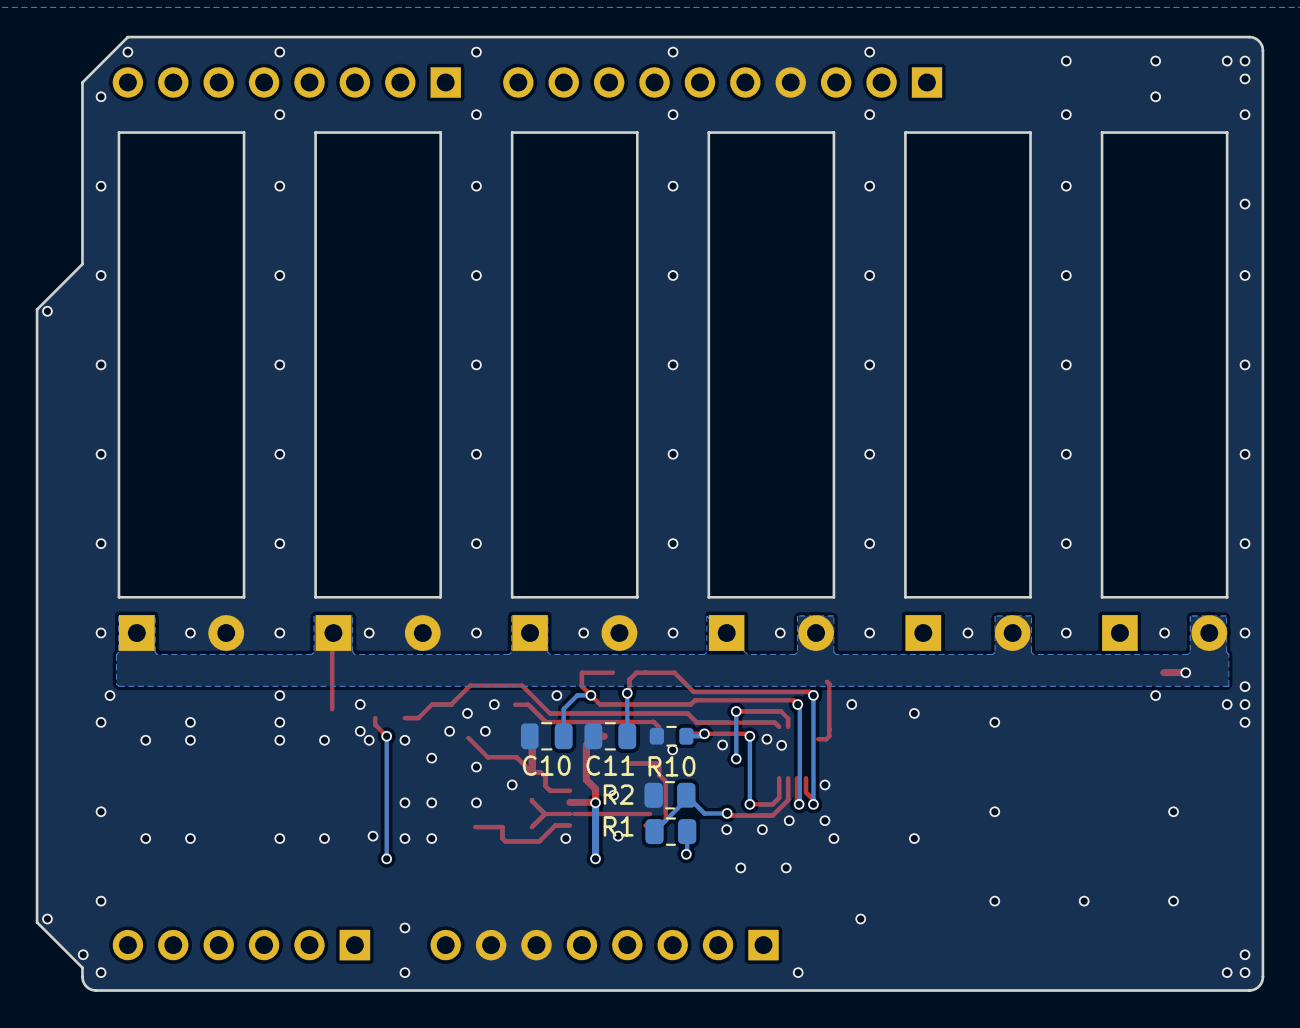
[picture p204: board logger_v2_ups.kicad_pcb from below]

Board: 2 copper layers, 68.6 x 53.3 mm, 40 parts (5 on the bottom side), 15 nets.
