ntakao2006-web/RaceCapture/circuit/actibe_cooler/actibe_cooler.kicad_pcb

## KiCad design circuit/actibe_cooler/actibe_cooler.kicad_pcb (2026-10-06)

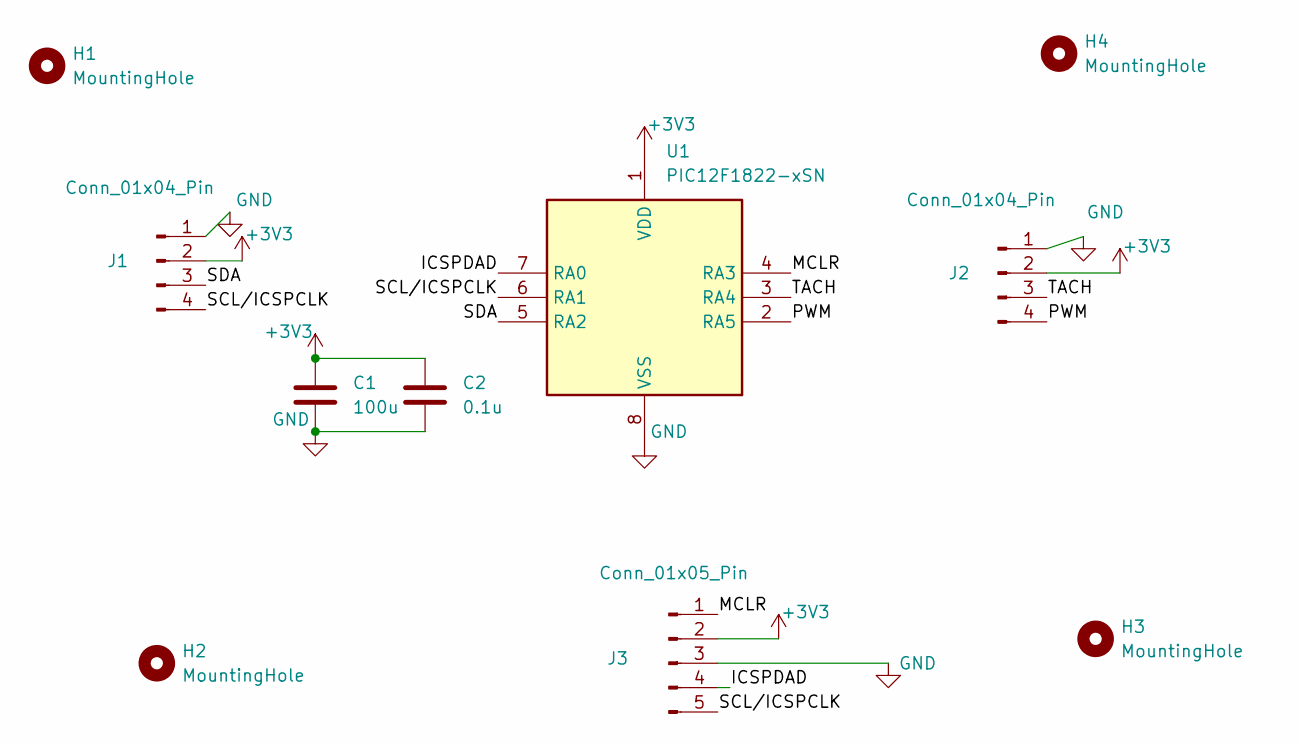
[picture p205: schematic actibe_cooler.kicad_sch]

Parts:
C1: 100u; CP_Elec_5x5.9
C2: 0.1u; C_0603_1608Metric
H1, H2, H3, H4: MountingHole; MountingHole_2.2mm_M2
J1: Conn_01x04_Pin; JST_SH_SM04B-SRSS-TB_1x04-1MP_P1.00mm_Horizontal
J2: Conn_01x04_Pin; PinHeader_1x04_P2.54mm_Vertical
J3: Conn_01x05_Pin; PinHeader_1x05_P2.54mm_Vertical
U1: PIC12F1822-xSN; SOIC-8_3.9x4.9mm_P1.27mm

Connections:
+3V3: C1.1, C2.1, J1.2, J2.2, J3.2, U1.1 (VDD)
/ICSPDAD: J3.4, U1.7 (RA0)
/MCLR: J3.1, U1.4 (RA3)
/PWM: J2.4, U1.2 (RA5)
/SCL/ICSPCLK: J1.4, J3.5, U1.6 (RA1)
/SDA: J1.3, U1.5 (RA2)
/TACH: J2.3, U1.3 (RA4)
GND: C1.2, C2.2, J1.1, J2.1, J3.3, U1.8 (VSS)

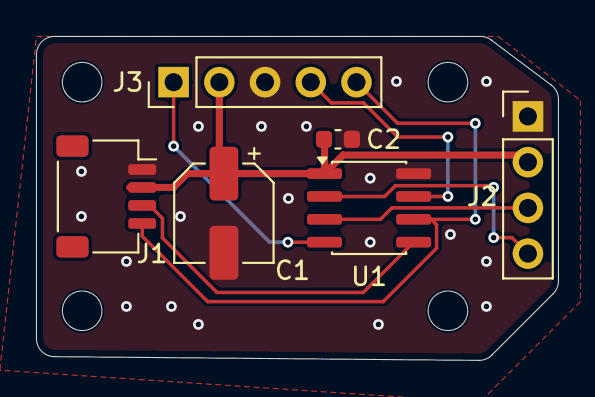
[picture p206: board actibe_cooler.kicad_pcb from above]

Board: 2 copper layers, 29.0 x 18.0 mm, 10 parts (0 on the bottom side), 8 nets.
