ntakao2006-web/RaceCapture/circuit/logger_v1/logger_v1.kicad_pcb

## KiCad design circuit/logger_v1/logger_v1.kicad_pcb (2026-09-01, an earlier design)

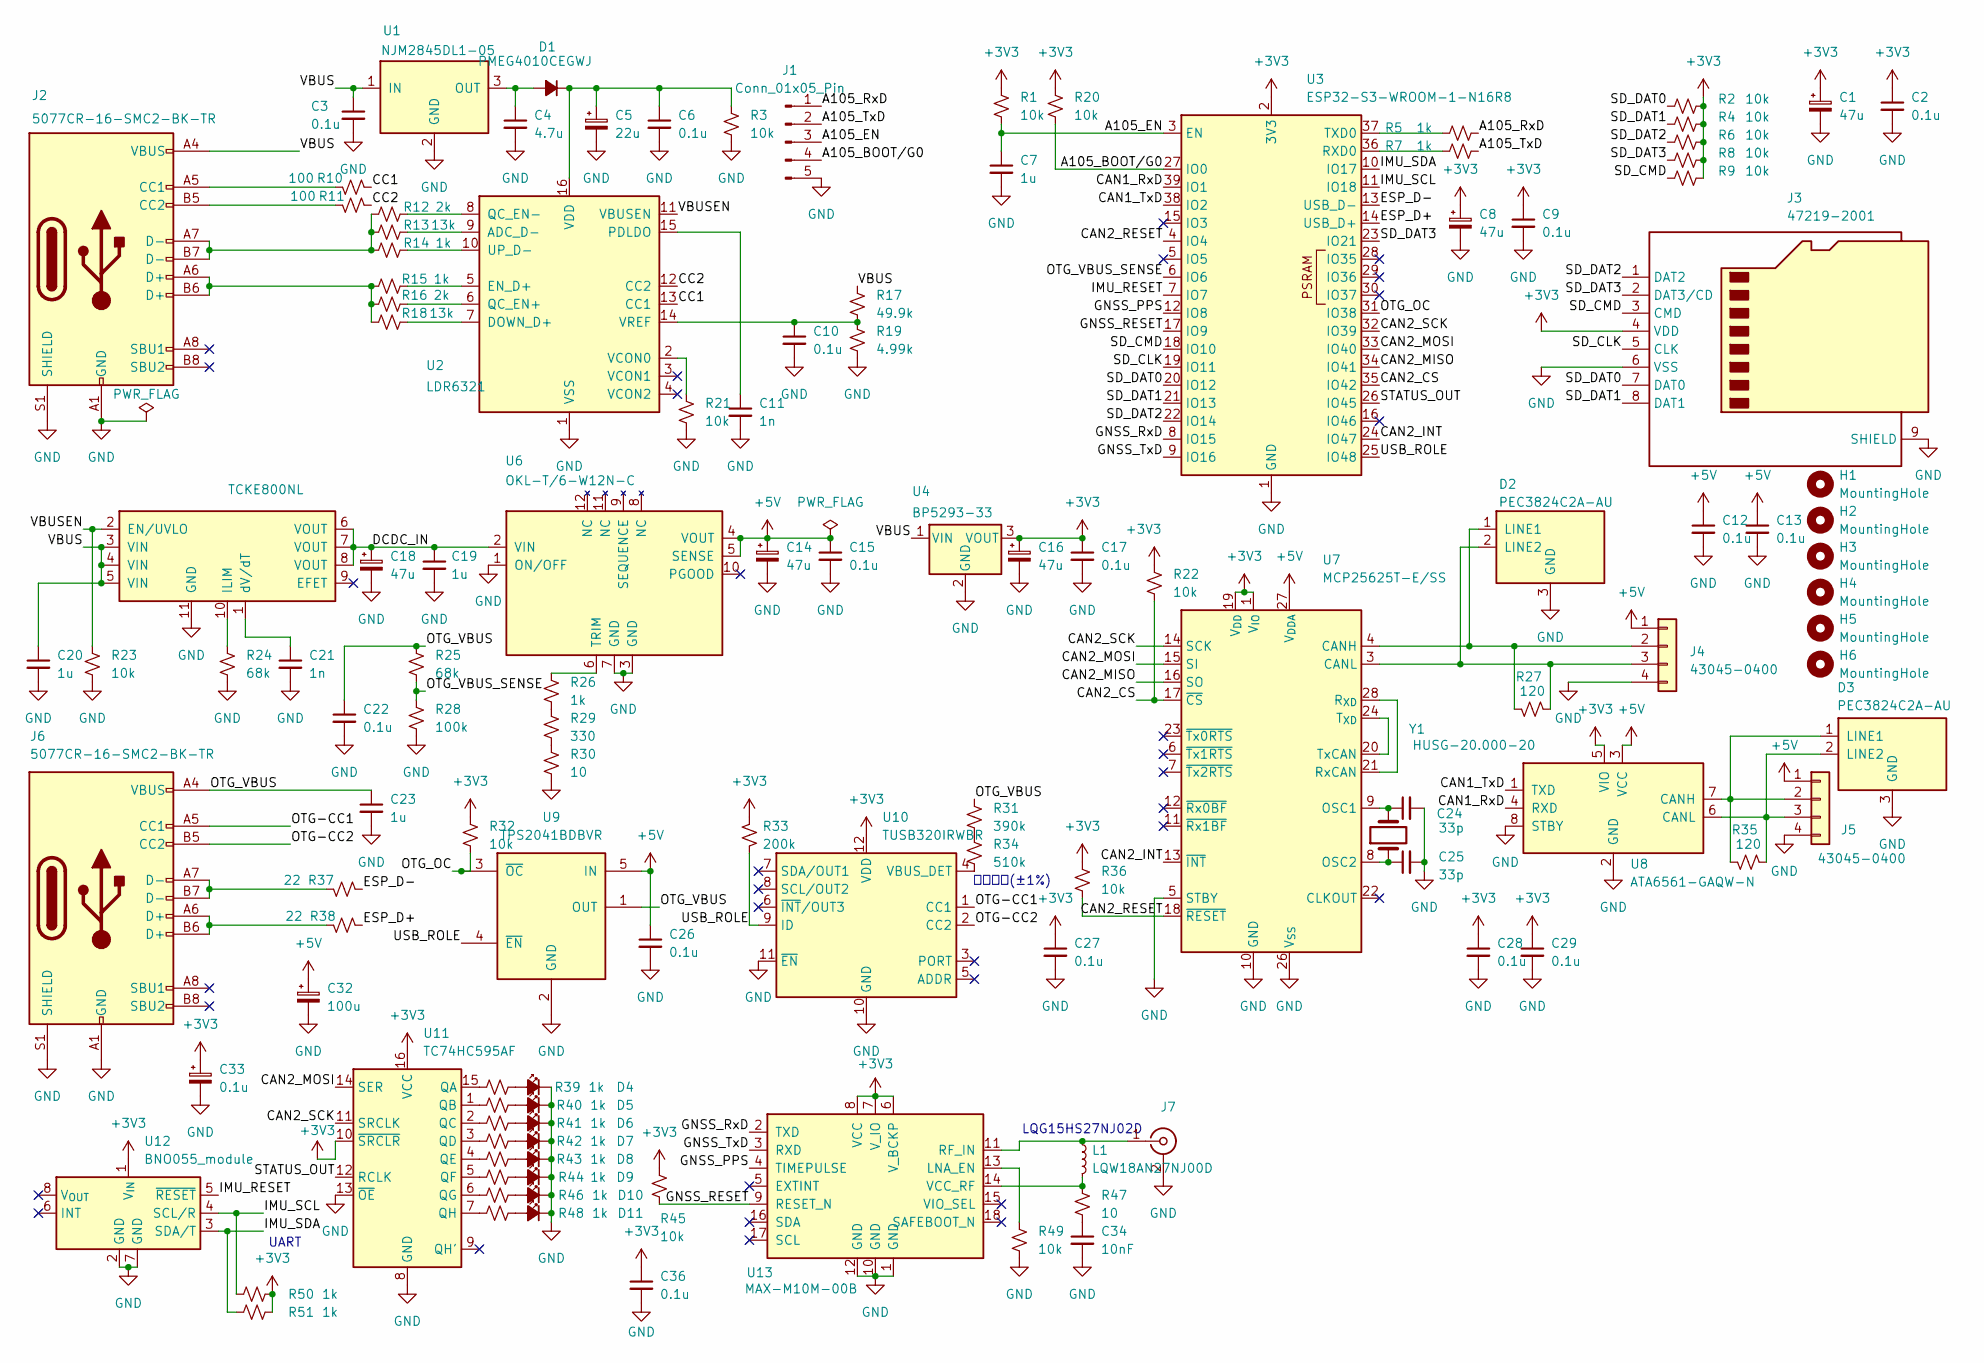
[picture p207: schematic logger_v1.kicad_sch, RaceCapture Compatible Data Logger / ESP32-S3]

Parts:
C1, C8, C14, C16, C18: 47u; CP_Elec_6.3x5.8
C2, C3, C6, C9, C10, C12, C13, C15, C17, C22, C26, C27, C28, C29, C33, C36: 0.1u; C_0603_1608Metric
C4: 4.7u; C_0805_2012Metric
C5: 22u; CP_Elec_5x5.4
C7, C19, C20, C23: 1u; C_0805_2012Metric
C11, C21: 1n; C_0603_1608Metric
C24, C25: 33p; C_0603_1608Metric
C32: 100u; CP_Radial_D6.3mm_P2.50mm
C34: 10nF; C_0603_1608Metric
D1: PMEG4010CEGWJ; D_SOD-123; MPN PMEG4010CEGWJ; DigiKey 1727-7338-1-ND
D2, D3: PEC3824C2A-AU; SOT-23
D4, D5, D6, D7, D8, D9, D10, D11: LED_Small_Filled; LED_D3.0mm_JLCPCB
H1, H2: MountingHole; MountingHole_2.2mm_M2
H3, H4, H5, H6: MountingHole; MountingHole_3.2mm_M3
J1: Conn_01x05_Pin; PinHeader_1x05_P2.54mm_Vertical
J2, J6: 5077CR-16-SMC2-BK-TR; USB_C_5077CR-16-SMC2-BK-TR
J3: 47219-2001; Molex_47219-2001
J4, J5: 43045-0400; Molex_Micro-Fit_3.0_43045-0400_2x02_P3.00mm_Horizontal
J7: S-037-TGG; SMA_S-037-TGG_Horizontal
L1: LQW18AN27NJ00D; L_0603_1608Metric
R1, R2, R3, R4, R6, R8, R9, R20, R21, R22, R23, R32, R36, R45, R49: 10k; R_0603_1608Metric
R5, R7, R14, R15, R26, R39, R40, R41, R42, R43, R44, R46, R48, R50, R51: 1k; R_0603_1608Metric
R10, R11: 100; R_0603_1608Metric
R12, R16: 2k; R_0603_1608Metric
R13, R18: 13k; R_0603_1608Metric
R17: 49.9k; R_0603_1608Metric
R19: 4.99k; R_0603_1608Metric
R24, R25: 68k; R_0603_1608Metric
R27, R35: 120; R_0603_1608Metric
R28: 100k; R_0603_1608Metric
R29: 330; R_0603_1608Metric
R30, R47: 10; R_0603_1608Metric
R31: 390k; R_0603_1608Metric
R33: 200k; R_0603_1608Metric
R34: 510k; R_0603_1608Metric
R37, R38: 22; R_0603_1608Metric
U1: NJM2845DL1-05; TO-252-3_TabPin2
U2: LDR6321; SSOP-16_3.9x4.9mm_P0.635mm
U3: ESP32-S3-WROOM-1-N16R8; ESP32-S3-WROOM-1
U4: BP5293-33; BP5293_33_SIP3
U5: TCKE800NL; TCKE800NL_WSON10B
U6: OKL-T/6-W12N-C; OKL_T_6_W12N_C
U7: MCP25625T-E/SS; SSOP-28_5.3x10.2mm_P0.65mm
U8: ATA6561-GAQW-N; SOIC-8_3.9x4.9mm_P1.27mm
U9: TPS2041BDBVR; SOT-23-5
U10: TUSB320IRWBR; Texas_X2QFN-12_1.6x1.6mm_P0.4mm
U11: TC74HC595AF; SOIC-16W_5.3x10.2mm_P1.27mm
U12: BNO055_module; AE_BNO055_BO
U13: MAX-M10M-00B; MAX_M10M_00B_LCC18
Y1: HUSG-20.000-20; Crystal_HC49-4H_Vertical

Connections:
+3V3: C1.1, C2.1, C8.1, C9.1, C16.1, C17.1, C27.1, C28.1, C29.1, C33.1, C36.1, J3.4 (VDD), R1.1, R2.2, R4.2, R6.2, R8.2, R9.2, R20.1, R22.1, R32.1, R33.1, R36.1, R45.1, R50.2, R51.2, U3.2 (3V3), U4.3 (VOUT), U7.1 (V_{IO}), U7.19 (V_{DD}), U8.5 (VIO), U10.12 (VDD), U11.10 (~SRCLR), U11.16 (VCC), U12.1 (V_{IN}), U13.6 (V_BCKP), U13.7 (V_IO), U13.8 (VCC)
+5V: C12.1, C13.1, C14.1, C15.1, C26.1, C32.1, J4.1, J5.1, U6.4 (VOUT), U6.5 (SENSE), U7.27 (V_{DDA}), U8.3 (VCC), U9.5 (IN)
/A105_BOOT/G0: J1.4, R20.2, U3.27 (IO0)
/A105_EN: C7.1, J1.3, R1.2, U3.3 (EN)
/A105_RxD: J1.1, R5.2
/A105_TxD: J1.2, R7.2
/CAN1_RxD: U3.39 (IO1), U8.4 (RXD)
/CAN1_TxD: U3.38 (IO2), U8.1 (TXD)
/CAN2_CS: R22.2, U3.35 (IO42), U7.17 (~CS)
/CAN2_INT: U3.24 (IO47), U7.13 (~INT)
/CAN2_MISO: U3.34 (IO41), U7.16 (SO)
/CAN2_MOSI: U3.33 (IO40), U7.15 (SI), U11.14 (SER)
/CAN2_RESET: R36.2, U3.4 (IO4), U7.18 (~RESET)
/CAN2_SCK: U3.32 (IO39), U7.14 (SCK), U11.11 (SRCLK)
/CC1: R10.1, U2.13 (CC1)
/CC2: R11.1, U2.12 (CC2)
/DCDC_IN: C18.1, C19.1, U5.6 (VOUT), U5.7 (VOUT), U5.8 (VOUT), U6.2 (VIN)
/ESP_D+: R38.1, U3.14 (USB_D+)
/ESP_D-: R37.1, U3.13 (USB_D-)
/GNSS_PPS: U3.12 (IO8), U13.4 (TIMEPULSE)
/GNSS_RESET: R45.2, U3.17 (IO9), U13.9 (RESET_N)
/GNSS_RxD: U3.8 (IO15), U13.2 (TXD)
/GNSS_TxD: U3.9 (IO16), U13.3 (RXD)
/IMU_RESET: U3.7 (IO7), U12.5 (~RESET)
/IMU_SCL: R50.1, U3.11 (IO18), U12.4 (SCL/R)
/IMU_SDA: R51.1, U3.10 (IO17), U12.3 (SDA/T)
/OTG-CC1: J6.A5 (CC1), U10.1 (CC1)
/OTG-CC2: J6.B5 (CC2), U10.2 (CC2)
/OTG_OC: R32.2, U3.31 (IO38), U9.3 (~OC)
/OTG_VBUS: C22.1, C23.1, J6.A4 (VBUS), J6.A9 (VBUS), J6.B4 (VBUS), J6.B9 (VBUS), R25.1, R31.1, U9.1 (OUT)
/OTG_VBUS_SENSE: R25.2, R28.1, U3.6 (IO6)
/SD_CLK: J3.5 (CLK), U3.19 (IO11)
/SD_CMD: J3.3 (CMD), R9.1, U3.18 (IO10)
/SD_DAT0: J3.7 (DAT0), R2.1, U3.20 (IO12)
/SD_DAT1: J3.8 (DAT1), R4.1, U3.21 (IO13)
/SD_DAT2: J3.1 (DAT2), R6.1, U3.22 (IO14)
/SD_DAT3: J3.2 (DAT3/CD), R8.1, U3.23 (IO21)
/STATUS_OUT: U3.26 (IO45), U11.12 (RCLK)
/USB_ROLE: R33.2, U3.25 (IO48), U9.4 (~EN), U10.9 (ID)
/VBUS: C3.1, C20.1, J2.A4 (VBUS), J2.A9 (VBUS), J2.B4 (VBUS), J2.B9 (VBUS), R17.1, U1.1 (IN), U4.1 (VIN), U5.3 (VIN), U5.4 (VIN), U5.5 (VIN)
/VBUSEN: R23.1, U2.11 (VBUSEN), U5.2 (EN/UVLO)
GND: C1.2, C2.2, C3.2, C4.2, C5.2, C6.2, C7.2, C8.2, C9.2, C10.2, C11.2, C12.2, C13.2, C14.2, C15.2, C16.2, C17.2, C18.2, C19.2, C20.2, C21.2, C22.2, C23.2, C24.2, C25.2, C26.2, C27.2, C28.2, C29.2, C32.2, C33.2, C34.2, C36.2, D2.3 (GND), D3.3 (GND), D4.1 (K), D5.1 (K), D6.1 (K), D7.1 (K), D8.1 (K), D9.1 (K), D10.1 (K), D11.1 (K), J1.5, J2.A1 (GND), J2.A12 (GND), J2.B1 (GND), J2.B12 (GND), J2.S1 (SHIELD), J3.6 (VSS), J3.9 (SHIELD), J4.4, J5.4, J6.A1 (GND), J6.A12 (GND), J6.B1 (GND), J6.B12 (GND), J6.S1 (SHIELD), J7.2 (Ext), R3.2, R19.2, R21.2, R23.2, R24.2, R28.2, R30.2, R49.2, U1.2 (GND), U2.1 (VSS), U3.1 (GND), U3.40 (GND), U3.41 (GND), U4.2 (GND), U5.11 (GND), U6.1 (ON/OFF), U6.3 (GND), U6.7 (GND), U7.5 (STBY), U7.10 (GND), U7.26 (V_{SS}), U8.2 (GND), U8.8 (STBY), U9.2 (GND), U10.10 (GND), U10.11 (~EN), U11.8 (GND), U11.13 (~OE), U12.2 (GND), U12.7 (GND), U13.1 (GND), U13.10 (GND), U13.12 (GND)
unnamed: C34.1, R47.2
unnamed: C4.1, D1.2 (A), U1.3 (OUT)
unnamed: C5.1, C6.1, D1.1 (K), R3.1, U2.16 (VDD)
unnamed: D2.1 (LINE1), J4.2, R27.2, U7.4 (CANH)
unnamed: D2.2 (LINE2), J4.3, R27.1, U7.3 (CANL)
unnamed: D3.1 (LINE1), J5.2, R35.2, U8.7 (CANH)
unnamed: D3.2 (LINE2), J5.3, R35.1, U8.6 (CANL)
unnamed: D4.2 (A), R39.2
unnamed: D5.2 (A), R40.2
unnamed: D6.2 (A), R41.2
unnamed: D7.2 (A), R42.2
unnamed: D8.2 (A), R43.2
unnamed: D9.2 (A), R44.2
unnamed: D10.2 (A), R46.2
unnamed: D11.2 (A), R48.2
unnamed: J2.A5 (CC1), R10.2
unnamed: J2.B5 (CC2), R11.2
unnamed: J2.A6 (D+), J2.B6 (D+), R15.1, R16.1, R18.1
unnamed: J2.A7 (D-), J2.B7 (D-), R12.1, R13.1, R14.1
unnamed: J6.A6 (D+), J6.B6 (D+), R38.2
unnamed: J6.A7 (D-), J6.B7 (D-), R37.2
unnamed: J7.1 (In), L1.1, U13.11 (RF_IN)
unnamed: R26.2, R29.1
unnamed: R29.2, R30.1
unnamed: R31.2, R34.1
unnamed: R13.2, U2.9 (ADC_D-)
unnamed: R18.2, U2.7 (DOWN_D+)
unnamed: R15.2, U2.5 (EN_D+)
unnamed: C11.1, U2.15 (PDLDO)
unnamed: R16.2, U2.6 (QC_EN+)
unnamed: R12.2, U2.8 (QC_EN-)
unnamed: R14.2, U2.10 (UP_D-)
unnamed: R21.1, U2.2 (VCON0)
unnamed: C10.1, R17.2, R19.1, U2.14 (VREF)
unnamed: R7.1, U3.36 (RXD0)
unnamed: R5.1, U3.37 (TXD0)
unnamed: R24.1, U5.10 (ILIM)
unnamed: C21.1, U5.1 (dV/dT)
unnamed: R26.1, U6.6 (TRIM)
unnamed: C24.1, U7.9 (OSC1), Y1.2
unnamed: C25.1, U7.8 (OSC2), Y1.1
unnamed: U7.21 (RxCAN), U7.28 (R_{XD})
unnamed: U7.20 (TxCAN), U7.24 (T_{XD})
unnamed: R34.2, U10.4 (VBUS_DET)
unnamed: R39.1, U11.15 (QA)
unnamed: R40.1, U11.1 (QB)
unnamed: R41.1, U11.2 (QC)
unnamed: R42.1, U11.3 (QD)
unnamed: R43.1, U11.4 (QE)
unnamed: R44.1, U11.5 (QF)
unnamed: R46.1, U11.6 (QG)
unnamed: R48.1, U11.7 (QH)
unnamed: R49.1, U13.13 (LNA_EN)
unnamed: L1.2, R47.1, U13.14 (VCC_RF)

Notes on the sheet:
UART
金属皮膜(±1%)
LQG15HS27NJ02D

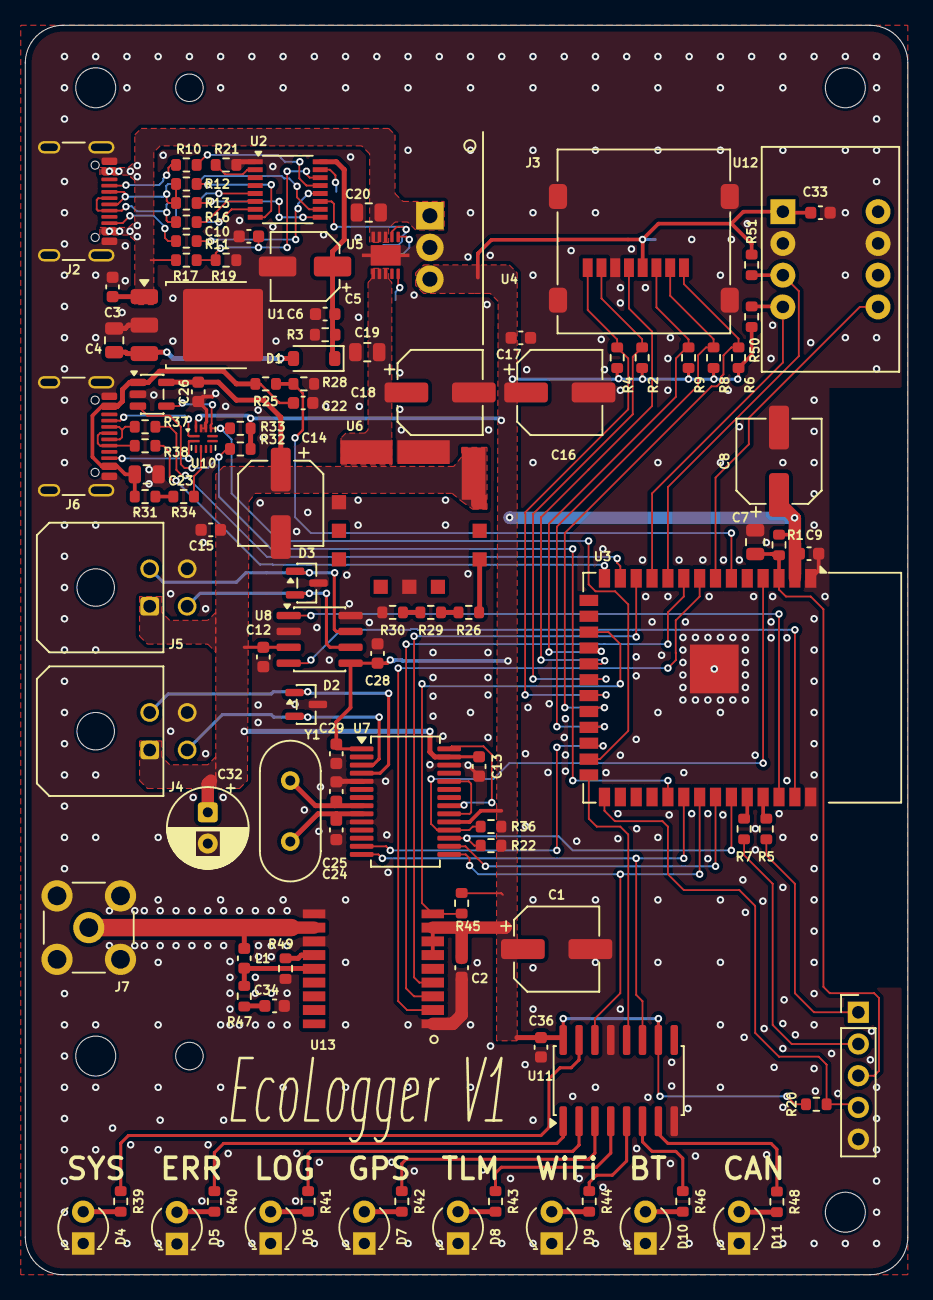
[picture p208: board logger_v1.kicad_pcb from above]

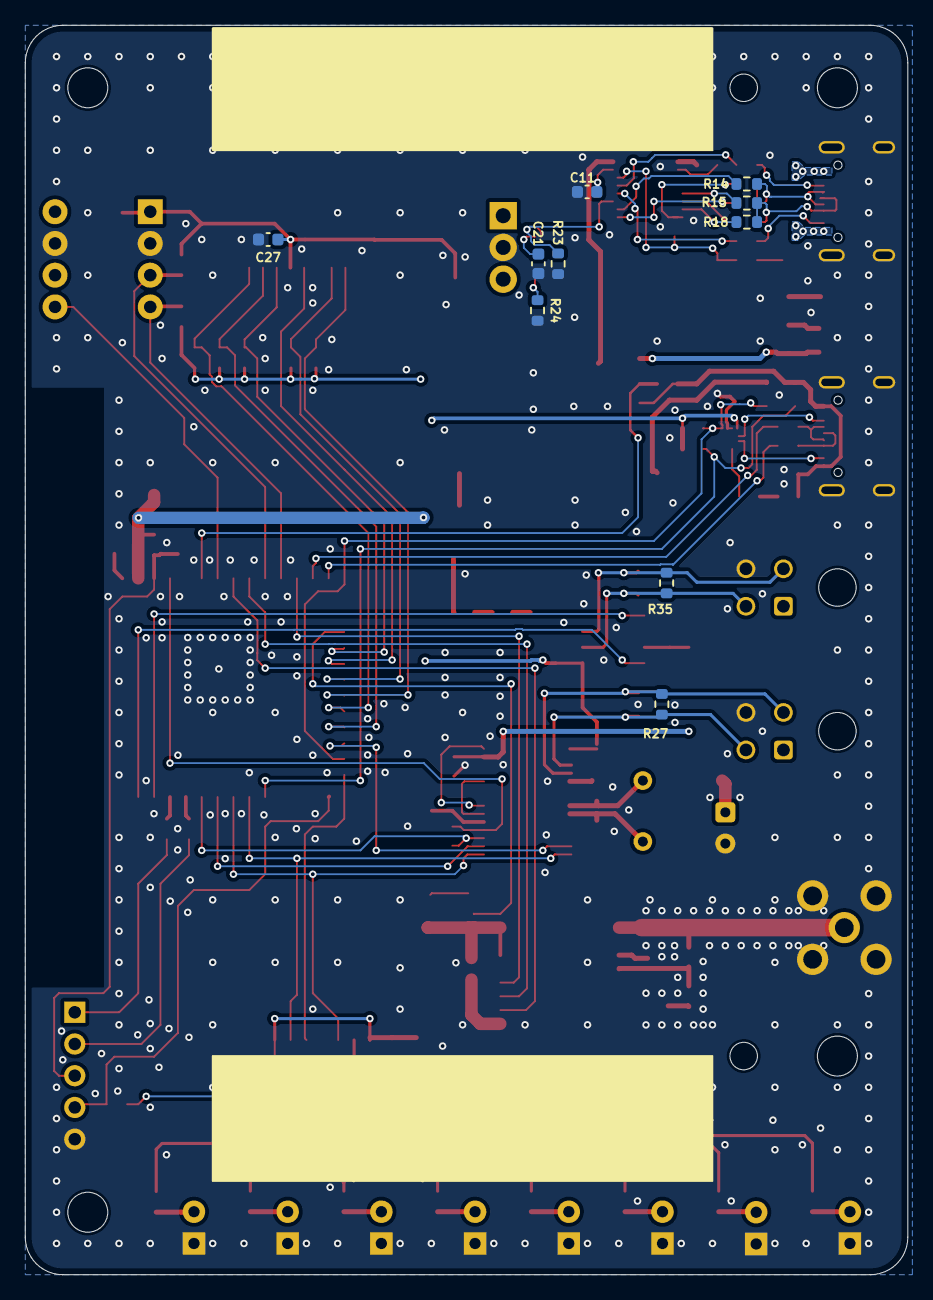
[picture p209: board logger_v1.kicad_pcb from below]

Board: 2 copper layers, 70.6 x 100.0 mm, 123 parts (10 on the bottom side), 96 nets.
