ntakao2006-web/RaceCapture/circuit/logger_v2/output/design_review_20260907/silkscreen_work/synced_finished.kicad_pcb

## KiCad design circuit/logger_v2/output/design_review_20260907/silkscreen_work/synced_finished.kicad_pcb (2026-09-22)

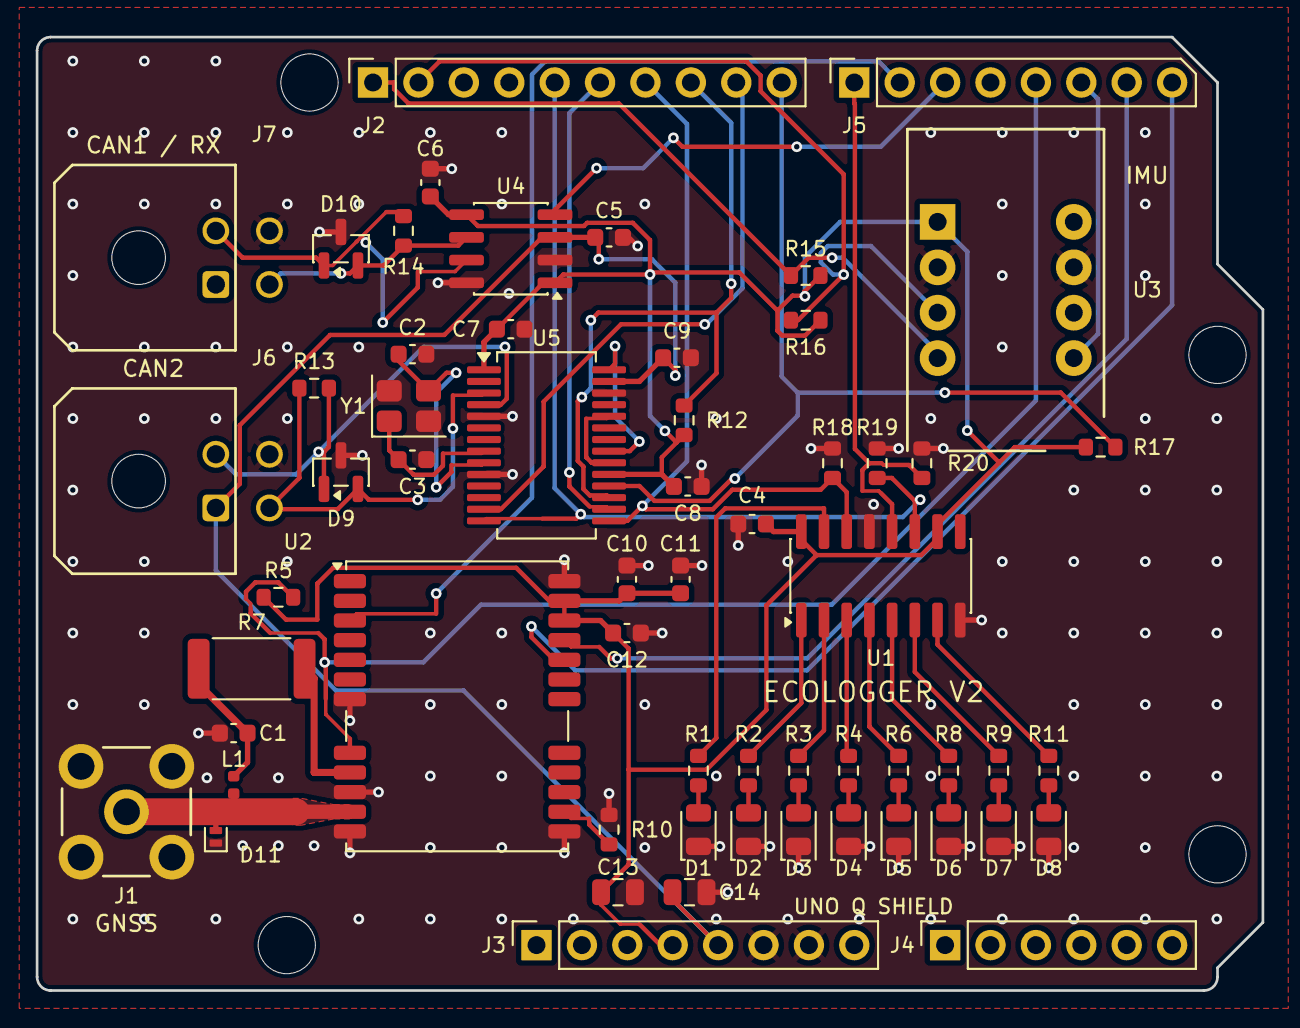
[picture p210: board synced_finished.kicad_pcb from above]

Board: 2 copper layers, 68.6 x 53.3 mm, 63 parts (0 on the bottom side), 46 nets.

Parts:
C1, C4, C5, C6, C7, C8, C9, C10, C12: 100nF; C_0603_1608Metric
C2, C3: 18pF; C_0603_1608Metric
C11: 1uF; C_0603_1608Metric
C13, C14: 10uF; C_0805_2012Metric
D1, D2, D3, D4, D5, D6, D7, D8: GREEN 0805; LED_0805_2012Metric
D9, D10: NUP2105LT1G; SOT-23
D11: RF ESD; D_SOD-882
J1: S-037-TGG; SMA_S-037-TGG_Horizontal
J2: Digital/PWM; PinSocket_1x10_P2.54mm_Vertical
J3: Power; PinSocket_1x08_P2.54mm_Vertical
J4: Analog; PinSocket_1x06_P2.54mm_Vertical
J5: Digital/PWM; PinSocket_1x08_P2.54mm_Vertical_ShieldCorner
J6, J7: 43045-0400; Molex_Micro-Fit_3.0_43045-0400_2x02_P3.00mm_Horizontal
L1: 27nH; L_0402_1005Metric
MH1, MH2, MH3, MH4: MountingHole_3.2mm
R1, R2, R3, R4, R6, R8, R9, R11: 680R; R_0603_1608Metric
R5, R10, R12, R17: 10k; R_0603_1608Metric
R7: 27R 1W; R_2512_6332Metric
R13, R14: 120; R_0603_1608Metric
R15, R16: 4.7k; R_0603_1608Metric
R18, R19, R20: 47k; R_0603_1608Metric
U1: 74HC595D,118; SOIC-16_3.9x9.9mm_P1.27mm
U2: NEO-M9N-00B; ublox_NEO
U3: BNO055_module; AE_BNO055_BO
U4: ATA6561-GAQW; SOIC-8_3.9x4.9mm_P1.27mm
U5: MCP25625-E/SS; SSOP-28_5.3x10.2mm_P0.65mm
Y1: 20MHz 12pF; Crystal_SMD_3225-4Pin_3.2x2.5mm

Connections:
+3V3: C4.1, C6.1, C7.1, C8.1, C10.1, C11.1, C12.1, C13.1, J3.4, R5.1, R12.1, R15.2, R16.2, R17.1, U1.10, U1.16, U2.22, U2.23, U3.1, U4.1, U4.5, U5.1, U5.19
+5V: C5.1, C9.1, C14.1, J3.5, J6.1, U4.3, U5.27
/CAN1_RXD: J5.3, U4.4
/CAN2_CS_N: J2.8, R12.2, U5.17
/CAN2_INT_N: J2.9, U5.13
/CAN2_RESET_N: J2.10, R17.2, U5.18
/GNSS_PPS: J5.2, U2.3
/GNSS_RESET_N: J5.5, R5.2, U2.8
/GNSS_RF: D11.2, J1.1, L1.1, U2.11
/GNSS_RXD: J5.7, U2.21
/GNSS_TXD: J5.8, U2.20
/IMU_RESET_N: J5.6, U3.5
/IMU_SCL: J2.1, R15.1, U3.4
/IMU_SDA: J2.2, R16.1, U3.3
/SPI2_MISO: J2.6, U5.16
/SPI2_MOSI: J2.7, R18.1, U1.14, U5.15
/SPI2_SCK: J2.5, R19.1, U1.11, U5.14
/STATUS_LATCH: J5.1, R20.1, U1.12
GND: C1.2, C2.2, C3.2, C4.2, C5.2, C6.2, C7.2, C8.2, C9.2, C10.2, C11.2, C12.2, C13.2, C14.2, D1.1, D2.1, D3.1, D4.1, D5.1, D6.1, D7.1, D8.1, D9.3, D10.3, D11.1, J1.2, J2.4, J3.6, J3.7, J6.4, J7.4, R10.2, R18.2, R19.2, R20.2, U1.8, U1.13, U2.7, U2.10, U2.12, U2.13, U2.24, U3.2, U3.7, U4.2, U4.8, U5.5, U5.10, U5.26, Y1.2, Y1.4
unnamed: C1.1, L1.2, R7.2
unnamed: D1.2, R1.2
unnamed: D2.2, R2.2
unnamed: D3.2, R3.2
unnamed: D4.2, R4.2
unnamed: D5.2, R6.2
unnamed: D6.2, R8.2
unnamed: D7.2, R9.2
unnamed: D8.2, R11.2
unnamed: D9.1, J6.2, R13.2, U5.4
unnamed: D9.2, J6.3, R13.1, U5.3
unnamed: D10.1, J7.2, R14.2, U4.7
unnamed: D10.2, J7.3, R14.1, U4.6
unnamed: R1.1, U1.15
unnamed: R2.1, U1.1
unnamed: R3.1, U1.2
unnamed: R4.1, U1.3
unnamed: R6.1, U1.4
unnamed: R8.1, U1.5
unnamed: R9.1, U1.6
unnamed: R11.1, U1.7
unnamed: R10.1, U2.14
unnamed: R7.1, U2.9
unnamed: C2.1, U5.9, Y1.3
unnamed: C3.1, U5.8, Y1.1
unnamed: U5.21, U5.28
unnamed: U5.20, U5.24
