ntakao2006-web/RaceCapture/outputs/sensorhub_schematic_20261020/SensorHub.before.kicad_sch

## KiCad design outputs/sensorhub_schematic_20261020/SensorHub.before.kicad_sch (2026-10-22)

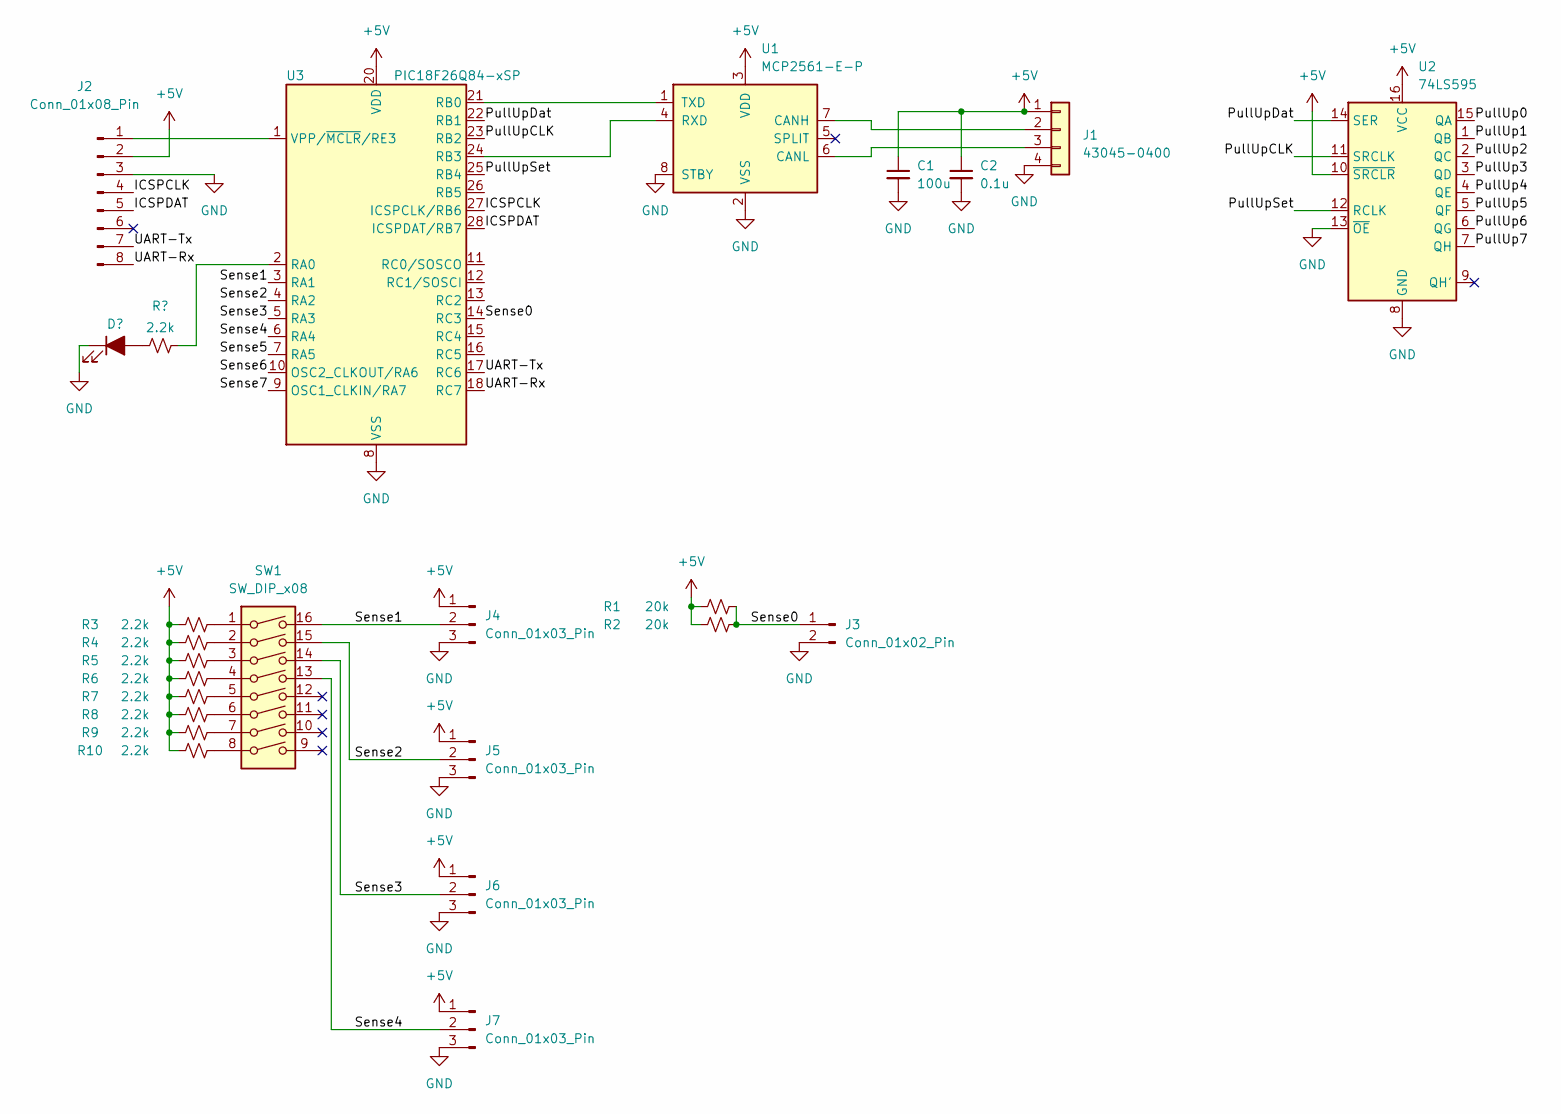
[picture p211: schematic SensorHub.before.kicad_sch]

Parts:
C1: 100u
C2: 0.1u
J1: 43045-0400; Molex_Micro-Fit_3.0_43045-0400_2x02_P3.00mm_Horizontal; MPN 43045-0400
J2: Conn_01x08_Pin
J3: Conn_01x02_Pin
J4, J5, J6, J7: Conn_01x03_Pin
R1, R2: 20k
R3, R4, R5, R6, R7, R8, R9, R10: 2.2k
SW1: SW_DIP_x08
U1: MCP2561-E-P; DIP-8_W7.62mm
U2: 74LS595
U3: PIC18F26Q84-xSP; DIP-28_W7.62mm

Connections:
+5V: C1.1, C2.1, J1.1, J2.2, J4.1, J5.1, J6.1, J7.1, R1.1, R2.1, R3.1, R4.1, R5.1, R6.1, R7.1, R8.1, R9.1, R10.1, U1.3 (VDD), U2.10 (~SRCLR), U2.16 (VCC), U3.20 (VDD)
GND: C1.2, C2.2, J1.4, J2.3, J3.2, J4.3, J5.3, J6.3, J7.3, U1.2 (VSS), U1.8 (STBY), U2.8 (GND), U2.13 (~OE), U3.8 (VSS), U3.19 (VSS)
ICSPCLK: J2.4, U3.27 (ICSPCLK/RB6)
ICSPDAT: J2.5, U3.28 (ICSPDAT/RB7)
unnamed: J1.2, U1.7 (CANH)
unnamed: J1.3, U1.6 (CANL)
unnamed: J2.1, U3.1 (VPP/~MCLR/RE3)
unnamed: R3.2, SW1.1
unnamed: R4.2, SW1.2
unnamed: R5.2, SW1.3
unnamed: R6.2, SW1.4
unnamed: R7.2, SW1.5
unnamed: R8.2, SW1.6
unnamed: R9.2, SW1.7
unnamed: R10.2, SW1.8
unnamed: U1.1 (TXD), U3.21 (RB0)
unnamed: U1.4 (RXD), U3.24 (RB3)
PullUp0: U2.15 (QA)
PullUp1: U2.1 (QB)
PullUp2: U2.2 (QC)
PullUp3: U2.3 (QD)
PullUp4: U2.4 (QE)
PullUp5: U2.5 (QF)
PullUp6: U2.6 (QG)
PullUp7: U2.7 (QH)
PullUpCLK: U2.11 (SRCLK), U3.23 (RB2)
PullUpDat: U2.14 (SER), U3.22 (RB1)
PullUpSet: U2.12 (RCLK), U3.25 (RB4)
Sense0: J3.1, R1.2, R2.2, U3.14 (RC3)
Sense1: J4.2, SW1.16, U3.3 (RA1)
Sense2: J5.2, SW1.15, U3.4 (RA2)
Sense3: J6.2, SW1.14, U3.5 (RA3)
Sense4: J7.2, SW1.13, U3.6 (RA4)
Sense5: U3.7 (RA5)
Sense6: U3.10 (OSC2_CLKOUT/RA6)
Sense7: U3.9 (OSC1_CLKIN/RA7)
UART-Rx: J2.8, U3.18 (RC7)
UART-Tx: J2.7, U3.17 (RC6)
