ntakao2006-web/RaceCapture/outputs/sensorhub_20261019/oiltemp_status/main_v4.c

#include <xc.h>
#include <math.h>
#include <stdint.h>

/*
 * PIC18F26Q84 thermistor bench test.
 * SensorHub.kicad_sch (2026-10-19): J3 Sense0 is RC3/ANC3, pin 14.
 * VDD -- (R1 20 kohm || R2 20 kohm) -- Sense0 -- NTC -- GND.
 * RC6/pin17=TX, RC7/pin18=RX at 115200 baud, 8N1, no flow control.
 * RB0/pin21=CANTX and RB3/pin24=CANRX. Classic CAN 2.0, 500 kbit/s, standard ID
 * 0x600, 10 Hz.  Bytes 0..1 are signed oil temperature in 0.01 C,
 * bytes 2..3 are the ADC result, and bytes 4..7 are resistance in ohms.
 * The temperature conversion is a two-point beta fit from the handwritten
 * sensor data: -1 C at 27.6 kohm and 97 C at 1.145 kohm.
 */

#define _XTAL_FREQ 64000000UL
#define THERM_PULLUP_OHM 10000UL
#define THERM_SHORT_ADC_MAX 4u
#define THERM_OPEN_ADC_MIN 4091u

/* Internal 64 MHz oscillator; no external oscillator required. */
#pragma config FEXTOSC = OFF
#pragma config RSTOSC = HFINTOSC_64MHZ
#pragma config CLKOUTEN = OFF
#pragma config PR1WAY = ON
#pragma config CSWEN = ON
#pragma config JTAGEN = OFF
#pragma config FCMEN = OFF
#pragma config FCMENP = OFF
#pragma config FCMENS = OFF

/* Reset and basic safety settings. */
#pragma config MCLRE = EXTMCLR
#pragma config PWRTS = PWRT_64
#pragma config MVECEN = OFF
#pragma config IVT1WAY = ON
#pragma config LPBOREN = OFF
#pragma config BOREN = SBORDIS
#pragma config BORV = VBOR_2P45
#pragma config ZCD = OFF
#pragma config PPS1WAY = ON
#pragma config STVREN = ON
#pragma config LVP = ON
#pragma config XINST = OFF

/* Watchdog disabled for this deterministic hardware test. */
#pragma config WDTCPS = WDTCPS_31
#pragma config WDTE = OFF
#pragma config WDTCWS = WDTCWS_7
#pragma config WDTCCS = SC

/* No boot block, protection, debugger, or boot-time CRC. */
#pragma config BBSIZE = BBSIZE_512
#pragma config BBEN = OFF
#pragma config SAFEN = OFF
#pragma config DEBUG = OFF
#pragma config WRTB = OFF
#pragma config WRTC = OFF
#pragma config WRTD = OFF
#pragma config WRTSAF = OFF
#pragma config WRTAPP = OFF
#pragma config BOOTPINSEL = RA4
#pragma config BPEN = OFF
#pragma config ODCON = OFF
#pragma config CP = OFF
#pragma config BOOTSCEN = OFF
#pragma config BOOTCOE = CONTINUE
#pragma config APPSCEN = OFF
#pragma config SAFSCEN = OFF
#pragma config DATASCEN = OFF
#pragma config CFGSCEN = OFF
#pragma config COE = CONTINUE
#pragma config BOOTPOR = OFF

static void uart_init(void)
{
    ANSELA &= (unsigned char)~0x01u;
    LATA &= (unsigned char)~0x01u;
    TRISA &= (unsigned char)~0x01u;

    PMD6bits.U1MD = 0;
    ANSELC &= (unsigned char)~0xC0u;
    LATCbits.LATC6 = 1;
    ODCONCbits.ODCC6 = 0;
    TRISCbits.TRISC6 = 0;
    TRISCbits.TRISC7 = 1;

    /* Interrupts are disabled; unlock PPS once, configure, then relock. */
    PPSLOCK = 0x55;
    PPSLOCK = 0xAA;
    PPSLOCKbits.PPSLOCKED = 0;
    RC6PPS = 0x20; /* Q84 TX1 output function (not the K42 value). */
    U1RXPPS = 0x17; /* RC7. */
    RB0PPS = 0x46;  /* CANTX -> MCP2561 TXD, U3/21 -> U1/1. */
    CANRXPPS = 0x0B; /* RB3. */
    PPSLOCK = 0x55;
    PPSLOCK = 0xAA;
    PPSLOCKbits.PPSLOCKED = 1;

    U1CON1 = 0;
    U1CON0 = 0xB0; /* BRGS=1, TXEN=1, RXEN=1, 8-bit asynchronous. */
    U1CON2 = 0x80; /* Continue after RX overflow; normal polarity, 1 stop. */
    U1BRG = 138; /* 64 MHz / (4 * 139) = 115107.9 baud, -0.08%. */
    U1CON1bits.ON = 1;
}

static void can_init(void)
{
    PMD2bits.CANMD = 0;
    ANSELB &= (unsigned char)~0x09u;
    LATBbits.LATB0 = 1;
    TRISBbits.TRISB0 = 0;
    TRISBbits.TRISB3 = 1;

    C1CONHbits.ON = 1;
    C1CONT = 0x04;
    C1CONU = 0x90; /* Enable TX queue. */
    C1CONTbits.REQOP = 4; /* Configuration mode. */
    while (C1CONUbits.OPMOD != 4) { }

    C1FIFOBAL = 0x00;
    C1FIFOBAH = 0x38; /* CAN message RAM starts at 0x3800. */
    C1CONH = 0x87;
    C1CONL = 0x60;
    C1CONUbits.STEF = 0;
    C1CONUbits.TXQEN = 1;

    /* 64 MHz / (1 + 100 + 27) = 500 kbit/s, 78.9% sample point. */
    C1NBTCFGL = 0x1A; /* SJW = 27 TQ. */
    C1NBTCFGH = 0x1A; /* TSEG2 = 27 TQ. */
    C1NBTCFGU = 0x63; /* TSEG1 = 100 TQ. */
    C1NBTCFGT = 0x00; /* BRP = 1. */

    C1TXQCONL = 0x80; /* TX queue enabled. */
    C1TXQCONH = 0x04; /* Reset queue. */
    C1TXQCONU = 0x60; /* Unlimited retransmission, priority 0. */
    C1TXQCONT = 0x00; /* One message, 8-byte payload. */

    C1CONTbits.REQOP = 6; /* Classic CAN 2.0 normal mode. */
    while (C1CONUbits.OPMOD != 6) { }
}

static unsigned char can_send_oil_temperature(int32_t centi_c,
                                               uint16_t adc,
                                               uint32_t resistance)
{
    uint8_t *object;
    int16_t oil_temp;

    if (!C1TXQSTALbits.TXQNIF) return 0;
    if (centi_c > 32767) centi_c = 32767;
    if (centi_c < -32768) centi_c = -32768;
    oil_temp = (int16_t)centi_c;
    object = (uint8_t *)(uintptr_t)C1TXQUA;
    if (object == 0) return 0;

    object[0] = 0x00; /* Standard identifier 0x600. */
    object[1] = 0x06;
    object[2] = 0x00;
    object[3] = 0x00;
    object[4] = 0x08; /* DLC=8, standard data frame, Classic CAN. */
    object[5] = 0x00;
    object[6] = 0x00;
    object[7] = 0x00;
    object[8] = (uint8_t)oil_temp;
    object[9] = (uint8_t)((uint16_t)oil_temp >> 8);
    object[10] = (uint8_t)adc;
    object[11] = (uint8_t)(adc >> 8);
    object[12] = (uint8_t)resistance;
    object[13] = (uint8_t)(resistance >> 8);
    object[14] = (uint8_t)(resistance >> 16);
    object[15] = (uint8_t)(resistance >> 24);
    C1TXQCONH |= 0x03; /* Increment queue and request transmission. */
    return 1;
}

static void uart_puts(const char *text)
{
    while (*text) {
        while (U1FIFObits.TXBF) { }
        U1TXB = (unsigned char)*text++;
    }
}

static void uart_put_uint32(uint32_t value)
{
    char digits[10];
    unsigned char count = 0;

    do {
        digits[count++] = (char)('0' + (value % 10u));
        value /= 10u;
    } while (value != 0u);
    while (count != 0u) {
        while (U1FIFObits.TXBF) { }
        U1TXB = (unsigned char)digits[--count];
    }
}

static void adc_init(void)
{
    PMD3bits.ADCMD = 0;
    TRISCbits.TRISC3 = 1;
    ANSELCbits.ANSELC3 = 1;
    WPUCbits.WPUC3 = 0; /* Only the external 10 kohm pull-up sets the divider. */

    ADPCH = 0x13;  /* ANC3 / RC3, Sense0 at J3/1. */
    ADREF = 0x00;  /* VDD and VSS references: divider result is ratiometric. */
    ADCLK = 31;    /* FOSC/64 = 1 MHz ADC clock at 64 MHz FOSC. */
    ADACQ = 64;    /* 64 ADC clocks of acquisition time. */
    ADCON1 = 0x00;
    ADCON2 = 0x00; /* Basic single conversion mode. */
    ADCON3 = 0x00;
    ADCON0 = 0x84; /* ADC on, right justified, FOSC/ADCLK, single conversion. */
}

static uint16_t adc_read_average(void)
{
    uint32_t sum = 0;
    unsigned char index;

    for (index = 0; index < 32u; ++index) {
        ADCON0bits.GO = 1;
        while (ADCON0bits.GO) { }
        sum += (uint16_t)(ADRES & 0x0FFFu);
    }
    return (uint16_t)((sum + 16u) / 32u);
}

static int32_t thermistor_centi_c(uint32_t resistance_ohm)
{
    const double hot_kelvin = 370.15;
    const double hot_resistance = 1145.0;
    const double beta_kelvin = 3271.26933158336;
    double inverse_kelvin;
    double centi_c;

    inverse_kelvin = (1.0 / hot_kelvin)
                   + log((double)resistance_ohm / hot_resistance) / beta_kelvin;
    centi_c = ((1.0 / inverse_kelvin) - 273.15) * 100.0;
    return (int32_t)(centi_c + (centi_c >= 0.0 ? 0.5 : -0.5));
}

static void report_measurement(uint16_t adc, uint32_t resistance,
                               int32_t centi_c, unsigned char can_sent)
{
    uint32_t magnitude;

    uart_puts("THERM adc=");
    uart_put_uint32(adc);
    if (adc >= THERM_OPEN_ADC_MIN) {
        uart_puts(" status=OPEN_OR_OVER_RANGE can_0x600=idle\r\n");
        return;
    }
    if (adc <= THERM_SHORT_ADC_MAX) {
        uart_puts(" status=SHORT_OR_UNDER_RANGE can_0x600=idle\r\n");
        return;
    }

    magnitude = (uint32_t)(centi_c < 0 ? -centi_c : centi_c);

    uart_puts(" r_ohm=");
    uart_put_uint32(resistance);
    uart_puts(" temp_c=");
    if (centi_c < 0) uart_puts("-");
    uart_put_uint32(magnitude / 100u);
    uart_puts(".");
    if ((magnitude % 100u) < 10u) uart_puts("0");
    uart_put_uint32(magnitude % 100u);
    uart_puts(" can_0x600=");
    /* Enqueue success alone does not prove bus acknowledgement or reception. */
    uart_puts(can_sent ? "queued" : "busy");
    uart_puts("\r\n");
}

void main(void)
{
    uart_init();
    adc_init();
    can_init();
    uart_puts("READY PIC18F26Q84 OILTEMP SENSE0 RC3 PU10000 CANTX_RB0 CANRX_RB3 CAN500 ID600 v4\r\n");

    while (1) {
        unsigned char cycle;
        unsigned char sent = 0;
        for (cycle = 0; cycle < 5u; ++cycle) {
            uint16_t adc = adc_read_average();
            uint32_t resistance;
            int32_t centi_c;

            if (adc <= THERM_SHORT_ADC_MAX || adc >= THERM_OPEN_ADC_MIN) {
                if (cycle == 4u) {
                    report_measurement(adc, 0, 0, 0);
                }
            } else {
                resistance = (THERM_PULLUP_OHM * adc + ((4095u - adc) / 2u)) /
                             (4095u - adc);
                centi_c = thermistor_centi_c(resistance);
                sent = can_send_oil_temperature(centi_c, adc, resistance);
                if (cycle == 4u) {
                    report_measurement(adc, resistance, centi_c, sent);
                }
            }
            __delay_ms(100);
        }
    }
}
