ntakao2006-web/RaceCapture/EcoCapture-Web/hardware.py

"""Decode actual MCU register snapshots; missing/stale measurements stay null."""
import struct
import math
from collections import deque
from models import CHANNELS
from imu_mount import ImuMount

OILTEMP_STATES = {0:'正常', 1:'オープン', 2:'短絡', 3:'データ異常', 4:'通信途絶'}
# PIC v8 voltage inputs: the pull-ups and the pressure curve are not known yet,
# so a good frame is "uncalibrated", and the rail flags never mean open/short.
DEFIVOLT_STATES = {0:'未校正', 1:'下限付近', 2:'上限付近', 3:'データ異常', 4:'通信途絶'}
STATE_LABELS = {'sensorhub_oiltemp':OILTEMP_STATES, 'defi_volt':DEFIVOLT_STATES}

def oiltemp_packet(raw):
    """Legacy PIC 0x600: int16 centi-C, uint16 ADC, uint32 ohms, all LE.

    -32768 is reserved for a fault, never a temperature. Check the full
    fault signature so a truncated/corrupt frame cannot become a valid value.
    """
    if len(raw) != 8:
        return None, 3
    temp, adc, resistance = struct.unpack('<hHI', raw)
    if temp == -32768:
        if 4091 <= adc <= 4095 and resistance == 0xffffffff:
            return None, 1
        if adc <= 4 and resistance == 0:
            return None, 2
        return None, 3
    if not 4 < adc < 4091 or not 0 < resistance < 0xffffffff:
        return None, 3
    return temp * .01, 0

def defivolt_packet(raw, byte_offset):
    """PIC v8 0x580: PRESS/TEMP1/TEMP2 ADC uint16 LE at 0/2/4, rail flags, version 1.

    Byte 6 bits 0-2 mark ADC <= 4 and bits 3-5 ADC >= 4091 (same order); the
    whole frame is checked so one corrupt field cannot pass as a voltage.
    """
    if len(raw) != 8 or raw[7] != 1 or raw[6] & 0xc0:
        return None, 3
    adcs = struct.unpack_from('<3H', raw)
    for i, adc in enumerate(adcs):
        if adc > 4095 or bool(raw[6] >> i & 1) != (adc <= 4) or bool(raw[6] >> (3+i) & 1) != (adc >= 4091):
            return None, 3
    adc = adcs[byte_offset // 2]
    return adc, 1 if adc <= 4 else 2 if adc >= 4091 else 0

class HardwareDecoder:
    def __init__(self, mount=None):
        # LongAccel/LatAccel/VertAccel are the car's axes from the mounting calibration
        # (imu_mount.py), not BNO055's linear acceleration, which stays in imu_raw.
        self.mount=mount if mount is not None else ImuMount()
        self.distance=0.0
        self.last_itow=None
        self.seen_itow=None
        self.gnss_hz=None
        self.gnss_intervals=deque(maxlen=20)
        self.can_values={}
        self.can_states={}
        self.last_ms=None
        self.last_can=[]
        self.pvt=None        # the receiver solution in effect: {'at','gps','utc','itow','fix','hacc'}

    def apply_pvt(self, nav, at):
        """One UBX NAV-PVT payload (92 bytes) seen at MCU time `at`, in arrival order."""
        itow=struct.unpack_from('<I',nav)[0]
        if self.seen_itow is not None:
            dt=(itow-self.seen_itow)%604800000
            if dt and dt<=1000:
                # The status-only path may skip a receiver solution. A single
                # 200 ms host gap must not relabel a 100 ms receiver as 5 Hz.
                self.gnss_intervals.append(dt)
                self.gnss_hz=1000/min(self.gnss_intervals)
        self.seen_itow=itow
        gps={'GPSFix':nav[20],'GPSSats':nav[23],'GNSSHz':self.gnss_hz}
        utc=None
        if nav[11]&3==3:
            year=struct.unpack_from('<H',nav,4)[0]
            utc=f'{year:04}-{nav[6]:02}-{nav[7]:02}T{nav[8]:02}:{nav[9]:02}:{nav[10]:02}Z'
        fix=nav[20]>=3 and bool(nav[21]&1)
        if fix:
            gps.update(Lon=struct.unpack_from('<i',nav,24)[0]*1e-7,Lat=struct.unpack_from('<i',nav,28)[0]*1e-7,Altitude=struct.unpack_from('<i',nav,36)[0]/1000,GPSSpeed=struct.unpack_from('<i',nav,60)[0]*.0036,Yaw=struct.unpack_from('<i',nav,64)[0]*1e-5)
            if self.last_itow is not None:
                dt=(itow-self.last_itow)%604800000
                if 0<dt<=1000:self.distance+=gps['GPSSpeed']*dt/3600000
            self.last_itow=itow
            gps['Distance']=self.distance
        else:self.last_itow=None
        self.mount.on_pvt(nav)
        self.pvt={'at':at,'gps':gps,'utc':utc,'itow':itow,'fix':fix,'hacc':struct.unpack_from('<I',nav,40)[0]/1000 if fix else None}

    def lose_pvt(self):
        """No solution within 1 s: GNSS columns go empty and distance/forward learning stop accumulating."""
        if self.pvt is not None or self.last_itow is not None:self.mount.on_pvt(None)
        self.pvt=None;self.last_itow=None

    def decode(self, status, batch, config):
        if self.last_ms is not None and status['mcu_ms'] < self.last_ms:
            self.can_values.clear();self.can_states.clear();self.distance=0;self.last_itow=None
            self.seen_itow=None;self.gnss_hz=None;self.gnss_intervals.clear();self.pvt=None
            self.mount.restart()
        self.last_ms=status['mcu_ms']
        self.last_can=batch.get('can',[])
        self.feed_can(self.last_can,config)
        legacy='nav' in status
        if legacy:
            # Firmware before 2026-11-09 hands over only the latest solution, in the
            # status snapshot (read at most every 0.1 s, so about 6 of 10 per second).
            nav=bytes.fromhex(status['nav'])
            if len(nav)==92 and status['gnss_at'] and (status['mcu_ms']-status['gnss_at'])%2**32<1000:self.apply_pvt(nav,status['gnss_at'])
            else:self.lose_pvt()
        samples=[]
        for seq,stamp,data in batch.get('rows',[]):
            raw=bytes.fromhex(data)
            if len(raw)==92:
                # Firmware from 2026-11-09 puts every NAV-PVT into the rows, between the IMU rows
                # in the order it arrived, stamped with the MCU time it arrived.
                self.apply_pvt(raw,stamp);continue
            if not legacy and self.pvt is not None and 1000<=(stamp-self.pvt['at'])%2**32<2**31:self.lose_pvt()
            pvt=self.pvt or {'gps':{},'utc':None,'itow':None,'fix':False,'hacc':None}
            gps,gnss_utc,itow=pvt['gps'],pvt['utc'],pvt['itow']
            if len(raw) not in (0,46):raise ValueError('Invalid BNO055 snapshot')
            imu_ok=len(raw)==46
            if not imu_ok:raw=bytes(46)
            x=struct.unpack('<22h',raw[:44]);v=dict.fromkeys(CHANNELS)
            v.update(gps)
            decoded,can_states=self.can_snapshot(stamp,config)
            if imu_ok:
                for i,name in enumerate(('AccelX','AccelY','AccelZ')):v[name]=x[i]/100
                for i,name in enumerate(('GyroX','GyroY','GyroZ')):v[name]=x[6+i]/16
                v.update(Roll=x[10]/16,Pitch=x[11]/16)
                # Standstill is judged on the vehicle speed when CAN has it, else GNSS.
                speed=decoded.get('Speed') if isinstance(decoded.get('Speed'),(int,float)) else gps.get('GPSSpeed')
                car=self.mount.add([x[0]/100,x[1]/100,x[2]/100],[x[6]/16,x[7]/16,x[8]/16],speed,stamp)
                if car:v.update(LongAccel=car[0],LatAccel=car[1],VertAccel=car[2])
            for name,value in decoded.items():
                if name in v:v[name]=value
            samples.append({'schema':1,'source':'logger-v2-hardware','demo':False,'seq':seq,'mcu_ms':stamp,'values':v,'can_signals':decoded,'can_states':can_states,'gnss_utc':gnss_utc,'gnss_itow_ms':itow,'imu_raw':data,'imu_calibration':({'system':raw[45]>>6,'gyro':raw[45]>>4&3,'accel':raw[45]>>2&3,'mag':raw[45]&3} if imu_ok else None),'imu_temperature_C':(raw[44] if raw[44]<128 else raw[44]-256) if imu_ok else None,'quaternion':[q/16384 for q in x[12:16]] if imu_ok else None,'gnss_hacc_m':pvt['hacc'],'imu_mount':self.mount.state()})
        if not legacy and self.pvt is not None and 1000<=(status['mcu_ms']-self.pvt['at'])%2**32<2**31:self.lose_pvt()  # the status may be older than the rows
        fix=self.pvt is not None and self.pvt['fix']
        return samples,{'imu':'正常' if status['imu_address'] else '未検出','gnss':'測位中' if fix else '測位待ち' if self.pvt is not None else '未受信','can':f"CAN1 {status['can_counts'][0]} フレーム（受信専用） / CAN2 センサーハブ {status['can_counts'][1]} フレーム",'sd':'未検出' if not status['sd_ready'] else '記録欠落あり' if status.get('sd_queue_dropped') else 'FAT32を認識できません' if status.get('sd_mounted') is False or status.get('sd_mounted')==0 else f"記録中 EL{status.get('sd_file',0):06}.BIN" if status.get('sd_logging') else '保存エラー' if status.get('sd_errors') else '認識済み' if status['sd_ready'] else '未検出','lte':'電源OFF / SIM・アンテナ未接続','camera':'未接続'}

    def feed_can(self, frames, config):
        """Keep the last 1.5 s of each configured signal from [stamp,channel,id,extended,rtr,hex] frames."""
        for stamp,channel,can_id,extended,rtr,data in frames:
            if rtr:continue
            raw=bytes.fromhex(data)
            for sig in config.signals:
                if sig.channel!=channel or sig.can_id!=can_id or sig.extended!=bool(extended):continue
                if sig.conversion in STATE_LABELS:
                    if sig.conversion == 'sensorhub_oiltemp':value, code = oiltemp_packet(raw)
                    else:
                        value, code = defivolt_packet(raw, sig.byte_offset)
                        if value is not None:value = value*sig.scale+sig.offset
                    for table, item in ((self.can_values,value),(self.can_states,code)):
                        history = table.setdefault(sig.name,deque())
                        history.append((stamp,item))
                        while history and (stamp-history[0][0])%2**32>1500:history.popleft()
                    continue
                width=int(sig.data_type.lstrip('uint'))//8
                if len(raw)<sig.byte_offset+width:continue
                value=int.from_bytes(raw[sig.byte_offset:sig.byte_offset+width],sig.endian,signed=sig.data_type.startswith('int'))
                value=int(bool(value&sig.bit_mask)) if sig.bit_mask else value*sig.scale+sig.offset
                if sig.conversion=='ntc':
                    value=sig.ntc_celsius(value)
                    if value is None:continue
                if math.isfinite(value):
                    history=self.can_values.setdefault(sig.name,deque())
                    history.append((stamp,value))
                    while history and (stamp-history[0][0])%2**32>1500:history.popleft()

    def can_snapshot(self, stamp, config):
        """Signal values fresh within 1 s of stamp, plus State (and Open for oil temperature) for PIC packets."""
        decoded={name:next((value for at,value in reversed(history) if (stamp-at)%2**32<=1000),None) for name,history in self.can_values.items()}
        can_states={}
        for sig in config.signals:
            if sig.conversion not in STATE_LABELS:continue
            code=next((value for at,value in reversed(self.can_states.get(sig.name,())) if (stamp-at)%2**32<=1000),4)
            can_states[sig.name]={'code':code,'label':STATE_LABELS[sig.conversion][code]}
            decoded.setdefault(sig.name,None)
            # A voltage near a rail is still a measured voltage; an oil temperature is not.
            if code >= (3 if sig.conversion == 'defi_volt' else 1):decoded[sig.name]=None
            decoded[sig.name+'State']=code
            if sig.conversion == 'sensorhub_oiltemp':
                decoded[sig.name+'Open']=int(code==1) if code in (0,1,2) else None
        return decoded,can_states
