ntakao2006-web/RaceCapture/outputs/sensorhub_voltage_20261101/edit.py

from pathlib import Path
p=Path('pic18f26q84_blink.X/main.c')
s=p.read_text()
a=s.index('/*'); b=s.index('/* Internal 64 MHz')
s=s[:a]+'''/* PIC18F26Q84, 28-pin package: external voltage inputs only.
 * PRESS=pin15 RC4/ANC4, TEMP1=pin21 RB0/ANB0, TEMP2=pin22 RB1/ANB1.
 * No internal pull-ups or assumed external divider/sensor calibration.
 * UART RC6/RC7 115200; CAN RB2/RB3 500 kbit/s.
 * CAN 0x580, 10 Hz: three uint16 LE ADC codes, rail flags, version=1.
 * Legacy thermistor packet 0x600 is deliberately no longer transmitted.
 */
#define _XTAL_FREQ 64000000UL
#define INPUT_COUNT 3u
#define ADC_MAX 4095u
#define ADC_LOW_MAX 4u
#define ADC_HIGH_MIN 4091u
#define NOMINAL_VDD_MV 5000UL /* Estimate only; actual VDD is not measured. */
#define CAN_FIFO_BASE 0x2600u
#define CAN_TX_BIT 2u
#define CAN_TX_PPS RB2PPS
#define CAN_TX_NAME "RB2"

'''+s[b:]
a=s.index('static unsigned char can_send_oil_temperature'); b=s.index('static void uart_puts',a)
s=s[:a]+'''static uint8_t rail_flags(const uint16_t adc[INPUT_COUNT])
{
    uint8_t flags = 0;
    uint8_t i;
    for (i = 0; i < INPUT_COUNT; ++i) {
        if (adc[i] <= ADC_LOW_MAX) flags |= (uint8_t)(1u << i);
        if (adc[i] >= ADC_HIGH_MIN) flags |= (uint8_t)(1u << (i + 3u));
    }
    return flags; /* Rail proximity only, NOT open/short detection. */
}
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
