ntakao2006-web/RaceCapture/(commit log)

2026-07-27 Initial commit after migrating project off Google Drive
    Working folder moved from G:\マイドライブ\RaceCapture to a local path
    to avoid git reliability issues with cloud-synced directories.
2026-07-29 Phase0-8: getAnalogCfg/setAnalogCfg/flashCfgをモックデバイスに実装
    センサーキャリブレーション設定(5点マップ+線形式)の読み書きコマンドを追加。
    公式アプリとの実機検証でAPI_SUCCESS定数の誤り(0ではなく1)とflashCfg応答の
    未実装を発見・修正。flashCfg再検証後の最終確認はtask_phase0_breakdown.mdに
    引き継ぎ事項として記録。
2026-07-29 Phase0-8完了: 公式アプリとのgetAnalogCfg/setAnalogCfg読み書き疎通を実機確認
    Write→flashCfg→Readの往復でscalMod/scalingが正しく永続化されることを
    公式RaceCaptureアプリ実機で確認。Phase 0の全タスクが完了したため、
    作業ログをarchive/へ移動しARCHITECTURE.mdへ結論を転記。
2026-07-29 Phase1-7完了: センサーキャリブレーション設定をESP32実機へ実装
    0-8で確認済みのgetAnalogCfg/setAnalogCfgのJSON形式をfirmware/src/main.cppへ移植。
    RAM保存(1-7-1)、flashCfg受信時のNVS永続化(1-7-2)、getAnalogCfgでの読み出し(1-7-3)
    を実装し、実機(Seeed XIAO ESP32C3, COM5)で一通り動作確認済み。
    公式アプリのWrite操作がタブに関わらずsetLapCfg等も一括送信することが判明し、
    未実装だとWrite全体がタイムアウトエラーになる不具合を発見。既存のgetLapCfg等
    5コマンドと対になるsetLapCfg/setTrackCfg/setCanCfg/setObd2Cfg/setConnCfgを
    スタブ実装して解消(1-7-4)。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
2026-07-30 Phase5完了・Phase1-4完了: ラップタイム計算実装とスマホ版公式アプリとのUSB接続確立
    - Phase5(5-1〜5-5完了): GPS位置に基づくラップ判定・予測タイム計算をESP32実機
    (main.cpp)に実装。トラック情報のNVS永続化、スタート/フィニッシュのジオフェンス
    通過検出、ベストラップとの距離ベース比較による予測タイム算出、RCPストリームへの
    チャンネル追加まで実装し、公式RaceCaptureアプリのDashboard画面での表示を実機確認。
    - Phase1-4完了(1-4-1〜1-4-5): ESP32-S3への移行が完了。TinyUSB CDC化により
    USBネイティブOTGでのRCP通信を実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
2026-07-30 Phase1-4-6完了: スマホ版公式アプリ2回目接続フリーズの原因調査
    Wi-Fi経由のadb logcat解析により、原因は公式アプリ(Android/Kivy版)内部の
    サンプルポーリングワーカーがUSB再接続後に復帰しないアプリ側バグと特定、
    自作ロガー側では対策不可と判断。副産物としてgetConnCfg/setConnCfgの未実装
    (ストリーミングキー再入力問題の原因)とgetStatus未実装を発見、1-4-7/1-4-8
    として追加分解した。
2026-07-30 Phase1-4-7/1-4-8完了: ConnCfg実データ化とgetStatus実装
    1-4-6の実機調査で見つかった副産物2件に対応。setConnCfg/getConnCfgを
    実データ化しPodiumストリーミングキー(telCfg.deviceId)をNVS永続化、
    未実装だったgetStatusコマンドを追加してStatusPumpの恒常的なタイムアウト
    警告を解消する応答を実装した。両ビルド環境でクリーンビルド成功を確認済み、
    実機での再接続後の動作確認は次回実機検証時に実施予定。
2026-07-30 Phase5-7完了: ベストラップ統計のNVS永続化
    7章未解決事項「ラップ統計・予測タイマーの永続化要否」に対応。
    g_bestLapSamples(ベストラップの距離→経過時間対応表)をAnalogCfg/TrackCfgと
    同じnvs_set_blob/nvs_get_blobパターンでNVS永続化した。2048要素全体だと
    NVSパーティション(24KB)を圧迫するため使用中の件数分のみ可変長で保存し、
    保存タイミングはflashCfgではなくベストラップ更新時の自動保存とした。
    あわせてCAN ID採番ルールの業界慣行をWeb調査した結果を7章へ反映
    (MoTeC/AiM等に共通の統一規格はなく、自社バスは独自採番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
2026-07-30 Phase1-5タスク分解: IMU統合を配線前後で分解
    CLAUDE.md 8章「フェーズ開始時の自動タスク分解ルール」に従い、次チャットへの
    引き継ぎに向けて1-5(GPS・IMUの実センサ値検証)を分解した。GPSは未調達のため
    GPS関連は未分解のまま据え置き、調達済みのIMU(秋月AE-LSM6DSV16X)部分のみ
    1-5-1(ESP-IDF I2Cドライバ実装)/1-5-2(taskA・RCPプロトコル統合、ここまで
    配線不要でビルド確認のみ完結可)/1-5-3(実機配線・動作確認)に分解した。
    参考としたArduinoサンプル(other/check_AE-LSM6DSV16X_extracted/)のレジスタ
    マップ・初期化シーケンス・スケール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
2026-07-30 Phase1-5-1/1-5-2完了: IMU(LSM6DSV16X)ドライバ実装とtaskA/RCPプロトコル統合
    配線前提でビルド確認まで実施。ESP-IDF新I2CマスタードライバでimuInit()/
    imuReadSensor()を実装し、taskA/kImuChannels/rcpSendMeta/rcpSendSampleへ
    統合した。配線が無い間はフォールバック値を送るため、esp32-c3-proto/
    esp32-s3両環境でクリーンビルド成功。実機配線・動作確認は1-5-3で対応。
2026-07-30 Phase1-5方針訂正: 姿勢推定(相補フィルタ+磁力計)を実装する方針に変更
    1-5-2完了直後に「姿勢推定は実装しない方針」と誤記していたが、ユーザーは
    オーバー/アンダーステア検出のため姿勢推定を望んでいると判明。公式ファーム
    ウェア(reference/RaceCapture-Pro_firmware)を確認したが姿勢推定ロジックは
    無く(Yaw/Pitch/Rollの実体はジャイロ角速度そのもの)、自作設計が必要と結論。
    ユーザーとの方針確認により、ソフトウェア相補フィルタでのRoll/Pitch推定、
    起動時自動キャリブレーションでの取り付け角度補正、磁力計追加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
2026-07-30 Phase1-5タスク追記: 磁力計ノイズ対策・時定数チューニング手順とマニュアル化タスクを追加
    1-5-8に、動的磁気干渉(オルタネーター等)への対策(磁場ノルムによる適応ゲイン)
    と、磁力計補正の時定数を現物合わせで決める具体的な手順(ジャイロ単体ドリフト
    実測→許容誤差到達時間→時定数決定)を追記。datasheet/lsm6dsv16x.pdfの
    ジャイロ温度ドリフト仕様(G_OffDr)から時定数の出発点(10〜30秒程度)を見積もった。
    将来IMU交換・車両載せ替え時にキャリブレーション手順を再現できるよう、
    1-5-9としてマニュアル化タスク(起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
2026-07-31 Phase1-5-4/1-5-5完了: 相補フィルタ姿勢推定と起動時キャリブレーションを実装
    相補フィルタ(atan2ベースの加速度角度+ジャイロ積分)でRoll/Pitch姿勢推定を
    実装し、RCPストリームへRoll/Pitchチャンネルとして追加。また起動時の静止
    区間からセンサー座標系→車体座標系への回転補正を自動算出するキャリブレー
    ションを実装し、相補フィルタの入力に適用した。配線・実機不要のためロジッ
    ク実装とPython再実装検算・ビルド確認までで完結、実機検証は1-5-3/1-5-6へ
    先送り。
2026-07-31 ARCHITECTURE.md更新: プロジェクト背景・実戦投入ターゲット・表示ユニット構成を追記
    市販品を採用しない理由、アーキテクチャ発案の経緯、実戦投入ターゲット
    (エコマイレッジチャレンジ)と開発体制の2段階方針を4章冒頭へ追記。
    表示ユニットをRaspberry Pi/スマートフォン両対応に更新し、CANトランシーバ
    調達完了・センサーハブADC割当の懸念点も反映した。
2026-07-31 ARCHITECTURE.md進捗認識修正・1-5-3タスク訂正: ハード側残作業の位置づけとIMUジャンパ表記を実物に合わせて更新
2026-07-31 参照用OSSクローン3件をGitサブモジュールとして登録
    reference/配下のRaceCapture-Pro_firmware・RaceCapture_App・
    RaceCapture_App_fork_ryandohertyは外部OSSのフルクローン(合計約125MB)で
    これまで.gitignoreで除外していたが、チームで共有できるようサブモジュール化した。
    実体は元のGitHubリポジトリを参照するため、このリポジトリの肥大化を避けつつ
    同じコミットを追跡できる。
2026-08-01 Phase2-0-1/2-0-2完了: ELM327 Bluetooth接続の疎通確認スクリプトを実装
    ELM327ミニとPCのBluetoothペアリング・COMポート確認、pyserialによる
    ATコマンド送受信スクリプト(elm327_probe.py)を作成し疎通確認済み。
    NCロードスター・レクサスUXへのOBD2プロトコル事前調査(task_phase2_breakdown.md)
    の初回タスクとして実施。
2026-08-01 Phase2-0-3〜2-0-5完了: NCロードスター実車でOBD2プロトコル・対応PIDを調査
    ELM327ミニ経由でNCロードスター(初期型)実車に接続し、ISO15765-4 CAN
    (11bit/500kbps)・JOBD準拠プロトコルで通信することを確認。管理用PIDを
    除く実質32項目のサポートPIDに対応し、回転数/車速/水温/スロットル/
    エンジン負荷/吸気圧/MAF/点火時期/バッテリー電圧等の主要走行系
    パラメータを含む全項目で実測値取得に成功した。油温・油圧は標準PID
    非対応のため、既存の追加センサー方式(CANハブ)の必要性を再確認した。
    調査結果はOBD2_SURVEY.mdに記録(VIN等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
2026-08-01 Phase2-0-8完了: NCロードスターでOBD2以外の生CANトラフィックを調査
    ELM327のATMA(Monitor All)により、標準OBD2 PID以外の車両独自CAN
    メッセージが観測可能であることを確認(200/201/211/212/215/21A/
    231/39A/4B0/4ECの10種のCAN ID)。ELM327のUART速度がCANバス実速度
    に対しボトルネックとなりBUFFER FULL/DATA ERRORが頻発するため、
    現状の接続方法では各IDの逆解析は困難と判断。本格的な逆解析には
    Phase2-1の自作CANトランシーバによるフルスピード直結が必要という
    結論を得た。
2026-08-01 Phase2にタスク追加: 生CAN逆解析のための計測基盤構築(2-4)
    2-0-8でELM327経由の生CANモニタリングにはUART速度ボトルネック・
    タイムスタンプ欠如という限界があると判明したため、その解決策として
    自作CANトランシーバ(ESP32 TWAI直接受信、マイクロ秒タイムスタンプ付与)
    による本格的な逆解析基盤の構築をPhase2-4として新規タスク化した。
2026-08-01 Phase2-0-9完了: NC型ロードスターのコミュニティCAN解析情報と実測を突合
    Web調査でNC型ロードスター(Mazda MX-5 NC)専用のCAN ID解析情報(GitHub
    のRaceChronoDiyBleDevice)を発見。0x200/0x201/0x215/0x231/0x4B0/0x240の
    デコード式を入手し、実測データと照合して車速・スロットル開度が高精度
    一致することを確認した。追加のATMAモニタリングで0x240/0x420/0x4FFを
    新規捕捉。0x081/0x085/0x090はDSC搭載車(2007年以降)限定と判明し本車両
    (2005年製初期型)では未観測。実車アクセス機会が限られる事情のため、
    Phase2-1のハードウェア実装を待たずELM327構成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
2026-08-01 Phase2-0-10完了: タイムリミット直前の追い込み調査(燃料レベル・警告灯)
    0x430(燃料レベル、粗いデコード式)を新規捕捉、0x211/0x212がダッシュ
    ボード警告灯関連との情報を別ソースで補強、0x4ECは情報源間で解釈が
    食い違うことを発見。RaceLogic社公式CAN DB(PDF)の存在を確認したが
    このセッションでは中身抽出できず将来の参照先として記録。
2026-08-01 Phase2-0調査を最終整理: NCロードスターCAN ID解析結果まとめ
    0x420の情報源間矛盾、0x202探索(未観測)、0x4ECの複数値比較などの
    追加調査結果を反映し、OBD2_SURVEY.mdに最終まとめ表を追加した。
    判明6ID・推測3ID・未解明4ID・DSC限定で対象外3ID・存在示唆のみ4ID
    に分類整理。実車アクセスのタイムリミットのため本セッションでの
    NCロードスター調査はここで区切る。
2026-08-01 Phase2-0-11完了: パワーウィンドウ操作による能動的逆解析を試行
    公道走行中のためウィンカー等は避け、パワーウィンドウの開閉で
    before/after差分比較を実施。ベースライン/開/閉の3状態を比較した
    結果、専用CAN IDの再現性ある変化は検出できなかった。MazdaのHS-CAN
    (パワートレイン系)/MS-CAN(ボディ系)の2バス構成という情報と整合し、
    OBD2ポートはHS-CAN側のみに接続されボディ系装備は別バスにある
    可能性が高いことを実験的に示唆する結果を得た。
2026-08-01 Phase2-0-12完了: ギアポジション取得可否を調査、MT車のため不可と結論
    ユーザー確認によりMT車と判明。AT車向けギアポジション候補ID 0x228は
    観測できず、0x231(クラッチスイッチ)のbyte1が0x02/0x00の2値を取る
    ことを確認した(巡航中は終始0x00で安定)。MT車には一般的に電子的な
    ギアポジションセンサーが搭載されていないため、CAN上から現在の段数
    を直接取得することはできないと結論した。
2026-08-01 Phase2-0: 未解明CAN IDのバイトレベル深掘り(0x211カウンタ判明等)
    30ラウンドの追加サンプリングにより、0x211末尾バイトが8bitローリング
    カウンタ(オーバーフロー確認)であること、0x420 byte0も単調増加する
    カウンタの可能性が高いことを突き止めた。0x212はABS/DSC off/トラク
    ション/ブレーキ警告に関連するとの外部情報も得て、異常なし時の
    固定値パターンを記録した。0x430の燃料レベルデコード式は前回との
    値の乖離が大きく精度に疑問ありと追記。0x4EC/0x4FF/0x39Aは引き続き
    未解明。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
2026-08-01 Phase2-0-13完了: 0x420原文確認・未観測ID再探索(204/4F0/4F1/202)
    madox.net原文で0x420が「温度または増加カウンタ」との記載を確認し、
    実測(byte0の緩やかな単調増加)との整合を確認した。0x4F0/0x4F1は
    5秒毎不変の固定値との文献情報を得た。35ラウンドの追加探索でも
    204/4F0/4F1/202は本車両で観測できず。
2026-08-01 Phase2-0-14完了: RaceLogic社公式CAN DB(PDF)の内容を確認
    前回バイナリのため抽出できなかったPDFをReadツールで直接読み込み、
    OBD2配線・CANボーレートの再確認と、商用マップの利用可能信号一覧
    (Brake Position/Steering Angle含む)を取得した。全バリアント対応
    ではないとの注記が、本車両でこれらの信号が観測できなかったこと
    (DSC非搭載)と整合することを確認した。
2026-08-01 Phase2-0-15完了: 実車データのさらなる追い込み(0x4F0初捕捉等)
    30ラウンドの追加サンプリングで0x4F0を初めて捕捉し文献値と比較した。
    0x4ECをbyte4-7の32bit値として解析し、単調カウンタでなくアナログ的
    な測定値らしい挙動と判明。0x21A/0x39Aは累計サンプルで一貫して
    ゼロ固定であることを再確認し、低頻度イベント系フラグと推定した。
2026-08-01 Phase2-0-16完了: エアコン操作による2回目の差分比較実験
    パワーウィンドウに続きエアコン設定変更でもbefore/after差分比較を
    実施したが、専用CAN IDは検出できなかった。2つの独立したボディ系
    操作で同じ結果が得られたことで、OBD2ポートがHS-CAN(パワートレイン
    系)のみに接続されているという仮説を補強した。
2026-08-01 Phase2-0-17完了: 社外メーターとの実測突合、水温データの信頼性を確立
    水温がOBD2・生CAN・社外メーターの3経路で一致することを確認し、
    デコード式の正しさを裏付けた。油温はSAE標準PIDでNO DATA、油圧は
    規格上PID自体が存在せず取得不可能と判明。ARCHITECTURE.mdの既存
    設計(油温・油圧は追加センサーで独自取得)の妥当性を実測で裏付けた。
2026-08-01 Phase2-0-18完了: 燃料レベルの精度をユーザー確認と突合、油面揺れ説を採用
    純正燃料計「半分くらい」との回答が、これまでの実測値の大半と近い
    ことを確認し、0x430のデコード式は概ね妥当と再評価した。外れ値は
    ユーザー提示の「走行時Gによる油面揺れ」説を採用し、ECU平滑化前の
    生センサー値ゆえのノイズと判断した。0x4ECとRPMの相関も試行したが
    サンプル不足のため断定は避けた。
2026-08-01 Phase2-0-19完了: 運転中の自動データ収集用スクリプトを新規作成
    次回レクサスUX調査時はユーザーが運転席で対話できないことを踏まえ、
    車種非依存のauto_can_survey.pyを作成した。OBD2 PID総当たり・生CAN
    無差別モニタリング・低頻度ID集中サンプリングの3戦略を1サイクルと
    して指定分数繰り返すループを実装。読み取り専用コマンドのみで車両
    設定は書き換えない安全設計。出発前にバックグラウンド実行し、停車
    後に結果を解析する運用を想定。
2026-08-02 運用ルール更新: コミットと同時にpushする方針へ変更
    GitHubリポジトリをチームの進捗共有に使っているため、タスク完了時の
    コミットは同時にpushする運用へ変更した。作業途中の未コミット変更は
    無理にpushしない。個人特定情報(VIN等)を含めない方針は継続する。
2026-08-02 ダッシュカム型リアルタイム映像配信システムの調査レポートを追加
    AiM SmartyCam的な、走行終了と同時に完成したオーバーレイ動画を得るための
    自作構成について調査し、AutosportLabs公式のRaceCapture video+data
    streamingシステムをベースとした実現方式をまとめた。ARCHITECTURE.mdとは
    独立した派生検討のため、試行錯誤ログを含む調査記録として別ファイルに記録する。
2026-08-03 Phase1-5-3完了: IMU実機配線・動作確認、CSピン仕様の誤りを修正
    実機でLSM6DSV16Xの初期化・WHO_AM_I応答・静止状態でのZ軸加速度≈1Gを確認。
    配線当初I2C無応答だった原因は、CSジャンパの仕様を逆に理解していたこと
    （データシート上はCS=HighでI2C有効、Low/GNDだとSPIモードでI2C無効）と、
    ブレッドボード配線の浮遊容量に対しI2Cプローブのタイムアウトが短すぎたこと。
    imuInit()のタイムアウト延長・内部プルアップ無効化で解消し、あわせて
    1-5-1/1-5-2/1-5-4/1-5-5（未コミットのまま溜まっていたIMUドライバ・姿勢推定
    実装一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
2026-08-03 Phase1-5-5追加: ジャイロ3軸のゼロ点オフセット除去を実装
    静止90分間の実機ログ解析でgyroZに0.137dpsのバイアス（約8.22度/分のドリフト
    相当）があると判明したため、起動時キャリブレーション(1-5-5)の静止ウィンドウ
    でジャイロ3軸の平均バイアスも同時に測定し、車体座標系への変換前に差し引く
    よう変更。実機再起動でgyro bias(dps): (-0.296,0.044,0.135)を確認し、90分
    測定値とほぼ一致・再現性ありと確認した。
2026-08-04 DC-3完了: VAAPI/VCEハードウェアエンコード対応確認
2026-08-04 Phase1-5-7追記: 磁力計モジュールの型番候補調査（AE-BM1422AGMV、購入未実施）
    秋月電子で調達可能なI2C接続の単体地磁気センサモジュールを調査し、
    ROHM製BM1422AGMVチップ搭載のAE-BM1422AGMV(g129354)を採用候補として選定。
    既存IMU(0x6A/0x6B)とI2Cアドレスの衝突がないことを確認。購入操作はユーザー実施待ち。
2026-08-04 DC-4完了: racecapture_streaming_install.shのAMD向け実行検証
    AutosportLabs公式スクリプト(bit.ly/3RL9Yoj)の実体を特定し、AMD向けに調整
    （intel-media-va-driver-non-free→mesa-va-drivers、Ubuntu24.04向けパッケージ名修正、
    gstreamer1.0-vaapi/-tools追加）。検証機(dashcam-test)でrace_capture・video-streamer
    ともdpkgインストール成功、VAAPI H264エンコーダー(vaapih264enc)の登録まで確認。
    GUI実起動は仮想ディスプレイの制約で要再確認、映像取り込みはUSBカメラ接続(DC-5)待ち。
2026-08-04 task_dashcam_breakdown.md更新: 次回案内をDC-5へ更新
2026-08-04 DC-5-1完了: ESP32-C3実機・USBカメラのAMD PC接続、video-streamer VAAPI問題の原因究明
    DC-5-1はESP32-C3にPhase1本開発ファームウェアを書き込みRaceCapture実機代わりとして
    AMD PC(dashcam-test)へ接続、USBカメラと合わせて認識確認まで完了。
    DC-5-2はvideo-streamerのVAAPI初期化失敗の根本原因(バンドル済み古いlibstdc++/libva
    とシステムMesaドライバの非互換)を特定・解消できたが、race_capture側で新たに
    「No matching FB config found」問題を発見し中断中。実GPU経由のXorgでも再現する
    ため、DC-2の物理モニター問題とは別個の課題であることが判明。詳細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
2026-08-04 DC-5-2追記: race_captureのFBConfigクラッシュ原因調査、Kivy固有ではなくSDL2自体の問題と特定
    Web調査でKivyのネイティブX11ウィンドウ実装のソースを確認し、フォールバックなしで
    即fatalErrorする脆い経路であることが判明。KIVY_WINDOW=sdl2でSDL2を強制したところ、
    SDL2自体も"Couldn't find matching GLX visual"で同様に失敗することを確認し、
    この検証機(AMD A4 PRO-7300B/Radeon HD 8470D、Mesa classic radeonドライバ+glamor)
    固有の環境問題である可能性が高いと判断した。
2026-08-04 DC-5-2追記: race_captureのFBConfig問題、システムGLXは無罪と確定・原因はバンドル版固有に絞込み
    ctypesでglXChooseFBConfigを直接呼び出し、Kivyと同じ属性で18件マッチすることを確認。
    システムのGLX/Mesa/Xサーバー自体は正常に機能しており、race_capture固有の問題と判明。
    video-streamerで有効だったLD_PRELOADによるバンドルライブラリ差し替えも効果がなく、
    PyInstallerのRPATH/絶対パスdlopenが原因と推測されるところまで切り分けて調査を一旦終了。
2026-08-04 DC-6準備: Intel実機(EliteDesk)向けインストーラーを保存、次の検証タスクを追記
    DC-5-2でAMD機固有の環境問題である可能性が高いと判断したため、公式推奨に近い
    Intel実機(EliteDesk 800 G3系、Core i5第7世代)での再検証に切り替える。
    公式インストールスクリプトからUbuntu 24.04向けの3点(libegl1-mesa->libegl1、
    gconf2削除、gstreamer1.0-vaapi/tools追加)だけを反映したIntel版を
    racecapture_streaming_install_intel.shとして保存し、次回作業の起点として
    task_dashcam_breakdown.mdにDC-6のサブタスクを追記した。
2026-08-05 DC-6-1,6-2完了: EliteDeskへのUbuntu Server新規インストール・SSH環境再構築
    BIOS/POST画面が出ない症状はSSDではなくディスプレイ接続(EliteDesk 800 G3の
    通常サイズ機はDisplayPort2+VGA1標準搭載)が原因と判明し解消。インストール完了後、
    SSH鍵の再登録・パスワードなしsudoの再設定まで完了し鍵認証で接続確認済み。
    racecapture_streaming_install_intel.shの内容もこの過程で再確認し、Intel向けの
    記述に問題がないことを確認した。
2026-08-05 DC-6-3完了: Intel実機でracecapture/video-streamerのインストール・VAAPI動作確認
    racecapture_streaming_install_intel.shをリモート実行し両パッケージのインストールを確認。
    Intel iHDドライバでVAAPI H.264エンコードがそのまま動作し、AMD機で必要だったLD_PRELOAD
    回避策が不要と判明。DC-4-3と同じ既知の非致命的エラー(~/Desktop不在)も再発し手動対処した。
2026-08-05 DC-6-4,6-5完了: Intel実機でもrace_captureのFBConfigクラッシュが再現、AMD固有問題説を否定
    USBカメラ・ESP32-C3の接続確認、video-streamerのVAAPI動作確認(LD_PRELOAD要、AMD固有ではなく
    バンドルライブラリの汎用的な非互換と判明)を経て、race_capture起動検証まで実施。
    No matching FB config found(exit 102)がIntel(Mesa iris系)でも完全に再現し、
    race_capture配布バイナリ自体がUbuntu 24.04世代のMesa/Xorg/XRenderスタックと
    一般的に非互換であることが確定した。DC-6-6は対応方針の決定待ちで保留。
    結論をDASHCAM_STREAMING_RESEARCH.mdへ転記した。
2026-08-05 DC-6-2追記: 次回接続時の注意点(DHCP IPアドレス変化・ネットワーク疎通)を明記
2026-08-05 DC-6-6-1〜4完了: Ubuntu 22.04ダウングレード方針決定、EliteDeskへ22.04新規インストール・SSH再構築・racecapture/video-streamerインストール確認
2026-08-05 DC-6-6-5完了: Ubuntu 22.04環境でもvideo-streamerのLD_PRELOAD回避策が有効なことを確認
2026-08-06 Phase2-0-6,2-0-7完了: レクサスUXのOBD2/CAN調査完了、OBD2_SURVEY.md・ARCHITECTURE.mdへ反映
    auto_can_survey.pyによる無人自動収集（走行中約2時間46分・236サイクル）で実施。
    プロトコルはNCロードスターと同じISO15765-4 CAN、対応PID31種類を確認。
    NCロードスターとの差異（油温PID対応、EV走行モード疑いのスナップショット）を
    参考データとして記録。生の収集ログ(lexus_ux_auto_survey.json等)はサイズが
    大きいため.gitignoreに追加しコミット対象外とした。
2026-08-06 DC-6-6-6完了: Ubuntu 22.04環境でもrace_captureのFBConfigクラッシュが再発しないことを確認、ダウングレード方針の有効性を実証
2026-08-06 DC-6-6-6,6-6-7完了: Ubuntu 22.04+Intel機でrace_captureのFBConfigクラッシュ解消、ダッシュ表示+映像データ焼き込みの動作を実証。audioグループ追加漏れをインストールスクリプトに反映
2026-08-06 DC-6全体完了を反映: DASHCAM_STREAMING_RESEARCH.mdへ結論転記、task_dashcam_breakdown.mdのDC-6ヘッダー更新
2026-08-06 DC-7-1完了: ratpoisonキオスク自動起動を実証、GDM自動ログイン設定・keyring初期化の恒久対応をインストールスクリプトへ反映。DC-7-2〜4を次回タスクとして整理
2026-08-06 DC-7-1追記: 実機モニター+マウス接続でクリック不能事象を発見・切り分け・解消。キオスク自動起動フロー経由での動作を最終確認
2026-08-06 DC-7-2調査中: video-streamerのRTMPリトライでログが45GBまで肥大化しディスクフル寸前になる重大バグを発見・解消、logrotate対策をインストールスクリプトへ反映
2026-08-06 DC-7-2完了: ローカルRTMPサーバーでvideo-streamerの配信パイプライン自体が正常動作することを実証
2026-08-10 DC-8/DC-9: ライブテレメトリー動作確認を記録、ROCK 5B移行方針を検討・文書化
    DC-8: スマートフォン版RaceCaptureアプリ経由のpodium.liveライブテレメトリー配信を
    ユーザーが事前検証済みであることを記録。
    DC-9: 車載重量・コスト面の課題から、x86ルート(EliteDesk/LattePanda)に代わる
    Radxa ROCK 5B(Rockchip RK3588, ARM)への移行を検討・決定。背景・コスト比較・
    技術的トレードオフ・電源回路仕様をDASHCAM_ROCK5B_REPORT.mdにまとめ、
    今後の進め方をtask_dashcam_breakdown.mdのDC-9として整理。
2026-08-10 Markdownの文言を修正
2026-08-10 DASHCAM_ROCK5B_REPORT.mdに電源ON/OFF運用方針を追記
    駐車中は電源オフ（バッテリー負荷回避）、走行直前にGPSウォームアップのため
    事前に電源を入れることがある、という運用方針を4.5節として追加。
    イグニッション連動のみでは不十分で、ON側は事前操作が必要という設計要件を
    友人（電源回路設計担当）に共有するため。
2026-08-11 ROCK 5Bで残る2つのソフトウェア的ハードル（GPU描画/ハードウェアエンコード）を友人向けに文書化
2026-08-11 CANゲートウェイ構成（外部CANへの車両データ中継・3.3V電源ライン）を決定・文書化
    車載CAN(OBD2、listen-only)と外部CAN(センサーハブ/アクセサリー用)の間でロガー本体が
    中継役を兼ねる方針を確定し、ARCHITECTURE.md/hardware_interface_spec.mdに反映。
    外部CANバスの3.3V電源はESP32-S3オンボードレギュレータを流用せず専用回路を新設する
    方針とし、電流容量の見積もりを友人との相談事項として明記。
    あわせてhardware_interface_spec.mdをCLAUDE.mdのファイル構成に追加し、README.mdを
    新設して電気系の友人がGitHubから迷わず参照できるよう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
2026-08-11 モータースポーツ用途での仕様上の穴を洗い出し、7章へ8件追記
    実装(firmware/src/main.cpp)を確認した上で、実運用で問題になりうる未確定事項を
    ARCHITECTURE.md 7章へ追記した。
    - ログの絶対時刻(UTC)・セッション区切り未設計（GoPro同期ゴールに直接抵触）
    - SDカード満杯時の挙動が未定義
    - クランキング時の電圧ドロップに対するブラウンアウト耐性（pulse-and-glide前提）
    - ベストラップがトラック非紐付け＋リセット手段なし（別サーキットでPredTimeが破綻）
    - ラップタイムの妥当性チェック無しで異常ラップが永久保存され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
2026-08-11 ハードウェア面のレビュー結果を文書化、前回のソフト面指摘をタスク化
    ハードウェア面（新規判明、hardware_interface_spec.md・ARCHITECTURE.mdへ反映）:
    - ESP32-S3の内蔵TWAI(CAN)コントローラは1系統のみとESP-IDF公式ドキュメントで確認。
    車載CAN＋外部CANの2系統構成には外付けSPI CANコントローラ(MCP2518FD等)が必須。
    割り当ては車載=内蔵TWAI/外部=SPI外付けを推奨（相談事項として追加）
    - MCP2562FDはVDD=5V系が必要な点を部品表へ明記
    - 外部CAN用3.3Vレギュレータの入力となる生12V引き込みが電源計画に無い点を指摘
    - GNSS選定要件に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
2026-08-11 CAN配線を2系統とも送受信フル対応に明記（listen-onlyはソフトウェアポリシーと明確化）
    車載CAN側の受信専用(listen-only)はTWAIのモード設定によるファームウェア側の
    ポリシーであり、ハードウェアの配線制約ではないことを明記。トランシーバのTXピンは
    車載CAN・外部CANとも通常通り結線しておき、将来ファームウェア更新だけで送信運用へ
    切り替えられる状態を維持する方針とした（標準的なトランシーバ回路は元々双方向のため
    追加コストなし）。あわせて3系統目以降が必要になった場合に備え、SPI CS/割り込み用
    G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
2026-08-11 ベストラップリセットをCANボタン方式として選択肢に追加、アクセサリー一覧を新設
    task_phase5_breakdown.md 5-8-2に「外部CAN経由の物理ボタン」を候補として追加。
    ロガー側の外部CAN受信(RX)監視経路が現状未実装である点、ボタン単体で専用ノードを
    作らずシフトインジケーター等のMCUへ相乗りさせる方針を実装メモとして記録。
    hardware_interface_spec.mdに5章「外部CANバスに接続予定のアクセサリー一覧」を新設し、
    センサーハブ・シフトインジケーター・高輝度サブディスプレイを友人と共有できる形で
    一覧化した（用途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
2026-08-11 友人への製作依頼スコープを明示（ロガー本体だけでなく周辺基板一式）
    hardware_interface_spec.mdの冒頭に依頼範囲の要約を追加し、6章「製作を依頼したい
    基板一覧」を新設。メインロガー基板に加え、CANハブ/センサーハブ基板・外部CAN
    アクセサリー基板も製作依頼対象であることを明記した。センサー信号調整回路（アンプ）
    の要否がセンサー型番選定と表裏一体である点を相談事項として記載。
2026-08-11 100チャンネル級のSD書き込みスループット実測タスクを追加
    6-1-3(共通チャンネルテーブルからのCSVライター)完了後に、帯域計算上の見積もり
    （0.1〜0.2MB/秒程度）を実機で裏付ける6-1-4を新設。あわせて1-2-1で見つかった
    SDMMC 4bit信号品質問題(GNDリターン電流不足によるCRCエラー)が高頻度書き込みで
    再発しないかも確認項目に含めた。
2026-08-11 DASHCAM_ROCK5B_SOFTWARE_HURDLES.mdにCPU/メモリのスペック十分性の検討を追記
2026-08-11 SDカード冗長化(2枚ミラーリング)の検討経緯を記録、不採用と結論
    MoTeC C125等レーシングロガー業界の実例調査（基板直付けメモリを採用しSDカード
    自体を使わない、カメラ業界の「2枚差し」も大半はミラーリング目的ではない）を踏まえ、
    2枚同時書き込みによる冗長化は不採用と判断した経緯をhardware_interface_spec.mdへ
    記録。不採用理由（ハードウェアコスト増・ソフトウェアの複雑化・振動リスクには
    むしろ逆効果になりうる点）を3点に整理し、友人への説明用メモとしても使える形にした。
    代わりにロック機構付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
2026-08-11 友人とのミーティング進行ガイドを新設
    hardware_interface_spec.mdの情報量が増え、章の並び順（時系列で追記した順）と
    ミーティングで話すべき優先順位が一致しなくなってきたため、hardware_meeting_agenda.md
    を新設した。全体像共有(6章)→メインロガー仕様(1・2章)→周辺基板(5章)→本題である
    相談事項(3章、優先度順)という推奨進行順を示す道しるべに徹し、内容自体は
    hardware_interface_spec.md側に一元化した。README.md・CLAUDE.mdからも辿れるようにした。
2026-08-11 ARCHITECTURE.mdロードマップをtask_phaseX_breakdown.mdの最新状態に同期
    Phase2-0(OBD2事前調査)はtask_phase2_breakdown.mdで全サブタスク完了済みだったが
    ロードマップ側が「着手中」のまま更新漏れだったため完了に修正。
    Phase5-8(ベストラップ信頼性強化)・5-9(セクタータイム)はtask_phase5_breakdown.mdに
    既に分解済みだがロードマップ本体に転記されていなかったため追加。
2026-08-11 ダッシュカムDC-9-2の買い物リストを更新、ROCK5B関連資料を追加
    eMMCモジュール(OS起動用)・振動対策込みのmicroSDを買い物リストへ明記し、
    M.2 NVMe SSDは消費電力・発熱懸念から見送りと明記。
    datasheet/にRadxa Display 10 FHDのデータシートと、友人からの寸法図面(20250113)を追加。
2026-08-12 Phase5-8-3完了: ラップタイムの妥当性チェック（最小ラップタイム閾値）を実装
    ジオフェンス二重発火・ピットレーン通過等による異常に短いラップがベストラップとして
    恒久保存され、以降のPredTimeが壊れる問題への対応。lapRecorderUpdate()のベスト更新
    条件にkMinValidLapTimeSec(10秒)未満を除外する条件を追加。esp32-c3-proto/esp32-s3
    両環境でビルド成功を確認。実機での誤検出再現・回避確認は5-6実車検証時の課題として残す。
2026-08-12 Raspberry Pi車載ダッシュボードのRaceCapture Appセットアップ進捗を記録、ディスプレイ接続確認待ち
2026-08-12 Raspberry Pi 3BへのRaceCapture Appセットアップとtrixie対応の知見を記録、電源アンダーボルテージ問題を発見
2026-08-12 Phase4-4分解: Raspberry Pi 3B画面表示問題の調査経緯を記録、次回はソース調査から再開
2026-08-12 Phase4-4-2進捗: RPi 3B画面描画バグを2件特定・修正、文字/アイコン非表示の残課題を記録
    fullscreen設定(prefs.jsonのfull_screen_mode)とMSAA(multisamples=2)がPi 3BのレガシーGPUで
    描画を阻害していたことを発見・修正し、背景描画は大幅改善。ただし文字・アイコン類は依然
    非表示のため未完了。あわせて電源アンダーボルテージが通常運用でも再発している問題を発見し
    暫定緩和（根本対策は電源交換）。詳細はtask_phase4_breakdown.mdの4-4-2参照。
2026-08-12 Phase4-4-2追記: ユーザーの実機目視により文字描画に関する反例を発見、次回の調査方針を修正
    物理モニタ上ではPopup（alertPopup）の文字が実際に読めることが判明し、
    「文字・アイコンが一切描画されない」という前回の結論を修正。単発kmsgrab
    キャプチャがタイミングを取りこぼしていた可能性が高く、次回は連続キャプチャ
    から着手する方針を追記。
2026-08-12 Phase4-4-2進捗: 実機逆コンパイルによりstencilバッファ仮説を特定、toast経路の誤解を訂正
    race_captureバイナリをpyinstxtractor-ng+xdisで逆コンパイルし、ダッシュボード数値表示
    (DigitalGaugeElement)がOpenGL stencilバッファでLabelをクリッピングしていることを確認。
    Raspberry PiレガシーVC4/Mesaドライバのstencil buffer既知問題との関連を有力仮説として記録。
    また実機目視で見えた文字はPopupでなくkivymd.toast()経由と判明し前回の仮説を訂正。
    連続kmsgrabキャプチャでは正常稼働中もメイン画面が背景色のみのままであることも確認。
    Co-Auth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
2026-08-12 Phase4-4-2追記: eglinfoでstencilバッファ仮説を検証、ドライバ側は8bit対応と判明
    Mesa 26.2.0のVC4ドライバはstencil=8bit対応のEGL Configを複数提供しており、
    「ドライバがstencilを全くサポートしていない」という当初仮説は単純化しすぎだったと訂正。
    焦点はKivyのウィンドウ生成時に実際にstencil対応Configが選択されているかに絞られたが、
    EGL_LOG_LEVEL=debugでは確認できず未解決のまま次回へ持ち越し。
2026-08-12 Phase4-4-2進捗: stencil仮説を実測で完全否定、原因をEGL/KMSページフリップ境界へ特定
    gdb+Python C API注入でライブプロセスへ直接介入する調査手法を確立。実測で
    GL_STENCIL_BITS=8・GLエラーなしを確認しstencil仮説を否定。Kivy自身の
    Window.screenshot()では文字・アイコンが完璧に描画される一方、kmsgrab/物理
    モニタでは背景色2色のみという決定的な乖離を発見。オフスクリーンFBOの不在も
    確認済みで、アプリ・Kivy・フォント側は無罪、SDL2 KMSDRM〜Mesa VC4間の
    バッファスワップ/ページフリップ経路が最有力の原因と判明。
    Co-Authored-B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
2026-08-12 Phase4-4-2進捗: EGL/DRM基本設定は正常と確認、2つのワークアラウンド候補は空振り
    eglQuerySurfaceでEGL_BACK_BUFFER+EGL_BUFFER_DESTROYEDという標準的な構成を確認、
    /sys/kernel/debug/dri/0/stateの連続サンプリングでDRMプレーンが3枚のフレーム
    バッファを正常にローテーションしページフリップし続けていることも確認した。
    SDL_VIDEO_DOUBLE_BUFFER=0環境変数、Window.canvas.ask_update()の毎フレーム
    強制実行、の2つのワークアラウンド候補はいずれも症状を改善せず。次回は最小
    Kivyアプリでの再現実験に絞って調査を継続する。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
2026-08-12 Phase4-4-2追記: 最小Kivyアプリでの再現実験を試みるも結論出ず、次回への引き継ぎ事項を記録
    apt導入のpython3-kivyで最小限のLabel+背景矩形アプリを作成・実行したが、
    race_captureとは異なるパターン（背景すら描画されない）の不具合が発生し、
    決定的な結論に至らなかった。次回の改善案（明示的なフレーム待機の追加等）を
    記録。python3-kivyとEGL/GLES開発ヘッダーは実機に恒久導入済み。
2026-08-12 Phase4-4-2追記: 最小Kivyアプリの不具合はタイミング問題ではなく真正の別不具合と確定
    on_start()内でClock.schedule_once(3秒後)からWindow.screenshot()を呼ぶよう改良し
    再実行したが、結果は前回と完全同一（不透明黒一色）だった。これによりタイミング
    懸念を排除し、この最小アプリの不具合はrace_capture本体の症状とは異なるパターン
    （Kivy内部読み戻しでも一切描画されない）の真正の別問題であると確定。次回の
    再挑戦条件（canvas.before回避、kv言語での定義、ライブラリ近似化）を記録。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
2026-08-12 Phase4-4-2追記: SDL2バージョンが根本原因と実証、強制再描画workaroundを最小アプリで確立（実機適用は未達）
    最小Kivyアプリにrace_capture同梱のSDL2 2.30.7を移植し、race_capture本体と同じ
    「GPU内部読み戻しは正常だがKMS実スキャンアウトのみ異常」という乖離を初めて再現。
    毎フレーム強制再描画させるworkaroundでこの最小アプリは完全に症状解消することを実証した。
    ただし同workaroundをgdb注入で実機race_capture本体へ適用する3手法はいずれも効果なく、
    実機での修正適用は次回へ持ち越し。
2026-08-12 Phase4-4-2追記: force-redraw系ワークアラウンドを打ち切り、gdb infcallのGILデッドロック回避策(scheduler-locking off)を確立
2026-08-13 Phase4-4-2追記: KivyMDのRenderContext/FBO仮説を横断検索で完全否定、SDL2コアのみ差し替えでは実機は直らないと実証
2026-08-13 Phase4-4-2追記: dlsymフックでEGL呼び出しを可視化、WindowPatchによるon_draw無効化という新有力仮説を発見
    - LD_PRELOADでのeglChooseConfig等の単純フックは失敗すると判明（SDL2はdlopen+dlsym(handle,...)で
    直接シンボル解決するためグローバルシンボル差し替えでは横取りできない）
    - dlsym()自体をフックする方式に切り替えて横取りに成功。eglChooseConfigは実際には一度も
    呼ばれておらず、eglCreateWindowSurfaceが起動直後と14秒後の2回、同一サーフェスへ呼ばれている
    ことを確認（＝リサイズ相当のイベントが実在する）
    - 逆コンパイル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
2026-08-13 Phase4-4-2追記: WindowPatch仮説を完全否定、LD_PRELOADでtoast文字列の正常描画を実証
    - gdb Python注入でWindow.on_draw/update_viewportが常にオリジナルのままと確認、
    リサイズイベントも一度も発火していないためWindowPatch仮説を完全否定
    - on_draw/flipは高頻度(約70Hz/24Hz)で正常に呼ばれ続けていることを実測で確認
    - 短時間の連続gdb call注入がメインスレッドをGILデッドロックに陥らせる事故が
    2回連続で発生、以降LD_PRELOADベースの安全な手法に方針転換（重要な安全知見として記録）
    - eglSwapBuffers直前でglReadPixelsするegl_interpose3.soを新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
2026-08-13 Phase4-4-2追記: Setup→Home画面遷移手順を確立、遷移後にeglSwapBuffersが停止する謎を発見
    - setupview.pyの逆アセンブルからSetup→Home遷移ロジックを完全に復元し、
    screen.dispatch('on_setup_complete')でHome画面への遷移を実機で実証
    - egl_interpose3.soでスワップ監視中、Home画面遷移後にeglSwapBuffersが
    完全に停止する現象を発見。ESP32のRCPAPI通信ポーリングが間接的に
    レンダーループを駆動している可能性を新仮説として記録
    - 実験用プロセス起動時に二重起動事故が再発（数秒で復旧済み）、
    今後の手順徹底事項として記録
2026-08-13 DC-9-2完了: ROCK 5B本体・eMMC等を注文、DC-9-3向け起動準備手順書を追加
    Raspberry Pi向けインストーラーがEGL/OpenGL ES系の依存構成であることが判明し、
    x86版のGLX特有のFBConfigクラッシュがROCK 5Bでは再発しない可能性がある、という
    新しい仮説をDASHCAM_ROCK5B_SETUP_GUIDE.mdに記載。
2026-08-13 Phase4-4-2追記: gdb timeoutによるcall未完了デッドロックを新たに発見、安全上の教訓を記録
    - ESP32ポート解放後の再検証を試みたが、bashのtimeoutコマンドがgdbを
    強制終了させたことでcall呼び出しが未完了のまま残りデッドロック
    - 今セッションで3種類目のgdb call注入デッドロックパターンとなり、
    この環境でのgdbライブ注入は本質的にリスクが高いと結論
    - 次回以降はLD_PRELOADベースの静的フック手法を優先する方針を明記
2026-08-13 Phase4-4-2追記: gdb不要の安全な注入手法を確立、Home画面が描画されない核心症状を実証
    - LD_PRELOADライブラリ自身の中からPython C APIを呼ぶ手法を確立。対象プロセス
    自身のレンダースレッドの通常呼び出し経路の一部として実行されるため、
    gdb callで3回発生したデッドロックのリスクを本質的に回避できる
    - ESP32ポート競合を解消した状態でHome画面へ遷移させたところ、eglSwapBuffersは
    継続して呼ばれ続けるにもかかわらず、Home画面のコンテンツ（背景矩形すら）が
    一切バックバッファに描画されないことをgdbなし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
2026-08-13 DC-9-3手順書のOSインストール手順を全面改訂: microSD経由dd方式の誤りを訂正
    公式ドキュメント・フォーラムを再調査した結果、eMMCモジュール装着時は優先的に
    そちらから起動する仕様のため「microSDから起動してddでeMMCに書き込む」方式には
    確立された手順がないと判明。正しい2方式(USBリーダー経由/RKDevTool+Maskromモード)
    に差し替え、OSイメージの選定基準(Debian bookworm、race_captureの要件と整合)も明記。
2026-08-13 Phase4-4-2追記: Home画面のPython/Kivy状態が完璧に正常と確定、真因をレンダリングパイプライン内部に絞り込み
    - Home画面(HomePageView)のウィジェットツリーを実機で直接ダンプし、
    全ウィジェットのopacity=1.0・正のsize・canvas_childrenへの描画命令登録
    (1〜17個)がすべて正常であることを確認
    - 同時刻のバックバッファは依然として完全に透過のみと確認、アプリ側の
    状態管理という方向性を完全に排除
    - 焦点をGraphicsCompiler.compile()/InstructionGroup.apply()からeglSwapBuffers
    に至るレンダリングパイプライン内部(Cython/ネイティブコ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
2026-08-13 Phase4-4-2追記: GL描画コマンド計測の試みを記録、SDL_GL_GetProcAddressフックでクラッシュ
    - cgl_sdl2.soがSDL_GL_GetProcAddress経由で全GLES関数を動的解決している
    ことを確認し、glDrawArrays等の呼び出し回数を計測する仕組みを実装
    - 実行するとrace_captureがウィンドウ初期化中にクラッシュ、原因未特定のまま
    次回への引き継ぎ課題として記録
2026-08-13 DC-9-3手順書: eMMC書き込み方式をB(Maskrom+RKDevTool)に確定
    eMMC USBリーダーは手元になし、データ通信対応USB Type-A to Type-Cケーブルは
    確保済みと確認できたため、方式Aは参考記載に留め方式Bを採用方式として明記。
2026-08-13 Phase4-4-2追記: SDL_GL_GetProcAddressフックのクラッシュ原因を特定・修正し、Home画面での実描画コマンド発行を実測
    - dlsym(RTLD_NEXT,...)がRTLD_LOCALでdlopenされたlibSDL2.soを見つけられない
    ことが原因のSIGSEGVを特定し、dlopen(exact_path)+dlsym方式で修正
    - 修正版フックでHome画面のglClear/glDrawElementsがデフォルトフレームバッファ
    (FBO 0)へ数千回規模で実際に発行され続けていることを実測、FBO誤指定・
    シザークリップの2仮説を否定
    - glClearがGL_COLOR_BUFFER_BITを含まない新たな異常を発見、次回の最優先candidateに設定
    - 前回セッションで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
2026-08-13 Phase4-4-2追記: apitraceによる計測でglClear色欠落・RGB側ブレンド異常の2仮説を否定
    apitraceを新規導入し、EGL/GLES呼び出しを引数付きでトレース。glClearは各フレーム冒頭で
    GL_COLOR_BUFFER_BITを含めて正しく発行されており、前回の「欠落」所見はフレーム末尾の
    ウィジェット単位stencilクリアを誤検出した計測アーティファクトと判明。glBlendFuncのRGB側も
    標準的な組み合わせで異常なし。副産物で「解像度1024x768上書き」の謎もEGL初期プレースホルダ
    値と判明しクローズ。焦点はDRM/KMSスキャンアウト経路へ絞り込まれた。
    Co-Autho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
2026-08-13 Phase4-4-2追記: KMS/DRMページフリップの正常動作をカーネル一次情報で実証、apitrace dump-imagesの恒久的な制限を特定
    - /sys/kernel/debug/dri/0/stateの直接読み取りで、Home画面稼働中のページフリップが
    正常に機能していることを実測確定(スキャンアウト側の異常仮説を否定)
    - apitrace dump-images/glretraceがGBMヘッドレスreplayで最初のeglSwapBuffers通過後
    恒久的に使用不能になるツール側の制限を特定し、この経路を打ち切り
    - 新たにeglretrace -D(GL状態JSONダンプ)を確立し、デスクトップGL 2.1 Compatibility
    Profileでの描画・標準シェーダー・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
2026-08-13 Phase4-4-2追記: apitrace dump --blobsでバッファ実データを抽出し、過半数の描画が画面内の妥当な座標を持つ実コンテンツだと確認
    - glBufferDataのblobをファイル出力する手法を確立し、インデックスバッファの実内容から
    実際に使われる頂点範囲を正しく特定できるようになった
    - 19箇所のサンプリング調査で、描画呼び出しの過半数(58%)が画面内に収まる妥当な座標・
    形状(ゲージ輪郭線、ステータスバー等)を持つことを確認
    - 「正しい内容がGPUへ送出されているのに画面に出ない」という矛盾がこれまでで最も
    強く絞り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
2026-08-13 Phase4-4-2追記: デスクトップGL 2.1使用はSDL2側の意図的な選択と確認しクローズ
    トレース冒頭のeglBindAPI/eglChooseConfig呼び出しを確認し、アプリが明示的に
    EGL_OPENGL_API/EGL_OPENGL_BITを要求していることが判明。GLESへの想定外の
    フォールバックではなく、次回優先候補から除外。
2026-08-13 Phase4-4-2追記: kmsgrabピンポイント撮影で背景色のみ再確認、glBindFramebuffer0回でFBO仮説を完全否定、ステンシルテスト(ref=2)実バッファ値の未検証を次回最優先に特定
2026-08-13 Phase4-4-2追記: egl_interpose7.soでステンシルバッファ直読みを試みるも実機負荷で描画悪化、副産物として透過黒の見え方誤解を訂正し単一スキャンライン状の断続コンテンツを新発見
2026-08-13 Phase4-4-2追記: ユーザーの実機直接操作により「オーバーレイ系(ナビドロワー/パネル/ポップアップ/カーソル)は描画される、ScreenManagerのメイン画面コンテンツだけ描画されない」というクリーンな境界線を実証、次回の調査方針を更新
2026-08-13 Phase4-4-2追記: 逆コンパイル済みソースの比較調査により「ステンシルクリッピング仮説」単独では描画不良を説明できないと判明、NoTransition確認によりFBO仮説を完全クローズ、境界線は「ScreenManagerのcurrent Screen配下かどうか」に絞り込み
2026-08-13 Phase4-4-2追記: 第14回セッションの実機直接操作による境界線実証をARCHITECTURE.mdへ反映漏れ分を補完、第15回（静的解析）で候補(a)(b)(c)がいずれもKivyライブラリ側の一般的不具合としては説明力不足と判明、次回はライブglReadPixels検証へ回帰する方針を確定
2026-08-13 Phase4-4-2追記: glReadPixelsによるライブ検証をついに実現、DASHBOARD画面はページ送り矢印ボタン以外ほぼ何も描画されていないことを実機内部から直接確認。Window.screenshot()「完璧に描画」の前提はHome画面限定だった可能性が判明し、DashboardViewのKVソース入手により矢印ボタンとAnalysisCarousel/TripleGaugeB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
2026-08-13 Phase4-4-2追記: 矢印ボタンだけ描画される理由を「pos/sizeの絶対値指定vsFloatLayoutのpos_hint依存」という軸で特定、これまで別々だった3つの謎（矢印ボタン現象・Home/Dashboard画面の描画差・実解像度1024x576固定問題）を統一的に説明できる仮説に到達（第17回、静的解析のみ）
2026-08-13 Phase4-4-2追記: 新しい安全なライブPython注入手法(PyGILState_Ensure同期呼び出し)を確立し、第17回のFloatLayout仮説とステンシル仮説を実測で反証、さらに「矢印ボタンだけ描画される」という第16回以来の前提自体が誤りと判明。第14回の本来の境界線(ScreenManagerのcurrent Screen配下は一切描画されない)を再確認（第18回、ユーザ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
2026-08-13 Phase4-4-2追記: ユーザー実況をきっかけに「矢印ボタンだけ描画される」という第16回以来の前提が誤りと判明。実は画面中央に一時表示されるヒント的要素であり、DashboardView本来のナビゲーション矢印は他のウィジェット同様一度も描画されていないと確定。生RGBAバッファをPNG化する新手法も確立（第19回、ユーザー立ち会いあり）
2026-08-13 Phase4-4-2追記: app.switchMainView()によるタッチ不要のプログラム的画面遷移を発見し第9回以来の制約を解消。setup/dash画面のScreen canvas構造を直接比較し、最も単純な全画面背景矩形すら描画されないことを確認、複雑性ベースの仮説群を排除。glDrawElementsフックは技術的な壁で未達（第20回、ユーザー不在の自律調査）
2026-08-13 Phase4-4-2追記: apitraceとswitchMainViewを安全併用する新インジェクタでdash画面のGL描画コール発行・テクスチャ内容の正常性を確定。一方、GPU実測手段(オフラインsnapshot・occlusion query)2種が正常系でも異常値を返すことが判明しツール不具合と特定、副産物として本機Mesaが異常に新しいバックポート版と判明し次回のダウングレード検証を最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
2026-08-13 Phase4-4-2追記: occlusion queryが常に0を返す件は公式Mesaドキュメントで「VC4はocclusion query非サポート」という既知仕様と判明したための訂正。ドライバ不具合の根拠が半分になったためMesaダウングレード方針の優先度を控えめに再評価（第21回セッション内訂正）
2026-08-13 Phase4-4-2追記: 第16回セッション以来5回持ち越しだった正体不明のヒント要素の正体を特定。Window直下に一時追加されるHelpBubble/HelpInfo(初回ユーザー向け一度きりのヘルプポップアップ、autosportlabs/help/helpmanager.py)と判明し、ScreenManager current Screen境界線仮説を補強する3例目の実例となった（第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
2026-08-13 Phase4-4-2追記: 動的ウィジェット生成+位置別glReadPixels検証(test28-33)により境界線仮説を精緻化。Window直下は常に正常描画、RelativeLayoutサブツリー内はウィジェット種別を問わず(ScreenManagerでなくとも)追加前から一貫して透過と判明。連続強制再描画で不安定な部分的描画成功も観測し、第9回セッションの根本原因説を別手法で裏付けた可能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
2026-08-13 Phase4-4-2追記: 実際のNavigationDrawerの開閉操作(test34)により、アニメーション中(継続再描画)だけコンテンツが見え静止状態(開いた後含む)では透過に戻ることを確認。第9回セッションで実証済みの「再描画スキップ+バッファ非保持」根本原因説を独立した手法で裏付け、今回セッションの全観測を説明する統一理論に到達（第21回セッション、ユーザー不在の自律調査）
2026-08-13 Phase4-4-2追記: 実用ワークアラウンド案(Clock.schedule_intervalによる毎フレームask_update())をdash画面に適用したが本物のコンテンツは出現せず、第9回セッションの「同種ワークアラウンドは効果なし」という記録と一致する結果に。ask_update()単体では不十分と判明し、次回はより強い強制再描画トリガーの検討が必要（第21回セッション、ユーザー不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
2026-08-14 Phase4-4-2追記: 強制再描画ワークアラウンド3種(実プロパティ値の継続変化・Kivy純正Animation・毎フレームask_update())すべて効果なしと確定しこの方向性をクローズ。自作LD_PRELOADによるGL描画コール数直接計測は手法的欠陥によりサニティチェックで無効と判明し撤回、今後はapitrace使用を推奨。/tmpがtmpfsで再起動により消える点も再確認（第22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
2026-08-14 Phase4-4-2追記: apitraceによる正確な再計測で、「Kivyがidle時に再描画コールをスキップする」という第9回セッション以来の統一理論の一部が誤りだったと確定。dash画面のidle50秒間、384フレーム全てでglDrawElementsが295〜434回/フレーム(安定後396回)発行され続けていることを確認。正常表示されるWindow直下と透過するScreenManag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
2026-08-14 Phase4-4-2追記: Window直下(表示される)とdash画面(透過)のdraw callを同一apitraceトレースで直接比較したがGL引数レベルでは差を発見できず。一方、確実に表示され続ける静的マーカーウィジェットの描画コールが全844スワップ中421回(約50%)しか発行されていないという予期しない観測を得て、バッファ非保持の前提を単純な形では再検証する必要があるかもしれないと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
2026-08-14 Phase4-4-2追記: マーカーウィジェットのdraw call発行頻度「約50%」を独立した2回目の実験で再検証し、421/844(49.88%)→379/760(49.87%)とほぼ完全に一致する数字で再現、決定論的な現象と確定。「eglSwapBuffers呼び出し回数が実際の描画更新頻度の2倍(2回に1回はno-opスワップ)」という新仮説を提示し、次回はDRM debugfsとの突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
2026-08-14 Phase4-4-2追記: 「eglSwapBuffersが実描画更新頻度の2倍」という自らの新仮説をDRM debugfs直接検証で否定(348スワップ全てで3枚のバッファが一切乱れず規則正しくローテーション)。マーカーの描画コール数とVBOバインド回数が完全一致することも確認し「約50%」が計測アーティファクトでないことも再確認。規則正しいバッファローテーション・間欠的な描画コール・安定した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
2026-08-14 Phase4-4-2訂正: 直前3コミットで報告した「マーカー描画頻度約50%」は、apitrace dump --grepの出力をwc -lで集計した際の自分自身のバグ(絞り込み後は空行とマッチ行が1:1で並ぶため実数の2倍になる)による誤りと判明し撤回。正しくはgrep -cで集計すべきで、実際は421/422(99.76%)・379/380(99.74%)とほぼ毎フレーム発行されていた。D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
2026-08-14 Phase4-4-2追記: eglretrace -Dでマーカー(表示される)とdash画面content(透過)の完全なGLステートJSONを比較したが有意差を発見できず。両者とも頂点データは妥当な画面内座標で構造的に健全。GLステートレベルでは表示/透過を区別する手がかりが見つからないことを確認（第22回セッション、1時間延長分の続き）
2026-08-14 Phase4-4-2追記: Mesaダウングレード検証（第21回から持ち越しの最優先候補）を実施したが症状に変化なし。libegl-mesa0等をDebian標準版25.0.7-2+deb13u1へ一時的にダウングレードしユーザーが実機で目視確認したが、dash画面のメーター・ゲージ類が表示されない挙動は変わらず、Mesaバージョンが根本原因という仮説を明確に否定。検証後は元のバックポート版26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
2026-08-14 Phase4-4-2追記: swap番号→fb id突き合わせ実験は技術的な壁（apitrace併用時のセグフォルト・フック不発火）にぶつかり撤退。代わりに着手したKMS/DRMバッファ確保方式・SDL2/EGL初期化オプションのread-only調査では、スキャンアウトfbのDRMフォーマット修飾子がVC4標準のT_TILED（異常なし）、ドライバに部分再描画(damage rect)系EGL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
2026-08-14 Phase4-4-2追記: eglSwapBuffersフックの正しい実装方式（dlsym/eglGetProcAddressオーバーライド）を確立し、dlvsymバージョン文字列のglibc依存問題も解決。一方でapitrace計測時(約8Hz継続)と素の実行(スワップほぼ停止)でスワップ頻度が矛盾する新たな謎に遭遇し、当初目的のステンシルバッファ実内容確認は未達（第24回セッション、ユーザー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
2026-08-14 Phase4-4-2追記: スワップ停止現象が同一手順の再試行でも再現したりしなかったりする非決定的な現象であることを実測で確定し、前回の「apitrace有無で挙動が違う」という前提を反証（第25回セッション、ユーザー不在の自律調査）
2026-08-14 ケーシング設計検討: I/Oパネル固定方式（同軸締結の見送り、リブ位置決め+共締め構成）を追記
2026-08-14 Phase4-4-2追記: real_glReadPixelsがNULLになる原因（eglGetProcAddress経由での解決が必要）を特定・修正し、9セッション以上未解決だったステンシルバッファ実値を確定。対象領域は591回のスワップを通じ一貫してステンシル値0・GL_STENCIL_REF=255で不一致（第26回セッション、ユーザー不在の自律調査）
2026-08-14 Phase4-4-2追記: 第26回セッションの「ステンシル値0・GL_STENCIL_REF=255で不一致」という結論が測定タイミングの欠陥（スワップ時点＝popステンシル操作の後）による誤りだったと判明・撤回し、GL_EQUALテスト実行直前の正しいタイミングで再測定した結果、対象領域全体でステンシルテストが一貫してパスしていることを確定。9セッション以上の主軸だった「ステンシル値不一致」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
2026-08-14 Phase4-4-2追記: 9セッション以上の中心的な謎だった黒画面（透過）問題の根本原因を確定し、有効なワークアラウンドを実証。真犯人はMesa VC4ドライバのglClear()バグで、GL_COLOR_BUFFER_BITを含まない部分マスク（ステンシルのみ等）のクリア要求が、要求されていない色バッファまで巻き込んで強制的にゼロクリアしてしまうというもの（クリア色設定は無関係、シザーテスト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
2026-08-14 Phase4-4-2追記: 前回確立したワークアラウンド（glClearマスクへのGL_COLOR_BUFFER_BIT明示追加）を約100秒間・250フレーム超の連続運用で追加検証。eglSwapBuffersの完全停止は起動直後の正常な準備期間を除き発生せず、対象領域には背景色だけでなく動的な前景コンテンツ（第26回セッション既知の「15px」シグネチャと一致）も継続的に描画され続けているこ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
    Claude-Session: https://c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
2026-08-14 Phase4-4-2追記: 本番適用検討用に、診断ログ・glReadPixels処理を一切含まない最小構成のクリーン版ワークアラウンド(racecapture_glclear_fix.c)を作成。glClear/glClearColorの2関数のみをフックする軽量実装で、コンパイル確認・約24秒間のスモークテスト（クラッシュ・watchdog再起動ループなし）まで実施。run_racecaptu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
    Claude-Session: https://claude.ai/code/session_019dJNb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
2026-08-14 Phase4-4-2追記: Mesa VC4ドライバの公式ドキュメント・issue検索により、今回発見したglClear部分マスクバグが既知の報告済み問題かを確認。公式ドキュメントにVC4のタイルバッファ高速クリアパスの存在自体は裏付けが取れた（発生機序の推測と整合）が、ピンポイントな既存バグ報告は見つからず、未報告の新規バグである可能性が高いと判明。次回以降Mesa GitLabへの正式なバグ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
    Claude-Sessio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
2026-08-14 logger_v1.net受領を反映: メインロガー基板の回路設計を確定・要確認事項として整理
    友人から届いたメインロガー基板の回路図(logger_v1.net)をネットリスト解析し、
    ユーザー確認を経てARCHITECTURE.md/hardware_interface_spec.mdへ反映。
    確定事項: GNSS=Teseo-LIV3FL、IMU=BNO055(9軸/UART)、外部CAN=MCP25625T-E/SS、
    メインマイコンはWROOM-1モジュール直付け、SDソケット=Molex 47219-2001、
    外部CAN電源は3.3Vから5Vへ変更、表示器USBはType-Bから2Cへ変更。
    要確認事項: 車載CAN側に終端抵抗が実装されていた件(方針を友人へ伝え損ねていた)、
    USB PDネゴシエ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
2026-08-14 回路担当への確認資料を追加: OBD2（車載CAN）終端抵抗の仕様確認
    logger_v1.netで車載CAN側にR41=120Ω終端抵抗の実装が確認されたが、
    本来の方針（車載CANは終端抵抗なし）を友人へ伝え損ねていたため、
    現状の実装内容と本来の仕様、確認したい点をまとめたcan_termination_check.mdを作成。
2026-08-14 DC-9-1調査: 配信用/走行中表示用ダッシュの分離可否を検討、race_capture 2インスタンス同時起動をDC-9-1-bとして最優先タスク化
    ROCK 5Bは3系統独立ディスプレイ出力に対応しハードウェア的には分離可能と判明したが、
    video-streamerが画面キャプチャ方式であることと組み合わせると2インスタンス同時起動が
    構造的に必須と判明。Kivyのマルチウィンドウ制約とワークアラウンド、race_captureソース
    コードが現在GitHub上で非公開という新発見、ESP32実機へのシリアル接続競合リスクという
    新たな最大の懸念を調査・記録した。GPU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
2026-08-14 can_termination_check.mdのトーン調整: 謝罪表現を削除し経緯を追記
    友人への確認資料として不自然だった謝罪の言い回しを削除。
    両CANポートを共通仕様にしてソフトウェア側で挙動を切り替える案を
    提案したのがユーザー自身だったという経緯を、120Ω終端抵抗が
    両ポートに実装された背景として追記。
2026-08-14 can_termination_check.mdのトーン再調整: 話し言葉を排除し技術文書として統一
    前回の修正で口語的な語尾（〜だと思う、〜かな等）が入りすぎていたため、
    経緯説明を含め文体を「です・ます」調の技術文書として統一。
2026-08-14 can_termination_check.mdを「である」調に統一
    技術文書として「です・ます」調より常体の方が適切とのフィードバックを受け、
    文体を「である」調へ変更。
2026-08-14 DC-9-1調査を訂正: race_captureソースはreference/RaceCapture_Appに既存クローン済みと判明、実装からシリアル接続競合を裏付け
    前回コミットで「race_captureのソースは非公開」と誤って記録していたが、実際は
    reference/RaceCapture_App（ryandohertyフォーク、git submodule）としてこのリポジトリに
    既にクローン済みだった。GitHub API調査をautosportlabs組織内に限定しローカルの
    reference/ディレクトリを見落としていたのが原因。実際にソースを読んだ結果、
    SerialConnection.open()がpyserialの素朴なserial.Serial()呼び出しのみでOSレベル
    排他ロックが一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
2026-08-14 DC-9-1追加調査: socat単純複製案を訂正しgpsd型fan-outブリッジ方式へ、CPU/GPU負荷実測とEliteDesk先行検証をDC-9-1-c/dとして新規タスク化
    socatの標準的なポート複製は「1ソースを複数購読者で奪い合う」形になり、シリアル直結と
    同じデータ分断問題が起きると判明したため訂正。gpsdと同じfan-out方式（専用ブリッジ
    プロセスが実機を唯一読み取り、複数の仮想ポートへ複製書き込み）を正しい設計方針として
    記録した。また、ROCK 5Bのスペックで2インスタンス同時稼働の余力があるかという新論点
    （Mali G610での複数プロセス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
2026-08-14 車載CAN終端抵抗の件を解決済みへ更新: ハンダジャンパー方式に決定
    友人との協議の結果、車載CAN側の終端抵抗はハンダジャンパーで
    後から切り替え可能な方式にすることで決着。ARCHITECTURE.md
    （4章・6章・7章）とhardware_interface_spec.md（1章#2・3章-1）を
    解決済みとして更新し、役割を終えたcan_termination_check.mdは
    archive/へ移動。
2026-08-14 USB PDネゴシエーション仕様を解決済みへ更新: 12V-1.5A→5V→3.3Vの2段降圧構成
    友人との会話で、USB Type-C電源入力は12V-1.5A(18W)にネゴシエーションし、
    DCDCコンバータで5V、三端子レギュレータで3.3Vを生成してESP32電源とする
    構成と判明。外部CAN用5V系統もこの経路から分岐するため、後付け
    アクセサリー類の電力にも余裕があることを確認。ARCHITECTURE.md
    （4章・6章・7章）とhardware_interface_spec.md（1章#4・3章-13）を更新。
2026-08-14 クランキング対策の要否が対象車両により異なることを反映
    エコマイレッジチャレンジ車両はエンジン駆動用バッテリーとロギング
    システム用バッテリーが分離される設計のため、クランキング時の
    電圧ドロップ対策は不要と判明。一方、先行検証用のロードスターは
    通常の1バッテリー車両電源系統のため対策が必要。ARCHITECTURE.md
    7章（ブラウンアウト耐性・GNSS電源断耐性の2項目）とhardware_interface_spec.md
    3章-11を、対象車両ごとに条件が異なる旨を明記する形に更新。
2026-08-14 車両側の給電構成を確定、USB PD表記をQCへ訂正
    友人との会話で以下が判明・決定:
    - ロガー基板の電源ネゴシエーション規格はPDではなくQC(Quick Charge)だった
    （ARCHITECTURE.md 4章・hardware_interface_spec.md 1章#4/3章-13の誤記を訂正）
    - ロードスター: シガーソケット充電器でモバイルバッテリーを充電し、
    毎回着脱する運用でロガー・ROCK5Bへ給電。モバイルバッテリーが
    クランキング時の電圧ドロップの緩衝材となるため、専用の保持回路は不要
    - エコマイレッジチャレンジ車両: バッテリー分離のためモバイルバッテリー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
2026-08-14 Phase4-4-2追記: ユーザー立ち会いのもとglClearワークアラウンドの視覚確認を実施。サイドバー(ナビゲーションドロワー)は正常描画を回復した一方、DASHBOARD/SYSTEM STATUS等のメインコンテンツ領域は依然として完全に黒いままと判明。GLコールレベルの主要な原因候補(stencil・colorMask・clear・頂点数・色uniform・viewport・FBOバ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
2026-08-14 Phase4-4-2追記: 公式Wiki確認により、今回のRaspberry Pi環境(Debian 13 trixie・一般HDMIモニタ)が公式サポート範囲(Debian 12 bookworm 64bit・純正タッチパネルまたはAR1100対応ディスプレイ)から外れていた可能性が判明。次回はGLレベルの深掘りより先に、Pi 3Bをbookworm 64bitでクリーン再インストールし公式手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
    Claude-Session: https://claude.ai/code/session_019dJNb1x9oD8WPcT7r2XW1Y
2026-08-14 Phase4-4-2追記: bookworm 64bitクリーン再インストールを実施した結果、第29回セッションの「OS世代(trixie)が根本原因」仮説を否定。一方でGPUリセットの独立要因(vc4-fkms-v3dの非同期フリップ非対応・既知バグ修正未適用によるCMA枯渇・過大解像度)を新たに発見・解消し、本丸のメインコンテンツ非描画バグ以外のノイズ要因を取り除いたクリーンな環境を確立(第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
2026-08-14 Phase4-4-2追記: クリーン再インストールで消失したdlsymフック方式の調査ツールを再構築し、GLコールレベルの主要仮説（無効プログラム描画・MVP行列退化・GLエラー・viewport/blend/scissor異常・オフスクリーンFBO誤描画）を網羅的に検証していずれも否定。既知のglClear部分マスクバグ修正を再適用し、背景色/トーストは正常化するがメインコンテンツは依然一切描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
    Claude-Session: https://claude.ai/code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
2026-08-14 Phase4-4-2追記: apitraceのトレース書き出し失敗（第27-28回セッションから持ち越し）をTRACE_FILE環境変数の明示指定で解消し、477フレームの完全なトレースを取得。テクスチャパラメータ・opacity uniform・colorMaskと描画のインターリーブ順序を新たに検証しいずれも正常と確認、独自インタポーザの全結論を独立にクロスチェックした（第31回セッション続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
2026-08-14 Phase4-4-2追記: 最小構成の再現アプリ(標準Kivy、ScrollView+多数の半透明角丸矩形)が実機・同一Mesa VC4ドライバ上で完璧に正常描画されることを確認し、「Mesa VC4ドライバのタイラー固有バグ」という直前セッションの最有力仮説を覆した。原因はRaceCaptureがバンドルするKivy/KivyMD/SDL2の特定バージョン構成、またはアプリ自身のコードに絞り込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
    Claude-Session: https://claude.ai/code/sessi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
2026-08-14 Phase4-4-2追記: RaceCaptureがバンドルする正確なバージョン(Kivy 2.3.1・KivyMD 1.0.2)でも最小構成再現アプリが完璧に正常描画されることを確認し、Kivy/KivyMDバージョン自体も原因候補から除外。原因はバンドルSDL2固有の問題・PyInstaller凍結実行環境・RaceCapture自身のDashboardViewコード内容の3つに絞り込まれ、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
2026-08-15 Phase4-4-2追記: 稼働中の実race_captureプロセスへ任意コードを注入する機構を確立し、ウィジェットツリーの階層ごとの比較実験でこれまでで最も精密な描画境界線を特定（app.root/RelativeLayout直下は正常、その子BoxLayout=ScreenManager+ToolbarViewを包む特定インスタンス配下だけが非描画）。バンドル版同等のKivy/KivyMD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
2026-08-15 Phase4-4-2追記: 稼働中の実race_captureプロセスでScreenManagerをBoxLayoutからRelativeLayout直下へその場で移し替えたところメインコンテンツが完璧に正常表示され、29セッション以上探し続けてきたバグへの初めての実動ワークアラウンドを確認。BoxLayoutクラス自体や特定インスタンスの汚染ではなく実プロセスの蓄積された実行時状態が原因と切り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
    Claude-Session: https://claude.ai/code/session_019dJNb1x9oD8WPcT7r2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
2026-08-15 Phase4-4-2追記: AppMainFrameの実ソース(main.pyc埋め込みKV文字列)を特定しELFバイナリの安全な書き換えパイプラインを構築、静的トポロジー変更だけでは直らないという重要な訂正結果を確認
    第31回セッション最終盤で有力視されていた「ScreenManagerをBoxLayout経由ではなくRelativeLayout直下へ静的に配置する恒久修正」を実際にパッチ・実機検証したところ、メインコンテンツは描画されないことが判明した。一方、稼働中プロセスへの動的なremove_widget→add_widgetワークアラウンドは無改造バイナリで独立に再現できたが、size_hint=(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
2026-08-15 Phase4-4-2追記: 「一時的な救済」がアプリ生涯で最初の1回のみ有効という制約を確定、ScreenManager対ToolbarViewの二択構図を否定しRelativeLayout限定の統一仮説に到達（第33回セッション）
2026-08-15 Phase4-4-2追記: Carouselの内部API迂回による再救済の試みが失敗し既存の救済状態も破壊することを確認、GLリソース生成(テクスチャ/FBO/レンダーバッファ)フックでも相関なしと判明し、次回はKivy canvas命令グラフ構築ロジックの読解へ方針転換（第33回セッション追記）
2026-08-15 Phase4-4-2追記: switchMainView後のScreenManager+Carousel連続操作で1度だけチャンネル一覧が完璧に描画される事象を観測したが再現性なしと確認、非決定的アノマリーとして記録（第33回セッション最終）
2026-08-15 Phase4-4-2追記: Kivy本家ソース(instructions.pyx/context.pyx)を調査し、_need_reset_glゲート機構の存在を確認したがタイミング不一致で直接原因ではないと判断、get_context().reload()はインラインテクスチャで例外発生し実用不可と判明（第33回セッション最終）
2026-08-15 Phase4-4-2追記: ユーザーによる実機モニター目視確認でHome画面・DASHBOARD枠・歯車アイコンの表示を独立に確認、Raw Dataモードで「枠は出るが数値は出ない」という新しい症状パターンを記録（第33回セッション、ユーザー確認分）
2026-08-15 Phase1-8完了: taskBのCPU占有バグとコンソール/RCPプロトコルのUSBチャンネル共有を修正、公式RaceCaptureアプリのDataBusPump._sample_thread生存確認バグ(既存Thread参照の存在チェックのみ)を特定しClock.schedule_intervalによる恒久ワークアラウンドを確立
    Piダッシュボード実運用中の「Raw Dataの枠は出るが数値が出ない」症状を調査。ファームウェア側の2件の改善(taskBビジーループ、コンソール分離)は実施したが本質的な原因ではなく、公式アプリ自体のスレッド再起動ロジックのバグ(1-4-6で既知だった問題の再発見、今回はソースレベ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
2026-08-15 Phase4-4-2追記: Raw Dataの数値非表示は描画バグでなくPhase1-8のRCPサンプルスレッドバグが原因と判明しクローズ、RelativeLayoutのPushMatrix/Translate/PopMatrixの出典をkivy/data/style.kvと特定（GPU側タイミングへ焦点を絞り込み）
2026-08-15 Phase4-4-2追記: 「アプリ生涯で最初の1回だけ」という理解を覆す決定的進展、ScreenManager移動後60-90秒完全放置で自然に正常描画されることをユーザー立ち会いのもと2回独立に実機目視確認（第34回セッション）
    settling期間中の割り込み操作(canvas非依存のPython処理含む)が復旧不能な黒画面化を引き起こすことも確認。ToolbarView/NavigationDrawerは引き続き未解決。次回はapitraceでsettling期間中のGL挙動を直接観察する方針。
2026-08-15 Phase4-4-2追記: ScreenManager救済成功後にToolbarViewを移動すると60-90秒放置しても回復しないことを確定、settlingは「悪影響を打ち消す猶予期間」ではなく「一過性の再構築完了までの時間」と理解を修正（第35回セッション）
2026-08-15 Phase4-4-2追記: 逆順(ToolbarView先行→settling→ScreenManager後→settling)でも共存不可と確定、ToolbarViewはsettling不要でScreenManagerだけが脆弱という非対称性を発見、ScreenManagerのみ救済する恒久修正へ方針転換（第35回セッション続き）
2026-08-15 Phase4-4-2完了: ScreenManagerを自動救済する恒久修正(scmove_persist.so)を実装しrun_racecapture_rpi.shへ本番組み込み、外部操作なしで起動30秒後に自動的にメインコンテンツが正しく描画されることを確認（第35回セッション完結）
2026-08-15 Phase4-4-2見出し更新: 第29回セッション時点で止まっていたステータス表記を更新、恒久修正完了・残作業は軽微である旨を明記
2026-08-15 Phase4-4-2追記: 画面遷移で恒久修正が再度壊れる重大な制約を発見・即日で恒久修正、通常のナビゲーション操作が永続的に使えるように（第36回セッション）
    switchMainView()が呼ばれてScreenManager.currentが変化するたびにscmove_persist.soの初回救済トリックを自動再適用するようbindを追加し、本番のscmove_persist.soを差し替えて実機で複数回の画面遷移が正しく描画されることを確認した。
2026-08-15 Phase4-4-2追記: ToolbarViewをcanvas.after重ね描きでScreenManagerと共存させる手法を発見・実機実証、Home画面では機能するがDashboard画面では未解決と判明（第37回セッション）
    export_as_image()によるFBOスナップショットをsm.canvas.afterへadd_widgetなしで描き足すことで、これまで29セッション悩まされてきた「最後に触った方が勝つ」競合を回避できることを発見。Home画面では画面遷移を挟んでも確実に機能するが、Carousel/Scatter系ウィジェットを含むDashboard画面では原因不明のまま再現しなかった。本番環境は無変更（第36回セッション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
2026-08-15 Phase4-4-2追記: analysis画面でも同じ重ね描き失敗を確認、Carousel/Scatter原因説の優先度を下げ「home画面だけが特別」という仮説に整理（第37回セッション追加検証15分枠）
2026-08-15 Phase4-4-2追記: 再追加の試み自体は無関係で、sm rehealという操作自体がcanvas.after内容を破壊すると確定（反証実験、第37回セッション追加検証2回目15分枠）
2026-08-15 Phase4-4-2追記: relative_layout.canvas.afterでもhome起点なら巻き添え破壊されると確認、原因はcanvas操作対象ではなくsm.currentの値そのものにあると絞り込み（第37回セッション追加検証3回目15分枠）
2026-08-15 Phase4-4-2追記: canvas.after破壊の犯人は自作のrehealではなくKivy標準のScreenManager画面遷移機構自体と確定、NoTransition化という新たな次善候補も追加（第37回セッション追加検証4回目15分枠）
2026-08-15 Phase4-4-2追記: NoTransition化を検証したが効果なしと確認、canvas.after内の謎のStencil/Rectangle構造はTransition機構ではなくScreenManagerのより基本的な仕組みに由来すると判明（第37回セッション追加検証5回目15分枠）
2026-08-15 Phase4-4-2追記: Kivy/KivyMDのScreenManagerソースコードを精読しStencil構造の出所を捜索したが標準コード内には見つからず、home/dash共通の背景要素と判明、原因はRaceCapture独自コード側にあると絞り込み（第37回セッション追加検証6回目15分枠）
2026-08-15 Phase4-4-2追記: build_X_view実装比較でRaceCapture独自コードにもhome特別扱いなしと確認、「TransitionBaseを一度も経由していない画面だけが安全」という統一仮説に到達（第37回セッション追加検証7回目15分枠）
2026-08-15 Phase4-4-2追記: KV静的プロパティでcurrent='dash'を指定するバイトコードパッチを試みたがアプリがハングし検証不能と判明、真の検証にはbuild()/on_start()へのバイトコード命令挿入が必要と再確認（第37回セッション追加検証8回目15分枠）
2026-08-15 Phase4-4-2追記: dash起点でセットアップしても同じく失敗すると確認し「セットアップ時のcurrent画面が安全になる」仮説を完全反証、原因はHomePageView固有のコンテンツ単純さにある可能性が再浮上（第37回セッション追加検証9回目15分枠）
2026-08-15 Phase4-4-2追記: startup_screen設定でdashを真の起動画面にして検証したが失敗、home自身も起動時は同じ_show_main_view/TransitionBase経路を通ると判明し、原因はHomePageView固有のコンテンツにあると確定的に絞り込み（第37回セッション追加検証10回目15分枠）
2026-08-15 Phase4-4-2追記: homeにCarouselを動的追加してもツールバー・既存コンテンツ・新規Carousel全て生存すると確認、Carousel/Scatter原因説を完全否定、危険なのはScreenManager.current変更のみと再確認（第37回セッション追加検証11回目15分枠）
2026-08-15 Phase4-4-2追記: 画面遷移でScreenが完全にScreenManagerから切り離される(real_remove_widget)ことを確認しrehealと同種の操作と裏付け、dashのcanvas.beforeにhomeには無いテクスチャ背景(Color/BindTexture/Rectangle)を発見（第37回セッション追加検証12回目15分枠）
2026-08-15 Phase4-4-2追記: homeにテクスチャ背景を追加してdash往復させても安全であり続けると確認しテクスチャ背景仮説も否定、構造的仮説をほぼ全て潰し次はhomeインスタンス固有かクラス由来かを切り分ける段階へ（第37回セッション追加検証13回目15分枠）
2026-08-16 ステータスLEDの参照元をRaceCapture/Pro MK3に決定
    公式RaceCapture-Pro_firmwareの4世代(MK2/MK3/RCT/RCT MK2)のLED仕様を
    調査した結果、MK3のみが7種のLED enumと物理LEDが完全に1対1対応しており
    最も網羅的なテンプレートと判断。hardware_interface_spec.md 3章-8を更新。
2026-08-16 ステータスLEDのMK3参照方針をARCHITECTURE.mdへも反映
    hardware_interface_spec.mdには既に記載済みだったMK3参照の決定を、
    ARCHITECTURE.md 4章の未検討マークから解決済みへ更新し、
    ユーザー最終確認済みである旨を明記。
2026-08-16 GNSSアンテナのアクティブ/パッシブ方式が未確認と判明、要確認事項に追加
    logger_v1.net確認の結果、Teseo-LIV3FL(U12)のVCC_RF(アンテナ電源出力
    ピン)が未接続で、バイアスT回路も見当たらないことが判明。アクティブ
    アンテナへの給電経路が現状無いため、パッシブ前提かこの部分が未実装
    なのか要確認。1章#6の古い記述(u-bloxモジュール前提)も併せて更新。
2026-08-16 GNSSアンテナはアクティブ/パッシブ切り替え可能回路を目指す方針を反映
    現状のlogger_v1.netはパッシブアンテナ仕様だが、友人との協議で将来的な
    アクティブアンテナ対応も見据えた切り替え可能回路を目指す方針に決定。
    設計難度が高く1回のPCB発注で完動する保証がないため、1〜2回の修正を
    前提に進める。PCB発注〜到着に1〜2週間かかり試行回数が制約される点を
    プロジェクト全体のスケジュール制約として明記。
2026-08-16 グラウンドループの経路分析とIMU/磁力計の実装論点を反映
    logger_v1.net確認により、車載CAN(J6)・外部CAN(J4)ともpin4が基板の
    共通GNDへ直結されていることを確認。ロガー〜ROCK5B〜アクセサリー系統
    はUSB充電器起点で閉じているが、車載CAN経由のグラウンド接続が唯一の
    外部接点であり、そこでの電位差由来のループを懸念点として整理。
    対策の選択肢(直結/フェライトビーズ/ガルバニック絶縁)も明記。
    IMU実装方式(基板直付け vs モジュール化)の判断材料と、磁力計への
    アルミシールドの影響(静磁場には効果薄、大電流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
2026-08-16 logger_v1.net(メインロガー基板の回路図データ)をリポジトリへ保存
    友人lintarohから2026-08-14に受領したメインロガー基板の初回設計案
    ネットリストを circuit/logger_v1/ へ保存。後から参照できるよう、
    受領日・ファイル情報・このファイルを受けて確認/決定した内容の要約を
    README.mdとしてまとめた。個別の詳細はARCHITECTURE.md 4章・
    hardware_interface_spec.mdを一次情報源として引き続き参照する。
2026-08-16 GNSSモジュールをMAX-M10M-00Bへ変更確定、関連ドキュメントを更新
    Teseo-LIV3FLはハード上限10Hzのため、単一GNSS構成で18〜25Hz対応の
    u-blox MAX-M10M-00Bへ変更。設定永続化用Flashが無い点はトレードオフ
    として明記し、友人への回路図修正依頼をhardware_interface_spec.md
    3章-15に追加。
2026-08-16 GNSSバックアップ電源は非搭載と決定、電源ON/OFFをログ開始/終了トリガーとする方針を反映
    コイン電池等によるV_BCKPバックアップは追加せず、電源投入＝ログ開始という
    単純な操作に統一することでログ開始し忘れのリスクを減らす方針とした。
    GNSS設定はESP32起動時に毎回再送信する運用で対応する。
2026-08-16 logger_v1.net改訂版(2026-08-16受領)をリポジトリへ保存、レビュー結果をREADMEに記録
    GNSSモジュール(MAX-M10M-00B)・バックアップ電池撤去・アンテナ切替回路は既存決定と整合。
    外部/車載CANコネクタのJST VH→Molex Micro-Fit変更、保護ヒューズF1/F2の削除、
    CANトランシーバIC変更、USB Type-C CC検出方式の刷新、3.3Vレギュレータ変更など
    未反映の変更点は友人への確認事項としてREADME.mdに整理した。
2026-08-17 DC-9-1追加調査: EliteDesk実機でマルチディスプレイ・2インスタンス同時起動・fan-outブリッジを検証
    DC-9-1-a: DP-1+DP-3の拡張デスクトップ動作を実機確認、DC-2の信号消失問題は再現せず。
    DC-9-1-b: Kivy config.iniの位置指定はratpoisonのタイル配置に無視され失敗。配信用インスタンスは
    Xvfb等のヘッドレス仮想ディスプレイで動かす方針に転換(video-streamerは画面キャプチャ方式のため
    物理モニター不要)。
    DC-9-1-c: 読み取り専用fan-outブリッジのプロトタイプ(serial_fanout_bridge.py)を実装・実機検証したが
    0バイトしか受信できず失敗。RCP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
2026-08-17 DC-9-1-b方針を再訂正: Xvfb+VNCからダミーHDMIプラグ+出力ごとに別Xサーバー方式へ
    Xvfb+x11vnc案は「レイアウト設定にディスプレイ接続が必要では」との指摘と、ROCK 5B本番機が
    Wi-Fi/Bluetooth非搭載(追加購入要)という制約により本番運用に不向きと判明したため撤回。
    最終方針: 走行中表示用=実出力+Xサーバー#1、配信用=別出力+Xサーバー#2という出力ごとに別
    Xサーバーの構成にし、配信用側は普段ダミーHDMIプラグ(EDID偽装)で常時レンダリングさせ続ける。
    レイアウト編集時はポータブルディスプレイに差し替えるだけで再起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
2026-08-17 DC-9-1: 1プロセス化案の不採用理由を記録、次回EliteDesk作業手順を明記
    race_captureを1プロセスにまとめて表示だけ分割する案は、Kivyの1プロセス=1ウィンドウ制約に
    より不採用。PythonのGIL制約下では2プロセス+taskset別コア固定の方がRK3588のようなマルチ
    コアARMチップには適するという整理も記録。
    次回セッションの作業手順(DRMマスター競合の検証、fan-outブリッジのポーリング代行方式への
    改修)を明記し、迷わず再開できるようにした。
2026-08-17 rc-dash-4B(新規Pi 4B個体)でRaceCapture App起動とESP32-C3実機とのRCP通信を確認、ARCHITECTURE.mdへ記録
2026-08-17 Phase4-4-2打ち切り: rc-dash-4Bで全画面正常描画を確認、本番採用ハードウェアを4Bに決定
2026-08-17 4-4-4を1チャット=1タスク粒度に分解（Piダッシュボード筐体・メインロガー耐衝撃筐体の2系統）
2026-08-17 4-4-4筐体設計の進捗を反映: ロードスター向け試作筐体の方針決定・CANケーブル再選定が必要な点を記録
2026-08-17 Git LFSを導入し*.step/*.stpを追跡対象に設定（メインロガー基板STEPファイル格納の準備）
2026-08-17 Phase4-4-4-3完了: メインロガー基板STEPファイルをGit LFS経由でリポジトリへ格納
2026-08-19 Phase4-4-5前半完了: ROCK 5B(ダッシュカム録画用)へのOS導入・初期セットアップ
    Radxa公式イメージ(Debian 12 bookworm)をmicroSD/eMMC双方に導入し、eMMC起動まで確認。
    専用ユーザー・SSH鍵認証・NOPASSWD sudo・タイムゾーン設定、GPU(Mali-G610/Panfrost)動作確認完了。
    RaceCapture Appインストールと外部カメラ録画検証は次回以降。
    Claude-Session: https://claude.ai/code/session_01XKDRZSsa8k3JsnqUZkPEUf
2026-08-20 Phase4-4-5-6完了: ROCK 5BへRaceCapture App(v2.19.0)をインストールしFBモード自動起動を確立
2026-08-20 Phase4-4-5-7-1完了: ROCK 5BでUSBカメラ・ESP32-C3のデバイス認識とRCP通信を確認
2026-08-20 DC-9-4を1チャット=1タスク粒度に分解（画面キャプチャ方式調査を最優先タスクとして分離）
2026-08-20 DC-9-4-1完了: ROCK 5BのFBモード画面キャプチャ方式をffmpeg kmsgrabに選定
    race_captureのFBモード描画(1280x800)をDRM_PRIMEフレームとしてゼロコピー
    取得できることを実機検証で確認。Writeback connector/fbdev読み出し/
    race_capture本体改造は比較検討の上不採用とした。
2026-08-20 DC-9-4-2完了: ROCK 5BでRKMPPハードウェアエンコーダ単体の動作確認
    ffmpeg-rockchipをソースビルドし、h264_rkmpp/hevc_rkmppともtestsrcから
    リアルタイム12倍速でのエンコードを実証。エンコード側は非root権限で
    動作し、root必須のkmsgrab(キャプチャ側)との非対称性が判明。
2026-08-20 DC-9-4-3完了: ROCK 5Bでキャプチャ→RKMPPエンコード→mp4保存の最小パイプライン実証
    kmsgrabのdrm_primeフレームをフィルタなしでh264_rkmppエンコーダへ
    ゼロコピー接続し、稼働中のrace_capture画面が実際にmp4として
    録画されることを確認した。
2026-08-20 DC-9-4-4完了: ROCK 5Bで録画パイプラインをrace_capture起動フローへ統合・常駐化
    dashcam_launch_rock5b.sh/dashcam_record_rock5b.shを新規作成し.bashrcの
    自動ログインフローへ統合。bashのシグナル配送遅延、race_capture本体が
    SIGTERM/SIGINTに無反応、停止時のプロセス孤児化を発見・解消。
    録画ファイルがmoov atom not foundで破損する問題もfragmented mp4への
    切り替えで解消した。
2026-08-20 DC-9-4-5完了・DC-9-4全体完了: ROCK 5Bで実機録画動作を検証
    USBカメラ・ESP32-C3接続、race_captureのRCP通信・ラップ集計と並行して
    約3分20秒の連続録画を実証。ffmpeg(kmsgrab+h264_rkmpp)のCPU負荷は
    1.3%と非常に軽量であることを確認した。DC-9-4-1〜5の全サブタスクが
    完了し、ダッシュカム録画機能の自作が完了した。
2026-08-20 DC-9-1-b・DC-9-1-c完了: ROCK 5Bで2インスタンス分離表示(Zaphod)とRCP fan-outブリッジを実機検証
    - DC-9-1-b: FBモード2インスタンス同時起動でDRMマスター競合を確認、Zaphodモード
    (単一Xorg+ZaphodHeads)で回避できることを実機実証
    - DC-9-1-c: serial_fanout_bridge.pyを全面改修。ブリッジ自体が実機への唯一の
    RCPクライアントとしてポーリング・応答をキャッシュし、各consumerへ配信する設計に変更
2026-08-20 DC-9-1-d完了・DC-9-1全体完了: ROCK 5Bで2インスタンス+エンコード時のCPU/GPU負荷を実測
    Zaphodモード(DC-9-1-b)+fan-outブリッジ(DC-9-1-c)+配信画面のkmsgrab+RKMPP
    エンコードを組み合わせて実機実測。メモリ・CPU・GPUとも余裕あり、最大の懸念
    だったMali G610の2コンテキスト同時描画も問題なし。これにより「配信用ダッシュ」
    「走行中表示用ダッシュ」の分離構想が技術的に実現可能と確定した。
2026-08-21 DC-9-4-5の既知課題を解消: 起動時Welcome画面のまま固定される問題を修正
    実機バイナリ(v2.19.0)がreference/RaceCapture_App submoduleと別コードベース
    (KivyMD採用)であることが判明。設定の実体はpreferences.iniではなく
    ~/.config/racecapture/prefs.json内のgeneral_prefs.preferences.startup_screen
    と特定し、'Dashboard'に固定。reboot検証でダッシュボード直行を確認済み。
2026-08-21 Phase5-8-1完了: ベストラップ統計へtrackId・スタート/フィニッシュ座標を紐付け
    ベストラップNVSデータにtrackId(+sf座標)を併せて保存し、起動時・setTrackCfg
    受信時に現在のTrackCfgと不一致なら破棄するようにした。別トラックへ移動した
    際に前トラックの軌跡と照合し続けPredTimeが無意味な値になる問題への対応。
2026-08-21 Phase5-8-2完了・Phase5-8全体完了: ベストラップ統計のリセット手段をRCPコマンドで実装
    公式ファームウェア(reference/RaceCapture-Pro_firmware)に実在する無ペイロード
    コマンド`resetLapStats`と同名で実装。ただし公式のセッション全体リセットとは
    スコープを変え、本プロジェクトの課題(異常なベストラップの手動クリア)に
    合わせてベストラップ統計のみをリセットする設計とした。
2026-08-21 Phase4-4-5-7-2完了: ROCK 5Bでの録画動作検証の完了を反映（DC-9-4経由で達成済み）
    4-4-5-7-2はDC-9-4-5完了待ちで保留扱いのままだったが、DC-9-4は既に完了
    していたため、このファイル側のチェックボックス・見出しを実態に合わせて更新した。
2026-08-21 Phase6タスク分解: 共通チャンネルテーブル・CANブロードキャスト・Luaスクリプティングを1チャット単位に分解
    外部CAN実機（友人によるメインロガー基板、2026年9月中旬完成予定）待ちの部分は
    TWAIセルフテスト(ループバック)モードでの先行実装・検証にとどめ、実バス確認は
    基板到着後（6-8）とする方針で分解した。
2026-08-21 task_phase6_breakdown.mdを復元: 誤って既存の分解内容を上書きしていたのを修正
    直前のコミット(ad50f7a)で、既に存在していた詳細な分解ファイル（車載/外部CANの
    listen-only方針、TWAIハードウェアフィルタが1系統のみという制約の発見、SD CSV
    スキーマ乖離問題等、過去のセッションで確定済みの内容を含む）を、存在確認をせず
    自分の判断で上書きしてしまっていた。直前コミットの前の内容へ復元する。
2026-08-21 Phase6-1-1・Phase6-5-1完了: 共通チャンネルテーブル設計と車載CAN受信バッファを実装
    6-1-1は共通チャンネルテーブル(ChannelDef)のデータ構造設計のみ(実装は6-1-2以降)。
    6-5-1は車載CAN(内蔵TWAI)の生フレーム受信バッファを実装。ESP-IDFのレガシーTWAI
    ドライバが非推奨化されビルド停止することが判明したため、新ドライバ(esp_twai.h、
    イベントコールバック方式)へ切り替えて対応した。
2026-08-21 Phase6-1-2完了: 既存9チャンネル(LapCount等)を共通チャンネルテーブル方式へ移行
    6-1-1で設計したChannelDef/g_channelTableを実装し、kLapChannels(9ch)をsample関数経由の
    テーブル登録方式へ移行。rcpSendMeta/rcpSendSampleはテーブルを走査する形に変更した。
    kDummyChannels/kImuChannels/kAttitudeChannelsは今回対象外(新旧混在、6-1-1設計通り)。
    esp32-c3-proto/esp32-s3両環境でビルド成功を確認。
2026-08-21 Phase6-4-1完了: 標準Lua本体(ANSI C部分)をfirmwareへ組み込み
    reference/RaceCapture-Pro_firmware/lib/lua/src相当のプラットフォーム非依存部分(コア+
    base/string/table/math/os/debug/bit/loadlib等の標準ライブラリ、計31ソース)をfirmware/lib/lua/へ
    vendoringし、main.cppからのinclude経由でPlatformIOのLDFに拾わせる形で組み込んだ。
    -Werror環境でビルドする過程で、vendoring元に元々あった複数の問題(bit.cのmisleading-indentation、
    fallthroughコメントのGCC非対応、未定義関数modp_itoaXの呼び出し、pow10のpicolibc関数名衝突)を
    発見し、動作を変えない最小修正で解消。VM初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
2026-08-21 Phase6-4-2完了: Lua用メモリアロケータをESP-IDFヒープAPIへ差し替え
    luaEspAlloc()を実装し、heap_caps_realloc/heap_caps_free(MALLOC_CAP_DEFAULT)で
    lauxlib.cの既定実装(標準malloc/free/realloc)を置換した。起動時自己診断
    (VM生成→標準ライブラリオープン→簡単な式の実行→検証→解放)をapp_main()に追加。
    esp32-c3-proto/esp32-s3両環境でビルド成功、Flashサイズ増加でliblua.aの実リンクを確認。
2026-08-21 Phase6-4-3完了・Phase6-4-4部分完了: Luaスクリプト専用FreeRTOSタスクを実装
    専用タスクluaTaskを実装し、既存タスク(taskA/B/C)に影響しないtskIDLE_PRIORITY・
    8192バイトスタックで起動する。起動時にスクリプト本体を一度だけ実行し、以降は
    onTick関数を1Hzで周期呼び出しする公式の実行契約を再現(onTick未定義は非エラー扱い)。
    スクリプト本文は6-6未着手のためハードコードされたダミー。スクリプト書き込み時の
    再実行は6-6でスクリプト書き込みイベントが実装されてから対応する。
    esp32-c3-proto/esp32-s3両環境でビルド成功を確認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
2026-08-24 DC-9-1-b追加検証: ROCK 5Bで2インスタンスのゲージレイアウト分離保存を実機確認
2026-08-24 DC-9-1-b追加調査: 同時2出力での実描画確認は未達、USB接続先決定ロジックが新しい壁と判明
2026-08-24 DC-9-1にサブタスクDC-9-1-eを新設: 2出力同時描画のEnd-to-End確認を独立タスク化
2026-08-24 DC-9-1-e完了: Zaphod2出力+fan-outブリッジ+レイアウト分離のEnd-to-End実機確認、DC-9-1全体完了
    ブロッカーとされていた「実機バイナリの独自USB自動検出」は誤りで、
    真因はテスト用configディレクトリでのprefs.json配置ミスとstraceで特定。
    修正後、ROCK 5B実機でZaphodモード2出力+fan-outブリッジ+別レイアウトの
    2インスタンス同時描画・ESP32接続を実証、本番構成に復元済み。
2026-08-24 DC-9-8を新設: 2画面分離構成(Zaphod+fan-outブリッジ)の本番運用導入を1チャット=1タスク粒度に分解
    DC-9-1(a〜e)は技術検証のみで、本番のdashcam_launch_rock5b.shには未統合だった。
    本番導入作業をDC-9-8-1〜4として切り出す。
2026-08-24 DC-9-8-1完了: 2画面分離構成をdashcam_launch_rock5b.shへ本番統合、実機で起動・録画確認
    Zaphod用xorg.confを新規保存し、launchスクリプトをXorg(Zaphod)+fan-outブリッジ+
    2インスタンス+配信画面のみ録画(plane_id指定)の一気通貫構成に書き換え。
    ESP32はVIDで動的検出、SIGTERM一発での後始末も実機確認済み。
2026-08-24 DC-9-8-1修正: race_captureの--sizeオプションでウィンドウを画面いっぱいに表示
    Zaphod2画面環境ではrace_captureのウィンドウが1024x576固定になり画面中央に
    小さく表示される問題を発見。Kivy標準のfullscreen設定は効かず、race_capture
    独自の--sizeオプションで解決。dashcam_launch_rock5b.shに画面ごとのサイズ
    (HDMI-1=1280x800, HDMI-2=1920x1080)を追加し実機で修正確認済み。
2026-08-28 Phase2-1-2完了: MCP2562FD+ESP32C3のブレッドボード配線をTWAI自己受信セルフテストで検証、firmware/can_selftest新設
    - firmware/can_selftest/: usb_otg_testと同じ分離方式の使い捨て検証プロジェクト。
    TWAI_MODE_NO_ACK + selfフラグの自己受信ループバックを500kbitで実行し、
    車載CAN未接続のまま卓上で配線を検証する。
    - 実機(XIAO ESP32C3, COM5)で5バッチ×20フレーム=100/100一致、TEC=REC=0。
    GPIO割当/TXD-RXD配線/給電/トランシーバ/120Ω終端/500kタイミングすべて正常と実証。
    - 確定結線: TWAI TX=GPIO21(D6)->TXD(1), RX=GPIO20(D7)->RXD(4),
    VDD=5V, VIO=3.3V, VSS/STBY=GND,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
2026-08-28 Phase2-1-1完了: OBDハーネス〜トランシーバ経路をテスタ+Nano受動プローブで検証、firmware/harness_probe_nano新設
    - firmware/harness_probe_nano/: Arduino Nano(受動計測のみ)。A0=OBD6/A1=OBD14/GND=OBD4/5を
    analogReadし、can_selftestの連続送信中にCANH↑/CANL↓の極性をライブ確認する。
    - can_selftest: 自己受信バッチ後に「連続送信(blast)モード」を追加(約4400 msg/s, TEC=REC=0)。
    ハーネスプローブ時にバスを撃ちっぱなしにするため。検証バッチは3回→1回に短縮。
    - 実機確認: レセッシブ両線~2.5V、ドミナントでCANH~4.1V/CANL~1.2V、判定=>OK。
    テスタ導通(6↔CA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
2026-08-28 Phase2-4-1完了: 実車OBD2直結用の生CANリードオンリーロガー firmware/can_logger を新設
    バスへフレームを注入しない3重の安全策:
    1. TWAI_MODE_LISTEN_ONLY で起動(ハードがドミナント/ACK/エラーフレーム/再送を出さない)
    2. TWAIのTX信号は未配線ダミーGPIO10へ割当(トランシーバTXD=GPIO21には出さない)
    3. GPIO21を単純GPIO出力HIGH(レセッシブ)で保持
    起動順序: GPIO21をHIGH固定 -> LISTEN_ONLYでドライバ導入 -> twai_start -> 受信タスク開始。
    送信キュー長0。
    出力: 1フレーム1行 t_us,id_hex,ext,rtr,dlc,data_hex (esp_timer_get_time, us)。
    #始まりは毎秒ステータ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
2026-08-28 Phase2-4-2完了: can_logger出力をPC側で受信・記録するツール can_capture_logger.py を新設
    - t_us,id_hex,ext,rtr,dlc,data_hex 形式と # ステータス行をパースし
    CSV / JSON Lines / status.log へ分離記録
    - 入力は --port(ライブ) / --replay(ダンプ変換) / --selftest(合成データ) の3系統
    - 検証(実車不要): --selftest 全項目PASS、samples/can_logger_sample.txt の
    --replay 変換、実機COM5(CAN未接続)でのライブ # ステータス行の連続記録を確認
    - 実走・停車操作での実データ取得(2-4-3〜2-4-5)は実車必須のため保留
2026-08-28 Phase2-4-3(ツール): 操作前後のCAN差分検出ツール can_diff.py を新設（実データ採取は実車待ちで保留）
    - 2-4-2形式CSVを --base(OFF) と複数 --test(ON) で比較し、CAN IDごとに
    各バイト位置の値集合を突き合わせて STRONG/MEDIUM/WEAK/counter とID出現・消滅を報告
    - ローリングカウンタ(両stateで値種類が多いバイト)は STRONG から除外
    - --selftest 全7項目PASS、2-4-2実CSV形式での手動スモークテストも確認、--json 対応
    - 実車での停車操作ログ採取と実IDの特定(2-4-4)は実車必須のため保留
2026-08-28 Phase2-4-5(ツール): 既知値との相関検証ツール can_correlate.py を新設（実データ相関は実車待ちで保留）
    - --can(2-4-2形式CSV) と --ref(時刻付き基準値列) を入力に、CAN ID×バイト位置×
    幅(1/2)×エンディアンで数値化→ゼロ次ホールドで対応付け→ ref≒a*x+b の R^2 で順位付け
    - CAN側時刻の原点ずれは --time-offset / --auto-lag lo:hi:step の粗探索で吸収
    - 最小二乗は標準ライブラリのみで自前実装
    - --selftest 全項目PASS(合成車速から 0x4B0 のBE u16 を R^2≈1・slope≈0.01 で復元、
    真のラグ -0.3s を auto-lag が選択)、2-4-2実CSV形式での手動スモーク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
2026-08-29 @ Phase2-2-1完了: OBD2ポーラー付きロガー firmware/can_obd_logger を新設
    生CANキャプチャとOBD2 mode 01 PID応答を「同一基板・同一 esp_timer タイムスタンプ」で
    同時取得できるようにした。これにより 2-4-5 の相関検証で必要だった
    can_correlate.py の --time-offset / --auto-lag によるラグ推定が不要になる。
    can_logger の「物理的に送信不能」という監査可能な保証を壊さないため、
    モード追加ではなく別プロジェクトへ分離（can_selftest / harness_probe_nano と同じ方式）。
    完全受動の観測が必要な 2-4-3 の差分検出では引き続き can_logger を使う。
    -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
2026-08-30 エコランマシン向けセンサ要求を反映: 熱電対(EGT/CHT)入力の未対応を相談事項・未解決事項として追加
2026-08-31 logger_v1統合完了: 実装基板用ファームウェア・GNSS25Hz・検証と引継ぎ
2026-08-31 引継ぎ更新完了: ソース保存コミットとWSLからの共有完了を記録
2026-08-31 DC-9-9完了: 実機運用で判明した不具合7件を修正、電源投入だけでの自動起動が本番構成で通しで動作
    「電源を入れてもRaceCaptureが起動しない」の調査を起点に、互いに独立した不具合7件を
    発見・修正した。DC-9-8までの各検証は個別には成功していたが、本番構成でまとめて連続
    運用したのは今回が初めてであり、そこで初めて表面化した種類の問題が中心。
    - ルートパーティション満杯(空き31MB)の解消と再発防止。datastore.sq3×3で3.7GB、
    ~/Videosで2.2GBを占めていた(どちらも保持期間の制御が皆無)。これが「値が来ない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
2026-08-31 DC-9-8-2-1完了: USBカメラ映像をダッシュ画面へ表示し録画へ焼き込む方法を確立
    録画はkmsgrabによるダッシュ画面のキャプチャであり、カメラ映像をffmpegで合成している
    のではない(公式video-streamerがximagesrcを使うのと同じ構造)。したがってカメラをUSBに
    挿しただけでは録画に映像は入らず、ダッシュ画面上に描画されて初めて焼き込まれる。
    - race_capture本体にVideoゲージが正規のゲージ種別として存在することをPyInstaller
    アーカイブの展開で確認。ROCK 5Bはデスクトップ扱いのため本物の実装が読み込まれ、
    モバイル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
2026-09-01 DC-9-8-2-1の負荷に関する記述を実測値へ訂正: カメラのコストを過大に帰属させていた
    前コミットで「Videoゲージ追加により配信用インスタンスのCPUが37.8%->91.3%へ上昇」と
    記載したが、配信用ダッシュには走行中表示用に無いMap View/Scatter Plotも載っており、
    差分をカメラのコストと見なすのは誤りだった。スレッド別に実測し直した結果を反映する。
    - カメラのMJPEGデコード(video_decoderスレッド群)は1コア換算で約11%にとどまる
    - 増分の大半はKivyメインスレッドの描画コスト(19.1%->49.9%)で、カメラのテクスチャ転送に
    加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
2026-09-01 録画を1080p30fps/6Mbpsへ変更し、実機配布ファイルの改行をLFに固定
    ユーザー要望「動画はフルHD 30fpsが欲しい」に対応して録画パイプラインを変更した。
    あわせて、その配備作業中に踏んだCRLF起因の起動不能を恒久対策する。
    - dashcam_record_rock5b.sh: kmsgrabの -framerate 15 -> 30、-b:v 4M -> 6M。
    15fps時点で実測3.5-4.0MbpsとすでにビットレートÜ上限に張り付いていたため、
    フレームレートだけ倍にすると1フレームあたりの画質が落ちる。30fpsは連続フレームの
    相関が高いぶん2倍ではなく約1.5倍で足りる。消費は約2.7GB/時で、既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
2026-09-01 DC-9-8-2-2完了: 描画設定を起動引数へ集約し、GPU性能への疑いを実測で否定
    配信用インスタンスのCPUが高く見えたことからGPU性能を疑ったが、実測の結論は
    「GPUのせいではない」。不要なアンチエイリアスを要求していたことが原因だった。
    - GPU実測: maxfps=60+MSAA 2xではMaliが1000MHz(上限)に張り付き負荷42-80%。
    maxfps=30+MSAAオフではガバナが自ら300-400MHzへ落とし負荷15-44%(仕事量で約1/6)。
    一方で描画レートは45.0->38.6fpsとわずかしか落ちず、どちらも録画の30fpsを上回る。
    削減の大半はフレームレート上限ではなくアンチ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
2026-09-01 DC-9-8-2-3完了: ストレージ書き込みの85%がセッション記録と判明、両インスタンスで無効化
    録画をSDカードへ逃がすべきかの検討中、/proc/diskstatsで起動から17時間に330GB
    (平均5.3MB/s)も書いていることが分かり、プロセス別に分解した。
    - 主犯は録画(ffmpegは592KB/s)ではなくrace_captureのセッション記録(SQLite)だった。
    両方ON=4.97MB/s、両方OFF=0.75MB/s。セッション記録が全書き込みの約85%(4.2MB/s)
    - データストアのファイル自体は8.8KB/sしか増えておらず、書き込み増幅は約380倍
    - 片方だけ止めても総量は減らない(実測ではむしろ悪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
2026-09-01 DC-9-8-2-4完了: 録画先をexFATのSDカードへ分離、再起動テストまで確認
    目的は消耗対策ではなく容量と隔離。録画1.54GB/時に対しeMMCの空きは数GBしかなく3時間弱で
    自動削除が始まること、録画とOSが同一パーティションのため電源断の破損がOSごと巻き込むこと
    の2点による。
    - ファイルシステムはexFATを採用。当初ext4を推したが「取り出しはSSH経由」という誤った
    前提で、実運用は「カードを回収してPCで読む」だったため方針変更。Radxaのカーネルに
    exfat.koが同梱されておりFUSEではなくカーネルドライバで動く
    - ジャ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
2026-09-01 DC-9-8-5完了: 起動条件を「挿さっているメディアで決まる」設計へ変更
    ユーザー提案による方針転換。挿してあるものを見れば何が起きるか分かる物理的で単純な
    モデルにした(市販ドライブレコーダーと同じ考え方)。
    ロガーあり/SDあり -> フル動作
    ロガーあり/SDなし -> ダッシュ+データ表示。録画せず何も溜め込まない
    ロガーなし/SDあり -> ダッシュは出る(No data)+録画あり。後から挿せばつながる
    ロガーなし/SDなし -> ダッシュだけ。何も残さない
    - ロガー必須をやめた。従来はESP32が無いと exit 1 していたため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
2026-09-01 ロガー側SD挙動の整合を確認しARCHITECTURE.mdへ共有事項を追記（新規実装依頼ではない）
    ROCK 5B側でDC-9-8-5「挿さっているメディアで挙動が決まる」設計に統一したため、
    ロガー側の対応要否を firmware/logger_v1 のドキュメントと実装を読んで確認した。
    結論: firmware/logger_v1 は既にこの思想と一致しており、実装の追加は不要。
    - REQUIREMENTS.md の「SD異常＝満杯/未挿入/書込失敗/キュー欠落を可視化、
    自動フォーマット/既存ログ削除禁止、復帰可能」がそのまま該当する
    - src/storage.cpp も未挿入なら sd_ok=false を立てて3秒ごと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
2026-09-01 DC-9-8-6完了: SDカードの安全な取り出しスクリプトを追加
    「動作中に急にSDカードを抜いて大丈夫か」への回答は「大丈夫ではない」。カードはexFATで
    ジャーナルが無く、録画中は実測1.30 MB/sで書き続けているため、ライブで抜くと書き込み中の
    セグメントを失い、ファイルシステムがdirtyになりうる。正しい手順は電源を切ってから抜くこと。
    ダッシュを表示したまま抜きたい場合のために safe_eject_sd_rock5b.sh を追加した。録画だけを
    正しく終了させてアンマウントし、2画面のダッシュ表示は維持する。
    実装で2回失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
2026-09-01 MAZDA2実車1回目の準備と切り分け（Phase2-4実車部分は継続中）
    タイムズカーシェアのMAZDA2で実車CAN取得を試み、受動キャプチャが完全無音
    (frames=0 / buserr=0)となった。切り分けの結果、自作側は回路・ハーネスとも白と確定。
    - can_logger: ビットレートをビルドフラグ CAN_BITRATE_KBPS で切替可能にし、
    現地切り分け用に -250k / -125k のenvを追加（後者はMS-CAN(3/11)探索にも使える）
    - can_capture_logger.py: 走行中に放置してキャプチャする運用のため、シリアルの
    自動再接続と2秒ごとの定期フラッシュを追加（--no-reconnect で無効化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
2026-09-01 Fix EcoCapture live demo sharing and logger LEDs
2026-09-02 引継ぎHANDOFF_20260902の取り込み: ARCHITECTURE.mdへ2026-09-02追記と位置情報の除外追加
    - ARCHITECTURE.md 4章末尾へ追記（追記のみ、既存記述は変更なし）
    - 表示アプリ EcoCapture/ の位置づけとデータ契約（schema 83 / 81ch）
    - ライブ共有と公開Web、認証なし・内輪利用限定という制約
    - SYS LED常時点灯とビルド名、副作用としてのタスク生存判別手段の喪失
    - 完了/未完了の境界（実走・車両CAN・耐障害・ROCK 5B ARM64受入は未完了）
    - firmware/logger_v1/.gitignore へ analysis/ と logs.zip を追加
    引継ぎ7章がGit対象外と定める座標入りログ・解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
2026-09-02 EcoCaptureのRaspberry Pi 4B移植: 実機での起動確認とRaceCaptureとの共存
    - EcoCapture ARM64版をrc-dash-4Bの/opt/ecocaptureへ設置し、X11 + OpenGL ES 3.1で
    UI描画まで実機確認（CPU 14.9%, RSS 302MB, 50.1C, throttled=0x0）
    - RaceCapture 2.19.0はインストール・自動起動設定とも無変更のまま共存させ、
    ecocapture_launch_rpi.sh / racecapture_switch_rpi.sh で双方向に切替
    - ARCHITECTURE.md 4章へ確定事項を追記、LINUX.md/SYSTEM_REQUIREMENTS.mdの
    実機確認状況を更新
2026-09-02 Pi 4BのX11にxserver-xorg-input-libinputが必要な点をLINUX.mdへ追記
    入力ドライバが無いとXが入力デバイスを1つも掴まず、マウスカーソルが出ず
    キーボード・マウスとも効かない。実機で発生したため手順へ反映した。
2026-09-02 LinuxのUSB探索がsysfsの相対シンボリックリンクを解決できず実機でロガーを検出できない不具合を修正
    .NETのFileSystemInfo.ResolveLinkTargetは「..」を字句的に畳むため、
    /sys/class/tty/ttyACM0（それ自体がリンク）配下のdeviceリンクを解決すると
    実機で存在しない /sys/1-1.3:1.0 を返し、VID/PID照合が常に失敗していた。
    カーネルと同じく1要素ずつ辿るLinuxUsbFactory.RealPathへ差し替え。
    - 従来のLinux試験はPTYと実ディレクトリのみでsysfsのリンク構造を再現しておらず
    素通りしていたため、その形の回帰テストを追加
    - rc-dash-4B実機で303a: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
2026-09-02 MAZDA2実車2回目の準備（Phase2-4実車部分は継続中）
    実車1回目が frames=0 / buserr=0 の完全無音で、自作側は白と確定済み。
    2回目は「ELM327で6/14番へ送信してバスの生死を独立に判定する」から始めるため、
    現地で一発判定できるスクリプトを用意し、手順書の判定ロジックを補強した。
    - mazda2_bus_check.py: 新規。ELM327経由の読み取り専用チェッカ。
    ATZ/ATE0/ATH1/ATI -> ATSP0/0100/ATDPN -> 010C/010D -> ATMA(20秒) を自動実行し、
    「ELM327の生死」「6/14番のECU応答」「DLCの生CANブロードキャスト有無」の3点から
    現地での次アクションを判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
2026-09-04 rc-dash-4Bの自動起動をRaceCaptureからEcoCaptureへ変更
    起動モードを/etc/dash-modeへ永続化し、~/.bashrcはdash-autostartを呼ぶだけにした。
    従来の切替スクリプトは実行時にgetty@tty1を止めるだけで、自動起動の実体は
    ~/.bashrc末尾のRaceCapture直起動のままだったため再起動で元に戻っていた。
    - dash_autostart_rpi.sh（新規）: /etc/dash-modeを読んで起動先を分岐
    - dash_switch_rpi.sh（新規）: モード書き換えとtty1の張り直し
    - ecocapture_launch_rpi.sh / racecapture_switch_rpi.sh: dash-switchの薄いラッパへ
    RaceCapture 2.19.0は削除せず残置（ルートFSは28GB中3.3GB使用）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
2026-09-04 Phase2-4-6-2完了: レクサスUXの無人1時間CANキャプチャの準備
    運転中はPCに触れないため、計測メニューをホスト側のタイマーで自動進行させる。
    - can_capture_logger.py に --phase-plan を追加。経過秒で can_obd_logger の
    PIDポーリングを自動停止/再開('p'/'r')し、statusログへ区切りを残す。
    USB再接続時は現在のフェーズを送り直して状態を復旧する。自己テスト26項目PASS
    - can_split_phases.py を新規作成。その区切りで長回しキャプチャをフェーズ別CSVへ
    分割する。--exclude-ids 7E0,7E8 で自分のOBD往復を落とせるため can_diff.py にも
    かけ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
2026-09-04 Phase2-4-6-2/2-4-7完了: 出発前準備の実機実施と、実車調査結果の回路担当向け整理
    出発前準備（実機で実施）:
    - COM5のESP32-C3へ can_obd_logger を書き込み、卓上リハーサルまで完了
    - その過程でUSB Serial/JTAGの不具合を実機で発見・修正。VFS経由の read(STDIN_FILENO) では
    ホストからの1バイトを受け取れず、受信FIFOが掃かれないためPC側の write が永久にブロックする
    （無人キャプチャが丸ごと失われる）。ctrl_task を usb_serial_jtag_driver_install() +
    usb_serial_jtag_read_bytes() の直接読み取りへ変更（stdout側の経路は変えていない）。
    本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
2026-09-05 Phase2-4-6-3/2-4-6-4完了: レクサスUX実車61分キャプチャと解析
    キャプチャ品質（自作基板の実車性能）:
    - 511,256フレームを61分連続で記録。drop_rb/rx_missed/rx_overrun=0、buserr=0、TEC=REC=0、
    USB切断・ESP32リセット0回、パースエラー0
    - --phase-plan による無人進行（受動↔OBDポーリングの切替6回）が実車で機能。運転者はPCに触れていない
    - MAZDA2の74秒に続き、回路・ハーネス・USB経路が1時間規模の実車運用に耐えることを実証
    判明した事実:
    - この車両では生CANの逆解析ができない。61分で観測できた非診断IDは45Aと4E0の2種のみで、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
2026-09-05 実車キャプチャの生ログはリポジトリに含めない方針を明記
    37MB規模のCSVはローカル保管とし、リポジトリには解析結果・サマリ・status.log のみを置く。
    .gitignore のコメントを「圧縮してコミットする選択肢もある」から確定した方針へ更新した。
2026-09-05 EcoCapture 0.3.7とUX250h実車OBD対応
2026-09-05 Phase2-4-6-6完了: NCEC実車調査（操作差分＋走行相関）の1時間プラン準備
    生CANが流れているのは3車両中NCECだけと確定したため、保留が続いていた
    2-4-3/2-4-4（停車中の操作差分）と2-4-5（走行相関）を同じ1時間で両方消化する
    現地手順書 ncec_field_procedure.md を作成。
    - 60分を「前半13分＝停車したまま12種の単一操作を各40秒（受動フェーズ）」＋
    「後半47分＝空ぶかし・走行・受動走行（OBDポーリング）」に分ける
    --phase-plan（21フェーズ）を確定。走行時間が取れない場合の31分版も用意し、
    フェーズ番号とラベルを同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
2026-09-05 NCEC現地手順を「走行のみ・OBD疎通確認を先に」の条件へ改訂
    ユーザーから「停車しての操作はできない。走行のみ。まずOBDの疎通確認、
    その後にCAN」と条件が確定したため、直前に用意した停車中12操作ブロックの
    プランを撤回し、2ステップ構成へ改めた。
    - ステップ1: プリチェック60秒（停車）。--limit-seconds 60 を1本回して
    grep "# obd" ncec_precheck.status.log で resp= の増加と rpm=/coolant= を
    確認する。これで 2-2-1 の「保留（実車必須）」＝0x7E0で応答するか
    0x7DFフォールバックが要るかがその場で確定し、同じ60秒の終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
2026-09-05 NCEC出発前の卓上リハーサルを実機で実施（合格）
    COM5(VID_303A/PID_1001)で認識、ファームはcan_obd_loggerのままと確認。
    r->RESUMED 約209ms、p->PAUSED 約213ms、ポーリング停止中はtxerrが7712で
    固定され再開で再増加＝キーがバス動作へ反映されている。
    drop_rb/rx_missed/rx_overrunはすべて0。
    手順書1-2へ実測値を追記し、あわせて卓上での正常な見え方を補足した。
    卓上では sent=6 から増えない（ACKが返らないフレームがTXキューに居座り
    以降のtwai_transmit()が失敗してtxerrだけ増える）点と、そのため
    0x7E0->0x7DF の自動フォールバック（連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
2026-09-06 Phase2-4-5/2-4-6-7/2-4-6-8完了: NCEC実車55分キャプチャと解析
    本番車両NCECへ自作基板を直結し55分キャプチャを実施。Phase2の実車保留が
    2件（2-2-1のECU応答確認、2-4-5の相関検証）まとめて解消した。
    キャプチャ品質:
    - 2,611,844フレーム / 791.5 frame/s / 55分
    - drop_rb=0, rx_missed=0, rx_overrun=0, buserr=0, TEC=REC=0, USB切断0回
    - レクサスUX(140 frame/s)の5.7倍のレートで1フレームも落ちていない
    - 受動692 frame/s vs ポーリング中799 frame/s。差の107はOBD往復そのもので
    ポーリングによる帯域圧迫は無いと定量化
    2-2-1の実車保留を解消:
    - 0x7E0でそのまま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
2026-09-06 給油をまたいだ自然実験で0x430=燃料レベルが確定
    停車中の操作差分を採るつもりで開始したキャプチャ(ncec_ops1)が、実際には
    給油で車を離れる区間になった。ただしIG OFFで375秒間バスが完全に無通信と
    なり、その前後の比較が決定的なデータになった。
    - 0x430 byte0 中央値: 35(13.7%) -> 237(92.9%)、+202の跳ね上がり
    - 純正燃料計との目視突合や走行中の単調減少といった間接的根拠と違い、
    実際の給油イベントへの直接の応答なので解釈が確定した
    - 満タンでも byte0 は237で頭打ち。実用上の上限は約93%
    - byte1 の「補数」説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
2026-09-06 NCEC: 資料由来のまま未検証だったバイトを個別に判定
    走行41分のデータで、コミュニティ資料に記載はあるが今回の回帰で確定に
    至らなかったバイトを個別に判定した。
    - 0x240 byte0(負荷?): 最良は吸気管圧R2=0.64/負荷R2=0.62で決めきれず
    - 0x240 byte2(点火時期?): 点火時期R2=0.80で示唆どまり、式は未確定
    - 0x201 byte6(アクセルペダル?): スロットル0.79/アクセルD0.78で示唆どまり。
    0x200 byte7・0x215 byte6 と同じ intercept≈11.3 の系統と判明
    - 0x420 byte1: 該当なし(最良0.15)、0x420 byte3: 最良0.68で未解明
    - 0x4EC byte4-5: 該当なし(最良0.60)で未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
2026-09-06 NCEC: 0x4B0の車輪対応を実測で決定し、取りこぼしゼロを連番で独立証明
    0x4B0の4バイトペアと車輪の対応:
    - 駆動スリップ(縦加速度との相関)が2対2できれいに割れ、byte4-5とbyte6-7が
    駆動輪=後軸、byte0-1とbyte2-3が前軸と判明(NCECはFR)
    - ヨーレート(左右差の前後軸での共通性)から、byte0-1とbyte4-5が同じ側、
    byte2-3とbyte6-7が同じ側と決まった。対角に切ると相関が消える(+0.109)
    - 4本の偏差どうしの相関も、対角ペアが最も強い負(-0.745/-0.812)、同じ側・
    同じ車軸のペアは打ち消し合って弱い、という解釈と完全に整合
    - レイア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
2026-09-06 NCEC次回実車接続時の宿題をチェックリスト化し、車両仕様を明記
    ユーザー依頼: (1)4輪速の左右確定の操作をタスクとして記録し次回必ず
    リマインドすること (2)示唆どまり5項目の対策をやることリストへ追加
    (3)エンジン載せ替えとECUチューンを車両仕様に書き足すこと。
    ncec_next_session_checklist.md を新規作成:
    - 実車が無いと絶対に解けない5項目を優先度つきで集約。各項目に実行コマンド
    (--phase-plan込み)と帰宅後の解析コマンドまで用意し、3つのプランは
    パース・ラベル重複なし・limit内を検証済み
    - A 4輪速の左右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
2026-09-06 スロットル系が示唆どまりになる理由を特定し、経路分離の試験へ改良
    ユーザーの指摘（電子スロットルなのでIG ONではバルブがアイドル位置に保持され
    ペダルに追従しない可能性がある）を受けて検証したところ、示唆どまりの正体が
    分かった。
    原因は刺激不足ではなく、基準値どうしが分離できていないこと:
    - OBD基準値どうしの相関を測ると 0x11(スロットル)と0x49(ペダルD)が 0.975、
    スロットル系6PIDの全ペアが0.85〜0.98
    - 走行中はペダルもバルブも指令値も一体で動くので、どのCANバイトがどの経路
    なのかを走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
2026-09-06 回路担当向けサマリを最新の実測で更新し、フォーラム共有を保留タスク化
    vehicle_can_survey_summary.md（回路担当との共有用の本体）を更新:
    - 4-1にローリングカウンタによる欠落ゼロの独立検証を追加。0x211 byte7 の
    増分が246,008件すべて+1（例外ゼロ）で、drop_rb=0 という自己申告とは別に
    車両ECU発行の連番で裏付けられたことを明記
    - 5章に実測バス負荷を追加。NCECのHS-CANは走行中 約692 frame/s、自作ロガーの
    ポーリングが約107 frame/s を上乗せして合計799 frame/s で取りこぼし0
    - 6章を「報告」と「判断してほしいこと」に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
2026-09-06 NCECのCAN通信仕様だけを抜き出した ncec_can_spec.md を新規作成
    測定手順・回路・プロジェクトの経緯を含まない、仕様だけの独立ファイル。
    実装者がこの1枚でデコーダを書ける状態を目指した。共有用。
    - バス諸元、非診断ID全16種の一覧（周期・件数・確度つき）
    - ID別のバイトマップを全バイト網羅。固定値バイトは実際の値まで記載
    - 確度を確定／示唆／未解明の3段階で明示し、推測を確定として書かない
    - 実装向けサマリとして、デコーダに入れてよい確定項目12件だけを別表に
    - OBD2仕様（0x7E0で応答・0x7E8単独・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
2026-09-06 Ver.2ロガーのGNSS選定とセンサーフュージョン構想を回路担当向けにまとめた
    LOGGER_V2_UNOQ_REPORT.md を新規作成。回路担当から候補として挙がった
    Quectel LC79H と u-blox NEO-M9N を現行 MAX-M10M と比較し、「20Hz以上×4衛星系同時」
    という要求を満たすのは NEO-M9N のみと結論づけた根拠を記載。
    あわせて GNSS+IMU の ESKF センサーフュージョン構想を新規に提案し、
    その成立条件として GNSS の PPS と BNO055 の INT を STM32U585 の割り込みピンへ
    引く配線追加を依頼事項として明記した（基板作成後には追加できないため）。
    UNO Q 実機での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
2026-09-06 姿勢算出の3方式(GNSS微分/固定較正/ESKF)を比較し、配線要件が共通であることを明記
    LOGGER_V2_UNOQ_REPORT.md を更新。
    2.5章を新設し、加速度センサーが比力(加速度−重力)しか測れないため、BNO055単体では
    コーナリング中にロール角・前後G/横Gが構造的に誤ることを記載した(横1.0Gで合成ベクトルが
    真下から45°傾く。実車体ロール3〜6°に対し誤差が上回る)。Boschデータシートにも
    記載のあるNDOFフュージョンの原理的限界であり、較正不良ではない。
    解法としてA:GNSS微分(RaceChrono採用方式)、B:固定較正、C:ESKF融合の3方式を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
2026-09-09 Ver.1基板ecologger_v1の完成を反映し、進捗記述の辻褄を合わせた
    - ARCHITECTURE.md 4章へ2026-09-10の追記（実装基板完成・搭載構成・残るブロック要因・
    NCECアクセス性の変化）。4章の既存記述は削除せず追記のみ
    - 5章のチェックボックスを更新：2-1／4-1／4-3を完了、4-2は未完了のまま注記を追加
    - task_phase4_breakdown.mdの「4-1〜4-3 保留」を実態（4-1/4-3完了・4-2のみ残）へ更新
    - task_phase2_breakdown.mdの2-1残作業(b)(c)を解消として記録
    - firmware/logger_v1/HANDOFF.md：残作業6の「b版が未コミット」は更新漏れだったため
    根拠コミットを添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
2026-09-09 2-3-1がlogger_v1で実装済みであることを確認し、残りを実車照合として記録
    コード確認の結果、本番ファームウェアには汎用CANマッピング(CanMapping×24)と
    NCEC専用ncProfileが既に実装されており、SD 100Hz CSVとRCPストリームの両方へ
    値が流れる。新規実装は不要と判明したため、2-3の記述を「実装済み・実車照合待ち」
    へ改めた。あわせて、ncProfileの負荷・スロットル換算式が未確定であることと、
    生CANデコードとOBDポーリングが排他になっている制約を明記した。
2026-09-09 NCEC実車回にecologger_v1を並行記録させる準備（項目F・provision_ncec.py）
    Ver.1基板が完成し現物が手元にあるため、次回のNCEC接続で本番ロガーを助手席に
    積んで回しておく段取りを追加した。解析基板はA〜Eのキャプチャ（OBD要求あり）、
    ecologger_v1はSDへの受動記録に役割を分ける。ncProfileのデコードは
    !obd_enabled && !toyota_steering のときだけ動くため、OBD要求は解析基板へ寄せる。
    - ncec_next_session_checklist.md に項目Fと出発前チェックを追加。Aの左右1周が
    そのままIMU横G符号の確定に使える点、VHハーネスが無い場合は電源だ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
2026-09-09 再ビルドを実機PCで確認し、ビルドタグが版を識別できない問題を記録
    python -m platformio run が作業PCで成功し、リポジトリのソースだけから
    firmware.binを再生成できることを確認した（274秒、Flash 7.4%）。
    一方で、artifacts同梱のfirmware.binと再ビルド結果はLOGGER_BUILDが同一
    （logger-v1-ux250h-obd-20260905a）にもかかわらず48バイト異なる。ESP-IDFの
    アプリ記述子を読むと同梱物はgit 647098e-dirtyのビルドで、汚れたツリーから
    作られているためリポジトリに一致するソースが無い。getVerのgit_infoだけでは
    実機イメージの出所を判定でき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
2026-09-09 訂正: ecologger_v1のコネクタはMolex Micro-Fit、電源系の型番も古いBOM由来の誤りだった
    ユーザーの指摘を受けlogger_v1.netとlogger_v1.kicad_pcbを直接確認した。
    logger_v1_bom.csvが基板製造前の古い版で、リファレンス番号も部品も現物と
    食い違っていたため、同日の追記に誤った型番を書いていた。
    - CANコネクタは2つともMolex Micro-Fit 3.0 43045-0400。J5=車載CAN(ATA6561、
    終端R35)、J4=外部CAN(MCP25625、終端R27)。JST VHではない
    - pin1は基板からの+5V出力。車両側ハーネスでOBD16番へ結線してはならない旨を
    チェックリストへ警告として追加
    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
2026-09-10 ecologger_v1へクリーンビルドを書込み、NCEC設定の投入と卓上検証まで実施
    実機の版の出所が不明という懸案を解消した。SDを安全にクローズしてから
    git 0d95e7c のクリーンツリーからビルドしたイメージを書き込み、SHA-256と
    ブートローダーのコンパイル時刻で同一性を確認した。
    - 書込み前の設定がレクサスUX試験のまま（obdEnabled/toyotaSteering=true、
    ncProfile=false）だったことが判明。この状態ではNCECの生CANデコードは
    排他条件により一切動かない。provision_ncec.pyでPASSまで投入し、
    RTSハードリセット後もNVSに保持され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
2026-09-10 2台をCANバスへ並列接続する際の終端・スタブ・送信衝突の注意を追加
    ecologger_v1を解析基板と並行してOBD2へぶら下げる運用について、電気的な
    前提をチェックリストへ明記した。
    - R35(車載CAN側の終端120Ω)はネットリスト上ジャンパ無しで直付けされており、
    hardware_interface_spec.mdの「ハンダジャンパーで切替」という記述と実回路が
    一致しない。実装されていると車両バスの60Ωと合わせて40Ωとなり規格を外れる
    - 繋ぐ前にJ5の2番-3番間をテスタで測る手順と、実装済みだった場合の退避策
    (電源のみ投入しV-2/V-4だ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
2026-09-11 Phase2-4-8-2/2-4-8-3完了: 停車キャプチャでCANデコード6件を確定
    駐車場での停車のみ（走行なし）で項目B・C・Dを実施し、解析まで完了した。
    キャプチャ4本はいずれもdrop/missed/overrun 0・パースエラー0。
    新たに確定したデコード:
    - 0x200 byte7 = 0x215 byte6 = アクセルペダル開度 (raw*0.2144+30.68 [%])
    - 0x240 byte3 = スロットルバルブ開度 (raw*0.3938-0.342 [%])
    - 0x200 byte6 bit0 = ブレーキペダル
    - 0x39A byte0 bit3 = パーキングブレーキ
    - 0x215 byte7 bit6 = A/C要求
    エンジンを切りIG ONのままペダルを全域掃引するとrpm=0/load=0/maf=0となり、
    エンジン由来の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
2026-09-11 Phase2-4-8-1完了: 0x4B0の4輪を左右まで確定
    広い場所で一定舵角のまま左旋回40秒・右旋回40秒を取得し、間の切り返し10秒は
    独立フェーズとして破棄した。旋回では外輪が速く回ることを利用する。
    | フェーズ | byte0-1 | byte2-3 | byte4-5 | byte6-7 |
    |---|---|---|---|---|
    | lr_left (左旋回) | 8.071 | 10.938 | 6.335 | 9.673 |
    | lr_right(右旋回) | 13.291 | 9.842 | 11.800 | 7.885 |
    前軸・後軸とも左右旋回で大小がきれいに反転し、差は2.9〜3.9 km/h。
    0x4B0 = [左前, 右前, 左後, 右後] (FL/FR/RL/RR) と確定。
    コミュニティ資料の順序と一致した。走行データからは原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
2026-09-11 Phase2-4-8-7: mode 22でECU内部変数へ到達し、A/C連動フラグを発見
    「NOPROがファン作動温度を変更している以上、OBD2経由で状態が取れるはず」という
    推論から出発した。ECUの3層(診断サービス/定期ブロードキャスト/物理駆動)のうち
    これまでmode 01しか叩いていなかったため、can_obd_loggerをmode 22対応に改修した
    (ランタイムキー d=プローブ/s=スキャン/w=ウォッチ。いずれも読み出し専用)。
    このECUはmode 22に応答する。DIDはmode 01のPID番号そのもの(0x00xx)で、
    ISO 15031-5の定石である0xF4xxは 7F 22 31 (requestOutOfRange)で拒否される。
    サー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
2026-09-15 回路担当への共有メモ(2026-09-15)を作成: バス負荷・CAN周期・4輪特定
    前回の共有(vehicle_can_survey_summary.md 2026-09-06版)以降に確定した内容を
    1枚にまとめ、根拠資料の所在まで案内する差分メモを追加した。
    - バス負荷: 692/799 frame/s の内訳を周期から逆算して一致を確認。
    ビット占有率は約18〜20%で、前回サマリの「実効約450kbit/s相当」は過大と判明
    - どのIDに何が何Hzで載るかを、車両CAN/OBD2ポーリング/mode22/外部CANの
    4層に分けて整理。外部CAN側のID採番・送信レートは未設計と明示
    - 0x4B0の4輪を定常円旋回で確定した経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
2026-09-15 Podium/PodiumConnectの現状まとめを作成（EcoLogger Ver.2対応検討用）
    公式ソースから判明しているPodiumテレメトリープロトコル（telemetry.podium.live:8080、
    auth/meta/sampleの3種）、Ver.1で得た知見（VID/PIDフィルタ、telCfg.deviceIdの永続化、
    公式アプリの再接続バグ）、Ver.2で採り得る3経路の比較と注意点を1ファイルへ集約。
2026-09-18 NCEC vehicle investigation, OBD-only transmission and fan command status
2026-09-19 車両仕様のマスターを ncec-roadster リポジトリへ移した旨を明記
    NCEC の整備・熱管理・走行記録を扱う専用リポジトリ (ntakao2006-web/ncec-roadster)
    を新設したため、車両仕様の一次情報源はそちらへ移動した。こちらに残す表は
    CAN解析を読むための最小限の前提という位置づけであることを明記し、更新順序
    （向こうを先に直してからこちらを追随）を書いた。二重管理を避けるため。
2026-09-20 Ver.2ロガーのLTEモデム(SIM7070G)評価レポートを作成
    回路担当が検討中のSIM7070Gについて、ニュルブルクリンク(ドイツ)での
    使用可否を中心に評価し、回路設計への依頼事項までまとめた。
    - SIM7070Gは欧州バンド(B3/B8/B20)・CE(RED)・独キャリア認定・技適を
    いずれも満たし、選定として妥当と結論
    - Podium 10Hz送信は上り約22kbps/約10MB/時と試算し帯域は十分。
    一方で映像配信はCat-M1では不可能
    - 最重要論点として、UNO QのArduinoヘッダがSTM32側にしか繋がらず、
    UART接続ではPodium経路A(Linux側が直接送信)が成立しない点を指摘。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
2026-09-20 回路担当のChatGPTへ投げる質問文を作成(LTEモデム設計レビュー)
    LOGGER_V2_LTE_MODEM_REPORT.mdの内容を、回路担当側のChatGPTへ
    そのまま貼り付けられる質問文の形に組み替えたもの。双方の設計の
    前提をすり合わせることが目的。
    - こちらの結論は「相手側の見解(A)〜(E)」として提示し、同意/不同意の
    明示と反証を求める構成にした(なぞるだけの回答を避けるため)
    - Q1に「選定理由の整理」を置き、先に向こうの設計意図を言語化させる
    - Q2〜Q7で接続構成・電源・GNSS干渉・SIM実装・優先順位を質問
    - Q8で逆質問を求め、一方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
2026-09-20 LTEモデム質問文をリポジトリ共有前提版へ改訂
    回路担当側のChatGPTが本リポジトリを共有済みと判明したため、
    質問文を全面的に書き直した。
    - システム構成の説明を全削除し、ファイル名での参照に変更
    (要約を挟むと情報が劣化するため)
    - 「結論を先に見せない」という初版の方針を撤回。
    LOGGER_V2_LTE_MODEM_REPORT.mdはpush済みで既に読めるため、
    隠す代わりに「素人がWeb調査で書いたものとして反証せよ」と明示
    - 判定表をA〜Gの7項目へ細分化し、主張を個別に潰せるようにした
    - Q1を「Cat-M1というカテゴリ選択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
2026-09-20 LTEモデム相談メモを役割整理版へ全面改訂
    第2版までは「ソフト担当が回路担当をレビューする」構図で書いていたが、
    実態と異なっていたため全面的に改めた。こちらの専門は機械(筐体・機構)で、
    ソフトは仕様を出せても実装判断の妥当性を自力で検証できず、回路は専門外。
    判断は回路担当へ全面的に委ねる立場である旨を0章に明記した。
    - 「反証してほしい」という依頼を取り下げ、要求仕様を出して判断を委ねる
    構図へ変更。レポートは「判断材料のひとつ」へ位置づけを降格
    - ChatGPTへの質問を事実確認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
2026-09-20 LTEモデム: 要求仕様を確定させ、レポートの結論4点を訂正
    アンケートで要求仕様を一通り確定させた。その結果、
    LOGGER_V2_LTE_MODEM_REPORT.mdの結論が4点成立しなくなったため、
    QUESTIONS側に3章「前版から変わった点」を新設して明示し、
    REPORT側の冒頭にも無効化された記述の一覧を追記した。
    確定した主な要求:
    - 映像は送らない(確定)。送信レートは10Hz維持、遅延は1秒以内が望ましい
    - 走行中のみ配信、視聴はチーム数人、通信は遠征時など限定でよい
    - ニュル遠征は1年以内。テザリング運用は採らない(電源ONだけで完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
2026-09-20 LTEモデム: Cat-M1の遅延実測を反映し、Ver.1/Ver.2の切り分けとSIM要求を訂正
    - Cat-Mの遅延実測データ(arXiv 2207.04847)を3.2章に追加。平均163〜174ms、
    98%が200ms以内、10〜80フレーム毎秒で損失0%(26バイト時)。要求「1秒以内」に
    対し桁で余裕があり、Cat-1との差も約50msに留まるため、遅延を理由に
    カテゴリを変える必要はないと確認。P-2(Cat-M1でよいか)を解消扱いとし、
    回路担当の「SIM7070Gでほぼ一択」という判断へ明示的に同意する記述へ改めた
    - Ver.1とVer.2を切り分け。USBドングル外付けの不採用はVer.2の話であり、
    完成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
2026-09-20 LTEモデム: 「間引きは想定しない」という誤った記述を訂正
    10Hz送信そのものが生データ(GNSS 25Hz等)からの間引き結果であり、
    「10Hz維持=間引きは想定しない」という第4〜5版の記述は誤りだった。
    podium_connect_notes.md 6.1-3「Podiumへ出す分は間引きが要る」と
    矛盾させていたため、既存記述に合わせて訂正した。
    - 3.1章を「送信レートと間引きについて」へ書き換え。生データ→SD(フルレート)
    →間引き→Podium(基準10Hz)というデータの流れを明示
    - 間引き率を状況に応じて可変にしたいという要求を追加。ただし「状況」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
2026-09-20 LTEモデム: 送信レート可変方式を整理しP-9として起票
    「状況に応じて」の中身が未確定だった件を3.1.2章として整理した。
    当初「①電波状況/②用途・車両/③手動」の3択と考えていたが、実際は
    「既定値をどう決めるか(②+③)」と「走行中に自動で下げるか(①)」という
    独立した2つの判断であり、②と③は対立しない。争点は①のみ。
    - 3案の比較表を追加(実装量/走行前の操作/設計思想との相性/再現性/
    切り分けのしやすさ/電波変動への追従/本番リスク)
    - こちらの提案として「②+③だけ先に入れ、①は実機で不足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
2026-09-20 LTEモデム: SIM7070Gに通常のLTEフォールバックが無い件を起票しP-7を再浮上
    「2年前のニュルでワイモバイルが普通に繋がった」という実体験から、
    逆に見落としていた穴に気づいた。そのとき繋がったのは通常のLTE(Cat-4)で、
    SIM7070Gが使えない方式である。同モジュールはCat-M1/NB-IoT/GPRSのみで、
    LTE-Mローミングが効かない場合のフォールバック先は2G(GPRS)しかない。
    GPRSの実効速度・遅延では「10Hz・遅延1秒以内」を満たせない可能性が高い。
    - 3.1.3章を新設し、リスクの連鎖(基地局のLTE-M有無→ローミング可否→
    2Gフォー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
2026-09-20 LTEモデム: 3章の訂正表#3を3.1.3の結論に合わせて修正
    回線選定を「契約の手間の話」としていた記述が残っていたため、
    技術的リスクを伴う判断(P-7)である旨に統一した。
2026-09-21 Ver.2設計判断: E-1〜E-3を決着（姿勢はESKF本命、ダッシュカムは保存のみ）
    - E-1: GNSSをNEO-M9N-00Bで確定（消費電力+67mWを許容）
    - E-2: 姿勢・G算出はC方式(GNSS/IMU融合・ESKF)を本命に決定。
    BNO055はAMGモードで使い内蔵NDOFの姿勢出力は姿勢推定に使わない。
    ESKFはSTM32U585側。実装順序はA→B→Cで可だが到達目標はC。
    回路側への依頼は5.1章の配線2本のままで変わらないが、確定要求として扱う。
    - E-3: Ver.2ダッシュカムは保存のみ・1080p30・1カメラで確定。
    RTMP配信と2カメラは狙わない。内蔵LTE(Cat-M1)はテレメトリ専用と確定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
2026-09-21 Phase6棚卸し: logger_v1で6-1〜6-7が実装済みと確認し、ロードマップを実態へ合わせた
    task_phase6_breakdown.md がPhase1のプロトタイプ(firmware/src/main.cpp)を対象に
    書かれていたため、本番ファームウェア firmware/logger_v1 の実装がロードマップへ
    反映されておらず、Phase6が全項目未着手のままになっていた。ソース確認の結果:
    - 6-1/6-2/6-3/6-4/6-5/6-6/6-7 はいずれも logger_v1 で実装済み。新規実装は不要
    - 7章「SDログのスキーマ乖離」も解消済みだった（CSVヘッダをチャンネルテーブルから
    動的生成。storage.cpp）。7章の該当行を解消済み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
2026-09-21 Ver.2 GNSS: E-1を再訂正。NEO-M9Nは入手困難のためMAX-M10M-00Bを継続使用
    - 回路側への影響: Ver.2のGNSS部はVer.1のまま据え置きでよい。
    UNOQレポート5.2章B-1〜B-5(フットプリント変更・アンテナ給電回路の再確認・
    消費電力増の検討)と5.3章C-1がすべて不要になった。P-3と併せて早めに共有する。
    - 諦めるもの: 4系統同時20Hz以上は得られない(MAX-M10Mは4系統10Hz/3系統約15Hz/
    単一25Hzのトレードオフ)。25Hzには個体ごとの不可逆OTP書き込みが残る。
    - E-2(C方式ESKF)との関係でGNSS更新レートの優先度は下がった。IMU 100Hzが間を
    埋める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
2026-09-21 Ver.2配線依頼A-1/A-2を実回路で裏取りし訂正
    logger_v1.net を確認したところ:
    - A-1(GNSS PPS)は ecologger_v1 に既に配線済み。U13(MAX-M10M) pin4 TIMEPULSE →
    ネット /GNSS_PPS。ピン番号も「NEO-M9N pin3」ではなく MAX-M10M pin4 が正しい
    - A-2(BNO055 INT)は Ver.1 では未接続（unconnected-(U12-INT-Pad6)）
    → 回路担当への「新規配線の依頼」は実質A-2の1本だけであり、
    当初の説明より依頼が軽い。その旨を5.1章へ明記した。
2026-09-21 回路担当への未回答事項を1枚に集約した共有メモを作成(2026-09-21)
    これまでの資料(LOGGER_V2_UNOQ_REPORT / LOGGER_V2_LTE_MODEM_QUESTIONS /
    hardware_share_20260915)はいずれも未送だったため、差分メモではなく
    「いま未回答のもの全部」を単体で読める形にまとめ直した。
    構成:
    - 1章 依頼が減った話(GNSS据え置きでB-1〜B-5・C-1が不要、新規配線は実質A-2の1本)
    - 2章 アートワーク前に返事がほしい3件(P-3 / M-4・P-8 / A-2)
    - 3章 UNO Q実機確認 D-1〜D-4(コマンドと記入欄つき)
    - 4章 裁量で進めてよいもの(P-4/P-5/P-6)
    - 5章 判断を仰ぎたいもの(P-7、およ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
2026-09-21 回路担当からの回答(2026-09-21)を受領し、全ドキュメントへ反映
    hardware_share_20260921.md への回答と、同日チャットで決着した映像保存経路を反映した。
    - hardware_ans_20260921.md を新規作成（回答原文＋確定/未確定の仕分け＋こちらの宿題10件）
    - hardware_share_20260921.md: 全回答欄を埋め、訂正された6か所に注記を追加
    - ARCHITECTURE.md 4章: 回答受領の追記と、USBハブ不要化(E-4〜E-6)の追記
    - ARCHITECTURE.md 6章-2・7章: R35をハンダジャンパー方式から未実装(DNP)へ訂正
    - ARCHITECTURE.md 7章: 新規の未解決事項10件を起票
    - hardware_interface_spec.md 3章-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
2026-09-21 Podiumクライアントの置き場所を再検討し、経路A'(STM32直送)を追加
    回路担当から「STM32にLTEを繋いだだけではLinuxはネットに出られず、Linux側の
    Podiumクライアントとの橋渡しが別途必要（未実装）」と申し送られたが、そもそも
    Linuxを介在させる必然性が無いというユーザー指摘を受け、参照実装で裏取りした。
    根拠:
    - Podiumテレメトリーは平文TCP＋改行区切りJSONのみ。TLS/WebSocket/HTTPを使わず、
    依存はソケットとJSONだけ
    - 公式RaceCaptureファーム自身がベアメタルMCUからモデムをATコマンドで叩いて
    実装している（cellular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
2026-09-21 メカフィーリングスロットルマップを全域スイープで同定。従来の「1.9倍」を訂正
    ncec_sweep（エンジン停止・IG ON でのペダル全域掃引）から、ペダル開度→実スロットル
    開度の伝達特性を同定した。再現用に ncec_throttle_map.py を追加。
    - 実体はカーブではなく「ゲイン約1.35倍の直線＋ペダル74.3%で頭打ち」
    （正規化後 throttle = 1.3541 × pedal − 0.55、R² = 0.99912、平均残差 0.49pt）
    - 従来 OBD2_SURVEY.md に記していた「ゲイン約1.9倍」は、ペダル(46.67pt)と
    スロットル(69.80pt)の実効レンジ差を正規化せずに比べたもので過大評価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
2026-09-22 宿題5完了: UNO Q映像確認の判定手順を書き直し、独立した手順書にした
    回路担当から、旧D-3の判定基準は2点とも誤りと指摘されていた。
    - h264_v4l2m2m を明示した場合、使えなければエラーで落ちることがあり、
    黙ってCPUエンコードへ切り替わる前提が誤り
    - 旧手順は入力に testsrc を使っており、画像生成と色変換自体がCPUを食うため
    「CPU使用率が高い＝CPUエンコード」とは言えない
    unoq_video_check_procedure.md として作り直した内容:
    - 判定を「所要時間とCPU負荷」から「使用デバイス・フレーム欠落・保存結果」へ差し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
2026-09-22 宿題1・2: GNSSのI2C(DDC)化とIMUとのバス共用を設計・見積もり
    P-3の回答でGNSSがUART→I2Cへ移りBNO055とバスを共用することになった件。
    宿題2(帯域の見積もり):
    - Ver.1の読み方(融合値込み51バイト)だとIMUだけで100kHz時の約49%を食う
    - E-2でESKFを本命に決めた結果BNO055はAMGモードで使うため、読み出しが
    51→約20バイトへ減る。設計判断がそのままバス負荷の削減になっている
    - AMG+GNSS 25Hzで 100kHz時45% / 400kHz時11%。帯域は400kHzなら問題にならない
    - 🔴 本当の問題はレイテンシ。100kHzではGNSSの1回の読み出し9.7msが
    IMUの取得周期10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
2026-09-22 宿題6・7・8: 入力/出力チャンネルの仕様をこちら側で言語化した
    宿題8(車体信号の絞り込み):
    - 「取れない」を3種類に分けた。①油温・油圧=センサーが存在しない
    ②ウィンカー等=別バス ③舵角・ブレーキ圧・車体加速度=DSC非搭載車なので
    車両のどこにも流れておらず、ボディCANをタップしても出てこない
    - 結論案: デジタル入力もボディCANタップもどちらも不要。
    センサーハブ・IMU(ESKF)・計算チャンネル(ギア段=回転数÷車速)で全部まかなえる
    宿題7(油温・油圧の要求仕様):
    - 油温0〜150℃(140℃超が本番オイルの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
2026-09-22 宿題9: 日独両対応LTE-M SIMを調査。SORACOMはドイツでCat-M1非対応と判明
    回路担当から「1NCE前提の説明は根拠として弱い」と指摘されていた件。
    根拠を差し替えられる具体的な材料が取れた。
    - SORACOM plan01s の公開されている国別対応表では、日本は KDDI/Docomo/SoftBank で
    4G/LTE・LTE Cat-M1・NB-IoT・5G に対応する一方、ドイツは O2/Vodafone の
    2G/3G/4G のみで Cat-M1 の記載が無い
    - SIM7070G は通常のLTEを使えないため、このSIMをドイツへ持ち込むと 2G(GPRS) まで落ちる。
    LOGGER_V2_LTE_MODEM_QUESTIONS.md 3.1.3章の懸念が実例で裏付けられた
    - 1NCE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
2026-09-22 ARCHITECTURE.md 4章へ2026-09-22の作業を追記
    回路担当の回答で生じた宿題10件のうち、こちらで動かせる6件(1・2・5・6・7・8・9)を
    処理した結果を要約。新規文書4点(unoq_video_check_procedure / logger_v2_gnss_i2c_design /
    logger_v2_channel_and_sensor_spec / logger_v2_lte_sim_survey)への導線を張った。
    ToDoへ卓上タスク2件を起票:
    - t710 Ver.1のI2Cを400kHzへ上げてBNO055が安定かを確かめる(Ver.2の回路図が固まる前に
    「I2Cは1系統でよいか」を返せる。★これが今いちばん価値のある卓上作業)
    - t720 1NCEのCoverage List PDFで日本・ドイツのLTE-M対応を確かめる
    Co-Aut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
2026-09-22 logger_v2の最新回路図・PCB・部品ライブラリと実装方針を追加
2026-09-24 Defiセンサー分岐回路を設計: 差動・レシオメトリック方式の叩き台と部品表
2026-10-02 宿題9訂正: SORACOM plan01sはドイツでもLTE-M対応(LPWAN対応表)、1枚運用を推奨
2026-10-02 宿題9追記: planV1はplan01sへの追加サブスクリプションで基本料はほぼ同額
2026-10-02 走行中監視の方針を追記: セルラー配信＋圏外は車内警告で補い、自前無線は不採用
2026-10-03 エコランチーム既存システムとの関係を整理: 通話は外部の複数サーバー切替方式、モデム重複を課題化
2026-10-03 LTEアンテナを市販貼り付け品(FXUB63)＋SMA接続とし、回路担当への発注依頼メモを作成
2026-10-03 Podium実装者向け補足を追記: 標準チャンネル名・サブモジュール取得・SIM7070Gの参考実装
2026-10-04 Podium実装の引き継ぎメモを作成: 参照ソース(サブモジュール)の取り出し方と詰まりやすい点
2026-10-04 Defiセンサーハブ基板をv2方式で設計: サーミスタ直接測定＋デジタルポテンショメータで再現、JLCPCB発注粒度
2026-10-04 刷新後のPodiumサーバーを実測: JSON受け口は健在、無効キーは無言切断。疎通テスト用スクリプトを追加
2026-10-04 旧Podium廃止・次世代システム移行を記録: 直接送信方式は現状つながらない
2026-10-04 次世代Podiumの送信プロトコルを実測で確定: 認証形式の変更が原因、PCから認証・デバイス認識まで確認
2026-10-04 EcoCapture-WebのPodium送信を確定版プロトコルに合わせる: LTE経由で連続送信に成功
    - 認証を新形式(apiVer/device/ver/sn)に、サンプルに連番t、metaにprec、先頭をInterval/Utcに
    - UNO QからWi-Fi経由でhbのltが増えることを確認(サーバーがサンプルを受理)
    - LTE(SIM7070G)経由で接続約16秒・認証OK・約1分間再接続なし。実効は約3フレーム/秒
    - 「旧形式は無言で切断」の記述を訂正(有効なキーなら旧形式でもstatus:ok)
2026-10-06 Lintarohさんの UNO Q HDMI・障害記録の更新を取り込み、記述の整合を取る
    - ARCHITECTURE.md 4章: 8fd1674（HDMI主表示・incident monitor）の要点を追記
    - ARCHITECTURE.md 7章: 「UNO Qは未調達」を訂正（調達済み・GPU描画確認済み、HWエンコードは未確認）
    - CLAUDE.md: RaceCapture-UNOQ/・EcoCapture-Web/・drive_logs/ をファイル構成に追加
    - .gitignore: 位置情報を含む drive_logs/ を除外
2026-10-06 UNO Q用アクティブクーラー駆動基板を追加し、LED目視確認を完了に更新
    - circuit/actibe_cooler/: PIC12F1822によるクーラー駆動基板（KiCad、2026-10-04作成）
    - .gitignore: KiCadのローカル履歴 .history/（独自の.gitを持つ）を除外
    - ARCHITECTURE.md 4章: クーラー基板の追加を追記
    - firmware/logger_v1/HANDOFF.md: 状態LEDの目視確認を完了に（回路担当が確認済み）
2026-10-08 UNO Q映像確認V-1〜V-3を無人実行するスクリプトを追加
    - unoq_video_check.sh: 手順書3〜5章（デバイス確認・ffmpeg・1080p30 HWエンコード＋libx264対照）を
    自動化し、判定と稼働状況・温度を ~/enc_test/result_<日時>/summary.txt に残す。
    PCから ssh unoq 'bash -s' < unoq_video_check.sh で流せる
    - unoq_video_check_procedure.md: 「UNO Qは未調達」を訂正し、スクリプトの使い方を追記
2026-10-08 UNO Q映像確認V-1〜V-3を実機で実施: HWエンコーダは1080p30実時間OK、ffmpeg経由は不可
    - V-1 OK（/dev/video0エンコーダ・venus有効）、V-2 OK、V-3 △
    - v4l2-ctl直接駆動で1080p 900フレーム24.8秒・CPU 24%・欠落なし。ffmpeg 7.1.5のh264_v4l2m2mはセグフォルト
    - 入力側30fps設定と高さ1088行バッファが必要なことを手順書5-5に記録
    - スクリプト: ~/ffmpeg-local自動利用、ffmpeg無し時のV-2を未実施表示、v4l2-ctl直接駆動の計測を追加、adb経由の実行方法を追記
2026-10-08 UNO Qで映像へのプロット焼き込みを模擬試験: dmabuf共有で1080p30を5分間完走
    - tools/unoq_overlay_enc/overlay_enc_test.c: カメラ代わりの映像にGPUで重ね描きし、
    NV12化してHWエンコーダへ渡す試験プログラム（EGL surfaceless＋V4L2、ffmpeg不使用）
    - glReadPixelsでコピーする方式は約17fps、dmabufでエンコーダのバッファをGPUと共有すると36fps
    - 30fps×9000フレームを常駐サービス稼働中に欠落なく完走、システムCPU 21%→27%、温度52〜54℃
    - 手順書5-6とARCHITECTURE.md 4章に結果と未確認事項を追記
2026-10-08 E-6の判断材料を訂正: Linux→STM32の映像経路を調査し、未使用の内部SPIを確認
    - Bridge(arduino-router)はUART 921600bpsで映像(12Mbps)の約1/16しかなく不可
    - 公式回路図・Zephyrボード定義・実機デバイスツリーで、Linux spidev0.0(GPIO14-17)が
    STM32 SPI3(スレーブ)へ直結していることを確認。上限はMOSI上のTXS0101(24Mbps)
2026-10-08 E-6追加調査: シールドSDへの映像保存はSTM32→SD側がボトルネック
    - unoq_video_to_shield_sd_study.md を新規作成（内部SPIの配線表、ビットレートと画質の実測、SD側の現状、次の手順）
    - シールドSDはSPIモードでSPI2をCAN2・LEDと共用、現行ファームはソフトウェアSPIで1セクタずつ書き込み
    - 実カメラ素材はCBR 8Mbpsで十分な画質、VBRは最悪条件で瞬間23.8Mbpsまで跳ねるためCBR必須
    - CLAUDE.mdのファイル構成に映像関連の資料を追記
2026-10-08 E-6: UNO Q内部SPIのLinux側送信を実測、64KB×20MHzで約2MB/s
    - tools/unoq_overlay_enc/spi_tx_test.c: spidev0.0の送信速度試験
    - spidev既定(4096B/メッセージ)では50MHz未満でメッセージ毎に約5msの待ちが入り0.6MB/s止まり
    - bufsizを広げ64KB×20MHzで2.0MB/s、焼き込み30fpsと同時でも互いに影響なし
    - STM32側の受信・SD書き込みは未試験
2026-10-09 E-6: 試験ファームでLinux→STM32→シールドSDの通しを実測、フロー制御が必要と判明
    - tools/unoq_spi_sd_test/: STM32試験ファーム（SPI3スレーブ+GPDMA受信、ハードウェアSPI2でSD連続書き込み）、
    Linux側の送信・RPCクライアント、安全な書き込み手順 flash.sh
    - SPI受信は20MHzで32MB誤り0（50MHzまで誤り0）、SD書き込み2,221KB/s
    - 通し1MB/s×5分で0.05%欠落：SDの50〜60ms停止でSTM32の64KBバッファを追い越される。Linux側に溜めるフロー制御が必要
    - ルーター稼働中にSTM32を止めて書き込むとLinux側UARTが固まる件と回避手順を記録
    - ロガーのファー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
2026-10-09 E-6: フロー制御つき通し試験で8Mbps相当×5分を欠落0で完走
    - 試験ファームに書き終えたバイト数を返すspitest.rdを追加、SD待ち中はk_yieldでBridgeへ譲る
    - spi_fc.py: エンコーダの一定レート出力を模擬し、空きがある時だけ送るクレジット方式の送信
    - 1MB/s×5分で307,200KB全ブロック・欠落0、Linux側の一時バッファは最大409KB
    - 今の作りの上限は約1.2MB/s（9.6Mbps）
2026-10-09 Lintarohさんへの共有メモを追加（ファーム書き込み手順の危険、UNO Q上での作業、E-6の結果と相談）
2026-10-09 V-5準備: USB UVCカメラから焼き込み→HWエンコードの通しを実測、MJPEG展開がCPU律速と判明
2026-10-09 UNO Qの更新手順を修正し共有メモへの回答と容量検証を追加
2026-10-09 Lintarohさんの回答(20261009)を各資料へ反映: RAM余地・統合条件・更新手順の統一
2026-10-09 UNO Q実機で稼働中ファームのソースを確定し、flash-mcu.shを初回適用・RAMを再集計
    稼働中ファームは機器側~/ecologger_v2(10/3 18:58版)の再ビルドとバイト一致。
    リポジトリ版logger_impl.hはsys_reboot未定義でUNO Q上ではビルド不可。
    flash-mcu.shは同一イメージで全段階通過、Bridge・SD記録の復帰を確認。
    稼働中イメージの静的領域は129,881Bで128KiB枠の残りは1,191B。
2026-10-09 Lintarohさんへの共有メモ(映像機材構成とUPSモジュール)を追加、回路担当と同一人物である旨をCLAUDE.mdへ反映
2026-10-09 UNO QファームにCAN2のACKを入れて実機へ書き込み、自動再起動は内部リセット後の半起動のため見送り
    - 稼働版を機器側ソース(10/3版)+CAN2通常モードに更新し、リポジトリと一致させた
    - ループ監視の自動再起動はk_timer+NVIC_SystemResetで試作したが、Linux通信中の
    内部リセット後にBridge未登録・SD記録停止となるため外した(NRSTリセットなら復帰)
    - RAMの実際の限界が静的集計の128KiBより手前にあることを実測で確認
2026-10-09 UNO Qにループ監視とLinux側の監視役を入れ、停止から48秒で自動復帰する構成にした
    - ファーム: 30秒ループ監視(k_timer+NVIC_SystemReset)を再導入、試験コマンドはLOGGER_STALL_TEST時のみ
    - build.sh: RouterBridgeの受信スレッドを$/reset完了前から動かし、空回りでSD保存が止まる問題を修正
    - EcoCapture-Web: mcu-supervisor.py(ecocapture-mcu-supervisor)が30秒の通信断でNRSTリセット手順を実行
    - 内部リセット後に通信路が戻らない件はlintaroh_share_20261009_2.mdで相談
2026-10-09 汎用センサーハブの要求仕様書(Lintarohさん向け)を追加、外部CANのID割り当て表と設定の運用ルールを定義
2026-10-09 Lintarohさんへの共有メモ(汎用センサーハブの仕様の要点と確認事項)を追加
2026-10-10 1NCEのCoverage Listで日独ともLTE-M対応を確認、SIMは1枚で日独両対応と確定(宿題9)
2026-10-10 Ver.1のI2Cを400kHzにしてBNO055を24分連続試験、取得欠けなしの結果を記録(t710)
2026-10-12 映像保存はeMMCに録画して走行ごとにPCへ吸い出す運用とし、容量と吸い出し時間の目安を記録
2026-10-12 Ver.2の映像はリアルタイム焼き込みを必須要件と確定し、次はカメラ無しでHWデコーダとの同時動作を確認する
2026-10-12 カメラ無しで行うHWデコード経路の試験項目(D-1〜D-5)を必要作業として記録、Venusの処理上限から720p入力＋1080p保存を本命とする
2026-10-13 ER-1-1・ER-2完了: Ver.2にラップ計測とPodiumのWi-Fi送信経路を追加、エコラン大会向け作業を分解
    - lap.py: GNSSのUTCで判定するS/Fライン通過ラップ（進行方向の自動学習、最短/最大ラップ、測位精度条件、再起動後も継続）
    - CSV・Dashboard・Podiumに LapCount/CurrentLap/LapTime/BestLap/ElapsedTime を追加
    - podium.py: LTE/Wi-Fiを設定で切替（Wi-FiはLinuxのTCPソケット）
    - task_ecorun_20261024_breakdown.md: 10/24-25大会向けの作業分解（ER-1〜ER-6）
2026-10-13 ER-3-1完了: センサーハブの油温をサーミスタ換算で受ける準備、Lintarohさんへの確認メモを追加
    - CAN信号にサーミスタ換算（比率→抵抗→温度、校正点の間をβモデルで補間、短絡・断線は値なし）を追加
    - 設定画面に「センサーハブの油温」ボタン（CAN2・0x500・2–3バイト目の5V比率）、Dashboardに車両信号のタイル
    - lintaroh_share_20261013_oiltemp.md: ユニバーサル基板版ハブのバイト順・プルアップ値・IDの確認事項
2026-10-13 UNO Qの更新スクリプトをWindows PowerShell 5.1で動くよう修正（BOM付与、adbの置き場所が無いときは既存のadbを使う）
2026-10-13 UNO Qの監視復旧を更新手順と排他制御で統一し追加共有メモへ回答
2026-10-13 Podium画面に数値が出ない件の原因をDiscordで確認: 新Podiumは測位前のストリームを受け付けない
    - podium_connect_notes.md 9.4.4章に開発者回答の要点を記録（GPS由来の時刻が必須、Podiumアプリはトラック外で非表示→Webで見る）
    - EcoCapture-Web: Utcが無い間はPodium状態を「GPS測位待ち」と表示する
    - ER-1-2に確認方法を追記
2026-10-14 ER-7-1・ER-7-2完了: Podium送信をチームのecorun-logger-server経由にできるようにする
    ロガーの送信先を「Podiumへ直接／中継サーバー経由」で切り替えられるようにし、
    中継サーバーへはWebSocketで5行ずつまとめて送る（直接送信は当日の予備として残す）。
    サーバー側はTMCIT-Ecorun/ecorun-logger-server#1。
2026-10-14 Podiumの表示をPCから確認: Utc付きならWebに数値が出る（アプリ0.8.0は出ない）
    学内ネットは外向き8080番が通らないこと、telemetry.podium.liveの接続先が変わったことも記録。
2026-10-14 Podiumのアプリ表示とラップの扱いを確認: 会場を設定すればアプリに出る、Laps欄は会場のラインで数える
    podium_test_sender.pyに送信場所（--site motegi）とラップ系チャンネル（--laps）、
    UNO Q上でキーを設定ファイルから読む --key-file を追加。
2026-10-14 中継サーバーのレビュー対応: ロガーのhelloを対応音声形式（audio_formats:[]）で伝える形に変更
    佐藤さんのレビュー（TMCIT-Ecorun/ecorun-logger-server#1）でreceive_audioをやめ、
    再生できる音声形式の一覧を伝える方式にしたため。空の一覧なら通話音声は流れない。
2026-10-14 UNO Qへの反映手順を修正: PowerShell 5.1で監視サービス再起動の行が構文エラーになる件と、実機で書き込み手順の試験が時間切れになる件
    - Update-UNOQ.ps1: Windows PowerShell 5.1は外部コマンドの引数中の二重引用符を落とすため、sh -c の中身を単引用符で渡す
    - test_flash_mcu.py: ルーター起動待ちの失敗パスはスタブを約30回起動し、UNO Qでは10秒を超えるので制限時間を60秒へ
2026-10-14 ER-1-2・ER-2-3完了: UNO Q実機でPodium表示とラップ計測を確認、SD未認識でeMMCも記録しない件を起票
    - 屋外で3D測位させWi-Fi・Podium直接で送信し、Podiumアプリに全チャンネル・地図・LapCount等が出た
    - 歩行で2周を計測（5km/h未満のため円判定。線＋向きは未確認）
    - ER-4-4（SDとeMMCの独立・ドラレコ方式）、ER-2-4・2-5（判定の調査と改善）、ER-1-5（もてぎのライン付近でのPodiumの挙動）を起票
2026-10-14 ER-4-4（ロガー側）: SDが使えなくてもeMMCは必ず記録し、保持をドラレコ方式へ
    - SD未認識・異常・開始失敗は警告にして、eMMCのCSVは記録を開始する
    （画面に「● REC（本体のみ）」と警告文。記録中にSDが落ちた場合も警告）
    - SDを使わなかった記録は、停止時にSDの完了確認を待たずにCSVを閉じる
    - eMMCの保持を「直近3件」から、空き1GiBを切ったら終了済みログを古い順に
    消す方式へ変更（記録中は消さない。消せず256MiBを切ったら停止）
    - PCでtest_server 20件通過。UNO Q実機は未反映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
2026-10-14 ER-2-4完了・ER-2-5（ロガー側）: ラップ判定を調査し、通過後の再アームと向きの指定を追加
    - RaceCapture（GPLv3、考え方のみ）とRaceChronoの判定を調べて比較表にした
    （lap_detection_survey_20261014.md）
    - 通過後はラインから幅以上離れるまで次の通過を数えない（停車中のGNSSの揺れで周回が増えない）
    - 最短ラップの既定を60秒→10秒へ
    - Web画面で進行方向を指定できるようにした（空欄で最初の通過時に自動決定）
    - PCでtest_lap 13件・test_server 20件通過。UNO Q実機は未反映
2026-10-14 ER-5-1（実装）: 走行後のログ回収スクリプト
    - tools/collect_logs/Collect-Logs.cmd：Ver.1のSD・Ver.2のSD（BINはCSVへ変換）・
    USB接続のUNO Q本体（eMMC）から新しいログだけを
    drive_logs/<回収日>/runNN_<時刻>/ へまとめる。元のファイルは消さない
    - 回収済みは drive_logs/collected.json で覚えて二度取らない
    - 偽データの試験2件と実物のVer.2 SDログで確認。実機での通しはER-4-1で
2026-10-14 ER-4-4: eMMCの保護は不要、削除しきい値は映像との同時運用を含めて動作状態で決める方針を記録
2026-10-14 ER-1-5: Podiumの会場は申請制で自分専用のコースは作れないことを調査・記録
2026-10-14 ER-8-1完了: ROCK 5Bを自宅試験サーバーにしてecorun-logger-serverを常駐、自前テレメトリ基盤の方針を記録
2026-10-14 ER-1-5: Podiumのイベント会場を富士スピードウェイにしてもてぎでの周回判定を避ける方針を記録
2026-10-14 ER-2-6（ロガー側）: スタート・コントロール・ゴールの3本のラインと規定周回数に対応
    - スタートライン通過で競技時計と1周目を開始（1周目を終えるまでは通過のたびに開始し直す）、
    コントロール通過で1周、ゴール通過で終了（直前のコントロール通過からを最終周として数える）
    - 規定周回数を入れると残り周回を出す。RaceTime・LapsLeftを送信・記録に追加
    - 向きが未登録のラインは、出ていくときの進行方向を覚えてその線を横切った時刻を取る
    - Web画面：3本それぞれに座標の直接入力・現在地登録、ダッシ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
2026-10-14 ER-2-6: 規定周回数があるときは最終周までゴール通過を無視（地図で置いたゴールが近すぎても早く終わらない）
    会場に入れるのは10/24朝のコースウォークだけで、それまではラインを地図上のおおよその位置で入れるため。
2026-10-14 ER-8-2・ER-8-4・ER-8-7完了: Funnelの入口、Grafanaでのライブ表示（保存→VictoriaMetrics）、eMMCへの移行
2026-10-14 ER-8-4: ライブ地図を航空写真にして車両位置へ追従、更新を0.5秒ごとに
2026-10-14 ER-9起票: 現場でUNO Qを操作する準備（手持ち電源一式・スマホ接続・コースウォーク画面、物理ボタンは大会後）
2026-10-14 ER-8-4: 地図を専用ページにして滑らかな追従・ズーム保持、行を0.1秒間隔に並べ直して約0.9秒で表示、Grafana Live送信を用意
2026-10-14 ER-8-4: Grafana Liveでの速度表示を確認（Editor権限のトークンで送信できる）
2026-10-14 ER-8-7: 元のSDを保存用にしてeMMCから起動したまま走行データ・設定を定期コピー
2026-10-14 ER-8-4: 通話画面（ecorun-logger-serverのHOLD TO TALK）をダッシュボードに埋め込み、Grafanaを/grafana/へ移す
2026-10-15 ER-9: スマホからの接続はテザリングを基本に、親機モードは保険とする方針とRemote Controlの試験を記録
2026-10-15 ER-1-6（ロガー側）: Podium送信の経路に「自動」を追加（Wi-Fiがあれば Wi-Fi、無ければ LTE）
    - 走行中はUNO QがWi-Fiにつながらないため、Wi-Fi設定のまま走ると何も送られない問題への対策
    - Wi-Fiで送信中に切れたら2秒以内に気づき、待ち時間なしでLTEへ移る（30秒はWi-Fiを試さない）
    - Wi-Fiの状態はホストの管理サービス（NetworkManager）から取る
    - 画面に「自動：今はWi-Fi／LTE」を表示。本番は「自動」にする
    - PCで試験3件を追加して通過。UNO Q実機は未反映
2026-10-15 ER-1-6: 自動切替を固める（弱い電波の検出・状態不明の扱い・切替の記録）と実機試験計画
    - Wi-Fiの通信にTCP_USER_TIMEOUT 5秒：つながったまま通らない状態でも数秒で抜けてLTEへ
    - Wi-Fiの状態が2回続けて読めなければ切れたとみなす（LTEなら困らないので安全側）
    - NetworkManagerの状態の書式が違っても、IPアドレスの有無で判断する
    - 切替の記録（GET /api/podium/events）で、Wi-Fi→LTEで途切れた秒数を測れるようにした
    - podium_auto_link_test_plan.md：実機試験A〜D（計40回超）と判定。全部通るまで本番は「LTEだけ」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
2026-10-15 ER-8-2: Funnelの公開をロガーの受け口と/healthzだけに絞る、ER-7-7起票: PR#1のスコープ拡大依頼
2026-10-15 ER-7-8（ロガー側）: 中継先の自動切り替え（予備サーバー・Podium直接への保険、pingの無応答で切替）、ダッシュボードを公開URLにまとめる
2026-10-15 ER-8-4: 通話画面のSpace長押しでページが流れる不具合を自宅サーバーで修正
2026-10-15 ER-8-4: ダッシュボードのどこでSpaceを押しても通話になるよう、Space入力を通話画面へ転送
2026-10-15 ER-8-4: デモ用に大黒埠頭→品川の走行ログを繰り返し流す常駐サービスを置く
2026-10-15 ER-8-4: デモの地図で車が約2秒ごとに止まって跳ぶのを修正（再生をGNSSのiTOW基準に、周回の折り返しで軌跡を切る）
2026-10-15 ER-10-1・ER-10-2: 地図に図形を描いてroomごとに保存・共有、見ている人の位置を任意で共有して地図に表示
2026-10-15 ER-10-4: 車にスマホを積まず専用の音声基板をCAN1（音声専用）で作る方針と帯域見積もりを記録
2026-10-15 ER-10-5: ブラウザ通話の音の荒さを修正（折り返し防止のローパス、16kHz・12kbps・60msパケット）し自宅サーバーへ反映
2026-10-15 ER-10: ロガーのLTEはテレメトリ最優先（音声で回線を圧迫しない）という制約を記録
2026-10-15 ER-10: ロガーもピットの音声を受ける要件に訂正（テレメトリより下位に置く条件つき）
2026-10-15 ER-10-6: サーバー側でブラウザ通話とロガーのroomを橋渡しし、ロガー向けに1本の6kbps・120msミックスを送る（自宅サーバーへ反映）
2026-10-15 ER-10-6: ロガー（podium.py）でピットの音声ミックスを受信し、テレメトリが遅れたら自動で音声を止める
2026-10-15 ER-10-7: OwnTracks（位置共有アプリ）から地図へ位置を出す受信口と個人用設定リンクの画面を追加し、通話をDiscordに戻す方針を記録
2026-10-15 ER-10-8・ER-10-9: Discord中継Botの本体（トークン無しの試験モードでroomとの往復を確認）と、ドライバーの声の無音判定の試作（RNNoise旧版、合成騒音で誤送信0%）、Maruo.Sさん・Lintarohさん向け相談文の下書き
2026-10-15 ER: 大会までの線引きを決定（ピット表示は自前システムを本命・Podiumは自動切替の予備、音声はピット1か所⇔ドライバーに絞り10/20夜に判定、10/22で機能追加を止める）
2026-10-15 ER: 大会の音声はドック（USB-C給電パススルー）のUSB-Aにつなぐ構成と、ドックのリセット時の自動復帰を前提に追記
2026-10-16 ER: 未反映分（ER-1-6・2-5・2-6・4-4・7-2・7-8・10-6）をUNO Qへまとめて反映、UNO Qでだけ落ちる音声中継テストの窓を修正、USBオーディオ・AP対応・.local到達を確認
2026-10-17 ER-10-4・ER-10-9: ドック経由のカメラ＋USBオーディオをUNO Qで確認（全二重の録音・再生、無音判定のC版を実時間で動作、焼き込みと同時でも取りこぼし無し）
2026-10-17 ER-10-4: USBオーディオの再生音を耳で確認（既定の音量40%では聞こえず80%で聞こえる）
2026-10-17 ER-10-4: カメラ・USBオーディオの抜き差しで、名前で探して自動的に取り直せることを確認（ドックの電源断は未実施）
2026-10-17 ER-10-4・ER-10-6・ER-10-9: ロガーでピットの声を再生し、ドライバーの声を送る経路を実装（ホスト側の音声エージェント＋podium.pyの受け渡し、UNO Q実機でエージェント単体の再生・上りを確認、中継経由は未確認）
2026-10-17 ER-10-4: ロガーでの再生がパケットの合間に無音を差し込み聞き取れなかった件を修正（ALSAの残量で判断）、耳で聞き取れることを確認
2026-10-17 ER-10-6・ER-10-9: 中継にPodiumキーが無くても送信を続けるよう変更、自宅サーバー経由でピット⇔ロガーの双方向音声をWi-Fiで確認
2026-10-17 ER-10-6: 中継経由のピットの声がロガーのイヤホンで聞き取れることを確認
2026-10-17 ER-10-6: LTEでの音声試験に着手、中継サーバーがキー無しのエラーを毎回返していた件を直して自宅サーバーへ反映（LTE試験は電波の届く場所でやり直し）
2026-10-17 ER-10-4: UNO Q内蔵BluetoothでのヘッドセットはA2DPのみ可、HFP（マイク）はチップが通話音声をHCIへ流さないため不可と判明
2026-10-17 ER-10-4: 音声エージェントをスマホのような自動切り替えに（Bluetoothヘッドセット優先・切れたらUSB、最後に使ったヘッドセットから再接続）、PipeWireの常駐設定を導入手順に追加
2026-10-17 ER-7-7: 自宅サーバーで試したものをecorun-logger-serverへ入れる方針案と、Maruo.Sさんへの相談メモ（未送）
2026-10-17 ER-8-8: Maruo.Sさん宅に大会用の予備サーバーを置く依頼と、ラズパイの機種などの質問を相談メモに追加
2026-10-17 ER-8-8: 予備サーバーは有線LAN前提にし、相談メモから有線かWi-Fiかの質問を削除
2026-10-17 ER-8-8: ピット側の切り替えの簡易案（ブックマーク2つ／入口ページ）と弱点を相談メモに追加
2026-10-17 ER-9-7: 大会用の筐体・車への固定を起票、ER-7-5のLTE試験を10/18実施予定に
2026-10-17 ER-9-7: 大会用の3Dプリント筐体の設計材料（基板寸法・部品位置・要件・未確定事項）をまとめた
2026-10-17 ER-7-7: 先輩がPR#1へ入れた実装(4482ede)に合わせて相談メモを書き直し（地図に位置を出す方法・ロガー向け音声・room）
2026-10-18 ER-10-4: Bluetoothイヤホンの自動接続・再生・切断時の切り替えを実機で確認、内蔵Bluetoothが固まった件を受けて再接続の間隔を延ばし切断を先に反映
2026-10-18 Lintarohさんへの共有メモ：UNO Qの基板の部品脱落と内蔵Bluetoothが固まった件、買い替えの相談（未送）
2026-10-18 UNO Qの切り分け試験（BTの立ち上げ直し50回・呼び出し148回・CPU/Wi-Fi/eMMCの負荷）の結果を共有メモに追記、固まった時刻を日本時間に訂正
2026-10-18 UNO Q内蔵Bluetoothの一晩の再現試験（約16秒おきの呼び出し、10/19朝まで）を開始
2026-10-18 Maruo.Sさんの回答（予備は先輩宅のラックサーバー、分散構成、Grafana不採用の方向）を一次資料として記録、4482edeではロガーの位置・音声が出ないことを確認
2026-10-18 大会の主サーバーをMaruo.Sさんのラックサーバー、自宅ROCK 5Bを予備に決定
2026-10-18 ER-11-1完了: スマホ組の2台用のAndroidロガーアプリ（GNSS・IMU・端末内CSV・サーバー送信）を起票・実装、開発環境を用意してPixel 9aへ導入
2026-10-18 ER-11-6: Pixel 9aで画面オフのまま約10時間送り続け、受信した行に欠けが無いことを確認、切断の検出を早める
2026-10-18 ER-11-6: 一晩試験の停止は電池の減りによる手動停止と訂正
2026-10-18 Ver.2をロードスター実車で走行試験：車載CAN受信は正常、LTEは車載CANが流れると約1.25フレーム/秒（CAN停止で約5.5）と原因を確定
2026-10-18 LTE実車試験の通信量（約26分で約1.32MB）を追記
2026-10-18 LTE→自宅サーバー経由をアクアラインのトンネル内で実車確認：回線登録の時間切れと応答なし切断から自動復帰、遅れ中央値約3.8秒
2026-10-19 ER-5-1・ER-5-2完了: ログ回収を大会構成に合わせて更新（Ver.1の生CAN漏れ・adbの場所・uno-q.local・スマホのMTP回収）、当日用A4手順書を作成
2026-10-19 ER-11-6: Pixel 9aの端末内CSVに欠けが無いこと、電池の減り（画面オフで約7%/時）を確認
2026-10-19 ER-11-5完了: Androidロガーをドライバーが見る横向き画面に作り直し、Ver.2と同じラップ判定・設定画面を追加
2026-10-19 ER-11-8完了: Androidロガーに取付けの向きの校正（1G校正は自動・手動、前方はGNSSで学習）と前後・左右・上下のGを追加
2026-10-19 ER-11-9完了: Androidロガーを二輪・EV二輪クラス向けに（クラス選択、二輪は走行中に1G校正）、四輪の規定も残す
2026-10-19 ER-11-9: クラスを2026年競技規則の公式名で選ぶ形に（CNG3・CN二輪・EV二輪ほか全7クラス）、画面を消さない・最大の明るさの設定を追加
2026-10-19 ER-12-1完了: can_loggerにEV二輪のMPP充電器からSOC(ID 0x402)を読むenv esp32-c3-mpp-socを追加、ER-12を起票
2026-10-19 ER-12-1: esp32-c3-mpp-soc の sdkconfig を追加（他envと同様に管理）
2026-10-19 ER-12: DINプラグの候補（千石電商 MP-132-1）を記載
2026-10-19 ER-11-10完了: Androidロガーにもてぎ（全国大会）のおおよそのライン（スタート・コントロール・ゴール）を既定値として追加
2026-10-19 ER-11-10: もてぎのオーバルは反時計回り（西側の直線は南向き）とユーザー確認
2026-10-19 ER-12: MPP充電器用の測定ハーネスの部品表（秋月版・千石版）と結線表を追加
2026-10-19 ER-12: 部品は10/20に秋月で購入予定（店頭在庫を確認）と記録
2026-10-19 ER-12: 基板側のMicro-Fit（43020・43031）も手持ちと記録、追加手配なし
2026-10-19 ER-11-11: ラインの基準をVer.2に一本化（Ver.2のWeb画面にQR、AndroidでQR読み込み・ロック・基準番号の表示）
2026-10-19 ER-7-7: PR#1マージ後のmasterでロガーの位置・音声が出ない理由を確認し、地図への位置表示とロガー向け音声ミックスの2ブランチを作成（ROCK 5Bで試験済み、入れ替えは未実施）
2026-10-19 ER-7-7: 自宅ROCK 5Bを地図表示・ロガー向け音声ミックス入りの版へ入れ替え、roomを4つ登録
2026-10-19 ER-7-7: 地図表示(#3)・ロガー向け音声ミックス(#4)のPRをチームのecorun-logger-serverへ提出
2026-10-19 ER-11-11: Pixel 9aで試験用QRの読み込み（3本のライン・基準番号・ロック）を確認
2026-10-19 ER-12: 手持ちのCANケーブルの太さはMicro-Fit端子に適合と記録
2026-10-19 ER-9-3: スマホ向けのコースウォーク画面（ポート8082・合言葉つき）を追加し、止まって登録したラインは直前3秒の平均にする
    管理画面はlocalhost専用でスマホから開けないため、ライン登録・規定周回数・
    周回リセット・スマホ組へのQRだけを持つ画面を別ポートに立てた。UNO Qは未反映。
    テザリング経由のログ回収（uno-q.local:8080）が届かない見込みの件を記録。
2026-10-19 ER-10-9: LTEで音声の上り下りを屋外で試験（下りは成立、上りは声のたびにテレメトリが約7→5件/秒でVoiceGuardが停止）
2026-10-19 ER-10-9: LTEではVoiceGuardの基準を6割にし、話しっぱなしの上りでも音声が止まらないことを屋外で確認（中継サーバーで声の約7割が捨てられる件を記録）
2026-10-19 ER-10-9: 中継サーバーで声が捨てられる件を直し、読み上げの声でLTE屋外再試験（片方向ずつなら上り下りとも全部届く）
2026-10-19 ER-1-4: 電源ONから最初のテレメトリまでを測定（155秒、うち約80秒は起動時のMCUハンドシェイク失敗と立て直し）、モデムをLTE-Mだけ探す設定に
2026-10-19 ER-1-4: 起動時の立て直しを早めて電源ONから最初のテレメトリまで155秒→99秒、Lintarohさんへの共有メモを追加
2026-10-19 ER-10-8: Discord Botを自宅サーバーで常駐させ、Discordと部屋の間で双方向に声が通ることを確認
2026-10-20 ER-10-8: Discord中継Botに/ecologger join・leave・statusを追加（呼んだ人のボイスチャンネルへ入る・部屋の切り替え・再起動後も同じ所へ戻る）
2026-10-20 ER-10-8: /ecologgerのjoin・leaveをDiscord上で確認
2026-10-20 Align SensorHub CAN TX wiring with verified RB2 hardware
2026-10-21 ER-9-3: 周回の数え方（エコラン式／サーキット式）を管理画面とコースウォーク画面に明記、新しいUNO Qの設定読み込み不具合を修正
2026-10-21 ER-9-3: 管理画面のラップ計測で「すべて保存」等の結果をボタンの横に表示（保存が完了しました／失敗の理由）
2026-10-21 ER-9-3: 管理画面のラップ計測が開いたときの古い値で上書きしないように（開いている間は読み直し、保存は書き換えた欄だけ）
2026-10-21 ER-9-2: コースウォーク画面のQRを数字のアドレスにする（Androidはuno-q.localを開けない）、新しいUNO Qに管理用の常駐を導入
2026-10-21 ER-9-2: 数字のアドレスのQRでスマホからコースウォーク画面が開けることを確認
2026-10-21 ER-11-12: Androidのドライバー画面を平均速度で出す（この周の目標平均速度＝残り距離÷残り時間、前の周の平均と目標との差）
2026-10-21 ER-2-5完了: ロードスターで3本のライン・規定4周のラップ判定を実走確認（走行軌跡から独立に計算した通過と全周一致）
2026-10-21 ER-11-12: 目標平均速度に余裕（規定時間より早くゴールする秒数、クラスごとの設定）を追加
2026-10-21 ER-11-12: 大会の設定（クラス・周回数・時間・距離・余裕）にロックを追加、ラップのリセットで自動でロック
2026-10-21 ER-11-12: 走行画面の目標の見出しが枠からはみ出すのを修正、Pixel 9aで平均速度の表示と大会の設定のロックを確認
2026-10-21 ER-11-12: 走行画面の下の2枚を「この周の目標」と「この周の平均（変動）」に変更、余裕は残り時間の欄へ
2026-10-21 ER-11-11: Ver.2のライン（基準8CDF）をAndroidアプリへ読み込めたことと、管理画面のQRが小さく読めなかった件を記録
2026-10-21 ER-11-11: アプリでスタートが取れなかった原因を調査（スタート付近でスマホの精度が悪く、ラインの中心が走行位置から8〜12mずれていた）
2026-10-22 ER-10-9: 中継サーバーの声の取りこぼし修正をPR#5として提出、Maruo.Sさんへの大会用サーバー設定の返信を下書き
2026-10-22 ARCHITECTURE: NCECのVer.2ロガー給電を常時電源＋手元スイッチ方式に決定
2026-10-22 Save current logger, UPS, firmware, and verification artifacts
2026-10-22 ER-11-12: 目標平均速度をチームの記録表と同じ計算に（各周の目標タイムまでに次の1周で取り返す、前半で取り返す速さと差を表示、平均速度を3色で）
2026-10-22 ER-11-12: 昨年のスーパーカブの走行データで、ラインの位置・周の距離（1周目が短い）・実際の余裕を確認
2026-10-22 ER-11-12: Pixel 9aで記録表方式の走行中の表示（目標・差・前半）を確認
2026-10-22 NCEC手順書1-1: 書き込み中のファームを起動メッセージで見分ける手順と各ファームの起動メッセージ一覧に差し替え
2026-10-22 ER-11-13: スマホのラップ判定でラインの取りこぼしを直す（ライン幅に測位の精度を足す、悪い測位をはさんでも前後の測位どうしでまたぎを見る）
2026-10-22 ER-11-13: スタートを取りこぼしたらコントロールラインで代わりに計測を始める（停車からの走り出しがあればスタートラインの最接近をスタートに推定）
2026-10-22 ER-11-13: 直した版の実走で、スタート（中心から18.6m横）からゴールまで3周を数えられることを確認
2026-10-22 ER-10-9: 新しいUNO Qへ音声エージェントを導入、USBオーディオを名前によらず自動で選ぶように
    - voice_agent: マイク＋再生のあるUSBオーディオを自動で選ぶ（本番のイヤホンは名前が違う）。ECOVOICE_CARDは優先指定だけ、音量つまみはSpeaker/PCM/Headphoneの順に試す
    - install-voice-agent.sh: gccの無い基板向けDockerビルドで、ビルド行が改行で割れていたのを修正
    - tools/voice_gate/precheck.sh: 有人試験の前にUNO Qの状態を読むだけで確かめるスクリプト
    - 引き継ぎ書に10/22の準備状況とT1の段取りを追記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
2026-10-22 ER-11-14: 本番で数え損ねないための備え（練習の周回が残っても数え直す、コントロール・ゴールの取りこぼしの補い、開き直し後の平均、現在地のラインは精度10m以内）
2026-10-22 ER-11-15: 走行の記録表の改良版（周の距離を実際のコースに合わせ、目標タイムを距離に比例、余裕の欄、昨年の実走での検証、CNグループⅢ）
2026-10-22 ER-4-1: 出発前の試験と合格条件、10/24・25のロガーの段取りをまとめた計画書
2026-10-22 ER-10-8/ER-10-9: ドライバーの声の音質対策、Discord Botが落ちる不具合の修正、ピットから音声設定を変える/ecologger audio
    - voice_agent: USB-Cイヤホンのマイクの29Hzのうなりで声が判定されなかったので、RNNoiseの前に低音カット（250Hz）、
    話した声に合わせた自動の増幅（目標-16dBFS、上限+30dB、音割れしないようにその場で抑える）を追加。
    ピットからの設定（b'C'）を受けて、その場で変えて保存する
    - podium.py: 中継の logger.config を音声エージェントへ渡し、答えをピットへ返す。LTEの電波品質を状態に出す（sim7070.py）
    - discor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
2026-10-22 ER-4-1: 出発前計画のT0（UNO Qのソフトがd06f7b5と一致）を記録、T5の画面オフ送信の記述を訂正
2026-10-22 ER-10-8: /ecologger audio の返事に、各値を変えると何が変わるかと変え方の例を表示
2026-10-22 ER-12-2完了: MPP充電器用の測定ハーネスを製作し、充電器のCANからSOC(0x402)を受信できた
2026-10-22 ER-12-3: MPPを載せたままでも数秒後には0x402が止まり、充電器の0x080連打に戻ることを記録
2026-10-22 ER-8-4: Grafanaを大会用の画面に（周回・経過/残り時間・平均速度を上段、地図と速度を中段、通過時刻の表、加速度と全チャンネルは下）
    - live_bridge.py: 速度を時間で積算して平均速度（スタートから・この周・前の周）を出し、
    周回の切り替わりからスタート・コントロール・ゴールの通過時刻を記録（タイム管理表への転記用）
    - grafana/build_dashboard.py: ダッシュボードの定義を生成。規定時間（分）を入れると残り時間を出す
2026-10-22 ER-8-4: Grafanaから通話パネル（ピットはDiscordに一本化）とベストラップを外し、通過時刻の表を横いっぱいに
2026-10-22 ER-8-4/ER-3: GrafanaにGNSS精度と油温（状態つき）を追加、下のパネルを小さく。ロガーはGNSS精度を常に、油温はセンサーハブがあるときだけ送る
2026-10-22 LTEアンテナ4種類の比較: 同じ基地局なら差は付け替えの揺れ（2〜3dB）以内、新しいUNO Qのroot設定スクリプトを追加
    - tools/lte_antenna/antenna_compare.py: LTEへ切替えて接続までの秒数・RSRP/SINR/RSRQ/CSQ・件数/秒・再接続を記録し表にする
    - EcoCapture-Web/setup-root.sh: 新品UNO Qの時刻合わせ・ルーター921600bps・起動サービス・監視役・ファーム書き込み
    - 結果はEcoCapture-Web/LTE_PODIUM.md（2026-10-22）とARCHITECTURE.md 4章に追記
2026-10-22 コースウォーク用: ロガーを持ち歩きながら位置とLTEの電波（RSRP・SINR・基地局番号）を2秒ごとにCSVへ記録するスクリプト
    ロガー本体のソフトは変えず、送信をLTEに切り替えて/api/podiumと/api/telemetryを読むだけ。終了時に送信設定を戻す。
    UNO Qで約1分動かし、記録と設定の復帰を確認（屋内のため位置は空欄）。
2026-10-22 ER-3/ER-8-4: UNO Qへ油温対応版とGNSS精度の送信を反映、油温の変換をセンサーハブ用に戻した。Grafanaの最終受信は測位なしでも届くIntervalで判定
2026-10-22 ER-8-4: Grafanaの加速度をG-G表示（丸い目盛り、地図の隣）に、速度グラフは下段に低く
2026-10-22 ER-9-8: コースウォークでLTEの電波を位置つきで記録する手順を手順書（3章）とタスク一覧に追加、PCから開始・回収する.cmd
    - Start-RadioWalk.cmd / Fetch-RadioWalk.cmd（radio_walk_pc.py）：adbかテザリング上のsshの届く方でUNO Qの記録を開始・停止・回収
    - 回収先はdrive_logs/日付/radio_walk/（位置を含むのでgit管理外）
    - 屋内・USBで開始→回収・送信設定の復帰を確認。屋外の位置とssh経由は未確認
2026-10-22 ER-8-4: Grafanaの読み込みが遅い件（自宅サーバーでgzip配信を有効化、画面の更新を0.5秒→2秒）
2026-10-23 大会の全体の流れ・EcoLoggerの全体像・困ったときの手順集をA4印刷用のHTMLで追加
    - ecorun_flow_20261024.html：出発前〜土日〜帰宅後の時系列、役割、試験が通らなかったときの扱い（元はecorun_final_plan_20261023.md）
    - ecologger_system_overview.html：車3台・中継サーバー・Podium・Discord・ピット画面・回収のつながりの図と、どこに何があるか
    - ecologger_troubleshooting.html：ロガー担当向け。UNO Qへの入り方、症状ごとの対処、状態を見るコマンド、UNO Qの入れ替え手順
    - URL・合言葉・パスワードは載せていない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
2026-10-23 ER-8-4: G-G表示の横Gの左右の向きをユーザーが確認
2026-10-23 ER-11-16: サーバーが30秒応答しないときだけアプリからPodiumへ直接送る保険（キーは設定画面で入力、サーバー経由と同時には送らない）
2026-10-23 ER-11-16: Podiumのキーの欄を伏せ字にせず、入れた文字と保存済みのキーが見える形に（ユーザー判断）
2026-10-23 ER-11-16: Pixel 9aから本物のPodiumへの直接送信を確認（EVのデバイスにセッションができる）
2026-10-23 ER-11-16: 記録した走行をPodiumへ流して表示を確かめる道具（キーはスマホのアプリから読み、表示もファイル保存もしない）
2026-10-23 ER-7: 大会ではPodiumへの送信をやめ、主・予備サーバーの構成だけにする判断を記録（UNO Qの直接送信の保険をOFF）
2026-10-23 ER-11-16: Podiumへの送信はやめる（ユーザー判断）。Pixelからキーを消し、もてぎのデータを流した試験の結果を記録
2026-10-23 ER-11-7: EVのドライバーのスマホ（Pixel 9 Pro XL）にアプリを入れ、部屋aubergine・EV二輪・Pixelのラインを設定
2026-10-23 ER-11-7: EVのスマホの実走（3周・ゴールまで判定、10件/秒で欠けなし）を記録、スーパーカブ用の設定を用意
2026-10-23 ER-11-7: スーパーカブのスマホ（Galaxy S10）にアプリを入れ、部屋super-cub・CN二輪・同じラインを設定。super-cubの部屋のPodiumのキーを外した
2026-10-23 ER-10-9/ER-10-8: 録音を止めると音声エージェントが固まる不具合を修正（約2時間ドライバーの声が出ていなかった）、Rust版BotでVCの声が流れない原因（PCMの部品不足）を記録
2026-10-23 ER-10-8/ER-10-9: 車内LTEでの通話の通し結果と、下りが届かない原因（中継サーバーがロガーにテレメトリを送り返していた）を記録。大会での通話は見送り
2026-10-23 ER-11-17: 車のダッシュをEcoLoggerアプリにし、位置をVer.2からWi-Fi（UNO Qが親機）で受け取る。ロガーの音声をOFF、手順書を大会構成に
    - field.py に /api/field/live（WebSocket・10Hz）を追加、UNO QのWi-Fiを親機にする install-dash-ap.sh
    - アプリ：LoggerLink（アプリ専用のWi-Fi接続、既定の回線はLTEのまま）、2秒届かなければスマホのGNSSへ切替・「ロガー未接続」表示
    - Pixel 9aで接続・LTEのまま・切替・自動復帰を確認
    - 当日手順書を起動順・確認方法・困ったとき・通話に合わせて書き直し
2026-10-23 ER-10: 自宅サーバー再起動後の確認（一時コードなし・Bot/Podiumとも切断・majestaのテレメトリは届いている）と、先輩版の変換が詰めた形式の行を捨てている件を記録
2026-10-23 ER-8: G-Gメーターを加速で下・減速で上（体で感じる向き）に変更（ユーザー指定）。数値は＋が加速のまま
2026-10-23 ER-11-17: ラインの基準違いの警告を、周回計測が始まったら出さない（ロガーが最初の通過で学習した向きをラインに書き込み、基準番号が変わるため）
    試走（サーキット式3周）でロガーとアプリの周回がミリ秒まで一致することを確認
2026-10-23 ER-11-18: ロガー⇔アプリの同期（走行前のライン自動追従・規定周回数の書き込み・リセット連動・ロガーの周回表示）と、ダッシュにクラス・数え方の方式を表示
    - field.py の /api/field/live にラインの文字列・規定周回数・ロガーの周回の状態を追加
    - アプリは周回計測が始まる前だけロガーに合わせ、計測中は何も変えない
    - Pixel 9aでリセット連動・ライン追従・規定周回数の書き込みを確認
    - 手順書：コースウォーク後に管理画面でラインの向きを固定、表示用スマホの自動同期とリセット連動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
2026-10-23 ER-8-4: Grafanaの残り時間を分:秒（39:20.11・39分20秒11など）で入力でき、余裕（秒）を差し引いた「目標まで」も出すように
2026-10-23 ER-11-18: 規定時間・余裕もアプリからロガーへ書き込み、ロガーが送ってピットのGrafanaは表示だけに（手入力欄を廃止）
2026-10-23 ER-11-18: 規定時間・余裕は大会の設定のロック中だけロガーへ書き込み、ロガーは計測開始後の変更を拒否（Pixel 9aで実機確認）
2026-10-23 ER-11-19: 自動追従でアプリが通過を取りこぼす不具合を修正し、向きの学習を本番でも安全に（スタート前のコントロール・ゴールは学習しない、スタートは最初の1周まで学び直す、リセットで学習した向きを消す）
2026-10-23 ER-11-20: 接続の確認でキャンセルした後に再接続しない不具合を修正、手順書のコースウォークをPC・管理画面の流れに書き直し「グリッドで」の確認を追加
2026-10-23 ER-8-9: ピット用Grafana・地図を主サーバー（先輩のラックサーバー）でも5Bと同じに立てる一式（Docker Compose・5Bの設定との対応表・UI変更点）と先輩への連絡文
2026-10-23 ER-8-9: 主サーバーもGrafana込みで5Bとまったく同じ構成に（ユーザー判断）。grafana.dbの中身を確認して手順に反映、Python 3.13.5固定、Caddy・nginxをFunnelと同じパスの扱いに、デモ再生をprofileで同じに、過去データの移し方を追記
2026-10-23 ER-11-20: majesta用とCN二輪用のGalaxy S10は別の端末である旨に記録を訂正
2026-10-23 ER-2-6: もてぎのコースウォークで登録した3本のラインと、走行ログから固定した向きを記録
2026-10-23 ER-11-7: majestaの表示用スマホを本番用のGalaxy A54 5Gに決め、EcoLoggerを入れて設定（CNG3・サーバー送信なし・ロガーのWi-Fi名とアドレス）
2026-10-23 ER-11-7: A54のラインがロガーと違うと出た件（コースウォークでロガーがゴール済みのまま）をラップのリセットで解消、揃ったことを確認
2026-10-23 ER-11-7: ラインの食い違いの原因の記述を訂正（前夜の試走の周回が残っていた）、ゴールとコントロールの位置関係の確認結果を追記
2026-10-23 ER-11-7: ライン配置（スタート・ゴールはピットレーン側、コントロールは本コース）をユーザーに確認、残る確認とペース計算の小さなずれを追記
2026-10-23 ER-11-7: コントロールは本番で車が通る辺りで登録済みのため、ラインの幅は30mのままとする
2026-10-24 ER-11-7: スーパーカブのGalaxy S10へ最新のAPKを入れ、ラインをもてぎの基準0115に入れ替え（サーバーの設定は変えず）
2026-10-24 ER-8-8: Ver.2の送り先を主＝先輩のサーバー・予備＝5Bに切り替え、両方のサーバーと5BのGrafanaに届くことを確認
2026-10-24 ER-11-7: EV二輪のPixel 9 Pro XLへ最新のAPKを入れ、ラインをもてぎの基準0115に入れ替え（サーバーの設定は変えず）
2026-10-24 ER-8-8: スマホ2台（super-cub・aubergine）の送り先も主＝先輩のサーバー・予備＝5Bに入れ替え
2026-10-24 ER-8-8: 11:02〜11:21のmajestaの約5分の詰まり（先輩のサーバー側で止まっていた）、11:28の約2分の切断、USBの抜き差しでV2が再起動した件を追記
2026-10-24 ER-8-10: ピット画面の経過・残り時間を端末の時計で進むページにし、「最終受信」を「サーバー到着までの遅れ」に改名、地図・G-Gの配信を描く項目だけに絞った（5Bへ反映済み）。二輪のアプリに規定時間・余裕・GNSS精度の送信を追加（端末へは未導入）
2026-10-24 ER-8-10: 二輪のスマホ2台（Pixel 9 Pro XL・Galaxy S10）へ規定時間・余裕・GNSS精度を送る版のAPKを入れた（設定・ラップの保存は変わらず）
2026-10-24 ER-8-10: 当日手順書に「3c. ピット画面の時計の確認」（スタート前の規定時間・データの古さ、ストップウォッチとの差を10分ごとに記入）と6章の対処を追加
2026-10-24 ER-11-21/ER-8-11起票: 四輪の「やめる速度／再加速の速度」の指示（明日は早見表、大会後はクラスで画面を決める1つのアプリ）と、ピットのダッシュへの記録表・惰性の指示の統合。ER-8-10の③はピットのダッシュのことと判明
2026-10-24 ER-8-10: ピット画面の周回を「1 / 3」に、規定・余裕を常に表示、ラップ・通過時刻・この周を時計と同じ押し出し方式に（約30秒遅れの対策）、G-Gを外し問い合わせ方式の欄はたたむ。欠けをまたぐ平均速度の不具合も修正（5Bへ反映済み）、今夜の試験走行の手順
2026-10-24 ER-8-10: ピット画面の文字とパネルを一回り小さく（1280×720で1画面に収まる、5Bへ反映済み）。今夜の試験はアプリ単体だけ、ピット役はドコモ回線。ER-8-11にスプレッドシート統合の予定を追記
2026-10-24 ER-8-10: ピットの時計ページで、回線の遅れが1分続くと時計の差と取り違えて経過が小さく出る件を修正（時間幅10分・端末の時計の設定し直しで測り直し・「回線」の遅れを表示、5Bへは未反映）。ER-8-9: 同期分がJSON Linesに書かれることは10/24朝に確認済みなので、手順書・先輩への文面の「未確認」を書き換え（KTR-OCTの懸念点リストA5・B3）
2026-10-24 ER-8-10: 時計ページの回線遅れ対策（15ef880）を5Bへ反映し流し直しで確認。緒方さんの懸念点リストへの返信を追加、majestaの記録を「決勝」から練習走行に訂正
2026-10-24 ER-8-10: 試験用のPixel 9aへ最新のAPKを入れた（設定・ラップは変わらず、送り先は5Bのandroid-test）。試験中はVer.2の電源を切る注意を手順書に追加
2026-10-24 ER-8-10: 試験用のPixel 9aのラインが道の駅もてぎ周辺の3本（基準75CB）であることを確認し、そのまま試験Bから始めてよい旨を手順書に追記
2026-10-24 ER-8-10: Pixel 9aでの試験走行の結果（周回・規定時間の表示は問題なし、通過から約5秒、地図が止まったのはサーバーより先）と、Ver.2でラインを入れ替えて試し元へ戻す手順を追記
2026-10-24 ER-8-10: ピットの時計ページの文字を大きくし間を詰めた、「ゴール」を目立たせた（5Bへ反映済み）
2026-10-24 ER-8-10: 通話をつないで離れた試験と機内モードの結果、ピットのページがオフラインから戻る仕組みの確認、ブリッジ再起動で通過の表を失う弱点を記録
2026-10-24 ER-8-10: ブリッジの再起動時に直近6時間の保存ファイルから周回の状態を作り直す。周回が一度に複数増えたときの平均の2倍化と、スマホのスタート判定の遅れで平均が出ない件も修正（5Bへ反映済み）
2026-10-24 ER-8-10: Ver.2のラインを道の駅もてぎの3本（基準75CB）へ入れ替えた。もてぎの3本（基準0115）の控えを3か所に取り、書き戻しの手順を記録
2026-10-24 EcoCapture-WebのPowerShellスクリプトをBOM付きUTF-8にし、Windows PowerShell 5.1で日本語の文字化けにより構文エラーになる件を直した。既定のシリアルを交換後のUNO Q（2954148814）へ変更
2026-10-24 ER-8-8: 先輩のサーバー→5Bの複製が約21時間止まっていた件。5Bのecorun-loggerを再起動、複製は先輩側から切られ続けるがVer.2は5Bへ切り替わりピットに位置が出ることを確認
2026-10-24 ER-8-8: 先輩へ複製の件を伝える文面を追加。送り先は今のまま（主＝先輩、予備＝5B）とするユーザー判断を記録
2026-10-24 ER-8-8: 今夜の試験だけVer.2の主の送り先を5Bに入れ替え（先輩のサーバー→5Bの複製が流れないため）。戻し方と、両サーバーの記録の比較を記録
2026-10-24 ER-8-12起票: ピットの地図にスタート・コントロール・ゴールのラインを描く（ユーザーの了承まで着手しない）
2026-10-24 ER-8-12: 地図にラインを描く件は大会後にする（ユーザー判断）、進め方の案を記録
2026-10-24 ER-8-10: Ver.2を本番の設定へ戻した（ラインはもてぎの基準0115、送り先は主＝先輩・予備＝5B、周回リセット）。控えと照合して記録
2026-10-24 ER-8-8: 先輩のサーバーのPodium行の警告の原因（行の形式の食い違い、ロガーは変更しない）と5B側ログの照合結果を先輩向けにまとめた
2026-10-24 ER-8-8: 先輩のサーバーと5Bの間で複製が届いているかを、両方の記録のevent_idで数える確認スクリプトを追加
2026-10-24 ER-11-7: majestaのGalaxy A54へ二輪の2台・Pixel 9aと同じ最新のAPKを上書きで入れた（設定・ラップの保存・IMU校正は前後で同じ）
2026-10-25 ER-8-8: 大会2日目はVer.2の主の送り先を5B・予備を先輩のサーバーにした（ピットの画面が5Bにあり複製に頼らないため）。5Bへ直接届くことを確認
2026-10-25 ER-8-9: 佐藤先輩向けのダッシュボード引き継ぎ資料を10/25朝の5Bの実物に合わせて書き直した（周回・時間のページ、ブリッジの動き、変更履歴、sha256照合）。送る文面を差し替え
2026-10-25 ER-8-8: 5BをPR#13のイメージで試験。複製のつなぎ直しで混ざった昨夜の行をブリッジが周回に数えたため、古い行を捨てる処理を足して5Bへ反映
2026-10-25 ER-8-8: 複製のつなぎ直しで生まれた偽の通過を検知・削除するlap_passes.pyを追加し、10/25 0〜9時のmajestaの通過を控えを取って削除
2026-10-25 ER-8-9: 10:33のブリッジの修正（複製のつなぎ直しで混ざった古い行を捨てる）と、5Bのサーバーが試しにPR#13のイメージで動いていることを、先輩への引き継ぎ資料と文面に反映（5Bの実物とsha256一致）
2026-10-25 ER-8-9: 佐藤先輩の回答（入口・ポートは先輩側で用意済み、画面の更新はまだ）と、外から確かめた先輩のサーバーの状態（Grafana 13.0.11・10/23のダッシュボード・/live/clockなし）を記録
2026-10-25 ER-11-7: 別のPixel 9aへ最新のAPK（d32d86c9…）を新規で入れ、起動を確認（設定は未入力）
2026-10-25 ER-11-7: スーパーカブの本番ダッシュをS10から別のPixel 9aへ替え、S10と同じ送信先・CN二輪・基準0115のラインを入れた（周回は0・スタート前）
2026-10-25 ER-8-8: 先輩のサーバーにmajestaが出ない件。複製はAPI上で100%届いているが、先輩のVictoriaMetricsは10:30:33（5Bのつなぎ直しの時刻）で止まっていることを記録
2026-10-25 ER-13-1完了: 大会2日目のスーパーカブの規定時間オーバー（自前の記録で16:27.56、約0.2秒超過）を記録し、今日の記録・ピットの画面を読み取りだけで保存。原因の見立てとアプリ・ピットの対策案をまとめた（端末・5B・UNO Qは変更なし）
2026-10-25 SG: SUGO 120分耐久（11/8・NCEC）向けにロガー・車載ダッシュ・インジケーター・油温油圧の基板を分解して日程を起票。Lintarohさんへの基板の相談メモ（未送）と、SUGOのコントロールライン候補（地図から）を用意
2026-10-25 SG: SUGO 120分耐久の線引きと日程がユーザー了承で確定したことを記録
2026-10-25 SG-2-1・SG-1-6: SUGOの車載ダッシュはカラーモニター1台で表示と警告を行うと決定。モニター（HD7H）とロガーの電源部品の買い物リストを記録
2026-10-25 ER-13-3・13-4: アプリとピットの時計ページに「予想ゴール（規定まで）」と「最低の平均」、超過予想の赤枠を追加（PC上だけ、本番の端末・5Bには未反映）。最終周の距離をコントロールの向きに沿って数えるよう直し、今日のスーパーカブの記録の再生で2周目から超過予想が出続けることをテストで確認
2026-10-25 SG-1-7: LTEのSIMを佐藤先輩のものから自分のSORACOM planX3へ差し替える件を起票。プラン別の料金と、注文から届くまでの日数を記録
2026-10-25 SG-1-6・SG-2-1: 電源部品を見直し。ヒューズ電源はヒューズボックスを調べてから選ぶ、手元スイッチは蓋を閉じた側をONにするカバー付きトグル、充電器は手持ちのAnker、ドックは手持ちのHDMI付き
2026-10-25 ER-13-3: 新しいドライバー画面をAndroidエミュレーターで確認（本番の端末には未反映）。今日のカブの位置を実時間で流し、周回を実際と0.3秒以内で数え直し、2周目6:40からゴール直前まで超過予想の赤枠が続くことを確かめた。再生スクリプトを追加し、気づいた点を記録
2026-10-26 SG-1-6・SG-2-1: 充電器はアドテック ACPD-V100AC（USB-C 65W＋USB-A QC3.0 18W）と判明。モニターの電源とロガーがUSB-Cの1口を取り合う件を記録（ユーザー判断待ち）
2026-10-26 SG-1-6: 充電器をUSB-C×2口へ替えると決定。2口同時の配分を確かめた候補4つを記録
2026-10-26 ER-3-5: SDのCSVに油温などCAN信号の列を付けるようにした。大会2日間の油温はSDに記録されていたが、sd_decode.pyがCANを読み解かずCSVに列が無かった。--configで車両設定を渡すとロガー本体と同じ処理で信号ごとの列を足す。10/24・25のmajestaのCSVをPC上で作り直した
2026-10-26 映像: H.264を出すUVCカメラ（ELP-USBFHD06H、IMX323）を購入。ArducamのIMX291が出品者都合でキャンセルされたため。基板は枠を割って32×32mmにし、InnoMakerのケースへ入れる予定。届いたら確かめる項目C-1〜C-5を記録
2026-10-26 SG: SUGO耐久までの日程を、買い物の到着見込み・SIMの注文・ヒューズボックスの調査を入れて更新
2026-10-26 ER-3-6: UNO Q本体（eMMC）のCSVも、CAN信号を1列のJSON（can_signals）ではなく信号ごとの列で出すようにした（PC側の実装とテストまで。本番のUNO Qへの反映はユーザーの了承待ち）。列の作り方はSDのsd_decode.pyと共通にし、各信号の単位を.meta.jsonに入れた
2026-10-26 ER-13-3・13-4: エミュレーターで気づいた3点を直した（赤枠の間は差を灰色、1周目は5秒を超える超過予想のときだけ赤枠、ゴール後は規定に対する超過・余りを0.1秒単位で）。本番の端末・5Bには未反映。今日のカブの記録をエミュレーターとPCのブリッジで流して確認
2026-10-27 KT-0: レーシングカート（KT100）用の画面付き一体型ロガーの調査資料と、11/29（富士スピードウェイ カートコース）までの分解を作成。MyLapsのループは受信専用でカート側から検知できないためGPSの仮想ラインで計り、磁気・赤外線用の入力を1本用意する。CIK-FIA技術規則2.26章によりアクセル開度・ブレーキ圧は練習専用（公式レース不可）とした
2026-10-27 KT-0-1: カート用ロガーにステアリング角を足す調査を追加。AiMと同じく柱からベルトで車体側のセンサーを回す形で、センサーは非接触の磁気式を自作する案（数千円、11/29は「できれば」・ユーザー未確認）。CIKの規則で舵角は読めない情報なので練習専用。あわせて、ロガーがハンドルと一緒に回るためIMUのGをそのまま使えない（試作0号はGNSSから計算）ことと、CIK規則の2023年版（202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
2026-10-27 KT-0-1: ステアリング角を11/29の「できれば」に入れることにした（ユーザー決定）。部品は11/5の注文に入れ、11/3の下見で柱まわりを採寸する。調査資料7章・9章、分解の前提・線引き・KT-2-1・日程、ARCHITECTURE.md 4章を更新
2026-10-28 整理: もう進めない項目を分解ファイルで「凍結」「廃止」として閉じた（ユーザー了承）。廃止はPhase1の旧プロトタイプ・旧IMU前提の7項目とダッシュカム（ROCK 5B）の12項目、ER-7-6。凍結はVer.1の機能追加（Phase6の残り）、Piの車載ダッシュ、CAN解析の深掘り、Podiumまわり、音声・Discord・位置共有、MoTeC書き出し。ER-9-7はユーザー回答によりVe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
2026-10-28 KT-2-1: カート用ロガー試作0号の部品リストを作成（kart_parts_list_20261028.md）。DigiKey・秋月・Amazonで約5.1万円（うちステアリング角が約7,700円）。マイコンは充電回路入りのAdafruit ESP32-S3 Feather、GNSSはアンテナ内蔵のSAM-M10Q（GPSだけで18Hz、調査資料の18〜25Hzを訂正）、CHTセンサーは非接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
2026-10-28 ER-3-6: eMMCのCSVの信号ごとの列を、ユーザー了承で本番のUNO Qへ反映した。本体上の試験はすべて通り、反映後の記録で列とconfig_errorが空であることを確認（ハブ未接続のため油温の値は未確認）。控えは本体.bak-20261028-er36とPC、旧イメージはecocapture-web:pre-er36
2026-10-28 KT-2-1: GNSSをu-blox M10のドローン用基板Beitian BE-250（2,894円）に替え、更新の速さを25Hzに訂正。u-bloxの資料（UBX-23006557、2023-07）でM10は設定だけでGPSだけ25Hz・GPS＋Galileo 20Hzが出るため、前版の「18Hzが上限」は誤り。部品リストの合計は約4.5万円（センサー無しの最小構成は約2.2万円を追記）。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
2026-10-28 KT-2-1: 基板は正規の店（DigiKey・Mouser・RS等）だけで買うことにした（ユーザー判断。Amazonの安い基板は偽物のチップのおそれ）。GNSSはBeitian BE-250をやめ、u-blox NEO-M9N（SparkFun 15712）＋Taoglasの25mm角アクティブアンテナ（DigiKey、計約17,100円。4種類の衛星で25Hz）に、ステアリング角のAS560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
2026-10-29 映像: H.264カメラ（ELP-USBFHD06H）を新しいUNO Qで確認。C-1・C-2・C-5合格（1080p30・720p30のH.264が/dev/video2に出て、PCで150/150コマ再生、露出を手動で固定できる）。ビットレートは解像度によらず約9.9Mbpsで変えられず、120分で約9GBと本体の空き2.7GBに収まらない。動いたままPCからドックへ差し替えると認識せず、起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
2026-10-29 SG-2-4完了: 新しいUNO QへHDMI表示のサービス一式を入れ直し、Portkeys HD7HにRaceCaptureの画面が1280×720・GPU描画で出た（電源の入れ直しで自動起動、ロガーの記録は約100Hzのまま）。公式2.19.0（SHA-256一致）とx11vnc・noVNC・websockify・日本語フォント等を入れ、Mesaは25.2.6のまま。launch.shがxr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
2026-10-29 SG-2-2・SG-3-1完了: SUGO用の車載ダッシュ（3×3：水温・油温・回転数／今の周・前周・ベスト／レース経過・時刻・周回）を起動時の画面にし、油温110/120/130℃（水温は−10℃）で黄・赤・「PIT IN」の3段の警告を付けた。RCPの橋渡しにEcoCaptureのラップ計測の値と時刻を足し、時刻は日本時間で出す。警告は値の止まった周回のチャンネルで一時的に試して確かめた（実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
2026-10-29 SG-4: SUGOでも油温の基板を使うことにした（ユーザー判断、10/28の判断期限の結論）。車載ダッシュの油温のタイルと油温の警告はそのまま残し、NCEC用の設定へ戻すとき（SG-1-2）も油温の信号を消さないことを記録
2026-10-29 SG-2-4訂正: 実物のHD7Hは真っ白で画面は出ていなかった（ユーザー目視）ため完了を取り消した。モニターは正常（メニューが出る、HDMIを抜くと信号なし）で、解像度にも画面の中身（赤一色、カーネルの文字の画面）にもよらず白いことから、原因は映像変換チップANX7625から先（UNO Qの映像出力・ドック・HD7Hの組み合わせ）と切り分けた
2026-10-29 SG-2-4: 新しいUNO QのUSB-Cの映像はHDMIドック経由だと1280×720では出ず（iiyamaで信号なし、HD7Hで白）、1920×1080・60Hzなら出ることを突き止めた（iiyamaでSUGOのページが画面いっぱいに出た、ユーザー目視）。HDMIの自動設定を1080p最優先に変えた（UNO Q上でテスト通過）。HD7Hでの1080pの映りは未確認
2026-10-29 SG-2-4: HD7HをPC（Windows）のHDMIにつないでも真っ白だった（Windowsは1920×1080・60Hzで複製して出していた）。真っ白はUNO Qではなく、HD7H側（本体の画像設定・HDMI入力、またはケーブル）の問題と切り分けた。次はケーブル交換と工場出荷状態への初期化、だめなら初期不良として扱う
2026-10-29 SG-2-4: iiyamaで映ったHDMIケーブルでもHD7Hは白く、ケーブルは原因ではなかった。HD7Hの説明書（公式、画像のPDF）から、MENUの構成・初期化（設定のSystem Reset）・メニュー外の上下ボタンで明るさが直接変わること・LUTが無いことを記録し、次に試す順を書いた
2026-10-29 SG-2-4完了: UNO Q→ドック→HD7HにSUGOのダッシュ画面が1080pで映った（ユーザー目視、HDMIの抜き差し・再起動でも自動で映る）。真っ白はHD7H本体の明るさが上がりきっていたためで、明るさを戻す／System Resetで直った。その後の「信号なし」はHDMIをつないだ直後の信号を受け取り損ねたためで、自動設定がつないだときに必ず一度出力を切ってから解像度を設定するよう直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
2026-10-29 映像: 新しいUNO Qで焼き込み試験。カメラのMJPEG 720pに重ね描きして1080pのH.264でeMMCへ保存する処理は動いた（PCで再生し、カメラの絵に重ね描きが入ることを確認）が12.5fpsで30fpsに届かない。前の基板で36fpsを出したdmabuf方式がEGL_BAD_ALLOCで失敗し、GPUからの読み出し（27〜34ms）が律速。ロガーは99Hzで影響なし。あわせてeM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
2026-10-29 映像: 新しいUNO Qで焼き込みを30fpsにした（5分間・9,000枚を31.9fpsで完走、ロガーは99〜101Hzで影響なし）。dmabuf方式が失敗していた原因は、Mesa 25.2.6がdmabufの取り込みにmodifier（LINEAR）の明示を求めることだった（カーネルの受け渡しは通る。調査用にdmabuf_probe.c・egl_import_probe.cを追加）。over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
2026-10-29 映像: 走行映像に本物の数値を焼き込む試作overlay_rec.cを作った（EcoCaptureのAPIを約10Hzで読み、車速・回転数バー・水温・油温（ダッシュと同じしきい値で色）・ラップ・Gボール・時刻をGPUで重ねる。文字はDejaVu Sans Mono Boldを画像にしたhud_font_64.pgm）。1分を29.0fpsで保存。1秒ごとにIDRを出させ、途中から切り出しても再生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
2026-10-29 映像: 焼き込みの試作overlay_rec.cを5分間（本物の数値、9,000枚）回し、28.9fpsで遅くならず完走。ロガーは98.9〜100.6Hz・SDのエラー0。温度は5分で65.9→79.0℃（上がり方は鈍化）、GPUは最大845MHzに張り付き（制限なし）で、30fpsの余裕には工程の削減が要ることを記録
2026-10-30 映像: 焼き込みの1枚あたりを約35ms→約19msに縮め（RGBの中間画面をやめてエンコーダのY・UV面へ直接描く、キャッシュの効かないエンコーダ出力を写してから読む、JPEGをGPU共有メモリへ、計器を1回で描く）、保存をカメラ時刻つきのMPEG-TSにした（10分ごとに分割、1秒ごとのUTCを.csvへ、途中で切れても再生可、1080行で出力）。カメラ無し（保存した1枚を30fpsで展開）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
2026-10-30 映像: 本体の走行記録156ファイル（10.53GB）がPCの退避先とSHA-256まで全数一致することを確認し、消す手順（消す直前に再確認する）を用意。EcoCaptureが空き1GiBを切ると古い走行記録から消すと分かったため、録画が止まる空きを1GiB→2GiBへ上げた
2026-10-30 映像・EcoCapture: 空きが足りないときに消す順番を決めた（書き終わったファイルだけ、先に動画を古い順、動画が無くなってから走行記録）。録画側は空き2GiBで前の起動の動画を古い順に消し、今回の電源ONから後の動画は消さない（本体でダミーの動画で確認）。EcoCaptureは空き1GiBで走行記録より先に書き終わった動画を消す（試験を追加、本体のイメージ内で24件通過、本体のEcoCap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
2026-10-30 映像・EcoCapture: 録画の常駐サービス（ecologger-video.service）と、空き不足時に動画を先に消すEcoCaptureを本体へ入れた（ユーザー了承。EcoCaptureは本体の版に今回の変更だけを足して組み直し、戻す用にecocapture-web:pre-videoを残した。deploy.shの試験はすべて通過）。再起動で約10秒後に録画が自動で始まり、5分間ロガ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
2026-10-30 SUGO: SG-2-1（モニター）を完了に（HD7Hは手元にあり、ドック経由で映ることを10/29に確認済み）。カメラの取付・配線をSG-2-5として起票（録画の仕組みは入れ終わり、取付が残っていたため）
2026-10-30 SUGO: SG-1-7にSIMを注文済み（10/30、ユーザー）と届いてからの手順を記録。今の先輩のSIMでもLTEが基地局への登録で時間切れになっていることを記録（差し替えの前後で同じ場所・アンテナで比べる）
2026-10-30 SUGO・サーバー: 先輩のサーバーは当面使わず自宅のROCK 5Bをメインにする（ユーザー判断）。Ver.2のLTE送信先を5Bだけにした（予備の先輩のサーバーを外した）。LTEアンテナをつなぐとSoftBankのCat-M1で登録し5Bへ送信が始まることを確認。先輩へ止めてよい旨の連絡文（maruo_share_20261030_server_pause.md、未送）を用意
2026-10-30 映像: 焼き込み録画の時刻をGNSSの時刻に合わせた（走行データのgnss_utc＋iTOWと受け取り時刻の差から各コマの時刻を直し、.csvにclock・host_utcの列を追加。GNSSが分かったら本体の時計で付けたファイル名をGNSSの時刻へ付け直す。GNSSを模したfake_telemetry.pyで確認し、録画サービスを入れ替え）。回収ツールでドックを外したUSB接続のときに動画(.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
2026-10-30 映像: 回収ツールで本体の動画を本物のUSBから吸い出せることを確認（約11GB・19本を279秒、毎秒約39MB、SHA-256一致、2回目は取り直さない）。カメラが急に外れて終わった録画も直前まで再生できた。ドックで起動したままPCへつなぎ替えてもadbは見えず、再起動が要ることを記録
2026-10-30 映像: 録画のビットレートを12Mbpsから10Mbpsへ下げた（ユーザー判断）。1回の電源ONで録れる長さが約139分から約166分（2時間45分）になる。OVERLAY_BITRATE_MBPSで変えられるようにし、録画サービスを入れ替えてエンコーダが10Mbpsで受け付けたことを確認
2026-10-30 KT-3-2-1: GNSSの載せ台基板の回路と配置の案を作った（ユーザー判断でSparkFunの基板をやめ、NEO-M9N単体を自作の40mm角の基板に載せる）
    - kart_gnss_carrier_design.md・kart_gnss_carrier_layout.svg：表にTaoglasの25mm角パッシブパッチ（CGGBP.25.4.A.02）、裏にNEO-M9N。Featherとは線5本、電池からMCP1700の3.0VでV_BCKP（次は約2秒で位置が出る）。ピン全24本のつなぎ先、部品表、アンテナの線（幅1.25・すき間0.2mm）、組み立て・確かめ方、Lintarohさんに見てほしい点
    - 部品リスト：GNSSを自作に替え、合計約4.9万円・最小構成約2.6万円に。NEO-M9NはDigiKeyに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
2026-10-30 SUGO: 当日手順書の下書き（sugo_day_manual_20261108.html、SG-5-1）と、Ver.2をSUGO用の設定へ切り替える道具（tools/sugo_setup、SG-1-2・SG-1-3）を用意した。本体へはまだ入れていない（ユーザー指示） 本体を読むと車両の信号・CAN1・LTEはすでにSUGO用で、変えるのはラップのラインだけ（エコラン会場の3本→SUGOのコン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
2026-10-30 UNO Q: 10/29夜の予告なしの再起動は、シールドのSDを読むと電源を切ったときと同じ形だった（20:17:18ごろに本体とSTM32が同時に止まり、約6.5分後に戻った。普通の再起動4回とは違い、電源OFF 2回と同じく約47秒の短いファイルができていた）。ソフトではなく電源まわりで本体全体の電源が落ちたと考えられる（ユーザー了承のうえ記録を約12分止めて読み、再開済み）。sugo_se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
2026-10-30 映像: 焼き込む計器の項目・位置・大きさ・色を設定ファイル（tools/video_hud/hud.ini）で変えられるようにした（ユーザー依頼）。Preview-HUD.cmdでPCのブラウザに見た目を出し（保存するたびに描き直し、誤りは行番号つき）、Apply-HUD.cmdで本体へ送る（送る前にPCで確かめ、録画は約1秒ごとに読み直して次のコマから反映、読めなければ前の配置のまま）。本体へ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
    元の作りと新しい作り（hud_default.ini）を本体で組み立て、5つの状態で1枚分の頂点が完全に一致。PC側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
2026-10-30 映像: 計器を設定ファイルで描く新しい録画プログラムを本体へ入れ、Apply-HUD.cmd（hud_apply.py）でhud.iniを送って「反映されました」まで確認した（ユーザー了承、配置は元のまま）
    19:17:01から新しい録画で、起動時は元の配置（hud_default.ini）、19:17:31から送ったhud.iniで描いている。入れ替え前後の録画の1コマで計器の見た目が同じ。入れ替え後104秒、録画は全秒30コマ（読み直し時もコマ落ちなし）、ロガー99〜101Hz・SDエラー0、温度約75℃。前の録画プログラムはoverlay_rec.pre-hud-20261030として残した（手順書5-14）
    Co-Authored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
2026-10-30 映像: 焼き込みの計器の重さを本体で測り（重さは数でなく塗る面積で決まる。画面1.3枚分まで毎秒30コマ、2.3枚分で27コマ、6.3枚分で13コマ。元の配置は0.3枚分で余裕）、設定から重さを見積もってPreview-HUD.cmdに出し、Apply-HUD.cmdは重すぎる設定を送らないようにした。エコラン決勝の走行記録を流す道具（replay_telemetry.py）で今のカメラの景色に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
    どの試験でもロガー96〜105Hz・SD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
2026-10-30 映像: 見る・送る用のMP4の作り方を直した（make_preview_mp4.py）。最初にVLCで作ったMP4は1コマ目がIDRなのにキーフレームの目次（stss）に入っておらず、キーフレームも約7.8秒ごとだったため、ブラウザ・アプリで最初の約8秒が止まって見えた（ユーザーが発見、Chromiumで再現）。録画の.tsは1秒ごとにIDRがあり問題ない。キーフレームを32コマごとにし、目次に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
2026-10-30 ER-14: 学園祭のデモとして、10/25もてぎ本番の3台の走行を5Bで繰り返し流すようにした（ユーザー依頼）
    demo_loop.pyが5Bの当日の記録を時刻だけ今にずらし、当日と同じ間隔でブリッジの読むフォルダ（demo-majesta・demo-super-cub・demo-aubergine）へ書く。サーバー本体・先輩のサーバーへの複製は通らない。常駐はecorun-race-demo@（有効化済み）。PCと5Bの両方でラップが当日と一致し、ループの継ぎ目でも新しいレースとして数え直すことを確認
    Grafanaにデモ用の画面ecorun-demo（ピット用と同じパネル＋「本番の再生です」の帯、車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
2026-10-30 ER-14-3: 学園祭デモの動画同期に大会のmajestaの車載動画を合わせた。最初のコマは10/25 12:15:46.6（スタートの動き出しで決め、ゴール後に止まった瞬間でも0.05秒以内で一致）。demo_video.htmlがこのファイル名を覚え、選ぶだけで時刻と車両（demo-majesta）が入るようにし、5Bの/demoも更新
2026-10-30 ER-14-3: ダッシュボード（ピット用そのもの、部屋をデモに）と動画を別のURLで開いても同期することを確認（地図と動画の差0.02〜0.05秒、ユーザー希望）。動画のページは全画面で設定欄・状態表示を隠し、動画の前後はそのコマで止めて文字を出さないようにし、5Bの/demoも更新
2026-10-30 ER-14-3: 大会の動画をダウンロードし直して名前が「taichi_eco_2026 (1).mp4」のように変わっても、名前の「 (n)」を無視するのとファイルの大きさで見分けて、時刻と車両が自動で入るようにした（5Bの/demoも更新）。公開（Funnel）がユーザーの操作で戻り、公開側から4ページとも開けることを確認
2026-10-31 ER-14-3: 動画のページで「接続が拒否されました」と出る件を直した。右側を「Grafana」にするとGrafanaの埋め込み禁止（X-Frame-Options: deny）でChromeが枠の中にそう出し、選んだ値がブラウザに残るため、選択肢からGrafanaを外し、保存済みの無い値は「周回・時間と地図」に戻すようにした。5Bから開いたときはサーバー欄も保存値を使わず常にそのページのサイ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
2026-11-03 SG-4-3: PIC v8のDefi電圧入力（CAN2 0x580、PRESS・TEMP1・TEMP2）をUNO Q側で受けられるようにした（Lintarohさんの引継ぎlintaroh_answer_20261101_defi_volt.md）。新しい換算defi_voltで1フレームを丸ごと検証し、状態（未校正・下限付近・上限付近・データ異常・通信途絶）を記録・Web画面・RaceCapt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
2026-11-03 SG-4-3: Defi電圧入力（0x580）の受信をUNO Qへ入れた（UNO Q更新済み）。EcoCaptureはUpdate-UNOQ.ps1と同じ手順をsshで、rcp_bridge.pyは/opt/logger-v2-racecaptureへ置き、defi_volt_setup.py --applyでPressVolt・Temp1Volt・Temp2Voltを登録した（信号13→16）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
2026-11-03 Publish PIC v8 Defi voltage firmware, HEX, and UNO Q handoff
2026-11-03 Sync local logger schematics and UPS investigation artifacts
2026-11-03 SG-4-3: SensorHubのPICにv8（Defi電圧入力、CAN2 0x580）を書き込み、UNO Qで約9.3 Hzの実受信を確かめた（Temp1 約2.03 V・Temp2 約2.17 V、未校正。油圧は未接続）。書く前の読み出しはv7と一致し、outputs/sensorhub_20261103_v8_flash/に退避。旧0x600は止まり、OilTempは換算ができるまで通信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
2026-11-03 SG-4-3: Defiの温度の割り当てが決まった（TEMP1＝赤黒っぽいカプラー＝水温、TEMP2＝ピンクのカプラー＝油温）。Temp1が冷却ファンの周期で約5℃分上下し、水温計の動きと時刻が合った。メーター（水温87℃・油温86℃）との1点合わせで、Defi内部の抵抗は5V仮定で約2.0〜2.3 kΩ、感度は1℃あたり約30 mV
2026-11-03 SG-4-3: Defiの油温・水温を℃でUNO Qに登録し、車載ダッシュの油温ゲージを復活させた。tools/sugo_setup/defi_temp_setup.pyで、既存の換算ntc（Defiの温度センサーの2点β式、Defi内部の抵抗2060 Ω）を使ってOilTempをTEMP2（0x580）へ差し替え、TEMP1をWaterTempDefiとして足した。油温85.5℃（油温計85℃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
2026-11-03 SG-4-3: Defiの温度の2点目（エンジン停止、水温計約71℃・油温計約72℃）を記録。2060 Ωの換算は1.5〜3℃低く、2点から出るβは資料より11〜21%大きいが、2点が近く決めきれないので設定は変えず、翌朝の始動前の外気温を3点目にする
2026-11-03 SG-4-3: Defiの油圧・温度センサーの電圧特性をネットで調べてdefi_sensor_curves_research.mdにまとめた。公式の説明書で温度1＝赤＝水温・温度2＝ピンク＝油温を確認（前日の判定と一致）。油圧は海外の実測29点がP[kPa]=250.2×(V−0.570)のほぼ直線で、個人サイトのメーター換算250×(V−0.48)と傾きが一致。温度のβは高温ほど大きく、今の設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
2026-11-03 映像: 焼き込みの計器をRaceChrono Proの動画のような配置にできるようにした（ユーザー依頼）。上の帯にベストとの速度の差・ベスト・前の周・今の周・ベストとの差（秒）、左上にコース図、下にGメーター・針の速度計・針の回転計・スロットルの弧・水温油温（tools/video_hud/hud.ini）。設定ファイルに針のメーター（dial）・弧（arc）・コース図（map）・根元から伸びる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
    ベストとの差と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
2026-11-03 映像: RaceChronoのような計器の録画プログラムを本体の録画サービスへ入れ、新しい配置（hud.ini、計器39個）を送った（ユーザー判断：SUGOの前に入れる）。前の版は/opt/ecologger-video/*.pre-v2-20261104と~/ecologger-video/hud.ini.pre-v2-20261104に残した
    入れた録画プログラムを本物の走行データで8秒動かし、新しい配置を誤りなく読んで毎秒29.9コマで描いた（カメラ未接続のため、カメラでの本物の録画はまだ）。そのとき止まっている車のGNSSのぶれがコース図いっぱいに拡大されたので、線の広がりが100m未満なら描かないようにして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
2026-11-03 SG-2-6: SUGOの車載画面をEcoCapture DASH（専用の見るだけの画面）にする準備をPCで作った。今の周・ベスト比（焼き込み録画のlap_ref.hと同じ計算）・前周と前周比・ベスト・周・リセット後の経過・時刻・記録/GNSS/油温センサーの表示。油温・水温は警告だけ（110℃黄、120℃赤い帯と音、130℃は「今の周」の枠が赤く点滅してPIT INと音。画面全体は覆わず「冷え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
2026-11-03 SG-2-6: 本体へ送るsystemdのユニットとsudoersの許可も、.sh・.pyと同じくLF改行に固定した（core.autocrlf=trueのチェックアウトでCRLFになると、本体で読めなくなるため）
2026-11-03 SG-1-5: SUGO用のピット画面（Grafana sugo-live）をPCで作った（ユーザー依頼、5Bへはまだ入れていない）。上段にラップタイムの表（laps.html：周・ラップ・ベスト差・その周の最高油温/水温/最高速・通過時刻が積み上がる、ベストは紫・遅い周は灰色、経過・残り120分・この周・前の周・ベスト・直近5周の平均・油温水温の警告）とコース全体の地図、中段にG（この周の点と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
2026-11-03 SG-2-6: EcoCapture DASHで、ふつうのピットと温度の警告を見分けられるようにした（ユーザー指摘：赤いと警報にしか見えない）。赤は「ベストより遅い」と温度の警告だけにし、ピットは青（ピットアウトの周は「今の周」の横に「ピットアウト」、ピットを通った周は前周の横に「PIT」）。ピットアウトの周と止まっている間（10km/h未満）はベスト比を出さない（ピットレーンがコースから約11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
2026-11-03 SG-2-6: EcoCapture DASHをモニター無しで本体の上で確かめ、モニターをつなぐ日の試験の準備をした。tools/sugo_setup/dash_check.pyは既定で本体へ入れずに/tmpで確かめる（本体のPython 3.13・GTK 3.24で試験15件と全状態の描画が通り、本物の走行データの値も出た。1コアの12%・63MB。outputs/dash_check_202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
2026-11-03 SG-2-7: 動画をGoProのように「走行＋章」の名前にし、消し方を「回収したか・今の走行か・保護したか」で決めるように作り直し、ネットを使わずにPCへ吸い出す回収アプリ（tools/video_collect/Collect-Video.cmd）を作った（ユーザー依頼・判断：全部SUGOの前に）。録画は<走行>_<章>.ts（10分ごと、カメラが抜けて300秒以内なら同じ走行の続き、GNS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
2026-11-03 SG-2-6: ピットロードでコントロールラインを越える前のベスト比は、ふつうの周と同じ赤い数字のまま出すことにした（ユーザー判断）
2026-11-03 SG-1-5: SUGO用のピット画面（Grafana sugo-live）を自宅の5Bへ入れた（ユーザー了承）。入れる前に新しいブリッジを5Bの上で別のポートで動かし、学園祭デモの本物のファイルでページ・通過の一覧・周ごとの最高速・Gの履歴を確かめた。~/home_telemetry/のlive_bridge.py・laps.html・map.html・gg.htmlを置いてecorun-vm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
2026-11-03 SG-4-3: Defiの温度を冷えた点（水温計36℃）で合わせ直し、本体へ反映した。旧換算（5 V・2060 Ω）は36℃で7℃低かった。Defiがかけている電圧（PICの公称5 V換算で5.612 V）と内部の抵抗（2492 Ω）の2つにし、メーターと並べた6点（水温36・70.75・88℃、油温72・85・86℃）で1.3℃以内。サーミスタの表（β3271 K）はそのまま（前に「βが大きい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
2026-11-03 SG-4-3: 新しいDefiの温度の換算を水温計32.5℃の点で確かめた（換算34.2℃、+1.7℃）。この点を足して合わせ直しても110〜130℃での違いは0.3℃以下なので、設定は変えていない
2026-11-03 SG-2-6: EcoCapture DASHで、ふつうのピットと温度のピットインを「今の周」の下の同じ大きさの札にそろえ、ベスト比・前周比に「秒」を付けた（ユーザー指摘：ふつうのピットは小さすぎ、温度のピットインは大きすぎて赤が目立ちすぎる。数字がkmか秒かわからない）。札は色だけで分ける：青＝ふつうのピット（止まっている間は「ピットイン」、動き出すと「ピットアウト」）、オレンジ＝「クーリング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
2026-11-03 SG-2-7: 新しい録画プログラム（走行＋章の名前・回収済みから消す）とEcoCapture（同じ決まりで消す・あと何分録れるか・走行記録を消すとCANの生ログも消える）を本体へ入れた（ユーザー了承。SG-2-6のlap.pyは入れていない）。録画はカメラ待ちの間にinstall-video.shで入れ替え、前の版は/opt/ecologger-video/*.pre-v3-20261104。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
2026-11-03 SG-4-3: Defiの温度の換算を、水温計32.5℃の点も足した7点で合わせた値（5.544 V・2441 Ω）へ変え、本体へ反映した（ユーザー判断：変えられるときに変える）。ずれは1.2℃以内
2026-11-03 SG-1-5: NCECをエコランカーとは別の車両（部屋ncec）にし、ピット画面を車両で分けた（ユーザー判断：ロガーの端末は同じでも車両が違う）。ピット画面の「車両」はロガーが送る中継サーバーの部屋（送り先の/ws/audio/<部屋>）なので、どの車両をどの画面で見るかをtools/home_telemetry/grafana/vehicles.pyの1か所で決め、SUGOの画面（sugo-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
2026-11-03 SG-2-6: EcoCapture DASHの単位を漢字の「秒」から「s」にし（ベスト比は数字の後ろに小さく、前周比は「前周比 +0.41s」）、札の言葉を英字にした（ふつうのピットはPIT IN／PIT OUT、120℃はCOOLING、130℃はPIT IN。「油温」「水温」は漢字のまま）（ユーザー指摘）
2026-11-03 SG-2-6: EcoCapture DASHの温度の警告を「油温120℃（水温110℃）を超えたら大きく出す」1段だけにし、ピットイン・クーリングの指示と切り離した（ユーザー判断：120℃でも相当高い、どうするかはドライバーが決める）。120℃を超えたら中段（前周・ベスト・周）が赤い帯になって「油温 122℃」を大きく出し、2音の警報を1回鳴らす（1秒続けて超えたら出て、5秒続けて下回ったら消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
2026-11-03 SG-1-5: SUGOの画面の「GPS」に、衛星数と並べて位置の誤差（±m）を出した（ユーザー指摘：衛星数だけでは分からない）。誤差はPodiumの行にpodium.pyが自動で付けているGPSAcc（NAV-PVTのhAcc）で、3m未満で緑・8m以上で赤。Ver.2のMAX-M10Mは10/25に±0.1〜0.3mと出ていてカタログ（約1.5m）より楽観的なので、急に大きくなったら受信が悪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
2026-11-03 SG-1-5: SUGOの画面の「GPS」で、まだデータが無い車両（ncec）でも「衛星数 —／位置の誤差（m） —」と項目名が出るようにした（ユーザー指摘：変わっていないように見える。データが無いとGrafanaは「—」を1つだけ出していた）。問い合わせを「… or on() vector(-1)」にして-1を「—」と表示する。on()が無いとデータがあるときにも-1が出ることをVictori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
2026-11-03 SG-2-7: 消し方をドラレコ式にした：動画と走行記録をまとめて、空きが1GiBを切ったら回収済み→ほかの古い順に消し、録画を止めずに直近を残す（ユーザー依頼。目安4時間、10Mbpsのまま）。前は録画が走行記録を消せず2GiBで止まり、今の走行も消さなかった。消さないのは書いている動画・記録中の走行記録（EcoCaptureがlogs/.recordingに書く）と書いて120秒以内の走行記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
2026-11-03 SG-1-8: Ver.2の前後・左右・上下のGを、スマホと同じ「取付の校正」で車の軸に直した（ユーザー判断：SUGOの前に入れる、校正後の値を生データと一緒に記録する）。これまではBNO055の内蔵の姿勢推定（NDOF）が毎瞬間推定した重力を引いた値をセンサーの軸のまま出していて、走行ログで調べると止まっているときは正しいが走ると±0.1G前後（減速の直後に最大0.35G）ずれていた（傾けて付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
2026-11-03 SG-2-7: ドラレコ式の消し方（動画と走行記録をまとめて古い順、下限1GiB）を本体へ入れた（ユーザー了承、11/4 07:15ごろ）。録画はinstall-video.shで入れ替えてカメラ待ち（前の版は/opt/ecologger-video/*.pre-v4-20261104）。EcoCaptureはリポジトリの最新版（別の作業のIMUの取り付けの補正は含まない）のserver.py・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
2026-11-03 SG-1-8: 取付の校正を本体へ入れた（ユーザー了承「つながったらすぐ」、11/4 07:33。本体はNCECにつないだまま、エンジンは止めてロガーの電源は入ったまま）。置いたのは今回の変更のファイルだけで、本体のそれらは変更の直前のリポジトリと同じだった（lap.pyのSG-2-6の変更は入れていない）。記録を止めてからdeploy.sh、本体の試験はすべて通過（test_imu_mount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
2026-11-03 SG-1-1完了: NCECへの常設が11/4未明に済んでいたので、分解ファイルとToDoボードの食い違いをそろえた（ユーザー依頼「ボードを直す」）。SG-1-1・SG-1-6（常設で電源も済んだ。どの回路・何Aのヒューズかは記録なし）・SG-4-2（温度の側はTEMP1＝水温・TEMP2＝油温まで済み、油圧はSG-4-3の残り）を完了にした。SG-1-8の「今の置き方は仮」を訂正し、今朝07: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
2026-11-04 SG-2-8: SUGOの車載画面（EcoCapture DASH）が動かなかったときの予備として、EcoLoggerアプリ（Android）に「サーキット」の使い方を足した（ユーザー依頼。別アプリにせず同じアプリに足した：ロガーとのつなぎ方・画面を消さない・記録の仕組みをそのまま使え、チームのスマホにもう入っているため）。画面と警告の決まりはDASHと同じで、dash_model.pyをKot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
2026-11-04 SG-2-6: 本番の車載画面をEcoCapture DASHにすると決めた（ユーザー判断、11/4）。RaceCaptureの「SUGO 120min」のページはShow-RaceCapture.cmdで戻せる控え、映らないときの予備はスマホのサーキットの画面（SG-2-8）。本体へはまだ入れていない（本体に今つながらないため。音の確認→--installの順）
2026-11-04 SG-1-4: 公道での通し確認を11/4の夜から11/5の夜へ移した（ユーザー：今夜はできない）。同じ夜にSIMの差し替え・DASH・SUGOのライン・スマホの予備を先に済ませ、本番と同じ状態で走る
2026-11-04 SG-2-6: EcoCapture DASHに油圧の警告を足し、警告を同時に出せるようにした（ユーザー判断：油圧も警告を出すべき、出し方は温度と同じ赤い帯で文字を変える、重なったら同時に出す）。油圧（OilPress、kPa）は回転数に対して低いときに出す：1500rpm未満は判断せず、1500rpmで100kPa・3000rpm以上で200kPaの線を0.5秒続けて下回ったら出て、5秒続けて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
2026-11-04 SG-2-3: 画面（HD7H）はまだ車に付いていないので、11/5の夜にほかの作業の前にカメラ（SG-2-5）と一緒に付けることにした（ユーザー：内装をそこそこ外す必要があり大変）。外すのは1回にして配線をまとめて通し、時間が足りなければカメラを先に削る
2026-11-04 SG-2-6: EcoCapture DASHの警告の赤い帯を、警告が出てから10秒だけ点滅させるようにした（ユーザー指摘：点滅の方がいい）。明るい赤と暗い赤を1秒に2回切り替え、白い文字は消さない（暗い側でも読めることを描いて確かめた、outputs/dash_pc_20261104_oilpress/warn2-dim-720.png）。10秒たったら今までどおりの赤い帯のまま止まり、新しい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
2026-11-04 SG-2-6: EcoCapture DASHの点滅を警告が出てから1分に、警告音を約5秒にした（ユーザー判断：1分あれば、警告がコースのどこで出てもホームストレートかバックストレートのどちらかを走る間に気づく。音ももう少し長く）。前の版の10秒の点滅・約2秒の音を置き換える。音は鳴りっぱなしにせず、2音の警報（1000Hz・750Hz、0.25秒ずつ）を1.5秒鳴らして0.25秒空ける、を3回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
2026-11-04 SG-2-3: 本体→ドックの間は延長しないことを書いた。手元のエレコムのType-C延長（MPA-ECC10BK 1m・MPA-ECC20BK 2m）はUSB2.0で、DisplayPort Alternate Modeの映像が通らない（公式ページで確認）。ドックは本体のそばに置いてHDMIを長くし、エレコムの延長は電源の道（充電器→ドック、充電器→WITRN→HD7H、60W）に使う
2026-11-04 SG-2-6: EcoCapture DASHの警告音を約10秒にした（ユーザー判断：10秒は鳴らした方がいい）。前の版の約5秒を置き換える。2音の警報（1000Hz・750Hz、0.25秒ずつ）を1.5秒鳴らして0.25秒空ける、を6回。設定sound.repeatの既定を6にし、dash_check.pyの案内の文も約10秒に直した。DASHの試験21件・sugo_setupの試験21件が通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
    Claude-Session: https://claude.ai/code/session_01LTAikDC8ckT2y3k3uHRom8
2026-11-04 SG-2-8: 予備の車載画面（EcoLoggerアプリの「サーキット」）をDASHの11/4の警告の決まりに合わせた（ユーザー依頼：スマホも合わせる）。油圧の警告（1500rpm未満は見ない、1500rpmで100kPa・3000rpm以上で200kPaを0.5秒続けて下回ったら）、出ている警告を赤い帯に並べる（油圧・油温・水温の順、2つなら0.75倍・3つなら0.55倍）、出てから1分の点滅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
2026-11-04 整理: タスクの置き場所をARCHITECTURE.md 5章冒頭に1か所にまとめた（Phase 0〜6・SG・KT・ER・E/V・DC・NCECの宿題の分解ファイルと状態、イベント用の分解の閉じ方、番号の付け方）。エコラン大会の分解は大会後の仕分けをし、チェック漏れの完了9件（ER-2-6・8-10・9-2・11-2〜4・11-6・11-7・11-11）に印、大会のためだけの準備6件を廃止・凍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
2026-11-04 SG-2-6: 鳴っている途中に新しい警告が出たら、EcoCapture DASHも最初から鳴り直すようにした（ユーザー判断：鳴り直した方がわかりやすい。スマホの予備画面SG-2-8に合わせた）。前は鳴り終わるまで新しい音を鳴らさなかった。鳴っているaplayを止めてから鳴らし直す。警告が消えても音は鳴り終わるまで止めない（今までどおり）。試験を1件足し、DASHの試験22件・sugo_setu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
    C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
2026-11-04 SG-2-8: 予備の車載画面（EcoLoggerアプリの「サーキット」）の油圧の警告・並べた帯・点滅をPCで確かめた（ユーザー依頼：別のセッションでマージした分を確認）。Gradleでビルドが通り単体テスト86件、test_field・test_lap 34件、test_dash_model 22件が通過。エミュレーターでPCに立てた本物のfield.pyにつなぎ、油圧70kPaの帯と警報音（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
2026-11-04 SG-2-3: 画面の配線を、HDMIを長くする方式から映像対応のType-C延長で本体→ドックの間を延ばす方式に変えた（ユーザー判断：内装の穴にUSBがあと1本しか通らず、HDMIを通すには穴を開ける必要がある）。ドックはモニター側に置く。延長はYOUZIPPER GEN2X2-2X（20Gbps）と日本トラストテクノロジー JT-31CCEX20-BK（10Gbps・細い）の2m品を2本とも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
2026-11-04 整理: CLAUDE.mdの「このリポジトリはプライベート」を「公開（public）」に直した (#3)
    ユーザー指摘：公開に変更済み。GitHub上の公開設定も確認。
    Claude-Session: https://claude.ai/code/session_01LTAikBkVUWDnofqzMAiGzx
2026-11-04 SG-2-8: 予備の車載画面のアプリがAndroid 10で起動直後に落ちるのを直した（ユーザー依頼：Huawei P30 liteに入れてみて）。USBのadbでの導入はそのまま通ったが、全画面にするWindow.getInsetsController()と設定画面の余白のWindowInsets.TypeがAndroid 11（API 30）からで、minSdk 29なのに分岐が無くNoS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
2026-11-05 SG-2-6・SG-2-8: 警告音を、2音の警報（1000Hz・750Hzの正弦波）から2500Hzの矩形波の速い連打に変えた（ユーザー判断：前の音はドキッとするが家の警報器のようでレース感がない。P30 liteで候補を聞き比べて選んだ）。1.5秒の中身を「2500Hzを0.05秒鳴らして0.05秒止める」の15回にし、0.25秒空けて6回（約10秒）はそのまま。DASH（dash_mode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
2026-11-05 SG-2-5: 焼き込み録画にレンズの歪みの補正とズームを足し、本体のモニターで録る絵を見ながら画角を決めるプレビューを作った（ユーザー依頼：広角で景色の端が曲がるので補正してズームしたい、ズームの量は車に付けてからモニターで決めたい）。補正はOpenCVのk1・k2のモデルと同じ計算をGPUの拡大の処理に足し、値は本体の/home/arduino/ecologger-video/lens.js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
2026-11-05 SG-2-5・SG-1-7: 画角のプレビューの上側で、RaceCaptureアプリの切り替えの帯（RaceCapture・EcoCapture・停止のボタン）がちらつくのを直した（ユーザー指摘）。帯（touch_launcher.py）が0.5秒ごとに自分を一番上へ出し、プレビューと取り合っていた。プレビューを開いている間は、帯・RaceCaptureアプリ・管理用のEcoCaptureをdi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
2026-11-05 SG-2-6: EcoCapture DASHを本体へ入れた（ユーザー了承「今入れて」、18:18）。入れる前に本体の上で確かめ直し（試験22件・全部の状態の描画・本物の走行データ、DASHは1コアの8%・63MBで同じ間のRaceCaptureアプリは43%、結果はoutputs/dash_check_20261105_1815/）、dash_check.py --installで今と次の電源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
2026-11-05 SG-2-6: DASHの警告音（2500Hzの連打、6回・約10秒）を音量1.0で本体のHDMIから鳴らし、HD7Hのスピーカーから聞こえることを確かめた（ユーザー確認）。USBのスピーカーは要らない
2026-11-05 Lintarohさんへの相談メモ：電源が一瞬切れると、UPSの外にあるUSB-Cドックだけがリセットされ、動いたままのUNO Qがつなぎ直しを見つけられずにモニター（DASH・警告音）とカメラがLinuxの再起動まで戻らない件（ユーザー指摘）。ドックをUNO QのUSB-Cからのバス給電にしてUPSの内側に入れる案、入力断の知らせと正しい停止・停止後にUPSの出力を切れるか、保持時間を相談する。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
2026-11-05 SG-2-5: 車に付けたカメラの画角をズーム1.41倍（位置は真ん中、歪みの値は前のまま）に決めて本体の録画へ送った。ユーザーがPCのLens-View.cmdで決め、車に付けてから本体のモニターのプレビューで確かめた（「画角的にはもう大丈夫」）。本体の値をPCのlens.jsonへ控えた
2026-11-05 SG-4: 暖機中のアイドリングで、Defiの水温（77.6℃）とECUの水温（77℃）が合うことを確かめ、油温47.4℃を記録した。あわせて、スロットル開度はIG ONの待機位置で20%、アイドリングでは11.8%と分かったのでCAN仕様に追記した
2026-11-05 SG-1-7: LTEがつながらない原因を切り分けた。屋外でも同じだったので、LTE送信を約3分止めてモデムに直接聞くと、電波は十分（CSQ 28〜31）なのに基地局に登録を断られていた（CEREG 3）。設定は前のSIMと同じなので、新しいSIMがSORACOM側でまだ通信できる状態になっていないと見ている。LTE送信はONに戻した
2026-11-05 SG-1-7: SORACOMでSIMの状態を変えるとLTEがつながり、5Bにも届いた（ドコモのBand 1）。ただし約17秒送るたびに5Bの返事が届かず切れ、約1分半に1回しか届かない。前のSIM（ソフトバンク）では同じプログラムで続けて送れていたので、回線の違いを次に切り分ける
2026-11-05 SG-1-7: LTEが約20秒で切れる件で、モデムをソフトバンクに固定しても同じだったので回線の違いではなかった（自動選択に戻した）。5Bはpingに答えている。送れる速さが前のSIMの約4分の1なので、新しいSIMの速度クラスが遅いものになっていると見て、SORACOMで確かめる
2026-11-05 SG-1-7: 新しいSIMの速度クラスはs1.4xfast（一番速いもの）だったので、速度制限の見立ては外れ。次はデータを送らずpingだけで5Bの返事が戻るかを見る
2026-11-05 SG-1-7: pingだけの試験を別のプログラムからモデムを動かして試したところ、STM32との通信が止まり、監視役のリセットで約1分後に戻った（CAN・GNSS・SDの記録が約1分抜けた。録画・DASHは無事）。EcoCaptureの横から同じ通り道で書き込むやり方はやめ、試験はEcoCaptureの中で行う
2026-11-05 SG-4-3: エンジンを切ると油温が約2500℃と出て車載ダッシュの警報が鳴る件を直した（ユーザー報告）。DefiはIGで電源が入り、ロガーとPIC v8は常時電源なので、エンジンを切るとDefiだけ電源が落ちてサーミスタの電圧が約0 Vになり、ADC 1カウントを換算すると2513℃になっていた。換算ntcが-40〜200℃の外を値なしにするようにした（記録・DASH・焼き込み・Podium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
2026-11-05 SG-4-3: エンジンを切ると油温が2513℃と出て警報が鳴る件の修正（換算ntcの-40〜200℃の外を値なし）を本体へ入れた（ユーザー了承「つながったら入れる」、11/6 01:39）。本体の試験はすべて通過、記録は自動で再開。エンジンを切っていた2分半で電圧の1カウントへの揺れは54回あったが油温は出ず、記録にも200℃超の行は無い。記録を見ると、エンジンを切ったときの電圧は約2秒で落ち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
2026-11-05 SG-2-5: 焼き込み録画に音（カメラ内蔵のマイク）を足し、Gボールの横の向きを前後とそろえた（ユーザー依頼・指摘：吸い出した11/5夜の動画で横Gが逆に見える、音を入れたい、今日入れたい）。横は「加速度の向き」、前後は「体が振られる向き」で描いていたので、hud.ini・hud_default.iniのGボールをflip_x = 1にした（記録の値は変えていない）。音はarecordの生PC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
2026-11-06 SG-2-5・SG-2-6・SG-1-3: 録画の音・横Gの向き、lap.py・field.py、SUGOのラインを本体へ入れた（ユーザー依頼：できることを進めておいて。車にモバイルバッテリーで給電、Pixelのテザリング）。音はカメラのマイクからMP2で録れはじめ（libtwolame0は本体に最初から入っていた、録画のCPUは1コアの約33%で重くなっていない）、入れたあとの章でMP2 48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
2026-11-06 SG-2-6: 本体の名前（uno-q.local）が引けないときは、IPアドレスで本体を探してつなぐようにした（ユーザー依頼。11/6に車でテザリングにつないでいる最中、IPでは届くのに名前だけ引けなくなったため、SUGOでReset-Laps.cmdが失敗しないように）。tools/collect_logs/unoq_ssh.pyで、ssh unoq→前回のIP→PCと同じ/24で22番が開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
2026-11-06 SG-2-6: ホームストレートでスピンしたときのラップとピットの判定を試し、走行会のあとでピットの判定の位置を合わせ直すことにした（ユーザーの疑問・判断）。本体と同じlap.pyにSUGOのラインで作り物のGNSSを流すと、周回数・ラップタイムはどの場面でも正しい（前向きに越えたときだけ数え、通過後は50m離れるまで数えず、60秒未満は無視）。ただし右（ピット側）の縁を80km/h以下で越える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
2026-11-06 SG-2-6: DASHの上端に回転数の帯・回転数・速度を足した（ユーザー依頼：純正のスピードメーターは当てにならない、リミッター8000rpmが純正のタコメーターの外、シフトの合図も欲しい）。AiMの10個のシフトランプを10コマの帯で描き、5000rpmから緑・黄・赤と伸びて7430rpmで全部点き、7700rpmから帯の全部が赤で点滅、7950rpmから回転数の数字も白黒反転（赤点滅はユー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
2026-11-06 SG-2-6: 回転数の帯・速度を足したDASHを本体へ入れた（ユーザー依頼「つながったら入れておいて」、11/6 14:18）。入れる前の本体のファイルはリポジトリの前の版と同じで、控えは本体の*.pre-rpm-20261106。本体で試験25件が通り、全部の状態が描けた。install-dash.shは動いているDASHを替えないのでsystemctl restartした。運転中の画面を写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
2026-11-06 SG-2: Ver.2の道具を1つの操作メニューにまとめ、デスクトップに「EcoLogger Ver.2」を置いた（ユーザー依頼：USB・テザリングで動画の吸い出し・設定・状態の確認をするショートカットが欲しい）。tools/ecologger_menu/ecologger_menu.py（Tkinter）の上の段に本体の状態（記録・受信・測位・IMU/CAN・SD・録画・空き・LTE・ラップ・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
2026-11-06 SG-2-6: ピットのPCからLTE経由でVer.2へ決まった命令を送れるようにした（ユーザー依頼：ラップの周回数の誤作動やスタートできていないときに、LTEでいじれるといい）。LTEはSIM7070内蔵の通信をATコマンドで使っているのでsshは通らない。本体が5Bの中継へつないだままの経路のlogger.config（ピット→ロガーだけに中身を見ずに渡る）に命令を載せるので、中継サーバーは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
2026-11-06 SG-2-6: deploy.shに足したtest_remote_commandの行で、行の継ぎが\nの文字のまま入っていたのを直した（このままだと本体でdeploy.shが途中で失敗していた）
2026-11-06 SG-2-5: 明るい日に走行映像の窓の外が白く飛ぶ件（ユーザー指摘）に、録画プログラムが自分で露出を決める仕組みを作った（ユーザー判断：根本的に効く方から、明日までに）。11/6の動画では明るい場面の窓の範囲の7割以上が飛び、ダッシュボードはちょうどよく写っていた（カメラ任せの露出が画面全体の平均で決まり、暗い車内に引っぱられる）。tools/unoq_overlay_enc/auto_exp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
2026-11-06 SG-2-5: 日が落ちて明るい屋外での確認が明日の朝になるため、現地で露出を切り替える道具tools/video_exposure/Exposure.cmdを作った（ユーザー依頼「それも含めて対応を考えて」）。今の状態（own／camera・露出・ゲイン・窓の明るさ）を出し、番号で「録画プログラムが決める／カメラ任せに戻す／明るく／暗く」を選んで本体のexposure.iniの該当行だけを書き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
2026-11-06 SG-1-9: 画面のGが止まっていても走っていてもガタつく件（ユーザー指摘）に、本体で低域フィルターを掛けるようにした。11/6昼の走行の記録（約80分）を本体から読み出して調べると、振動の力の85%以上が10Hzより上（アイドルは29.3Hz＝エンジンの2次、走行中は35〜48Hzで回転数と連動しない）で、100Hzの読み取りで低い周波数に化けている様子は無かった。BNO055はNDOFで加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
2026-11-06 SG-1-9: Gのフィルターを本体へ入れた（ユーザー了承「いま入れて」、18:02）。置いたのはimu_mount.py・hardware.py・sd_decode.py・test_imu_mount.pyだけで、本体のこの4つは変更直前のリポジトリと同じだった。控えはイメージecocapture-web:pre-gfilter-20261106と~/EcoCapture-Web/.bak-g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
2026-11-06 SG-1-9: 取付の校正を、毎回ロガーを付け直す使い方に強くして本体へ入れた（ユーザー依頼「水平のオートキャリブレーションはできないか、毎回付け直すと設置が微妙に変わる」・了承）。水平は以前から停車のたびに自動で取り直していたが、起動直後は前回の値に2割ずつしか混ざらず、前方は全走行の合計（重み2004）でほぼ学び直さなかった。imu_mount.pyで、起動のたびに最初に止まって揺れない2秒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
2026-11-06 SG-2-6: 操作メニューが「つながっていません」のまま読み直さなくなる件（ユーザー指摘）を直した。止まった窓は最初の読み取りで本体が見つからなかったあと、70秒見ても一度も本体へ問い合わせていなかった。同じ開き方（pythonw）で開き直すとUSBで30秒ごとに読め、本体が40秒遅れて見える場合も自動でつながった。止まった場所は、画面の外のエラーが残らない作りで、窓も閉じられていたため特定で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
2026-11-06 SG-2-5: 露出を録画プログラムで決める仕組みを本体へ入れた（ユーザー了承「つないだら入れて」、11/6 20:48）。カメラをドックにつないで起動したところをテザリングのsshで入れ、控えは/opt/ecologger-video/*.pre-ae-20261106。ELPの露出1〜5000（100µs）・ゲイン0〜100が読め、録画中に送り直しても録画は止まらない。夜の屋内のコマ数は前の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
2026-11-06 SG-1-7・SG-2-6・SG-1-8・SG-1-9: LTEが約20秒ごとに切れる件の原因を突き止めて本体側で直し、LTE経由の命令を本体へ入れて通した（ユーザー依頼「ロガーの電源を入れて車に設置した。溜まってるタスクをどんどん消化して」）。5Bの中継サーバー（チームのイメージ72ed244）がロガー自身のテレメトリ（1件約1,000バイト）をロガーへ送り返していて、本体はLTEの下りを2秒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
2026-11-06 SG-2-3・SG-2-6: DASHの文字が運転席から読めることをユーザーが確かめた（11/6夜の走行中）。HD7Hは車に付いていて走行映像にも写っているので、SG-2-3（画面の取付）を完了にし、SG-2-6の「画面に出しているときのCPU・温度、運転席から読めること」も済みにした（DASHは1コアの13%、本体58〜63℃）
2026-11-06 SG-2-5: 新しい露出の仕組みにスマホのライトを当てる・外すを約8回した結果を記録した（ユーザーが当て、録った動画の約107秒を取り寄せて3コマごとに窓の明るさを測った）。当てた瞬間は窓の平均180〜230・飛び27〜71%で、約1.4〜2秒で平均106〜124・飛び7〜8%（残りはライトそのもの）に収まった。外すと0.5〜2.5秒で元の明るさ（露出30ms・ゲイン100で頭打ち）に戻った。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
2026-11-06 SG-2-6: DASHの回転数の帯を4000rpmから点け、赤の点滅を7500rpmからにした（ユーザー判断 11/6夜：4000rpmくらいからの方が見やすい、レブリミット8000rpmの500手前で赤点滅）。前は5000・7700。1コマ350rpmで7150rpmで全部点く。7950rpmからの数字の反転はそのまま。dash_model.pyの既定だけを変え、本体に上書きの設定ファイルは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
2026-11-06 SG-2-6: 回転数の帯（4000rpmから・7500rpmから赤点滅）を本体へ入れた（ユーザー依頼「今入れて」、11/6 23:50、走行中）。本体の/tmpで試験25件が通ることを確かめてからdash_model.pyだけを入れ替えてDASHを再起動（画面が約5秒消えた）。控えは/opt/logger-v2-racecapture/dash_model.py.pre-rpm4000-202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
2026-11-06 SG-2-6: DASHの回転数の帯を30コマにして本体へ入れた（ユーザー判断 11/7：目盛りが細かい方がかっこいい。10・20・30コマを本物の描き方で並べて見比べて30を選んだ）。1コマ約117rpm、緑12・黄9・赤9（4:3:3のまま）、7384rpmで全部点き7500rpmから赤点滅。コマ数は設定rpm_segments（既定30）で、多いほどすき間を細くする。見比べ用に--rpmで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
2026-11-06 SG-2-5・SG-2-6: 焼き込みの回転数の表示を車の画面（DASH）の決まりに合わせた（ユーザー依頼）。hud.iniだけを変え、速度計・回転計の上に回転数の帯（4000rpmから30コマ、緑12・黄9・赤9、7500rpmから全部赤。棒3本を並べて黒い線でコマに分けた。点滅は無し）を足し、回転計の外周を5400から黄・6450から赤、数字を7500から赤にした（前は6000黄・7000赤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
2026-11-06 SG-2-5・SG-2-6: 焼き込みから回転数の30コマの帯を外した（ユーザー判断 11/7：DASHは車内の画角に写っていて重複する。回転計の色だけ直せばよい）。残る変更は回転計の外周の帯（5400から黄・6450から赤）と数字（7500から赤）だけ。PCで描いて確かめ、GPUの見積もりは18.7msで前と同じ、試験26件が通る。本体へはまだ送っていない
2026-11-06 SG-2-5・SG-2-6: 回転計の色をDASHに合わせた焼き込みの配置を本体へ送った（ユーザー依頼「今送って」、11/7 0:26、録画中）。本体は「反映されました」（計器39個）、本体のhud.iniのハッシュはリポジトリと同じ。録画は止めていない
2026-11-06 SG-4-3・SG-2-6: キーを切ったときに油温が197℃と出てまた警報が鳴った件（ユーザー報告 11/7 00:17）で、車載ダッシュの温度の警告（油温・水温）を「5秒続いたら」にして本体へ入れた（ユーザー了承）。Defiの電源が落ちて電圧が約1秒かけて0 Vへ下がる途中の値（132〜197℃）は200℃の上限を通り、値の鮮度の1秒と重なって120℃以上が1.03秒続き、警告（1秒）に届い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
2026-11-06 SG-2-6: USBでつないでいるのに操作メニューがつながっていない・テザリングになる件（ユーザー指摘）の本当の原因を直した。Android SDK（adb）はClaudeのアプリの中から入れたため、Windowsがアプリ専用のPackages\Claude_*\LocalCache\Localに置いていた。Claudeから動かすと%LOCALAPPDATA%\Android\Sdkに見えるが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
2026-11-06 SG-1-10: シールドのSDカードがいっぱいになると記録が止まる件（ユーザー指摘・依頼「いち早く直して」）を、ドラレコ式に古い順に消して続けるようにした（本体へはまだ入れていない、承認待ち）。今のSTM32は1MiBずつEL*.BINを作り、続いた1MiBの空きが無いとnewSDLog()が失敗し、電源を入れ直すまでSDへ書かない（古いファイルは消さない。本体のeMMCの記録とLTEは別なの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
2026-11-06 SG-2-5: 録画の音がガビガビな件（ユーザー指摘）を、カメラのマイクの音量を下げ・低音を削ってMP2の前で抑えるようにして本体へ入れた（ユーザー了承「つないだら進めて」）。原因は音が大きすぎてカメラの中で割れていたこと（11/6夜の章で7.7%のサンプルが上限に張りつき、65%の秒で割れ。音の力の9割以上が20〜100Hzの唸り）。カメラのマイクの音量（Mic Capture Volume）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
2026-11-07 SG-1-10: SDがいっぱいでも古い順に消して記録を続けるSTM32のファームを本体へ書き込んだ（ユーザー承認「書き込んで」、11/7 0:00 UTC）。56209eaの版は静的RAMが130,853バイトで、このファームが起動する限界（130,365バイトは起動、130,601バイトは黙って起動しない）を超えたため、消した本数の状態sd_deletedと画面の表示をやめ、sd_logge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
2026-11-07 SG-2-6: USBでつないだのに操作メニューがテザリングでつなぐ件（ユーザー指摘・依頼「早いもの優先に直して」）。11/7 10:25の件は、本体がドックをつないだまま起動していて、USBが「ホスト」（ドックの機器を使う側）のままだったのが原因。ドックを外してPCへつなぎ替えても「PCからつながれる側」へ切り替わらず（本体の/sys/class/udcが空、WindowsにもUNO Qの機器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
2026-11-07 SG-2-5: 焼き込みの針の動きが粗い件（ユーザー指摘「もっと滑らかにできないの？」）を、届いた値の間をコマの時刻で補間して直した（本体へはまだ入れていない、了承待ち）。原因は録画プログラムが値（EcoCaptureの/api/telemetry）を約10Hzでしか読まず、30コマ/秒のうち約3コマ同じ角度で止まってから跳んでいたこと（読む間隔とEcoCaptureの更新が揃わず2コマ・4コマ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
2026-11-07 SG-1-3: SUGOのコントロールラインをトラポのビーコンの位置へ移し、セクターのタイムを足した（ユーザー指定・依頼「V2に足して」「本体にすぐ入れられるように作り込んで」）。本体と5Bへはまだ入れていない。ラインの中心は38.1423181, 140.7779443（10/25の点は約83m手前・ピット側へ約8m）。セクターはS1〜S3の終わりの線（ユーザーがGoogleマップで指定、向き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
2026-11-07 SG-2-5: 焼き込みの針を、カメラがその絵を撮った時刻の値で描くようにした（ユーザー判断「合わせて」。本体へはまだ入れていない）。ca0277bは「今−0.1秒」の値を描いていたため、針と景色の時刻の差はカメラの遅れしだいだった（前の描き方でも差は0.03〜0.16秒でばらつき、カメラの遅れが長いと針が景色より先に動いていた）。tele_smooth.hのtsm_frameで、各コマの撮った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
2026-11-07 SG-2-5: 針の補間（ea322f5）を本体の録画プログラムへ入れた（ユーザー了承「つないだら入れて」、11/8 6:38、テザリングのssh）。置き場~/video_test/install_smooth_20261108/へ14ファイルを送り（SHA-256一致）、rootでinstall-video.sh。控えは/opt/ecologger-video/*.pre-smooth-202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
2026-11-07 SG-1-3: セクターとビーコンの位置のコントロールラインを、決勝の朝（11/8 6:47）に本体と5Bへ入れた（ユーザー依頼「いれて」）。1回目は入れる道具が直したtest_podium.pyを本体へ送っておらず、本体のdeploy.shの試験が3件落ちて入れ替えが止まった（ファイルは控えへ戻り、EcoCaptureは前のまま）。install_sectors.pyのWEB_FILESにte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
2026-11-07 SG-2-5: 針の補間を本体でカメラをつないで確かめた（ユーザー依頼「つないだら確かめて」、11/8 7:03〜7:16、SUGOのピット・アイドリング）。録画は30コマ/秒・音・レンズの補正とも動き、章の頭のパケット数・映像の誤りの出方は前の版の章と同じ、焼き込みの絵も崩れていない。journalのsmooth:はcamera_age 40ms・wait 150ms・needle_behin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
2026-11-08 SG-5-3: SUGO 120分耐久の走行解析をまとめ、道具をtools/race_analysis/に置いた（ユーザー依頼「全部まとめたレポート」「tools/に入れて」）。race_analysis.pyに大会の設定（sugo_20261108.json：ライン・決勝と予選の周・スティント・ピット・出来事の周）を渡すと、本体のCSVと5BのLTEの記録の写しから、周・セクター・油温・油圧×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
2026-11-08 SG-5-3: 走行解析にタイヤの滑り（車体の横滑り角・立ち上がりの後輪の空転・ブレーキで前輪がロックしかけた所）を足した（ユーザー依頼「四輪車速からオーバー・アンダーは出せるか」→「足して」）。四輪の車輪速だけではオーバー・アンダーは出せない（前後の滑りしか測れず、左右差から出した回る速さは前輪1.43倍・後輪0.08倍で使えない）。そこでrace_analysis.pyで、車の向き（Gyro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
2026-11-08 SG-5-3: 本体の記録のGNSSが1秒に約6回になる原因を特定した（ユーザー依頼「調べて」、読むだけで本体には触っていない）。受信機→STM32は10Hzで全部届いていて、STM32はNAV-PVTを全部シールドのSDへ書いている（10/25のSDで走っている間10.01個/秒、itowの進みの99%が100ms）。落ちているのはLinux側で、EcoCaptureのcollect（serv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
2026-11-09 SG-5-3: GNSSの解を1つ残らず本体の記録へ入れる変更をPCで作った（ユーザー依頼「作って」。本体では組み上げも書き込みもしていない）。STM32（logger_impl.h）はgnssPollが正しいNAV-PVTを受け取るたびに[受け取った時刻ms,"92バイトの16進"]を貯め、logger.takeがrows・canと一緒にnavで渡して空にする（2000文字＝約1秒分まで）。I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
2026-11-09 SG-5-3: GNSSの解を全部記録へ入れる変更を本体で組み上げて試し、RAMに収まる形へ変えた（ユーザー依頼「つないだら確かめて」。本体へはまだ書き込んでいない）。最初の形（解を別のnavの列で渡す）は静的領域130,417バイトで、起動を確かめてある130,365バイトを超えた。そこでファームは解をIMUの行と同じ形[seq,受け取った時刻,"92バイトの16進"]でrowsに混ぜ、log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
2026-11-09 lap_video: 走行映像から1周だけを切り出し、風切りを下げた公開用のMP4を作る道具を置いた（ユーザー依頼「作り方をリポジトリに残さなくていいの？」）。SUGO決勝のベストラップ（31周目 1'50.095）で、ユーザーが聴き比べて決めた音の設定（8番）を、日付と周（--best か --lap N）で使えるようにしたもの。周の数え方はtools/race_analysisと同じ（Lap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
2026-11-09 SG-5-3: GNSSの解を全部記録へ入れるファームとhardware.pyを本体へ入れた（ユーザー承認「書き込んで」、11/9 10:10〜10:20）。先にhardware.py・test_hardware.pyを置いてdeploy.sh（試験は全部通った）、今のファームのままで記録は100.0行/秒・GNSSの更新6.57回/秒と前と同じことを確かめてから、flash-mcu.shで~/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
2026-11-09 SG-5-3: Lintarohさんへの共有メモを作った（ユーザー依頼「メモを作って」、未送）。GNSSの解を10Hzのまま記録へ入れるためにSTM32のファーム（logger_impl.h）とhardware.pyを変えて11/9に本体へ入れたことの報告で、原因（EcoCaptureが状態を0.1秒以上あけて読み、最新の解1つしか渡っていなかった）、変えたこと（解をtakeのrowsに92バイ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
2026-11-09 lap_video: 11/7練習・11/8決勝のスピン・コースアウト・後ろが出た所を1本の動画にまとめる道具incidents.pyを足した（ユーザー依頼「失敗したところの反省をしたい。1本の動画の方が次々見られていい」）。記録から候補を拾い（IMUだけの横滑り角β'=回る速さ×K−横G÷速さを1.5秒で忘れる積分、9°超で後ろが出た・30°超かつ速度が半分以下でスピン、ほかの周が3m以内に1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
2026-11-09 SG-5-3: ソフトは基本こちらで作るので、Lintarohさんへの報告メモ（14dc667）を消した（ユーザー「ソフトは基本こっちでやることになってるから、わざわざ報告しなくてもいい」「全部やって」）。CLAUDE.mdの担当の書き方を直した（Lintarohさんは回路・基板・電源。UNO QのLinux側・EcoCapture・STM32のファームは基本こちらで作り、変えても報告メモは作ら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
2026-11-09 video_hud: 焼き込みの水温・油温の単位を「°C」にした（ユーザー指摘「映像で気づいた点がある。温度が℃になっていない」）。値は正しく℃だったが、文字の一覧表（hud_font_64.pgm）が英数字と記号だけで unit = C と書くしかなく、映像に 87C・108C と出ていた。一覧表の空いていた最後のマス（127番目）に「°」を描き（大きさとほかの文字は1画素も変わらない）、hu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
2026-11-09 ブレーキ圧センサーの候補（AiM M10 0-100/0-160 bar、£190）とつなぎ方をbrake_pressure_sensor_ncec.mdにまとめた（ユーザー依頼「記録して」）。電源が8〜16Vなので汎用センサーハブの5V・Defi傍受基板のJ3の3.3Vでは動かず、12Vを別に引く必要がある。J3につなぐなら4.5Vを分圧する。付ける場所と継手は車両リポジトリ側が正
2026-11-09 ブレーキ圧センサー: エンドレスにはセンサー用ブロックが単品も含めて無いと確認。別メーカー（PLOT スウェッジライン）の AN3 ポートに付けるなら AiM は -3 JIC ねじを選ぶ、と追記
2026-11-09 ブレーキ圧センサー: 付ける場所が決まった（フロントのホースと鉄パイプの継ぎ目、車体側にブロックを挟む。オーナー決定）ので未確定の表の5を更新。ばね上なので熱・振動を避けられ、線もハンドル・サスペンションと一緒に動かない。継手の細部は車両リポジトリ側
2026-11-10 ブレーキ圧センサー: AiMのM10版は先が平らで銅ワッシャーで止める形（フレアの座には付かない）、NC専用のマスター用アダプター（Mazda Motorsports 0000-03-5302）はセンサーの口が1/8NPTでNPT版のセンサーになることを3-1に追記。NPT版の電源・出力は未確認として表に足した。場所の比べは車両リポジトリ側
2026-11-10 ブレーキ圧センサー: 付ける場所がマスターの出口（Mazda Motorsports のNC用アダプター、1/8NPT）に決まったので、センサーをAiM X05PSA02000P18FW（0-2000psi＝約138bar、1/8NPT、線だけ）にした。電源8〜16V（12Vを別に引くのは変わらない）、0.5〜4.5V、-20〜135℃、$160前後。0-160barのNPT版は無いので範囲の悩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
2026-11-10 video_hud: 「°C」の録画プログラム（版3）と新しい hud.ini を本体へ入れた（ユーザー承認「つないだら入れて」、11/10 10:44〜10:50、テザリングのssh）。入れる前に11/8の版が置き場と同じこと（改行がCRLFなだけ）、本体の hud.ini が前の版（b84b25f3…）であることを確かめ、14ファイルを~/video_test/install_deg_202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
2026-11-10 Ver.2の構成図: チームに見せる用のハードウェア構成図（v2_hardware_overview.html）を作った。SUGO（11/8）を走った形で、電源の流れ（ヒューズ電源→手元スイッチ→増設シガー→2口充電器、C1→ドック→Type-C延長→UNO Q、C2→WITRN 9V→モニター）、実物どおりの積み重ね（下からUNO Q→UPS→シールド）、シールドの中身（CAN1・CAN2・G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
2026-11-10 Ver.2の構成図: 部品代の表を足した。1台分で約6.6〜7.4万円（UNO Q ¥13,400・カメラ一式 ¥12,000・充電器 ¥3,000・UPS ¥2,000・PIC ¥200〜500はユーザーから、モニター・WITRN・延長・アンテナ・SIM・スイッチは分解ファイルの記録、シールドの主な部品は秋月の値段。シールドの残りとGNSSアンテナは記録が無く目安）。UNO Qの買い替えと延長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
2026-11-10 Ver.2の構成図: ソフトウェアの図を足した（ユーザー依頼）。「ロガー本体の中のソフト」はSTM32のファーム（ecologger_v2：100Hzの取得・microSD・LTEモデムの中継・ループの見張り）→Arduino Router→LinuxのEcoCapture（本体へ記録・ラップ・LTE送信・ピットからの命令・設定画面・コースウォーク画面）、そこから値を読むDASHと焼き込み録画、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
2026-11-10 Ver.2の構成図: 「外から本体へつなぐ3つの道」を足した（ユーザー依頼：ADB・テザリング・LTEでできること・できないことをはっきりさせる）。図は3本の道（①USBのadb＝ドックを外して直結・約37MB/s、②Pixelのテザリング＝ssh・約1.4MB/s・ドックはそのまま、③LTE＝自宅の5B経由・走行中も）と、それぞれが本体のどこまで入れるか（①②はLinuxのすべて、③はEcoC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
2026-11-10 Ver.2のファームの控え: 展示会でファームを書き換える前に、SUGOを走った形の本体を丸ごと控えた（ユーザー依頼）。STM32はフラッシュ全体2MiBを止めずに2回読み出して一致（ae07eb5e…）、ロガーの領域は11/9に書き込んだ像ecologger_v2_gnss10hz_20261109.bin（e3501ec7…）と1バイトも違わず、.h・.inoのソースもリポジトリと同じ。土台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
2026-11-11 回収アプリ: 走行ログ・動画・SDカードの回収を「回収する」ボタン1つにまとめた（ユーザー依頼「道具と機能が多すぎて自分以外に扱えない」）。1回押すと、つながっているものから本体の走行記録（eMMC。Collect-Logs.cmdと同じcollect_emmcで、USBはadb -s <番号> forward、テザリングはssh -LでEcoCaptureへ届く）・本体の動画（USBのときだけ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
2026-11-11 回収アプリ: 二重に開くと同じ番号で2つ待ってしまう不具合を直した（ユーザー「SDカードを挿したけどうまく回収できない」）。SUGOのSDカード（1413本）を回収している最中に回収アプリをもう1つ開いていて、Windowsでは2つ目も同じ8791番で待てるため、画面の読み込みやボタンが回収していない方へ届くことがあった。回収そのものは1つ目で続いていた（1本ごとにBINを写してCSVへ直すので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
2026-11-11 Ver.2の操作メニュー: ふだん使うものだけが見える形にした（ユーザー依頼「道具と機能が多すぎて自分以外に扱えない」）。窓に出すのは本体の状態・「走行ログ・動画を回収する」（大きいボタン）・HDMIの画面の切り替え・ラップを0周に戻す・回収したものを開く・LTEで状態を聞く／ラップを0周に戻す・メモだけ。焼き込みの計器・レンズ・露出、LTEの電波のコースウォーク、LTEのほかの命令（周回数を直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
2026-11-11 SDカードの目次の化けの原因を記録: STM32のsd_logger.hのnewSDLogが、目次を2つ目の区画へ伸ばすとき、先に取っておいた次の記録の1MiBの頭の区画を選んでしまい（FATに印を付ける前に探すため）、記録のデータが目次を上書きする。SUGOのカードでは1022番目の記録（約103秒、止まっていたとき）の目次の項目が消え、目次が33区画になり、以降の項目は消えた記録の中へ書かれ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
2026-11-11 STM32のSD: 目次が1区画を超えるとき、新しいファイルの区画を目次に使ってしまう不具合を直した（ユーザー依頼「直して」）。newSDLogは目次に空きが無いと1区画足すが、先に取っておいた新しいファイルの1MiBの頭（FATにまだ印が無い）を選んでいたため、目次とファイルが同じ区画列になり、ファイルのデータが自分の項目を上書きしていた（SUGOのカードの1022本目、32KB区画で約102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
2026-11-11 STM32のSD: 目次の修正を本体で組み上げた（書き込みはまだ）。本体のソース・組み立て結果には触らず/tmp/sdfixへ写してsd_logger.hだけ差し替えて組んだ。像59,836→59,892B、静的集計130,337→130,349B（起動を確かめた130,365Bより下）。組んでいる間も受信約100Hz・記録中・STM32のリセット0回。README・ARCHITECTURE.m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
2026-11-11 STM32のSD: 目次を直したファームを本体へ書き込んだ（ユーザー承認）。今動いていた像（e3501ec7…）は直す前のソースを組み直すと1バイトも違わず一致し、修正で増えるのは48バイト（静的集計130,301→130,349B、起動を確かめた130,365Bより下）。本体のsd_logger.hを差し替え（前の版は~/sd_logger.h.pre-sdfix-20261111）、buil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
2026-11-11 STM32のSD: 目次が2区画目へ伸びるところを実機で確かめた。回収アプリのSDのフォーマットの不具合2つも直した（ユーザー依頼「確かめて」）。SUGOのカードは1413本がPCの写しと一致することを確かめてからフォーマットし、目次の1区画目を空きが1つになるまで埋めて本体で記録した。EL000002で目次が伸び、EL000004の途中まで受信約100Hz・リセット0回。PCで読むと目次は区画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
2026-11-12 SG-5-3: 回収したシールドのSDカードのGNSSの解（10Hz全部）で、SUGO 11/8の解析をやり直した（ユーザー依頼「SDカードから回収したデータを使ってもう一度解析して、解析の内容が変わるなら教えて」）。11/9の修正より前の本体の記録は位置が1秒に約6回しか変わらないので、tools/race_analysis/sd_gnss.pyでSDのNAV-PVTを全部読み、本体のCSVの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
2026-11-12 SG-5-3: SUGO 11/8の解析レポートをSDカードのGNSS（10Hz全部）の版へ差し替えた（ユーザー「差し替えて」）。変わった9つの表を上げ直し（油圧・水温は同じ）、ページの文も合わせた：題の下にGNSSの位置・速さはSDカードの記録と書く、ロガーの採点の「記録の位置」を本体の記録では1秒に6.14回だったのをSDの解で置き換えた（行の99.7%、10回/秒、要確認→良）に、まとめの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
2026-11-12 Ver.2の仕様書の下書きSPEC.mdを作った（ユーザー依頼「現状の要求に見合った仕様書を1本にまとめ、そこからアプリの構成を見直す」）。役割と場面ごとの要求に「誰でも／開発者」と今の状態を付け、守る決まり・入口を場所ごとに1つにする方針・今の道具の仕分け案・決めてほしいこと9つを書いた。道具・本体は変えていない。ARCHITECTURE.md冒頭と4章、CLAUDE.mdから案内
2026-11-12 SPEC.md: ユーザーが決めた7つを反映した（解析まで誰でも、車・コースは現地で係も切り替える、エコランはVer.2＋スマホの画面、動いている印を車載画面の隅に常時、動画は走行ごとに1か所、ピットの値が止まったときの見え方、公式のRaceCaptureアプリは外す）。入口の分け方を「本体が出すページ＋PCのアプリは回収と解析だけ」の案に直し、PCのアプリを1回の操作で入れる要求S-6と録画の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
2026-11-12 SPEC.md: 入口の形を決めた（ユーザー「まずPCからだけでいいよ、その方向で直して」）。入口は手元の機器に置きロガーとつながっていなくても開く（6章の要求に追加）。スマホは自宅のサーバーのページでLTEの道だけ、PCはEcoLoggerアプリがUSB→テザリング→LTEを自分で探す。本体が出すページは入口にしない。車・コースの切り替えはまずPCからだけでLTEの命令は増やさない。道具の仕分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
2026-11-12 SP-0完了: 仕様書に合わせた作り直しの分解task_spec_rebuild_breakdown.md（SP-x）を起こした。SPEC.mdは録画の長さをドラレコ式の消し方（5-18、止めずに回収済み→ほかの古い順）に書き直して未決を無くした（ユーザーの指摘で確かめた）。ARCHITECTURE.md 4章・5章の表、CLAUDE.mdから案内
2026-11-12 SP-2: コミットされていなかったoutputsの確かめの記録（DASHの画面4回分・回転計の区切りの比較・焼き込みの回転計の色、画像50枚とresult.txt 2本）を取り込んだ。車内で録った音の聴き比べ outputs/audio_check_*/ は人の声が入りうるので .gitignore へ（ユーザー了承）
2026-11-12 SP-2-2完了: 開発・調べもの用の道具5つ（race_replay・podium_replay・unoq_spi_sd_test・lte_antenna・can1_loss）をtools/dev/へ移した（git mv。can1_lossは未コミットだったものを新しく入れた）。参照している資料8本のパス、操作メニューの電波の2つのボタン、radio_walk_pc.pyのリポジトリの位置を合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
2026-11-12 SP-2-3完了: 通話の道具をarchive/voice/へ（tools/voice_gate・tools/discord_bridge・handoff_20261020_voice_field_test.md）、エコランの記録表をecorun/record_sheet/へ（tools/record_sheetとecorun_record_sheet_20261024.xlsx）移した（git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
2026-11-12 SP-2: 人に渡したメモとその回答38本をdocs/share/へ移した（git mv。hardware_share/ans、lintaroh_share/answer、maruo_share/answer、ogata_share、会議の道しるべ、Lintarohさんがpushした9月の引継ぎ8本とDefi電圧の引継ぎ。未コミットだったlintaroh_share_20261104_can1.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
2026-11-12 SP-2: 直下の資料41本を種類ごとのフォルダーへ移した（git mv）。仕様・設計13本はdocs/design/、手順書10本はdocs/manual/、調査13本はdocs/research/、閉じたダッシュカムの資料4本はarchive/dashcam/、MPLABXLog.xmlと名前が「-」だったKiCadのDRCの報告はarchive/へ（後者はlogger_v1_drc_rep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
2026-11-12 SP-2-1完了: リポジトリの表紙README.mdを、いまの姿（Ver.2が本番機、Ver.1は保険機、カート用は準備中）と、使う人・チーム・開発者それぞれの資料への案内、フォルダーの一覧に書き直した
2026-11-12 SP-2-4完了: 本体のソフトの仕分け一覧docs/design/unoq_software_inventory.mdを作った（RaceCapture-UNOQ/とEcoCapture-Web/を、いま動いているもの・公式アプリ用・通話・試験・古い候補に分け、公式アプリを外すときに気を付ける所を書いた。ファイルは動かしていない。根拠はリポジトリの中だけで、本体で有効かどうかは要確認と書いた）。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
2026-11-12 SP-2: ARCHITECTURE.mdを読みやすくした（ユーザー了承のA案。4章の既存の記述は1字も変えていない）。冒頭に章ごとの読み方の表、1〜3章の見出しに「Ver.1の構想」、6章・7章にVer.1の頃の一覧という追記、4章の頭に「いまの姿」（機体・Ver.2で動いているソフトと置き場所・何を見ればよいか・ファイルの場所の読み替えの表）と今回の置き場所の整理の要約、8章にファイルの置き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
2026-11-12 SP-2: CLAUDE.mdの「ファイル構成」をフォルダーごとの短い案内に書き換えた（ユーザー了承。約29KB→約8KB）。資料1本ごとの説明はdocs/README.mdへ、道具ごとの説明はtools/README.mdへ文面をそのまま移した（欠けた行が無いことを照合）。毎回守る注意はCLAUDE.mdに残した。表紙README.mdから2つの案内へのリンク、ARCHITECTURE.md 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
2026-11-13 SP-1完了: SPEC.md 4章の「いま」をソースと本体の控えで確かめ直し、下書きを外した。本体で有効なサービスの一覧をunoq_software_inventory.md 4章に足した。ユーザー決定「RaceCaptureから離れる」（公式アプリ・RCP・公式のPodiumへの送信を外す、名前も順に外す、系譜は記録に残す）をSPEC.md 9-1と分解のSP-9に入れた。調べて分かった足り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
2026-11-13 SP-9-8完了: GitHubのリポジトリ名をRaceCaptureからEcoLoggerへ変えた（ユーザー決定）。このPCのリモートと引き継ぎ資料の取り寄せ方を直した。このPCのフォルダー名は変えていない（SP-9-9で決める）
2026-11-13 SP-9: このPCのフォルダー名を変える手順docs/manual/rename_local_folder.md（未実行）、Codex向けの入口AGENTS.md、Lintarohさんへの連絡docs/share/lintaroh_share_20261113_repo.md（未送）を作った（ユーザー依頼）。docs/README.md・CLAUDE.md・分解ファイルから案内
2026-11-13 SP-9-9完了: このPCのフォルダー名をEcoLoggerへ変えた（実行はユーザー）。通り道・記憶・ショートカット・リモートを確かめ、作業用の写しの登録を直した。手順書につまずいた点（メモ帳・Claudeの終了の仕方・worktree repairは場所を名指し）と結果を書き足した
2026-11-13 操作メニューの試験1件が、PCに実物のadbの機器が見えていると本物を探しに行ってエラーになるのを直した（usb_appearedを差し替え）。フォルダー名の手順書の結果を正しく書き直した（試験が通ると書いたが1件エラーだった。名前の変更とは関係ない）
2026-11-13 SP-3-1: PCのEcoLoggerアプリを1つにまとめる案の見本docs/design/ecologger_app_mock.htmlを作った（動かない。数字と走行は例）。つながりの帯と4段（いまの様子・回収・走行を見る・設定）、場面を5つ切り替えられる。ユーザーの感想待ち
2026-11-13 SP-3-1: 見本へのユーザーの感想を反映した。車・コースの切り替えはLTEでもできるようにする（命令を1つ足す。本体に入れてある設定の名前を選ぶだけ）、周の動画を切り出さずに見る・動画が無い区間の出し方（A-2）、解析ソフトへの書き出し（A-5、形式は調べてから）、回収のあと本体の動画は消さない前提で消すボタンは残す（C-4）、コントロールラインをピットの地図とPCのアプリで見せ、ラインを持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
2026-11-13 SP-3-1: 見本の画面に感想の6点を入れた（前のコミットは見本の書き換えが走っておらず、仕様書と分解だけだった）。周の動画を見る・切り出す、動画の有無と無い区間の理由、解析ソフトへ書き出す、回収済みを本体から消す、コントロールラインの図と地図・引き直し、LTEでの車・コース選びの注記
2026-11-13 SP-3-1: 見本を2回目の感想で直した。ラインは場所・幅・進む向きで決めて画面で引き直す（T-5、SP-4-10）、車・コース・ラインを変えると見出し・設定・図が読み直した値に変わる、走行中は断って理由を出す（SP-4-11）、本体から消すときもバー、周の表から油温・水温を外して最高速と警告の印に。SPEC.mdに操作の決まり7-5を足した。見本はブラウザで押して確かめた（ローカルで開くと全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
2026-11-13 SP-3-1: 見本を3回目の感想で直した。変更を断るのは車速で決める（線はコースごとのレーシングスピードより遅ければ受け付ける＝SUGOは100km/h、車・コースは止まっているときだけ）、コントロールラインとセクターの線を全部、航空写真の上に本当の幅と向きで重ねる（全体と線ごとの拡大、引き直すときも同じ写真の上）。SPEC.md 7-5・T-5、分解のSP-4-10・4-11を直した。見本は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
2026-11-13 SP-3-1: 見本の線のエディターを強化した（ユーザーの感想）。線を足す・消す・1本目を引く、役目（コントロールライン／スタート／ゴール／セクター）、数える向き（一方向／両方向）、写真の上でつまんで動かす、北南東西へ1cm・10cm・1mずつ動かす。LTEでの線の変更は断らず、変わる所を見せて4桁を入れる確認の手順で通す。写真の位置の正しさは走った跡で測って決める（SP-4-12）。SPEC.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
2026-11-13 SP-3-1: 見本の線の役目とそろい方を本体の持ち方に合わせた（コントロールラインが1本、スタートとゴールはあれば1本ずつ。前の版は「コントロールラインとスタート・ゴールは一緒に使えない」としていて本体と食い違っていた）。SPEC.md T-5と分解SP-4-10の文も直した
2026-11-13 SP-4-12: 航空写真の位置の正しさをSUGOの走った跡で測った（1回目）。国土地理院は東西に約2m、Esriは約4〜5mのずれで、SUGOでは国土地理院のほうが合っている（色で舗装を見分ける粗い方法、1か所だけ）。道具tools/dev/imagery_check。あわせて線の変更の決まりを改めた：車速で断らず、LTEのときとレーシングスピード以上のときは確認の手順を増やす（車・コースの切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
2026-11-13 SP-3-1: 車・コースの切り替えも断らない形に改めた（ユーザー決定。前のコースの設定のまま走り出したときに、ピットからすぐ直して次の周から正しいラップタイムを取るため。ラップタイムを正しく取ることを優先する）。LTEのときと車が動いているときは、切り替える所を見せて4桁を入れる。コースの切り替えは記録を止めず、車の切り替えは走行記録のファイルが分かれることを出す。見本・SPEC.md 7-5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
2026-11-13 SP-4-13: ほかのアプリ・公開の一覧にあるコースの線の座標を調べた。SUGOで見つかったのはAiM由来の1系統で、こちらの線より進む向きに21.8m手前・横に1.5m。配ってよいと読める形で線の座標を公開している出どころは見つからず（OpenStreetMapはコースの形だけ、AiM由来は条件未確認、RaceChronoは規約で不可、Podiumの一覧はいま取れない）。分解に結果と方針の案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
2026-11-13 SP-4-13: はじめから入れておくコースの線は自分たちで引いたものにし、ほかの一覧は照合と場所の目安にとどめる（ユーザー決定）。SPEC.md 7-5と分解に書いた
2026-11-13 SP-6-1: スマホで開くピット用の入口の見本docs/design/ecologger_phone_mock.htmlを作った（動かない。数字は例）。つながり・タイム・車の様子・見る画面への行き先・合言葉を入れた人の操作。値が届かないと数字が薄くなり何秒前かを出す。スマホの幅で横にはみ出さないこと、操作の流れをブラウザで確かめた
2026-11-13 SP-6-1: スマホの入口の見本に、線の引き直し（ユーザー決定：スマホでもできるように）と、作り込んだ合言葉の画面を入れた。合言葉はQRを読むか手で入れ、ロガーに状態を聞いて返事が来るかで確かめてから覚える。PCのアプリの見本に「スマホへ合言葉を渡す」を足した。SPEC.md（入口の表・操作の決まり）と分解SP-6-1・6-3に書いた。ブラウザで押して確かめた
2026-11-13 SP-3-1・SP-6-1: 線のエディターに写真の寄り引き（＋・−、PCはホイールも）と移動（何も無い所をつまむ）、「線に合わせる」を入れた（ユーザーの指摘：倍率を変えられなかった）。PCとスマホの見本の両方。ブラウザで確かめた
2026-11-13 SP-3-1・SP-6-1: 線のエディターに2本指でつまむ寄り引きを入れた（PC・スマホの見本。つまんでいる途中で写真の入れ物を作り直さないようにした）。画面の棲み分けをSPEC.md 7-6に書いた（表紙＝いまの要点と操作と入口、周回表＝周ごとの記録、グラフ＝時間の流れと大きい画面用、PCのアプリ＝準備・回収・見返す・設定）。ちょっとした操作はLTE経由が主な道になる見込みを分解の順番に書いた
2026-11-13 SPEC.md 7-6: 画面の棲み分けをユーザーが決定（案を外した）
2026-11-13 SP-6-1・SP-6-3: ピットの表紙（スマホで開く入口）の実物を作った。tools/home_telemetry/home.html と、live_bridge.py の表紙用の出口（/home・/、/ws?kind=home）。値と古さの表示、合言葉を確かめて覚える、今ある5つの命令をLTEで送る（署名はブラウザの中、4桁の確認は走っているときだけ）。PCの中で作りものの車と中継（dev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
2026-11-13 SP-6-1: ピットの表紙を自宅のサーバーへ入れた（ユーザー了承）。前の版を控え、別の口で試してから置き換えてブリッジを立ち上げ直した。今あるページは変わらず動き、公開のアドレスでデモの部屋の値で表紙が動くことを見た。本物のロガーとLTEでの合言葉・命令は未確認
2026-11-13 SP-6-3: PCからスマホへ合言葉を渡すQRを作った。tools/remote_command/phone_key.py（操作メニューの設定・調べものから開く）、QRの絵は自前の qr.py（合言葉を外へ渡さない）。合言葉の作り直しは setup --new。表紙は、前に覚えたものと違う合言葉が来たら確かめてから入れ替える。PCの中で確かめた（絵の突き合わせ・読み戻し・表紙の受け取り5通り）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
2026-11-13 SP-6-3: 表紙の直し（前と違う合言葉がQRで来たら確かめてから入れ替える）を自宅のサーバーへ入れた（ユーザー了承）。home.html だけ、前の版を控えた。ブリッジは止めていない
2026-11-13 SP-3-2完了: 本体とのつなぎ方を1つの部品にした（tools/collect_logs/unoq_link.py）。USB → テザリングの順に自分で探し、つながらない理由と直し方を返す。SUGOの道具・計器の配置・露出・レンズ・DASHの確かめ・操作メニューを切り替えた（--adb を付けなくてもUSBがあればUSB）。dash_check がテザリングでファイルを取るときにつなぎ先を付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
2026-11-13 SP-3-3完了: PCのアプリに「いまの様子」の段を作った。回収アプリを母体に、つながりの帯と段の切り替え（いまの様子・回収）を足した（入口は tools/video_collect/EcoLogger-App.cmd、今までの Collect-Video.cmd は回収の段で開く）。ロガーが無くてもすぐ開き、裏で USB → テザリングを探し続け、つながると記録・測位・SD・録画・LTE を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
2026-11-13 SP-3-4完了: PCのアプリの「いまの様子」に操作を載せた（tools/video_collect/app_ops.py）。ラップを0周に戻す（つながっていれば直接、いなければLTE）、LTEの命令5つ、合言葉の準備・作り直し、スマホへ合言葉を渡すQR。操作の決まり（SPEC.md 7-5）の共通の部品＝同じバー・読み直した値・使えない理由を出す・LTEで変える操作は4桁の確認。試験8件を足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
2026-11-13 SP-3-5完了・SP-9-1/9-2完了・SP-5-5調査・SP-3-10一覧: 回収の結果を「取れたもの・取れなかったもの・次にすること」で出し、回収していないものが本体の入れ替わりで消えそうなときの知らせとUSBでつなげない本体の案内を入れた（試験4件追加、41件通過）。資料3本：RaceCaptureからの系譜とVer.2のコードの突き合わせ（写しは見つからず。ライセンスの扱いは案まで）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
2026-11-13 SP-4-1・4-2・4-5完了: 車の設定とコースの設定の形を決め、NCECとSUGOを書き出した（tools/setups/ の vehicles/ncec.json・courses/sugo.json と、形を確かめる・本体や控えと比べる道具 setups.py）。11/10の本体の控えの config.json・lap.json と違いなし。設定ファイルが今の道具・コードの値と同じである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
2026-11-13 SP-6-4・SP-8-2・SP-8-3完了: ピットの表紙をスマホで使う手順書（開く・ホーム画面に置く・合言葉をQRで入れる・操作を送る）を作り、困ったときの表と構成図を新しい入口（PCのEcoLoggerアプリ・ピットの表紙）に合わせた。実物のスマホでは未確認
2026-11-13 SP-7-1（印）・SP-6-2・SP-8-1: 車載画面DASHに「送信」の印を足した（送信中／未送信／送信OFF、試験33件。本体へは展示のあと）。ピットの地図・G-Gに「値が届いていません（○秒前のまま）」を入れ、周回表の温度の古い値を薄くし、ラップを0周に戻したあと前の周・ベストが残るのを直した（試験28件。自宅のサーバーへは未導入）。当日手順書のひな形を作った
2026-11-13 SP-6-2・SP-6-1: ピットの地図・G-Gの「値が届いていません」と、リセットのあと前の周が残る件の直しを自宅のサーバーへ入れた（ユーザー了承）。前の版を控え、値の保存先へ書かせない形で別の口で試してから置き換えてブリッジを立ち上げ直した。今あるページは変わらず動き、値の無い部屋の地図に「ロガーを待っています」が出ることを公開のアドレスで見た。本物のロガーでの見え方は未確認
2026-11-13 SP-3-6完了・SP-5-1（一覧まで）: 回収した走行を走った日ごとに一覧できるようにした。ファイルは動かさず、走行記録と同じ時刻の動画を索引で結ぶ（tools/video_collect/run_index.py）。PCのアプリに「走行を見る」の段（時刻・長さ・コース・周回・動画あり／一部／なし・フォルダーを開く）。試験7件、実物の保存先は読むだけで76本が並ぶことを見た。周ごとの表はまだ
2026-11-13 SP-5-1完了: 走行を選ぶと周ごとの表が出るようにした（周・タイム・ベストとの差・セクター・最高速・警告の印・動画あり／一部／なし。温度の数字は出さない）。tools/video_collect/run_laps.py、試験7件。実物のSUGO決勝の記録は14秒で読め、38周・ベスト31周目 1:50.095
2026-11-13 SP-4-8（PCで試験まで）: LTEの命令を2つ足した。コースを選ぶ（course_select、本体に入れてある設定の名前だけ）・線を入れる（line_set）。署名・使い回し防止は今の命令と同じ。入れる前の線を1世代控え、本体から読み直した線を返事に入れる。走っている途中で変えたら、走っていた周を捨てて新しい線を次に通った所から数え直す（lap.py restart_lap）。試験は本体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
2026-11-13 SP-9-4（PCで試験まで）: 公式のPodiumへ直接送る道を、本体のソフト（podium.py・設定の画面）とスマホのアプリ（PodiumDirect・設定の欄）から外した。中継サーバーへ送る道・行の形・LTE・音声・ピットからの命令はそのまま。古い設定ファイルは落ちずに読める（中継の設定は生き、直接の設定だったものは送信OFFで理由が出る）。試験：test_podium 55件（失敗1件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
2026-11-13 SP-5-3（見るまで）: PCのアプリで、周を選んでその周の動画をその場で見られるようにした。録画の .ts はブラウザで再生できないので、周のぶんだけ抜き出し、映像はそのまま・音だけAACに直したMP4を作って流す（tools/video_collect/lap_clip.py、/media/ はRangeに応える）。動画が無い・一部・ffmpegが無いときは理由を出す。試験7件。実物のSU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
2026-11-13 Lintarohさんへの相談メモ: 車の12V側（ヒューズ電源と車用充電器の間）に数秒だけ保つ小さなUPSを作ってもらえるかの相談を足した（docs/share/lintaroh_share_20261113_12v_ups.md）。期限は12/5の3〜4日前。今のUPSモジュールを残すか・止まるまでが長い件もあわせて聞く。調べた市販品の一覧つき。未送
2026-11-13 Lintarohさんへの相談メモ（12V側のUPS）: 11/20以降に動けるとの返事を追記。20日までにこちらで消費電力とヒューズの容量を測って書き足すことにした
2026-11-13 SP-9-4: Podiumへ直接送る道を外したことで古くなった資料4本（LTE_PODIUM.md・EcoCapture-Web/README.md・android-logger/README.md・系譜の資料）に、日付つきの注記を足した。本体・スマホに入っているソフトは入れ替えるまで前のまま、と明記
2026-11-13 録画の手順書 5-7-2: 10/17にカメラとUSBオーディオを同時につないだドックは借り物で、手持ちのドックではないと追記（ユーザーの指摘）
2026-11-13 SP-7-2（PCで試験まで）: スマホのアプリのエコランの画面に、ロガーの「記録・測位・送信」の印を出すようにした。本体がスマホへ出す値に send を1語足し（決め方は車載画面DASHと同じ。同じ結果になることを試験で見張る）、スマホは「ロガー本体」の細い段に出す。つないでいない・値が古い・本体が古いときは「--」。試験：本体側10件、スマホの単体試験82件。画面の見た目は実機で未確認、本体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
2026-11-13 SP-4-4（表示）・SP-4-10・SP-4-11（線の分）: PCのアプリに「コースと線」の段を作った。国土地理院の航空写真の上に本体の線・コースの設定の線を本当の幅と向きで出し、引き直して本体へ入れる（USB・テザリングは直接、つながっていなければLTEの line_set／course_select）。入れる前の線を控え、入れたあと読み直す。LTEのときと、レーシングスピード以上で走って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
2026-11-13 SP-4-3（道具はPCで試験まで）: 選んだ車・コースの設定を本体へ入れる道具 tools/setups/setups_apply.py。既定は確かめるだけ、--apply で違う所だけ入れる。コースは記録を止めずに線を入れ（控えてから。ラップは消さない）、LTEで名前だけ送って選ぶための設定のファイルも本体へ置く。車は信号が違うときだけ記録を止めて入れ直し、LTEで送る項目と部屋も合わせる。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
2026-11-13 SP-3-6・SP-5-1の直し: 走行の索引と周の表の時刻を、測位の時計で直す。本体は時計用の電池が無く、測位のある52本のうち19本で本体の時計がずれていた（数分〜十数時間）。走った日・動画との対応・走行の長さが狂っていた（SUGO決勝が161分と出ていた。正しくは147分）。測位していない走行は「時刻は本体の時計」と出す。試験5件追加
2026-11-13 SP-5-3完了: 周の動画を名前を付けて残す・風切りを下げた公開用を作る、をPCのアプリのボタンでできるようにした（置き場と名前は lap_video.py clip と同じ。公開用は3〜4分かかるので裏で作り、進み具合と結果を出す）。試験2件追加（アプリ全体96件）。実物の31周目で確かめた（出来たものは作業用のフォルダーへ）
2026-11-13 SP-7-6（一部、PCで試験まで）: スマホのアプリに、設定を別のスマホへ写す（書き出し＝共有・コピー、読み込み＝貼り付け・QR）を足した。秘密（ロガーのWi-Fiのパスワード・合言葉）は既定では入れない。読み込む前に変わる所の一覧を見せる。説明の古い所（警報音の長さ・油圧の警告）をコードと突き合わせて直した。試験19件追加（スマホの単体試験101件）。実機では未確認
2026-11-13 SP-3-8（PCで試験まで）: PCのアプリに「設定」の段を作った。焼き込みの計器の配置・レンズ・露出・音・針の補間を1画面で見る・変える・前の値へ戻す。変えるのは今の道具の関数をアプリから呼ぶ形（音と針の補間は新しく作った）。送る前の値を本体に1世代控える。試験33件（アプリ全体129件）、作りものの本体でブラウザで確かめた。本体をつないでは未確認
2026-11-13 SP-4-11・SP-6-3・SP-5-3の残り（PCで試験まで）: 線を変えたら走っている周を捨てる動きを、どの道から変えても同じにした（lap.py の configure へ移した。今まではLTEの命令だけ）。スマホのピットの表紙からコースを選べるようにした（本体に course_list の命令、表紙は一覧 → 選ぶ → 4桁 → 読み直した線）。走っている周を捨てたあとの値をブリッジが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
2026-11-14 SP-5-2（仕分けと下書きまで）・SP-7-1（突き合わせの試験）: レポートの決めごとを「1か所から読める・走行記録から案を出せる・人が入れる」に分け、案を出す部品 report_draft.py を作った（決勝の周・ピットの周・スティント・遅い周の候補・時刻の範囲。周の表に止まっていた秒を足した）。SUGO 11/8 決勝の記録で、人が書いた設定と合うことを確かめた。アプリの画面には未掲載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
2026-11-14 SP-5-2（画面まで。PCで試験と見本の画面）: PCのアプリの「走行を見る」に、レポートの決めごとを見て直して保存する画面を足した。走行の行の「レポートの下書き」から開き、走行記録から出した案（決勝の周・ピットの周・スティント・時刻・遅い周）を直し、名前・ドライバー・遅い周の理由・覚え書きを入れて drive_logs/reports/ へ保存する。おかしい所は全部並べて保存しない。試験5件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
2026-11-14 SP-5-2（解析を流す所まで。PCで試験まで）: 保存した決めごとで、PCのアプリから解析を流せるようにした。解析 race_analysis.py は予選の走行とLTEの記録が無くても流せるように直した（元のSUGOの設定での出力11個は前と同じ）。アプリは裏で流し、流せない理由・進み具合・表の置き場を出す。遅い周の「ピット前のペースダウン」は理由とは別の印にした。SUGO 11/8 決勝の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
2026-11-14 SP-5-2（結果をアプリの中で見る。PCで試験と見本の画面まで）: 解析の結果を、PCのアプリの「レポートの下書き」→「結果を見る」で、数字とグラフで見られるようにした（主な数字・周ごとのタイム・周の一覧・温度・コースと速度・ベストとの差・数字の一覧）。グラフは自前のSVGで、外のライブラリもネットも要らない。大会ごとの文章つきのページはSUGO 11/8 専用の文なので載せていない。試験2件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
2026-11-14 SP-10（起こしただけ）・SP-5-5の結果: 解析アプリを別リポジトリ・MIT・pywebviewで作ると決め、SP-10-1〜10-8に分けた。ロガー側へGPLを持ち込まない（将来クローズドにする可能性のため）。MoTeC i2は自作データでは使用条件に触れ、Circuit Tools 3は自作の.vboだと比べを拒むので、比べの本線にしない。測位の点は測位の時刻で置いて補うとコースの線が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
2026-11-14 SP-10-1完了: 解析アプリの土台を公開リポジトリ ntakao2006-web/ecologger-analysis として公開した（MIT、pywebviewの窓が開いて閉じるまで、試験7件、依存はすべてMIT・BSD・PSF）
2026-11-14 SP-10-2完了: ロガーと解析アプリの境目の形式「ecorun」（版1、文書は解析アプリのリポジトリの docs/format.md）を決め、EcoLogger側の書き出し tools/analysis_export/export_session.py を作った。物理量の値・本体が出した周とセクターのタイム・測位の解（受信機が解を出した時刻に置く、--sd でSDの10Hz全部）・動画（MP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
2026-11-14 SP-10-2の直し: 書き出しの周の始まり・終わりを、測位からコースの線を越えた時刻（本体のlap.pyと同じ計算）に置くようにした。前は周が増えた行の時刻で、周ごとに−16〜+185ms遅れ、隣の周と食い違っていた。出し直したタイムが本体と20ms以上違う周は元のまま残しnotesに書く。SUGO 11/8 決勝の38周で本体のタイムと最大1.4msで合い、境目の食い違いは0（SDの10Hz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
2026-11-14 SP-5-5の追記: Circuit Tools 3は.vboの衛星数が32の行を使わない。31までに抑えて書けば、自作の.vboでもDelta-T・セクター・コース図が正しく出る（32のままだと同じ周どうしのDelta-Tが最大4〜5秒のノコギリ形、セクターが数秒ずれ、コーナーが直線になる。MAX-M10Mの衛星数は最大32で、SUGO 11/8は行の19%が32）。「not a genuin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
2026-11-14 SP-10-3完了: 解析アプリで走行を開いて周の一覧を見られるようにした（PCで試験と画面まで）。周はふだんコースの線で測位から切り直したもの（線を越えた時刻＝線の手前と先の2点から補った値）で、ロガーの数えに切り替えられる。SUGO 11/8 決勝の38周は、切り直した周とセクターがロガーと全部1ms以内で合った。別の日の走行も並べて開け、同じコースどうしでベストとの差を出す。読み込みは初回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
2026-11-14 SP-10-4完了: 解析アプリで選んだ周を重ねて比べられるようにした（PCで試験と画面まで）。横軸は距離と時間を切り替えられ、2周以上なら基準の周とのタイムの差を出す。距離は基準の周の走った線に沿った距離で、ほかの周は測位の点を基準の線へ投影して合わせる。SUGO 11/8 決勝の4周で、タイムの差の最後の値が周のタイムの差と1ms以内で合った
2026-11-14 SP-10-5完了: 解析アプリにコース図を足し、コントロールライン・セクターの線を図の上で置き直して名前つきの版として残せるようにした（PCで試験と画面まで）。コース図には選んだ周の走った線とグラフのカーソルの位置が出て、図を押すとグラフのカーソルが動く。版を使うと同じコースの走行が全部その線で切り直され、書き出しの線（ロガーと同じ）へはいつでも戻せる
2026-11-14 SP-10-6完了: 解析アプリで2周の動画を同じ場所に合わせて並べ、グラフ・コース図のカーソルに合わせて動かせるようにした（PCで試験と画面まで）。再生すると上の動画からカーソルが動き、下の動画は同じ地点を速さを少し変えて追う。動画の位置は書き出しの対応表から出し、手で合わせない。SUGO 11/8 31・32周を同じ地点に合わせると、2本の焼き込みの速さ・タイムの差がグラフと合った
2026-11-14 SP-10-7完了: 解析アプリで式を入れて計算チャンネルを作れるようにした（PCで試験と画面まで）。四則・比較・if・関数・時間での積分・変化率・前後の平均が使え、作った計算チャンネルはPCに残る。式はPythonのevalに渡さず、決まった文法だけを自前で読んで計算する。重ね合わせでは周ごとに計算し、積分は周の頭で0から。SUGO 11/8 決勝で車速を積分した周の距離は、測位の線の長さより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
2026-11-14 SP-10-8完了: 解析アプリを配る形（exe）にし、EcoLoggerアプリの「走行を見る」の「解析で開く」から1押しで開けるようにした（PCで試験と画面まで）。走行を解析用の形に書き出して（済んでいれば飛ばす）解析アプリへ渡し、開いていればその窓で開く。測位はシールドのSDから自動で探し、書き出しの道具は --sd を何度でも受けて時間の合うSDを選ぶ。SUGO 11/8 決勝は 11/1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
2026-11-14 SP-10-8補足: 解析アプリの配る zip を解析アプリのリポジトリの Releases（v0.1.0）に載せたので、見つからないときの案内と道具の説明に入手先を書いた
