ntakao2006-web/RaceCapture/(notices)

Notices in the files:
SPEC.md:
タの比べ（タイムの差・セクター）はできる（衛星数を31までに抑えて書く）が、動画を2本並べる比べがRacelogicの機器のファイルに限られるので本線にしない。**ロガー側にはGPLのコードを持ち込まない**（将来ロガーを閉じた製品にする可能性があるため）。解析アプリも当面はGPLのコードを入れず、GPL-3.0にする大きな利点が見つかったら改めて決める。作業は`task_spec_rebuild_breakdown.md`のSP-10
ARCHITECTURE.md:
- ✅ **参照用リポジトリをリポジトリ直下`reference/`にclone済み（`.gitignore`で自リポジトリから除外、GPL等のライセンス懸念回避）**：
GPLライセンスの取り扱い | `RaceCapture-Pro_firmware`はGPL。ロジックを参考に読むだけなら問題ないが、直接移植・流用した場合、将来リポジトリを公開・配布する際にcopyleft義務（ソース開示等）が生じる可能性。現状は個人利用・プライベートリポジトリのため実害なし | 低（公開判断時に再確認）
USB VID/PIDの借用（配布時の扱い） | 1-4-4でスマホ版公式アプリとの接続を成立させるため、公式MK3ファームウェアと同じUSB VID/PID（`0x16D0`/`0x07F1`、`firmware/sdkconfig.esp32-s3`参照）を借用している。個人のプライベートリポジトリでの検証目的のため現状実害なしと判断（GPLライセンスの扱いと同様の考え方）。将来リポジトリを公開・配布する場合は`pid.codes`（VID`0x1209`）等で自分専用のPIDを取得することを検討する | 低（公開判断時に再確認）
